Sayidathahaseen/CCC_NGP_ODC/NGP_ODC_Main/PDLC/Prodigy HW files/MPC5534/REV 2/BoM/READ ME.txt

1. SCH will not have NO LOAD list.
2. Do not generate BoM from SCH. They may not be matching
