Sayidathahaseen/CCC_NGP_ODC/NGP_ODC_Main/PDLC/Prodigy HW files/MPC5534/REV 2/Gerber/READ ME.txt

The Gerber File names are wrong. "Rev1" is used for Rev2 file names
