Sayidathahaseen/CCC_NGP_ODC/NGP_ODC_Main/PDLC/Mechanical/NGP_CCC Final files on dt-lohiths/Solidworks _Final files/Back Plane Assy/CORRECTION/Body correction.odp

Existing body part

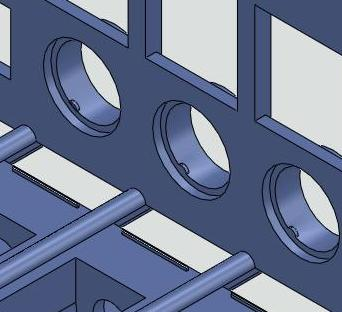
[picture p1: figure]

Correction to be done on body part

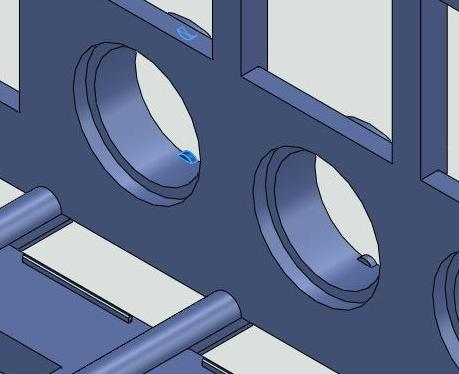
[picture p2: figure]

Correction of projection

on body (to be done in rubber mould)

Position of the projection should be vertical & in the rear side as shown in the picture above

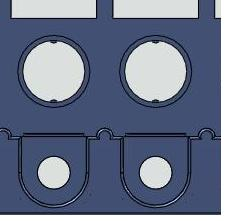
[picture p3: figure]

Existing position of

projection on body

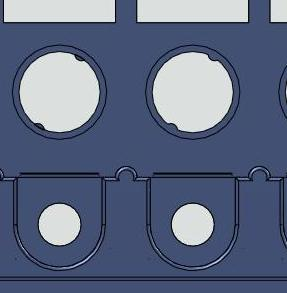
[picture p4: figure]
