Sayidathahaseen/CCC_NGP_ODC/NGP_ODC_Main/PDLC/Mechanical/NGP_CCC Final files on dt-lohiths/id/NGP concepts06Jun11.pdf

# CONCEPT FOR NEW GENERATION PLATFROM ( NGP )

# concepts submitted by

# ISol

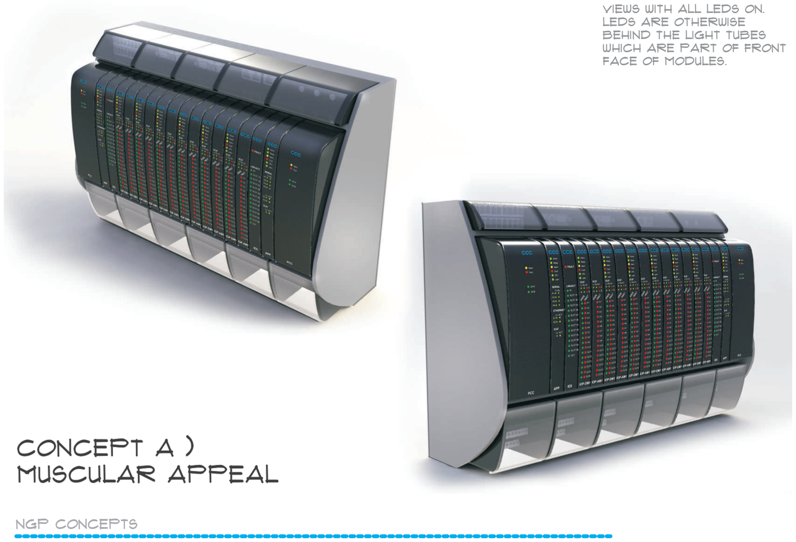
[picture p5: page 2]

# CONCEPT A ) Muscular Appeal

### NGP Concepts

views with all LEDs on.
LEDS are otherwise
behind the light tubes
which are part of front
face of modules.

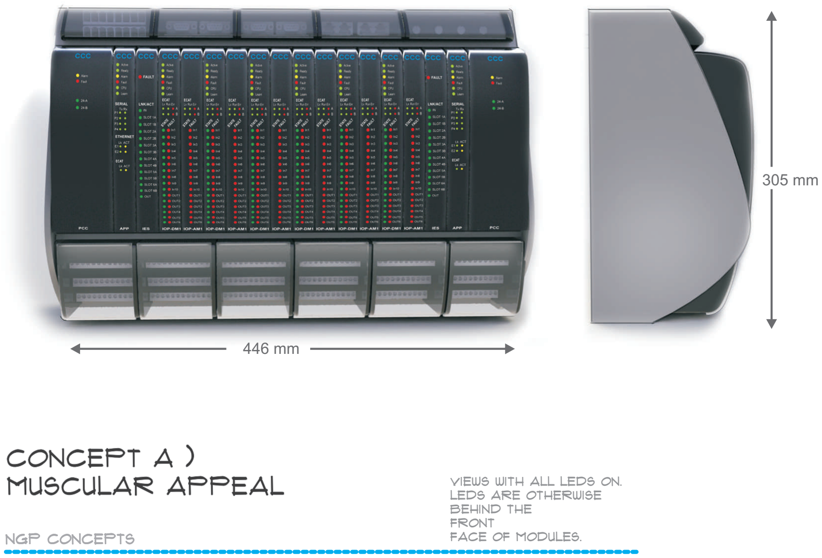
[picture p6: page 3]

# CONCEPT A ) Muscular Appeal

views with all LEDs on.
LEDS are otherwise
behind the
front
face of modules.

446 mm

305 mm

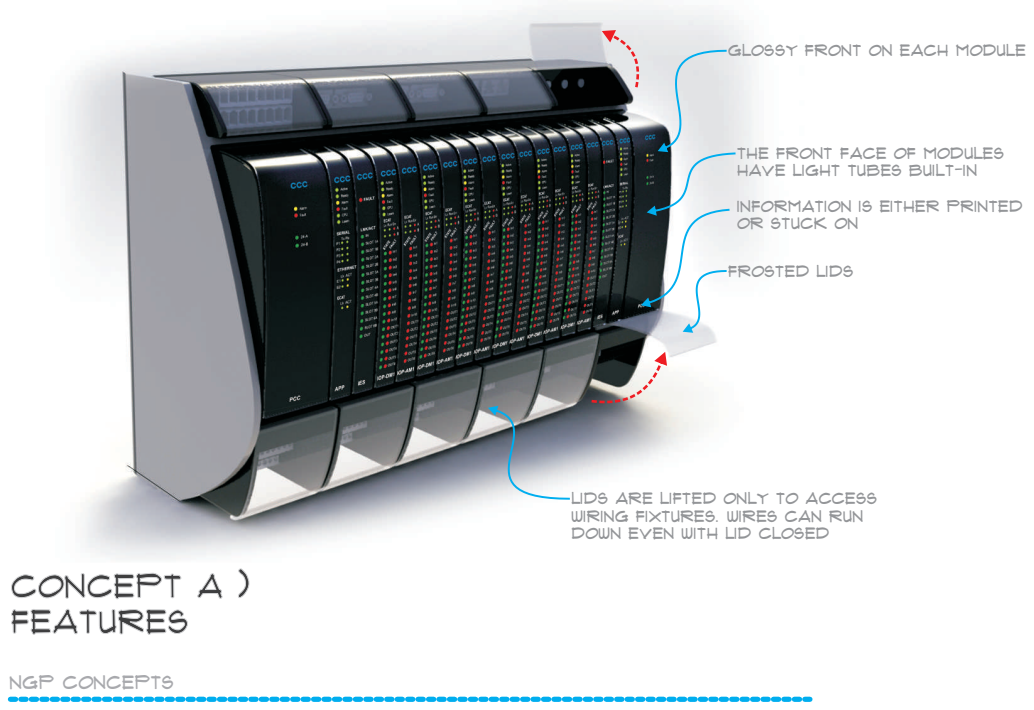
[picture p7: page 4]
CONCEPT A ) features; frosted lids

glossy front on each module

the front face of modules
have light tubes built-in

Information is either printed
or stuck on

lids are lifted only to access
wiring fixtures. wires can run
down even with lid closed

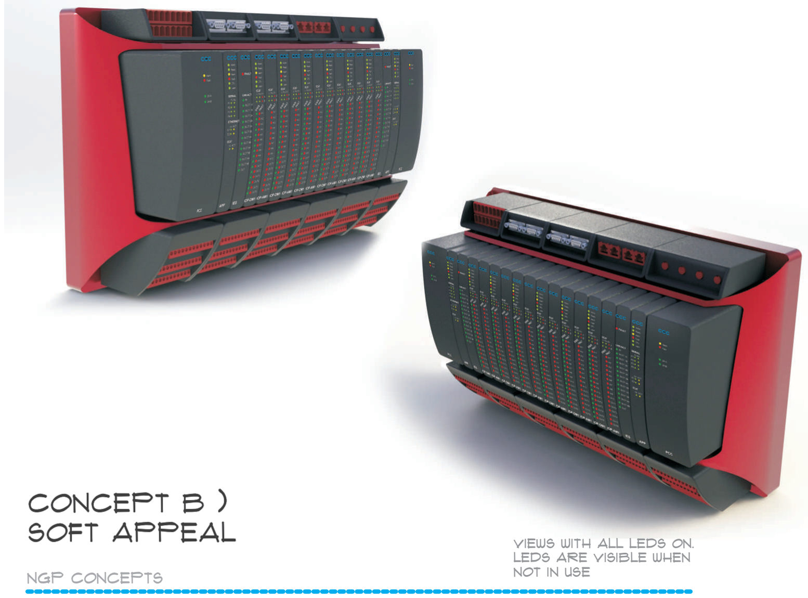
[picture p8: page 5]

views with all LEDs on.
LEDS are visible when
not in use

# CONCEPT b )

# Soft appeal

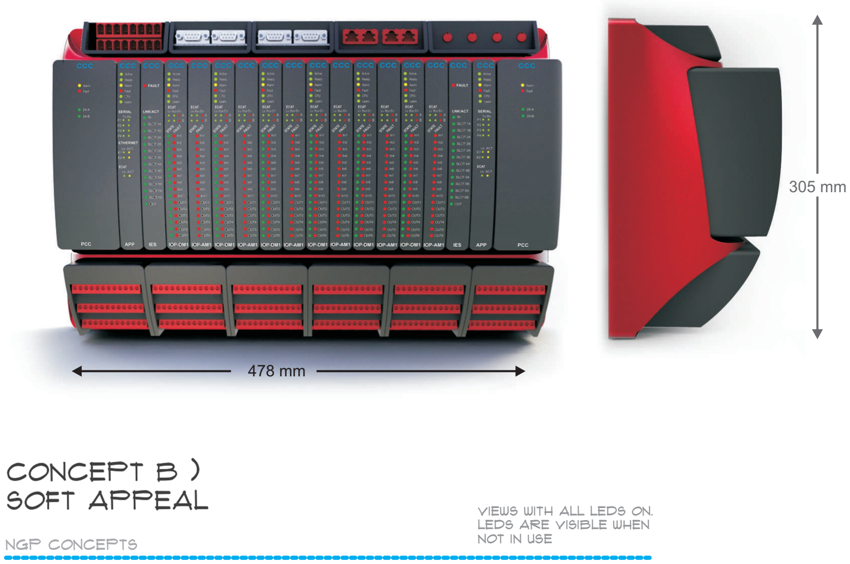
[picture p9: page 6]

# CONCEPT b )

Soft appeal | views with all LEDs on.
| LEDS are visible when not in use

478 mm

305 mm

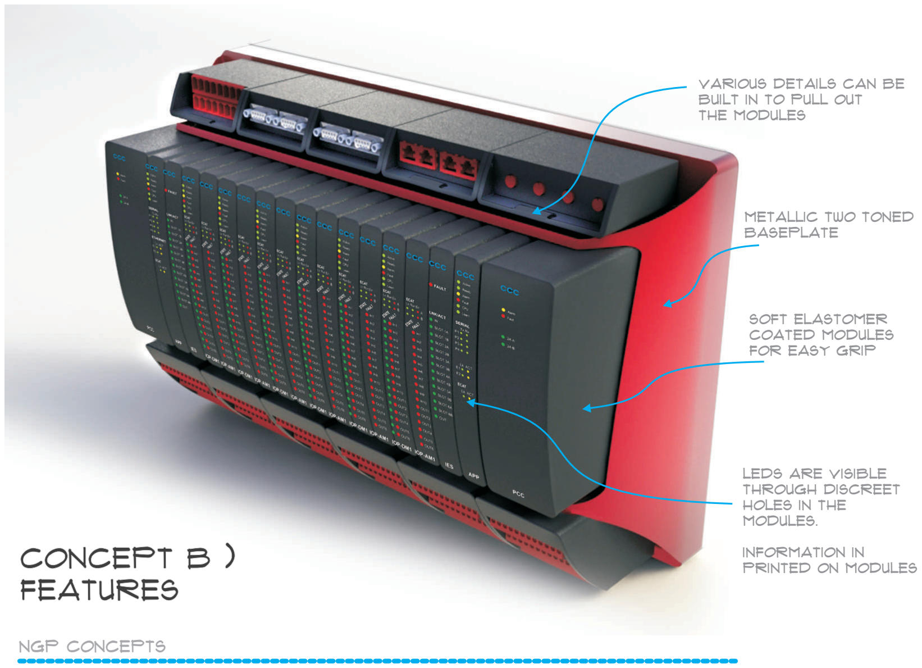
[picture p10: page 7]

# CONCEPT b )

# features

various details can be
built in to pull out
the modules

Metallic two toned
baseplate

soft elastomer
coated modules
for easy grip

leds are visible
through discreet
holes in the
modules.

information in
printed on modules

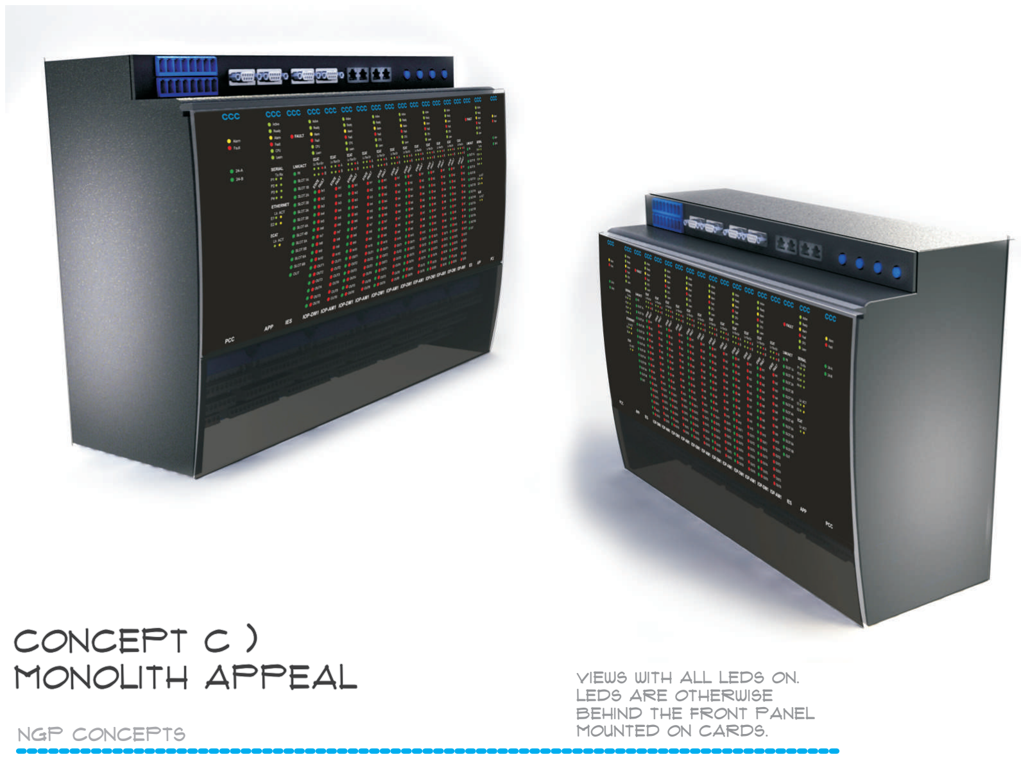
[picture p11: page 8]

# CONCEPT c )

# monolith appeal

views with all LEDs on.
LEDS are otherwise
behind the front panel
mounted on cards.

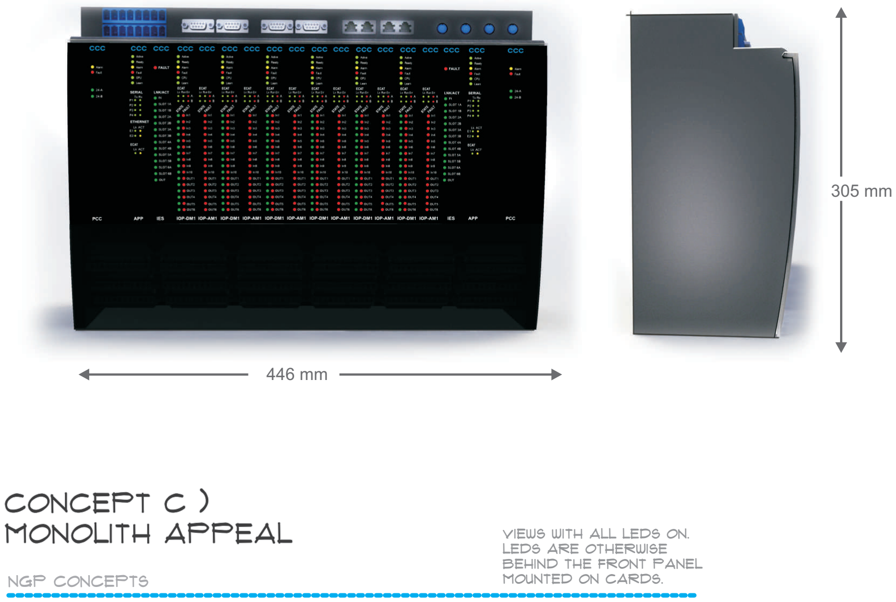
[picture p12: page 9]

views with all LEDs on.
LEDS are otherwise
behind the front panel
mounted on cards.

# CONCEPT c )

# monolith appeal

446 mm

305 mm

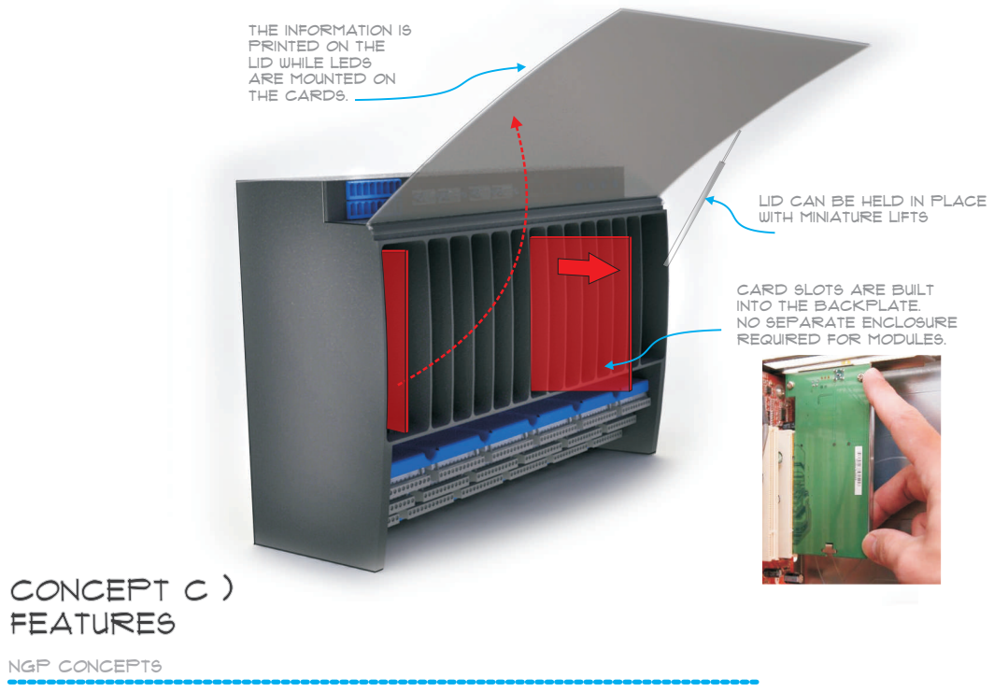
[picture p13: page 10]
CONCEPT c ) features

the information is
printed on the
lid while leds
are mounted on
the cards.

lid can be held in place
with miniature lifts

card slots are built
into the backplate.
no separate enclosure
required for modules.

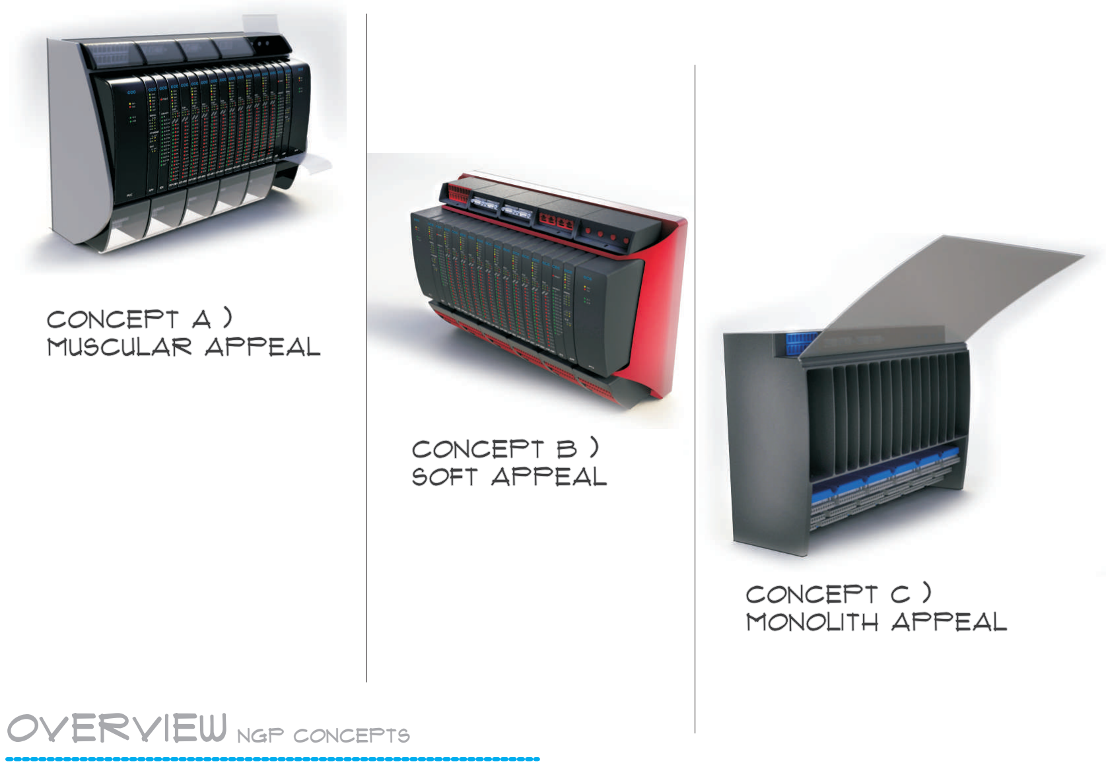
[picture p14: page 11]

# overview

## CONCEPT A ) Muscular Appeal

## CONCEPT b )

## Soft appeal

## CONCEPT c )

## monolith appeal
