Sayidathahaseen/CCC_NGP_ODC/NGP_ODC_Main/PDLC/VanGuard/Client Docs/Vanguard/Analog Input/Specification_Vanguard AI Cond Module.pdf

/
t

General Description

The CM series modules are compact modular isolated signal conditioners The modules are designed for applications in the process control industry All modules are single channel input devices The module is

## packaged in a compact 2 1 x 1 7x 0 6 54 mm x 42 mm x 14 mm durable plastic case

The module has precision voltage clamps to bound the output voltage from 0 7 to 5 7 VDC All input

## pins are fully protected against 120 Vrms fault voltages

The module is mix and match and hot swappable with other modules so it can be inserted or removed from any socket in the same FTA 43 without disturbing system power

Isolated 2/4 Wire Transmitter Interface Module CM 1 335

The CM 1 335 input module accepts a 4 20mA process current input provides a standard 1 5 VDC output signal This module features an isolated loop power supply for driving the current transmitter The module can also be used as a current to voltage converter by supplying a 4 20 mA signal into pin 1 and returning on pin O The module has a nominal 3dB bandwidth of 100 Hz and has downscale open loop input detection within 5 ms

The current input is applied into pin 1 the loop supply is available on pin 2 and the input common is

## brought out to pin O

The loop supply is nominally 24V with Vs 24 V 1I00p 12 mA The loop supply will vary with loop current and Vs the approximate output impedance of the loop supply is 250 Ohms The loop supply

## pin 2 is protected against a short to pin 0 or to pin 1

# Er ² WR

XMTR
IIN

IIN

4 WR
XMTR
X Com

4 Vou
0 7 TO 5 7V

2 POLE
FILTER
AMP/CLAMP

5

## tOOM EtN

ISOLATEO INPUT SECTION | ISOLAliON
BARRIER

OUTPUT SECTION

CM 1 335

Types Analog Devices AD18093 Dataforth SCM7B35 1256

1

## Preliminary draft of new analog conditioning modules 3/18/99

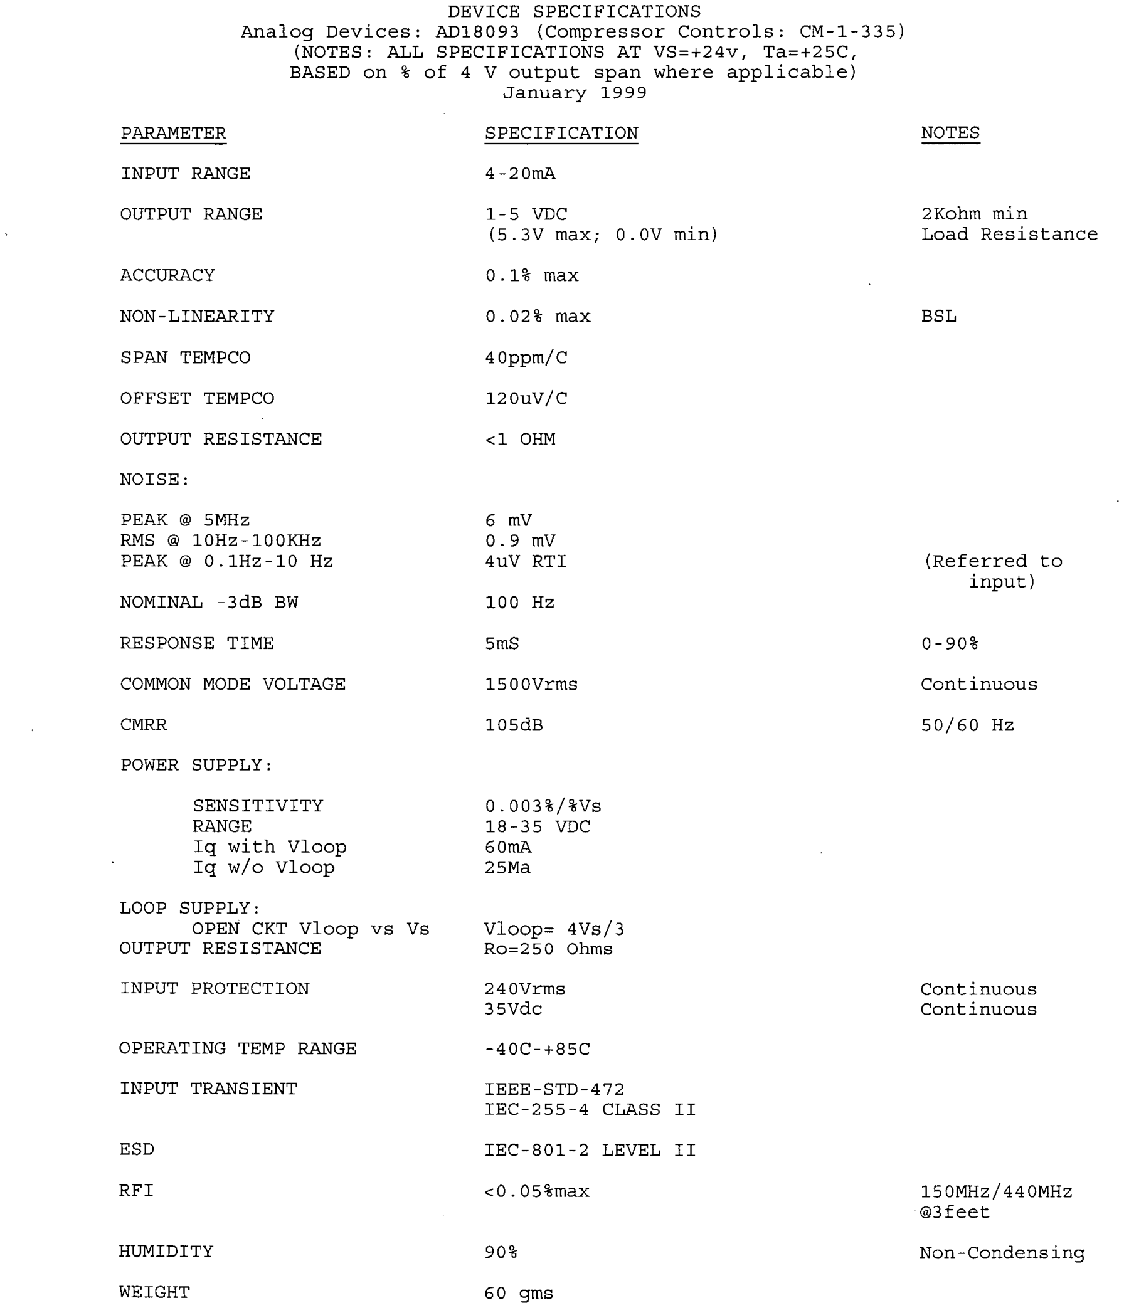
[picture p30: page 2]

DEVICE SPECIFICATIONS
Analog Devices | AD1S093 | Compressor Controls | CM 1 335
NOTES | ALL SPECIFICATIONS AT VS | 24v | Ta | 25C
BASED on | of 4 V output span where applicable
January 1999

PARAMETER

INPUT RANGE

OUTPUT RANGE

ACCURACY

NON LINEARITY

SPAN TEMPCO

OFFSET TEMPCO

OUTPUT RESISTANCE

NOISE

PEAK @ 5MHz
RMS @ 10Hz 100KHz
PEAK @ 0 lHz | 10 Hz
NOMINAL | 3dB BW

RESPONSE TIME

COMMON MODE VOLTAGE

CMRR

POWER SUPPLY

SENSITIVITY
RANGE
Iq with Vloop
Iq w/o Vloop

LOOP SUPPLY
OPEN CKT Vloop vs Vs
OUTPUT RESISTANCE

INPUT PROTECTION

OPERATING TEMP RANGE

INPUT TRANSIENT

ESD

RFI

HUMIDITY

WEIGHT

SPECIFICATION

4 20mA

1 5 VDC
5 3V maxi | O OV min
0 1 | max
0 02 | max

## 40ppm/C

120uV/C

1 OHM

6 mV
0 9 mV
4uV RTI

100 Hz

5mS

1500Vrms

105dB

0 003 /
Vs
lS 35 VDC
60mA
25Ma

Vloop 4Vs/3
Ro 250 Ohms

240Vrms
35Vdc

40C S5C

IEEE STD 472
IEC 255 4 CLASS II

IEC SOl 2 LEVEL II

0 05 max

90

60 gms

NOTES

2Kohm min
Load Resistance

BSL

Referred to
input

0 90

Continuous

50/60 Hz

Continuous
Continuous

150MHz/440MHz
@3feet

Non Condensing
