Sayidathahaseen/CCC_NGP_ODC/NGP_ODC_Main/PDLC/VanGuard/Block Diagram_Prodigy APP.pdf

# BLOCK DIAGRAM

# PRODIGY APP

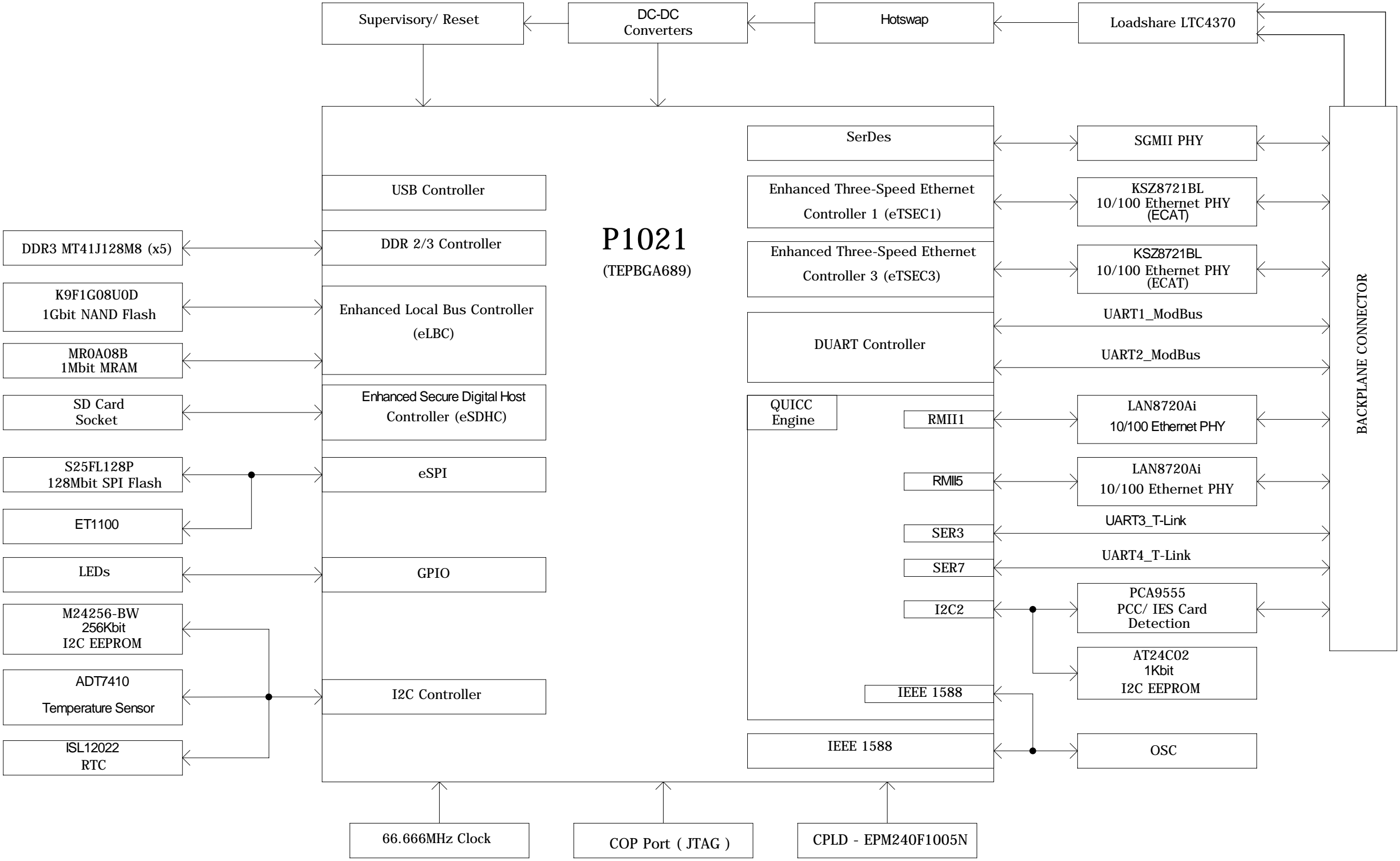
[picture p31: figure]
UART2_ModBus; UART1_ModBus; QUICC; SerDes; SGMII PHY; Hotswap; (ECAT); 10/100 Ethernet PHY; KSZ8721BL; Controller 3 (eTSEC3); Enhanced Three-Speed Ethernet; Controller 1 (eTSEC1); UART4_T-Link; UART3_T-Link; I2C EEPROM; 1Kbit; Detection; PCC/ IES Card; PCA9555; LAN8720Ai; OSC; IEEE 1588; SER7; SER3; RMII5; RMII1; DUART Controller; DDR 2/3 Controller; Engine; 66.666MHz Clock; RTC; ISL12022; Temperature Sensor; ADT7410; LEDs; GPIO; Supervisory/ Reset; Converters; 256Kbit; 128Mbit SPI Flash; Socket; SD Card; 1Mbit MRAM; 1Gbit NAND Flash; eSPI; Controller (eSDHC); Enhanced Secure Digital Host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
