Sayidathahaseen/CCC_NGP_ODC/NGP_ODC_Main/PDLC/VanGuard/Block Diagram_VanGuard MPU_11Dec15.pdf

# VANGUARD MPU

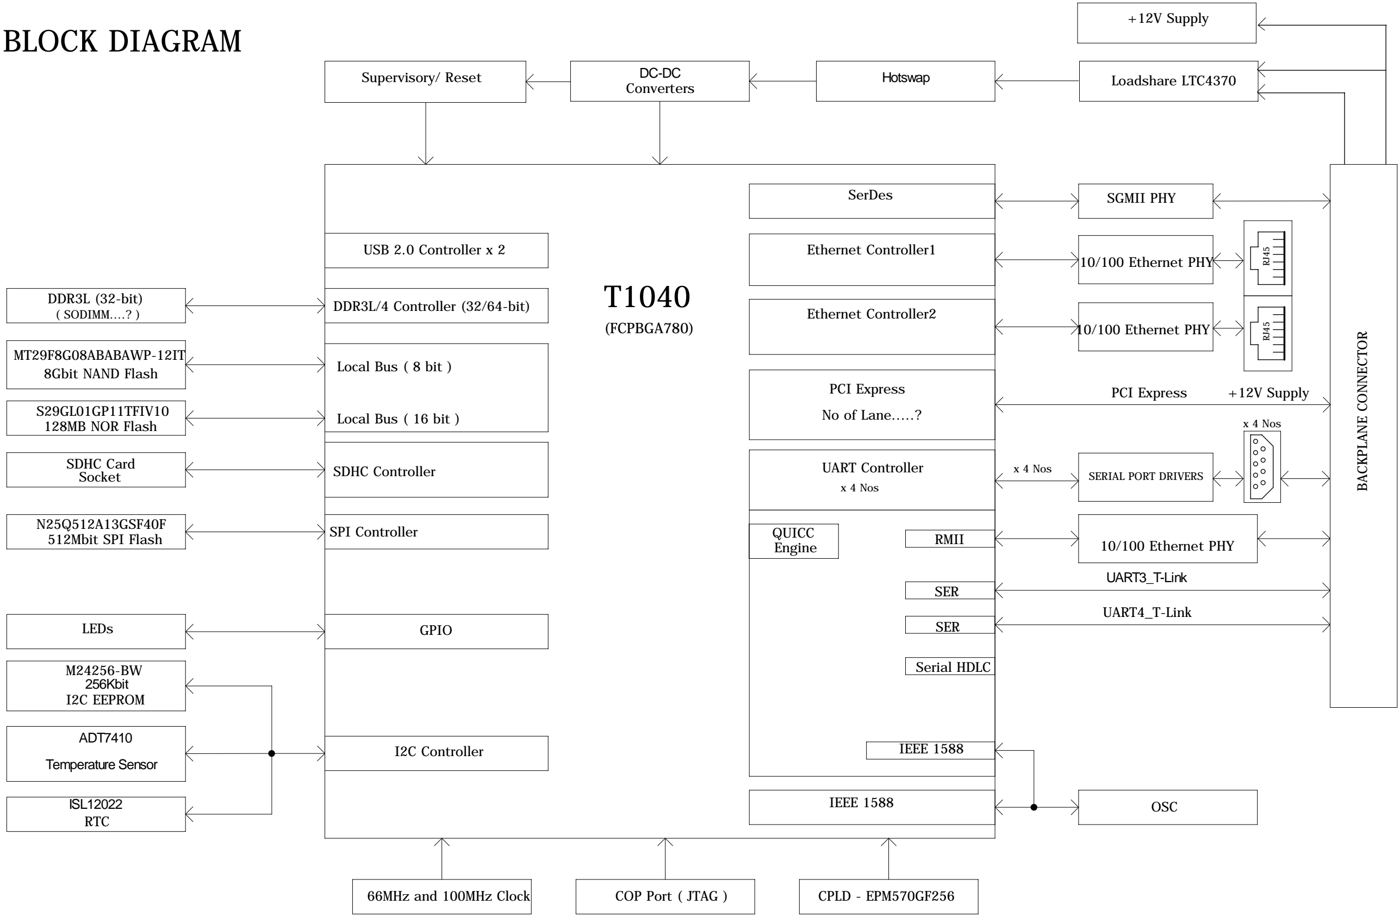
[picture p32: figure]
QUICC; SerDes; SGMII PHY; Hotswap; 10/100 Ethernet PHY; UART4_T-Link; UART3_T-Link; OSC; IEEE 1588; Engine; RTC; ISL12022; Temperature Sensor; ADT7410; LEDs; GPIO; Supervisory/ Reset; Converters; I2C EEPROM; 256Kbit; Socket; I2C Controller; BLOCK DIAGRAM; BACKPLANE CONNECTOR; DDR3L (32-bit); Loadshare LTC4370; (FCPBGA780); DDR3L/4 Controller (32/64-bit); USB 2.0 Controller x 2; ( SODIMM....? ); Local Bus ( 8 bit ); MT29F8G08ABABAWP-12IT; 8Gbit NAND Flash; Local Bus ( 16 bit ) S29GL01GP11TFIV10 128MB NOR Flash; SDHC Controller SDHC Card; SPI Controller N25Q512A13GSF40F 512Mbit SPI Flash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
