Sayidathahaseen/CCC_NGP_ODC/NGP_ODC_Main/PDLC/VanGuard/Study_Prodigy MPU.pdf

## VANGAURD MPU (New) / Prodigy MPU

## Mindteck Understanding

Design new MPU board for VanGuard Series 5
Based on freescale QorIQ T Series processor supporting * QUICCEngine for Serial HDLC
* Trace for debugging
* IEEE 1588
* PCIe (External Bridge to convert parallel ) Form factor : 6U cPCI similar to XCalibur 1002 SBC
Backward compatibility with TMPU-1002 transition Card Design Reuse components from Prodigy APP

## VANGAURD MPU

XCalibur X1002
(Existing)
/ New design with
freescale
QorIQ Processor

+

TMPU_1002
Breakout
backward compatible

Ethernet
Port 1

Ethernet Port 2

Ethernet
Port 3

100MB Ethernet
ports for
communication
with Train tools
workstations

RS485
Port 1

RS485
Port 2

RS485
Port 3

RS485
Port 4

Isolated RS485
serial ports for
communication
with Modbus
masters or other
Controllers

Form factor :
6U Compact PCI

J5

J5

J3 J3 J3

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
BACKPLANE CONNECTIONS

GND

RS232

Unused

J1, J2 – Compact PCI

J3, J5 – Ethernet, I/O

## Prodigy APP

## (Existing)

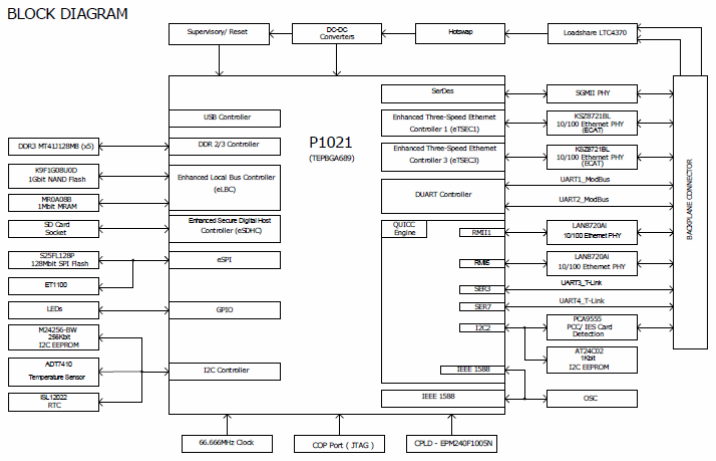
[picture p33: figure]

## VanGuard MPU / Prodigy MPU

## (New)

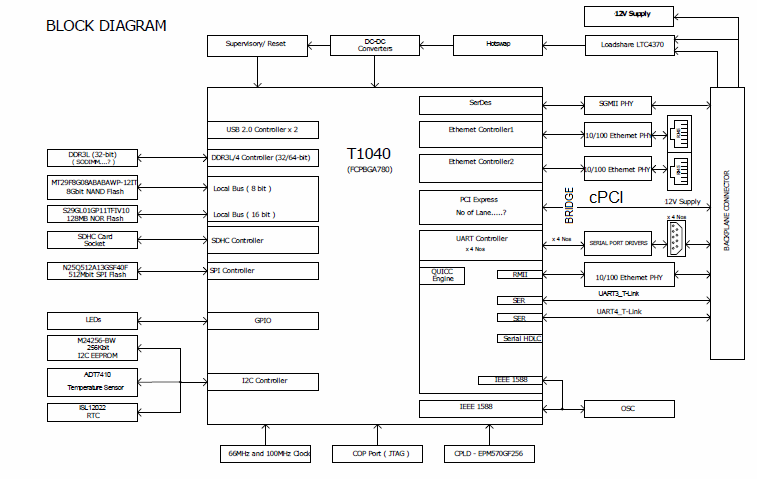
[picture p34: figure]
