Sayidathahaseen/CCC_NGP_ODC/NGP_ODC_Main/PDLC/design/Thermal_Analysis/IES/IES-VIA_REPORT.txt

Name          Type                           Start  End   Net                            Drill                         X                             Y                             Plated  TestPoint Thermal Glued  
Via4532       BGA                            1      6     EBUS[4]-TX+                    10                            3955.00                       210.00                        True    No        False   False   
Via3748       BGA                            1      6     EBUS[4]-TX-                    10                            3955.00                       244.00                        True    No        False   False   
Via4156       BGA                            1      6     P_MODE[0]_1                    10                            1000.00                       590.00                        True    No        False   False   
Via4154       BGA                            1      6     TRANS-MODE-ENA_1               10                            1197.49                       532.48                        True    No        False   False   
Via4051       BGA                            1      6     $$$20327                       10                            1120.00                       695.00                        True    No        False   False   
Via4049       BGA                            1      6     $$$20624                       10                            1085.00                       670.00                        True    No        False   False   
Via4047       BGA                            1      6     $$$20018                       10                            1150.00                       695.00                        True    No        False   False   
Via3830       BGA                            1      6     +2V5_CORE_1                    10                            1190.00                       585.00                        True    No        True    False   
Via3237       POWERVIA                       1      6     GND                            24                            1055.00                       585.00                        True    No        True    False   
Via3108       NORMAL                         1      6     GND                            12                            860.00                        590.00                        True    No        True    False   
Via2991       POWERVIA                       1      6     GND                            24                            1062.49                       477.48                        True    No        True    False   
Via2874       POWERVIA                       1      6     +3V3                           24                            950.00                        580.00                        True    No        True    False   
Via2820       NORMAL                         1      6     +3V3                           12                            1110.00                       585.00                        True    No        True    False   
Via4059       BGA                            1      6     $$$23494                       10                            1297.49                       692.48                        True    No        False   False   
Via4044       BGA                            1      6     $$$19836                       10                            1427.49                       665.98                        True    No        False   False   
Via4042       BGA                            1      6     $$$19835                       10                            1385.00                       695.00                        True    No        False   False   
Via4040       BGA                            1      6     $$$19834                       10                            1355.00                       695.00                        True    No        False   False   
Via4036       BGA                            1      6     $$$19979                       10                            1309.00                       608.00                        True    No        False   False   
Via4034       BGA                            1      6     $$$19934                       10                            1230.00                       585.00                        True    No        False   False   
Via4008       BGA                            1      6     C25_SHI[1]_1                   10                            1437.49                       554.88                        True    No        False   False   
Via4006       BGA                            1      6     C25_SHI[0]_1                   10                            1222.49                       554.88                        True    No        False   False   
Via4004       BGA                            1      6     C25_ENA_1                      10                            1555.09                       662.48                        True    No        False   False   
Via3912       BGA                            1      6     $$$19592                       10                            1320.00                       670.00                        True    No        False   False   
Via3831       BGA                            1      6     +2V5_CORE_1                    10                            1520.49                       684.48                        True    No        True    False   
Via3234       POWERVIA                       1      6     GND                            24                            1471.49                       687.48                        True    No        True    False   
Via3033       POWERVIA                       1      6     GND                            24                            1292.49                       407.48                        True    No        True    False   
Via3032       POWERVIA                       1      6     GND                            24                            1382.49                       407.48                        True    No        True    False   
Via3164       POWERVIA                       1      6     GND                            24                            1629.89                       667.48                        True    No        True    False   
Via2850       POWERVIA                       1      6     +3V3                           24                            2399.49                       580.48                        True    No        True    False   
Via2760       POWERVIA                       1      6     +3V3                           24                            2309.49                       580.48                        True    No        True    False   
Via3944       BGA                            1      6     RX_D(0)[2]                     10                            2814.33                       564.48                        True    No        False   False   
Via3941       BGA                            1      6     RX_D(0)[1]                     10                            2783.49                       554.32                        True    No        False   False   
Via3937       BGA                            1      6     RX_D(0)[0]                     10                            2753.00                       592.00                        True    No        False   False   
Via3926       BGA                            1      6     TX_D(0)[0]/C25_ENA             10                            2777.49                       512.88                        True    No        False   False   
Via3924       BGA                            1      6     TRANS-MODE-ENA                 10                            2544.49                       592.88                        True    No        False   False   
Via3881       BGA                            1      6     CLK_MODE[0]                    10                            2698.49                       551.48                        True    No        False   False   
Via3877       BGA                            1      6     CLK_MODE[1]                    10                            2640.49                       522.48                        True    No        False   False   
Via2988       POWERVIA                       1      6     GND                            24                            2524.49                       518.08                        True    No        True    False   
Via2986       POWERVIA                       1      6     GND                            24                            2774.49                       438.08                        True    No        True    False   
Via2862       POWERVIA                       1      6     +3V3                           24                            2464.89                       695.48                        True    No        True    False   
Via3948       BGA                            1      6     RX_D(0)[3]                     10                            2845.49                       560.48                        True    No        False   False   
Via3933       BGA                            1      6     TX_D(0)[3]/C25_SHI[1]          10                            2984.49                       512.88                        True    No        False   False   
Via3919       BGA                            1      6     CRS0                           10                            3006.49                       558.32                        True    No        False   False   
Via3917       BGA                            1      6     COL0                           10                            3017.49                       590.48                        True    No        False   False   
Via3888       BGA                            1      6     RX_ERR[0]                      10                            2860.00                       597.00                        True    No        False   False   
Via3885       BGA                            1      6     RX_DV[0]                       10                            2904.00                       569.00                        True    No        False   False   
Via3840       BGA                            1      6     +2V5_CORE                      10                            3019.49                       690.48                        True    No        True    False   
Via3094       POWERVIA                       1      6     GND                            24                            3183.49                       693.48                        True    No        True    False   
Via2985       POWERVIA                       1      6     GND                            24                            3004.49                       438.08                        True    No        True    False   
Via3907       BGA                            1      6     PHY0_2V5A                      10                            3914.49                       656.48                        True    No        False   False   
Via3794       BGA                            1      6     EBUS[6]-TX+                    10                            3885.00                       355.00                        True    No        False   False   
Via3720       BGA                            1      6     EBUS[6]-TX-                    10                            3885.00                       387.00                        True    No        False   False   
Via3788       BGA1                           1      6     EBUS[7]-TX-                    10                            4049.00                       542.00                        True    No        False   False   
Via3718       BGA1                           1      6     EBUS[7]-TX+                    10                            4049.00                       569.00                        True    No        False   False   
Via3801       BGA                            1      6     EBUS[4]-RX+                    10                            4717.00                       635.00                        True    No        False   False   
Via3750       BGA                            1      6     EBUS[4]-RX-                    10                            4716.00                       602.00                        True    No        False   False   
Via3792       BGA                            1      6     EBUS[6]-RX-                    10                            4886.00                       651.00                        True    No        False   False   
Via3790       BGA                            1      6     EBUS[6]-RX+                    10                            4885.00                       686.00                        True    No        False   False   
Via4566       BGA1                           1      6     $$$27031                       10                            525.00                        1085.00                       True    No        False   False   
Via4164       BGA                            1      6     CTRL_STATUS_MOVE_1             10                            712.49                        1072.48                       True    No        False   False   
Via4161       BGA                            1      6     P_CONF[1]_1                    10                            667.49                        892.48                        True    No        False   False   
Via4159       BGA                            1      6     CLK_MODE[1]_1                  10                            802.00                        1061.00                       True    No        False   False   
Via3897       BGA                            1      6     RUN/EEPROM_SIZE                10                            632.49                        1086.48                       True    No        False   False   
Via3069       BGA_18D8P                      1      6     GND                            8                             570.00                        800.00                        True    No        True    False   
Via2990       BGA_18D8P                      1      6     GND                            8                             655.00                        710.00                        True    No        True    False   
Via2799       BGA_18D8P                      1      6     +3V3                           8                             487.00                        987.00                        True    No        True    False   
Via2762       BGA                            1      6     +3V3                           10                            725.09                        788.48                        True    No        True    False   
Via4533       BGA_18D8P                      1      6     EBUS[4]-TX+                    8                             1062.00                       927.00                        True    No        False   False   
Via4163       BGA_18D8P                      1      6     P_CONF[1]_1                    8                             998.51                        958.30                        True    No        False   False   
Via4160       BGA_18D8P                      1      6     CLK_MODE[1]_1                  8                             1030.01                       989.80                        True    No        False   False   
Via4158       BGA_18D8P                      1      6     P_MODE[1]_1                    8                             998.51                        926.80                        True    No        False   False   
Via4157       BGA_18D8P                      1      6     P_MODE[0]_1                    8                             1030.01                       958.30                        True    No        False   False   
Via4155       BGA_18D8P                      1      6     TRANS-MODE-ENA_1               8                             1061.51                       958.30                        True    No        False   False   
Via4052       BGA_18D8P                      1      6     $$$20327                       8                             1061.51                       989.80                        True    No        False   False   
Via4050       BGA_18D8P                      1      6     $$$20624                       8                             1157.00                       927.00                        True    No        False   False   
Via4048       BGA_18D8P                      1      6     $$$20018                       8                             1124.00                       956.00                        True    No        False   False   
Via4039       BGA_18D8P                      1      6     $$$19992                       8                             1093.00                       958.30                        True    No        False   False   
Via4038       BGA                            1      6     $$$19992                       10                            1180.00                       700.00                        True    No        False   False   
Via4037       BGA_18D8P                      1      6     $$$19979                       8                             1093.00                       989.80                        True    No        False   False   
Via4035       BGA_18D8P                      1      6     $$$19934                       8                             1155.99                       958.30                        True    No        False   False   
Via3833       BGA_18D8P                      1      6     +2V5_CORE_1                    8                             1155.99                       989.80                        True    No        True    False   
Via3827       BGA_18D8P                      1      6     +2V5_CORE_1                    8                             1159.49                       888.48                        True    No        True    False   
Via3802       BGA_18D8P                      1      6     EBUS[4]-RX+                    8                             1125.00                       925.00                        True    No        False   False   
Via3778       BGA_18D8P                      1      6     EBUS[5]-RX-                    8                             998.51                        1052.79                       True    No        False   False   
Via3775       BGA_18D8P                      1      6     EBUS[5]-RX+                    8                             998.51                        1021.29                       True    No        False   False   
Via3751       BGA_18D8P                      1      6     EBUS[4]-RX-                    8                             1094.00                       927.00                        True    No        False   False   
Via3749       BGA_18D8P                      1      6     EBUS[4]-TX-                    8                             1030.00                       926.00                        True    No        False   False   
Via3385       BGA_18D8P                      1      6     GND                            8                             998.51                        1084.28                       True    No        True    False   
Via3384       BGA_18D8P                      1      6     GND                            8                             1030.01                       1084.28                       True    No        True    False   
Via3383       BGA_18D8P                      1      6     GND                            8                             1061.51                       1084.28                       True    No        True    False   
Via3382       BGA_18D8P                      1      6     GND                            8                             1093.00                       1084.28                       True    No        True    False   
Via3380       BGA_18D8P                      1      6     GND                            8                             1030.01                       1052.79                       True    No        True    False   
Via3379       BGA_18D8P                      1      6     GND                            8                             1061.51                       1052.79                       True    No        True    False   
Via3378       BGA_18D8P                      1      6     GND                            8                             1093.00                       1052.79                       True    No        True    False   
Via3376       BGA_18D8P                      1      6     GND                            8                             1030.01                       1021.29                       True    No        True    False   
Via3375       BGA_18D8P                      1      6     GND                            8                             1093.00                       1021.29                       True    No        True    False   
Via3374       BGA_18D8P                      1      6     GND                            8                             1124.50                       1021.29                       True    No        True    False   
Via3373       BGA_18D8P                      1      6     GND                            8                             1155.99                       1021.29                       True    No        True    False   
Via3369       BGA_18D8P                      1      6     GND                            8                             998.51                        989.80                        True    No        True    False   
Via3235       BGA1                           1      6     GND                            10                            972.00                        837.00                        True    No        True    False   
Via3230       POWERVIA                       1      6     GND                            24                            892.49                        905.71                        True    No        True    False   
Via3227       POWERVIA                       1      6     GND                            24                            895.00                        1065.00                       True    No        True    False   
Via3107       NORMAL                         1      6     GND                            12                            860.00                        775.00                        True    No        True    False   
Via3105       NORMAL                         1      6     GND                            12                            820.00                        720.00                        True    No        True    False   
Via2921       BGA_18D8P                      1      6     +3V3                           8                             1061.49                       1021.28                       True    No        True    False   
Via2919       BGA_18D8P                      1      6     +3V3                           8                             1124.49                       989.79                        True    No        True    False   
Via2869       POWERVIA                       1      6     +3V3                           24                            897.49                        979.58                        True    No        True    False   
Via2822       NORMAL                         1      6     +3V3                           12                            1130.00                       825.00                        True    No        True    False   
Via2821       NORMAL                         1      6     +3V3                           12                            920.00                        845.00                        True    No        True    False   
Via2817       NORMAL                         1      6     +3V3                           12                            910.00                        760.00                        True    No        True    False   
Via4569       BGA_18D8P                      1      6     $$$6439                        8                             1375.00                       1085.00                       True    No        False   False   
Via4463       BGA_18D8P                      1      6     EEPROM_CLK_1                   8                             1344.97                       1084.28                       True    No        False   False   
Via4177       BGA_18D8P                      1      6     RUN/EEPROM_SIZE_1              8                             1344.97                       1052.79                       True    No        False   False   
Via4175       MICROVIA                       1      6     RUN/EEPROM_SIZE_1              12                            1500.00                       950.00                        True    No        False   False   
Via4153       BGA_18D8P                      1      6     P_CONF[0]_1                    8                             1376.47                       1021.29                       True    No        False   False   
Via4151       BGA                            1      6     P_CONF[0]_1                    10                            1505.00                       985.00                        True    No        False   False   
Via4060       BGA_18D8P                      1      6     $$$23494                       8                             1285.00                       958.00                        True    No        False   False   
Via4058       BGA_18D8P                      1      6     $$$23475                       8                             1376.47                       958.30                        True    No        False   False   
Via4057       BGA                            1      6     $$$23475                       10                            1260.00                       715.00                        True    No        False   False   
Via4046       BGA_18D8P                      1      6     $$$19836                       8                             1313.47                       989.80                        True    No        False   False   
Via4045       BGA_18D8P                      1      6     $$$19836                       8                             1407.49                       982.48                        True    No        False   False   
Via4043       BGA_18D8P                      1      6     $$$19835                       8                             1313.47                       958.30                        True    No        False   False   
Via4041       BGA_18D8P                      1      6     $$$19834                       8                             1344.97                       958.30                        True    No        False   False   
Via4033       BGA_18D8P                      1      6     CLK_MODE[0]_1                  8                             1344.97                       1021.29                       True    No        False   False   
Via4032       BGA                            1      6     CLK_MODE[0]_1                  10                            1503.49                       795.48                        True    No        False   False   
Via4009       BGA_18D8P                      1      6     C25_SHI[1]_1                   8                             1222.00                       923.00                        True    No        False   False   
Via4007       BGA_18D8P                      1      6     C25_SHI[0]_1                   8                             1218.99                       958.30                        True    No        False   False   
Via4005       BGA_18D8P                      1      6     C25_ENA_1                      8                             1250.48                       958.30                        True    No        False   False   
Via3913       BGA_18D8P                      1      6     $$$19592                       8                             1313.47                       926.80                        True    No        False   False   
Via3875       BGA_18D8P                      1      6     EBUS[2]-TX+                    8                             1376.47                       926.80                        True    No        False   False   
Via3872       BGA_18D8P                      1      6     EBUS[2]-TX-                    8                             1344.97                       926.80                        True    No        False   False   
Via3869       BGA_18D8P                      1      6     EBUS[2]-RX+                    8                             1281.98                       926.80                        True    No        False   False   
Via3834       BGA_18D8P                      1      6     +2V5_CORE_1                    8                             1313.47                       1084.28                       True    No        True    False   
Via3832       BGA_18D8P                      1      6     +2V5_CORE_1                    8                             1218.99                       989.80                        True    No        True    False   
Via3825       BGA_18D8P                      1      6     +2V5_CORE_1                    8                             1381.49                       1052.48                       True    No        True    False   
Via3717       BGA_18D8P                      1      6     EBUS[2]-RX-                    8                             1250.48                       926.80                        True    No        False   False   
Via3381       BGA_18D8P                      1      6     GND                            8                             1281.98                       1084.28                       True    No        True    False   
Via3377       BGA_18D8P                      1      6     GND                            8                             1313.47                       1052.79                       True    No        True    False   
Via3372       BGA_18D8P                      1      6     GND                            8                             1218.99                       1021.29                       True    No        True    False   
Via3371       BGA_18D8P                      1      6     GND                            8                             1250.48                       1021.29                       True    No        True    False   
Via3370       BGA_18D8P                      1      6     GND                            8                             1281.98                       1021.29                       True    No        True    False   
Via3368       BGA_18D8P                      1      6     GND                            8                             1281.98                       989.80                        True    No        True    False   
Via3228       NORMAL                         1      6     GND                            12                            1502.49                       846.48                        True    No        True    False   
Via2922       BGA_18D8P                      1      6     +3V3                           8                             1283.29                       1051.48                       True    No        True    False   
Via2920       BGA_18D8P                      1      6     +3V3                           8                             1313.29                       1021.48                       True    No        True    False   
Via2918       BGA_18D8P                      1      6     +3V3                           8                             1251.00                       989.00                        True    No        True    False   
Via2871       NORMAL                         1      6     +3V3                           12                            1501.49                       908.48                        True    No        True    False   
Via4568       BGA1                           1      6     $$$6439                        10                            1855.00                       1075.00                       True    No        False   False   
Via4152       BGA                            1      6     P_CONF[0]_1                    10                            1682.49                       1022.45                       True    No        False   False   
Via3867       BGA1                           1      6     EBUS[2]-RX+                    10                            1893.00                       979.00                        True    No        False   False   
Via3715       BGA1                           1      6     EBUS[2]-RX-                    10                            1893.00                       952.00                        True    No        False   False   
Via3159       BGA1                           1      6     GND                            10                            1669.00                       1050.00                       True    No        True    False   
Via3073       POWERVIA                       1      6     GND                            24                            1812.49                       787.48                        True    No        True    False   
Via2995       BGA1                           1      6     GND                            10                            1638.00                       1094.00                       True    No        True    False   
Via2989       POWERVIA                       1      6     GND                            24                            1722.49                       787.48                        True    No        True    False   
Via3920       BGA                            1      6     P_MODE[0]                      10                            2235.49                       726.48                        True    No        False   False   
Via3162       POWERVIA                       1      6     GND                            24                            2240.49                       832.48                        True    No        True    False   
Via3088       POWERVIA                       1      6     GND                            24                            2129.49                       1071.48                       True    No        True    False   
Via2987       POWERVIA                       1      6     GND                            24                            2249.49                       1030.48                       True    No        True    False   
Via4454       BGA_18D8P                      1      6     EBUS[1]-TX+                    8                             2603.51                       931.50                        True    No        False   False   
Via3935       BGA_18D8P                      1      6     TX_D(0)[3]/C25_SHI[1]          8                             2760.99                       931.50                        True    No        False   False   
Via3932       BGA_18D8P                      1      6     TX_D(0)[2]/C25_SHI[0]          8                             2760.99                       963.00                        True    No        False   False   
Via3930       BGA_18D8P                      1      6     TX_D(0)[1]                     8                             2792.00                       931.00                        True    No        False   False   
Via3928       BGA_18D8P                      1      6     TX_D(0)[0]/C25_ENA             8                             2792.48                       963.00                        True    No        False   False   
Via3925       BGA_18D8P                      1      6     TRANS-MODE-ENA                 8                             2603.51                       963.00                        True    No        False   False   
Via3923       BGA_18D8P                      1      6     P_MODE[1]                      8                             2540.51                       931.50                        True    No        False   False   
Via3922       BGA                            1      6     P_MODE[1]                      10                            2425.49                       728.88                        True    No        False   False   
Via3921       BGA_18D8P                      1      6     P_MODE[0]                      8                             2572.01                       963.00                        True    No        False   False   
Via3878       BGA_18D8P                      1      6     CLK_MODE[1]                    8                             2572.01                       994.50                        True    No        False   False   
Via3868       BGA_18D8P                      1      6     EBUS[2]-RX+                    8                             2540.51                       1025.99                       True    No        False   False   
Via3861       BGA                            1      6     P_CONF[2]                      10                            2448.49                       1062.48                       True    No        False   False   
Via3842       BGA_18D8P                      1      6     +2V5_CORE                      8                             2697.99                       994.50                        True    No        True    False   
Via3841       BGA_18D8P                      1      6     +2V5_CORE                      8                             2760.99                       994.50                        True    No        True    False   
Via3838       BGA                            1      6     +2V5_CORE                      10                            2731.07                       905.35                        True    No        True    False   
Via3771       BGA_18D8P                      1      6     EBUS[1]-TX-                    8                             2571.00                       933.00                        True    No        False   False   
Via3716       BGA_18D8P                      1      6     EBUS[2]-RX-                    8                             2540.51                       1057.49                       True    No        False   False   
Via3696       BGA_18D8P                      1      6     EBUS[1]-RX+                    8                             2666.00                       932.00                        True    No        False   False   
Via3695       BGA_18D8P                      1      6     EBUS[1]-RX-                    8                             2636.58                       933.08                        True    No        False   False   
Via3293       BGA_18D8P                      1      6     GND                            8                             2540.51                       1088.98                       True    No        True    False   
Via3292       BGA_18D8P                      1      6     GND                            8                             2572.01                       1088.98                       True    No        True    False   
Via3291       BGA_18D8P                      1      6     GND                            8                             2603.51                       1088.98                       True    No        True    False   
Via3290       BGA_18D8P                      1      6     GND                            8                             2635.00                       1088.98                       True    No        True    False   
Via3288       BGA_18D8P                      1      6     GND                            8                             2572.01                       1057.49                       True    No        True    False   
Via3287       BGA_18D8P                      1      6     GND                            8                             2603.51                       1057.49                       True    No        True    False   
Via3286       BGA_18D8P                      1      6     GND                            8                             2635.00                       1057.49                       True    No        True    False   
Via3284       BGA_18D8P                      1      6     GND                            8                             2572.01                       1025.99                       True    No        True    False   
Via3283       BGA_18D8P                      1      6     GND                            8                             2635.00                       1025.99                       True    No        True    False   
Via3282       BGA_18D8P                      1      6     GND                            8                             2666.50                       1025.99                       True    No        True    False   
Via3281       BGA_18D8P                      1      6     GND                            8                             2697.99                       1025.99                       True    No        True    False   
Via3280       BGA_18D8P                      1      6     GND                            8                             2760.99                       1025.99                       True    No        True    False   
Via3279       BGA_18D8P                      1      6     GND                            8                             2792.48                       1025.99                       True    No        True    False   
Via3277       BGA_18D8P                      1      6     GND                            8                             2540.51                       994.50                        True    No        True    False   
Via3276       BGA_18D8P                      1      6     GND                            8                             2603.51                       994.50                        True    No        True    False   
Via3275       BGA_18D8P                      1      6     GND                            8                             2635.00                       994.50                        True    No        True    False   
Via3273       BGA_18D8P                      1      6     GND                            8                             2635.00                       963.00                        True    No        True    False   
Via3272       BGA_18D8P                      1      6     GND                            8                             2666.50                       963.00                        True    No        True    False   
Via3271       BGA_18D8P                      1      6     GND                            8                             2697.99                       963.00                        True    No        True    False   
Via3270       BGA_18D8P                      1      6     GND                            8                             2697.99                       931.50                        True    No        True    False   
Via2899       BGA_18D8P                      1      6     +3V3                           8                             2603.51                       1025.99                       True    No        True    False   
Via2897       BGA_18D8P                      1      6     +3V3                           8                             2666.50                       994.50                        True    No        True    False   
Via2896       BGA_18D8P                      1      6     +3V3                           8                             2792.48                       994.50                        True    No        True    False   
Via2803       BGA                            1      6     +3V3                           10                            2503.49                       987.48                        True    No        True    False   
Via2756       BGA                            1      6     +3V3                           10                            2506.49                       1085.48                       True    No        True    False   
Via4460       BGA_18D8P                      1      6     EEPROM1_CLK                    8                             2886.97                       1088.98                       True    No        False   False   
Via3949       BGA_18D8P                      1      6     RX_D(0)[3]                     8                             2920.00                       961.00                        True    No        False   False   
Via3945       BGA_18D8P                      1      6     RX_D(0)[2]                     8                             2886.00                       962.00                        True    No        False   False   
Via3942       BGA_18D8P                      1      6     RX_D(0)[1]                     8                             2918.47                       931.50                        True    No        False   False   
Via3938       BGA_18D8P                      1      6     RX_D(0)[0]                     8                             2855.47                       994.50                        True    No        False   False   
Via3915       BGA_18D8P                      1      6     #RESET1                        8                             2918.47                       1057.49                       True    No        False   False   
Via3901       BGA_18D8P                      1      6     MI_DATA                        8                             2918.47                       991.99                        True    No        False   False   
Via3900       BGA                            1      6     MI_DATA                        10                            3211.38                       735.05                        True    No        False   False   
Via3898       BGA_18D8P                      1      6     RUN/EEPROM_SIZE                8                             2886.97                       1057.49                       True    No        False   False   
Via3896       BGA                            1      6     RUN/EEPROM_SIZE                10                            3063.49                       1017.48                       True    No        False   False   
Via3895       BGA_18D8P                      1      6     TX_ENA[0]                      8                             2823.98                       931.50                        True    No        False   False   
Via3893       BGA_18D8P                      1      6     LINK_MII[0]                    8                             2823.98                       963.00                        True    No        False   False   
Via3891       BGA_18D8P                      1      6     RX_CLK[0]                      8                             2855.47                       963.00                        True    No        False   False   
Via3889       BGA_18D8P                      1      6     RX_ERR[0]                      8                             2855.47                       931.50                        True    No        False   False   
Via3886       BGA_18D8P                      1      6     RX_DV[0]                       8                             2886.97                       931.50                        True    No        False   False   
Via3882       BGA_18D8P                      1      6     CLK_MODE[0]                    8                             2886.97                       1025.99                       True    No        False   False   
Via3880       BGA_18D8P                      1      6     LINKACT[0]/P_CONF[0]           8                             2918.47                       1025.99                       True    No        False   False   
Via3860       BGA_18D8P                      1      6     MI_CLK/LINKPOL                 8                             2886.97                       991.99                        True    No        False   False   
Via3858       BGA_18D8P                      1      6     OSC_IN                         8                             2918.47                       1088.98                       True    No        False   False   
Via3843       BGA_18D8P                      1      6     +2V5_CORE                      8                             2855.47                       1088.98                       True    No        True    False   
Via3289       BGA_18D8P                      1      6     GND                            8                             2823.98                       1088.98                       True    No        True    False   
Via3285       BGA_18D8P                      1      6     GND                            8                             2855.47                       1057.49                       True    No        True    False   
Via3278       BGA_18D8P                      1      6     GND                            8                             2823.98                       1025.99                       True    No        True    False   
Via3274       BGA_18D8P                      1      6     GND                            8                             2823.98                       994.50                        True    No        True    False   
Via3213       POWERVIA                       1      6     GND                            24                            2895.49                       714.48                        True    No        True    False   
Via3096       POWERVIA                       1      6     GND                            24                            3179.49                       780.48                        True    No        True    False   
Via2900       BGA_18D8P                      1      6     +3V3                           8                             2823.98                       1057.49                       True    No        True    False   
Via2898       BGA_18D8P                      1      6     +3V3                           8                             2855.47                       1025.99                       True    No        True    False   
Via2806       POWERVIA                       1      6     +3V3                           24                            3009.49                       780.48                        True    No        True    False   
Via2804       POWERVIA                       1      6     +3V3                           24                            3009.49                       871.78                        True    No        True    False   
Via2800       BGA                            1      6     +3V3                           10                            3202.49                       1021.48                       True    No        True    False   
Via3947       BGA                            1      6     RX_D(0)[3]                     10                            3512.49                       905.48                        True    No        False   False   
Via3883       BGA                            1      6     RX_DV[0]                       10                            3400.03                       1002.76                       True    No        False   False   
Via3879       BGA                            1      6     LINKACT[0]/P_CONF[0]           10                            3337.49                       1018.48                       True    No        False   False   
Via3216       POWERVIA                       1      6     GND                            24                            3280.49                       810.48                        True    No        True    False   
Via3143       POWERVIA                       1      6     GND                            24                            3459.49                       950.48                        True    No        True    False   
Via3142       POWERVIA                       1      6     GND                            24                            3461.49                       1052.48                       True    No        True    False   
Via2860       POWERVIA                       1      6     +3V3                           24                            3239.49                       780.48                        True    No        True    False   
Via2761       POWERVIA                       1      6     +3V3                           24                            3354.49                       943.08                        True    No        True    False   
Via3946       BGA                            1      6     RX_D(0)[3]                     10                            3810.59                       940.48                        True    No        False   False   
Via3943       BGA                            1      6     RX_D(0)[2]                     10                            3830.28                       1049.48                       True    No        False   False   
Via3940       BGA                            1      6     RX_D(0)[1]                     10                            3849.96                       939.48                        True    No        False   False   
Via3939       BGA                            1      6     RX_D(0)[1]                     10                            3641.49                       961.95                        True    No        False   False   
Via3936       BGA                            1      6     RX_D(0)[0]                     10                            3869.65                       1048.48                       True    No        False   False   
Via3914       BGA                            1      6     #RESET1                        10                            3647.00                       1047.00                       True    No        False   False   
Via3899       BGA                            1      6     MI_DATA                        10                            3771.22                       1046.48                       True    No        False   False   
Via3890       BGA                            1      6     RX_CLK[0]                      10                            3948.39                       1053.48                       True    No        False   False   
Via3887       BGA                            1      6     RX_ERR[0]                      10                            3968.07                       1076.48                       True    No        False   False   
Via3884       BGA                            1      6     RX_DV[0]                       10                            3928.70                       936.48                        True    No        False   False   
Via3865       BGA                            1      6     CLK25OUT1                      10                            3652.00                       1095.00                       True    No        False   False   
Via3859       BGA                            1      6     MI_CLK/LINKPOL                 10                            3794.00                       1069.00                       True    No        False   False   
Via3065       POWERVIA                       1      6     GND                            24                            3659.49                       840.48                        True    No        True    False   
Via2974       POWERVIA                       1      6     GND                            24                            3987.76                       920.48                        True    No        True    False   
Via2973       POWERVIA                       1      6     GND                            24                            3909.49                       1065.48                       True    No        True    False   
Via2849       POWERVIA                       1      6     +3V3                           24                            3889.33                       915.48                        True    No        True    False   
Via3140       POWERVIA                       1      6     GND                            24                            4225.00                       900.00                        True    No        True    False   
Via3138       POWERVIA                       1      6     GND                            24                            4029.49                       840.48                        True    No        True    False   
Via2984       POWERVIA                       1      6     GND                            24                            4195.00                       1015.00                       True    No        True    False   
Via2983       POWERVIA                       1      6     GND                            24                            4190.00                       745.00                        True    No        True    False   
Via4453       BGA                            1      6     EBUS[1]-TX+                    10                            4552.00                       736.00                        True    No        False   False   
Via3770       BGA                            1      6     EBUS[1]-TX-                    10                            4518.00                       737.00                        True    No        False   False   
Via3990       BGA                            1      6     EBUS[7]-RX+                    10                            4824.00                       745.00                        True    No        False   False   
Via3988       BGA                            1      6     EBUS[7]-RX-                    10                            4824.00                       714.00                        True    No        False   False   
Via4537       BGA1                           1      6     $$$27611                       10                            490.00                        1260.00                       True    No        False   False   
Via4168       NORMAL                         1      6     P_CONF[2]_1                    12                            745.00                        1175.00                       True    No        False   False   
Via3207       POWERVIA                       1      6     GND                            24                            710.00                        1420.00                       True    No        True    False   
Via3068       POWERVIA                       1      6     GND                            24                            622.49                        1407.48                       True    No        True    False   
Via4580       BGA_18D8P                      1      6     $$$7012                        8                             1030.00                       1180.00                       True    No        False   False   
Via4174       BGA_18D8P                      1      6     ERR[3]_1                       8                             1030.01                       1273.26                       True    No        False   False   
Via4172       BGA_18D8P                      1      6     P_CONF[3]_1                    8                             1031.49                       1241.48                       True    No        False   False   
Via4170       BGA                            1      6     P_CONF[3]_1                    10                            1061.00                       1489.00                       True    No        False   False   
Via4169       BGA_18D8P                      1      6     P_CONF[2]_1                    8                             1061.51                       1178.77                       True    No        False   False   
Via4167       BGA_18D8P                      1      6     PHYAD_OFF_1                    8                             1061.51                       1241.76                       True    No        False   False   
Via4165       BGA_18D8P                      1      6     CTRL_STATUS_MOVE_1             8                             1030.01                       1147.28                       True    No        False   False   
Via3951       BGA_18D8P                      1      6     $$$21607                       8                             1093.00                       1241.76                       True    No        False   False   
Via3835       BGA_18D8P                      1      6     +2V5_CORE_1                    8                             1155.99                       1241.76                       True    No        True    False   
Via3828       BGA_18D8P                      1      6     +2V5_CORE_1                    8                             1189.49                       1321.48                       True    No        True    False   
Via3826       BGA_18D8P                      1      6     +2V5_CORE_1                    8                             1213.49                       1106.48                       True    No        True    False   
Via3811       BGA_18D8P                      1      6     EBUS[5]-TX-                    8                             998.51                        1178.77                       True    No        False   False   
Via3808       BGA_18D8P                      1      6     EBUS[5]-TX+                    8                             998.51                        1147.28                       True    No        False   False   
Via3795       BGA_18D8P                      1      6     EBUS[6]-TX+                    8                             1029.00                       1305.00                       True    No        False   False   
Via3793       BGA_18D8P                      1      6     EBUS[6]-RX-                    8                             998.00                        1305.00                       True    No        False   False   
Via3791       BGA_18D8P                      1      6     EBUS[6]-RX+                    8                             997.14                        1273.70                       True    No        False   False   
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
Via2924       BGA_18D8P                      1      6     +3V3                           8                             1061.49                       1147.29                       True    No        True    False   
Via2872       POWERVIA                       1      6     +3V3                           24                            900.00                        1240.00                       True    No        True    False   
Via2823       BGA                            1      6     +3V3                           10                            976.49                        1419.78                       True    No        True    False   
Via2819       BGA1                           1      6     +3V3                           10                            905.00                        1165.00                       True    No        True    False   
Via2818       BGA1                           1      6     +3V3                           10                            880.00                        1185.00                       True    No        True    False   
Via4490       BGA_18D8P                      1      6     $$$21606                       8                             1376.47                       1178.77                       True    No        False   False   
Via4489       BGA_18D8P                      1      6     $$$21605                       8                             1344.97                       1178.77                       True    No        False   False   
Via4462       BGA_18D8P                      1      6     EEPROM_CLK_1                   8                             1415.00                       1135.00                       True    No        False   False   
Via4176       BGA_18D8P                      1      6     RUN/EEPROM_SIZE_1              8                             1350.45                       1343.00                       True    No        False   False   
Via3836       BGA_18D8P                      1      6     +2V5_CORE_1                    8                             1218.99                       1241.76                       True    No        True    False   
Via3829       BGA                            1      6     +2V5_CORE_1                    10                            1251.49                       1407.48                       True    No        True    False   
Via3421       BGA_18D8P                      1      6     GND                            8                             1218.99                       1304.76                       True    No        True    False   
Via3420       BGA_18D8P                      1      6     GND                            8                             1250.48                       1304.76                       True    No        True    False   
Via3419       BGA_18D8P                      1      6     GND                            8                             1281.98                       1304.76                       True    No        True    False   
Via3418       BGA_18D8P                      1      6     GND                            8                             1313.47                       1304.76                       True    No        True    False   
Via3417       BGA_18D8P                      1      6     GND                            8                             1344.97                       1304.76                       True    No        True    False   
Via3416       BGA_18D8P                      1      6     GND                            8                             1376.47                       1304.76                       True    No        True    False   
Via3411       BGA_18D8P                      1      6     GND                            8                             1218.99                       1273.26                       True    No        True    False   
Via3410       BGA_18D8P                      1      6     GND                            8                             1250.48                       1273.26                       True    No        True    False   
Via3409       BGA_18D8P                      1      6     GND                            8                             1281.98                       1273.26                       True    No        True    False   
Via3408       BGA_18D8P                      1      6     GND                            8                             1313.47                       1273.26                       True    No        True    False   
Via3407       BGA_18D8P                      1      6     GND                            8                             1344.97                       1273.26                       True    No        True    False   
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
Via2870       POWERVIA                       1      6     +3V3                           24                            1471.49                       1277.48                       True    No        True    False   
Via3873       BGA                            1      6     EBUS[2]-TX+                    10                            1937.00                       1274.00                       True    No        False   False   
Via3870       BGA                            1      6     EBUS[2]-TX-                    10                            1902.00                       1274.00                       True    No        False   False   
Via3258       POWERVIA                       1      6     GND                            24                            1782.49                       1367.48                       True    No        True    False   
Via3170       POWERVIA                       1      6     GND                            24                            1652.49                       1347.48                       True    No        True    False   
Via3158       POWERVIA                       1      6     GND                            24                            1830.00                       1125.00                       True    No        True    False   
Via2891       POWERVIA                       1      6     +3V3                           24                            1717.49                       1312.48                       True    No        True    False   
Via2844       BGA                            1      6     +3V3                           10                            1835.49                       1236.48                       True    No        True    False   
Via4578       BGA1                           1      6     $$$6964                        10                            2265.00                       1280.00                       True    No        False   False   
Via3212       POWERVIA                       1      6     GND                            24                            2309.00                       1244.00                       True    No        True    False   
Via3211       POWERVIA                       1      6     GND                            24                            2314.49                       1375.48                       True    No        True    False   
Via3078       BGA1                           1      6     GND                            10                            2180.00                       1415.00                       True    No        True    False   
Via2858       POWERVIA                       1      6     +3V3                           24                            2299.49                       1314.48                       True    No        True    False   
Via2807       POWERVIA                       1      6     +3V3                           24                            2344.49                       1430.48                       True    No        True    False   
Via4579       BGA_18D8P                      1      6     $$$6964                        8                             2573.00                       1182.00                       True    No        False   False   
Via4560       BGA_18D8P                      1      6     FAULT                          8                             2762.49                       1276.46                       True    No        False   False   
Via4527       BGA                            1      6     IO7                            10                            2721.00                       1394.00                       True    No        False   False   
Via4438       BGA_18D8P                      1      6     EBUS[3]-TX-                    8                             2603.51                       1309.46                       True    No        False   False   
Via3905       BGA_18D8P                      1      6     ERR[3]                         8                             2572.01                       1277.96                       True    No        False   False   
Via3903       BGA_18D8P                      1      6     P_CONF[3]                      8                             2572.01                       1246.46                       True    No        False   False   
Via3874       BGA_18D8P                      1      6     EBUS[2]-TX+                    8                             2540.51                       1151.98                       True    No        False   False   
Via3871       BGA_18D8P                      1      6     EBUS[2]-TX-                    8                             2540.51                       1183.47                       True    No        False   False   
Via3866       BGA_18D8P                      1      6     CLK25OUT1                      8                             2572.01                       1151.98                       True    No        False   False   
Via3864       BGA_18D8P                      1      6     PHYAD_OFF                      8                             2603.51                       1246.46                       True    No        False   False   
Via3862       BGA_18D8P                      1      6     P_CONF[2]                      8                             2603.51                       1183.47                       True    No        False   False   
Via3847       BGA_18D8P                      1      6     $$$21835                       8                             2635.00                       1246.46                       True    No        False   False   
Via3845       BGA_18D8P                      1      6     +2V5_CORE                      8                             2697.99                       1246.46                       True    No        True    False   
Via3844       BGA_18D8P                      1      6     +2V5_CORE                      8                             2760.99                       1246.46                       True    No        True    False   
Via3839       BGA                            1      6     +2V5_CORE                      10                            2675.95                       1373.13                       True    No        True    False   
Via3762       BGA_18D8P                      1      6     EBUS[3]-RX+                    8                             2539.00                       1279.00                       True    No        False   False   
Via3759       BGA_18D8P                      1      6     EBUS[3]-RX-                    8                             2542.00                       1310.00                       True    No        False   False   
Via3698       BGA_18D8P                      1      6     EBUS[3]-TX+                    8                             2572.01                       1309.46                       True    No        False   False   
Via3310       BGA_18D8P                      1      6     GND                            8                             2634.98                       1309.48                       True    No        True    False   
Via3309       BGA_18D8P                      1      6     GND                            8                             2665.00                       1310.00                       True    No        True    False   
Via3308       BGA_18D8P                      1      6     GND                            8                             2698.97                       1308.48                       True    No        True    False   
Via3307       BGA_18D8P                      1      6     GND                            8                             2603.51                       1277.96                       True    No        True    False   
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
Via4528       BGA_18D8P                      1      6     IO7                            8                             2887.36                       1278.35                       True    No        False   False   
Via4525       BGA_18D8P                      1      6     IO6                            8                             2918.86                       1309.85                       True    No        False   False   
Via4523       BGA_18D8P                      1      6     IO5                            8                             2854.00                       1247.00                       True    No        False   False   
Via4520       BGA_18D8P                      1      6     IO4                            8                             2918.86                       1278.35                       True    No        False   False   
Via4518       BGA_18D8P                      1      6     IO3                            8                             2887.36                       1246.86                       True    No        False   False   
Via4515       BGA_18D8P                      1      6     IO2                            8                             2918.86                       1246.86                       True    No        False   False   
Via4513       BGA_18D8P                      1      6     IO1                            8                             2886.49                       1214.48                       True    No        False   False   
Via4506       BGA_18D8P                      1      6     SLOT_ID                        8                             2885.99                       1308.48                       True    No        False   False   
Via4504       BGA_18D8P                      1      6     IO0                            8                             2918.00                       1215.00                       True    No        False   False   
Via4502       BGA_18D8P                      1      6     CHASISID3                      8                             2819.64                       1312.61                       True    No        False   False   
Via4499       BGA_18D8P                      1      6     CHASISID4                      8                             2823.49                       1277.48                       True    No        False   False   
Via4483       BGA_18D8P                      1      6     $$$28231                       8                             2918.47                       1183.47                       True    No        False   False   
Via4481       BGA_18D8P                      1      6     $$$28230                       8                             2886.97                       1183.47                       True    No        False   False   
Via4461       BGA_18D8P                      1      6     EEPROM1_DATA                   8                             2886.97                       1151.98                       True    No        False   False   
Via4459       BGA_18D8P                      1      6     EEPROM1_CLK                    8                             2984.33                       1110.48                       True    No        False   False   
Via3837       BGA                            1      6     +2V5_CORE                      10                            3112.95                       1290.95                       True    No        True    False   
Via3688       BGA_18D8P                      1      6     SPARE                          8                             2853.99                       1276.48                       True    No        False   False   
Via3680       BGA_18D8P                      1      6     CHASISID2                      8                             2822.99                       1245.48                       True    No        False   False   
Via3678       BGA                            1      6     CHASISID2                      10                            3183.82                       1494.89                       True    No        False   False   
Via3294       BGA_18D8P                      1      6     GND                            8                             2823.98                       1151.98                       True    No        True    False   
Via3269       BGA                            1      6     GND                            10                            3026.49                       1123.48                       True    No        True    False   
Via3267       BGA                            1      6     GND                            10                            3108.49                       1493.48                       True    No        True    False   
Via2904       BGA_18D8P                      1      6     +3V3                           8                             2854.69                       1182.91                       True    No        True    False   
Via2903       BGA_18D8P                      1      6     +3V3                           8                             2823.98                       1183.47                       True    No        True    False   
Via2901       BGA_18D8P                      1      6     +3V3                           8                             2855.47                       1151.98                       True    No        True    False   
Via2861       POWERVIA                       1      6     +3V3                           24                            3019.12                       1479.11                       True    No        True    False   
Via2859       POWERVIA                       1      6     +3V3                           24                            2934.49                       1380.48                       True    No        True    False   
Via3687       BGA                            1      6     SPARE                          10                            3412.17                       1313.79                       True    No        False   False   
Via3679       BGA                            1      6     CHASISID2                      10                            3290.12                       1211.43                       True    No        False   False   
Via3268       POWERVIA                       1      6     GND                            24                            3257.49                       1134.32                       True    No        True    False   
Via3261       POWERVIA                       1      6     GND                            24                            3469.49                       1342.88                       True    No        True    False   
Via3260       BGA                            1      6     GND                            10                            3568.00                       1444.00                       True    No        True    False   
Via3257       POWERVIA                       1      6     GND                            24                            3339.49                       1330.48                       True    No        True    False   
Via3141       POWERVIA                       1      6     GND                            24                            3439.73                       1238.98                       True    No        True    False   
Via2982       POWERVIA                       1      6     GND                            24                            3439.49                       1140.48                       True    No        True    False   
Via2857       POWERVIA                       1      6     +3V3                           24                            3339.49                       1145.48                       True    No        True    False   
Via2855       BGA                            1      6     +3V3                           10                            3316.00                       1467.00                       True    No        True    False   
Via2847       POWERVIA                       1      6     +3V3                           24                            3254.33                       1270.48                       True    No        True    False   
Via2787       BGA                            1      6     +3V3                           10                            3456.49                       1452.48                       True    No        True    False   
Via4565       BGA1                           1      6     $$$11761                       10                            3650.00                       1350.00                       True    No        False   False   
Via4492       BGA                            1      6     $$$6128                        10                            3637.49                       1211.48                       True    No        False   False   
Via4491       BGA                            1      6     $$$6119                        10                            3658.00                       1190.00                       True    No        False   False   
Via3934       BGA                            1      6     TX_D(0)[3]/C25_SHI[1]          10                            3996.49                       1190.01                       True    No        False   False   
Via3931       BGA                            1      6     TX_D(0)[2]/C25_SHI[0]          10                            3960.49                       1170.48                       True    No        False   False   
Via3929       BGA                            1      6     TX_D(0)[1]                     10                            3997.49                       1150.64                       True    No        False   False   
Via3909       BGA                            1      6     PHY0_2V5A                      10                            3636.49                       1247.48                       True    No        False   False   
Via3906       BGA                            1      6     PHY0_2V5A                      10                            3869.49                       1272.48                       True    No        False   False   
Via3894       BGA                            1      6     TX_ENA[0]                      10                            3994.49                       1111.27                       True    No        False   False   
Via3892       BGA                            1      6     LINK_MII[0]                    10                            3935.55                       1252.19                       True    No        False   False   
Via3074       BGA1                           1      6     GND                            10                            3830.00                       1241.00                       True    No        True    False   
Via2980       POWERVIA                       1      6     GND                            24                            3638.49                       1131.48                       True    No        True    False   
Via2979       POWERVIA                       1      6     GND                            24                            3793.00                       1149.00                       True    No        True    False   
Via2978       BGA1                           1      6     GND                            10                            3769.00                       1230.00                       True    No        True    False   
Via2977       POWERVIA                       1      6     GND                            24                            3771.22                       1400.48                       True    No        True    False   
Via2976       BGA1                           1      6     GND                            10                            3792.00                       1268.00                       True    No        True    False   
Via2975       POWERVIA                       1      6     GND                            24                            3979.00                       1249.00                       True    No        True    False   
Via4441       BGA                            1      6     EBUS[9]-TX-                    10                            4278.00                       1479.00                       True    No        False   False   
Via4437       BGA                            1      6     EBUS[3]-TX-                    10                            4087.00                       1343.00                       True    No        False   False   
Via3927       BGA                            1      6     TX_D(0)[0]/C25_ENA             10                            4092.49                       1131.95                       True    No        False   False   
Via3918       BGA                            1      6     CRS0                           10                            4114.49                       1229.38                       True    No        False   False   
Via3916       BGA                            1      6     COL0                           10                            4098.49                       1209.69                       True    No        False   False   
Via3761       BGA                            1      6     EBUS[3]-RX+                    10                            4191.00                       1437.00                       True    No        False   False   
Via3760       BGA                            1      6     EBUS[3]-RX-                    10                            4192.00                       1468.00                       True    No        False   False   
Via3697       BGA                            1      6     EBUS[3]-TX+                    10                            4108.00                       1361.00                       True    No        False   False   
Via3139       POWERVIA                       1      6     GND                            24                            4240.00                       1405.00                       True    No        True    False   
Via2981       POWERVIA                       1      6     GND                            24                            4310.00                       1270.00                       True    No        True    False   
Via2840       POWERVIA                       1      6     +3V3                           24                            4145.00                       1395.00                       True    No        True    False   
Via2758       BGA1                           1      6     +3V3                           10                            4102.00                       1291.00                       True    No        True    False   
Via2757       BGA1                           1      6     +3V3                           10                            4045.00                       1307.00                       True    No        True    False   
Via4544       BGA1                           1      6     $$$27628                       10                            575.00                        1820.00                       True    No        False   False   
Via4542       BGA1                           1      6     $$$27625                       10                            585.00                        1645.00                       True    No        False   False   
Via4539       BGA1                           1      6     $$$27622                       10                            520.00                        1510.00                       True    No        False   False   
Via4415       BGA                            1      6     C25_SHI[0]_2                   10                            1192.49                       1824.88                       True    No        False   False   
Via4188       BGA                            1      6     P_MODE[1]_2                    10                            1030.00                       1800.00                       True    No        False   False   
Via4173       BGA                            1      6     ERR[3]_1                       10                            1185.00                       1505.00                       True    No        False   False   
Via4075       BGA                            1      6     $$$23925                       10                            1110.00                       1840.00                       True    No        False   False   
Via4073       BGA                            1      6     $$$23924                       10                            1140.00                       1870.00                       True    No        False   False   
Via4071       BGA                            1      6     $$$23923                       10                            1075.00                       1860.00                       True    No        False   False   
Via4065       BGA                            1      6     $$$23920                       10                            1190.00                       1860.00                       True    No        False   False   
Via3202       POWERVIA                       1      6     GND                            24                            912.49                        1654.88                       True    No        True    False   
Via3165       POWERVIA                       1      6     GND                            24                            992.49                        1867.48                       True    No        True    False   
Via3106       POWERVIA                       1      6     GND                            24                            822.49                        1517.48                       True    No        True    False   
Via2873       BGA                            1      6     +3V3                           10                            906.49                        1572.48                       True    No        True    False   
Via2763       BGA                            1      6     +3V3                           10                            1149.89                       1798.48                       True    No        True    False   
Via4488       BGA                            1      6     $$$21605                       10                            1457.62                       1610.84                       True    No        False   False   
Via4178       BGA                            1      6     C25_SHI[1]_2                   10                            1387.49                       1824.88                       True    No        False   False   
Via4166       BGA                            1      6     PHYAD_OFF_1                    10                            1240.00                       1530.00                       True    No        False   False   
Via4067       BGA                            1      6     $$$23921                       10                            1240.00                       1870.00                       True    No        False   False   
Via4061       BGA                            1      6     $$$23918                       10                            1315.00                       1875.00                       True    No        False   False   
Via4055       BGA                            1      6     $$$23917                       10                            1377.49                       1872.48                       True    No        False   False   
Via3950       BGA                            1      6     $$$21607                       10                            1335.00                       1520.00                       True    No        False   False   
Via3809       BGA                            1      6     EBUS[5]-TX-                    10                            1565.00                       1765.00                       True    No        False   False   
Via3806       BGA                            1      6     EBUS[5]-TX+                    10                            1600.00                       1765.00                       True    No        False   False   
Via3780       BGA                            1      6     EBUS[5]-RX-                    10                            1515.00                       1835.00                       True    No        False   False   
Via3776       BGA                            1      6     EBUS[5]-RX+                    10                            1480.00                       1835.00                       True    No        False   False   
Via3196       POWERVIA                       1      6     GND                            24                            1406.08                       1742.75                       True    No        True    False   
Via3061       POWERVIA                       1      6     GND                            24                            1395.00                       1655.00                       True    No        True    False   
Via2972       NORMAL                         1      6     GND                            12                            1550.00                       1515.00                       True    No        True    False   
Via2805       POWERVIA                       1      6     +3V3                           24                            2344.49                       1525.48                       True    No        True    False   
Via4498       BGA                            1      6     CHASISID4                      10                            2774.37                       1538.20                       True    No        False   False   
Via4296       BGA                            1      6     TRANS-MODE-ENA_5               10                            2590.49                       1881.48                       True    No        False   False   
Via4280       BGA                            1      6     CLK_MODE[1]_5                  10                            2710.00                       1780.00                       True    No        False   False   
Via4128       BGA                            1      6     $$$12370                       10                            2650.00                       1880.00                       True    No        False   False   
Via4124       BGA                            1      6     $$$12368                       10                            2619.65                       1895.48                       True    No        False   False   
Via4118       BGA                            1      6     $$$12365                       10                            2770.00                       1895.00                       True    No        False   False   
Via3904       BGA                            1      6     ERR[3]                         10                            2658.80                       1540.48                       True    No        False   False   
Via3902       BGA                            1      6     P_CONF[3]                      10                            2493.49                       1654.48                       True    No        False   False   
Via3863       BGA                            1      6     PHYAD_OFF                      10                            2739.49                       1534.48                       True    No        False   False   
Via3846       BGA                            1      6     $$$21835                       10                            2801.93                       1538.20                       True    No        False   False   
Via3214       BGA                            1      6     GND                            10                            2538.49                       1502.48                       True    No        True    False   
Via3181       POWERVIA                       1      6     GND                            24                            2785.00                       1775.00                       True    No        True    False   
Via3031       NORMAL                         1      6     GND                            12                            2725.00                       1895.00                       True    No        True    False   
Via2786       BGA                            1      6     +3V3                           10                            2603.49                       1533.48                       True    No        True    False   
Via4529       BGA                            1      6     CHASISID1                      10                            3164.14                       1778.35                       True    No        False   False   
Via4521       BGA                            1      6     IO5                            10                            2884.00                       1675.00                       True    No        False   False   
Via4516       BGA                            1      6     IO3                            10                            3101.00                       1792.00                       True    No        False   False   
Via4505       BGA                            1      6     SLOT_ID                        10                            3193.80                       1786.23                       True    No        False   False   
Via4500       BGA                            1      6     CHASISID3                      10                            2880.49                       1536.48                       True    No        False   False   
Via4482       BGA                            1      6     $$$28231                       10                            3147.49                       1505.48                       True    No        False   False   
Via4480       BGA                            1      6     $$$28230                       10                            3032.49                       1516.48                       True    No        False   False   
Via4407       BGA                            1      6     C25_ENA_5                      10                            3024.00                       1859.00                       True    No        False   False   
Via3686       BGA                            1      6     SPARE                          10                            3188.00                       1675.00                       True    No        False   False   
Via3193       BGA                            1      6     GND                            10                            3039.09                       1802.48                       True    No        True    False   
Via5323       NORMAL                         1      6     GND                            12                            3580.00                       1800.00                       True    No        True    False   
Via5283       NORMAL                         1      6     GND                            12                            3580.00                       1750.00                       True    No        True    False   
Via4526       BGA                            1      6     IO7                            10                            3524.44                       1690.71                       True    No        False   False   
Via4524       BGA                            1      6     IO6                            10                            3433.85                       1769.20                       True    No        False   False   
Via4522       BGA                            1      6     IO5                            10                            3463.35                       1791.15                       True    No        False   False   
Via4519       BGA                            1      6     IO4                            10                            3523.98                       1853.16                       True    No        False   False   
Via2892       BGA                            1      6     +3V3                           10                            3596.22                       1635.48                       True    No        True    False   
Via2856       BGA                            1      6     +3V3                           10                            3393.00                       1635.00                       True    No        True    False   
Via5302       NORMAL                         1      6     GND                            12                            3635.00                       1800.00                       True    No        True    False   
Via5299       NORMAL                         1      6     GND                            12                            3635.00                       1750.00                       True    No        True    False   
Via4511       BGA                            1      6     APP_SDA                        10                            3708.49                       1611.48                       True    No        False   False   
Via4508       BGA                            1      6     APP_SCL                        10                            3621.81                       1624.48                       True    No        False   False   
Via4495       BGA                            1      6     A1                             10                            3763.00                       1859.00                       True    No        False   False   
Via4494       BGA                            1      6     A0                             10                            3766.50                       1746.86                       True    No        False   False   
Via3206       BGA                            1      6     GND                            10                            3959.41                       1746.86                       True    No        True    False   
Via2784       BGA                            1      6     +3V3                           10                            3957.00                       1859.00                       True    No        True    False   
Via2759       BGA                            1      6     +3V3                           10                            3889.49                       1639.48                       True    No        True    False   
Via4510       BGA                            1      6     APP_SDA                        10                            4215.49                       1734.48                       True    No        False   False   
Via4439       BGA                            1      6     EBUS[9]-TX+                    10                            4277.00                       1508.00                       True    No        False   False   
Via4423       BGA                            1      6     EBUS[12]-TX+                   10                            4282.00                       1851.00                       True    No        False   False   
Via4002       BGA1                           1      6     EBUS[9]-RX+                    10                            4227.00                       1551.00                       True    No        False   False   
Via4000       BGA1                           1      6     EBUS[9]-RX-                    10                            4227.00                       1524.00                       True    No        False   False   
Via3911       BGA                            1      6     PHY0_2V5A                      10                            4020.00                       1518.00                       True    No        False   False   
Via3786       BGA                            1      6     EBUS[12]-TX-                   10                            4281.00                       1822.00                       True    No        False   False   
Via3163       POWERVIA                       1      6     GND                            24                            4068.83                       1667.30                       True    No        True    False   
Via4102       BGA                            1      6     EBUS[12]-RX-                   10                            4745.00                       1868.00                       True    No        False   False   
Via4445       BGA                            1      6     EBUS[10]-TX-                   10                            4920.00                       1574.00                       True    No        False   False   
Via4421       BGA                            1      6     EBUS[10]-TX+                   10                            4921.00                       1603.00                       True    No        False   False   
Via4550       BGA1                           1      6     $$$27639                       10                            515.00                        2280.00                       True    No        False   False   
Via4548       BGA1                           1      6     $$$27636                       10                            520.00                        2090.00                       True    No        False   False   
Via4546       BGA1                           1      6     $$$27631                       10                            595.00                        1955.00                       True    No        False   False   
Via4190       BGA                            1      6     P_CONF[1]_2                    10                            632.49                        2170.48                       True    No        False   False   
Via4184       BGA                            1      6     TRANS-MODE-ENA_2               10                            767.49                        2267.48                       True    No        False   False   
Via3752       BGA                            1      6     CLK_MODE[1]_2                  10                            725.00                        2265.00                       True    No        False   False   
Via2996       POWERVIA                       1      6     GND                            24                            630.00                        1975.00                       True    No        True    False   
Via2764       BGA                            1      6     +3V3                           10                            735.09                        1969.48                       True    No        True    False   
Via4193       BGA_18D8P                      1      6     P_CONF[1]_2                    8                             997.00                        2230.00                       True    No        False   False   
Via4189       BGA_18D8P                      1      6     P_MODE[1]_2                    8                             998.51                        2198.50                       True    No        False   False   
Via4187       BGA_18D8P                      1      6     P_MODE[0]_2                    8                             1030.01                       2230.00                       True    No        False   False   
Via4186       BGA                            1      6     P_MODE[0]_2                    10                            865.00                        2050.00                       True    No        False   False   
Via4185       BGA_18D8P                      1      6     TRANS-MODE-ENA_2               8                             1061.51                       2230.00                       True    No        False   False   
Via4134       BGA                            1      6     C25_ENA_2                      10                            935.17                        2014.88                       True    No        False   False   
Via4077       BGA                            1      6     $$$23960                       10                            1160.00                       1965.00                       True    No        False   False   
Via4076       BGA_18D8P                      1      6     $$$23925                       8                             1155.99                       2198.50                       True    No        False   False   
Via4074       BGA_18D8P                      1      6     $$$23924                       8                             1061.51                       2261.50                       True    No        False   False   
Via4072       BGA_18D8P                      1      6     $$$23923                       8                             1124.50                       2230.00                       True    No        False   False   
Via4070       BGA_18D8P                      1      6     $$$23922                       8                             1093.00                       2230.00                       True    No        False   False   
Via4069       BGA                            1      6     $$$23922                       10                            1045.00                       1920.00                       True    No        False   False   
Via4068       BGA_18D8P                      1      6     $$$23921                       8                             1093.00                       2261.50                       True    No        False   False   
Via4066       BGA_18D8P                      1      6     $$$23920                       8                             1155.99                       2230.00                       True    No        False   False   
Via3991       BGA_18D8P                      1      6     EBUS[7]-RX+                    8                             1124.50                       2198.50                       True    No        False   False   
Via3989       BGA_18D8P                      1      6     EBUS[7]-RX-                    8                             1093.00                       2198.50                       True    No        False   False   
Via3789       BGA_18D8P                      1      6     EBUS[7]-TX-                    8                             1030.01                       2198.50                       True    No        False   False   
Via3753       BGA_18D8P                      1      6     CLK_MODE[1]_2                  8                             1030.01                       2261.50                       True    No        False   False   
Via3745       BGA_18D8P                      1      6     +2V5_CORE_2                    8                             1155.99                       2261.50                       True    No        True    False   
Via3719       BGA_18D8P                      1      6     EBUS[7]-TX+                    8                             1061.51                       2198.50                       True    No        False   False   
Via3669       BGA_18D8P                      1      6     EBUS[8]-RX+                    8                             998.51                        2292.99                       True    No        False   False   
Via3319       BGA_18D8P                      1      6     GND                            8                             1030.01                       2292.99                       True    No        True    False   
Via3318       BGA_18D8P                      1      6     GND                            8                             1093.00                       2292.99                       True    No        True    False   
Via3317       BGA_18D8P                      1      6     GND                            8                             1124.50                       2292.99                       True    No        True    False   
Via3316       BGA_18D8P                      1      6     GND                            8                             1156.00                       2293.00                       True    No        True    False   
Via3312       BGA_18D8P                      1      6     GND                            8                             998.51                        2261.50                       True    No        True    False   
Via3244       POWERVIA                       1      6     GND                            24                            831.49                        1947.48                       True    No        True    False   
Via3243       POWERVIA                       1      6     GND                            24                            890.00                        2165.00                       True    No        True    False   
Via2910       BGA_18D8P                      1      6     +3V3                           8                             1062.00                       2294.00                       True    No        True    False   
Via2908       BGA_18D8P                      1      6     +3V3                           8                             1124.49                       2261.48                       True    No        True    False   
Via2876       BGA                            1      6     +3V3                           10                            1091.49                       2097.48                       True    No        True    False   
Via2829       BGA                            1      6     +3V3                           10                            893.49                        1948.48                       True    No        True    False   
Via2828       POWERVIA                       1      6     +3V3                           24                            892.49                        2282.48                       True    No        True    False   
Via4416       BGA_18D8P                      1      6     C25_SHI[0]_2                   8                             1218.99                       2228.79                       True    No        False   False   
Via4221       BGA                            1      6     RUN/EEPROM_SIZE_2              10                            1592.49                       2007.48                       True    No        False   False   
Via4183       BGA_18D8P                      1      6     P_CONF[0]_2                    8                             1376.47                       2292.99                       True    No        False   False   
Via4181       BGA_18D8P                      1      6     CLK_MODE[0]_2                  8                             1344.97                       2292.99                       True    No        False   False   
Via4180       BGA                            1      6     CLK_MODE[0]_2                  10                            1505.00                       2200.00                       True    No        False   False   
Via4179       BGA_18D8P                      1      6     C25_SHI[1]_2                   8                             1218.99                       2198.50                       True    No        False   False   
Via4135       BGA_18D8P                      1      6     C25_ENA_2                      8                             1250.48                       2230.00                       True    No        False   False   
Via4080       BGA_18D8P                      1      6     $$$23961                       8                             1281.98                       2230.00                       True    No        False   False   
Via4079       BGA1                           1      6     $$$23961                       10                            1245.00                       1975.00                       True    No        False   False   
Via4078       BGA_18D8P                      1      6     $$$23960                       8                             1376.47                       2230.00                       True    No        False   False   
Via4064       BGA_18D8P                      1      6     $$$23919                       8                             1313.47                       2261.50                       True    No        False   False   
Via4063       BGA1                           1      6     $$$23919                       10                            1270.00                       1925.00                       True    No        False   False   
Via4062       BGA_18D8P                      1      6     $$$23918                       8                             1313.47                       2230.00                       True    No        False   False   
Via4056       BGA_18D8P                      1      6     $$$23917                       8                             1344.97                       2230.00                       True    No        False   False   
Via4054       BGA_18D8P                      1      6     $$$23916                       8                             1313.47                       2198.50                       True    No        False   False   
Via4053       BGA                            1      6     $$$23916                       10                            1385.00                       1905.00                       True    No        False   False   
Via3810       BGA_18D8P                      1      6     EBUS[5]-TX-                    8                             1344.97                       2198.50                       True    No        False   False   
Via3807       BGA_18D8P                      1      6     EBUS[5]-TX+                    8                             1376.47                       2198.50                       True    No        False   False   
Via3779       BGA_18D8P                      1      6     EBUS[5]-RX-                    8                             1250.00                       2199.00                       True    No        False   False   
Via3777       BGA_18D8P                      1      6     EBUS[5]-RX+                    8                             1281.98                       2198.50                       True    No        False   False   
Via3744       BGA_18D8P                      1      6     +2V5_CORE_2                    8                             1218.99                       2262.79                       True    No        True    False   
Via3741       BGA                            1      6     +2V5_CORE_2                    10                            1239.49                       2145.48                       True    No        True    False   
Via3315       BGA_18D8P                      1      6     GND                            8                             1219.00                       2293.00                       True    No        True    False   
Via3314       BGA_18D8P                      1      6     GND                            8                             1250.48                       2292.99                       True    No        True    False   
Via3313       BGA_18D8P                      1      6     GND                            8                             1281.98                       2292.99                       True    No        True    False   
Via3311       BGA_18D8P                      1      6     GND                            8                             1281.98                       2261.50                       True    No        True    False   
Via3242       BGA                            1      6     GND                            10                            1595.00                       2125.00                       True    No        True    False   
Via3166       POWERVIA                       1      6     GND                            24                            1400.00                       1950.00                       True    No        True    False   
Via3113       BGA                            1      6     GND                            10                            1530.00                       2005.00                       True    No        True    False   
Via3110       BGA                            1      6     GND                            10                            1590.00                       2230.00                       True    No        True    False   
Via2909       BGA_18D8P                      1      6     +3V3                           8                             1312.49                       2293.98                       True    No        True    False   
Via2907       BGA_18D8P                      1      6     +3V3                           8                             1249.49                       2262.49                       True    No        True    False   
Via2875       BGA                            1      6     +3V3                           10                            1480.00                       2285.00                       True    No        True    False   
Via2825       NORMAL                         1      6     +3V3                           12                            1435.00                       2180.00                       True    No        True    False   
Via4182       BGA                            1      6     P_CONF[0]_2                    10                            1677.49                       2287.48                       True    No        False   False   
Via3171       POWERVIA                       1      6     GND                            24                            1703.49                       2047.48                       True    No        True    False   
Via3075       POWERVIA                       1      6     GND                            24                            1812.49                       2047.48                       True    No        True    False   
Via3070       BGA                            1      6     GND                            10                            1931.49                       1965.48                       True    No        True    False   
Via3220       POWERVIA                       1      6     GND                            24                            2289.49                       1980.48                       True    No        True    False   
Via2863       POWERVIA                       1      6     +3V3                           24                            2364.49                       1985.48                       True    No        True    False   
Via4450       BGA_18D8P                      1      6     EBUS[16]-TX+                   8                             2603.51                       2231.50                       True    No        False   False   
Via4432       BGA_18D8P                      1      6     EBUS[16]-TX-                   8                             2572.01                       2231.50                       True    No        False   False   
Via4408       BGA_18D8P                      1      6     C25_ENA_5                      8                             2792.48                       2263.00                       True    No        False   False   
Via4315       BGA_18D8P                      1      6     C25_SHI[1]_5                   8                             2760.99                       2231.50                       True    No        False   False   
Via4313       BGA_18D8P                      1      6     C25_SHI[0]_5                   8                             2760.99                       2263.00                       True    No        False   False   
Via4308       BGA1                           1      6     $$$12405                       10                            2689.00                       1954.00                       True    No        False   False   
Via4297       BGA_18D8P                      1      6     TRANS-MODE-ENA_5               8                             2603.51                       2263.00                       True    No        False   False   
Via4285       BGA_18D8P                      1      6     P_CONF[1]_5                    8                             2538.99                       2261.48                       True    No        False   False   
Via4283       BGA_18D8P                      1      6     CLK_MODE[1]_5                  8                             2572.01                       2294.50                       True    No        False   False   
Via4282       BGA_18D8P                      1      6     CLK_MODE[1]_5                  8                             2504.49                       2276.98                       True    No        False   False   
Via4281       BGA_18D8P                      1      6     CLK_MODE[1]_5                  8                             2504.49                       2195.48                       True    No        False   False   
Via4279       BGA_18D8P                      1      6     P_MODE[1]_5                    8                             2540.51                       2231.50                       True    No        False   False   
Via4150       BGA_18D8P                      1      6     P_MODE[0]_5                    8                             2572.01                       2263.00                       True    No        False   False   
Via4149       BGA                            1      6     P_MODE[0]_5                    10                            2471.00                       2231.00                       True    No        False   False   
Via4129       BGA_18D8P                      1      6     $$$12370                       8                             2697.99                       2231.50                       True    No        False   False   
Via4127       BGA_18D8P                      1      6     $$$12369                       8                             2603.51                       2294.50                       True    No        False   False   
Via4126       BGA                            1      6     $$$12369                       10                            2679.49                       1931.58                       True    No        False   False   
Via4125       BGA_18D8P                      1      6     $$$12368                       8                             2666.50                       2263.00                       True    No        False   False   
Via4123       BGA_18D8P                      1      6     $$$12367                       8                             2635.00                       2263.00                       True    No        False   False   
Via4122       BGA                            1      6     $$$12367                       10                            2579.49                       1931.58                       True    No        False   False   
Via4121       BGA_18D8P                      1      6     $$$12366                       8                             2635.00                       2294.50                       True    No        False   False   
Via4120       BGA                            1      6     $$$12366                       10                            2789.49                       1931.58                       True    No        False   False   
Via4119       BGA_18D8P                      1      6     $$$12365                       8                             2697.99                       2263.00                       True    No        False   False   
Via3854       BGA_18D8P                      1      6     +2V5_CORE_5                    8                             2697.99                       2294.50                       True    No        True    False   
Via3853       BGA_18D8P                      1      6     +2V5_CORE_5                    8                             2760.99                       2294.50                       True    No        True    False   
Via3851       BGA                            1      6     +2V5_CORE_5                    10                            2547.49                       2144.48                       True    No        True    False   
Via3816       BGA_18D8P                      1      6     EBUS[16]-RX-                   8                             2635.00                       2231.50                       True    No        False   False   
Via3814       BGA_18D8P                      1      6     EBUS[14]-RX-                   8                             2792.48                       2231.50                       True    No        False   False   
Via3714       BGA_18D8P                      1      6     EBUS[16]-RX+                   8                             2666.00                       2228.00                       True    No        False   False   
Via3607       BGA_18D8P                      1      6     GND                            8                             2540.51                       2294.50                       True    No        True    False   
Via3219       POWERVIA                       1      6     GND                            24                            2428.49                       1970.48                       True    No        True    False   
Via2961       BGA_18D8P                      1      6     +3V3                           8                             2667.49                       2295.49                       True    No        True    False   
Via2960       BGA_18D8P                      1      6     +3V3                           8                             2790.49                       2296.49                       True    No        True    False   
Via2810       BGA                            1      6     +3V3                           10                            2490.00                       1965.00                       True    No        True    False   
Via4563       BGA1                           1      6     CLK_MODE[0]_5                  10                            3112.00                       2016.00                       True    No        False   False   
Via4314       BGA                            1      6     C25_SHI[1]_5                   10                            2820.00                       1908.00                       True    No        False   False   
Via4312       BGA                            1      6     C25_SHI[0]_5                   10                            2854.49                       1905.48                       True    No        False   False   
Via4311       BGA_18D8P                      1      6     $$$12406                       8                             2823.98                       2263.00                       True    No        False   False   
Via4310       BGA                            1      6     $$$12406                       10                            2895.49                       1992.48                       True    No        False   False   
Via4309       BGA_18D8P                      1      6     $$$12405                       8                             2918.47                       2263.00                       True    No        False   False   
Via4117       BGA_18D8P                      1      6     $$$12364                       8                             2855.47                       2294.50                       True    No        False   False   
Via4116       BGA                            1      6     $$$12364                       10                            3009.49                       1970.48                       True    No        False   False   
Via4115       BGA_18D8P                      1      6     $$$12363                       8                             2855.47                       2263.00                       True    No        False   False   
Via4114       BGA                            1      6     $$$12363                       10                            2977.49                       1993.48                       True    No        False   False   
Via4113       BGA_18D8P                      1      6     $$$12362                       8                             2886.97                       2263.00                       True    No        False   False   
Via4112       BGA                            1      6     $$$12362                       10                            2949.65                       1993.48                       True    No        False   False   
Via4013       BGA_18D8P                      1      6     $$$12361                       8                             2855.47                       2231.50                       True    No        False   False   
Via4012       BGA                            1      6     $$$12361                       10                            2909.49                       1968.98                       True    No        False   False   
Via3822       BGA_18D8P                      1      6     EBUS[14]-TX-                   8                             2886.97                       2231.50                       True    No        False   False   
Via3819       BGA_18D8P                      1      6     EBUS[14]-TX+                   8                             2918.47                       2231.50                       True    No        False   False   
Via3805       BGA_18D8P                      1      6     EBUS[14]-RX+                   8                             2823.98                       2231.50                       True    No        False   False   
Via3711       BGA                            1      6     RUN/EEPROM_SIZE_5              10                            3143.98                       2210.48                       True    No        False   False   
Via3606       BGA_18D8P                      1      6     GND                            8                             2823.98                       2294.50                       True    No        True    False   
Via3266       BGA                            1      6     GND                            10                            3212.00                       2206.00                       True    No        True    False   
Via3265       BGA1                           1      6     GND                            10                            3187.00                       2015.00                       True    No        True    False   
Via2808       BGA_18D8P                      1      6     +3V3                           8                             2972.49                       2240.48                       True    No        True    False   
Via4530       BGA                            1      6     CHASISID1                      10                            3321.62                       1904.34                       True    No        False   False   
Via4517       BGA                            1      6     IO3                            10                            3570.63                       1935.83                       True    No        False   False   
Via4514       BGA                            1      6     IO2                            10                            3596.22                       1927.96                       True    No        False   False   
Via4497       BGA                            1      6     CHASISID4                      10                            3364.00                       1909.00                       True    No        False   False   
Via3910       BGA_18D8P                      1      6     PHY0_2V5A                      8                             3602.13                       2151.00                       True    No        False   False   
Via3264       BGA1                           1      6     GND                            10                            3279.00                       2021.00                       True    No        True    False   
Via3155       BGA1                           1      6     GND                            10                            3229.00                       2273.00                       True    No        True    False   
Via3128       BGA1                           1      6     GND                            10                            3425.00                       1915.00                       True    No        True    False   
Via3087       BGA                            1      6     GND                            10                            3272.00                       1986.00                       True    No        True    False   
Via2888       BGA                            1      6     +3V3                           10                            3547.49                       1988.48                       True    No        True    False   
Via4512       BGA                            1      6     IO1                            10                            3664.14                       1925.01                       True    No        False   False   
Via4503       BGA                            1      6     IO0                            10                            3675.49                       1946.69                       True    No        False   False   
Via4496       BGA                            1      6     A2                             10                            3762.56                       1959.46                       True    No        False   False   
Via4493       BGA                            1      6     $$$6128                        10                            3650.00                       2152.00                       True    No        False   False   
Via3199       BGA                            1      6     GND                            10                            3623.00                       1921.00                       True    No        True    False   
Via3077       BGA                            1      6     GND                            10                            3979.00                       1960.00                       True    No        True    False   
Via2785       BGA                            1      6     +3V3                           10                            3955.49                       1915.48                       True    No        True    False   
Via4106       BGA                            1      6     EBUS[13]-RX+                   10                            4332.00                       2051.00                       True    No        False   False   
Via3908       BGA_18D8P                      1      6     PHY0_2V5A                      8                             4070.49                       2099.45                       True    No        False   False   
Via3763       BGA                            1      6     EBUS[13]-RX-                   10                            4332.00                       2020.00                       True    No        False   False   
Via3052       BGA1                           1      6     GND                            10                            4065.00                       2210.00                       True    No        True    False   
Via3049       BGA1                           1      6     GND                            10                            4155.00                       2210.00                       True    No        True    False   
Via2782       BGA1                           1      6     +3V3                           10                            4245.00                       2210.00                       True    No        True    False   
Via4451       BGA                            1      6     EBUS[18]-TX+                   10                            4483.00                       2185.00                       True    No        False   False   
Via4447       BGA                            1      6     EBUS[15]-TX-                   10                            4770.00                       2247.00                       True    No        False   False   
Via4433       BGA                            1      6     EBUS[18]-TX-                   10                            4483.00                       2216.00                       True    No        False   False   
Via4429       BGA                            1      6     EBUS[15]-TX+                   10                            4770.00                       2277.00                       True    No        False   False   
Via4110       BGA                            1      6     EBUS[15]-RX+                   10                            4570.00                       1947.00                       True    No        False   False   
Via4108       BGA                            1      6     EBUS[15]-RX-                   10                            4570.00                       1911.00                       True    No        False   False   
Via4104       BGA                            1      6     EBUS[12]-RX+                   10                            4744.00                       1900.00                       True    No        False   False   
Via3815       BGA                            1      6     EBUS[16]-RX-                   10                            4630.00                       2188.00                       True    No        False   False   
Via3713       BGA                            1      6     EBUS[16]-RX+                   10                            4631.00                       2155.00                       True    No        False   False   
Via4449       BGA                            1      6     EBUS[16]-TX+                   10                            4842.00                       2105.00                       True    No        False   False   
Via4431       BGA                            1      6     EBUS[16]-TX-                   10                            4842.00                       2135.00                       True    No        False   False   
Via4427       BGA                            1      6     EBUS[13]-TX-                   10                            4896.00                       1967.00                       True    No        False   False   
Via4425       BGA                            1      6     EBUS[13]-TX+                   10                            4896.00                       2003.00                       True    No        False   False   
Via4567       BGA1                           1      6     $$$27031                       10                            485.00                        2695.00                       True    No        False   False   
Via4554       BGA                            1      6     $$$27655                       10                            442.00                        2613.00                       True    No        False   False   
Via4552       BGA1                           1      6     $$$27642                       10                            455.00                        2465.00                       True    No        False   False   
Via4204       BGA                            1      6     P_CONF[3]_2                    10                            760.00                        2502.00                       True    No        False   False   
Via4194       BGA                            1      6     CTRL_STATUS_MOVE_2             10                            545.00                        2405.00                       True    No        False   False   
Via4191       BGA_18D8P                      1      6     P_CONF[1]_2                    8                             782.00                        2678.00                       True    No        False   False   
Via3238       BGA1                           1      6     GND                            10                            797.00                        2426.00                       True    No        True    False   
Via3079       BGA1                           1      6     GND                            10                            630.00                        2605.00                       True    No        True    False   
Via2997       BGA                            1      6     GND                            10                            710.00                        2610.00                       True    No        True    False   
Via2827       POWERVIA                       1      6     +3V3                           24                            752.49                        2307.48                       True    No        True    True    
Via2766       BGA                            1      6     +3V3                           10                            547.49                        2617.48                       True    No        True    False   
Via4582       BGA_18D8P                      1      6     $$$7051                        8                             1030.00                       2450.00                       True    No        False   False   
Via4442       BGA_18D8P                      1      6     EBUS[9]-TX-                    8                             1061.51                       2576.46                       True    No        False   False   
Via4440       BGA_18D8P                      1      6     EBUS[9]-TX+                    8                             1030.01                       2576.46                       True    No        False   False   
Via4206       BGA_18D8P                      1      6     P_CONF[3]_2                    8                             1030.01                       2513.46                       True    No        False   False   
Via4199       BGA_18D8P                      1      6     P_CONF[2]_2                    8                             1061.51                       2450.47                       True    No        False   False   
Via4197       BGA_18D8P                      1      6     PHYAD_OFF_2                    8                             1061.51                       2513.46                       True    No        False   False   
Via4195       BGA_18D8P                      1      6     CTRL_STATUS_MOVE_2             8                             1030.01                       2418.98                       True    No        False   False   
Via4137       BGA_18D8P                      1      6     ERR[3]_2                       8                             1030.01                       2544.96                       True    No        False   False   
Via4003       BGA_18D8P                      1      6     EBUS[9]-RX+                    8                             998.51                        2544.96                       True    No        False   False   
Via4001       BGA_18D8P                      1      6     EBUS[9]-RX-                    8                             998.51                        2576.46                       True    No        False   False   
Via3963       BGA_18D8P                      1      6     $$$23915                       8                             1093.00                       2513.46                       True    No        False   False   
Via3800       BGA_18D8P                      1      6     EBUS[8]-TX+                    8                             998.51                        2418.98                       True    No        False   False   
Via3783       BGA_18D8P                      1      6     EBUS[8]-TX-                    8                             998.51                        2450.47                       True    No        False   False   
Via3746       BGA_18D8P                      1      6     +2V5_CORE_2                    8                             1155.99                       2513.46                       True    No        True    False   
Via3743       BGA_18D8P                      1      6     +2V5_CORE_2                    8                             1149.49                       2375.48                       True    No        True    False   
Via3742       BGA_18D8P                      1      6     +2V5_CORE_2                    8                             1169.49                       2626.98                       True    No        True    False   
Via3672       BGA_18D8P                      1      6     EBUS[8]-RX-                    8                             998.51                        2324.49                       True    No        False   False   
Via3367       BGA_18D8P                      1      6     GND                            8                             1093.00                       2576.46                       True    No        True    False   
Via3366       BGA_18D8P                      1      6     GND                            8                             1124.50                       2576.46                       True    No        True    False   
Via3365       BGA_18D8P                      1      6     GND                            8                             1155.99                       2576.46                       True    No        True    False   
Via3358       BGA_18D8P                      1      6     GND                            8                             1061.51                       2544.96                       True    No        True    False   
Via3357       BGA_18D8P                      1      6     GND                            8                             1093.00                       2544.96                       True    No        True    False   
Via3356       BGA_18D8P                      1      6     GND                            8                             1124.50                       2544.96                       True    No        True    False   
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
Via2913       BGA_18D8P                      1      6     +3V3                           8                             1061.49                       2418.99                       True    No        True    False   
Via2877       POWERVIA                       1      6     +3V3                           24                            887.49                        2437.48                       True    No        True    False   
Via4571       BGA_18D8P                      1      6     $$$6487                        8                             1375.00                       2325.00                       True    No        False   False   
Via4471       BGA_18D8P                      1      6     $$$23914                       8                             1376.47                       2450.47                       True    No        False   False   
Via4469       BGA_18D8P                      1      6     $$$23913                       8                             1344.97                       2450.47                       True    No        False   False   
Via4223       BGA_18D8P                      1      6     EEPROM_DATA_2                  8                             1344.97                       2418.98                       True    No        False   False   
Via4222       BGA_18D8P                      1      6     RUN/EEPROM_SIZE_2              8                             1344.97                       2324.49                       True    No        False   False   
Via4203       BGA_18D8P                      1      6     OSC_OUT_2                      8                             1376.47                       2418.98                       True    No        False   False   
Via4201       BGA_18D8P                      1      6     OSC_IN_2                       8                             1376.47                       2355.98                       True    No        False   False   
Via4200       BGA                            1      6     OSC_IN_2                       10                            1540.00                       2325.00                       True    No        False   False   
Via4139       BGA_18D8P                      1      6     EEPROM_CLK_2                   8                             1344.97                       2355.98                       True    No        False   False   
Via4138       BGA_18D8P                      1      6     EEPROM_CLK_2                   8                             1422.49                       2382.48                       True    No        False   False   
Via3747       BGA_18D8P                      1      6     +2V5_CORE_2                    8                             1218.99                       2513.46                       True    No        True    False   
Via3740       BGA_18D8P                      1      6     +2V5_CORE_2                    8                             1408.49                       2326.48                       True    No        True    False   
Via3739       BGA_18D8P                      1      6     +2V5_CORE_2                    8                             1313.47                       2355.98                       True    No        True    False   
Via3364       BGA_18D8P                      1      6     GND                            8                             1218.99                       2576.46                       True    No        True    False   
Via3363       BGA_18D8P                      1      6     GND                            8                             1250.48                       2576.46                       True    No        True    False   
Via3362       BGA_18D8P                      1      6     GND                            8                             1281.98                       2576.46                       True    No        True    False   
Via3361       BGA_18D8P                      1      6     GND                            8                             1313.47                       2576.46                       True    No        True    False   
Via3360       BGA_18D8P                      1      6     GND                            8                             1344.97                       2576.46                       True    No        True    False   
Via3359       BGA_18D8P                      1      6     GND                            8                             1376.47                       2576.46                       True    No        True    False   
Via3354       BGA_18D8P                      1      6     GND                            8                             1218.99                       2544.96                       True    No        True    False   
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
Via2993       NORMAL                         1      6     GND                            12                            1600.00                       2640.00                       True    No        True    False   
Via2915       BGA_18D8P                      1      6     +3V3                           8                             1313.99                       2482.48                       True    No        True    False   
Via2914       BGA_18D8P                      1      6     +3V3                           8                             1282.49                       2450.98                       True    No        True    False   
Via2912       BGA_18D8P                      1      6     +3V3                           8                             1313.98                       2419.48                       True    No        True    False   
Via2911       BGA_18D8P                      1      6     +3V3                           8                             1282.49                       2323.98                       True    No        True    False   
Via2878       POWERVIA                       1      6     +3V3                           24                            1492.49                       2575.48                       True    No        True    False   
Via4570       BGA1                           1      6     $$$6487                        10                            1810.00                       2330.00                       True    No        False   False   
Via4202       BGA                            1      6     OSC_OUT_2                      10                            1650.00                       2395.00                       True    No        False   False   
Via3169       POWERVIA                       1      6     GND                            24                            1647.33                       2557.48                       True    No        True    False   
Via3168       NORMAL                         1      6     GND                            12                            1700.00                       2635.00                       True    No        True    False   
Via3160       NORMAL                         1      6     GND                            12                            1840.00                       2390.00                       True    No        True    False   
Via3148       POWERVIA                       1      6     GND                            24                            1782.49                       2597.48                       True    No        True    False   
Via2845       POWERVIA                       1      6     +3V3                           24                            1832.49                       2486.48                       True    No        True    False   
Via2826       BGA1                           1      6     +3V3                           10                            1655.00                       2335.00                       True    No        True    False   
Via2790       BGA1                           1      6     +3V3                           10                            1815.00                       2430.00                       True    No        True    False   
Via4319       BGA                            1      6     P_CONF[2]_5                    10                            2286.41                       2580.39                       True    No        False   False   
Via3203       POWERVIA                       1      6     GND                            24                            2139.49                       2333.08                       True    No        True    False   
Via4588       BGA_18D8P                      1      6     $$$7121                        8                             2575.00                       2480.00                       True    No        False   False   
Via4587       BGA1                           1      6     $$$7121                        10                            2455.00                       2685.00                       True    No        False   False   
Via4452       BGA_18D8P                      1      6     EBUS[18]-TX+                   8                             2572.00                       2610.00                       True    No        False   False   
Via4434       BGA_18D8P                      1      6     EBUS[18]-TX-                   8                             2603.51                       2609.46                       True    No        False   False   
Via4320       BGA_18D8P                      1      6     P_CONF[2]_5                    8                             2603.51                       2483.47                       True    No        False   False   
Via4318       BGA_18D8P                      1      6     CTRL_STATUS_MOVE_5             8                             2572.01                       2451.98                       True    No        False   False   
Via4295       BGA_18D8P                      1      6     ERR[3]_5                       8                             2572.01                       2577.96                       True    No        False   False   
Via4287       BGA_18D8P                      1      6     PHYAD_OFF_5                    8                             2603.51                       2546.46                       True    No        False   False   
Via4133       BGA_18D8P                      1      6     P_CONF[3]_5                    8                             2574.49                       2543.98                       True    No        False   False   
Via4021       BGA_18D8P                      1      6     EBUS[17]-RX+                   8                             2540.51                       2325.99                       True    No        False   False   
Via4018       BGA_18D8P                      1      6     EBUS[17]-RX-                   8                             2540.51                       2357.49                       True    No        False   False   
Via4015       BGA_18D8P                      1      6     EBUS[17]-TX+                   8                             2540.51                       2451.98                       True    No        False   False   
Via4011       BGA_18D8P                      1      6     $$$12360                       8                             2635.00                       2546.46                       True    No        False   False   
Via3857       BGA_18D8P                      1      6     +2V5_CORE_5                    8                             2697.99                       2546.46                       True    No        True    False   
Via3856       BGA_18D8P                      1      6     +2V5_CORE_5                    8                             2760.99                       2546.46                       True    No        True    False   
Via3850       BGA                            1      6     +2V5_CORE_5                    10                            2675.49                       2683.48                       True    No        True    False   
Via3849       BGA_18D8P                      1      6     +2V5_CORE_5                    8                             2715.00                       2426.00                       True    No        True    False   
Via3812       BGA_18D8P                      1      6     EBUS[18]-RX-                   8                             2539.00                       2609.00                       True    No        False   False   
Via3803       BGA_18D8P                      1      6     EBUS[18]-RX+                   8                             2540.51                       2577.96                       True    No        False   False   
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
Via3610       BGA_18D8P                      1      6     GND                            8                             2760.99                       2325.99                       True    No        True    False   
Via3609       BGA_18D8P                      1      6     GND                            8                             2792.48                       2325.99                       True    No        True    False   
Via2970       BGA_18D8P                      1      6     +3V3                           8                             2668.49                       2544.47                       True    No        True    False   
Via2969       BGA_18D8P                      1      6     +3V3                           8                             2604.00                       2516.00                       True    No        True    False   
Via2966       BGA_18D8P                      1      6     +3V3                           8                             2605.49                       2449.99                       True    No        True    False   
Via2963       BGA_18D8P                      1      6     +3V3                           8                             2603.49                       2325.98                       True    No        True    False   
Via2864       POWERVIA                       1      6     +3V3                           24                            2479.49                       2461.86                       True    No        True    False   
Via2854       BGA_18D8P                      1      6     +3V3                           8                             2702.00                       2404.00                       True    No        True    False   
Via2853       POWERVIA                       1      6     +3V3                           24                            2474.49                       2301.48                       True    No        True    False   
Via2811       BGA                            1      6     +3V3                           10                            2470.49                       2559.48                       True    No        True    False   
Via4577       BGA_18D8P                      1      6     $$$6526                        8                             2915.00                       2360.00                       True    No        False   False   
Via4564       BGA_18D8P                      1      6     CLK_MODE[0]_5                  8                             2885.00                       2330.00                       True    No        False   False   
Via4467       BGA_18D8P                      1      6     $$$12359                       8                             2918.47                       2483.47                       True    No        False   False   
Via4465       BGA_18D8P                      1      6     $$$12358                       8                             2886.97                       2483.47                       True    No        False   False   
Via4317       BGA_18D8P                      1      6     P_CONF[0]_5                    8                             2918.47                       2325.99                       True    No        False   False   
Via4306       BGA_18D8P                      1      6     EEPROM_CLK_5                   8                             2886.97                       2388.98                       True    No        False   False   
Via4305       BGA_18D8P                      1      6     EEPROM_CLK_5                   8                             2974.33                       2405.48                       True    No        False   False   
Via4304       BGA_18D8P                      1      6     EEPROM_DATA_5                  8                             2886.97                       2451.98                       True    No        False   False   
Via4293       BGA_18D8P                      1      6     OSC_OUT_5                      8                             2918.47                       2451.98                       True    No        False   False   
Via4291       BGA_18D8P                      1      6     OSC_IN_5                       8                             2918.47                       2388.98                       True    No        False   False   
Via4290       BGA                            1      6     OSC_IN_5                       10                            3054.49                       2345.48                       True    No        False   False   
Via3855       BGA_18D8P                      1      6     +2V5_CORE_5                    8                             2855.47                       2388.98                       True    No        True    False   
Via3848       BGA_18D8P                      1      6     +2V5_CORE_5                    8                             2982.49                       2467.48                       True    No        True    False   
Via3712       BGA_18D8P                      1      6     RUN/EEPROM_SIZE_5              8                             2886.97                       2357.49                       True    No        False   False   
Via3657       BGA_18D8P                      1      6     GND                            8                             2823.98                       2609.46                       True    No        True    False   
Via3656       BGA_18D8P                      1      6     GND                            8                             2855.47                       2609.46                       True    No        True    False   
Via3655       BGA_18D8P                      1      6     GND                            8                             2886.97                       2609.46                       True    No        True    False   
Via3654       BGA_18D8P                      1      6     GND                            8                             2918.47                       2609.46                       True    No        True    False   
Via3647       BGA_18D8P                      1      6     GND                            8                             2823.98                       2577.96                       True    No        True    False   
Via3646       BGA_18D8P                      1      6     GND                            8                             2855.47                       2577.96                       True    No        True    False   
Via3645       BGA_18D8P                      1      6     GND                            8                             2886.97                       2577.96                       True    No        True    False   
Via3644       BGA_18D8P                      1      6     GND                            8                             2918.47                       2577.96                       True    No        True    False   
Via3641       BGA_18D8P                      1      6     GND                            8                             2823.98                       2546.46                       True    No        True    False   
Via3640       BGA_18D8P                      1      6     GND                            8                             2855.47                       2546.46                       True    No        True    False   
Via3639       BGA_18D8P                      1      6     GND                            8                             2886.97                       2546.46                       True    No        True    False   
Via3638       BGA_18D8P                      1      6     GND                            8                             2918.47                       2546.46                       True    No        True    False   
Via3630       BGA_18D8P                      1      6     GND                            8                             2823.98                       2514.97                       True    No        True    False   
Via3629       BGA_18D8P                      1      6     GND                            8                             2886.97                       2514.97                       True    No        True    False   
Via3628       BGA_18D8P                      1      6     GND                            8                             2918.47                       2514.97                       True    No        True    False   
Via3626       BGA_18D8P                      1      6     GND                            8                             2855.47                       2483.47                       True    No        True    False   
Via3624       BGA_18D8P                      1      6     GND                            8                             2823.98                       2451.98                       True    No        True    False   
Via3619       BGA_18D8P                      1      6     GND                            8                             2823.98                       2388.98                       True    No        True    False   
Via3615       BGA_18D8P                      1      6     GND                            8                             2855.47                       2357.49                       True    No        True    False   
Via3608       BGA_18D8P                      1      6     GND                            8                             2823.98                       2325.99                       True    No        True    False   
Via3182       NORMAL                         1      6     GND                            12                            3009.49                       2389.48                       True    No        True    False   
Via3008       BGA                            1      6     GND                            10                            3203.00                       2304.00                       True    No        True    False   
Via2968       BGA_18D8P                      1      6     +3V3                           8                             2856.00                       2515.00                       True    No        True    False   
Via2967       BGA_18D8P                      1      6     +3V3                           8                             2824.49                       2483.98                       True    No        True    False   
Via2965       BGA_18D8P                      1      6     +3V3                           8                             2855.49                       2451.99                       True    No        True    False   
Via2964       BGA_18D8P                      1      6     +3V3                           8                             2824.49                       2356.98                       True    No        True    False   
Via2962       BGA_18D8P                      1      6     +3V3                           8                             2856.00                       2326.00                       True    No        True    False   
Via2793       BGA                            1      6     +3V3                           10                            3210.49                       2575.48                       True    No        True    False   
Via2778       BGA_18D8P                      1      6     +3V3                           8                             2986.49                       2557.48                       True    No        True    False   
Via4576       BGA1                           1      6     $$$6526                        10                            3370.00                       2395.00                       True    No        False   False   
Via4411       BGA                            1      6     ET1100(1)_TX+                  10                            3552.13                       2647.48                       True    No        False   False   
Via4316       BGA                            1      6     P_CONF[0]_5                    10                            3270.00                       2303.00                       True    No        False   False   
Via4292       BGA                            1      6     OSC_OUT_5                      10                            3224.49                       2400.48                       True    No        False   False   
Via3263       POWERVIA                       1      6     GND                            24                            3349.49                       2350.48                       True    No        True    False   
Via3146       POWERVIA                       1      6     GND                            24                            3339.49                       2590.48                       True    No        True    False   
Via2842       BGA                            1      6     +3V3                           10                            3339.49                       2418.48                       True    No        True    False   
Via2776       BGA                            1      6     +3V3                           10                            3283.49                       2454.18                       True    No        True    False   
Via4413       BGA                            1      6     ET1100(1)_TX-                  10                            3652.13                       2645.48                       True    No        False   False   
Via3683       NORMAL                         1      6     ET1100(1)_RX+                  12                            3800.00                       2655.00                       True    No        False   False   
Via3681       NORMAL                         1      6     ET1100(1)_RX-                  12                            3905.00                       2655.00                       True    No        False   False   
Via4509       BGA                            1      6     APP_SDA                        10                            4363.00                       2508.00                       True    No        False   False   
Via4501       BGA                            1      6     CHASISID3                      10                            4403.00                       2548.00                       True    No        False   False   
Via4458       BGA                            1      6     RJ45_TX-                       10                            4115.00                       2690.00                       True    No        False   False   
Via4457       BGA                            1      6     RJ45_TX+                       10                            4175.00                       2690.00                       True    No        False   False   
Via4456       BGA                            1      6     RJ45_RX-                       10                            4155.00                       2470.00                       True    No        False   False   
Via3691       BGA                            1      6     APP_RX-                        10                            4175.00                       2445.00                       True    No        False   False   
Via3690       BGA                            1      6     APP_RX+                        10                            4115.00                       2445.00                       True    No        False   False   
Via3689       BGA                            1      6     APP_TX+                        10                            4205.00                       2620.00                       True    No        False   False   
Via3685       BGA                            1      6     RJ45_RX+                       10                            4085.00                       2470.00                       True    No        False   False   
Via3684       BGA                            1      6     ET1100(1)_RX+                  10                            4065.00                       2380.00                       True    No        False   False   
Via3682       BGA                            1      6     ET1100(1)_RX-                  10                            4155.00                       2380.00                       True    No        False   False   
Via3677       BGA                            1      6     ECAT_MASTER                    10                            4245.00                       2385.00                       True    No        False   False   
Via3676       BGA                            1      6     APP_TX-                        10                            4135.00                       2655.00                       True    No        False   False   
Via3666       BGA                            1      6     GND                            10                            4162.00                       2548.00                       True    No        True    False   
Via3665       BGA                            1      6     GND                            10                            4130.00                       2580.00                       True    No        True    False   
Via3664       BGA                            1      6     GND                            10                            4221.00                       2494.00                       True    No        True    False   
Via3663       BGA                            1      6     GND                            10                            4047.00                       2574.00                       True    No        True    False   
Via2971       BGA                            1      6     +3V3                           10                            4255.00                       2555.00                       True    No        True    False   
Via8012       NORMAL                         1      6     +3V3                           12                            400.00                        2845.00                       True    No        True    False   
Via4555       BGA                            1      6     $$$27679                       10                            395.00                        2880.00                       True    No        False   False   
Via3036       BGA                            1      6     GND                            10                            400.00                        2805.00                       True    No        True    False   
Via4543       BGA                            1      6     $$$27628                       10                            400.00                        3060.00                       True    No        False   False   
Via3038       BGA                            1      6     GND                            10                            405.00                        3020.00                       True    No        True    False   
Via5888       NORMAL                         1      6     P_CONF[3]_4                    12                            685.00                        3095.00                       True    No        False   False   
Via5691       NORMAL                         1      6     P_CONF[1]_3                    12                            660.00                        3045.00                       True    No        False   False   
Via8025       BGA                            1      6     P_CONF[3]_3                    10                            660.00                        3005.00                       True    No        False   False   
Via5859       BGA                            1      6     P_CONF[3]_2                    10                            675.00                        2975.00                       True    No        False   False   
Via5173       BGA                            1      6     P_CONF[3]_1                    10                            690.00                        2830.00                       True    No        False   False   
Via3035       BGA                            1      6     GND                            10                            510.00                        2735.00                       True    No        True    False   
Via4557       BGA                            1      6     $$$27682                       10                            510.00                        2845.00                       True    No        False   False   
Via3037       BGA                            1      6     GND                            10                            510.00                        2905.00                       True    No        True    False   
Via4553       BGA                            1      6     $$$27655                       10                            510.00                        2940.00                       True    No        False   False   
Via4549       BGA                            1      6     $$$27639                       10                            510.00                        2985.00                       True    No        False   False   
Via4547       BGA                            1      6     $$$27636                       10                            530.00                        3015.00                       True    No        False   False   
Via4551       BGA                            1      6     $$$27642                       10                            540.00                        2960.00                       True    No        False   False   
Via4545       BGA                            1      6     $$$27631                       10                            610.00                        3040.00                       True    No        False   False   
Via4581       BGA1                           1      6     $$$7051                        10                            800.00                        2710.00                       True    No        False   False   
Via4559       BGA                            1      6     $$$27704                       10                            520.00                        2810.00                       True    No        False   False   
Via4536       BGA                            1      6     $$$26954                       10                            509.00                        2767.00                       True    No        False   False   
Via4162       BGA                            1      6     P_CONF[1]_1                    10                            660.00                        2940.00                       True    No        False   False   
Via3150       NORMAL                         1      6     GND                            12                            580.00                        2807.00                       True    No        True    False   
Via3043       BGA                            1      6     GND                            10                            695.00                        2910.00                       True    No        True    False   
Via3042       BGA                            1      6     GND                            10                            690.00                        3020.00                       True    No        True    False   
Via2895       BGA                            1      6     +3V3                           10                            530.00                        3075.00                       True    No        True    False   
Via2894       BGA                            1      6     +3V3                           10                            810.00                        3065.00                       True    No        True    False   
Via2893       BGA                            1      6     +3V3                           10                            805.00                        2875.00                       True    No        True    False   
Via2846       BGA                            1      6     +3V3                           10                            540.49                        2870.48                       True    No        True    False   
Via5174       BGA_18D8P                      1      6     P_CONF[1]_2                    8                             895.00                        2980.00                       True    No        False   False   
Via4207       BGA                            1      6     C25_SHI[1]_3                   10                            1035.00                       3065.00                       True    No        False   False   
Via4198       BGA                            1      6     P_CONF[2]_2                    10                            982.49                        2712.48                       True    No        False   False   
Via4136       BGA                            1      6     ERR[3]_2                       10                            1172.49                       2827.48                       True    No        False   False   
Via3246       POWERVIA                       1      6     GND                            24                            1112.49                       2777.48                       True    No        True    False   
Via3241       POWERVIA                       1      6     GND                            24                            885.49                        2830.48                       True    No        True    False   
Via3240       POWERVIA                       1      6     GND                            24                            822.49                        2777.48                       True    No        True    False   
Via3204       POWERVIA                       1      6     GND                            24                            973.49                        3077.48                       True    No        True    False   
Via3152       BGA                            1      6     GND                            10                            870.00                        2955.00                       True    No        True    False   
Via3151       BGA                            1      6     GND                            10                            880.00                        3075.00                       True    No        True    False   
Via2824       BGA                            1      6     +3V3                           10                            935.49                        2821.48                       True    No        True    False   
Via4470       BGA                            1      6     $$$23914                       10                            1562.49                       2832.48                       True    No        False   False   
Via4468       BGA                            1      6     $$$23913                       10                            1415.18                       2844.79                       True    No        False   False   
Via4196       BGA                            1      6     PHYAD_OFF_2                    10                            1262.49                       2827.48                       True    No        False   False   
Via3962       BGA                            1      6     $$$23915                       10                            1352.49                       2827.48                       True    No        False   False   
Via3798       BGA                            1      6     EBUS[8]-TX+                    10                            1592.84                       3072.91                       True    No        False   False   
Via3781       BGA                            1      6     EBUS[8]-TX-                    10                            1566.78                       3072.91                       True    No        False   False   
Via3674       BGA                            1      6     EBUS[8]-RX-                    10                            1485.00                       3076.00                       True    No        False   False   
Via3172       POWERVIA                       1      6     GND                            24                            1412.06                       3063.94                       True    No        True    False   
Via3167       NORMAL                         1      6     GND                            12                            1585.00                       2760.00                       True    No        True    False   
Via3114       POWERVIA                       1      6     GND                            24                            1283.49                       2767.48                       True    No        True    False   
Via3112       NORMAL                         1      6     GND                            12                            1490.00                       2795.00                       True    No        True    False   
Via3111       NORMAL                         1      6     GND                            12                            1575.00                       2800.00                       True    No        True    False   
Via3060       POWERVIA                       1      6     GND                            24                            1412.49                       2951.48                       True    No        True    False   
Via2879       POWERVIA                       1      6     +3V3                           24                            1492.49                       2735.18                       True    No        True    False   
Via4284       BGA                            1      6     P_CONF[1]_5                    10                            1859.00                       3042.00                       True    No        False   False   
Via4132       BGA                            1      6     P_CONF[3]_5                    10                            1924.00                       3031.00                       True    No        False   False   
Via3876       BGA                            1      6     LINKACT[1]/P_CONF[1]           10                            1900.49                       2946.48                       True    No        False   False   
Via2992       NORMAL                         1      6     GND                            12                            1650.00                       2755.00                       True    No        True    False   
Via4363       BGA                            1      6     LINKACT[0]/P_CONF[0]_6         10                            2284.00                       3043.00                       True    No        False   False   
Via4131       BGA                            1      6     P_CONF[3]_5                    10                            2117.00                       3008.00                       True    No        False   False   
Via3082       BGA1                           1      6     GND                            10                            2295.00                       2745.00                       True    No        True    False   
Via2812       BGA                            1      6     +3V3                           10                            2361.49                       2830.48                       True    No        True    False   
Via4294       BGA                            1      6     ERR[3]_5                       10                            2625.00                       2865.00                       True    No        False   False   
Via4286       BGA                            1      6     PHYAD_OFF_5                    10                            2714.49                       2853.08                       True    No        False   False   
Via4130       BGA                            1      6     P_CONF[3]_5                    10                            2534.49                       2853.48                       True    No        False   False   
Via4014       BGA                            1      6     EBUS[17]-TX+                   10                            2515.00                       3020.00                       True    No        False   False   
Via3852       BGA                            1      6     +2V5_CORE_5                    10                            2748.49                       2701.48                       True    No        True    False   
Via3772       BGA                            1      6     EBUS[17]-TX-                   10                            2550.00                       3025.00                       True    No        False   False   
Via3030       BGA                            1      6     GND                            10                            2725.00                       3030.00                       True    No        True    False   
Via3026       BGA                            1      6     GND                            10                            2580.00                       3080.00                       True    No        True    False   
Via4466       BGA                            1      6     $$$12359                       10                            3088.49                       2780.48                       True    No        False   False   
Via4464       BGA                            1      6     $$$12358                       10                            2965.49                       2749.48                       True    No        False   False   
Via4010       BGA                            1      6     $$$12360                       10                            2849.02                       2810.48                       True    No        False   False   
Via3218       POWERVIA                       1      6     GND                            24                            3057.49                       2910.48                       True    No        True    False   
Via3217       POWERVIA                       1      6     GND                            24                            3113.00                       2742.00                       True    No        True    False   
Via3201       POWERVIA                       1      6     GND                            24                            2909.49                       2930.48                       True    No        True    False   
Via3190       POWERVIA                       1      6     GND                            24                            2900.00                       3085.00                       True    No        True    False   
Via3097       POWERVIA                       1      6     GND                            24                            2969.49                       2910.48                       True    No        True    False   
Via2809       BGA                            1      6     +3V3                           10                            2921.49                       2789.48                       True    No        True    False   
Via4342       BGA                            1      6     RX_CLK[2]_6                    10                            3370.00                       3065.00                       True    No        False   False   
Via5920       BGA_18D8P                      1      6     GND                            8                             3795.00                       2710.00                       True    No        True    False   
Via4414       BGA                            1      6     ET1100(1)_TX-                  10                            4000.00                       2725.00                       True    No        False   False   
Via3766       BGA                            1      6     PHY1_2V5A_6                    10                            3929.49                       2924.48                       True    No        False   False   
Via3131       POWERVIA                       1      6     GND                            24                            4009.49                       3090.48                       True    No        True    False   
Via3066       POWERVIA                       1      6     GND                            24                            3649.49                       3090.48                       True    No        True    False   
Via3051       BGA                            1      6     GND                            10                            3945.00                       2850.00                       True    No        True    False   
Via4534       BGA                            1      6     APPDETECT2                     10                            4150.00                       2905.00                       True    No        False   False   
Via4507       BGA                            1      6     APP_SCL                        10                            4410.00                       2765.00                       True    No        False   False   
Via4412       BGA                            1      6     ET1100(1)_TX+                  10                            4090.00                       2725.00                       True    No        False   False   
Via3675       NORMAL                         1      6     $$$30374                       12                            4260.00                       2700.00                       True    No        False   False   
Via3189       POWERVIA                       1      6     GND                            24                            4279.49                       3080.48                       True    No        True    False   
Via3050       BGA_18D8P                      1      6     GND                            8                             4090.00                       2908.00                       True    No        True    False   
Via2801       BGA                            1      6     +3V3                           10                            4155.00                       2845.00                       True    No        True    False   
Via2783       POWERVIA                       1      6     +3V3                           24                            4266.00                       2969.00                       True    No        True    False   
Via4538       BGA                            1      6     $$$27611                       10                            395.00                        3160.00                       True    No        False   False   
Via4556       BGA1                           1      6     $$$27682                       10                            370.00                        3235.00                       True    No        False   False   
Via3956       NORMAL                         1      6     GND                            12                            805.00                        3200.00                       True    No        True    False   
Via3039       BGA                            1      6     GND                            10                            515.00                        3160.00                       True    No        True    False   
Via4540       BGA                            1      6     $$$27622                       10                            525.00                        3125.00                       True    No        False   False   
Via4541       BGA                            1      6     $$$27625                       10                            510.00                        3100.00                       True    No        False   False   
Via4535       BGA1                           1      6     $$$26954                       10                            430.00                        3415.00                       True    No        False   False   
Via4265       BGA                            1      6     P_CONF[1]_4                    10                            810.49                        3128.48                       True    No        False   False   
Via4215       BGA                            1      6     P_MODE[0]_3                    10                            765.00                        3360.00                       True    No        False   False   
Via3262       BGA                            1      6     GND                            10                            640.00                        3130.00                       True    No        True    False   
Via3121       POWERVIA                       1      6     GND                            24                            811.49                        3297.48                       True    No        True    False   
Via3040       BGA                            1      6     GND                            10                            518.49                        3198.24                       True    No        True    False   
Via3000       POWERVIA                       1      6     GND                            24                            632.49                        3357.48                       True    No        True    False   
Via2768       BGA                            1      6     +3V3                           10                            725.09                        3370.48                       True    No        True    False   
Via4405       BGA                            1      6     P_MODE[1]_3                    10                            1002.49                       3392.48                       True    No        False   False   
Via4241       BGA                            1      6     +2V5_CORE_3                    10                            1033.49                       3405.48                       True    No        True    False   
Via4208       BGA_18D8P                      1      6     C25_SHI[1]_3                   8                             1210.00                       3490.00                       True    No        False   False   
Via4083       BGA                            1      6     $$$23974                       10                            1130.00                       3160.00                       True    No        False   False   
Via4081       BGA                            1      6     $$$23973                       10                            1135.00                       3120.00                       True    No        False   False   
Via3980       BGA                            1      6     $$$23972                       10                            1100.00                       3145.00                       True    No        False   False   
Via3978       BGA                            1      6     $$$23971                       10                            1065.00                       3200.00                       True    No        False   False   
Via3976       BGA                            1      6     $$$23970                       10                            1180.00                       3260.00                       True    No        False   False   
Via3974       BGA                            1      6     $$$23969                       10                            1210.00                       3270.00                       True    No        False   False   
Via3737       BGA                            1      6     $$$24010                       10                            1185.00                       3160.00                       True    No        False   False   
Via3187       NORMAL                         1      6     GND                            12                            1065.00                       3265.00                       True    No        True    False   
Via3186       BGA                            1      6     GND                            10                            1180.00                       3215.00                       True    No        True    False   
Via3116       POWERVIA                       1      6     GND                            24                            942.49                        3278.48                       True    No        True    False   
Via2831       BGA                            1      6     +3V3                           10                            913.49                        3445.48                       True    No        True    False   
Via2767       BGA                            1      6     +3V3                           10                            947.49                        3230.08                       True    No        True    False   
Via4409       BGA                            1      6     RUN/EEPROM_SIZE_3              10                            1485.00                       3385.00                       True    No        False   False   
Via4209       BGA                            1      6     CLK_MODE[0]_3                  10                            1552.49                       3262.48                       True    No        False   False   
Via4085       BGA                            1      6     $$$24009                       10                            1262.02                       3172.48                       True    No        False   False   
Via3972       BGA                            1      6     $$$23968                       10                            1290.00                       3200.00                       True    No        False   False   
Via3970       BGA                            1      6     $$$23967                       10                            1322.49                       3167.48                       True    No        False   False   
Via3823       BGA                            1      6     C25_ENA_3                      10                            1407.49                       3122.48                       True    No        False   False   
Via3799       BGA_18D8P                      1      6     EBUS[8]-TX+                    8                             1360.00                       3480.00                       True    No        False   False   
Via3782       BGA_18D8P                      1      6     EBUS[8]-TX-                    8                             1328.50                       3480.00                       True    No        False   False   
Via3735       BGA                            1      6     C25_SHI[0]_3                   10                            1217.49                       3127.48                       True    No        False   False   
Via3734       BGA_18D8P                      1      6     $$$23965                       8                             1295.00                       3470.00                       True    No        False   False   
Via3733       BGA                            1      6     $$$23965                       10                            1355.00                       3270.00                       True    No        False   False   
Via3731       BGA                            1      6     $$$23966                       10                            1352.49                       3167.48                       True    No        False   False   
Via3671       BGA                            1      6     EBUS[8]-RX+                    10                            1485.00                       3107.00                       True    No        False   False   
Via3249       POWERVIA                       1      6     GND                            24                            1503.49                       3157.48                       True    No        True    False   
Via3185       BGA                            1      6     GND                            10                            1320.00                       3270.00                       True    No        True    False   
Via2830       BGA                            1      6     +3V3                           10                            1441.49                       3205.48                       True    No        True    False   
Via4211       BGA                            1      6     P_CONF[0]_3                    10                            1730.00                       3455.00                       True    No        False   False   
Via3820       BGA                            1      6     EBUS[14]-TX-                   10                            1900.00                       3485.00                       True    No        False   False   
Via3817       BGA                            1      6     EBUS[14]-TX+                   10                            1935.00                       3485.00                       True    No        False   False   
Via3205       POWERVIA                       1      6     GND                            24                            1822.49                       3237.48                       True    No        True    False   
Via3120       NORMAL                         1      6     GND                            12                            1685.00                       3445.00                       True    No        True    False   
Via2999       POWERVIA                       1      6     GND                            24                            1726.49                       3237.48                       True    No        True    False   
Via4372       BGA                            1      6     CLK_MODE[1]_6                  10                            2339.49                       3475.48                       True    No        False   False   
Via3197       POWERVIA                       1      6     GND                            24                            2282.09                       3450.48                       True    No        True    False   
Via2814       BGA                            1      6     +3V3                           10                            2350.49                       3340.48                       True    No        True    False   
Via2781       BGA1                           1      6     +3V3                           10                            2180.00                       3395.00                       True    No        True    False   
Via4371       BGA_18D8P                      1      6     P_MODE[1]_6                    8                             2540.51                       3496.50                       True    No        False   False   
Via4370       BGA                            1      6     P_MODE[1]_6                    10                            2580.00                       3155.00                       True    No        False   False   
Via4366       BGA                            1      6     TRANS-MODE-ENA_6               10                            2690.00                       3210.00                       True    No        False   False   
Via4334       BGA                            1      6     RX_ERR[2]_6                    10                            2775.00                       3265.00                       True    No        False   False   
Via4332       BGA                            1      6     TX_D(2)[2]/C25_SHI[0]_6        10                            2785.00                       3155.00                       True    No        False   False   
Via4330       BGA_18D8P                      1      6     TX_D(2)[3]/C25_SHI[1]_6        8                             2758.09                       3493.61                       True    No        False   False   
Via4328       BGA_18D8P                      1      6     TX_D(2)[1]_6                   8                             2792.48                       3496.50                       True    No        False   False   
Via4327       BGA                            1      6     TX_D(2)[1]_6                   10                            2785.00                       3190.00                       True    No        False   False   
Via4322       BGA                            1      6     TX_ENA[2]_6                    10                            2785.00                       3225.00                       True    No        False   False   
Via4022       BGA_18D8P                      1      6     EBUS[17]-RX+                   8                             2603.51                       3496.50                       True    No        False   False   
Via4020       BGA                            1      6     EBUS[17]-RX+                   10                            2540.00                       3115.00                       True    No        False   False   
Via4019       BGA_18D8P                      1      6     EBUS[17]-RX-                   8                             2572.01                       3496.50                       True    No        False   False   
Via4017       BGA                            1      6     EBUS[17]-RX-                   10                            2500.00                       3115.00                       True    No        False   False   
Via4016       BGA_18D8P                      1      6     EBUS[17]-TX+                   8                             2666.50                       3496.50                       True    No        False   False   
Via3774       BGA_18D8P                      1      6     EBUS[17]-TX-                   8                             2635.00                       3496.50                       True    No        False   False   
Via3702       BGA_18D8P                      1      6     +2V5_CORE_6                    8                             2749.49                       3461.48                       True    No        True    False   
Via3425       BGA_18D8P                      1      6     GND                            8                             2697.99                       3496.50                       True    No        True    False   
Via3225       POWERVIA                       1      6     GND                            24                            2509.49                       3430.48                       True    No        True    False   
Via2815       BGA                            1      6     +3V3                           10                            2605.00                       3235.00                       True    No        True    False   
Via4417       BGA                            1      6     CLK_MODE[0]_6                  10                            3057.84                       3404.34                       True    No        False   False   
Via4388       BGA                            1      6     MI_DATA_6                      10                            3018.47                       3483.08                       True    No        False   False   
Via4386       BGA                            1      6     MI_DATA_6                      10                            3111.49                       3111.48                       True    No        False   False   
Via4356       BGA                            1      6     RX_D(2)[3]_6                   10                            2886.49                       3298.98                       True    No        False   False   
Via4352       BGA                            1      6     RX_D(2)[2]_6                   10                            2935.00                       3370.00                       True    No        False   False   
Via4351       BGA_18D8P                      1      6     RX_D(2)[1]_6                   8                             2918.00                       3496.00                       True    No        False   False   
Via4350       BGA                            1      6     RX_D(2)[1]_6                   10                            2955.00                       3226.00                       True    No        False   False   
Via4347       BGA                            1      6     RX_D(2)[1]_6                   10                            2950.00                       3335.00                       True    No        False   False   
Via4345       BGA                            1      6     RX_D(2)[0]_6                   10                            3113.00                       3236.00                       True    No        False   False   
Via4340       BGA_18D8P                      1      6     RX_DV[2]_6                     8                             2886.00                       3495.00                       True    No        False   False   
Via4337       BGA                            1      6     RX_DV[2]_6                     10                            2819.65                       3234.48                       True    No        False   False   
Via4336       BGA_18D8P                      1      6     RX_ERR[2]_6                    8                             2855.47                       3496.50                       True    No        False   False   
Via4323       BGA_18D8P                      1      6     TX_ENA[2]_6                    8                             2823.98                       3496.50                       True    No        False   False   
Via4303       BGA                            1      6     PHY0_AD0_6                     10                            2985.00                       3325.00                       True    No        False   False   
Via4301       BGA                            1      6     CRS2_6                         10                            2850.00                       3215.00                       True    No        False   False   
Via4299       BGA                            1      6     COL2_6                         10                            2875.00                       3230.00                       True    No        False   False   
Via3704       BGA                            1      6     +2V5_CORE_6                    10                            2910.49                       3411.48                       True    No        True    False   
Via3701       BGA                            1      6     +2V5_CORE_6                    10                            2988.49                       3208.48                       True    No        True    False   
Via3102       POWERVIA                       1      6     GND                            24                            3041.00                       3190.00                       True    No        True    False   
Via2868       POWERVIA                       1      6     +3V3                           24                            3186.89                       3120.48                       True    No        True    False   
Via2848       BGA_18D8P                      1      6     +3V3                           8                             3001.00                       3297.00                       True    No        True    False   
Via4383       BGA                            1      6     MI_CLK/LINKPOL_6               10                            3321.62                       3306.72                       True    No        False   False   
Via4377       BGA                            1      6     CLK25OUT1_6                    10                            3416.49                       3299.48                       True    No        False   False   
Via4357       BGA                            1      6     RX_D(2)[3]_6                   10                            3361.49                       3175.48                       True    No        False   False   
Via4353       BGA                            1      6     RX_D(2)[2]_6                   10                            3393.49                       3217.48                       True    No        False   False   
Via4349       BGA                            1      6     RX_D(2)[1]_6                   10                            3367.49                       3198.95                       True    No        False   False   
Via4338       BGA                            1      6     RX_DV[2]_6                     10                            3364.49                       3099.48                       True    No        False   False   
Via3768       BGA                            1      6     PHY1_2V5A_6                    10                            3570.49                       3431.48                       True    No        False   False   
Via3198       BGA                            1      6     GND                            10                            3232.00                       3489.00                       True    No        True    False   
Via3192       BGA                            1      6     GND                            10                            3229.00                       3370.00                       True    No        True    False   
Via3191       POWERVIA                       1      6     GND                            24                            3279.49                       3280.48                       True    No        True    False   
Via3136       POWERVIA                       1      6     GND                            24                            3449.49                       3140.48                       True    No        True    False   
Via3135       POWERVIA                       1      6     GND                            24                            3459.49                       3470.48                       True    No        True    False   
Via3071       POWERVIA                       1      6     GND                            24                            3369.49                       3309.48                       True    No        True    False   
Via3021       POWERVIA                       1      6     GND                            24                            3439.49                       3360.48                       True    No        True    False   
Via4394       BGA                            1      6     #RESET_6                       10                            3654.49                       3293.71                       True    No        False   False   
Via4387       BGA                            1      6     MI_DATA_6                      10                            3739.49                       3236.63                       True    No        False   False   
Via4384       BGA                            1      6     MI_CLK/LINKPOL_6               10                            3790.91                       3290.48                       True    No        False   False   
Via4376       BGA                            1      6     CLK25OUT1_6                    10                            3764.49                       3333.08                       True    No        False   False   
Via4358       BGA                            1      6     RX_D(2)[3]_6                   10                            3810.59                       3175.48                       True    No        False   False   
Via4354       BGA                            1      6     RX_D(2)[2]_6                   10                            3830.28                       3285.48                       True    No        False   False   
Via4348       BGA                            1      6     RX_D(2)[1]_6                   10                            3849.96                       3170.48                       True    No        False   False   
Via4344       BGA                            1      6     RX_D(2)[0]_6                   10                            3869.65                       3290.48                       True    No        False   False   
Via4341       BGA                            1      6     RX_CLK[2]_6                    10                            3948.39                       3175.48                       True    No        False   False   
Via4339       BGA                            1      6     RX_DV[2]_6                     10                            3928.49                       3150.48                       True    No        False   False   
Via4335       BGA                            1      6     RX_ERR[2]_6                    10                            3965.00                       3295.00                       True    No        False   False   
Via4331       BGA                            1      6     TX_D(2)[2]/C25_SHI[0]_6        10                            3984.00                       3432.00                       True    No        False   False   
Via4326       BGA                            1      6     TX_D(2)[1]_6                   10                            3984.49                       3392.14                       True    No        False   False   
Via4324       BGA                            1      6     TX_D(2)[0]/C25_ENA_6           10                            3941.49                       3373.48                       True    No        False   False   
Via4321       BGA                            1      6     TX_ENA[2]_6                    10                            3984.49                       3352.77                       True    No        False   False   
Via4300       BGA                            1      6     CRS2_6                         10                            3943.00                       3424.00                       True    No        False   False   
Via3769       BGA                            1      6     PHY1_2V5A_6                    10                            3657.49                       3490.56                       True    No        False   False   
Via3758       BGA                            1      6     PHY1_TX-                       10                            3870.00                       3455.00                       True    No        False   False   
Via3756       BGA                            1      6     PHY1_TX+                       10                            3870.00                       3425.00                       True    No        False   False   
Via3017       POWERVIA                       1      6     GND                            24                            3643.00                       3373.00                       True    No        True    False   
Via3016       POWERVIA                       1      6     GND                            24                            3779.49                       3392.14                       True    No        True    False   
Via3015       BGA1                           1      6     GND                            10                            3775.00                       3471.00                       True    No        True    False   
Via3011       POWERVIA                       1      6     GND                            24                            3987.76                       3170.48                       True    No        True    False   
Via3010       POWERVIA                       1      6     GND                            24                            3905.00                       3309.00                       True    No        True    False   
Via2852       POWERVIA                       1      6     +3V3                           24                            3889.33                       3160.48                       True    No        True    False   
Via4329       BGA                            1      6     TX_D(2)[3]/C25_SHI[1]_6        10                            4137.00                       3387.00                       True    No        False   False   
Via4307       BGA                            1      6     PHY1_2V5_6                     10                            4347.49                       3237.48                       True    No        False   False   
Via4298       BGA                            1      6     COL2_6                         10                            4134.00                       3427.00                       True    No        False   False   
Via3133       POWERVIA                       1      6     GND                            24                            4139.49                       3180.48                       True    No        True    False   
Via3028       POWERVIA                       1      6     GND                            24                            4329.49                       3335.48                       True    No        True    False   
Via3027       POWERVIA                       1      6     GND                            24                            4329.49                       3430.48                       True    No        True    False   
Via3757       BGA1                           1      6     PHY1_TX-                       10                            4454.00                       3384.00                       True    No        False   False   
Via3755       BGA1                           1      6     PHY1_TX+                       10                            4427.00                       3384.00                       True    No        False   False   
Via4583       BGA1                           1      6     $$$7076                        10                            640.00                        3770.00                       True    No        False   False   
Via4224       BGA                            1      6     CTRL_STATUS_MOVE_3             10                            657.49                        3701.46                       True    No        False   False   
Via4213       BGA                            1      6     TRANS-MODE-ENA_3               10                            762.49                        3567.48                       True    No        False   False   
Via3667       BGA                            1      6     P_CONF[2]_3                    10                            722.49                        3794.49                       True    No        False   False   
Via3080       BGA1                           1      6     GND                            10                            530.00                        3625.00                       True    No        True    False   
Via2998       POWERVIA                       1      6     GND                            24                            635.49                        3566.48                       True    No        True    False   
Via2788       BGA1                           1      6     +3V3                           10                            505.00                        3515.00                       True    No        True    False   
Via2773       BGA                            1      6     +3V3                           10                            647.49                        3664.48                       True    No        True    False   
Via4584       BGA_18D8P                      1      6     $$$7076                        8                             1030.00                       3750.00                       True    No        False   False   
Via4446       BGA_18D8P                      1      6     EBUS[10]-TX-                   8                             1030.01                       3498.50                       True    No        False   False   
Via4424       BGA_18D8P                      1      6     EBUS[12]-TX+                   8                             1030.01                       3876.46                       True    No        False   False   
Via4422       BGA_18D8P                      1      6     EBUS[10]-TX+                   8                             1061.51                       3498.50                       True    No        False   False   
Via4406       BGA_18D8P                      1      6     P_MODE[1]_3                    8                             1002.49                       3498.50                       True    No        False   False   
Via4247       BGA_18D8P                      1      6     +2V5_CORE_3                    8                             1155.99                       3813.46                       True    No        True    False   
Via4244       BGA_18D8P                      1      6     +2V5_CORE_3                    8                             1155.99                       3561.50                       True    No        True    False   
Via4237       BGA_18D8P                      1      6     +2V5_CORE_3                    8                             1191.49                       3893.48                       True    No        True    False   
Via4236       BGA_18D8P                      1      6     ERR[3]_3                       8                             1030.01                       3844.96                       True    No        False   False   
Via4234       BGA_18D8P                      1      6     P_CONF[3]_3                    8                             1030.49                       3812.98                       True    No        False   False   
Via4227       BGA_18D8P                      1      6     PHYAD_OFF_3                    8                             1061.51                       3813.46                       True    No        False   False   
Via4225       BGA_18D8P                      1      6     CTRL_STATUS_MOVE_3             8                             1030.01                       3718.98                       True    No        False   False   
Via4220       BGA_18D8P                      1      6     P_CONF[1]_3                    8                             999.99                        3531.48                       True    No        False   False   
Via4218       BGA_18D8P                      1      6     CLK_MODE[1]_3                  8                             1030.01                       3561.50                       True    No        False   False   
Via4216       BGA_18D8P                      1      6     P_MODE[0]_3                    8                             1030.01                       3530.00                       True    No        False   False   
Via4214       BGA_18D8P                      1      6     TRANS-MODE-ENA_3               8                             1061.51                       3530.00                       True    No        False   False   
Via4105       BGA_18D8P                      1      6     EBUS[12]-RX+                   8                             998.51                        3844.96                       True    No        False   False   
Via4103       BGA_18D8P                      1      6     EBUS[12]-RX-                   8                             998.51                        3876.46                       True    No        False   False   
Via4100       BGA_18D8P                      1      6     EBUS[11]-RX+                   8                             998.51                        3592.99                       True    No        False   False   
Via4098       BGA_18D8P                      1      6     EBUS[11]-TX-                   8                             998.51                        3750.47                       True    No        False   False   
Via4095       BGA_18D8P                      1      6     EBUS[11]-TX+                   8                             998.51                        3718.98                       True    No        False   False   
Via4092       BGA_18D8P                      1      6     EBUS[10]-RX+                   8                             1124.50                       3498.50                       True    No        False   False   
Via4091       BGA_18D8P                      1      6     EBUS[10]-RX-                   8                             1093.00                       3498.50                       True    No        False   False   
Via4084       BGA_18D8P                      1      6     $$$23974                       8                             1155.99                       3498.50                       True    No        False   False   
Via4082       BGA_18D8P                      1      6     $$$23973                       8                             1061.51                       3561.50                       True    No        False   False   
Via3981       BGA_18D8P                      1      6     $$$23972                       8                             1124.50                       3530.00                       True    No        False   False   
Via3979       BGA_18D8P                      1      6     $$$23971                       8                             1093.00                       3530.00                       True    No        False   False   
Via3977       BGA_18D8P                      1      6     $$$23970                       8                             1093.00                       3561.50                       True    No        False   False   
Via3975       BGA_18D8P                      1      6     $$$23969                       8                             1155.99                       3530.00                       True    No        False   False   
Via3965       BGA_18D8P                      1      6     $$$23964                       8                             1093.00                       3813.46                       True    No        False   False   
Via3787       BGA_18D8P                      1      6     EBUS[12]-TX-                   8                             1061.51                       3876.46                       True    No        False   False   
Via3729       BGA_18D8P                      1      6     EBUS[11]-RX-                   8                             998.51                        3624.49                       True    No        False   False   
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
Via2882       POWERVIA                       1      6     +3V3                           24                            877.49                        3757.48                       True    No        True    False   
Via2771       BGA_18D8P                      1      6     +3V3                           8                             1124.49                       3813.48                       True    No        True    False   
Via2770       BGA_18D8P                      1      6     +3V3                           8                             1061.49                       3781.98                       True    No        True    False   
Via2769       BGA_18D8P                      1      6     +3V3                           8                             960.00                        3580.00                       True    No        True    False   
Via4573       BGA_18D8P                      1      6     $$$6504                        8                             1375.00                       3625.00                       True    No        False   False   
Via4475       BGA_18D8P                      1      6     $$$23963                       8                             1376.47                       3750.47                       True    No        False   False   
Via4473       BGA_18D8P                      1      6     $$$23962                       8                             1344.97                       3750.47                       True    No        False   False   
Via4410       BGA_18D8P                      1      6     RUN/EEPROM_SIZE_3              8                             1344.97                       3624.49                       True    No        False   False   
Via4404       BGA_18D8P                      1      6     EEPROM_DATA_3                  8                             1344.97                       3718.98                       True    No        False   False   
Via4403       BGA_18D8P                      1      6     EEPROM_CLK_3                   8                             1344.97                       3655.98                       True    No        False   False   
Via4402       BGA_18D8P                      1      6     EEPROM_CLK_3                   8                             1437.49                       3687.48                       True    No        False   False   
Via4246       BGA_18D8P                      1      6     +2V5_CORE_3                    8                             1218.99                       3813.46                       True    No        True    False   
Via4245       BGA_18D8P                      1      6     +2V5_CORE_3                    8                             1313.47                       3655.98                       True    No        True    False   
Via4243       BGA_18D8P                      1      6     +2V5_CORE_3                    8                             1218.99                       3562.35                       True    No        True    False   
Via4242       BGA_18D8P                      1      6     +2V5_CORE_3                    8                             1223.49                       3682.48                       True    No        True    False   
Via4240       BGA_18D8P                      1      6     +2V5_CORE_3                    8                             1405.00                       3635.00                       True    No        True    False   
Via4231       BGA_18D8P                      1      6     OSC_OUT_3                      8                             1376.47                       3718.98                       True    No        False   False   
Via4229       BGA_18D8P                      1      6     OSC_IN_3                       8                             1376.47                       3655.98                       True    No        False   False   
Via4228       BGA                            1      6     OSC_IN_3                       10                            1495.00                       3600.00                       True    No        False   False   
Via4212       BGA_18D8P                      1      6     P_CONF[0]_3                    8                             1376.47                       3592.99                       True    No        False   False   
Via4210       BGA_18D8P                      1      6     CLK_MODE[0]_3                  8                             1344.97                       3592.99                       True    No        False   False   
Via4086       BGA_18D8P                      1      6     $$$24009                       8                             1376.47                       3530.00                       True    No        False   False   
Via3973       BGA_18D8P                      1      6     $$$23968                       8                             1313.47                       3561.50                       True    No        False   False   
Via3971       BGA_18D8P                      1      6     $$$23967                       8                             1313.47                       3530.00                       True    No        False   False   
Via3824       BGA_18D8P                      1      6     C25_ENA_3                      8                             1249.00                       3530.00                       True    No        False   False   
Via3738       BGA_18D8P                      1      6     $$$24010                       8                             1281.98                       3530.00                       True    No        False   False   
Via3736       BGA_18D8P                      1      6     C25_SHI[0]_3                   8                             1219.00                       3530.00                       True    No        False   False   
Via3732       BGA_18D8P                      1      6     $$$23966                       8                             1344.97                       3530.00                       True    No        False   False   
Via3673       BGA_18D8P                      1      6     EBUS[8]-RX-                    8                             1251.50                       3499.00                       True    No        False   False   
Via3670       BGA_18D8P                      1      6     EBUS[8]-RX+                    8                             1283.00                       3499.00                       True    No        False   False   
Via3545       BGA_18D8P                      1      6     GND                            8                             1218.99                       3876.46                       True    No        True    False   
Via3544       BGA_18D8P                      1      6     GND                            8                             1250.48                       3876.46                       True    No        True    False   
Via3543       BGA_18D8P                      1      6     GND                            8                             1281.98                       3876.46                       True    No        True    False   
Via3542       BGA_18D8P                      1      6     GND                            8                             1313.47                       3876.46                       True    No        True    False   
Via3541       BGA_18D8P                      1      6     GND                            8                             1344.97                       3876.46                       True    No        True    False   
Via3540       BGA_18D8P                      1      6     GND                            8                             1376.47                       3876.46                       True    No        True    False   
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
Via3496       BGA_18D8P                      1      6     GND                            8                             1218.99                       3592.99                       True    No        True    False   
Via3495       BGA_18D8P                      1      6     GND                            8                             1250.48                       3592.99                       True    No        True    False   
Via3494       BGA_18D8P                      1      6     GND                            8                             1281.98                       3592.99                       True    No        True    False   
Via3492       BGA_18D8P                      1      6     GND                            8                             1281.98                       3561.50                       True    No        True    False   
Via3259       NORMAL                         1      6     GND                            12                            1482.49                       3646.48                       True    No        True    False   
Via3248       POWERVIA                       1      6     GND                            24                            1482.49                       3881.28                       True    No        True    False   
Via2948       BGA_18D8P                      1      6     +3V3                           8                             1312.49                       3781.48                       True    No        True    False   
Via2947       BGA_18D8P                      1      6     +3V3                           8                             1283.49                       3751.98                       True    No        True    False   
Via2945       BGA_18D8P                      1      6     +3V3                           8                             1312.49                       3718.48                       True    No        True    False   
Via2944       BGA_18D8P                      1      6     +3V3                           8                             1283.49                       3622.98                       True    No        True    False   
Via2942       BGA_18D8P                      1      6     +3V3                           8                             1314.00                       3593.00                       True    No        True    False   
Via2940       BGA_18D8P                      1      6     +3V3                           8                             1250.00                       3561.00                       True    No        True    False   
Via2884       POWERVIA                       1      6     +3V3                           24                            1477.49                       3497.48                       True    No        True    False   
Via2880       POWERVIA                       1      6     +3V3                           24                            1482.49                       3819.28                       True    No        True    False   
Via4572       BGA1                           1      6     $$$6504                        10                            1870.00                       3585.00                       True    No        False   False   
Via4230       BGA                            1      6     OSC_OUT_3                      10                            1673.99                       3667.48                       True    No        False   False   
Via3251       NORMAL                         1      6     GND                            12                            1675.00                       3535.00                       True    No        True    False   
Via3200       BGA1                           1      6     GND                            10                            1705.00                       3660.00                       True    No        True    False   
Via3153       POWERVIA                       1      6     GND                            24                            1812.49                       3617.48                       True    No        True    False   
Via3144       POWERVIA                       1      6     GND                            24                            1782.49                       3827.48                       True    No        True    False   
Via2841       BGA                            1      6     +3V3                           10                            1782.49                       3671.48                       True    No        True    False   
Via2772       BGA                            1      6     +3V3                           10                            1677.49                       3820.08                       True    No        True    False   
Via4589       BGA1                           1      6     $$$7139                        10                            2260.00                       3690.00                       True    No        False   False   
Via4374       BGA1                           1      6     P_CONF[1]_6                    10                            2180.00                       3565.00                       True    No        False   False   
Via4368       BGA                            1      6     P_MODE[0]_6                    10                            2309.49                       3595.48                       True    No        False   False   
Via3224       POWERVIA                       1      6     GND                            24                            2193.49                       3833.48                       True    No        True    False   
Via3098       POWERVIA                       1      6     GND                            24                            2294.49                       3649.68                       True    No        True    False   
Via3083       BGA1                           1      6     GND                            10                            2190.00                       3605.00                       True    No        True    False   
Via2865       BGA                            1      6     +3V3                           10                            2287.49                       3718.88                       True    No        True    False   
Via4590       BGA_18D8P                      1      6     $$$7139                        8                             2575.00                       3745.00                       True    No        False   False   
Via4436       BGA_18D8P                      1      6     EBUS[19]-TX-                   8                             2540.51                       3748.47                       True    No        False   False   
Via4420       BGA_18D8P                      1      6     EBUS[19]-TX+                   8                             2540.51                       3716.98                       True    No        False   False   
Via4382       BGA_18D8P                      1      6     LINKACT[2]/P_CONF[2]_6         8                             2605.50                       3746.48                       True    No        False   False   
Via4380       BGA_18D8P                      1      6     PHYAD_OFF_6                    8                             2603.51                       3811.46                       True    No        False   False   
Via4378       BGA_18D8P                      1      6     CLK25OUT1_6                    8                             2572.01                       3716.98                       True    No        False   False   
Via4375       BGA_18D8P                      1      6     P_CONF[1]_6                    8                             2540.51                       3528.00                       True    No        False   False   
Via4373       BGA_18D8P                      1      6     CLK_MODE[1]_6                  8                             2572.01                       3559.50                       True    No        False   False   
Via4369       BGA_18D8P                      1      6     P_MODE[0]_6                    8                             2572.01                       3528.00                       True    No        False   False   
Via4367       BGA_18D8P                      1      6     TRANS-MODE-ENA_6               8                             2603.51                       3528.00                       True    No        False   False   
Via4333       BGA_18D8P                      1      6     TX_D(2)[2]/C25_SHI[0]_6        8                             2760.99                       3526.72                       True    No        False   False   
Via4325       BGA_18D8P                      1      6     TX_D(2)[0]/C25_ENA_6           8                             2792.48                       3526.39                       True    No        False   False   
Via4289       BGA_18D8P                      1      6     ERR[3]_6                       8                             2572.01                       3842.96                       True    No        False   False   
Via4024       BGA_18D8P                      1      6     $$$12260                       8                             2635.00                       3811.46                       True    No        False   False   
Via3959       BGA_18D8P                      1      6     P_CONF[3]_6                    8                             2573.49                       3809.98                       True    No        False   False   
Via3785       BGA_18D8P                      1      6     EBUS[19]-RX-                   8                             2542.00                       3624.00                       True    No        False   False   
Via3784       BGA_18D8P                      1      6     EBUS[19]-RX+                   8                             2540.51                       3590.99                       True    No        False   False   
Via3710       BGA_18D8P                      1      6     +2V5_CORE_6                    8                             2697.99                       3811.46                       True    No        True    False   
Via3709       BGA_18D8P                      1      6     +2V5_CORE_6                    8                             2760.99                       3811.46                       True    No        True    False   
Via3707       BGA_18D8P                      1      6     +2V5_CORE_6                    8                             2697.99                       3559.50                       True    No        True    False   
Via3706       BGA_18D8P                      1      6     +2V5_CORE_6                    8                             2762.00                       3560.00                       True    No        True    False   
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
Via2935       BGA_18D8P                      1      6     +3V3                           8                             2605.00                       3715.48                       True    No        True    False   
Via2932       BGA_18D8P                      1      6     +3V3                           8                             2604.49                       3592.48                       True    No        True    False   
Via2930       BGA_18D8P                      1      6     +3V3                           8                             2666.49                       3559.49                       True    No        True    False   
Via2929       BGA_18D8P                      1      6     +3V3                           8                             2792.49                       3559.49                       True    No        True    False   
Via2867       POWERVIA                       1      6     +3V3                           24                            2428.00                       3589.00                       True    No        True    False   
Via2866       POWERVIA                       1      6     +3V3                           24                            2424.49                       3745.48                       True    No        True    False   
Via2851       BGA_18D8P                      1      6     +3V3                           8                             2500.49                       3839.48                       True    No        True    False   
Via5091       BGA                            1      6     +3V3                           10                            3000.00                       3780.00                       True    No        True    False   
Via4592       BGA_18D8P                      1      6     RUN/EEPROM_SIZE_6              8                             2886.00                       3624.00                       True    No        False   False   
Via4591       BGA1                           1      6     RUN/EEPROM_SIZE_6              10                            3092.00                       3512.00                       True    No        False   False   
Via4487       BGA_18D8P                      1      6     $$$28258                       8                             2918.47                       3748.47                       True    No        False   False   
Via4485       BGA_18D8P                      1      6     $$$28255                       8                             2886.97                       3748.47                       True    No        False   False   
Via4418       BGA_18D8P                      1      6     CLK_MODE[0]_6                  8                             2886.97                       3590.99                       True    No        False   False   
Via4399       BGA_18D8P                      1      6     EEPROM_CLK_6                   8                             2886.97                       3653.98                       True    No        False   False   
Via4398       BGA_18D8P                      1      6     EEPROM_CLK_6                   8                             2962.00                       3668.00                       True    No        False   False   
Via4397       BGA_18D8P                      1      6     EEPROM_DATA_6                  8                             2886.97                       3716.98                       True    No        False   False   
Via4396       BGA_18D8P                      1      6     #RESET_6                       8                             2918.47                       3622.49                       True    No        False   False   
Via4393       BGA_18D8P                      1      6     OSC_OUT_6                      8                             2918.47                       3716.98                       True    No        False   False   
Via4391       BGA_18D8P                      1      6     OSC_IN_6                       8                             2918.47                       3653.98                       True    No        False   False   
Via4390       BGA                            1      6     OSC_IN_6                       10                            3112.09                       3600.48                       True    No        False   False   
Via4389       BGA_18D8P                      1      6     MI_DATA_6                      8                             2918.47                       3559.50                       True    No        False   False   
Via4385       BGA_18D8P                      1      6     MI_CLK/LINKPOL_6               8                             2886.97                       3559.50                       True    No        False   False   
Via4365       BGA_18D8P                      1      6     LINKACT[0]/P_CONF[0]_6         8                             2918.47                       3590.99                       True    No        False   False   
Via4361       BGA_18D8P                      1      6     LINK_MII[2]_6                  8                             2823.98                       3526.26                       True    No        False   False   
Via4359       BGA_18D8P                      1      6     RX_D(2)[3]_6                   8                             2918.47                       3528.00                       True    No        False   False   
Via4355       BGA_18D8P                      1      6     RX_D(2)[2]_6                   8                             2886.97                       3528.00                       True    No        False   False   
Via4346       BGA_18D8P                      1      6     RX_D(2)[0]_6                   8                             2857.21                       3559.50                       True    No        False   False   
Via4343       BGA_18D8P                      1      6     RX_CLK[2]_6                    8                             2855.47                       3528.00                       True    No        False   False   
Via3708       BGA_18D8P                      1      6     +2V5_CORE_6                    8                             2855.47                       3653.98                       True    No        True    False   
Via3699       BGA                            1      6     +2V5_CORE_6                    10                            3049.49                       3787.48                       True    No        True    False   
Via3483       BGA_18D8P                      1      6     GND                            8                             2823.98                       3874.46                       True    No        True    False   
Via3482       BGA_18D8P                      1      6     GND                            8                             2855.47                       3874.46                       True    No        True    False   
Via3481       BGA_18D8P                      1      6     GND                            8                             2886.97                       3874.46                       True    No        True    False   
Via3480       BGA_18D8P                      1      6     GND                            8                             2918.47                       3874.46                       True    No        True    False   
Via3472       BGA_18D8P                      1      6     GND                            8                             2823.98                       3842.96                       True    No        True    False   
Via3471       BGA_18D8P                      1      6     GND                            8                             2855.47                       3842.96                       True    No        True    False   
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
Via2936       BGA_18D8P                      1      6     +3V3                           8                             2823.49                       3747.98                       True    No        True    False   
Via2934       BGA_18D8P                      1      6     +3V3                           8                             2854.49                       3715.99                       True    No        True    False   
Via2933       BGA_18D8P                      1      6     +3V3                           8                             2823.49                       3622.98                       True    No        True    False   
Via2931       BGA_18D8P                      1      6     +3V3                           8                             2852.00                       3593.00                       True    No        True    False   
Via2792       BGA                            1      6     +3V3                           10                            3210.49                       3895.48                       True    No        True    False   
Via2765       BGA                            1      6     +3V3                           10                            2988.49                       3604.48                       True    No        True    False   
Via4392       BGA                            1      6     OSC_OUT_6                      10                            3230.99                       3695.48                       True    No        False   False   
Via4364       BGA                            1      6     LINKACT[0]/P_CONF[0]_6         10                            3255.00                       3540.00                       True    No        False   False   
Via3767       BGA                            1      6     PHY1_2V5A_6                    10                            3570.49                       3637.48                       True    No        False   False   
Via3156       POWERVIA                       1      6     GND                            24                            3369.49                       3650.48                       True    No        True    False   
Via3147       POWERVIA                       1      6     GND                            24                            3339.49                       3870.48                       True    No        True    False   
Via3134       POWERVIA                       1      6     GND                            24                            3459.49                       3570.48                       True    No        True    False   
Via3099       BGA                            1      6     GND                            10                            3228.00                       3575.00                       True    No        True    False   
Via3024       POWERVIA                       1      6     GND                            24                            3224.49                       3825.48                       True    No        True    False   
Via2843       POWERVIA                       1      6     +3V3                           24                            3394.49                       3749.48                       True    No        True    False   
Via4395       BGA                            1      6     #RESET_6                       10                            3720.49                       3561.48                       True    No        False   False   
Via4360       BGA                            1      6     LINK_MII[2]_6                  10                            3968.07                       3625.48                       True    No        False   False   
Via4302       BGA                            1      6     PHY0_AD0_6                     10                            3987.76                       3510.48                       True    No        False   False   
Via3765       BGA                            1      6     PHY1_2V5A_6                    10                            3822.49                       3729.48                       True    No        False   False   
Via3137       POWERVIA                       1      6     GND                            24                            3859.49                       3866.44                       True    No        True    False   
Via3084       BGA1                           1      6     GND                            10                            3705.00                       3850.00                       True    No        True    False   
Via3014       BGA1                           1      6     GND                            10                            3771.00                       3514.00                       True    No        True    False   
Via3013       NORMAL                         1      6     GND                            12                            3780.00                       3630.00                       True    No        True    False   
Via2780       POWERVIA                       1      6     +3V3                           24                            3949.49                       3871.48                       True    No        True    False   
Via4435       BGA                            1      6     EBUS[19]-TX-                   10                            4375.00                       3615.00                       True    No        False   False   
Via4419       BGA                            1      6     EBUS[19]-TX+                   10                            4410.00                       3615.00                       True    No        False   False   
Via3132       POWERVIA                       1      6     GND                            24                            4257.49                       3700.48                       True    No        True    False   
Via3020       POWERVIA                       1      6     GND                            24                            4329.49                       3540.48                       True    No        True    False   
Via3012       POWERVIA                       1      6     GND                            24                            4113.00                       3513.00                       True    No        True    False   
Via2839       POWERVIA                       1      6     +3V3                           24                            4139.49                       3638.48                       True    No        True    False   
Via2779       POWERVIA                       1      6     +3V3                           24                            4112.00                       3565.00                       True    No        True    False   
Via2777       POWERVIA                       1      6     +3V3                           24                            4044.84                       3545.48                       True    No        True    False   
Via4239       BGA_18D8P                      1      6     +2V5_CORE_3                    8                             1143.49                       3901.48                       True    No        True    False   
Via4238       BGA                            1      6     +2V5_CORE_3                    10                            1191.49                       4077.48                       True    No        True    False   
Via4235       BGA                            1      6     ERR[3]_3                       10                            1162.49                       4092.48                       True    No        False   False   
Via4233       BGA                            1      6     P_CONF[3]_3                    10                            981.49                        4098.48                       True    No        False   False   
Via4217       BGA                            1      6     CLK_MODE[1]_3                  10                            847.49                        3967.48                       True    No        False   False   
Via3250       POWERVIA                       1      6     GND                            24                            851.49                        4157.48                       True    No        True    False   
Via2832       BGA                            1      6     +3V3                           10                            960.49                        4007.48                       True    No        True    False   
Via4474       BGA                            1      6     $$$23963                       10                            1605.00                       4025.00                       True    No        False   False   
Via4472       BGA                            1      6     $$$23962                       10                            1482.49                       4142.48                       True    No        False   False   
Via4226       BGA                            1      6     PHYAD_OFF_3                    10                            1252.49                       4097.48                       True    No        False   False   
Via3964       BGA                            1      6     $$$23964                       10                            1342.49                       4092.48                       True    No        False   False   
Via3247       POWERVIA                       1      6     GND                            24                            1302.49                       4037.48                       True    No        True    False   
Via3119       POWERVIA                       1      6     GND                            24                            1529.09                       4097.48                       True    No        True    False   
Via3117       POWERVIA                       1      6     GND                            24                            1439.09                       4097.48                       True    No        True    False   
Via3063       POWERVIA                       1      6     GND                            24                            1412.49                       4214.88                       True    No        True    False   
Via2881       POWERVIA                       1      6     +3V3                           24                            1487.49                       3979.28                       True    No        True    False   
Via4362       BGA                            1      6     LINKACT[0]/P_CONF[0]_6         10                            1873.00                       4294.00                       True    No        False   False   
Via4381       BGA                            1      6     LINKACT[2]/P_CONF[2]_6         10                            2222.49                       3907.88                       True    No        False   False   
Via3223       POWERVIA                       1      6     GND                            24                            2330.49                       3960.48                       True    No        True    False   
Via2890       BGA                            1      6     +3V3                           10                            2348.49                       4090.48                       True    No        True    False   
Via4379       BGA                            1      6     PHYAD_OFF_6                    10                            2779.49                       4135.48                       True    No        False   False   
Via4288       BGA                            1      6     ERR[3]_6                       10                            2689.49                       4135.48                       True    No        False   False   
Via3958       BGA                            1      6     P_CONF[3]_6                    10                            2500.49                       4139.98                       True    No        False   False   
Via3703       BGA                            1      6     +2V5_CORE_6                    10                            2728.49                       3957.48                       True    No        True    False   
Via3700       BGA                            1      6     +2V5_CORE_6                    10                            2684.49                       3942.58                       True    No        True    False   
Via3226       POWERVIA                       1      6     GND                            24                            2573.59                       3960.48                       True    No        True    False   
Via3103       POWERVIA                       1      6     GND                            24                            2790.49                       3950.48                       True    No        True    False   
Via3100       POWERVIA                       1      6     GND                            24                            2439.49                       4160.48                       True    No        True    False   
Via4484       BGA                            1      6     $$$28255                       10                            3164.49                       4080.48                       True    No        False   False   
Via4023       BGA                            1      6     $$$12260                       10                            2869.49                       4130.48                       True    No        False   False   
Via3104       POWERVIA                       1      6     GND                            24                            2974.59                       4220.48                       True    No        True    False   
Via3101       POWERVIA                       1      6     GND                            24                            3069.49                       4220.48                       True    No        True    False   
Via2816       POWERVIA                       1      6     +3V3                           24                            2918.49                       4095.78                       True    No        True    False   
Via2813       POWERVIA                       1      6     +3V3                           24                            2919.49                       4000.48                       True    No        True    False   
Via4486       BGA                            1      6     $$$28258                       10                            3298.00                       4076.00                       True    No        False   False   
Via3058       POWERVIA                       1      6     GND                            24                            3383.49                       4023.48                       True    No        True    False   
Via3048       POWERVIA                       1      6     GND                            24                            3595.89                       4033.48                       True    No        True    False   
Via3093       BGA                            1      6     GND                            10                            3855.00                       4073.00                       True    No        True    False   
Via3057       BGA                            1      6     GND                            10                            3849.00                       3968.00                       True    No        True    False   
Via3754       BGA_18D8P                      1      6     $$$32081                       8                             4290.00                       4260.00                       True    No        False   False   
Via3056       POWERVIA                       1      6     GND                            24                            4027.49                       4073.48                       True    No        True    False   
Via2798       POWERVIA                       1      6     +3V3                           24                            4310.00                       4110.00                       True    No        False   False   
Via2797       POWERVIA                       1      6     +3V3                           24                            4319.00                       4032.00                       True    No        True    False   
Via2796       POWERVIA                       1      6     +3V3                           24                            4284.00                       3966.00                       True    No        True    False   
Via2795       POWERVIA                       1      6     +3V3                           24                            4215.00                       4040.00                       True    No        True    False   
Via2794       POWERVIA                       1      6     +3V3                           24                            4170.00                       3967.00                       True    No        True    False   
Via4558       BGA                            1      6     $$$27704                       10                            372.00                        4487.00                       True    No        False   False   
Via4264       BGA                            1      6     P_CONF[1]_4                    10                            766.49                        4450.08                       True    No        False   False   
Via4248       BGA                            1      6     C25_SHI[0]_4                   10                            782.49                        4627.48                       True    No        False   False   
Via3254       POWERVIA                       1      6     GND                            24                            778.03                        4504.58                       True    No        True    False   
Via3179       POWERVIA                       1      6     GND                            24                            715.09                        4597.48                       True    No        True    False   
Via4258       BGA                            1      6     P_MODE[0]_4                    10                            1002.00                       4641.00                       True    No        False   False   
Via4256       BGA                            1      6     TRANS-MODE-ENA_4               10                            1037.49                       4317.48                       True    No        False   False   
Via4250       BGA                            1      6     C25_SHI[1]_4                   10                            1201.00                       4399.00                       True    No        False   False   
Via4141       BGA                            1      6     +2V5_CORE_4                    10                            1093.00                       4688.00                       True    No        True    False   
Via4099       BGA                            1      6     EBUS[11]-RX+                   10                            848.49                        4400.57                       True    No        False   False   
Via3998       BGA                            1      6     $$$24023                       10                            1130.00                       4419.00                       True    No        False   False   
Via3996       BGA                            1      6     $$$24022                       10                            1167.00                       4481.00                       True    No        False   False   
Via3994       BGA                            1      6     $$$24021                       10                            1100.00                       4437.00                       True    No        False   False   
Via3992       BGA                            1      6     $$$24020                       10                            1067.00                       4438.00                       True    No        False   False   
Via3728       BGA                            1      6     EBUS[11]-RX-                   10                            848.49                        4374.39                       True    No        False   False   
Via3724       BGA                            1      6     $$$24018                       10                            1212.00                       4543.00                       True    No        False   False   
Via3722       BGA                            1      6     $$$24019                       10                            1175.00                       4540.00                       True    No        False   False   
Via3195       POWERVIA                       1      6     GND                            24                            1156.00                       4374.00                       True    No        True    False   
Via3127       POWERVIA                       1      6     GND                            24                            942.49                        4538.48                       True    No        True    False   
Via3019       NORMAL                         1      6     GND                            12                            1060.00                       4540.00                       True    No        True    False   
Via2887       BGA                            1      6     +3V3                           10                            922.49                        4597.48                       True    No        True    False   
Via2774       BGA                            1      6     +3V3                           10                            1002.49                       4426.48                       True    No        True    False   
Via4252       BGA                            1      6     CLK_MODE[0]_4                  10                            1510.00                       4605.00                       True    No        False   False   
Via4096       BGA                            1      6     EBUS[11]-TX-                   10                            1511.67                       4317.01                       True    No        False   False   
Via4093       BGA                            1      6     EBUS[11]-TX+                   10                            1541.00                       4317.00                       True    No        False   False   
Via4089       BGA                            1      6     $$$24059                       10                            1232.33                       4452.48                       True    No        False   False   
Via4087       BGA                            1      6     $$$24058                       10                            1273.00                       4445.00                       True    No        False   False   
Via3986       BGA                            1      6     $$$24017                       10                            1282.49                       4477.48                       True    No        False   False   
Via3984       BGA                            1      6     $$$24016                       10                            1317.00                       4445.00                       True    No        False   False   
Via3982       BGA                            1      6     $$$24015                       10                            1347.00                       4453.00                       True    No        False   False   
Via3968       BGA                            1      6     $$$24014                       10                            1382.49                       4478.98                       True    No        False   False   
Via3726       BGA                            1      6     C25_ENA_4                      10                            1297.49                       4377.48                       True    No        False   False   
Via3194       POWERVIA                       1      6     GND                            24                            1402.49                       4320.08                       True    No        True    False   
Via3188       NORMAL                         1      6     GND                            12                            1290.00                       4545.00                       True    No        True    False   
Via3125       POWERVIA                       1      6     GND                            24                            1483.49                       4397.48                       True    No        True    False   
Via3018       NORMAL                         1      6     GND                            12                            1390.00                       4515.00                       True    No        True    False   
Via2837       BGA                            1      6     +3V3                           10                            1421.49                       4391.48                       True    No        True    False   
Via2835       BGA                            1      6     +3V3                           10                            1242.49                       4668.48                       True    No        True    False   
Via2834       BGA                            1      6     +3V3                           10                            1581.49                       4565.48                       True    No        True    False   
Via3173       POWERVIA                       1      6     GND                            24                            1629.89                       4557.48                       True    No        True    False   
Via3076       POWERVIA                       1      6     GND                            24                            1812.49                       4557.48                       True    No        True    False   
Via3072       POWERVIA                       1      6     GND                            24                            1779.49                       4386.08                       True    No        True    False   
Via3006       POWERVIA                       1      6     GND                            24                            1722.49                       4557.48                       True    No        True    False   
Via3029       POWERVIA                       1      6     GND                            24                            2499.49                       4340.48                       True    No        True    False   
Via3023       POWERVIA                       1      6     GND                            24                            2689.49                       4340.48                       True    No        True    False   
Via3022       POWERVIA                       1      6     GND                            24                            2779.49                       4340.48                       True    No        True    False   
Via3694       POWERVIA                       1      6     +6.5V                          24                            3035.00                       4465.00                       True    No        True    False   
Via3062       POWERVIA                       1      6     GND                            24                            2869.49                       4340.48                       True    No        True    False   
Via3208       POWERVIA                       1      6     GND                            24                            3549.97                       4693.48                       True    No        True    False   
Via3044       POWERVIA                       1      6     GND                            24                            3430.00                       4660.00                       True    No        True    False   
Via3009       BGA                            1      6     GND                            10                            3720.49                       4334.18                       True    No        True    False   
Via3089       POWERVIA                       1      6     GND                            24                            4385.00                       4520.00                       True    No        True    False   
Via3055       POWERVIA                       1      6     GND                            24                            4357.49                       4655.68                       True    No        True    False   
Via3090       POWERVIA                       1      6     GND                            24                            4480.00                       4430.00                       True    No        True    False   
Via4585       BGA1                           1      6     $$$7100                        10                            615.00                        4980.00                       True    No        False   False   
Via4267       BGA                            1      6     CTRL_STATUS_MOVE_4             10                            707.49                        4912.48                       True    No        False   False   
Via3002       POWERVIA                       1      6     GND                            24                            735.00                        5025.00                       True    No        True    False   
Via2886       BGA                            1      6     +3V3                           10                            750.49                        4737.48                       True    No        True    False   
Via4586       BGA_18D8P                      1      6     $$$7100                        8                             1030.00                       5015.00                       True    No        False   False   
Via4428       BGA_18D8P                      1      6     EBUS[13]-TX-                   8                             1030.01                       4763.50                       True    No        False   False   
Via4426       BGA_18D8P                      1      6     EBUS[13]-TX+                   8                             1061.51                       4763.50                       True    No        False   False   
Via4272       BGA_18D8P                      1      6     P_CONF[2]_4                    8                             1061.51                       5015.47                       True    No        False   False   
Via4270       BGA_18D8P                      1      6     PHYAD_OFF_4                    8                             1061.51                       5078.46                       True    No        False   False   
Via4268       BGA_18D8P                      1      6     CTRL_STATUS_MOVE_4             8                             1030.01                       4983.98                       True    No        False   False   
Via4266       BGA_18D8P                      1      6     P_CONF[1]_4                    8                             998.51                        4795.00                       True    No        False   False   
Via4263       BGA_18D8P                      1      6     CLK_MODE[1]_4                  8                             1030.01                       4826.50                       True    No        False   False   
Via4262       BGA                            1      6     CLK_MODE[1]_4                  10                            842.49                        4967.48                       True    No        False   False   
Via4261       BGA_18D8P                      1      6     P_MODE[1]_4                    8                             998.51                        4763.50                       True    No        False   False   
Via4260       BGA                            1      6     P_MODE[1]_4                    10                            842.49                        4872.48                       True    No        False   False   
Via4259       BGA_18D8P                      1      6     P_MODE[0]_4                    8                             1030.01                       4795.00                       True    No        False   False   
Via4257       BGA_18D8P                      1      6     TRANS-MODE-ENA_4               8                             1061.51                       4795.00                       True    No        False   False   
Via4148       BGA_18D8P                      1      6     +2V5_CORE_4                    8                             1155.99                       5078.46                       True    No        True    False   
Via4145       BGA_18D8P                      1      6     +2V5_CORE_4                    8                             1155.99                       4826.50                       True    No        True    False   
Via4107       BGA_18D8P                      1      6     EBUS[13]-RX+                   8                             1124.50                       4763.50                       True    No        False   False   
Via3999       BGA_18D8P                      1      6     $$$24023                       8                             1155.99                       4763.50                       True    No        False   False   
Via3997       BGA_18D8P                      1      6     $$$24022                       8                             1061.51                       4826.50                       True    No        False   False   
Via3995       BGA_18D8P                      1      6     $$$24021                       8                             1124.50                       4795.00                       True    No        False   False   
Via3993       BGA_18D8P                      1      6     $$$24020                       8                             1093.00                       4795.00                       True    No        False   False   
Via3967       BGA_18D8P                      1      6     $$$24013                       8                             1093.00                       5078.46                       True    No        False   False   
Via3957       BGA_18D8P                      1      6     P_CONF[3]_4                    8                             1029.49                       5078.98                       True    No        False   False   
Via3821       BGA_18D8P                      1      6     EBUS[14]-TX-                   8                             998.51                        5015.47                       True    No        False   False   
Via3818       BGA_18D8P                      1      6     EBUS[14]-TX+                   8                             998.51                        4983.98                       True    No        False   False   
Via3813       BGA_18D8P                      1      6     EBUS[14]-RX-                   8                             998.51                        4889.49                       True    No        False   False   
Via3804       BGA_18D8P                      1      6     EBUS[14]-RX+                   8                             996.00                        4859.00                       True    No        False   False   
Via3764       BGA_18D8P                      1      6     EBUS[13]-RX-                   8                             1093.00                       4763.50                       True    No        False   False   
Via3725       BGA_18D8P                      1      6     $$$24018                       8                             1155.99                       4795.00                       True    No        False   False   
Via3723       BGA_18D8P                      1      6     $$$24019                       8                             1093.00                       4826.50                       True    No        False   False   
Via3586       BGA_18D8P                      1      6     GND                            8                             998.51                        5078.46                       True    No        True    False   
Via3580       BGA_18D8P                      1      6     GND                            8                             998.51                        5046.97                       True    No        True    False   
Via3579       BGA_18D8P                      1      6     GND                            8                             1030.01                       5046.97                       True    No        True    False   
Via3578       BGA_18D8P                      1      6     GND                            8                             1093.00                       5046.97                       True    No        True    False   
Via3577       BGA_18D8P                      1      6     GND                            8                             1124.50                       5046.97                       True    No        True    False   
Via3576       BGA_18D8P                      1      6     GND                            8                             1155.99                       5046.97                       True    No        True    False   
Via3570       BGA_18D8P                      1      6     GND                            8                             1093.00                       5015.47                       True    No        True    False   
Via3568       BGA_18D8P                      1      6     GND                            8                             1093.00                       4983.98                       True    No        True    False   
Via3566       BGA_18D8P                      1      6     GND                            8                             998.51                        4920.98                       True    No        True    False   
Via3565       BGA_18D8P                      1      6     GND                            8                             1030.01                       4920.98                       True    No        True    False   
Via3564       BGA_18D8P                      1      6     GND                            8                             1061.51                       4920.98                       True    No        True    False   
Via3563       BGA_18D8P                      1      6     GND                            8                             1093.00                       4920.98                       True    No        True    False   
Via3561       BGA_18D8P                      1      6     GND                            8                             1030.01                       4889.49                       True    No        True    False   
Via3560       BGA_18D8P                      1      6     GND                            8                             1061.51                       4889.49                       True    No        True    False   
Via3559       BGA_18D8P                      1      6     GND                            8                             1093.00                       4889.49                       True    No        True    False   
Via3557       BGA_18D8P                      1      6     GND                            8                             1030.01                       4857.99                       True    No        True    False   
Via3556       BGA_18D8P                      1      6     GND                            8                             1093.00                       4857.99                       True    No        True    False   
Via3555       BGA_18D8P                      1      6     GND                            8                             1124.50                       4857.99                       True    No        True    False   
Via3554       BGA_18D8P                      1      6     GND                            8                             1155.99                       4857.99                       True    No        True    False   
Via3550       BGA_18D8P                      1      6     GND                            8                             998.51                        4826.50                       True    No        True    False   
Via3253       POWERVIA                       1      6     GND                            24                            932.49                        4842.28                       True    No        True    False   
Via3123       POWERVIA                       1      6     GND                            24                            927.80                        4935.28                       True    No        True    False   
Via2959       BGA_18D8P                      1      6     +3V3                           8                             1125.49                       5077.47                       True    No        True    False   
Via2958       BGA_18D8P                      1      6     +3V3                           8                             1061.49                       5046.48                       True    No        True    False   
Via2955       BGA_18D8P                      1      6     +3V3                           8                             1061.49                       4983.99                       True    No        True    False   
Via2952       BGA_18D8P                      1      6     +3V3                           8                             1061.00                       4857.00                       True    No        True    False   
Via2950       BGA_18D8P                      1      6     +3V3                           8                             1124.00                       4826.00                       True    No        True    False   
Via2833       BGA                            1      6     +3V3                           10                            929.49                        5090.28                       True    No        True    False   
Via4575       BGA1                           1      6     $$$6515                        10                            1440.00                       4895.00                       True    No        False   False   
Via4479       BGA_18D8P                      1      6     $$$24012                       8                             1376.47                       5015.47                       True    No        False   False   
Via4477       BGA_18D8P                      1      6     $$$24011                       8                             1345.00                       5017.00                       True    No        False   False   
Via4278       BGA_18D8P                      1      6     RUN/EEPROM_SIZE_4              8                             1344.97                       4889.49                       True    No        False   False   
Via4277       BGA                            1      6     RUN/EEPROM_SIZE_4              10                            1506.00                       4844.00                       True    No        False   False   
Via4276       BGA_18D8P                      1      6     OSC_OUT_4                      8                             1380.00                       4981.00                       True    No        False   False   
Via4274       BGA_18D8P                      1      6     OSC_IN_4                       8                             1376.47                       4920.98                       True    No        False   False   
Via4273       BGA                            1      6     OSC_IN_4                       10                            1557.00                       4864.00                       True    No        False   False   
Via4255       BGA_18D8P                      1      6     P_CONF[0]_4                    8                             1376.47                       4857.99                       True    No        False   False   
Via4253       BGA_18D8P                      1      6     CLK_MODE[0]_4                  8                             1344.97                       4857.99                       True    No        False   False   
Via4251       BGA_18D8P                      1      6     C25_SHI[1]_4                   8                             1218.99                       4763.50                       True    No        False   False   
Via4249       BGA_18D8P                      1      6     C25_SHI[0]_4                   8                             1218.99                       4795.00                       True    No        False   False   
Via4147       BGA_18D8P                      1      6     +2V5_CORE_4                    8                             1218.99                       5078.46                       True    No        True    False   
Via4146       BGA_18D8P                      1      6     +2V5_CORE_4                    8                             1313.47                       4920.98                       True    No        True    False   
Via4144       BGA_18D8P                      1      6     +2V5_CORE_4                    8                             1218.99                       4826.50                       True    No        True    False   
Via4142       BGA                            1      6     +2V5_CORE_4                    10                            1472.49                       5037.48                       True    No        True    False   
Via4101       BGA_18D8P                      1      6     EBUS[11]-RX+                   8                             1281.98                       4763.50                       True    No        False   False   
Via4097       BGA_18D8P                      1      6     EBUS[11]-TX-                   8                             1344.97                       4763.50                       True    No        False   False   
Via4094       BGA_18D8P                      1      6     EBUS[11]-TX+                   8                             1376.47                       4763.50                       True    No        False   False   
Via4090       BGA_18D8P                      1      6     $$$24059                       8                             1281.98                       4795.00                       True    No        False   False   
Via4088       BGA_18D8P                      1      6     $$$24058                       8                             1376.47                       4795.00                       True    No        False   False   
Via3987       BGA_18D8P                      1      6     $$$24017                       8                             1313.47                       4826.50                       True    No        False   False   
Via3985       BGA_18D8P                      1      6     $$$24016                       8                             1313.47                       4795.00                       True    No        False   False   
Via3983       BGA_18D8P                      1      6     $$$24015                       8                             1344.97                       4795.00                       True    No        False   False   
Via3969       BGA_18D8P                      1      6     $$$24014                       8                             1313.47                       4763.50                       True    No        False   False   
Via3954       BGA_18D8P                      1      6     EEPROM_DATA_4                  8                             1345.00                       4981.00                       True    No        False   False   
Via3953       BGA_18D8P                      1      6     EEPROM_CLK_4                   8                             1344.97                       4920.98                       True    No        False   False   
Via3952       BGA_18D8P                      1      6     EEPROM_CLK_4                   8                             1422.00                       4945.00                       True    No        False   False   
Via3730       BGA_18D8P                      1      6     EBUS[11]-RX-                   8                             1250.48                       4763.50                       True    No        False   False   
Via3727       BGA_18D8P                      1      6     C25_ENA_4                      8                             1250.48                       4795.00                       True    No        False   False   
Via3585       BGA_18D8P                      1      6     GND                            8                             1250.48                       5078.46                       True    No        True    False   
Via3584       BGA_18D8P                      1      6     GND                            8                             1281.98                       5078.46                       True    No        True    False   
Via3583       BGA_18D8P                      1      6     GND                            8                             1313.47                       5078.46                       True    No        True    False   
Via3582       BGA_18D8P                      1      6     GND                            8                             1344.97                       5078.46                       True    No        True    False   
Via3581       BGA_18D8P                      1      6     GND                            8                             1376.47                       5078.46                       True    No        True    False   
Via3575       BGA_18D8P                      1      6     GND                            8                             1218.99                       5046.97                       True    No        True    False   
Via3574       BGA_18D8P                      1      6     GND                            8                             1250.48                       5046.97                       True    No        True    False   
Via3573       BGA_18D8P                      1      6     GND                            8                             1281.98                       5046.97                       True    No        True    False   
Via3572       BGA_18D8P                      1      6     GND                            8                             1344.97                       5046.97                       True    No        True    False   
Via3571       BGA_18D8P                      1      6     GND                            8                             1376.47                       5046.97                       True    No        True    False   
Via3569       BGA_18D8P                      1      6     GND                            8                             1313.47                       5015.47                       True    No        True    False   
Via3567       BGA_18D8P                      1      6     GND                            8                             1281.98                       4983.98                       True    No        True    False   
Via3562       BGA_18D8P                      1      6     GND                            8                             1281.98                       4920.98                       True    No        True    False   
Via3558       BGA_18D8P                      1      6     GND                            8                             1313.47                       4889.49                       True    No        True    False   
Via3553       BGA_18D8P                      1      6     GND                            8                             1218.99                       4857.99                       True    No        True    False   
Via3552       BGA_18D8P                      1      6     GND                            8                             1250.48                       4857.99                       True    No        True    False   
Via3551       BGA_18D8P                      1      6     GND                            8                             1281.98                       4857.99                       True    No        True    False   
Via3549       BGA_18D8P                      1      6     GND                            8                             1281.98                       4826.50                       True    No        True    False   
Via3178       NORMAL                         1      6     GND                            12                            1472.49                       4877.48                       True    No        True    False   
Via3124       POWERVIA                       1      6     GND                            24                            1470.00                       4780.00                       True    No        True    False   
Via2957       BGA_18D8P                      1      6     +3V3                           8                             1313.49                       5046.98                       True    No        True    False   
Via2956       BGA_18D8P                      1      6     +3V3                           8                             1281.49                       5014.98                       True    No        True    False   
Via2954       BGA_18D8P                      1      6     +3V3                           8                             1314.00                       4984.00                       True    No        True    False   
Via2953       BGA_18D8P                      1      6     +3V3                           8                             1282.49                       4889.48                       True    No        True    False   
Via2951       BGA_18D8P                      1      6     +3V3                           8                             1313.49                       4857.98                       True    No        True    False   
Via2949       BGA_18D8P                      1      6     +3V3                           8                             1250.49                       4826.49                       True    No        True    False   
Via4574       BGA1                           1      6     $$$6515                        10                            1840.00                       4875.00                       True    No        False   False   
Via4275       MICROVIA                       1      6     OSC_OUT_4                      12                            1667.49                       4968.98                       True    No        False   False   
Via4254       MICROVIA                       1      6     P_CONF[0]_4                    12                            1702.00                       4872.00                       True    No        False   False   
Via3154       POWERVIA                       1      6     GND                            24                            1792.49                       4917.48                       True    No        True    False   
Via3004       POWERVIA                       1      6     GND                            24                            1647.33                       5087.48                       True    No        True    False   
Via2889       BGA                            1      6     +3V3                           10                            1827.49                       5016.48                       True    No        True    False   
Via2775       BGA                            1      6     +3V3                           10                            1732.49                       5021.18                       True    No        True    False   
Via3054       NORMAL                         1      6     GND                            12                            2735.00                       4985.00                       True    No        True    False   
Via4026       BGA1                           1      6     +6.5V_A                        10                            3032.00                       5044.00                       True    No        True    False   
Via3210       POWERVIA                       1      6     GND                            24                            3570.00                       4850.00                       True    No        True    True    
Via3045       POWERVIA                       1      6     GND                            24                            3480.00                       4815.00                       True    No        True    False   
Via4029       BGA1                           1      6     +6.5V_B                        10                            3770.00                       4920.00                       True    No        True    False   
Via3092       POWERVIA                       1      6     GND                            24                            3845.00                       4745.00                       True    No        True    False   
Via3091       POWERVIA                       1      6     GND                            24                            3930.00                       4835.00                       True    No        True    False   
Via3149       BGA1                           1      6     GND                            10                            4330.00                       4770.00                       True    No        True    False   
Via3085       BGA1                           1      6     GND                            10                            235.00                        5195.00                       True    No        True    False   
Via3067       BGA1                           1      6     GND                            10                            160.00                        5140.00                       True    No        True    False   
Via4271       BGA                            1      6     P_CONF[2]_4                    10                            717.49                        5142.48                       True    No        False   False   
Via3180       POWERVIA                       1      6     GND                            24                            812.49                        5391.48                       True    No        True    False   
Via3086       BGA1                           1      6     GND                            10                            500.00                        5195.00                       True    No        True    False   
Via3081       BGA1                           1      6     GND                            10                            670.00                        5105.00                       True    No        True    False   
Via4448       BGA_18D8P                      1      6     EBUS[15]-TX-                   8                             1061.51                       5141.46                       True    No        False   False   
Via4430       BGA_18D8P                      1      6     EBUS[15]-TX+                   8                             1030.01                       5141.46                       True    No        False   False   
Via4143       BGA                            1      6     +2V5_CORE_4                    10                            1172.39                       5309.13                       True    No        True    False   
Via4140       BGA_18D8P                      1      6     +2V5_CORE_4                    8                             1130.99                       5187.48                       True    No        True    False   
Via4111       BGA_18D8P                      1      6     EBUS[15]-RX+                   8                             998.00                        5110.00                       True    No        False   False   
Via4109       BGA_18D8P                      1      6     EBUS[15]-RX-                   8                             998.51                        5141.46                       True    No        False   False   
Via3961       BGA_18D8P                      1      6     ERR[3]_4                       8                             1030.01                       5109.96                       True    No        False   False   
Via3960       BGA                            1      6     ERR[3]_4                       10                            1182.49                       5392.48                       True    No        False   False   
Via3955       BGA                            1      6     P_CONF[3]_4                    10                            1014.99                       5438.48                       True    No        False   False   
Via3605       BGA_18D8P                      1      6     GND                            8                             1093.00                       5141.46                       True    No        True    False   
Via3604       BGA_18D8P                      1      6     GND                            8                             1124.50                       5141.46                       True    No        True    False   
Via3603       BGA_18D8P                      1      6     GND                            8                             1155.99                       5141.46                       True    No        True    False   
Via3596       BGA_18D8P                      1      6     GND                            8                             1061.51                       5109.96                       True    No        True    False   
Via3595       BGA_18D8P                      1      6     GND                            8                             1093.00                       5109.96                       True    No        True    False   
Via3594       BGA_18D8P                      1      6     GND                            8                             1124.50                       5109.96                       True    No        True    False   
Via3593       BGA_18D8P                      1      6     GND                            8                             1155.99                       5109.96                       True    No        True    False   
Via3256       POWERVIA                       1      6     GND                            24                            962.49                        5273.68                       True    No        True    False   
Via3252       POWERVIA                       1      6     GND                            24                            932.49                        5152.28                       True    No        True    False   
Via2838       BGA                            1      6     +3V3                           10                            928.49                        5338.68                       True    No        True    False   
Via4478       BGA                            1      6     $$$24012                       10                            1602.49                       5342.48                       True    No        False   False   
Via4476       MICROVIA                       1      6     $$$24011                       12                            1509.00                       5319.00                       True    No        False   False   
Via4269       BGA                            1      6     PHYAD_OFF_4                    10                            1282.49                       5377.48                       True    No        False   False   
Via3966       BGA                            1      6     $$$24013                       10                            1342.49                       5392.48                       True    No        False   False   
Via3602       BGA_18D8P                      1      6     GND                            8                             1218.99                       5141.46                       True    No        True    False   
Via3601       BGA_18D8P                      1      6     GND                            8                             1250.48                       5141.46                       True    No        True    False   
Via3600       BGA_18D8P                      1      6     GND                            8                             1281.98                       5141.46                       True    No        True    False   
Via3599       BGA_18D8P                      1      6     GND                            8                             1313.47                       5141.46                       True    No        True    False   
Via3598       BGA_18D8P                      1      6     GND                            8                             1344.97                       5141.46                       True    No        True    False   
Via3597       BGA_18D8P                      1      6     GND                            8                             1376.47                       5141.46                       True    No        True    False   
Via3592       BGA_18D8P                      1      6     GND                            8                             1218.99                       5109.96                       True    No        True    False   
Via3591       BGA_18D8P                      1      6     GND                            8                             1250.48                       5109.96                       True    No        True    False   
Via3590       BGA_18D8P                      1      6     GND                            8                             1281.98                       5109.96                       True    No        True    False   
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
Via5490       NORMAL                         1      6     GND                            12                            3015.00                       5350.00                       True    No        True    False   
Via5315       NORMAL                         1      6     GND                            12                            3015.00                       5300.00                       True    No        True    False   
Via5303       NORMAL                         1      6     GND                            12                            3015.00                       5250.00                       True    No        True    False
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
