Sayidathahaseen/CCC_NGP_ODC/NGP_ODC_Main/PDLC/design/Schematics/MPC5534_daughter_card/Rev3.0/UpdateFromLibrary_Logic_report.txt

1    | *PADS Logic 9.4* UPDATE FROM LIBRARY REPORT
2    | 15:45:35 07/26/12 CCCNGP_MPC5534_BOARD_REV3.0.sch
3    | C:\PADS Projects\UpdateFromLibrary_Logic_report.txt
4    | 
5    | 	*********************************************************************************
6    | 	****    For information on how to read this report, click the Help button    ****
7    | 	****    in the Update from Library dialog box.                               ****
8    | 	*********************************************************************************
9    | 
10   | 
11   | ==========================================================================================
12   | REPORT OPTIONS
13   | ==========================================================================================
14   | 
15   | This report was run with the following options:
16   |   Generate comparison report
17   |   Include items with identical time stamp
18   |   Summary and Details
19   |   Hide identical results
20   |   Part types and attributes
21   |   CAE Decals
22   |   Pin Decals:
23   |      PIN    
24   |      PINB    
25   |      PCLK    
26   |      PCLKB    
27   |      PINIEB    
28   |      PINORB    
29   |      PINSHORT    
30   |      PINVRTS    
31   |      PIN150    
32   |      PIN150_INV    
33   |      PIN50    
34   |      PIN_CLOCK_30    
35   |   Off-Page symbols
36   |   Ground symbols
37   |   Power symbols
38   | 
39   | ==========================================================================================
40   | REPORT SUMMARY
41   | ==========================================================================================
42   | 
43   |  Compare status:
44   |    Compared -       855
45   |     Differences -   11
46   |     Warnings -      13
47   |    Errors -         0
48   |    Skipped -        0
49   | 
50   |  Update status:
51   |    Updated -        0
52   |     Warnings -      0
53   |    Failed -         0
54   |    Skipped -        0
55   | 
56   | -------------------
57   | Compared Part Types
58   | -------------------
59   | 
60   |                                              Design                                                                 Update
61   |    Part Type                                 Timestamp                  Content               Found in Library      Status      See Line
62   |    ----------------------------------------  -------------------------  --------------------  --------------------  ----------  ----------
63   |    CAP-15PF-50V-0603-0.5%-C0603C150D5GACTU   Same as library            Compared items match  CAP                    -          1342
64   |    RES-100E-R0603-RC0603FR-07100RL           Same as library            Compared items match  RES                    -          1347
65   |    FBD-0805-BLM21PG331SN1D                   Same as library            Compared items match  FERRITE_BEADS          -          1352
66   |    CAP-0.1UF-50V-0603-10%-06035C104KAT2A     Same as library            Compared items match  CAP                    -          1357
67   |    RES-4.7K-R0603-RC0603FR-074K7L            Same as library            Different             RES                    -          1362
68   |    RES-0E-R0603-RC0603JR-070RL               Same as library            Different             RES                    -          1387
69   |    XTAL-2-SMD-ABM7-8.000MHZ-D2Y-T            Same as library            Compared items match  clock                  -          1403
70   |    IC-MCU-208MAPBGA-MPC5534MVZ80             Same as library            Different             IC                     -          1408
71   |    RES-10K-R0603-RC0603FR-0710KL             Same as library            Compared items match  RES                    -          1423
72   |    RES-10M-R0805-RK73B2ATTD106J              Same as library            Different             RES                    -          1428
73   |    RES-33E-R1506-YC248-JR-0733RL             Same as library            Compared items match  RES                    -          1438
74   |    OSC-4-SMD-ASDMB-8.000MHZ-LY-T             Same as library            Compared items match  clock                  -          1443
75   |    MEC-TPD-#                                 Same as library            Compared items match  MISC                   -          1448
76   |    CAP-0.01UF-10V-0306-10%-0306ZC103KAT2A    Same as library            Compared items match  Temporary              -          1453
77   |    CAP-10UF-25V-0805-10%-GRM21BR61E106KA73L  Same as library            Compared items match  CAP                    -          1458
78   |    CAP-10UF-16V-1206-10%-TAJA106K016RNJ      Same as library            Compared items match  CAP                    -          1463
79   |    RES-0E-R1210-CRCW12100000Z0EA             Same as library            Different             RES                    -          1468
80   |    RES-1.21E-R2512-SR733ATTE1R21F            Same as library            Compared items match  RES                    -          1478
81   |    IND-IMC1210ER100K                         Same as library            Compared items match  INDUCTORS              -          1483
82   |    TRN-SOT-223-BCP68T1G                      Same as library            Compared items match  fets                   -          1488
83   |    CAP-1UF-50V-0603-10%-UMK107BJ105KA-T      Same as library            Compared items match  CAP                    -          1493
84   |    MEC-MH-#                                  Same as library            Compared items match  MISC                   -          1498
85   |    MEC-FD-#                                  Same as library            Compared items match  MISC                   -          1503
86   |    CAP-1UF-50V-0805-10%-C0805C103K5RACTU     Same as library            Compared items match  CAP                    -          1508
87   |    CAP-2200PF-50V-0603-10%-GRM188R61H222KA#  Same as library            Compared items match  CAP                    -          1513
88   |    CAP-39PF-50V-0402-5%-04025A390JAT2A       Same as library            Compared items match  CAP                    -          1518
89   |    CAP-0.01UF-16V-0402-10%-0402YC103KAT2A    Same as library            Compared items match  CAP                    -          1523
90   |    CAP-22UF-25V-2312-10%-TPSC226K025R0275    Same as library            Compared items match  CAP                    -          1528
91   |    RES-47K-R0603-RC0603FR-0747KL             Same as library            Compared items match  RES                    -          1533
92   |    RES-18K-R0603-RC0603FR-0718KL             Same as library            Compared items match  RES                    -          1538
93   |    RES-430E-R0603-RC0603FR-07430RL           Same as library            Compared items match  RES                    -          1543
94   |    IND-IHLP2525CZER100M01                    Same as library            Compared items match  INDUCTORS              -          1548
95   |    IND-IHLP3232DZER220M11                    Same as library            Compared items match  INDUCTORS              -          1553
96   |    IND-IHLP2020BZER3R3M01                    Same as library            Compared items match  INDUCTORS              -          1558
97   |    TRN-DPAK-NJD2873T4G                       Same as library            Compared items match  fets                   -          1563
98   |    DIO-DO-214AB-SS36-E3/57T                  Same as library            Compared items match  diodes                 -          1568
99   |    DIO-SMB-SMBJ40A                           Same as library            Compared items match  diodes                 -          1573
100  |    IC-REGULATOR-32-SOIC-MCZ33730EKR2         Same as library            Compared items match  IC                     -          1578
101  |    RES-24K-R0603-RC0603FR-0724KL             Same as library            Compared items match  RES                    -          1583
102  |    CAP-100UF-20V-2917-10%-TPSE107K020R0150   Same as library            Compared items match  CAP                    -          1588
103  |    CON-TH_RA-2X5-68021-210HLF                Same as library            Compared items match  CONNECTORS             -          1593
104  |    IC-TRNSCVR-20-TSSOP-SN74LVTH245APWR       Same as library            Compared items match  IC                     -          1598
105  |    IC-CPLD-44-TQFP-EPM3064ATI44-10N          Same as library            Compared items match  IC                     -          1603
106  |    IC-ORGATE-SOT-553-SN74LVC1G32DRLR         Same as library            Compared items match  IC                     -          1608
107  |    IC-INVERTER-SOT-553-SN74AHC1G04DRLR       Same as library            Compared items match  IC                     -          1613
108  |    IC-ANDGATE-SC-70-6-SN74LVC1G11DCKR        Same as library            Compared items match  IC                     -          1618
109  |    IC-BUFFER-SOT-553-SN74LVC1G125DRLR        Same as library            Compared items match  IC                     -          1623
110  |    IC-ANDGATE-SOT-553-SN74LVC1G08DRLR        Same as library            Compared items match  IC                     -          1628
111  |    RES-120E-R0603-RC0603FR-07120RL           Same as library            Compared items match  RES                    -          1633
112  |    CON-TH_RA-2X7-68021-214HLF                Same as library            Compared items match  CONNECTORS             -          1638
113  |    RES-1K-R0603-RC0603FR-071KL               Same as library            Compared items match  RES                    -          1643
114  |    IC-EEPROM-8TSSOP-CAT25160YI-G             Same as library            Compared items match  IC                     -          1648
115  |    IC-RS422/485-TRNSCVR-8-SOIC-ADM3490ARZ    Same as library            Compared items match  IC                     -          1653
116  |    IC-SENSOR-8-SOIC-TMP36FSZ                 Same as library            Compared items match  IC                     -          1658
117  |    CON-TH_RA-1X6-640453-6                    Same as library            Compared items match  CONNECTORS             -          1663
118  |    IC-FLASH-BGA-48-S29AL008J70BFI02          Same as library            Different             IC                     -          1668
119  |    IC-RAM-48LFBGA-CY7C1051DV33-10BAXI        Same as library            Different             IC                     -          1679
120  |    IC-RAM-48FBGA-MR4A16BCMA35                Same as library            Different             IC                     -          1690
121  |    CAP-12PF-50V-0603-5%-06035A120JAT2A       Same as library            Compared items match  CAP                    -          1701
122  |    RES-4.7K-R0402-ERJ-2RKF4701X              Same as library            Compared items match  RES                    -          1706
123  |    RES-11K-R0603-RC0603FR-0711KL             Same as library            Compared items match  RES                    -          1711
124  |    IC-EEPROM-8-SOIC-24LC16B-I/SN             Same as library            Compared items match  IC                     -          1716
125  |    IC-ETHERCATCNTRLR-BGA128-ET1100           Same as library            Different             IC                     -          1721
126  |    XTAL-4-SMD-ABM11-25.000MHZ-B7G-T          Same as library            Compared items match  clock                  -          1744
127  |    CAP-0.1UF-10V-0402-10%-0402ZD104KAT2A     Same as library            Compared items match  CAP                    -          1749
128  |    CAP-220PF-10V-01005-10%-C0402X5R1A221K    Same as library            Compared items match  CAP                    -          1754
129  |    CAP-6800PF-50V-0603-5%-C0603C682J5GACTU   Same as library            Compared items match  CAP                    -          1759
130  |    CAP-47PF-50V-0603-5%-06035A470JAT2A       Same as library            Compared items match  CAP                    -          1764
131  |    CAP-1000PF-50V-0603-5%-C0603C102J5GACTU   Same as library            Compared items match  CAP                    -          1769
132  |    CAP-47UF-10V-1411-20%-T520B476M010ATE035  Same as library            Compared items match  CAP                    -          1774
133  |    RES-10.2K-R0805-RC0805FR-0710K2L          Same as library            Compared items match  RES                    -          1779
134  |    RES-3.24K-R0805-RC0805FR-073K24L          Same as library            Compared items match  RES                    -          1784
135  |    RES-29.4K-R0805-RC0805FR-0729K4L          Same as library            Compared items match  RES                    -          1789
136  |    RES-332K-R0805-RC0805FR-07332KL           Same as library            Compared items match  RES                    -          1794
137  |    RES-100K-R0805-RC0805FR-07100KL           Same as library            Compared items match  RES                    -          1799
138  |    DIO-DO-214AC-B240A-13-F                   Same as library            Compared items match  diodes                 -          1804
139  |    IC-TIMER-10MSOP-LTC2918IMS-B1#PBF         Same as library            Compared items match  IC                     -          1809
140  |    IC-OPAMP-8-MSOP-AD822ARMZ-REEL            Same as library            Compared items match  IC                     -          1814
141  |    IC-DCCONV-8-SOIC-TPS54231DR               Same as library            Compared items match  IC                     -          1819
142  |    RES-300E-R0603-RC0603FR-07300RL           Same as library            Compared items match  RES                    -          1824
143  |    IC-BUFFER-14TSSOP-74LV125PW               Same as library            Compared items match  IC                     -          1829
144  |    CON-SMT-2X40-QSE-040-01-L-D-A             Same as library            Different             CONNECTORS             -          1834
145  |    IC-BUFFER-SOT-553-SN74LVC1G07DRLR         Same as library            Compared items match  IC                     -          1849
146  |    CON-SMT-2X19-5767054-1                    Same as library            Different             CONNECTORS             -          1854
147  | 
148  | ------------------
149  | Compared CAE Decal
150  | ------------------
151  | 
152  | Sheet No:3
153  | Sheet Name:SHEET3-MPC5534
154  | 
155  |                            Design                                                                 Update
156  |    CAE Decal               Timestamp                  Content               Found in Library      Status      See Line
157  |    ----------------------  -------------------------  --------------------  --------------------  ----------  ----------
158  |    PIN                     Same as library            Compared items match  common                 -          1878
159  |    PINB                    Same as library            Compared items match  common                 -          1883
160  |    PCLK                    Same as library            Compared items match  common                 -          1888
161  |    PCLKB                   Same as library            Compared items match  common                 -          1893
162  |    PINIEB                  Same as library            Compared items match  common                 -          1898
163  |    PINORB                  Same as library            Compared items match  common                 -          1903
164  |    PINSHORT                Same as library            Compared items match  common                 -          1908
165  |    PINVRTS                 Same as library            Compared items match  common                 -          1913
166  |    PIN150                  Same as library            Compared items match  common                 -          1918
167  |    PIN150_INV              Same as library            Compared items match  common                 -          1923
168  |    PIN50                   Same as library            Compared items match  common                 -          1928
169  |    REFIN                   Same as library            Compared items match  common                 -          1933
170  |    REFOUT                  Same as library            Compared items match  common                 -          1938
171  |    GND                     Same as library            Compared items match  common                 -          1943
172  |    AGND                    Same as library            Compared items match  common                 -          1948
173  |    CHGND                   Same as library            Compared items match  common                 -          1953
174  |    +5V                     Same as library            Compared items match  Temp_Decal             -          1958
175  |    Y                       Same as library            Compared items match  Temp_Decal             -          1963
176  |    +12V                    Same as library            Compared items match  Temp_Decal             -          1968
177  |    -5V                     Same as library            Compared items match  Temp_Decal             -          1973
178  |    -12V                    Same as library            Compared items match  Temp_Decal             -          1978
179  |    +5VA                    Same as library            Compared items match  Temp_Decal             -          1983
180  |    NPCAP-V                 Same as library            Compared items match  CAP                    -          1988
181  |    NPCAP-H                 Same as library            Compared items match  CAP                    -          1993
182  |    RES-H                   Same as library            Compared items match  RES                    -          1998
183  |    RES-V                   Same as library            Compared items match  RES                    -          2003
184  |    FB-H                    Same as library            Compared items match  FERRITE_BEADS          -          2008
185  |    FB-V                    Same as library            Compared items match  FERRITE_BEADS          -          2013
186  |    XTAL_2SMD_H             Same as library            Compared items match  clock                  -          2018
187  |    XTAL_2SMD_V             Same as library            Compared items match  clock                  -          2023
188  |    IC_MPC5534MVZ80A        Same as library            Compared items match  IC                     -          2028
189  |    IC_MPC5534MVZ80B        Same as library            Compared items match  IC                     -          2033
190  |    OSC_ASDM                Same as library            Compared items match  clock                  -          2038
191  |    REFBIDIR/ALT            Same as library            Compared items match  common                 -          2043
192  |    REFBIDIR                Same as library            Compared items match  common                 -          2048
193  |    REFOUT\ALT              Same as library            Compared items match  common                 -          2053
194  |    REFIN\ALT               Same as library            Compared items match  common                 -          2058
195  |    TEST_PAD                Same as library            Compared items match  MISC                   -          2063
196  |    NPCAP-ALT-V             Same as library            Compared items match  CAP                    -          2068
197  |    NPCAP-ALT-H             Same as library            Compared items match  CAP                    -          2073
198  |    RES-ALT-H               Same as library            Compared items match  RES                    -          2078
199  |    RES-ALT-V               Same as library            Compared items match  RES                    -          2083
200  |    FB-ALT-H                Same as library            Compared items match  FERRITE_BEADS          -          2088
201  |    FB-ALT-V                Same as library            Compared items match  FERRITE_BEADS          -          2093
202  | 
203  | Sheet No:5
204  | Sheet Name:SHEET5-MPC5534_POWER
205  | 
206  |                            Design                                                                 Update
207  |    CAE Decal               Timestamp                  Content               Found in Library      Status      See Line
208  |    ----------------------  -------------------------  --------------------  --------------------  ----------  ----------
209  |    PIN                     Same as library            Compared items match  common                 -          2102
210  |    PINB                    Same as library            Compared items match  common                 -          2107
211  |    PCLK                    Same as library            Compared items match  common                 -          2112
212  |    PCLKB                   Same as library            Compared items match  common                 -          2117
213  |    PINIEB                  Same as library            Compared items match  common                 -          2122
214  |    PINORB                  Same as library            Compared items match  common                 -          2127
215  |    PINSHORT                Same as library            Compared items match  common                 -          2132
216  |    PINVRTS                 Same as library            Compared items match  common                 -          2137
217  |    PIN150                  Same as library            Compared items match  common                 -          2142
218  |    PIN50                   Same as library            Compared items match  common                 -          2147
219  |    GND                     Same as library            Compared items match  common                 -          2152
220  |    AGND                    Same as library            Compared items match  common                 -          2157
221  |    CHGND                   Same as library            Compared items match  common                 -          2162
222  |    +5V                     Same as library            Compared items match  Temp_Decal             -          2167
223  |    Y                       Same as library            Compared items match  Temp_Decal             -          2172
224  |    +12V                    Same as library            Compared items match  Temp_Decal             -          2177
225  |    -5V                     Same as library            Compared items match  Temp_Decal             -          2182
226  |    -12V                    Same as library            Compared items match  Temp_Decal             -          2187
227  |    +5VA                    Same as library            Compared items match  Temp_Decal             -          2192
228  |    REFIN                   Same as library            Compared items match  common                 -          2197
229  |    REFOUT                  Same as library            Compared items match  common                 -          2202
230  |    NPCAP-V                 Same as library            Compared items match  CAP                    -          2207
231  |    NPCAP-H                 Same as library            Compared items match  CAP                    -          2212
232  |    PCAP-V                  Same as library            Compared items match  CAP                    -          2217
233  |    PCAP-H                  Same as library            Compared items match  CAP                    -          2222
234  |    RES-H                   Same as library            Compared items match  RES                    -          2227
235  |    RES-V                   Same as library            Compared items match  RES                    -          2232
236  |    IND-H                   Same as library            Compared items match  INDUCTORS              -          2237
237  |    IND-V                   Same as library            Compared items match  INDUCTORS              -          2242
238  |    TRN_BCP68T1G            Same as library            Compared items match  fets                   -          2247
239  |    IC_MPC5534MVZ80A        Same as library            Compared items match  IC                     -          2252
240  |    IC_MPC5534MVZ80B        Same as library            Compared items match  IC                     -          2257
241  |    FB-H                    Same as library            Compared items match  FERRITE_BEADS          -          2262
242  |    FB-V                    Same as library            Compared items match  FERRITE_BEADS          -          2267
243  |    MH                      Same as library            Compared items match  MISC                   -          2272
244  |    FD                      Same as library            Compared items match  MISC                   -          2277
245  |    REFBIDIR/ALT            Same as library            Compared items match  common                 -          2282
246  |    REFBIDIR                Same as library            Compared items match  common                 -          2287
247  |    REFOUT\ALT              Same as library            Compared items match  common                 -          2292
248  |    REFIN\ALT               Same as library            Compared items match  common                 -          2297
249  |    TEST_PAD                Same as library            Compared items match  MISC                   -          2302
250  |    FB-ALT-H                Same as library            Compared items match  FERRITE_BEADS          -          2307
251  |    FB-ALT-V                Same as library            Compared items match  FERRITE_BEADS          -          2312
252  |    NPCAP-ALT-V             Same as library            Compared items match  CAP                    -          2317
253  |    NPCAP-ALT-H             Same as library            Compared items match  CAP                    -          2322
254  |    PCAP-ALT-V              Same as library            Compared items match  CAP                    -          2327
255  |    PCAP-ALT-H              Same as library            Compared items match  CAP                    -          2332
256  |    RES-ALT-H               Same as library            Compared items match  RES                    -          2337
257  |    RES-ALT-V               Same as library            Compared items match  RES                    -          2342
258  |    IND-ALT-H               Same as library            Compared items match  INDUCTORS              -          2347
259  |    IND-ALT-V               Same as library            Compared items match  INDUCTORS              -          2352
260  | 
261  | Sheet No:6
262  | Sheet Name:SHEET6-MC33730
263  | 
264  |                            Design                                                                 Update
265  |    CAE Decal               Timestamp                  Content               Found in Library      Status      See Line
266  |    ----------------------  -------------------------  --------------------  --------------------  ----------  ----------
267  |    PIN                     Same as library            Compared items match  common                 -          2361
268  |    PINB                    Same as library            Compared items match  common                 -          2366
269  |    PCLK                    Same as library            Compared items match  common                 -          2371
270  |    PCLKB                   Same as library            Compared items match  common                 -          2376
271  |    PINIEB                  Same as library            Compared items match  common                 -          2381
272  |    PINORB                  Same as library            Compared items match  common                 -          2386
273  |    PINSHORT                Same as library            Compared items match  common                 -          2391
274  |    PINVRTS                 Same as library            Compared items match  common                 -          2396
275  |    PIN150                  Same as library            Compared items match  common                 -          2401
276  |    PIN150_INV              Same as library            Compared items match  common                 -          2406
277  |    PIN50                   Same as library            Compared items match  common                 -          2411
278  |    REFIN                   Same as library            Compared items match  common                 -          2416
279  |    REFOUT                  Same as library            Compared items match  common                 -          2421
280  |    GND                     Same as library            Compared items match  common                 -          2426
281  |    AGND                    Same as library            Compared items match  common                 -          2431
282  |    CHGND                   Same as library            Compared items match  common                 -          2436
283  |    +5V                     Same as library            Compared items match  Temp_Decal             -          2441
284  |    Y                       Same as library            Compared items match  Temp_Decal             -          2446
285  |    +12V                    Same as library            Compared items match  Temp_Decal             -          2451
286  |    -5V                     Same as library            Compared items match  Temp_Decal             -          2456
287  |    -12V                    Same as library            Compared items match  Temp_Decal             -          2461
288  |    +5VA                    Same as library            Compared items match  Temp_Decal             -          2466
289  |    NPCAP-V                 Same as library            Compared items match  CAP                    -          2471
290  |    NPCAP-H                 Same as library            Compared items match  CAP                    -          2476
291  |    PCAP-V                  Same as library            Compared items match  CAP                    -          2481
292  |    PCAP-H                  Same as library            Compared items match  CAP                    -          2486
293  |    RES-H                   Same as library            Compared items match  RES                    -          2491
294  |    RES-V                   Same as library            Compared items match  RES                    -          2496
295  |    IND-H                   Same as library            Compared items match  INDUCTORS              -          2501
296  |    IND-V                   Same as library            Compared items match  INDUCTORS              -          2506
297  |    TRAN_FET1               Same as library            Compared items match  fets                   -          2511
298  |    DIODE_SCTKY_H           Same as library            Compared items match  diodes                 -          2516
299  |    DIODE_SCTKY_V           Same as library            Compared items match  diodes                 -          2521
300  |    DIODE_ZEN_H             Same as library            Compared items match  diodes                 -          2526
301  |    DIODE_ZEN_V             Same as library            Compared items match  diodes                 -          2531
302  |    FB-H                    Same as library            Compared items match  FERRITE_BEADS          -          2536
303  |    FB-V                    Same as library            Compared items match  FERRITE_BEADS          -          2541
304  |    IC_MCZ33730EKR2         Same as library            Compared items match  IC                     -          2546
305  |    REFBIDIR/ALT            Same as library            Compared items match  common                 -          2551
306  |    REFBIDIR                Same as library            Compared items match  common                 -          2556
307  |    REFOUT\ALT              Same as library            Compared items match  common                 -          2561
308  |    REFIN\ALT               Same as library            Compared items match  common                 -          2566
309  |    TEST_PAD                Same as library            Compared items match  MISC                   -          2571
310  |    FB-ALT-H                Same as library            Compared items match  FERRITE_BEADS          -          2576
311  |    FB-ALT-V                Same as library            Compared items match  FERRITE_BEADS          -          2581
312  |    NPCAP-ALT-V             Same as library            Compared items match  CAP                    -          2586
313  |    NPCAP-ALT-H             Same as library            Compared items match  CAP                    -          2591
314  |    RES-ALT-H               Same as library            Compared items match  RES                    -          2596
315  |    RES-ALT-V               Same as library            Compared items match  RES                    -          2601
316  |    PCAP-ALT-V              Same as library            Compared items match  CAP                    -          2606
317  |    PCAP-ALT-H              Same as library            Compared items match  CAP                    -          2611
318  |    IND-ALT-H               Same as library            Compared items match  INDUCTORS              -          2616
319  |    IND-ALT-V               Same as library            Compared items match  INDUCTORS              -          2621
320  |    DIODE_SCTKY_ALT_H       Same as library            Compared items match  diodes                 -          2626
321  |    DIODE_SCTKY_ALT_V       Same as library            Compared items match  diodes                 -          2631
322  |    DIODE_ZEN_ALT_H         Same as library            Compared items match  diodes                 -          2636
323  |    DIODE_ZEN_ALT_V         Same as library            Compared items match  diodes                 -          2641
324  | 
325  | Sheet No:8
326  | Sheet Name:SHEET8-CPLD,EBI_BUFFERS
327  | 
328  |                            Design                                                                 Update
329  |    CAE Decal               Timestamp                  Content               Found in Library      Status      See Line
330  |    ----------------------  -------------------------  --------------------  --------------------  ----------  ----------
331  |    PIN                     Same as library            Compared items match  common                 -          2650
332  |    PINB                    Same as library            Compared items match  common                 -          2655
333  |    PCLK                    Same as library            Compared items match  common                 -          2660
334  |    PCLKB                   Same as library            Compared items match  common                 -          2665
335  |    PINIEB                  Same as library            Compared items match  common                 -          2670
336  |    PINORB                  Same as library            Compared items match  common                 -          2675
337  |    PINSHORT                Same as library            Compared items match  common                 -          2680
338  |    PINVRTS                 Same as library            Compared items match  common                 -          2685
339  |    PIN150                  Same as library            Compared items match  common                 -          2690
340  |    PIN50                   Same as library            Compared items match  common                 -          2695
341  |    +5V                     Same as library            Compared items match  Temp_Decal             -          2700
342  |    Y                       Same as library            Compared items match  Temp_Decal             -          2705
343  |    +12V                    Same as library            Compared items match  Temp_Decal             -          2710
344  |    -5V                     Same as library            Compared items match  Temp_Decal             -          2715
345  |    -12V                    Same as library            Compared items match  Temp_Decal             -          2720
346  |    +5VA                    Same as library            Compared items match  Temp_Decal             -          2725
347  |    GND                     Same as library            Compared items match  common                 -          2730
348  |    AGND                    Same as library            Compared items match  common                 -          2735
349  |    CHGND                   Same as library            Compared items match  common                 -          2740
350  |    REFIN                   Same as library            Compared items match  common                 -          2745
351  |    REFOUT                  Same as library            Compared items match  common                 -          2750
352  |    PCAP-V                  Same as library            Compared items match  CAP                    -          2755
353  |    PCAP-H                  Same as library            Compared items match  CAP                    -          2760
354  |    CON_68021-210HLF        Same as library            Compared items match  CONNECTORS             -          2765
355  |    NPCAP-V                 Same as library            Compared items match  CAP                    -          2770
356  |    NPCAP-H                 Same as library            Compared items match  CAP                    -          2775
357  |    RES-H                   Same as library            Compared items match  RES                    -          2780
358  |    RES-V                   Same as library            Compared items match  RES                    -          2785
359  |    IC_SN74LVTH245APWR      Same as library            Compared items match  IC                     -          2790
360  |    IC_EPM3064ATI44-10N     Same as library            Compared items match  IC                     -          2795
361  |    IC_SN74LVC1G32DRLR      Same as library            Compared items match  IC                     -          2800
362  |    IC_SN74AHC1G04DRLR      Same as library            Compared items match  IC                     -          2805
363  |    IC_SN74LVC1G11DCKR      Same as library            Compared items match  IC                     -          2810
364  |    IC_SN74LVC1G125DRLR     Same as library            Compared items match  IC                     -          2815
365  |    IC_SN74LVC1G08DRLR      Same as library            Compared items match  IC                     -          2820
366  |    REFBIDIR/ALT            Same as library            Compared items match  common                 -          2825
367  |    REFBIDIR                Same as library            Compared items match  common                 -          2830
368  |    REFOUT\ALT              Same as library            Compared items match  common                 -          2835
369  |    REFIN\ALT               Same as library            Compared items match  common                 -          2840
370  |    NPCAP-ALT-V             Same as library            Compared items match  CAP                    -          2845
371  |    NPCAP-ALT-H             Same as library            Compared items match  CAP                    -          2850
372  |    RES-ALT-H               Same as library            Compared items match  RES                    -          2855
373  |    RES-ALT-V               Same as library            Compared items match  RES                    -          2860
374  |    PCAP-ALT-V              Same as library            Compared items match  CAP                    -          2865
375  |    PCAP-ALT-H              Same as library            Compared items match  CAP                    -          2870
376  | 
377  | Sheet No:9
378  | Sheet Name:SHEET9-JTAG,RS485,TEMP_SENSOR,
379  | 
380  |                            Design                                                                 Update
381  |    CAE Decal               Timestamp                  Content               Found in Library      Status      See Line
382  |    ----------------------  -------------------------  --------------------  --------------------  ----------  ----------
383  |    PIN                     Same as library            Compared items match  common                 -          2879
384  |    PINB                    Same as library            Compared items match  common                 -          2884
385  |    PCLK                    Same as library            Compared items match  common                 -          2889
386  |    PCLKB                   Same as library            Compared items match  common                 -          2894
387  |    PINIEB                  Same as library            Compared items match  common                 -          2899
388  |    PINORB                  Same as library            Compared items match  common                 -          2904
389  |    PINSHORT                Same as library            Compared items match  common                 -          2909
390  |    PINVRTS                 Same as library            Compared items match  common                 -          2914
391  |    PIN150                  Same as library            Compared items match  common                 -          2919
392  |    PIN50                   Same as library            Compared items match  common                 -          2924
393  |    REFIN                   Same as library            Compared items match  common                 -          2929
394  |    REFOUT                  Same as library            Compared items match  common                 -          2934
395  |    GND                     Same as library            Compared items match  common                 -          2939
396  |    AGND                    Same as library            Compared items match  common                 -          2944
397  |    CHGND                   Same as library            Compared items match  common                 -          2949
398  |    +5V                     Same as library            Compared items match  Temp_Decal             -          2954
399  |    Y                       Same as library            Compared items match  Temp_Decal             -          2959
400  |    +12V                    Same as library            Compared items match  Temp_Decal             -          2964
401  |    -5V                     Same as library            Compared items match  Temp_Decal             -          2969
402  |    -12V                    Same as library            Compared items match  Temp_Decal             -          2974
403  |    +5VA                    Same as library            Compared items match  Temp_Decal             -          2979
404  |    PCAP-V                  Same as library            Compared items match  CAP                    -          2984
405  |    PCAP-H                  Same as library            Compared items match  CAP                    -          2989
406  |    RES-H                   Same as library            Compared items match  RES                    -          2994
407  |    RES-V                   Same as library            Compared items match  RES                    -          2999
408  |    CON_68021-214HLF        Same as library            Compared items match  CONNECTORS             -          3004
409  |    NPCAP-V                 Same as library            Compared items match  CAP                    -          3009
410  |    NPCAP-H                 Same as library            Compared items match  CAP                    -          3014
411  |    IC_CAT25160YI-G         Same as library            Compared items match  IC                     -          3019
412  |    IC_ADM3490ARZ           Same as library            Compared items match  IC                     -          3024
413  |    IC_TMP36FSZ             Same as library            Compared items match  IC                     -          3029
414  |    CON_640453-6            Same as library            Compared items match  CONNECTORS             -          3034
415  |    REFBIDIR/ALT            Same as library            Compared items match  common                 -          3039
416  |    REFBIDIR                Same as library            Compared items match  common                 -          3044
417  |    REFOUT\ALT              Same as library            Compared items match  common                 -          3049
418  |    REFIN\ALT               Same as library            Compared items match  common                 -          3054
419  |    TEST_PAD                Same as library            Compared items match  MISC                   -          3059
420  |    NPCAP-ALT-V             Same as library            Compared items match  CAP                    -          3064
421  |    NPCAP-ALT-H             Same as library            Compared items match  CAP                    -          3069
422  |    RES-ALT-H               Same as library            Compared items match  RES                    -          3074
423  |    RES-ALT-V               Same as library            Compared items match  RES                    -          3079
424  |    PCAP-ALT-V              Same as library            Compared items match  CAP                    -          3084
425  |    PCAP-ALT-H              Same as library            Compared items match  CAP                    -          3089
426  | 
427  | Sheet No:7
428  | Sheet Name:SHEET7-NOR_FLASH,SRAM,MRAM
429  | 
430  |                            Design                                                                 Update
431  |    CAE Decal               Timestamp                  Content               Found in Library      Status      See Line
432  |    ----------------------  -------------------------  --------------------  --------------------  ----------  ----------
433  |    PIN                     Same as library            Compared items match  common                 -          3098
434  |    PINB                    Same as library            Compared items match  common                 -          3103
435  |    PCLK                    Same as library            Compared items match  common                 -          3108
436  |    PCLKB                   Same as library            Compared items match  common                 -          3113
437  |    PINIEB                  Same as library            Compared items match  common                 -          3118
438  |    PINORB                  Same as library            Compared items match  common                 -          3123
439  |    PINSHORT                Same as library            Compared items match  common                 -          3128
440  |    PINVRTS                 Same as library            Compared items match  common                 -          3133
441  |    PIN150                  Same as library            Compared items match  common                 -          3138
442  |    GND                     Same as library            Compared items match  common                 -          3143
443  |    AGND                    Same as library            Compared items match  common                 -          3148
444  |    CHGND                   Same as library            Compared items match  common                 -          3153
445  |    +5V                     Same as library            Compared items match  Temp_Decal             -          3158
446  |    Y                       Same as library            Compared items match  Temp_Decal             -          3163
447  |    +12V                    Same as library            Compared items match  Temp_Decal             -          3168
448  |    -5V                     Same as library            Compared items match  Temp_Decal             -          3173
449  |    -12V                    Same as library            Compared items match  Temp_Decal             -          3178
450  |    +5VA                    Same as library            Compared items match  Temp_Decal             -          3183
451  |    REFIN                   Same as library            Compared items match  common                 -          3188
452  |    REFOUT                  Same as library            Compared items match  common                 -          3193
453  |    PCAP-V                  Same as library            Compared items match  CAP                    -          3198
454  |    PCAP-H                  Same as library            Compared items match  CAP                    -          3203
455  |    IC_S29AL008J70BFI02     Same as library            Compared items match  IC                     -          3208
456  |    NPCAP-V                 Same as library            Compared items match  CAP                    -          3213
457  |    NPCAP-H                 Same as library            Compared items match  CAP                    -          3218
458  |    IC_CY7C1051DV33-10BAXI  Same as library            Compared items match  IC                     -          3223
459  |    IC_MR4A16BCMA35         Same as library            Compared items match  IC                     -          3228
460  |    REFBIDIR/ALT            Same as library            Compared items match  common                 -          3233
461  |    REFBIDIR                Same as library            Compared items match  common                 -          3238
462  |    REFOUT\ALT              Same as library            Compared items match  common                 -          3243
463  |    REFIN\ALT               Same as library            Compared items match  common                 -          3248
464  |    PCAP-ALT-V              Same as library            Compared items match  CAP                    -          3253
465  |    PCAP-ALT-H              Same as library            Compared items match  CAP                    -          3258
466  |    NPCAP-ALT-V             Same as library            Compared items match  CAP                    -          3263
467  |    NPCAP-ALT-H             Same as library            Compared items match  CAP                    -          3268
468  | 
469  | Sheet No:10
470  | Sheet Name:SHEET10-ESC-1
471  | 
472  |                            Design                                                                 Update
473  |    CAE Decal               Timestamp                  Content               Found in Library      Status      See Line
474  |    ----------------------  -------------------------  --------------------  --------------------  ----------  ----------
475  |    PIN                     Same as library            Compared items match  common                 -          3277
476  |    PINB                    Same as library            Compared items match  common                 -          3282
477  |    PCLK                    Same as library            Compared items match  common                 -          3287
478  |    PCLKB                   Same as library            Compared items match  common                 -          3292
479  |    PINIEB                  Same as library            Compared items match  common                 -          3297
480  |    PINORB                  Same as library            Compared items match  common                 -          3302
481  |    PINSHORT                Same as library            Compared items match  common                 -          3307
482  |    PINVRTS                 Same as library            Compared items match  common                 -          3312
483  |    PIN150                  Same as library            Compared items match  common                 -          3317
484  |    PIN_CLOCK_30            Same as library            Compared items match  common                 -          3322
485  |    PIN150_INV              Same as library            Compared items match  common                 -          3327
486  |    PIN50                   Same as library            Compared items match  common                 -          3332
487  |    REFIN                   Same as library            Compared items match  common                 -          3337
488  |    REFOUT                  Same as library            Compared items match  common                 -          3342
489  |    GND                     Same as library            Compared items match  common                 -          3347
490  |    AGND                    Same as library            Compared items match  common                 -          3352
491  |    CHGND                   Same as library            Compared items match  common                 -          3357
492  |    +5V                     Same as library            Compared items match  Temp_Decal             -          3362
493  |    Y                       Same as library            Compared items match  Temp_Decal             -          3367
494  |    +12V                    Same as library            Compared items match  Temp_Decal             -          3372
495  |    -5V                     Same as library            Compared items match  Temp_Decal             -          3377
496  |    -12V                    Same as library            Compared items match  Temp_Decal             -          3382
497  |    +5VA                    Same as library            Compared items match  Temp_Decal             -          3387
498  |    NPCAP-V                 Same as library            Compared items match  CAP                    -          3392
499  |    NPCAP-H                 Same as library            Compared items match  CAP                    -          3397
500  |    RES-H                   Same as library            Compared items match  RES                    -          3402
501  |    RES-V                   Same as library            Compared items match  RES                    -          3407
502  |    IC_24LC16B-I/SN         Same as library            Compared items match  IC                     -          3412
503  |    IC_ET1100A              Same as library            Compared items match  IC                     -          3417
504  |    IC_ET1100B              Same as library            Compared items match  IC                     -          3422
505  |    REFBIDIR/ALT            Same as library            Compared items match  common                 -          3427
506  |    REFBIDIR                Same as library            Compared items match  common                 -          3432
507  |    REFOUT\ALT              Same as library            Compared items match  common                 -          3437
508  |    REFIN\ALT               Same as library            Compared items match  common                 -          3442
509  |    XTAL-25MHZ-ABM8G        Same as library            Compared items match  clock                  -          3447
510  |    TEST_PAD                Same as library            Compared items match  MISC                   -          3452
511  |    RES-ALT-H               Same as library            Compared items match  RES                    -          3457
512  |    RES-ALT-V               Same as library            Compared items match  RES                    -          3462
513  |    NPCAP-ALT-V             Same as library            Compared items match  CAP                    -          3467
514  |    NPCAP-ALT-H             Same as library            Compared items match  CAP                    -          3472
515  | 
516  | Sheet No:11
517  | Sheet Name:SHEET11-ESC-2
518  | 
519  |                            Design                                                                 Update
520  |    CAE Decal               Timestamp                  Content               Found in Library      Status      See Line
521  |    ----------------------  -------------------------  --------------------  --------------------  ----------  ----------
522  |    PIN                     Same as library            Compared items match  common                 -          3481
523  |    PINB                    Same as library            Compared items match  common                 -          3486
524  |    PCLK                    Same as library            Compared items match  common                 -          3491
525  |    PCLKB                   Same as library            Compared items match  common                 -          3496
526  |    PINIEB                  Same as library            Compared items match  common                 -          3501
527  |    PINORB                  Same as library            Compared items match  common                 -          3506
528  |    PINSHORT                Same as library            Compared items match  common                 -          3511
529  |    PINVRTS                 Same as library            Compared items match  common                 -          3516
530  |    PIN150                  Same as library            Compared items match  common                 -          3521
531  |    PIN_CLOCK_30            Same as library            Compared items match  common                 -          3526
532  |    PIN150_INV              Same as library            Compared items match  common                 -          3531
533  |    PIN50                   Same as library            Compared items match  common                 -          3536
534  |    REFIN                   Same as library            Compared items match  common                 -          3541
535  |    REFOUT                  Same as library            Compared items match  common                 -          3546
536  |    GND                     Same as library            Compared items match  common                 -          3551
537  |    AGND                    Same as library            Compared items match  common                 -          3556
538  |    CHGND                   Same as library            Compared items match  common                 -          3561
539  |    +5V                     Same as library            Compared items match  Temp_Decal             -          3566
540  |    Y                       Same as library            Compared items match  Temp_Decal             -          3571
541  |    +12V                    Same as library            Compared items match  Temp_Decal             -          3576
542  |    -5V                     Same as library            Compared items match  Temp_Decal             -          3581
543  |    -12V                    Same as library            Compared items match  Temp_Decal             -          3586
544  |    +5VA                    Same as library            Compared items match  Temp_Decal             -          3591
545  |    RES-H                   Same as library            Compared items match  RES                    -          3596
546  |    RES-V                   Same as library            Compared items match  RES                    -          3601
547  |    NPCAP-V                 Same as library            Compared items match  CAP                    -          3606
548  |    NPCAP-H                 Same as library            Compared items match  CAP                    -          3611
549  |    IC_24LC16B-I/SN         Same as library            Compared items match  IC                     -          3616
550  |    IC_ET1100A              Same as library            Compared items match  IC                     -          3621
551  |    IC_ET1100B              Same as library            Compared items match  IC                     -          3626
552  |    REFBIDIR/ALT            Same as library            Compared items match  common                 -          3631
553  |    REFBIDIR                Same as library            Compared items match  common                 -          3636
554  |    REFOUT\ALT              Same as library            Compared items match  common                 -          3641
555  |    REFIN\ALT               Same as library            Compared items match  common                 -          3646
556  |    XTAL-25MHZ-ABM8G        Same as library            Compared items match  clock                  -          3651
557  |    TEST_PAD                Same as library            Compared items match  MISC                   -          3656
558  |    RES-ALT-H               Same as library            Compared items match  RES                    -          3661
559  |    RES-ALT-V               Same as library            Compared items match  RES                    -          3666
560  |    NPCAP-ALT-V             Same as library            Compared items match  CAP                    -          3671
561  |    NPCAP-ALT-H             Same as library            Compared items match  CAP                    -          3676
562  | 
563  | Sheet No:12
564  | Sheet Name:SHEET12-ESC_POWER
565  | 
566  |                            Design                                                                 Update
567  |    CAE Decal               Timestamp                  Content               Found in Library      Status      See Line
568  |    ----------------------  -------------------------  --------------------  --------------------  ----------  ----------
569  |    PIN                     Same as library            Compared items match  common                 -          3685
570  |    PINB                    Same as library            Compared items match  common                 -          3690
571  |    PCLK                    Same as library            Compared items match  common                 -          3695
572  |    PCLKB                   Same as library            Compared items match  common                 -          3700
573  |    PINIEB                  Same as library            Compared items match  common                 -          3705
574  |    PINORB                  Same as library            Compared items match  common                 -          3710
575  |    PINSHORT                Same as library            Compared items match  common                 -          3715
576  |    PINVRTS                 Same as library            Compared items match  common                 -          3720
577  |    PIN_CLOCK_30            Same as library            Compared items match  common                 -          3725
578  |    PIN150                  Same as library            Compared items match  common                 -          3730
579  |    PIN150_INV              Same as library            Compared items match  common                 -          3735
580  |    REFIN                   Same as library            Compared items match  common                 -          3740
581  |    REFOUT                  Same as library            Compared items match  common                 -          3745
582  |    GND                     Same as library            Compared items match  common                 -          3750
583  |    AGND                    Same as library            Compared items match  common                 -          3755
584  |    CHGND                   Same as library            Compared items match  common                 -          3760
585  |    +5V                     Same as library            Compared items match  Temp_Decal             -          3765
586  |    Y                       Same as library            Compared items match  Temp_Decal             -          3770
587  |    +12V                    Same as library            Compared items match  Temp_Decal             -          3775
588  |    -5V                     Same as library            Compared items match  Temp_Decal             -          3780
589  |    -12V                    Same as library            Compared items match  Temp_Decal             -          3785
590  |    +5VA                    Same as library            Compared items match  Temp_Decal             -          3790
591  |    NPCAP-V                 Same as library            Compared items match  CAP                    -          3795
592  |    NPCAP-H                 Same as library            Compared items match  CAP                    -          3800
593  |    IC_ET1100A              Same as library            Compared items match  IC                     -          3805
594  |    IC_ET1100B              Same as library            Compared items match  IC                     -          3810
595  |    REFBIDIR/ALT            Same as library            Compared items match  common                 -          3815
596  |    REFBIDIR                Same as library            Compared items match  common                 -          3820
597  |    REFOUT\ALT              Same as library            Compared items match  common                 -          3825
598  |    REFIN\ALT               Same as library            Compared items match  common                 -          3830
599  |    NPCAP-ALT-V             Same as library            Compared items match  CAP                    -          3835
600  |    NPCAP-ALT-H             Same as library            Compared items match  CAP                    -          3840
601  | 
602  | Sheet No:13
603  | Sheet Name:SHEET13-RESET,POWER
604  | 
605  |                            Design                                                                 Update
606  |    CAE Decal               Timestamp                  Content               Found in Library      Status      See Line
607  |    ----------------------  -------------------------  --------------------  --------------------  ----------  ----------
608  |    PIN                     Same as library            Compared items match  common                 -          3849
609  |    PINB                    Same as library            Compared items match  common                 -          3854
610  |    PCLK                    Same as library            Compared items match  common                 -          3859
611  |    PCLKB                   Same as library            Compared items match  common                 -          3864
612  |    PINIEB                  Same as library            Compared items match  common                 -          3869
613  |    PINORB                  Same as library            Compared items match  common                 -          3874
614  |    PINSHORT                Same as library            Compared items match  common                 -          3879
615  |    PINVRTS                 Same as library            Compared items match  common                 -          3884
616  |    PIN_CLOCK_30            Same as library            Compared items match  common                 -          3889
617  |    PIN150                  Same as library            Compared items match  common                 -          3894
618  |    PIN50                   Same as library            Compared items match  common                 -          3899
619  |    REFIN                   Same as library            Compared items match  common                 -          3904
620  |    REFOUT                  Same as library            Compared items match  common                 -          3909
621  |    GND                     Same as library            Compared items match  common                 -          3914
622  |    AGND                    Same as library            Compared items match  common                 -          3919
623  |    CHGND                   Same as library            Compared items match  common                 -          3924
624  |    +5V                     Same as library            Compared items match  Temp_Decal             -          3929
625  |    Y                       Same as library            Compared items match  Temp_Decal             -          3934
626  |    +12V                    Same as library            Compared items match  Temp_Decal             -          3939
627  |    -5V                     Same as library            Compared items match  Temp_Decal             -          3944
628  |    -12V                    Same as library            Compared items match  Temp_Decal             -          3949
629  |    +5VA                    Same as library            Compared items match  Temp_Decal             -          3954
630  |    NPCAP-V                 Same as library            Compared items match  CAP                    -          3959
631  |    NPCAP-H                 Same as library            Compared items match  CAP                    -          3964
632  |    PCAP-V                  Same as library            Compared items match  CAP                    -          3969
633  |    PCAP-H                  Same as library            Compared items match  CAP                    -          3974
634  |    RES-H                   Same as library            Compared items match  RES                    -          3979
635  |    RES-V                   Same as library            Compared items match  RES                    -          3984
636  |    IND-H                   Same as library            Compared items match  INDUCTORS              -          3989
637  |    IND-V                   Same as library            Compared items match  INDUCTORS              -          3994
638  |    DIODE_SCTKY_H           Same as library            Compared items match  diodes                 -          3999
639  |    DIODE_SCTKY_V           Same as library            Compared items match  diodes                 -          4004
640  |    IC_LTC2918              Same as library            Compared items match  IC                     -          4009
641  |    IC_AD822ARMZ-A1         Same as library            Compared items match  IC                     -          4014
642  |    IC_AD822ARMZ-A2         Same as library            Compared items match  IC                     -          4019
643  |    IC_AD822ARMZ-B1         Same as library            Compared items match  IC                     -          4024
644  |    IC_AD822ARMZ-B2         Same as library            Compared items match  IC                     -          4029
645  |    IC_AD822ARMZ-C          Same as library            Compared items match  IC                     -          4034
646  |    IC_TPS54231DR           Same as library            Compared items match  IC                     -          4039
647  |    REFBIDIR/ALT            Same as library            Compared items match  common                 -          4044
648  |    REFBIDIR                Same as library            Compared items match  common                 -          4049
649  |    REFOUT\ALT              Same as library            Compared items match  common                 -          4054
650  |    REFIN\ALT               Same as library            Compared items match  common                 -          4059
651  |    TEST_PAD                Same as library            Compared items match  MISC                   -          4064
652  |    NPCAP-ALT-V             Same as library            Compared items match  CAP                    -          4069
653  |    NPCAP-ALT-H             Same as library            Compared items match  CAP                    -          4074
654  |    RES-ALT-H               Same as library            Compared items match  RES                    -          4079
655  |    RES-ALT-V               Same as library            Compared items match  RES                    -          4084
656  |    IND-ALT-H               Same as library            Compared items match  INDUCTORS              -          4089
657  |    IND-ALT-V               Same as library            Compared items match  INDUCTORS              -          4094
658  |    PCAP-ALT-V              Same as library            Compared items match  CAP                    -          4099
659  |    PCAP-ALT-H              Same as library            Compared items match  CAP                    -          4104
660  |    DIODE_SCTKY_ALT_H       Same as library            Compared items match  diodes                 -          4109
661  |    DIODE_SCTKY_ALT_V       Same as library            Compared items match  diodes                 -          4114
662  | 
663  | Sheet No:4
664  | Sheet Name:SHEET4-MPC-CONFIGURATIONS
665  | 
666  |                            Design                                                                 Update
667  |    CAE Decal               Timestamp                  Content               Found in Library      Status      See Line
668  |    ----------------------  -------------------------  --------------------  --------------------  ----------  ----------
669  |    PIN                     Same as library            Compared items match  common                 -          4123
670  |    PINB                    Same as library            Compared items match  common                 -          4128
671  |    PCLK                    Same as library            Compared items match  common                 -          4133
672  |    PCLKB                   Same as library            Compared items match  common                 -          4138
673  |    PINIEB                  Same as library            Compared items match  common                 -          4143
674  |    PINORB                  Same as library            Compared items match  common                 -          4148
675  |    PINSHORT                Same as library            Compared items match  common                 -          4153
676  |    PINVRTS                 Same as library            Compared items match  common                 -          4158
677  |    PIN_CLOCK_30            Same as library            Compared items match  common                 -          4163
678  |    PIN150                  Same as library            Compared items match  common                 -          4168
679  |    PIN150_INV              Same as library            Compared items match  common                 -          4173
680  |    REFIN                   Same as library            Compared items match  common                 -          4178
681  |    REFOUT                  Same as library            Compared items match  common                 -          4183
682  |    GND                     Same as library            Compared items match  common                 -          4188
683  |    AGND                    Same as library            Compared items match  common                 -          4193
684  |    CHGND                   Same as library            Compared items match  common                 -          4198
685  |    +5V                     Same as library            Compared items match  Temp_Decal             -          4203
686  |    Y                       Same as library            Compared items match  Temp_Decal             -          4208
687  |    +12V                    Same as library            Compared items match  Temp_Decal             -          4213
688  |    -5V                     Same as library            Compared items match  Temp_Decal             -          4218
689  |    -12V                    Same as library            Compared items match  Temp_Decal             -          4223
690  |    +5VA                    Same as library            Compared items match  Temp_Decal             -          4228
691  |    RES-H                   Same as library            Compared items match  RES                    -          4233
692  |    RES-V                   Same as library            Compared items match  RES                    -          4238
693  |    IC_74LV125A             Same as library            Compared items match  IC                     -          4243
694  |    IC_74LV125B             Same as library            Compared items match  IC                     -          4248
695  |    IC_74LV125C             Same as library            Compared items match  IC                     -          4253
696  |    IC_74LV125D             Same as library            Compared items match  IC                     -          4258
697  |    REFBIDIR/ALT            Same as library            Compared items match  common                 -          4263
698  |    REFBIDIR                Same as library            Compared items match  common                 -          4268
699  |    REFOUT\ALT              Same as library            Compared items match  common                 -          4273
700  |    REFIN\ALT               Same as library            Compared items match  common                 -          4278
701  |    RES-ALT-H               Same as library            Compared items match  RES                    -          4283
702  |    RES-ALT-V               Same as library            Compared items match  RES                    -          4288
703  | 
704  | Sheet No:1
705  | Sheet Name:SHEET1-TITLE
706  | 
707  |                            Design                                                                 Update
708  |    CAE Decal               Timestamp                  Content               Found in Library      Status      See Line
709  |    ----------------------  -------------------------  --------------------  --------------------  ----------  ----------
710  |    PIN                     Same as library            Compared items match  common                 -          4297
711  |    PINB                    Same as library            Compared items match  common                 -          4302
712  |    PCLK                    Same as library            Compared items match  common                 -          4307
713  |    PCLKB                   Same as library            Compared items match  common                 -          4312
714  |    PINIEB                  Same as library            Compared items match  common                 -          4317
715  |    PINORB                  Same as library            Compared items match  common                 -          4322
716  |    PINSHORT                Same as library            Compared items match  common                 -          4327
717  |    PINVRTS                 Same as library            Compared items match  common                 -          4332
718  |    PIN_CLOCK_30            Same as library            Compared items match  common                 -          4337
719  |    REFIN                   Same as library            Compared items match  common                 -          4342
720  |    REFOUT                  Same as library            Compared items match  common                 -          4347
721  |    REFIN\ALT               Same as library            Compared items match  common                 -          4352
722  |    REFOUT\ALT              Same as library            Compared items match  common                 -          4357
723  |    REFBIDIR                Same as library            Compared items match  common                 -          4362
724  |    REFBIDIR/ALT            Same as library            Compared items match  common                 -          4367
725  |    GND                     Same as library            Compared items match  common                 -          4372
726  |    AGND                    Same as library            Compared items match  common                 -          4377
727  |    CHGND                   Same as library            Compared items match  common                 -          4382
728  |    +5V                     Same as library            Compared items match  Temp_Decal             -          4387
729  |    Y                       Same as library            Compared items match  Temp_Decal             -          4392
730  |    +12V                    Same as library            Compared items match  Temp_Decal             -          4397
731  |    -5V                     Same as library            Compared items match  Temp_Decal             -          4402
732  |    -12V                    Same as library            Compared items match  Temp_Decal             -          4407
733  |    +5VA                    Same as library            Compared items match  Temp_Decal             -          4412
734  | 
735  | Sheet No:14
736  | Sheet Name:SHEET14-CONNECTOR
737  | 
738  |                            Design                                                                 Update
739  |    CAE Decal               Timestamp                  Content               Found in Library      Status      See Line
740  |    ----------------------  -------------------------  --------------------  --------------------  ----------  ----------
741  |    PIN                     Same as library            Compared items match  common                 -          4421
742  |    PINB                    Same as library            Compared items match  common                 -          4426
743  |    PCLK                    Same as library            Compared items match  common                 -          4431
744  |    PCLKB                   Same as library            Compared items match  common                 -          4436
745  |    PINIEB                  Same as library            Compared items match  common                 -          4441
746  |    PINORB                  Same as library            Compared items match  common                 -          4446
747  |    PINSHORT                Same as library            Compared items match  common                 -          4451
748  |    PINVRTS                 Same as library            Compared items match  common                 -          4456
749  |    PIN_CLOCK_30            Same as library            Compared items match  common                 -          4461
750  |    PIN150                  Same as library            Compared items match  common                 -          4466
751  |    PIN50                   Same as library            Compared items match  common                 -          4471
752  |    REFIN                   Same as library            Compared items match  common                 -          4476
753  |    REFOUT                  Same as library            Compared items match  common                 -          4481
754  |    REFIN\ALT               Same as library            Compared items match  common                 -          4486
755  |    REFOUT\ALT              Same as library            Compared items match  common                 -          4491
756  |    REFBIDIR                Same as library            Compared items match  common                 -          4496
757  |    REFBIDIR/ALT            Same as library            Compared items match  common                 -          4501
758  |    GND                     Same as library            Compared items match  common                 -          4506
759  |    AGND                    Same as library            Compared items match  common                 -          4511
760  |    CHGND                   Same as library            Compared items match  common                 -          4516
761  |    +5V                     Same as library            Compared items match  Temp_Decal             -          4521
762  |    Y                       Same as library            Compared items match  Temp_Decal             -          4526
763  |    +12V                    Same as library            Compared items match  Temp_Decal             -          4531
764  |    -5V                     Same as library            Compared items match  Temp_Decal             -          4536
765  |    -12V                    Same as library            Compared items match  Temp_Decal             -          4541
766  |    +5VA                    Same as library            Compared items match  Temp_Decal             -          4546
767  |    CON-QSE-040-01-L-D-A    Same as library            Compared items match  CONNECTORS             -          4551
768  |    NPCAP-V                 Same as library            Compared items match  CAP                    -          4556
769  |    NPCAP-H                 Same as library            Compared items match  CAP                    -          4561
770  |    RES-H                   Same as library            Compared items match  RES                    -          4566
771  |    RES-V                   Same as library            Compared items match  RES                    -          4571
772  |    IC_SN74LVC1G07DRLR      Same as library            Compared items match  IC                     -          4576
773  |    CON_5767054-1           Same as library            Compared items match  CONNECTORS             -          4581
774  |    TEST_PAD                Same as library            Compared items match  MISC                   -          4586
775  |    NPCAP-ALT-V             Same as library            Compared items match  CAP                    -          4591
776  |    NPCAP-ALT-H             Same as library            Compared items match  CAP                    -          4596
777  |    RES-ALT-H               Same as library            Compared items match  RES                    -          4601
778  |    RES-ALT-V               Same as library            Compared items match  RES                    -          4606
779  | 
780  | Sheet No:2
781  | Sheet Name:SHEET2-BLOCK-DIAGRAM
782  | 
783  |                            Design                                                                 Update
784  |    CAE Decal               Timestamp                  Content               Found in Library      Status      See Line
785  |    ----------------------  -------------------------  --------------------  --------------------  ----------  ----------
786  |    PIN                     Same as library            Compared items match  common                 -          4615
787  |    PINB                    Same as library            Compared items match  common                 -          4620
788  |    PCLK                    Same as library            Compared items match  common                 -          4625
789  |    PCLKB                   Same as library            Compared items match  common                 -          4630
790  |    PINIEB                  Same as library            Compared items match  common                 -          4635
791  |    PINORB                  Same as library            Compared items match  common                 -          4640
792  |    PINSHORT                Same as library            Compared items match  common                 -          4645
793  |    PINVRTS                 Same as library            Compared items match  common                 -          4650
794  |    PIN_CLOCK_30            Same as library            Compared items match  common                 -          4655
795  |    REFIN                   Same as library            Compared items match  common                 -          4660
796  |    REFOUT                  Same as library            Compared items match  common                 -          4665
797  |    REFIN\ALT               Same as library            Compared items match  common                 -          4670
798  |    REFOUT\ALT              Same as library            Compared items match  common                 -          4675
799  |    REFBIDIR                Same as library            Compared items match  common                 -          4680
800  |    REFBIDIR/ALT            Same as library            Compared items match  common                 -          4685
801  |    GND                     Same as library            Compared items match  common                 -          4690
802  |    AGND                    Same as library            Compared items match  common                 -          4695
803  |    CHGND                   Same as library            Compared items match  common                 -          4700
804  |    +5V                     Same as library            Compared items match  Temp_Decal             -          4705
805  |    Y                       Same as library            Compared items match  Temp_Decal             -          4710
806  |    +12V                    Same as library            Compared items match  Temp_Decal             -          4715
807  |    -5V                     Same as library            Compared items match  Temp_Decal             -          4720
808  |    -12V                    Same as library            Compared items match  Temp_Decal             -          4725
809  |    +5VA                    Same as library            Compared items match  Temp_Decal             -          4730
810  | 
811  | ------------------
812  | Compared $OSR_SYMS
813  | ------------------
814  | 
815  | $OSR_SYMS Package is Same as library
816  | 
817  | Sheet No:3
818  | Sheet Name:SHEET3-MPC5534
819  | 
820  |                                Design                                           Update
821  |    Symbol                      Timestamp                  Content               Status      See Line
822  |    --------------------------  -------------------------  --------------------  ----------  ----------
823  |    REFIN:Source                Same as library            Compared items match   -          4747
824  |    REFOUT:Load                 Same as library            Compared items match   -          4750
825  |    REFBIDIR/ALT:Bidirectional  Same as library            Compared items match   -          4753
826  |    REFBIDIR:Bidirectional      Same as library            Compared items match   -          4756
827  |    REFOUT\ALT:Load             Same as library            Compared items match   -          4759
828  |    REFIN\ALT:Source            Same as library            Compared items match   -          4762
829  | 
830  | Sheet No:5
831  | Sheet Name:SHEET5-MPC5534_POWER
832  | 
833  |                                Design                                           Update
834  |    Symbol                      Timestamp                  Content               Status      See Line
835  |    --------------------------  -------------------------  --------------------  ----------  ----------
836  |    REFIN:Source                Same as library            Compared items match   -          4771
837  |    REFOUT:Load                 Same as library            Compared items match   -          4774
838  |    REFBIDIR/ALT:Bidirectional  Same as library            Compared items match   -          4777
839  |    REFBIDIR:Bidirectional      Same as library            Compared items match   -          4780
840  |    REFOUT\ALT:Load             Same as library            Compared items match   -          4783
841  |    REFIN\ALT:Source            Same as library            Compared items match   -          4786
842  | 
843  | Sheet No:6
844  | Sheet Name:SHEET6-MC33730
845  | 
846  |                                Design                                           Update
847  |    Symbol                      Timestamp                  Content               Status      See Line
848  |    --------------------------  -------------------------  --------------------  ----------  ----------
849  |    REFIN:Source                Same as library            Compared items match   -          4795
850  |    REFOUT:Load                 Same as library            Compared items match   -          4798
851  |    REFBIDIR/ALT:Bidirectional  Same as library            Compared items match   -          4801
852  |    REFBIDIR:Bidirectional      Same as library            Compared items match   -          4804
853  |    REFOUT\ALT:Load             Same as library            Compared items match   -          4807
854  |    REFIN\ALT:Source            Same as library            Compared items match   -          4810
855  | 
856  | Sheet No:8
857  | Sheet Name:SHEET8-CPLD,EBI_BUFFERS
858  | 
859  |                                Design                                           Update
860  |    Symbol                      Timestamp                  Content               Status      See Line
861  |    --------------------------  -------------------------  --------------------  ----------  ----------
862  |    REFIN:Source                Same as library            Compared items match   -          4819
863  |    REFOUT:Load                 Same as library            Compared items match   -          4822
864  |    REFBIDIR/ALT:Bidirectional  Same as library            Compared items match   -          4825
865  |    REFBIDIR:Bidirectional      Same as library            Compared items match   -          4828
866  |    REFOUT\ALT:Load             Same as library            Compared items match   -          4831
867  |    REFIN\ALT:Source            Same as library            Compared items match   -          4834
868  | 
869  | Sheet No:9
870  | Sheet Name:SHEET9-JTAG,RS485,TEMP_SENSOR,
871  | 
872  |                                Design                                           Update
873  |    Symbol                      Timestamp                  Content               Status      See Line
874  |    --------------------------  -------------------------  --------------------  ----------  ----------
875  |    REFIN:Source                Same as library            Compared items match   -          4843
876  |    REFOUT:Load                 Same as library            Compared items match   -          4846
877  |    REFBIDIR/ALT:Bidirectional  Same as library            Compared items match   -          4849
878  |    REFBIDIR:Bidirectional      Same as library            Compared items match   -          4852
879  |    REFOUT\ALT:Load             Same as library            Compared items match   -          4855
880  |    REFIN\ALT:Source            Same as library            Compared items match   -          4858
881  | 
882  | Sheet No:7
883  | Sheet Name:SHEET7-NOR_FLASH,SRAM,MRAM
884  | 
885  |                                Design                                           Update
886  |    Symbol                      Timestamp                  Content               Status      See Line
887  |    --------------------------  -------------------------  --------------------  ----------  ----------
888  |    REFIN:Source                Same as library            Compared items match   -          4867
889  |    REFOUT:Load                 Same as library            Compared items match   -          4870
890  |    REFBIDIR/ALT:Bidirectional  Same as library            Compared items match   -          4873
891  |    REFBIDIR:Bidirectional      Same as library            Compared items match   -          4876
892  |    REFOUT\ALT:Load             Same as library            Compared items match   -          4879
893  |    REFIN\ALT:Source            Same as library            Compared items match   -          4882
894  | 
895  | Sheet No:10
896  | Sheet Name:SHEET10-ESC-1
897  | 
898  |                                Design                                           Update
899  |    Symbol                      Timestamp                  Content               Status      See Line
900  |    --------------------------  -------------------------  --------------------  ----------  ----------
901  |    REFIN:Source                Same as library            Compared items match   -          4891
902  |    REFOUT:Load                 Same as library            Compared items match   -          4894
903  |    REFBIDIR/ALT:Bidirectional  Same as library            Compared items match   -          4897
904  |    REFBIDIR:Bidirectional      Same as library            Compared items match   -          4900
905  |    REFOUT\ALT:Load             Same as library            Compared items match   -          4903
906  |    REFIN\ALT:Source            Same as library            Compared items match   -          4906
907  | 
908  | Sheet No:11
909  | Sheet Name:SHEET11-ESC-2
910  | 
911  |                                Design                                           Update
912  |    Symbol                      Timestamp                  Content               Status      See Line
913  |    --------------------------  -------------------------  --------------------  ----------  ----------
914  |    REFIN:Source                Same as library            Compared items match   -          4915
915  |    REFOUT:Load                 Same as library            Compared items match   -          4918
916  |    REFBIDIR/ALT:Bidirectional  Same as library            Compared items match   -          4921
917  |    REFBIDIR:Bidirectional      Same as library            Compared items match   -          4924
918  |    REFOUT\ALT:Load             Same as library            Compared items match   -          4927
919  |    REFIN\ALT:Source            Same as library            Compared items match   -          4930
920  | 
921  | Sheet No:12
922  | Sheet Name:SHEET12-ESC_POWER
923  | 
924  |                                Design                                           Update
925  |    Symbol                      Timestamp                  Content               Status      See Line
926  |    --------------------------  -------------------------  --------------------  ----------  ----------
927  |    REFIN:Source                Same as library            Compared items match   -          4939
928  |    REFOUT:Load                 Same as library            Compared items match   -          4942
929  |    REFBIDIR/ALT:Bidirectional  Same as library            Compared items match   -          4945
930  |    REFBIDIR:Bidirectional      Same as library            Compared items match   -          4948
931  |    REFOUT\ALT:Load             Same as library            Compared items match   -          4951
932  |    REFIN\ALT:Source            Same as library            Compared items match   -          4954
933  | 
934  | Sheet No:13
935  | Sheet Name:SHEET13-RESET,POWER
936  | 
937  |                                Design                                           Update
938  |    Symbol                      Timestamp                  Content               Status      See Line
939  |    --------------------------  -------------------------  --------------------  ----------  ----------
940  |    REFIN:Source                Same as library            Compared items match   -          4963
941  |    REFOUT:Load                 Same as library            Compared items match   -          4966
942  |    REFBIDIR/ALT:Bidirectional  Same as library            Compared items match   -          4969
943  |    REFBIDIR:Bidirectional      Same as library            Compared items match   -          4972
944  |    REFOUT\ALT:Load             Same as library            Compared items match   -          4975
945  |    REFIN\ALT:Source            Same as library            Compared items match   -          4978
946  | 
947  | Sheet No:4
948  | Sheet Name:SHEET4-MPC-CONFIGURATIONS
949  | 
950  |                                Design                                           Update
951  |    Symbol                      Timestamp                  Content               Status      See Line
952  |    --------------------------  -------------------------  --------------------  ----------  ----------
953  |    REFIN:Source                Same as library            Compared items match   -          4987
954  |    REFOUT:Load                 Same as library            Compared items match   -          4990
955  |    REFBIDIR/ALT:Bidirectional  Same as library            Compared items match   -          4993
956  |    REFBIDIR:Bidirectional      Same as library            Compared items match   -          4996
957  |    REFOUT\ALT:Load             Same as library            Compared items match   -          4999
958  |    REFIN\ALT:Source            Same as library            Compared items match   -          5002
959  | 
960  | Sheet No:1
961  | Sheet Name:SHEET1-TITLE
962  | 
963  |                                Design                                           Update
964  |    Symbol                      Timestamp                  Content               Status      See Line
965  |    --------------------------  -------------------------  --------------------  ----------  ----------
966  |    REFIN:Source                Same as library            Compared items match   -          5011
967  |    REFOUT:Load                 Same as library            Compared items match   -          5014
968  |    REFBIDIR/ALT:Bidirectional  Same as library            Compared items match   -          5017
969  |    REFBIDIR:Bidirectional      Same as library            Compared items match   -          5020
970  |    REFOUT\ALT:Load             Same as library            Compared items match   -          5023
971  |    REFIN\ALT:Source            Same as library            Compared items match   -          5026
972  | 
973  | Sheet No:14
974  | Sheet Name:SHEET14-CONNECTOR
975  | 
976  |                                Design                                           Update
977  |    Symbol                      Timestamp                  Content               Status      See Line
978  |    --------------------------  -------------------------  --------------------  ----------  ----------
979  |    REFIN:Source                Same as library            Compared items match   -          5035
980  |    REFOUT:Load                 Same as library            Compared items match   -          5038
981  |    REFBIDIR/ALT:Bidirectional  Same as library            Compared items match   -          5041
982  |    REFBIDIR:Bidirectional      Same as library            Compared items match   -          5044
983  |    REFOUT\ALT:Load             Same as library            Compared items match   -          5047
984  |    REFIN\ALT:Source            Same as library            Compared items match   -          5050
985  | 
986  | Sheet No:2
987  | Sheet Name:SHEET2-BLOCK-DIAGRAM
988  | 
989  |                                Design                                           Update
990  |    Symbol                      Timestamp                  Content               Status      See Line
991  |    --------------------------  -------------------------  --------------------  ----------  ----------
992  |    REFIN:Source                Same as library            Compared items match   -          5059
993  |    REFOUT:Load                 Same as library            Compared items match   -          5062
994  |    REFBIDIR/ALT:Bidirectional  Same as library            Compared items match   -          5065
995  |    REFBIDIR:Bidirectional      Same as library            Compared items match   -          5068
996  |    REFOUT\ALT:Load             Same as library            Compared items match   -          5071
997  |    REFIN\ALT:Source            Same as library            Compared items match   -          5074
998  | 
999  | ------------------
1000 | Compared $GND_SYMS
1001 | ------------------
1002 | 
1003 | $GND_SYMS Package is Same as library
1004 | 
1005 | Sheet No:3
1006 | Sheet Name:SHEET3-MPC5534
1007 | 
1008 |                                Design                                           Update
1009 |    Symbol                      Timestamp                  Content               Status      See Line
1010 |    --------------------------  -------------------------  --------------------  ----------  ----------
1011 |    GND:GND                     Same as library            Compared items match   -          5089
1012 |    AGND:AGND                   Same as library            Compared items match   -          5092
1013 |    CHGND:CHGND                 Same as library            Compared items match   -          5095
1014 | 
1015 | Sheet No:5
1016 | Sheet Name:SHEET5-MPC5534_POWER
1017 | 
1018 |                                Design                                           Update
1019 |    Symbol                      Timestamp                  Content               Status      See Line
1020 |    --------------------------  -------------------------  --------------------  ----------  ----------
1021 |    GND:GND                     Same as library            Compared items match   -          5104
1022 |    AGND:AGND                   Same as library            Compared items match   -          5107
1023 |    CHGND:CHGND                 Same as library            Compared items match   -          5110
1024 | 
1025 | Sheet No:6
1026 | Sheet Name:SHEET6-MC33730
1027 | 
1028 |                                Design                                           Update
1029 |    Symbol                      Timestamp                  Content               Status      See Line
1030 |    --------------------------  -------------------------  --------------------  ----------  ----------
1031 |    GND:GND                     Same as library            Compared items match   -          5119
1032 |    AGND:AGND                   Same as library            Compared items match   -          5122
1033 |    CHGND:CHGND                 Same as library            Compared items match   -          5125
1034 | 
1035 | Sheet No:8
1036 | Sheet Name:SHEET8-CPLD,EBI_BUFFERS
1037 | 
1038 |                                Design                                           Update
1039 |    Symbol                      Timestamp                  Content               Status      See Line
1040 |    --------------------------  -------------------------  --------------------  ----------  ----------
1041 |    GND:GND                     Same as library            Compared items match   -          5134
1042 |    AGND:AGND                   Same as library            Compared items match   -          5137
1043 |    CHGND:CHGND                 Same as library            Compared items match   -          5140
1044 | 
1045 | Sheet No:9
1046 | Sheet Name:SHEET9-JTAG,RS485,TEMP_SENSOR,
1047 | 
1048 |                                Design                                           Update
1049 |    Symbol                      Timestamp                  Content               Status      See Line
1050 |    --------------------------  -------------------------  --------------------  ----------  ----------
1051 |    GND:GND                     Same as library            Compared items match   -          5149
1052 |    AGND:AGND                   Same as library            Compared items match   -          5152
1053 |    CHGND:CHGND                 Same as library            Compared items match   -          5155
1054 | 
1055 | Sheet No:7
1056 | Sheet Name:SHEET7-NOR_FLASH,SRAM,MRAM
1057 | 
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
1120 |    --------------------------  -------------------------  --------------------  ----------  ----------
1121 |    GND:GND                     Same as library            Compared items match   -          5254
1122 |    AGND:AGND                   Same as library            Compared items match   -          5257
1123 |    CHGND:CHGND                 Same as library            Compared items match   -          5260
1124 | 
1125 | Sheet No:14
1126 | Sheet Name:SHEET14-CONNECTOR
1127 | 
1128 |                                Design                                           Update
1129 |    Symbol                      Timestamp                  Content               Status      See Line
1130 |    --------------------------  -------------------------  --------------------  ----------  ----------
1131 |    GND:GND                     Same as library            Compared items match   -          5269
1132 |    AGND:AGND                   Same as library            Compared items match   -          5272
1133 |    CHGND:CHGND                 Same as library            Compared items match   -          5275
1134 | 
1135 | Sheet No:2
1136 | Sheet Name:SHEET2-BLOCK-DIAGRAM
1137 | 
1138 |                                Design                                           Update
1139 |    Symbol                      Timestamp                  Content               Status      See Line
1140 |    --------------------------  -------------------------  --------------------  ----------  ----------
1141 |    GND:GND                     Same as library            Compared items match   -          5284
1142 |    AGND:AGND                   Same as library            Compared items match   -          5287
1143 |    CHGND:CHGND                 Same as library            Compared items match   -          5290
1144 | 
1145 | ------------------
1146 | Compared $PWR_SYMS
1147 | ------------------
1148 | 
1149 | $PWR_SYMS Package is Same as library
1150 | 
1151 | Sheet No:3
1152 | Sheet Name:SHEET3-MPC5534
1153 | 
1154 |                                Design                                           Update
1155 |    Symbol                      Timestamp                  Content               Status      See Line
1156 |    --------------------------  -------------------------  --------------------  ----------  ----------
1157 |    +5V:+5V                     Same as library            Compared items match   -          5305
1158 |    Y:+5V                       Same as library            Compared items match   -          5308
1159 |    +12V:+12V                   Same as library            Compared items match   -          5311
1160 |    -5V:-5V                     Same as library            Compared items match   -          5314
1161 |    -12V:-12V                   Same as library            Compared items match   -          5317
1162 |    +5VA:+5VA                   Same as library            Compared items match   -          5320
1163 | 
1164 | Sheet No:5
1165 | Sheet Name:SHEET5-MPC5534_POWER
1166 | 
1167 |                                Design                                           Update
1168 |    Symbol                      Timestamp                  Content               Status      See Line
1169 |    --------------------------  -------------------------  --------------------  ----------  ----------
1170 |    +5V:+5V                     Same as library            Compared items match   -          5329
1171 |    Y:+5V                       Same as library            Compared items match   -          5332
1172 |    +12V:+12V                   Same as library            Compared items match   -          5335
1173 |    -5V:-5V                     Same as library            Compared items match   -          5338
1174 |    -12V:-12V                   Same as library            Compared items match   -          5341
1175 |    +5VA:+5VA                   Same as library            Compared items match   -          5344
1176 | 
1177 | Sheet No:6
1178 | Sheet Name:SHEET6-MC33730
1179 | 
1180 |                                Design                                           Update
1181 |    Symbol                      Timestamp                  Content               Status      See Line
1182 |    --------------------------  -------------------------  --------------------  ----------  ----------
1183 |    +5V:+5V                     Same as library            Compared items match   -          5353
1184 |    Y:+5V                       Same as library            Compared items match   -          5356
1185 |    +12V:+12V                   Same as library            Compared items match   -          5359
1186 |    -5V:-5V                     Same as library            Compared items match   -          5362
1187 |    -12V:-12V                   Same as library            Compared items match   -          5365
1188 |    +5VA:+5VA                   Same as library            Compared items match   -          5368
1189 | 
1190 | Sheet No:8
1191 | Sheet Name:SHEET8-CPLD,EBI_BUFFERS
1192 | 
1193 |                                Design                                           Update
1194 |    Symbol                      Timestamp                  Content               Status      See Line
1195 |    --------------------------  -------------------------  --------------------  ----------  ----------
1196 |    +5V:+5V                     Same as library            Compared items match   -          5377
1197 |    Y:+5V                       Same as library            Compared items match   -          5380
1198 |    +12V:+12V                   Same as library            Compared items match   -          5383
1199 |    -5V:-5V                     Same as library            Compared items match   -          5386
1200 |    -12V:-12V                   Same as library            Compared items match   -          5389
1201 |    +5VA:+5VA                   Same as library            Compared items match   -          5392
1202 | 
1203 | Sheet No:9
1204 | Sheet Name:SHEET9-JTAG,RS485,TEMP_SENSOR,
1205 | 
1206 |                                Design                                           Update
1207 |    Symbol                      Timestamp                  Content               Status      See Line
1208 |    --------------------------  -------------------------  --------------------  ----------  ----------
1209 |    +5V:+5V                     Same as library            Compared items match   -          5401
1210 |    Y:+5V                       Same as library            Compared items match   -          5404
1211 |    +12V:+12V                   Same as library            Compared items match   -          5407
1212 |    -5V:-5V                     Same as library            Compared items match   -          5410
1213 |    -12V:-12V                   Same as library            Compared items match   -          5413
1214 |    +5VA:+5VA                   Same as library            Compared items match   -          5416
1215 | 
1216 | Sheet No:7
1217 | Sheet Name:SHEET7-NOR_FLASH,SRAM,MRAM
1218 | 
1219 |                                Design                                           Update
1220 |    Symbol                      Timestamp                  Content               Status      See Line
1221 |    --------------------------  -------------------------  --------------------  ----------  ----------
1222 |    +5V:+5V                     Same as library            Compared items match   -          5425
1223 |    Y:+5V                       Same as library            Compared items match   -          5428
1224 |    +12V:+12V                   Same as library            Compared items match   -          5431
1225 |    -5V:-5V                     Same as library            Compared items match   -          5434
1226 |    -12V:-12V                   Same as library            Compared items match   -          5437
1227 |    +5VA:+5VA                   Same as library            Compared items match   -          5440
1228 | 
1229 | Sheet No:10
1230 | Sheet Name:SHEET10-ESC-1
1231 | 
1232 |                                Design                                           Update
1233 |    Symbol                      Timestamp                  Content               Status      See Line
1234 |    --------------------------  -------------------------  --------------------  ----------  ----------
1235 |    +5V:+5V                     Same as library            Compared items match   -          5449
1236 |    Y:+5V                       Same as library            Compared items match   -          5452
1237 |    +12V:+12V                   Same as library            Compared items match   -          5455
1238 |    -5V:-5V                     Same as library            Compared items match   -          5458
1239 |    -12V:-12V                   Same as library            Compared items match   -          5461
1240 |    +5VA:+5VA                   Same as library            Compared items match   -          5464
1241 | 
1242 | Sheet No:11
1243 | Sheet Name:SHEET11-ESC-2
1244 | 
1245 |                                Design                                           Update
1246 |    Symbol                      Timestamp                  Content               Status      See Line
1247 |    --------------------------  -------------------------  --------------------  ----------  ----------
1248 |    +5V:+5V                     Same as library            Compared items match   -          5473
1249 |    Y:+5V                       Same as library            Compared items match   -          5476
1250 |    +12V:+12V                   Same as library            Compared items match   -          5479
1251 |    -5V:-5V                     Same as library            Compared items match   -          5482
1252 |    -12V:-12V                   Same as library            Compared items match   -          5485
1253 |    +5VA:+5VA                   Same as library            Compared items match   -          5488
1254 | 
1255 | Sheet No:12
1256 | Sheet Name:SHEET12-ESC_POWER
1257 | 
1258 |                                Design                                           Update
1259 |    Symbol                      Timestamp                  Content               Status      See Line
1260 |    --------------------------  -------------------------  --------------------  ----------  ----------
1261 |    +5V:+5V                     Same as library            Compared items match   -          5497
1262 |    Y:+5V                       Same as library            Compared items match   -          5500
1263 |    +12V:+12V                   Same as library            Compared items match   -          5503
1264 |    -5V:-5V                     Same as library            Compared items match   -          5506
1265 |    -12V:-12V                   Same as library            Compared items match   -          5509
1266 |    +5VA:+5VA                   Same as library            Compared items match   -          5512
1267 | 
1268 | Sheet No:13
1269 | Sheet Name:SHEET13-RESET,POWER
1270 | 
1271 |                                Design                                           Update
1272 |    Symbol                      Timestamp                  Content               Status      See Line
1273 |    --------------------------  -------------------------  --------------------  ----------  ----------
1274 |    +5V:+5V                     Same as library            Compared items match   -          5521
1275 |    Y:+5V                       Same as library            Compared items match   -          5524
1276 |    +12V:+12V                   Same as library            Compared items match   -          5527
1277 |    -5V:-5V                     Same as library            Compared items match   -          5530
1278 |    -12V:-12V                   Same as library            Compared items match   -          5533
1279 |    +5VA:+5VA                   Same as library            Compared items match   -          5536
1280 | 
1281 | Sheet No:4
1282 | Sheet Name:SHEET4-MPC-CONFIGURATIONS
1283 | 
1284 |                                Design                                           Update
1285 |    Symbol                      Timestamp                  Content               Status      See Line
1286 |    --------------------------  -------------------------  --------------------  ----------  ----------
1287 |    +5V:+5V                     Same as library            Compared items match   -          5545
1288 |    Y:+5V                       Same as library            Compared items match   -          5548
1289 |    +12V:+12V                   Same as library            Compared items match   -          5551
1290 |    -5V:-5V                     Same as library            Compared items match   -          5554
1291 |    -12V:-12V                   Same as library            Compared items match   -          5557
1292 |    +5VA:+5VA                   Same as library            Compared items match   -          5560
1293 | 
1294 | Sheet No:1
1295 | Sheet Name:SHEET1-TITLE
1296 | 
1297 |                                Design                                           Update
1298 |    Symbol                      Timestamp                  Content               Status      See Line
1299 |    --------------------------  -------------------------  --------------------  ----------  ----------
1300 |    +5V:+5V                     Same as library            Compared items match   -          5569
1301 |    Y:+5V                       Same as library            Compared items match   -          5572
1302 |    +12V:+12V                   Same as library            Compared items match   -          5575
1303 |    -5V:-5V                     Same as library            Compared items match   -          5578
1304 |    -12V:-12V                   Same as library            Compared items match   -          5581
1305 |    +5VA:+5VA                   Same as library            Compared items match   -          5584
1306 | 
1307 | Sheet No:14
1308 | Sheet Name:SHEET14-CONNECTOR
1309 | 
1310 |                                Design                                           Update
1311 |    Symbol                      Timestamp                  Content               Status      See Line
1312 |    --------------------------  -------------------------  --------------------  ----------  ----------
1313 |    +5V:+5V                     Same as library            Compared items match   -          5593
1314 |    Y:+5V                       Same as library            Compared items match   -          5596
1315 |    +12V:+12V                   Same as library            Compared items match   -          5599
1316 |    -5V:-5V                     Same as library            Compared items match   -          5602
1317 |    -12V:-12V                   Same as library            Compared items match   -          5605
1318 |    +5VA:+5VA                   Same as library            Compared items match   -          5608
1319 | 
1320 | Sheet No:2
1321 | Sheet Name:SHEET2-BLOCK-DIAGRAM
1322 | 
1323 |                                Design                                           Update
1324 |    Symbol                      Timestamp                  Content               Status      See Line
1325 |    --------------------------  -------------------------  --------------------  ----------  ----------
1326 |    +5V:+5V                     Same as library            Compared items match   -          5617
1327 |    Y:+5V                       Same as library            Compared items match   -          5620
1328 |    +12V:+12V                   Same as library            Compared items match   -          5623
1329 |    -5V:-5V                     Same as library            Compared items match   -          5626
1330 |    -12V:-12V                   Same as library            Compared items match   -          5629
1331 |    +5VA:+5VA                   Same as library            Compared items match   -          5632
1332 | 
1333 | 
1334 | ==========================================================================================
1335 | REPORT DETAILS
1336 | ==========================================================================================
1337 | 
1338 | ----------------
1339 | -= Part Types =-
1340 | ----------------
1341 | 
1342 | CAP-15PF-50V-0603-0.5%-C0603C150D5GACTU
1343 | ----------------------------------------
1344 |  Part Type Timestamp:                             Same as library
1345 |  Library:                                         CAP
1346 | 
1347 | RES-100E-R0603-RC0603FR-07100RL
1348 | --------------------------------
1349 |  Part Type Timestamp:                             Same as library
1350 |  Library:                                         RES
1351 | 
1352 | FBD-0805-BLM21PG331SN1D
1353 | ------------------------
1354 |  Part Type Timestamp:                             Same as library
1355 |  Library:                                         FERRITE_BEADS
1356 | 
1357 | CAP-0.1UF-50V-0603-10%-06035C104KAT2A
1358 | --------------------------------------
1359 |  Part Type Timestamp:                             Same as library
1360 |  Library:                                         CAP
1361 | 
1362 | RES-4.7K-R0603-RC0603FR-074K7L
1363 | -------------------------------
1364 |  Part Type Timestamp:                             Same as library
1365 |  Library:                                         RES
1366 |  Details:
1367 |   Attributes Details:
1368 |     R17 Design Attribute                          Not in library
1369 |       Name:  Loading
1370 |       Value: DNI
1371 |     R18 Design Attribute                          Not in library
1372 |       Name:  Loading
1373 |       Value: DNI
1374 |     R21 Design Attribute                          Not in library
1375 |       Name:  Loading
1376 |       Value: DNI
1377 |     R22 Design Attribute                          Not in library
1378 |       Name:  Loading
1379 |       Value: DNI
1380 |     R24 Design Attribute                          Not in library
1381 |       Name:  Loading
1382 |       Value: DNI
1383 |     R27 Design Attribute                          Not in library
1384 |       Name:  Loading
1385 |       Value: DNI
1386 | 
1387 | RES-0E-R0603-RC0603JR-070RL
1388 | ----------------------------
1389 |  Part Type Timestamp:                             Same as library
1390 |  Library:                                         RES
1391 |  Details:
1392 |   Attributes Details:
1393 |     R100 Design Attribute                         Not in library
1394 |       Name:  Loading
1395 |       Value: DNI
1396 |     R121 Design Attribute                         Not in library
1397 |       Name:  Loading
1398 |       Value: DNI
1399 |     R122 Design Attribute                         Not in library
1400 |       Name:  Loading
1401 |       Value: DNI
1402 | 
1403 | XTAL-2-SMD-ABM7-8.000MHZ-D2Y-T
1404 | -------------------------------
1405 |  Part Type Timestamp:                             Same as library
1406 |  Library:                                         clock
1407 | 
1408 | IC-MCU-208MAPBGA-MPC5534MVZ80
1409 | ------------------------------
1410 |  Part Type Timestamp:                             Same as library
1411 |  Library:                                         IC
1412 |  Details:
1413 |   PCB Decal Details:
1414 |     U1-A Name: PBGA_324P_1MM                      Same as library
1415 |       Pin Count: 324                              WARNING
1416 |         Design:  324
1417 |         Library: 326
1418 |     U1-B Name: PBGA_324P_1MM                      Same as library
1419 |       Pin Count: 324                              WARNING
1420 |         Design:  324
1421 |         Library: 326
1422 | 
1423 | RES-10K-R0603-RC0603FR-0710KL
1424 | ------------------------------
1425 |  Part Type Timestamp:                             Same as library
1426 |  Library:                                         RES
1427 | 
1428 | RES-10M-R0805-RK73B2ATTD106J
1429 | -----------------------------
1430 |  Part Type Timestamp:                             Same as library
1431 |  Library:                                         RES
1432 |  Details:
1433 |   Attributes Details:
1434 |     R94 Design Attribute                          Not in library
1435 |       Name:  Loading
1436 |       Value: DNI
1437 | 
1438 | RES-33E-R1506-YC248-JR-0733RL
1439 | ------------------------------
1440 |  Part Type Timestamp:                             Same as library
1441 |  Library:                                         RES
1442 | 
1443 | OSC-4-SMD-ASDMB-8.000MHZ-LY-T
1444 | ------------------------------
1445 |  Part Type Timestamp:                             Same as library
1446 |  Library:                                         clock
1447 | 
1448 | MEC-TPD-#
1449 | ----------
1450 |  Part Type Timestamp:                             Same as library
1451 |  Library:                                         MISC
1452 | 
1453 | CAP-0.01UF-10V-0306-10%-0306ZC103KAT2A
1454 | ---------------------------------------
1455 |  Part Type Timestamp:                             Same as library
1456 |  Library:                                         Temporary
1457 | 
1458 | CAP-10UF-25V-0805-10%-GRM21BR61E106KA73L
1459 | -----------------------------------------
1460 |  Part Type Timestamp:                             Same as library
1461 |  Library:                                         CAP
1462 | 
1463 | CAP-10UF-16V-1206-10%-TAJA106K016RNJ
1464 | -------------------------------------
1465 |  Part Type Timestamp:                             Same as library
1466 |  Library:                                         CAP
1467 | 
1468 | RES-0E-R1210-CRCW12100000Z0EA
1469 | ------------------------------
1470 |  Part Type Timestamp:                             Same as library
1471 |  Library:                                         RES
1472 |  Details:
1473 |   Attributes Details:
1474 |     R88 Design Attribute                          Not in library
1475 |       Name:  Loading
1476 |       Value: DNI
1477 | 
1478 | RES-1.21E-R2512-SR733ATTE1R21F
1479 | -------------------------------
1480 |  Part Type Timestamp:                             Same as library
1481 |  Library:                                         RES
1482 | 
1483 | IND-IMC1210ER100K
1484 | ------------------
1485 |  Part Type Timestamp:                             Same as library
1486 |  Library:                                         INDUCTORS
1487 | 
1488 | TRN-SOT-223-BCP68T1G
1489 | ---------------------
1490 |  Part Type Timestamp:                             Same as library
1491 |  Library:                                         fets
1492 | 
1493 | CAP-1UF-50V-0603-10%-UMK107BJ105KA-T
1494 | -------------------------------------
1495 |  Part Type Timestamp:                             Same as library
1496 |  Library:                                         CAP
1497 | 
1498 | MEC-MH-#
1499 | ---------
1500 |  Part Type Timestamp:                             Same as library
1501 |  Library:                                         MISC
1502 | 
1503 | MEC-FD-#
1504 | ---------
1505 |  Part Type Timestamp:                             Same as library
1506 |  Library:                                         MISC
1507 | 
1508 | CAP-1UF-50V-0805-10%-C0805C103K5RACTU
1509 | --------------------------------------
1510 |  Part Type Timestamp:                             Same as library
1511 |  Library:                                         CAP
1512 | 
1513 | CAP-2200PF-50V-0603-10%-GRM188R61H222KA#
1514 | -----------------------------------------
1515 |  Part Type Timestamp:                             Same as library
1516 |  Library:                                         CAP
1517 | 
1518 | CAP-39PF-50V-0402-5%-04025A390JAT2A
1519 | ------------------------------------
1520 |  Part Type Timestamp:                             Same as library
1521 |  Library:                                         CAP
1522 | 
1523 | CAP-0.01UF-16V-0402-10%-0402YC103KAT2A
1524 | ---------------------------------------
1525 |  Part Type Timestamp:                             Same as library
1526 |  Library:                                         CAP
1527 | 
1528 | CAP-22UF-25V-2312-10%-TPSC226K025R0275
1529 | ---------------------------------------
1530 |  Part Type Timestamp:                             Same as library
1531 |  Library:                                         CAP
1532 | 
1533 | RES-47K-R0603-RC0603FR-0747KL
1534 | ------------------------------
1535 |  Part Type Timestamp:                             Same as library
1536 |  Library:                                         RES
1537 | 
1538 | RES-18K-R0603-RC0603FR-0718KL
1539 | ------------------------------
1540 |  Part Type Timestamp:                             Same as library
1541 |  Library:                                         RES
1542 | 
1543 | RES-430E-R0603-RC0603FR-07430RL
1544 | --------------------------------
1545 |  Part Type Timestamp:                             Same as library
1546 |  Library:                                         RES
1547 | 
1548 | IND-IHLP2525CZER100M01
1549 | -----------------------
1550 |  Part Type Timestamp:                             Same as library
1551 |  Library:                                         INDUCTORS
1552 | 
1553 | IND-IHLP3232DZER220M11
1554 | -----------------------
1555 |  Part Type Timestamp:                             Same as library
1556 |  Library:                                         INDUCTORS
1557 | 
1558 | IND-IHLP2020BZER3R3M01
1559 | -----------------------
1560 |  Part Type Timestamp:                             Same as library
1561 |  Library:                                         INDUCTORS
1562 | 
1563 | TRN-DPAK-NJD2873T4G
1564 | --------------------
1565 |  Part Type Timestamp:                             Same as library
1566 |  Library:                                         fets
1567 | 
1568 | DIO-DO-214AB-SS36-E3/57T
1569 | -------------------------
1570 |  Part Type Timestamp:                             Same as library
1571 |  Library:                                         diodes
1572 | 
1573 | DIO-SMB-SMBJ40A
1574 | ----------------
1575 |  Part Type Timestamp:                             Same as library
1576 |  Library:                                         diodes
1577 | 
1578 | IC-REGULATOR-32-SOIC-MCZ33730EKR2
1579 | ----------------------------------
1580 |  Part Type Timestamp:                             Same as library
1581 |  Library:                                         IC
1582 | 
1583 | RES-24K-R0603-RC0603FR-0724KL
1584 | ------------------------------
1585 |  Part Type Timestamp:                             Same as library
1586 |  Library:                                         RES
1587 | 
1588 | CAP-100UF-20V-2917-10%-TPSE107K020R0150
1589 | ----------------------------------------
1590 |  Part Type Timestamp:                             Same as library
1591 |  Library:                                         CAP
1592 | 
1593 | CON-TH_RA-2X5-68021-210HLF
1594 | ---------------------------
1595 |  Part Type Timestamp:                             Same as library
1596 |  Library:                                         CONNECTORS
1597 | 
1598 | IC-TRNSCVR-20-TSSOP-SN74LVTH245APWR
1599 | ------------------------------------
1600 |  Part Type Timestamp:                             Same as library
1601 |  Library:                                         IC
1602 | 
1603 | IC-CPLD-44-TQFP-EPM3064ATI44-10N
1604 | ---------------------------------
1605 |  Part Type Timestamp:                             Same as library
1606 |  Library:                                         IC
1607 | 
1608 | IC-ORGATE-SOT-553-SN74LVC1G32DRLR
1609 | ----------------------------------
1610 |  Part Type Timestamp:                             Same as library
1611 |  Library:                                         IC
1612 | 
1613 | IC-INVERTER-SOT-553-SN74AHC1G04DRLR
1614 | ------------------------------------
1615 |  Part Type Timestamp:                             Same as library
1616 |  Library:                                         IC
1617 | 
1618 | IC-ANDGATE-SC-70-6-SN74LVC1G11DCKR
1619 | -----------------------------------
1620 |  Part Type Timestamp:                             Same as library
1621 |  Library:                                         IC
1622 | 
1623 | IC-BUFFER-SOT-553-SN74LVC1G125DRLR
1624 | -----------------------------------
1625 |  Part Type Timestamp:                             Same as library
1626 |  Library:                                         IC
1627 | 
1628 | IC-ANDGATE-SOT-553-SN74LVC1G08DRLR
1629 | -----------------------------------
1630 |  Part Type Timestamp:                             Same as library
1631 |  Library:                                         IC
1632 | 
1633 | RES-120E-R0603-RC0603FR-07120RL
1634 | --------------------------------
1635 |  Part Type Timestamp:                             Same as library
1636 |  Library:                                         RES
1637 | 
1638 | CON-TH_RA-2X7-68021-214HLF
1639 | ---------------------------
1640 |  Part Type Timestamp:                             Same as library
1641 |  Library:                                         CONNECTORS
1642 | 
1643 | RES-1K-R0603-RC0603FR-071KL
1644 | ----------------------------
1645 |  Part Type Timestamp:                             Same as library
1646 |  Library:                                         RES
1647 | 
1648 | IC-EEPROM-8TSSOP-CAT25160YI-G
1649 | ------------------------------
1650 |  Part Type Timestamp:                             Same as library
1651 |  Library:                                         IC
1652 | 
1653 | IC-RS422/485-TRNSCVR-8-SOIC-ADM3490ARZ
1654 | ---------------------------------------
1655 |  Part Type Timestamp:                             Same as library
1656 |  Library:                                         IC
1657 | 
1658 | IC-SENSOR-8-SOIC-TMP36FSZ
1659 | --------------------------
1660 |  Part Type Timestamp:                             Same as library
1661 |  Library:                                         IC
1662 | 
1663 | CON-TH_RA-1X6-640453-6
1664 | -----------------------
1665 |  Part Type Timestamp:                             Same as library
1666 |  Library:                                         CONNECTORS
1667 | 
1668 | IC-FLASH-BGA-48-S29AL008J70BFI02
1669 | ---------------------------------
1670 |  Part Type Timestamp:                             Same as library
1671 |  Library:                                         IC
1672 |  Details:
1673 |   PCB Decal Details:
1674 |     U10 Name: BGA_48P_0.8                         Same as library
1675 |       Pin Count: 48                               WARNING
1676 |         Design:  48
1677 |         Library: 50
1678 | 
1679 | IC-RAM-48LFBGA-CY7C1051DV33-10BAXI
1680 | -----------------------------------
1681 |  Part Type Timestamp:                             Same as library
1682 |  Library:                                         IC
1683 |  Details:
1684 |   PCB Decal Details:
1685 |     U11 Name: FBGA_48P_0.75_S                     Same as library
1686 |       Pin Count: 48                               WARNING
1687 |         Design:  48
1688 |         Library: 50
1689 | 
1690 | IC-RAM-48FBGA-MR4A16BCMA35
1691 | ---------------------------
1692 |  Part Type Timestamp:                             Same as library
1693 |  Library:                                         IC
1694 |  Details:
1695 |   PCB Decal Details:
1696 |     U14 Name: FBGA_48P_0.75                       Same as library
1697 |       Pin Count: 48                               WARNING
1698 |         Design:  48
1699 |         Library: 50
1700 | 
1701 | CAP-12PF-50V-0603-5%-06035A120JAT2A
1702 | ------------------------------------
1703 |  Part Type Timestamp:                             Same as library
1704 |  Library:                                         CAP
1705 | 
1706 | RES-4.7K-R0402-ERJ-2RKF4701X
1707 | -----------------------------
1708 |  Part Type Timestamp:                             Same as library
1709 |  Library:                                         RES
1710 | 
1711 | RES-11K-R0603-RC0603FR-0711KL
1712 | ------------------------------
1713 |  Part Type Timestamp:                             Same as library
1714 |  Library:                                         RES
1715 | 
1716 | IC-EEPROM-8-SOIC-24LC16B-I/SN
1717 | ------------------------------
1718 |  Part Type Timestamp:                             Same as library
1719 |  Library:                                         IC
1720 | 
1721 | IC-ETHERCATCNTRLR-BGA128-ET1100
1722 | --------------------------------
1723 |  Part Type Timestamp:                             Same as library
1724 |  Library:                                         IC
1725 |  Details:
1726 |   PCB Decal Details:
1727 |     U15-A Name: BGA128C80P12X12_1100X1100X130     Same as library
1728 |       Pin Count: 128                              WARNING
1729 |         Design:  128
1730 |         Library: 130
1731 |     U19-A Name: BGA128C80P12X12_1100X1100X130     Same as library
1732 |       Pin Count: 128                              WARNING
1733 |         Design:  128
1734 |         Library: 130
1735 |     U19-B Name: BGA128C80P12X12_1100X1100X130     Same as library
1736 |       Pin Count: 128                              WARNING
1737 |         Design:  128
1738 |         Library: 130
1739 |     U15-B Name: BGA128C80P12X12_1100X1100X130     Same as library
1740 |       Pin Count: 128                              WARNING
1741 |         Design:  128
1742 |         Library: 130
1743 | 
1744 | XTAL-4-SMD-ABM11-25.000MHZ-B7G-T
1745 | ---------------------------------
1746 |  Part Type Timestamp:                             Same as library
1747 |  Library:                                         clock
1748 | 
1749 | CAP-0.1UF-10V-0402-10%-0402ZD104KAT2A
1750 | --------------------------------------
1751 |  Part Type Timestamp:                             Same as library
1752 |  Library:                                         CAP
1753 | 
1754 | CAP-220PF-10V-01005-10%-C0402X5R1A221K
1755 | ---------------------------------------
1756 |  Part Type Timestamp:                             Same as library
1757 |  Library:                                         CAP
1758 | 
1759 | CAP-6800PF-50V-0603-5%-C0603C682J5GACTU
1760 | ----------------------------------------
1761 |  Part Type Timestamp:                             Same as library
1762 |  Library:                                         CAP
1763 | 
1764 | CAP-47PF-50V-0603-5%-06035A470JAT2A
1765 | ------------------------------------
1766 |  Part Type Timestamp:                             Same as library
1767 |  Library:                                         CAP
1768 | 
1769 | CAP-1000PF-50V-0603-5%-C0603C102J5GACTU
1770 | ----------------------------------------
1771 |  Part Type Timestamp:                             Same as library
1772 |  Library:                                         CAP
1773 | 
1774 | CAP-47UF-10V-1411-20%-T520B476M010ATE035
1775 | -----------------------------------------
1776 |  Part Type Timestamp:                             Same as library
1777 |  Library:                                         CAP
1778 | 
1779 | RES-10.2K-R0805-RC0805FR-0710K2L
1780 | ---------------------------------
1781 |  Part Type Timestamp:                             Same as library
1782 |  Library:                                         RES
1783 | 
1784 | RES-3.24K-R0805-RC0805FR-073K24L
1785 | ---------------------------------
1786 |  Part Type Timestamp:                             Same as library
1787 |  Library:                                         RES
1788 | 
1789 | RES-29.4K-R0805-RC0805FR-0729K4L
1790 | ---------------------------------
1791 |  Part Type Timestamp:                             Same as library
1792 |  Library:                                         RES
1793 | 
1794 | RES-332K-R0805-RC0805FR-07332KL
1795 | --------------------------------
1796 |  Part Type Timestamp:                             Same as library
1797 |  Library:                                         RES
1798 | 
1799 | RES-100K-R0805-RC0805FR-07100KL
1800 | --------------------------------
1801 |  Part Type Timestamp:                             Same as library
1802 |  Library:                                         RES
1803 | 
1804 | DIO-DO-214AC-B240A-13-F
1805 | ------------------------
1806 |  Part Type Timestamp:                             Same as library
1807 |  Library:                                         diodes
1808 | 
1809 | IC-TIMER-10MSOP-LTC2918IMS-B1#PBF
1810 | ----------------------------------
1811 |  Part Type Timestamp:                             Same as library
1812 |  Library:                                         IC
1813 | 
1814 | IC-OPAMP-8-MSOP-AD822ARMZ-REEL
1815 | -------------------------------
1816 |  Part Type Timestamp:                             Same as library
1817 |  Library:                                         IC
1818 | 
1819 | IC-DCCONV-8-SOIC-TPS54231DR
1820 | ----------------------------
1821 |  Part Type Timestamp:                             Same as library
1822 |  Library:                                         IC
1823 | 
1824 | RES-300E-R0603-RC0603FR-07300RL
1825 | --------------------------------
1826 |  Part Type Timestamp:                             Same as library
1827 |  Library:                                         RES
1828 | 
1829 | IC-BUFFER-14TSSOP-74LV125PW
1830 | ----------------------------
1831 |  Part Type Timestamp:                             Same as library
1832 |  Library:                                         IC
1833 | 
1834 | CON-SMT-2X40-QSE-040-01-L-D-A
1835 | ------------------------------
1836 |  Part Type Timestamp:                             Same as library
1837 |  Library:                                         CONNECTORS
1838 |  Details:
1839 |   PCB Decal Details:
1840 |     J6 Name: QTE-040-02-X-D-A                     Same as library
1841 |       Pin Count: 88                               WARNING
1842 |         Design:  88
1843 |         Library: 90
1844 |     J5 Name: QTE-040-02-X-D-A                     Same as library
1845 |       Pin Count: 88                               WARNING
1846 |         Design:  88
1847 |         Library: 90
1848 | 
1849 | IC-BUFFER-SOT-553-SN74LVC1G07DRLR
1850 | ----------------------------------
1851 |  Part Type Timestamp:                             Same as library
1852 |  Library:                                         IC
1853 | 
1854 | CON-SMT-2X19-5767054-1
1855 | -----------------------
1856 |  Part Type Timestamp:                             Same as library
1857 |  Library:                                         CONNECTORS
1858 |  Details:
1859 |   PCB Decal Details:
1860 |     J1 Name: CON_38P_25_TE                        Same as library
1861 |       Pin Count: 43                               WARNING
1862 |         Design:  43
1863 |         Library: 44
1864 |     J2 Name: CON_38P_25_TE                        Same as library
1865 |       Pin Count: 43                               WARNING
1866 |         Design:  43
1867 |         Library: 44
1868 | 
1869 | 
1870 | ----------------
1871 | -= CAE Decals =-
1872 | ----------------
1873 | 
1874 | 
1875 | Sheet No:    3
1876 | Sheet Name:  SHEET3-MPC5534
1877 | 
1878 | PIN
1879 | ----
1880 |  CAE Decal Timestamp:                   Same as library
1881 |  Library:                               common
1882 | 
1883 | PINB
1884 | -----
1885 |  CAE Decal Timestamp:                   Same as library
1886 |  Library:                               common
1887 | 
1888 | PCLK
1889 | -----
1890 |  CAE Decal Timestamp:                   Same as library
1891 |  Library:                               common
1892 | 
1893 | PCLKB
1894 | ------
1895 |  CAE Decal Timestamp:                   Same as library
1896 |  Library:                               common
1897 | 
1898 | PINIEB
1899 | -------
1900 |  CAE Decal Timestamp:                   Same as library
1901 |  Library:                               common
1902 | 
1903 | PINORB
1904 | -------
1905 |  CAE Decal Timestamp:                   Same as library
1906 |  Library:                               common
1907 | 
1908 | PINSHORT
1909 | ---------
1910 |  CAE Decal Timestamp:                   Same as library
1911 |  Library:                               common
1912 | 
1913 | PINVRTS
1914 | --------
1915 |  CAE Decal Timestamp:                   Same as library
1916 |  Library:                               common
1917 | 
1918 | PIN150
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
