Sayidathahaseen/CCC_NGP_ODC/NGP_ODC_Main/PDLC/Mechanical/NGP_CCC Final files on dt-lohiths/Solidworks _Final files/Back Plane Assy/CORRECTION/Body-1.JPG

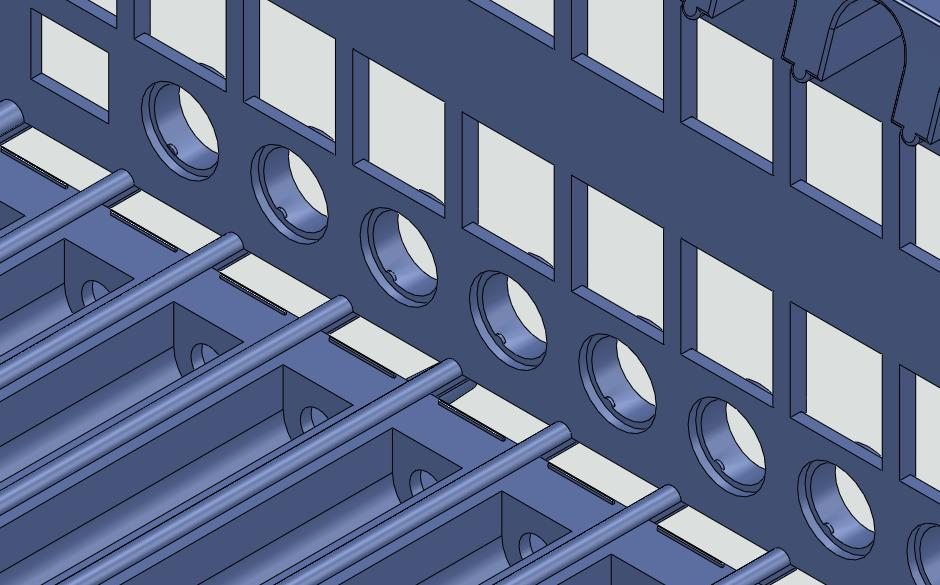
NGP_ODC_Main/PDLC/Mechanical/NGP_CCC Final files on dt-lohiths/Solidworks _Final files/Back Plane Assy/CORRECTION/Body-1.JPG
