Sayidathahaseen/CCC_NGP_ODC/NGP_ODC_Main/PDLC/Prodigy HW files/MTBF/REV_B/WITH FUSE HOLDERS/GRAPHS/MTBF_TEMPERATURE.bmp

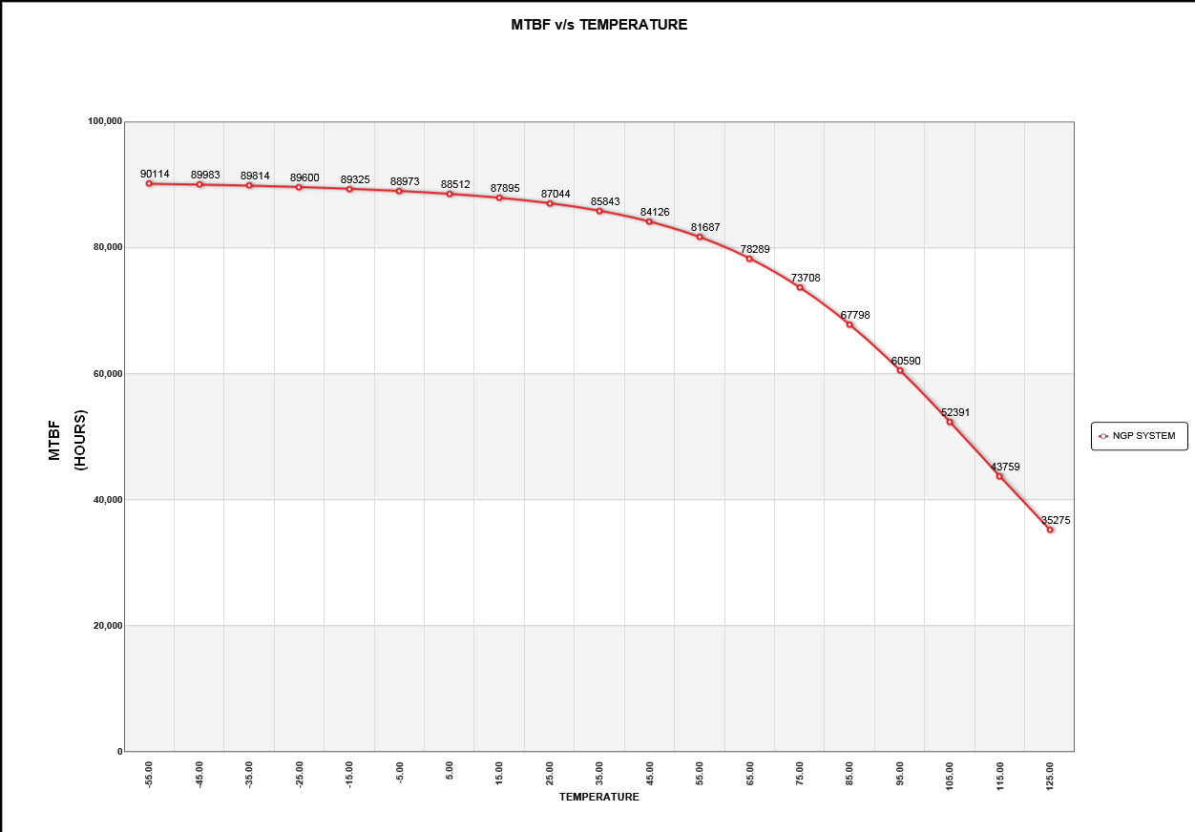
NGP_ODC_Main/PDLC/Prodigy HW files/MTBF/REV_B/WITH FUSE HOLDERS/GRAPHS/MTBF_TEMPERATURE.bmp
