Sayidathahaseen/CCC_NGP_ODC/NGP_ODC_Main/PDLC/S5M-IES/2nd 20 Sets Order/Gerber/IESrC/README.TXT

COMPRESSOR CONTROLS CORPORATION
DES MOINES, IOWA
2/14/2013

LUKE BROWN
PH:   (515) 251-2707
FAX:  (515) 334-2500
Home PH: 515-789-4528
CELL  (515) 326-5289

BOARD NAME:    S5M IES Rev. B
BOARD NUMBER:  17-425400-001 Rev B 
FILE DESCRIPTIONS:  (??=PHYSICAL LAYER, **=DOCUMENTATION LAYER)
    XX.PHO    COPPER LAYER XX
    SMT??**.PHO    SOLDER MASK TOP
    SMB??**.PHO    SOLDER MASK BOTTOM
    SST.XXX   SILK SCREEN BOTTOM
    SSB.XXX   SILK SCREEN TOP 
    NCDRILL.*       DRILL INFORMATION
    drilldrawing.*    DRILL DRAWING
    *.REP         INDIVIDUAL APERTURE REPORT FILES
    IESrc.REP    COMBINED APERTURE LIST
    PMB.*	  PASTE mASK BOTTOM
    PMT.*	  PASTE mASK TOP
    README.TXT    THIS FILE

LIST OF FILES SUPPLIED
=============================================================================
02/13/2013  03:35 PM           722,434 art01.pho
02/13/2013  03:35 PM             2,044 art01.rep
02/13/2013  03:36 PM           429,761 art02.pho
02/13/2013  03:36 PM               586 art02.rep
02/13/2013  03:36 PM           458,691 art03.pho
02/13/2013  03:36 PM               469 art03.rep
02/13/2013  03:36 PM           828,604 art04.pho
02/13/2013  03:35 PM             1,465 art04.rep
02/13/2013  03:36 PM           517,603 drilldrawing.pho
02/13/2013  03:36 PM               392 drilldrawing.rep
02/13/2013  03:39 PM             4,184 IESrC.rep
02/13/2013  03:36 PM            19,540 ncdrill.drl
02/13/2013  03:36 PM            30,903 ncdrill.lst
02/13/2013  03:36 PM               587 ncdrill.rep
02/13/2013  03:36 PM            43,219 pmb.pho
02/13/2013  03:36 PM               795 pmb.rep
02/13/2013  03:36 PM            43,637 pmt.pho
02/13/2013  03:36 PM             1,252 pmt.rep
01/05/2012  05:17 PM             2,168 README.TXT
02/13/2013  03:36 PM            50,366 smb.pho
02/13/2013  03:36 PM             1,271 smb.rep
02/13/2013  03:36 PM            52,058 smt.pho
02/13/2013  03:36 PM             1,809 smt.rep
02/13/2013  03:36 PM           430,370 ssb.pho
02/13/2013  03:36 PM               472 ssb.rep
02/13/2013  03:39 PM           457,340 sst.pho
02/13/2013  03:39 PM               591 sst.rep
