Sayidathahaseen/CCC_NGP_ODC/NGP_ODC_Main/PDLC/S5M-IES/2nd 20 Sets Order/BOM-S5M IES Rev C2.xls

Sheet: BOM
Item | Part Description | Quantity | Note | Manufacturer | Manufacturer part no. | Quantity issued
1
2 | CONNECTOR,100 PIN,4X25,RT,FEM.,PCB | 1 | J1 | TE Connectivity | 532903-2 | 22
3 | GUIDE POST,FEM.,STATIC DISCHARGE | 2 | G1-2 | TE Connectivity | 532924-4 | 50
4 | CONNECTOR,RJ-45,8 POS,FEM,PCB,SM,LED | 2 | J6-7 | Molex | 480749001 | 45
5 | FUSE,0.5A,125V,VERY FAST,SM NANO | 2 | F1-2 | Littlefuse | 0451.500MRL | 50
6 | RESISTOR SMR,3.92K,1/8W,1%,1206R | 2 | R14-15 | Vishay Dale | CRCW12063K92FKEA | 50
7 | RESISTOR SMR,10,1/10W,1%,0805R | 2 | R5;R19 | Vishay Dale | CRCW080510R0FKEA | 50
8 | RESISTOR SMR,1K,1/10W,1%,0805R | 51 | R21;R43-46;R67;R74-77;R88-103;R107;R129-130;R137-148;R152;R267-270;R280;R289-292 | Vishay Dale | CRCW08051K00FKEA | 1400
9 | RESISTOR SMR,10K,1/10W,1%,0805R | 27 | R8;R20;R24;R42;R49;R52;R56-57;R59;R64;R68;R122-124;R162-164;R212-213;R216-217;R273;R277;R281;R283;R299;R303 | Vishay Dale | CRCW080510K0FKEA | 700
10 | RESISTOR SMR,100K,1/10W,1%,0805R | 1 | R12 | Vishay Dale | CRCW0805100KFKEA | 30
11 | RESISTOR SMR,1M,1/10W,1%,0805R | 2 | R78;R293 | Vishay Dale | CRCW08051M00FKEA | 50
12 | RESISTOR SMR,200,1/10W,1%,0805R | 24 | R1-4;R16-18;R25-41 | Vishay Dale | CRCW0805200RFKEA | 500
13 | RESISTOR SMR,22.1K,1/10W,1%,0805R | 1 | R10 | Vishay Dale | CRCW080522K1FKEA | 30
14 | RESISTOR SMR,3.01K,1/10W,1%,0805R | 2 | R6;R266 | Vishay Dale | CRCW08053K01FKEA | 50
15 | RESISTOR SMR,3.09K,1/10W,1%,0805R | 1 | R9 | Vishay Dale | CRCW08053K09FKEA | 30
16 | RESISTOR SMR,390K,1/10W,1%,0805R | 1 | R13 | Vishay Dale | CRCW0805390KFKEA | 30
17 | RESISTOR SMR,4.75K,1/10W,1%,0805R | 4 | R214-215;R218-219 | Vishay Dale | CRCW08054K70FKEA | 100
18 | RESISTOR SMR,49.9,1/8W,1%,0805R | 62 | R188-211;R220-227;R236-265 | Vishay Dale | CRCW080549R9FKEA | 1300
19 | RESISTOR SMR,475,1/10W,1%,0805R | 2 | R121,161 | Stackpole electronics | RNCS0805BKE475R | 50
20 | RESISTOR SMR,75,1/10W,1%,0805R | 20 | R167-171;R173-187 | Vishay Dale | CRCW080575R0FKEA | 450
21 | RESISTOR SMR,0,1210R | 1 | R7 | Vishay Dale | CRCW12100000Z0EA | 30
22 | CAP,CER SMC,22UF,6.3V,1206C,10%,X7R | 7 | C5-7;C27;C30;C129;C132 | AVX | 12066C226KAT2A | 160
23 | CAP,CER SMC,10UF,16V,1206C,10%,X7R | 15 | C3;C28;C31;C54;C58;C63;C70;C77;C130;C133;C138;C142;C147;C154;C161 | AVX | 1206YC106KAT2A | 330
24 | CAP,CER SMC,1UF,50V,10%,1206, X7R | 1 | C21 | AVX | 12065C105KAT2A | 30
25 | CAP,CER SMC,1NF,2000V,1206C,10%,X7R | 10 | C33;C36;C39;C42;C45;C48;C81;C84;C87;C90 | AVX | 1206GC102KAT1A | 250
26 | CAP,CER SMC,10UF,50V,2220C,20%,X7R | 2 | C9;C13 | AVX | 22205C106K4Z2A | 50
27 | CAP,CER SMC,1UF,25V,10%,0805,X7R | 1 | C17,C113 | AVX | 08053C105KAT2A | 50
28 | CAP,CER SMC,.01UF,50V,5%,0805 | 23 | C8;C11;C15;C34-35;C37-38;C40-41;C43-44;C46-47;C49-50;C82-83;C85-86;C88-89;C91-92 | AVX | 08055C103JAT2A | 500
29 | CAP,CER SMC,18PF,50V,5%,0805,NPO | 4 | C23-24;C125-126 | Johanson Dielectrics Inc | 500R15N180JV4T | 100
30 | CAP,CER SMC,47nF,0805 | 2 | C105,106 | KEMET | C0805C100J5GACTU | 50
31 | CAP,CER SMC,22PF,50V,5%,0805,NPO | 1 | C14 | KEMET | C0805C220J5GACTU | 25
32 | CAP,CER SMC,.022UF,50V,10%,0805,X7R | 2 | C1-2 | KEMET | C0805C223K5RACTU | 50
33 | CAP,CER SMC,0.1UF,100V,10%,0805,X7R | 2 | C112 | KEMET | C0805C104K1RACTU | 25
34 | CAP,CER SMC,0.1UF,50V,10%,0805,X7R | 86 | C4;C10;C12;C16;C22;C26;C29;C32;C51-53;C55-57;C59-62;C64-69;C71-76;C78-80;C93-104;C107-111;C117-124;C128;C131;C134-137;C139-141;C143-146;C148-153;C155-160;C162-164 | KEMET | C0805C104K5RACTU | 1800
35 | CAP,CER SMC,0.001uF,1kV,1206,X7R | 1 | C165 | Yageo | CC1206KRX7R9BB102 | 25
36 | CAP,TAN,SMC,100UF,20V,LOW ESR,DCASE | 5 | C18-20;C25;C127 | Vishay Sprague | TR3D107K020C0080 | 120
37 | DIODE SMD,1N4004,SMD LL-41,RECT. | 2 | D1-2 | Vishay Semiconductor | SS16-E3/5AT | 50
38 | DIODE SMD,1N4148,75V,FAST,SOT23-3 | 2 | D14-15 | Diodes Inc | MMBD4148-7-F | 50
39 | DIODE,SCHOTTKY,30V,0.2A,SM,DUAL | 2 | D17-18 | ON Semiconductor | BAT54CLT1G | 50
40 | LED,3MM,DUAL,GREEN,RT ANG,TH | 12 | D3-13;D23 | Kingbright | WP934MD/2GD | 260
41 | XFORMER,ENET,10/100,1:1 1:1,16SOIC | 10 | T3-12 | Pulse | HX1188NLT | 210
42 | FERRITE BEAD,0805,120 OHM,2.5A | 10 | FB3-12 | Taiyo Yuden | FBMH2012HM121-T | 250
43 | FERRITE BEAD,0805,33 OHM,4A | 4 | FB1-2;FB13-14 | Taiyo Yuden | FBMJ2125HM330-T | 100
44 | XTAL,25 MHZ,18PF,SM | 2 | Y1-2 | XTC | 9C-25.000MAAJ-T | 50
45 | TVS,ESD,DUAL,SOT143B | 6 | D16;D19-22;D24 | NXP | PRTR5V0U2X,215 | 140
46 | TVS,DIODE,BI-DIRECT,400V,400W,SMA | 3 | D37-39 | Littlefuse | SMAJ400CA | 75
47 | ETHERNET,SWITCH,10/100,9 PORT,208PQFP | 2 | U1-2 | Micrel | KSZ8999I | 45
48 | LOAD SW,1.5A,0.2V,SSOT-6 | 1 | U7 | FAIRCHILD | FDC6325L | 25
49 | DC/DC CNVTR,POL,5-36IN/3-15OUT,5A,LOEMI,LGA | 1 | U3 | Linear Technology | LTM4604AEV#PBF | 25
50 | DC/DC CNVTR,POL,2.3-5.5IN/1-5OUT,4A,LGA | 1 | U4 | Linear Technology | LTM4612IV#PBF | 25
51 | TVS,DIODE,BI-DIRECT,36V,400W,SMA | 2 | D35,36 | Littlefuse | SMAJ36CA | 50
52 | TVS,DIODE ARRAY,LOW CAP,SOT23-6 | 10 | D25-34 | Littlefuse | SRV05-4HTG | 220

Sheet: DNI
Item | REF-DES | QTY | PART NAME | MFG #1 | MFG P/N | VALUE | PACKAGE | LOADING
1 | J3-4 | 2 | CONN-4X1-T/H | MOLEX | 22-10-2041 |  | Through Hole | DNI
2 | U5-6 | 2 | IC-24AA08-I/SN | MICROCHIP | 24AA08-I/SN |  | SO8 | DNI
3 | R272 R61 R274 R279 R55 R66 R53 R287 R58 R72 R79 R50 R70 R285 R301 | 15 | RES-10K-0805-1%-0.125W | VISHAY | CRCW080510K0FKEA | 10K_1% | R0805 | DNI
4 | R120 R125-126 R86-87 R63 R65 R48 R69 R134 R71 R73 R51 R54 R60 R62 R80-82 R85 R104-105 R149-151 R153 R155-160 R106 R108 R275-276 R110 R282 R284 R286 R288 R115-116 R118-119 R300 R302 R304 R133 | 49 | RES-1K-0805-1%-0.125W | VISHAY | CRCW08051K00FKEA | 1K_1% | R0805 | DNI
5 | R11 | 1 | RES-1M-0805-1%-0.125W | VISHAY | CRCW08051M00FKEA | 1M_1% | R0805 | DNI
6 | R111-114 R117 R165-166 R172 | 8 | RES-4.7K-0805-1%-0.125W | VISHAY | CRCW08054K70FKEA | 4.7K_1% | R0805 | DNI
7 | R228 | 1 | RESISTOR,0E,0.25,5%,R1206 | YAGEO | RC1206JR-07100RL | 0E, 1/4W | R1206 | DNI
8 | FB16 | 1 | FERRITE BEAD 120 OHM 0805 32mOHM 2.5A | TAIYO YUDEN | FBMH2012HM121-T | 120E@100MHz | FB0805 | DNI
