Sayidathahaseen/CCC_NGP_ODC/NGP_ODC_Main/PDLC/S5M-IES/BOM/iesrC_bom.xls

 |  |  |  |  |  |  |  |  |  | Parts List
 |  |  |  |  |  |  |  |  |  |  |  |  |  |  |  |  | 2012-12-07 | 0.5833333333
 | Part Number: |  |  |  | 18-425400-001
 | Revision: |  |  |  | C
 | Description |  |  |  | S5M IES, INTEGRATED ETHERNET SWITCH
 |  | Part Number |  |  |  |  | Description |  |  |  |  | Qty | UM | Rev | Reference Designators
 |  | 17-425400-001B |  |  |  | PCB,S5M,IES,10B/2F ETHERNET SWITCH |  |  |  |  | 1.00 |  | EA | B
 |  |  | DDI/ Multicircuits/ SAE
 |  | 20-001350-100 |  |  |  | CONNECTOR,100 PIN,4X25,RT,FEM.,PCB |  |  |  |  | 1.00 |  | EA | * | J1
 |  |  | AMP,INC. |  |  |  |  |  | 534008-1
 |  |  | FCI |  |  |  |  |  | 50015-1100JLF
 |  | 20-001350-FGP |  |  |  | GUIDE POST,FEM.,STATIC DISCHARGE |  |  |  |  | 2.00 |  | EA | * | G1-2
 |  |  | AMP,INC. |  |  |  |  |  | 532924-4
 |  | 20-001950-010 |  |  |  | CONNECTOR,RJ-45,8 POS,FEM,PCB,SM,LED |  |  |  |  | 2.00 |  | EA | A | J6-7
 |  |  | MOLEX |  |  |  |  |  | 48074-9001
 |  | 20-401941-501 |  |  |  | FUSE,0.5A,125V,VERY FAST,SM NANO |  |  |  |  | 2.00 |  | EA | A | F1-2
 |  |  | LITTLEFUSE |  |  |  |  |  | 0451.500MRL
 |  | 30-010210-392 |  |  |  | RESISTOR SMR,3.92K,1/8W,1%,1206R |  |  |  |  | 2.00 |  | EA | F | R14-15
 |  |  | KOA |  |  |  |  |  | RK73H2BT**3921F
 |  |  | NIC COMPONENTS |  |  |  |  |  | NRC12F3921****F
 |  |  | SEI |  |  |  |  |  | RMCF 1/8 3.92K 1% *
 |  |  | VISHAY-DALE |  |  |  |  |  | CRCW12063K92FKE*
 |  | 30-011210-100 |  |  |  | RESISTOR SMR,10,1/10W,1%,0805R |  |  |  |  | 2.00 |  | EA | H | R5;R19
 |  |  | KOA |  |  |  |  |  | RK73H2AT**10R0F
 |  |  | VISHAY-DALE |  |  |  |  |  | CRCW080510R0FKE*
 |  |  | SEI |  |  |  |  |  | RMCF 1/10 10 1% *
 |  |  | NIC COMPONENTS |  |  |  |  |  | NRC10F10R0****F
 |  | 30-011210-102 |  |  |  | RESISTOR SMR,1K,1/10W,1%,0805R |  |  |  |  | 62.00 |  | EA | H | R21;R43-46;R67;R74-77;R80-103;R125-126;R129-132;134;137-148;R267-270;R280;R289-292
 |  |  | KOA |  |  |  |  |  | RK73H2AT**1001F
 |  |  | NIC COMPONENTS |  |  |  |  |  | NRC10F1001****F
 |  |  | SEI |  |  |  |  |  | RMCF 1/10 1K 1% *
 |  |  | VISHAY-DALE |  |  |  |  |  | CRCW08051K00FKE*
 |  | 30-011210-103 |  |  |  | RESISTOR SMR,10K,1/10W,1%,0805R |  |  |  |  | 36.00 |  | EA | H | R8;R20;R22-24;R42;R49-50;R52;R56-57;R59;R64;R68;R70;R121-124;R133;R161-164;R212-213;R216-217;R273;R277;R281;R283;R285;R299;R301;R303
 |  |  | SEI |  |  |  |  |  | RMCF 1/10 10K 1% *
 |  |  | NIC COMPONENTS |  |  |  |  |  | NRC10F1002****F
 |  |  | KOA |  |  |  |  |  | RK73H2AT**1002F
 |  |  | VISHAY-DALE |  |  |  |  |  | CRCW080510K0FKE*
 |  | 30-011210-104 |  |  |  | RESISTOR SMR,100K,1/10W,1%,0805R |  |  |  |  | 1.00 |  | EA | H | R12
 |  |  | NIC COMPONENTS |  |  |  |  |  | NRC10F1003****F
 |  |  | KOA |  |  |  |  |  | RK73H2AT**1003F
 |  |  | SEI |  |  |  |  |  | RMCF 1/10 100K 1% *
 |  |  | VISHAY-DALE |  |  |  |  |  | CRCW0805100KFKE*
 |  | 30-011210-105 |  |  |  | RESISTOR SMR,1M,1/10W,1%,0805R |  |  |  |  | 2.00 |  | EA | H | R78;R293
 |  |  | SEI |  |  |  |  |  | RMCF 1/10 1M 1% *
 |  |  | NIC COMPONENTS |  |  |  |  |  | NRC10F1004****F
 |  |  | KOA |  |  |  |  |  | RK73H2AT**1004F
 |  |  | VISHAY-DALE |  |  |  |  |  | CRCW08051M00FKE*
 |  | 30-011210-201 |  |  |  | RESISTOR SMR,200,1/10W,1%,0805R |  |  |  |  | 24.00 |  | EA | H | R1-4;R16-18;R25-41
 |  |  | KOA |  |  |  |  |  | RK73H2AT**2000F
 |  |  | NIC COMPONENTS |  |  |  |  |  | NRC10F2000****F
 |  |  | SEI |  |  |  |  |  | RMCF 1/10 200 1% *
 |  |  | VISHAY-DALE |  |  |  |  |  | CRCW0805200FKE*
 |  | 30-011210-223 |  |  |  | RESISTOR SMR,22.1K,1/10W,1%,0805R |  |  |  |  | 1.00 |  | EA | H | R10
 |  |  | SEI |  |  |  |  |  | RMCF 1/10 22.1K 1% *
 |  |  | NIC COMPONENTS |  |  |  |  |  | NRC10F2212****F
 |  |  | KOA |  |  |  |  |  | RK73H2AT**2212F
 |  |  | VISHAY-DALE |  |  |  |  |  | CRCW080522K1FKE*
 |  | 30-011210-302 |  |  |  | RESISTOR SMR,3.01K,1/10W,1%,0805R |  |  |  |  | 2.00 |  | EA | H | R6;R266
 |  |  | KOA |  |  |  |  |  | RK73H2AT**3011F
 |  |  | NIC COMPONENTS |  |  |  |  |  | NRC10F3011****F
 |  |  | SEI |  |  |  |  |  | RMCF 1/10 3K01 1% *
 |  |  | VISHAY-DALE |  |  |  |  |  | CRCW08053K01RFKE*
 |  | 30-011210-3091 |  |  |  | RESISTOR SMR,3.09K,1/10W,1%,0805R |  |  |  |  | 1.00 |  | EA | H | R9
 |  |  | KOA |  |  |  |  |  | RK73H2AT**3091F
 |  |  | NIC COMPONENTS |  |  |  |  |  | NRC10F3091****F
 |  |  | VISHAY-DALE |  |  |  |  |  | CRCW08053K09RFKE*
 |  |  | SEI |  |  |  |  |  | RMCF 1/10 3K09 1% *
 |  | 30-011210-394 |  |  |  | RESISTOR SMR,390K,1/10W,1%,0805R |  |  |  |  | 1.00 |  | EA | H | R13
 |  |  | KOA |  |  |  |  |  | RK73H2AT**3903F
 |  |  | SEI |  |  |  |  |  | RMCF 1/10 390K 1% *
 |  |  | NIC COMPONENTS |  |  |  |  |  | NRC10F3903****F
 |  |  | VISHAY-DALE |  |  |  |  |  | CRCW0805390KFKE*
 |  | 30-011210-472 |  |  |  | RESISTOR SMR,4.75K,1/10W,1%,0805R |  |  |  |  | 4.00 |  | EA | H | R214-215;R218-219
 |  |  | KOA |  |  |  |  |  | RK73H2AT**4751F
 |  |  | NIC COMPONENTS |  |  |  |  |  | NRC10F4751****F
 |  |  | SEI |  |  |  |  |  | RMCF 1/10 4.75K 1% *
 |  |  | VISHAY-DALE |  |  |  |  |  | CRCW08054K75FKE*
 |  | 30-011210-500 |  |  |  | RESISTOR SMR,49.9,1/8W,1%,0805R |  |  |  |  | 62.00 |  | EA | H | R188-211;R220-227;R236-265
 |  |  | KOA |  |  |  |  |  | RK73H2AT**49R9F
 |  |  | NIC COMPONENTS |  |  |  |  |  | NRC10F49R9****F
 |  |  | SEI |  |  |  |  |  | RMCF 1/10 49.9 1% *
 |  |  | VISHAY-DALE |  |  |  |  |  | CRCW080549R9FKE*
 |  | 30-011210-750 |  |  |  | RESISTOR SMR,75,1/10W,1%,0805R |  |  |  |  | 20.00 |  | EA | H | R167-171;R173-187
 |  |  | KOA |  |  |  |  |  | RK73H2AT**75R0F
 |  |  | VISHAY-DALE |  |  |  |  |  | CRCW080575R0FKE*
 |  |  | NIC COMPONENTS |  |  |  |  |  | NRC10F75R0****F
 |  |  | SEI |  |  |  |  |  | RMCF 1/10 75 1% *
 |  | 30-012210-000 |  |  |  | RESISTOR SMR,0,1210R |  |  |  |  | 1.00 |  | EA | B | R7
 |  |  | DALE |  |  |  |  |  | CRCW1210
 |  |  | KOA |  |  |  |  |  | RM73Z2E
 |  | 31-006006-226 |  |  |  | CAP,CER SMC,22UF,6.3V,1206C,10%,X7R |  |  |  |  | 7.00 |  | EA | A | C5-7;C27;C30;C129;C132
 |  |  | AVX |  |  |  |  |  | 12066C226KAT2?
 |  | 31-006016-106 |  |  |  | CAP,CER SMC,10UF,16V,1206C,10%,X7R |  |  |  |  | 15.00 |  | EA | A | C3;C28;C31;C54;C58;C63;C70;C77;C130;C133;C138;C142;C147;C154;C161
 |  |  | AVX |  |  |  |  |  | 1206YC106KAT2?
 |  | 31-006051-105 |  |  |  | CAP,CER SMC,1UF,50V,10%,1206, X7R |  |  |  |  | 1.00 |  | EA | A | C21
 |  |  | AVX |  |  |  |  |  | 12065C105KAT?A
 |  |  | KEMET |  |  |  |  |  | C1206C105K5RAC
 |  | 31-006201-102 |  |  |  | CAP,CER SMC,1NF,2000V,1206C,10%,X7R |  |  |  |  | 10.00 |  | EA | A | C33;C36;C39;C42;C45;C48;C81;C84;C87;C90
 |  |  | AVX |  |  |  |  |  | 1206GC102KAT?
 |  | 31-006250-106 |  |  |  | CAP,CER SMC,10UF,50V,2220C,20%,X7R |  |  |  |  | 2.00 |  | EA | A | C9;C13
 |  |  | AVX |  |  |  |  |  | 22205C106K4Z2A
 |  |  | TDK |  |  |  |  |  | C5750X7R1H106M
 |  | 31-006525-105 |  |  |  | CAP,CER SMC,1UF,25V,10%,0805,X7R |  |  |  |  | 1.00 |  | EA | A | C17
 |  |  | AVX |  |  |  |  |  | 08053C105KAT?A
 |  |  | KEMET |  |  |  |  |  | C0805C105K3RAC
 |  | 31-006550-103 |  |  |  | CAP,CER SMC,.01UF,50V,5%,0805 |  |  |  |  | 23.00 |  | EA | * | C8;C11;C15;C34-35;C37-38;C40-41;C43-44;C46-47;C49-50;C82-83;C85-86;C88-89;C91-92
 |  |  | AVX |  |  |  |  |  | 08055C103JAT?A
 |  | 31-006550-180 |  |  |  | CAP,CER SMC,18PF,50V,5%,0805,NPO |  |  |  |  | 4.00 |  | EA | A | C23-24;C125-126
 |  |  | JOHANSON DIELECTRICS |  |  |  |  |  | 500R15N180JV4T
 |  | 31-006550-220 |  |  |  | CAP,CER SMC,22PF,50V,5%,0805,NPO |  |  |  |  | 1.00 |  | EA | A | C14
 |  |  | AVX |  |  |  |  |  | 08055A220JAT?A
 |  |  | KEMET |  |  |  |  |  | C0805C220J5GAC
 |  | 31-006550-223 |  |  |  | CAP,CER SMC,.022UF,50V,10%,0805,X7R |  |  |  |  | 2.00 |  | EA | A | C1-2
 |  |  | AVX |  |  |  |  |  | 08055C223KAT?A
 |  |  | KEMET |  |  |  |  |  | C0805C223K5RAC
 |  | 31-006553-104 |  |  |  | CAP,CER SMC,0.1UF,50V,10%,0805,X7R |  |  |  |  | 86.00 |  | EA | A | C4;C10;C12;C16;C22;C26;C29;C32;C51-53;C55-57;C59-62;C64-69;C71-76;C78-80;C93-104;C107-111;C117-124;C128;C131;C134-137;C139-141;C143-146;C148-153;C155-160;C162-164
 |  |  | AVX |  |  |  |  |  | 08055C104KAT?A
 |  |  | KEMET |  |  |  |  |  | C0805C104K5RAC
 |  | 31-007020-107 |  |  |  | CAP,TAN,SMC,100UF,20V,LOW ESR,DCASE |  |  |  |  | 5.00 |  | EA | A | C18-20;C25;C127
 |  |  | AVX |  |  |  |  |  | TPSD107K020?0085
 |  |  | AVX |  |  |  |  |  | TPSD107K020?0100
 |  | 32-000040-04S |  |  |  | DIODE SMD,1N4004,SMD LL-41,RECT. |  |  |  |  | 2.00 |  | EA | B | D1-2
 |  |  | ROHM |  |  |  |  |  | RLR4004
 |  |  | ROHM |  |  |  |  |  | RLR4004 TE-23
 |  |  | ROHM |  |  |  |  |  | RLR4004 TR-21
 |  | 32-000041-50S |  |  |  | DIODE SMD,1N4148,75V,FAST,SOT23-3 |  |  |  |  | 2.00 |  | EA | * | D14-15
 |  |  | DIODES INC. |  |  |  |  |  | MMBD4148-7-F
 |  | 32-000130-003 |  |  |  | DIODE,SCHOTTKY,30V,0.2A,SM,DUAL |  |  |  |  | 2.00 |  | EA | A | D17-18
 |  |  | DIODES INC. |  |  |  |  |  | BAT54S-7-F
 |  | 32-300352-004 |  |  |  | LED,3MM,DUAL,GREEN,RT ANG,TH |  |  |  |  | 12.00 |  | EA | A | D3-13;D23
 |  |  | KINGBRIGHT |  |  |  |  |  | WP934MD/2GD
 |  | 33-000292-121 |  |  |  | FERRITE BEAD,0805,120 OHM,2.5A |  |  |  |  | 11.00 |  | EA | A | FB3-12;FB16
 |  |  | TAIYO YUDEN |  |  |  |  |  | FBMH2012HM121-T
 |  | 33-000292-330 |  |  |  | FERRITE BEAD,0805,33 OHM,4A |  |  |  |  | 4.00 |  | EA | A | FB1-2;FB13-14
 |  |  | TAIYO YUDEN |  |  |  |  |  | FBMJ2125HM330-T
 |  | 33-000361-001 |  |  |  | XFORMER,ENET,10/100,1:1 1:1,16SOIC |  |  |  |  | 10.00 |  | EA | A | T3-12
 |  |  | PULSE |  |  |  |  |  | HX1188NL?
 |  | 33-000601-256 |  |  |  | XTAL,25 MHZ,18PF,SM |  |  |  |  | 2.00 |  | EA | A | Y1-2
 |  |  | XTC |  |  |  |  |  | 9C-25.000MAAJ-T
 |  | 33-000850-005 |  |  |  | TVS,ESD,DUAL,SOT143B |  |  |  |  | 6.00 |  | EA | A | D16;D19-22;D24
 |  |  | NXP |  |  |  |  |  | PRTR5V0U2X,215
 |  | 40-010007-009 |  |  |  | ETHERNET,SWITCH,10/100,9 PORT,208PQFP |  |  |  |  | 2.00 |  | EA | A | U1-2
 |  |  | MICREL |  |  |  |  |  | KSZ8999I
 |  | 40-201320-004 |  |  |  | LOAD SW,1.5A,0.2V,SSOT-6 |  |  |  |  | 1.00 |  | EA | A | U7
 |  |  | FAIRCHILD |  |  |  |  |  | FDC6325L
 |  | 50-200002-011 |  |  |  | DC/DC CNVTR,POL,5-36IN/3-15OUT,5A,LOEMI,LGA |  |  |  |  | 1.00 |  | EA | A | U4
 |  |  | LINEAR TECHNOLOGY |  |  |  |  |  | LTM4612EV#PBF
 |  |  | LINEAR TECHNOLOGY |  |  |  |  |  | LTM4612IV#PBF
 |  | 50-200002-012 |  |  |  | DC/DC CNVTR,POL,2.3-5.5IN/1-5OUT,4A,LGA |  |  |  |  | 1.00 |  | EA | A | U3
 |  |  | LINEAR TECHNOLOGY |  |  |  |  |  | LTM4604AEV#PBF
 |  |  | LINEAR TECHNOLOGY |  |  |  |  |  | LTM4604AIV#PBF
 |  |  |  |  |  | CAP,CER SMC, 10pF,50V,10%,0805,X7R |  |  |  |  | 2.00 |  | EA | A | C105-C106
 |  |  | Yageo |  |  |  |  |  | CC0805JRNPO9BN100
 |  |  | Kemet |  |  |  |  |  | C0805C100J5GACTU
 |  |  |  |  |  | TVS,DIODE,BI-DIRECT,400V,400W,SMA |  |  |  |  | 3.00 |  | EA | A | D37-39
 |  |  | Littlefuse |  |  |  |  |  | SMAJ400CA
 |  |  | Comchip Technology |  |  |  |  |  | TV04A401JB-G
 |  |  |  |  |  | CAP CER 1000PF 2000V X7R 1206 |  |  |  |  | 1.00 |  | EA | A | C165
 |  |  | Johanson Dielectrics Inc |  |  |  |  |  | 202R18W102KV4E
 |  |  | Yageo |  |  |  |  |  | CC1206KKX7RDBB102
 |  |  |  |  |  | RES 0.0 OHM 1/4W 1206 SMD |  |  |  |  | 1.00 |  | EA | A | R228
 |  |  | Yageo |  |  |  |  |  | RC1206JR-070RL
 |  |  | Vishay Dale |  |  |  |  |  | CRCW12060000Z0EA
 |  |  |  |  |  | TVS,DIODE,BI-DIRECT,36V,400W,SMA |  |  |  |  | 2.00 |  | EA | A | D35, D36
 |  |  | Littelfuse Inc |  |  |  |  |  | SMAJ36CA
 |  |  | Bourns Inc. |  |  |  |  |  | SMAJ36CA
 |  |  |  |  |  | TVS DIODE ARRAY 4CH 5V SOT23-6 |  |  |  |  | 10.00 |  | EA | A | D25-D34
 |  |  | Littelfuse Inc |  |  |  |  |  | SRV05-4HTG
Part Number: |  |  |  | 18-425400-001 |  |  |  | S5M IES, INTEGRATED ETHERNET SWITCH
 |  |  |  |  |  |  |  |  |  |  |  |  |  |  |  | CCC_Structure_Parts_Manufacturers.rpt Last adjusted 11/7/2008
Revision: |  |  |  | C
