Sayidathahaseen/CCC_NGP_ODC/NGP_ODC_Main/PDLC/Prodigy HW files/Backplane/BoM ordering/CCCNGP_Backplane_BoM.xls

Sl.No. | Reference | Description | Manufacturer | Manufacturer P/No. | Qty
1 | J9-10,J14-17,J20-21 J23-24 J26-27 J29-30 J32-33 J35-36 J38-39 J41-42 J44-45 J47-48 J50-51 J53-54 | 3-Pair, 72 -position, 2 mm pitch, 8 column, Vertical Receptacle | FCI | 10045271-101LF | 30
2 | J8,J11, J4-J7 | 3-Pair, 54 -position, 2 mm pitch, 6 column, Vertical Receptacle | FCI | 10043546-101LF | 6
3 | J56-67 | 4-Pair, 96 -position, 2 mm pitch, 8 column, Vertical Receptacle | FCI | 10052842-101LF | 12
4 | J12-13 J18-19 J22 J25 J28 J31 J34 J37 J40 J43 J46 J49 J52 J55 | Power Receptacle 2x2 | FCI | 10028916-4554P00LF | 16
5 | J1 | Pluggable socket, straight, 7.62 mm pitch, 14 position | FCI | 20020620-M141A01LF | 1
6 | J2-3 | 4P 8S 4P PF Vertical Receptacle | FCI | 51740-10400804CALF | 2
7 | G1-34 | 10.8 mm Guide Pin - External Thread | FCI | 10037910-101LF | 34
8 | C3 C23 C25 C27 C29 C31 C33 C35 C37 C39 C41 C43 C45 C47 C49 C51 C53 C55 C57 C59 C61 C63 C65 C67 C69 C71 C73 C75 C77 C79 C81 C83 C85 C87 C89 C91 C93 C95 | CAP TANTALUM 10UF 16V 10% SMD | Murata Electronics North America | TAJC106K016RNJ | 38
9 | C1 C5 C7 C9 C11 C13 C15 C17 C19 C21 C97 C99 C101 C103 C105 C107 C109 C111 C113 C115 C117 C119 C121 C123 C125 C127 C129 C131 C133 C135 C137 C139 C141 C143 C145 C147 C149 C151 C153 C155 C157 C159 C161 C163 C165 C167 C169 C171 C173 C175 C177 C179 C181 C183 C185 C187 C189 C191 C193 C195 C197 C199 C201 C203 C205 C207 C209 C211 C213 C215 C217 C219 C221 C223 C225 C227 C229 C231 C233 C235 C237 C239 C241 C243 C245 C247 C249 C251 C253 C255 | CAP TANTALUM 10UF 50V 10% SMD | Murata Electronics North America | TAJD106K050RNJ | 90
10 | C4 C24 C26 C28 C30 C32 C34 C36 C38 C40 C42 C44 C46 C48 C50 C52 C54 C56 C58 C60 C62 C64 C66 C68 C70 C72 C74 C76 C78 C80 C82 C84 C86 C88 C90 C92 C94 C96 | CAP CER .1UF 16V 10% X7R 0805 | Murata Electronics North America | GRM219R71C104KA01D | 38
11 | C2 C6 C8 C10 C12 C14 C16 C18 C20 C22 C98 C100 C102 C104 C106 C108 C110 C112 C114 C116 C118 C120 C122 C124 C126 C128 C130 C132 C134 C136 C138 C140 C142 C144 C146 C148 C150 C152 C154 C156 C158 C160 C162 C164 C166 C168 C170 C172 C174 C176 C178 C180 C182 C184 C186 C188 C190 C192 C194 C196 C198 C200 C202 C204 C206 C208 C210 C212 C214 C216 C218 C220 C222 C224 C226 C228 C230 C232 C234 C236 C238 C240 C242 C244 C246 C248 C250 C252 C254 C256 | CAP CER .1UF 50V 10% X7R 0805 | Murata Electronics North America | GRM21BR71H104KA01L | 90
12 | U1 | Coded Rotary Switches HEX KNOB | C&K Components | CD16RK1CBR | 1
