Sayidathahaseen/CCC_NGP_ODC/NGP_ODC_Main/PDLC/Prodigy HW files/IOP_DI/lead_components/lead_componenets.xls

Quantity 1 | Manufacturer | Manufacturer Part Number | Customer Reference | Mfg Std Lead Time | Description
2 | SAMTEC INC | QTE-040-02-L-D-A | J3-4 | 2 Weeks | CONN HEADER HI-SPEED DUAL 80POS
1 | 3M | 951102-7622-AR | J56 | 8 Weeks | CONN HEADER 2POS 2MM R/A T/H
1 | FCI | 10061289-001LF | J8 | 6 Weeks | PWR 2X3 HDR
1 | ALTERA | EPM2210F256I5N | U17 | 5 Weeks | IC CPLD 1700MC 7NS 256FBGA
1 | LINEAR TECHNOLOGY | LT4256-3IGN#PBF | U77 | 4 Weeks | IC CTLR HOTSWP HV DETECT 16SSOP
1 | SULLINS CONNECTOR SOLUTIONS | ECC05DJBN | J7 | 2-4 Weeks | CONN EDGECARD 10POS .100X.200
1 | CEL CALIFORNIA EASTERN LABS | PS2701-1-L-A | U78 | 13 Weeks | OPTOCOUPLER TRANS 3.75KVRMS 4SMD
1 | MICROCHIP TECHNOLOGY | MCP23S17-E/SS | U16 | 11 Weeks | IC I/O EXPANDER SPI 16B 28SSOP
1 | LINEAR TECHNOLOGY | LTC4370IMS#PBF | U57 | 4 Weeks | IC OR CTRLR LOAD SHARE 16MSOP
1 | TEXAS INSTRUMENTS (VA) | TPS62132RGTT | U41 | 7 Weeks | IC REG BUCK SYNC 3.3V 3A 16QFN
1 | ON SEMICONDUCTOR (VA) | NUD3160LT1G | U23 |  | IC INDCT LOAD DRVR INDUST SOT23
1 | ON SEMICONDUCTOR | MC78M05ABDTG | U60 | 6 Weeks | IC REG LDO 5V 0.5A DPAK
1 | DIODES INCORPORATED (VA) | AZ23C11-7-F | D56 | 7 Weeks | DIODE ZENER DUAL 11V SOT23-3
2 | TEXAS INSTRUMENTS (VA) | LM2903MX/NOPB | U81 U92 | 7 Weeks | IC COMPARATOR DUAL VOLT 8-SOIC
18 | AVAGO TECHNOLOGIES US INC | ACPL-M50L-000E | U1-7 U10-15 U18 U20-21 U83 U93 | 12 Weeks | OPTOCOUPLER DGTL 1MBD LP SO5
4 | TEXAS INSTRUMENTS (VA) | SN74LVC540ADBR | U24 U31 U51 U59 |  | IC INVERTER 8-INPUT 20SSOP
1 | LINEAR TECHNOLOGY (VA) | LTC4210-1IS6#TRMPBF | U122 | 4 Weeks | IC CONTROLLER HOT SWAP TSOT23-6
1 | DIALIGHT | 551-2509F | D26 | 11 Weeks | LED 3MM RTANG HI EFF ORANGE PCMT
3 | DIALIGHT | 551-0209F | D25 D28-29 | 10 Weeks | LED 3MM RT ANG HI EFF GRN PC MNT
2 | KINGBRIGHT COMPANY LLC | WP4060VH/2GD | D8 D37 | 6 Weeks | LED IND 1.8MM RA 565NM GRN DIFF
1 | DIALIGHT | 551-0309F | D30 | 11 Weeks | LED 3MM RT ANG HI EFF YEL PC MNT
1 | FCI | 10045597-105LF | GS1 | 7 Weeks | 10.8MM R/A GUIDE SOCKET
1 | DIALIGHT | 551-0409F | D41 | 10 Weeks | LED 3MM RT ANG HI EFF RED PC MNT
3 | VISHAY SILICONIX (VA) | SIR462DP-T1-GE3 | Q4-5 Q30 |  | MOSFET N-CH 30V 30A PPAK 8SOIC
1 |  | EF2-5NU | K7
