Sayidathahaseen/CCC_NGP_ODC/NGP_ODC_Main/PDLC/design/BOM/APP/CCCNGP_APP_BoM_0.1.xls

 |  |  | APP Bill of Material Rev-1.1 (Assembly)
 |  |  | 2011-07-26
Item | Qty | Reference | VALUE | MFG #1 P/N | MFG #1 | Description | Package | Required QTY@10 Boards | Issued QTY@10 Boards | Shortage QTY
1 | 1 | U30 | 24LC16B | 24LC16B-I/SN | Microchip Technology | IC EEPROM 16KBIT 400KHZ 8SOIC | SOIC-8 | 10 | 10 | 0
2 | 1 | U23 | ADT7410TRZ | ADT7410TRZ | Analog Devices | Temperature Sensor ±0.5°C 16-biti I2C | SOIC-16 | 10 | 10 | 0
3 | 1 | U21 | AR8031 | AR8031 | Atheros | 10/100/1000 Gigabit Ethernet Transceiver | QFN48 | 10 | 10 | 0
4 | 1 | U26 | AT24C01BN-SH-B | AT24C01BN-SH-B | Atmel | IC EEPROM 1KBIT 1MHZ 8SOIC | SOIC-8 | 10 | 10 | 0
5 | 1 | BT1 | CR2430 BAT HOLDER | SMTU2430-LF.TR | Renata | Battery Holders CR2430 Snaps & Contacts | BATTERY_HOLDER_SMTU2430 | 10 | 10 | 0
6 | 4 | U2 U10-11 U17 | ICS553 | ICS553MILF | ICS | IC CLK BUFFER 1:4 LO SKEW 8-SOIC | SOIC-8 | 40 | 40 | 0
7 | 66 | C177-190 C209-226 C231-233 C236 C241-243 C249-255 C259-268 C357-365 C373 | 0.01uF | GRM155R71H103KA88D | Murata | CAP CER 10000PF 50V X7R 0402 | 402 | 660 | 700 | -40
8 | 18 | C2 C4 C7 C10 C15 C24-25 C32 C34 C47 C50 C52 C58 C67 C295-296 C329 C331 | 0.01uF | GRM188R71H103KA01D | Murata | CAP CER 10000PF 50V 10% X7R 0603 | 603 | 180 | 180 | 0
9 | 120 | C20 C42-46 C49 C53-57 C60 C68-74 C76 C83 C92-95 C103-118 C163-176 C191-208 C227-230 C234-235 C237-240 C244-248 C256-258 C271 C279-282 C284 C333-340 C342-346 C348-356 | 0.1uF | C1005X7R1H104M | TDK Corporation | CAP CER .10UF 50V X7R 20% 0402 | 402 | 1200 | 1250 | -50
10 | 63 | C1 C3 C5-6 C9 C14 C16-19 C23 C26-29 C33 C35-37 C51 C66 C80 C84-91 C96-101 C120 C139-142 C146 C148 C283 C286-289 C291-294 C299 C303 C309 C321 C326-328 C330 C332 C369 C371 | 0.1uF | GRM188R71H104KA93D | Murata | CAP CER .1UF 50V 10% X7R 0603 | 603 | 630 | 650 | -20
11 | 1 | C300 | 1000pF | GRM188R71H102KA01D | Murata | CAP CER 1000PF 50V 10% X7R 0603 | 603 | 10 | 10 | 0
12 | 1 | C341 | 1000pF | 1206GC102KAT1A | AVX Corporation | CAP CERM 1000PF 2000V X7R 1206 | 1206 | 10 | 10 | 0
13 | 2 | C285 C314 | 100pF | C1608X7R1H101K | TDK Corporation | CAP CER 100PF 50V X7R 10% 0603 | 603 | 20 | 20 | 0
14 | 2 | C322-323 | 100uF | C3216X5R0J107M | TDK Corporation | CAP CER 100UF | 1206 | 20 | 20 | 0
15 | 6 | C152-155 C304 C307 | 10uF | C1608X5R1A106M | TDK Corporation | CAP CER 10UF 10V X5R 20% 0603 | 603 | 60 | 60 | 0
16 | 14 | C8 C11 C21-22 C48 C59 C62-63 C102 C119 C347 C366-368 | 10uF | GRM21BR71A106KE51L | Murata | CAP CER 10UF 10V X7R 0805 | 805 | 140 | 140 | 0
17 | 1 | C290 | 10uF | C1206C106K4RACTU | Kemet | CAP CER 10UF 16V X7R 1206 | 1206 | 10 | 10 | 0
18 | 1 | C320 | 10uF | C2012X5R1E106K | TDK Corporation | CAP CER 10UF 25V X5R 10% 0805 | 805 | 10 | 10 | 0
19 | 3 | C149 C318-319 | 10uF | TMK316B7106KL-TD | Taiyo Yuden | CAP CER 10UF 25V X7R 10% 1206 | 1206 | 30 | 30 | 0
20 | 1 | C298 | 0.015uF | C1608X7R1H153K | TDK Corp | CAP CER 15000PF 50V X7R 0603 | 603 | 10 | 10 | 0
21 | 7 | C75 C269-270 C272-275 | 1uF | C1005X5R1C105K | TDK Corporation | CAP CER 1.0UF 16V X5R 0402 | 402 | 70 | 70 | 0
22 | 5 | C40-41 C61 C370 C372 | 1uF | C1608X7R1C105K | TDK Corporation | CAP CER 1.0UF 16V X7R 10% 0603 | 603 | 50 | 50 | 0
23 | 1 | C313 | 1uF | C1608X7R1E105K | TDK Corporation | CAP CER 1.0UF 25V X7R 10% 0603 | 603 | 10 | 10 | 0
24 | 2 | C276-277 | 2.2uF | C1005X5R0J225M | TDK Corporation | CAP CER 2.2UF 6.3V X5R 0402 | 402 | 20 | 20 | 0
25 | 1 | C310 | 2.2uF | GRM188R61C225KE15D | Murata | CAP CER 2.2UF 16V X5R 0603 | 603 | 10 | 10 | 0
26 | 8 | C64-65 C81-82 C137-138 C150-151 | 20pF | GRM1885C1H200JA01D | Murata | CAP CER 20PF 50V 5% C0G 0603 | 603 | 80 | 90 | -10
27 | 16 | C121-136 | 220pF | GRM155R71H221KA01D | Murata | CAP CER 220PF 50V 10% X7R 0402 | 402 | 160 | 160 | 0
28 | 2 | C302 C317 | 22uF | GRM31CR71A226KE15L | Murata | CAP CER 22UF 10V X7R 10% 1206 | 1206 | 20 | 20 | 0
29 | 1 | C278 | 3300pF | GRM155R71H332KA01D | Murata | CAP CER 3300PF 50V X7R 0402 | 402 | 10 | 10 | 0
30 | 2 | C12-13 | 4.7pF | 06035A4R7CAT2A | AVX | CAP CER 4.7PF 50V NPO 0603 +/-0.25PF | 603 | 20 | 20 | 0
31 | 4 | C144-145 C147 C325 | 4.7uF | C2012X7R1C475K | TDK Corporation | CAP CER 4.7UF 16V X7R 10% 0805 | 805 | 40 | 40 | 0
32 | 2 | C30 C38 | 4.7uF | C1608X5R1A475K | TDK Corporation | CAP CER 4.7UF 10V X5R 0603 | 603 | 20 | 20 | 0
33 | 5 | C31 C39 C77-79 | 470pF | C1608X7R1H471K | TDK Corporation | CAP CER 470PF 50V X7R 10% 0603 | 603 | 50 | 50 | 0
34 | 1 | C301 | 47pF | C0603C470J5GACTU | Kemet | CAP CERAMIC 47PF 50V NP0 0603 | 603 | 10 | 10 | 0
35 | 2 | C311-312 | 22uF | C3225X7R1C226M | TDK Corporation | CAP CER 22UF 16V X7R 1210 | 1210 | 20 | 20 | 0
36 | 1 | C308 | 0.033uF | 06035C333JAT2A | AVX Corporation | CAP CERM 33000PF 5% 50V X7R 0603 | 603 | 10 | 10 | 0
37 | 3 | C297 C305-306 | 100uF | TH3E107K016C0600 | Vishay | CAP TANT 100UF 16V 10% SMD | 7343 | 30 | 30 | 0
38 | 1 | C315 | 10uF | TPSB106M016R0800 | AVX Corporation | CAP TANT LOESR 10UF 16V 20% SMD | 1210 | 10 | 10 | 0
39 | 2 | C316 C324 | 150uF | T520D157M006ATE015 | Kemet | CAPACITOR TANT 150UF 6.3V 20%SMD | 7343 | 20 | 20 | 0
40 | 1 | C143 | 22uF | TAJB226K020RNJ | AVX Corporation | CAP TANTALUM 22UF 20V 10% SMD | 1210 | 10 | 10 | 0
41 | 6 | C157-162 | 47uF | TPSB476K010R0250 | AVX Corporation | CAP TANT LOWESR 47UF 10V 10% SMD | 1210 | 60 | 60 | 0
42 | 1 | U9 | OSC-66.666MHz | ECS-3963-666-BN-TR | ECS Inc | OSC 66.666 MHZ 3.0V SMD | OSCSC250P320X500X160-4N | 10 | 10 | 0
43 | 1 | J2 | 5103309-3 | 5103309-3 | TE Connectivity | CONN HEADER LOPRO STR 16POS GOLD | HEADER_8PX2R_100_SHROUDED | 10 | 10 | 0
44 | 1 | J6 | High speed diff connector | FCI | 10045267-111LF | Conn 3-Pair 72-P 2-mm 8-Column 4-Walls, RA | CONN_FCI_72_TH | 10 |  | 10
45 | 1 | J8 | 22-28-5033 | 22-28-5033 | Molex | Headers & Wire Housings 2.54MM HDR VT 3P | BERG3P_2P54 | 10 | 10 | 0
46 | 1 | J5 | Header - 10P | 15916102 | Molex | HEADER SMT BKWY GOLD 10CKT | BERG5PX2R_254 | 10 | 10 | 0
47 | 1 | J3 | MICRO SD CONN | ST1W008S4AR1500 |  | Micro SD Socket Hinge Type | CONN-MICRO-SD-8PIN | 10 | 10 | 0
48 | 1 | J9 | CONN - 54P | 10039851-111LF | FCI | 52P 2 mm 8 column 4 Walls RA Header | CONN_FCI_54_TH | 10 |  | 10
49 | 1 | J4 | USB - OTG Mini-B | 5000750517 | Molex | USB OTG Mini-B Receptacle, Vertical, TH | CONN_MOLEX_MUSB_B_5P | 10 | 10 | 0
50 | 1 | J7 | PWR Connector | 10028917-001LF | FCI | Power Header 2x2 | CONN_10028917-001LF | 10 |  | 10
51 | 1 | U42 | EPM3064 | EPM3064ATI44-10N | Altera | IC MAX 3000A CPLD 64 44-TQFP | TQFP -44 | 10 | 10 | 0
52 | 1 | Y3 | 32.768KHZ | ABS07-32.768KHZ-T | Abracon Corporation | Crystals 32.768 KHz 12.5pF | XTAL320X150X100N | 10 | 10 | 0
53 | 1 | D10 | B340A | B340A-13-F | Diodes Inc | DIODE SCHOTTKY 3A 40V SMA | SMA | 10 | 10 | 0
54 | 1 | D9 | RB080L | RB080L-30TE25 | Rohm Semiconductor | DIODE SCHOTTKY 30V 5A PMDS | DO-214AC, SMA | 10 | 10 | 0
55 | 1 | D5 | TVS DIODE | RCLAMP0504S.TCT | Semtech | IC TVS ARRAY LOW CAP SOT23-6 | SOT23-6 | 10 | 10 | 0
56 | 1 | D8 | MBR0530 | MBR0530 | Fairchild SemI | DIODE SCHOTTKY 30V 0.5A SOD-123 | SOD123 | 10 | 10 | 0
57 | 1 | U48 | DS1834A | DS1834AS+ | Maxim-IC | IC ECONORST DUAL LO OPN-DR 8SOIC | SOIC-8 | 10 | 10 | 0
58 | 1 | U29 | ET1100,BGA128 | ET1100 | BECKHOFF | EtherCAT Slave Controller | BGA128 | 10 |  | 10
59 | 11 | FB1-2 FB4-5 FB7-13 | 600E@100MHz | BLM18HG601SN1D | Murata | FERRITE CHIP 600 OHM 200MA 0603 | 603 | 110 | 110 | 0
60 | 2 | FB18 FB21 | 120E_2.5A | FBMH2012HM121-T | Taiyo Yuden | FERRITE BEAD 120 OHM 0805 | 805 | 20 | 10 | 10
61 | 2 | FB19-20 | 120E | BLM18PG121SH1D | Murata | EMI/RFI Suppressors & Ferrites 0603 120ohms | 603 | 20 | 20 | 0
62 | 6 | FB3 FB6 FB14-17 | 120E@100MHz | BLM18PG121SN1D | Murata | FERRITE CHIP 120 OHM 2000MA 0603 | 603 | 60 | 60 | 0
63 | 4 | Q1 Q9-11 | 2N7002PW | 2N7002PW,115 | NXP Semiconductors | MOSFET N-CH SGL 60V SOT-323 | SOT-323 | 40 | 40 | 0
64 | 2 | Q5 Q7 | IRF7821 | IRF7821TRPBF | International Rectifier | MOSFET N-CH 30V 13.6A 8-SOIC | SOIC-8 | 20 | 20 | 0
65 | 2 | Q6 Q8 | IRF7832 | IRF7832TRPBF | International Rectifier | MOSFET N-CH 30V 20A 8-SOIC | SOIC-8 | 20 | 20 | 0
66 | 3 | Q2-4 | SIR462DP | SIR462DP-T1-GE3 | Vishay | MOSFET N-CH 30V 30A PPAK 8SOIC | SO8_PP | 30 | 30 | 0
67 | 1 | U22 | ICS557 | ICS557MI-01LF | IDT | IC CLK SOURCE PCI-EXPRESS 8-SOIC | SOIC-8 | 10 | 10 | 0
68 | 1 | L5 | 4.7uH | MLP2520S4R7S | TDK Corporation | INDUCTOR MULTILAYER 4.7UH 1008 | INDC2520X120N | 10 | 10 | 0
69 | 2 | L9-10 | 2.2uH | SLF10165T-2R2N6R33PF | TDK Corporation | INDUCTOR SHIELD PWR 2.2UH 6.3A SMD | INDC101101X700N | 20 | 20 | 0
70 | 1 | L8 | 6.8uH | SRP7030-6R8FM | Bourns Inc | IND Power 6.8UH 4.5A 20% SMD | 7.60mm x 6.50mm x 3.00mm | 10 | 10 | 0
71 | 1 | U25 | ISL12022IBZ | ISL12022IBZ | Intersil | RTC with On Chip ±5ppm Temp Compensation | SOIC-8 | 10 | 10 | 0
72 | 1 | U7 | 980020-48-P1-K | 980020-48-P1-K | Meritec | TSOP48 IC SOCKET | TSOP48_SOCKET | 10 |  | 10
73 | 2 | U13-14 | LAN8720Ai | LAN8720Ai | SMSC | ETHERNET 10/100 PHY RMII 24QFN | QFN24 | 20 | 20 | 0
74 | 1 | D25 | LED-B | 597-3601-207F | Dialight | LED BLUE 428NM CLEAR PLCC SMD | LED_2.4MM_SMD | 10 | 10 | 0
75 | 2 | D23-24 | LED-B | LB Y87S-L1M2-35-Z | Osram | LED MICRO SIDELED BLUE 470NM SMD | LED_B_HB_RA_SMD | 20 | 20 | 0
76 | 7 | D1-2 D11-14 D21 | GRN_DUAL | SSF-LXH512SUGD | LUMEX | LED GRN DUAL 1.8 RA T/H | LED_1P8MM_D | 70 |  | 70
77 | 6 | D3-4 D22 D26-28 | LED-G | LTST-C170KGKT | Lite-On Inc | LED GREEN CLEAR 0805 SMD | 805 | 60 | 60 | 0
78 | 4 | D15-16 D19-20 | LED-G | 551-0209F | Dialight | LED 3MM RT ANG HI EFF GRN PC MNT | LED_3MM_RA | 40 | 40 | 0
79 | 1 | D17 | LED-R | 551-0409F | Dialight | LED 3MM RT ANG HI EFF RED PC MNT | LED_3MM_RA | 10 | 10 | 0
80 | 1 | D18 | LED-Y | 551-0309F | Dialight | LED 3MM RT ANG HI EFF YEL PC MNT | LED_3MM_RA | 10 | 10 | 0
81 | 1 | U47 | LM3495 | LM3495MTC/NOPB |  | IC PWM BUCK REG LOW-OUT 16-TSSOP | TSSOP-16 | 10 | 10 | 0
82 | 1 | U43 | LTC4227 | LTC4227IUFD-1#PBF | Linear Technology | IC CONTROLLER HOT SWAP 20-QFN | WFQFN-20 | 10 | 10 | 0
83 | 1 | U24 | M24256-BWMN6TP | M24256-BWMN6TP | STMicroelectronics | IC EEPROM 256KBIT 400KHZ 8SOIC | SOIC-8 | 10 | 10 | 0
84 | 1 | U40 | MAX16053 | MAX16053AUT+T | Maxim-IC | IC PWR MONITOR/SEQUENCER SOT23-6 | SOT23-6 | 10 | 10 | 0
85 | 1 | U28 | MAX3227E | MAX3227ECUE+ | Maxim-IC | IC TXRX RS232 1MBPS SD 16TSSOP | TSSOP-16 | 10 | 10 | 0
86 | 1 | U20 | MC74LCX125 | MC74LCX125DTR2G | ON Semiconductor | IC BUFF TRI-ST QD CMOS 14TSSOP | TSSOP-14 | 10 | 10 | 0
87 | 2 | U4-5 | MC74LCX373 | MC74LCX373DTG | ON Semiconductor | IC LATCH TRANSP OCT LV 20-TSSOP | TSSOP20 | 20 | 20 | 0
88 | 1 | U33 | MIC2505 | MIC2505-1YM | Micrel | IC SW HIGH SIDE SGL 2A 8SOIC | SOIC-8 | 10 | 10 | 0
89 | 1 | J1 |  | 2013310-1 | TE Connectivity / AMP | CONN DDR3 SDRAM SODIMM 204P,9.2mm | CONN-DDR3-SDRAM-SODIMM | 10 | 10 | 0
90 | 1 | U3 | MR0A08B | MR0A08BCYS35 | EverSpin Technologies | IC MRAM 1MBIT 35NS 44TSOP | TSOP44 | 10 | 10 | 0
91 | 1 | U53 | OSC-25MHz | FXO-HC536R-25 | Fox Electronics | OSC 25.000 MHZ 3.3V SMD | SMD6 | 10 | 10 | 0
92 | 3 | U8 U12 U18 | OSC-50MHz | ASFLMB-50.000MHZ-LY-T | ABRACON | OSC MEMS 50.000 MHZ SMD | QFN4 | 30 | 30 | 0
93 | 1 | U1 | P1021 | P1021NXN2HFB | Freescale |  | BGA-689 | 10 | 10 | 0
94 | 1 | U6 | PCA9515 | PCA9515D,112 | NXP Semiconductors | IC I2C BUS REPEATER 8-SOIC | SOIC-8 | 10 | 10 | 0
95 | 1 | U16 | PCA9555BS | PCA9555BS,118 | NXP | I/O Expander I2C-bus 16bit with interrupt | QFN-24 | 10 | 10 | 0
96 | 2 | U15 U19 | PHY1_KSZ8721BLI | KSZ8721BLI | Micrel Inc | IC TXRX PHY 10/100 3.3V 48LQFP | 48LQFP | 20 | 20 | 0
97 | 1 | R326 | 0.009E | PMR100HZPFU9L00 | Rohm Semiconductor |  | 2512 | 10 | 10 | 0
98 | 1 | R343 | 1.5K | ERJ-3EKF1501V | Panasonic - ECG | RES 1.50K OHM 1/10W 1% 0603 SMD | 603 | 10 | 10 | 0
99 | 1 | R333 | 10.2K | ERJ-3EKF1022V | Panasonic - ECG | RES 10.2K OHM 1/10W 1% 0603 SMD | 603 | 10 | 10 | 0
100 | 1 | R6 | 100E | ERJ-2GEJ101X | Panasonic - ECG | RES 100 OHM 1/10W 5% 0402 SMD | C0402 | 10 |  | 10
101 | 11 | R7 R58-61 R79-82 R140 R398 | 100E | ERJ-3EKF1000V | Panasonic - ECG | RES 100 OHM 1/10W 1% 0603 SMD | 603 | 110 | 120 | -10
102 | 1 | R22 | 100E | ERJ-3GEYJ101V | Panasonic - ECG | RES 100 OHM 1/10W 5% 0603 SMD | 603 | 10 | 10 | 0
103 | 4 | R9 R152 R338 R342 | 100K | ERJ-3GEYJ104V | Panasonic - ECG | RES 100K OHM 1/10W 5% 0603 SMD | 603 | 40 | 40 | 0
104 | 2 | R24 R327 | 10E | ERJ-3GEYJ100V | Panasonic - ECG | RES 10 OHM 1/10W 5% 0603 SMD | 603 | 20 | 20 | 0
105 | 1 | R339 | 10K | ERJ-3EKF1002V | Panasonic - ECG | RES 10.0K OHM 1/10W 1% 0603 SMD | 603 | 10 | 10 | 0
106 | 1 | R334 | 118K | ERJ-3EKF1183V | Panasonic - ECG | RES 118K OHM 1/10W 1% 0603 SMD | 603 | 10 | 10 | 0
107 | 1 | R185 | 11K | ERJ-3EKF1102V | Panasonic - ECG | RES 11.0K OHM 1/10W 1% 0603 SMD | 603 | 10 | 10 | 0
108 | 2 | R57 R78 | 12.1K | ERJ-3EKF1212V | Panasonic - ECG | RES 12.1K OHM 1/10W 1% 0603 SMD | 603 | 20 | 20 | 0
109 | 16 | R363-376 R381-382 | 120E | ERJ-3GEYJ121V | Panasonic - ECG | RES 120 OHM 1/10W 5% 0603 SMD | 603 | 160 | 180 | -20
110 | 1 | R203 | 12K | ERJ-3EKF1202V | Panasonic - ECG | RES 12.0K OHM 1/10W 1% 0603 SMD | 603 | 10 | 10 | 0
111 | 1 | R331 | 15K | ERJ-3EKF1502V | Panasonic - ECG | RES 15.0K OHM 1/10W 1% 0603 SMD | 603 | 10 | 10 | 0
112 | 1 | R380 | 160E | ERJ-3GEYJ161V | Panasonic - ECG | RES 160 OHM 1/10W 5% 0603 SMD | 603 | 10 | 10 | 0
113 | 1 | R213 | 180K | ERJ-3EKF1803V | Panasonic - ECG | RES 180K OHM 1/10W 1% 0603 SMD | 603 | 10 | 10 | 0
114 | 1 | R218 | 1E | ERJ-3RQF1R0V | Panasonic - ECG | RESISTOR 1.0 OHM 1/10W 1% 0603 | 603 | 10 | 10 | 0
115 | 1 | R33 | 1K | ERJ-3GEYJ102V | Panasonic - ECG | RES 1.0K OHM 1/10W 5% 0603 SMD | 603 | 10 | 10 | 0
116 | 1 | R202 | 1M | ERJ-3GEYJ105V | Panasonic - ECG | RES 1.0M OHM 1/10W 5% 0603 SMD | 603 | 10 | 10 | 0
117 | 1 | R332 | 2.2K | ERJ-3EKF2201V | Panasonic - ECG | RES 2.20K OHM 1/10W 1% 0603 SMD | 603 | 10 | 10 | 0
118 | 1 | R141 | 2.37K | ERJ-3EKF2371V | Panasonic - ECG | RES 2.37K OHM 1/10W 1% 0603 SMD | 603 | 10 | 10 | 0
119 | 1 | R139 | 200E | ERJ-3EKF2000V | Panasonic - ECG | RES 200 OHM 1/10W 1% 0603 SMD | 603 | 10 | 10 | 0
120 | 1 | R212 | 200K | ERJ-3EKF2003V | Panasonic - ECG | RES 200K OHM 1/10W 1% 0603 SMD | 603 | 10 | 10 | 0
121 | 1 | R323 | 20K | ERJ-3EKF2002V | Panasonic - ECG | RES 20.0K OHM 1/10W 1% 0603 SMD | 603 | 10 | 10 | 0
122 | 1 | R336 | 29.4K | ERJ-3EKF2942V | Panasonic - ECG | RES 29.4K OHM 1/10W 1% 0603 SMD | 603 | 10 | 10 | 0
123 | 1 | R337 | 3.24K | ERJ-3EKF3241V | Panasonic - ECG | RES 3.24K OHM 1/10W 1% 0603 SMD | 603 | 10 | 10 | 0
124 | 7 | R142-143 R217 R383-384 R392 R399 | 330E | ERJ-3GEYJ331V | Panasonic - ECG | RES 330 OHM 1/10W 5% 0603 SMD | 603 | 70 | 50 | 20
125 | 23 | R28-31 R43-44 R63-65 R83-86 R90 R114-117 R147 R149 R346-348 | 33E | ERJ-3EKF33R0V | Panasonic - ECG | RES 33.0 OHM 1/10W 1% 0603 SMD | 603 | 230 | 230 | 0
126 | 9 | R91-94 R98-101 R198 | 33E | ERJ-3GEYJ330V | Panasonic - ECG | RES 33 OHM 1/10W 5% 0603 SMD | 603 | 90 | 90 | 0
127 | 121 | R8 R21 R34 R46-47 R49 R51 R62 R66 R68 R70 R72 R87 R89 R97 R103 R107 R111 R113 R118-122 R128 R132-136 R163 R174-175 R183-184 R186-191 R220-223 R225-226 R228-230 R232 R235-236 R238-240 R242 R244 R247-249 R252 R254-256 R258 R260-262 R265 R267 R271 R273-274 R276-277 R279-280 R283 R286-290 R292-293 R296 R299 R302-304 R311-322 R349-350 R355-356 R362 R378 R385-391 R396-397 R402 R405-406 | 4.7K | ERJ-3GEYJ472V | Panasonic - ECG | RES 4.7K OHM 1/10W 5% 0603 SMD | 603 | 1210 | 1720 | -510
128 | 4 | R206-209 | 4.99 | CRCW06034R99FKEA | Vishay/Dale | RES 4.99 OHM 1/10W 1% 0603 SMD | 603 | 40 | 40 | 0
129 | 2 | R2-3 | 40.2E | ERJ-3EKF40R2V | Panasonic - ECG | RES 40.2 OHM 1/10W 1% 0603 SMD | 603 | 20 | 20 | 0
130 | 1 | R151 | 475E | ERJ-3EKF4750V | Panasonic - ECG | RES 475 OHM 1/10W 1% 0603 SMD | 603 | 10 | 10 | 0
131 | 1 | R325 | 47E | ERJ-3GEYJ470V | Panasonic - ECG | RES 47 OHM 1/10W 5% 0603 SMD | 603 | 10 | 10 | 0
132 | 18 | R53-56 R74-77 R148 R150 R259 R263-264 R266 R282 R306-308 | 49.9E | ERJ-3EKF49R9V | Panasonic - ECG | RES 49.9 OHM 1/10W 1% 0603 SMD | 603 | 180 | 180 | 0
133 | 1 | R329 | 5.1K | ERJ-3GEYJ512V | Panasonic - ECG | RES 5.1K OHM 1/10W 5% 0603 SMD | 603 | 10 | 10 | 0
134 | 1 | R330 | 54.9K | ERJ-3EKF5492V | Panasonic - ECG | RES 54.9K OHM 1/10W 1% 0603 SMD | 603 | 10 | 10 | 0
135 | 2 | R95 R102 | 6.49K | ERJ-3EKF6491V | Panasonic - ECG | RES 6.49K OHM 1/10W 1% 0603 SMD | 603 | 20 | 20 | 0
136 | 1 | R324 | 68K | ERJ-3EKF6802V | Panasonic - ECG | RES 68.0K OHM 1/10W 1% 0603 SMD | 603 | 10 | 10 | 0
137 | 2 | R309-310 | 75E | ERJ-3GEYJ750V | Panasonic - ECG | RES 75 OHM 1/10W 5% 0603 SMD | 603 | 20 | 20 | 0
138 | 2 | R340-341 | 75K | ERJ-3EKF7502V | Panasonic - ECG | RES 75.0K OHM 1/10W 1% 0603 SMD | 603 | 20 | 20 | 0
139 | 1 | R199 | 820E | ERJ-3GEYJ821V | Panasonic - ECG | RES 820 OHM 1/10W 5% 0603 SMD | 603 | 10 | 10 | 0
140 | 39 | R5 R10-15 R27 R104 R106 R112 R166 R176 R178 R192-197 R200-201 R210-211 R257 R270 R272 R275 R298 R344 R351-352 R357-360 R377 R379 R400 | 0E | ERJ-3GEY0R00V | Panasonic - ECG | RES 0.0 OHM 1/10W 0603 SMD | 603 | 390 | 450 | -60
141 | 53 | R1 R4 R17-20 R23 R25 R35-42 R88 R96 R144 R146 R153-162 R164-165 R167 R169-173 R177 R179-182 R204-205 R214-216 R345 R361 R393-395 | 10K | ERJ-3GEYJ103V | Panasonic - ECG | RES 10K OHM 1/10W 5% 0603 SMD | 603 | 530 | 550 | -20
142 | 1 | U27 | S25FL128P0XNFI001 | S25FL128P0XNFI001 | Spansion | 128Mbit 3V SPI Flash Memory | WSON8 | 10 | 10 | 0
143 | 1 | U39 | SN74CB3Q3245 | SN74CB3Q3245RGYR | Texas Instruments | IC SWITCH BUS 8BIT FET 20-VQFN | VQFN-20 | 10 |  | 10
144 | 1 | U54 | SN74LVC1G04DBVR | TI | SN74LVC1G04DBVR | IC SINGLE INVERTER-GATE SOT-23-5 | SOT-23-5 | 10 | 10 | 0
145 | 2 | U41 U52 | SN74LVC541A | SN74LVC541ARGYR | Texas Instruments | IC BUFF/DVR TRI-ST 8BIT 20QFN | QFN-20 | 20 | 20 | 0
146 | 1 | SW1 | Reset Switch | TL1105XF100Q | E-Switch | SWITCH TACT 6MM RA 5.85MM 100GF | Switch_RA | 10 | 10 | 0
147 | 1 | U46 | TPS51116 | TPS51116PWPR | Texas Instruments | IC DDR SYNC BUC CTRL REF20HTSSOP | HTSSOP20 | 10 | 10 | 0
148 | 1 | U44 | TPS54332 | TPS54332DDA | Texas Instruments | 3.5A Buck DC-DC Convertor | SO8_PPAD | 10 | 10 | 0
149 | 1 | U45 | TPS76850 | TPS76850QPWP | Texas Instruments | IC, LDO VOLT REG, 5V, 1A, 20-HTSSOP | HTSSOP20 | 10 | 10 | 0
150 | 11 | TP16-26 | TP_TH | 5014 | Keystone Electronics | TEST POINT PC MULTI PURPOSE YEL | KEYSTONE_501X | 110 | 110 | 0
151 | 9 | U32 U34-38 U49-51 | TS3L110 | TS3L110RGYR | Texas Instruments | IC ETHERNET SWITCH QUAD 16VQFN | VQFN-16 | 90 | 90 | 0
152 | 1 | U31 | USB3300 | USB3300-EZK | SMSC | IC USB HOST/OTG PHY ULPI 32-QFN | 32-VFQFN Exposed Pad | 10 | 10 | 0
153 | 1 | T1 | HX1188 | HX1188NL | PULSE | MODULE XFRMR SGL ETHR LAN 16SOIC | SOIC-16 | 10 | 10 | 0
154 | 1 | Y5 | 24MHz | ABM8G-24.000MHZ-18-D2Y-T | Abracon Corporation | CRYSTAL 24.000 MHZ 18 PF SMD | OSCCC250X320X110-4N | 10 | 10 | 0
155 | 3 | Y1-2 Y4 | 25MHz | ABM8G-25.000MHZ-18-D2Y-T | Abracon Corporation | CRYSTAL 25.000 MHZ 18 PF SMD | OSCCC250X320X110-4N | 30 | 30 | 0
156 | 2 | D6-7 | SMAJ6.5A | SMAJ7.5A | Bourns Inc | DIODE TVS 6.5V 400W UNI 5% SMD | SMA | 20 | 20 | 0
