Sayidathahaseen/CCC_NGP_ODC/NGP_ODC_Main/PDLC/design/BOM/IOP-DM1/BOM_IOP_DIGITAL_REV1.xls

Item | Qty | Reference | Part Name | Description | MFG #1 | MFG #1 P/N | Value | Package | Tolerance | Voltage Rating | Height | Cost@25 | Total Cost per board | ASSEMBLY
1 | 3 | F2-4 | 0157005.DR,0157005.DR | FUSE 5A Fast Acting | Littelfuse Inc | 0157005.DR | 0157005.DR | Holder/Surface Mount |  |  | 4.03 | 2.481 | 7.443
2 | 1 | C65 | 1206_0.68UF,0.68uF | CAP CER .68UF 50V X7R 10% 1206 | TDK | C3216X7R1H684K | 0.68uF | C1206 |  | 50V |  | 0.33 | 0.33
3 | 1 | Y1 | 40MHZ,40 MHz | OSC CLOCK 40.000 MHZ SMD | CTS | 632L3I040M00000 | 40 MHz | 4-SMD |  |  | 1.2 | 3.93 | 3.93
4 | 2 | U13-14 | ADUM1400,ADuM1400 | IC DGITAL ISOLATOR 4CH 16-SOIC | Analog Devices | ADUM1400CRWZ-RL | ADuM1400 | 16-SOIC |  |  |  | 5.3164 | 10.6328
5 | 2 | U82 U97 | AND_2,SN74LVC1G08DRLR | IC SNGL 2IN POS-AND GATE SOT-553 | TI | SN74LVC1G08DRLR | SN74LVC1G08DRLR | SOT-553 |  |  |  | 0.332 | 0.664
6 | 7 | U2-3 U5 U7 U19 U21 U29 | BSP75N,BSP75N | Power Switch ICs - Power Distribution Self-Protect 60V Sw | Diode Zetex | BSP75NTA | BSP75N | SOT223-4 |  |  | 1.8 | 1.17 | 8.19
7 | 3 | C73 C77-78 | CAP-50V-0.01UF-603,0.01uF | CAP CER 10000PF 50V X5R 0603 | murata | GRM188R61H103KA01D | 0.01uF | 603 |  | 50V |  | 0.11 | 0.33
8 | 5 | C10-11 C14-15 C69 | CAP-TANLE-16V-10UF_3528,10uF | CAP TANT LOESR 10UF 16V 10% SMD | AVX | TPSB106K016R0800 | 10uF | C3528_T |  | 16V TAN | 2.1 | 0.796 | 3.98
9 | 1 | C70 | CAP-TANLE-35V-4P7UF,4.7uF | CAP TANT 4.7UF 35V 10% 1210 | AVX | TPSB475K035R0700 | 4.7uF | C3528_T |  | 35V | 2.1 | 0.979 | 0.979
10 | 1 | C1 | CAP-TPS-10V-100UF-3528,100uF,20% | CAP TANT 100UF 10V 20% 1210 | AVX | TPSB107M010R0400 | 100uF | C3528_T | 20.00% | 10V TAN | 2.1 | 1.3 | 1.3
11 | 2 | C305-306 | CAP-TPS-16V-100UF-2312,100uF,10% | CAP TANT LOESR 100UF 16V 10% SMD | AVX | TPSC107K016R0200 | 100uF | C6032_T | 10.00% | 16V TAN | 2.8 | 3.136 | 6.272
12 | 1 | C54 | CAPC-1UF-1206-10%-50V-X7R,1uf | CAP CER 1.0UF 50V X7R 10% 1206 | AVX | 12065C105KAT2A | 1uf | 1206 |  | 50V | 1.78 | 1.65 | 1.65
13 | 77 | C2-9 C12-13 C16-22 C24-41 C43 C45 C47-48 C51-53 C55-60 C62-64 C66-67 C71-72 C74-76 C79-97 | CAP_100NF_50V_0603,100nF,10% | CAP CER .1UF 50V 10% X7R 0603 | Murata | GRM188R71H104KA93D | 100nF | 603 | 10.00% | 50V |  | 0.055 | 4.235
14 | 1 | C68 | CAP_1UF_25V_0603,1uF,10% | CAP CER 1UF 25V X7R 10% 0603 | Murata | GRM188R71E105KA12D | 1uF | 603 | 10.00% | 25V |  | 0.292 | 0.292
15 | 2 | C49-50 | CAP_1UF_50V_0805,1uF,10% | CAP CER 1UF 50V X7R 0805 | Murata | GRM21BR71H105KA12L | 1uF | 805 | 10.00% | 50V |  | 0.434 | 0.868
16 | 3 | C42 C44 C46 | CAP_4.7NF_50V_0603,4.7nF | CAP CER 4700PF 50V 10% X7R 0603 | Murata | GRM188R71H472KA01D | 4.7nF | 603 |  | 50V |  | 0.035 | 0.105
17 | 9 | U4 U6 U8 U12 U15 U20 U22 U38-39 | COMP\LM2901,LM2901 | IC COMPARATOR QUAD VOLT 14-SOIC | National Semiconductor | LM2901MX/NOPB | LM2901 | 14-SOICN |  |  | 1.75 | 0.87 | 7.83
18 | 1 | U27 | COMP\LM2903MX,LM2903 | IC COMPARATOR DUAL VOLT 8-SOIC | National Semiconductors | LM2903MX/NOPB | LM2903 | 8-SOIC |  |  |  | 0.8296 | 0.8296
19 | 2 | J3-4 | CON-80-SAMTEC-QSE,QTE-040-02-L-D-A | CONN HEADER HI-SPEED DUAL 80POS | Samtec | QTE-040-02-L-D-A | QTE-040-02-L-D-A | 80 pins |  |  |  | 7.333 | 14.666
20 | 1 | J56 | CON2_BERG,22-28-4020 | CONN HEADER 2POS .100 VERT TIN | Molex | 22-28-4020 | 22-28-4020 | Throgh Hole |  |  |  | 0.27 | 0.27
21 | 1 | J1 | CONN_TRBLK_2X2,10073379-001LF | Power Header 2x2 | FCI | 10073379-001LF | 10073379-001LF | Throgh Hole |  |  |  | 7.94 | 7.94
22 | 1 | R14 | CRCW08056422DT,64k2,0.5% | Thick Film Resistors - SMD 1/8watt 64.2Kohms 0.5% | Vishay | CRCW08056422DT | 64k2 | R0805 | 0.50% |  |  | 0.09 | 0.09
23 | 4 | R170 R207 R211 R292 | CRCW12100000Z0EA,0R,Jumper | RES 0.0 OHM 1/2W 1210 SMD | Vishay | CRCW12100000Z0EA | 0R | R1210 | Jumper |  |  | 0.261 | 1.044 | DNI
24 | 12 | D1-6 D31-36 | DIODE-BAS19,BAS19 | DIODE SWITCH 200MA 120V SOT23 | On semiconductor | BAS19LT1G | BAS19 | SOT-23-3 |  |  | 1.11 | 0.258 | 3.096
25 | 1 | K7 | EC2-24NJ,EC2-24NJ | Low Signal Relays - PCB 24VDC 2 Form C (DPDT) | NEC | EC2-24NJ | EC2-24NJ | Throgh Hole |  |  |  | 2.85 | 2.85
26 | 1 | U62 | EEPROM_SPI,CAT25160 | IC EEPROM 16KBIT 10MHZ 8TSSOP | ON semiconductor | CAT25160YI-G | CAT25160 | TSSOP-8 |  |  |  | 0.7008 | 0.7008
27 | 1 | U17 | EPM2210F256,EPM2210F256I5N | IC MAX II CPLD 2210 LE 256-FBGA | Altera | EPM2210F256I5N | EPM2210F256I5N | 256-FBGA |  |  |  | 44.4 | 44.4
28 | 1 | R237 | ESR10EZPJ101,100E,±5% | RES 100 OHM 1/4W 5% 0805 SMD | Rohm Semiconductor | ESR10EZPJ101 | 100E | R0805 | ±5% |  |  | 0.083 | 0.083
29 | 16 | R78 R109 R111 R117 R119-122 R169 R171-177 | ESR10EZPJ131,130E,±5% | RES 130 OHM 1/4W 5% 0805 SMD | Rohm Semiconductor | ESR10EZPJ131 | 130E | R0805 | ±5% |  |  | 0.083 | 1.328
30 | 12 | R232-233 R250-253 R255 R257 R259 R261 R263 R265 | ESR10EZPJ471,470E,±5% | RES 470 OHM 1/4W 5% 0805 SMD | Rohm Semiconductor | ESR10EZPJ471 | 470E | R0805 | ±5% |  |  | 0.083 | 0.996
31 | 1 | FB1 | FERRITE_BEAD,120 Ohm @ 100MHz | FERRITE BEAD 120 OHM 0805 | Taiyo Yuden | FBMH2012HM121-T | 120 Ohm @ 100MHz | 805 |  |  |  | 0.275 | 0.275
32 | 1 | Q26 | FET-N-SO8-SI7336ADP,SI7336ADP | MOSFET N-CH 30V 30A PPAK 8SOIC | Vishay | SI7336ADP-T1-E3 | SI7336ADP | SOIC-8 |  |  |  | 2.5724 | 2.5724
33 | 2 | Q4-5 | FET-N-SO8-SIR462DP,SIR462DP | MOSFET N-CH 30V 30A PPAK 8SOIC | Vishay | SIR462DP-T1-GE3 | SIR462DP | SOIC-8 |  |  |  | 1.054 | 2.108
34 | 3 | FID1-3 | FID\DIAMOND,5015 | C TEST POINT MINIATURE SMT | KEYSTONE | 5015 | 5015 | Surface Mount |  |  | 1.5 | 1.02 | 3.06
35 | 1 | G1 | GUIDE-BACKPLANE,10045597-107LF | 10.8MM R/A GUIDE SOCKET | FCI | 10045597-107LF | 10045597-107LF | Throgh Hole |  |  |  |  | 0
36 | 1 | U49 | IC\DAC\DAC088S085\TSSOP16,DAC088S085 | IC DAC 8BIT OCTAL R-R 16-TSSOP | National Semiconductor | DAC088S085CIMT/NOPB | DAC088S085 | 16-TSSOP |  |  |  | 4.05 | 4.05
37 | 2 | U55-56 | IC\MM74HC595,MM74HC595 | IC SHIFT REGISTER 8-BIT 16-SOIC | Fairchild Semiconductor | MM74HC595MX | MM74HC595 | 16-SOIC |  |  |  | 0.352 | 0.704
38 | 4 | U34-37 | IC\SW\4SPDT\ADG5434,ADG5434 | Quad SPDT Switch | Analog Devices | ADG5434BRUZ | ADG5434 | 20-TSSOP |  |  |  | 6.6216 | 26.4864
39 | 1 | IOP_1_CON1 | IOP_1_CON,High Speed Signal Connector | 3-Pair, 72 -position, 2 mm pitch, 8 column, 4 Walls, Right Angle Header | FCI | 10045267-101LF | High Speed Signal Connector | 72 Pin Through Hole |  |  |  | 10.24 | 10.24
40 | 1 | J2 | IOP_1_CON_BACK,High Speed Signal Connector | 3-Pair, 72 -position, 2 mm pitch, 8 column, 4 Walls, Right Angle Header | FCI | 10045267-101LF | High Speed Signal Connector | 72 Pin Through Hole |  |  |  | 10.24 | 10.24
41 | 1 | J7 | JTAG_CPLD,N2510-6002-RB | CONN HEADER 10 POS STRGHT GOLD | 3M | N2510-6002-RB | N2510-6002-RB | Throgh Hole |  |  |  | 1.65 | 1.65
42 | 11 | TP1-9 TP12-13 | KEYSTONE,5015 | C TEST POINT MINIATURE SMT | KEYSTONE | 5015 | 5015 | Surface Mount |  |  | 1.5 | 1.02 | 11.22
43 | 1 | D38 | LED_0805_BLUE,LB Y87S-M1N2-35-Z | LED BLUE 470NM CLEAR RA SMD | OSRAM Opto Semiconductors Inc | LB Y87S-M1N2-35-Z | LB Y87S-M1N2-35-Z | SMD |  |  |  | 0.788 | 0.788
44 | 16 | D9-24 | LED_3MM_BI,551-3508F | LED FLAT 3MM RED/GRN BICLR 3LEAD | dialight | 551-3508F | 551-3508F | Through Hole, Right Angle |  |  |  | 1.54 | 24.64
45 | 2 | D27 D37 | LED_3MM_BLUE,597-3601-207F | LED BLUE 428NM CLEAR PLCC SMD | dialight | 597-3601-207F | 597-3601-207F | SMD |  |  |  | 1.9516 | 3.9032
46 | 4 | D25 D28-30 | LED_3MM_GREEN,551-0209F | LED 3MM RT ANG HI EFF GRN PC MNT | dialight | 551-0209F | 551-0209F | Through Hole, Right Angle |  |  |  | 0.69 | 2.76
47 | 1 | D41 | LED_3MM_RED,551-0409F | LED 3MM RT ANG HI EFF RED PC MNT | dialight | 551-0409F | 551-0409F | Through Hole, Right Angle |  |  |  | 0.698 | 0.698
48 | 1 | D26 | LED_3MM_YEL,551-0309F | LED 3MM RT ANG HI EFF YEL PC MNT | dialight | 551-0309F | 551-0309F | Through Hole, Right Angle |  |  |  | 0.698 | 0.698
49 | 2 | D8 D39 | LED_BI-COLOUR_0,570-0100-221F | LED 3HI 2MM RED/YEL/GRN | dialight | 570-0100-221F | 570-0100-221F | Through Hole, Right Angle |  |  |  |  | 0
50 | 1 | U16 | LT1963,LT1963AES8 | IC LDO REG LOW NOISE 1.5A 8-SOIC | Linear Technology | LT1963AES8#PBF | LT1963AES8 | SOIC8 |  |  |  | 2.988 | 2.988
51 | 1 | U88 | LT4227,LT4227 | IC CONTROLLER HOT SWAP 20-QFN | Linear Technology | LTC4227IUFD-1#PBF | LT4227 | 20-WFQFN Exposed Pad |  |  |  | 5.36 | 5.36
52 | 1 | U31 | LT1641-1,LT1641-1 | IC CONTRLR HOTSWAP POSVOLT 8SOIC | Linear Technology | LT1641-1IS8#PBF | LT1641-1 | 8-SOIC |  |  |  | 3.652 | 3.652
53 | 1 | U57 | LT1963AES8-3.3,LT1963AES8-3.3 | IC LDO REG 1.5A 3.3V 8-SOIC | Linear Technology | LT1963AES8-3.3#PBF | LT1963AES8-3.3 | SOIC-8 |  |  |  | 2.988 | 2.988
54 | 1 | U10 | MC78M05ABDTG,MC78M05ABDTG | IC REG POS 500MA 5V DPAK | ON Semiconductor | MC78M05ABDTG | MC78M05ABDTG | TO-252-3 |  |  | 2.4 | 0.5968 | 0.5968
55 | 1 | U18 | MC78M15CDTRKG,MC78M15BDTG | IC REG LDO 400MA 5.0V DPAK | ON Semiconductor | MC78M15BDTG | MC78M15BDTG | TO-252-3 |  |  | 2.4 | 0.48 | 0.48
56 | 1 | LA1 | MICTOR_TEK\VT,MICTOR - VT | CONN RCPT 38POS VERT .64MM | TE Connectivity | 5767054-1 | MICTOR - VT |  |  |  |  | 14.76 | 14.76 | DNI
57 | 1 | L1 | MLZ2012N100L_IND,10uH | INDUCTOR MULTILAYER 10UH 0805 | TDK Corporation | MLZ2012N100L | 10uH | 805 |  |  |  | 0.1 | 0.1
58 | 20 | Q1-3 Q7-21 Q23-24 | MMBT2222,MMBT2222 | TRANSISTOR SWITCHING NPN SOT-23 | Infineon Technologies | MMBT2222ALT1 | MMBT2222 | SOT-23-3 |  |  |  | 0.311 | 6.22
59 | 1 | D63 | MMSZ5248BT1G,MMSZ5248BT1G | DIODE ZENER 18V 500MW SOD-123 | ON Semiconductor | MMSZ5248BT1G | MMSZ5248BT1G | SOD-123 |  |  |  | 0.35 | 0.35
60 | 4 | MH1-4 | MOUNTING_HOLE_3P6 |  |  |  |  |  |  |  |  |  | 0
61 | 1 | D7 | MSS1P6,MSS1P6 | DIODE SCHOTTKY 1A 60V MICROSMP | Vishay/Semiconductors | MSS1P6 | MSS1P6 | smd |  |  |  | 0.356 | 0.356
62 | 2 | U30 U66 | NOR2_0,74LCX02 | IC GATE NOR QUAD 2INP LV 14TSSOP | Fairchild Semiconductor | 74LCX02MTCX | 74LCX02 | 14-TSSOP |  |  |  | 0.59 | 1.18
63 | 1 | Q22 | NTD6414ANT4G,NTD6414ANT4G | MOSFET N-CH 100V 32A DPAK | ON Semiconductor | NTD6414ANT4G | NTD6414ANT4G | DPAK |  |  | 2.38 | 1.47 | 1.47
64 | 3 | U23 U32-33 | NUD3160,NUD3160 | IC INDCT LOAD DRVR INDUST SC74-6 | On Semiconductor | NUD3160DMT1G | NUD3160 | SC-74 |  |  |  | 0.5392 | 1.6176
65 | 4 | U50 U52-54 | OPAMP\OPA209,OPA2209 | IC OPAMP GP R-R 18MHZ 8SOIC | Texas Instruments | OPA2209AIDR | OPA2209 | 8-SOIC |  |  |  | 4.0424 | 16.1696
66 | 14 | U1 U11 U26 U28 U40-48 U58 | OPTO\SM\PS2701_1,PS2701 | OPTOISOLATOR 1CH TRANS OUT 4-SOP | CEL | PS2701-1-P-A | PS2701 | 4-SM |  |  | 2.3 | 0.662 | 9.268
67 | 3 | U61 U63-64 | OR2_0,SN74LVC1G08DCKR | SINGLE POSITIVE AND GATE SC-70 | Texas Instruments | SN74LVC1G08DCKR | SN74LVC1G08DCKR | SC-70-5 |  |  |  | 0.2388 | 0.7164
68 | 1 | U98 | OR_2,SN74LVC1G32DRLR | IC SNGL 2IN POS-OR GATE SOT-553 | TI | SN74LVC1G32DRLR | SN74LVC1G32DRLR | SOT-553 |  |  |  | 0.38 | 0.38
69 | 1 | R112 | PMR100HZPFU10L0,0.01E,1% | RES 0.01 OHM 2W 1% 2512 SMD | ROHM | PMR100HZPFU10L0 | 0.01E | R2512 | 1.00% |  |  | 0.742 | 0.742
70 | 1 | R133 | PMR100HZPFU9L00,0.0090E,1% | RES .009 OHM 2W 1% 2512 SMD | Rohm Semiconductor | PMR100HZPFU9L00 | 0.0090E | R2512 | 1.00% |  |  | 0.543 | 0.543
71 | 1 | R291 | RC0805JR-0710RL,10E,±5% | RES 10 OHM 1/8W 5% 0805 SM | Yageo | RC0805JR-0710RL | 10E | R0805 | ±5% |  |  | 0.017 | 0.017
72 | 1 | R290 | RC0805JR-0747RL,47E,±5% | RES 47 OHM 1/8W 5% 0805 SMD | Yageo | RC0805JR-0747RL | 47E | R0805 | ±5% |  |  | 0.017 | 0.017
73 | 6 | R18 R27 R39 R81 R94 R103 | RES-0603-51,51,1% | RES 51.0 OHM 1/10W 1% 0603 SMD | yageo | RC0603FR-0751RL | 51 | 603 | 1.00% |  |  | 0.014 | 0.084
74 | 6 | R21 R33 R84 R88 R97 R106 | RES-0603-499,499,1% | RES 499 OHM 1/10W 1% 0603 SMD | yageo | RC0603FR-07499RL | 499 | 603 | 1.00% |  |  | 0.014 | 0.084
75 | 8 | R213 R231 R309-314 | RES-0603-0OHM,0,Jumper | RES 0.0 OHM 1/10W 0603 SMD | yageo | RC0603JR-070RL | 0 | 603 | Jumper |  |  | 0.01 | 0.08
76 | 32 | R19-20 R28 R31-32 R42-46 R49-56 R65-67 R74 R77 R82-83 R87 R95-96 R104-105 R167 R206 | RES-0603-100K,100K,1% | RES 100K OHM 1/10W 1% 0603 SMD | yageo | RC0603FR-07100KL | 100K | 603 | 1.00% |  |  | 0.014 | 0.448
77 | 8 | R182 R186 R190 R194 R198 R202 R168 R316 | RES-0603-100K,100K,1% | RES 100K OHM 1/10W 1% 0603 SMD | yageo | RC0603FR-07100KL | 100K | 603 | 1.00% |  |  | 0.014 | 0.112 | DNI
78 | 41 | R22-23 R34-35 R47 R57-64 R68-69 R75-76 R85-86 R89-90 R98-99 R107-108 R123-128 R212 R215 R230 R254 R256 R258 R260 R272 R317 R346 | RES-0603-10K,10K,1% | RES 10.0K OHM 1/10W 1% 0603 SMD | yageo | RC0603FR-0710KL | 10K | 603 | 1.00% |  |  | 0.014 | 0.574
79 | 6 | R17 R26 R38 R80 R93 R102 | RES-0603-13K,13k,1% | RES 13.0K OHM 1/10W 1% 0603 SMD | yageo | RC0603FR-0713KL | 13k | 603 | 1.00% |  |  | 0.014 | 0.084
80 | 1 | R348 | RES-0603-16K,16K,1% | RES 16.0K OHM 1/10W 1% 0603 SMD | yageo | RC0603FR-0716KL | 16K | 603 | 1.00% |  |  | 0.014 | 0.014
81 | 8 | R236 R262 R264 R266-270 | RES-0603-22K,22K,1% | RES 22.0K OHM 1/10W 1% 0603 SMD | yageo | RC0603FR-0722KL | 22K | 603 | 1.00% |  |  | 0.014 | 0.112
82 | 24 | R321-344 | RES-100M-1-0805,100M,5% | RES 100M OHM 1/8W 5% 0805 TF | Stackpole Electronics Inc | HMC0805JT100M | 100M | 805 | 5.00% |  |  | 0.42 | 10.08 | DNI
83 | 2 | R351-352 | RES-10M-1-0603,10M,1% | RES 10.00M OHM 1/10W 1% 0603 SMD | Yageo | RC0603FR-0710ML | 10M | 603 | 1.00% |  |  | 0.014 | 0.028 | DNI
84 | 9 | R48 R166 R180 R184 R188 R192 R196 R200 R204 | RES-15K-1-0603,15K,1% | RES 15.0K OHM 1/10W 1% 0603 SMD | Yageo | RC0603FR-0715KL | 15K | 603 | 1.00% |  |  | 0.014 | 0.126
85 | 19 | R15 R24 R36 R41 R72 R91 R100 R110 R279-282 R285-289 R319-320 | RES-1K-1-0603,1k,1% | RES 1.00K OHM 1/10W 1% 0603 SMD | Yageo | RC0603FR-071KL | 1k | 603 | 1.00% |  |  | 0.014 | 0.266
86 | 3 | R7 R11 R271 | RES-1M-1-0603,1M,1% | RES 1.00M OHM 1/10W 1% 0603 SMD | Yageo | RC0603FR-071ML | 1M | 603 | 1.00% |  |  | 0.014 | 0.042
87 | 20 | R16 R25 R37 R79 R92 R101 R178 R238-249 R347 | RES-2.2K-1-0603,2.2k,1% | RES 2.20K OHM 1/10W 1% 0603 SMD | Yageo | RC0603FR-072K2L | 2.2k | 603 | 1.00% |  |  | 0.014 | 0.28
88 | 3 | R5 R9 R29 | RES-2.7K-1-0805,2.7k,5% | RES 2.7K OHM 1/4W 5% 0805 SMD | Rohm Semiconductor | ESR10EZPJ272 | 2.7k | 805 | 5.00% |  |  | 0.083 | 0.249
89 | 8 | R293-300 | RES-200K-1-0603,200K,1% | RES 200.0K OHM 1/10W 1% 0603 SMD | Yageo | RC0603FR-07200KL | 200K | 603 | 1.00% |  |  | 0.014 | 0.112
90 | 11 | R8 R13 R129 R132 R134 R136 R138 R140 R142 R144 R148 | RES-20K-1-0603,20K,1% | RES 20.0K OHM 1/10W 1% 0603 SMD | Yageo | RC0603FR-0720KL | 20K | 603 | 1.00% |  |  | 0.014 | 0.154
91 | 8 | R301-308 | RES-2M-1-0603,2M,1% | RES 2.00M OHM 1/10W 1% 0603 SMD | Yageo | RC0603FR-072ML | 2M | 603 | 1.00% |  |  | 0.014 | 0.112
92 | 1 | R40 | RES-3.16K-1-0603,3.16K,1% | RES 3.16K OHM 1/10W 1% 0603 SMD | Yageo | RC0603FR-073K16L | 3.16K | 603 | 1.00% |  |  | 0.014 | 0.014
93 | 11 | R1 R3 R147 R150-156 R349 | RES-4.3K-1-0805,4.3k,5% | RES 4.3K OHM 1/4W 5% 0805 SMD | Rohm Semiconductor | ESR10EZPJ432 | 4.3k | 805 | 5.00% |  |  | 0.083 | 0.913
94 | 24 | R130 R135 R137 R139 R141 R143 R145-146 R164-165 R179 R181 R183 R185 R187 R189 R191 R193 R195 R197 R199 R201 R203 R205 | RES-4.99K-1-0603,4.99K,1% | RES 4.99K OHM 1/10W 1% 0603 SMD | Yageo | RC0603FR-074K99L | 4.99K | 603 | 1.00% |  |  | 0.014 | 0.336
95 | 1 | R315 | RES-51OHM-1-0805,51E,5% | RES 51 OHM 1/4W 5% 0805 SMD | Yageo | ESR10EZPJ510 | 51E | 805 | 5.00% |  |  | 0.083 | 0.083
96 | 29 | R2 R4 R6 R10 R12 R30 R70-71 R73 R149 R157-163 R208-210 R273-278 R283-284 R350 | RES4K7-1-0603,4k7,1% | RES 4.70K OHM 1/10W 1% 0603 SMD | Yageo | RC0603FR-074K7L | 4k7 | 603 | 1.00% |  |  | 0.014 | 0.406
97 | 1 | R113 | RES_0805_10E,10E,±1% | ES 10.0 OHM 1/8W 1% 0805 SMD | Yageo | RC0805FR-0710RL | 10E | R0805 | ±1% |  |  | 0.021 | 0.021
98 | 1 | R114 | RES_0805_1K,1K,±1% | RES 1.00K OHM 1/8W 1% 0805 SMD | Yageo | RC0805FR-071KL | 1K | R0805 | ±1% |  |  | 0.021 | 0.021
99 | 2 | R131 R235 | RES_0805_20K,20K,±1% | RES 20.0K OHM 1/8W 1% 0805 SMD | Yageo | RC0805FR-0720KL | 20K | R0805 | ±1% |  |  | 0.021 | 0.042
100 | 1 | R118 | RES_0805_24K,24K,±1% | RES 24.0K OHM 1/8W 1% 0805 SMD | Yageo | RC0805FR-0724KL | 24K | R0805 | ±1% |  |  | 0.021 | 0.021
101 | 1 | R116 | RES_0805_3.57K,3.57K,±1% | RES 3.57K OHM 1/8W 1% 0805 SMD | Yageo | RC0805FR-073K57L | 3.57K | R0805 | ±1% |  |  | 0.021 | 0.021
102 | 1 | R234 | RES_0805_49.9K,49.9K,±1% | RES 49.9K OHM 1/8W 1% 0805 SMD | Yageo | RC0805FR-0749K9L | 49.9K | R0805 | ±1% |  |  | 0.021 | 0.021
103 | 1 | R115 | RES_0805_59K,59K,±1% | RES 59.0K OHM 1/8W 1% 0805 SMD | Yageo | RC0805FR-0759KL | 59K | R0805 | ±1% |  |  | 0.021 | 0.021
104 | 6 | K1-6 | RLY\TN2E-24V,TSC-124L3H,000 | Low Signal Relays - PCB LOW SIGNAL RELAY | TE Connectivity | TSC-124L3H,000 | TSC-124L3H,000 | PCB through-hole |  |  | 10.2 | 1.7432 | 10.4592
105 | 2 | D77-78 | SMAJ6.5ABCT-ND,SMAJ7.5A | DIODE TVS 7.5V 400W UNI 5% SMD | Bourns Inc | SMAJ7.5A | SMAJ7.5A | DO-214AC, SMA |  |  | 2.29 | 0.212 | 0.424
106 | 1 | D62 | SMBJ36A,SMBJ36A | DIODE SCHOTTKY 1A 60V MICROSMP | Diodes Inc | SMBJ36A-13-F | SMBJ36A | smd |  |  | 2.62 | 0.396 | 0.396
107 | 2 | U9 U25 | SN74ABT540DBR,SN74ABT540 | IC INVERTER 8-INPUT 20SSOP | TI | SN74ABT540DBR | SN74ABT540 | SSOP-20 |  |  | 2 | 0.7592 | 1.5184
108 | 4 | U24 U51 U59 U65 | SN74LVTH541DBR,SN74LVTH541 | IC BUFF/DVR TRI-ST 8BIT 20SSOP | TI | SN74LVTH541DBR | SN74LVTH541 | SSOP-20 |  |  | 2 | 1.62 | 6.48
109 | 1 | SW1 | SW_PB_SPST_1,TL1105XF250Q | SWITCH TACT 6MM RA 5.85MM 250GF | E-Switch | TL1105XF250Q | TL1105XF250Q | Through Hole |  |  |  | 0.526 | 0.526
110 | 4 | C23 C225-227 | TAJD106K050RNJ,10uF | CAP TANTALUM 10UF 50V 10% SMD | AVX | TAJD106K050RNJ | 10uF | CASE-D |  | 50V | 3.1 | 4.568 | 18.272
111 | 1 | C61 | TAJD107K020RNJ,100uF/20V | CAP TANTALUM 100UF 20V 10% SMD | AVX | TAJD107K020RNJ | 100uF/20V | CASE-D |  | 20V | 3.1 | 2.828 | 2.828
 |  |  |  |  |  |  |  |  |  |  |  | Total Cost | 369.2532
