Sayidathahaseen/CCC_NGP_ODC/NGP_ODC_Main/PDLC/design/Datasheets/Backplane/BOM_FCI_Connectors.xls

BoM- FCI Connectors
Sl. No. | Manufacturer Part Number | Description | Mounted on | Qty per Set | Qty for 10 Sets
1 | 10043546-101LF | 3-Pair, 54 -position, 2 mm pitch, 6 column, Vertical Receptacle | Backplane | 6 | 60
2 | 10039851-111LF | 3-Pair, 54 -position, 2 mm pitch, 6 column, 4 Walls, Right Angle Header | Daughter card | 6 | 60
3 | 10045271-101LF | 3-Pair, 72 -position, 2 mm pitch, 8 column, Vertical Receptacle | Backplane | 30 | 300
4 | 10045267-111LF | 3-Pair, 72 -position, 2 mm pitch, 8 column, 4 Walls, Right Angle Header | Daughter card | 30 | 300
5 | 10052842-101LF | 4-Pair, 96 -position, 2 mm pitch, 8 column, Vertical Receptacle | Backplane | 12 | 120
6 | 10052838-101LF | 4-Pair, 96 -position, 2 mm pitch, 8 column, 4 Walls, Right Angle Header | Daughter card | 12 | 120
7 | 10028916-4554P00LF | Power Receptacle 2x2 | Backplane | 16 | 160
8 | 10073379-001LF | Power Header (2x2) | Daughter card | 16 | 160
9 | 51740-10400804CALF | V/T REC POWERBLADE | Backplane | 2 | 20
10 | 51720-10400804AALF | R/A HDR PWRBLADE | Daughter card | 2 | 20
11 | 10037910-102LF | 10.8 mm Guide Pin with External thread | Backplane | 34 | 340
12 | 10045597-101LF | 10.8 mm Guide Module Assembly ( 0 deg) | Daughter card | 12 | 120
13 | 10045597-103LF | 10.8 mm Guide Module Assembly ( 90 deg) | Daughter card | 5 | 50
14 | 10045597-105LF | 10.8 mm Guide Module Assembly ( 180 deg) | Daughter card | 5 | 50
15 | 10045597-107LF | 10.8 mm Guide Module Assembly ( 270 deg) | Daughter card | 12 | 120
16 | 20020620-M141A01LF | Terminal Blocks : Pluggable socket, straight, 7.62 mm pitch, 14 position | Backplane | 1 | 10
17 | 20020516-M141B01LF | Terminal Blocks : Pluggable plug, contact down side, 7.62 mm pitch, 14 position | Connect to Cable | 1 | 10
