Sayidathahaseen/CCC_NGP_ODC/NGP_ODC_Main/PDLC/design/Thermal_Analysis/APP/APP_Thermal_Components.xls

Item | Qty | Reference | MFG #1 P/N | MFG #1 | Description | Package | Power (W)
1 | 1 | U21 | AR8031 | Atheros | Integrated 10/100/1000 Gigabit Ethernet Transceiver | QFN48 | 0.5
2 | 1 | U29 | ET1100 | BECKHOFF | EtherCAT Slave Controller | BGA128 | 0.5
3 | 2 | U13-14 | LAN8720Ai | SMSC | ETHERNET 10/100 PHY RMII 24QFN | QFN24 | 0.15
4 | 1 | U47 | LM3495MTC/NOPB | National Semiconductor | IC PWM BUCK REG LOW-OUT 16-TSSOP | TSSOP-16 | 0.55
5 | 1 | U43 | LTC4227IUFD-1#PBF | Linear Technology | IC CONTROLLER HOT SWAP 20-QFN | WFQFN-20 | 0.25
6 | 1 | J1 | MT8JSF25664HZ-1G1D1 | Micron | DRAM Module DDR3 SDRAM 2GByte 204SODIMM |  | 2.5
7 | 1 | U3 | MR0A08BYS35 | EverSpin Technologies | IC MRAM 1MBIT 35NS 44TSOP | TSOP44 | 0.6
8 | 1 | U1 | P1021EC | Freescale |  | BGA-689 | 3.6
9 | 2 | U15 U19 | KSZ8721BLI | Micrel Inc | IC TXRX PHY 10/100 3.3V 48LQFP | 48LQFP | 0.5
10 | 1 | U46 | TPS51116PWPR | Texas Instruments | IC DDR SYNC BUC CTRL REF20HTSSOP | HTSSOP20 | 0.5
11 | 1 | U44 | TPS54332DDA | Texas Instruments | 3.5A Buck DC-DC Convertor | SO8_PPAD | 0.15
12 | 1 | U45 | TPS76850QPWP | Texas Instruments | IC, LDO VOLT REG, 5V, 1A, 20-HTSSOP | HTSSOP20 | 0.75
