Sayidathahaseen/CCC_NGP_ODC/NGP_ODC_Main/PDLC/design/Thermal_Analysis/IES/IES_Thermal_Components.xls

Item | Qty | Reference | MFG #1 P/N | MFG #1 | Description | Package | Power (W) | Comments
1 | 7 | U4,U7,U9,U11,U13,U15,U17 | ET1100 | BECKHOFF | EtherCAT Slave Controller | BGA128 | 0.5 | Power dissipation for each IC
2 | 2 | U15 U19 | KSZ8721BLI | Micrel Inc | IC TXRX PHY 10/100 3.3V 48LQFP | 48LQFP | 0.5 | Power dissipation for each IC
3 | 1 | U2 | TPS54331 | Texas Instruments | 3A Buck DC-DC Converter | 8-SOIC | 0.15 | Power dissipation for each IC
4 | 1 | U43 | LTC4227IUFD-1#PBF | Linear Technology | IC CONTROLLER HOT SWAP 20-QFN | 20-QFN | 0.25 | Power dissipation for each IC
