Sayidathahaseen/CCC_NGP_ODC/NGP_ODC_Main/PDLC/design/Thermal_Analysis/PCC/PCC_Thermal_Components.xls

Item | Qty | Reference | MFG #1 P/N | MFG #1 | Description | Package | Power (W) | Comments
1 | 1 | HS2(Q1,Q3,Q4) | - | - | - | - | 10 | Power Dissipation on Heatsink2
2 | 1 | T1 | - | - | - | - | 8 | Transformer Power Dissipation
3 | 1 | L1 |  |  |  |  | 3 | Inductor Power Dissipation
4 | 1 | L2 |  |  |  |  | 3 | Inductor Power Dissipation
 | 1 | L3 |  |  |  |  | 8 | Inductor Power Dissipation
 | 2 | HS1(D1,D2,Q6) |  |  |  |  | 15 | Power Dissipation on Heatsink2
 |  |  |  |  |  |  | 47 | Total Power Dissipation
 |  | Q1 | IPP072N10N3 G | Infineon | N Ch Mosfet, 100 V, 7.2 mohm | TO-220
 |  | Q3,Q4 | IPP023N04N G | Infineon | N Ch Mosfet, 40 V, 2.3 mohm | TO-220
 |  | T1 | PA1005.100NL | Pulse Engineering | XFMR CURR SENSE 2.0MH, 20 A SMD | SMD
 |  | L1,L2 | IHLP6767GZER3R3M01 | Vishay/Dale | Input choke, 3.88 mohm, SMD | 17.5 x 17.5 x 7; L x W x H
 |  | L3 | Core-K3515E060,Bobbin PCB3515M1 | Kool-Mu | Output choke
 |  | Q6 | IPP024N06N3 G | Infineon | N Ch Mosfet, 60 V, 2.4 mohm | TO-220
 |  | D1,D2 | MBR60L45WTG | ON Semi | Schottky Diode, 45 V, 60 A | TO-247
