Sayidathahaseen/CCC_NGP_ODC/NGP_ODC_Main/PDLC/Prodigy HW files/IBS/BoM ordering/BoM_IES_NGP.xls

Item | QTY | Reference | Value | Part Name | Package | Description | Distributor | Distributor P/N | MFG#1 | MFG#1_P/N | Price for Qty-1 | Per board cost @Qty1 | Unit Price for 1000 Qty | Per board cost @Qty1000
1 | 2 | J1 J4 | PWR Connector | 10028917-001LF,PWR Connector |  | Power Header 2x2 | FCI | 10028917-001LF | FCI | 10028917-001LF | $7.8300 | $15.6600 | $4.3230 | $8.6460
2 | 7 | U5 U8 U10 U12 U14 U16 U18 | 24LC16B | 24LC01B,24LC16B | 8-SOIC | IC EEPROM 16KBIT 400KHZ 8SOIC | Digikey | 24LC16B-I/SN-ND | Microchip Technology | 24LC16B-I/SN | $0.4000 | $2.8000 | $0.2600 | $1.8200
4 | 3 | C302-303, C254 | 100uF | CAP-AE4,100uF | 2917 | CAP TANT LOESR 100UF 10V 10% SMD | DIGIKEY | 478-1777-1-ND | AVX | TPSD107K010R0100 | $1.1300 | $3.3900 | $0.3980 | $1.1940
5 | 1 | C245 | 0.015uF | CAP-CC05,0.015uF,+/-10% | 402 | CAP CERM 15000PF 16V X7R 0402 | Digikey | 399-4878-1-ND | Kemet | C0402C153K4RACTU | $0.4290 | $0.4290 | $0.1014 | $0.1014
7 | 5 | C45-46 C300-301, C247 | 1nF | CAP-CC05,1nF,10% | C0805 | CAP CERM 1000PF 10% 50V X7R 0805 | Digikey | 478-1371-1-ND | AVX | 08055C102KAT2A | $0.0500 | $0.2500 | $0.0117 | $0.0585
8 | 2 | C243 C248 | 4.7uF | CAP-CC05,4.7uF,+/-10% | 1206 | CAP 4.7UF 16V CERAMIC X5R 1206 | Digikey | 399-1265-1-ND | Kemet | C1206C475K4PACTU | $0.3720 | $0.7440 | $0.0682 | $0.1364
9 | 1 | C249 | 47pF | CAP-CC05,47pF,±5% | 603 | CAP CERAMIC 47PF 50V NP0 0603 | Digikey | 399-1056-1-ND | Kemet | C0603C470J5GACTU | $0.0700 | $0.0700 | $0.0091 | $0.0091
10 | 2 | C250-251 | 47uF | CAP-CC05,47uF,±20% | 1311 | CAP TANT 47UF 10V 20% SMD | Digikey | 399-4981-1-ND | Kemet | T520B476M010ATE035 | $1.5000 | $3.0000 | $0.6300 | $1.2600
11 | 1 | C341 | 1000pF | CAPC-1000PF-2KV-1206-X7R,1000pF,±10% | 1206 | CAP CERM 1000PF 2000V X7R 1206 | Digikey | 478-2956-1-ND | AVX Corporation | 1206GC102KAT1A | $0.6600 | $0.6600 | $0.1560 | $0.1560
12 | 147 | C1 C4-7 C12-22 C36-42 C47 C50-51 C55 C57-60 C65-75 C89 C91-94 C99-109 C122 C126 C128-131 C136-146 C159 C163 C165-168 C173-183 C196 C200 C202-205 C210-220 C234 C236-239 C246 C252-253 C255 C257 C260-266 C271 C273-283 C296-297 C299 C304-305 C308 C244 C258-259 | 100nF | CAP_100NF_50V_0603,100nF,10% | C0603 | CAP CER .1UF 50V 10% X7R 0603 | Digikey | 490-1519-1-ND | Murata | GRM188R71H104KA93D | $0.1400 | $20.5800 | $0.0111 | $1.6244
14 | 21 | C3 C35 C43-44 C86 C88 C157 C256 C267-268 C33 C162 C194 C199 C231 C233 C54 C120 C125 C294 C298 | 10uF | CAP_10UF_6.3V_0805,10uF,20% | 805 | CAP CER 10UF 6.3V 20% X5R 0805 | Digikey | 490-1718-1-ND | Murata | GRM21BR60J106ME19L | $0.4200 | $8.8200 | $0.0420 | $0.8820
16 | 12 | C48-49 C52-53 C123-124 C160-161 C197-198 C269-270 | 12pF | CAP_12PF_50V_0603,12pF,5% | C0805 | CAP CER 12PF 5% 50V NP0 0805 | Digikey | 478-1305-1-ND | AVX | 08055A120JAT2A | $0.1100 | $1.3200 | $0.0260 | $0.3120
17 | 112 | C2 C8-11 C23-32 C34 C56 C61-64 C76-85 C87 C90 C95-98 C110-119 C121 C127 C132-135 C147-156 C158 C164 C169-172 C184-193 C195 C201 C206-209 C221-230 C232 C235 C240-242 C272 C284-293 C295 | 220pF | CAP_220PF_50V_0603,220pF,20% | C0603 | CAP CER 220PF 50V 20% X7R 0603 | Digikey | 490-1484-1-ND | Murata | GRM188R71H221MA01D | $0.1900 | $21.2800 | $0.0156 | $1.7472
18 | 2 | J2-3 | High speed diff. connector | CON3_0,High speed diff. connector |  | 3-Pair, 72 -position, 2 mm pitch, 8 column, 4 Walls, Right Angle Header | FCI | 10045267-101LF | 10045267-101LF | FCI |  | $0.0000 | $0.0000 | $0.0000
19 | 7 | U4 U7 U9 U11 U13 U15 U17 | ET1100,BGA128 | ET1100,ET1100,BGA128 | BGA128 | EtherCAT Slave Controller | BECKHOFF | ET1100 | BECKHOFF | ET1100 |  | $0.0000 | $0.0000 | $0.0000
21 | 1 | L5 | 10uH | IND-MOLDED,10uH | 0.409" L x 0.409" W x 0.189" H | INDUCTOR POWER 10UH 3.4A SMD | Digikey | 495-1796-1-ND | EPCOS Inc | B82464G4103M | $1.8200 | $1.8200 | $1.4013 | $1.4013
22 | 4 | L1-2 L6-7 | 120R | IND-MOLDED,120R,dsf | 805 | FERRITE CHIP 120 OHM 800MA 0805 | Digikey | 445-2190-1-ND | TDK corporation | MMZ2012R121A | $0.3600 | $1.4400 | $0.0490 | $0.1958
23 | 28 | D1 D4 D6 D8 D10 D12 D14-31 D33-36 | LED Green | LED,LED Green | 805 | LED GREEN CLEAR 0805 SMD | Digikey | 160-1414-1-ND | Lite-On-Inc | LTST-C170KGKT | $0.5200 | $14.5600 | $0.0783 | $2.1924
24 | 1 | D39 | LED RED | LED,LED RED | 805 | LED SUPER RED CLEAR 0805 SMD | Digikey | 160-1415-1-ND | Lite-On-Inc | LTST-C170KRKT | $0.4400 | $0.4400 | $0.0875 | $0.0875
25 | 1 | U1 | LT4227 | LT4227,LT4227 | 20-WFQFN Exposed Pad | IC CONTROLLER HOT SWAP 20-QFN | Digikey | LTC4227IUFD-1#PBF-ND | Linear Technology | LTC4227IUFD-1#PBF | $7.9800 | $7.9800 | $4.5500 | $4.5500
26 | 1 | Q3 | Si7336ADP | MOSFET_N_SGD,Si7336ADP | PowerPAKSO-8 | MOSFET N-CH 30V 30A PPAK 8SOIC | Digikey | SI7336ADP-T1-E3CT-ND | Vishay | SI7336ADP-T1-E3 | $3.1500 | $3.1500 | $1.5750 | $1.5750
27 | 2 | Q1-2 | SiR462DP | MOSFET_N_SGD,SiR462DP | PowerPAKSO-8 | MOSFET N-CH 30V 30A PPAK 8SOIC | Digikey | SIR462DP-T1-GE3CT-ND | Vishay | SIR462DP-T1-GE3 | $1.4600 | $2.9200 | $0.6460 | $1.2920
29 | 1 | U3 | ADG774A | MUX08_1,ADG774A | 16-VFQFN, CSP Exposed Pad | IC MUX QUAD 2X1 16LFCSP | Digikey | ADG774ABCPZ-R2CT-ND | Analog Devices | ADG774ABCPZ-R2 | $5.4600 | $5.4600 | $2.5480 | $2.5480
30 | 1 | U20 | PCA9557 | MUX08_3,PCA9557 | 16-HVQFN | IC I/O EXPANDER I2C 8B 16HVQFN | Digikey | 568-3398-1-ND | NXP semiconductors | PCA9557BS,118 | $1.7200 | $1.7200 | $0.7840 | $0.7840
31 | 2 | U6 U19 | PHY1_KSZ8721BLI | PHY,PHY1_KSZ8721BLI | 48LQFP | IC TXRX PHY 10/100 3.3V 48LQFP | Digikey | 576-1029-ND | Micrel Inc | KSZ8721BLI | $5.3200 | $10.6400 | $3.3782 | $6.7564
32 | 1 | R133 | 0.0095E | RES-1/8W,0.0095E,1% | R2512 | RES .009 OHM 2W 1% 2512 SMD | Digikey | RHM.009AUCT-ND | RoHm | PMR100HZPFU9L00 | $0.7800 | $0.7800 | $0.1691 | $0.1691
33 | 2 | R124 R130 | 0R | RES-1/8W,0R,±5% | R1210 | RES 0.0 OHM 1/2W 1210 SMD | Digikey | 541-0.0VCT-ND | Vishay | CRCW12100000Z0EA | $0.2610 | $0.5220 | $0.0551 | $0.1102
34 | 25 | R134-136 R141 R143 R145 R147-150 R152-158 R160-161 R167-171 R256 | 100E | RES-1/8W,100E,±5% | R0805 | RES 100 OHM 1/8W 5% 0805 SM | Digikey | 311-100ARCT-ND | Yageo | RC0805JR-07100RL | $0.0170 | $0.4250 | $0.0035 | $0.0880
35 | 1 | R129 | 100K | RES-1/8W,100K,±1% | R0805 | RES 100K OHM 1/8W 1% 0805 SMD | Digikey | 311-100KCRCT-ND | Yageo | RC0805FR-07100KL | $0.2100 | $0.2100 | $0.0045 | $0.0045
36 | 1 | R206 | 10E | RES-1/8W,10E,±5% | R0805 | RES 10 OHM 1/8W 5% 0805 SM | Digikey | 311-10ARCT-ND | Yageo | RC0805JR-0710RL | $0.0170 | $0.0170 | $0.0035 | $0.0035
37 | 1 | R125 | 10k2 | RES-1/8W,10k2,1% | R0805 | RES 10.2K OHM 1/8W 1% 0805 SMD | Digikey | 311-10.2KCRCT-ND | Yageo | RC0805FR-0710K2L | $0.0210 | $0.0210 | $0.0045 | $0.0045
38 | 1 | R132 | 20k | RES-1/8W,20k,±5% | R0805 | RES 20K OHM 1/8W 5% 0805 SMD | Digikey | 311-20ARCT-ND | Yageo | RC0805JR-0720KL | $0.0170 | $0.0170 | $0.0035 | $0.0035
39 | 1 | R127 | 29k4 | RES-1/8W,29k4,±1% | R0805 | RES 29.4K OHM 1/8W 1% 0805 SMD | Digikey | 311-29.4KCRCT-ND | Yageo | RC0805FR-0729K4L | $0.0210 | $0.0210 | $0.0045 | $0.0045
40 | 1 | R128 | 332K | RES-1/8W,332K,±1% | R0805 | RES 332K OHM 1/8W 1% 0805 SMD | Digikey | 311-332KCRCT-ND | Yageo | RC0805FR-07332KL | $0.0210 | $0.0210 | $0.0045 | $0.0045
41 | 1 | R126 | 3k24 | RES-1/8W,3k24,±1% | R0805 | RES 3.24K OHM 1/8W 1% 0805 SMD | Digikey | 311-3.24KCRCT-ND | Yageo | RC0805FR-073K24L | $0.0210 | $0.0210 | $0.0045 | $0.0045
42 | 1 | R209 | 47E | RES-1/8W,47E,±5% | R0805 | RES 47 OHM 1/8W 5% 0805 SMD | Digikey | 311-47ARCT-ND | Yageo | RC0805JR-0747RL | $0.0170 | $0.0170 | $0.0035 | $0.0035
43 | 1 | R131 | 64k2 | RES-1/8W,64k2,0.5% | R0805 | Thick Film Resistors - SMD 1/8watt 64.2Kohms 0.5% | Mouser | 71-CRCW08056422DT | Vishay | CRCW08056422DT | $0.0900 | $0.0900 | $2e-05 | $2e-05
44 | 1 | R9 | 11k | RES-12K-5-0603,11k,1% | R0805 | RES 11.0K OHM 1/8W 1% 0805 SMD | Digikey | 311-11.0KCRCT-ND | yageo | RC0805FR-0711KL | $0.0210 | $0.0210 | $0.0045 | $0.0045
45 | 6 | R1 R16 R74 R93 R115 R224 | 11k | RES-12K-5-0603,11k,5% | R0805 | ass | Digikey | 311-11KGRCT-ND | yageo | RC0603JR-0711KL | $0.0100 | $0.0600 | $0.0022 | $0.0133
46 | 2 | R14 R213 | 1k | RES-1K-5-0603,1k,1% | R0805 | RES 1.00K OHM 1/8W 1% 0805 SMD | Digikey | 311-1.00KCRCT-ND | Yageo | RC0805FR-071KL | $0.0210 | $0.0420 | $0.0045 | $0.0090
47 | 29 | R3 R36 R45 R57 R76 R95 R109 R159 R162-163 R174-175 R186-187 R194-198 R200-205 R233 R243-245 | 470R | RES-470R-5-0603,470R,5% | R0805 | RES 470 OHM 1/8W 5% 0805 SMD | Digikey | 311-470ARCT-ND | Yageo | RC0805JR-07470RL | $0.0170 | $0.4930 | $0.0035 | $0.1021
48 | 4 | R88 R103 R122-123 | 49R9 | RES-470R-5-0603,49R9,0.5% | R0805 |  | Digikey | 311-49.9BCT-ND | Yageo | RT0805DRE0749R9L | $0.1170 | $0.4680 | $0.0250 | $0.0998
49 | 2 | R309-310 | 75E | RES-75E-5%-0603-0.1W,75E,5% | 603 | RES 75 OHM 1/10W 5% 0603 SMD | Digikey | P75GCT-ND | Panasonic - ECG | ERJ-3GEYJ750V | $0.0200 | $0.0400 | $0.0026 | $0.0051
50 | 21 | R6 R25-26 R116 R142 R144 R146 R151 R164-166 R176-178 R188-191 R193 R211-212 | 4.7K | RES-SIP8P4R,4.7K,5% | 2012 | RES ARRAY 4.7K OHM 8TRM 4RES SMD | Digikey | CRA12E84.7KCT-ND | Vishay/Dale | CRA12E0834K70JTR | $0.2300 | $4.8300 | $0.1000 | $2.1000
52 | 129 | R2 R4-5 R7-8 R10-13 R17-24 R27 R29-35 R37-44 R46-49 R51-56 R58-68 R70-73 R75 R77-87 R89-92 R94 R96-102 R104-108 R110-114 R117-121 R137-140 R172-173 R179-184 R207 R210 R214-215 R225-226 R228-232 R234-238 R240 R185 R192 R199 | 4k7 | RES4K7-1-0603,4k7,1% | R0805 | RES 4.70K OHM 1/8W 1% 0805 SMD | Digikey | 311-4.70KCRCT-ND | Yageo | RC0805FR-074K7L | $0.0210 | $2.7090 | $0.0045 | $0.5779
53 | 3 | TP_+3V3 TP_+6V5 TP_GND | LABEL | TESTPOINT-LOOP-SM,LABEL | SMT | C TEST POINT MINIATURE SMT | DIGIKEY | 5015KCT-ND | KEYSTONE | 5015 | $1.0200 | $3.0600 | $0.2554 | $0.7663
55 | 1 | U2 | TPS54331 | TPS54231,TPS54331 | 8-SOIC | IC DC/DC CONV STEP-DWN 8-SOIC | Digikey | 296-23626-5-ND | Texas Instruments | TPS54331D | $4.6200 | $4.6200 | $2.3100 | $2.3100
56 | 1 | T1 | HX1188 | XFMR-HX1188NL,HX1188 | SOIC-16 | MODULE XFRMR SGL ETHR LAN 16SOIC | Digikey | 553-1340-ND | PULSE | HX1188NL | $3.9500 | $3.9500 | $2.0540 | $2.0540
57 | 6 | Y2-7 | 25MHz | XTAL-24MHZ,25MHz | 4-SMD, No Lead (DFN, LCC) | CRYSTAL 25.000 MHZ 10 PF SMD | Digikey | 535-10251-1-ND | Abracon Carporation | ABM11-25.000MHZ-B7G-T | $2.5500 | $15.3000 | $1.2920 | $7.7520
58 | 1 | Y1 | TCXO,25MHz | XTAL-24MHZ,TCXO,25MHz | 4-SMD, No Lead (DFN, LCC) | OSCILLATOR TCXO 25.0MHZ 3.3V SMD | Digikey | 631-1074-1-ND | Fox Electronics | FOX924B-25.000 | $4.7600 | $4.7600 | $2.4130 | $2.4130
59 | 1 | D13 | B340A | ZENER-DIODE,B340A | DO-214AC, SMA | DIODE SCHOTTKY 40V 2A SMA | Digikey | B240A-FDICT-ND | Diodes Inc | B240A-13-F | $0.5800 | $0.5800 | $0.1237 | $0.1237
60 | 2 | D37-38 | SMAJ6.5A | ZENER-DIODE,SMAJ6.5A | DO-214AC, SMA | DIODE TVS 6.5V 400W UNI 5% SMD | Digikey | SMAJ6.5ABCT-ND | Bourns Inc | SMAJ6.5A | $0.2500 | $0.5000 | $0.1378 | $0.2756
 |  |  |  |  |  |  |  |  |  |  | $61.2110 | $172.7280 | $30.1426 | $58.3359
