Sayidathahaseen/CCC_NGP_ODC/NGP_ODC_Main/PDLC/Prodigy HW files/APP/BoM ordering/REV2/APP-rev2-oeder-bom-avnet.xls

# | ITEM | DESCRIPTION | MFR #1 PART NUM | MFR #1 | Order Qty | Ordered | Avnet P/N
1 | 152 | IC SWITCH BUS 8BIT FET 20-VQFN | SN74CB3Q3245RGYR | Texas Instruments | 19 | 19 | SN74CB3Q3245RGYR/BKN
2 | 151 | 128Mbit 3V SPI Flash Memory | S25FL128P0XNFI001 | Spansion | 3
3 | 91 | Conn DIMM Socket SKT 204 POS | 2013310-1 | TE Connectivity / AMP | 19
4 |  | DRAM Module DDR3 SDRAM | MT4JSF12864HZ-1G1D1 | Micron | 2
