Sayidathahaseen/CCC_NGP_ODC/NGP_ODC_Main/PDLC/Prodigy HW files/APP/BoM ordering/REV2/APP-rev2-order-bom-mouser.xls

Sl. No: | ITEM | PART TYPE | VALUE | DESCRIPTION | MFR #1 PART NUM | MFR #1 | REFERENCE DES | QTY | Distributor | Order Qty | Ordered
1 | 47 | CONN-MICRO-SD | MICRO SD CONN | Micro SD Socket Hinge Type | ST1W008S4AR1500 | JAE Electronics | J3 | 1 | Mouser | 19 | 20 | APP_ST1W008S4AR1500
2 | 159 | TPS76850 | TPS76850 | IC, LDO VOLT REG, 5V, 1A, 20-HTSSOP | TPS76850QPWP | Texas Instruments | U45 | 1 | Mouser | 19 | 20 | APP_TPS76850QPWP
3 | 61 | FB-120OHM-0603 | 120E | EMI/RFI Suppressors & Ferrites 0603 120ohms | BLM18PG121SH1D | Murata | FB19-20 | 2 | Mouser | 38 | 40 | APP_BLM18PG121SH1D
4 | 45 | CONN-HD-3P | 22-28-5033 | Headers & Wire Housings 2.54MM HDR VT 3P | 22-28-5033 | Molex | J8 | 1 | Mouser | 19 | 20 | APP_22-28-5033
5
6 | 75 | LAN8720AI-QFN24 | LAN8720Ai | ETHERNET 10/100 PHY RMII 24QFN | LAN8720Ai | SMSC | U13-14 | 2 | Mouser | 38 | 40 | APP_LAN8720Ai
7 | 49 | CONN_SOCKET_5 | USB - OTG Mini-B | USB OTG Mini-B Receptacle, Vertical, TH | 5000750517 | Molex | J4 | 1 | Mouser | 19 | 20 | APP_5000750517
8 | 89 | MC74LCX373 | MC74LCX373 | IC LATCH TRANSP OCT LV 20-TSSOP | MC74LCX373DTG | ON Semiconductor | U4-5 | 2 | Mouser | 38 | 40 | APP_MC74LCX373DTG
9 | 94 | OSC/50MHZ | OSC-50MHz | OSC MEMS 50.000 MHZ SMD | ASFLMB-50.000MHZ-LY-T | ABRACON | U8 U12 U18 | 3 | Mouser | 57 | 60 | APP_ASFLMB-50.000MHZ-LY-T
10 | 157 | TPS51116 | TPS51116 | IC DDR SYNC BUC CTRL REF20HTSSOP | TPS51116PWPR | Texas Instruments | U46 | 1 | Mouser | 19 | 20 | APP_TPS51116PWPR
11 | 158 | TPS54231 | TPS54332 | 3.5A Buck DC-DC Convertor | TPS54332DDA | Texas Instruments | U44 | 1 | Mouser | 19 | 20 | APP_TPS54332DDA
12 | 92 | MR0A08B | MR0A08B | IC MRAM 1MBIT 35NS 44TSOP | MR0A08BCYS35 | EverSpin Technologies | U3 | 1 | TSOP80P1176X120-44N | 10.44 |  | Digikey | 19
