Sayidathahaseen/CCC_NGP_ODC/NGP_ODC_Main/PDLC/Prodigy HW files/APP/BoM ordering/REV2/APP-rev2-orderbom-arrow.xls

ITEM | PART TYPE | VALUE | DESCRIPTION | MFR #1 PART NUM | MFR #1 | REFERENCE DES | QTY | Distributor | Order Qty | Ordered
83 | LM3495 | LM3495 | IC PWM BUCK REG LOW-OUT 16-TSSOP | LM3495MTC/NOPB | National Semiconductor | U47 | 1 | Arrow | 19
