Sayidathahaseen/CCC_NGP_ODC/NGP_ODC_Main/PDLC/Prodigy HW files/APP/REV 2/Library Update/BOM COMPARISON REPORT.xls

Sheet: UPDATED_BOM.xls
Refdes | Quantity | Manufacturer | Manufacturer PN | Footprint | Value | Description
BT1 | 1 | RENATA | SMTU2430-LF.TR |  | Battery Holders | BATTERY HOLDER,CR2430
C1,C3,C5,C6,C9,C14,C16,C17,C18,C19,C23,C26,C27,C28,C29,C33,C35,C36,C37,C51,C66,C80,C84,C85,C86,C87,C88,C89,C90,C91,C96,C97,C98,C99,C100,C101,C120,C139,C140,C141,C142,C146,C148,C156,C283,C286,C287,C288,C289,C291,C292,C293,C294,C299,C303,C309,C321,C326,C327,C328,C330,C332,C369,C371,C374 | 65 | AVX | 06035C104KAT2A |  | 0.1UF | CAP,CER,0.1UF,50V,10%,X7R,0603
C2,C4,C7,C10,C15,C24,C25,C32,C34,C47,C50,C52,C58,C67,C295,C296,C329,C331 | 18 | AVX | 06035C103KAT2A |  | 0.01UF | CAP,CER,10000PF,50V,10%,X7R,0603
C8,C11,C21,C22,C48,C59,C62,C63,C102,C119,C320,C347,C366,C367,C368 | 15 | MURATA | GRM21BR61E106KA73L |  | 10UF | CAP,CER,10UF,25V,10%,X5R,0805
C20,C42,C43,C44,C45,C46,C49,C53,C54,C55,C56,C57,C60,C68,C69,C70,C71,C72,C73,C74,C76,C83,C92,C93,C94,C95,C103,C104,C105,C106,C107,C108,C109,C110,C111,C112,C113,C114,C115,C116,C117,C118,C163,C164,C165,C166,C167,C168,C169,C170,C171,C172,C173,C174,C175,C176,C191,C192,C193,C194,C195,C196,C197,C198,C199,C200,C201,C202,C203,C204,C205,C206,C207,C208,C227,C228,C229,C230,C234,C235,C237,C238,C239,C240,C244,C245,C246,C247,C248,C256,C257,C258,C271,C279,C280,C281,C282,C284,C333,C334,C335,C336,C337,C338,C339,C340,C342,C343,C344,C345,C346,C348,C349,C350,C351,C352,C353,C354,C355,C356 | 120 | TDK | C1005X7R1H104M |  | 0.1UF | CAP,CER,0.1UF,50V,20%,X7R,0402
C30,C38 | 2 | TDK | C1608X5R1A475K |  | 4.7UF | CAP,CER,4.7UF,10V,10%,X5R,0603
C31,C39,C77,C78,C79 | 5 | AVX | 06035C471KAT2A |  | 470PF | CAP,CER,470PF,50V,10%,X7R,0603
C40,C41,C61,C313,C370,C372 | 6 | TAIYO YUDEN | UMK107BJ105KA-T |  | 1UF | CAP,CER,1UF,50V,10%,X5R,0603
C64,C65,C81,C82,C137,C138,C150,C151 | 8 | AVX | 06035A200JAT4A |  | 20PF | CAP,CER,20PF,50V,5%,NP0,0603
C75,C269,C270,C272,C273,C274,C275 | 7 | AVX | 0402YD105KAT2A |  | 1UF | CAP,CER,1UF,16V,10%,X5R,0402
C121,C122,C123,C124,C125,C126,C127,C128,C129,C130,C131,C132,C133,C134,C135,C136 | 16 | AVX | 04025C221KAT2A |  | 220PF | CAP,CER,220PF,50V,10%,X7R,0402
C143 | 1 | AVX | TPSB226K020R0400 |  | 22UF | CAP,TANT,22UF,20V,10%,1210
C144,C145,C147,C325 | 4 | AVX | 08053D475KAT2A |  | 4.7UF | CAP,CER,4.7UF,25V,10%,X5R,0805
C149,C290,C318,C319 | 4 | TAIYO YUDEN | TMK316B7106KL-TD |  | 10UF | CAP,CER,10UF,25V,10%,X7R,1206
C152,C153,C154,C155,C304,C307 | 6 | TDK | C1608X5R1A106M |  | 10UF | CAP,CER,10UF,10V,20%,X5R,0603
C157,C158,C159,C160,C161,C162 | 6 | AVX | TPSB476K010R0250 |  | 47UF | CAP,TANT,LOWESR,47UF,10V,10%,1210
C177,C178,C179,C180,C181,C182,C183,C184,C185,C186,C187,C188,C189,C190,C209,C210,C211,C212,C213,C214,C215,C216,C217,C218,C219,C220,C221,C222,C223,C224,C225,C226,C231,C232,C233,C236,C241,C242,C243,C249,C250,C251,C252,C253,C254,C255,C259,C260,C261,C262,C263,C264,C265,C266,C267,C268,C357,C358,C359,C360,C361,C362,C363,C364,C365,C373 | 66 | AVX | 04025C103KAT2A |  | 0.01UF | CAP,CER,10000PF,50V,10%,X7R,0402
C276,C277 | 2 | TDK | C1005X5R0J225M |  | 2.2UF | CAP,CER,2.2UF,6.3V,20%,X5R,0402
C278 | 1 | AVX | 04025C332KAT2A |  | 3300PF | CAP,CER,3300PF,50V,10%,X7R,0402
C285,C314 | 2 | TDK | C1608X7R1H101K |  | 100PF | CAP,CER,100PF,50V,10%,X7R,0603
C297,C305,C306 | 3 | AVX | TPSE107K020R0150 |  | 100UF | CAP,TANT,100UF,20V,10%,2917
C298 | 1 | AVX | 06035C153KAT2A |  | 0.015UF | CAP,CER,15000PF,50V,10%,X7R,0603
C300 | 1 | AVX | 06035C102KAT2A |  | 1000PF | CAP,CER,1000PF,50V,10%,X7R,0603
C301 | 1 | AVX | 06035A470JAT2A |  | 47PF | CAP,CER,47PF,50V,5%,NP0,0603
C302,C317 | 2 | MURATA | GRM31CR71A226KE15L |  | 22UF | CAP,CER,22UF,10V,10%,X7R,1206
C308 | 1 | AVX | 06035C333JAT2A |  | 0.033UF | CAP,CER,33000PF,50V,5%,X7R,0603
C310 | 1 | AVX | 0603YD225KAT2A |  | 2.2UF | CAP,CER,2.2UF,16V,10%,X5R,0603
C311,C312 | 2 | AVX | 1210YC226KAT2A |  | 22UF | CAP,CER,22UF,16V,10%,X7R,1210
C315 | 1 | AVX | TPSB106M016R0800 |  | 10UF | CAP,TANT,LOESR,10UF,16V,20%,1210
C316,C324 | 2 | KEMET | T520D157M006ATE015 |  | 150UF | CAP,TANT,150UF,6.3V,20%,2917
C322,C323 | 2 | KEMET | C1206C107M9PACTU |  | 100UF | CAP,CER,100UF,6.3V,20%,X5R,1206
C341 | 1 | AVX | 1206GC102KAT1A |  | 0.001UF | CAP,CER,1000PF,2000V,10%,X7R,1206
D1,D2,D11,D12,D13,D14,D21 | 7 | LUMEX | SSF-LXH512SUGD |  | DUAL GREEN | LED,DUAL GREEN,T- 2MM,100MCD@20MA
D3,D4,D22,D26,D28 | 5 | LITE-ON INC | LTST-C170KGKT |  | GREEN | LED,GREEN,FLAT TOP, 1.4MM X 1.25MM ,35MCD @20MA
D5 | 1 | SEMTECH | RCLAMP0504S.TCT |  | RCLAMP0504S.TCT | TVS,ARRAY,IC,LOWCAP,SOT23-6
D6,D7 | 2 | BOURNS INC | SMAJ7.5A |  | SMAJ7.5A | DIODE,TVS,7.5V,400W,UNI,5%,SMA
D8 | 1 | FAIRCHILD SEMICONDUCTOR | MBR0530 |  | MBR0530 | DIODE,SCHOTTKY,30V,0.5A,SOD-123
D9 | 1 | ROHM SEMICONDUCTOR | RB080L-30TE25 |  | RB080L-30TE25 | DIODE,SCHOTTKY,30V,5A,PMDS
D10 | 1 | DIODE/ ZETEX | B340A-13-F |  | B340A-13-F | DIODE,SCHOTTKY,40V,3A,DO-214AC
D15,D16,D19,D20 | 4 | DIALIGHT | 551-0209F |  | GREEN | LED,GREEN,DOMED TOP, 3MM ,16MCD @10MA
D17 | 1 | DIALIGHT | 551-0409F |  | RED | LED,RED,DOMED TOP, 3MM ,10MCD@10MA
D18 | 1 | DIALIGHT | 551-0309F |  | YELLOW | LED,YELLOW,DOMED TOP, 3MM ,6.3MCD@10MA
D23,D24 | 2 | OSRAM | LB Y87S-M1N2-35-Z |  | BLUE | LED,BLUE,FLAT TOP, 1.7MM X 0.7MM ,31.5MCD @10MA
D25 | 1 | DIALIGHT | 597-3601-207F |  | BLUE | LED,BLUE,FLAT TOP, 2.4MM ,11.15MCD @10MA
FB1,FB2,FB4,FB5,FB7,FB8,FB9,FB10,FB11,FB12,FB13 | 11 | MURATA | BLM18HG601SN1D |  | 600E | FERRITE BEAD,0603,Z=600E
FB3,FB6,FB14,FB15,FB16,FB17 | 6 | MURATA | BLM18PG121SN1D |  | 120E | FERRITE BEAD,0603,Z=120E
FB18,FB21 | 2 | TAIYO YUDEN | FBMH2012HM121-T |  | 120E | FERRITE BEAD,0805,Z=120E
FB19,FB20 | 2 | MURATA | BLM18PG121SH1D |  | 120E | FERRITE BEAD,0603,Z=120E
G1,G2 | 2 | FCI | 10045597-107LF |  | Guide Socket | GUIDE SOCKET,10.8MM,RA
J1 | 1 | TE CONNECTIVITY | 2013310-1 |  | DDR3 SDRAM | CONNECTOR,DDR3 SDRAM,204,SMT
J2 | 1 | TE CONNECTIVITY | 5103309-3 |  | HEADER | HEADER,2 x 8,2.54mm,TH,GOLD
J3 | 1 | JAE ELECTRONICS | ST1W008S4AR1500 |  | MICRO SD | CONNECTOR,MICRO SD,8,SMT,RA
J4 | 1 | MOLEX | 5000750517 |  | USB - OTG Mini-B | CONNECTOR,USB MINI-B,TH,VERTICAL
J5 | 1 | MOLEX | 15916102 |  | HEADER | HEADER,2 x 5,2.54mm,SM,GOLD
J6 | 1 | FCI | 10045267-111LF |  | HEADER | HEADER,9 x 8,2mm,TH,RA
J7 | 1 | FCI | 10028917-001LF |  | HEADER | HEADER,2 x 2,2mm,TH,RA
J8 | 1 | MOLEX | 22-28-5033 |  | HEADER | HEADER,1 x 3,2.54mm,TH,VERTICAL
J9 | 1 | FCI | 10039851-111LF |  | HEADER | HEADER,9 x 6,2mm,TH,RA
L5 | 1 | TDK CORPORATION | MLP2520S4R7S |  | 4.7uH | INDUCTOR,MULTILAYER,4.7UH,1A,1008
L8 | 1 | BOURNS INC | SRP7030-6R8FM |  | 6.8uH | INDUCTOR,POWER,6.8UH,4.5A,SMD
L9,L10 | 2 | TDK CORPORATION | SLF10165T-2R2N6R33PF |  | 2.2uH | INDUCTOR,POWER,2.2UH,6.3A, SMD
Q1,Q9,Q10,Q11 | 4 | NXPSEMICONDUCTORS | 2N7002PW,115 |  | 2N7002PW,115 | MOSFET,N-CH,SGL,60V,31A,SOT-323
Q2,Q3,Q4 | 3 | VISHAY | SIR462DP-T1-GE3 |  | SIR462DP-T1-GE3 | MOSFET,N-CH,30V,30A,PPAK,8SOIC
Q5,Q7 | 2 | INTERNATIONAL RECTIFIER | IRF7821TRPBF |  | IRF7821TRPBF | MOSFET,N-CH,30V,13.6A,8-SOIC
Q6,Q8 | 2 | INTERNATIONAL RECTIFIER | IRF7832TRPBF |  | IRF7832TRPBF | MOSFET,N-CH,30V,20A,8-SOIC
R1,R4,R17,R18,R19,R20,R23,R25,R35,R36,R37,R38,R39,R40,R41,R42,R88,R96,R144,R146,R153,R154,R155,R156,R157,R158,R159,R160,R161,R162,R164,R165,R167,R169,R170,R171,R172,R173,R177,R179,R180,R181,R182,R204,R205,R214,R215,R216,R339,R345,R361,R392,R393,R394,R395,R414 | 56 | YAGEO | RC0603FR-0710KL |  | 10K | RESISTOR,10K,0.1,1%,R0603
R2,R3 | 2 | YAGEO | RC0603FR-0740R2L |  | 40.2E | RESISTOR,40.2E,0.1,1%,R0603
R5,R10,R11,R12,R13,R14,R15,R27,R104,R106,R112,R166,R176,R178,R192,R193,R194,R195,R196,R197,R200,R201,R210,R211,R257,R270,R272,R275,R298,R351,R352,R357,R358,R359,R360,R377,R379,R400 | 38 | YAGEO | RC0603JR-070RL |  | 0E | RESISTOR,0E,0.1,-,R0603
R6 | 1 | PANASONIC - ECG | ERJ-2GEJ101X |  | 100E | RESISTOR,100E,0.1,5%,R0402
R7,R22,R58,R59,R60,R61,R79,R80,R81,R82,R140,R398 | 12 | YAGEO | RC0603FR-07100RL |  | 100E | RESISTOR,100E,0.1,1%,R0603
R8,R21,R34,R46,R47,R49,R51,R62,R66,R68,R70,R72,R87,R89,R97,R103,R107,R111,R113,R118,R119,R120,R121,R122,R128,R132,R133,R134,R135,R136,R163,R174,R175,R183,R184,R186,R187,R188,R189,R190,R191,R220,R221,R222,R223,R225,R226,R228,R229,R230,R232,R235,R236,R238,R239,R240,R242,R244,R247,R248,R249,R252,R254,R255,R256,R258,R260,R261,R262,R265,R267,R271,R273,R274,R276,R277,R279,R280,R283,R286,R287,R288,R289,R290,R292,R293,R296,R299,R302,R303,R304,R311,R312,R313,R314,R315,R316,R317,R318,R319,R320,R321,R322,R349,R350,R355,R356,R362,R378,R385,R386,R387,R388,R389,R390,R391,R396,R397,R402,R405,R406,R408,R409,R410,R411,R412,R413 | 127 | YAGEO | RC0603FR-074K7L |  | 4.7K | RESISTOR,4.7K,0.1,1%,R0603
R9,R152,R338,R342 | 4 | YAGEO | RC0603FR-07100KL |  | 100K | RESISTOR,100K,0.1,1%,R0603
R24,R327 | 2 | YAGEO | RC0603JR-0710RL |  | 10E | RESISTOR,10E,0.1,5%,R0603
R28,R29,R30,R31,R43,R44,R63,R64,R65,R83,R84,R85,R86,R90,R91,R92,R93,R94,R98,R99,R100,R101,R114,R115,R116,R117,R198,R346,R347,R348 | 30 | YAGEO | RC0603FR-0733RL |  | 33E | RESISTOR,33E,0.1,1%,R0603
R33 | 1 | YAGEO | RC0603FR-071KL |  | 1K | RESISTOR,1K,0.1,1%,R0603
R53,R54,R55,R56,R74,R75,R76,R77,R259,R263,R264,R266,R282,R306,R307,R308 | 16 | YAGEO | RC0603FR-0749R9L |  | 49.9E | RESISTOR,49.9E,0.1,1%,R0603
R57,R78 | 2 | YAGEO | RC0603FR-0712K1L |  | 12.1K | RESISTOR,12.1K,0.1,1%,R0603
R95,R102 | 2 | PANASONIC - ECG | ERJ-3EKF6491V |  | 6.49K | RESISTOR,6.49K,0.1,1%,R0603
R139 | 1 | YAGEO | RC0603FR-07200RL |  | 200E | RESISTOR,200E,0.1,1%,R0603
R141 | 1 | YAGEO | RC0603FR-072K37L |  | 2.37K | RESISTOR,2.37K,0.1,1%,R0603
R142,R143,R217,R383,R384,R399 | 6 | YAGEO | RC0603JR-07330RL |  | 330E | RESISTOR,330E,0.1,5%,R0603
R147,R149 | 2 | PANASONIC - ECG | ERJ-2RKF33R0X |  | 33E | RESISTOR,33E,0.1,1%,R0402
R148,R150 | 2 | PANASONIC - ECG | ERJ-2RKF49R9X |  | 49.9E | RESISTOR,49.9E,0.1,1%,R0402
R151 | 1 | YAGEO | RC0603FR-07475RL |  | 475E | RESISTOR,475E,0.1,1%,R0603
R185 | 1 | YAGEO | RC0603FR-0711KL |  | 11K | RESISTOR,11K,0.1,1%,R0603
R199 | 1 | YAGEO | RC0603JR-07820RL |  | 820E | RESISTOR,820E,0.1,5%,R0603
R202 | 1 | YAGEO | RC0603FR-071ML |  | 1M | RESISTOR,1M,0.1,1%,R0603
R203 | 1 | YAGEO | RC0603FR-0712KL |  | 12K | RESISTOR,12K,0.1,1%,R0603
R206,R207,R208,R209 | 4 | VISHAY | CRCW06034R99FKEA |  | 4.99E | RESISTOR,4.99E,0.1,1%,R0603
R212 | 1 | YAGEO | RC0603FR-07200KL |  | 200K | RESISTOR,200K,0.1,1%,R0603
R213 | 1 | YAGEO | RC0603FR-07180KL |  | 180K | RESISTOR,180K,0.1,1%,R0603
R218 | 1 | PANASONIC - ECG | ERJ-3RQF1R0V |  | 1E | RESISTOR,1E,0.1,1%,R0603
R309,R310 | 2 | YAGEO | RC0603JR-0775RL |  | 75E | RESISTOR,75E,0.1,5%,R0603
R323 | 1 | YAGEO | RC0603FR-0720KL |  | 20K | RESISTOR,20K,0.1,1%,R0603
R324 | 1 | PANASONIC - ECG | ERJ-3EKF6802V |  | 68K | RESISTOR,68K,0.1,1%,R0603
R325 | 1 | YAGEO | RC0603JR-0747RL |  | 47E | RESISTOR,47E,0.1,5%,R0603
R326 | 1 | ROHM SEMICONDUCTOR | PMR100HZPFU9L00 |  | 0.009E | RESISTOR,0.009E,2,1%,R2512
R329 | 1 | YAGEO | RC0603JR-075K1L |  | 5.1K | RESISTOR,5.1K,0.1,5%,R0603
R330 | 1 | YAGEO | RC0603FR-0754K9L |  | 54.9K | RESISTOR,54.9K,0.1,1%,R0603
R331 | 1 | YAGEO | RC0603FR-0715KL |  | 15K | RESISTOR,15K,0.1,1%,R0603
R332 | 1 | YAGEO | RC0603FR-072K2L |  | 2.2K | RESISTOR,2.2K,0.1,1%,R0603
R333 | 1 | YAGEO | RC0603FR-0710K2L |  | 10.2K | RESISTOR,10.2K,0.1,1%,R0603
R334 | 1 | YAGEO | RC0603FR-07118KL |  | 118K | RESISTOR,118K,0.1,1%,R0603
R336 | 1 | YAGEO | RC0603FR-0729K4L |  | 29.4K | RESISTOR,29.4K,0.1,1%,R0603
R337 | 1 | PANASONIC - ECG | ERJ-3EKF3241V |  | 3.24K | RESISTOR,3.24K,0.1,1%,R0603
R340,R341 | 2 | YAGEO | RC0603FR-0775KL |  | 75K | RESISTOR,75K,0.1,1%,R0603
R343 | 1 | YAGEO | RC0603FR-071K5L |  | 1.5K | RESISTOR,1.5K,0.1,1%,R0603
R363,R364,R365,R366,R367,R368,R369,R370,R371,R372,R373,R374,R375,R376,R381,R382 | 16 | YAGEO | RC0603FR-07120RL |  | 120E | RESISTOR,120E,0.1,1%,R0603
R380 | 1 | YAGEO | RC0603JR-07160RL |  | 160E | RESISTOR,160E,0.1,5%,R0603
SW1 | 1 | E-SWITCH | TL1105XF100Q |  | SPST | SWITCH,TACT,SPST-NO,0.05A,12V
T1 | 1 | PULSE | HX1188NL |  | HX1188NL | XFORMER,SGL,ETHR LAN,16-SOIC
TP1,TP2,TP3,TP4,TP5,TP6,TP7,TP8,TP9,TP10,TP11,TP12,TP13,TP14,TP15,TP27,TP28,TP29,TP30,TP31,TP32,TP33,TP34 | 23 | NA | NA |  | TEST-PAD | TEST PAD
TP16,TP17,TP18,TP19,TP20,TP21,TP22,TP23,TP24,TP25,TP26 | 11 | KEYSTONE ELECTRONICS | 5014 |  | Test Point | TEST POINT, PC MULTI PURPOSE YEL
U1 | 1 | FREESCALE | P1021NXN2HFB |  | MPU | MPU 800MHZ 689-TEPBGA2
U2,U10,U11,U17 | 4 | ICS | ICS553MILF |  | BUFFER | CLK BUFFER 1:4 LO SKEW 8-SOIC
U3 | 1 | EVERSPIN | MR0A08BCYS35 |  | RAM | MRAM 1MBIT 35NS 44TSOP
U4,U5 | 2 | ON SEMICONDUCTOR | MC74LCX373DTG |  | LATCH TRANSP | LATCH TRANSP OCT LV 20-TSSOP
U6 | 1 | NXP SEMICONDUCTORS | PCA9515D,112 |  | REPEATER | I2C BUS REPEATER 8-SOIC
U7 | 1 | SAMSUNG | K9F1G08U0D-SIB0 |  | NAND FLASH | 1GB NAND FLASH
U8,U12,U18 | 3 | ABRACON COPERATION | ASFLMB-50.000MHZ-LY-T |  | 50MHZ | OSC,MEMS,50.000MHZ,SMD
U9 | 1 | ABRACON COPERATION | ECS-3963-666-BN-TR |  | 66.66MHZ | OSC,66.666MHZ,3.0V,SMD
U13,U14 | 2 | SMSC | LAN8720Ai |  | ETHERNET | ETHERNET 10/100 PHY RMII 24QFN
U15,U19 | 2 | MICREL INC | KSZ8721BLI |  | DRIVER | DRIVER,TRANSCEIVER,PHY 10/100, 3.3V,48LQFP
U16 | 1 | NXP SEMICONDUCTORS | PCA9555BS,118 |  | I/O EXPANDER | I/O EXPANDER I2C-BUS 16BIT WITH INTERRUPT
U20 | 1 | ON SEMICONDUCTOR | MC74LCX125DTR2G |  | BUFFER | BUFF TRI-ST QD CMOS 14TSSOP
U21 | 1 | ATHEROS | AR8031 |  | TRNSCVR | 10/100/1000 GIGABIT ETHERNET TRANSCEIVER
U22 | 1 | IDT | ICS557MI-01LF |  | CLOCK SOURCE | CLK SOURCE PCI-EXPRESS 8-SOIC
U23 | 1 | ANALOG DEVICES | ADT7410TRZ |  | TEMP SENS | TEMPERATURE SENSOR ±0.5°C 16-BITI I2C
U24 | 1 | STMICROELECTRONICS | M24256-BWMN6TP |  | EEPROM | EEPROM 256KBIT 400KHZ 8SOIC
U25 | 1 | INTERSIL | ISL12022IBZ |  | RTC | RTC WITH ON CHIP ±5PPM TEMP COMPENSATION
U26 | 1 | ATMEL | AT24C01BN-SH-B |  | EEPROM | EEPROM 1KBIT 1MHZ 8SOIC
U27 | 1 | SPANSION | S25FL128P0XNFI001 |  | FLASH | 128MBIT 3V SPI FLASH MEMORY
U28 | 1 | MAXIM INTEGRATED PRODUCTS | MAX3227ECUE+ |  | TRNSCVR | TXRX RS232 1MBPS SD 16TSSOP
U29 | 1 | BECKHOFF | ET1100 |  | ETHERCATCNTRLR | ETHERCAT SLAVE CONTROLLER
U30 | 1 | MICROCHIP TECHNOLOGY | 24LC16B-I/SN |  | EEPROM | EEPROM,16KBIT,400KHZ,8SOIC
U31 | 1 | SMSC | USB3300-EZK |  | CONTROLLER | USB HOST/OTG PHY ULPI 32-QFN
U32,U34,U35,U36,U37,U38,U49,U50,U51 | 9 | TEXAS INSTRUMENTS | TS3L110RGYR |  | ETHRNET SWITCH | ETHERNET SWITCH QUAD 16VQFN
U33 | 1 | MICREL INC | MIC2505-1YM |  | SW HIGH SIDE | SW HIGH SIDE SGL 2A 8SOIC
U39 | 1 | TEXAS INSTRUMENTS | SN74CB3Q3245RGYR |  | SWITCH BUS | SWITCH BUS 8BIT FET 20-VQFN
U40 | 1 | MAXIM INTEGRATED PRODUCTS | MAX16052AUT+T |  | PWR MONITOR | PWR MONITOR/SEQUENCER SOT23-6
U41,U52 | 2 | TEXAS INSTRUMENTS | SN74LVC541ARGYR |  | BUFFER | BUFF/DVR TRI-ST 8BIT 20-VQFN
U42 | 1 | ALTERA | EPM3064ATI44-10N |  | CPLD | CPLD,MAX,3000A,64,44-TQFP
U43 | 1 | LINEAR TECHNOLOGY | LTC4227IUFD-1#PBF |  | HOTSWAP | HOT SWAP CONTROLLER,20-QFN
U44 | 1 | TEXAS INSTRUMENTS | TPS54332DDA |  | DCCONV | 3.5A,BUCK,DC-DC,CONVERTOR
U45 | 1 | TEXAS INSTRUMENTS | TPS76850QPWP |  | REGULATOR | LDO VOLT REG, 5V, 1A, 20-HTSSOP
U46 | 1 | TEXAS INSTRUMENTS | TPS51116PWPR |  | DDR SYNC | DDR SYNC BUC CTRL REF20HTSSOP
U47 | 1 | NATIONAL SEMICONDUCTOR | LM3495MTC/NOPB |  | REGULATOR | PWM BUCK REG LOW-OUT 16-TSSOP
U48 | 1 | MAXIM INTEGRATED PRODUCTS | DS1834AS+ |  | ECONORST | ECONORST DUAL LO OPN-DR 8SOIC
U53 | 1 | FOX ELECTRONICS | FXO-HC536R-25 |  | 25MHZ | OSC 25.000 MHZ 3.3V SMD
U54 | 1 | TEXAS INSTRUMENTS | SN74LVC1G04DBVR |  | INVERTER | SINGLE INVERTER-GATE SOT-23-5
U55,U56 | 2 | FAIRCHILD SEMICONDUCTOR | NC7WZ240K8X |  | INVERTER | INVERTER DUAL 4-INPUT
Y1,Y2,Y4 | 3 | ABRACON CORPORATION | ABM8G-25.000MHZ-18-D2Y-T |  | 25MHz | XYSTAL,25MHZ,18PF,LOAD
Y3 | 1 | ABRACON CORPORATION | ABS07-32.768KHZ-T |  | 32.768KHZ | XYSTAL,32.768KHZ,12.5PF,LOAD
Y5 | 1 | ABRACON CORPORATION | ABM8G-24.000MHZ-18-D2Y-T |  | 24MHz | XYSTAL,24MHZ,18PF,LOAD
C12,C13 | 2 | AVX | 06035A4R7CAT2A |  | 4.7PF | CAP,CER,4.7PF,50V,5%,NP0,0603
R16,R168 | 2 | YAGEO | RC0603FR-0710KL |  | 10K | RESISTOR,10K,0.1,1%,R0603
R26,R32,R145,R344,R353,R403,R407 | 7 | YAGEO | RC0603JR-070RL |  | 0E | RESISTOR,0E,0.1,-,R0603
R45,R48,R50,R52,R67,R69,R71,R73,R105,R108,R109,R110,R123,R124,R125,R126,R127,R129,R130,R131,R137,R138,R219,R224,R227,R231,R233,R234,R237,R241,R243,R245,R246,R250,R251,R253,R268,R269,R278,R281,R284,R285,R291,R294,R295,R297,R300,R301,R305,R328,R354,R401 | 52 | YAGEO | RC0603FR-074K7L |  | 4.7K | RESISTOR,4.7K,0.1,1%,R0603
R335 | 1 | PANASONIC - ECG | ERJ-3EKF3483V |  | 348K | RESISTOR,348K,0.1,1%,R0603
R404 | 1 | YAGEO | RC0603FR-0733RL |  | 33E | RESISTOR,33E,0.1,1%,R0603

Sheet: APP-Rev2.xls
Refdes | Quantity | Manufacturer | Manufacturer PN | Footprint | Value | Description
BT1 | 1 | Renata | SMTU2430-LF.TR |  | CR2430 BAT HOLDER | Battery Holders CR2430 Snaps & Contacts
C1 C3 C5 C6 C9 C14 C16 C17 C18 C19 C23 C26 C27 C28 C29 C33 C35 C36 C37 C51 C66 C80 C84 C85 C86 C87 C88 C89 C90 C91 C96 C97 C98 C99 C100 C101 C120 C139 C140 C141 C142 C146 C148 C156 C283 C286 C287 C288 C289 C291 C292 C293 C294 C299 C303 C309 C321 C326 C327 C328 C330 C332 C369 C371 C374 | 65 | Murata | GRM188R71H104KA93D |  | 0.1uF | CAP CER .1UF 50V 10% X7R 0603
C121 C122 C123 C124 C125 C126 C127 C128 C129 C130 C131 C132 C133 C134 C135 C136 | 16 | Murata | GRM155R71H221KA01D |  | 220pF | CAP CER 220PF 50V 10% X7R 0402
C143 | 1 | AVX Corporation | TAJB226K020RNJ |  | 22uF | CAP TANTALUM 22UF 20V 10% SMD
C144 C145 C147 C325 | 4 | TDK Corporation | C2012X7R1C475K |  | 4.7uF | CAP CER 4.7UF 16V X7R 10% 0805
C149 C318 C319 | 3 | Taiyo Yuden | TMK316B7106KL-TD |  | 10uF | CAP CER 10UF 25V X7R 10% 1206
C152 C153 C154 C155 C304 C307 | 6 | TDK Corporation | C1608X5R1A106M |  | 10uF | CAP CER 10UF 10V X5R 20% 0603
C157 C158 C159 C160 C161 C162 | 6 | AVX Corporation | TPSB476K010R0250 |  | 47uF | CAP TANT LOWESR 47UF 10V 10% SMD
C177 C178 C179 C180 C181 C182 C183 C184 C185 C186 C187 C188 C189 C190 C209 C210 C211 C212 C213 C214 C215 C216 C217 C218 C219 C220 C221 C222 C223 C224 C225 C226 C231 C232 C233 C236 C241 C242 C243 C249 C250 C251 C252 C253 C254 C255 C259 C260 C261 C262 C263 C264 C265 C266 C267 C268 C357 C358 C359 C360 C361 C362 C363 C364 C365 C373 | 66 | Murata | GRM155R71H103KA88D |  | 0.01uF | CAP CER 10000PF 50V X7R 0402
C2 C4 C7 C10 C15 C24 C25 C32 C34 C47 C50 C52 C58 C67 C295 C296 C329 C331 | 18 | Murata | GRM188R71H103KA01D |  | 0.01uF | CAP CER 10000PF 50V 10% X7R 0603
C20 C42 C43 C44 C45 C46 C49 C53 C54 C55 C56 C57 C60 C68 C69 C70 C71 C72 C73 C74 C76 C83 C92 C93 C94 C95 C103 C104 C105 C106 C107 C108 C109 C110 C111 C112 C113 C114 C115 C116 C117 C118 C163 C164 C165 C166 C167 C168 C169 C170 C171 C172 C173 C174 C175 C176 C191 C192 C193 C194 C195 C196 C197 C198 C199 C200 C201 C202 C203 C204 C205 C206 C207 C208 C227 C228 C229 C230 C234 C235 C237 C238 C239 C240 C244 C245 C246 C247 C248 C256 C257 C258 C271 C279 C280 C281 C282 C284 C333 C334 C335 C336 C337 C338 C339 C340 C342 C343 C344 C345 C346 C348 C349 C350 C351 C352 C353 C354 C355 C356 | 120 | TDK Corporation | C1005X7R1H104M |  | 0.1uF | CAP CER .10UF 50V X7R 20% 0402
C276 C277 | 2 | TDK Corporation | C1005X5R0J225M |  | 2.2uF | CAP CER 2.2UF 6.3V X5R 0402
C278 | 1 | Murata | GRM155R71H332KA01D |  | 3300pF | CAP CER 3300PF 50V X7R 0402
C285 C314 | 2 | TDK Corporation | C1608X7R1H101K |  | 100pF | CAP CER 100PF 50V X7R 10% 0603
C290 | 1 | Kemet | C1206C106K4RACTU |  | 10uF | CAP CER 10UF 16V X7R 1206
C297 C305 C306 | 3 | Vishay | TH3E107K016C0600 |  | 100uF | CAP TANT 100UF 16V 10% SMD
C298 | 1 | TDK Corp | C1608X7R1H153K |  | 0.015uF | CAP CER 15000PF 50V X7R 0603
C30 C38 | 2 | TDK Corporation | C1608X5R1A475K |  | 4.7uF | CAP CER 4.7UF 10V X5R 0603
C300 | 1 | Murata | GRM188R71H102KA01D |  | 1000pF | CAP CER 1000PF 50V 10% X7R 0603
C301 | 1 | Kemet | C0603C470J5GACTU |  | 47pF | CAP CERAMIC 47PF 50V NP0 0603
C302 C317 | 2 | Murata | GRM31CR71A226KE15L |  | 22uF | CAP CER 22UF 10V X7R 10% 1206
C308 | 1 | AVX Corporation | 06035C333JAT2A |  | 0.033uF | CAP CERM 33000PF 5% 50V X7R 0603
C31 C39 C77 C78 C79 | 5 | TDK Corporation | C1608X7R1H471K |  | 470pF | CAP CER 470PF 50V X7R 10% 0603
C310 | 1 | Murata | GRM188R61C225KE15D |  | 2.2uF | CAP CER 2.2UF 16V X5R 0603
C311 C312 | 2 | TDK Corporation | C3225X7R1C226M |  | 22uF | CAP CER 22UF 16V X7R 1210
C313 | 1 | TDK Corporation | C1608X7R1E105K |  | 1uF | CAP CER 1.0UF 25V X7R 10% 0603
C315 | 1 | AVX Corporation | TPSB106M016R0800 |  | 10uF | CAP TANT LOESR 10UF 16V 20% SMD
C316 C324 | 2 | Kemet | T520D157M006ATE015 |  | 150uF | CAPACITOR TANT 150UF 6.3V 20%SMD
C320 | 1 | TDK Corporation | C2012X5R1E106K |  | 10uF | CAP CER 10UF 25V X5R 10% 0805
C322 C323 | 2 | TDK Corporation | C3216X5R0J107M |  | 100uF | CAP CER 100UF 6.3V X5R 20% 1206
C341 | 1 | AVX Corporation | 1206GC102KAT1A |  | 1000pF | CAP CERM 1000PF 2000V X7R 1206
C40 C41 C61 C370 C372 | 5 | TDK Corporation | C1608X7R1C105K |  | 1uF | CAP CER 1.0UF 16V X7R 10% 0603
C64 C65 C81 C82 C137 C138 C150 C151 | 8 | Murata | GRM1885C1H200JA01D |  | 20pF | CAP CER 20PF 50V 5% C0G 0603
C75 C269 C270 C272 C273 C274 C275 | 7 | TDK Corporation | C1005X5R1C105K |  | 1uF | CAP CER 1.0UF 16V X5R 0402
C8 C11 C21 C22 C48 C59 C62 C63 C102 C119 C347 C366 C367 C368 | 14 | Murata | GRM21BR71A106KE51L |  | 10uF | CAP CER 10UF 10V X7R 0805
D1 D2 D11 D12 D13 D14 D21 | 7 | LUMEX | SSF-LXH512SUGD |  | GRN_DUAL | LED GRN DUAL 1.8 RA T/H
D10 | 1 | Diodes Inc | B340A-13-F |  | B340A | DIODE SCHOTTKY 3A 40V SMA
D15 D16 D19 D20 | 4 | Dialight | 551-0209F |  | LED-G | LED 3MM RT ANG HI EFF GRN PC MNT
D17 | 1 | Dialight | 551-0409F |  | LED-R | LED 3MM RT ANG HI EFF RED PC MNT
D18 | 1 | Dialight | 551-0309F |  | LED-Y | LED 3MM RT ANG HI EFF YEL PC MNT
D23 D24 | 2 | Osram | LB Y87S-L1M2-35-Z |  | LED-B | LED MICRO SIDELED BLUE 470NM SMD
D25 | 1 | Dialight | 597-3601-207F |  | LED-B | LED BLUE 428NM CLEAR PLCC SMD
D3 D4 D22 D26 D28 | 5 | Lite-On Inc | LTST-C170KGKT |  | LED-G | LED GREEN CLEAR 0805 SMD
D5 | 1 | Semtech | RCLAMP0504S.TCT |  | TVS DIODE | IC TVS ARRAY LOW CAP SOT23-6
D6 D7 | 2 | Bourns Inc | SMAJ7.5A |  | SMAJ7.5A | DIODE TVS 7.5V 400W UNI 5% SMD
D8 | 1 | Fairchild SemI | MBR0530 |  | MBR0530 | DIODE SCHOTTKY 30V 0.5A SOD-123
D9 | 1 | Rohm Semiconductor | RB080L-30TE25 |  | RB080L | DIODE SCHOTTKY 30V 5A PMDS
FB1 FB2 FB4 FB5 FB7 FB8 FB9 FB10 FB11 FB12 FB13 | 11 | Murata | BLM18HG601SN1D |  | 600E@100MHz | FERRITE CHIP 600 OHM 200MA 0603
FB18 FB21 | 2 | Taiyo Yuden | FBMH2012HM121-T |  | 120E_2.5A | FERRITE BEAD 120 OHM 0805
FB19 FB20 | 2 | Murata | BLM18PG121SH1D |  | 120E | EMI/RFI Suppressors & Ferrites 0603 120ohms
FB3 FB6 FB14 FB15 FB16 FB17 | 6 | Murata | BLM18PG121SN1D |  | 120E@100MHz | FERRITE CHIP 120 OHM 2000MA 0603
G1 G2 | 2
J1 | 1 | TE Connectivity / AMP | 2013310-1 |  | 2013310-1 | Conn DIMM Socket SKT 204 POS
J2 | 1 | TE Connectivity | 5103309-3 |  | 5103309-3 | CONN HEADER LOPRO STR 16POS GOLD
J3 | 1 | JAE Electronics | ST1W008S4AR1500 |  | MICRO SD CONN | Micro SD Socket Hinge Type
J4 | 1 | Molex | 5000750517 |  | USB - OTG Mini-B | USB OTG Mini-B Receptacle, Vertical, TH
J5 | 1 | Molex | 15916102 |  | Header - 10P | HEADER SMT BKWY GOLD 10CKT
J6 | 1 | FCI | 10045267-111LF |  | High speed diff connector | Conn 3-Pair 72-P 2-mm 8-Column 4-Walls, RA
J7 | 1 | FCI | 10028917-001LF |  | PWR Connector | Power Header 2x2
J8 | 1 | Molex | 22-28-5033 |  | 22-28-5033 | Headers & Wire Housings 2.54MM HDR VT 3P
J9 | 1 | FCI | 10039851-111LF |  | CONN - 54P | 52P 2 mm 8 column 4 Walls RA Header
L5 | 1 | TDK Corporation | MLP2520S4R7S |  | 4.7uH | INDUCTOR MULTILAYER 4.7UH 1008
L8 | 1 | Bourns Inc | SRP7030-6R8FM |  | 6.8uH | IND Power 6.8UH 4.5A 20% SMD
L9 L10 | 2 | TDK Corporation | SLF10165T-2R2N6R33PF |  | 2.2uH | INDUCTOR SHIELD PWR 2.2UH 6.3A SMD
Q1 Q9 Q10 Q11 | 4 | NXP Semiconductors | 2N7002PW,115 |  | 2N7002PW | MOSFET N-CH SGL 60V SOT-323
Q2 Q3 Q4 | 3 | Vishay | SIR462DP-T1-GE3 |  | SIR462DP | MOSFET N-CH 30V 30A PPAK 8SOIC
Q5 Q7 | 2 | International Rectifier | IRF7821TRPBF |  | IRF7821 | MOSFET N-CH 30V 13.6A 8-SOIC
Q6 Q8 | 2 | International Rectifier | IRF7832TRPBF |  | IRF7832 | MOSFET N-CH 30V 20A 8-SOIC
R1 R4 R17 R18 R19 R20 R23 R25 R35 R36 R37 R38 R39 R40 R41 R42 R88 R96 R144 R146 R153 R154 R155 R156 R157 R158 R159 R160 R161 R162 R164 R165 R167 R169 R170 R171 R172 R173 R177 R179 R180 R181 R182 R204 R205 R214 R215 R216 R345 R361 R392 R393 R394 R395 R414 | 55 | Panasonic - ECG | ERJ-3GEYJ103V |  | 10K | RES 10K OHM 1/10W 5% 0603 SMD
R139 | 1 | Panasonic - ECG | ERJ-3EKF2000V |  | 200E | RES 200 OHM 1/10W 1% 0603 SMD
R141 | 1 | Panasonic - ECG | ERJ-3EKF2371V |  | 2.37K | RES 2.37K OHM 1/10W 1% 0603 SMD
R142 R143 R217 R383 R384 R399 | 6 | Panasonic - ECG | ERJ-3GEYJ331V |  | 330E | RES 330 OHM 1/10W 5% 0603 SMD
R147 R149 | 2 | Panasonic - ECG | ERJ-2RKF33R0X |  | 33E | RES 33.0 OHM 1/10W 1% 0402 SMD
R148 R150 | 2 | Panasonic - ECG | ERJ-2RKF49R9X |  | 49.9E | RES 49.9 OHM 1/10W 1% 0402 SMD
R151 | 1 | Panasonic - ECG | ERJ-3EKF4750V |  | 475E | RES 475 OHM 1/10W 1% 0603 SMD
R185 | 1 | Panasonic - ECG | ERJ-3EKF1102V |  | 11K | RES 11.0K OHM 1/10W 1% 0603 SMD
R199 | 1 | Panasonic - ECG | ERJ-3GEYJ821V |  | 820E | RES 820 OHM 1/10W 5% 0603 SMD
R2 R3 | 2 | Panasonic - ECG | ERJ-3EKF40R2V |  | 40.2E | RES 40.2 OHM 1/10W 1% 0603 SMD
R202 | 1 | Panasonic - ECG | ERJ-3GEYJ105V |  | 1M | RES 1.0M OHM 1/10W 5% 0603 SMD
R203 | 1 | Panasonic - ECG | ERJ-3EKF1202V |  | 12K | RES 12.0K OHM 1/10W 1% 0603 SMD
R206 R207 R208 R209 | 4 | Vishay/Dale | CRCW06034R99FKEA |  | 4.99 | RES 4.99 OHM 1/10W 1% 0603 SMD
R212 | 1 | Panasonic - ECG | ERJ-3EKF2003V |  | 200K | RES 200K OHM 1/10W 1% 0603 SMD
R213 | 1 | Panasonic - ECG | ERJ-3EKF1803V |  | 180K | RES 180K OHM 1/10W 1% 0603 SMD
R218 | 1 | Panasonic - ECG | ERJ-3RQF1R0V |  | 1E | RESISTOR 1.0 OHM 1/10W 1% 0603
R22 | 1 | Panasonic - ECG | ERJ-3GEYJ101V |  | 100E | RES 100 OHM 1/10W 5% 0603 SMD
R24 R327 | 2 | Panasonic - ECG | ERJ-3GEYJ100V |  | 10E | RES 10 OHM 1/10W 5% 0603 SMD
R28 R29 R30 R31 R43 R44 R63 R64 R65 R83 R84 R85 R86 R90 R114 R115 R116 R117 R346 R347 R348 | 21 | Panasonic - ECG | ERJ-3EKF33R0V |  | 33E | RES 33.0 OHM 1/10W 1% 0603 SMD
R309 R310 | 2 | Panasonic - ECG | ERJ-3GEYJ750V |  | 75E | RES 75 OHM 1/10W 5% 0603 SMD
R323 | 1 | Panasonic - ECG | ERJ-3EKF2002V |  | 20K | RES 20.0K OHM 1/10W 1% 0603 SMD
R324 | 1 | Panasonic - ECG | ERJ-3EKF6802V |  | 68K | RES 68.0K OHM 1/10W 1% 0603 SMD
R325 | 1 | Panasonic - ECG | ERJ-3GEYJ470V |  | 47E | RES 47 OHM 1/10W 5% 0603 SMD
R326 | 1 | Rohm Semiconductor | PMR100HZPFU9L00 |  | 0.009E | RES .009 OHM 2W 1% 2512 SMD
R329 | 1 | Panasonic - ECG | ERJ-3GEYJ512V |  | 5.1K | RES 5.1K OHM 1/10W 5% 0603 SMD
R33 | 1 | Panasonic - ECG | ERJ-3GEYJ102V |  | 1K | RES 1.0K OHM 1/10W 5% 0603 SMD
R330 | 1 | Panasonic - ECG | ERJ-3EKF5492V |  | 54.9K | RES 54.9K OHM 1/10W 1% 0603 SMD
R331 | 1 | Panasonic - ECG | ERJ-3EKF1502V |  | 15K | RES 15.0K OHM 1/10W 1% 0603 SMD
R332 | 1 | Panasonic - ECG | ERJ-3EKF2201V |  | 2.2K | RES 2.20K OHM 1/10W 1% 0603 SMD
R333 | 1 | Panasonic - ECG | ERJ-3EKF1022V |  | 10.2K | RES 10.2K OHM 1/10W 1% 0603 SMD
R334 | 1 | Panasonic - ECG | ERJ-3EKF1183V |  | 118K | RES 118K OHM 1/10W 1% 0603 SMD
R336 | 1 | Panasonic - ECG | ERJ-3EKF2942V |  | 29.4K | RES 29.4K OHM 1/10W 1% 0603 SMD
R337 | 1 | Panasonic - ECG | ERJ-3EKF3241V |  | 3.24K | RES 3.24K OHM 1/10W 1% 0603 SMD
R339 | 1 | Panasonic - ECG | ERJ-3EKF1002V |  | 10K | RES 10.0K OHM 1/10W 1% 0603 SMD
R340 R341 | 2 | Panasonic - ECG | ERJ-3EKF7502V |  | 75K | RES 75.0K OHM 1/10W 1% 0603 SMD
R343 | 1 | Panasonic - ECG | ERJ-3EKF1501V |  | 1.5K | RES 1.50K OHM 1/10W 1% 0603 SMD
R363 R364 R365 R366 R367 R368 R369 R370 R371 R372 R373 R374 R375 R376 R381 R382 | 16 | Panasonic - ECG | ERJ-3GEYJ121V |  | 120E | RES 120 OHM 1/10W 5% 0603 SMD
R380 | 1 | Panasonic - ECG | ERJ-3GEYJ161V |  | 160E | RES 160 OHM 1/10W 5% 0603 SMD
R5 R10 R11 R12 R13 R14 R15 R27 R104 R106 R112 R166 R176 R178 R192 R193 R194 R195 R196 R197 R200 R201 R210 R211 R257 R270 R272 R275 R298 R351 R352 R357 R358 R359 R360 R377 R379 R400 | 38 | Panasonic - ECG | ERJ-3GEY0R00V |  | 0E | RES 0.0 OHM 1/10W 0603 SMD
R53 R54 R55 R56 R74 R75 R76 R77 R259 R263 R264 R266 R282 R306 R307 R308 | 16 | Panasonic - ECG | ERJ-3EKF49R9V |  | 49.9E | RES 49.9 OHM 1/10W 1% 0603 SMD
R57 R78 | 2 | Panasonic - ECG | ERJ-3EKF1212V |  | 12.1K | RES 12.1K OHM 1/10W 1% 0603 SMD
R6 | 1 | Panasonic - ECG | ERJ-2GEJ101X |  | 100E | RES 100 OHM 1/10W 5% 0402 SMD
R7 R58 R59 R60 R61 R79 R80 R81 R82 R140 R398 | 11 | Panasonic - ECG | ERJ-3EKF1000V |  | 100E | RES 100 OHM 1/10W 1% 0603 SMD
R8 R21 R34 R46 R47 R49 R51 R62 R66 R68 R70 R72 R87 R89 R97 R103 R107 R111 R113 R118 R119 R120 R121 R122 R128 R132 R133 R134 R135 R136 R163 R174 R175 R183 R184 R186 R187 R188 R189 R190 R191 R220 R221 R222 R223 R225 R226 R228 R229 R230 R232 R235 R236 R238 R239 R240 R242 R244 R247 R248 R249 R252 R254 R255 R256 R258 R260 R261 R262 R265 R267 R271 R273 R274 R276 R277 R279 R280 R283 R286 R287 R288 R289 R290 R292 R293 R296 R299 R302 R303 R304 R311 R312 R313 R314 R315 R316 R317 R318 R319 R320 R321 R322 R349 R350 R355 R356 R362 R378 R385 R386 R387 R388 R389 R390 R391 R396 R397 R402 R405 R406 R408 R409 R410 R411 R412 R413 | 127 | Panasonic - ECG | ERJ-3GEYJ472V |  | 4.7K | RES 4.7K OHM 1/10W 5% 0603 SMD
R9 R152 R338 R342 | 4 | Panasonic - ECG | ERJ-3GEYJ104V |  | 100K | RES 100K OHM 1/10W 5% 0603 SMD
R91 R92 R93 R94 R98 R99 R100 R101 R198 | 9 | Panasonic - ECG | ERJ-3GEYJ330V |  | 33E | RES 33 OHM 1/10W 5% 0603 SMD
R95 R102 | 2 | Panasonic - ECG | ERJ-3EKF6491V |  | 6.49K | RES 6.49K OHM 1/10W 1% 0603 SMD
SW1 | 1 | E-Switch | TL1105XF100Q |  | Reset Switch | SWITCH TACT 6MM RA 5.85MM 100GF
T1 | 1 | PULSE | HX1188NL |  | HX1188 | MODULE XFRMR SGL ETHR LAN 16SOIC
TP16 TP17 TP18 TP19 TP20 TP21 TP22 TP23 TP24 TP25 TP26 | 11 | Keystone Electronics | 5014 |  | TP_TH | TEST POINT PC MULTI PURPOSE YEL
U1 | 1 | Freescale | P1021NXN2HFB |  | P1021
U13 U14 | 2 | SMSC | LAN8720Ai |  | LAN8720Ai | ETHERNET 10/100 PHY RMII 24QFN
U15 U19 | 2 | Micrel Inc | KSZ8721BLI |  | PHY1_KSZ8721BLI | IC TXRX PHY 10/100 3.3V 48LQFP
U16 | 1 | NXP | PCA9555BS,118 |  | PCA9555BS | I/O Expander I2C-bus 16bit with interrupt
U2 U10 U11 U17 | 4 | ICS | ICS553MILF |  | ICS553 | IC CLK BUFFER 1:4 LO SKEW 8-SOIC
U20 | 1 | ON Semiconductor | MC74LCX125DTR2G |  | MC74LCX125 | IC BUFF TRI-ST QD CMOS 14TSSOP
U21 | 1 | Atheros | AR8031 |  | AR8031 | 10/100/1000 Gigabit Ethernet Transceiver
U22 | 1 | IDT | ICS557MI-01LF |  | ICS557 | IC CLK SOURCE PCI-EXPRESS 8-SOIC
U23 | 1 | Analog Devices | ADT7410TRZ |  | ADT7410TRZ | Temperature Sensor ±0.5°C 16-biti I2C
U24 | 1 | STMicroelectronics | M24256-BWMN6TP |  | M24256-BWMN6TP | IC EEPROM 256KBIT 400KHZ 8SOIC
U25 | 1 | Intersil | ISL12022IBZ |  | ISL12022IBZ | RTC with On Chip ±5ppm Temp Compensation
U26 | 1 | Atmel | AT24C01BN-SH-B |  | AT24C01BN-SH-B | IC EEPROM 1KBIT 1MHZ 8SOIC
U27 | 1 | Spansion | S25FL128P0XNFI001 |  | S25FL128P0XNFI001 | 128Mbit 3V SPI Flash Memory
U28 | 1 | Maxim-IC | MAX3227ECUE+ |  | MAX3227E | IC TXRX RS232 1MBPS SD 16TSSOP
U29 | 1 | BECKHOFF | ET1100 |  | ET1100,BGA128 | EtherCAT Slave Controller
U3 | 1 | EverSpin Technologies | MR0A08BCYS35 |  | MR0A08B | IC MRAM 1MBIT 35NS 44TSOP
U30 | 1 | Microchip Technology | 24LC16B-I/SN |  | 24LC16B | IC EEPROM 16KBIT 400KHZ 8SOIC
U31 | 1 | SMSC | USB3300-EZK |  | USB3300 | IC USB HOST/OTG PHY ULPI 32-QFN
U32 U34 U35 U36 U37 U38 U49 U50 U51 | 9 | Texas Instruments | TS3L110RGYR |  | TS3L110 | IC ETHERNET SWITCH QUAD 16VQFN
U33 | 1 | Micrel | MIC2505-1YM |  | MIC2505 | IC SW HIGH SIDE SGL 2A 8SOIC
U39 | 1 | Texas Instruments | SN74CB3Q3245RGYR |  | SN74CB3Q3245 | IC SWITCH BUS 8BIT FET 20-VQFN
U4 U5 | 2 | ON Semiconductor | MC74LCX373DTG |  | MC74LCX373 | IC LATCH TRANSP OCT LV 20-TSSOP
U40 | 1 | Maxim-IC | MAX16052AUT+T |  | MAX16052 | IC PWR MONITOR/SEQUENCER SOT23-6
U41 U52 | 2 | Texas Instruments | SN74LVC541ARGYR |  | SN74LVC541A | IC BUFF/DVR TRI-ST 8BIT 20QFN
U42 | 1 | Altera | EPM3064ATI44-10N |  | EPM3064 | IC MAX 3000A CPLD 64 44-TQFP
U43 | 1 | Linear Technology | LTC4227IUFD-1#PBF |  | LTC4227 | IC CONTROLLER HOT SWAP 20-QFN
U44 | 1 | Texas Instruments | TPS54332DDA |  | TPS54332 | 3.5A Buck DC-DC Convertor
U45 | 1 | Texas Instruments | TPS76850QPWP |  | TPS76850 | IC, LDO VOLT REG, 5V, 1A, 20-HTSSOP
U46 | 1 | Texas Instruments | TPS51116PWPR |  | TPS51116 | IC DDR SYNC BUC CTRL REF20HTSSOP
U47 | 1 | National Semiconductor | LM3495MTC/NOPB |  | LM3495 | IC PWM BUCK REG LOW-OUT 16-TSSOP
U48 | 1 | Maxim-IC | DS1834AS+ |  | DS1834A | IC ECONORST DUAL LO OPN-DR 8SOIC
U53 | 1 | Fox Electronics | FXO-HC536R-25 |  | OSC-25MHz | OSC 25.000 MHZ 3.3V SMD
U54 | 1 | Texas Instruments | SN74LVC1G04DBVR |  | SN74LVC1G04DBVR | IC SINGLE INVERTER-GATE SOT-23-5
U55 U56 | 2 | Fairchild | NC7WZ240K8X |  | IC-NC7WZ240 | INVERTER DUAL 4-INPUT
U6 | 1 | NXP Semiconductors | PCA9515D,112 |  | PCA9515 | IC I2C BUS REPEATER 8-SOIC
U7 | 1 | Samsung | K9F1G08U0D-SIB0 |  | K9F1G08U0D | IC 1Gb NAND Flash
U8 U12 U18 | 3 | ABRACON | ASFLMB-50.000MHZ-LY-T |  | OSC-50MHz | OSC MEMS 50.000 MHZ SMD
U9 | 1 | ECS Inc | ECS-3963-666-BN-TR |  | OSC-66.666MHz | OSC 66.666 MHZ 3.0V SMD
Y1 Y2 Y4 | 3 | Abracon Corporation | ABM8G-25.000MHZ-18-D2Y-T |  | 25MHz | CRYSTAL 25.000 MHZ 18 PF SMD
Y3 | 1 | Abracon Corporation | ABS07-32.768KHZ-T |  | 32.768KHZ | Crystals 32.768 KHz 12.5pF
Y5 | 1 | Abracon Corporation | ABM8G-24.000MHZ-18-D2Y-T |  | 24MHz | CRYSTAL 24.000 MHZ 18 PF SMD
R335 | 1 | Panasonic - ECG | ERJ-3EKF3483V |  | 348K | RES 348K OHM 1/10W 1% 0603 SMD
C12 C13 | 2 | AVX | 06035A4R7CAT2A |  | 4.7pF | CAP CER 4.7PF 50V NPO 0603 +/-0.25PF
R67 R241 R294 R295 R48 R297 R243 R300 R301 R69 R245 R246 R305 R123 R124 R125 R250 R251 R126 R253 R127 R219 R105 R129 R130 R328 R131 R224 R354 R52 R108 R268 R269 R227 R109 R110 R71 R231 R278 R137 R233 R281 R401 R234 R284 R285 R138 R45 R237 R73 R50 R291 | 52 | Panasonic - ECG | ERJ-3GEYJ472V |  | 4.7K | RES 4.7K OHM 1/10W 5% 0603 SMD
R404 | 1 | Panasonic - ECG | ERJ-3EKF33R0V |  | 33E | RES 33.0 OHM 1/10W 1% 0603 SMD
R32 R26 R353 R145 R344 R403 R407 | 7 | Panasonic - ECG | ERJ-3GEY0R00V |  | 0E | RES 0.0 OHM 1/10W 0603 SMD
TP1 TP2 TP3 TP4 TP5 TP6 TP7 TP8 TP9 TP10 TP11 TP12 TP13 TP14 TP15 TP27 TP28 TP29 TP30 TP31 TP32 TP33 TP34 | 23
R16 R168 | 2 | Panasonic - ECG | ERJ-3GEYJ103V |  | 10K | RES 10K OHM 1/10W 5% 0603 SMD

Sheet: expanded UPDATED_BOM.xls
Refdes | Quantity | Manufacturer | Manufacturer PN | Footprint | Value | Description
BT1 | 1 | RENATA | SMTU2430-LF.TR |  | Battery Holders | BATTERY HOLDER,CR2430
C1 | 1 | AVX | 06035C104KAT2A |  | 0.1UF | CAP,CER,0.1UF,50V,10%,X7R,0603
C10 | 1 | AVX | 06035C103KAT2A |  | 0.01UF | CAP,CER,10000PF,50V,10%,X7R,0603
C100 | 1 | AVX | 06035C104KAT2A |  | 0.1UF | CAP,CER,0.1UF,50V,10%,X7R,0603
C101 | 1 | AVX | 06035C104KAT2A |  | 0.1UF | CAP,CER,0.1UF,50V,10%,X7R,0603
C102 | 1 | MURATA | GRM21BR61E106KA73L |  | 10UF | CAP,CER,10UF,25V,10%,X5R,0805
C103 | 1 | TDK | C1005X7R1H104M |  | 0.1UF | CAP,CER,0.1UF,50V,20%,X7R,0402
C104 | 1 | TDK | C1005X7R1H104M |  | 0.1UF | CAP,CER,0.1UF,50V,20%,X7R,0402
C105 | 1 | TDK | C1005X7R1H104M |  | 0.1UF | CAP,CER,0.1UF,50V,20%,X7R,0402
C106 | 1 | TDK | C1005X7R1H104M |  | 0.1UF | CAP,CER,0.1UF,50V,20%,X7R,0402
C107 | 1 | TDK | C1005X7R1H104M |  | 0.1UF | CAP,CER,0.1UF,50V,20%,X7R,0402
C108 | 1 | TDK | C1005X7R1H104M |  | 0.1UF | CAP,CER,0.1UF,50V,20%,X7R,0402
C109 | 1 | TDK | C1005X7R1H104M |  | 0.1UF | CAP,CER,0.1UF,50V,20%,X7R,0402
C11 | 1 | MURATA | GRM21BR61E106KA73L |  | 10UF | CAP,CER,10UF,25V,10%,X5R,0805
C110 | 1 | TDK | C1005X7R1H104M |  | 0.1UF | CAP,CER,0.1UF,50V,20%,X7R,0402
C111 | 1 | TDK | C1005X7R1H104M |  | 0.1UF | CAP,CER,0.1UF,50V,20%,X7R,0402
C112 | 1 | TDK | C1005X7R1H104M |  | 0.1UF | CAP,CER,0.1UF,50V,20%,X7R,0402
C113 | 1 | TDK | C1005X7R1H104M |  | 0.1UF | CAP,CER,0.1UF,50V,20%,X7R,0402
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
C267 | 1 | AVX | 04025C103KAT2A |  | 0.01UF | CAP,CER,10000PF,50V,10%,X7R,0402
C268 | 1 | AVX | 04025C103KAT2A |  | 0.01UF | CAP,CER,10000PF,50V,10%,X7R,0402
C269 | 1 | AVX | 0402YD105KAT2A |  | 1UF | CAP,CER,1UF,16V,10%,X5R,0402
C27 | 1 | AVX | 06035C104KAT2A |  | 0.1UF | CAP,CER,0.1UF,50V,10%,X7R,0603
C270 | 1 | AVX | 0402YD105KAT2A |  | 1UF | CAP,CER,1UF,16V,10%,X5R,0402
C271 | 1 | TDK | C1005X7R1H104M |  | 0.1UF | CAP,CER,0.1UF,50V,20%,X7R,0402
C272 | 1 | AVX | 0402YD105KAT2A |  | 1UF | CAP,CER,1UF,16V,10%,X5R,0402
C273 | 1 | AVX | 0402YD105KAT2A |  | 1UF | CAP,CER,1UF,16V,10%,X5R,0402
C274 | 1 | AVX | 0402YD105KAT2A |  | 1UF | CAP,CER,1UF,16V,10%,X5R,0402
C275 | 1 | AVX | 0402YD105KAT2A |  | 1UF | CAP,CER,1UF,16V,10%,X5R,0402
C276 | 1 | TDK | C1005X5R0J225M |  | 2.2UF | CAP,CER,2.2UF,6.3V,20%,X5R,0402
C277 | 1 | TDK | C1005X5R0J225M |  | 2.2UF | CAP,CER,2.2UF,6.3V,20%,X5R,0402
C278 | 1 | AVX | 04025C332KAT2A |  | 3300PF | CAP,CER,3300PF,50V,10%,X7R,0402
C279 | 1 | TDK | C1005X7R1H104M |  | 0.1UF | CAP,CER,0.1UF,50V,20%,X7R,0402
C28 | 1 | AVX | 06035C104KAT2A |  | 0.1UF | CAP,CER,0.1UF,50V,10%,X7R,0603
C280 | 1 | TDK | C1005X7R1H104M |  | 0.1UF | CAP,CER,0.1UF,50V,20%,X7R,0402
C281 | 1 | TDK | C1005X7R1H104M |  | 0.1UF | CAP,CER,0.1UF,50V,20%,X7R,0402
C282 | 1 | TDK | C1005X7R1H104M |  | 0.1UF | CAP,CER,0.1UF,50V,20%,X7R,0402
C283 | 1 | AVX | 06035C104KAT2A |  | 0.1UF | CAP,CER,0.1UF,50V,10%,X7R,0603
C284 | 1 | TDK | C1005X7R1H104M |  | 0.1UF | CAP,CER,0.1UF,50V,20%,X7R,0402
C285 | 1 | TDK | C1608X7R1H101K |  | 100PF | CAP,CER,100PF,50V,10%,X7R,0603
C286 | 1 | AVX | 06035C104KAT2A |  | 0.1UF | CAP,CER,0.1UF,50V,10%,X7R,0603
C287 | 1 | AVX | 06035C104KAT2A |  | 0.1UF | CAP,CER,0.1UF,50V,10%,X7R,0603
C288 | 1 | AVX | 06035C104KAT2A |  | 0.1UF | CAP,CER,0.1UF,50V,10%,X7R,0603
C289 | 1 | AVX | 06035C104KAT2A |  | 0.1UF | CAP,CER,0.1UF,50V,10%,X7R,0603
C29 | 1 | AVX | 06035C104KAT2A |  | 0.1UF | CAP,CER,0.1UF,50V,10%,X7R,0603
C290 | 1 | TAIYO YUDEN | TMK316B7106KL-TD |  | 10UF | CAP,CER,10UF,25V,10%,X7R,1206
C291 | 1 | AVX | 06035C104KAT2A |  | 0.1UF | CAP,CER,0.1UF,50V,10%,X7R,0603
C292 | 1 | AVX | 06035C104KAT2A |  | 0.1UF | CAP,CER,0.1UF,50V,10%,X7R,0603
C293 | 1 | AVX | 06035C104KAT2A |  | 0.1UF | CAP,CER,0.1UF,50V,10%,X7R,0603
C294 | 1 | AVX | 06035C104KAT2A |  | 0.1UF | CAP,CER,0.1UF,50V,10%,X7R,0603
C295 | 1 | AVX | 06035C103KAT2A |  | 0.01UF | CAP,CER,10000PF,50V,10%,X7R,0603
C296 | 1 | AVX | 06035C103KAT2A |  | 0.01UF | CAP,CER,10000PF,50V,10%,X7R,0603
C297 | 1 | AVX | TPSE107K020R0150 |  | 100UF | CAP,TANT,100UF,20V,10%,2917
C298 | 1 | AVX | 06035C153KAT2A |  | 0.015UF | CAP,CER,15000PF,50V,10%,X7R,0603
C299 | 1 | AVX | 06035C104KAT2A |  | 0.1UF | CAP,CER,0.1UF,50V,10%,X7R,0603
C3 | 1 | AVX | 06035C104KAT2A |  | 0.1UF | CAP,CER,0.1UF,50V,10%,X7R,0603
C30 | 1 | TDK | C1608X5R1A475K |  | 4.7UF | CAP,CER,4.7UF,10V,10%,X5R,0603
C300 | 1 | AVX | 06035C102KAT2A |  | 1000PF | CAP,CER,1000PF,50V,10%,X7R,0603
C301 | 1 | AVX | 06035A470JAT2A |  | 47PF | CAP,CER,47PF,50V,5%,NP0,0603
C302 | 1 | MURATA | GRM31CR71A226KE15L |  | 22UF | CAP,CER,22UF,10V,10%,X7R,1206
C303 | 1 | AVX | 06035C104KAT2A |  | 0.1UF | CAP,CER,0.1UF,50V,10%,X7R,0603
C304 | 1 | TDK | C1608X5R1A106M |  | 10UF | CAP,CER,10UF,10V,20%,X5R,0603
C305 | 1 | AVX | TPSE107K020R0150 |  | 100UF | CAP,TANT,100UF,20V,10%,2917
C306 | 1 | AVX | TPSE107K020R0150 |  | 100UF | CAP,TANT,100UF,20V,10%,2917
C307 | 1 | TDK | C1608X5R1A106M |  | 10UF | CAP,CER,10UF,10V,20%,X5R,0603
C308 | 1 | AVX | 06035C333JAT2A |  | 0.033UF | CAP,CER,33000PF,50V,5%,X7R,0603
C309 | 1 | AVX | 06035C104KAT2A |  | 0.1UF | CAP,CER,0.1UF,50V,10%,X7R,0603
C31 | 1 | AVX | 06035C471KAT2A |  | 470PF | CAP,CER,470PF,50V,10%,X7R,0603
C310 | 1 | AVX | 0603YD225KAT2A |  | 2.2UF | CAP,CER,2.2UF,16V,10%,X5R,0603
C311 | 1 | AVX | 1210YC226KAT2A |  | 22UF | CAP,CER,22UF,16V,10%,X7R,1210
C312 | 1 | AVX | 1210YC226KAT2A |  | 22UF | CAP,CER,22UF,16V,10%,X7R,1210
C313 | 1 | TAIYO YUDEN | UMK107BJ105KA-T |  | 1UF | CAP,CER,1UF,50V,10%,X5R,0603
C314 | 1 | TDK | C1608X7R1H101K |  | 100PF | CAP,CER,100PF,50V,10%,X7R,0603
C315 | 1 | AVX | TPSB106M016R0800 |  | 10UF | CAP,TANT,LOESR,10UF,16V,20%,1210
C316 | 1 | KEMET | T520D157M006ATE015 |  | 150UF | CAP,TANT,150UF,6.3V,20%,2917
C317 | 1 | MURATA | GRM31CR71A226KE15L |  | 22UF | CAP,CER,22UF,10V,10%,X7R,1206
C318 | 1 | TAIYO YUDEN | TMK316B7106KL-TD |  | 10UF | CAP,CER,10UF,25V,10%,X7R,1206
C319 | 1 | TAIYO YUDEN | TMK316B7106KL-TD |  | 10UF | CAP,CER,10UF,25V,10%,X7R,1206
C32 | 1 | AVX | 06035C103KAT2A |  | 0.01UF | CAP,CER,10000PF,50V,10%,X7R,0603
C320 | 1 | MURATA | GRM21BR61E106KA73L |  | 10UF | CAP,CER,10UF,25V,10%,X5R,0805
C321 | 1 | AVX | 06035C104KAT2A |  | 0.1UF | CAP,CER,0.1UF,50V,10%,X7R,0603
C322 | 1 | KEMET | C1206C107M9PACTU |  | 100UF | CAP,CER,100UF,6.3V,20%,X5R,1206
C323 | 1 | KEMET | C1206C107M9PACTU |  | 100UF | CAP,CER,100UF,6.3V,20%,X5R,1206
C324 | 1 | KEMET | T520D157M006ATE015 |  | 150UF | CAP,TANT,150UF,6.3V,20%,2917
C325 | 1 | AVX | 08053D475KAT2A |  | 4.7UF | CAP,CER,4.7UF,25V,10%,X5R,0805
C326 | 1 | AVX | 06035C104KAT2A |  | 0.1UF | CAP,CER,0.1UF,50V,10%,X7R,0603
C327 | 1 | AVX | 06035C104KAT2A |  | 0.1UF | CAP,CER,0.1UF,50V,10%,X7R,0603
C328 | 1 | AVX | 06035C104KAT2A |  | 0.1UF | CAP,CER,0.1UF,50V,10%,X7R,0603
C329 | 1 | AVX | 06035C103KAT2A |  | 0.01UF | CAP,CER,10000PF,50V,10%,X7R,0603
C33 | 1 | AVX | 06035C104KAT2A |  | 0.1UF | CAP,CER,0.1UF,50V,10%,X7R,0603
C330 | 1 | AVX | 06035C104KAT2A |  | 0.1UF | CAP,CER,0.1UF,50V,10%,X7R,0603
C331 | 1 | AVX | 06035C103KAT2A |  | 0.01UF | CAP,CER,10000PF,50V,10%,X7R,0603
C332 | 1 | AVX | 06035C104KAT2A |  | 0.1UF | CAP,CER,0.1UF,50V,10%,X7R,0603
C333 | 1 | TDK | C1005X7R1H104M |  | 0.1UF | CAP,CER,0.1UF,50V,20%,X7R,0402
C334 | 1 | TDK | C1005X7R1H104M |  | 0.1UF | CAP,CER,0.1UF,50V,20%,X7R,0402
C335 | 1 | TDK | C1005X7R1H104M |  | 0.1UF | CAP,CER,0.1UF,50V,20%,X7R,0402
C336 | 1 | TDK | C1005X7R1H104M |  | 0.1UF | CAP,CER,0.1UF,50V,20%,X7R,0402
C337 | 1 | TDK | C1005X7R1H104M |  | 0.1UF | CAP,CER,0.1UF,50V,20%,X7R,0402
C338 | 1 | TDK | C1005X7R1H104M |  | 0.1UF | CAP,CER,0.1UF,50V,20%,X7R,0402
C339 | 1 | TDK | C1005X7R1H104M |  | 0.1UF | CAP,CER,0.1UF,50V,20%,X7R,0402
C34 | 1 | AVX | 06035C103KAT2A |  | 0.01UF | CAP,CER,10000PF,50V,10%,X7R,0603
C340 | 1 | TDK | C1005X7R1H104M |  | 0.1UF | CAP,CER,0.1UF,50V,20%,X7R,0402
C341 | 1 | AVX | 1206GC102KAT1A |  | 0.001UF | CAP,CER,1000PF,2000V,10%,X7R,1206
C342 | 1 | TDK | C1005X7R1H104M |  | 0.1UF | CAP,CER,0.1UF,50V,20%,X7R,0402
C343 | 1 | TDK | C1005X7R1H104M |  | 0.1UF | CAP,CER,0.1UF,50V,20%,X7R,0402
C344 | 1 | TDK | C1005X7R1H104M |  | 0.1UF | CAP,CER,0.1UF,50V,20%,X7R,0402
C345 | 1 | TDK | C1005X7R1H104M |  | 0.1UF | CAP,CER,0.1UF,50V,20%,X7R,0402
C346 | 1 | TDK | C1005X7R1H104M |  | 0.1UF | CAP,CER,0.1UF,50V,20%,X7R,0402
C347 | 1 | MURATA | GRM21BR61E106KA73L |  | 10UF | CAP,CER,10UF,25V,10%,X5R,0805
C348 | 1 | TDK | C1005X7R1H104M |  | 0.1UF | CAP,CER,0.1UF,50V,20%,X7R,0402
C349 | 1 | TDK | C1005X7R1H104M |  | 0.1UF | CAP,CER,0.1UF,50V,20%,X7R,0402
C35 | 1 | AVX | 06035C104KAT2A |  | 0.1UF | CAP,CER,0.1UF,50V,10%,X7R,0603
C350 | 1 | TDK | C1005X7R1H104M |  | 0.1UF | CAP,CER,0.1UF,50V,20%,X7R,0402
C351 | 1 | TDK | C1005X7R1H104M |  | 0.1UF | CAP,CER,0.1UF,50V,20%,X7R,0402
C352 | 1 | TDK | C1005X7R1H104M |  | 0.1UF | CAP,CER,0.1UF,50V,20%,X7R,0402
C353 | 1 | TDK | C1005X7R1H104M |  | 0.1UF | CAP,CER,0.1UF,50V,20%,X7R,0402
C354 | 1 | TDK | C1005X7R1H104M |  | 0.1UF | CAP,CER,0.1UF,50V,20%,X7R,0402
C355 | 1 | TDK | C1005X7R1H104M |  | 0.1UF | CAP,CER,0.1UF,50V,20%,X7R,0402
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
D14 | 1 | LUMEX | SSF-LXH512SUGD |  | DUAL GREEN | LED,DUAL GREEN,T- 2MM,100MCD@20MA
D15 | 1 | DIALIGHT | 551-0209F |  | GREEN | LED,GREEN,DOMED TOP, 3MM ,16MCD @10MA
D16 | 1 | DIALIGHT | 551-0209F |  | GREEN | LED,GREEN,DOMED TOP, 3MM ,16MCD @10MA
D17 | 1 | DIALIGHT | 551-0409F |  | RED | LED,RED,DOMED TOP, 3MM ,10MCD@10MA
D18 | 1 | DIALIGHT | 551-0309F |  | YELLOW | LED,YELLOW,DOMED TOP, 3MM ,6.3MCD@10MA
D19 | 1 | DIALIGHT | 551-0209F |  | GREEN | LED,GREEN,DOMED TOP, 3MM ,16MCD @10MA
D2 | 1 | LUMEX | SSF-LXH512SUGD |  | DUAL GREEN | LED,DUAL GREEN,T- 2MM,100MCD@20MA
D20 | 1 | DIALIGHT | 551-0209F |  | GREEN | LED,GREEN,DOMED TOP, 3MM ,16MCD @10MA
D21 | 1 | LUMEX | SSF-LXH512SUGD |  | DUAL GREEN | LED,DUAL GREEN,T- 2MM,100MCD@20MA
D22 | 1 | LITE-ON INC | LTST-C170KGKT |  | GREEN | LED,GREEN,FLAT TOP, 1.4MM X 1.25MM ,35MCD @20MA
D23 | 1 | OSRAM | LB Y87S-M1N2-35-Z |  | BLUE | LED,BLUE,FLAT TOP, 1.7MM X 0.7MM ,31.5MCD @10MA
D24 | 1 | OSRAM | LB Y87S-M1N2-35-Z |  | BLUE | LED,BLUE,FLAT TOP, 1.7MM X 0.7MM ,31.5MCD @10MA
D25 | 1 | DIALIGHT | 597-3601-207F |  | BLUE | LED,BLUE,FLAT TOP, 2.4MM ,11.15MCD @10MA
D26 | 1 | LITE-ON INC | LTST-C170KGKT |  | GREEN | LED,GREEN,FLAT TOP, 1.4MM X 1.25MM ,35MCD @20MA
D28 | 1 | LITE-ON INC | LTST-C170KGKT |  | GREEN | LED,GREEN,FLAT TOP, 1.4MM X 1.25MM ,35MCD @20MA
D3 | 1 | LITE-ON INC | LTST-C170KGKT |  | GREEN | LED,GREEN,FLAT TOP, 1.4MM X 1.25MM ,35MCD @20MA
D4 | 1 | LITE-ON INC | LTST-C170KGKT |  | GREEN | LED,GREEN,FLAT TOP, 1.4MM X 1.25MM ,35MCD @20MA
D5 | 1 | SEMTECH | RCLAMP0504S.TCT |  | RCLAMP0504S.TCT | TVS,ARRAY,IC,LOWCAP,SOT23-6
D6 | 1 | BOURNS INC | SMAJ7.5A |  | SMAJ7.5A | DIODE,TVS,7.5V,400W,UNI,5%,SMA
D7 | 1 | BOURNS INC | SMAJ7.5A |  | SMAJ7.5A | DIODE,TVS,7.5V,400W,UNI,5%,SMA
D8 | 1 | FAIRCHILD SEMICONDUCTOR | MBR0530 |  | MBR0530 | DIODE,SCHOTTKY,30V,0.5A,SOD-123
D9 | 1 | ROHM SEMICONDUCTOR | RB080L-30TE25 |  | RB080L-30TE25 | DIODE,SCHOTTKY,30V,5A,PMDS
FB1 | 1 | MURATA | BLM18HG601SN1D |  | 600E | FERRITE BEAD,0603,Z=600E
FB10 | 1 | MURATA | BLM18HG601SN1D |  | 600E | FERRITE BEAD,0603,Z=600E
FB11 | 1 | MURATA | BLM18HG601SN1D |  | 600E | FERRITE BEAD,0603,Z=600E
FB12 | 1 | MURATA | BLM18HG601SN1D |  | 600E | FERRITE BEAD,0603,Z=600E
FB13 | 1 | MURATA | BLM18HG601SN1D |  | 600E | FERRITE BEAD,0603,Z=600E
FB14 | 1 | MURATA | BLM18PG121SN1D |  | 120E | FERRITE BEAD,0603,Z=120E
FB15 | 1 | MURATA | BLM18PG121SN1D |  | 120E | FERRITE BEAD,0603,Z=120E
FB16 | 1 | MURATA | BLM18PG121SN1D |  | 120E | FERRITE BEAD,0603,Z=120E
FB17 | 1 | MURATA | BLM18PG121SN1D |  | 120E | FERRITE BEAD,0603,Z=120E
FB18 | 1 | TAIYO YUDEN | FBMH2012HM121-T |  | 120E | FERRITE BEAD,0805,Z=120E
FB19 | 1 | MURATA | BLM18PG121SH1D |  | 120E | FERRITE BEAD,0603,Z=120E
FB2 | 1 | MURATA | BLM18HG601SN1D |  | 600E | FERRITE BEAD,0603,Z=600E
FB20 | 1 | MURATA | BLM18PG121SH1D |  | 120E | FERRITE BEAD,0603,Z=120E
FB21 | 1 | TAIYO YUDEN | FBMH2012HM121-T |  | 120E | FERRITE BEAD,0805,Z=120E
FB3 | 1 | MURATA | BLM18PG121SN1D |  | 120E | FERRITE BEAD,0603,Z=120E
FB4 | 1 | MURATA | BLM18HG601SN1D |  | 600E | FERRITE BEAD,0603,Z=600E
FB5 | 1 | MURATA | BLM18HG601SN1D |  | 600E | FERRITE BEAD,0603,Z=600E
FB6 | 1 | MURATA | BLM18PG121SN1D |  | 120E | FERRITE BEAD,0603,Z=120E
FB7 | 1 | MURATA | BLM18HG601SN1D |  | 600E | FERRITE BEAD,0603,Z=600E
FB8 | 1 | MURATA | BLM18HG601SN1D |  | 600E | FERRITE BEAD,0603,Z=600E
FB9 | 1 | MURATA | BLM18HG601SN1D |  | 600E | FERRITE BEAD,0603,Z=600E
G1 | 1 | FCI | 10045597-107LF |  | Guide Socket | GUIDE SOCKET,10.8MM,RA
G2 | 1 | FCI | 10045597-107LF |  | Guide Socket | GUIDE SOCKET,10.8MM,RA
J1 | 1 | TE CONNECTIVITY | 2013310-1 |  | DDR3 SDRAM | CONNECTOR,DDR3 SDRAM,204,SMT
J2 | 1 | TE CONNECTIVITY | 5103309-3 |  | HEADER | HEADER,2 x 8,2.54mm,TH,GOLD
J3 | 1 | JAE ELECTRONICS | ST1W008S4AR1500 |  | MICRO SD | CONNECTOR,MICRO SD,8,SMT,RA
J4 | 1 | MOLEX | 5000750517 |  | USB - OTG Mini-B | CONNECTOR,USB MINI-B,TH,VERTICAL
J5 | 1 | MOLEX | 15916102 |  | HEADER | HEADER,2 x 5,2.54mm,SM,GOLD
J6 | 1 | FCI | 10045267-111LF |  | HEADER | HEADER,9 x 8,2mm,TH,RA
J7 | 1 | FCI | 10028917-001LF |  | HEADER | HEADER,2 x 2,2mm,TH,RA
J8 | 1 | MOLEX | 22-28-5033 |  | HEADER | HEADER,1 x 3,2.54mm,TH,VERTICAL
J9 | 1 | FCI | 10039851-111LF |  | HEADER | HEADER,9 x 6,2mm,TH,RA
L10 | 1 | TDK CORPORATION | SLF10165T-2R2N6R33PF |  | 2.2uH | INDUCTOR,POWER,2.2UH,6.3A, SMD
L5 | 1 | TDK CORPORATION | MLP2520S4R7S |  | 4.7uH | INDUCTOR,MULTILAYER,4.7UH,1A,1008
L8 | 1 | BOURNS INC | SRP7030-6R8FM |  | 6.8uH | INDUCTOR,POWER,6.8UH,4.5A,SMD
L9 | 1 | TDK CORPORATION | SLF10165T-2R2N6R33PF |  | 2.2uH | INDUCTOR,POWER,2.2UH,6.3A, SMD
Q1 | 1 | NXPSEMICONDUCTORS | 2N7002PW,115 |  | 2N7002PW,115 | MOSFET,N-CH,SGL,60V,31A,SOT-323
Q10 | 1 | NXPSEMICONDUCTORS | 2N7002PW,115 |  | 2N7002PW,115 | MOSFET,N-CH,SGL,60V,31A,SOT-323
Q11 | 1 | NXPSEMICONDUCTORS | 2N7002PW,115 |  | 2N7002PW,115 | MOSFET,N-CH,SGL,60V,31A,SOT-323
Q2 | 1 | VISHAY | SIR462DP-T1-GE3 |  | SIR462DP-T1-GE3 | MOSFET,N-CH,30V,30A,PPAK,8SOIC
Q3 | 1 | VISHAY | SIR462DP-T1-GE3 |  | SIR462DP-T1-GE3 | MOSFET,N-CH,30V,30A,PPAK,8SOIC
Q4 | 1 | VISHAY | SIR462DP-T1-GE3 |  | SIR462DP-T1-GE3 | MOSFET,N-CH,30V,30A,PPAK,8SOIC
Q5 | 1 | INTERNATIONAL RECTIFIER | IRF7821TRPBF |  | IRF7821TRPBF | MOSFET,N-CH,30V,13.6A,8-SOIC
Q6 | 1 | INTERNATIONAL RECTIFIER | IRF7832TRPBF |  | IRF7832TRPBF | MOSFET,N-CH,30V,20A,8-SOIC
Q7 | 1 | INTERNATIONAL RECTIFIER | IRF7821TRPBF |  | IRF7821TRPBF | MOSFET,N-CH,30V,13.6A,8-SOIC
Q8 | 1 | INTERNATIONAL RECTIFIER | IRF7832TRPBF |  | IRF7832TRPBF | MOSFET,N-CH,30V,20A,8-SOIC
Q9 | 1 | NXPSEMICONDUCTORS | 2N7002PW,115 |  | 2N7002PW,115 | MOSFET,N-CH,SGL,60V,31A,SOT-323
R1 | 1 | YAGEO | RC0603FR-0710KL |  | 10K | RESISTOR,10K,0.1,1%,R0603
R10 | 1 | YAGEO | RC0603JR-070RL |  | 0E | RESISTOR,0E,0.1,-,R0603
R100 | 1 | YAGEO | RC0603FR-0733RL |  | 33E | RESISTOR,33E,0.1,1%,R0603
R101 | 1 | YAGEO | RC0603FR-0733RL |  | 33E | RESISTOR,33E,0.1,1%,R0603
R102 | 1 | PANASONIC - ECG | ERJ-3EKF6491V |  | 6.49K | RESISTOR,6.49K,0.1,1%,R0603
R103 | 1 | YAGEO | RC0603FR-074K7L |  | 4.7K | RESISTOR,4.7K,0.1,1%,R0603
R104 | 1 | YAGEO | RC0603JR-070RL |  | 0E | RESISTOR,0E,0.1,-,R0603
R105 | 1 | YAGEO | RC0603FR-074K7L |  | 4.7K | RESISTOR,4.7K,0.1,1%,R0603
R106 | 1 | YAGEO | RC0603JR-070RL |  | 0E | RESISTOR,0E,0.1,-,R0603
R107 | 1 | YAGEO | RC0603FR-074K7L |  | 4.7K | RESISTOR,4.7K,0.1,1%,R0603
R108 | 1 | YAGEO | RC0603FR-074K7L |  | 4.7K | RESISTOR,4.7K,0.1,1%,R0603
R109 | 1 | YAGEO | RC0603FR-074K7L |  | 4.7K | RESISTOR,4.7K,0.1,1%,R0603
R11 | 1 | YAGEO | RC0603JR-070RL |  | 0E | RESISTOR,0E,0.1,-,R0603
R110 | 1 | YAGEO | RC0603FR-074K7L |  | 4.7K | RESISTOR,4.7K,0.1,1%,R0603
R111 | 1 | YAGEO | RC0603FR-074K7L |  | 4.7K | RESISTOR,4.7K,0.1,1%,R0603
R112 | 1 | YAGEO | RC0603JR-070RL |  | 0E | RESISTOR,0E,0.1,-,R0603
R113 | 1 | YAGEO | RC0603FR-074K7L |  | 4.7K | RESISTOR,4.7K,0.1,1%,R0603
R114 | 1 | YAGEO | RC0603FR-0733RL |  | 33E | RESISTOR,33E,0.1,1%,R0603
R115 | 1 | YAGEO | RC0603FR-0733RL |  | 33E | RESISTOR,33E,0.1,1%,R0603
R116 | 1 | YAGEO | RC0603FR-0733RL |  | 33E | RESISTOR,33E,0.1,1%,R0603
R117 | 1 | YAGEO | RC0603FR-0733RL |  | 33E | RESISTOR,33E,0.1,1%,R0603
R118 | 1 | YAGEO | RC0603FR-074K7L |  | 4.7K | RESISTOR,4.7K,0.1,1%,R0603
R119 | 1 | YAGEO | RC0603FR-074K7L |  | 4.7K | RESISTOR,4.7K,0.1,1%,R0603
R12 | 1 | YAGEO | RC0603JR-070RL |  | 0E | RESISTOR,0E,0.1,-,R0603
R120 | 1 | YAGEO | RC0603FR-074K7L |  | 4.7K | RESISTOR,4.7K,0.1,1%,R0603
R121 | 1 | YAGEO | RC0603FR-074K7L |  | 4.7K | RESISTOR,4.7K,0.1,1%,R0603
R122 | 1 | YAGEO | RC0603FR-074K7L |  | 4.7K | RESISTOR,4.7K,0.1,1%,R0603
R123 | 1 | YAGEO | RC0603FR-074K7L |  | 4.7K | RESISTOR,4.7K,0.1,1%,R0603
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
R96 | 1 | YAGEO | RC0603FR-0710KL |  | 10K | RESISTOR,10K,0.1,1%,R0603
R97 | 1 | YAGEO | RC0603FR-074K7L |  | 4.7K | RESISTOR,4.7K,0.1,1%,R0603
R98 | 1 | YAGEO | RC0603FR-0733RL |  | 33E | RESISTOR,33E,0.1,1%,R0603
R99 | 1 | YAGEO | RC0603FR-0733RL |  | 33E | RESISTOR,33E,0.1,1%,R0603
SW1 | 1 | E-SWITCH | TL1105XF100Q |  | SPST | SWITCH,TACT,SPST-NO,0.05A,12V
T1 | 1 | PULSE | HX1188NL |  | HX1188NL | XFORMER,SGL,ETHR LAN,16-SOIC
TP1 | 1 | NA | NA |  | TEST-PAD | TEST PAD
TP10 | 1 | NA | NA |  | TEST-PAD | TEST PAD
TP11 | 1 | NA | NA |  | TEST-PAD | TEST PAD
TP12 | 1 | NA | NA |  | TEST-PAD | TEST PAD
TP13 | 1 | NA | NA |  | TEST-PAD | TEST PAD
TP14 | 1 | NA | NA |  | TEST-PAD | TEST PAD
TP15 | 1 | NA | NA |  | TEST-PAD | TEST PAD
TP16 | 1 | KEYSTONE ELECTRONICS | 5014 |  | Test Point | TEST POINT, PC MULTI PURPOSE YEL
TP17 | 1 | KEYSTONE ELECTRONICS | 5014 |  | Test Point | TEST POINT, PC MULTI PURPOSE YEL
TP18 | 1 | KEYSTONE ELECTRONICS | 5014 |  | Test Point | TEST POINT, PC MULTI PURPOSE YEL
TP19 | 1 | KEYSTONE ELECTRONICS | 5014 |  | Test Point | TEST POINT, PC MULTI PURPOSE YEL
TP2 | 1 | NA | NA |  | TEST-PAD | TEST PAD
TP20 | 1 | KEYSTONE ELECTRONICS | 5014 |  | Test Point | TEST POINT, PC MULTI PURPOSE YEL
TP21 | 1 | KEYSTONE ELECTRONICS | 5014 |  | Test Point | TEST POINT, PC MULTI PURPOSE YEL
TP22 | 1 | KEYSTONE ELECTRONICS | 5014 |  | Test Point | TEST POINT, PC MULTI PURPOSE YEL
TP23 | 1 | KEYSTONE ELECTRONICS | 5014 |  | Test Point | TEST POINT, PC MULTI PURPOSE YEL
TP24 | 1 | KEYSTONE ELECTRONICS | 5014 |  | Test Point | TEST POINT, PC MULTI PURPOSE YEL
TP25 | 1 | KEYSTONE ELECTRONICS | 5014 |  | Test Point | TEST POINT, PC MULTI PURPOSE YEL
TP26 | 1 | KEYSTONE ELECTRONICS | 5014 |  | Test Point | TEST POINT, PC MULTI PURPOSE YEL
TP27 | 1 | NA | NA |  | TEST-PAD | TEST PAD
TP28 | 1 | NA | NA |  | TEST-PAD | TEST PAD
TP29 | 1 | NA | NA |  | TEST-PAD | TEST PAD
TP3 | 1 | NA | NA |  | TEST-PAD | TEST PAD
TP30 | 1 | NA | NA |  | TEST-PAD | TEST PAD
TP31 | 1 | NA | NA |  | TEST-PAD | TEST PAD
TP32 | 1 | NA | NA |  | TEST-PAD | TEST PAD
TP33 | 1 | NA | NA |  | TEST-PAD | TEST PAD
TP34 | 1 | NA | NA |  | TEST-PAD | TEST PAD
TP4 | 1 | NA | NA |  | TEST-PAD | TEST PAD
TP5 | 1 | NA | NA |  | TEST-PAD | TEST PAD
TP6 | 1 | NA | NA |  | TEST-PAD | TEST PAD
TP7 | 1 | NA | NA |  | TEST-PAD | TEST PAD
TP8 | 1 | NA | NA |  | TEST-PAD | TEST PAD
TP9 | 1 | NA | NA |  | TEST-PAD | TEST PAD
U1 | 1 | FREESCALE | P1021NXN2HFB |  | MPU | MPU 800MHZ 689-TEPBGA2
U10 | 1 | ICS | ICS553MILF |  | BUFFER | CLK BUFFER 1:4 LO SKEW 8-SOIC
U11 | 1 | ICS | ICS553MILF |  | BUFFER | CLK BUFFER 1:4 LO SKEW 8-SOIC
U12 | 1 | ABRACON COPERATION | ASFLMB-50.000MHZ-LY-T |  | 50MHZ | OSC,MEMS,50.000MHZ,SMD
U13 | 1 | SMSC | LAN8720Ai |  | ETHERNET | ETHERNET 10/100 PHY RMII 24QFN
U14 | 1 | SMSC | LAN8720Ai |  | ETHERNET | ETHERNET 10/100 PHY RMII 24QFN
U15 | 1 | MICREL INC | KSZ8721BLI |  | DRIVER | DRIVER,TRANSCEIVER,PHY 10/100, 3.3V,48LQFP
U16 | 1 | NXP SEMICONDUCTORS | PCA9555BS,118 |  | I/O EXPANDER | I/O EXPANDER I2C-BUS 16BIT WITH INTERRUPT
U17 | 1 | ICS | ICS553MILF |  | BUFFER | CLK BUFFER 1:4 LO SKEW 8-SOIC
U18 | 1 | ABRACON COPERATION | ASFLMB-50.000MHZ-LY-T |  | 50MHZ | OSC,MEMS,50.000MHZ,SMD
U19 | 1 | MICREL INC | KSZ8721BLI |  | DRIVER | DRIVER,TRANSCEIVER,PHY 10/100, 3.3V,48LQFP
U2 | 1 | ICS | ICS553MILF |  | BUFFER | CLK BUFFER 1:4 LO SKEW 8-SOIC
U20 | 1 | ON SEMICONDUCTOR | MC74LCX125DTR2G |  | BUFFER | BUFF TRI-ST QD CMOS 14TSSOP
U21 | 1 | ATHEROS | AR8031 |  | TRNSCVR | 10/100/1000 GIGABIT ETHERNET TRANSCEIVER
U22 | 1 | IDT | ICS557MI-01LF |  | CLOCK SOURCE | CLK SOURCE PCI-EXPRESS 8-SOIC
U23 | 1 | ANALOG DEVICES | ADT7410TRZ |  | TEMP SENS | TEMPERATURE SENSOR ±0.5°C 16-BITI I2C
U24 | 1 | STMICROELECTRONICS | M24256-BWMN6TP |  | EEPROM | EEPROM 256KBIT 400KHZ 8SOIC
U25 | 1 | INTERSIL | ISL12022IBZ |  | RTC | RTC WITH ON CHIP ±5PPM TEMP COMPENSATION
U26 | 1 | ATMEL | AT24C01BN-SH-B |  | EEPROM | EEPROM 1KBIT 1MHZ 8SOIC
U27 | 1 | SPANSION | S25FL128P0XNFI001 |  | FLASH | 128MBIT 3V SPI FLASH MEMORY
U28 | 1 | MAXIM INTEGRATED PRODUCTS | MAX3227ECUE+ |  | TRNSCVR | TXRX RS232 1MBPS SD 16TSSOP
U29 | 1 | BECKHOFF | ET1100 |  | ETHERCATCNTRLR | ETHERCAT SLAVE CONTROLLER
U3 | 1 | EVERSPIN | MR0A08BCYS35 |  | RAM | MRAM 1MBIT 35NS 44TSOP
U30 | 1 | MICROCHIP TECHNOLOGY | 24LC16B-I/SN |  | EEPROM | EEPROM,16KBIT,400KHZ,8SOIC
U31 | 1 | SMSC | USB3300-EZK |  | CONTROLLER | USB HOST/OTG PHY ULPI 32-QFN
U32 | 1 | TEXAS INSTRUMENTS | TS3L110RGYR |  | ETHRNET SWITCH | ETHERNET SWITCH QUAD 16VQFN
U33 | 1 | MICREL INC | MIC2505-1YM |  | SW HIGH SIDE | SW HIGH SIDE SGL 2A 8SOIC
U34 | 1 | TEXAS INSTRUMENTS | TS3L110RGYR |  | ETHRNET SWITCH | ETHERNET SWITCH QUAD 16VQFN
U35 | 1 | TEXAS INSTRUMENTS | TS3L110RGYR |  | ETHRNET SWITCH | ETHERNET SWITCH QUAD 16VQFN
U36 | 1 | TEXAS INSTRUMENTS | TS3L110RGYR |  | ETHRNET SWITCH | ETHERNET SWITCH QUAD 16VQFN
U37 | 1 | TEXAS INSTRUMENTS | TS3L110RGYR |  | ETHRNET SWITCH | ETHERNET SWITCH QUAD 16VQFN
U38 | 1 | TEXAS INSTRUMENTS | TS3L110RGYR |  | ETHRNET SWITCH | ETHERNET SWITCH QUAD 16VQFN
U39 | 1 | TEXAS INSTRUMENTS | SN74CB3Q3245RGYR |  | SWITCH BUS | SWITCH BUS 8BIT FET 20-VQFN
U4 | 1 | ON SEMICONDUCTOR | MC74LCX373DTG |  | LATCH TRANSP | LATCH TRANSP OCT LV 20-TSSOP
U40 | 1 | MAXIM INTEGRATED PRODUCTS | MAX16052AUT+T |  | PWR MONITOR | PWR MONITOR/SEQUENCER SOT23-6
U41 | 1 | TEXAS INSTRUMENTS | SN74LVC541ARGYR |  | BUFFER | BUFF/DVR TRI-ST 8BIT 20-VQFN
U42 | 1 | ALTERA | EPM3064ATI44-10N |  | CPLD | CPLD,MAX,3000A,64,44-TQFP
U43 | 1 | LINEAR TECHNOLOGY | LTC4227IUFD-1#PBF |  | HOTSWAP | HOT SWAP CONTROLLER,20-QFN
U44 | 1 | TEXAS INSTRUMENTS | TPS54332DDA |  | DCCONV | 3.5A,BUCK,DC-DC,CONVERTOR
U45 | 1 | TEXAS INSTRUMENTS | TPS76850QPWP |  | REGULATOR | LDO VOLT REG, 5V, 1A, 20-HTSSOP
U46 | 1 | TEXAS INSTRUMENTS | TPS51116PWPR |  | DDR SYNC | DDR SYNC BUC CTRL REF20HTSSOP
U47 | 1 | NATIONAL SEMICONDUCTOR | LM3495MTC/NOPB |  | REGULATOR | PWM BUCK REG LOW-OUT 16-TSSOP
U48 | 1 | MAXIM INTEGRATED PRODUCTS | DS1834AS+ |  | ECONORST | ECONORST DUAL LO OPN-DR 8SOIC
U49 | 1 | TEXAS INSTRUMENTS | TS3L110RGYR |  | ETHRNET SWITCH | ETHERNET SWITCH QUAD 16VQFN
U5 | 1 | ON SEMICONDUCTOR | MC74LCX373DTG |  | LATCH TRANSP | LATCH TRANSP OCT LV 20-TSSOP
U50 | 1 | TEXAS INSTRUMENTS | TS3L110RGYR |  | ETHRNET SWITCH | ETHERNET SWITCH QUAD 16VQFN
U51 | 1 | TEXAS INSTRUMENTS | TS3L110RGYR |  | ETHRNET SWITCH | ETHERNET SWITCH QUAD 16VQFN
U52 | 1 | TEXAS INSTRUMENTS | SN74LVC541ARGYR |  | BUFFER | BUFF/DVR TRI-ST 8BIT 20-VQFN
U53 | 1 | FOX ELECTRONICS | FXO-HC536R-25 |  | 25MHZ | OSC 25.000 MHZ 3.3V SMD
U54 | 1 | TEXAS INSTRUMENTS | SN74LVC1G04DBVR |  | INVERTER | SINGLE INVERTER-GATE SOT-23-5
U55 | 1 | FAIRCHILD SEMICONDUCTOR | NC7WZ240K8X |  | INVERTER | INVERTER DUAL 4-INPUT
U56 | 1 | FAIRCHILD SEMICONDUCTOR | NC7WZ240K8X |  | INVERTER | INVERTER DUAL 4-INPUT
U6 | 1 | NXP SEMICONDUCTORS | PCA9515D,112 |  | REPEATER | I2C BUS REPEATER 8-SOIC
U7 | 1 | SAMSUNG | K9F1G08U0D-SIB0 |  | NAND FLASH | 1GB NAND FLASH
U8 | 1 | ABRACON COPERATION | ASFLMB-50.000MHZ-LY-T |  | 50MHZ | OSC,MEMS,50.000MHZ,SMD
U9 | 1 | ABRACON COPERATION | ECS-3963-666-BN-TR |  | 66.66MHZ | OSC,66.666MHZ,3.0V,SMD
Y1 | 1 | ABRACON CORPORATION | ABM8G-25.000MHZ-18-D2Y-T |  | 25MHz | XYSTAL,25MHZ,18PF,LOAD
Y2 | 1 | ABRACON CORPORATION | ABM8G-25.000MHZ-18-D2Y-T |  | 25MHz | XYSTAL,25MHZ,18PF,LOAD
Y3 | 1 | ABRACON CORPORATION | ABS07-32.768KHZ-T |  | 32.768KHZ | XYSTAL,32.768KHZ,12.5PF,LOAD
Y4 | 1 | ABRACON CORPORATION | ABM8G-25.000MHZ-18-D2Y-T |  | 25MHz | XYSTAL,25MHZ,18PF,LOAD
Y5 | 1 | ABRACON CORPORATION | ABM8G-24.000MHZ-18-D2Y-T |  | 24MHz | XYSTAL,24MHZ,18PF,LOAD

Sheet: expanded APP-Rev2.xls
Refdes | Quantity | Manufacturer | Manufacturer PN | Footprint | Value | Description
BT1 | 1 | Renata | SMTU2430-LF.TR |  | CR2430 BAT HOLDER | Battery Holders CR2430 Snaps & Contacts
C1 | 1 | Murata | GRM188R71H104KA93D |  | 0.1uF | CAP CER .1UF 50V 10% X7R 0603
C10 | 1 | Murata | GRM188R71H103KA01D |  | 0.01uF | CAP CER 10000PF 50V 10% X7R 0603
C100 | 1 | Murata | GRM188R71H104KA93D |  | 0.1uF | CAP CER .1UF 50V 10% X7R 0603
C101 | 1 | Murata | GRM188R71H104KA93D |  | 0.1uF | CAP CER .1UF 50V 10% X7R 0603
C102 | 1 | Murata | GRM21BR71A106KE51L |  | 10uF | CAP CER 10UF 10V X7R 0805
C103 | 1 | TDK Corporation | C1005X7R1H104M |  | 0.1uF | CAP CER .10UF 50V X7R 20% 0402
C104 | 1 | TDK Corporation | C1005X7R1H104M |  | 0.1uF | CAP CER .10UF 50V X7R 20% 0402
C105 | 1 | TDK Corporation | C1005X7R1H104M |  | 0.1uF | CAP CER .10UF 50V X7R 20% 0402
C106 | 1 | TDK Corporation | C1005X7R1H104M |  | 0.1uF | CAP CER .10UF 50V X7R 20% 0402
C107 | 1 | TDK Corporation | C1005X7R1H104M |  | 0.1uF | CAP CER .10UF 50V X7R 20% 0402
C108 | 1 | TDK Corporation | C1005X7R1H104M |  | 0.1uF | CAP CER .10UF 50V X7R 20% 0402
C109 | 1 | TDK Corporation | C1005X7R1H104M |  | 0.1uF | CAP CER .10UF 50V X7R 20% 0402
C11 | 1 | Murata | GRM21BR71A106KE51L |  | 10uF | CAP CER 10UF 10V X7R 0805
C110 | 1 | TDK Corporation | C1005X7R1H104M |  | 0.1uF | CAP CER .10UF 50V X7R 20% 0402
C111 | 1 | TDK Corporation | C1005X7R1H104M |  | 0.1uF | CAP CER .10UF 50V X7R 20% 0402
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
C22 | 1 | Murata | GRM21BR71A106KE51L |  | 10uF | CAP CER 10UF 10V X7R 0805
C220 | 1 | Murata | GRM155R71H103KA88D |  | 0.01uF | CAP CER 10000PF 50V X7R 0402
C221 | 1 | Murata | GRM155R71H103KA88D |  | 0.01uF | CAP CER 10000PF 50V X7R 0402
C222 | 1 | Murata | GRM155R71H103KA88D |  | 0.01uF | CAP CER 10000PF 50V X7R 0402
C223 | 1 | Murata | GRM155R71H103KA88D |  | 0.01uF | CAP CER 10000PF 50V X7R 0402
C224 | 1 | Murata | GRM155R71H103KA88D |  | 0.01uF | CAP CER 10000PF 50V X7R 0402
C225 | 1 | Murata | GRM155R71H103KA88D |  | 0.01uF | CAP CER 10000PF 50V X7R 0402
C226 | 1 | Murata | GRM155R71H103KA88D |  | 0.01uF | CAP CER 10000PF 50V X7R 0402
C227 | 1 | TDK Corporation | C1005X7R1H104M |  | 0.1uF | CAP CER .10UF 50V X7R 20% 0402
C228 | 1 | TDK Corporation | C1005X7R1H104M |  | 0.1uF | CAP CER .10UF 50V X7R 20% 0402
C229 | 1 | TDK Corporation | C1005X7R1H104M |  | 0.1uF | CAP CER .10UF 50V X7R 20% 0402
C23 | 1 | Murata | GRM188R71H104KA93D |  | 0.1uF | CAP CER .1UF 50V 10% X7R 0603
C230 | 1 | TDK Corporation | C1005X7R1H104M |  | 0.1uF | CAP CER .10UF 50V X7R 20% 0402
C231 | 1 | Murata | GRM155R71H103KA88D |  | 0.01uF | CAP CER 10000PF 50V X7R 0402
C232 | 1 | Murata | GRM155R71H103KA88D |  | 0.01uF | CAP CER 10000PF 50V X7R 0402
C233 | 1 | Murata | GRM155R71H103KA88D |  | 0.01uF | CAP CER 10000PF 50V X7R 0402
C234 | 1 | TDK Corporation | C1005X7R1H104M |  | 0.1uF | CAP CER .10UF 50V X7R 20% 0402
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
