Sayidathahaseen/CCC_NGP_ODC/NGP_ODC_Main/PDLC/Prodigy HW files/Backplane/Rev C/BOM/18-600100-001_revC.xls

Sheet: REV C BOM
Item | Qty | Reference | Manufacturer | Manufacturer Part Number | Description | CCC P/N
1 | 2 | C417 C419 | AVX | 06033C104KAT2A | CAP CER 0.1UF 25V 10% X7R 0603
2 | 2 | C413-414 | AVX | 06035C104KAT?A | CAP,CER SMC,0.1UF,50V,10%,0603,X7R | 31-006650-104
3 | 206 | C2 C4 C6 C8 C10 C12 C14 C16 C18 C20 C22 C24 C26 C28 C30 C32 C34 C36 C38 C40 C42 C44 C46 C48 C50 C52 C54 C56 C58 C60 C62 C64 C66 C68 C70 C72 C74 C76 C78 C80 C82 C84 C86 C88 C90 C92 C94 C96 C98 C100 C102 C104 C106 C108 C110 C112 C114 C116 C118 C120 C122 C124 C126 C128 C130 C132 C134 C136 C138 C140 C142 C144 C146 C148 C150 C152 C154 C156 C158 C160 C162 C164 C166 C168 C170 C172 C174 C176 C178 C180 C182 C184 C186 C188 C190 C192 C194 C196 C198 C200 C202 C204 C206 C208 C210 C212 C214 C216 C218 C220 C222 C224 C226 C228 C230 C232 C234 C236 C238 C240 C242 C244 C246 C248 C250 C252 C254 C256 C258 C260 C262 C264 C266 C268 C270 C272 C274 C276 C278 C280 C282 C284 C286 C288 C290 C292 C294 C296 C298 C300 C302 C304 C306 C308 C310 C312 C314 C316 C318 C320 C322 C324 C326 C328 C330 C332 C334 C336 C338 C340 C342 C344 C346 C348 C350 C352 C354 C356 C358 C360 C362 C364 C366 C368 C370 C372 C374 C376 C378 C380 C382 C384 C386 C388 C390 C392 C394 C396 C398 C400 C402 C404 C406 C408 C410 C412 | KEMET | C0805X104K5RACTU | CAP,CER SMC,0.1UF,50V,0805,10%,X7R | 31-006554-104
4 | 38 | C3 C23 C25 C27 C29 C31 C33 C35 C37 C39 C41 C43 C45 C47 C49 C51 C53 C55 C57 C59 C61 C63 C65 C67 C69 C71 C73 C75 C77 C79 C81 C83 C85 C87 C89 C91 C93 C95 | AVX | TPSC106K016R0500 | CAP,TAN SMC,10UF,16V,C CASE,10% | 31-007316-106
5 | 84 | C169 C171 C173 C175 C177 C179 C181 C183 C185 C187 C189 C191 C193 C195 C197 C199 C201 C203 C209 C211 C213 C215 C217 C219 C221 C223 C225 C227 C229 C231 C233 C235 C237 C239 C241 C243 C245 C247 C249 C251 C253 C255 C281 C283 C285 C287 C289 C291 C293 C295 C297 C299 C301 C303 C353 C355 C357 C359 C361 C363 C365 C367 C369 C371 C373 C375 C377 C379 C381 C383 C385 C387 C389 C391 C393 C395 C397 C399 C401 C403 C405 C407 C409 C411 | VISHAY | TR3D106K050C0450 | CAP,TAN SMC,10UF,50V,D CASE,10%,LO PRO | 31-007250-106
6 | 36 | C1 C5 C7 C9 C11 C13 C15 C17 C19 C21 C101 C107 C113 C119 C125 C131 C137 C143 C149 C155 C161 C167 C205 C207 C257 C259 C261 C263 C265 C267 C269 C271 C273 C275 C277 C279 | KEMET | T495X106K050ATE300 | CAP,TAN SMC,10UF,50V,X CASE,10% | 31-007050-106
7 | 2 | C415-416 | AVX | 12065C105KAT?A | CAP,CER SMC,1UF,50V,10%,1206, X7R | 31-006051-105
8 | 2 | C418 C420 | Kemet | C1210X226K8RACTU | CAP CER 22UF 10V 10% X7R 1210
9 | 48 | C97 C99 C103 C105 C109 C111 C115 C117 C121 C123 C127 C129 C133 C135 C139 C141 C145 C147 C151 C153 C157 C159 C163 C165 C305 C307 C309 C311 C313 C315 C317 C319 C321 C323 C325 C327 C329 C331 C333 C335 C337 C339 C341 C343 C345 C347 C349 C351 | KEMET | C1812X475K5RACTU | CAP,CER SMC,4.7UF,50V,1812,10%,X7R | 31-006102-475
10 | 1 | J1 | FCI | 20020620-M141A01LF | TERM BLOCK,PLUG,14 POS,7.62MM | 20-002585-F14
11 | 12 | J18-19 J22 J25 J28 J31 J34 J37 J40 J43 J46 J49 | FCI | 10061290-554555PLF | RECEPTACLE,TH,6POS,PRESS,AIRMAX | 20-000628-006
12 | 6 | J4-7 J11-LT J8-RT | FCI | 10043546-101LF | RECEPTACLE,TH,9X6,PRESS,AIRMAX | 20-000628-096
13 | 30 | J10-RB J14-LT J15-LB J16-RT J17-RB J20-T J21-B J23-T J24-B J26-T J27-B J29-T J30-B J32-T J33-B J35-T J36-B J38-T J39-B J41-T J42-B J44-T J45-B J47-T J48-B J50-T J51-B J53-T J54-B J9-LB | FCI | 10045271-101LF | RECEPTACLE,9 x 8,1.40mm,TH | 20-000628-098
14 | 12 | J56-L J57-R J58-L J59-R J60-L J61-R J62-L J63-R J64-L J65-R J66-L J67-R | FCI | 10016537-101LF | RECEPTACLE,15 x 10,2mm,TH,VERTICAL | 20-000628-150
15 | 4 | J12-13 J52 J55 | FCI | 10028916-4554P00LF | RECEPTACLE,TH,2X2,PRESS,AIRMAX | 20-000628-022
16 | 2 | J2-L J3-R | FCI | 51740-10401204AA | CONN,12 SIG,8 POWER,REC,PWRBLADE | 20-001339-002
17 | 4 | D1-4 | DIODES INC. | DFLS160-7 | DIODE,SCHOTTKY,60V,1A,2-SMD | 32-000180-060
18 | 28 | G1-28 | FCI | 10037910-101LF | GUIDE PIN,TH,AIRMAX | 20-001337-G02
19 | 2 | U1-2 | ST MICROELECTRONICS | M24M02-DRMN6?P | IC EEPROM 2MBIT 1MHZ 8SO
20 | 2 | U3-4 | TEXAS INSTRUMENTS | LM2936DTX-3.3/NOPB | REGULATOR,LDO,3.3V,0.05A,PFM PACK
21 | 3 | FD1-3 |  |  | FIDUCIAL
22 | 25 | MH1-6 MH27-30 MH32 MH34-39 MH41 MH43-48 MH65 | NA | NA | Mounting Hole | 59-999NON-POP
23 | 12 | MH49-60 | PENN ENGINEERING & MFG. | KF2-632-ET | STANDOFF,6-32 THRD,0.065H,SS PEM | 00-021300-028
24 | 2 | TP_3V3_A TP_3V3_B | NA | NA | TEST PAD | TBD
25 | 4 | F1-4 | LITTLEFUSE | 2016L050MR | PTC,RESET FUSE,550MA,60V,2016 | 33-000900-050
26 | 4 | R2-3 R6-7 | KOA | RK73H1JT**1002F | RESISTOR SMR,10K,1/10W,1%,0603 | 30-016210-103
27 | 1 | SW1 | Copal Electronics Inc | SH-7070TB | SWITCH ROTARY HEX COMP 16POS 5V

Sheet: REV B BOM
Item | Qty | Reference | Manufacturer | Manufacturer Part Number | Description | CCC P/N
1 | 206 | C2 C4 C6 C8 C10 C12 C14 C16 C18 C20 C22 C24 C26 C28 C30 C32 C34 C36 C38 C40 C42 C44 C46 C48 C50 C52 C54 C56 C58 C60 C62 C64 C66 C68 C70 C72 C74 C76 C78 C80 C82 C84 C86 C88 C90 C92 C94 C96 C98 C100 C102 C104 C106 C108 C110 C112 C114 C116 C118 C120 C122 C124 C126 C128 C130 C132 C134 C136 C138 C140 C142 C144 C146 C148 C150 C152 C154 C156 C158 C160 C162 C164 C166 C168 C170 C172 C174 C176 C178 C180 C182 C184 C186 C188 C190 C192 C194 C196 C198 C200 C202 C204 C206 C208 C210 C212 C214 C216 C218 C220 C222 C224 C226 C228 C230 C232 C234 C236 C238 C240 C242 C244 C246 C248 C250 C252 C254 C256 C258 C260 C262 C264 C266 C268 C270 C272 C274 C276 C278 C280 C282 C284 C286 C288 C290 C292 C294 C296 C298 C300 C302 C304 C306 C308 C310 C312 C314 C316 C318 C320 C322 C324 C326 C328 C330 C332 C334 C336 C338 C340 C342 C344 C346 C348 C350 C352 C354 C356 C358 C360 C362 C364 C366 C368 C370 C372 C374 C376 C378 C380 C382 C384 C386 C388 C390 C392 C394 C396 C398 C400 C402 C404 C406 C408 C410 C412 | KEMET | C0805X104K5RACTU | CAP,CER SMC,0.1UF,50V,0805,10%,X7R | 31-006554-104
2 | 38 | C3 C23 C25 C27 C29 C31 C33 C35 C37 C39 C41 C43 C45 C47 C49 C51 C53 C55 C57 C59 C61 C63 C65 C67 C69 C71 C73 C75 C77 C79 C81 C83 C85 C87 C89 C91 C93 C95 | AVX | TPSC106K016R0500 | CAP,TAN SMC,10UF,16V,C CASE,10% | 31-007316-106
3 | 84 | C169 C171 C173 C175 C177 C179 C181 C183 C185 C187 C189 C191 C193 C195 C197 C199 C201 C203 C209 C211 C213 C215 C217 C219 C221 C223 C225 C227 C229 C231 C233 C235 C237 C239 C241 C243 C245 C247 C249 C251 C253 C255 C281 C283 C285 C287 C289 C291 C293 C295 C297 C299 C301 C303 C353 C355 C357 C359 C361 C363 C365 C367 C369 C371 C373 C375 C377 C379 C381 C383 C385 C387 C389 C391 C393 C395 C397 C399 C401 C403 C405 C407 C409 C411 | VISHAY | TR3D106K050C0450 | CAP,TAN SMC,10UF,50V,D CASE,10%,LO PRO | 31-007250-106
4 | 36 | C1 C5 C7 C9 C11 C13 C15 C17 C19 C21 C101 C107 C113 C119 C125 C131 C137 C143 C149 C155 C161 C167 C205 C207 C257 C259 C261 C263 C265 C267 C269 C271 C273 C275 C277 C279 | KEMET | T495X106K050ATE300 | CAP,TAN SMC,10UF,50V,X CASE,10% | 31-007050-106
5 | 48 | C97 C99 C103 C105 C109 C111 C115 C117 C121 C123 C127 C129 C133 C135 C139 C141 C145 C147 C151 C153 C157 C159 C163 C165 C305 C307 C309 C311 C313 C315 C317 C319 C321 C323 C325 C327 C329 C331 C333 C335 C337 C339 C341 C343 C345 C347 C349 C351 | KEMET | C1812X475K5RACTU | CAP,CER SMC,4.7UF,50V,1812,10%,X7R | 31-006102-475
6 | 1 | J1 | FCI | 20020620-M141A01LF | TERM BLOCK,PLUG,14 POS,7.62MM | 20-002585-F14
7 | 12 | J18-19 J22 J25 J28 J31 J34 J37 J40 J43 J46 J49 | FCI | 10061290-554555PLF | RECEPTACLE,TH,6POS,PRESS,AIRMAX | 20-000628-006
8 | 6 | J4-7 J11-LT J8-RT | FCI | 10043546-101LF | RECEPTACLE,TH,9X6,PRESS,AIRMAX | 20-000628-096
9 | 30 | J10-RB J14-LT J15-LB J16-RT J17-RB J20-T J21-B J23-T J24-B J26-T J27-B J29-T J30-B J32-T J33-B J35-T J36-B J38-T J39-B J41-T J42-B J44-T J45-B J47-T J48-B J50-T J51-B J53-T J54-B J9-LB | FCI | 10045271-101LF | RECEPTACLE,TH,9X8,PRESS,AIRMAX | 20-000628-098
10 | 12 | J56-L J57-R J58-L J59-R J60-L J61-R J62-L J63-R J64-L J65-R J66-L J67-R | FCI | 10016537-101LF | RECEPTACLE,TH,15X10,PRESS,AIRMAX | 20-000628-150
11 | 4 | J12-13 J52 J55 | FCI | 10028916-4554P00LF | RECEPTACLE,TH,2X2,PRESS,AIRMAX | 20-000628-022
12 | 2 | J2-L J3-R | FCI | 51740-10401204AA | CONN,12 SIG,8 POWER,REC,PWRBLADE | 20-001339-002
13 | 28 | G1-28 | FCI | 10037910-101LF | GUIDE PIN,TH,AIRMAX | 20-001337-G02
14 | 3 | FD1-3 |  |  | FIDUCIAL
15 | 25 | MH1-6 MH27-30 MH32 MH34-39 MH41 MH43-48 MH65 | NA | NA | Mounting Hole | 59-999NON-POP
16 | 12 | MH49-60 | PENN ENGINEERING & MFG. | KF2-632-ET | STANDOFF,6-32 THRD,0.065H,SS PEM | 00-021300-028
17 | 1 | SW1 | C&K COMPONENTS, INC. | CRD16RM0CB | SWITCH,ROTARY,HEX,DIP | 20-200931-016
