Sayidathahaseen/CCC_NGP_ODC/NGP_ODC_Main/PDLC/Prodigy HW files/FTC-AM1/REV2/BOM/FTC-AM1_REV2-BOM.xls

 |  | FTC-AM1_REV2 | 2012-03-08
 |  | BOARD1
Item | Qty | Reference | Value | PCB DECAL | MFG #1 | MFG #1 P/N | Distributor | Distributor P/N | Unit Cost($) | Total Cost($)
1 | 1 | J1 | CON12 | 20020107-H121A01LF | FCI | 20020107-H121A01LF | Digikey | 609-3905-ND | 1.72 | 1.72
2 | 1 | D64 | 597-3601-207F | LEDC3627X190L | dialight | 597-3601-207F | Digikey | 350-1588-6-ND | 2.56 | 2.56
3 | 7 | C1-4 C7-9 | 10uF/50V | CASE-D | Vishay | TR3D106K050C0550 | Digikey | 718-1335-1-ND | 3.47 | 24.29
4 | 9 | D1-9 | SMAJ400CA | SMA | Littelfuse | SMAJ400CA | Digikey | SMAJ400CALFCT-ND | 0.79 | 7.11
5 | 4 | R13-16 | 250E | RS02B250R0BS70 | Vishay | RS02B250R0BS70 | Mouser | 71-RS2B-B250 | 4.80 | 19.20
6 | 1 | R80 | 2.7K | R2512 | Vishay | CRCW25122K70JNEG | Digikey | 541-2.7KXCT-ND | 0.40 | 0.40
7 | 6 | S1-6 | 09.10290.01 | SLIDE_SWITCH | EAO | 09.10290.01 | newark | 52F519 | 2.50 | 15.00
8 | 1 | J4 | CON_20X2 | TSW-120-07-T-D | Samtec | TSW-120-07-L-D-001 | Samtec | TSW-120-07-L-D-001 | 0.90 | 0.90
9 | 1 | J1-Mating | 20020007H-SERIES | not applicable | FCI | 20020007H-SERIES | FCI | 20020007H-SERIES | 5.00 | 5.00
 |  |  |  |  |  |  |  |  | Total($) | 76.18
 |  | BOARD2
1 | 1 | F1 | 0157005.DR | FUSE_0157005_DR | Littelfuse | 0157005.DR | Digikey | F2969CT-ND | 2.70 | 2.70
2 | 2 | D2-3 | B2100-13-F | B2100-FDITR-ND | Diodes | B2100-13-F | Digikey | B2100-FDITR-ND | 0.58 | 1.16
3 | 6 | C1-2 C7-8 C11-12 | 10uF/50V | CASE-D | Vishay | TR3D106K050C0550 | Digikey | 718-1335-1-ND | 3.47 | 20.82
4 | 1 | J53 | CON12 | 20020107-H121A01LF | FCI | 20020107-H121A01LF | Digikey | 609-3905-ND | 1.72 | 1.72
5 | 8 | D1 D5-11 | SMAJ400CA | SMA | Littelfuse | SMAJ400CA | Digikey | SMAJ400CALFCT-ND | 0.79 | 6.32
6 | 1 | J1 | CON_20X2 | ESQ-120-23-G-D | Samtec | ESQ-120-23-L-D-001 | Samtec | ESQ-120-23-L-D-001 | 2.80 | 2.80
7 | 1 | FB1 | 120E@100MHz | INDC2114X105N | TAIYO YUDEN | FBMH2012HM121-T | Digikey | 587-1747-1-ND | 0.35 | 0.35
8 | 2 | J4 J56 | High Speed Signal Connector | FCI_CON_DC_96 | FCI | 10052838-101LF | FCI | 10052838-101LF | 7.00 | 14.00
9 | 1 | G29 | Guide Pin | GUIDE | FCI | 223986-1 | FCI | 223986-1 | 1.70 | 1.70
10 | 6 | R17-22 | 250E | RS02B250R0BS70 | Vishay | RS02B250R0BS70 | Mouser | 71-RS2B-B250 | 4.80 | 28.80
11 | 9 | R5-13 | 0E | R0603 | Yageo | RC0603JR-070RL | Digikey | 311-0.0GRCT-ND | 0.01 | 0.09
12 | 1 | D4 | SMBJ36A | DIOM5436X265N_SMB | Vishay/Semiconductors | MSS1P6 | Digikey | SMBJ36A-E3/52GICT-ND | 0.50 | 0.50
13 | 1 | J55 | CON_20X2 | TSW-120-07-T-D | Samtec | TSW-120-07-L-D-001 | Samtec | TSW-120-07-L-D-001 | 0.90 | 0.90
14 | 1 | J53-Mating | 20020007H-SERIES | not applicable | FCI | 20020007H-SERIES | FCI | 20020007H-SERIES | 5.00 | 5.00
 |  |  |  |  |  |  |  |  | Total($) | 86.86
 |  | BOARD3
1 | 2 | C3-4 | 10uF/50V | CASED | Vishay | TR3D106K050C0550 | Digikey | 718-1335-1-ND | 3.47 | 6.94
2 | 1 | J54 | CON12 | 20020107-H121A01LF | FCI | 20020107-H121A01LF | Digikey | 609-3905-ND | 1.72 | 1.72
3 | 12 | D1-12 | SMAJ400CA | SMA | Littelfuse | SMAJ400CA | Digikey | SMAJ400CALFCT-ND | 0.63 | 7.55
4 | 1 | J3 | CON_20X2 | ESQ-120-23-G-D | Samtec | ESQ-120-23-L-D-001 | Samtec | ESQ-120-23-L-D-001 | 2.80 | 2.80
5 | 2 | R23-24 | 250E | RS02B250R0BS70 | Vishay | RS02B250R0BS70 | Mouser | 71-RS2B-B250 | 4.80 | 9.60
6 | 1 | J54-Mating | 20020007H-SERIES | not applicable | FCI | 20020007H-SERIES | FCI | 20020007H-SERIES | 5.00 | 5.00
 |  |  |  |  |  |  |  |  | Total($) | 33.61
 |  |  |  |  |  |  |  | All three boards
 |  |  |  |  |  |  |  | Total($) | 196.65
