Sayidathahaseen/CCC_NGP_ODC/NGP_ODC_Main/PDLC/Prodigy HW files/FTC-DM-1/REVD/docs/BOM.xls

Sheet: NEW BOM
Item | Qty | REF-DES | PART -TYPE | MFG #1 P/N | MFG #1 | DESCRIPTION
1 | 8 | C16-23 | CAP-0.01UF-50V-0805-5%-08055C103JAT2A,0.01UF,5% | 08055C103JAT?A | AVX | CAP,CER SMC,0.01UF,50V,5%,0805
2 | 2 | C30-31 | CAP-10UF-100V-2220-20%-C5750X7S2A106M,10UF,20% | C5750X7S2A106M | TDK | CAP,CER SMC,10UF,100V,2220,20%,X7S
3 | 6 | C24-29 | CAP-1UF-100V-1210-10%-CGA6M2X7R2A105K,1UF,10% | CGA6M2X7R2A105K | TDK | CAP,CER SMC,1UF,100V,1210C,10%,X7R
4 | 12 | C4-15 | CAP-3.3UF-250V-2220-20%-CKG57NX7T2E335M,3.3UF,20% | CKG57NX7T2E335M | TDK | CAP,CER SMC,3.3UF,250V,2220,20%,X7T
5 | 2 | T1-2 | CON-TH-1X18-MSTBV_2_5-18/GF-5_08#,Header, Male Pins, Shrouded (2 Side) | 1777235 | PHOENIX | TERM BLOCK HEADER,1 x 18,5.08MM
6 | 1 | H1 | CON-TH-2X15-BCS-115-L-D-TE,Receptacle | BCS-115-L-D-TE | SAMTEC | SOCKET,2X15,0.100",TH,GOLD
7 | 1 | H2 | CON-TH-2X15-DW-15-08-T-D-210,HEADER | DW-15-08-T-D-210 | SAMTEC | HEADER,2X15,0.100",TH
8 | 4 | H3-6 | CON-TH_VR-2X2-BCS-102-L-S-TE,FEMALE | BCS-102-L-S-TE | SAMTEC | CONN,4POS,RCPT,0.100",TH,GOLD
9 | 18 | D25-28 D30 D33-36 D38 D41-42 D44-45 D47 D49 D51 D53 | DIO-DO-214AC-SMAJ36CA,SMAJ36CA | SMAJ36CA | LITTLEFUSE | TVS,DIODE,BI-DIRECT,36V,400W,SMA
10 | 4 | D29 D31 D37 D39 | DIO-DO-214AC-SMAJ400CA,SMAJ400CA | SMAJ400CA | LITTELFUSE | TVS,DIODE,BI-DIRECT,400V,400W,SMA
11 | 9 | D10-12 D40 D43 D46 D48 D50 D52 | DIO-SOD-323-BAV20WS-TP,BAV20WS-TP | BAV20WS-7-F | DIODES INC. | DIODE,SWITCH,1.25V@200MA,SOD-323
12 | 12 | D13-24 | DIO-SOD-323-DDZ4V3BSF-7,DDZ4V3BSF-7 | DDZ4V3BSF-7 | DIODES INC. | DIODE,ZENER,4.3V,500MW,SOD-323
13 | 6 | U1-6 | IC-OPTOISOLATOR-4-SMD-PS2706-1-A,OPTOISOLATOR | PS2706-1-A | CEL | OPTO-ISOLATOR,SINGLE,PS2706-1
14 | 1 | D32 | LED-GREEN-0603-LG_L29K-G2J1-24-Z,GREEN | LG L29K-G2J1-24-Z | OSRAM | LED,GRN,SM,5.6 MCD@20mA,0603
15 | 5 | FD1-3 FD5-6 | MEC-FD-#,FIDUCIAL | NA | NA | FIDUCIAL
16 | 4 | MH1-4 | MEC-MH-#,Mounting Hole | PFK-M3-40 | PENN ENGINEERING & MFG. | STANDOFF W/SCREW,M3X0.5,PEM
17 | 1 | F1 | POLYFUS-1.2A-60V-MF-SMDF050-2,0.55A | 2016L050MR | LITTLEFUSE | PTC,RESET FUSE,550MA,60V,2016
18 | 9 | K1-9 | REL-SMD-IM17GR,IM17GR | IM17GR | TYCO | RELAY,DPDT,24V,2A,HERM SEAL,SM
19 | 21 | R1-12 R14 R16 R18 R20 R22-23 R25 R27 R29 | RES-10K-R1210-ERJ-14NF1002U,10K,1% | RK73H2ET**1002F | KOA | RESISTOR SMR,10K,1/4W,1%,1210R
20 | 8 | R13 R15 R17 R19 R21 R24 R26 R28 | RES-200E-R0603-RC0603FR-07200RL,200E,1% | RK73H1JT**2000F | KOA | RESISTOR SMR,200,1/10W,1%,0603
21 | 6 | R30-35 | RES-47K-R2512-CRCW251247K0JNEGHP,47K,5% | RK73H3AT??4702F | KOA | RESISTOR SMR,47K,1W,1%,2512

Sheet: NEWLY ADDED PARTS
Item | Qty | REF-DES | PART -TYPE | MFG #1 P/N | MFG #1 | DESCRIPTION
1 | 6 | C10-15 | CAP-3.3UF-250V-2220-20%-CKG57NX7T2E335M,3.3UF,20% | CKG57NX7T2E335M | TDK | CAP,CER SMC,3.3UF,250V,2220,20%,X7T
2 | 4 | R7 R8 R11 R12 | RES-10K-R1210-ERJ-14NF1002U,10K,1% | RK73H2ET**1002F | KOA | RESISTOR SMR,10K,1/4W,1%,1210R
3 | 4 | D15 D16 D21 D22 D23 D24 | DIO-SOD-323-DDZ4V3BSF-7,DDZ4V3BSF-7 | DDZ4V3BSF-7 | DIODES INC. | DIODE,ZENER,4.3V,500MW,SOD-323
4 | 8 | D41 D42 D44 D45 D47 D49 D51 D53 | DIO-DO-214AC-SMAJ36CA,SMAJ36CA | SMAJ36CA | LITTLEFUSE | TVS,DIODE,BI-DIRECT,36V,400W,SMA

Sheet: DELETED PARTS FROM OLD BOM
Item | Qty | REF-DES | PART -TYPE | MFG #1 P/N | MFG #1 | DESCRIPTION
1 | 3 | C13 C15-16 | CAP-1UF-100V-1210-10%-CGA6M2X7R2A105K,1UF,10% | CGA6M2X7R2A105K | TDK | CAP,CER SMC,1UF,100V,1210C,10%,X7R
