Sayidathahaseen/CCC_NGP_ODC/NGP_ODC_Main/PDLC/Prodigy HW files/IBS/Rev-C/BOM/IBS_REV_C_Bom.xls

 | Bill of materials
 | IBS_REVC
 | 2013-12-18
Item | Qty | Reference | Description | MFG #1 | MFG #1 P/N | PCB DECAL
1 | 1 | C341 | CAP,CER SMC,1NF,2000V,1206C,10%,X7R | AVX | 1206GC102KAT? | C1206
2 | 26 | C246 C257 C321-322 C327 C330 C333 C339-340 C342-349 C360 C385-392 | CAP,CER SMC,0.01UF,50V,0402,10%,X7R | AVX | 04025C103KAT2A | C0402
3 | 6 | C258 C381 C383 C395 C398 C400 | CAP,CER SMC,0.01UF,100V,0603,5%,X7R | AVX | 06031C103JAT2A | C0603
4 | 58 | C35-42 C47 C50-51 C122 C159 C196 C243-244 C249 C254-255 C259-266 C271 C296-297 C303-313 C316 C320 C323 C331 C337-338 C358-359 C361 C369-370 C373 C378-379 C384 C394 C396 | CAP,CER SMC,0.1UF,100V,0603,10%,X7R | TDK | C1608X7S2A104K | C0603
5 | 112 | C1 C4-7 C12-22 C55 C57-60 C65-75 C89 C91-94 C99-109 C126 C128-131 C136-146 C163 C165-168 C173-183 C200 C202-205 C210-220 C234 C236-239 C273-283 | CAP,CER SMC,0.1UF,50V,0402,10%,X7R | TDK | C1005X7R1H104K050BB | C0402
6 | 1 | C319 | CAP,CER SMC,68nF,50V,0805,10%,X7R | KEMET | C0805C683K5RACTU | C0805
7 | 5 | C45-46 C300-301 C371 | CAP,CER SMC,1000PF,50V,5%,0603,NPO | KOA | NPO0603HT??102J | C0603
8 | 1 | C248 | CAP,TAN SMC,100UF,20V,E CASE,10% | AVX | TPSE107K020R0150 | CASE_E-7343-43
9 | 4 | C350 C354-356 | CAP,CER SMC,10PF,50V,0603,5%,NPO | AVX | 06035A100JAT2A | C0603
10 | 3 | C302 C336 C393 | CAP,TAN SMC,10UF,16V,A CASE,10% | AVX | TAJA106K016RNJ | CASE_A-3216-18
11 | 20 | C3 C33 C43-44 C54 C86 C88 C120 C125 C157 C162 C194 C199 C231 C233 C256 C267-268 C294 C376 | CAP,CER SMC,10UF,10V,0805,10%,X7R | TDK | C2012X7R1A106K125AC | C0805
12 | 4 | C335 C351-353 | CAP,CER SMC,10UF,25V,1206C,10%,X7R | TDK | C3216X7R1E106K160AB | C1206
13 | 2 | C317-318 | CAP,CER SMC,12NF,50V,0805,10%,X7R | AVX | 08055C123KAT2A | C0805
14 | 2 | C374-375 | CAP,CER SMC,15PF,50V,0603,5%,NPO | KEMET | C0603C150J5GACTU | C0603
15 | 8 | C298 C324 C326 C328-329 C332 C377 C399 | CAP,CER SMC,1UF,35V,0603,10%,X7R | TDK | C1608X7R1V105K080AC | C0603
16 | 12 | C48-49 C52-53 C123-124 C160-161 C197-198 C269-270 | CAP,CER SMC,20PF,50V,0603,5%,NPO | KEMET | C0603C200J5GACTU | C0603
17 | 112 | C2 C8-11 C23-32 C34 C56 C61-64 C76-85 C87 C90 C95-98 C110-119 C121 C127 C132-135 C147-156 C158 C164 C169-172 C184-193 C195 C201 C206-209 C221-230 C232 C235 C240-242 C272 C284-293 C295 | CAP,CER SMC,220PF,50V,0402,10%,X7R | AVX | 04025C221KAT2A | C0402
18 | 2 | C250-251 | CAP,CER SMC,220PF,50V,0603,20%,X7R | KEMET | C0603C221M5RACTU | C0603
19 | 6 | C245 C253 C314-315 C334 C357 | CAP,TAN SMC,22UF,20V,B CASE,10% | AVX | TPSB226K020R0400 | CASE_B-3528-21
20 | 1 | C252 | CAP,CER SMC,33NF,50V,0603,5%,X7R | AVX | 06035C333JAT2A | C0603
21 | 2 | C299 C325 | CAP,CER SMC,4700PF,100V,0603,10%,X7R | AVX | 06031C472JAT2A | C0603
22 | 1 | C372 | CAP,CER,6800PF,50V,5%,C0G,0603 |  |  | C0603
23 | 1 | C247 | CAP,CER SMC,68NF,50V,0603,10%,X7R | KEMET | C0603C683K5RACTU | C0603
24 | 1 | J1 | HEADER,RA,TH,2 x 2,PRESS,AIRMAX | FCI | 10073379-001LF | CONN_10073379-001LF
25 | 1 | J4 | EDGE CONNECTOR | EDGE CONNECTOR | EDGE CONNECTOR | CONN\EDGE\100\2X7
26 | 2 | J2-3 | HEADER,RA,TH,9 x 8,PRESS,AIRMAX | FCI | 10045267-111LF | CONN_FCI_72_TH
27 | 2 | D19 D40 | DIODE,TVS,7.5V,400W,UNI,5%,SMA | BOURNS | SMAJ7.5A | SMB
28 | 5 | FB2-6 | FERRITE BEAD,0805,Z=330E | MURATA | BLM21PG331SN1D | L0805
29 | 4 | L1-2 L6-7 | FERRITE BEAD,0805,Z=120E,0.8A | TDK | MMZ2012R121A | IND-0805
30 | 1 | FB1 | RESISTOR SMR,10M,1/8 W,1%,1206R | KOA | RK73H2BT**1005F | IND_1206
31 | 2 | F3-4 | FUSE,3A,125V,SLOW,6.5X2.69MM,2-SMD | LITTLEFUSE | 0157003.DR | FUSM6427X370N
32 | 1 | U21 | BUFF/DVR,TRI-ST,16BIT,48TSSOP | TEXAS INSTRUMENTS | SN74LVC16244ADGGR | SOP50P810X120-48N
33 | 1 | U26 | BUFFER,NON-INV,OPEN DRAIN,SOT23-5 | TEXAS INSTRUMENTS | SN74LVC1G07DBVR | SOT_23-5P
34 | 2 | U6 U19 | TRANSCEIVER,ENET,PHY,48-LQFP | MICREL | KSZ8721BLI | QFP50P900X900X160-48N
35 | 7 | U5 U8 U10 U12 U14 U16 U18 | EEPROM,16KBIT,I2C,400KHZ,8-SOIC | MICROCHIP TECHNOLOGY | 24LC16B-I/SN | SOIC127P600X175-8N
36 | 1 | U20 | EEPROM,16KBIT,SPI,20MHZ,8-TSSOP | ON SEMICONDUCTOR | CAT25160YI-G | SOP65P640X120-8N
37 | 7 | U4 U7 U9 U11 U13 U15 U17 | ETHERCAT SLAVE CONTROLLER,ET-1100,BGA-128 | BECKHOFF | ET1100 | BGA128C80P12X12_1100X1100X130
38 | 1 | U23 | HOT SWAP PWR CNTRL,TSOT23-6 | LINEAR TECHNOLOGY | LTC4210-1IS6#TRMPBF | SOT95P280X100-6N
39 | 1 | U76 | I/O EXPANDER,16BIT,SPI,28-SSOP | MICROCHIP TECHNOLOGY | MCP23S17-E/SS | SSOP28
40 | 1 | U24 | MCU,FREESCALE MPC-5534,80MHZ,208-BGA | FREESCALE SEMICONDUCTOR | MPC5534MVM80 | BGA208C100P16X16_1700X1700X200
41 | 1 | U33 | ANALOG SWITCH,2XSPDT,10-MSOP | TEXAS INSTRUMENTS | TS5A23157DGSR | SOP50P490X110-10N
42 | 1 | U3 | MUX/DEMUX,QUAD,2X1,16SOIC | ANALOG DEVICES | ADG774BRZ | SOIC127P600X175-16N
43 | 3 | U29-30 U32 | OP AMP,GP,2,RAIL/RAIL,8-MSOP | ANALOG DEVICES | ADA4096-2ARMZ | SOP65P490X110-8N
44 | 1 | U22 | PWR CTRLR,IDEAL DIODE OR,LOAD SHARE,16-MSOP | LINEAR TECHNOLOGY | LTC4370IMS#PBF | SOP50P490X110-16N
45 | 1 | U31 | REFERENCE,5V,0.05%,TSOT-23-6 | LINEAR TECHNOLOGY | LT6654AHS6-5#TRMPBF | SOT95P280X100-6N
46 | 1 | U2 | REGULATOR,BUCK,ADJ,3A,28-QFN | LINEAR TECHNOLOGY | LTC3633EUFD#PBF | LT_UFD28_4X5
47 | 1 | U27 | REGULATOR,LDO,5V,400MA,TO-252-3 | TEXAS INSTRUMENTS | TL720M05QKVURQ1 | TO228P991X238-3_4N
48 | 1 | U1 | TEMP SENSOR,TMP36,LOW VOLTAGE | ANALOG DEVICES | TMP36FSZ | SOIC127P600X175-8N
49 | 1 | U28 | PWR SUPERVISOR,WATCHDOG,10-MSOP | LINEAR TECHNOLOGY | LTC2918IMS-B1#PBF | SOP50P490X110-10N
50 | 2 | U25 U48 | BUS BUFFER,HOTSWAP,2WIRE,8MSOP | LINEAR TECHNOLOGY | LTC4301IMS8#PBF | SOP65P490X110-8N
51 | 1 | L3 | INDUCTOR,1.2UH,4.4A,SMD | COIL CRAFT | DO1813H-122ML | INDM8961X508N
52 | 1 | L4 | INDUCTOR,2.2UH,3.1A,SMD | COIL CRAFT | DO1813H-222ML | INDM8961X508N
53 | 1 | S1 | SWITCH,MOM,NO,0.05A@32VDC | C&K COMPONENTS, INC. | KMR231G ULC LFS | SW_KMR
54 | 21 | D2 D4 D6-12 D14-18 D21 D24 D28 D31-32 D34 D41 | LED,GRN,SM,5.6 MCD@20mA,0603 | OSRAM | LG L29K-G2J1-24-Z | LEDC1308X65N
55 | 2 | D5 D37 | LED,GRN,RT TH,16 MCD@10mA | DIALIGHT | 551-0209F | LED_3MM_SINGLE
56 | 1 | D13 | LED,GRN,RT TH,16 MCD@10mA | DIALIGHT | 551-0209F | LED_3MM_TH
57 | 14 | D20 D22-23 D25-27 D29-30 D33 D35-36 D39 D50-51 | LED,RED/GRN,SM,3X2.8 MM | KINGBRIGHT | APBDA3020SURKCGKC-GX | LED_APBDA3020SURKCGKC_GX
58 | 1 | D57 | LED,ORANGE,RT TH,7 MCD@10mA | DIALIGHT | 551-2509F | LED_3MM_TH
59 | 1 | D52 | LED,RED,RT TH,10 MCD@10mA | DIALIGHT | 551-0409F | LED_3MM_TH
60 | 2 | D3 D44 | LED,WHITE,RT TH,500 MCD@20mA | LUMEX | SSF-LXH103UWW | LED_SSF-LXH103UWW
61 | 1 | D42 | LED,YEL,RT TH,6.3 MCD@10mA | DIALIGHT | 551-0309F | LED_3MM_SINGLE
62 | 2 | GP1-2 | GUIDE SOCKET,RA,TH,AIRMAX,90 DEG | FCI | 10045597-103LF | CONN_10045597
63 | 36 | AN0-2 AN36-37 ENGCLK GND GPIO192-193 MDO0 MPC_RDY MPC_RESET_O RXDA TP1-21 TXDA VDD1P5 | TEST PAD |  |  | TP_40_SM
64 | 3 | TP_ACTLED2 GPIO2 GPIO1 | TEST PAD | NA | NA | TP_40_SM
65 | 2 | M1-2 |  |  |  | MH350D300P
66 | 3 | Q1 Q4-5 | MOSFET,N-CH,30V,30A,PPAK,8-SOIC | VISHAY | SIR462DP-T1-GE3 | SOIC127P602X112-8N_POWERPAD
67 | 12 | Q3 Q6-12 Q14-16 Q21 | MOSFET,N-CH,30V,5A,SOT23 | INT'L RECTIFIER | IRLML6344TRPBF | SOT95P237X112-3N
68 | 6 | FD1-6 |  |  |  | FIDUCIAL
69 | 1 | Y1 | OSC,25MHZ,15PF,5X2.6 MM | FOX ELECTRONICS | FOX924B-25.000 | OSCCC320X500X150-4N
70 | 2 | R257 R265 | RESISTOR SMR,0.015,1W,1%,2010 | VISHAY | WSL2010R0150F??18 | RESC5025X70N
71 | 1 | R130 | RESISTOR SMR,0.015,2W,1%,2512 | VISHAY | WSL2512R0150F??18 | R2512
72 | 21 | R15 R182 R217-218 R255 R262 R268-269 R273-274 R277-278 R334 R336-337 R346-347 R375 R379 R382 R404 | RESISTOR SMR,0,1/10W,1%,0603 | KOA | RK73Z1JT?? | R0603
73 | 2 | R393 R395 | RESISTOR,0E,0.1,-,R0603 | YAGEO | RC0603JR-070RL | R0603
74 | 3 | R290-291 R331 | RESISTOR SMR,0.0,1/4W,1%,1206R | KOA | RK73Z2BT?? | R1210
75 | 1 | R330 | RESISTOR SMR,1.21E,1W 1%,2512 | KOA | SR733ATTE1R21F | R2512
76 | 25 | R134-136 R141 R143 R145 R147-150 R152-158 R160-161 R167-171 R256 | RESISTOR SMR,100,1/16W,1%,0402 | KOA | RK73H1ET??1000F | R0402
77 | 3 | R131-132 R345 | RESISTOR SMR,100,1/10W,1%,0603 | KOA | RK73H1JT**1000F | R0603
78 | 4 | R287 R378 R402 R415 | RESISTOR SMR,100K,1/10W,1%,0603 | KOA | RK73H1JTTD1003F | R0603
79 | 4 | R286 R397 R401 R414 | RESISTOR,100K,0.125,1%,R0805 | YAGEO | RC0805FR-07100KL | R0805
80 | 1 | R206 | RESISTOR SMR,10,1/10W,1%,0603 | KOA | RK73H1JT**10R0F | R0603
81 | 19 | R133 R138-140 R172-173 R179-181 R207 R248 R325-327 R329 R332-333 R335 R338 | RESISTOR SMR,10K,1/10W,1%,0603 | KOA | RK73H1JT**1002F | R0603
82 | 1 | R348 | RESISTOR,10M,0.125,5%,R0805 |  |  | R0805
83 | 7 | R1 R9 R16 R74 R93 R115 R224 | RESISTOR SMR,11K,1/10W,1%,0603 | KOA | RK73H1JT??1102F | R0603
84 | 2 | R266 R282 | RESISTOR SMR,13K,1/10W,1%,0603 | KOA | RK73H1JT??1302F | R0603
85 | 2 | R387 R412 | RESISTOR SMR,16K,1/10W,1%,0603 | KOA | RK73H1JT??1602F | R0603
86 | 1 | R263 | RESISTOR SMR,18.7K,1/10W,1%,0805R | KOA | RK73H2AT??1872F | R0805
87 | 14 | R137 R270-272 R351-354 R357-361 R373 | RESISTOR SMR,1.0K,1/10W,1%,0603 | KOA | RK73H1JT**1001F | R0603
88 | 2 | R14 R213 | RESISTOR SMR,1K,1/10W,1%,0805R | KOA | RK73H2AT**1001F | R0805
89 | 3 | R250 R260 R284 | RESISTOR SMR,1M,1/10W,1%,0805R | KOA | RK73H2AT**1004F | R0805
90 | 1 | R261 | RESISTOR SMR,200,1/10W,1%,0805R | KOA | RK73H2AT**2000F | R0805
91 | 1 | R258 | RESISTOR SMR,26.7K,1/10W,1%,0805R | KOA | RK73H2AT??2672F | R0805
92 | 14 | R3 R45 R163 R174 R186-187 R194-195 R198 R200 R202-204 R208 | RESISTOR SMR,2.0K,1/10W,1%,0805R | KOA | RK73H2AT**2001F | R0805
93 | 3 | R185 R192 R199 | RESISTOR SMR,3.32K,1/10W,1%,0603 | KOA | RK73H1JT??3321F | R0603
94 | 1 | R264 | RESISTOR SMR,30.1K,1/10W,1%,0805R | KOA | RK73H2AT**3012F | R0805
95 | 2 | R389-390 | RESISTOR SMR,330,1/10W,1%,0603 | KOA | RK73H1JT??3300F | R0603
96 | 7 | R159 R216 R374 R376-377 R380 R410 | RESISTOR SMR,332,1/10W,1%,0805R | KOA | RK73H2AT**3320F | R0805
97 | 3 | R253-254 R305 | RESISTOR SMR,33,1/10W,1%,0603 | KOA | RK73H1JT**33R0F | R0603
98 | 1 | R209 | RESISTOR SMR,33K,1/10W,1%,0603 | KOA | RK73H1JT??3302F | R0603
99 | 2 | R388 R413 | RESISTOR SMR,4.75K,1/10W,1%,0603 | KOA | RK73H1JT**4751F | R0603
100 | 124 | R2 R4-5 R7-8 R10-12 R17-18 R20-24 R29-30 R32-35 R37-44 R46-49 R51-56 R58-68 R70-73 R75 R77-87 R89-92 R94 R96-102 R104-108 R110-114 R117-121 R214 R225-226 R228-232 R234-238 R240 R275 R298 R307 R312 R315 R318 R321 R324 R328 R362-367 R369-370 | RESISTOR SMR,4.7K,1/16W,1%,0402 | KOA | RK73H1ET??4701F | R0402
101 | 35 | R13 R19 R27 R31 R183-184 R210 R215 R247 R280 R304 R339-344 R349-350 R355-356 R371-372 R381 R383-386 R391 R396 R398 R403 R405 R409 R416 | RESISTOR SMR,4.75K,1/10W,1%,0603 | KOA | RK73H1JT**4751F | R0603
102 | 4 | R408 R285 R411 R400 | RESISTOR,4.7K,0.1,1%,R0603 | YAGEO | RC0603FR-074K7L | R0603
103 | 32 | R6 R25-26 R116 R142 R144 R146 R151 R164-166 R176-178 R188-191 R211-212 R221-223 R233 R244-245 R288-289 R292-295 | RESISTOR,ARRAY,4.7K,5%,4 RES,0804 | KOA | CN1E4KT??472J | RESC_CRA12E847KCTND
104 | 22 | R193 R246 R283 R296-297 R299-303 R306 R308 R311 R313-314 R316-317 R319-320 R322-323 R368 | RESISTOR,ARRAY,4.7K,5%,8 RES,1506 | KOA | CN1F8KT??472J | RESCAX50P160X400X55-16N
105 | 1 | R259 | RESISTOR SMR,432K,1/10W,1%,0805R | KOA | RK73H2AT??4323F | R0805
106 | 17 | R36 R50 R57 R69 R76 R109 R162 R175 R196-197 R201 R227 R239 R241-243 R249 | RESISTOR SMR,475,1/10W,1%,0603 | KOA | RK73H1JT**4750F | R0603
107 | 3 | R28 R95 R205 | RESISTOR SMR,475,1/10W,1%,0603 | KOA | RK73H1JT**4750F | R0603
108 | 12 | R88 R103 R122-129 R251-252 | RESISTOR SMR,49.9,1/10W,1%,0603 | KOA | RK73H1JT??49R9F | R0603
109 | 2 | R219-220 | RESISTOR SMR,6.49K,1/10W,1%,0805R | KOA | RK73H2AT??6491F | R0805
110 | 2 | R309-310 | RESISTOR SMR,75,1/10W,1%,0603 | KOA | RK73H1JT??75R0F | R0603
111 | 1 | R267 | RESISTOR SMR,820,1/10W,1%,0603 | KOA | RK73H1JT??8200F | R0603
112 | 2 | R276 R279 | RESISTOR SMR,84.5K,1/10W,1%,0805R | KOA | RK73H2AT??8452F | R0805
113 | 1 | D1 | LED,BLUE,RT TH,100 MCD@20mA,3 POS | LUMEX | SSF-LXH513USBD | LED_SSF-LXH513USBD
114 | 1 | T1 | XFORMER,ENET,10/100,1:1 1:1,16SOIC | PULSE | HX1188NL? | SOIC127P950X597-16N
115 | 1 | Q2 | TRANSISTOR,NPN,20V,1A,SOT-223 | ON SEMICONDUCTOR | BCP68T1G | SOT230P700X175-4N
116 | 1 | X1 | XTAL,8MHZ,18PF,6X3.3 MM | ABRACON | ABM7-8.000MHZ-D2Y-T | XTAL600X350X140N
117 | 6 | Y2-7 | XTAL,25MHZ,18PF,3.2X2.5 MM | ABRACON | ABM8G-25.000MHZ-18-D2Y-T | OSCCC250X320X100-4N
