Sayidathahaseen/CCC_NGP_ODC/NGP_ODC_Main/PDLC/Prodigy HW files/IOP-AM1/REV3/BOM/IOP-AM1-R3P0-28Feb12.xls

Sheet: Sheet1
 |  | IOP-AM1-R3P0-BOM
 |  | Date-28 Feb 2012
Item | Qty | Reference | Value | FootPrint | MFG #1 | MFG #1 P/N | Distributor | Distributor P/N | Unit Cost ($) | Total ($) | Remark
1 | 24 | C104-105 C194-195 C198-203 C206-211 C214-221 | 4.7uF | CC1210 | TDK | C3225X7S2A475MT | Mouser | 810-C3225X7S2A475M | 0.965 | 23.16
2 | 28 | C4 C264-290 | 0.1uF | CC0402 | TDK | C1005X5R1H104K | Digikey | 445-5942-1-ND | 0.05176 | 1.44928
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
