Sayidathahaseen/CCC_NGP_ODC/NGP_ODC_Main/PDLC/Mechanical/CCC_MECHANICAL_REV2/Cam lever Assy_2.SLDASM

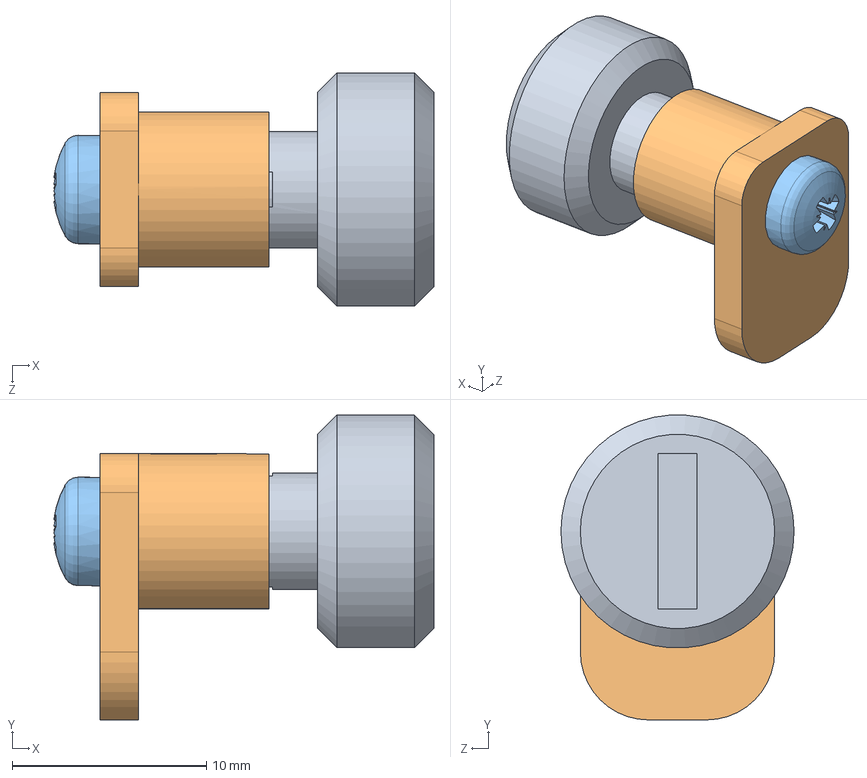
[picture p43: CAD file, 2022-06-23]
NGP_ODC_Main/PDLC/Mechanical/CCC_MECHANICAL_REV2/Cam lever Assy_2.SLDASM
19.6 x 15.7 x 12.0 mm
Camhead_2
Camlever_2
screw_iso_7049-st_2_9x9_5-f-z
