Sayidathahaseen/CCC_NGP_ODC/NGP_ODC_Main/PDLC/Mechanical/NGP_CCC Final files on dt-lohiths/thermal/ECAT/ecat assy.SLDASM

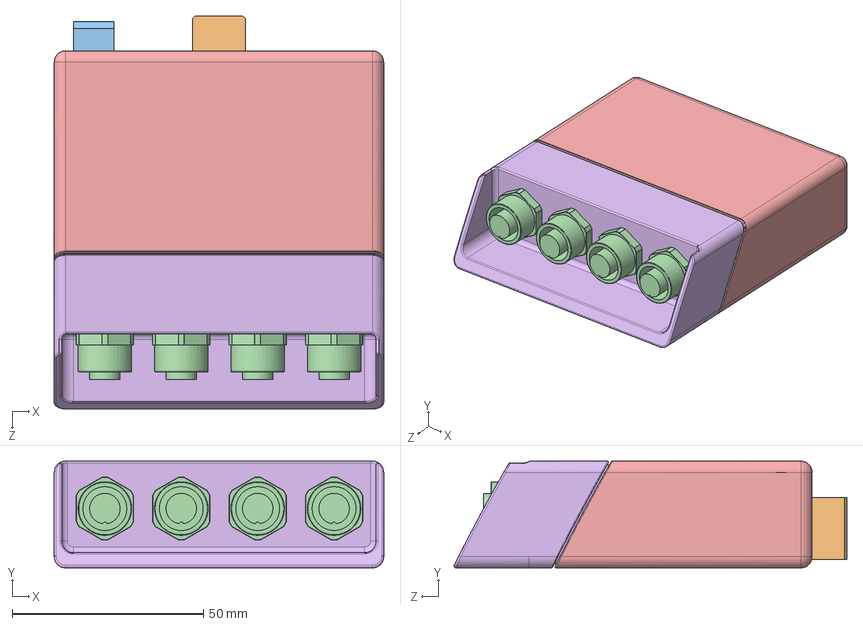
[picture p44: CAD file, 2022-06-23]
NGP_ODC_Main/PDLC/Mechanical/NGP_CCC Final files on dt-lohiths/thermal/ECAT/ecat assy.SLDASM
86.3 x 28.0 x 102.9 mm
ecatpcb
10039851_S
43K1A542 x 4
Ecat cover
Ecat cover-front
