Sayidathahaseen/CCC_NGP_ODC/NGP_ODC_Main/PDLC/Mechanical/NGP_CCC Final files on dt-lohiths/thermal/FTC MOD/FTC MOD ASSY.SLDASM

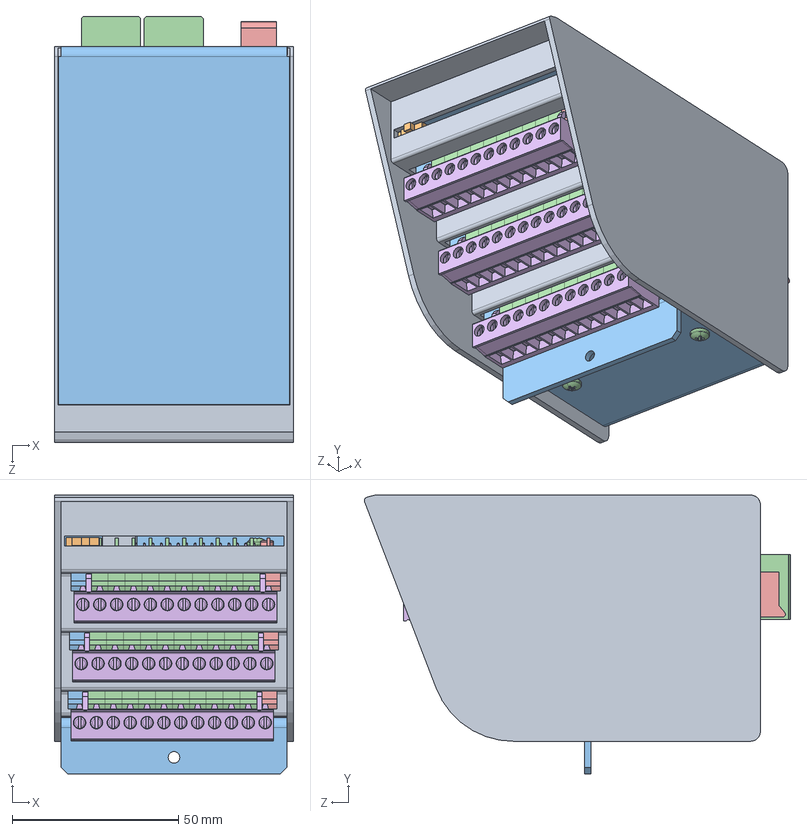
[picture p45: CAD file, 2022-06-23]
NGP_ODC_Main/PDLC/Mechanical/NGP_CCC Final files on dt-lohiths/thermal/FTC MOD/FTC MOD ASSY.SLDASM
72.0 x 84.0 x 128.4 mm
FTC bottom cover
FTC PCB-3
20020107-H-LEM_1 x 3
20020107-H-CM_1 x 30
20020107-H-REM_1 x 3
20020007-PLUG x 3
C-15-X_-03 x 80
DSB-36_Formula x 2
ssw-xx-x_-D Formula x 2
TSW-_Formula x 2
FTC PCB-2
10052838C x 2
C3D-T-1S6_-07 Straight x 80
C3D-TSW-XX-D_Formula x 2
FTC PCB-1
DS2Y-S-DC24V Relay x 2
EAO-1K2 switch
FTC top cover
M3x8- x 4
M2x5screw x 6
Standoff 16lg x 4
