Sayidathahaseen/CCC_NGP_ODC/NGP_ODC_Main/PDLC/Mechanical/NGP_CCC Final files on dt-lohiths/Solidworks _Final files/APP MOD/APP MOD ASSY.SLDASM

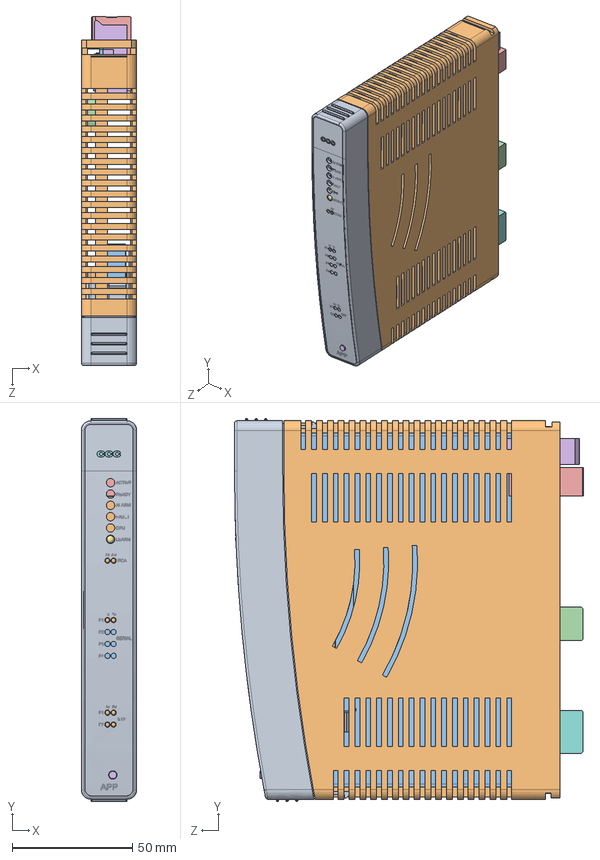
[picture p46: CAD file, 2022-06-23]
NGP_ODC_Main/PDLC/Mechanical/NGP_CCC Final files on dt-lohiths/Solidworks _Final files/APP MOD/APP MOD ASSY.SLDASM
23.0 x 159.1 x 144.8 mm
APP mod face plate-rev1
APP mod body
PCB-app
10039851_S
C17873A 3mm led
10045267_S
C16643 (smd logo)
SSF-LXH512SUGD x 4
SODIMM_MM80-204B1-E1
SMTU2430-LF
LB_LT_Y87S_Pb x 2
TL1105
SODIMM pcb
CCC LOGO-APP
Label-APP
