Sayidathahaseen/CCC_NGP_ODC/NGP_ODC_Main/PDLC/Mechanical/NGP_CCC Final files on dt-lohiths/Solidworks _Final files/IES MOD 4-7-2011/ies pcb assy.SLDASM

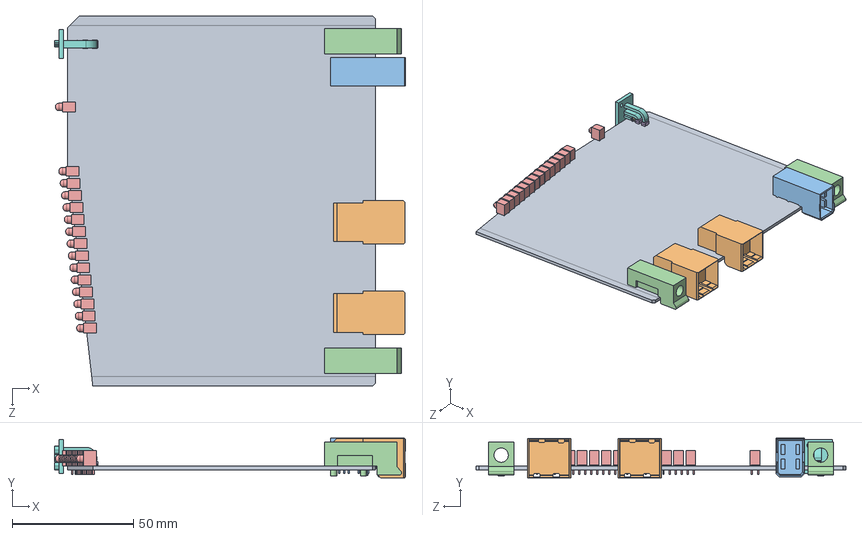
[picture p48: CAD file, 2022-06-23]
NGP_ODC_Main/PDLC/Mechanical/NGP_CCC Final files on dt-lohiths/Solidworks _Final files/IES MOD 4-7-2011/ies pcb assy.SLDASM
144.6 x 16.4 x 152.4 mm
PCB-ies
10045267_S x 2
C17873A 3mm led x 15
C16643 (smd logo) x 2
LB_LT_Y87S_Pb
CCC LOGO_ies-ne_18-07
