Sayidathahaseen/CCC_NGP_ODC/NGP_ODC_Main/PDLC/Mechanical/NGP_CCC Final files on dt-lohiths/Solidworks _Final files/IOP Module/QTE-040-02-X-D-A.sldasm

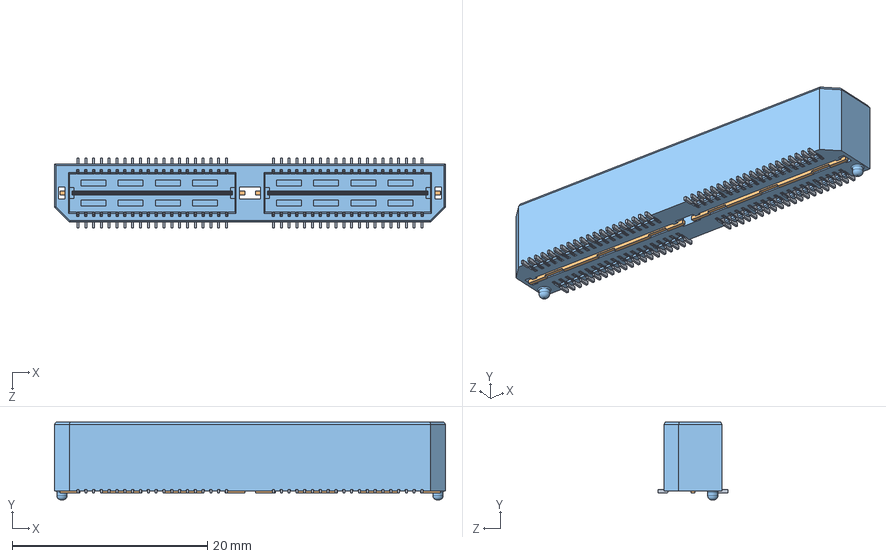
[picture p49: CAD file, 2022-06-23]
NGP_ODC_Main/PDLC/Mechanical/NGP_CCC Final files on dt-lohiths/Solidworks _Final files/IOP Module/QTE-040-02-X-D-A.sldasm
40.0 x 7.98 x 7.11 mm
T-1S39_-02 x 80
T-1G1-X_-02 x 2
Qte-xx-d_Formula -02
