Sayidathahaseen/CCC_NGP_ODC/NGP_ODC_Main/PDLC/Mechanical/NGP_CCC Final files on dt-lohiths/Solidworks _Final files/SAC-03-8-2011/SAC MOD ASSY-1.SLDASM

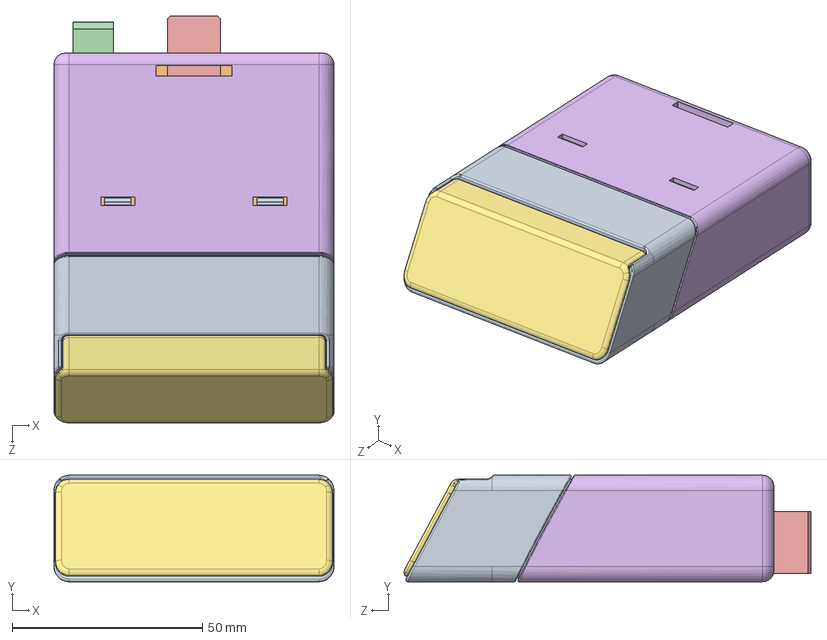
[picture p50: CAD file, 2022-06-23]
NGP_ODC_Main/PDLC/Mechanical/NGP_CCC Final files on dt-lohiths/Solidworks _Final files/SAC-03-8-2011/SAC MOD ASSY-1.SLDASM
73.6 x 28.0 x 106.9 mm
Sac cover-front-1
sacpcb1
C-1734354-2 x 2
10039851_S
Sac cover-1
Front cover_SAC
