Sayidathahaseen/CCC_NGP_ODC/NGP_ODC_Main/PDLC/Mechanical/NGP_CCC Final files on dt-lohiths/thermal/FTC MOD/FTC pcb-3 assy.SLDASM

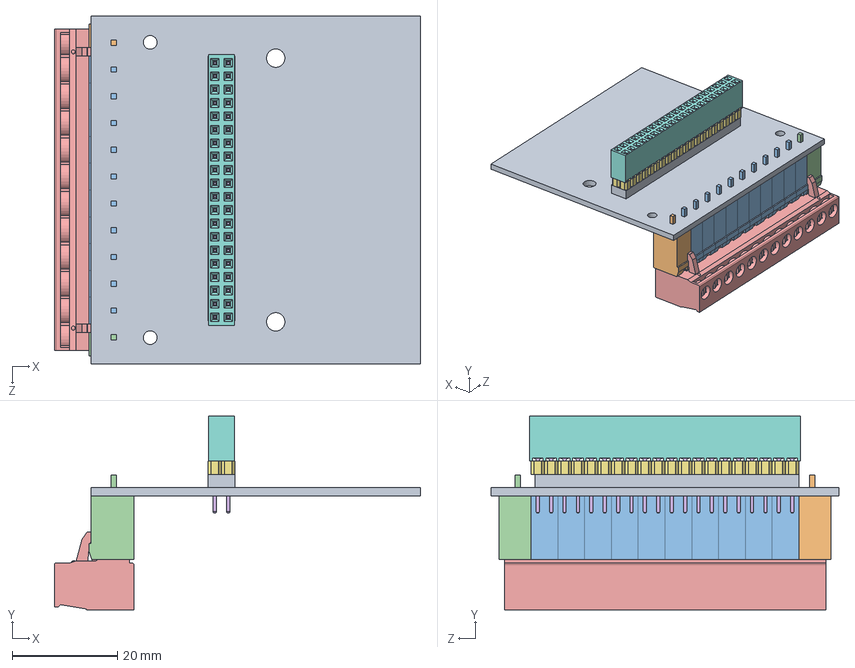
[picture p52: CAD file, 2022-06-23]
NGP_ODC_Main/PDLC/Mechanical/NGP_CCC Final files on dt-lohiths/thermal/FTC MOD/FTC pcb-3 assy.SLDASM
69.5 x 36.8 x 66.0 mm
FTC PCB-3
20020107-H-LEM_1
20020107-H-CM_1 x 10
20020107-H-REM_1
20020007-PLUG
C-15-X_-03 x 40
DSB-36_Formula
ssw-xx-x_-D Formula
TSW-_Formula
