Sayidathahaseen/CCC_NGP_ODC/NGP_ODC_Main/PDLC/Mechanical/NGP_CCC Final files on dt-lohiths/Solidworks _Final files/Back Plane Assy/Cam lever Assy_ECAT/Cam lever Assy_ECAT.SLDASM

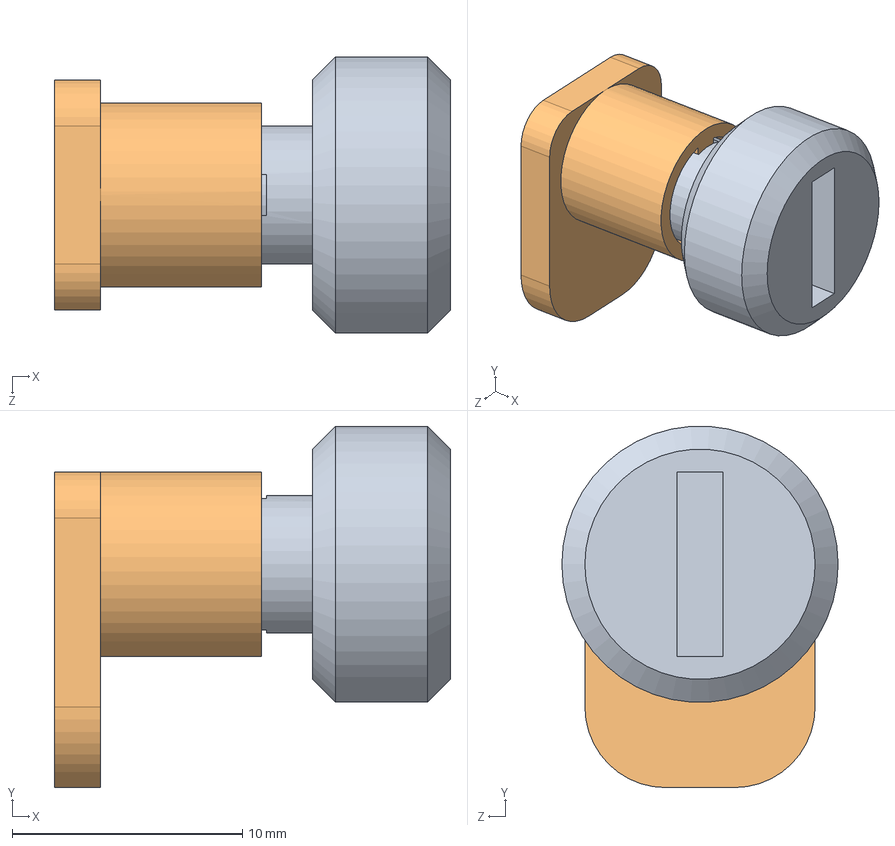
[picture p53: CAD file, 2022-06-23]
NGP_ODC_Main/PDLC/Mechanical/NGP_CCC Final files on dt-lohiths/Solidworks _Final files/Back Plane Assy/Cam lever Assy_ECAT/Cam lever Assy_ECAT.SLDASM
17.2 x 15.7 x 12.0 mm
Camhead_ECAT
Camlever_ECAT
