Sayidathahaseen/CCC_NGP_ODC/NGP_ODC_Main/PDLC/Mechanical/NGP_CCC Final files on dt-lohiths/Solidworks _Final files/SAC/SAC Assy.SLDASM

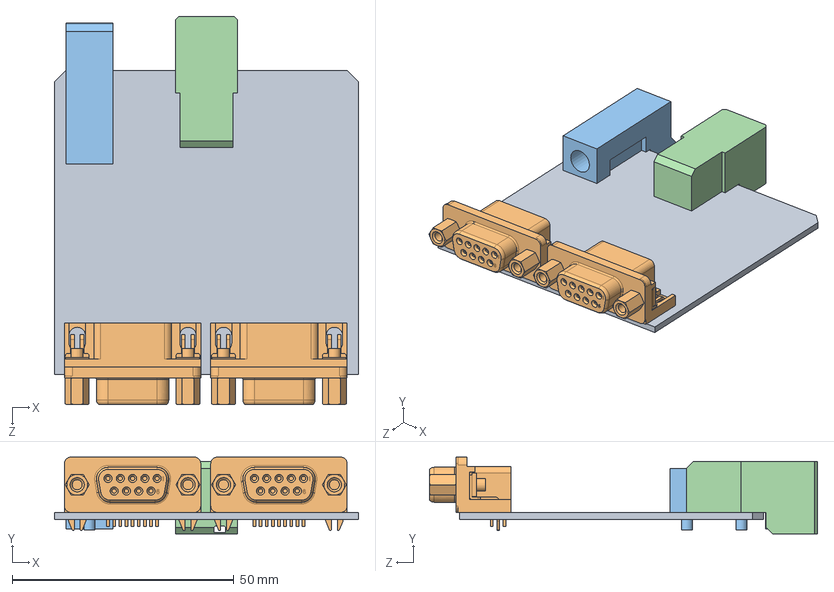
[picture p54: CAD file, 2022-06-23]
NGP_ODC_Main/PDLC/Mechanical/NGP_CCC Final files on dt-lohiths/Solidworks _Final files/SAC/SAC Assy.SLDASM
68.6 x 17.4 x 87.6 mm
sacpcb1
C-1734354-2 x 2
10039851_S
