Sayidathahaseen/CCC_NGP_ODC/NGP_ODC_Main/PDLC/Mechanical/NGP_CCC Final files on dt-lohiths/thermal/EEC/eecpcb assy.SLDASM

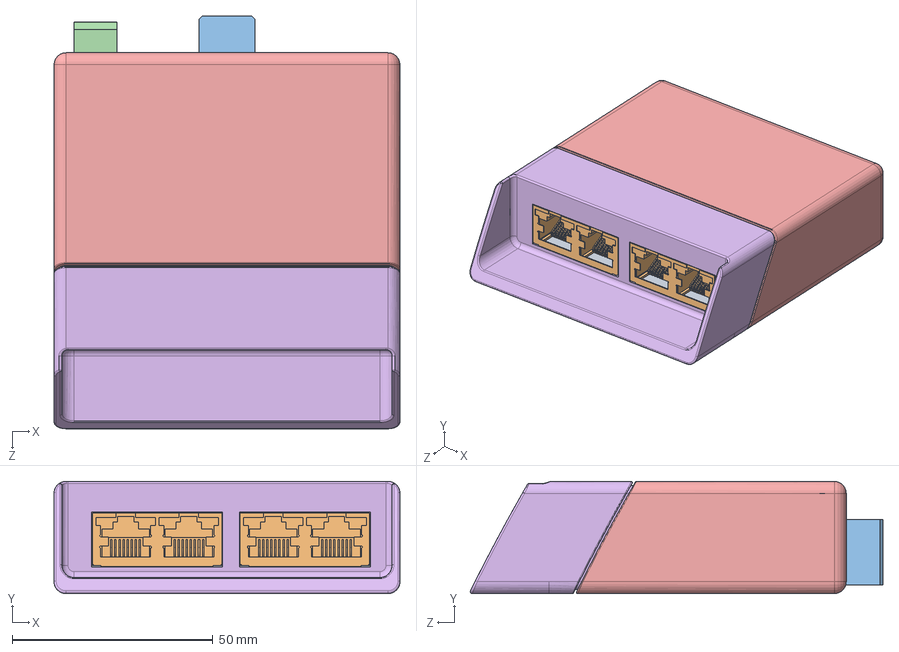
[picture p55: CAD file, 2022-06-23]
NGP_ODC_Main/PDLC/Mechanical/NGP_CCC Final files on dt-lohiths/thermal/EEC/eecpcb assy.SLDASM
86.3 x 28.0 x 102.9 mm
PCB eec
C-6116522-01-3 x 2
10039851_S
Eec cover
Eec cover-front
