Sayidathahaseen/CCC_NGP_ODC/NGP_ODC_Main/PDLC/Mechanical/NGP_CCC Final files on dt-lohiths/thermal/SAC/SAC Assy.SLDASM

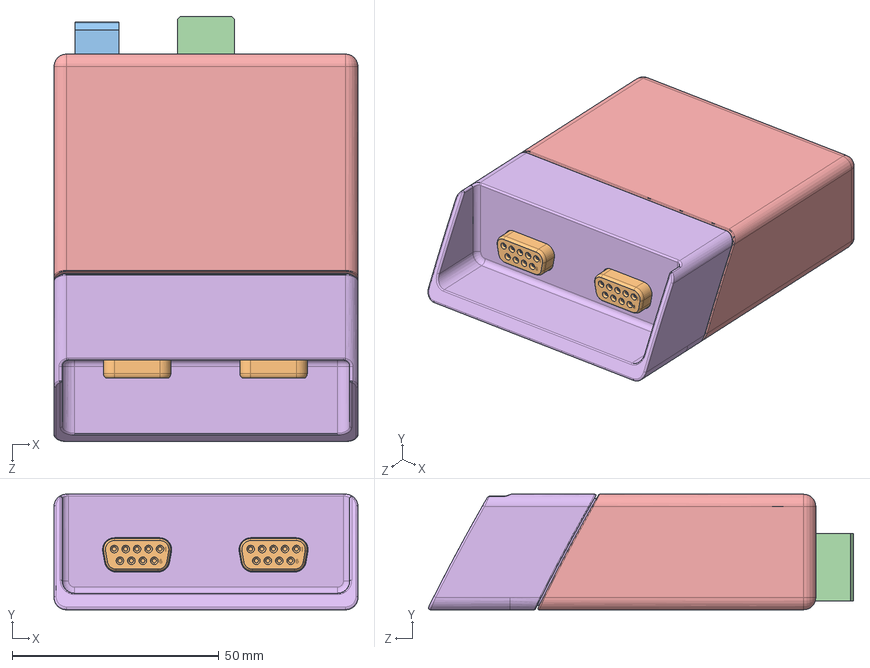
[picture p57: CAD file, 2022-06-23]
NGP_ODC_Main/PDLC/Mechanical/NGP_CCC Final files on dt-lohiths/thermal/SAC/SAC Assy.SLDASM
73.6 x 28.0 x 102.9 mm
sacpcb1
C-1734348-1-B-3D x 2
10039851_S
Sac cover
Sac cover-front
