Sayidathahaseen/CCC_NGP_ODC/NGP_ODC_Main/PDLC/Mechanical/CCC_MECHANICAL_REV2/IES MOD ASSY.SLDASM

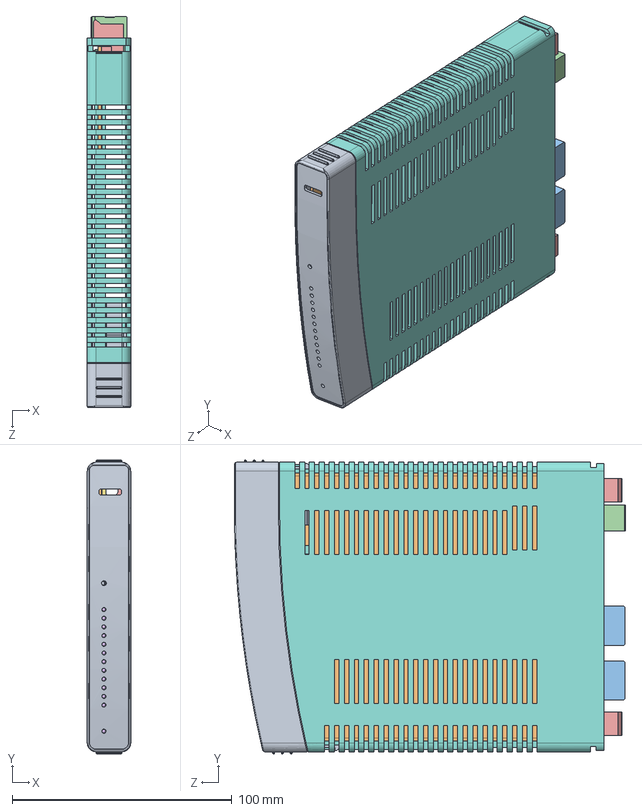
[picture p58: CAD file, 2022-06-23]
NGP_ODC_Main/PDLC/Mechanical/CCC_MECHANICAL_REV2/IES MOD ASSY.SLDASM
19.8 x 133.7 x 177.9 mm
PCB-ies
10045267_S x 2
APBDA3020SURKCGKC-GX (LED) x 14
C16643 (smd logo)
IES mod body
