Sayidathahaseen/CCC_NGP_ODC/NGP_ODC_Main/PDLC/Mechanical/NGP_CCC Final files on dt-lohiths/Solidworks _Final files/EEC/EEC MOD ASSY.SLDASM

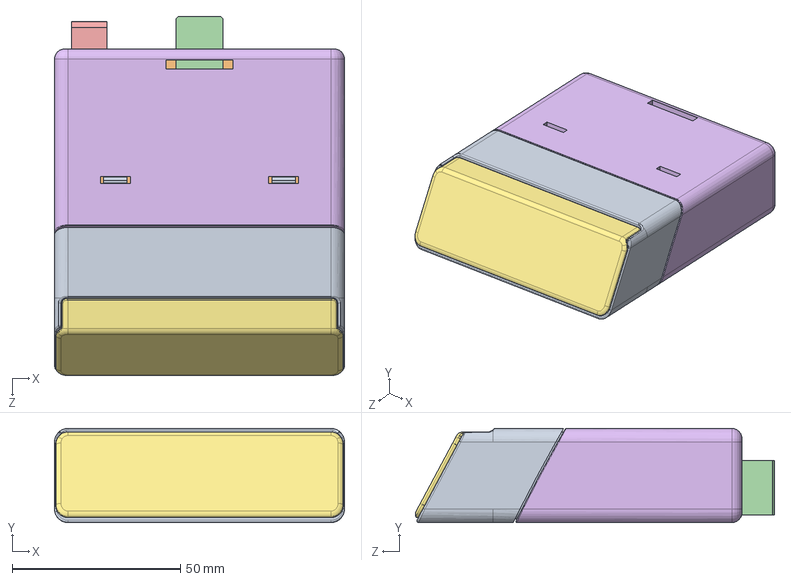
[picture p59: CAD file, 2022-06-23]
NGP_ODC_Main/PDLC/Mechanical/NGP_CCC Final files on dt-lohiths/Solidworks _Final files/EEC/EEC MOD ASSY.SLDASM
86.3 x 28.0 x 106.9 mm
Eec cover-front
PCB eec
C-6116522-01-3 x 2
10039851_S
Eec cover
Front cover_EEC
