Sayidathahaseen/CCC_NGP_ODC/NGP_ODC_Main/PDLC/Mechanical/NGP_CCC Final files on dt-lohiths/thermal/FTC MOD/FTC pcb-2 assy.SLDASM

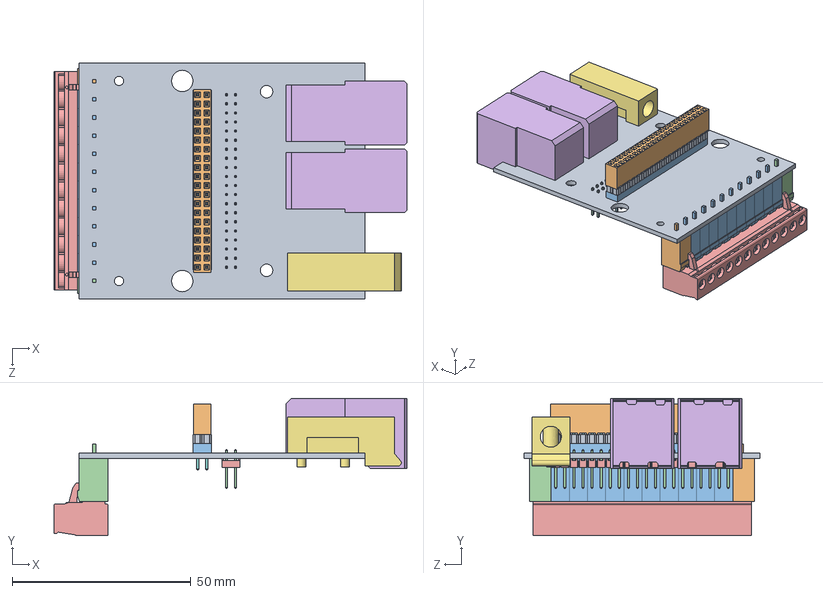
[picture p60: CAD file, 2022-06-23]
NGP_ODC_Main/PDLC/Mechanical/NGP_CCC Final files on dt-lohiths/thermal/FTC MOD/FTC pcb-2 assy.SLDASM
98.8 x 38.5 x 66.0 mm
FTC PCB-2
20020107-H-LEM_1
20020107-H-CM_1 x 10
20020107-H-REM_1
20020007-PLUG
10052838C x 2
C-15-X_-03 x 40
DSB-36_Formula
ssw-xx-x_-D Formula
TSW-_Formula
C3D-T-1S6_-07 Straight x 40
C3D-TSW-XX-D_Formula
