Sayidathahaseen/CCC_NGP_ODC/NGP_ODC_Main/PDLC/Mechanical/NGP_CCC Final files on dt-lohiths/thermal/PCC MOD/pccpcb assy.SLDASM

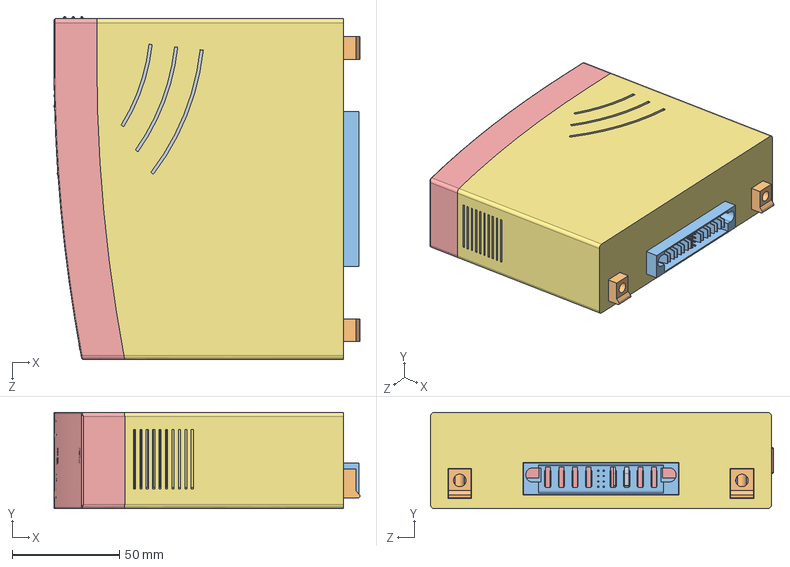
[picture p63: CAD file, 2022-06-23]
NGP_ODC_Main/PDLC/Mechanical/NGP_CCC Final files on dt-lohiths/thermal/PCC MOD/pccpcb assy.SLDASM
142.7 x 45.0 x 160.1 mm
PCB-pcc
51720-10400804AAC
C16643 (smd logo) x 7
PCC mod face plate
P-CCC LOGO
PCC mod body
LED light pipe
LED light pipe-2
