Sayidathahaseen/CCC_NGP_ODC/NGP_ODC_Main/PDLC/Mechanical/NGP_CCC Final files on dt-lohiths/Solidworks _Final files/IOP Module/QSE_040_01_ASM.sldasm

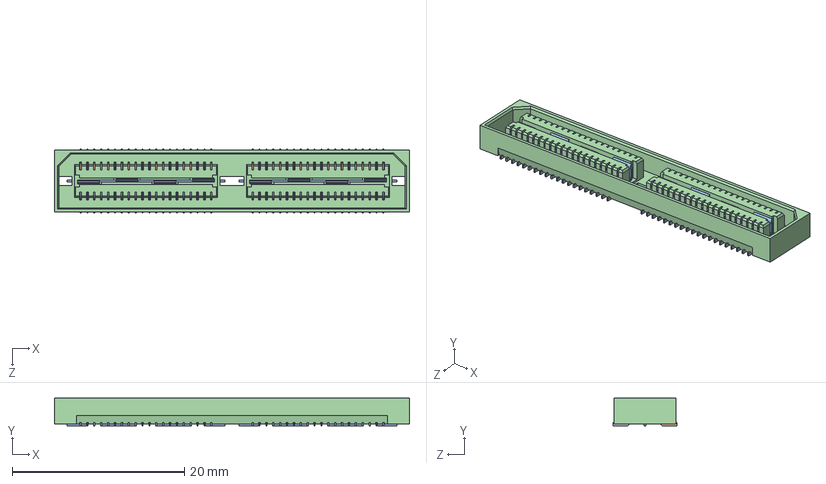
[picture p64: CAD file, 2022-06-23]
NGP_ODC_Main/PDLC/Mechanical/NGP_CCC Final files on dt-lohiths/Solidworks _Final files/IOP Module/QSE_040_01_ASM.sldasm
41.3 x 3.25 x 7.49 mm
