Sayidathahaseen/CCC_NGP_ODC/NGP_ODC_Main/PDLC/Mechanical/NGP_CCC Final files on dt-lohiths/thermal/IES MOD 4-7-2011/IES MOD ASSY.SLDASM

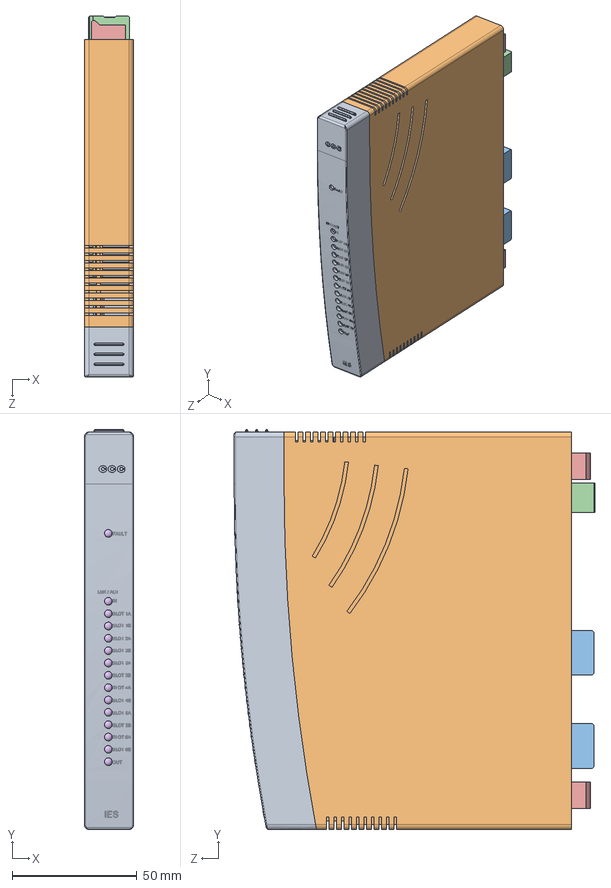
[picture p65: CAD file, 2022-06-23]
NGP_ODC_Main/PDLC/Mechanical/NGP_CCC Final files on dt-lohiths/thermal/IES MOD 4-7-2011/IES MOD ASSY.SLDASM
19.8 x 160.1 x 144.4 mm
IES mod face plate
PCB-ies
10045267_S x 2
C17873A 3mm led x 15
C16643 (smd logo) x 2
SMLXR851USBC-TR
CCC LOGO_ies
IES mod body
