Sayidathahaseen/CCC_NGP_ODC/NGP_ODC_Main/PDLC/Mechanical/CCC_MECHANICAL_REV2/FTC pcb-1 assy.SLDASM

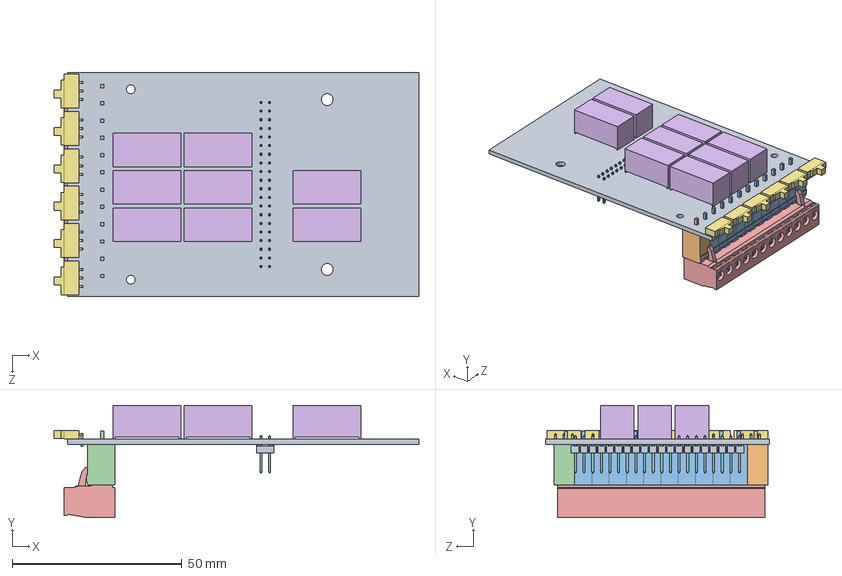
[picture p66: CAD file, 2022-06-23]
NGP_ODC_Main/PDLC/Mechanical/CCC_MECHANICAL_REV2/FTC pcb-1 assy.SLDASM
107.4 x 33.1 x 66.0 mm
FTC PCB-1
20020107-H-LEM_1
20020107-H-CM_1 x 10
20020107-H-REM_1
20020007-PLUG
DS2Y-S-DC24V Relay x 8
EAO-1K2 switch x 6
C3D-T-1S6_-07 Straight x 40
C3D-TSW-XX-D_Formula
