Sayidathahaseen/CCC_NGP_ODC/NGP_ODC_Main/PDLC/Mechanical/NGP_CCC Final files on dt-lohiths/Solidworks _Final files/APP MOD/apppcb assy.SLDASM

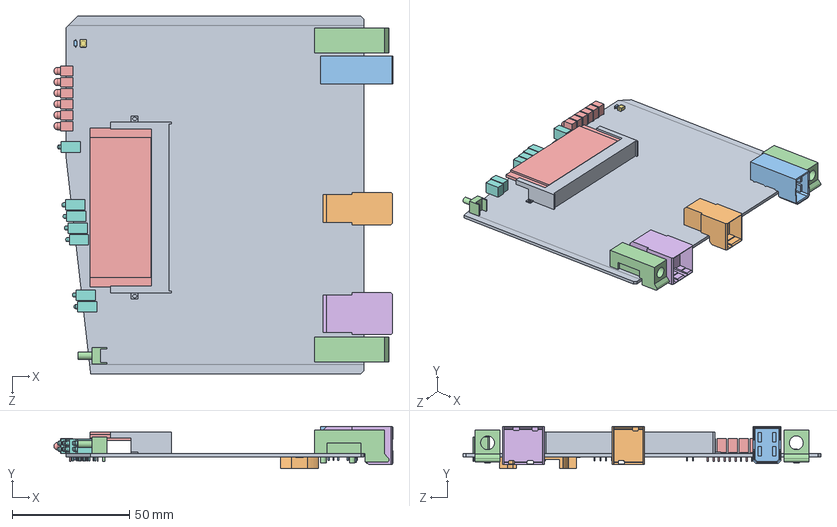
[picture p67: CAD file, 2022-06-23]
NGP_ODC_Main/PDLC/Mechanical/NGP_CCC Final files on dt-lohiths/Solidworks _Final files/APP MOD/apppcb assy.SLDASM
144.5 x 18.0 x 152.4 mm
PCB-app
10039851_S
C17873A 3mm led x 6
10045267_S
C16643 (smd logo)
SSF-LXH512SUGD x 7
SODIMM_MM80-204B1-E1
SMTU2430-LF
LB_LT_Y87S_Pb x 2
TL1105
SODIMM pcb
