Sayidathahaseen/CCC_NGP_ODC/NGP_ODC_Main/PDLC/Mechanical/NGP_CCC Final files on dt-lohiths/Solidworks _Final files/Back Plane Assy/Back Plane Assy.SLDASM

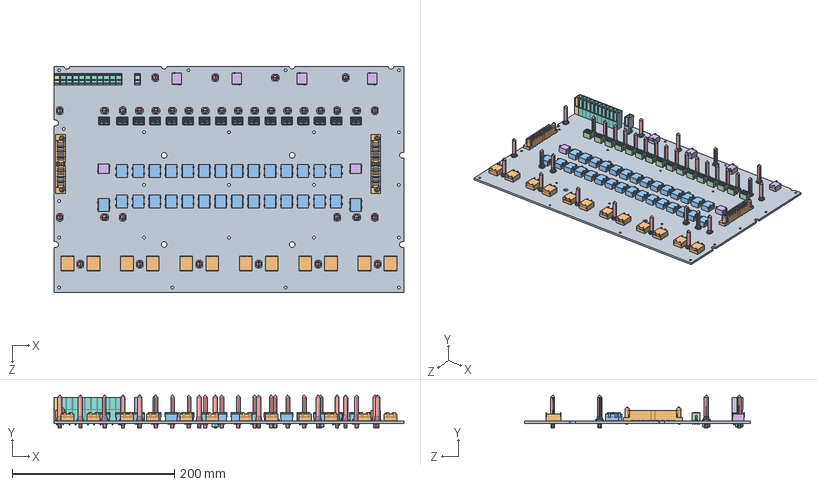
[picture p68: CAD file, 2022-06-23]
NGP_ODC_Main/PDLC/Mechanical/NGP_CCC Final files on dt-lohiths/Solidworks _Final files/Back Plane Assy/Back Plane Assy.SLDASM
431.8 x 40.7 x 279.4 mm
Back plane pcb
51740-10400804AALFC x 2
10045271_S x 30
P10028916XXXXPXX x 16
GUIDEPIN_BP x 34
10043546_S x 6
20020620-M-LEM
20020620-M-CM x 10
20020620-M-REM
10052842C x 12
M5-nut x 2
