Sayidathahaseen/CCC_NGP_ODC/NGP_ODC_Main/PDLC/Mechanical/NGP_CCC Final files on dt-lohiths/Solidworks _Final files/IES MOD 4-7-2011/IES MOD ASSY.SLDASM

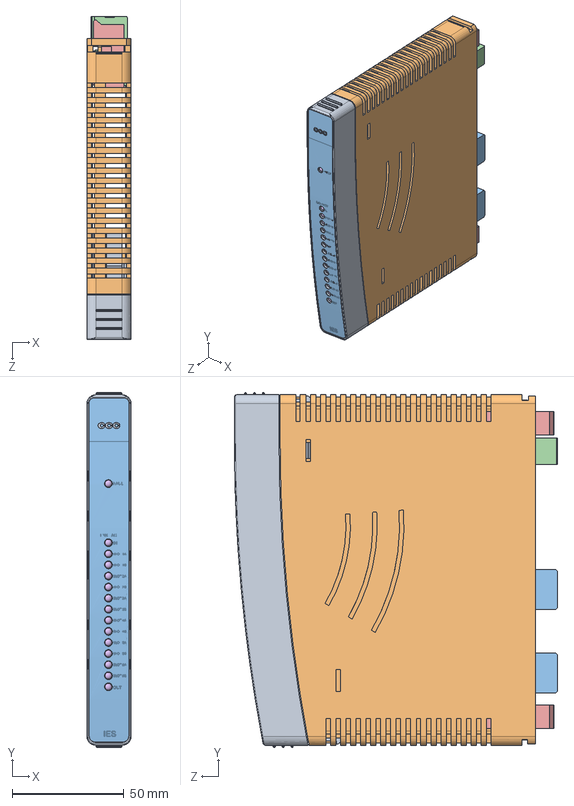
[picture p69: CAD file, 2022-06-23]
NGP_ODC_Main/PDLC/Mechanical/NGP_CCC Final files on dt-lohiths/Solidworks _Final files/IES MOD 4-7-2011/IES MOD ASSY.SLDASM
19.8 x 159.1 x 144.8 mm
IES mod face plate
PCB-ies
10045267_S x 2
C17873A 3mm led x 15
C16643 (smd logo) x 2
LB_LT_Y87S_Pb
CCC LOGO_ies-ne_18-07
IES mod body
Label-IES
