Sayidathahaseen/CCC_NGP_ODC/NGP_ODC_Main/PDLC/Mechanical/NGP_CCC Final files on dt-lohiths/Solidworks _Final files/EEC/eecpcb assy.SLDASM

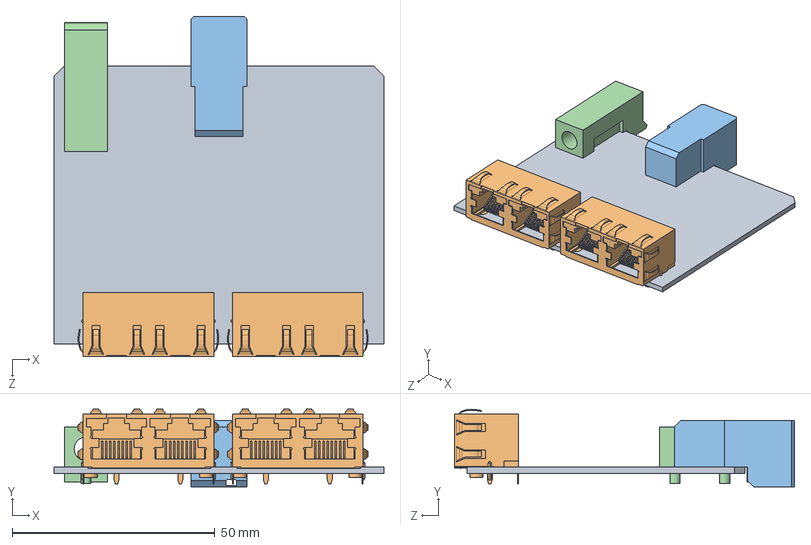
[picture p70: CAD file, 2022-06-23]
NGP_ODC_Main/PDLC/Mechanical/NGP_CCC Final files on dt-lohiths/Solidworks _Final files/EEC/eecpcb assy.SLDASM
81.3 x 19.1 x 83.8 mm
PCB eec
C-6116522-01-3 x 2
10039851_S
