Sayidathahaseen/CCC_NGP_ODC/NGP_ODC_Main/PDLC/Mechanical/NGP_CCC Final files on dt-lohiths/thermal/APP MOD/APP MOD ASSY.SLDASM

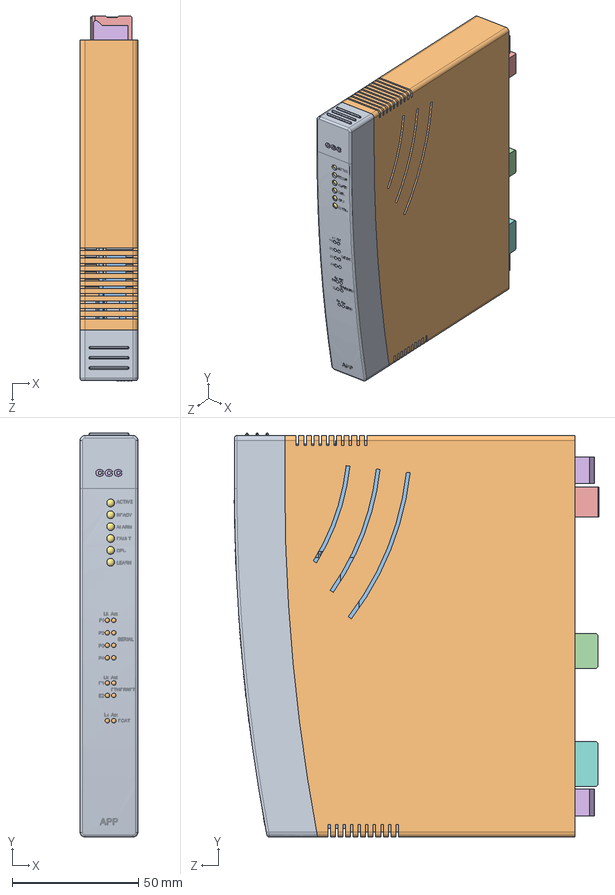
[picture p71: CAD file, 2022-06-23]
NGP_ODC_Main/PDLC/Mechanical/NGP_CCC Final files on dt-lohiths/thermal/APP MOD/APP MOD ASSY.SLDASM
23.0 x 160.1 x 144.5 mm
APP mod face plate
APP mod body
PCB-app
10039851_S
C17873A 3mm led x 6
10045267_S
C16643 (smd logo)
SSF-LXH512SUGD x 7
SODIMM_MM80-204B1-E1
SMTU2430-LF
SMLXR851USBC-TR x 2
CCC LOGO-APP
