Sayidathahaseen/CCC_NGP_ODC/NGP_ODC_Main/PDLC/Mechanical/NGP_CCC Final files on dt-lohiths/Solidworks _Final files/PCC MOD/PCC MOD ASSY.SLDASM

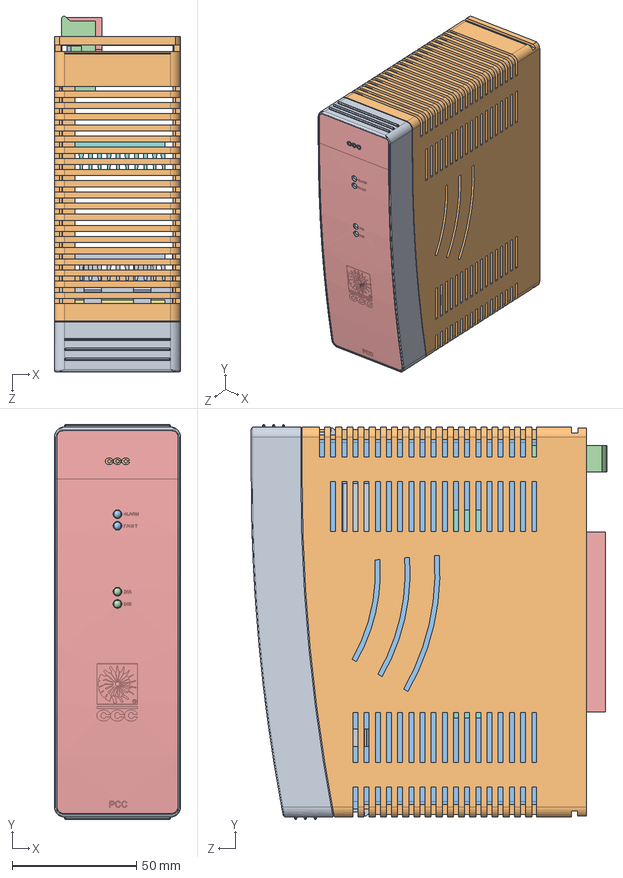
[picture p72: CAD file, 2022-06-23]
NGP_ODC_Main/PDLC/Mechanical/NGP_CCC Final files on dt-lohiths/Solidworks _Final files/PCC MOD/PCC MOD ASSY.SLDASM
50.8 x 159.1 x 143.2 mm
PCC mod face plate rev1
PCC mod body
PCB-pcc
51720-10400804AAC
C16643 (smd logo) x 4
Heat sink-1 (PCC)
Heat sink-2 (PCC)
Heat sink-3 (PCC)
P-CCC LOGO
LED light pipe
LED light pipe-2
Label-PCC
