Sayidathahaseen/CCC_NGP_ODC/NGP_ODC_Main/PDLC/Mechanical/NGP_CCC Final files on dt-lohiths/Solidworks _Final files/ECAT/ECAT MOD ASSY.SLDASM

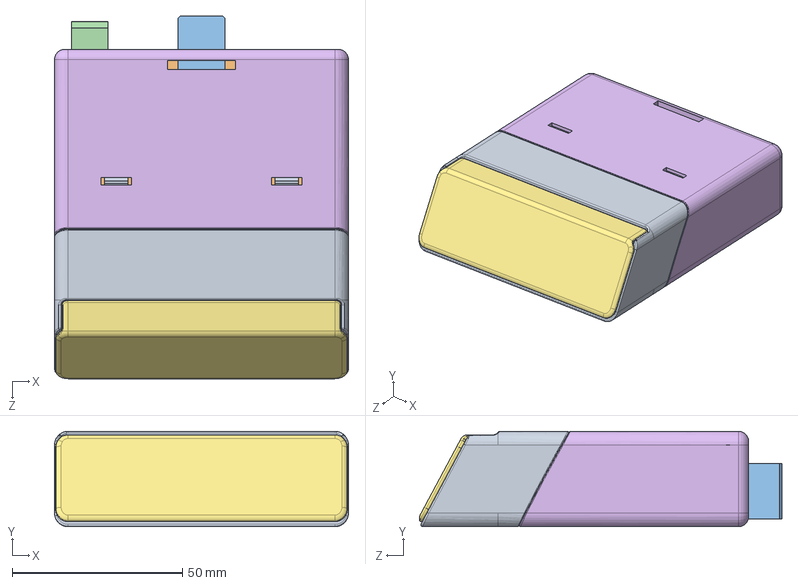
[picture p73: CAD file, 2022-06-23]
NGP_ODC_Main/PDLC/Mechanical/NGP_CCC Final files on dt-lohiths/Solidworks _Final files/ECAT/ECAT MOD ASSY.SLDASM
86.3 x 28.0 x 106.4 mm
ECAT mod face plate
ecatpcb
10039851_S
43K1A542----- x 4
ECAT mod body
ECAT Front cover
sp nut x 4
