Sayidathahaseen/CCC_NGP_ODC/NGP_ODC_Main/PDLC/Mechanical/NGP_CCC Final files on dt-lohiths/Solidworks _Final files/ECAT/ecat assy.SLDASM

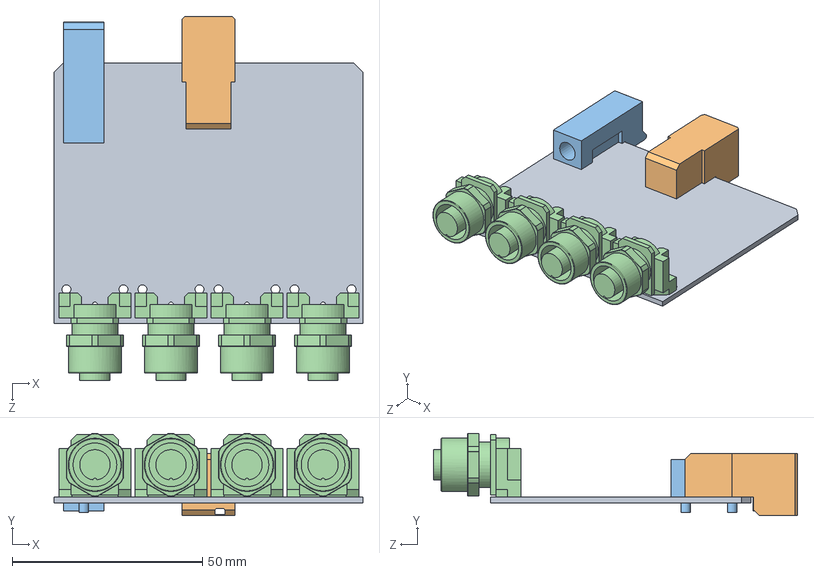
[picture p75: CAD file, 2022-06-23]
NGP_ODC_Main/PDLC/Mechanical/NGP_CCC Final files on dt-lohiths/Solidworks _Final files/ECAT/ecat assy.SLDASM
81.3 x 21.6 x 95.8 mm
ecatpcb
10039851_S
43K1A542----- x 4
