Sayidathahaseen/CCC_NGP_ODC/NGP_ODC_Main/PDLC/Mechanical/NGP_CCC Final files on dt-lohiths/Solidworks _Final files/PCC MOD/pccpcb assy.SLDASM

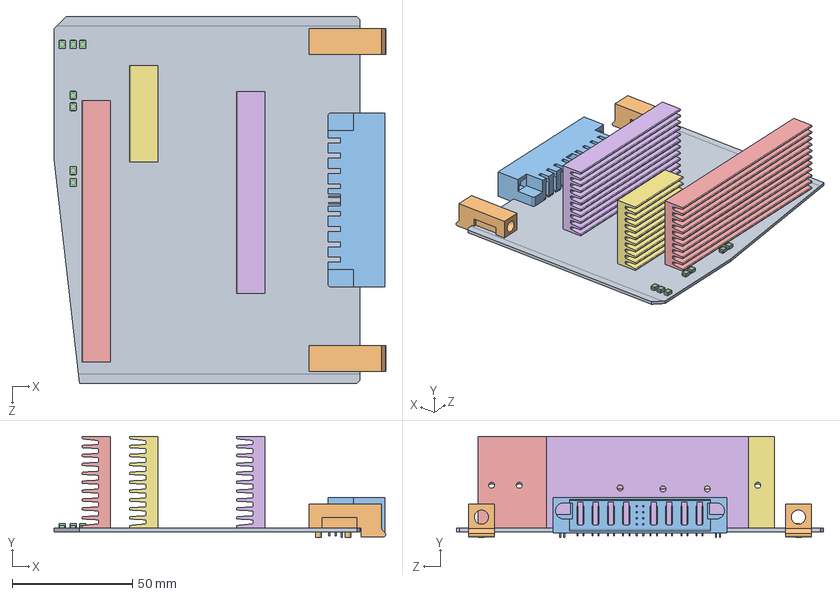
[picture p76: CAD file, 2022-06-23]
NGP_ODC_Main/PDLC/Mechanical/NGP_CCC Final files on dt-lohiths/Solidworks _Final files/PCC MOD/pccpcb assy.SLDASM
137.7 x 42.0 x 152.4 mm
PCB-pcc
51720-10400804AAC
C16643 (smd logo) x 7
Heat sink-1 (PCC)
Heat sink-2 (PCC)
Heat sink-3 (PCC)
