Sayidathahaseen/CCC_NGP_ODC/NGP_ODC_Main/PDLC/Mechanical/NGP_CCC Final files on dt-lohiths/Solidworks _Final files/FTC 21-07-2011/ESQ-120-23-X-D.sldasm

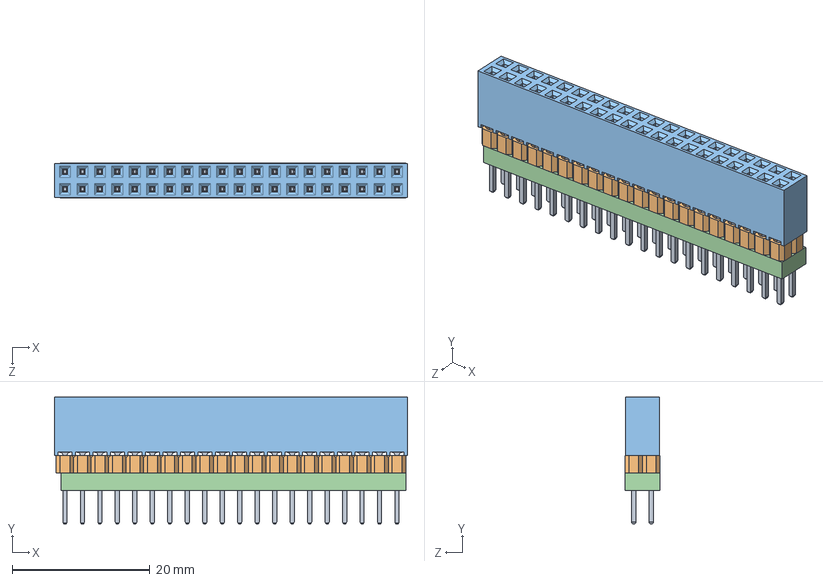
[picture p77: CAD file, 2022-06-23]
NGP_ODC_Main/PDLC/Mechanical/NGP_CCC Final files on dt-lohiths/Solidworks _Final files/FTC 21-07-2011/ESQ-120-23-X-D.sldasm
51.3 x 18.4 x 5.08 mm
C-15-X_-03 x 40
DSB-36_Formula
ssw-xx-x_-D Formula
TSW-_Formula
