Sayidathahaseen/CCC_NGP_ODC/NGP_ODC_Main/PDLC/Mechanical/NGP_CCC Final files on dt-lohiths/Solidworks _Final files/IOP Module/IOP MOD ASSY.SLDASM

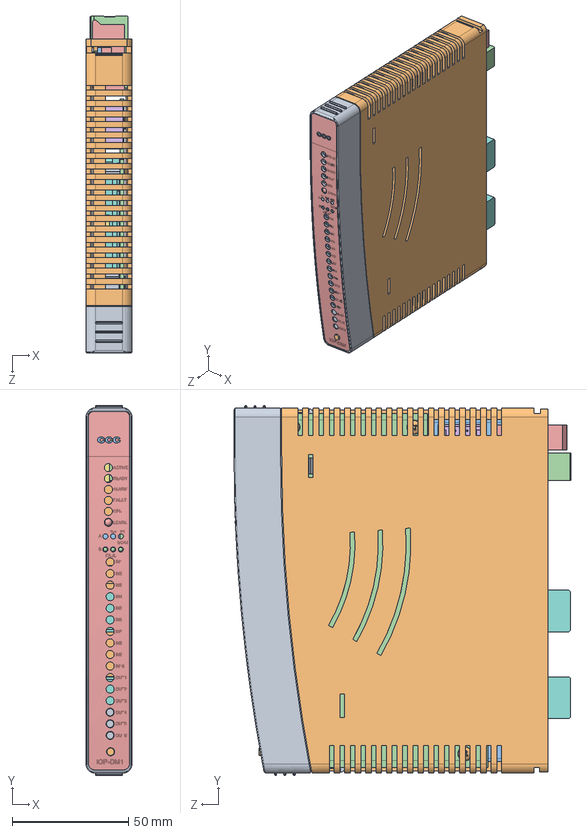
[picture p78: CAD file, 2022-06-23]
NGP_ODC_Main/PDLC/Mechanical/NGP_CCC Final files on dt-lohiths/Solidworks _Final files/IOP Module/IOP MOD ASSY.SLDASM
19.8 x 159.1 x 144.8 mm
IOP mod face plate
IOP mod body
PCB-iop
T-1S39_-02 x 160
T-1G1-X_-02 x 4
Qte-xx-d_Formula -02 x 2
5513508F_SW0001 x 3
EC2-5NJ RELAY
EC2-24NJ RELAY
TRI-LED
C17873A 3mm led
2510-6002UB
PVT412PBF
10045267_S x 2
C16643 (smd logo)
TL1105
LB_LT_Y87S_Pb
iopdgr-pcb
Standoff x 4
M3x5 x 8
CCC LOGO_iop-19-07
Keying soket
Label-IOP-DM1
