Sayidathahaseen/CCC_NGP_ODC/NGP_ODC_Main/PDLC/Mechanical/NGP_CCC Final files on dt-lohiths/Solidworks _Final files/IOP Module/iopdrg- assy.SLDASM

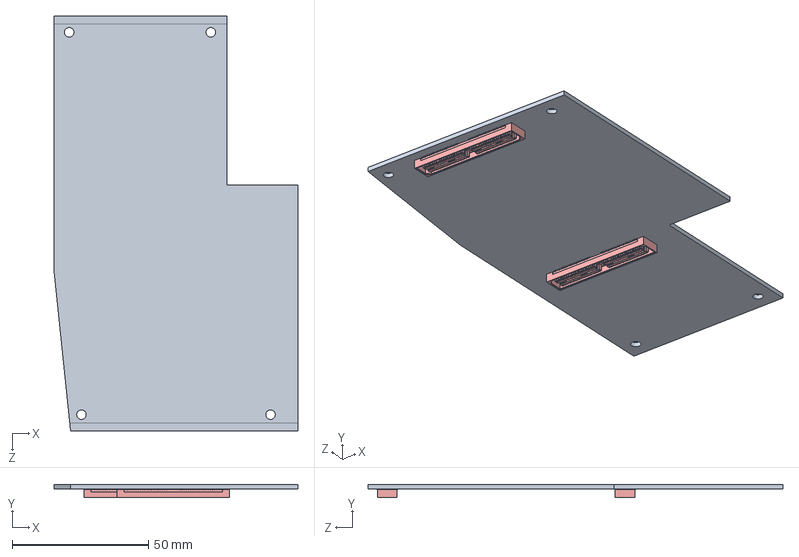
[picture p81: CAD file, 2022-06-23]
NGP_ODC_Main/PDLC/Mechanical/NGP_CCC Final files on dt-lohiths/Solidworks _Final files/IOP Module/iopdrg- assy.SLDASM
89.4 x 4.85 x 152.4 mm
iopdgr-pcb
