Sayidathahaseen/CCC_NGP_ODC/NGP_ODC_Main/PDLC/Mechanical/NGP_CCC Final files on dt-lohiths/Solidworks _Final files/FTC 21-07-2011/TSW-120-07-X-D.sldasm

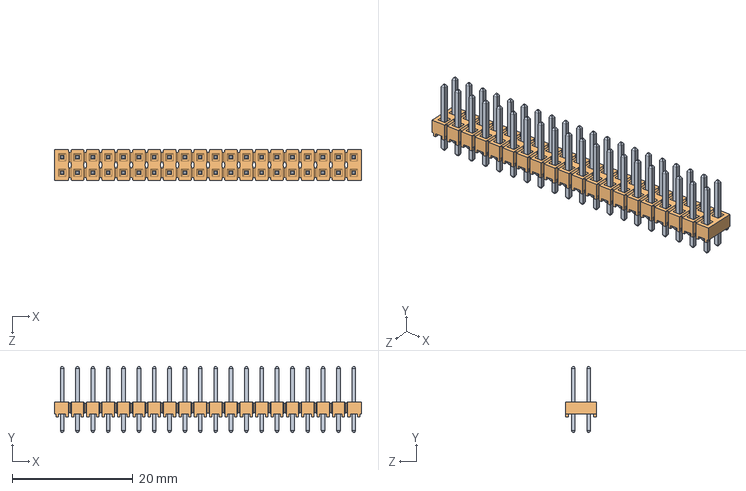
[picture p82: CAD file, 2022-06-23]
NGP_ODC_Main/PDLC/Mechanical/NGP_CCC Final files on dt-lohiths/Solidworks _Final files/FTC 21-07-2011/TSW-120-07-X-D.sldasm
50.8 x 10.9 x 5.08 mm
C3D-T-1S6_-07 Straight x 40
C3D-TSW-XX-D_Formula
