Sayidathahaseen/CCC_NGP_ODC/NGP_ODC_Main/PDLC/Mechanical/CCC_MECHANICAL_REV2/ecat assy.SLDASM

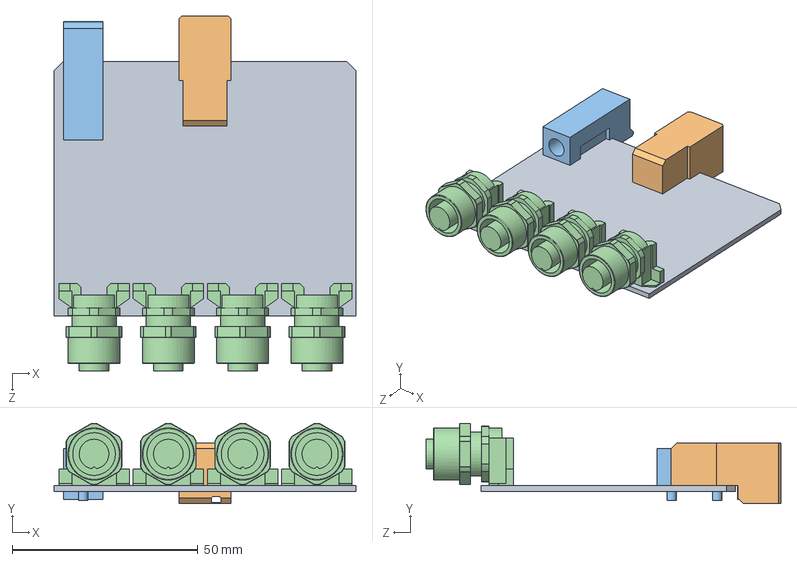
[picture p83: CAD file, 2022-06-23]
NGP_ODC_Main/PDLC/Mechanical/CCC_MECHANICAL_REV2/ecat assy.SLDASM
81.3 x 21.6 x 95.6 mm
ecatpcb
10039851_S
43K1A542 x 4
