Sayidathahaseen/CCC_NGP_ODC/NGP_ODC_Main/PDLC/Mechanical/CCC_MECHANICAL_REV2/EEC MOD ASSY.SLDASM

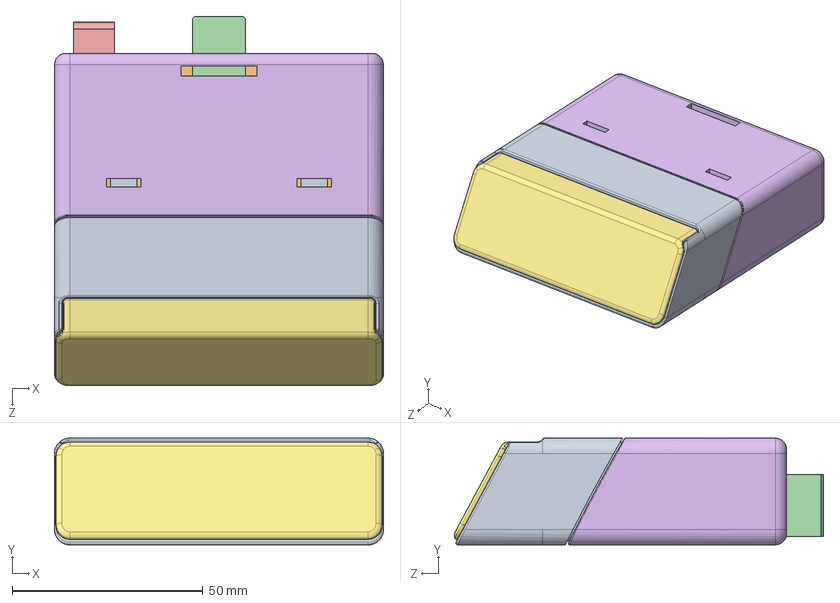
[picture p84: CAD file, 2022-06-23]
NGP_ODC_Main/PDLC/Mechanical/CCC_MECHANICAL_REV2/EEC MOD ASSY.SLDASM
86.3 x 28.0 x 96.9 mm
Eec cover-front
PCB eec
C-6116522-01-3 x 2
10039851_S
Eec cover
Front cover_EEC
