Sayidathahaseen/CCC_NGP_ODC/NGP_ODC_Main/PDLC/Mechanical/CCC_MECHANICAL_REV2/eecpcb assy.SLDASM

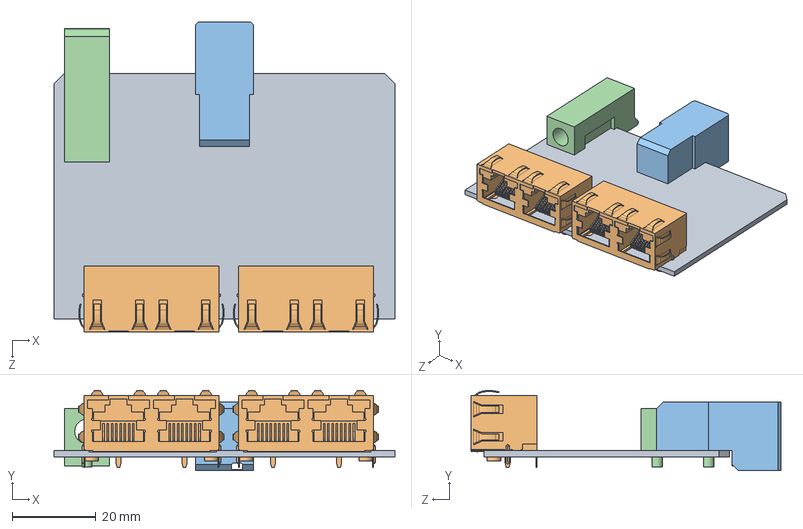
[picture p85: CAD file, 2022-06-23]
NGP_ODC_Main/PDLC/Mechanical/CCC_MECHANICAL_REV2/eecpcb assy.SLDASM
81.3 x 19.1 x 73.8 mm
PCB eec
C-6116522-01-3 x 2
10039851_S
