Sayidathahaseen/CCC_NGP_ODC/NGP_ODC_Main/PDLC/Mechanical/NGP_CCC Final files on dt-lohiths/thermal/IOP Module/IOP MOD ASSY.SLDASM

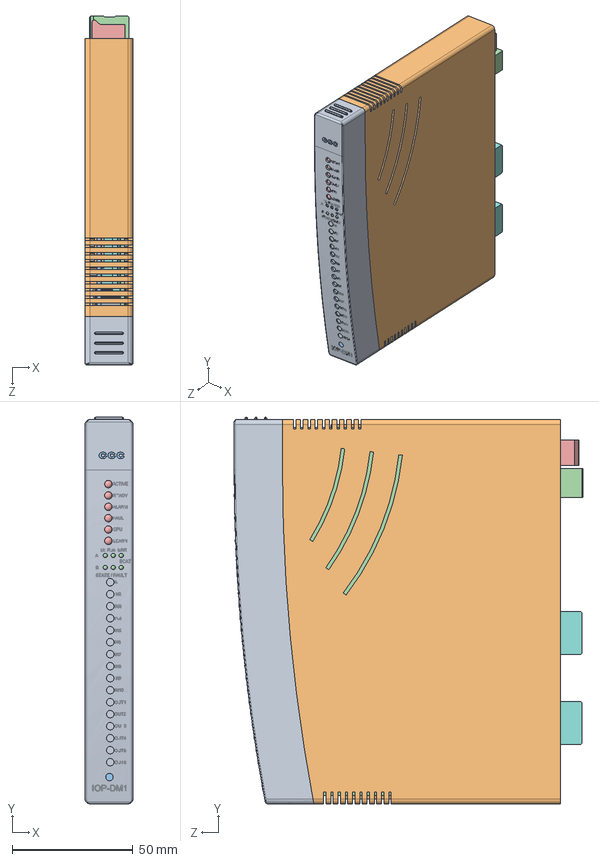
[picture p87: CAD file, 2022-06-23]
NGP_ODC_Main/PDLC/Mechanical/NGP_CCC Final files on dt-lohiths/thermal/IOP Module/IOP MOD ASSY.SLDASM
19.8 x 160.1 x 144.5 mm
IOP mod body
PCB-iop
T-1S39_-02 x 160
T-1G1-X_-02 x 4
Qte-xx-d_Formula -02 x 2
5513508F_SW0001 x 16
EC2-5NJ RELAY x 2
EC2-24NJ RELAY x 3
TRI-LED x 2
C17873A 3mm led x 6
2510-6002UB
PVT412PBF
10045267_S x 2
C16643 (smd logo) x 3
TL1105
iopdgr-pcb
Standoff x 4
M3x5 x 8
CCC LOGO
