Sayidathahaseen/CCC_NGP_ODC/NGP_ODC_Main/PDLC/Mechanical/NGP_CCC Final files on dt-lohiths/Solidworks _Final files/IOP Module/ioppcb_Analog assy-1.SLDASM

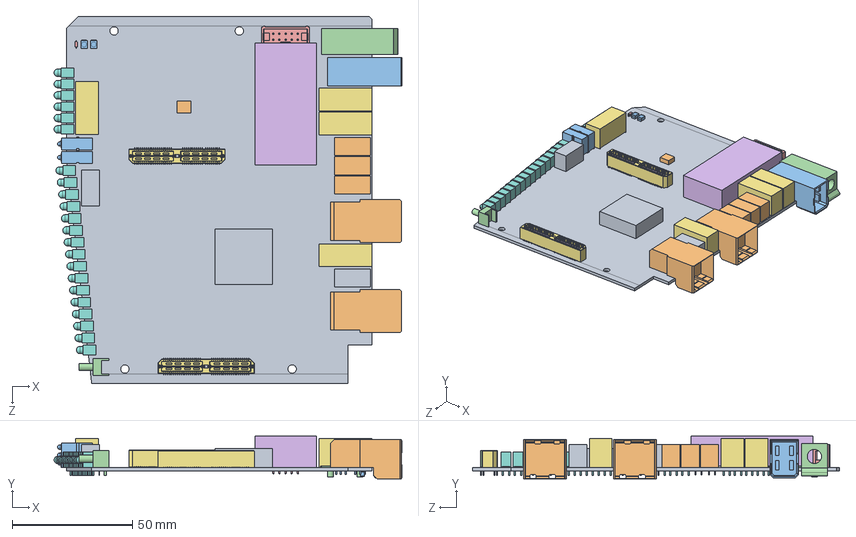
[picture p92: CAD file, 2022-06-23]
NGP_ODC_Main/PDLC/Mechanical/NGP_CCC Final files on dt-lohiths/Solidworks _Final files/IOP Module/ioppcb_Analog assy-1.SLDASM
144.5 x 17.9 x 152.4 mm
PCB-iop
10045267_S x 2
T-1S39_-02 x 160
T-1G1-X_-02 x 4
Qte-xx-d_Formula -02 x 2
C17873A 3mm led x 22
EC2-5NJ RELAY x 2
EC2-24NJ RELAY x 3
5700100221F (Tri level) x 2
TAJD106K050RNJ
2510-6002UB
TWR-53-15250-D24-C
VWRBS2-D5-S24-SIP x 4
PVT412PBF
PT78ST165H
Capacitor C5750X7R2A475K
C16643 (smd logo) x 2
TL1105
LB_LT_Y87S_Pb
