Sayidathahaseen/CCC_NGP_ODC/NGP_ODC_Main/PDLC/Mechanical/CCC_MECHANICAL_REV2/FTC total body.SLDASM

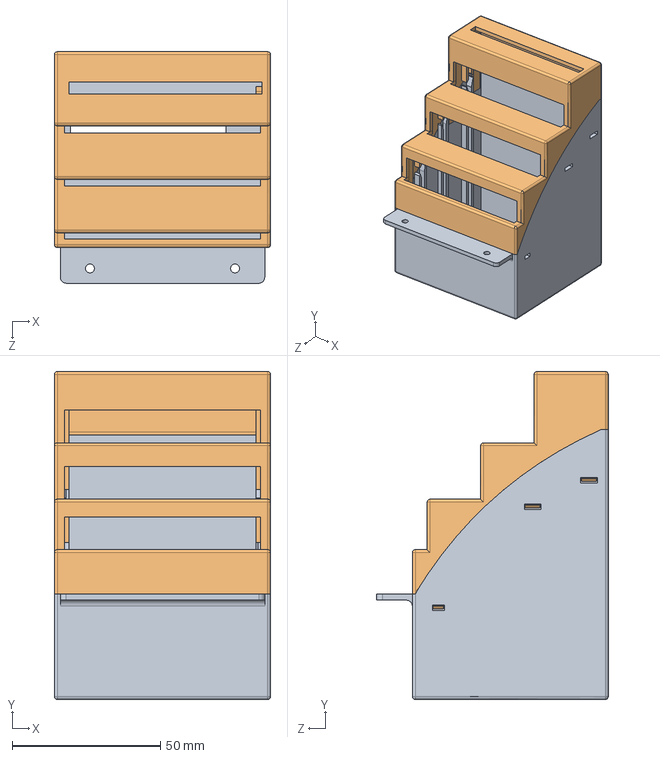
[picture p93: CAD file, 2022-06-23]
NGP_ODC_Main/PDLC/Mechanical/CCC_MECHANICAL_REV2/FTC total body.SLDASM
72.8 x 110.5 x 78.0 mm
Bottom Body
Top cover
