Sayidathahaseen/CCC_NGP_ODC/NGP_ODC_Main/PDLC/Mechanical/CCC_MECHANICAL_REV2/ESQ-110-34-X-D.sldasm

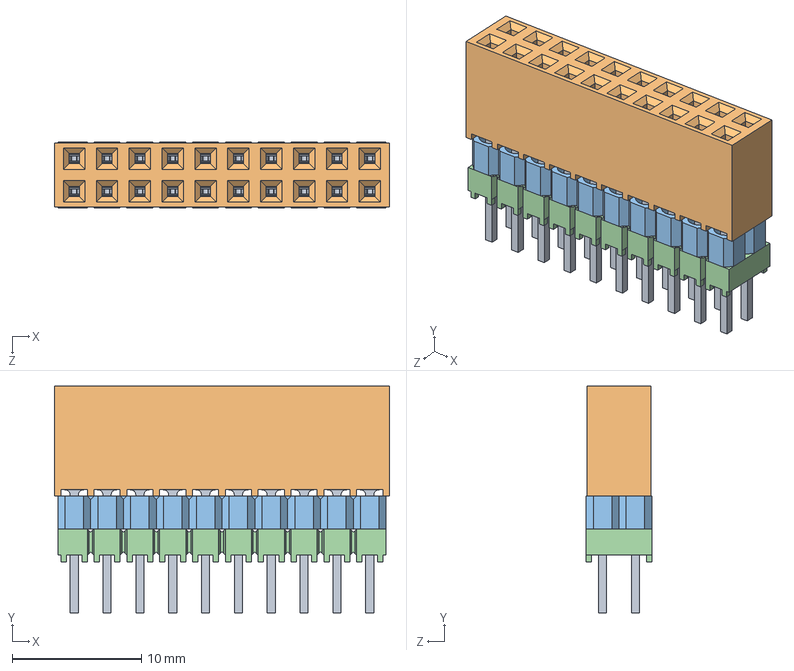
[picture p95: CAD file, 2022-06-23]
NGP_ODC_Main/PDLC/Mechanical/CCC_MECHANICAL_REV2/ESQ-110-34-X-D.sldasm
25.9 x 17.5 x 5.08 mm
C-15-X_-04 x 20
ssw-xx-x_-D Formula_1
DSB-36_Formula_1
TSW-XX-D_Formula
