Sayidathahaseen/CCC_NGP_ODC/NGP_ODC_Main/PDLC/Mechanical/CCC_MECHANICAL_REV2/FTC assy_option2.SLDASM

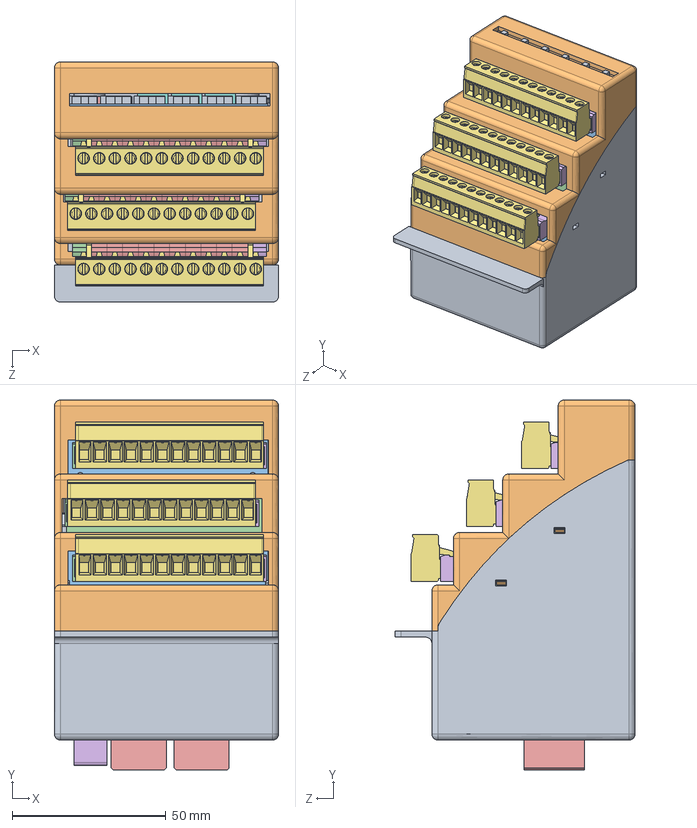
[picture p96: CAD file, 2022-06-23]
NGP_ODC_Main/PDLC/Mechanical/CCC_MECHANICAL_REV2/FTC assy_option2.SLDASM
72.8 x 120.1 x 78.0 mm
Bottom Body
Top cover
FTC PCB-1
20020107-H-LEM_1 x 3
20020107-H-CM_1 x 30
20020107-H-REM_1 x 3
20020007-PLUG x 3
DS2Y-S-DC24V Relay x 16
EAO-1K2 switch x 6
T-1S6 x 164
TSW-XX-D x 12
FTC PCB-2
10052838C x 2
C-15-X_-04 x 80
ssw-xx-x_-D Formula_1 x 4
DSB-36_Formula_1 x 4
TSW-XX-D_Formula x 4
FTC PCB-3
