Sayidathahaseen/CCC_NGP_ODC/NGP_ODC_Main/PDLC/Mechanical/CCC_MECHANICAL_REV2/ECAT MOD ASSY.SLDASM

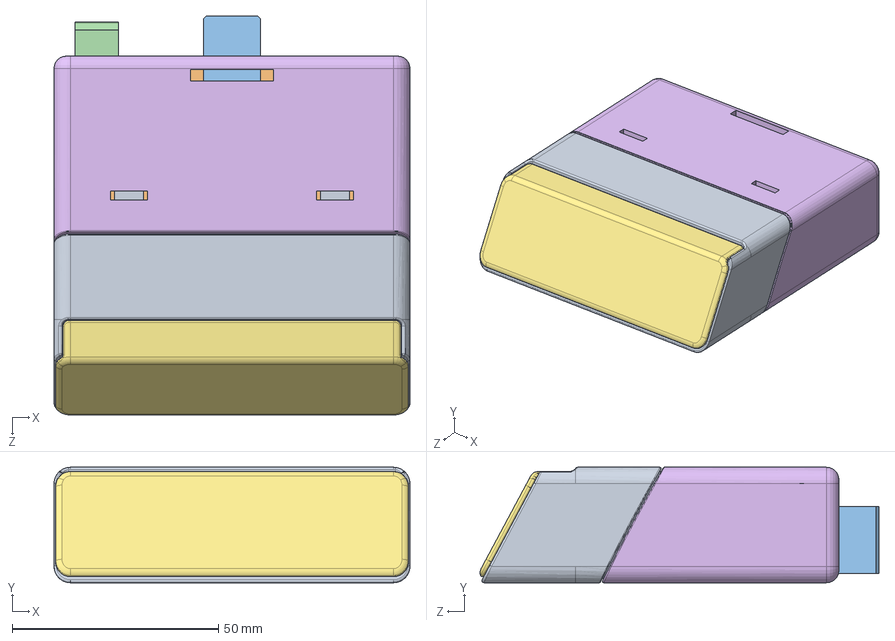
[picture p97: CAD file, 2022-06-23]
NGP_ODC_Main/PDLC/Mechanical/CCC_MECHANICAL_REV2/ECAT MOD ASSY.SLDASM
86.3 x 28.0 x 96.7 mm
Ecat cover-front
ecatpcb
10039851_S
43K1A542 x 4
Ecat cover
Front cover_ECAT
