Sayidathahaseen/CCC_NGP_ODC/NGP_ODC_Main/PDLC/Mechanical/CCC_MECHANICAL_REV2/APP MOD ASSY.SLDASM

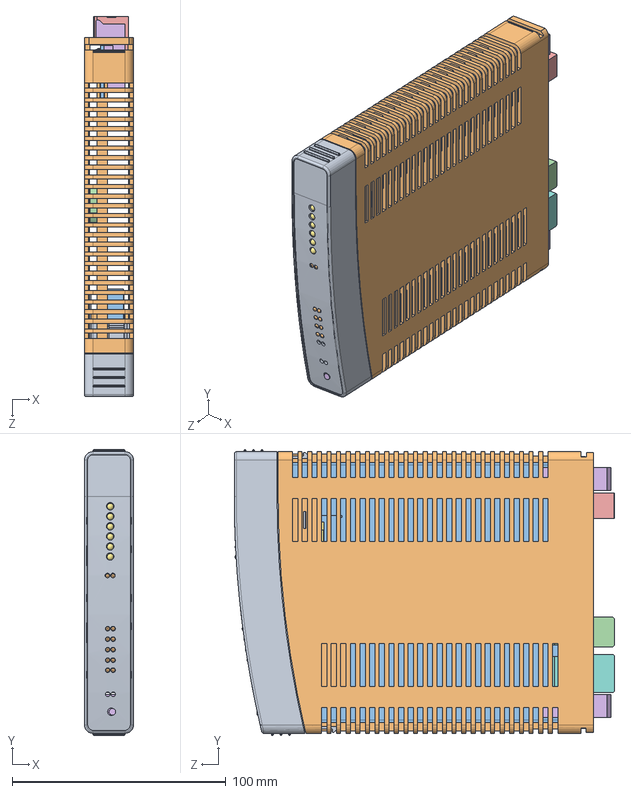
[picture p98: CAD file, 2022-06-23]
NGP_ODC_Main/PDLC/Mechanical/CCC_MECHANICAL_REV2/APP MOD ASSY.SLDASM
23.0 x 133.7 x 177.9 mm
APP mod face plate
APP mod body
PCB-app
10039851_S
C17873A 3mm led x 6
10045267_S
C16643 (smd logo)
SSF-LXH512SUGD x 7
SODIMM_MM80-204B1-E1
SMTU2430-LF
LB_LT_Y87S_Pb x 2
TL1105
SODIMM pcb
CCC LOGO-APP
