Sayidathahaseen/CCC_NGP_ODC/NGP_ODC_Main/PDLC/Mechanical/CCC_MECHANICAL_REV2/ioppcb-drgpcb_Digital assy-1.SLDASM

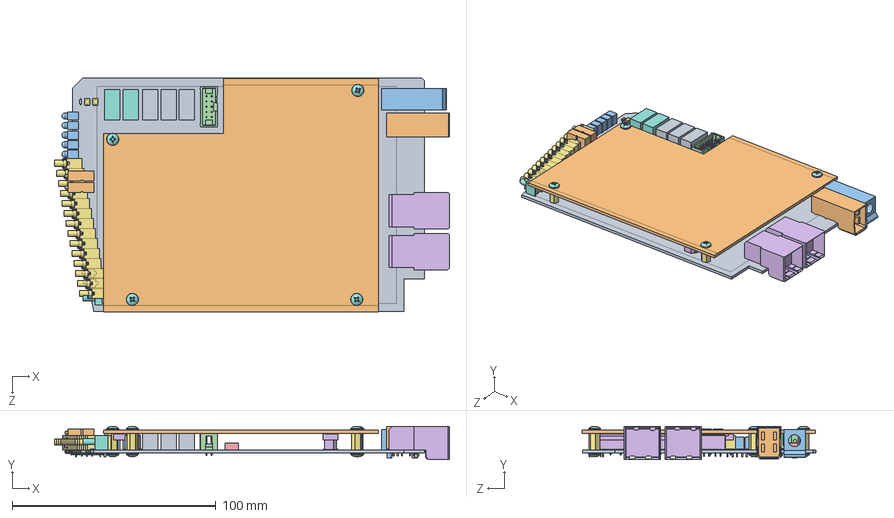
[picture p99: CAD file, 2022-06-23]
NGP_ODC_Main/PDLC/Mechanical/CCC_MECHANICAL_REV2/ioppcb-drgpcb_Digital assy-1.SLDASM
193.7 x 16.4 x 114.6 mm
PCB-iop
T-1S39_-02 x 160
T-1G1-X_-02 x 4
Qte-xx-d_Formula -02 x 2
5513508F_SW0001 x 16
EC2-5NJ RELAY x 2
EC2-24NJ RELAY x 3
TRI-LED x 2
C17873A 3mm led x 6
2510-6002UB
PVT412PBF
10045267_S x 2
C16643 (smd logo) x 2
TL1105
LB_LT_Y87S_Pb
iopdgr-pcb
Standoff x 4
M3x5 x 8
