Sayidathahaseen/CCC_NGP_ODC/NGP_ODC_Main/PDLC/Mechanical/CCC_MECHANICAL_REV2/SAC MOD ASSY.SLDASM

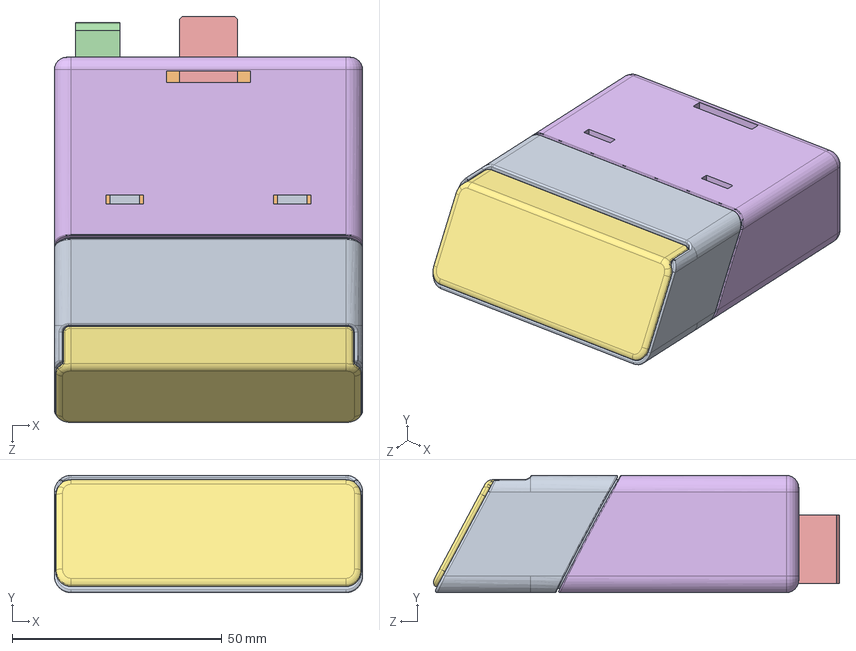
[picture p100: CAD file, 2022-06-23]
NGP_ODC_Main/PDLC/Mechanical/CCC_MECHANICAL_REV2/SAC MOD ASSY.SLDASM
73.6 x 28.0 x 96.9 mm
Sac cover-front
sacpcb1
C-1734354-2 x 2
10039851_S
Sac cover
Front cover_SAC
