Sayidathahaseen/CCC_NGP_ODC/NGP_ODC_Main/PDLC/Mechanical/CCC_MECHANICAL_REV2/ies pcb assy.SLDASM

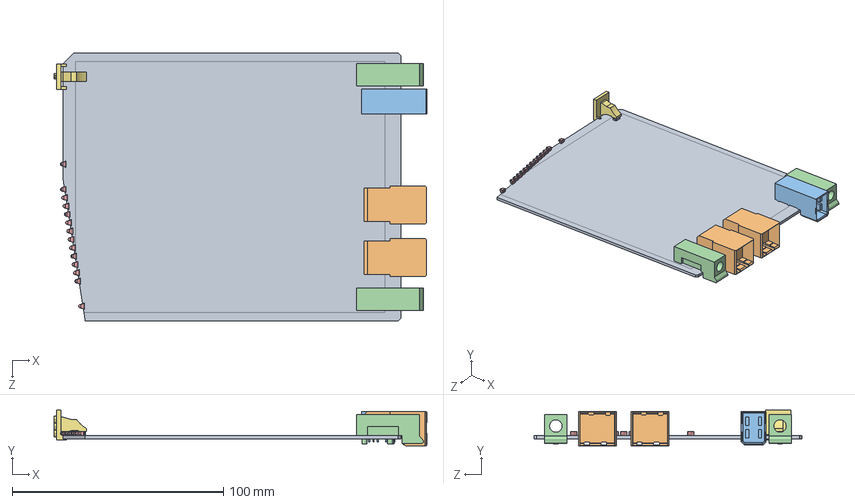
[picture p101: CAD file, 2022-06-23]
NGP_ODC_Main/PDLC/Mechanical/CCC_MECHANICAL_REV2/ies pcb assy.SLDASM
176.7 x 16.8 x 127.0 mm
PCB-ies
10045267_S x 2
APBDA3020SURKCGKC-GX (LED) x 14
C16643 (smd logo)
CCC LOGO_light pipe design
