Sayidathahaseen/CCC_NGP_ODC/NGP_ODC_Main/PDLC/Mechanical/CCC_MECHANICAL_REV2/FTC MOD ASSY.SLDASM

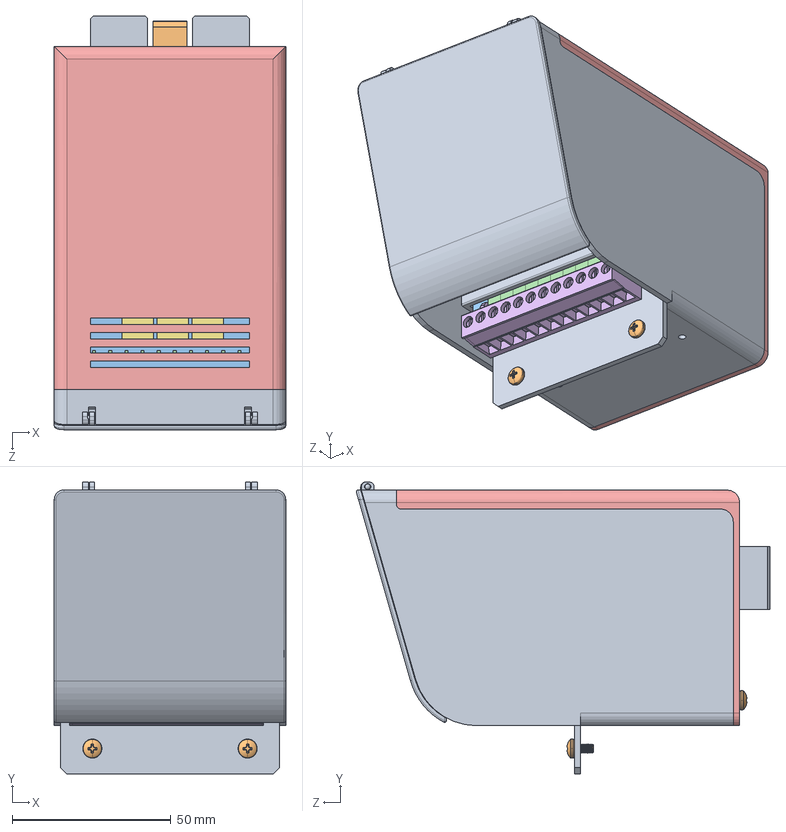
[picture p102: CAD file, 2022-06-23]
NGP_ODC_Main/PDLC/Mechanical/CCC_MECHANICAL_REV2/FTC MOD ASSY.SLDASM
72.8 x 91.9 x 130.1 mm
FTC bottom cover
FTC PCB-3
20020107-H-LEM_1 x 3
20020107-H-CM_1 x 30
20020107-H-REM_1 x 3
20020007-PLUG x 3
DS2Y-S-DC24V Relay x 16
FTC PCB-2
10052838C x 2
FTC PCB-1
EAO-1K2 switch x 6
FTC top cover
M2x5screw x 6
Standoff 16lg x 4
M3x8- x 2
Front cover
M3x5- x 4
