Sayidathahaseen/CCC_NGP_ODC/NGP_ODC_Main/PDLC/Mechanical/CCC_MECHANICAL_REV2/iopdrg- assy.SLDASM

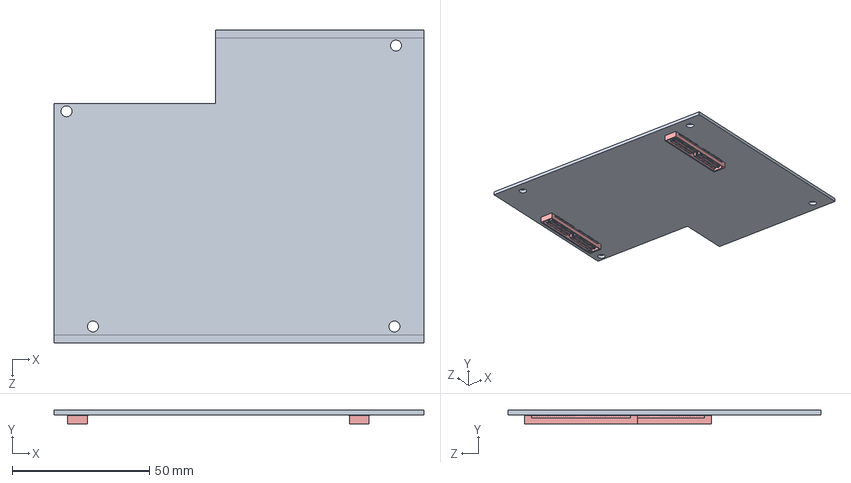
[picture p103: CAD file, 2022-06-23]
NGP_ODC_Main/PDLC/Mechanical/CCC_MECHANICAL_REV2/iopdrg- assy.SLDASM
135.0 x 4.98 x 114.3 mm
iopdgr-pcb
