Sayidathahaseen/CCC_NGP_ODC/NGP_ODC_Main/PDLC/Mechanical/CCC_MECHANICAL_REV2/SAC Assy.SLDASM

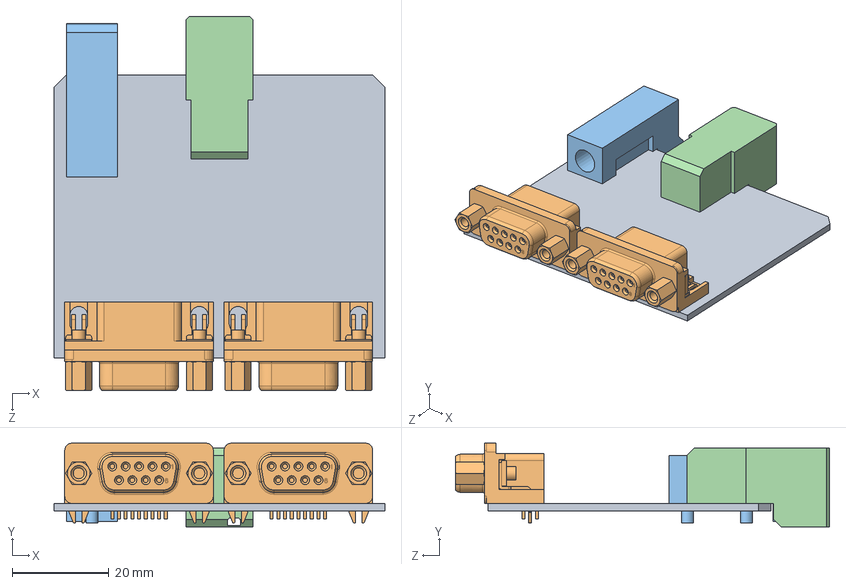
[picture p104: CAD file, 2022-06-23]
NGP_ODC_Main/PDLC/Mechanical/CCC_MECHANICAL_REV2/SAC Assy.SLDASM
68.6 x 17.4 x 77.6 mm
sacpcb1
C-1734354-2 x 2
10039851_S
