Sayidathahaseen/CCC_NGP_ODC/NGP_ODC_Main/PDLC/Mechanical/CCC_MECHANICAL_REV2/Cam lever Assy.SLDASM

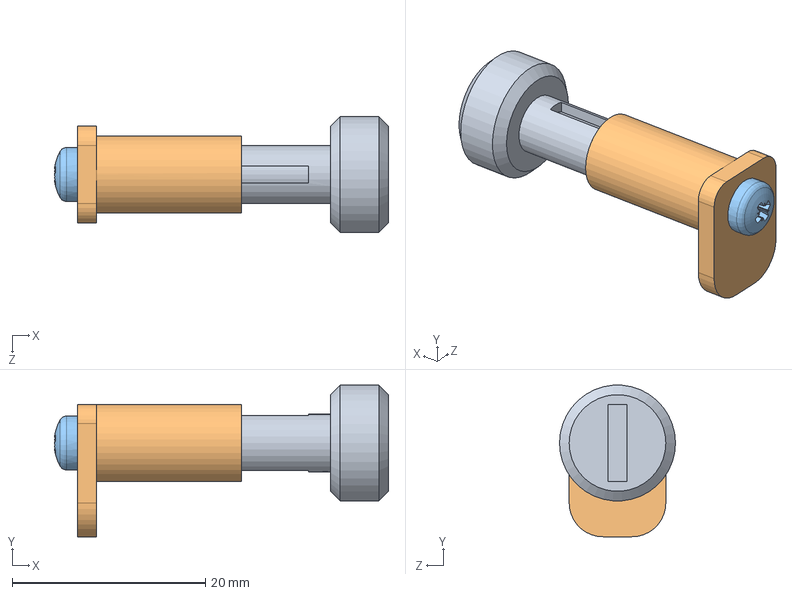
[picture p105: CAD file, 2022-06-23]
NGP_ODC_Main/PDLC/Mechanical/CCC_MECHANICAL_REV2/Cam lever Assy.SLDASM
34.6 x 15.7 x 12.0 mm
Camhead
Camlever
screw_iso_7049-st_2_9x9_5-f-z
