Sayidathahaseen/CCC_NGP_ODC/NGP_ODC_Main/PDLC/Mechanical/CCC_MECHANICAL_REV2/APP MOD ASSY_rev 2.SLDASM

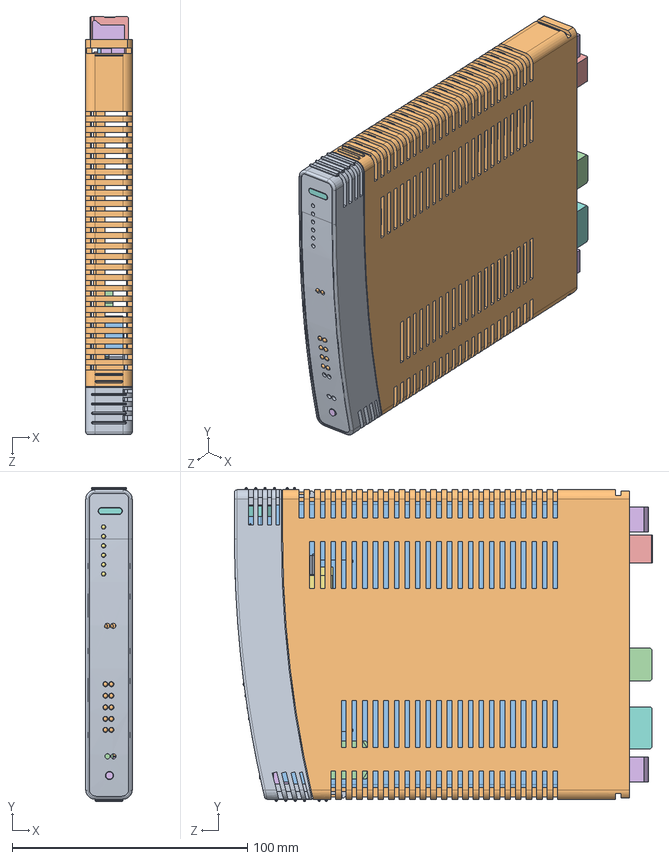
[picture p106: CAD file, 2022-06-23]
NGP_ODC_Main/PDLC/Mechanical/CCC_MECHANICAL_REV2/APP MOD ASSY_rev 2.SLDASM
19.8 x 133.7 x 177.9 mm
APP mod face plate
APP mod body
PCB-app
10039851_S
APBDA3020SURKCGKC-GX (LED) x 6
10045267_S
C16643 (smd logo)
SSF-LXH512SUGD x 7
SODIMM_MM80-204B1-E1
SMTU2430-LF
LB_LT_Y87S_Pb
TL1105
SODIMM pcb
CCC LOGO_light pipe design_2
