Sayidathahaseen/CCC_NGP_ODC/NGP_ODC_Main/PDLC/Mechanical/CCC_MECHANICAL_REV2/IOP MOD ASSY_rev2.SLDASM

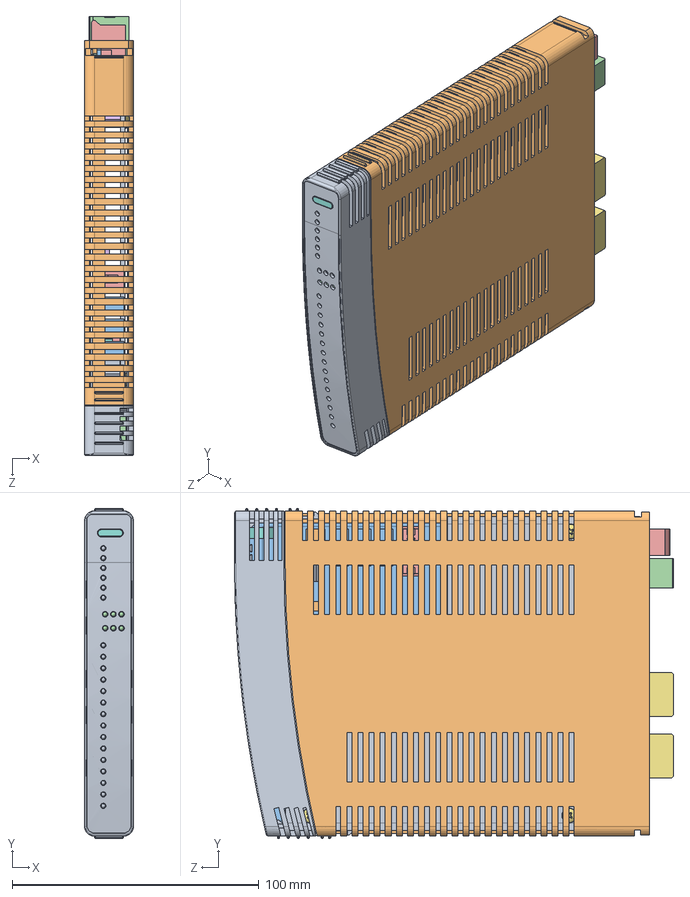
[picture p107: CAD file, 2022-06-23]
NGP_ODC_Main/PDLC/Mechanical/CCC_MECHANICAL_REV2/IOP MOD ASSY_rev2.SLDASM
19.8 x 133.7 x 177.8 mm
IOP mod face plate
IOP mod body
PCB-iop
T-1S39_-02 x 160
T-1G1-X_-02 x 4
Qte-xx-d_Formula -02 x 2
APBDA3020SURKCGKC-GX (LED) x 22
EC2-5NJ RELAY x 2
EC2-24NJ RELAY x 3
TRI-LED x 2
2510-6002UB
PVT412PBF
10045267_S x 2
C16643 (smd logo)
iopdgr-pcb
Standoff x 4
M3x5 x 8
CCC LOGO_light pipe design_2
Keying soket
