Sayidathahaseen/CCC_NGP_ODC/NGP_ODC_Main/PDLC/Mechanical/CCC_MECHANICAL_REV2/pccpcb assy.SLDASM

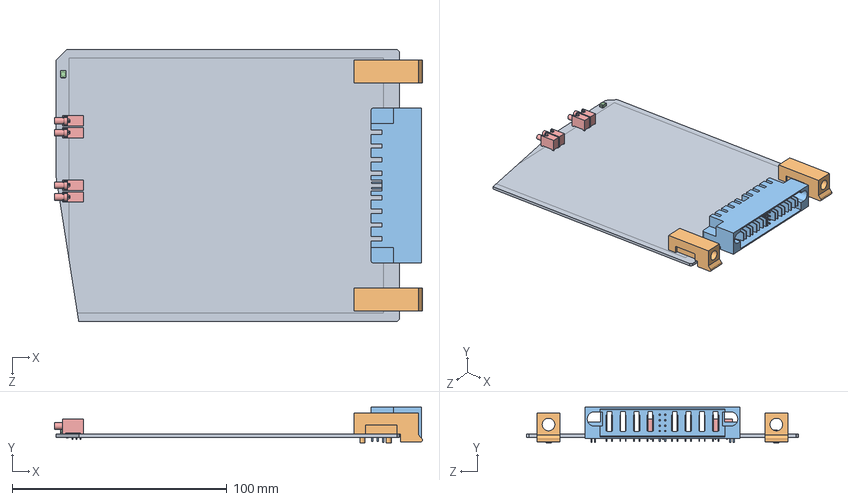
[picture p108: CAD file, 2022-06-23]
NGP_ODC_Main/PDLC/Mechanical/CCC_MECHANICAL_REV2/pccpcb assy.SLDASM
171.5 x 16.6 x 127.0 mm
PCB-pcc
51720-10400804AAC
5513508F_SW0001 x 4
