Sayidathahaseen/CCC_NGP_ODC/NGP_ODC_Main/PDLC/Mechanical/CCC_MECHANICAL_REV2/TSW-110-07-X-D.sldasm

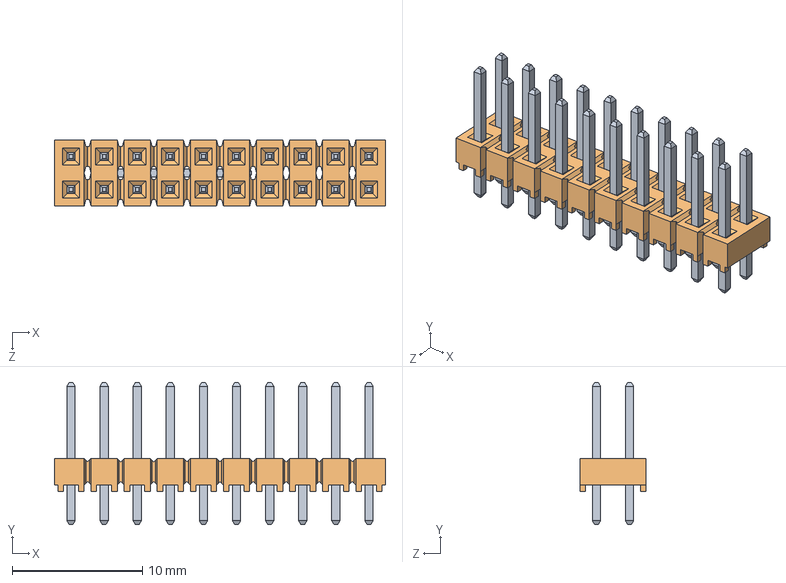
[picture p109: CAD file, 2022-06-23]
NGP_ODC_Main/PDLC/Mechanical/CCC_MECHANICAL_REV2/TSW-110-07-X-D.sldasm
25.4 x 10.9 x 5.08 mm
T-1S6 x 41
TSW-XX-D x 3
