Sayidathahaseen/CCC_NGP_ODC/NGP_ODC_Main/PDLC/Mechanical/CCC_MECHANICAL_REV2/PCC MOD ASSY.SLDASM

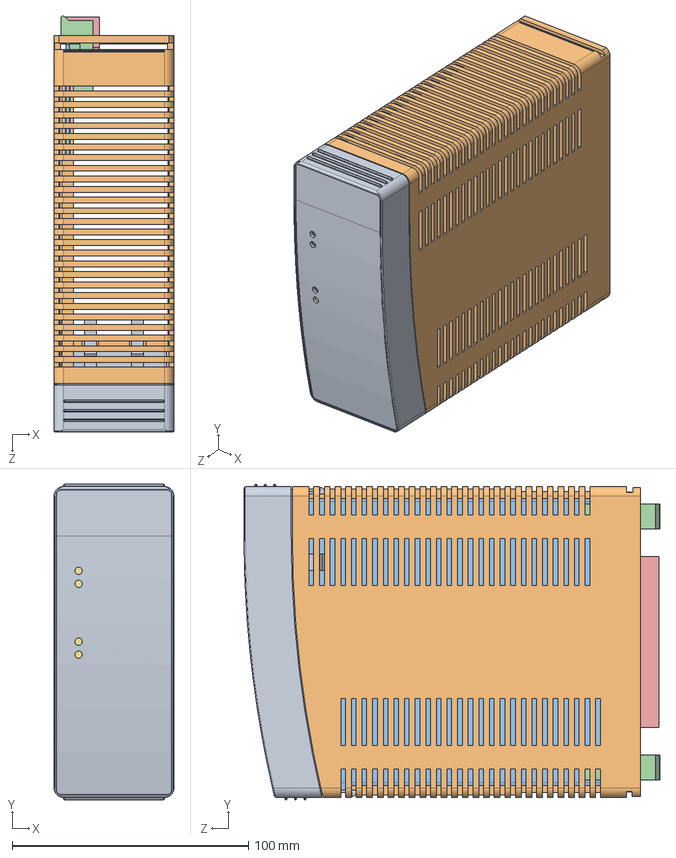
[picture p110: CAD file, 2022-06-23]
NGP_ODC_Main/PDLC/Mechanical/CCC_MECHANICAL_REV2/PCC MOD ASSY.SLDASM
50.8 x 133.7 x 176.2 mm
PCC mod face plate
PCC mod body
PCB-pcc
51720-10400804AAC
5513508F_SW0001 x 4
