Sayidathahaseen/CCC_NGP_ODC/NGP_ODC_Main/PDLC/Mechanical/CCC_MECHANICAL_REV2/IOP MOD ASSY.SLDASM

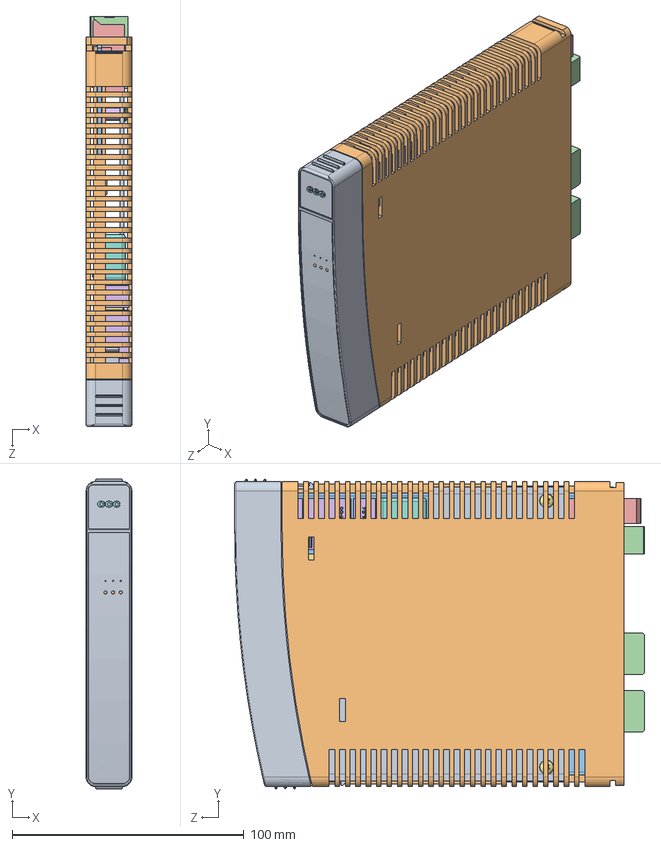
[picture p111: CAD file, 2022-06-23]
NGP_ODC_Main/PDLC/Mechanical/CCC_MECHANICAL_REV2/IOP MOD ASSY.SLDASM
19.8 x 133.7 x 177.1 mm
IOP mod face plate
IOP mod body
PCB-iop
T-1S39_-02 x 160
T-1G1-X_-02 x 4
Qte-xx-d_Formula -02 x 2
APBDA3020SURKCGKC-GX (LED) x 22
TRI-LED x 2
2510-6002UB
10045267_S x 2
C16643 (smd logo)
VWRBS2-D5-S24-SIP x 4
EC2-24NJ RELAY x 5
REC7.5-2415DRW H2 A M
processor
TLC59025IDBQR (U102)
MC78L05ABDG (U11 U53 U63 U73 U83) x 5
ADP3335ARMZ-3.3-RL
MJD31CG (Q14) x 4
ZXMN6A11GTA (Q10)
NUD3160LT1G (Q9)
SIR462DP-T1-GE3 (Q22,23,24) x 4
iopdgr-pcb
Standoff x 4
M3x5 x 8
CCC LOGO_iop-19-07
Keying soket
