Sayidathahaseen/CCC_NGP_ODC/NGP_ODC_Main/PDLC/Mechanical/NGP_CCC Final files on dt-lohiths/3D-logo/CCC_LOGO_FABDRAWING.dxf

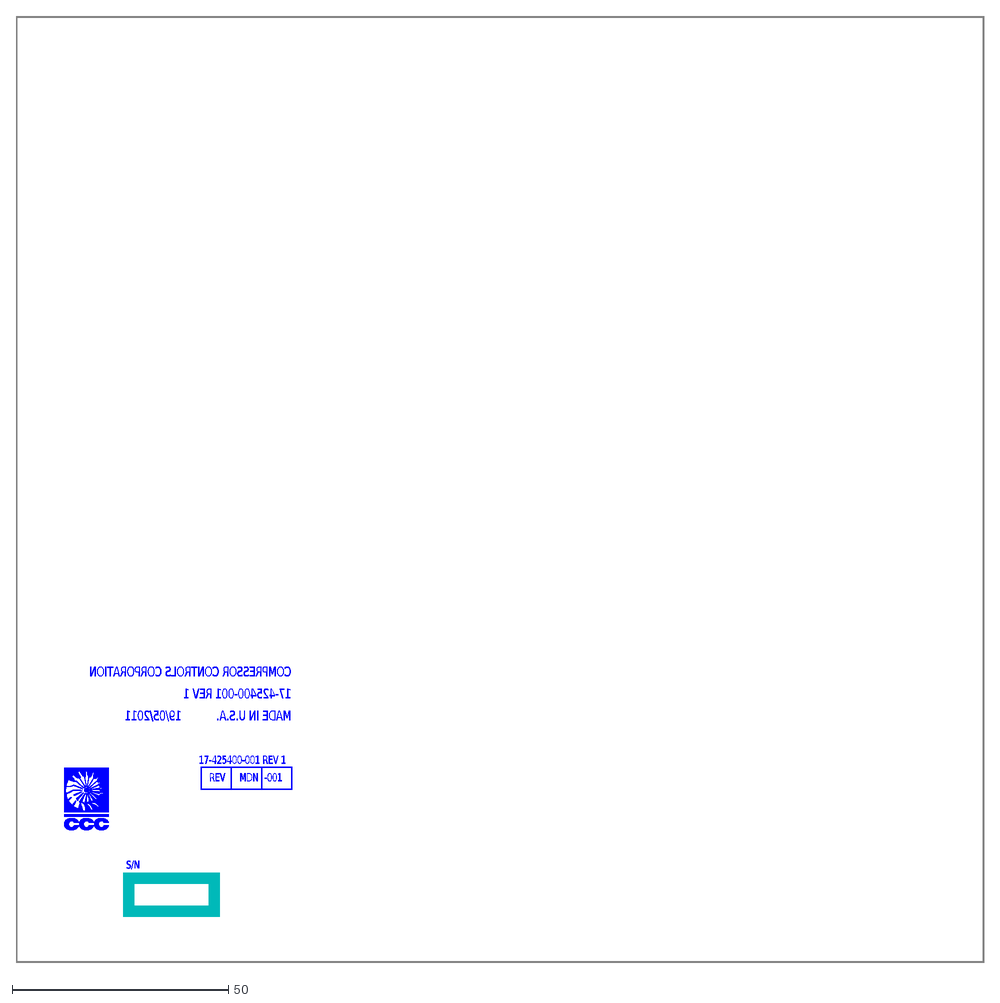
[picture p112: CAD file, 2022-06-23]
NGP_ODC_Main/PDLC/Mechanical/NGP_CCC Final files on dt-lohiths/3D-logo/CCC_LOGO_FABDRAWING.dxf
PWB FABRICATION SPECIFICATIONS
FULL BODY GOLD
180 deg Tg
THROUGH HOLES. NO EXPOSED COPPER OR TRACES AFTER MASKING.
BACK BY MORE THAN 0.005 in. NO SOLDER MASK ALLOWED ON PADS OR PLATED
THE CONDUCTIVE LAND PATTERN SHALL NOT BE MISREGISTERED FROM FRONT TO
NO
YES
BOARDS TO BE INDIVIDUALLY WRAPPED
UL
94V-2
94V-0
RUN CODE
PLACE ON BOTTOM SIDE
MANUFACTURERS LOGO
CCC SUPPLIED ASCII FILE (PADS FORMAT)
CAD/GERBER NET
GERBER NET
COMPARISON
CLAM SHELL
TEST TYPE:
SOLDER SIDE
TEST STAMP ON
100% ELECTRICALLY TESTED:
SURFACE MOUNT COMPONENTS BOTH SIDES:
OTHER
RED
YELLOW
WHITE
SILKSCREEN COLOR:
NONE
BOTH SIDES
COMPONENT SIDE
EPOXY BASED INK ONLY
SILKSCREENING:
BLACK
BLUE
GREEN
CLEAR
COLOR:
GLOSS
SEMI-GLOSS
MATT
IPC-SM-840B
IPC-SM-840A
MUST PASS
BOTH SIDES MASK
FINISH:
SMOBC-WITH PHOTO IMAGABLE ONLY
PHOTO IMAGABLE (LPI): LEA RONAL, TAIYO, CIBA, GEIGY, EPIC
WET FILM: PC401, PC501, SR1010
SOLDER MASK:
IPC A-600
0.007 PER INCH
0.005 PER INCH
BOW AND TWIST:
TOL: 0.002
0.007
0.025
0.012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
