Sayidathahaseen/CCC_NGP_ODC/NGP_ODC_Main/PDLC/Mechanical/NGP_CCC Final files on dt-lohiths/logo/logo-SW.SLDPRT

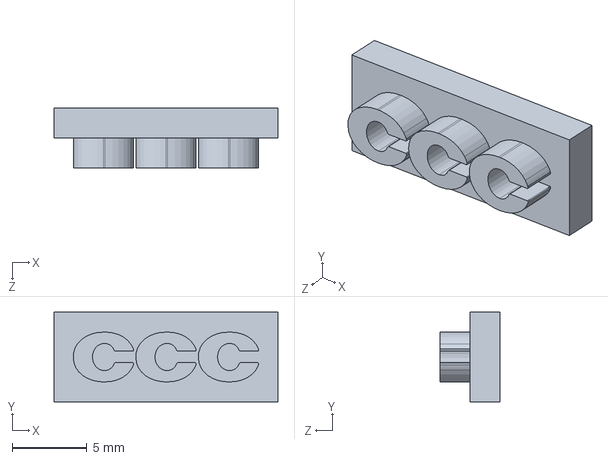
[picture p113: CAD file, 2022-06-23]
NGP_ODC_Main/PDLC/Mechanical/NGP_CCC Final files on dt-lohiths/logo/logo-SW.SLDPRT
15.0 x 6.00 x 4.00 mm
