Sayidathahaseen/CCC_NGP_ODC/NGP_ODC_Main/PDLC/Mechanical/NGP_CCC Final files on dt-lohiths/Solidworks _Final files/APP MOD/LB_LT_Y87S_Pb.SLDPRT

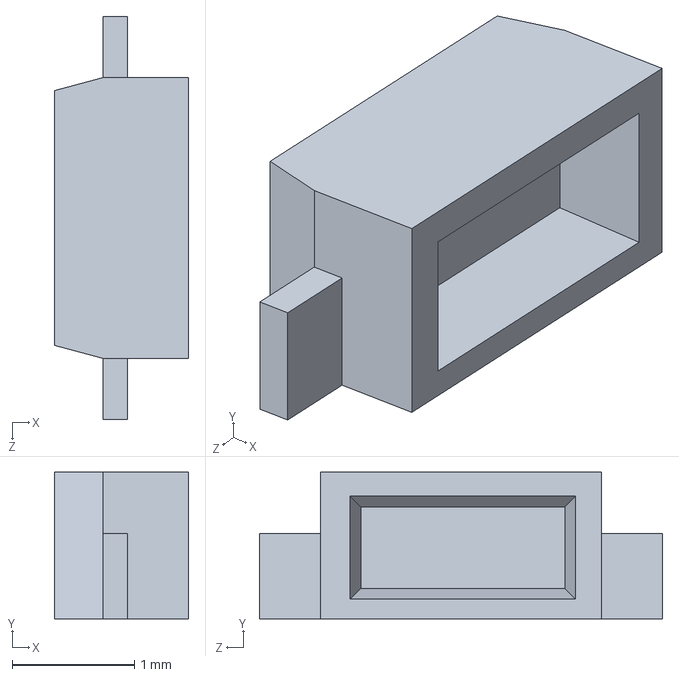
[picture p114: CAD file, 2022-06-23]
NGP_ODC_Main/PDLC/Mechanical/NGP_CCC Final files on dt-lohiths/Solidworks _Final files/APP MOD/LB_LT_Y87S_Pb.SLDPRT
1.10 x 1.20 x 3.30 mm
