Sayidathahaseen/CCC_NGP_ODC/NGP_ODC_Main/PDLC/Mechanical/NGP_CCC Final files on dt-lohiths/Solidworks _Final files/Back Plane Assy/Cam lever Assy_ECAT/Camhead_ECAT.SLDPRT

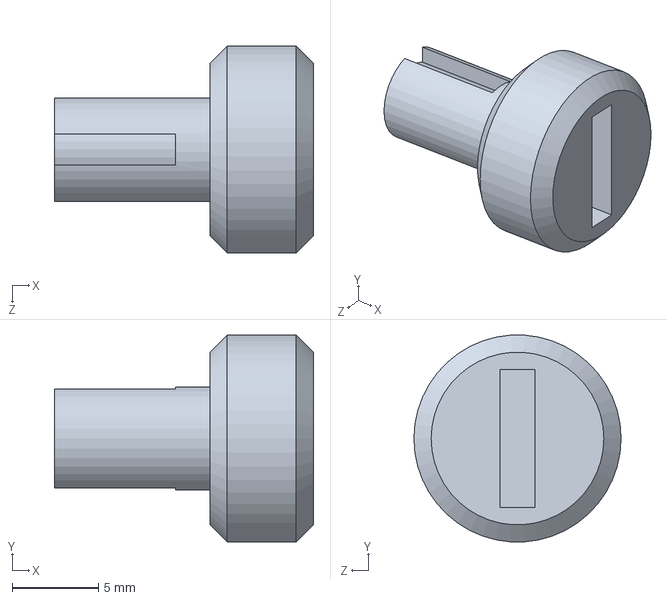
[picture p115: CAD file, 2022-06-23]
NGP_ODC_Main/PDLC/Mechanical/NGP_CCC Final files on dt-lohiths/Solidworks _Final files/Back Plane Assy/Cam lever Assy_ECAT/Camhead_ECAT.SLDPRT
15.0 x 12.0 x 12.0 mm
