Sayidathahaseen/CCC_NGP_ODC/NGP_ODC_Main/PDLC/Mechanical/NGP_CCC Final files on dt-lohiths/Solidworks _Final files/IES MOD 4-7-2011/PCB-ies.SLDPRT

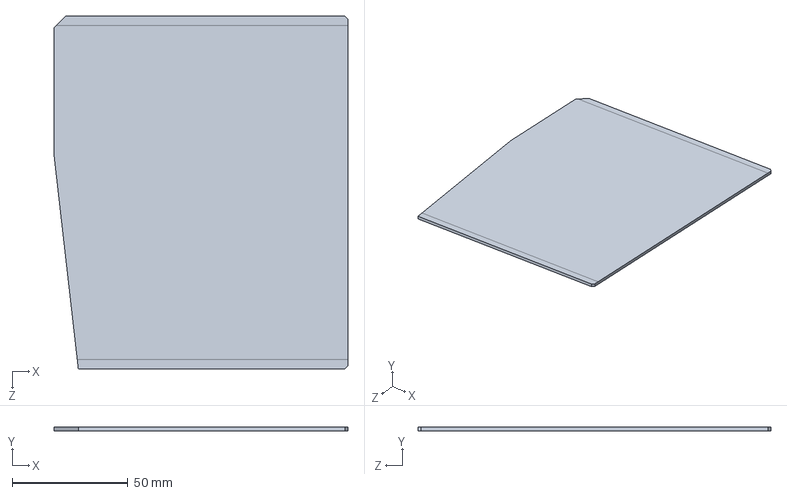
[picture p117: CAD file, 2022-06-23]
NGP_ODC_Main/PDLC/Mechanical/NGP_CCC Final files on dt-lohiths/Solidworks _Final files/IES MOD 4-7-2011/PCB-ies.SLDPRT
127.0 x 1.60 x 152.4 mm
