Sayidathahaseen/CCC_NGP_ODC/NGP_ODC_Main/PDLC/Mechanical/NGP_CCC Final files on dt-lohiths/Solidworks _Final files/Labels 21-07-2011/All labels 17-08-2011/Draw1.DXF

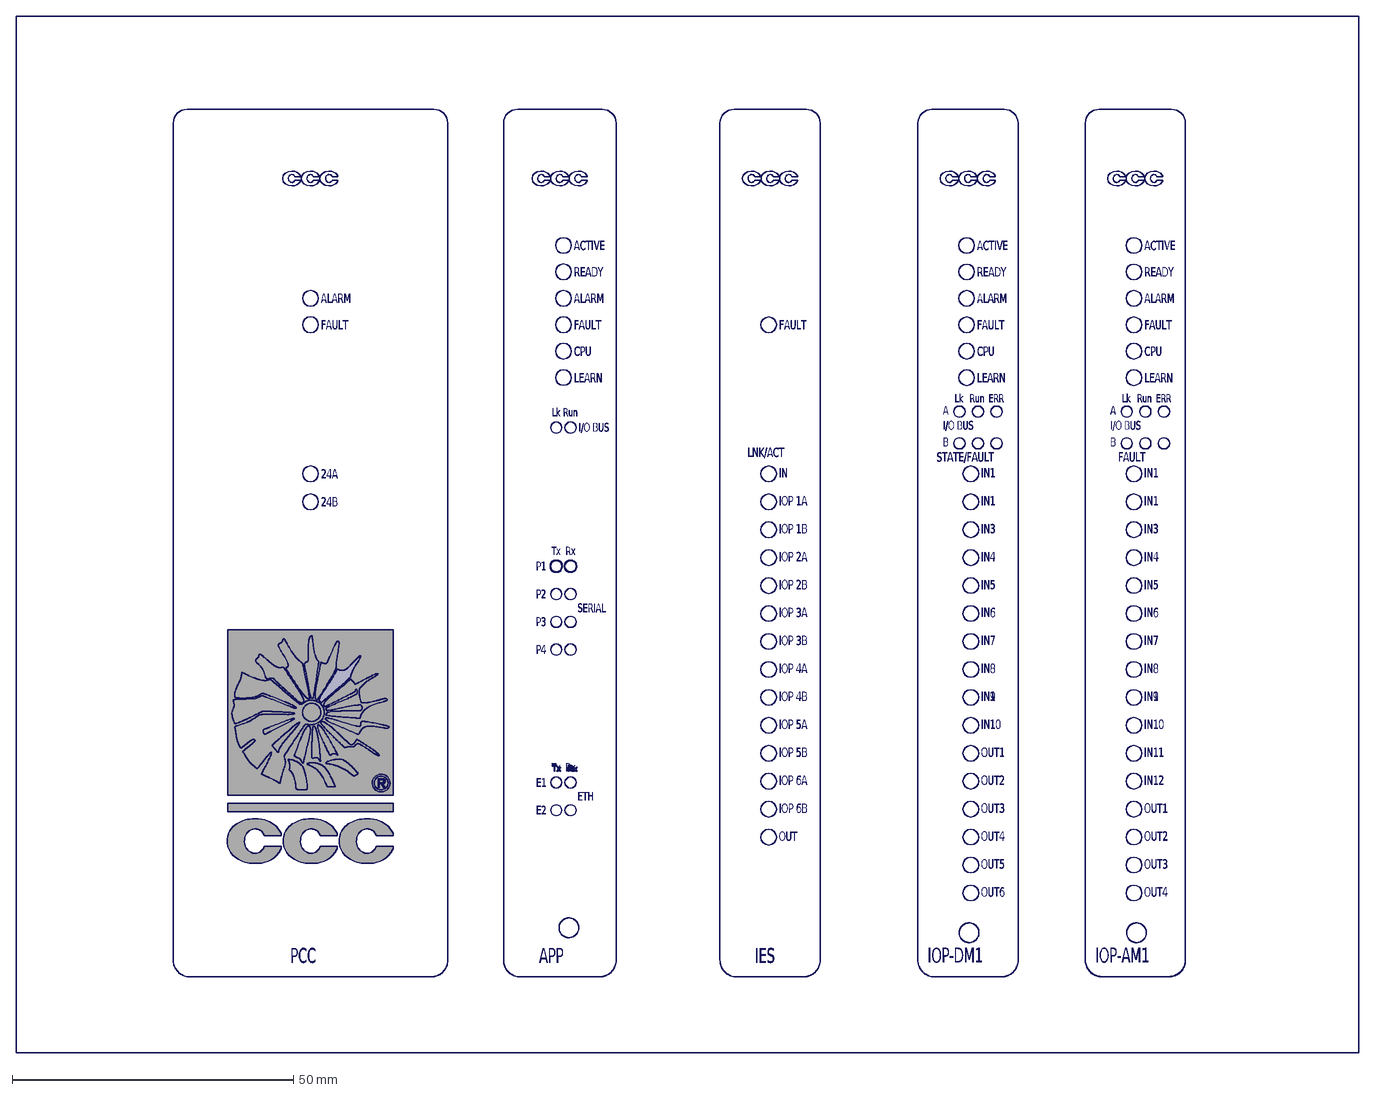
[picture p120: CAD file, 2022-06-23]
NGP_ODC_Main/PDLC/Mechanical/NGP_CCC Final files on dt-lohiths/Solidworks _Final files/Labels 21-07-2011/All labels 17-08-2011/Draw1.DXF
IOP 1A
LNK/ACT
IN
IOP 1B
IOP 2A
IOP 2B
IOP 3A
IOP 3B
IOP 4A
IOP 4B
IOP 5A
IOP 5B
IOP 6A
IOP 6B
OUT
IES
FAULT
ALARM
READY
ACTIVE
CPU
LEARN
24A
24B
IN1
IN3
IN4
IN5
IN6
IN7
IN8
IN9
IN10
OUT1
OUT2
OUT3
OUT4
OUT5
OUT6
IN11
IN12
STATE/FAULT
B
A
I/O BUS
Lk
Run
ERR
P1
Rx
Tx
P3
P2
P4
SERIAL
E2
E1
ETH
APP
PCC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
