Sayidathahaseen/CCC_NGP_ODC/NGP_ODC_Main/PDLC/Mechanical/NGP_CCC Final files on dt-lohiths/Solidworks _Final files/Labels 21-07-2011/Label-APP.SLDPRT

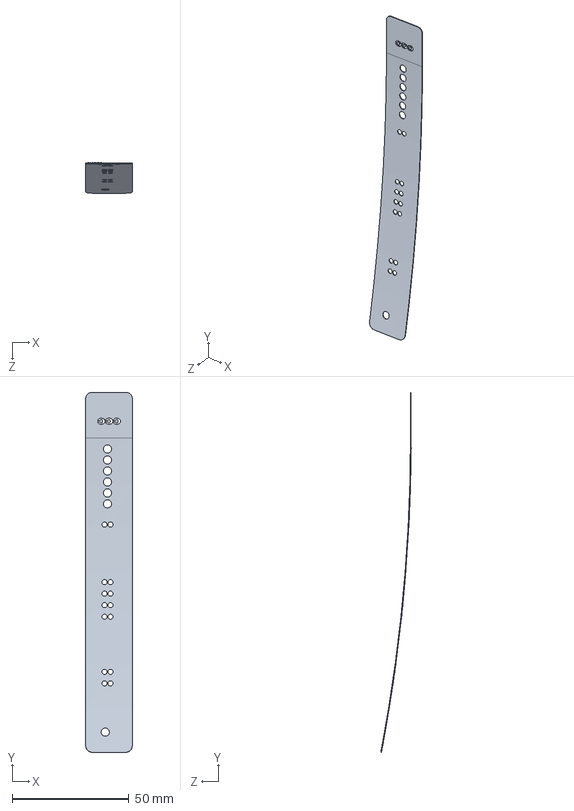
[picture p121: CAD file, 2022-06-23]
NGP_ODC_Main/PDLC/Mechanical/NGP_CCC Final files on dt-lohiths/Solidworks _Final files/Labels 21-07-2011/Label-APP.SLDPRT
20.0 x 154.2 x 13.1 mm
