Sayidathahaseen/CCC_NGP_ODC/NGP_ODC_Main/PDLC/Mechanical/NGP_CCC Final files on dt-lohiths/Solidworks _Final files/PCC MOD/Pavan/17-PCC-NGP_rev2_bottom.dxf

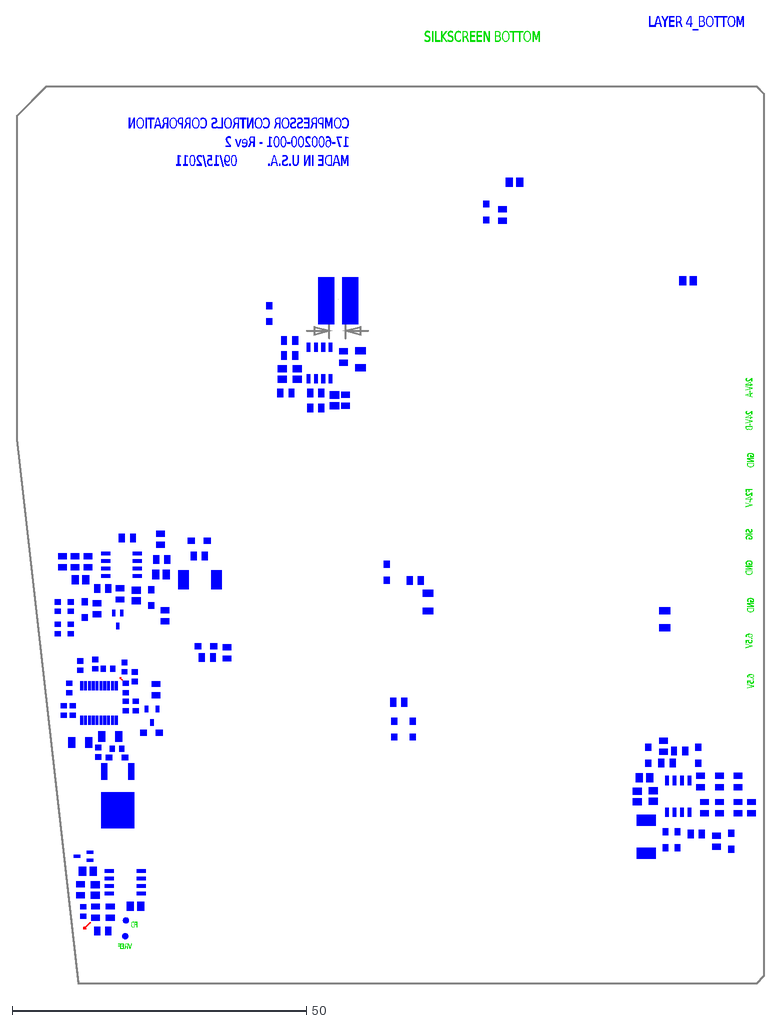
[picture p122: CAD file, 2022-06-23]
NGP_ODC_Main/PDLC/Mechanical/NGP_CCC Final files on dt-lohiths/Solidworks _Final files/PCC MOD/Pavan/17-PCC-NGP_rev2_bottom.dxf
LAYER 4_BOTTOM
COMPRESSOR CONTROLS CORPORATION
17-600200-001 - Rev 2
MADE IN U.S.A.
09/15/2011
SILKSCREEN BOTTOM
FB
VREF
F24-V
SIG
GND
6.5V
24V-B
24V-A
