Sayidathahaseen/CCC_NGP_ODC/NGP_ODC_Main/PDLC/Mechanical/NGP_CCC Final files on dt-lohiths/Solidworks _Final files/PCC MOD/PCC mod body.SLDPRT

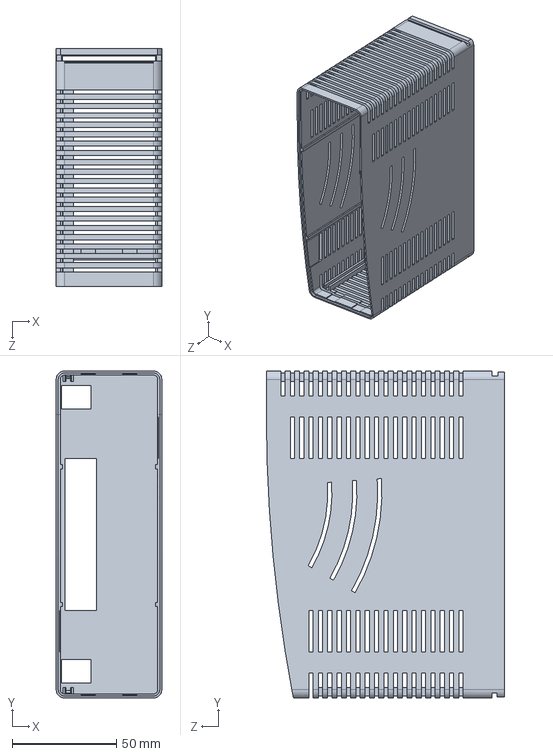
[picture p123: CAD file, 2022-06-23]
NGP_ODC_Main/PDLC/Mechanical/NGP_CCC Final files on dt-lohiths/Solidworks _Final files/PCC MOD/PCC mod body.SLDPRT
50.8 x 157.1 x 114.5 mm
