Sayidathahaseen/CCC_NGP_ODC/NGP_ODC_Main/PDLC/Mechanical/NGP_CCC Final files on dt-lohiths/Solidworks _Final files/PCC MOD/Vijay -Heat sink/Heatsink_INSULATORS_DWG.dxf

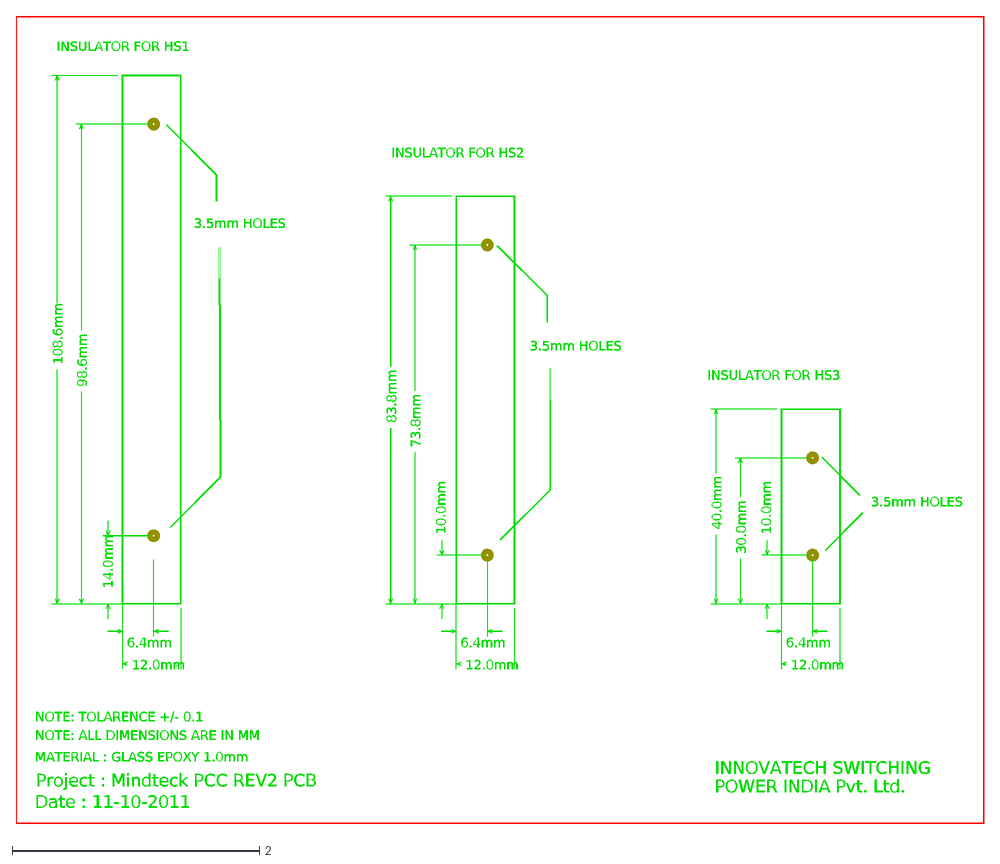
[picture p124: CAD file, 2022-06-23]
NGP_ODC_Main/PDLC/Mechanical/NGP_CCC Final files on dt-lohiths/Solidworks _Final files/PCC MOD/Vijay -Heat sink/Heatsink_INSULATORS_DWG.dxf
INSULATOR FOR HS1
INNOVATECH SWITCHING
POWER INDIA Pvt. Ltd.
MATERIAL : GLASS EPOXY 1.0mm
NOTE: TOLARENCE +/- 0.1
3.5mm HOLES
NOTE: ALL DIMENSIONS ARE IN MM
Project : Mindteck PCC REV2 PCB
INSULATOR FOR HS2
INSULATOR FOR HS3
Date : 11-10-2011
98.6mm
108.6mm
12.0mm
14.0mm
6.4mm
73.8mm
83.8mm
10.0mm
30.0mm
40.0mm
