Sayidathahaseen/CCC_NGP_ODC/NGP_ODC_Main/PDLC/Mechanical/NGP_CCC Final files on dt-lohiths/Solidworks _Final files/SAC-03-8-2011/Front cover_SAC.SLDPRT

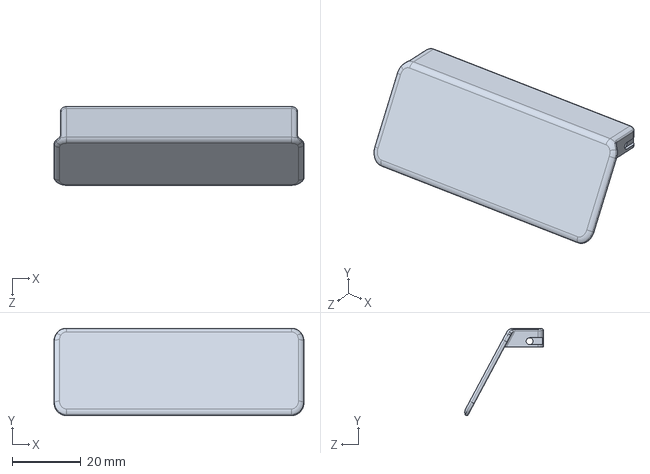
[picture p125: CAD file, 2022-06-23]
NGP_ODC_Main/PDLC/Mechanical/NGP_CCC Final files on dt-lohiths/Solidworks _Final files/SAC-03-8-2011/Front cover_SAC.SLDPRT
72.9 x 25.5 x 22.9 mm
