Sayidathahaseen/CCC_NGP_ODC/NGP_ODC_Main/PDLC/Mechanical/NGP_CCC Final files on dt-lohiths/Solidworks _Final files/SAC/Pavan 03-08-2011/ecat_emn&dxf/CCCNGP_ECAT_REV1.0_bottom.dxf

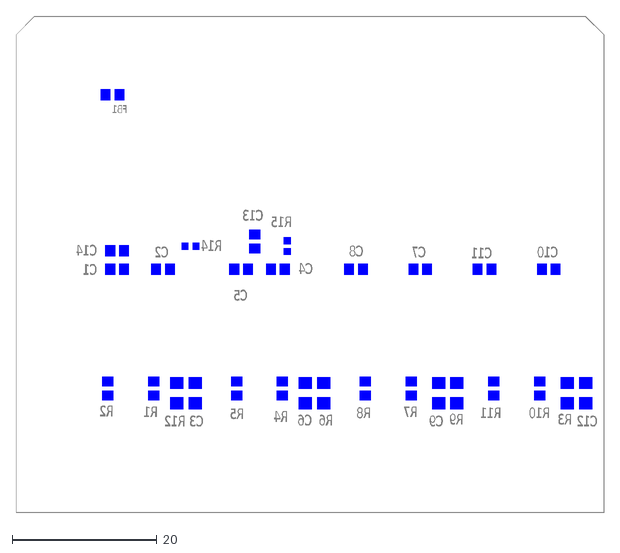
[picture p126: CAD file, 2022-06-23]
NGP_ODC_Main/PDLC/Mechanical/NGP_CCC Final files on dt-lohiths/Solidworks _Final files/SAC/Pavan 03-08-2011/ecat_emn&dxf/CCCNGP_ECAT_REV1.0_bottom.dxf
R1
R2
C3
R12
R4
R5
C6
R6
R7
R8
C9
R9
R10
R11
C12
R3
R14
R15
C13
C14
FB1
C1
C10
C11
C2
C4
C5
C7
C8
