Sayidathahaseen/CCC_NGP_ODC/NGP_ODC_Main/PDLC/Mechanical/NGP_CCC Final files on dt-lohiths/Solidworks _Final files/SAC/Pavan 03-08-2011/eec_emn&dxf/CCCNGP_EEC_REV1 0_top.dxf

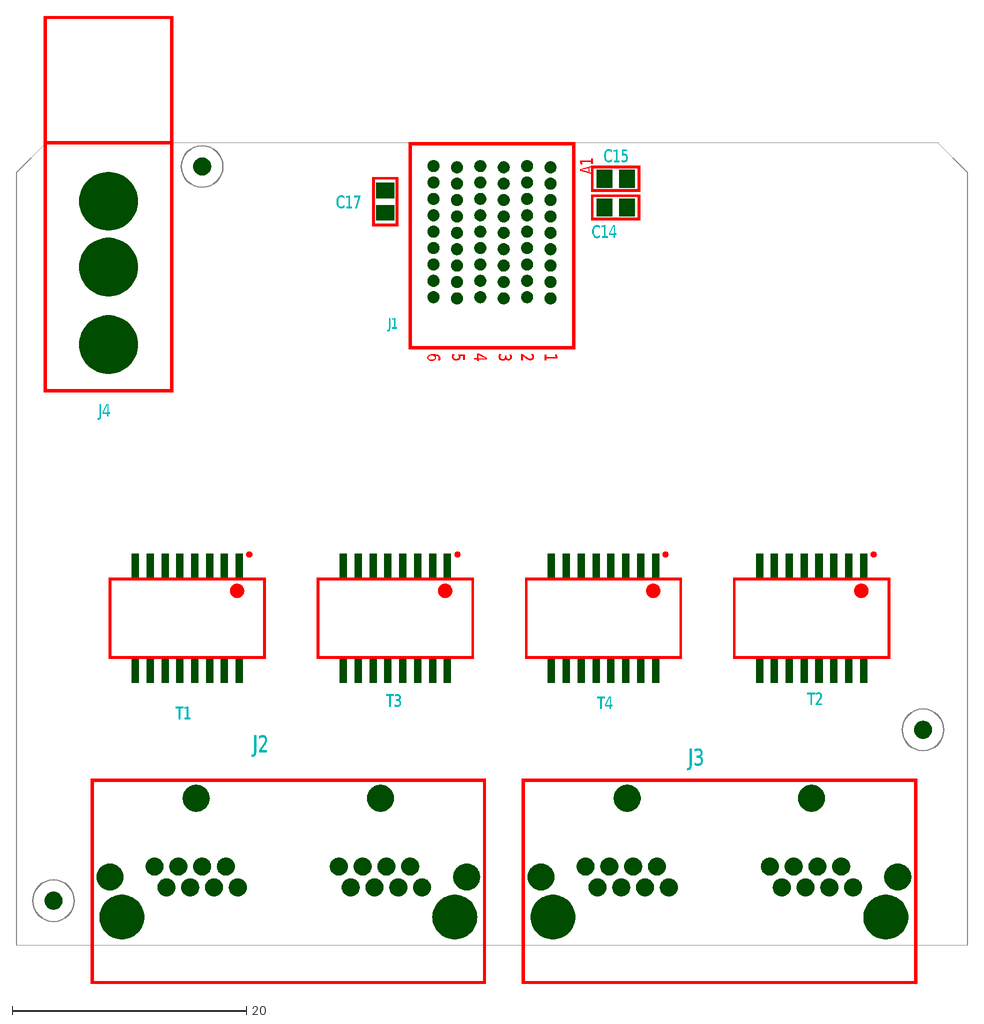
[picture p127: CAD file, 2022-06-23]
NGP_ODC_Main/PDLC/Mechanical/NGP_CCC Final files on dt-lohiths/Solidworks _Final files/SAC/Pavan 03-08-2011/eec_emn&dxf/CCCNGP_EEC_REV1 0_top.dxf
T1
T2
T3
T4
J3
J2
J4
1
A1
6
5
4
3
2
J1
C14
C15
C17
