Sayidathahaseen/CCC_NGP_ODC/NGP_ODC_Main/PDLC/Mechanical/NGP_CCC Final files on dt-lohiths/Solidworks _Final files/SAC/Pavan 03-08-2011/modbus_emn&dxf/CCCNGP_MODBUS_REV1.0_bottom.dxf

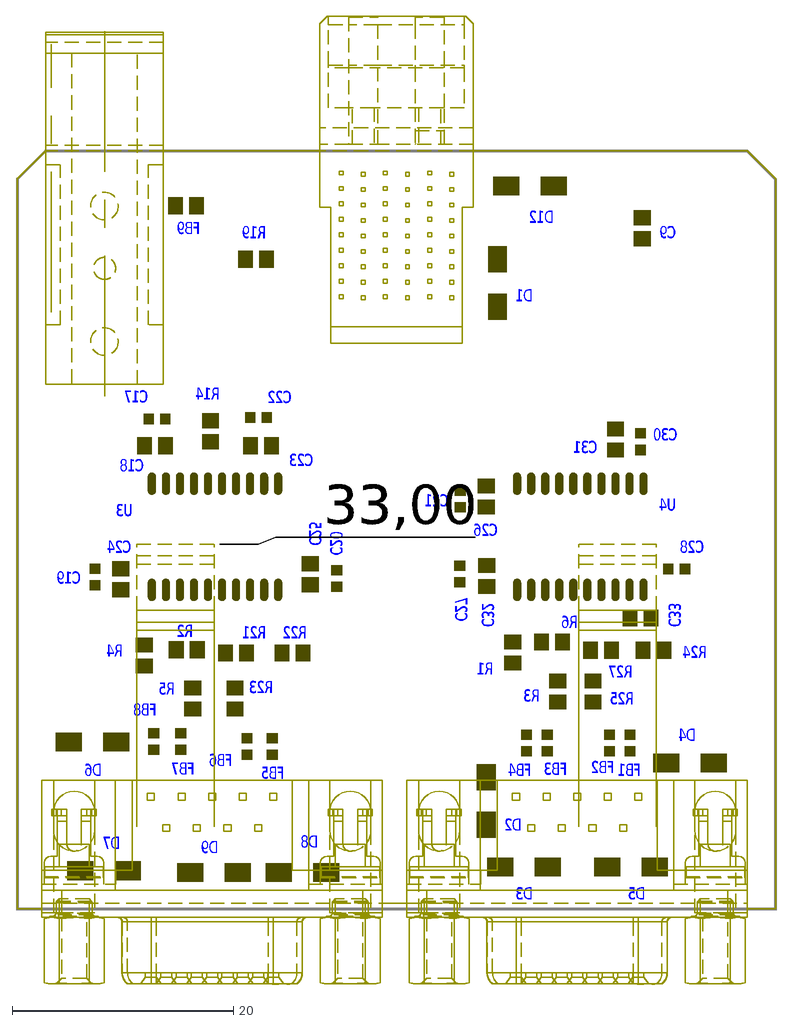
[picture p128: CAD file, 2022-06-23]
NGP_ODC_Main/PDLC/Mechanical/NGP_CCC Final files on dt-lohiths/Solidworks _Final files/SAC/Pavan 03-08-2011/modbus_emn&dxf/CCCNGP_MODBUS_REV1.0_bottom.dxf
U4
U3
C21
C30
C27
C28
C17
C22
C19
C20
C18
C23
C24
C25
C26
C31
C32
C33
FB1
FB2
FB3
FB4
FB5
FB6
FB7
FB8
R14
R19
R2
R21
R27
R6
C9
R1
R4
R23
R22
R25
R3
R24
R5
FB9
D1
D12
D2
D3
D5
D4
D8
D9
D7
D6
33,00
