Sayidathahaseen/CCC_NGP_ODC/NGP_ODC_Main/PDLC/Mechanical/NGP_CCC Final files on dt-lohiths/thermal/APP MOD/SMLXR851USBC-TR.SLDPRT

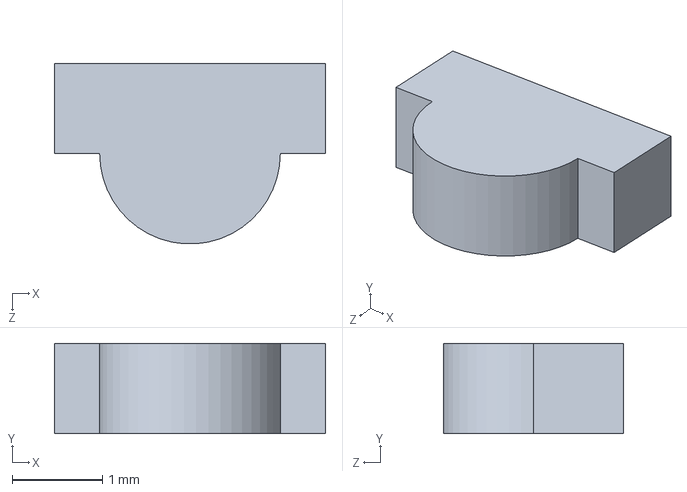
[picture p130: CAD file, 2022-06-23]
NGP_ODC_Main/PDLC/Mechanical/NGP_CCC Final files on dt-lohiths/thermal/APP MOD/SMLXR851USBC-TR.SLDPRT
3.00 x 1.00 x 2.00 mm
