Sayidathahaseen/CCC_NGP_ODC/NGP_ODC_Main/PDLC/Mechanical/NGP_CCC Final files on dt-lohiths/thermal/IES MOD 4-7-2011/CCC LOGO_ies.SLDPRT

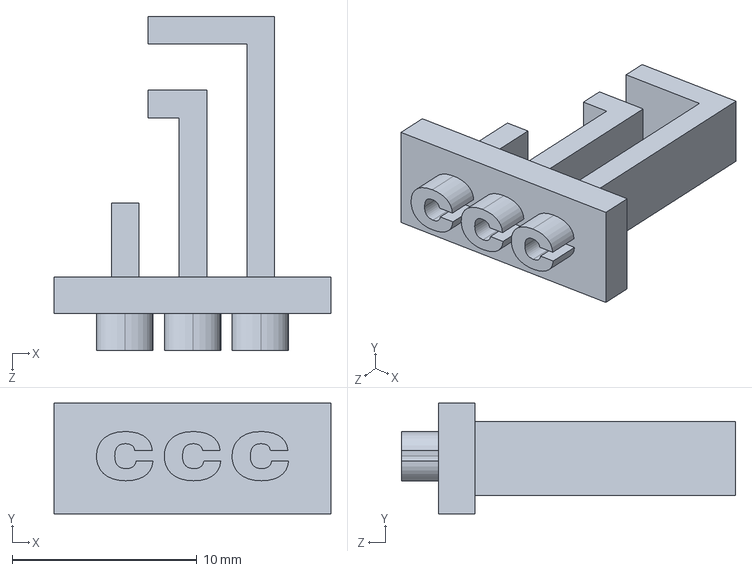
[picture p131: CAD file, 2022-06-23]
NGP_ODC_Main/PDLC/Mechanical/NGP_CCC Final files on dt-lohiths/thermal/IES MOD 4-7-2011/CCC LOGO_ies.SLDPRT
15.0 x 6.00 x 18.1 mm
