Sayidathahaseen/CCC_NGP_ODC/NGP_ODC_Main/PDLC/Mechanical/NGP_CCC Final files on dt-lohiths/thermal/IOP Module/iopdgr-pcb.SLDPRT

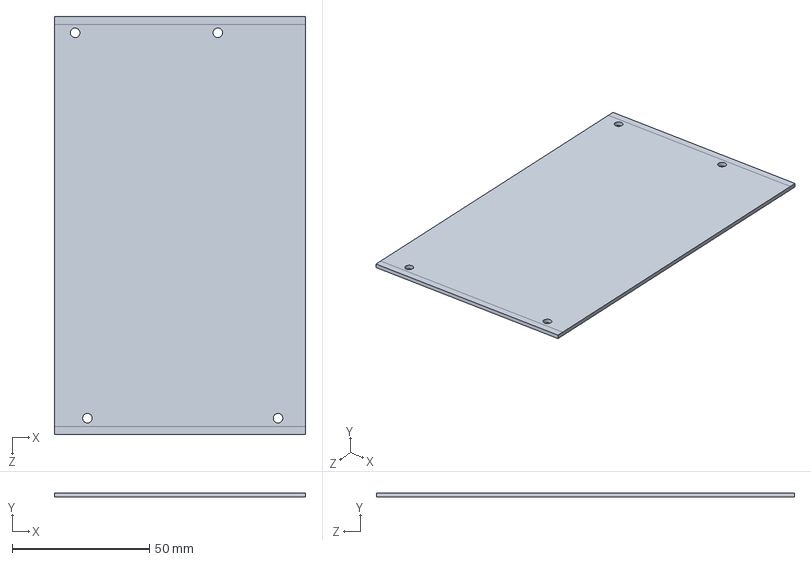
[picture p132: CAD file, 2022-06-23]
NGP_ODC_Main/PDLC/Mechanical/NGP_CCC Final files on dt-lohiths/thermal/IOP Module/iopdgr-pcb.SLDPRT
91.4 x 1.60 x 152.4 mm
