Sayidathahaseen/CCC_NGP_ODC/NGP_ODC_Main/PDLC/Mechanical/NGP_CCC Final files on dt-lohiths/thermal/PCC MOD/PCC mod body.SLDPRT

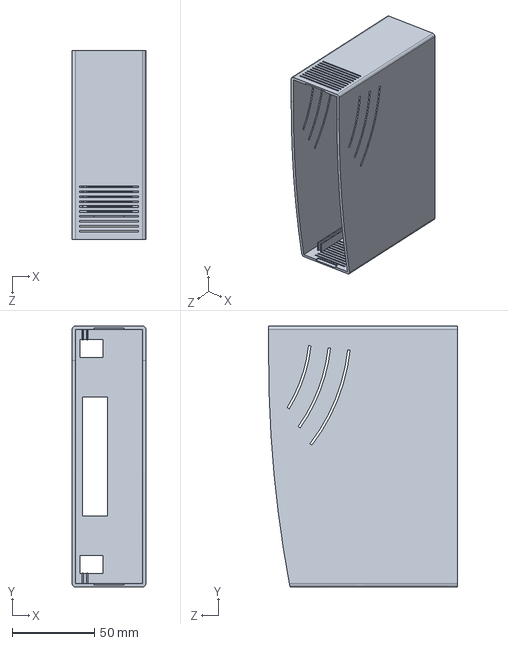
[picture p133: CAD file, 2022-06-23]
NGP_ODC_Main/PDLC/Mechanical/NGP_CCC Final files on dt-lohiths/thermal/PCC MOD/PCC mod body.SLDPRT
45.0 x 159.1 x 115.0 mm
