Sayidathahaseen/CCC_NGP_ODC/NGP_ODC_Main/PDLC/Mechanical/NGP_CCC Final files on dt-lohiths/thermal/SAC/Sac cover-front.SLDPRT

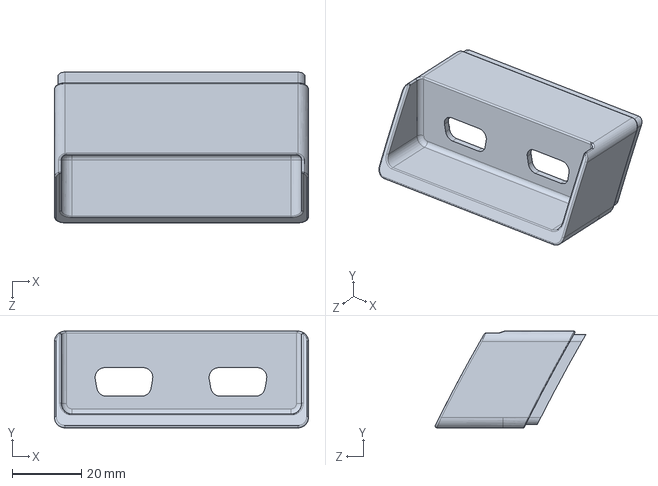
[picture p134: CAD file, 2022-06-23]
NGP_ODC_Main/PDLC/Mechanical/NGP_CCC Final files on dt-lohiths/thermal/SAC/Sac cover-front.SLDPRT
73.6 x 28.0 x 43.7 mm
