Sayidathahaseen/CCC_NGP_ODC/NGP_ODC_Main/PDLC/Mechanical/CCC_MECHANICAL_REV2/2510-6002UB .SLDPRT

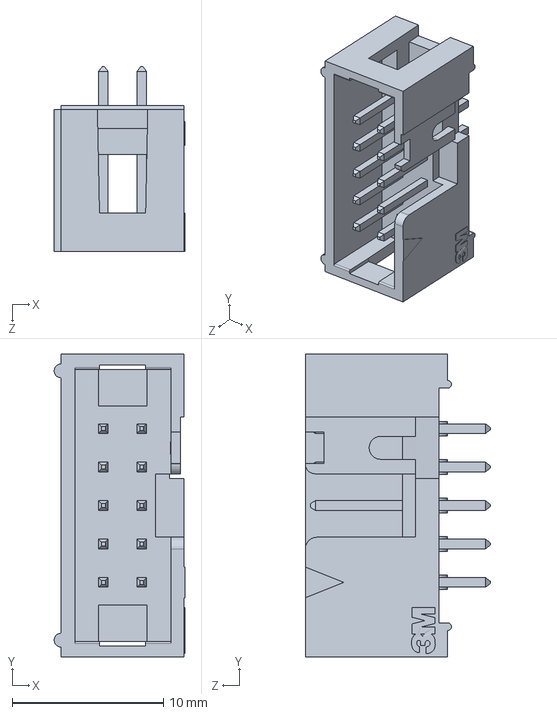
[picture p135: CAD file, 2022-06-23]
NGP_ODC_Main/PDLC/Mechanical/CCC_MECHANICAL_REV2/2510-6002UB .SLDPRT
8.64 x 20.0 x 12.2 mm
