Sayidathahaseen/CCC_NGP_ODC/NGP_ODC_Main/PDLC/Mechanical/NGP_CCC Final files on dt-lohiths/Solidworks _Final files/Back Plane Assy/Cam lever Assy_ECAT/Camlever_ECAT.SLDPRT

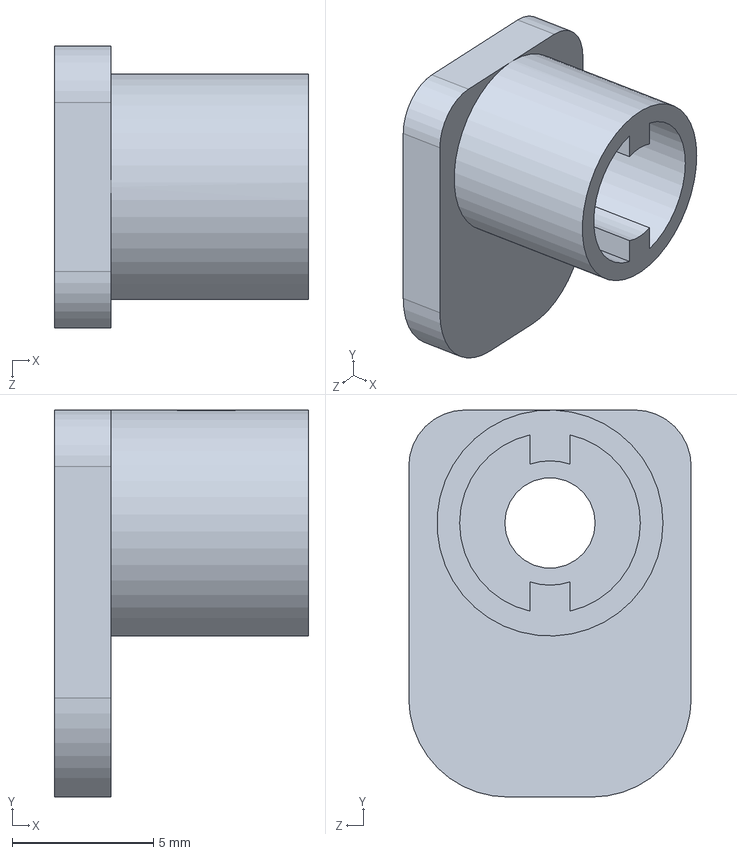
[picture p136: CAD file, 2022-06-23]
NGP_ODC_Main/PDLC/Mechanical/NGP_CCC Final files on dt-lohiths/Solidworks _Final files/Back Plane Assy/Cam lever Assy_ECAT/Camlever_ECAT.SLDPRT
9.00 x 13.7 x 10.0 mm
