Sayidathahaseen/CCC_NGP_ODC/NGP_ODC_Main/PDLC/Mechanical/NGP_CCC Final files on dt-lohiths/Solidworks _Final files/PCC MOD/Pavan/17-PCC-NGP_rev2_top.dxf

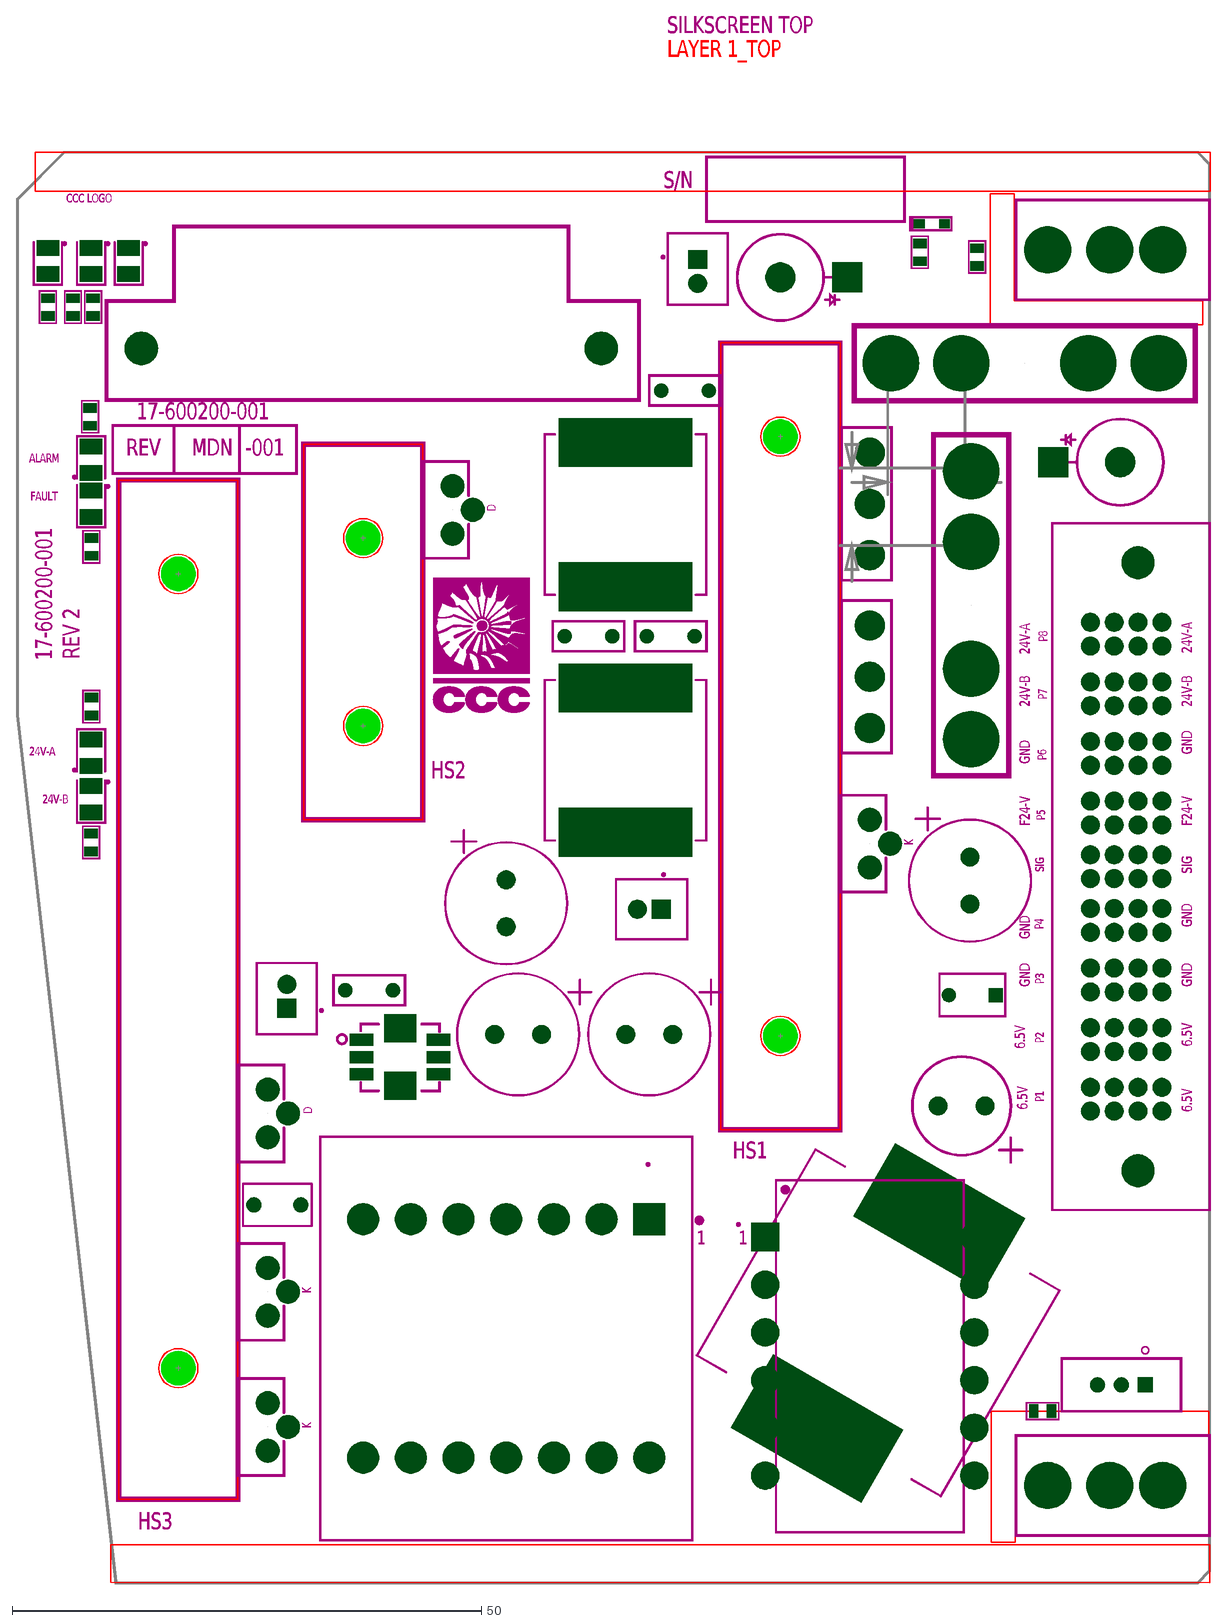
[picture p138: CAD file, 2022-06-23]
NGP_ODC_Main/PDLC/Mechanical/NGP_CCC Final files on dt-lohiths/Solidworks _Final files/PCC MOD/Pavan/17-PCC-NGP_rev2_top.dxf
24V-A
GND
F24-V
SIG
6.5V
24V-B
LAYER 1_TOP
S/N
REV
MDN
-001
17-600200-001
REV 2
SILKSCREEN TOP
HS1
HS2
HS3
ALARM
FAULT
CCC LOGO
1
D
K
P1
P2
P3
P4
P5
P6
P7
P8
