Sayidathahaseen/CCC_NGP_ODC/NGP_ODC_Main/PDLC/Mechanical/NGP_CCC Final files on dt-lohiths/Solidworks _Final files/PCC MOD/Vijay -Heat sink/Heatsink_HS1.dxf

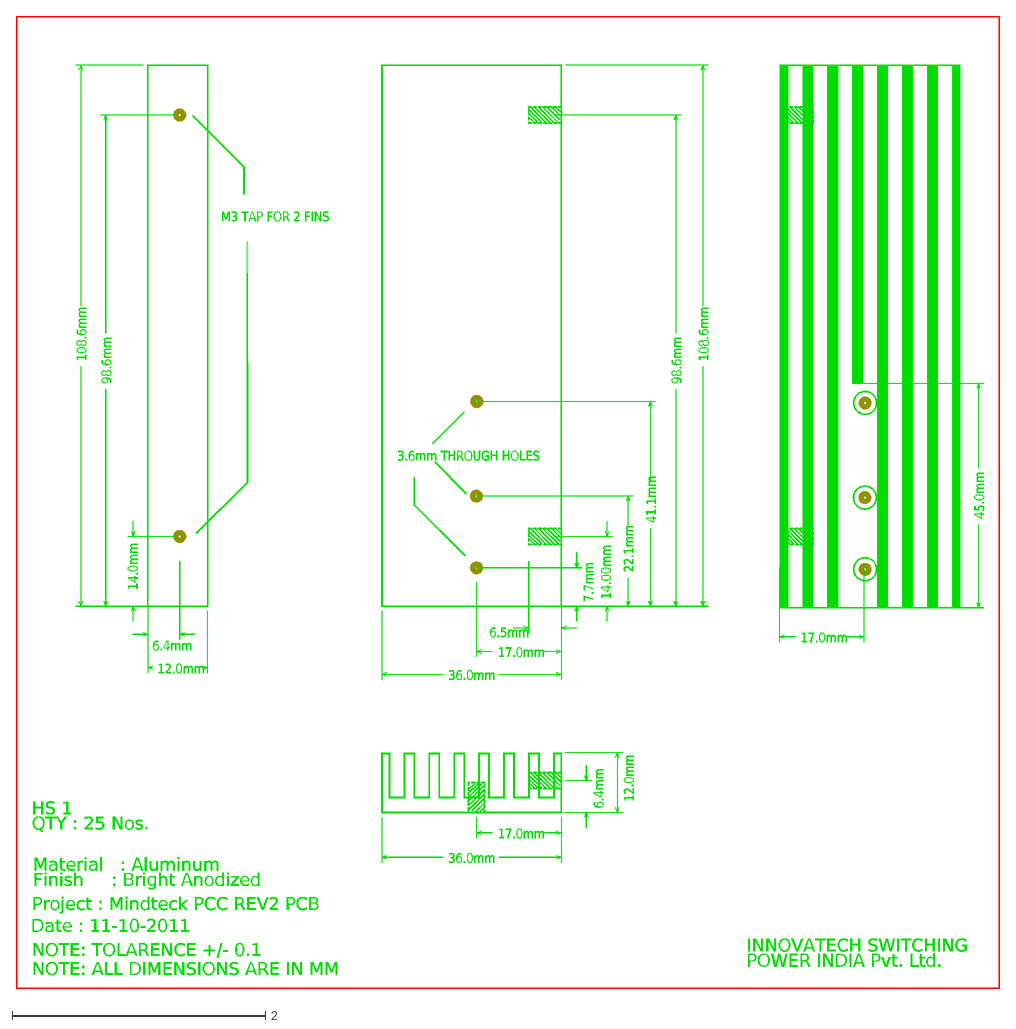
[picture p139: CAD file, 2022-06-23]
NGP_ODC_Main/PDLC/Mechanical/NGP_CCC Final files on dt-lohiths/Solidworks _Final files/PCC MOD/Vijay -Heat sink/Heatsink_HS1.dxf
Date : 11-10-2011
Project : Mindteck PCC REV2 PCB
HS 1
QTY : 25 Nos.
Material : Aluminum
Finish : Bright Anodized
INNOVATECH SWITCHING
POWER INDIA Pvt. Ltd.
M3 TAP FOR 2 FINS
NOTE: TOLARENCE +/- 0.1
NOTE: ALL DIMENSIONS ARE IN MM
3.6mm THROUGH HOLES
17.0mm
12.0mm
41.1mm
14.00mm
36.0mm
98.6mm
108.6mm
6.4mm
14.0mm
7.7mm
45.0mm
6.5mm
22.1mm
