Sayidathahaseen/CCC_NGP_ODC/NGP_ODC_Main/PDLC/Mechanical/NGP_CCC Final files on dt-lohiths/Solidworks _Final files/SAC/Pavan 03-08-2011/ecat_emn&dxf/CCCNGP_ECAT_REV1.0.dxf

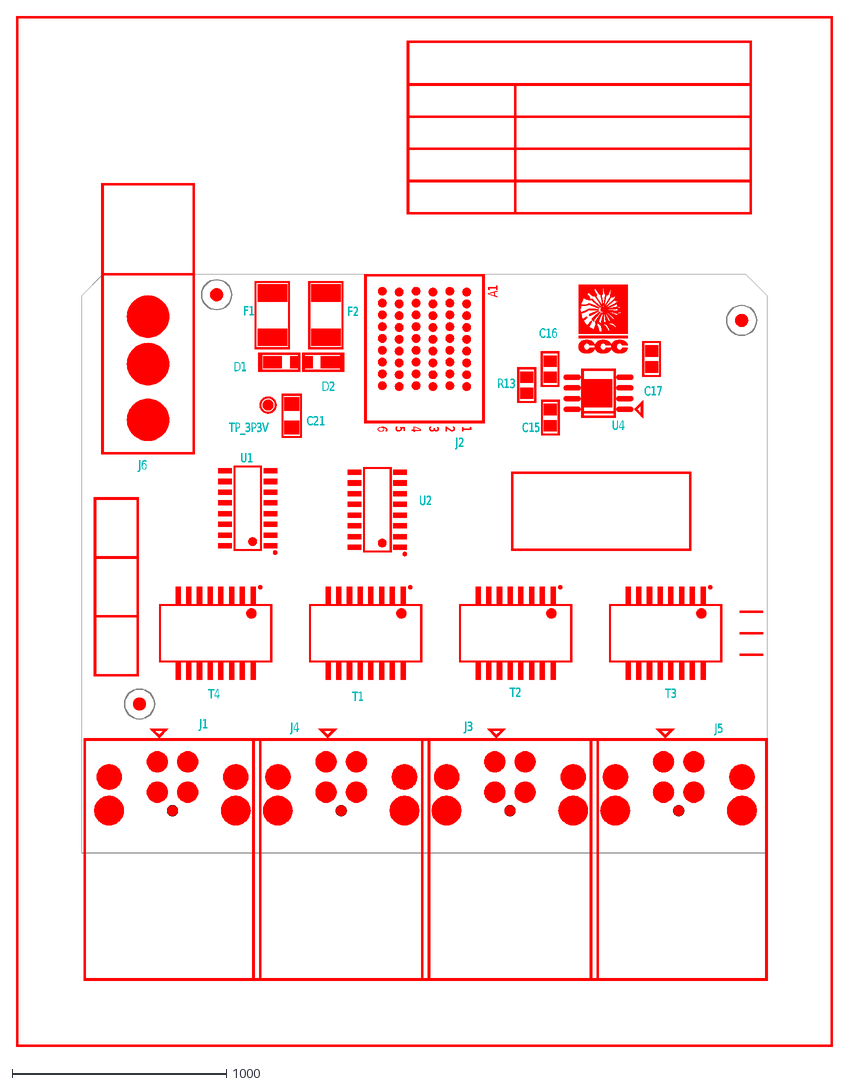
[picture p140: CAD file, 2022-06-23]
NGP_ODC_Main/PDLC/Mechanical/NGP_CCC Final files on dt-lohiths/Solidworks _Final files/SAC/Pavan 03-08-2011/ecat_emn&dxf/CCCNGP_ECAT_REV1.0.dxf
T4
T1
T2
T3
J4
J1
J3
C21
J5
F1
F2
TP_3P3V
R13
D1
D2
U1
U2
U4
C15
J6
1
2
3
4
5
6
A1
J2
C16
C17
