Sayidathahaseen/CCC_NGP_ODC/NGP_ODC_Main/PDLC/Mechanical/NGP_CCC Final files on dt-lohiths/Solidworks _Final files/SAC/Pavan 03-08-2011/modbus_emn&dxf/CCCNGP_MODBUS_REV1.0_top.dxf

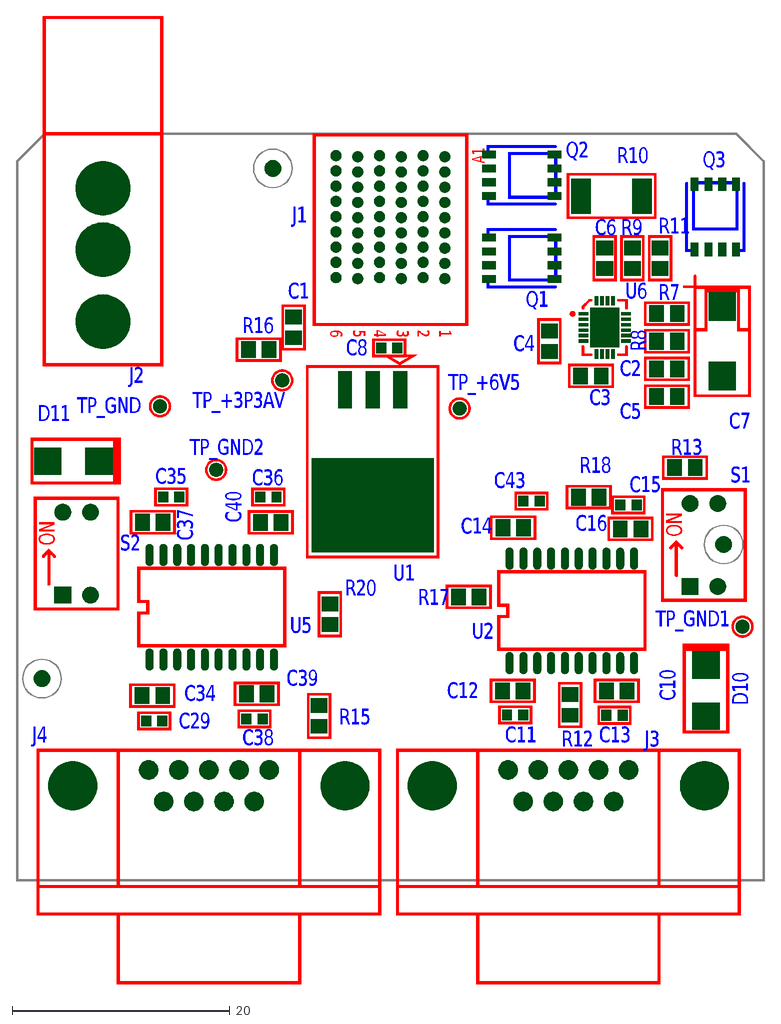
[picture p142: CAD file, 2022-06-23]
NGP_ODC_Main/PDLC/Mechanical/NGP_CCC Final files on dt-lohiths/Solidworks _Final files/SAC/Pavan 03-08-2011/modbus_emn&dxf/CCCNGP_MODBUS_REV1.0_top.dxf
U1
U2
TP_+3P3AV
TP_+6V5
J3
R7
C11
U5
C13
C43
C15
C29
C38
C35
C36
R8
R9
R10
R11
J4
TP_GND
TP_GND1
TP_GND2
ON
S1
S2
C7
C1
C10
C12
C14
C16
C34
C37
C39
C40
R12
R13
R15
R16
R17
R18
R20
C8
C2
J2
C3
C4
C5
C6
1
A1
6
5
4
3
2
J1
Q1
Q2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
