Sayidathahaseen/CCC_NGP_ODC/NGP_ODC_Main/PDLC/Mechanical/NGP_CCC Final files on dt-lohiths/thermal/ECAT/43K1A542.SLDPRT

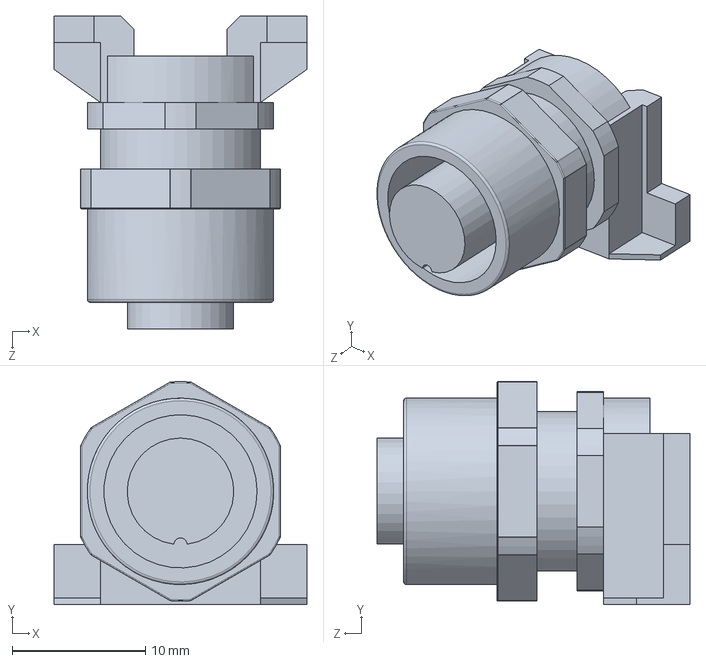
[picture p144: CAD file, 2022-06-23]
NGP_ODC_Main/PDLC/Mechanical/NGP_CCC Final files on dt-lohiths/thermal/ECAT/43K1A542.SLDPRT
19.0 x 16.8 x 23.5 mm
