Sayidathahaseen/CCC_NGP_ODC/NGP_ODC_Main/PDLC/Mechanical/NGP_CCC Final files on dt-lohiths/thermal/EEC/Eec cover.SLDPRT

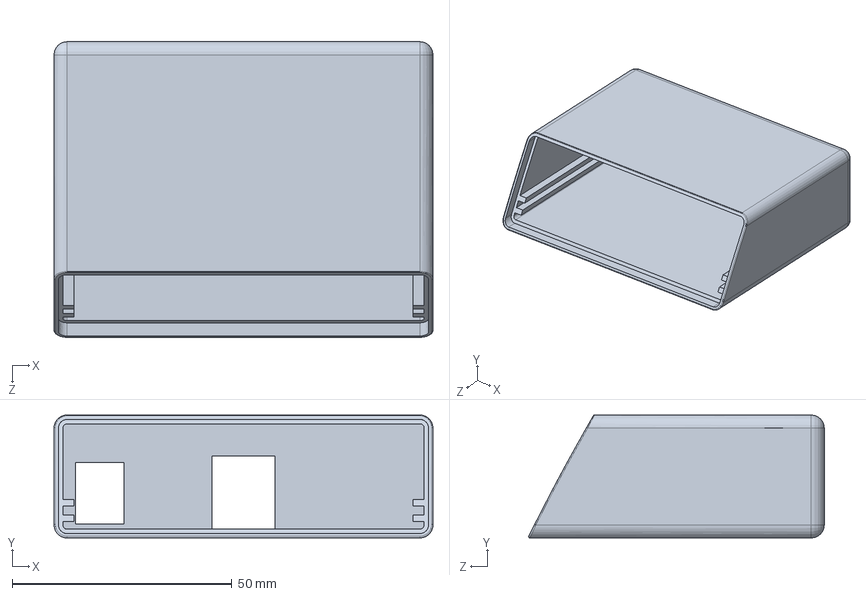
[picture p145: CAD file, 2022-06-23]
NGP_ODC_Main/PDLC/Mechanical/NGP_CCC Final files on dt-lohiths/thermal/EEC/Eec cover.SLDPRT
86.3 x 28.0 x 67.3 mm
