Sayidathahaseen/CCC_NGP_ODC/NGP_ODC_Main/PDLC/Mechanical/NGP_CCC Final files on dt-lohiths/thermal/PCC MOD/WP934CB 2.9mm led .SLDPRT

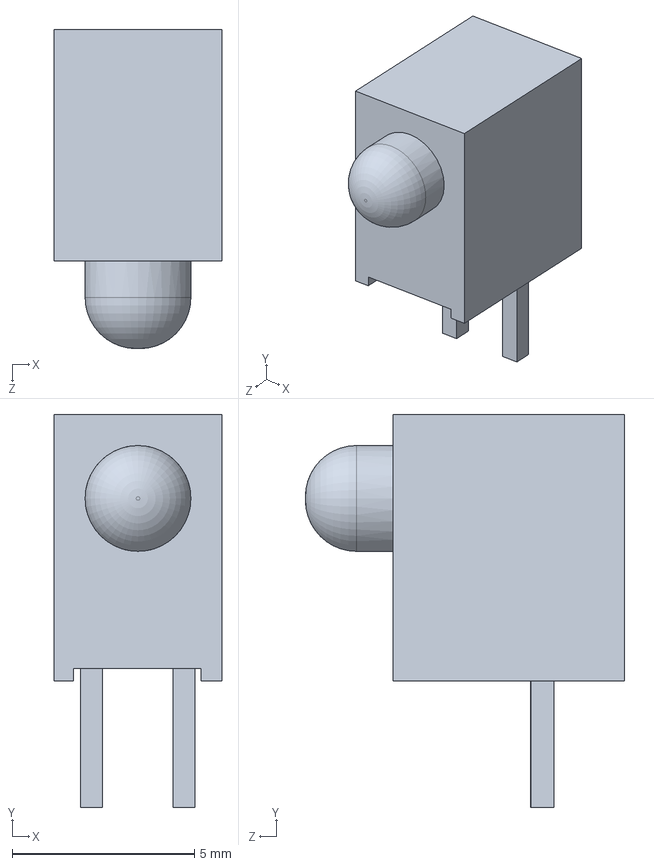
[picture p146: CAD file, 2022-06-23]
NGP_ODC_Main/PDLC/Mechanical/NGP_CCC Final files on dt-lohiths/thermal/PCC MOD/WP934CB 2.9mm led .SLDPRT
4.60 x 10.8 x 8.75 mm
