Sayidathahaseen/CCC_NGP_ODC/NGP_ODC_Main/PDLC/Mechanical/NGP_CCC Final files on dt-lohiths/ngp_Final profiles_14Jun11.dxf

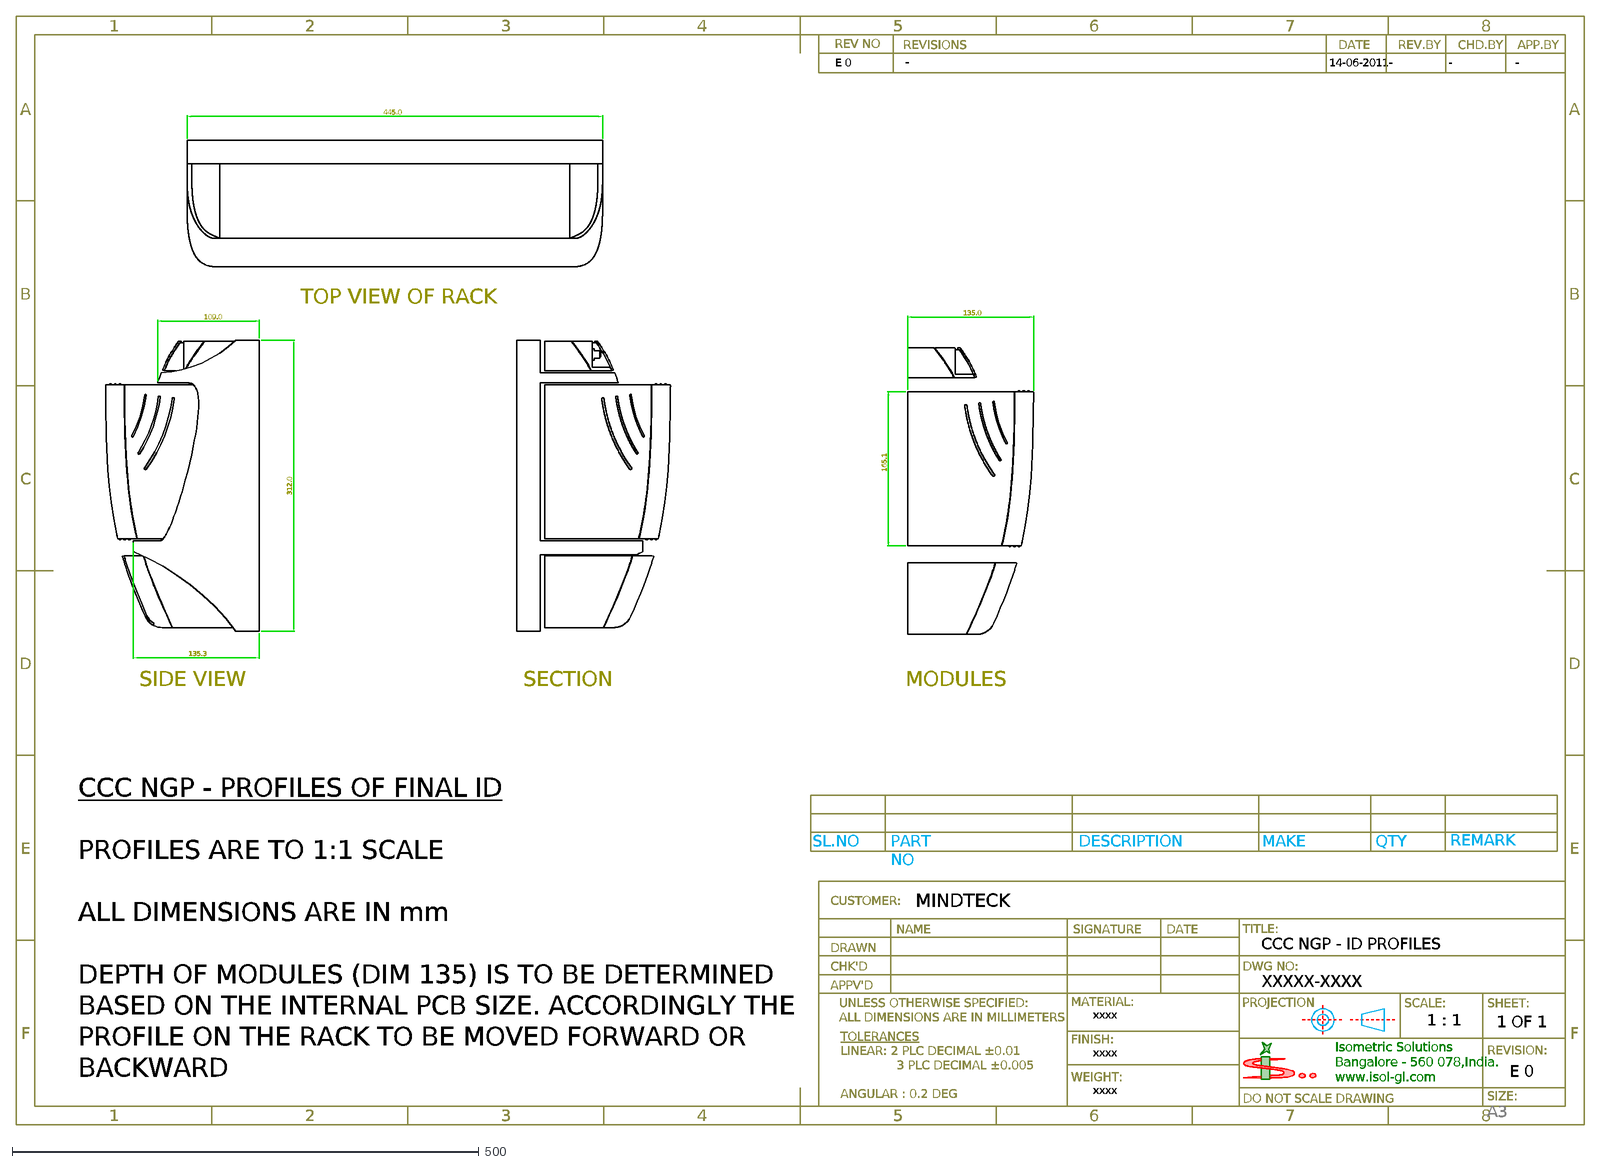
[picture p147: CAD file, 2022-06-23]
NGP_ODC_Main/PDLC/Mechanical/NGP_CCC Final files on dt-lohiths/ngp_Final profiles_14Jun11.dxf
312.0
SECTION
SIDE VIEW
TOP VIEW OF RACK
MODULES
135.0
165.1
CCC NGP - PROFILES OF FINAL ID PROFILES ARE TO 1:1 SCALE ALL DIMENSIONS ARE IN mm DEPTH OF MODULES (DIM 135) IS TO BE DETERMINED BASED ON THE INTERNAL PCB SIZE.
445.0
109.0
135.3
XXXXX-XXXX
CCC NGP - ID PROFILES
xxxx
1 : 1
1 OF 1
MINDTECK
E 0
14-06-2011
-
A
B
C
D
E
F
1
2
3
4
5
6
7
8
TITLE:
DWG NO:
Isometric Solutions Bangalore - 560 078,India. www.isol-gl.com
PROJECTION
UNLESS OTHERWISE SPECIFIED: ALL DIMENSIONS ARE IN MILLIMETERS
SCALE:
SHEET:
FINISH:
MATERIAL:
WEIGHT:
TOLERANCES LINEAR: 2 PLC DECIMAL ±0.01 3 PLC DECIMAL ±0.005 ANGULAR : 0.2 DEG
NAME
SIGNATURE
DATE
DRAWN
CHK'D
APPV'D
CUSTOMER:
DO NOT SCALE DRAWING
SIZE: A3
REVISION:
REV NO
APP.BY
CHD.BY
REV.BY
REVISIONS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
