Sayidathahaseen/CCC_NGP_ODC/NGP_ODC_Main/PDLC/Mechanical/NGP_CCC Final files on dt-lohiths/Solidworks _Final files/EEC/Eec cover-front.SLDPRT

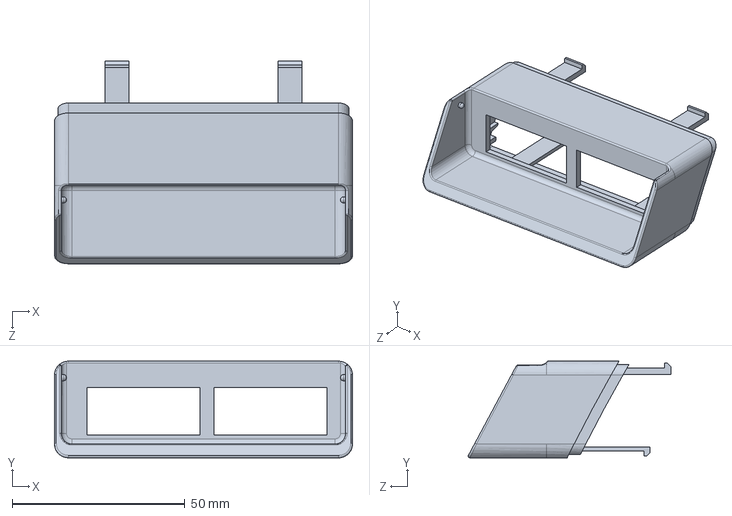
[picture p149: CAD file, 2022-06-23]
NGP_ODC_Main/PDLC/Mechanical/NGP_CCC Final files on dt-lohiths/Solidworks _Final files/EEC/Eec cover-front.SLDPRT
86.3 x 28.0 x 58.7 mm
