Sayidathahaseen/CCC_NGP_ODC/NGP_ODC_Main/PDLC/Mechanical/NGP_CCC Final files on dt-lohiths/Solidworks _Final files/IES MOD 4-7-2011/IES mod body.SLDPRT

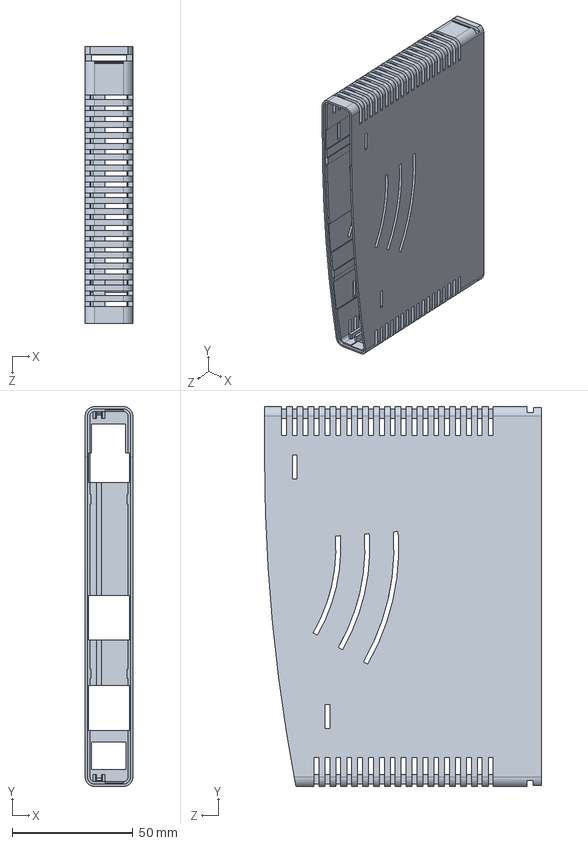
[picture p150: CAD file, 2022-06-23]
NGP_ODC_Main/PDLC/Mechanical/NGP_CCC Final files on dt-lohiths/Solidworks _Final files/IES MOD 4-7-2011/IES mod body.SLDPRT
19.8 x 157.1 x 114.5 mm
