Sayidathahaseen/CCC_NGP_ODC/(list of files, cad)

Other CAD files:
NGP_ODC_Main/PDLC/Mechanical/NGP_CCC Final files on dt-lohiths/thermal/Back Plane Assy/Back Plane Assy_29-06-11.50AM.dwg
NGP_ODC_Main/PDLC/Mechanical/NGP_CCC Final files on dt-lohiths/thermal/Back Plane Assy/Back Plane Assy_29-06-11AM.dwg
NGP_ODC_Main/PDLC/Mechanical/NGP_CCC Final files on dt-lohiths/Solidworks _Final files/Back Plane Assy/Rear Panel assy.dxf
NGP_ODC_Main/PDLC/Mechanical/NGP_CCC Final files on dt-lohiths/Solidworks _Final files/SAC-03-8-2011/SAC Assy 03-8-2011.SLDASM
NGP_ODC_Main/PDLC/Mechanical/NGP_CCC Final files on dt-lohiths/Solidworks _Final files/SAC/SAC MOD ASSY.SLDASM
NGP_ODC_Main/PDLC/Mechanical/NGP_CCC Final files on dt-lohiths/Solidworks _Final files/Back Plane Assy/Backplane Assy 2-08-2011.dwg
NGP_ODC_Main/PDLC/Mechanical/NGP_CCC Final files on dt-lohiths/Solidworks _Final files/SAC/SAC MOD ASSY-1.DXF
NGP_ODC_Main/PDLC/Mechanical/NGP_CCC Final files on dt-lohiths/thermal/IOP Module/QSE_040_01_ASM.sldasm
NGP_ODC_Main/PDLC/Mechanical/NGP_CCC Final files on dt-lohiths/thermal/IOP Module/QTE-040-02-X-D-A.sldasm
NGP_ODC_Main/PDLC/Mechanical/NGP_CCC Final files on dt-lohiths/Solidworks _Final files/Back Plane Assy/Cam lever Assy.SLDASM
NGP_ODC_Main/PDLC/Mechanical/NGP_CCC Final files on dt-lohiths/thermal/Back Plane Assy/Back Plane Assy_29-06-11_latest.dwg
NGP_ODC_Main/PDLC/Mechanical/NGP_CCC Final files on dt-lohiths/thermal/Back Plane Assy/Back Plane Assy_28-06_latest.dxf
NGP_ODC_Main/PDLC/Mechanical/NGP_CCC Final files on dt-lohiths/thermal/Back Plane Assy/Back Plane Assy_28-06.dxf
NGP_ODC_Main/PDLC/Mechanical/NGP_CCC Final files on dt-lohiths/Solidworks _Final files/FTC 21-07-2011/FTC pcb-1 assy.SLDASM
NGP_ODC_Main/PDLC/Mechanical/NGP_CCC Final files on dt-lohiths/thermal/IOP Module/10_ASM.sldasm
NGP_ODC_Main/PDLC/Mechanical/NGP_CCC Final files on dt-lohiths/thermal/Back Plane Assy/Back Plane Assy.SLDASM
NGP_ODC_Main/PDLC/Mechanical/CCC_MECHANICAL_REV2/TSW-110-07-X-D_1.sldasm
NGP_ODC_Main/PDLC/Mechanical/NGP_CCC Final files on dt-lohiths/thermal/FTC MOD/ESQ-120-23-X-D.sldasm
NGP_ODC_Main/PDLC/Mechanical/NGP_CCC Final files on dt-lohiths/thermal/IOP Module/iopdrg- assy.SLDASM
NGP_ODC_Main/PDLC/Mechanical/NGP_CCC Final files on dt-lohiths/Solidworks _Final files/Back Plane Assy/Back Plane Assy july22.DWG
NGP_ODC_Main/PDLC/Mechanical/NGP_CCC Final files on dt-lohiths/thermal/FTC MOD/TSW-120-07-X-D.sldasm
NGP_ODC_Main/PDLC/Mechanical/CCC_MECHANICAL_REV2/Back Plane Assy.SLDASM
NGP_ODC_Main/PDLC/Mechanical/NGP_CCC Final files on dt-lohiths/Solidworks _Final files/IOP Module/10_ASM.sldasm
NGP_ODC_Main/PDLC/Mechanical/CCC_MECHANICAL_REV2/QTE-040-02-X-D-A.sldasm
NGP_ODC_Main/PDLC/Mechanical/CCC_MECHANICAL_REV2/IES MOD ASSY_rev2.SLDASM
NGP_ODC_Main/PDLC/Mechanical/CCC_MECHANICAL_REV2/TSW-120-07-X-D.sldasm
NGP_ODC_Main/PDLC/Mechanical/CCC_MECHANICAL_REV2/FTC pcb-2 assy.SLDASM
NGP_ODC_Main/PDLC/Mechanical/CCC_MECHANICAL_REV2/FTC assy.SLDASM
NGP_ODC_Main/PDLC/Mechanical/CCC_MECHANICAL_REV2/ESQ-120-23-X-D.sldasm
NGP_ODC_Main/PDLC/Mechanical/CCC_MECHANICAL_REV2/FTC pcb-3 assy.SLDASM
NGP_ODC_Main/PDLC/Mechanical/CCC_MECHANICAL_REV2/QSE_040_01_ASM.sldasm
NGP_ODC_Main/PDLC/Mechanical/CCC_MECHANICAL_REV2/10_ASM.sldasm
NGP_ODC_Main/PDLC/Mechanical/NGP_CCC Final files on dt-lohiths/Solidworks _Final files/Back Plane Assy/Pavan/Backplane_05Aug2011.dxf
NGP_ODC_Main/PDLC/Mechanical/NGP_CCC Final files on dt-lohiths/Solidworks _Final files/Back Plane Assy/Pavan/CCCNGP_Backplane_Layout_rev2.dxf
NGP_ODC_Main/PDLC/Mechanical/NGP_CCC Final files on dt-lohiths/Solidworks _Final files/Labels 21-07-2011/All labels.dwg
NGP_ODC_Main/PDLC/Mechanical/NGP_CCC Final files on dt-lohiths/thermal/IOP Module/EC2-24NJ RELAY.sldprt
NGP_ODC_Main/PDLC/Mechanical/NGP_CCC Final files on dt-lohiths/thermal/SAC/sacpcb1.SLDPRT
NGP_ODC_Main/PDLC/Mechanical/NGP_CCC Final files on dt-lohiths/Solidworks _Final files/APP MOD/PCB-app.SLDPRT
NGP_ODC_Main/PDLC/Mechanical/NGP_CCC Final files on dt-lohiths/Solidworks _Final files/Back Plane Assy/Pavan/Back plane pcb.DXF
NGP_ODC_Main/PDLC/Mechanical/NGP_CCC Final files on dt-lohiths/Solidworks _Final files/FTC 21-07-2011/C3D-T-1S6_-07 Straight.sldprt
NGP_ODC_Main/PDLC/Mechanical/NGP_CCC Final files on dt-lohiths/Solidworks _Final files/IOP Module/EC2-5NJ RELAY.sldprt
NGP_ODC_Main/PDLC/Mechanical/CCC_MECHANICAL_REV2/10039851_S.SLDPRT
NGP_ODC_Main/PDLC/Mechanical/CCC_MECHANICAL_REV2/10043546_S.sldprt
NGP_ODC_Main/PDLC/Mechanical/CCC_MECHANICAL_REV2/10045267_S.sldprt
NGP_ODC_Main/PDLC/Mechanical/CCC_MECHANICAL_REV2/10045271_S.sldprt
NGP_ODC_Main/PDLC/Mechanical/CCC_MECHANICAL_REV2/10045597.SLDPRT
NGP_ODC_Main/PDLC/Mechanical/CCC_MECHANICAL_REV2/10052838C.SLDPRT
NGP_ODC_Main/PDLC/Mechanical/CCC_MECHANICAL_REV2/10052842C.SLDPRT
NGP_ODC_Main/PDLC/Mechanical/CCC_MECHANICAL_REV2/10073383.SLDPRT
NGP_ODC_Main/PDLC/Mechanical/CCC_MECHANICAL_REV2/20020007-PLUG.sldprt
NGP_ODC_Main/PDLC/Mechanical/CCC_MECHANICAL_REV2/20020107-H-CM_1.sldprt
NGP_ODC_Main/PDLC/Mechanical/CCC_MECHANICAL_REV2/20020107-H-LEM_1.sldprt
NGP_ODC_Main/PDLC/Mechanical/CCC_MECHANICAL_REV2/20020107-H-REM_1.sldprt
NGP_ODC_Main/PDLC/Mechanical/CCC_MECHANICAL_REV2/20020107-H12_ASM_1_ASM.sldasm
NGP_ODC_Main/PDLC/Mechanical/CCC_MECHANICAL_REV2/20020107-VER_ASM.sldasm
NGP_ODC_Main/PDLC/Mechanical/CCC_MECHANICAL_REV2/20020516-M-CM.sldprt
NGP_ODC_Main/PDLC/Mechanical/CCC_MECHANICAL_REV2/20020516-M-LEM.sldprt
NGP_ODC_Main/PDLC/Mechanical/CCC_MECHANICAL_REV2/20020516-M-REM.sldprt
NGP_ODC_Main/PDLC/Mechanical/CCC_MECHANICAL_REV2/20020516-M14_ASM.sldasm
NGP_ODC_Main/PDLC/Mechanical/CCC_MECHANICAL_REV2/20020620-M-CM.sldprt
NGP_ODC_Main/PDLC/Mechanical/CCC_MECHANICAL_REV2/20020620-M-LEM.sldprt
NGP_ODC_Main/PDLC/Mechanical/CCC_MECHANICAL_REV2/20020620-M-REM.sldprt
NGP_ODC_Main/PDLC/Mechanical/CCC_MECHANICAL_REV2/20020620-M12_ASM.sldasm
NGP_ODC_Main/PDLC/Mechanical/CCC_MECHANICAL_REV2/51720-10400804AAC.SLDPRT
NGP_ODC_Main/PDLC/Mechanical/CCC_MECHANICAL_REV2/51740-10400804AALFC.sldprt
NGP_ODC_Main/PDLC/Mechanical/CCC_MECHANICAL_REV2/5513508F_SW0001.SLDPRT
NGP_ODC_Main/PDLC/Mechanical/CCC_MECHANICAL_REV2/6.sldprt
NGP_ODC_Main/PDLC/Mechanical/CCC_MECHANICAL_REV2/7.sldprt
NGP_ODC_Main/PDLC/Mechanical/CCC_MECHANICAL_REV2/8.sldprt
NGP_ODC_Main/PDLC/Mechanical/CCC_MECHANICAL_REV2/9.sldprt
NGP_ODC_Main/PDLC/Mechanical/CCC_MECHANICAL_REV2/93655A354(M3 Stand-off 16mm).SLDPRT
NGP_ODC_Main/PDLC/Mechanical/CCC_MECHANICAL_REV2/94868A172(m3 stand-off 16mm female).SLDPRT
NGP_ODC_Main/PDLC/Mechanical/CCC_MECHANICAL_REV2/APBDA3020SURKCGKC-GX (LED).sldprt
NGP_ODC_Main/PDLC/Mechanical/CCC_MECHANICAL_REV2/APP mod body.SLDPRT
NGP_ODC_Main/PDLC/Mechanical/CCC_MECHANICAL_REV2/APP mod face plate.SLDPRT
NGP_ODC_Main/PDLC/Mechanical/CCC_MECHANICAL_REV2/Back plane pcb.SLDPRT
NGP_ODC_Main/PDLC/Mechanical/CCC_MECHANICAL_REV2/Bottom Body.SLDPRT
NGP_ODC_Main/PDLC/Mechanical/CCC_MECHANICAL_REV2/C-15-X_-03.sldprt
NGP_ODC_Main/PDLC/Mechanical/CCC_MECHANICAL_REV2/C-15-X_-04.sldprt
NGP_ODC_Main/PDLC/Mechanical/CCC_MECHANICAL_REV2/C-1734354-2.SLDPRT
NGP_ODC_Main/PDLC/Mechanical/CCC_MECHANICAL_REV2/C-6116522-01-3.SLDPRT
NGP_ODC_Main/PDLC/Mechanical/CCC_MECHANICAL_REV2/C16643 (smd logo).SLDPRT
NGP_ODC_Main/PDLC/Mechanical/CCC_MECHANICAL_REV2/C17873A 3mm led .SLDPRT
NGP_ODC_Main/PDLC/Mechanical/CCC_MECHANICAL_REV2/C3D-T-1S6_-07 Straight.sldprt
NGP_ODC_Main/PDLC/Mechanical/CCC_MECHANICAL_REV2/C3D-TSW-XX-D_Formula.sldprt
NGP_ODC_Main/PDLC/Mechanical/CCC_MECHANICAL_REV2/CCC LOGO-APP.SLDPRT
NGP_ODC_Main/PDLC/Mechanical/CCC_MECHANICAL_REV2/CCC LOGO_ies-ne_18-07.SLDPRT
NGP_ODC_Main/PDLC/Mechanical/CCC_MECHANICAL_REV2/CCC LOGO_iop-19-07.SLDPRT
NGP_ODC_Main/PDLC/Mechanical/CCC_MECHANICAL_REV2/CCC LOGO_light pipe design.SLDPRT
NGP_ODC_Main/PDLC/Mechanical/CCC_MECHANICAL_REV2/CCC LOGO_light pipe design_2.SLDPRT
NGP_ODC_Main/PDLC/Mechanical/CCC_MECHANICAL_REV2/Camhead.SLDPRT
NGP_ODC_Main/PDLC/Mechanical/CCC_MECHANICAL_REV2/Camhead_2.SLDPRT
NGP_ODC_Main/PDLC/Mechanical/CCC_MECHANICAL_REV2/Camlever.SLDPRT
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
