Sayidathahaseen/CCC_NGP_ODC/NGP_ODC_Main/PDLC/Prodigy HW files/IOP-AM1/REV_A/SCHEMATIC/MPC5534_Proto_AMRev3_R0/MPC5534_Proto_Rev3/sopc_builder_log.txt

Info: Saving your IP search path in U:\.altera.quartus\ip\11.0sp1\ip_search_path\user_components.ipx
Info: Using factories: CuspFactory, ImportFactory, DSPBuilderFactory, JarFactory, QvarFactory, TclModuleFactory, MegaVariationFactory, BeanElementFactory, LegacyFactory, DDRLegacyFactory, PresetFactory, EmbeddedSwTclDriverFactory, QsysFactory
Progress: (0) searching U:/Projects/Altera/MPC5534/MPC5534_Proto/11.0sp1 (command line switch)
Info: U:/Projects/Altera/MPC5534/MPC5534_Proto/11.0sp1 matched 1 files in 0.00 seconds
Info: Found 0 components
