Sayidathahaseen/CCC_NGP_ODC/NGP_ODC_Main/PDLC/Prodigy HW files/IOP-AM1/REV1/CPLD code/IOP_ANALOG/IOP_TEST LED_restored/ADC_waveforms.html

## Sample behavioral waveforms for design file "ADC.vhd"

The following waveforms show the behavior of dcfifo megafunction for the chosen set of parameters in design "ADC.vhd". The design "ADC.vhd" has a depth of 16 words of 16 bits each. The fifo is in legacy synchronous mode. The data becomes available after 'rdreq' is asserted; 'rdreq' acts as a read request.

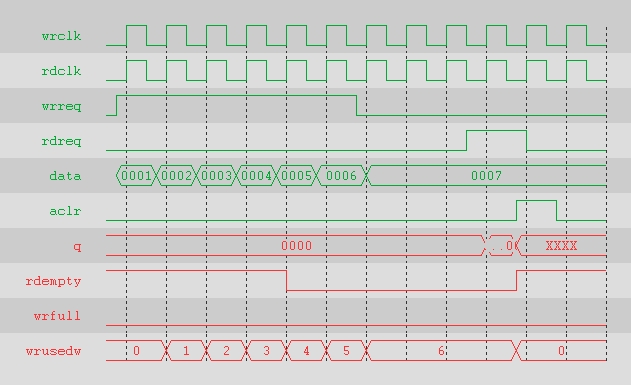
[picture p153: NGP_ODC_Main/PDLC/Prodigy HW files/IOP-AM1/REV1/CPLD code/IOP_ANALOG/IOP_TEST LED_restored/ADC_wave0.jpg]


Fig. 1 : Wave showing read and write operation.

The above waveform shows the behavior of the design under normal read and write conditions with aclr .

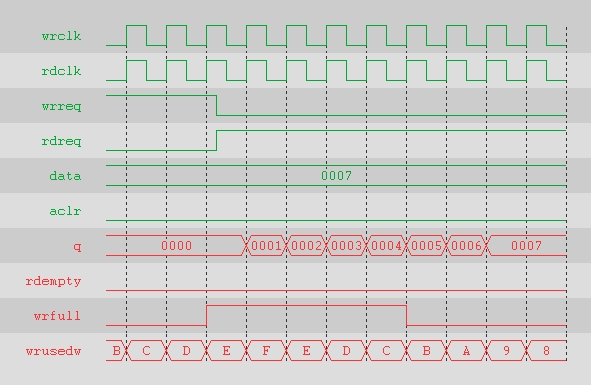
[picture p154: NGP_ODC_Main/PDLC/Prodigy HW files/IOP-AM1/REV1/CPLD code/IOP_ANALOG/IOP_TEST LED_restored/ADC_wave1.jpg]


Fig. 2 : Wave showing FIFO full operation.

The above waveform shows the behavior of the FIFO under wrfull condition. In the example above, data is written into the FIFO till it is full, then data is read back.
