Sayidathahaseen/CCC_NGP_ODC/NGP_ODC_Main/PDLC/Prodigy HW files/Backplane/Docs/rework/Rev2-3/changes.txt

FTC-ID not connected to both IOP  A&B
PCC  ????
