Sayidathahaseen/CCC_NGP_ODC/NGP_ODC_Main/PDLC/Prodigy HW files/MTBF/REV_B/WITH FUSE HOLDERS/GRAPHS/FAILURE RATE_TEMPERATURE.BMP

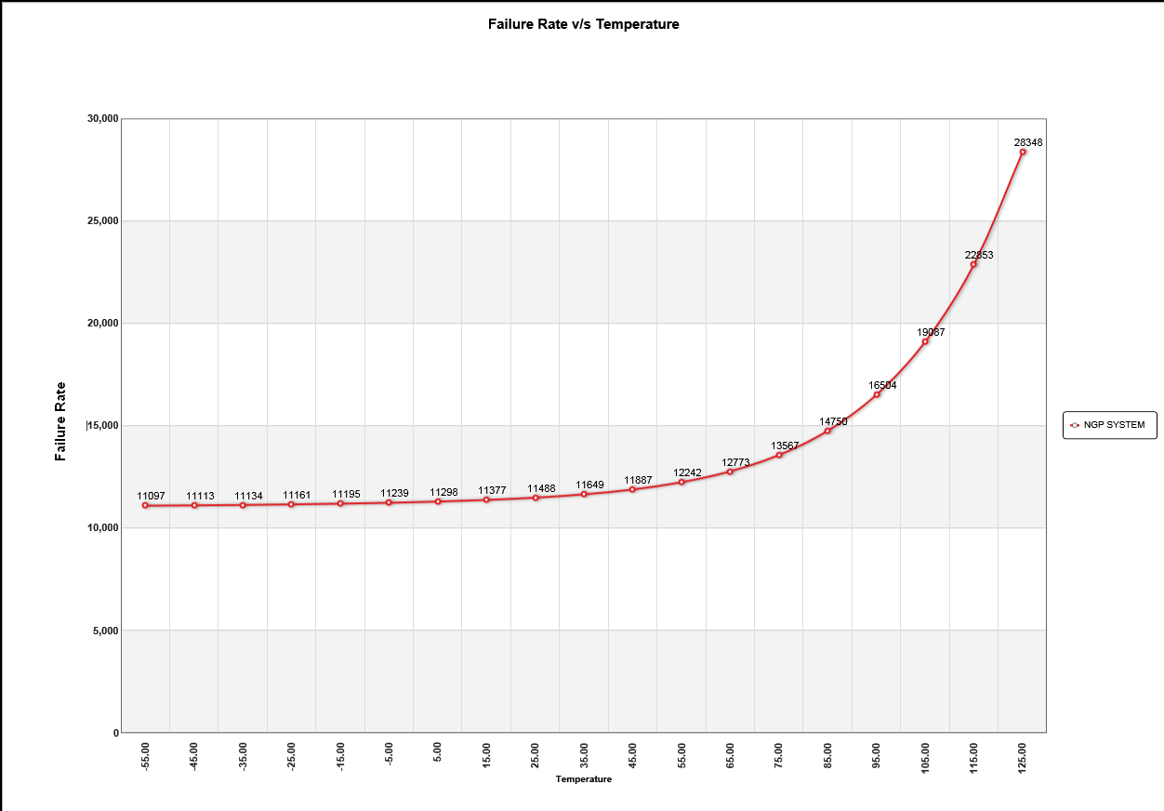
NGP_ODC_Main/PDLC/Prodigy HW files/MTBF/REV_B/WITH FUSE HOLDERS/GRAPHS/FAILURE RATE_TEMPERATURE.BMP
