Sayidathahaseen/CCC_NGP_ODC/NGP_ODC_Main/PDLC/VanGuard/Client Docs/Vanguard/Schematic_Vanguard Analog FTA_Duplex.pdf

D

1 | 2 | 3 | 4 | 5 | 6

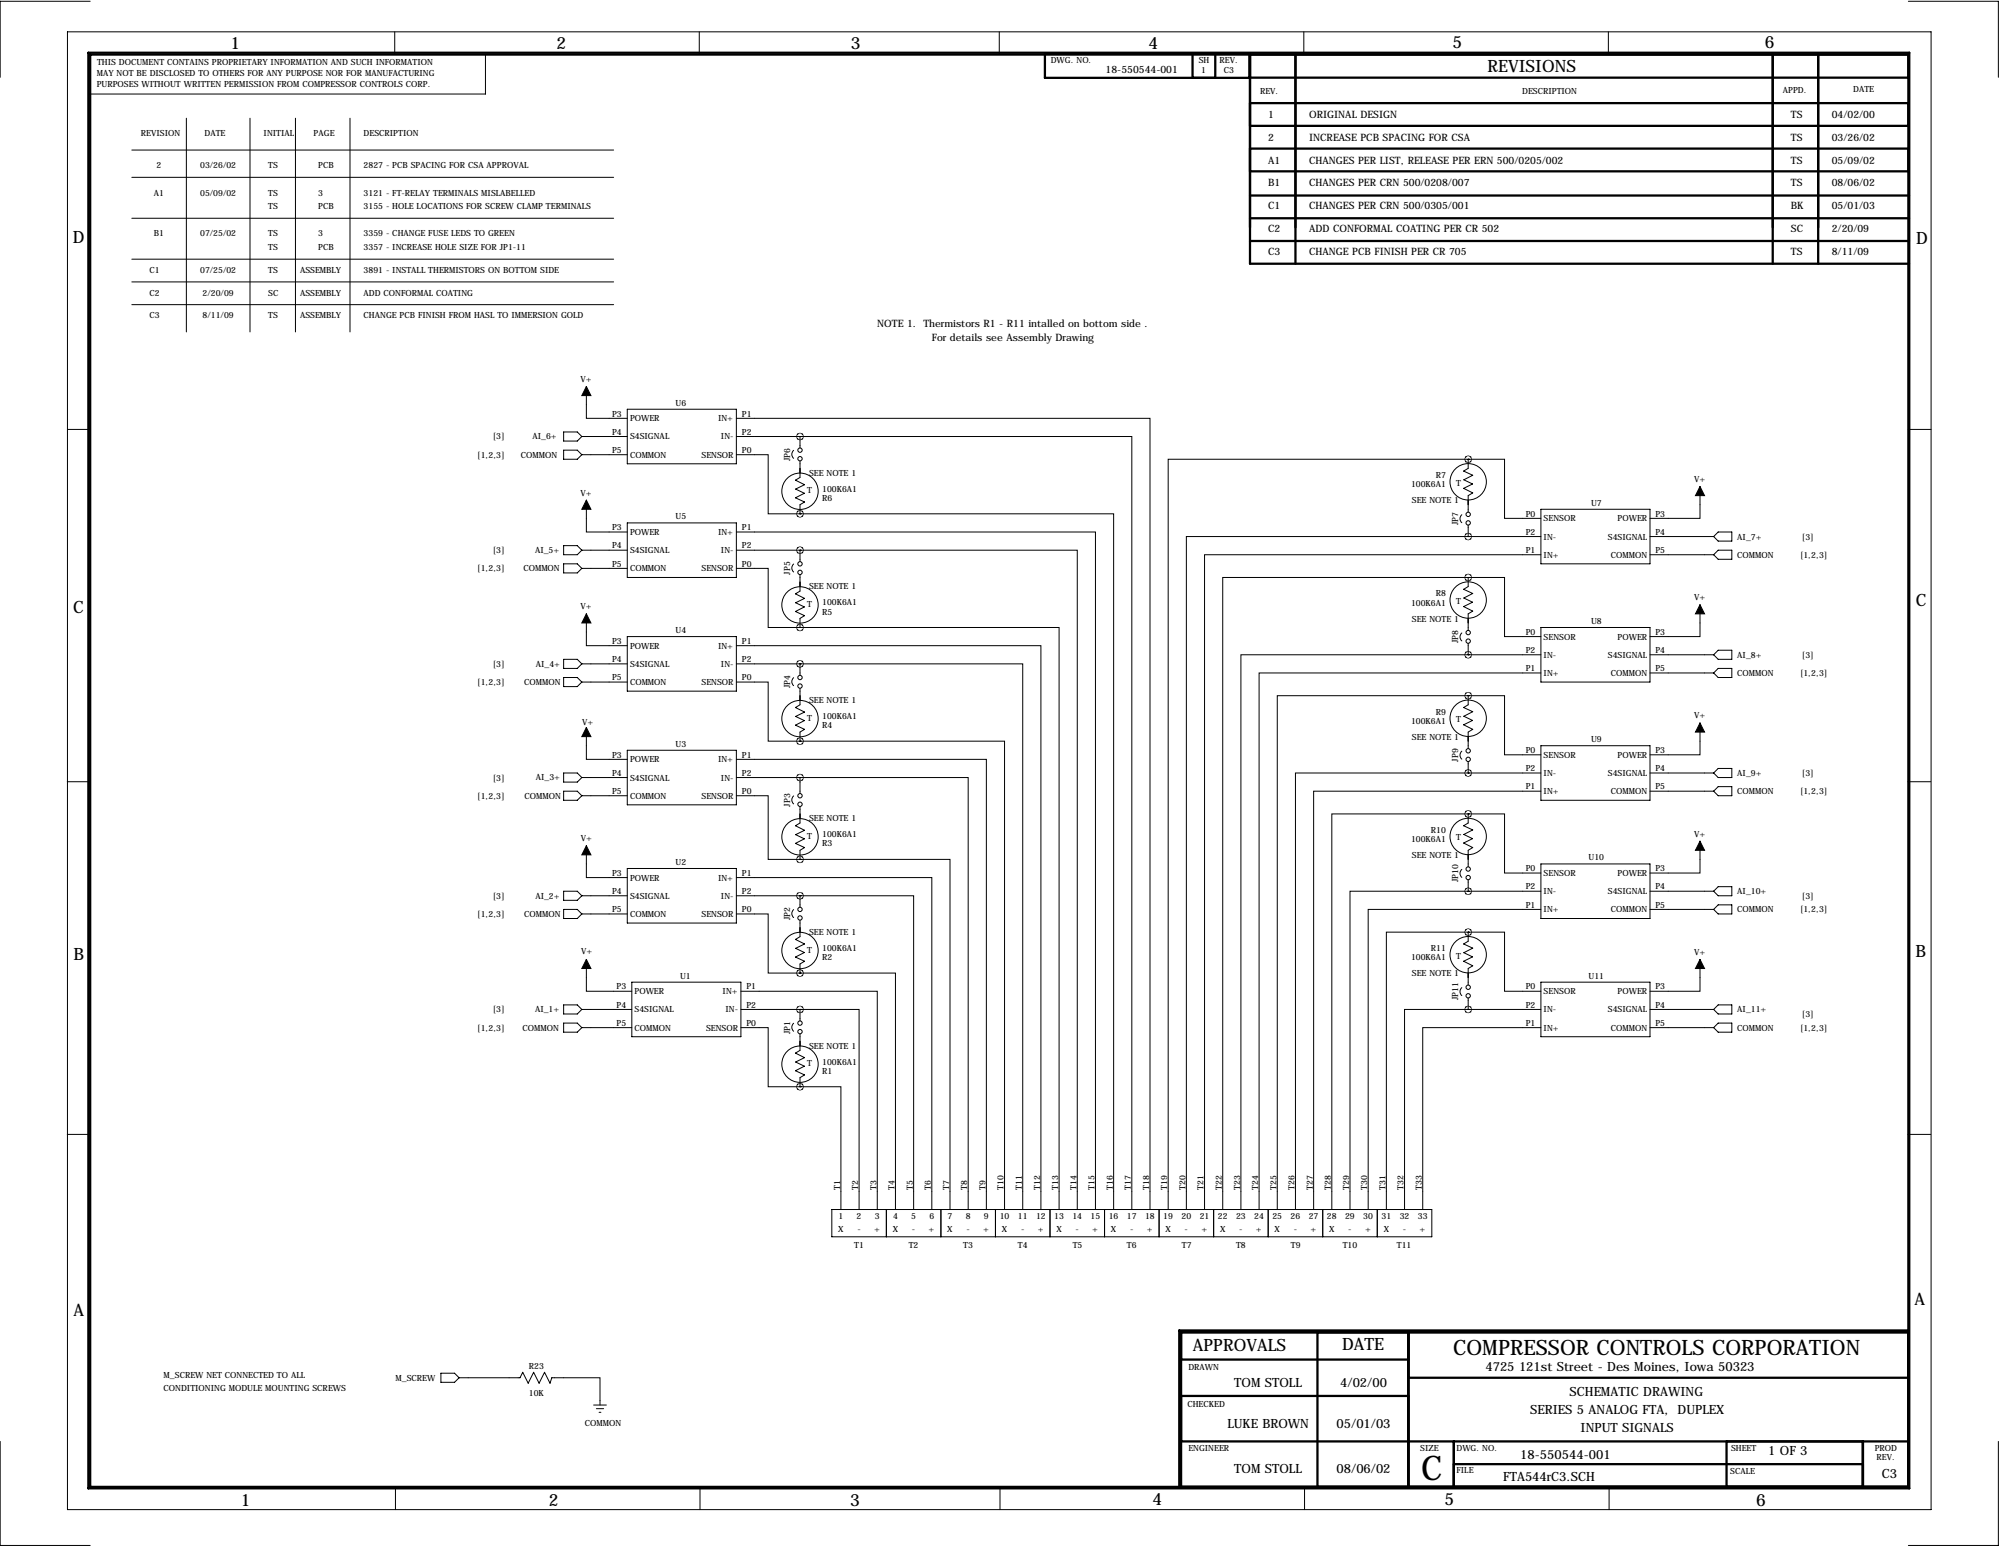
[picture p156: page 1]

THIS DOCUMENT CONTAINS PROPRIETARY INFORMATION AND SUCH INFORMATION MAY NOT BE DISCLOSED TO OTHERS FOR ANY PURPOSE NOR FOR MANUFACTURING PURPOSES WITHOUT WRITTEN PERMISSION FROM COMPRESSOR CONTROLS CORP. | For details see Assembly Drawing V+ | DWG. NO. 18-550544-001 | SH 1 | REV. C3 | | REVISIONS

REV. | DESCRIPTION | APPD. | DATE

1 | ORIGINAL DESIGN | TS | 04/02/00

2 | INCREASE PCB SPACING FOR CSA | TS | 03/26/02

A1 | CHANGES PER LIST, RELEASE PER ERN 500/0205/002 | TS | 05/09/02

B1 | CHANGES PER CRN 500/0208/007 | TS | 08/06/02

3121 - FT-RELAY TERMINALS MISLABELLED

C1 | CHANGES PER CRN 500/0305/001 | BK | 05/01/03

C2 | ADD CONFORMAL COATING PER CR 502 | SC | 2/20/09

3359 - CHANGE FUSE LEDS TO GREEN

3357 - INCREASE HOLE SIZE FOR JP1-11

C3 | CHANGE PCB FINISH PER CR 705 | TS | 8/11/09

NOTE 1. Thermistors R1 - R11 intalled on bottom side .

APPROVALS | DATE | COMPRESSOR CONTROLS CORPORATION 4725 121st Street - Des Moines, Iowa 50323

DRAWN TOM STOLL | 4/02/00

M_SCREW NET CONNECTED TO ALL

CONDITIONING MODULE MOUNTING SCREWS

CHECKED LUKE BROWN | 05/01/03

SERIES 5 ANALOG FTA, DUPLEX

ENGINEER TOM STOLL | 08/06/02 | SIZE C | DWG. NO. 18-550544-001 | SHEET | PROD C3

FILE FTA544rC3.SCH | SCALE

D

D

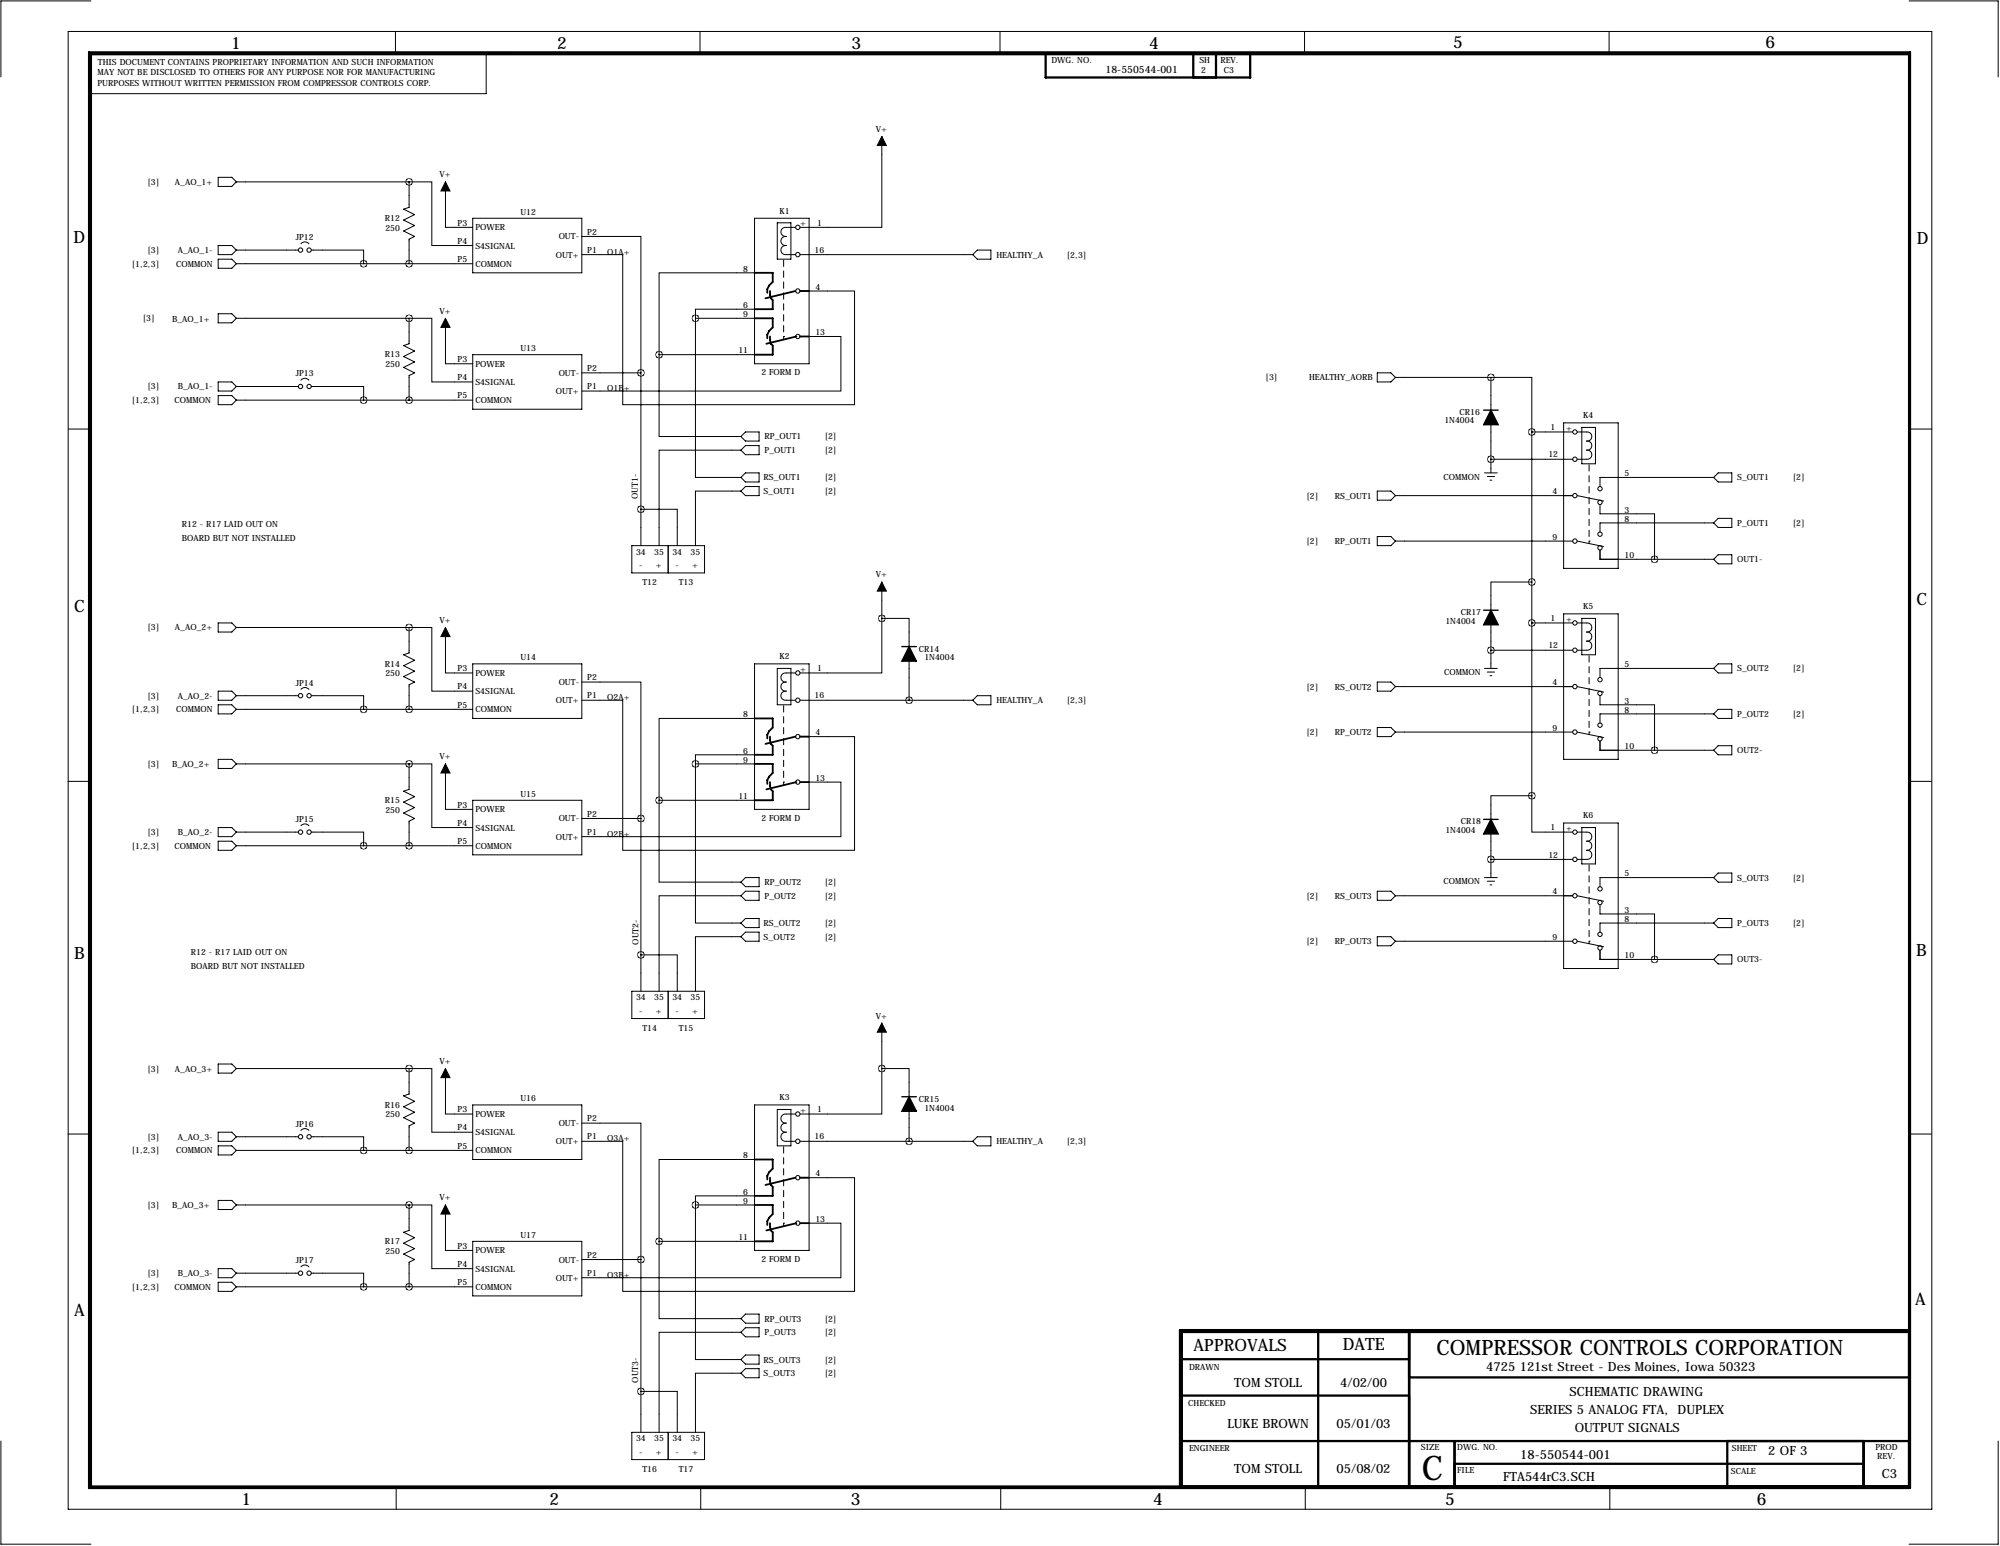
[picture p157: page 2]

BOARD BUT NOT INSTALLED

APPROVALS | DATE | COMPRESSOR CONTROLS CORPORATION 4725 121st Street - Des Moines, Iowa 50323

DRAWN TOM STOLL | 4/02/00

CHECKED

SERIES 5 ANALOG FTA, DUPLEX

D
D

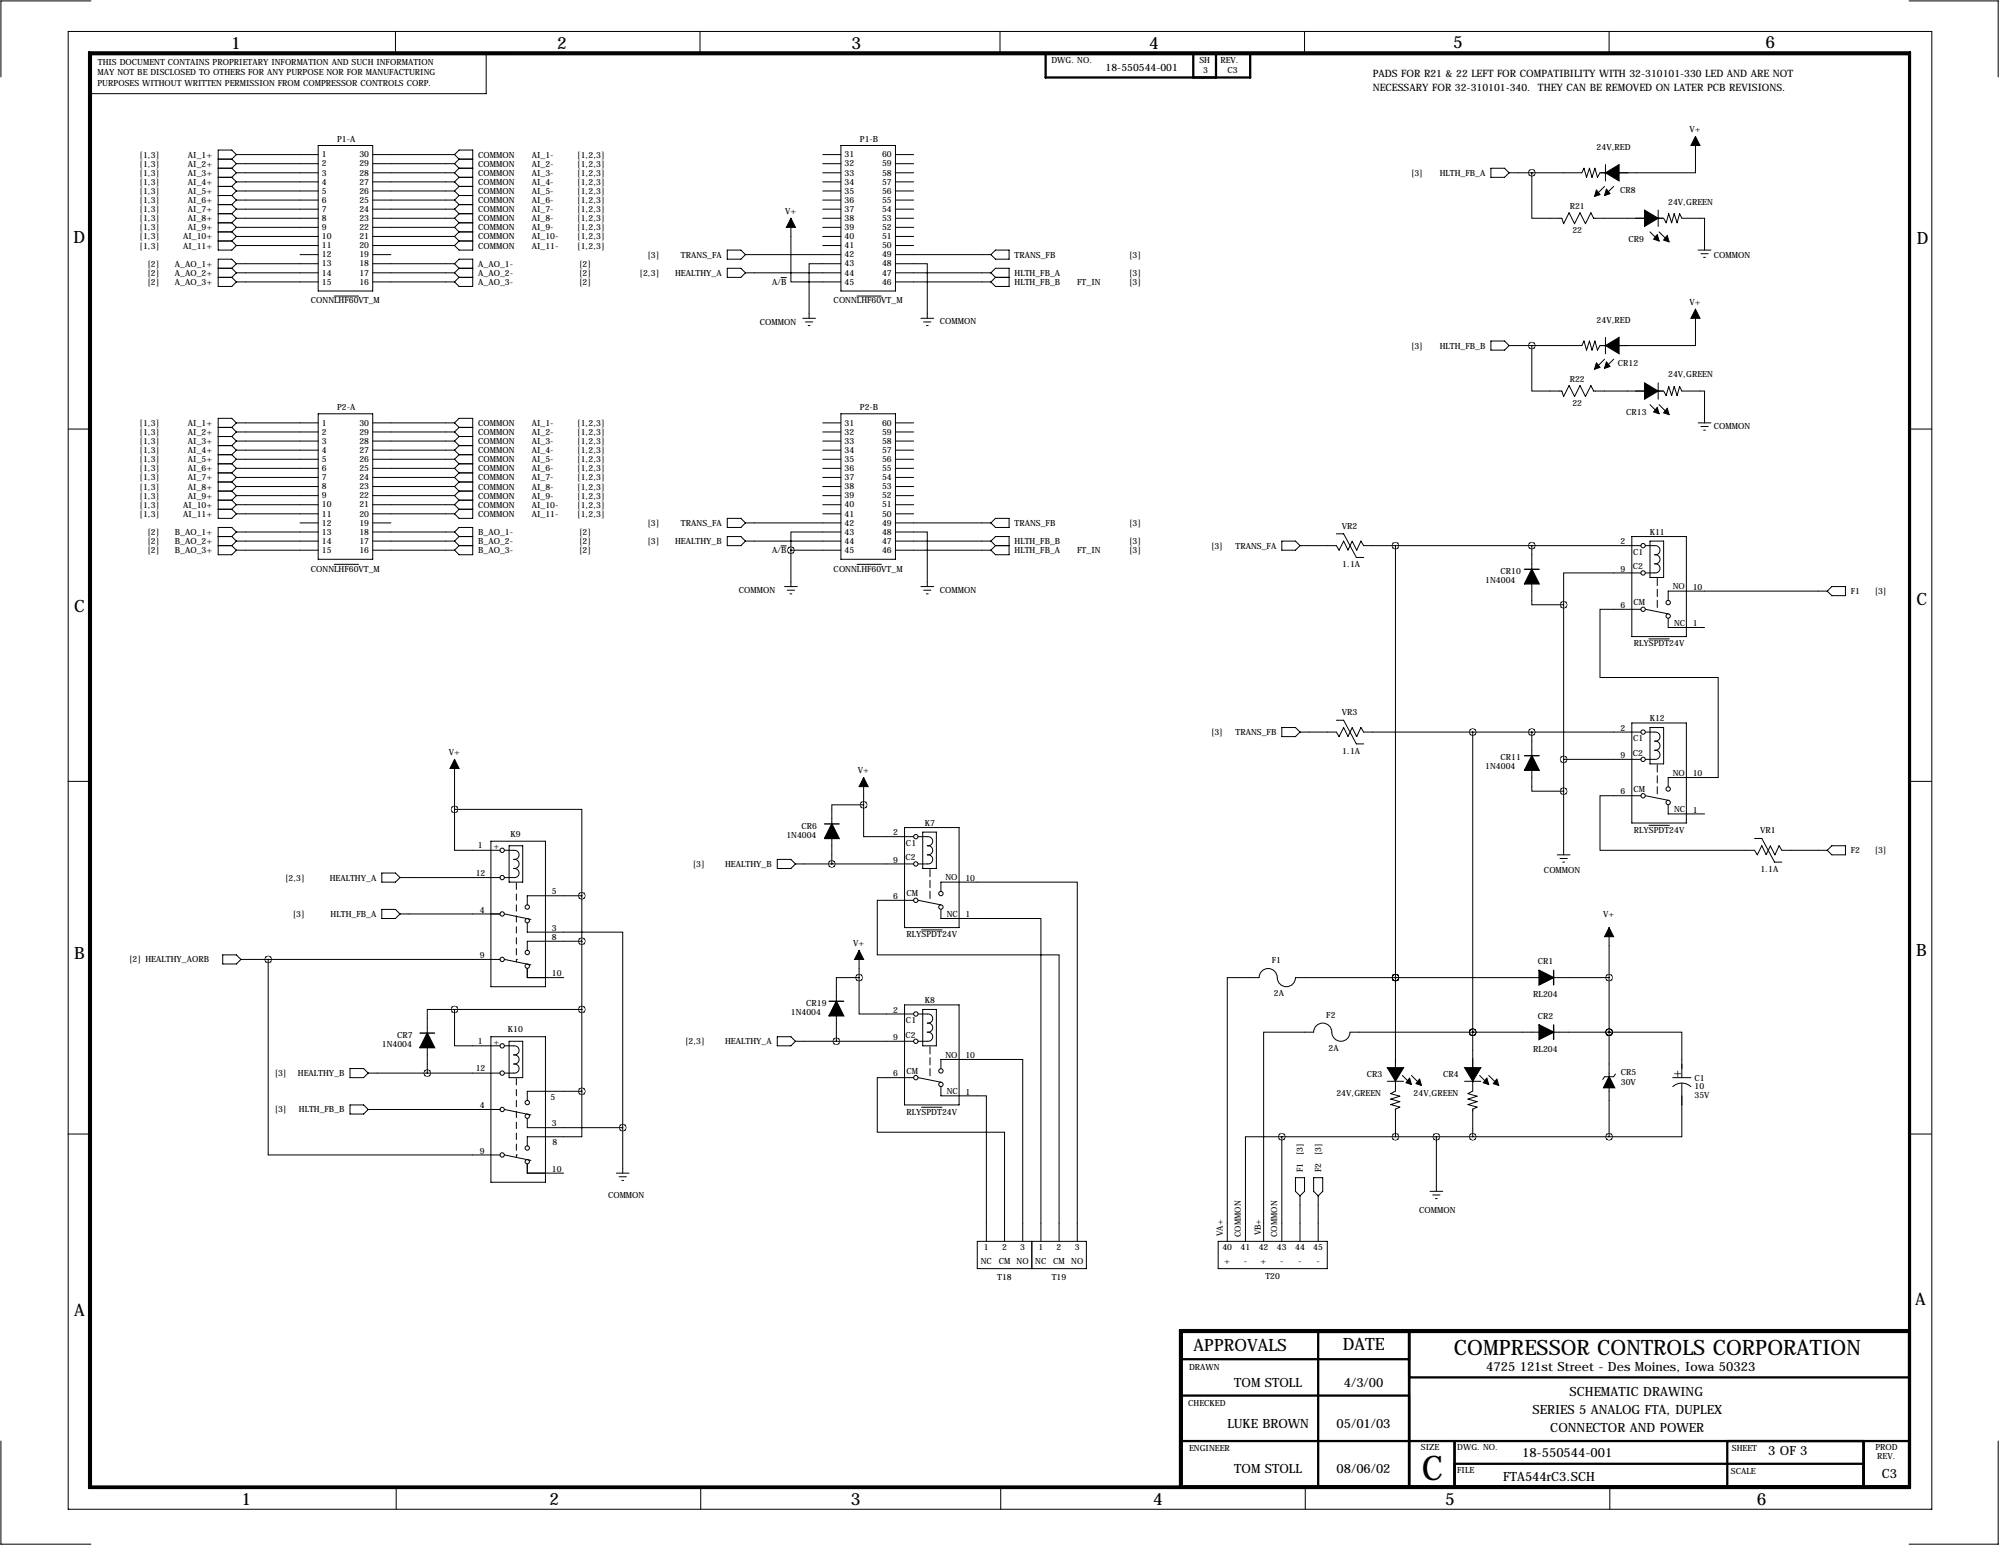
[picture p158: page 3]
COMMON; SCHEMATIC DRAWING; RLYSPDT24V; 24V,GREEN; CONNLHF60VT_M; 24V,RED; [3] TRANS_FA; TRANS_FB VA+; HEALTHY_A; HLTH_FB_A; [3] HLTH_FB_A; TRANS_FA; TRANS_FB; HEALTHY_B; HLTH_FB_B; [3] HLTH_FB_B; [3] HEALTHY_B; [2] HEALTHY_AORB

PADS FOR R21 & 22 LEFT FOR COMPATIBILITY WITH 32-310101-330 LED AND ARE NOT
NECESSARY FOR 32-310101-340. THEY CAN BE REMOVED ON LATER PCB REVISIONS.

APPROVALS | DATE | COMPRESSOR CONTROLS CORPORATION 4725 121st Street - Des Moines, Iowa 50323

DRAWN TOM STOLL | 4/3/00

CHECKED

SERIES 5 ANALOG FTA, DUPLEX

CONNECTOR AND POWER
