Sayidathahaseen/CCC_NGP_ODC/NGP_ODC_Main/PDLC/VanGuard/Client Docs/Vanguard/Schematic_Vanguard Digital FTA_Simplex.pdf

D

1 | 2 | 3 | 4 | 5 | 6

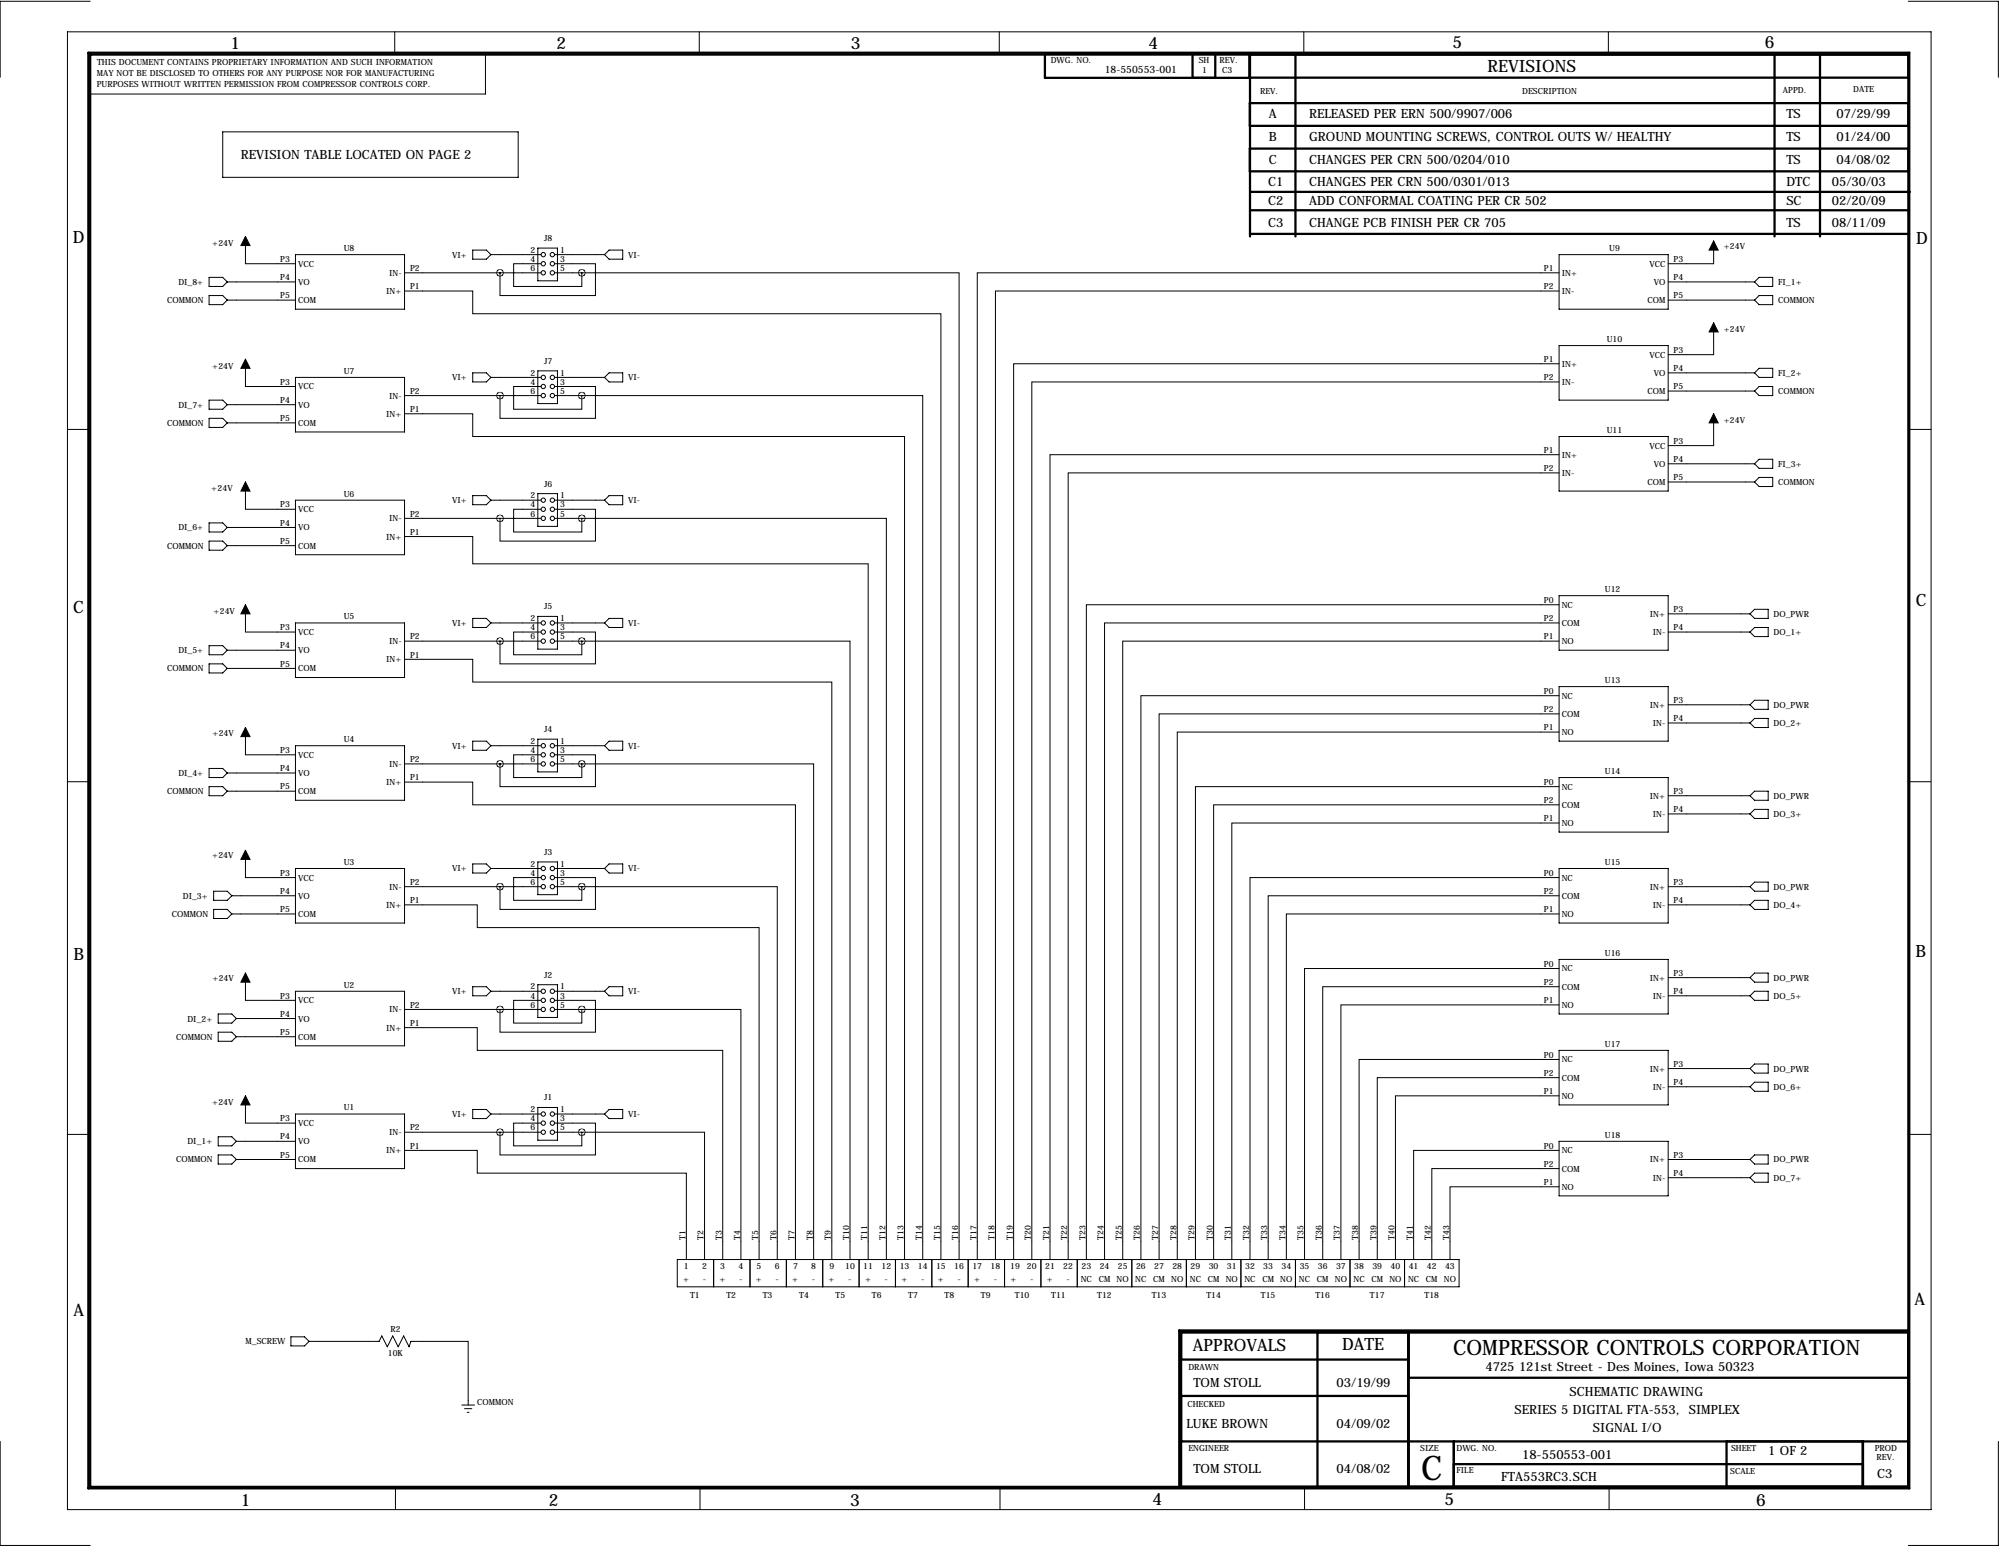
[picture p159: page 1]

THIS DOCUMENT CONTAINS PROPRIETARY INFORMATION AND SUCH INFORMATION MAY NOT BE DISCLOSED TO OTHERS FOR ANY PURPOSE NOR FOR MANUFACTURING PURPOSES WITHOUT WRITTEN PERMISSION FROM COMPRESSOR CONTROLS CORP. | | DWG. NO. 18-550553-001 | SH 1 | REV. C3 | | REVISIONS

REV. | DESCRIPTION | APPD. | DATE

A | RELEASED PER ERN 500/9907/006 | TS | 07/29/99

B | GROUND MOUNTING SCREWS, CONTROL OUTS W/ HEALTHY | TS | 01/24/00

C1 | CHANGES PER CRN 500/0301/013 | DTC | 05/30/03

C2 | ADD CONFORMAL COATING PER CR 502 | SC | 02/20/09

C3 | CHANGE PCB FINISH PER CR 705 | TS | 08/11/09

APPROVALS | DATE | COMPRESSOR CONTROLS CORPORATION 4725 121st Street - Des Moines, Iowa 50323

DRAWN TOM STOLL | 03/19/99

CHECKED LUKE BROWN | 04/09/02

SERIES 5 DIGITAL FTA-553, SIMPLEX

ENGINEER TOM STOLL | 04/08/02 | SIZE C | DWG. NO. 18-550553-001 | SHEET | PROD REV. C3

FILE FTA553RC3.SCH | SCALE

D

1 | 2 | 3 | 4 | 5 | 6

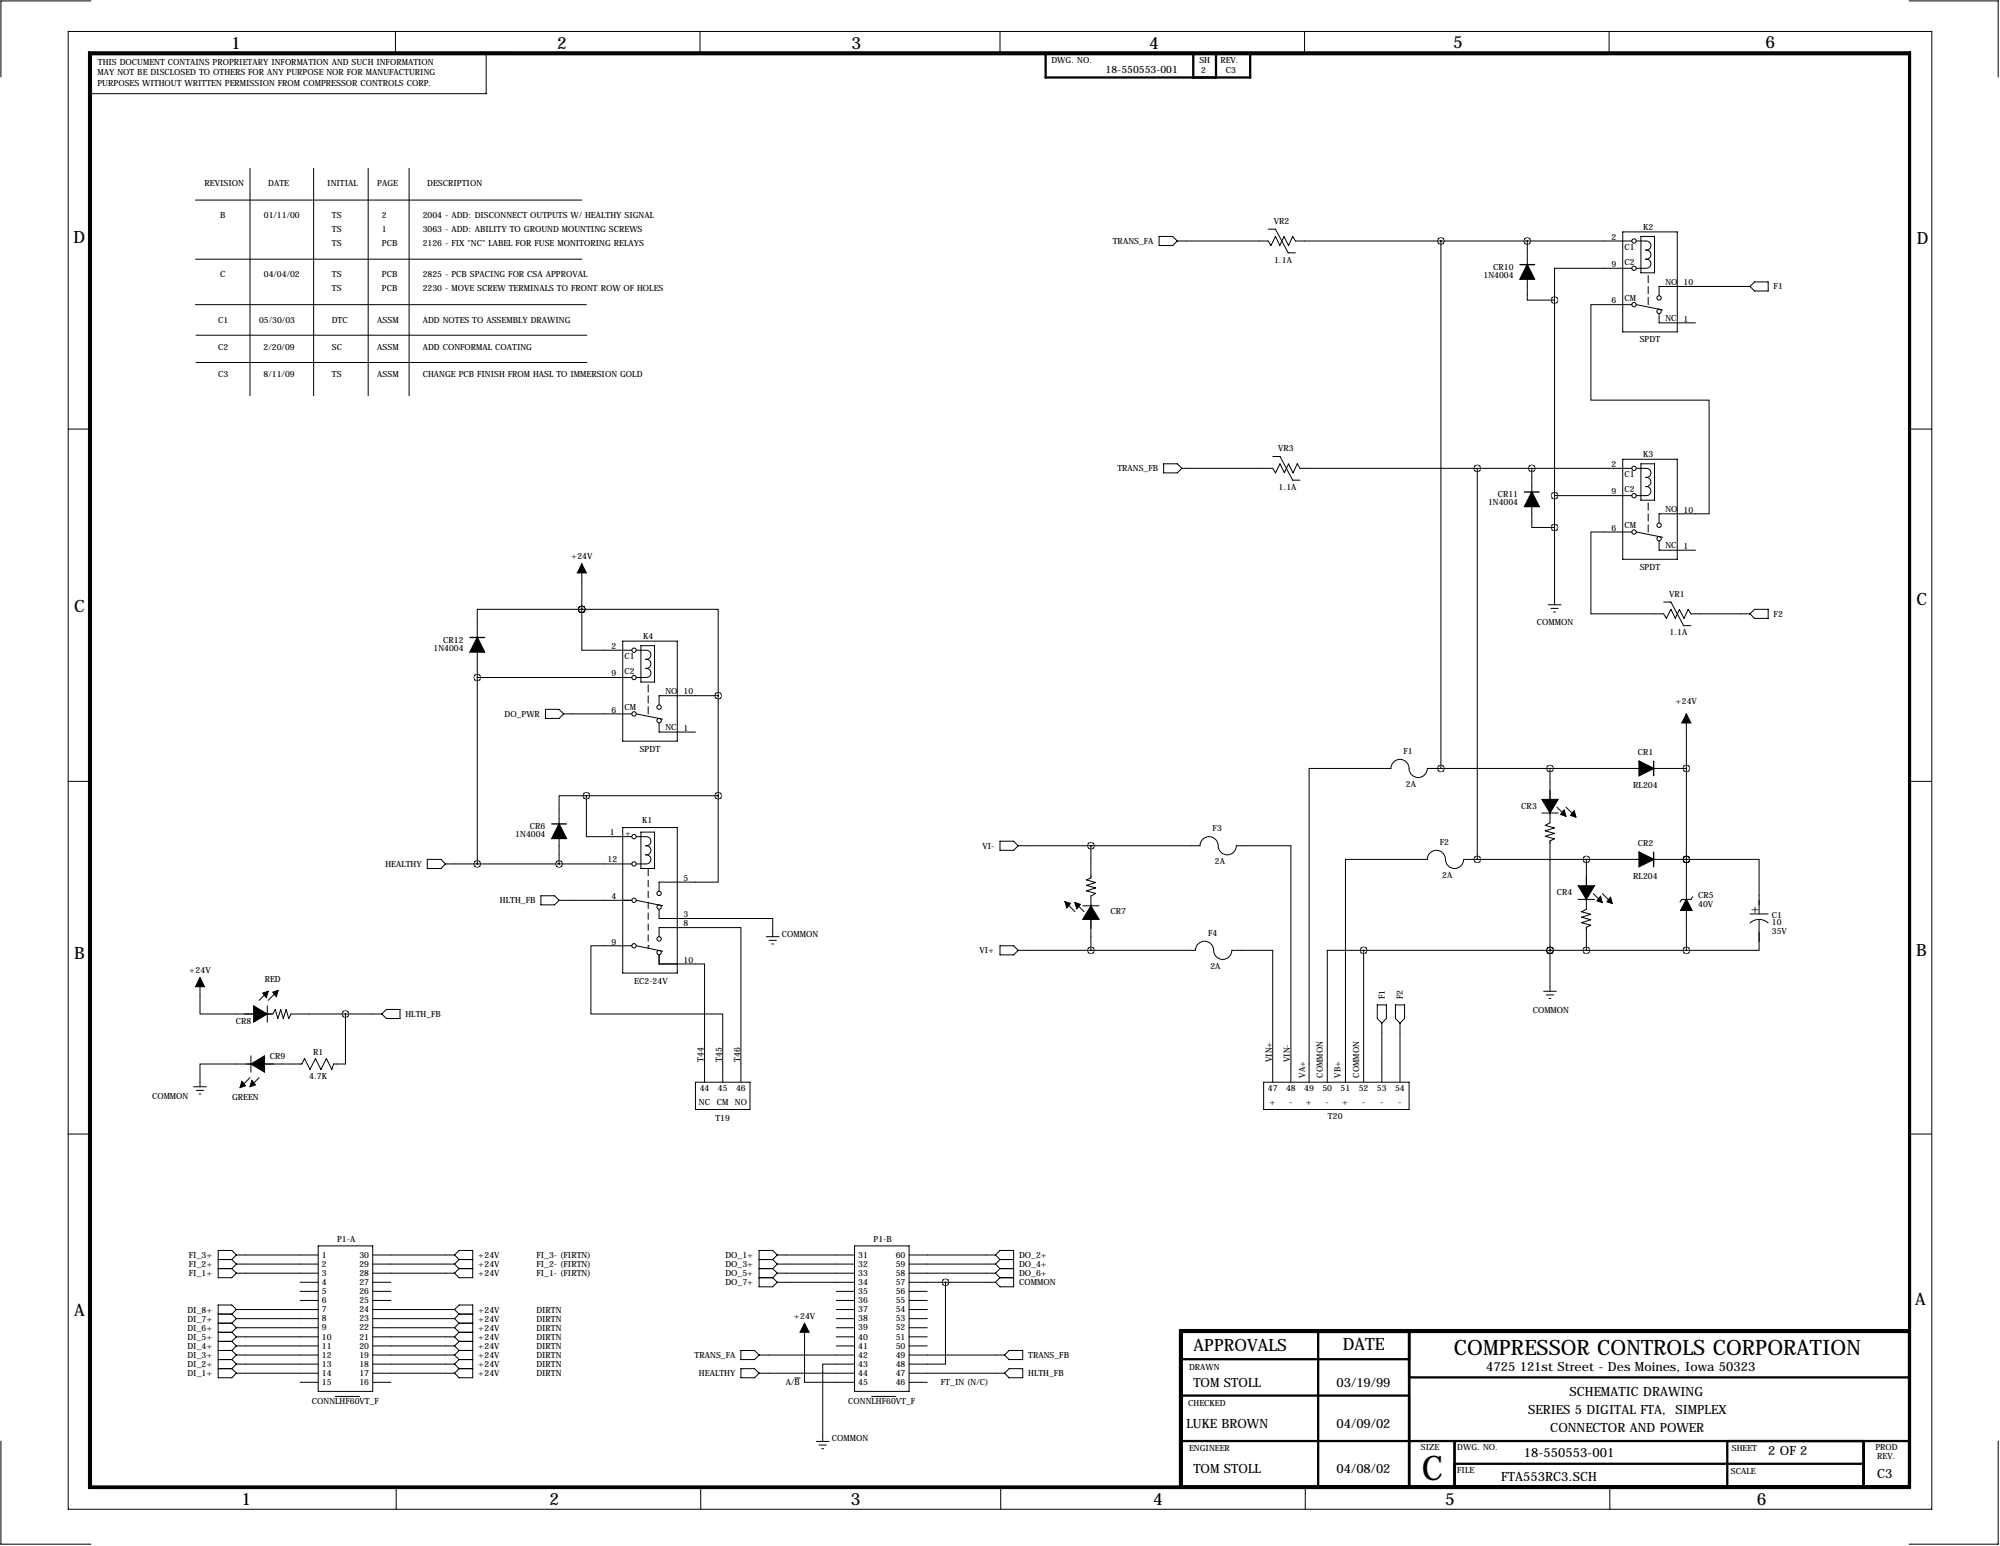
[picture p160: page 2]
DIRTN DIRTN DIRTN DIRTN DIRTN DIRTN DIRTN; COMMON; GREEN; RED; FI_3- (FIRTN) FI_2- (FIRTN) FI_1- (FIRTN); SCHEMATIC DRAWING; DIRTN; REVISION; DATE; INITIAL; DESCRIPTION; PAGE; PCB; 2126 - FIX "NC" LABEL FOR FUSE MONITORING RELAYS; DTC; ASSM; ADD NOTES TO ASSEMBLY DRAWING; ADD CONFORMAL COATING; CHANGE PCB FINISH FROM HASL TO IMMERSION GOLD; CONNLHF60VT_F; SPDT; HEALTHY; HLTH_FB; DO_2+ DO_4+ DO_6+ COMMON; TRANS_FA; TRANS_FB; DO_PWR; VIN+; VIN-

THIS DOCUMENT CONTAINS PROPRIETARY INFORMATION AND SUCH INFORMATION MAY NOT BE DISCLOSED TO OTHERS FOR ANY PURPOSE NOR FOR MANUFACTURING PURPOSES WITHOUT WRITTEN PERMISSION FROM COMPRESSOR CONTROLS CORP. | | DWG. NO. 18-550553-001 | SH 2 | REV. C3

2004 - ADD: DISCONNECT OUTPUTS W/ HEALTHY SIGNAL

3063 - ADD: ABILITY TO GROUND MOUNTING SCREWS

2825 - PCB SPACING FOR CSA APPROVAL

2230 - MOVE SCREW TERMINALS TO FRONT ROW OF HOLES

APPROVALS | DATE | COMPRESSOR CONTROLS CORPORATION 4725 121st Street - Des Moines, Iowa 50323

DRAWN TOM STOLL | 03/19/99

CHECKED LUKE BROWN | 04/09/02

SERIES 5 DIGITAL FTA, SIMPLEX

CONNECTOR AND POWER

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

FILE FTA553RC3.SCH | SCALE
