Sayidathahaseen/CCC_NGP_ODC/NGP_ODC_Development/PDLC/Design/APP-MPU/Block_Diagram/APU_Pro.pdf

## BLOCK DIAGRAM

## 800 MHz to 1400 MHz

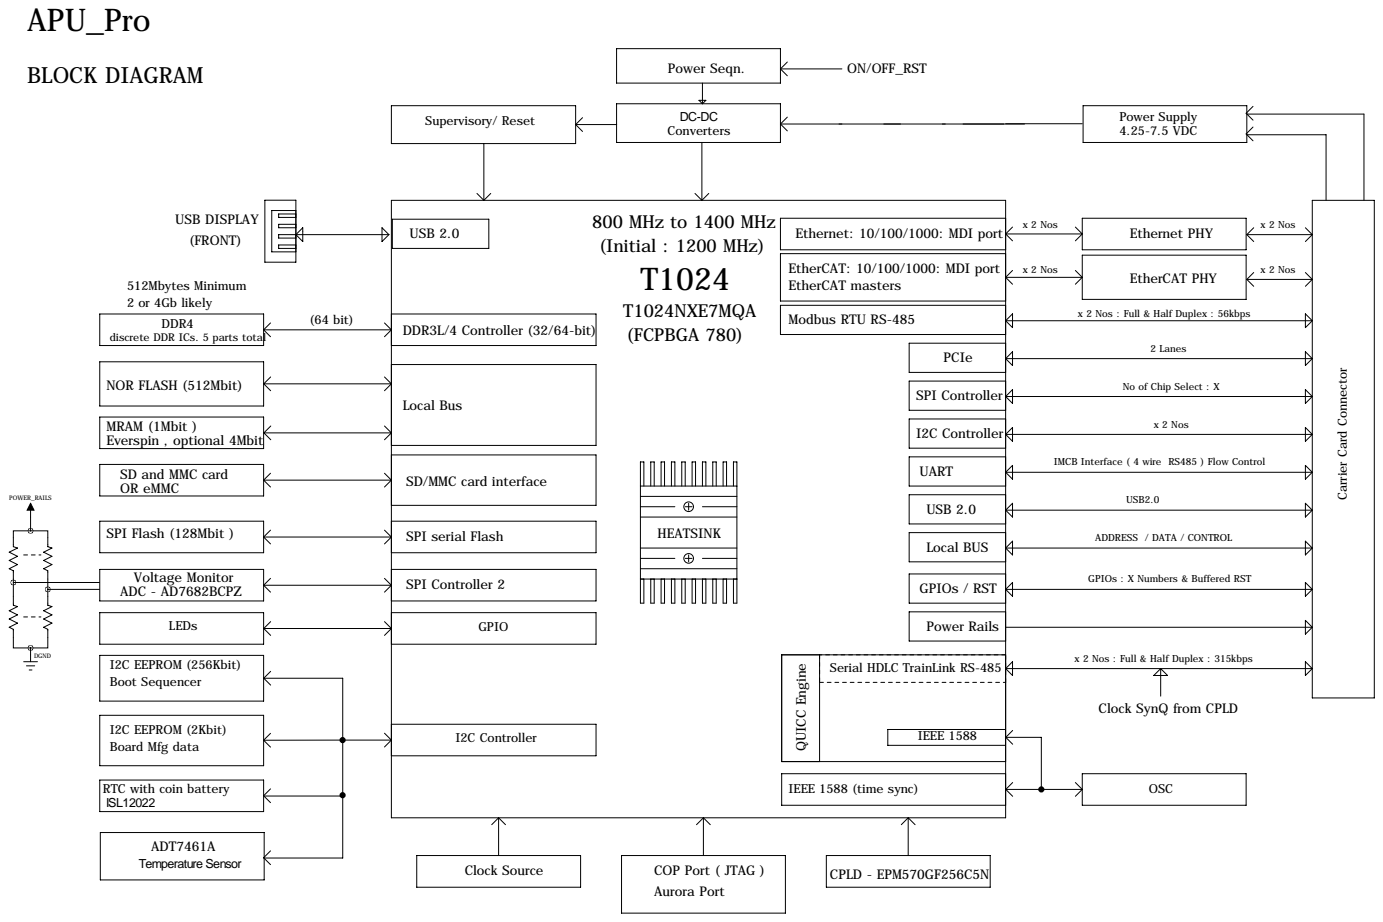
[picture p161: page 1]
OSC; IEEE 1588; ISL12022; Temperature Sensor; LEDs; GPIO; Supervisory/ Reset; Converters; I2C Controller; DDR4; Power Supply; DDR3L/4 Controller (32/64-bit); Local Bus; Everspin , optional 4Mbit; NOR FLASH (512Mbit); SD and MMC card; SD/MMC card interface; SPI Flash (128Mbit ); SPI serial Flash; Clock Source; COP Port ( JTAG ); CPLD - EPM570GF256C5N; (FCPBGA 780); T1024NXE7MQA; MRAM (1Mbit ); (64 bit); 2 or 4Gb likely; 4.25-7.5 VDC; (Initial : 1200 MHz); HEATSINK; 512Mbytes Minimum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

Ethernet: 10/100/1000: MDI port

EtherCAT: 10/100/1000: MDI port
EtherCAT masters

x 2 Nos : Full & Half Duplex : 56kbps

Modbus RTU RS-485

discrete DDR ICs. 5 parts total

Carrier Card Connector

No of Chip Select : X

IMCB Interface ( 4 wire RS485 ) Flow Control

ADDRESS / DATA / CONTROL

Voltage Monitor
SPI Controller 2 ADC - AD7682BCPZ

GPIOs : X Numbers & Buffered RST

x 2 Nos : Full & Half Duplex : 315kbps

Serial HDLC TrainLink RS-485

Clock SynQ from CPLD

I2C EEPROM (2Kbit)
Board Mfg data
