Sayidathahaseen/CCC_NGP_ODC/NGP_ODC_Main/PDLC/VanGuard/Client Docs/Vanguard/Analog Output/Schematic_S3++ AO.pdf

D

1 | 2 | 3 | 4 | 5 | 6

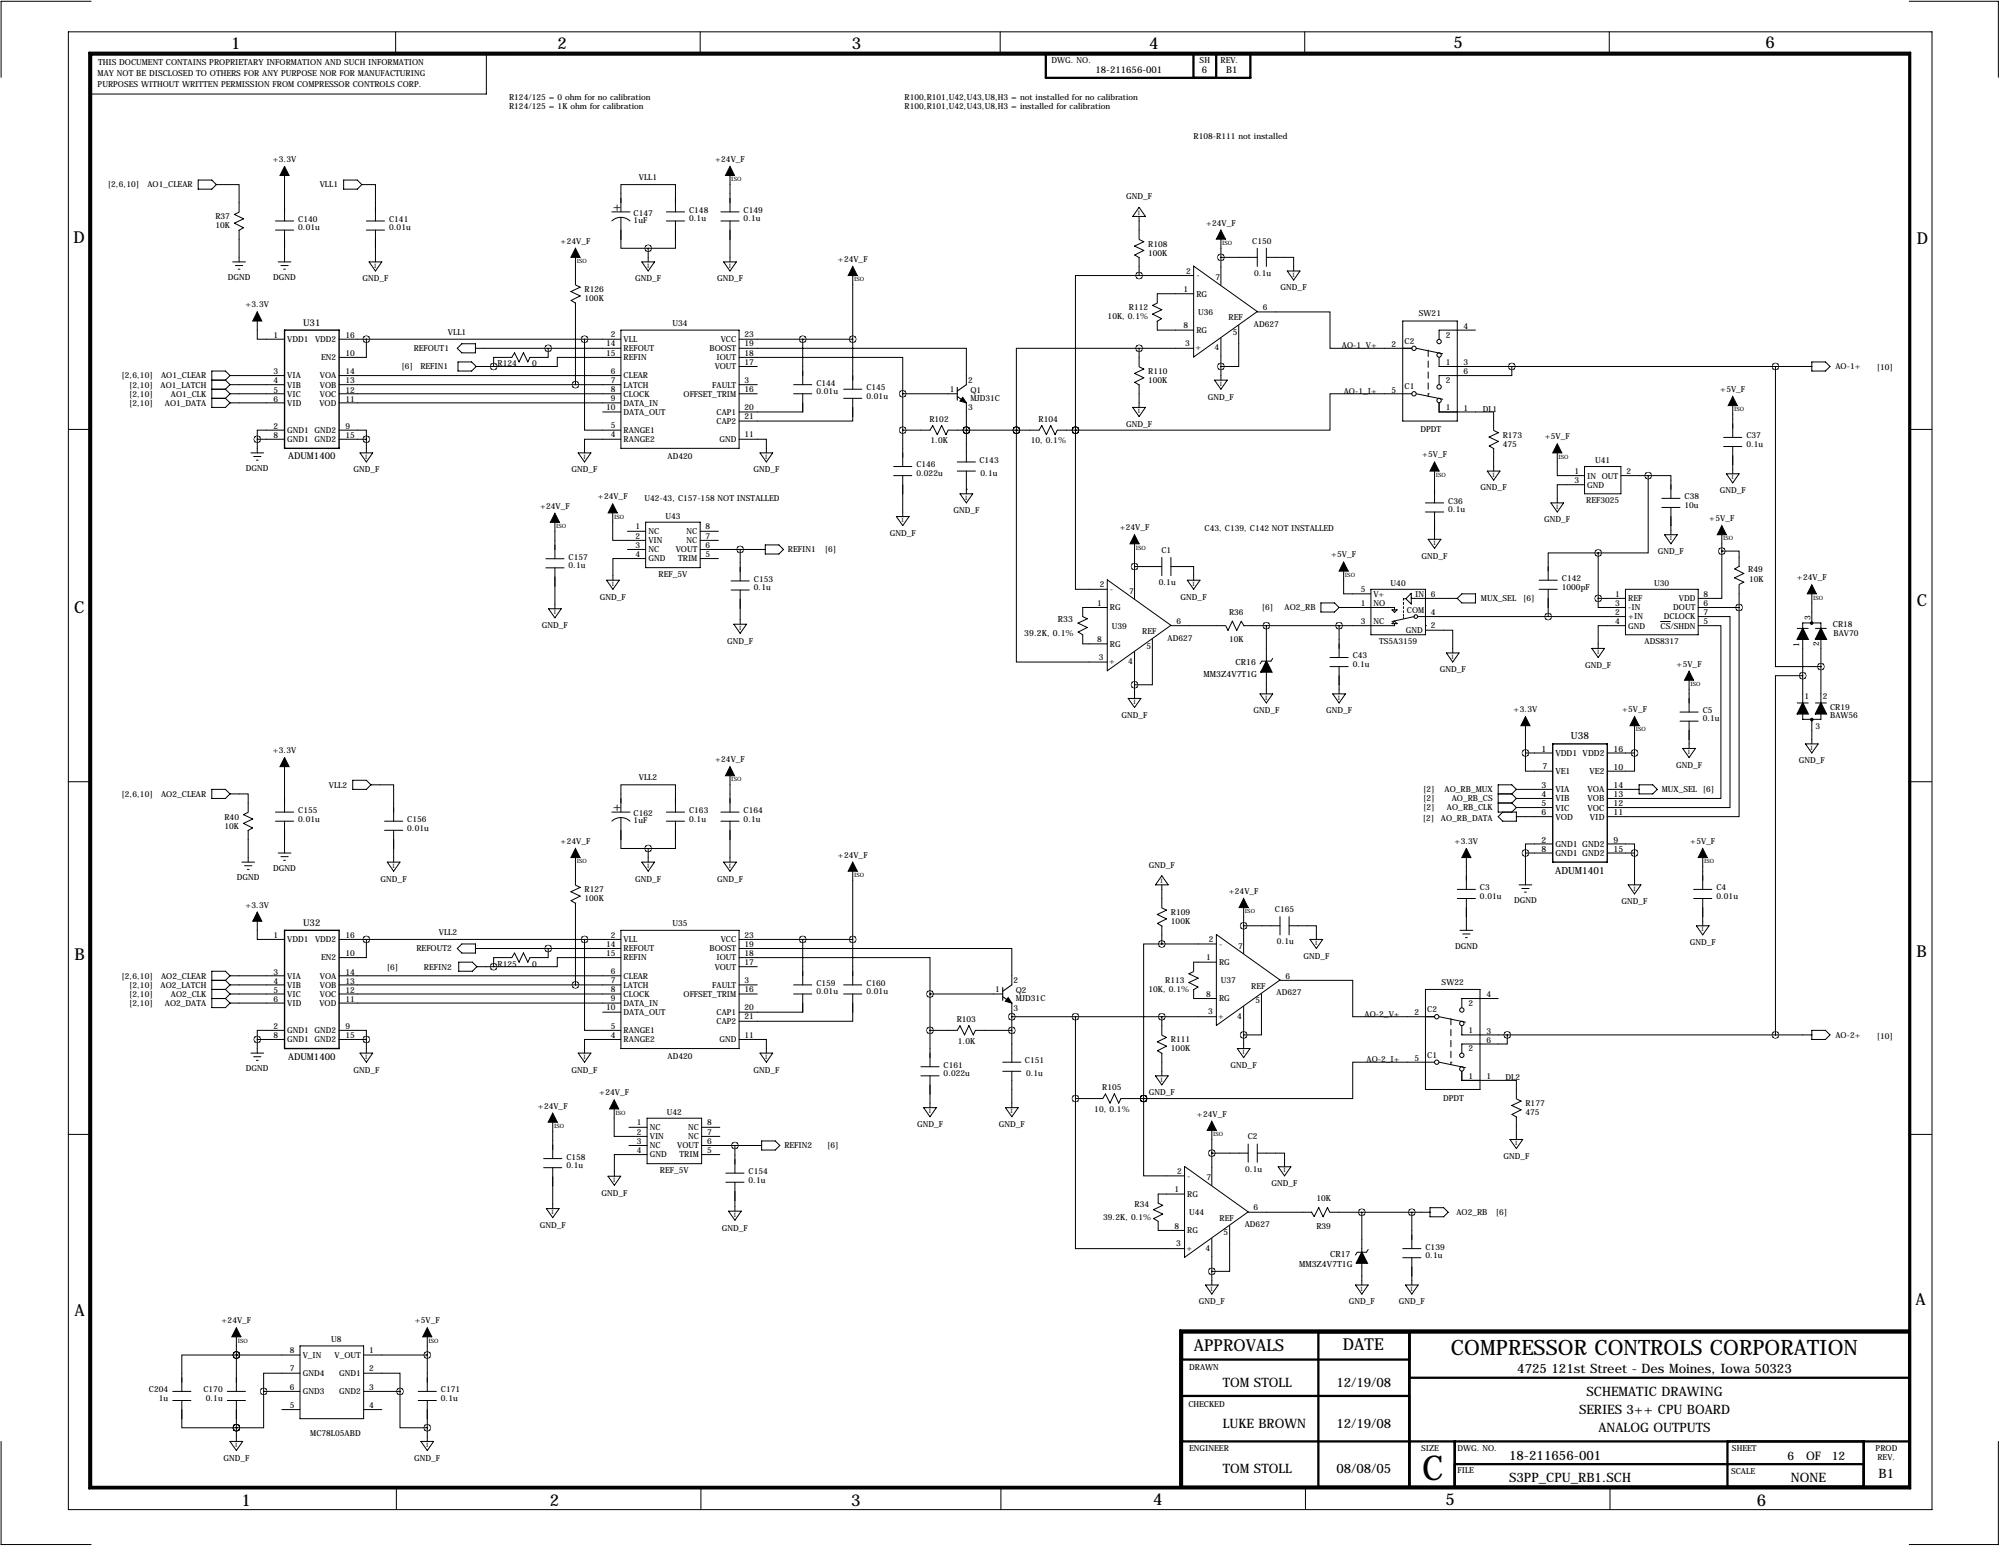
[picture p162: page 1]

THIS DOCUMENT CONTAINS PROPRIETARY INFORMATION AND SUCH INFORMATION MAY NOT BE DISCLOSED TO OTHERS FOR ANY PURPOSE NOR FOR MANUFACTURING PURPOSES WITHOUT WRITTEN PERMISSION FROM COMPRESSOR CONTROLS CORP. | +24V_F | DWG. NO. 18-211656-001 | SH 6 | REV. B1

R124/125 = 0 ohm for no calibration
R124/125 = 1K ohm for calibration

R100,R101,U42,U43,U8,H3 = not installed for no calibration
R100,R101,U42,U43,U8,H3 = installed for calibration

APPROVALS | DATE | COMPRESSOR CONTROLS CORPORATION 4725 121st Street - Des Moines, Iowa 50323

DRAWN TOM STOLL | 12/19/08

CHECKED LUKE BROWN | 12/19/08

ENGINEER TOM STOLL | 08/08/05 | SIZE C | DWG. NO. 18-211656-001 | SHEET | PROD REV.

FILE | SCALE NONE | B1 S3PP_CPU_RB1.SCH
