Sayidathahaseen/CCC_NGP_ODC/NGP_ODC_Main/PDLC/Prodigy HW files/APP Extender Board/Schematics/Rev1/CCC_NGP_APP_Extender_Board_REV1.pdf

THIS DOCUMENT CONTAINS PROPRIETARY INFORMATION AND SUCH INFORMATION MAY NOT BE DISCLOSED TO OTHERS FOR ANY PURPOSE NOR FOR MANUFACTURING

PURPOSES WITHOUT WRITTEN PERMISSION FROM COMPRESSOR CONTROLS CORP.

APPROVALS | DATE | COMPRESSOR CONTROLS CORPORATION 4725 121st Street - Des Moines, Iowa 50323
DRAWN | 08 June 2012

CHECKED

ENGINEER | | SIZE C | DWG. NO. | SHEET | PROD REV.
| | | FILE 18-xxxxxx-rev-1.0 | SCALE
1 | 2 | 3 | 4 | 5 | 6

A

B

C

D

DWG. NO. | SH | REV.

D

C

B

A

REV | AUTHOR | CHANGES
0.0 | Preliminary Schematics

# REVISION HISTORY

# DATE

# 28 MAY 2012

0.2 | 29 MAY 2012 | Schematics for review

# REVISION HISTORY

# Vijay

# Vijay

0.2 | 08 JUNE 2012 | Vijay | Added ESD diodes
1.0 | 26 JUNE 2012 | Vijay | Release version

D

D

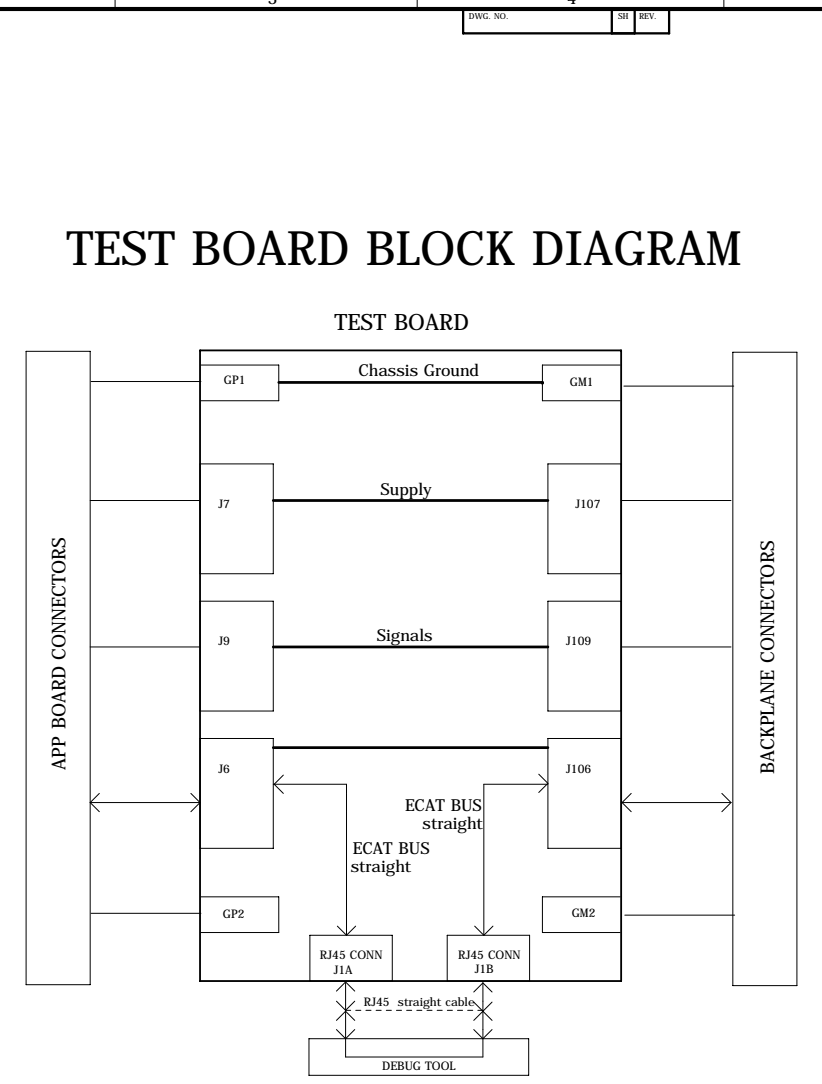
[picture p163: page 2]

TEST BOARD BLOCK DIAGRAM

APPROVALS | DATE | COMPRESSOR CONTROLS CORPORATION 4725 121st Street - Des Moines, Iowa 50323

DRAWN | 31 MAY 2012

CHECKED

D

D

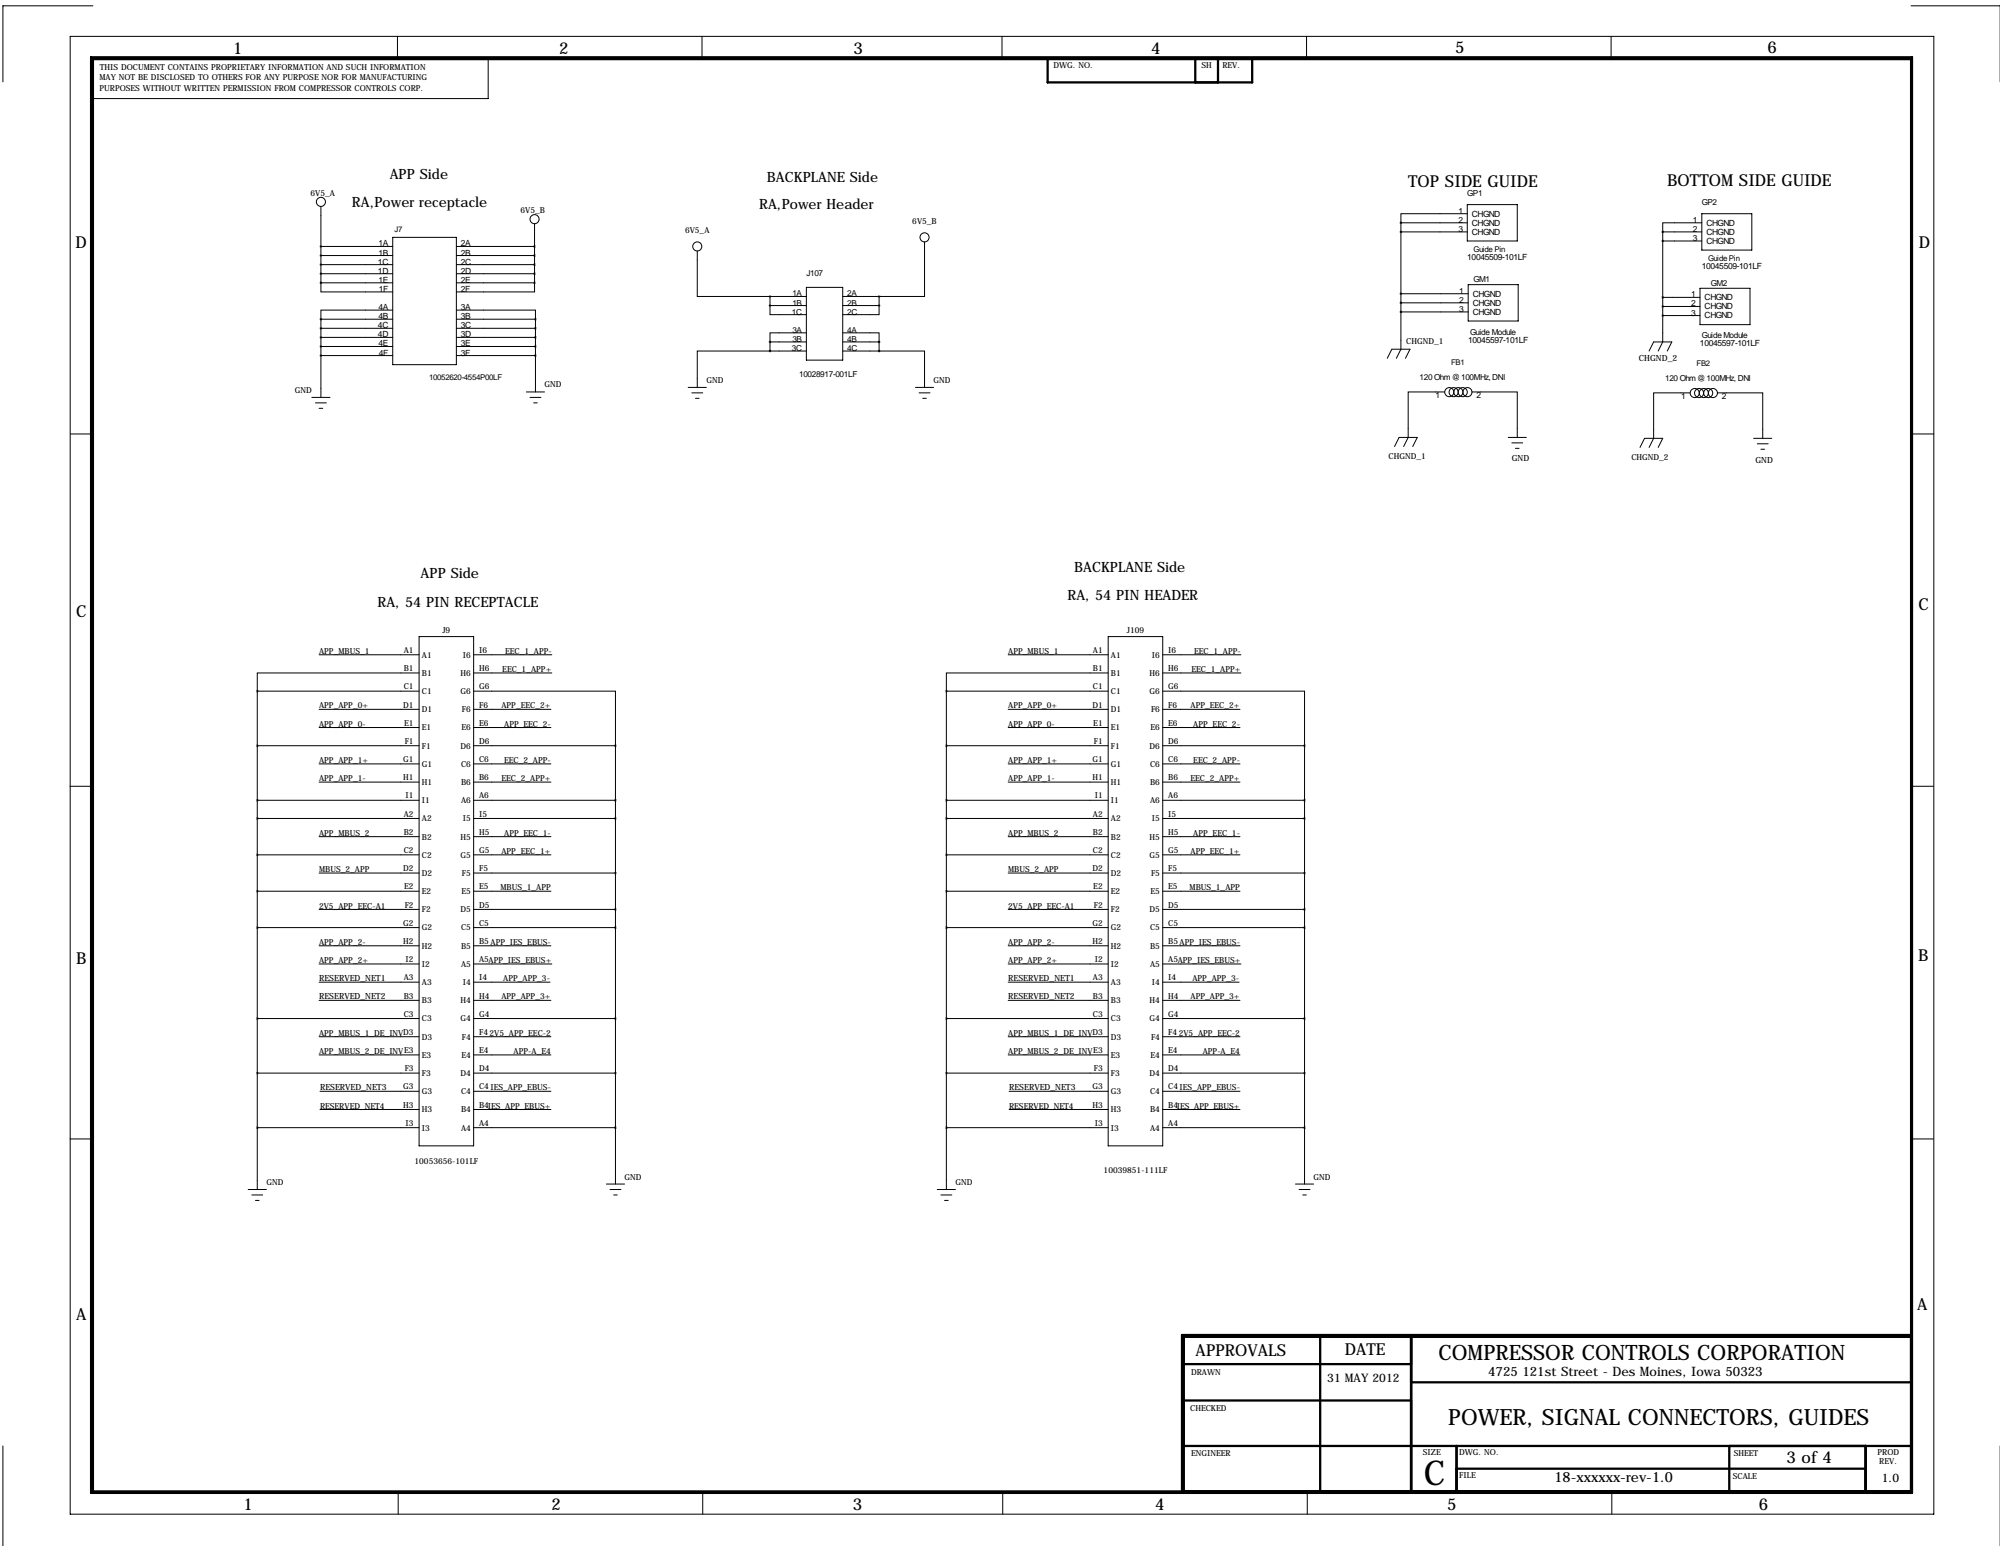
[picture p164: page 3]

1B | 2B
1C | 2C
1D | 2D
1E | 2E

4B | 3B
4C | 3C
4D | 3D
4E | 3E
4F | 3F

3B | 4B
3C | 4C

APPROVALS | DATE | COMPRESSOR CONTROLS CORPORATION 4725 121st Street - Des Moines, Iowa 50323

DRAWN | 31 MAY 2012

CHECKED

POWER, SIGNAL CONNECTORS, GUIDES

18-xxxxxx-rev-1.0

D

D

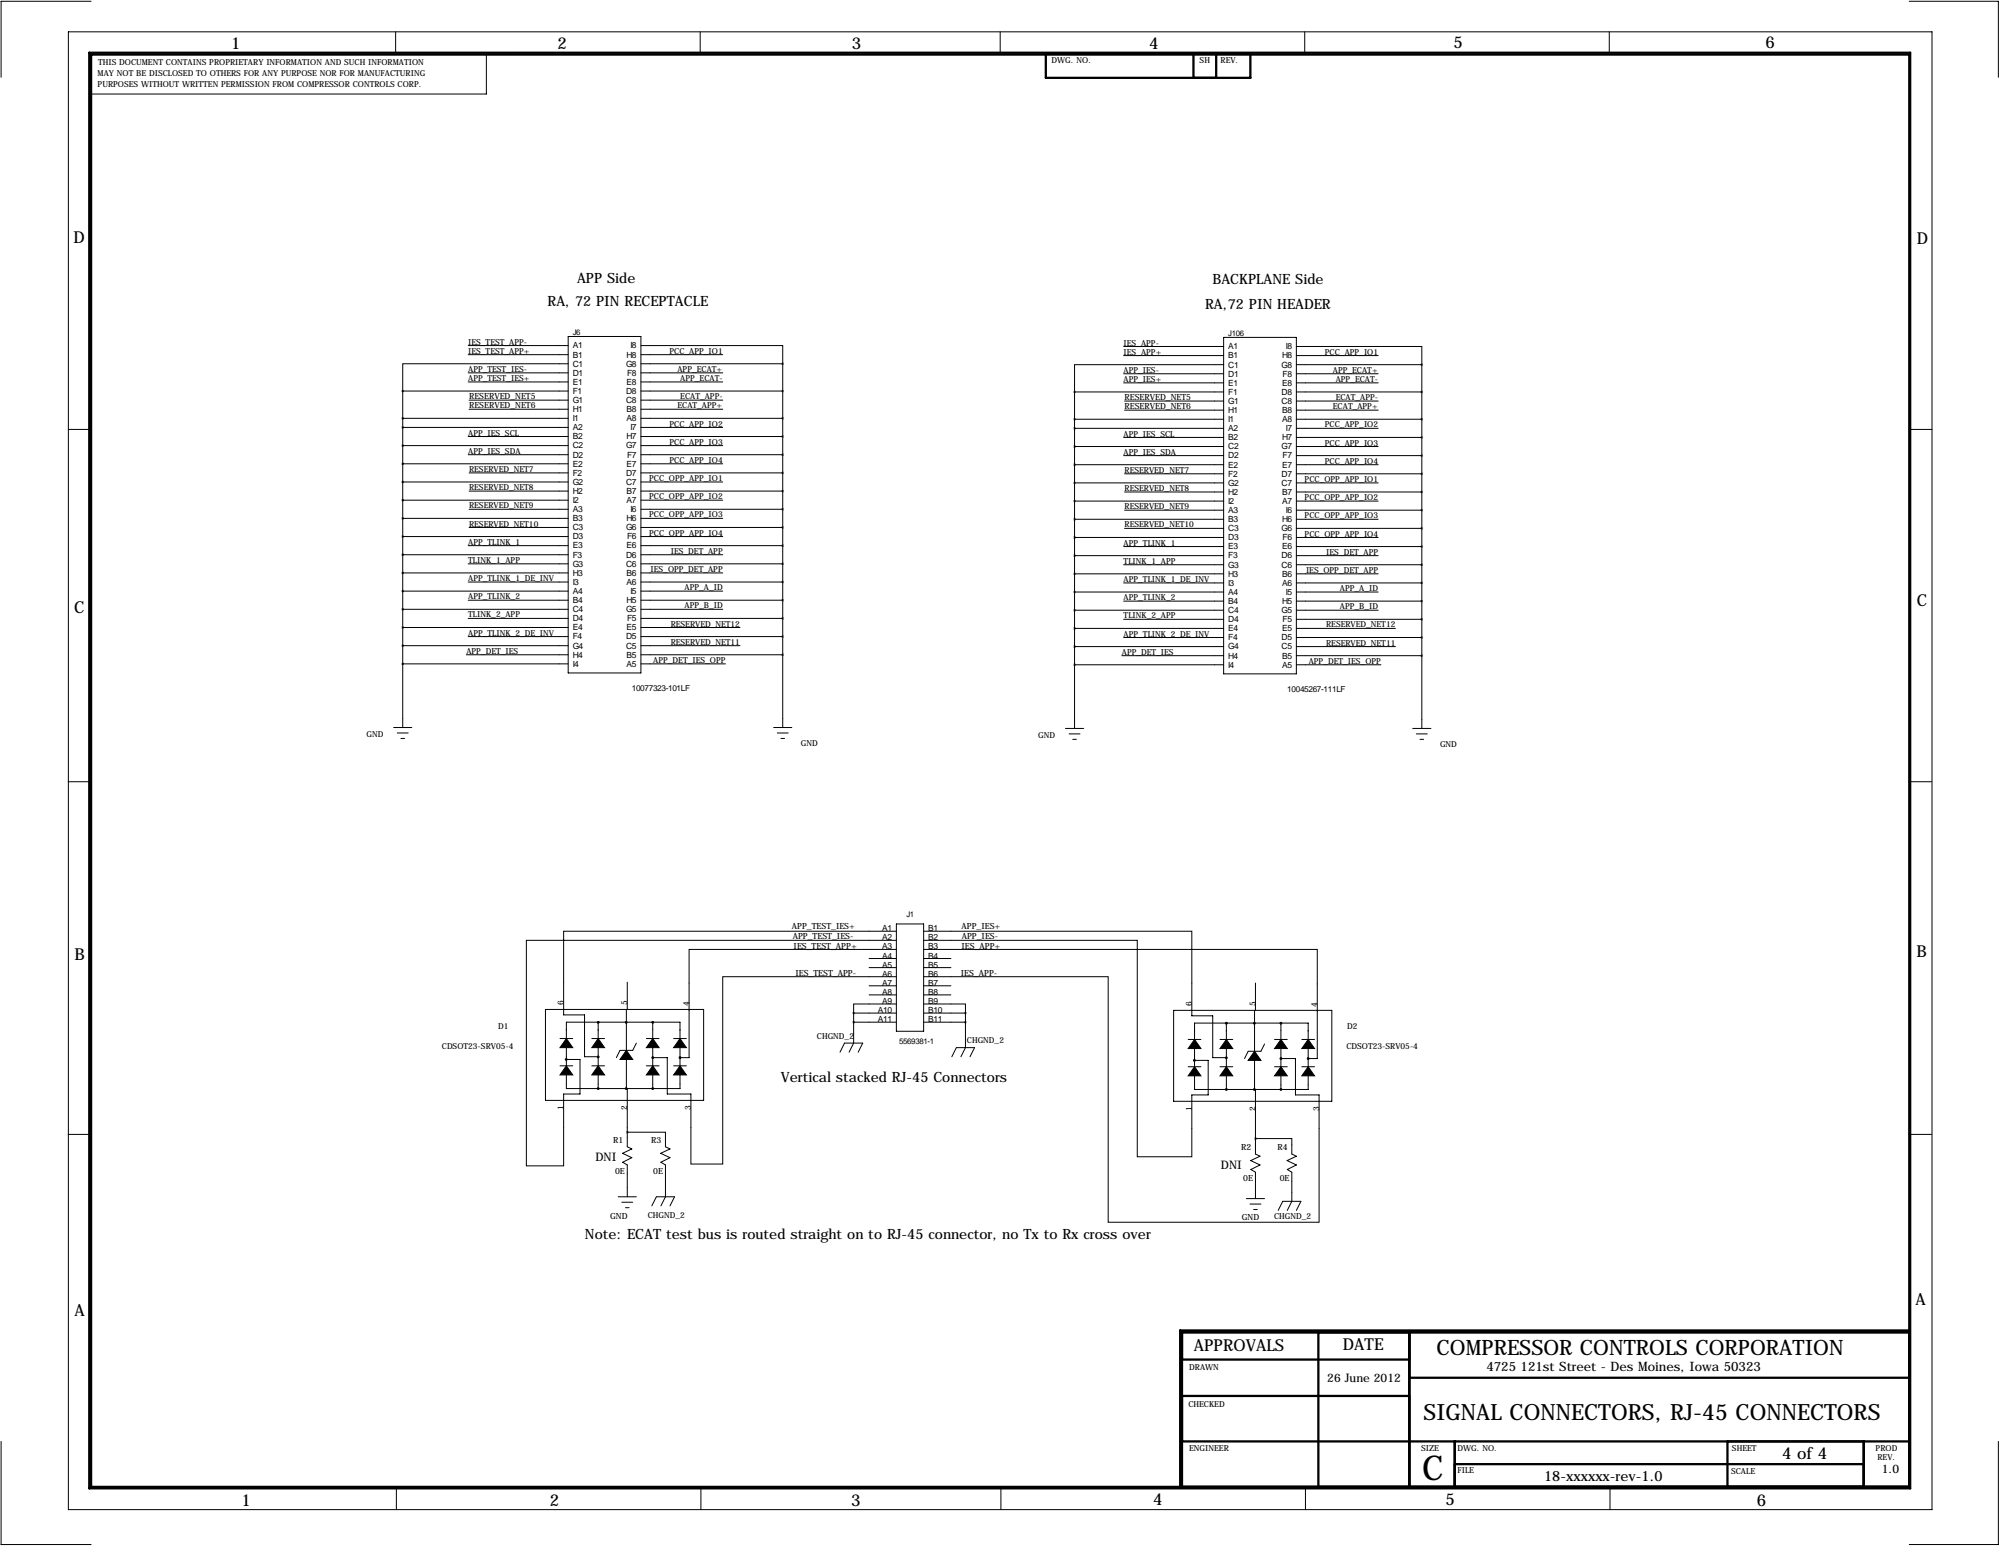
[picture p165: page 4]

APP_TEST_IES-A2 | | APP_IES-B2
IES_TEST_APP+ A3 | | B3 IES_APP+
A4 A5 IES_TEST_APP-A6 | | B4 B5 B6 IES_APP-

A10 | | B10
A11 | | B11

Vertical stacked RJ-45 Connectors

Note: ECAT test bus is routed straight on to RJ-45 connector, no Tx to Rx cross over

APPROVALS | DATE | COMPRESSOR CONTROLS CORPORATION 4725 121st Street - Des Moines, Iowa 50323

DRAWN | 26 June 2012

CHECKED

SIGNAL CONNECTORS, RJ-45 CONNECTORS
