Sayidathahaseen/CCC_NGP_ODC/NGP_ODC_Main/PDLC/Prodigy HW files/IBS/Rev3/Schematics/18-IES-NGP_rev3.pdf

THIS DOCUMENT CONTAINS PROPRIETARY INFORMATION AND SUCH INFORMATION MAY NOT BE DISCLOSED TO OTHERS FOR ANY PURPOSE NOR FOR MANUFACTURING

PURPOSES WITHOUT WRITTEN PERMISSION FROM COMPRESSOR CONTROLS CORP.

APPROVALS | DATE | COMPRESSOR CONTROLS CORPORATION 4725 121st Street - Des Moines, Iowa 50323
DRAWN Vijay | 19 Sep 2011

CHECKED

ENGINEER Vijay | | SIZE C | DWG. NO. | SHEET | PROD REV.
| | | FILE 18-xxxxxx-rev-2.0 | SCALE
1 | 2 | 3 | 4 | 5 | 6

A

B

C

D

DWG. NO. | SH | REV.

D

C

B

A

REV | AUTHOR | CHANGES

# REVISION HISTORY

# DATE

1.0 | 12 JULY 2011 | Vijay | TEST PADS ADDED
1.0 | 13 JULY 2011 | Vijay | Comments implemented & Chasis GND added
2.0 | 19 Sep 2011 | Vijay | Out LED connection is changed, footprint errors corrected EBUS termination resistor placement is optimised
3.0 | 15 Feb 2012 | Vijay | reduced Hot swap current limit from 5A to 3A moved net LINK_MII[0] from U6.26 to U6.27 moved net LINK_MII[2]_6 from U19.26 to U19.27 flipped magnetics(T1) connections replaced mux IC U3(ADG774A,VFQFN) with ADG774BRZ,SOIC-16 package changed crystals to industrial temperature grade ones input supply lines are fused

D

D

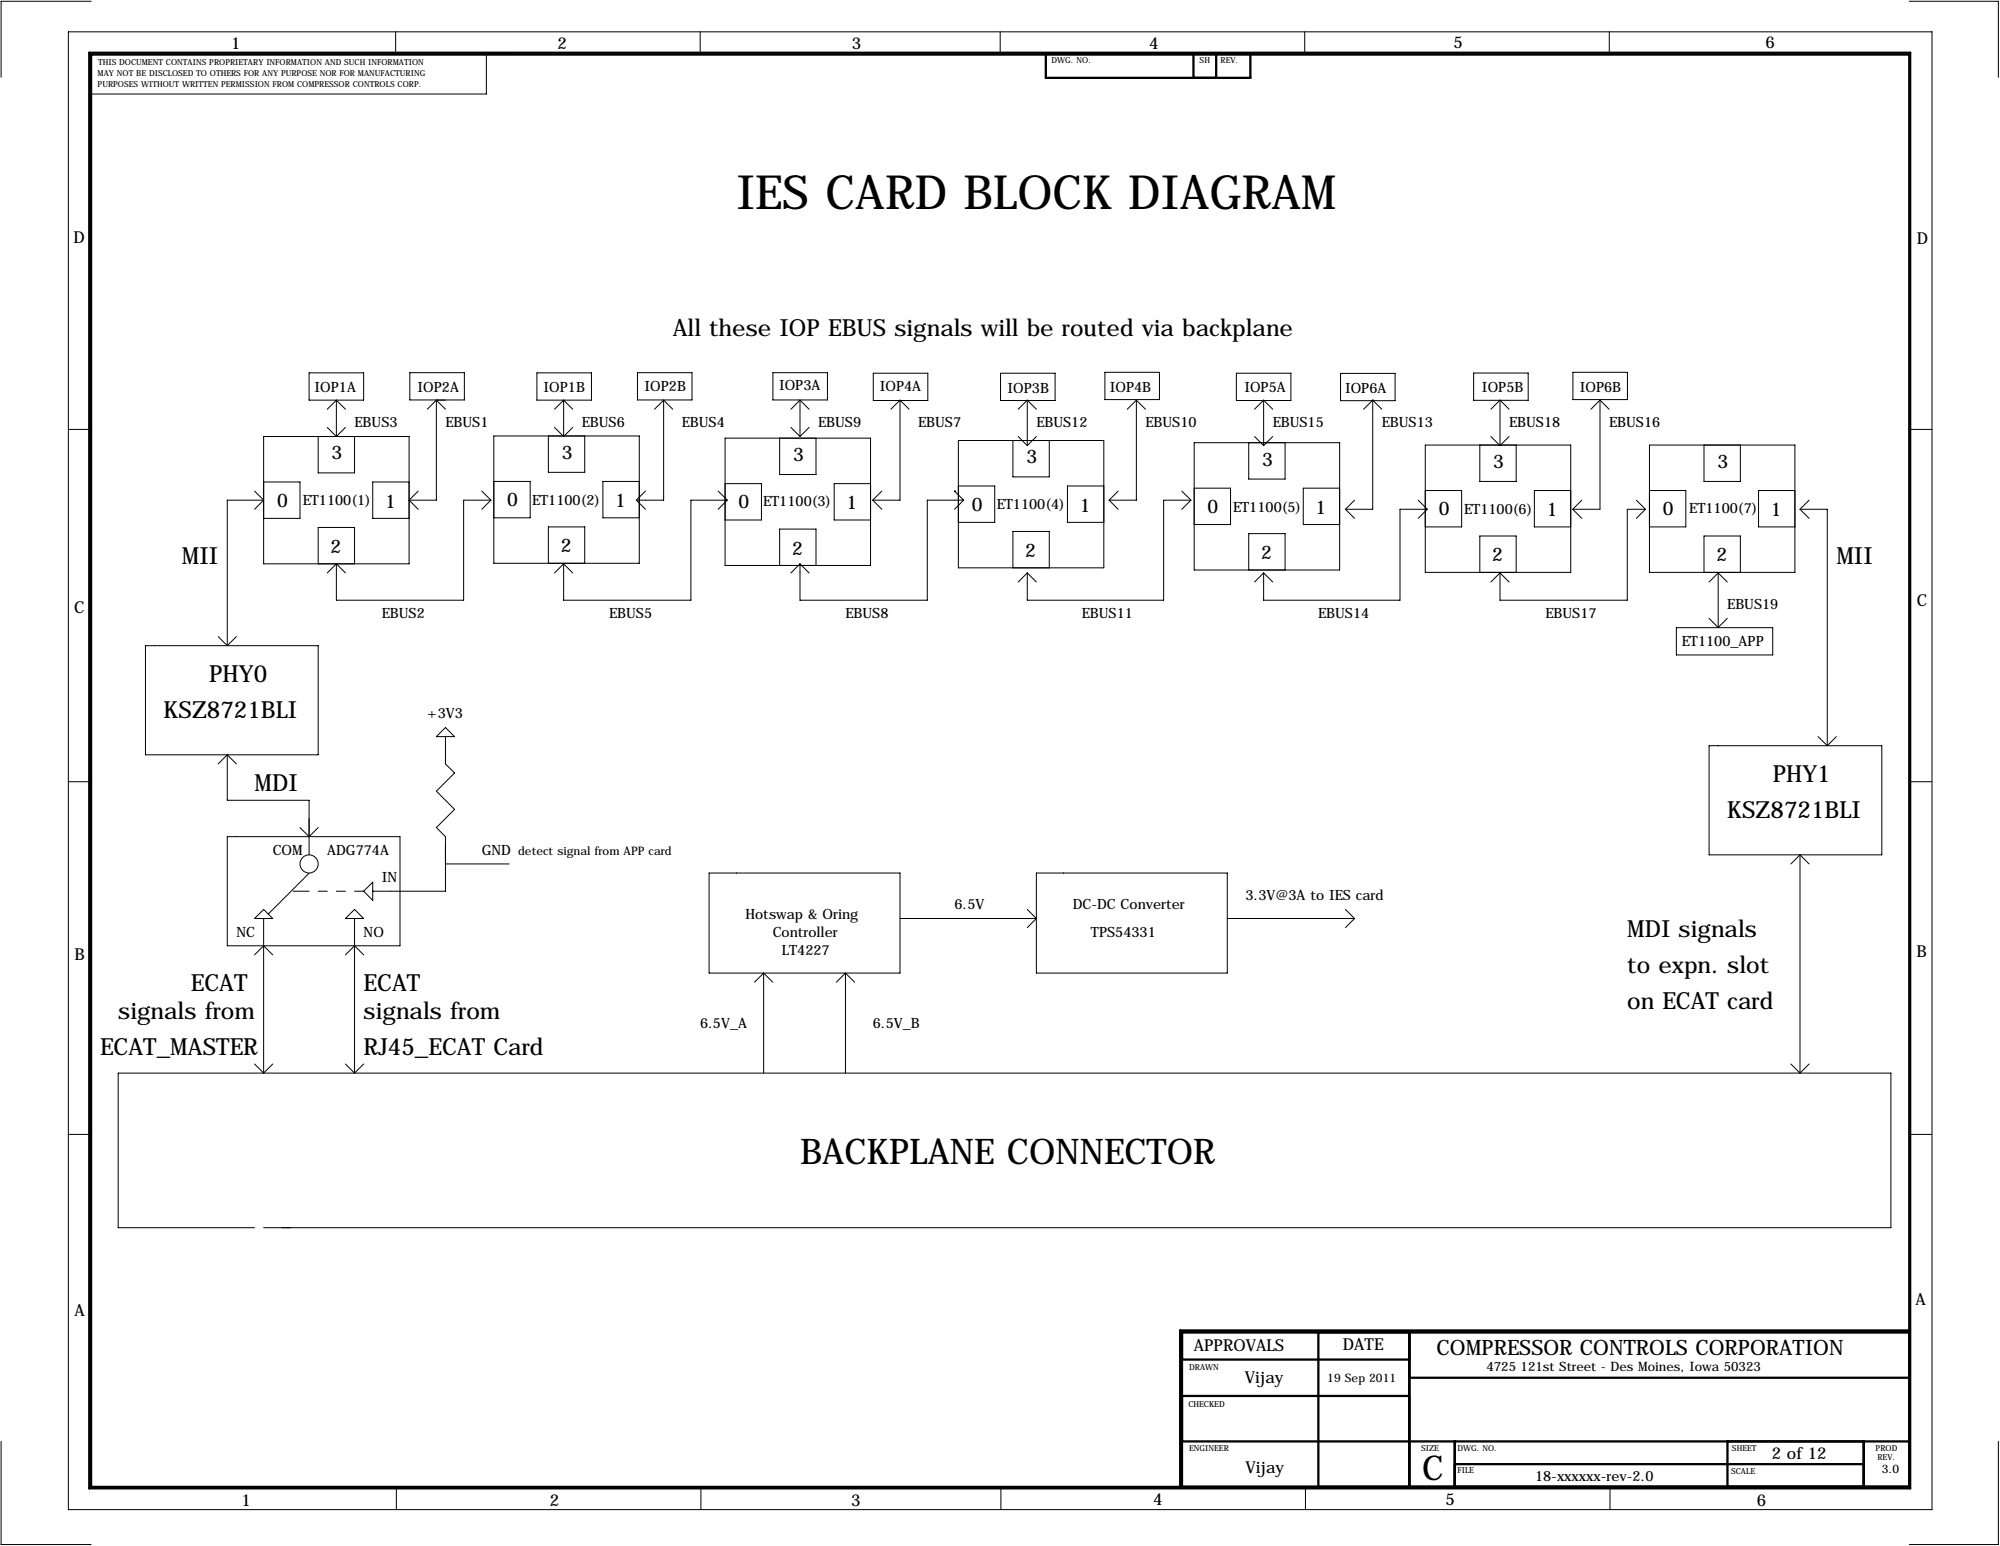
[picture p166: page 2]
IOP1A; IOP2A; IOP1B; IOP2B; IOP3A; IOP4A; IOP3B; IOP4B; IOP5A; IOP6A; IOP5B; IOP6B; ET1100_APP; PHY0; KSZ8721BLI; MII; PHY1; MDI signals; BACKPLANE CONNECTOR; Hotswap & Oring; Controller; TPS54331; 3.3V@3A to IES card; EBUS3; EBUS1; EBUS2; EBUS6; EBUS4; EBUS5; EBUS9; EBUS7; EBUS8; EBUS12; EBUS10; EBUS11; EBUS15; EBUS13; EBUS14; EBUS17; EBUS18; EBUS16; ECAT_MASTER; EBUS19; RJ45_ECAT Card; COM; ADG774A; GND; signals from; ECAT; MDI

IES CARD BLOCK DIAGRAM

All these IOP EBUS signals will be routed via backplane

detect signal from APP card

DC-DC Converter

to expn. slot

on ECAT card

APPROVALS | DATE | COMPRESSOR CONTROLS CORPORATION 4725 121st Street - Des Moines, Iowa 50323

DRAWN Vijay | 19 Sep 2011

CHECKED

D

D

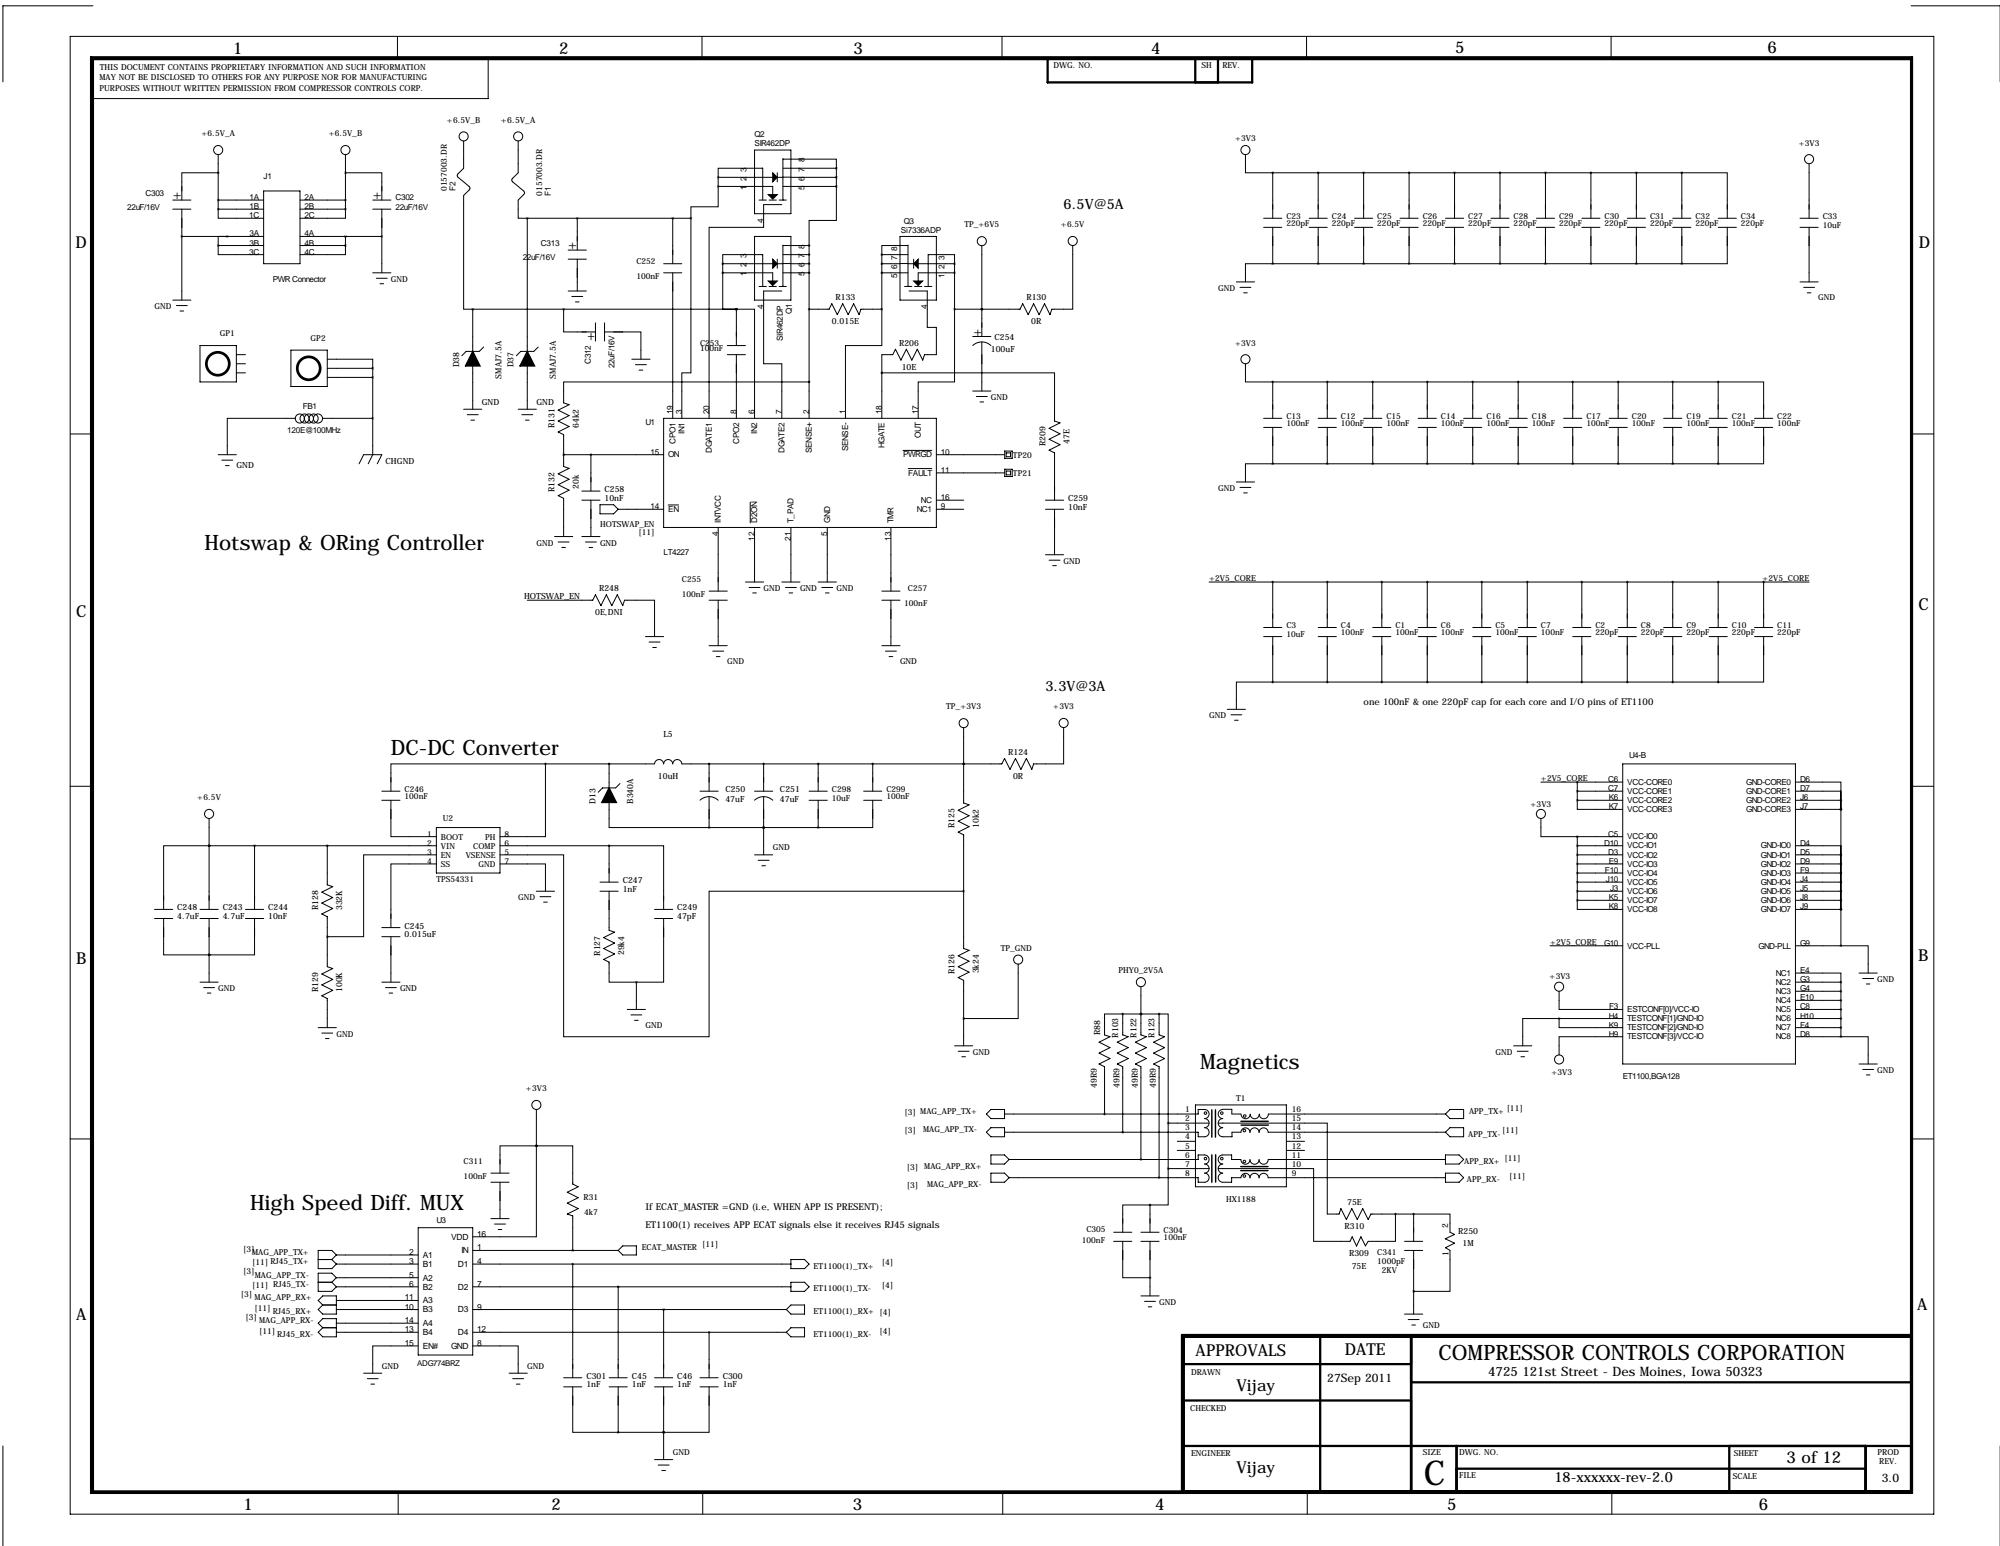
[picture p167: page 3]

one 100nF & one 220pF cap for each core and I/O pins of ET1100

High Speed Diff. MUX

If ECAT_MASTER =GND (i.e, WHEN APP IS PRESENT);

ET1100(1) receives APP ECAT signals else it receives RJ45 signals

APPROVALS | DATE | COMPRESSOR CONTROLS CORPORATION 4725 121st Street - Des Moines, Iowa 50323

DRAWN Vijay | 27Sep 2011

CHECKED

18-xxxxxx-rev-2.0

D

D

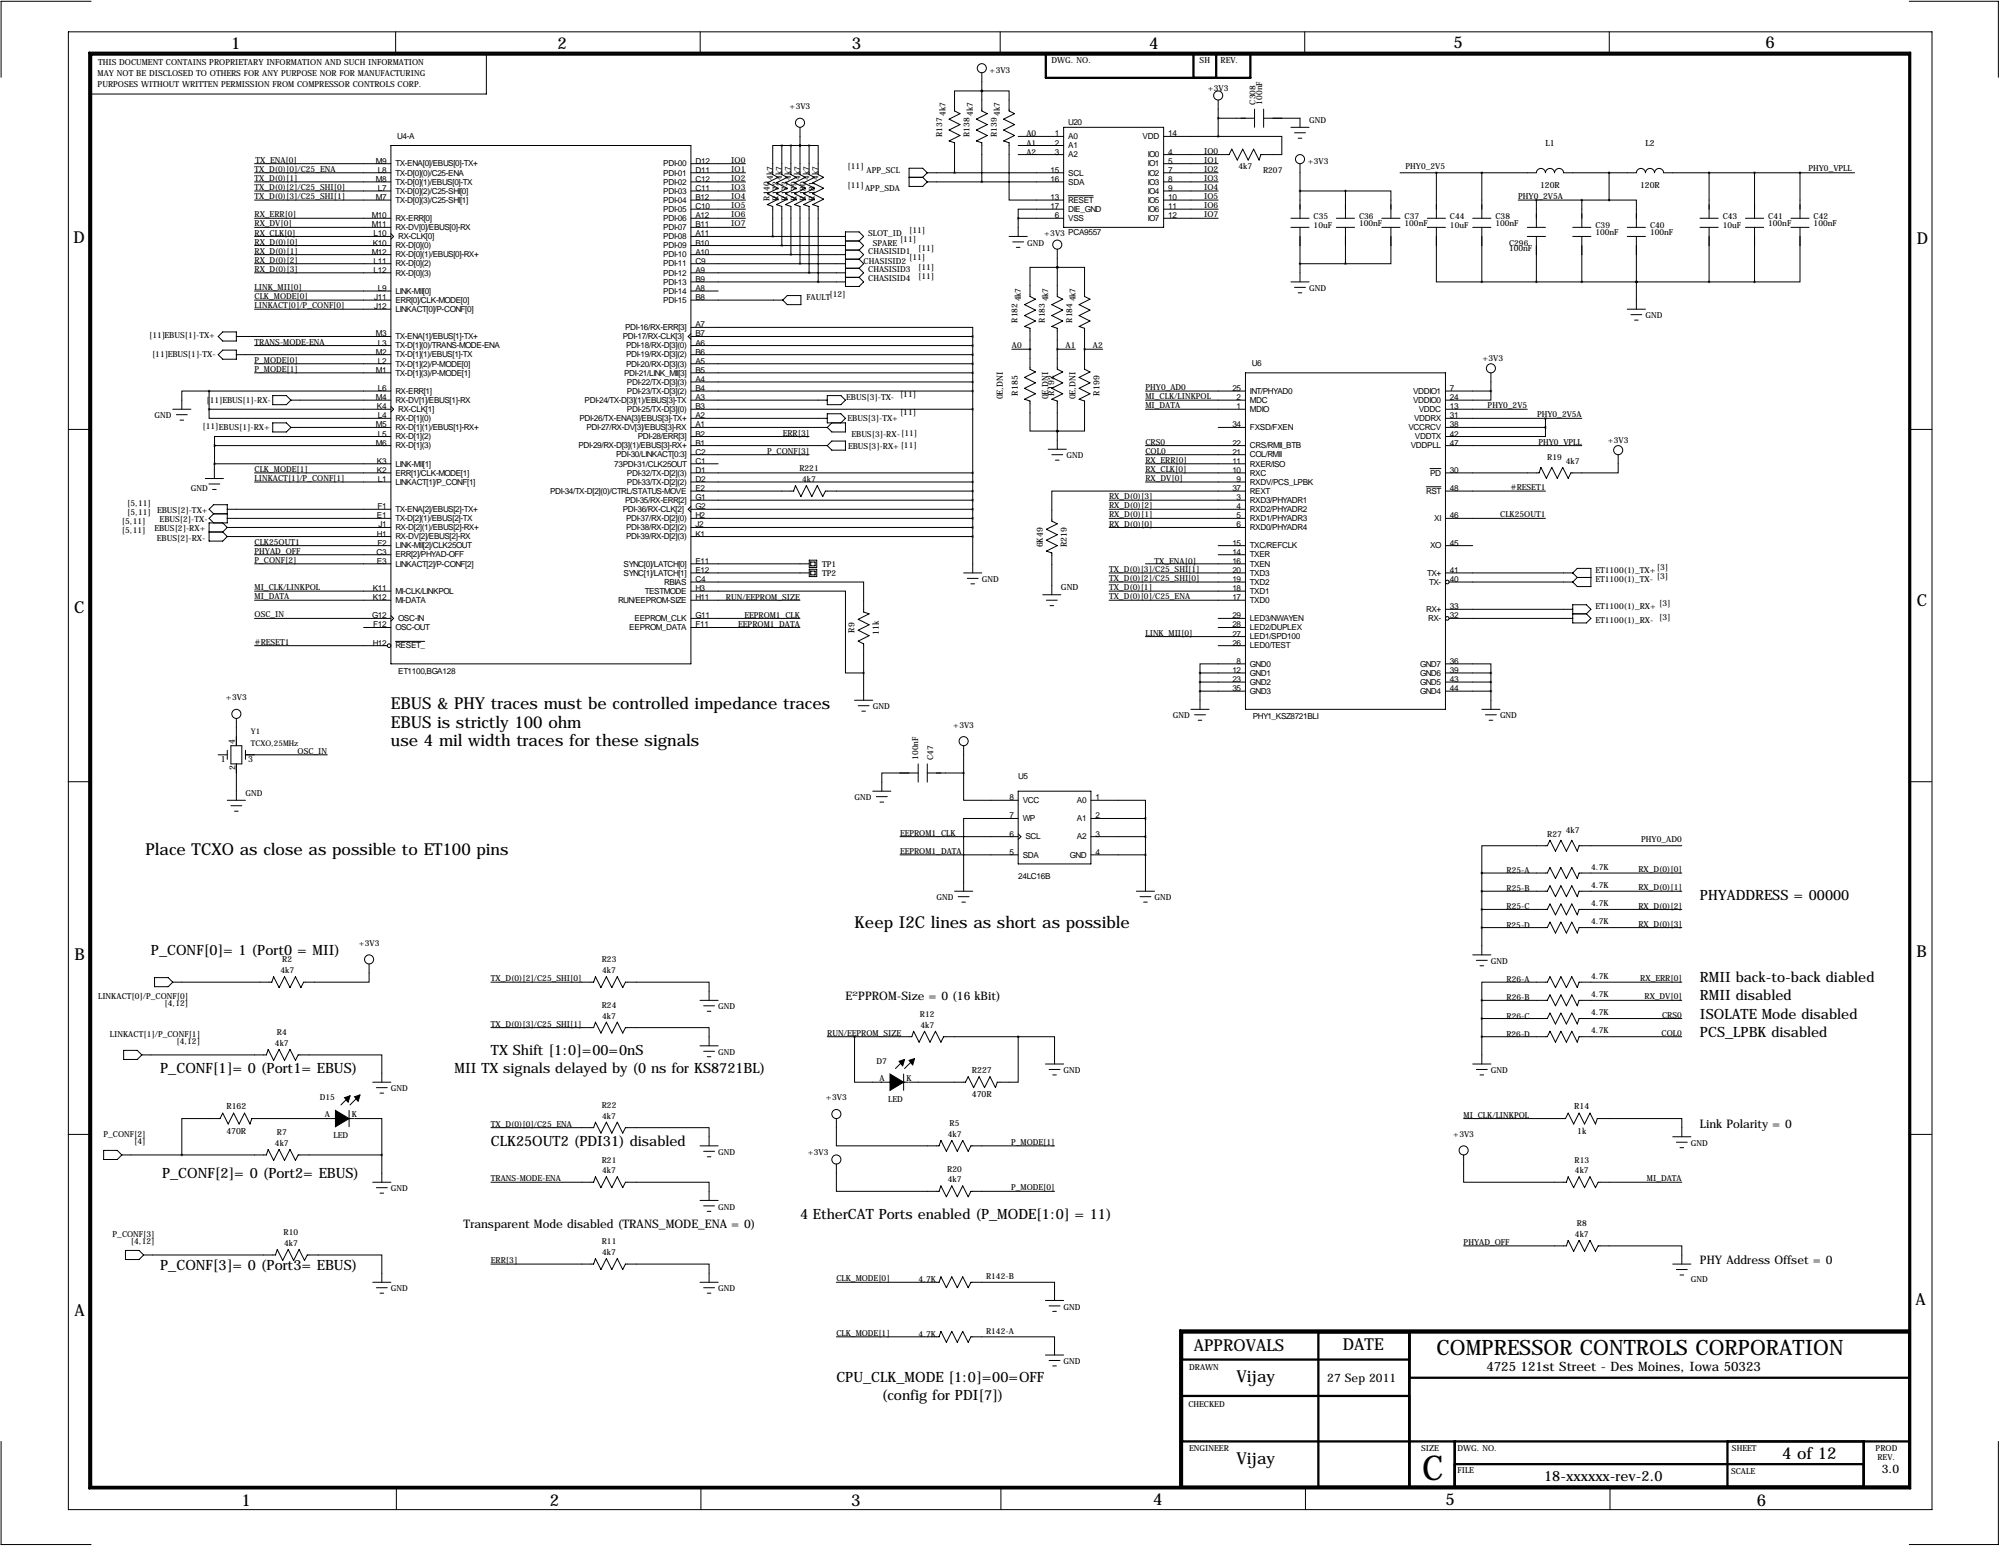
[picture p168: page 4]

A3 PDI-24/TX-D[3](1)/EBUS[3]-TX

A2 PDI-26/TX-ENA[3]/EBUS[3]-TX+
A1 PDI-27/RX-DV[3]/EBUS[3]-RX

B1 PDI-29/RX-D[3](1)/EBUS[3]-RX+

E2 PDI-34/TX-D[2](0)/CTRL/STATUS-MOVE

EBUS & PHY traces must be controlled impedance traces
EBUS is strictly 100 ohm
use 4 mil width traces for these signals

Place TCXO as close as possible to ET100 pins

Keep I2C lines as short as possible

RMII back-to-back diabled
RMII disabled
ISOLATE Mode disabled
PCS_LPBK disabled

MII TX signals delayed by (0 ns for KS8721BL)

APPROVALS | DATE | COMPRESSOR CONTROLS CORPORATION 4725 121st Street - Des Moines, Iowa 50323

DRAWN Vijay | 27 Sep 2011

CHECKED

D

D

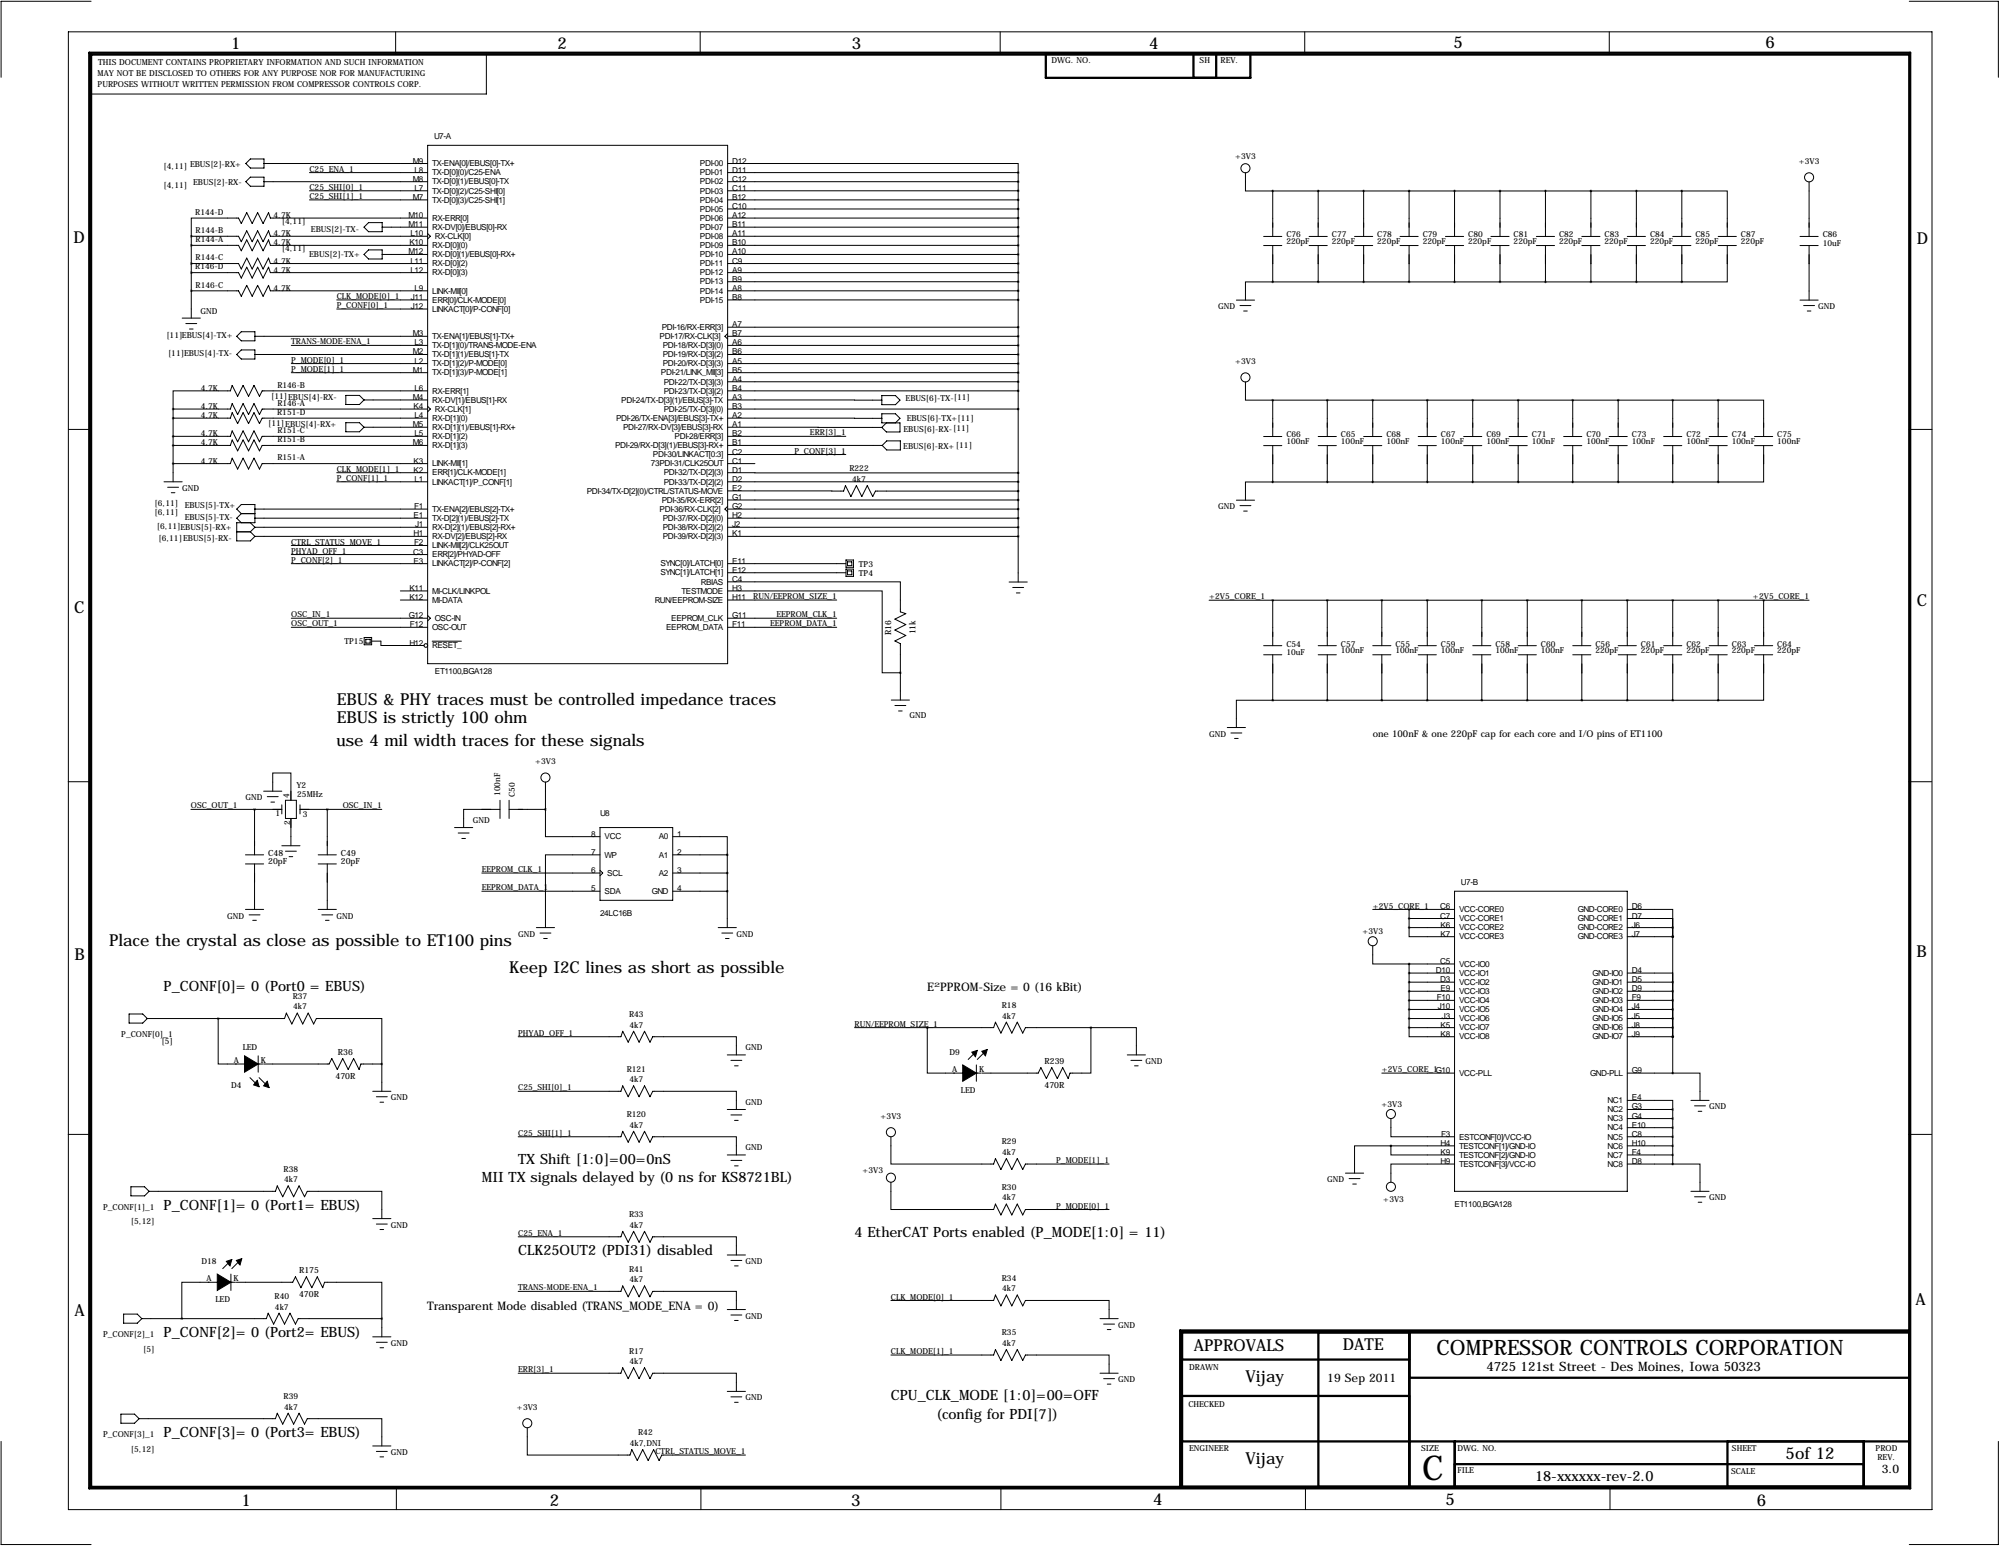
[picture p169: page 5]

A3 PDI-24/TX-D[3](1)/EBUS[3]-TX

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

B1 PDI-29/RX-D[3](1)/EBUS[3]-RX+

E2 PDI-34/TX-D[2](0)/CTRL/STATUS-MOVE

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

one 100nF & one 220pF cap for each core and I/O pins of ET1100

Place the crystal as close as possible to ET100 pins

Keep I2C lines as short as possible

MII TX signals delayed by (0 ns for KS8721BL)

APPROVALS | DATE | COMPRESSOR CONTROLS CORPORATION 4725 121st Street - Des Moines, Iowa 50323

DRAWN Vijay | 19 Sep 2011

CHECKED

D

D

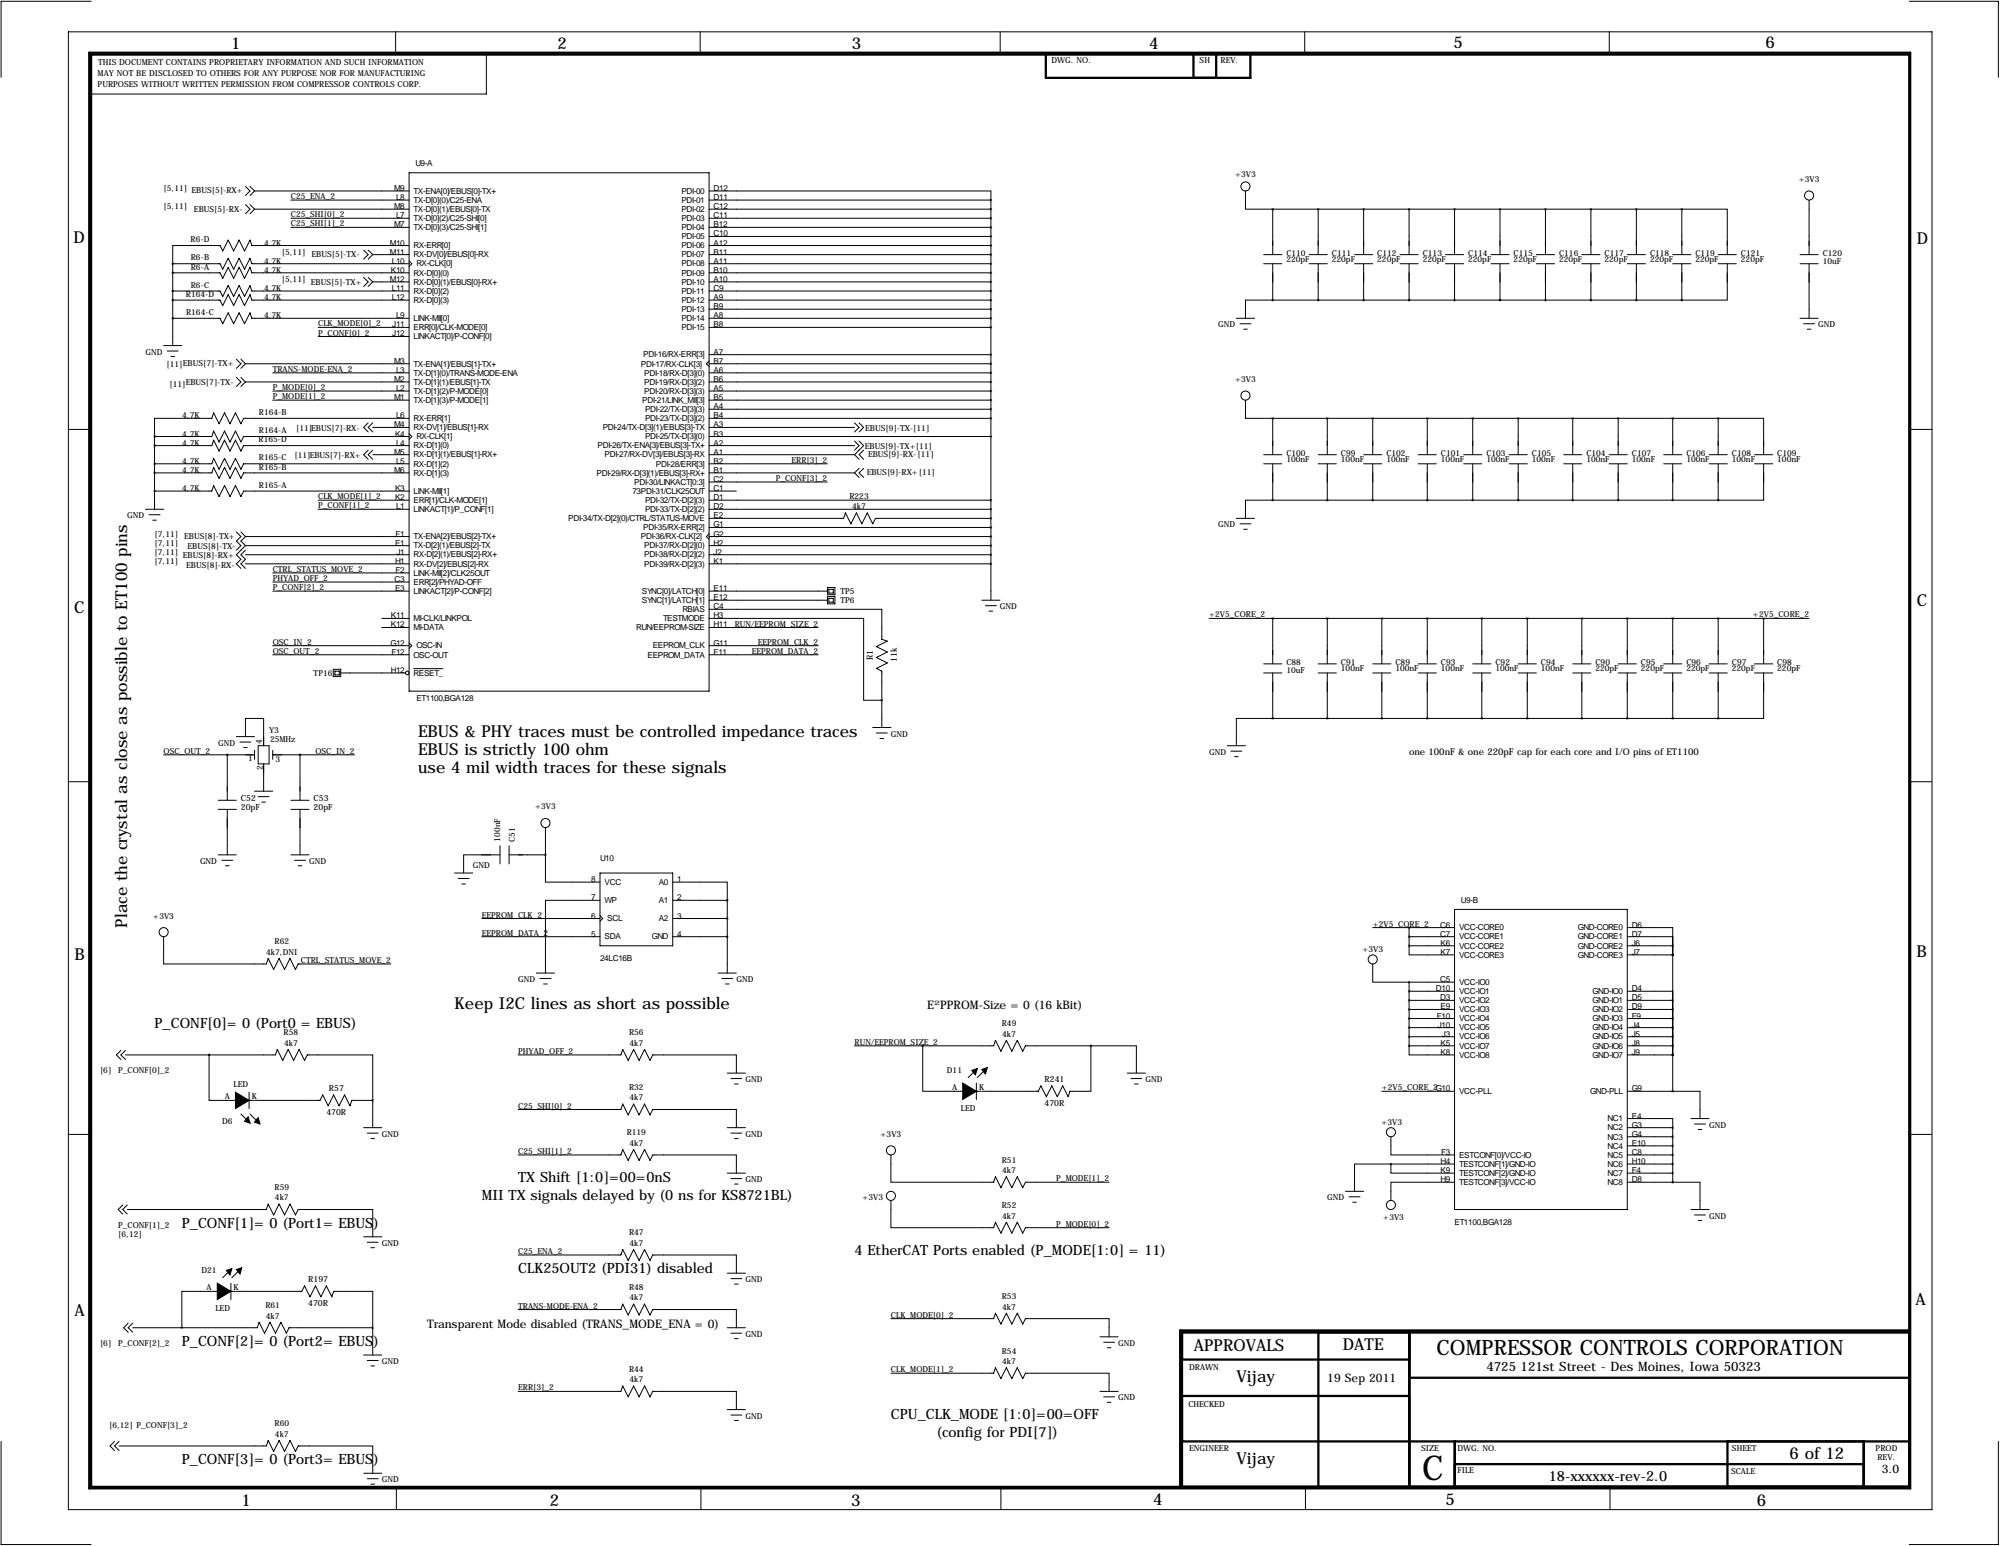
[picture p170: page 6]

A3 PDI-24/TX-D[3](1)/EBUS[3]-TX

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

B1 PDI-29/RX-D[3](1)/EBUS[3]-RX+

E2 PDI-34/TX-D[2](0)/CTRL/STATUS-MOVE

Place the crystal as close as possible to ET100 pins

EBUS & PHY traces must be controlled impedance traces

use 4 mil width traces for these signals

Keep I2C lines as short as possible

MII TX signals delayed by (0 ns for KS8721BL)

APPROVALS | DATE | COMPRESSOR CONTROLS CORPORATION 4725 121st Street - Des Moines, Iowa 50323

DRAWN Vijay | 19 Sep 2011

CHECKED

D

D

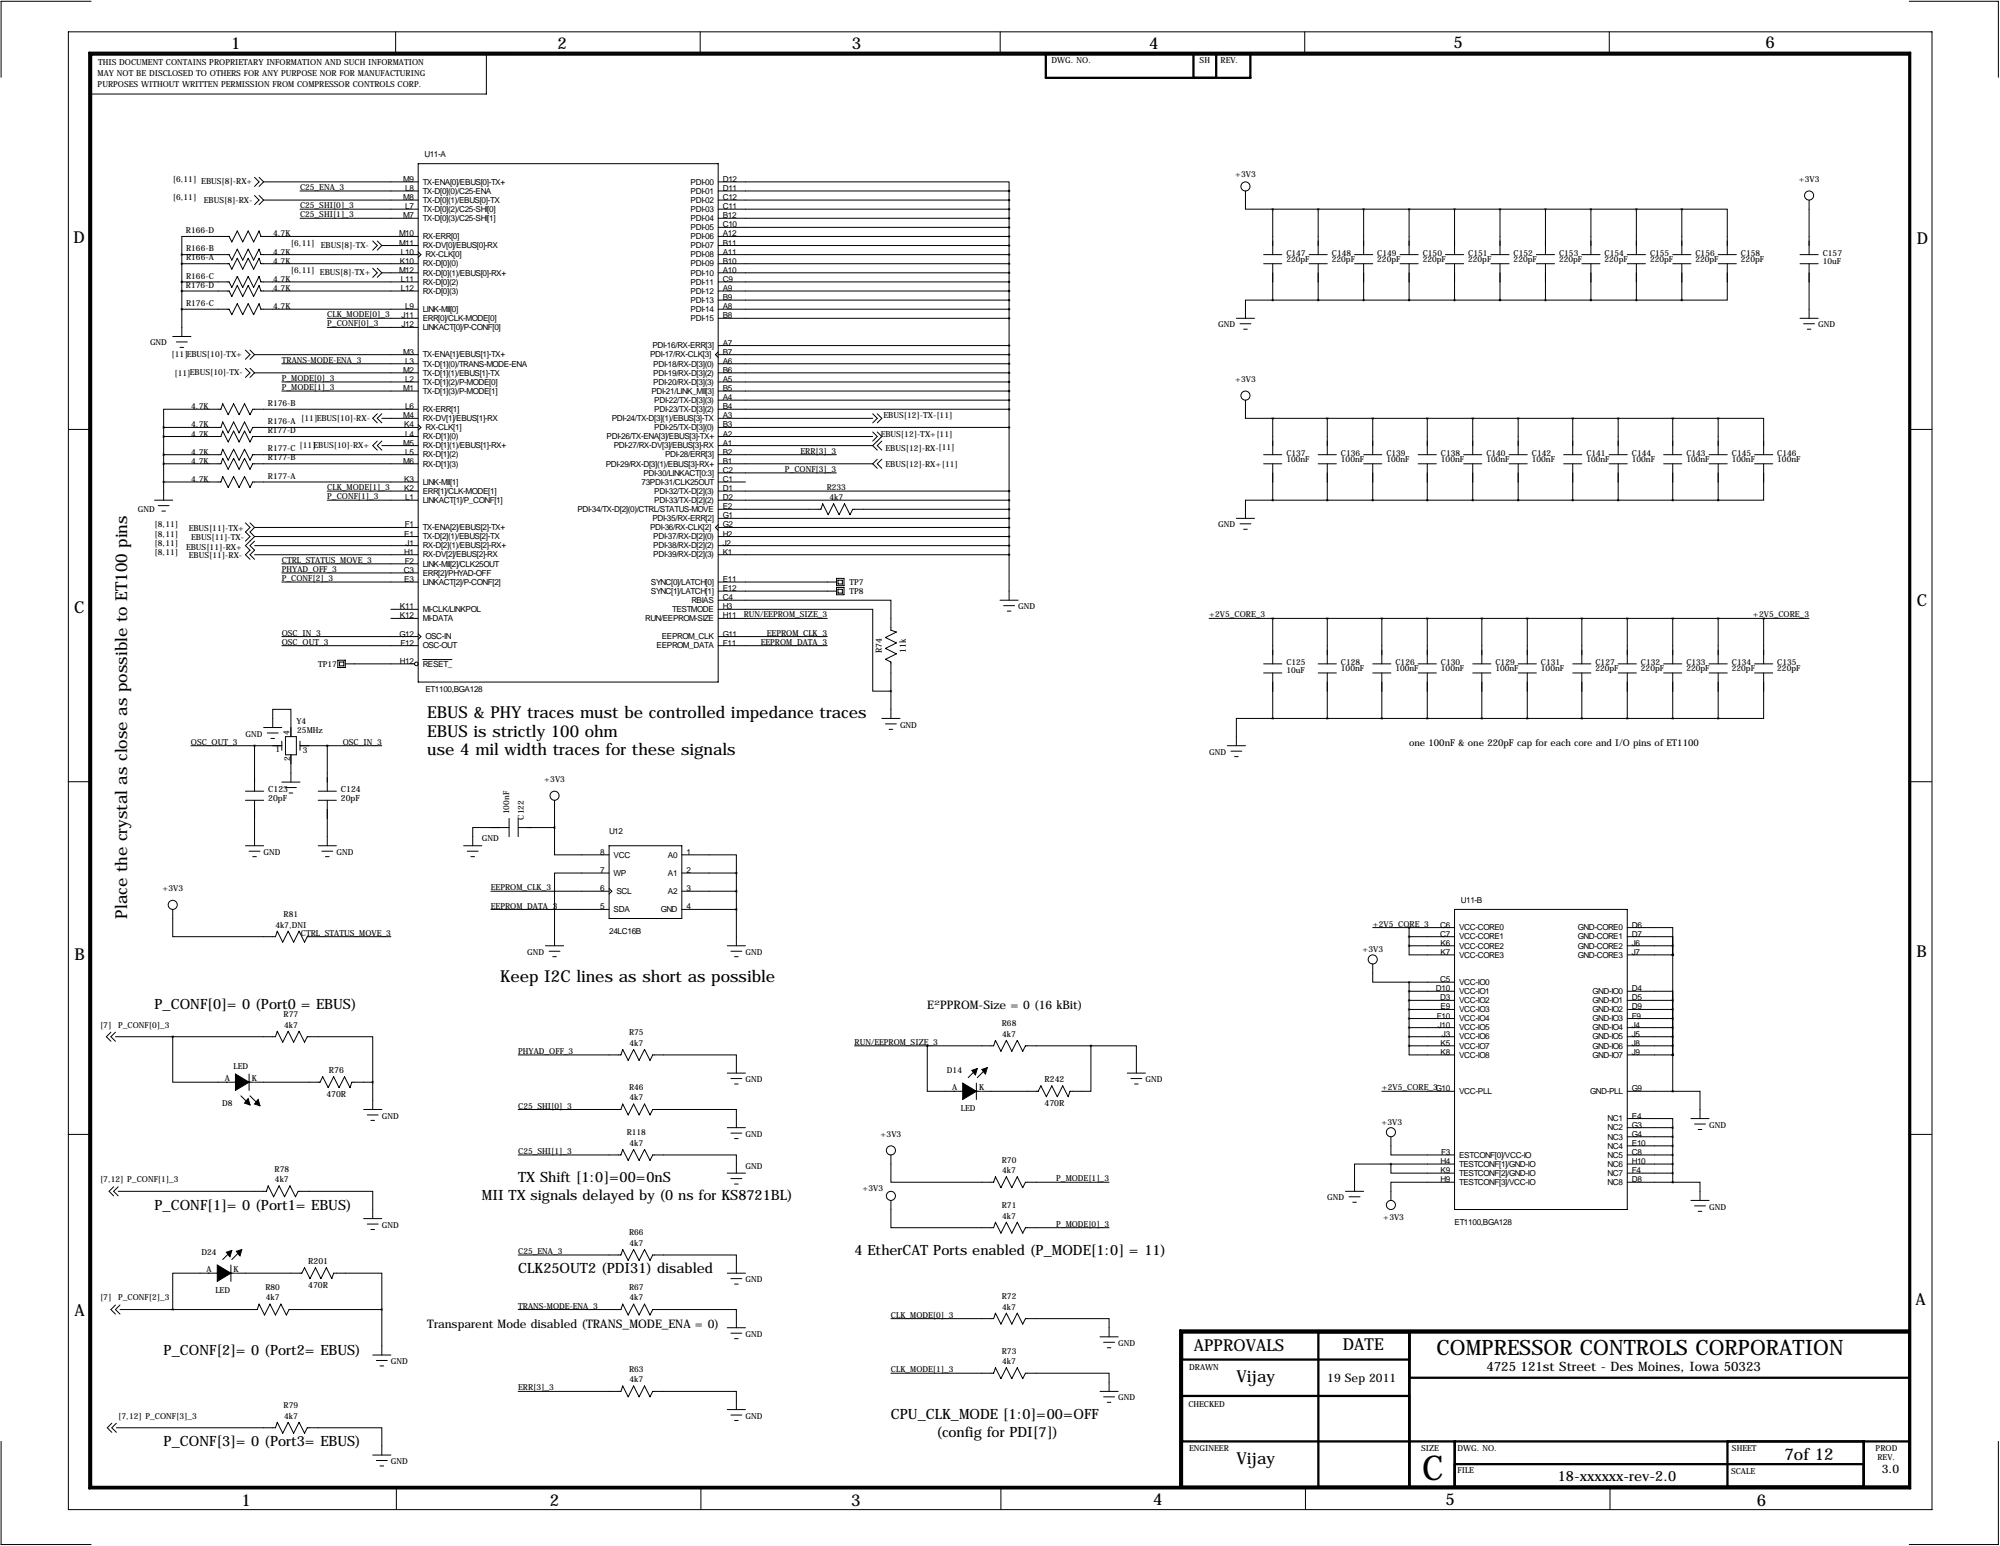
[picture p171: page 7]

A3 PDI-24/TX-D[3](1)/EBUS[3]-TX

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

B1 PDI-29/RX-D[3](1)/EBUS[3]-RX+

E2 PDI-34/TX-D[2](0)/CTRL/STATUS-MOVE

Place the crystal as close as possible to ET100 pins

ET1100,BGA128
EBUS & PHY traces must be controlled impedance traces

use 4 mil width traces for these signals

Keep I2C lines as short as possible

MII TX signals delayed by (0 ns for KS8721BL)

APPROVALS | DATE | COMPRESSOR CONTROLS CORPORATION 4725 121st Street - Des Moines, Iowa 50323

DRAWN Vijay | 19 Sep 2011

CHECKED

Vijay | | | 7of 12

D

D

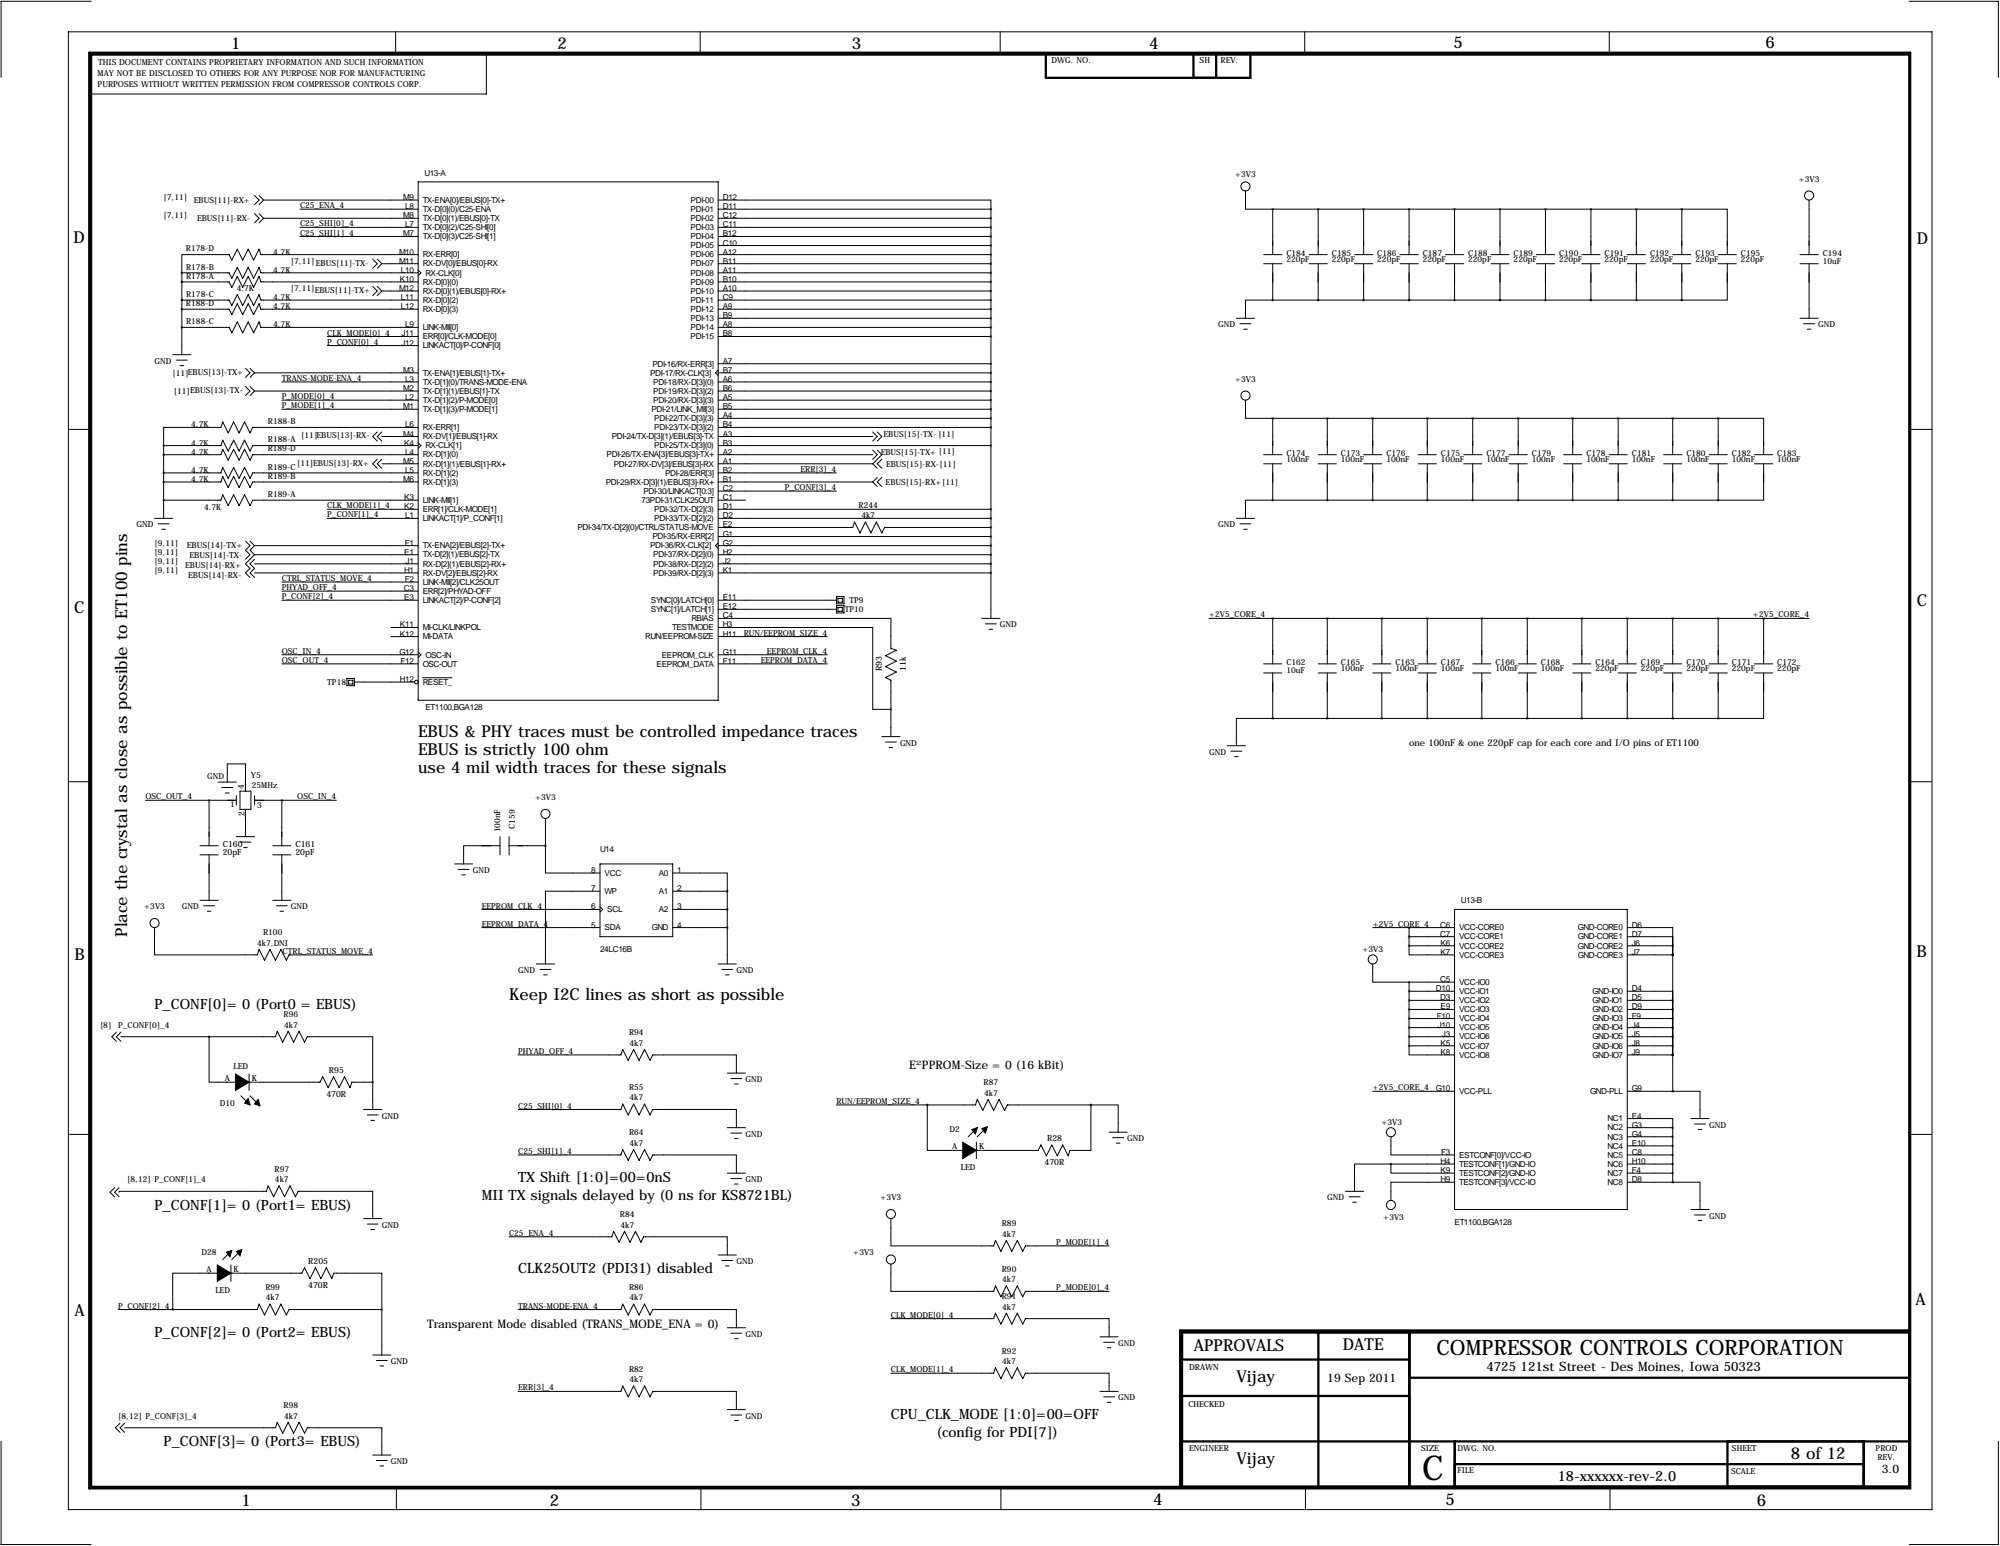
[picture p172: page 8]

A3 PDI-24/TX-D[3](1)/EBUS[3]-TX

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

B1 PDI-29/RX-D[3](1)/EBUS[3]-RX+

E2 PDI-34/TX-D[2](0)/CTRL/STATUS-MOVE

Place the crystal as close as possible to ET100 pins

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

one 100nF & one 220pF cap for each core and I/O pins of ET1100

Keep I2C lines as short as possible

MII TX signals delayed by (0 ns for KS8721BL)

APPROVALS | DATE | COMPRESSOR CONTROLS CORPORATION 4725 121st Street - Des Moines, Iowa 50323

DRAWN Vijay | 19 Sep 2011

CHECKED

D

D

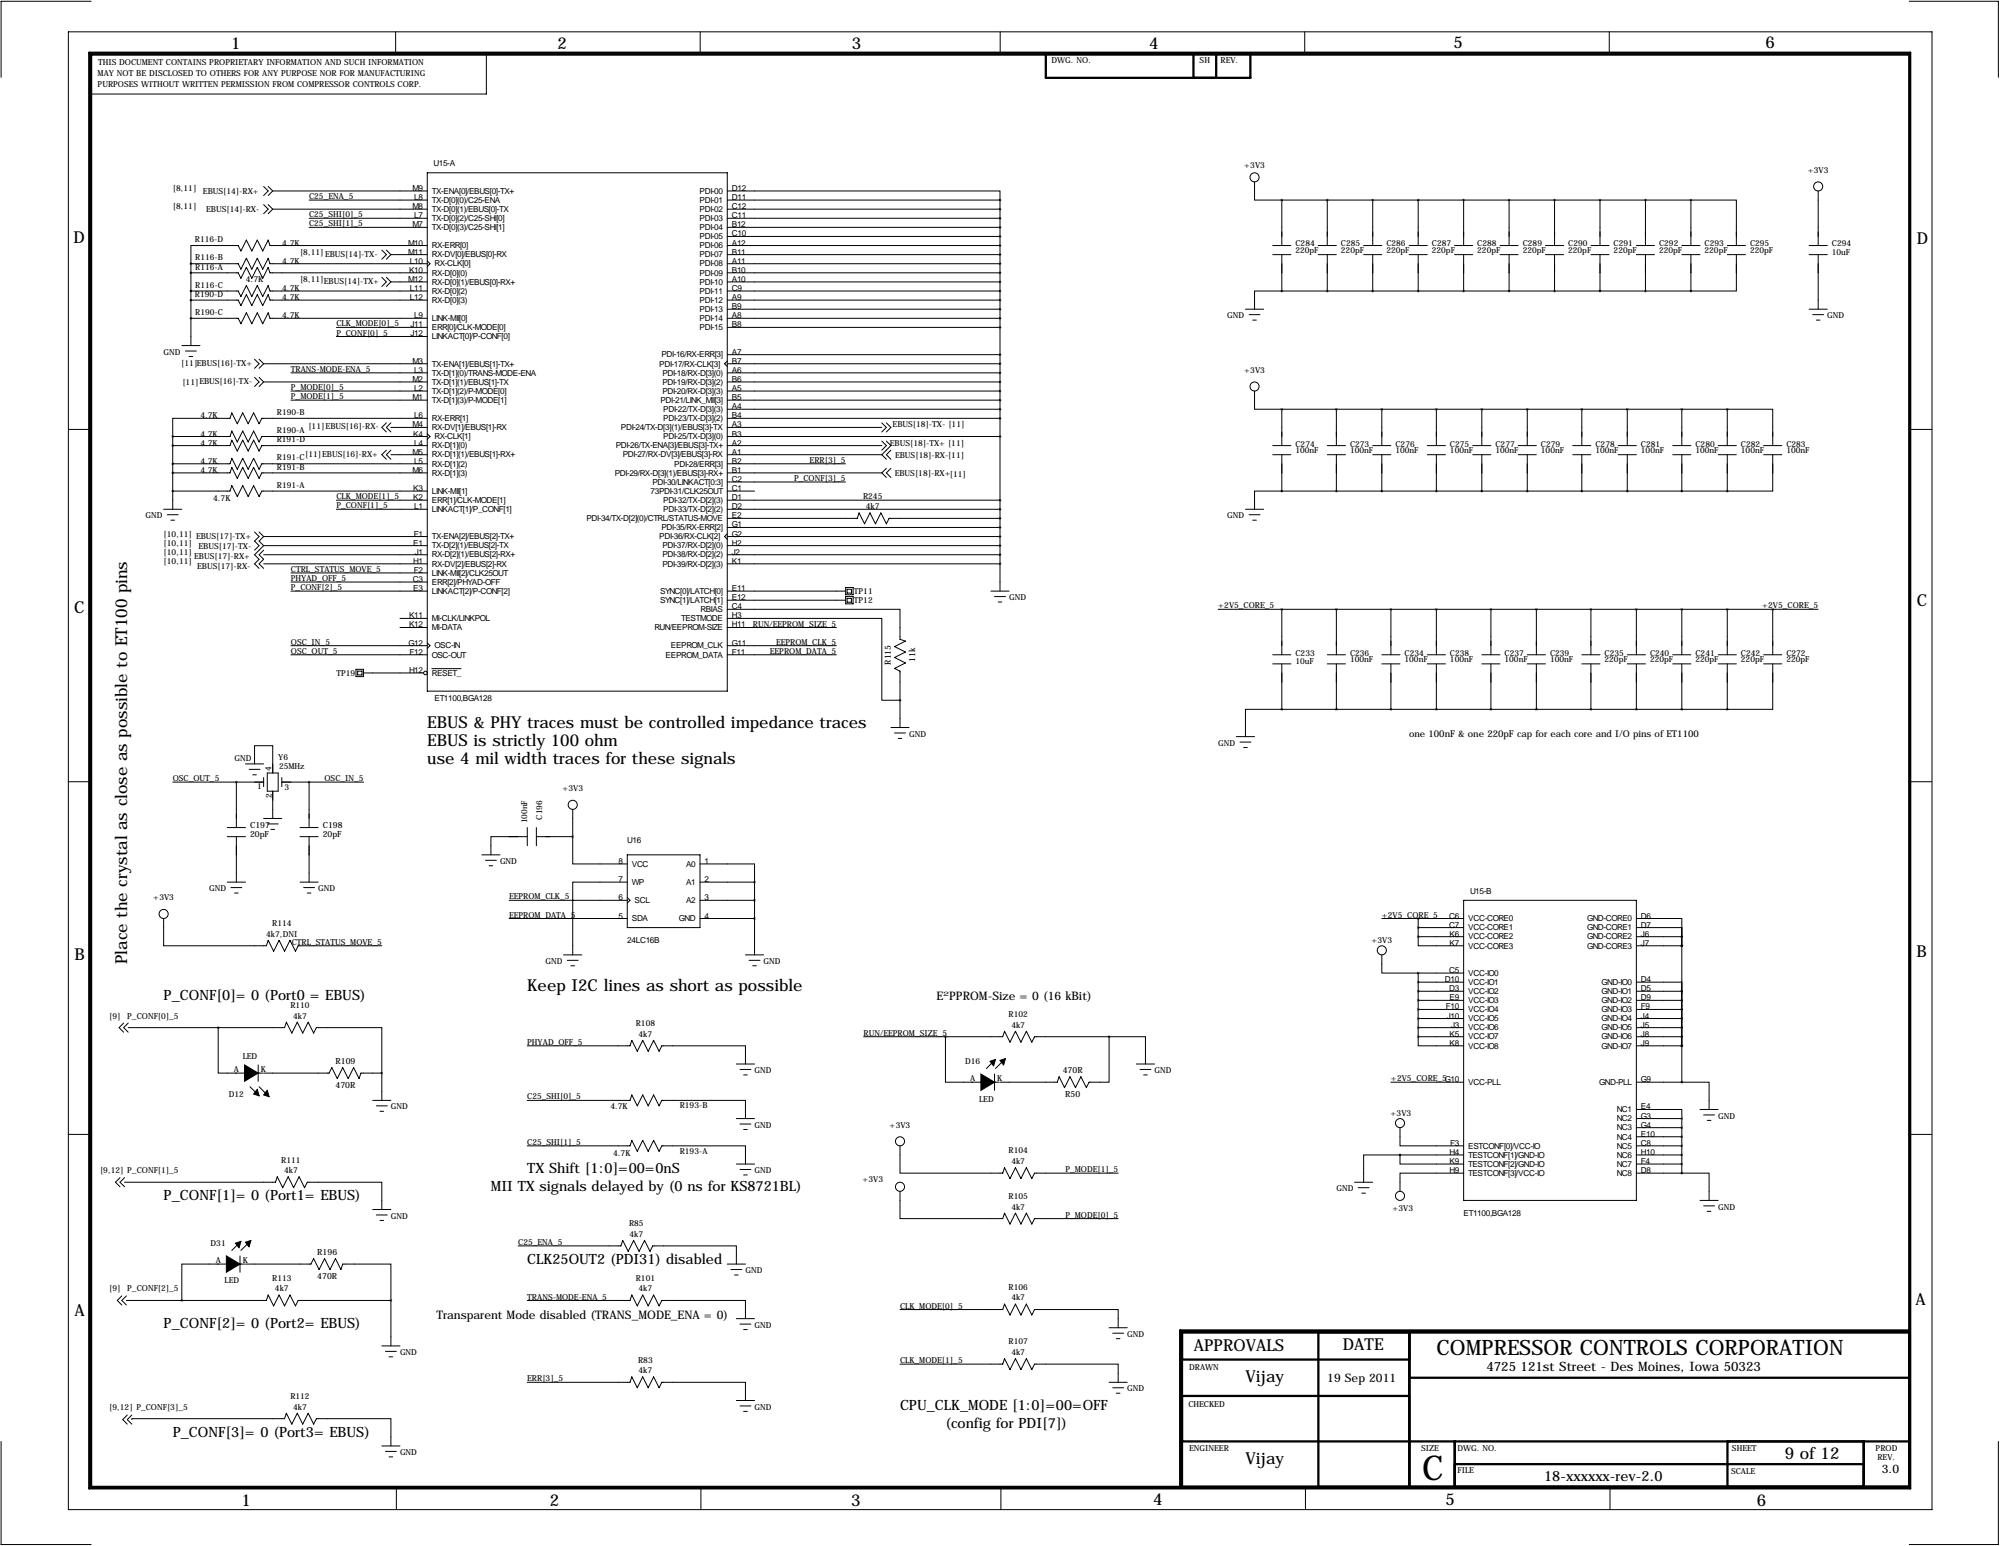
[picture p173: page 9]

A3 PDI-24/TX-D[3](1)/EBUS[3]-TX

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

B1 PDI-29/RX-D[3](1)/EBUS[3]-RX+

E2 PDI-34/TX-D[2](0)/CTRL/STATUS-MOVE

Place the crystal as close as possible to ET100 pins

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

one 100nF & one 220pF cap for each core and I/O pins of ET1100

Keep I2C lines as short as possible

MII TX signals delayed by (0 ns for KS8721BL)

APPROVALS | DATE | COMPRESSOR CONTROLS CORPORATION 4725 121st Street - Des Moines, Iowa 50323

DRAWN Vijay | 19 Sep 2011

CHECKED

D

D

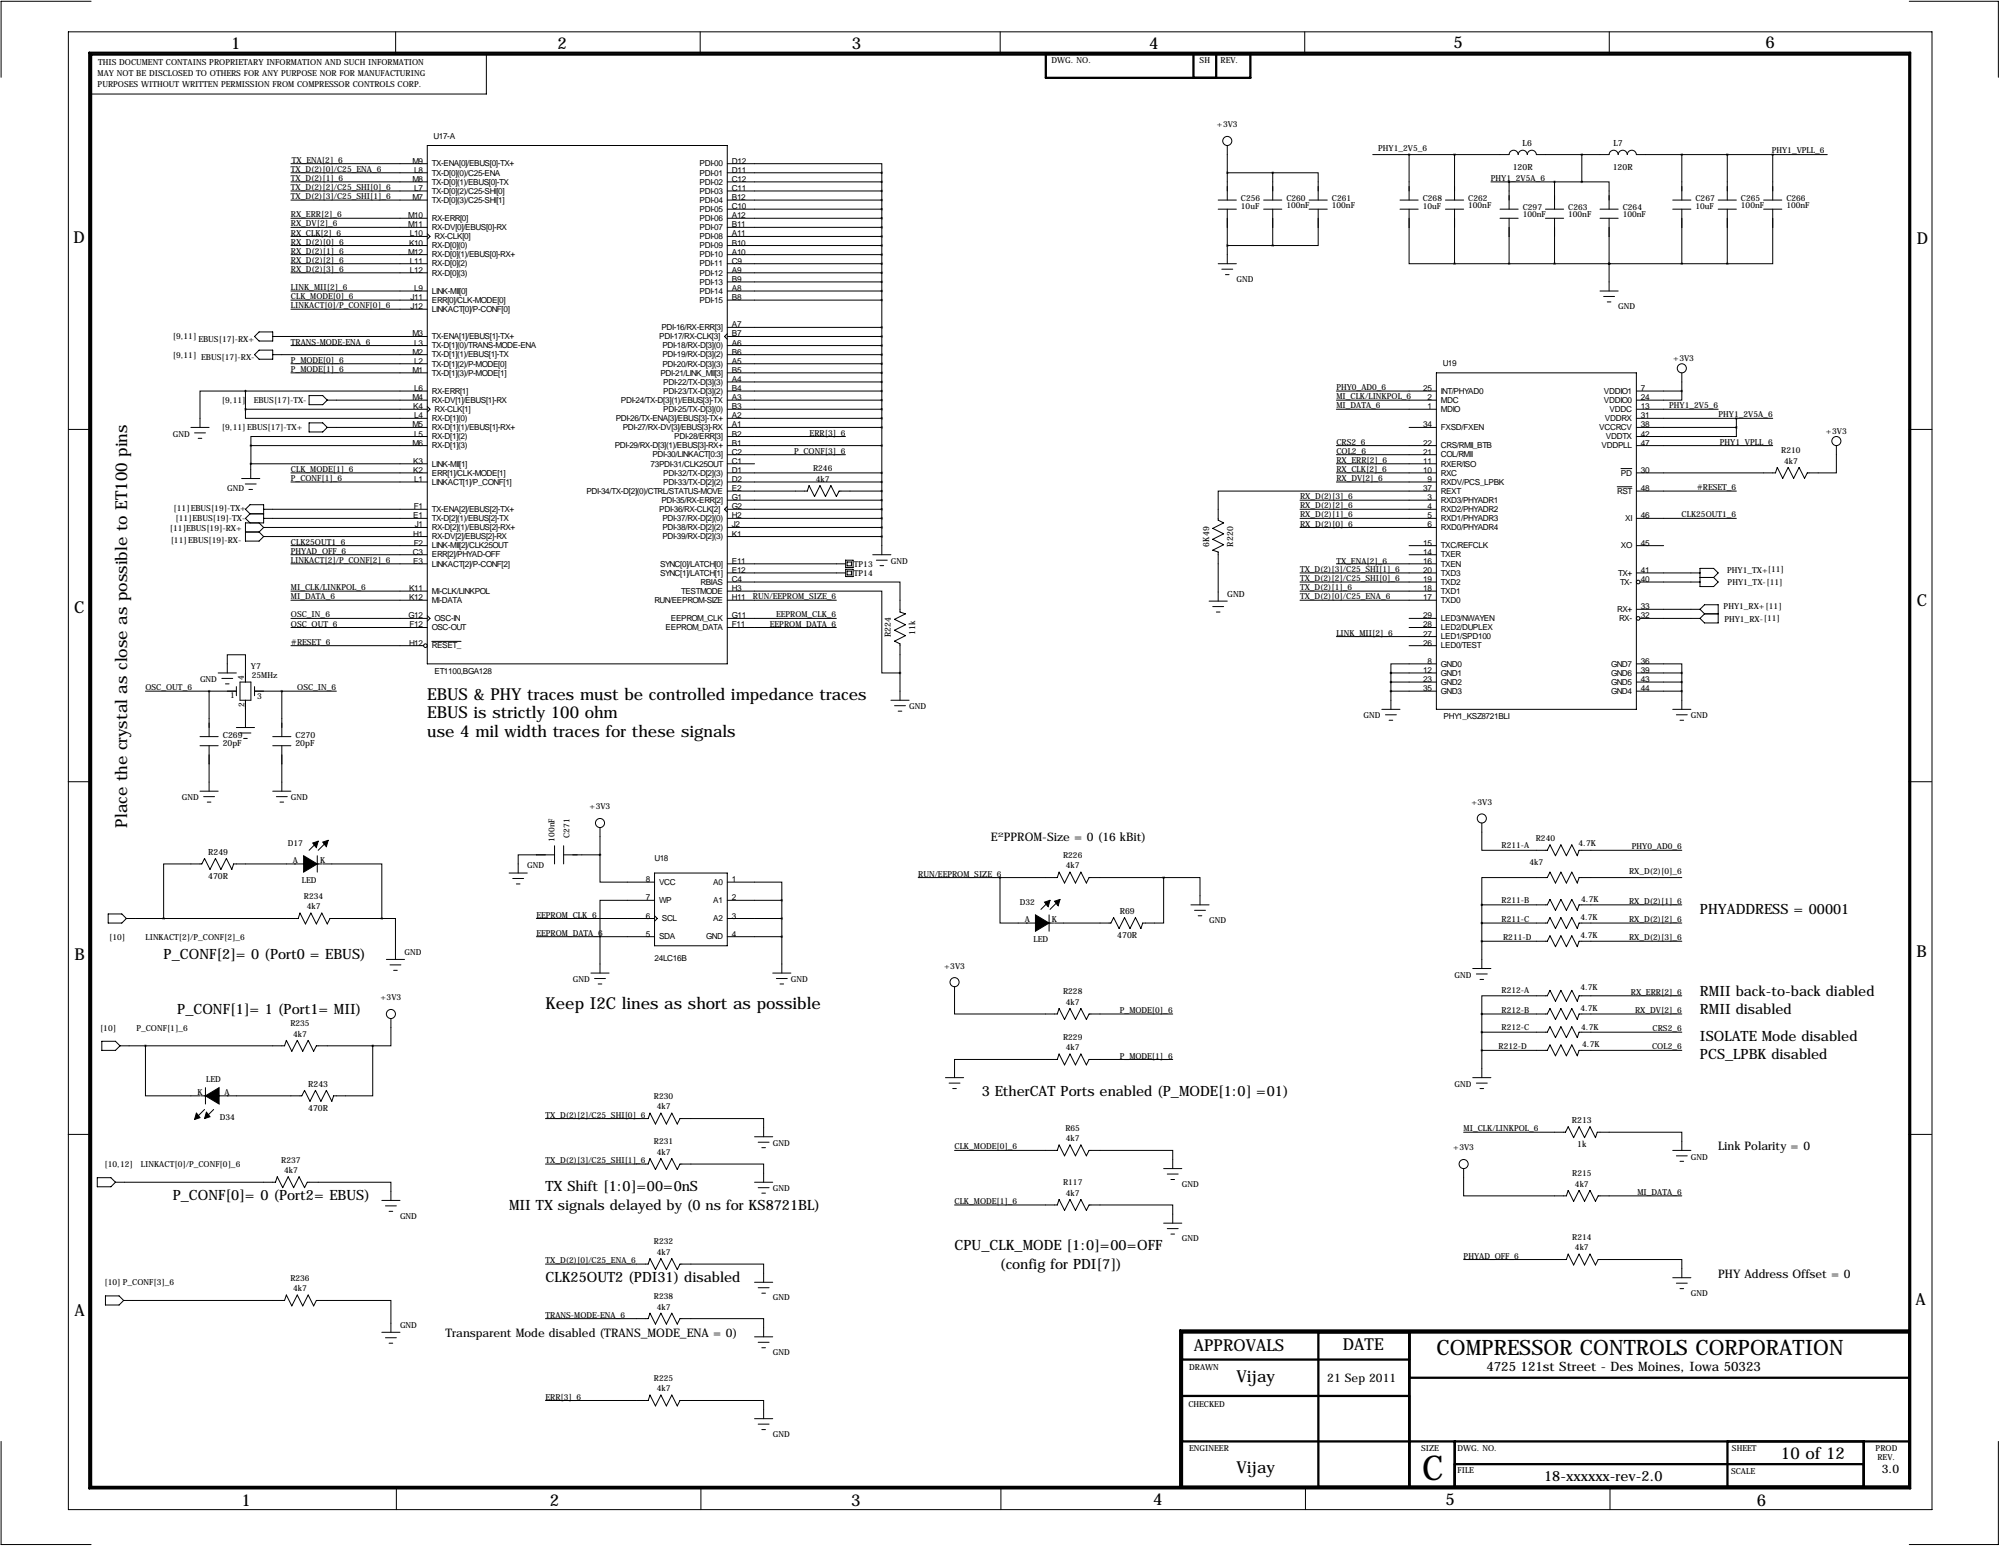
[picture p174: page 10]

A3 PDI-24/TX-D[3](1)/EBUS[3]-TX

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

Place the crystal as close as possible to ET100 pins

B1 PDI-29/RX-D[3](1)/EBUS[3]-RX+

E2 PDI-34/TX-D[2](0)/CTRL/STATUS-MOVE

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

Keep I2C lines as short as possible

RMII back-to-back diabled
RMII disabled

MII TX signals delayed by (0 ns for KS8721BL)

APPROVALS | DATE | COMPRESSOR CONTROLS CORPORATION 4725 121st Street - Des Moines, Iowa 50323

DRAWN Vijay | 21 Sep 2011

CHECKED

D

D

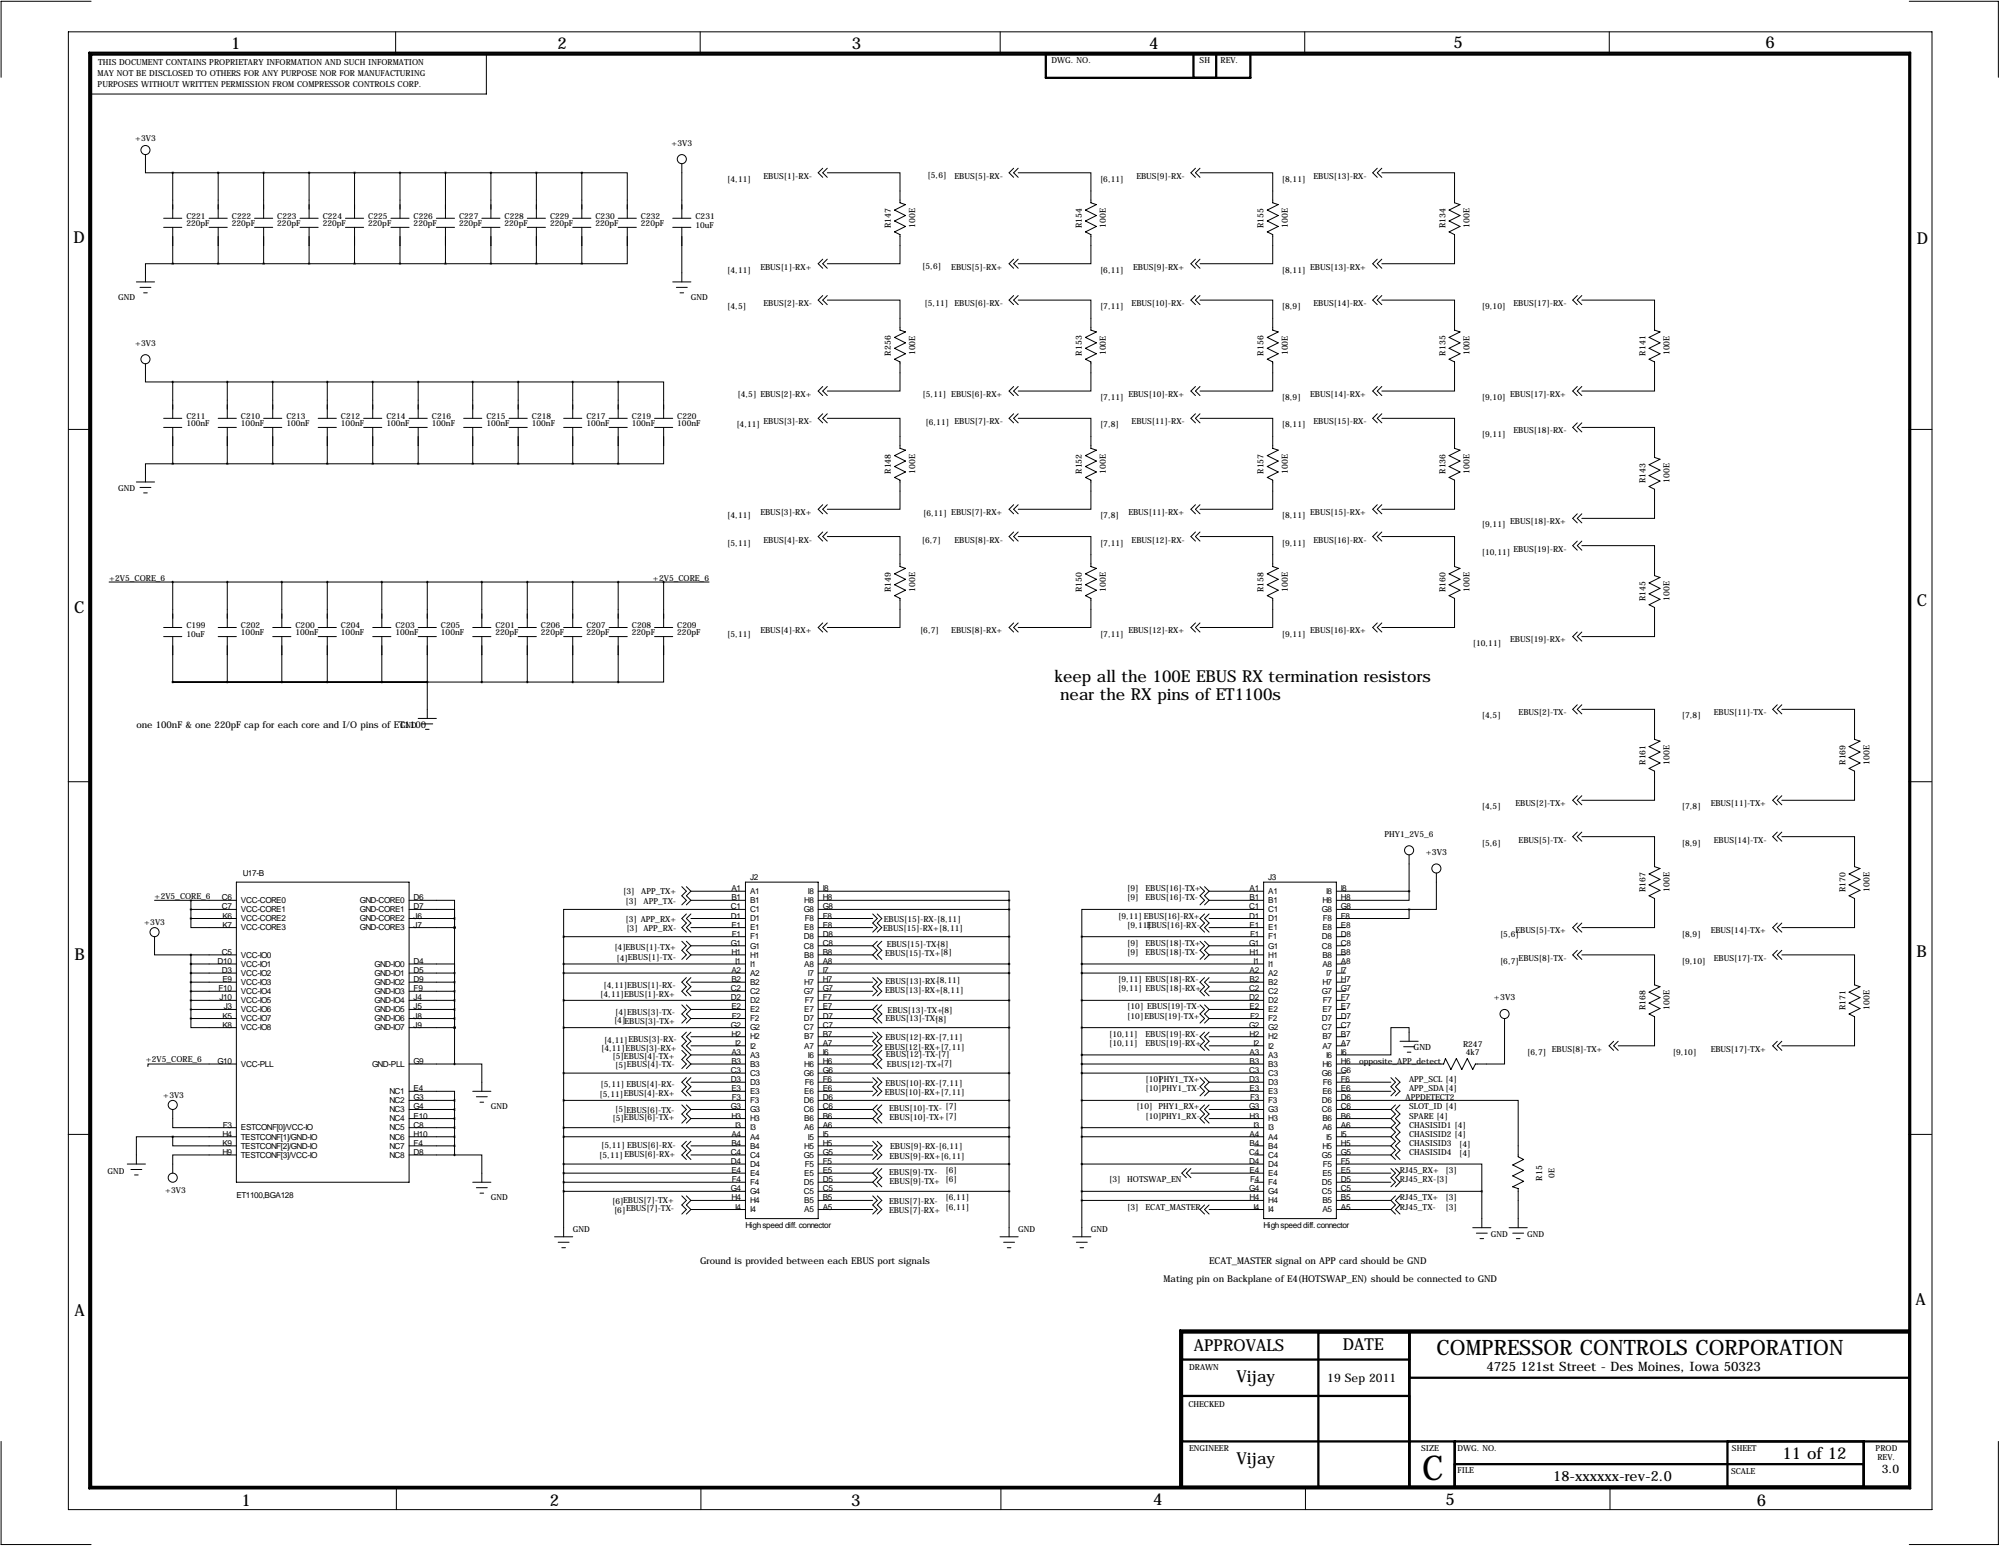
[picture p175: page 11]

keep all the 100E EBUS RX termination resistors
near the RX pins of ET1100s

one 100nF & one 220pF cap for each core and I/O pins of ET1100

[9,11]EBUS[16]-RX- EBUS[15]-RX-[8,11]
EBUS[15]-RX+[8,11]

EBUS[7]-RX+ [6,11] [6]EBUS[7]-TX+
[6]EBUS[7]-TX-

High speed diff. connector

Mating pin on Backplane of E4(HOTSWAP_EN) should be connected to GND

APPROVALS | DATE | COMPRESSOR CONTROLS CORPORATION 4725 121st Street - Des Moines, Iowa 50323

DRAWN Vijay | 19 Sep 2011

CHECKED

D

D

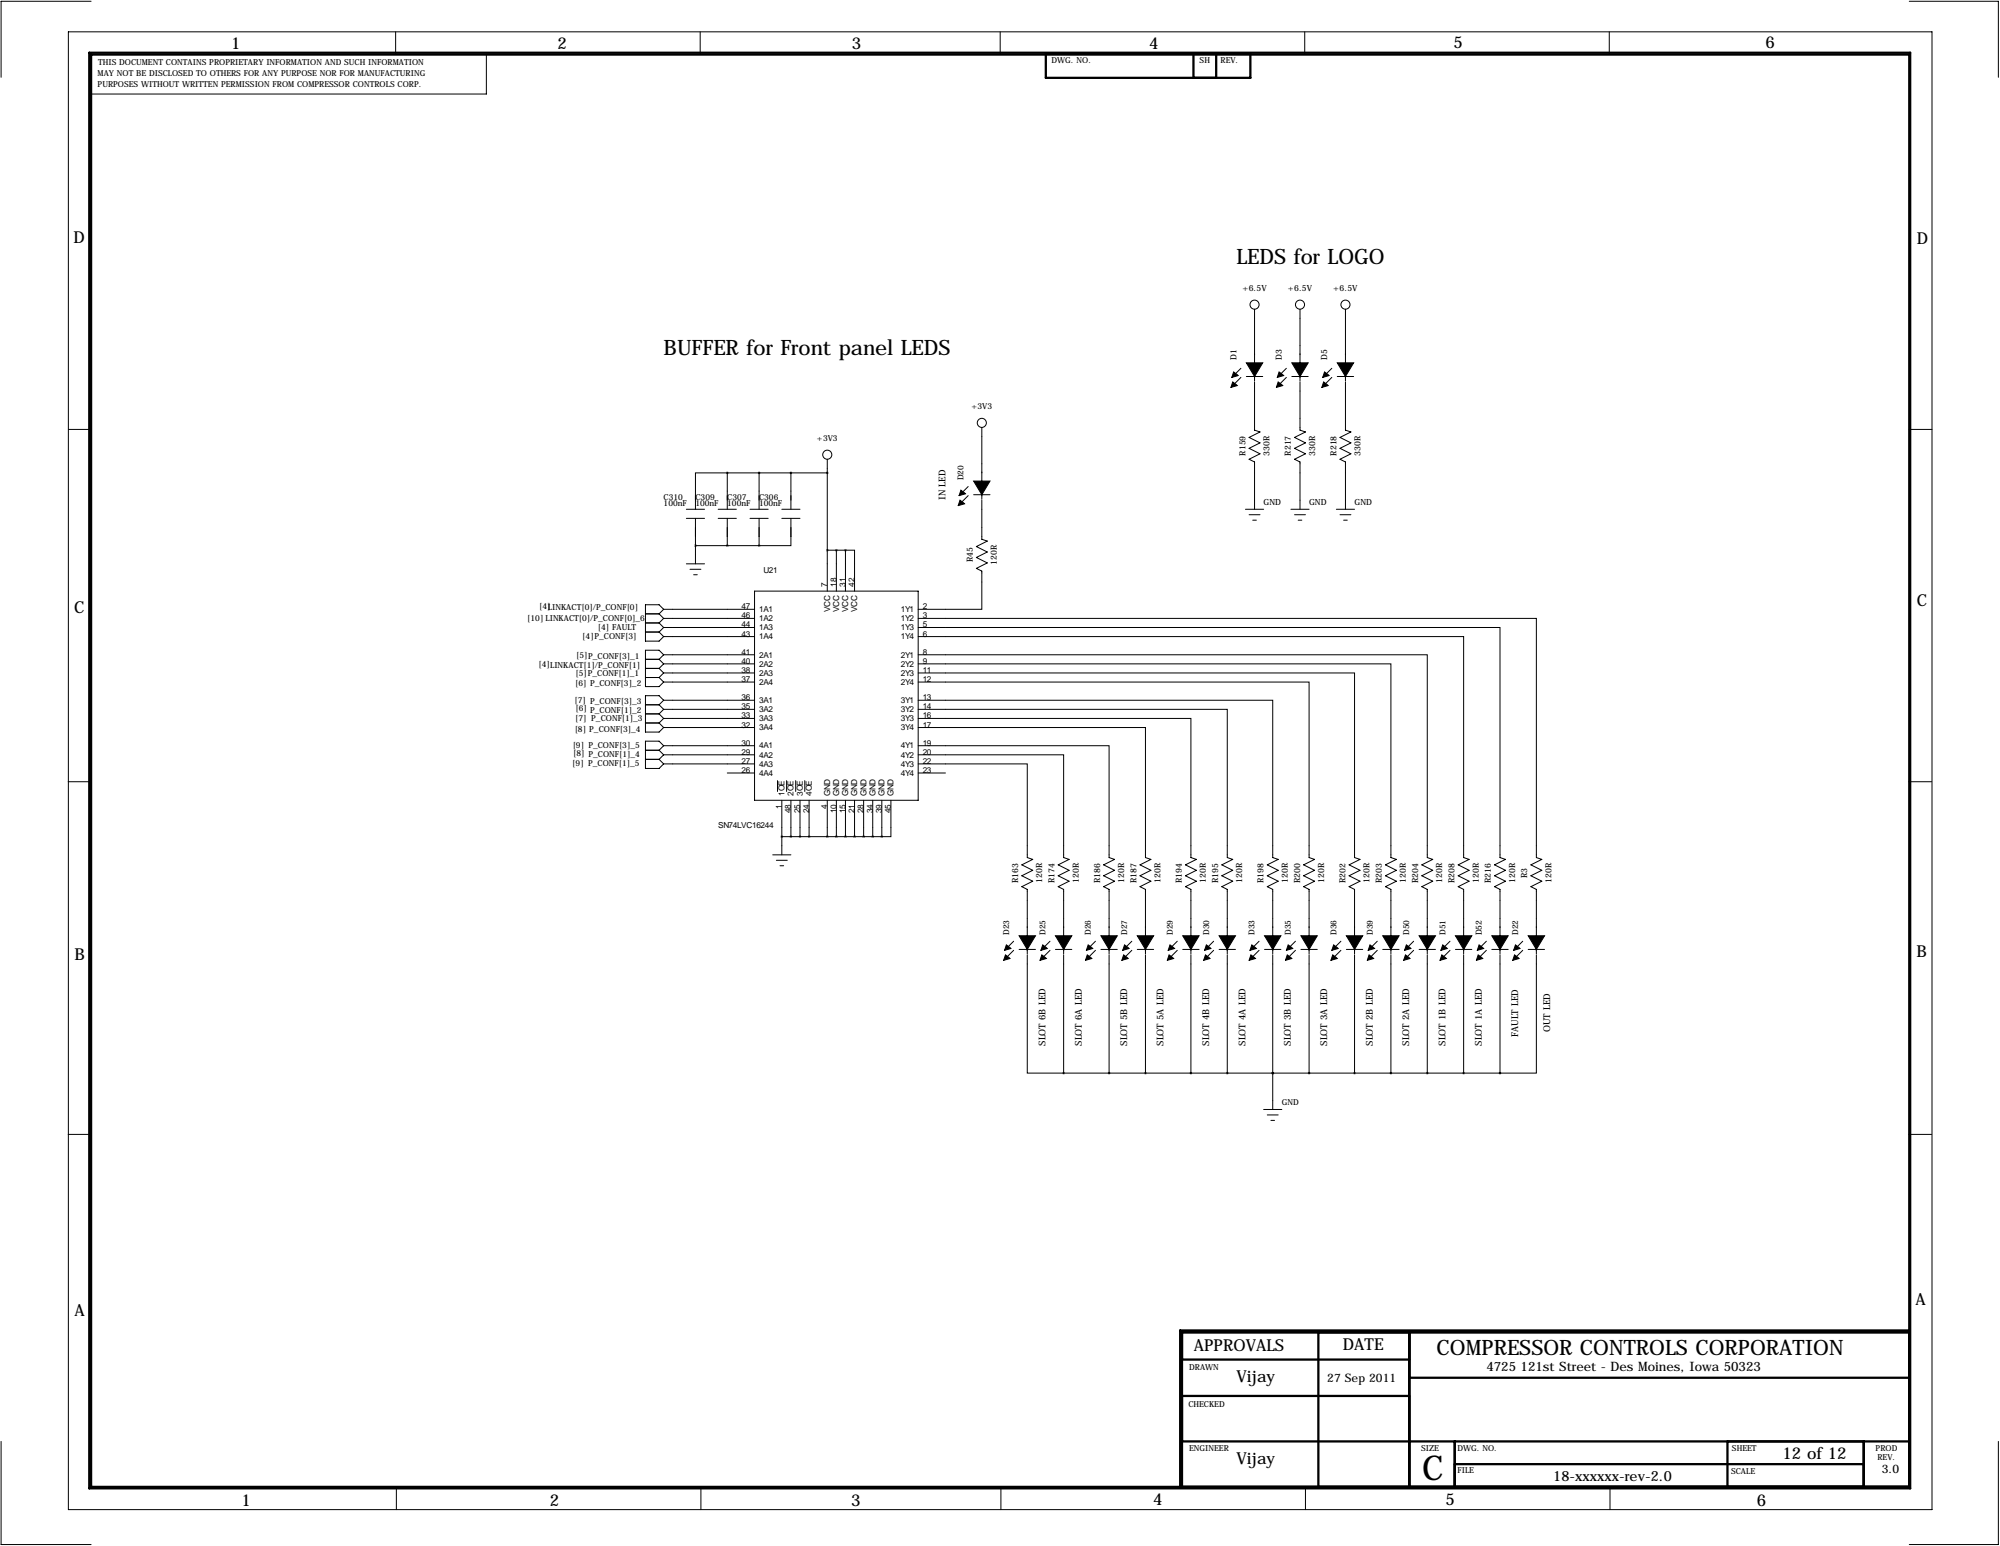
[picture p176: page 12]

BUFFER for Front panel LEDS

APPROVALS | DATE | COMPRESSOR CONTROLS CORPORATION 4725 121st Street - Des Moines, Iowa 50323

DRAWN Vijay | 27 Sep 2011

CHECKED
