Sayidathahaseen/CCC_NGP_ODC/NGP_ODC_Main/PDLC/Mechanical/NGP_CCC Final files on dt-lohiths/Solidworks _Final files/PCC MOD/Heat sink-1 (PCC).PDF

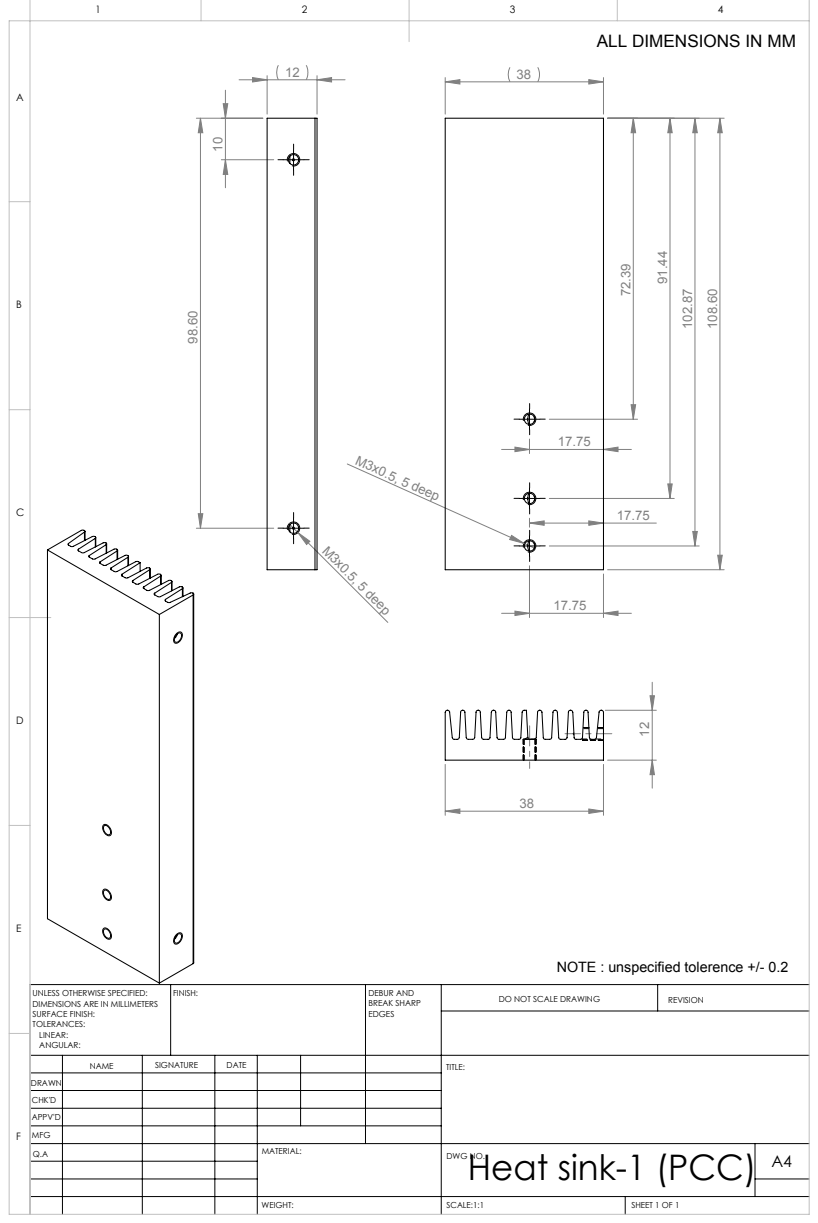
[picture p178: page 1]
M3x0.5, 5 deep; SCALE:1:1; SHEET 1 OF 1; DO NOT SCALE DRAWING; REVISION; DEBUR AND BREAK SHARP; UNLESS OTHERWISE SPECIFIED:; FINISH:

ALL DIMENSIONS IN MM

NOTE : unspecified tolerence +/- 0.2

DIMENSIONS ARE IN MILLIMETERS
SURFACE FINISH:
TOLERANCES:
LINEAR:
ANGULAR:

NAME | SIGNATURE | DATE | | | | TITLE:
Q.A | | | | MATERIAL: | Heat sink-1 (PCC) WEIGHT: DWG NO. | A4

DRAWN
CHK'D
APPV'D
MFG
