Sayidathahaseen/CCC_NGP_ODC/NGP_ODC_Main/PDLC/Mechanical/NGP_CCC Final files on dt-lohiths/Solidworks _Final files/PCC MOD/LSI 051 heat sink.pdf

# H S EATSINK

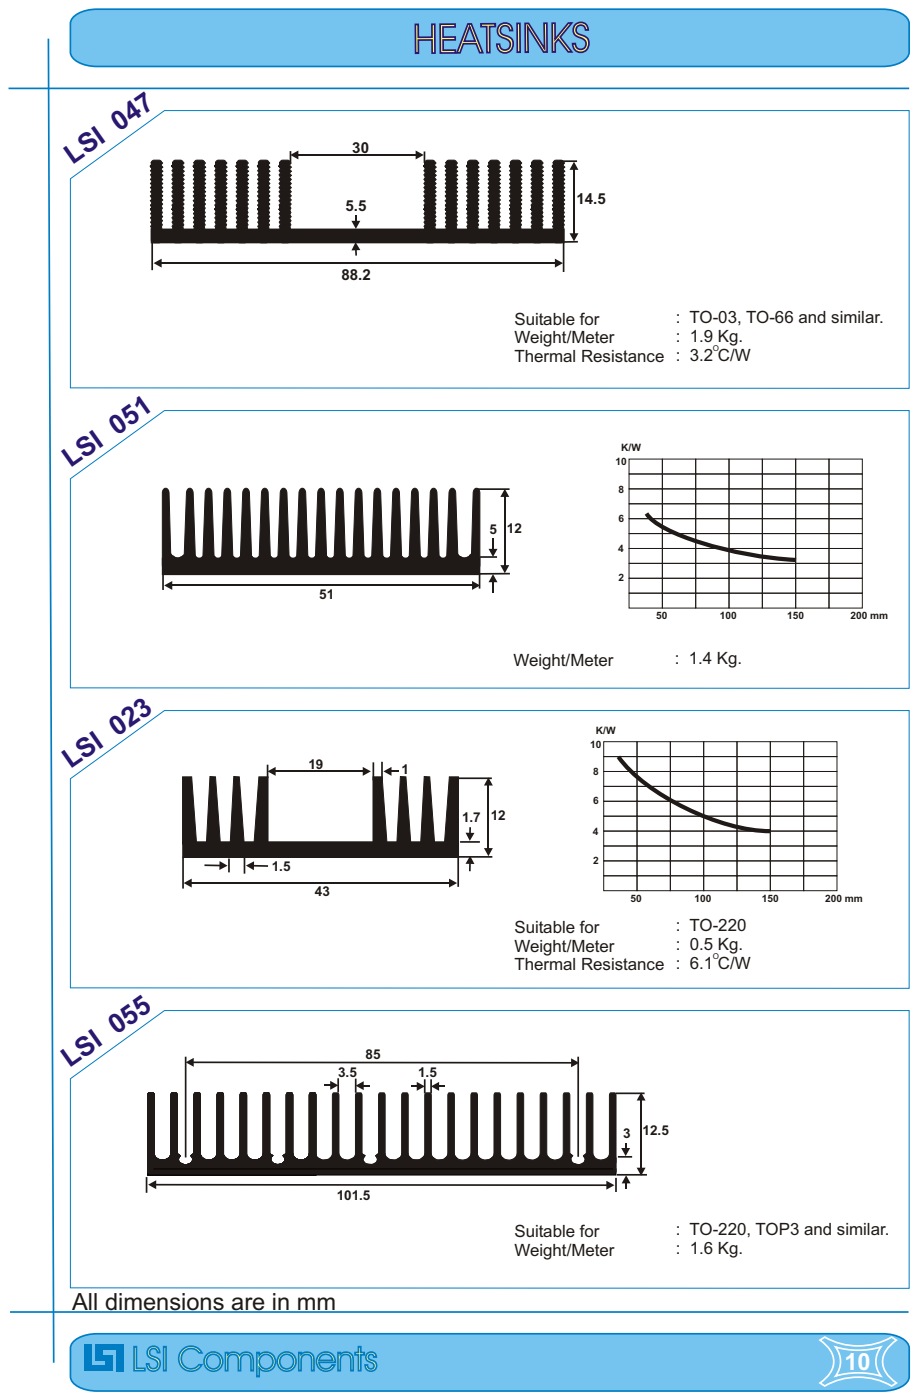
[picture p179: page 1]
LSI 51 0; LSI 055; Suitable for Weight/Meter Thermal Resistance; Weight/Meter; Suitable for Weight/Meter

: TO-03, TO-66 and similar.

: TO-220, TOP3 and similar.

All dimensions are in mm
LSI Components
