Sayidathahaseen/CCC_NGP_ODC/NGP_ODC_Main/PDLC/design/Schematics/MPC5534_daughter_card/Rev3.0/CCCNGP_MPC5534_BOARD_REV3.0.pdf

# SHEET1-TITLE

THIS DOCUMENT CONTAINS PROPRIETARY INFORMATION AND SUCH INFORMATION MAY NOT BE DISCLOSED TO OTHERS FOR ANY PURPOSE NOR FOR MANUFACTURING PURPOSES WITHOUT WRITTEN PERMISSION FROM COMPRESSOR CONTROLS CORP.

1 | 2 | 3 | 4 | 5 | 6

A

B

C

D

DWG. NO. | SH

D

C

B

A

APPROVALS | DATE | COMPRESSOR CONTROLS CORPORATION 4725 121st Street - Des Moines, Iowa 50323
DRAWN VAIBHAV DOSHI | 11-07-2012
CHECKED <Checked By> | <Checked Date>
ENGINEER VAIBHAV DOSHI | | SIZE C | DWG. NO. <Drawing Number> | SHEET 1 of 14 | PROD REV. 3.0
| | | FILE CCCNGP_MPC5534_BOARD_REV3.0.sch | <Scale> SCALE
<Drawing Number> | 1 | 3.0
REV | DATE | AUTHOR | DESCRIPTION/MODIFICATIONS
1.0 | 29.04.11 | R. Vasavi | Preliminary release
1.1 1.2 | 06.06.11 30.06.11 | R. Vasavi R. Vasavi | Added IOP board connectors Changed the JTAG/Nexus, CPLD & RS232 to right angled type Changed the RS232 debug console to RS485 Moved the second SPI EEPOM to IOP board eTPU & eMIOS interfaces support for 16 DI & 16 DO Addition of mictor connectors
2.0 | 3.10.2011 | AJM | Added Termination on ECAT RX Lines Changed value of C218-C220
3.0 | | VAIBHAV DOSHI | Updated parts with the standard 11.07.12 Prodigy_Parts_Library Power supply for 1.5V,3.3V,5V changed MPC_CLK signal added Voltage monitoring Op-Amp replaced

# REVISION HISTORY

# PRODIGY

# MPC5534 MICROCONTROLLER BOARD

D

D

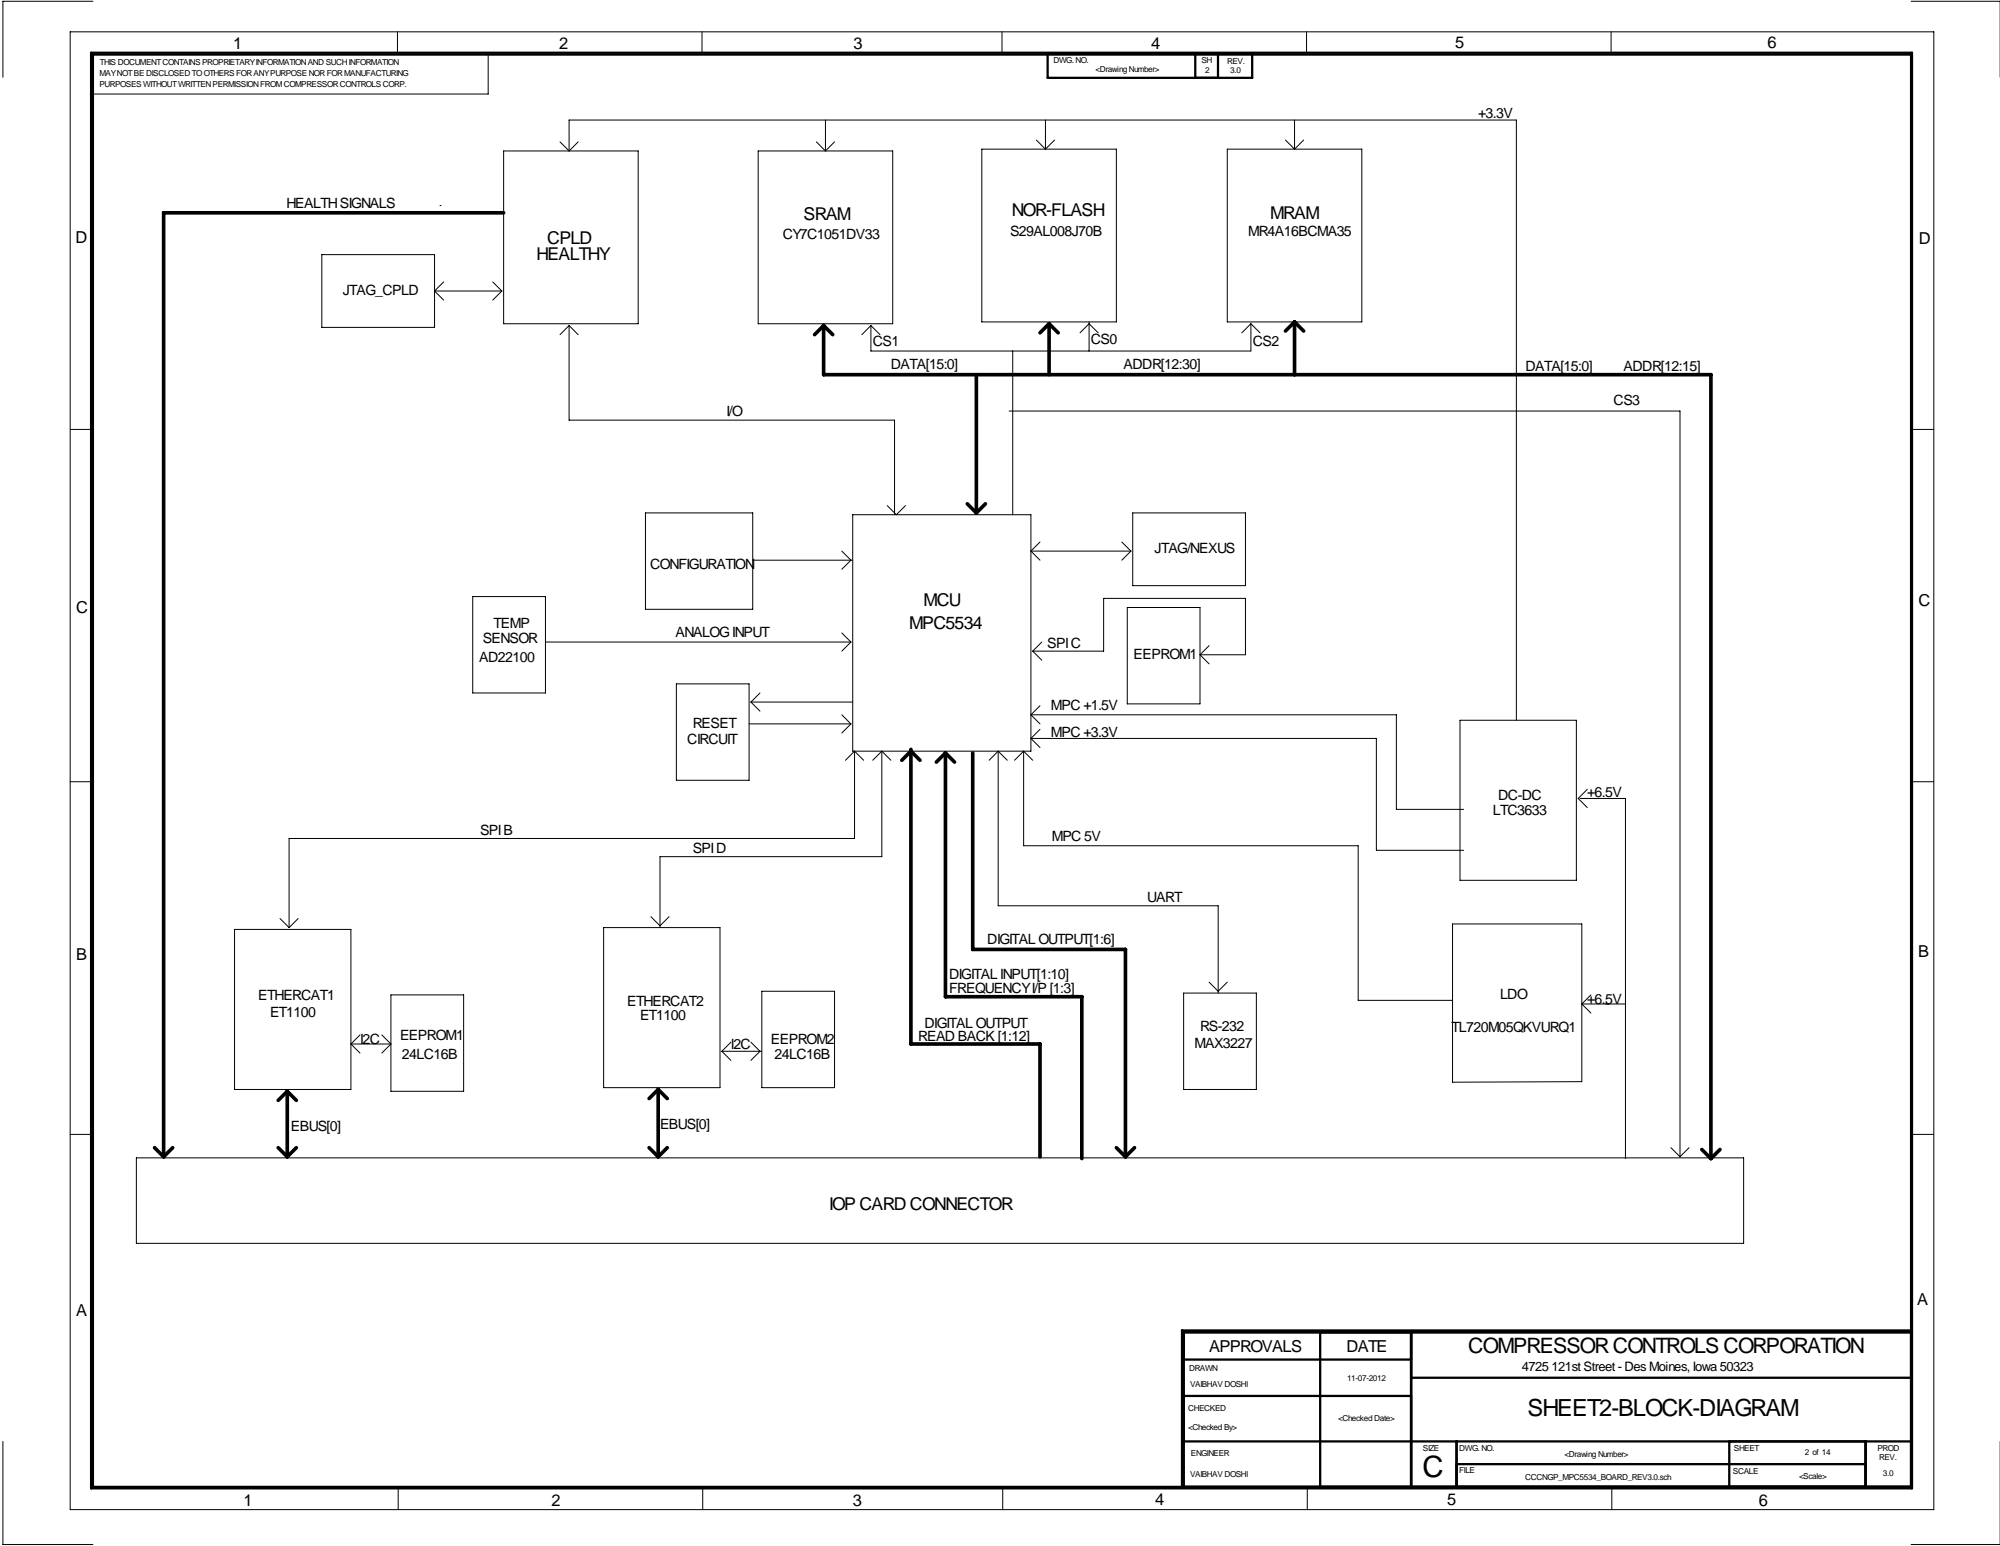
[picture p180: page 2]
SHEET2-BLOCK-DIAGRAM; <Drawing Number>; MCU MPC5534; CPLD; JTAG_CPLD; SRAM; NOR-FLASH; MRAM MR4A16BCMA35; DATA[15:0]; ADDR[12:30]; TEMP SENSOR; EEPROM1; SPI C; CONFIGURATION; RESET CIRCUIT; TL720M05QKVURQ1; LDO; MPC +1.5V; MPC +3.3V; MPC 5V; JTAG/NEXUS; RS-232 MAX3227; ETHERCAT1; ETHERCAT2; EEPROM2; EBUS[0]; SPI B; SPI D; ANALOG INPUT; UART; DIGITAL INPUT[1:10]; DIGITAL OUTPUT[1:6]; DIGITAL OUTPUT READ BACK [1:12]; LTC3633; FREQUENCY I/P [1:3]; HEALTHY; HEALTH SIGNALS; ADDR[12:15]

IOP CARD CONNECTOR

APPROVALS | DATE | COMPRESSOR CONTROLS CORPORATION 4725 121st Street - Des Moines, Iowa 50323

DRAWN VAIBHAV DOSHI | 11-07-2012

CHECKED

VAIBHAV DOSHI | | | 3.0

<Scale> C

D

D

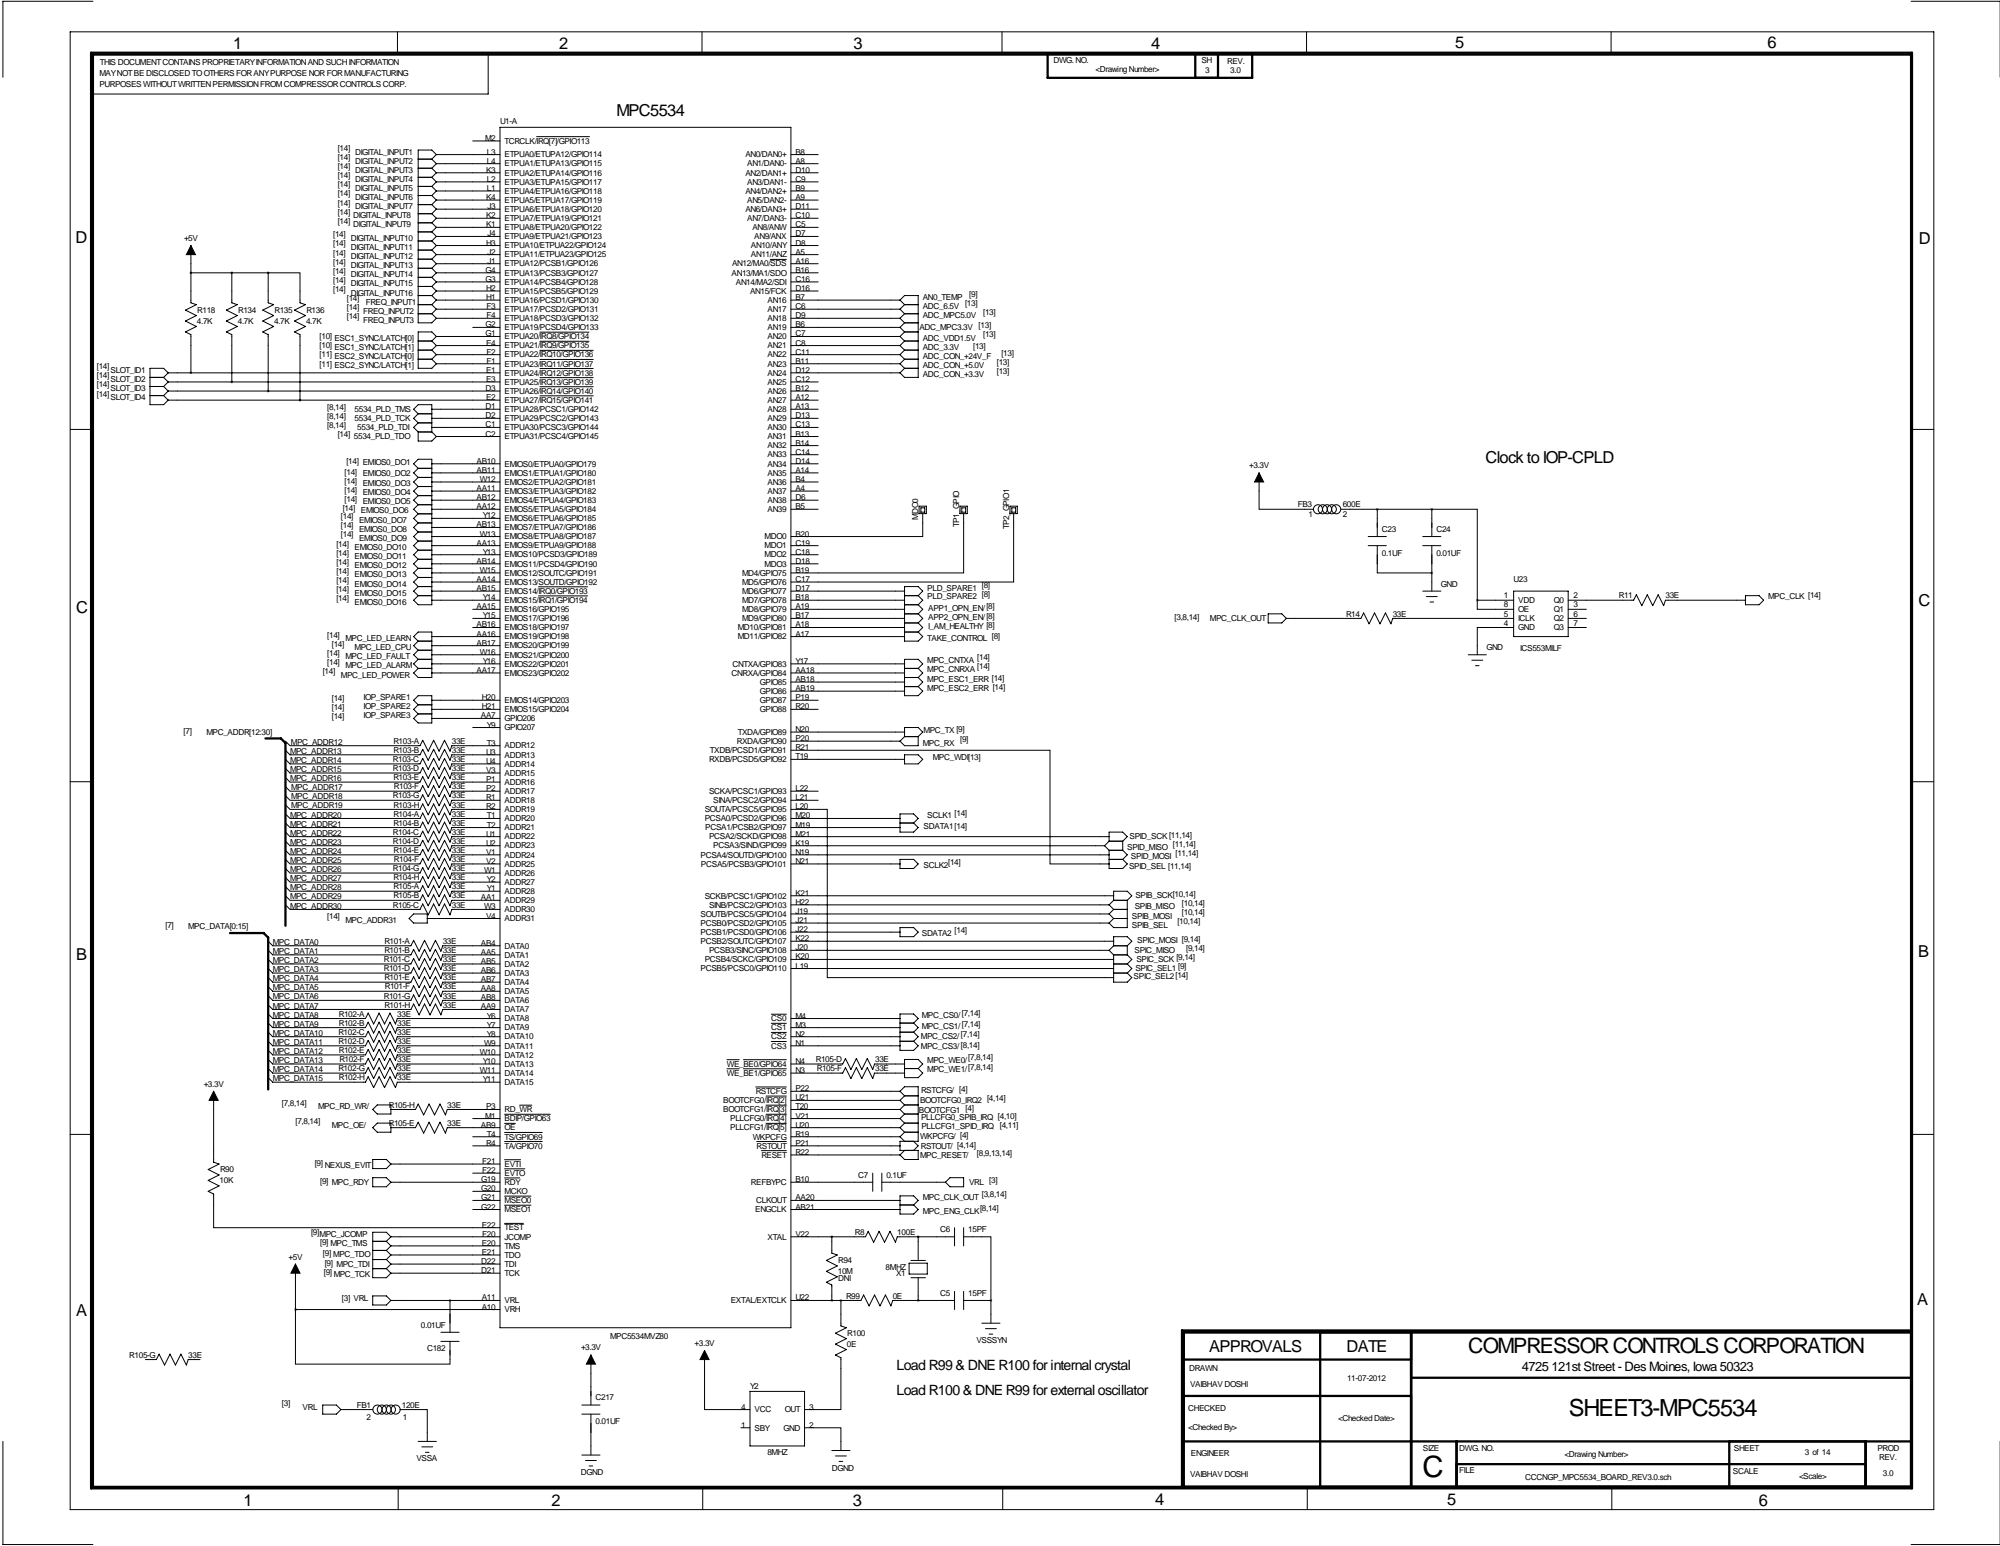
[picture p181: page 3]

Clock to IOP-CPLD

APPROVALS | DATE | COMPRESSOR CONTROLS CORPORATION 4725 121st Street - Des Moines, Iowa 50323

Load R99 & DNE R100 for internal crystal

DRAWN VAIBHAV DOSHI | 11-07-2012

Load R100 & DNE R99 for external oscillator

CHECKED

D

D

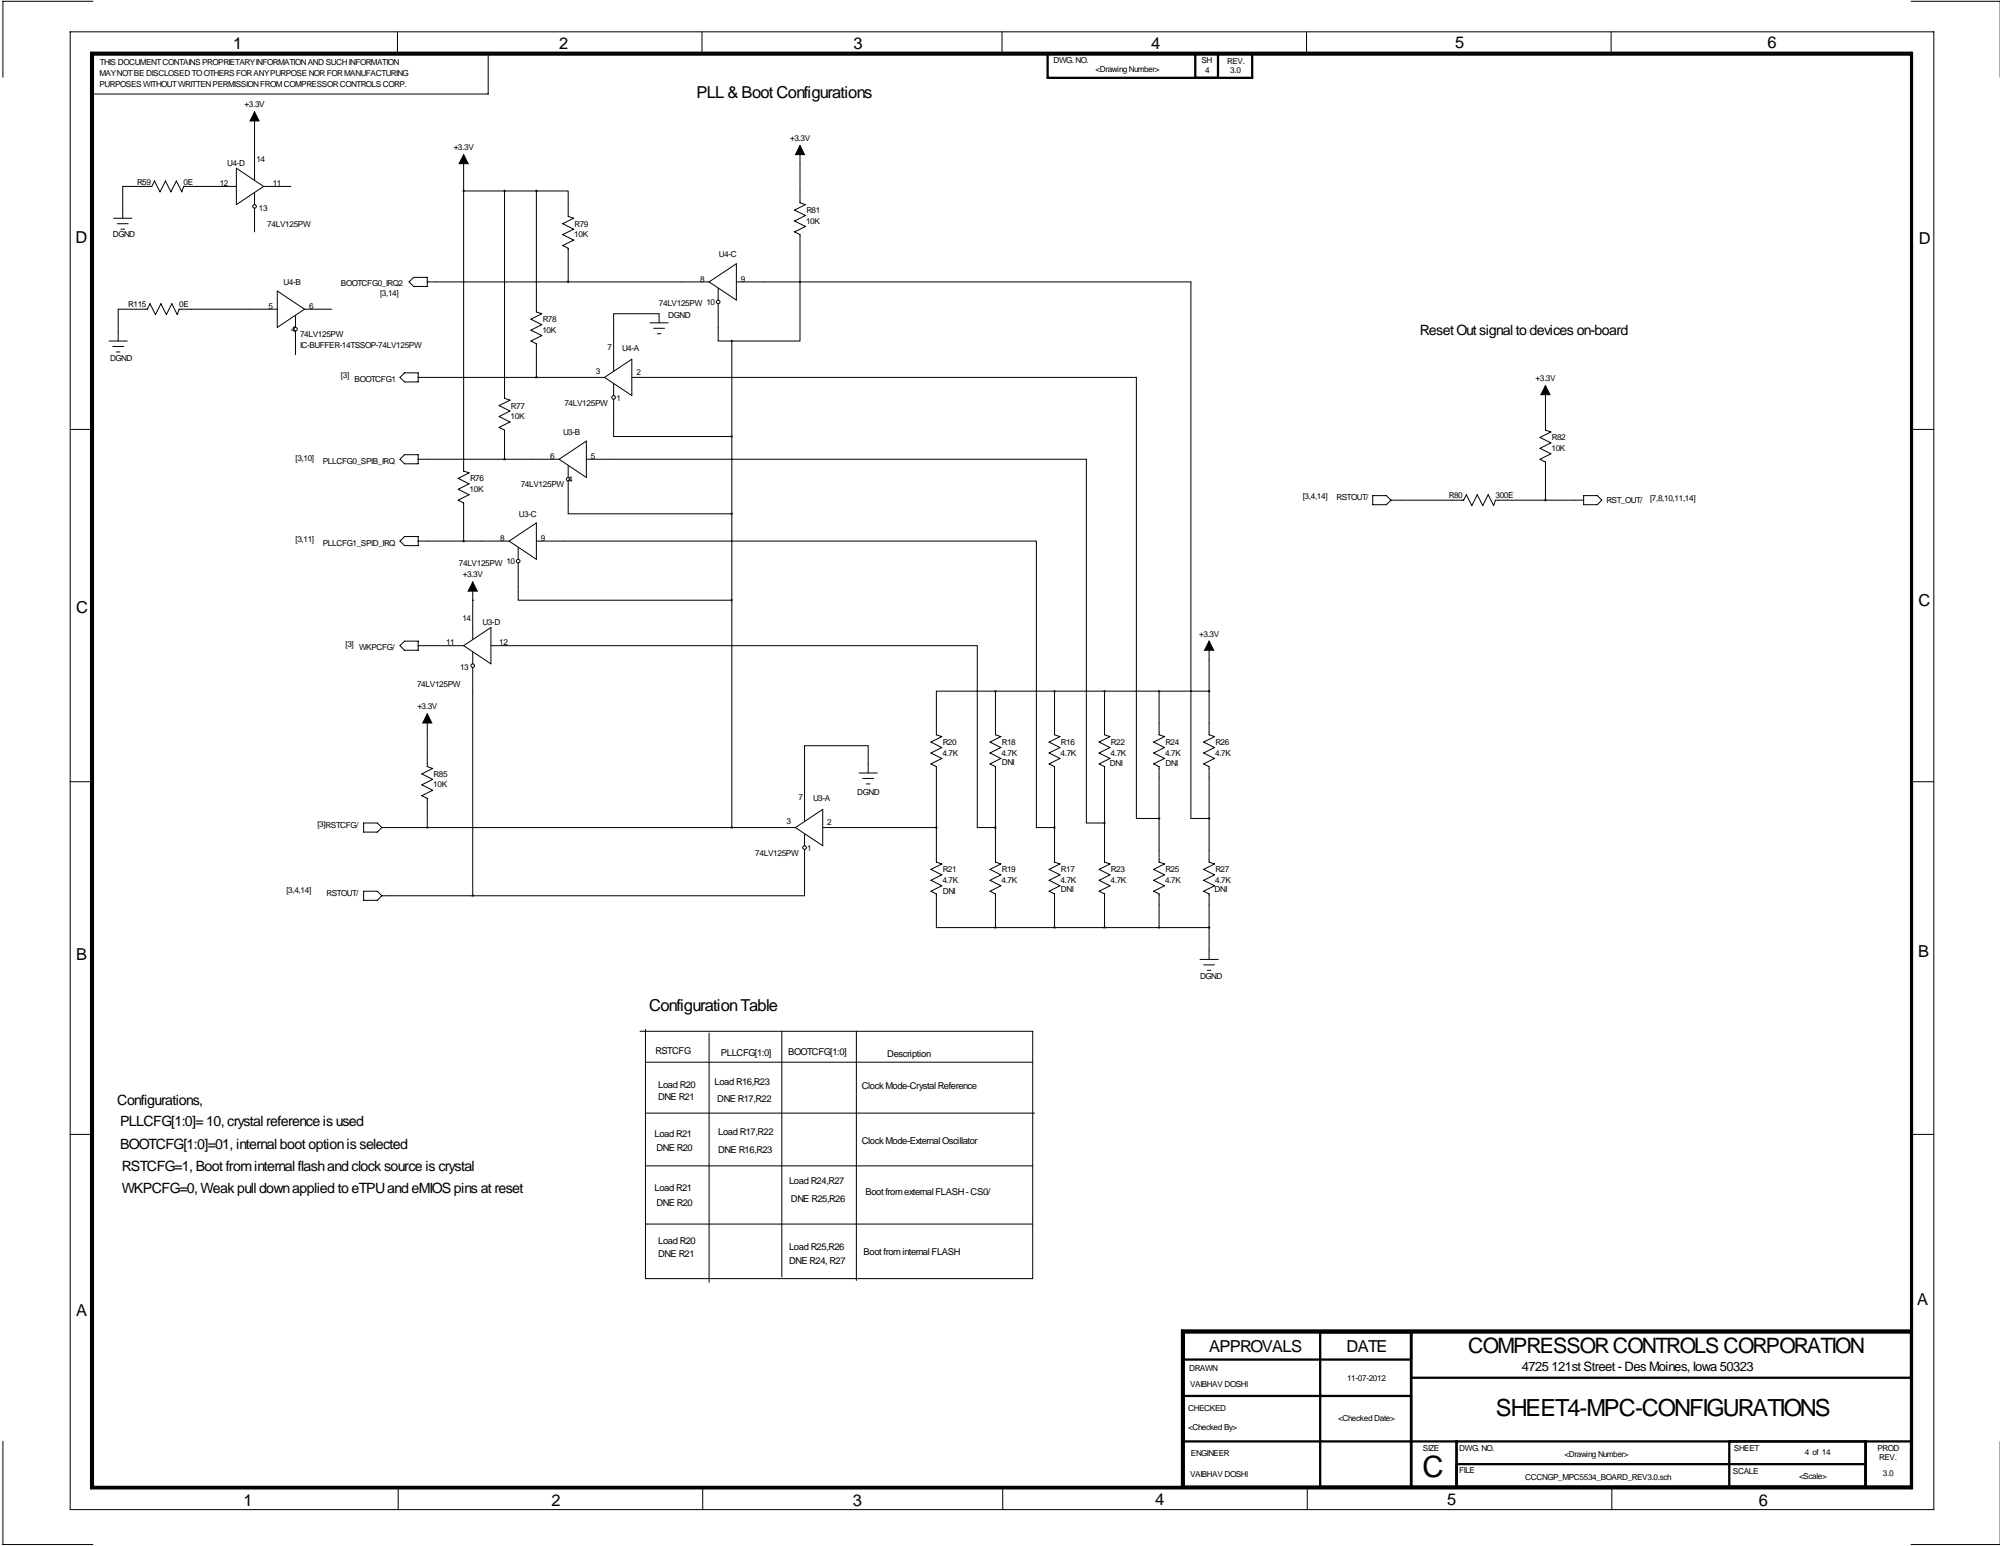
[picture p182: page 4]

Reset Out signal to devices on-board

Load R20 DNE R21 | Load R16,R23 DNE R17,R22 | | Clock Mode-Crystal Reference

Configurations,
PLLCFG[1:0]= 10, crystal reference is used

Load R21 DNE R20 | Load R17,R22 DNE R16,R23 | | Clock Mode-External Oscillator

BOOTCFG[1:0]=01, internal boot option is selected
RSTCFG=1, Boot from internal flash and clock source is crystal
WKPCFG=0, Weak pull down applied to eTPU and eMIOS pins at reset

Load R21 DNE R20 | | Load R24,R27 DNE R25,R26 | Boot from external FLASH - CS0/

Load R20 DNE R21 | | Load R25,R26 DNE R24, R27 | Boot from internal FLASH

APPROVALS | DATE | COMPRESSOR CONTROLS CORPORATION 4725 121st Street - Des Moines, Iowa 50323

DRAWN VAIBHAV DOSHI | 11-07-2012

CHECKED

D

D

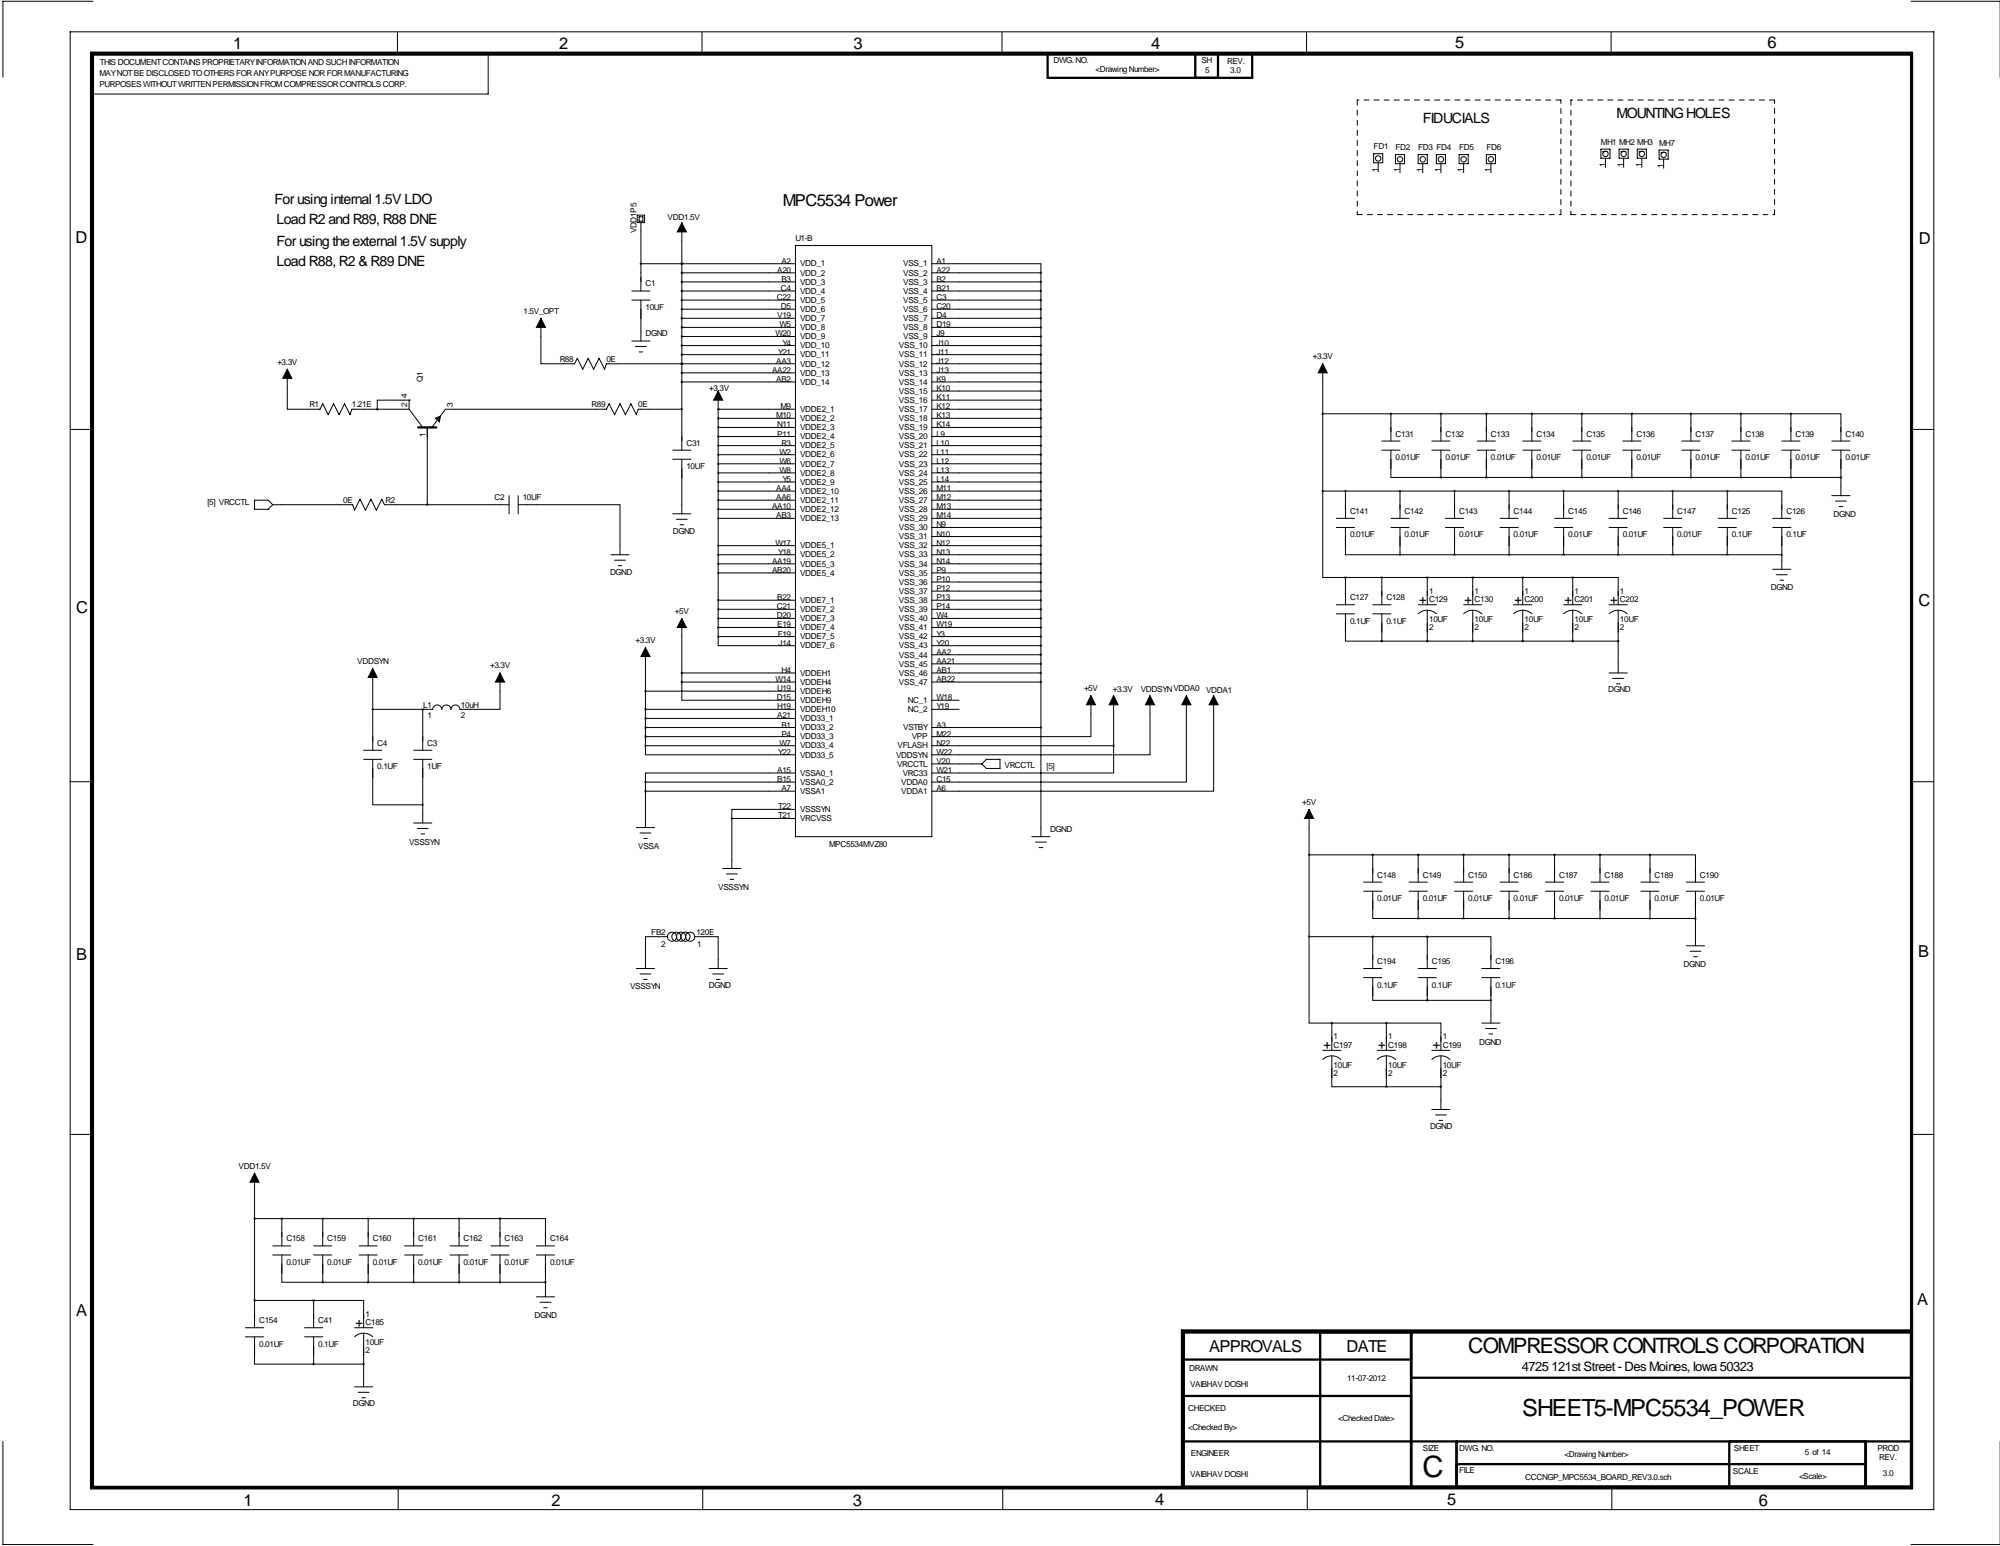
[picture p183: page 5]

For using internal 1.5V LDO
Load R2 and R89, R88 DNE
For using the external 1.5V supply
Load R88, R2 & R89 DNE

APPROVALS | DATE | COMPRESSOR CONTROLS CORPORATION 4725 121st Street - Des Moines, Iowa 50323

DRAWN VAIBHAV DOSHI | 11-07-2012

CHECKED

D

D

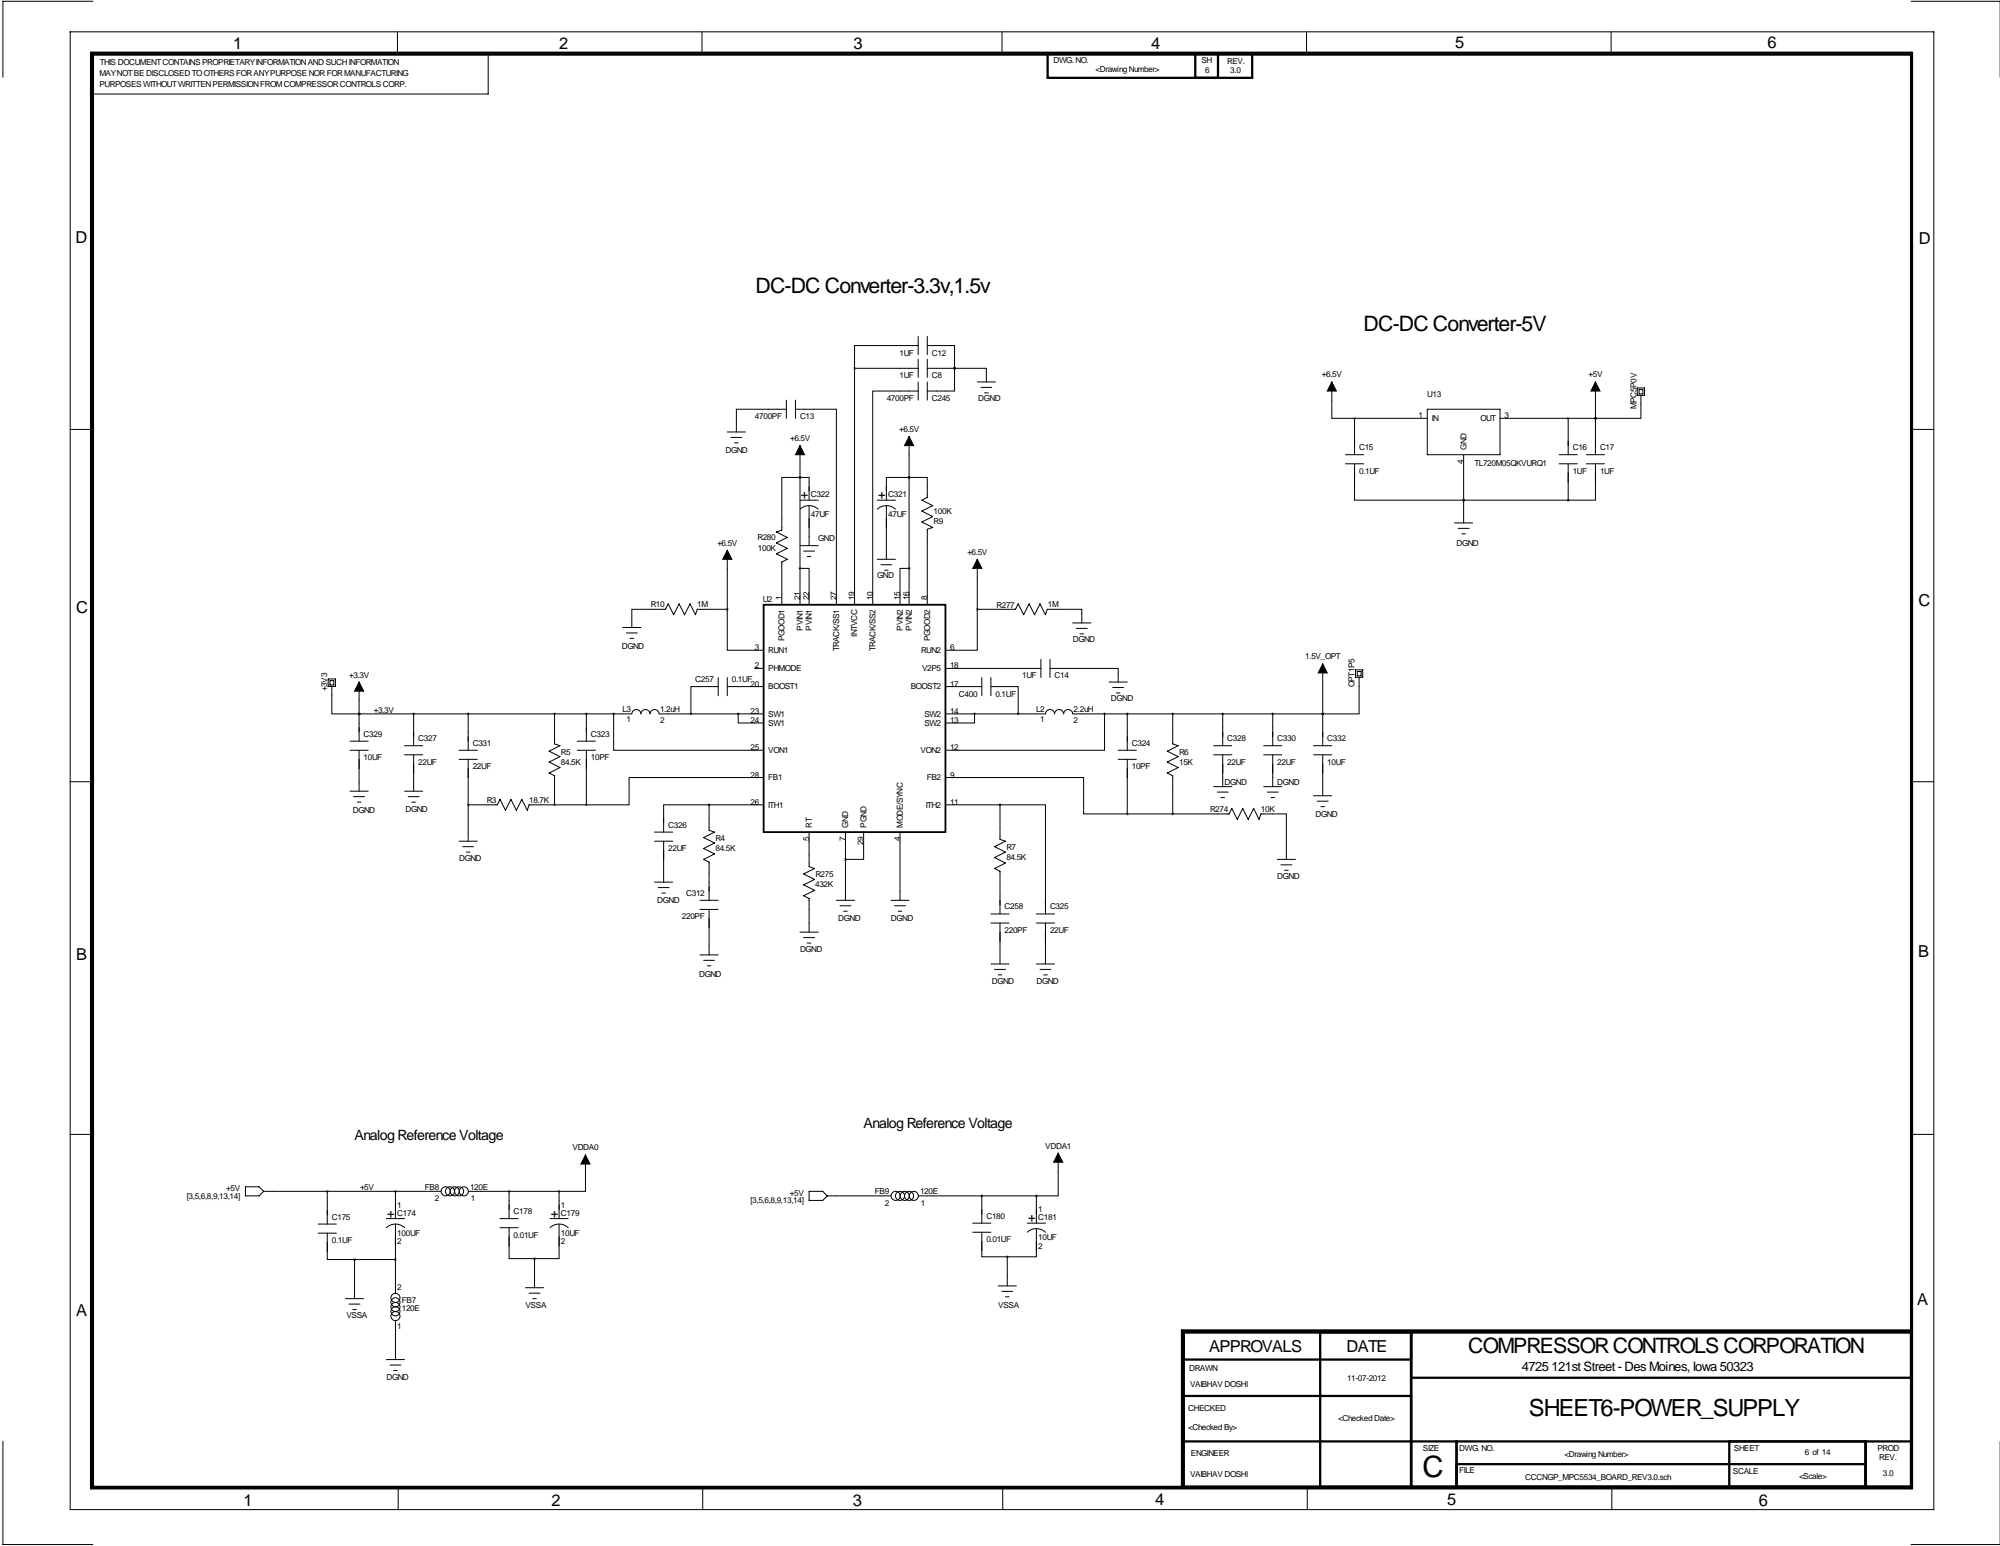
[picture p184: page 6]

APPROVALS | DATE | COMPRESSOR CONTROLS CORPORATION 4725 121st Street - Des Moines, Iowa 50323

DRAWN VAIBHAV DOSHI | 11-07-2012

CHECKED

D

D

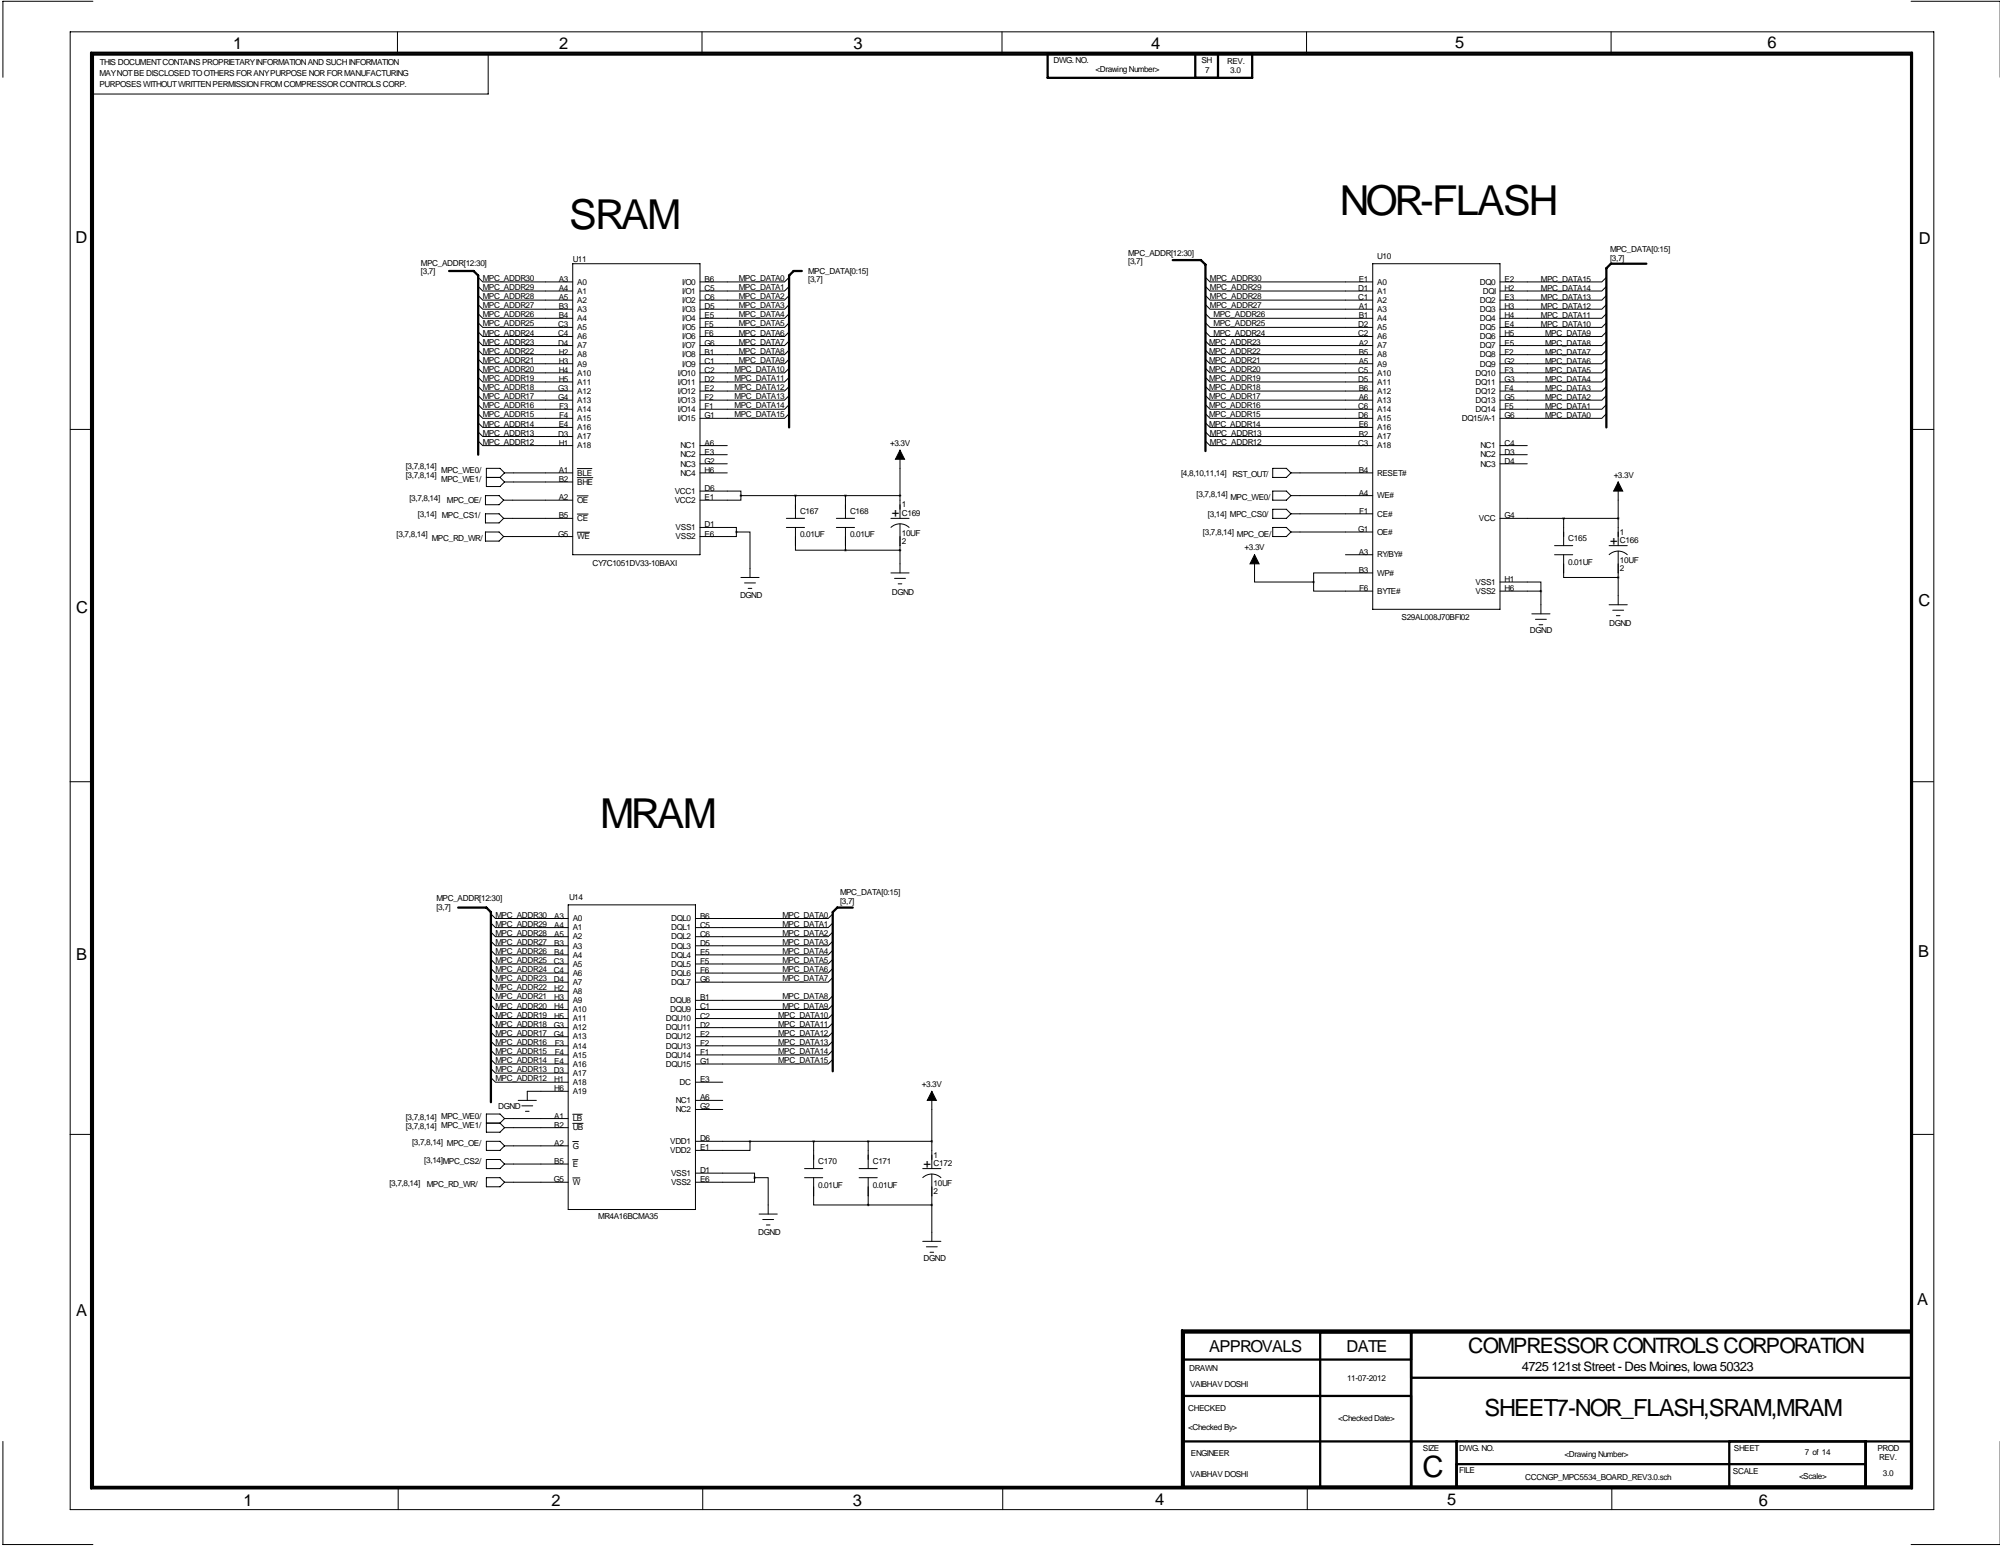
[picture p185: page 7]

APPROVALS | DATE | COMPRESSOR CONTROLS CORPORATION 4725 121st Street - Des Moines, Iowa 50323

DRAWN VAIBHAV DOSHI | 11-07-2012

CHECKED

D

D

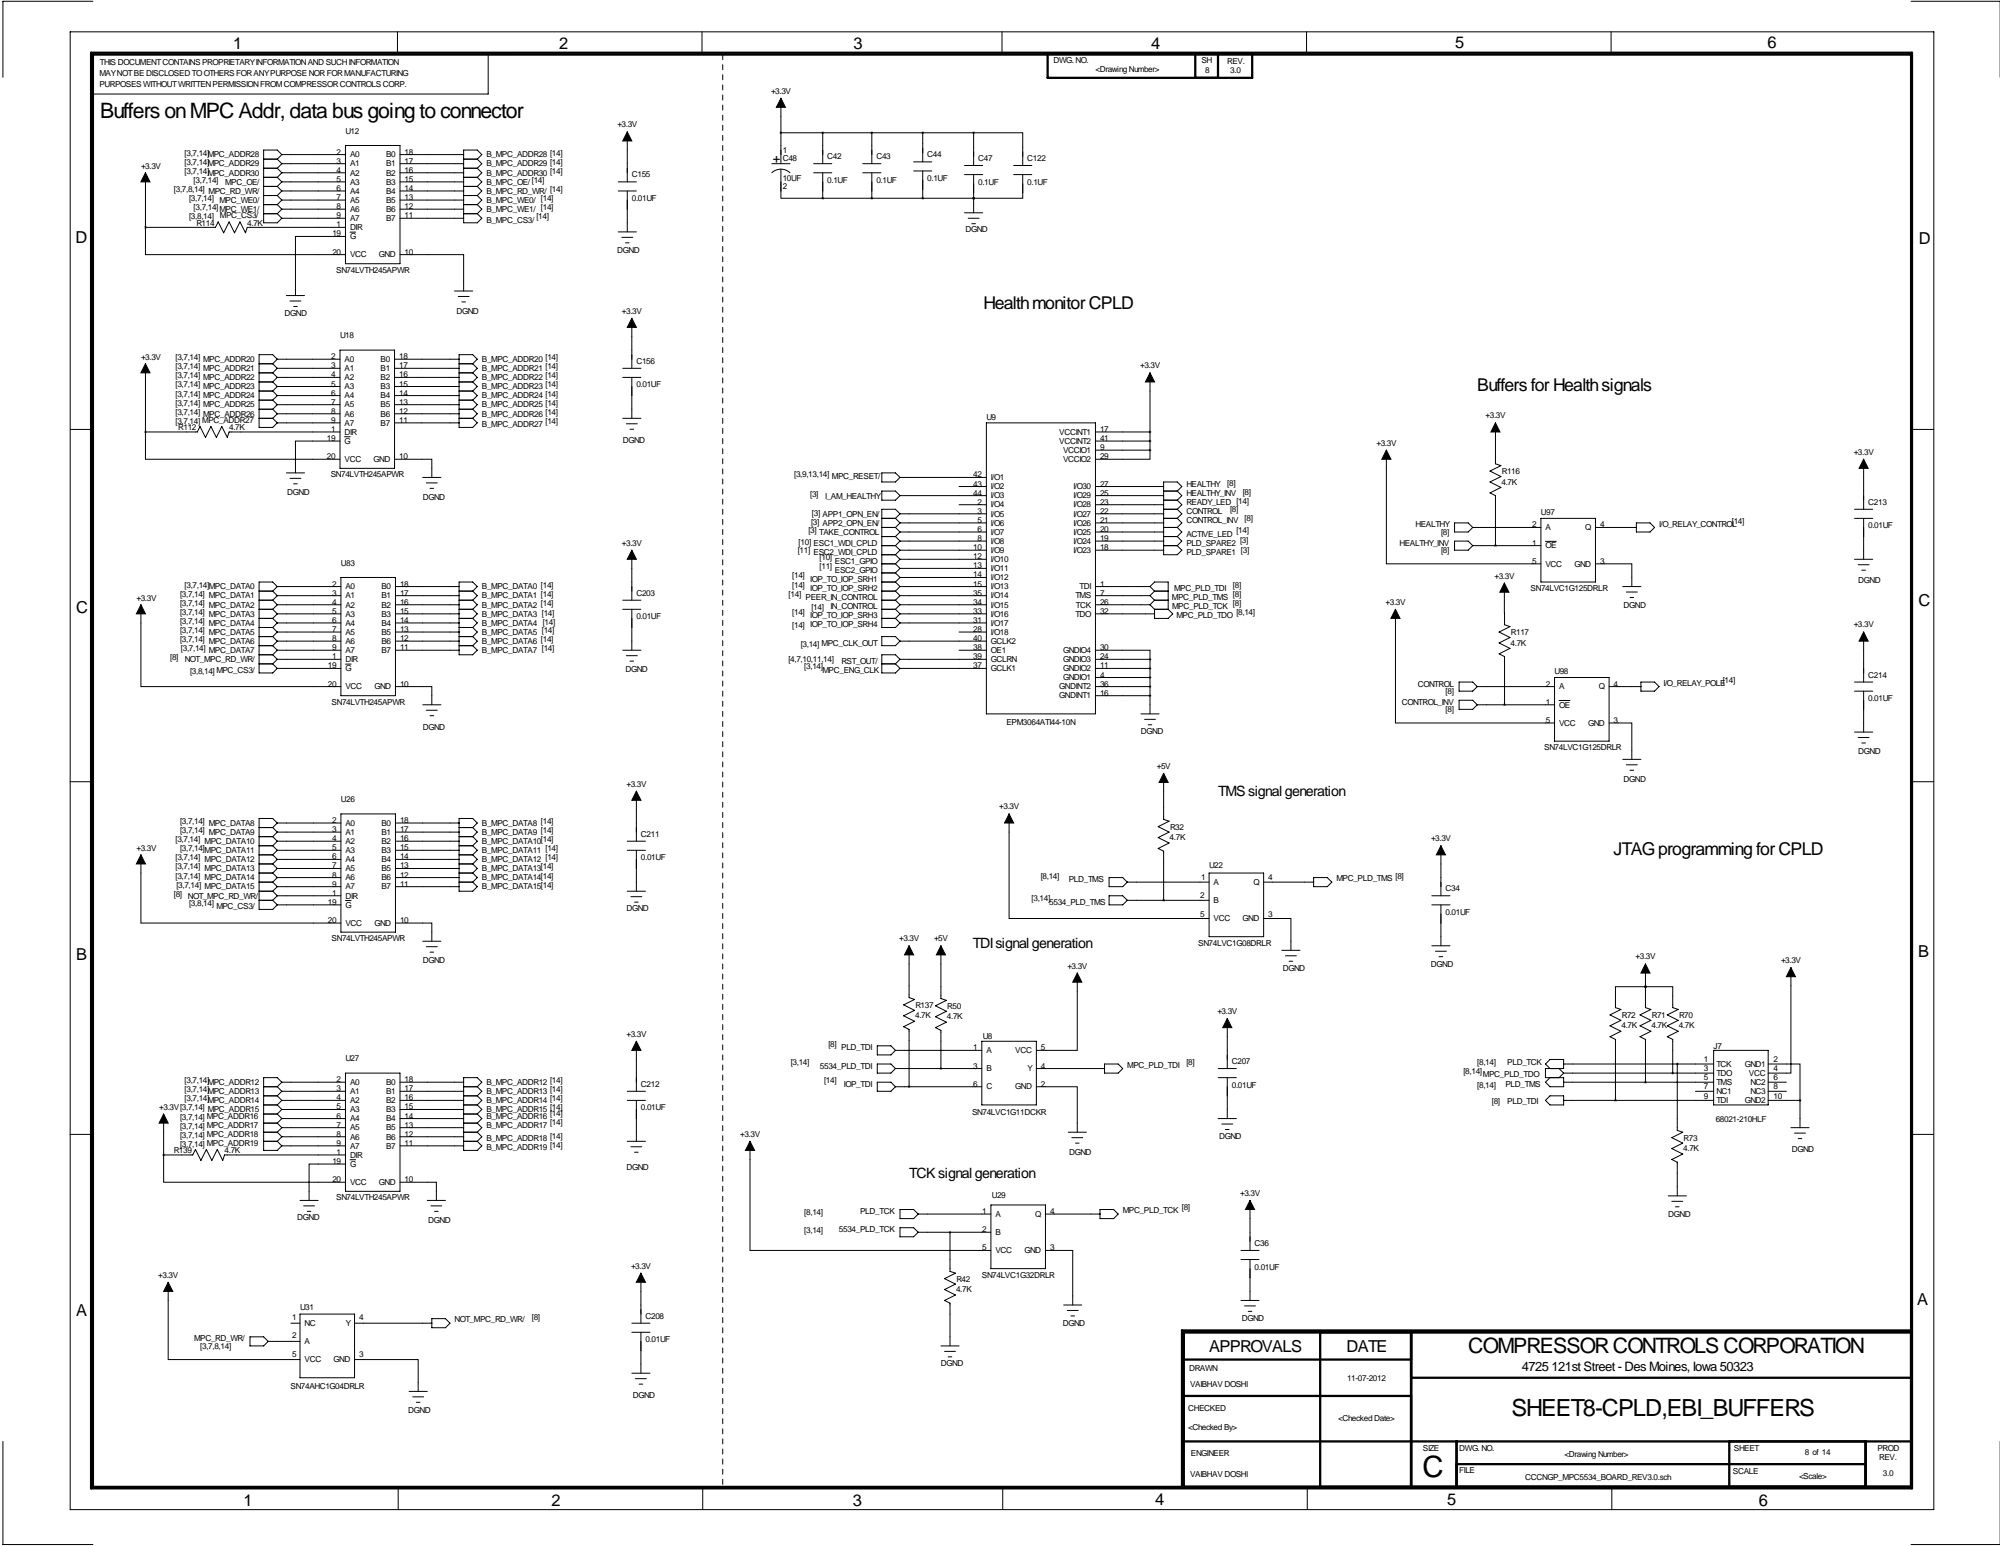
[picture p186: page 8]

Buffers on MPC Addr, data bus going to connector

Buffers for Health signals

JTAG programming for CPLD

4725 121st Street - Des Moines, Iowa 50323
SHEET8-CPLD,EBI_BUFFERS

D

D

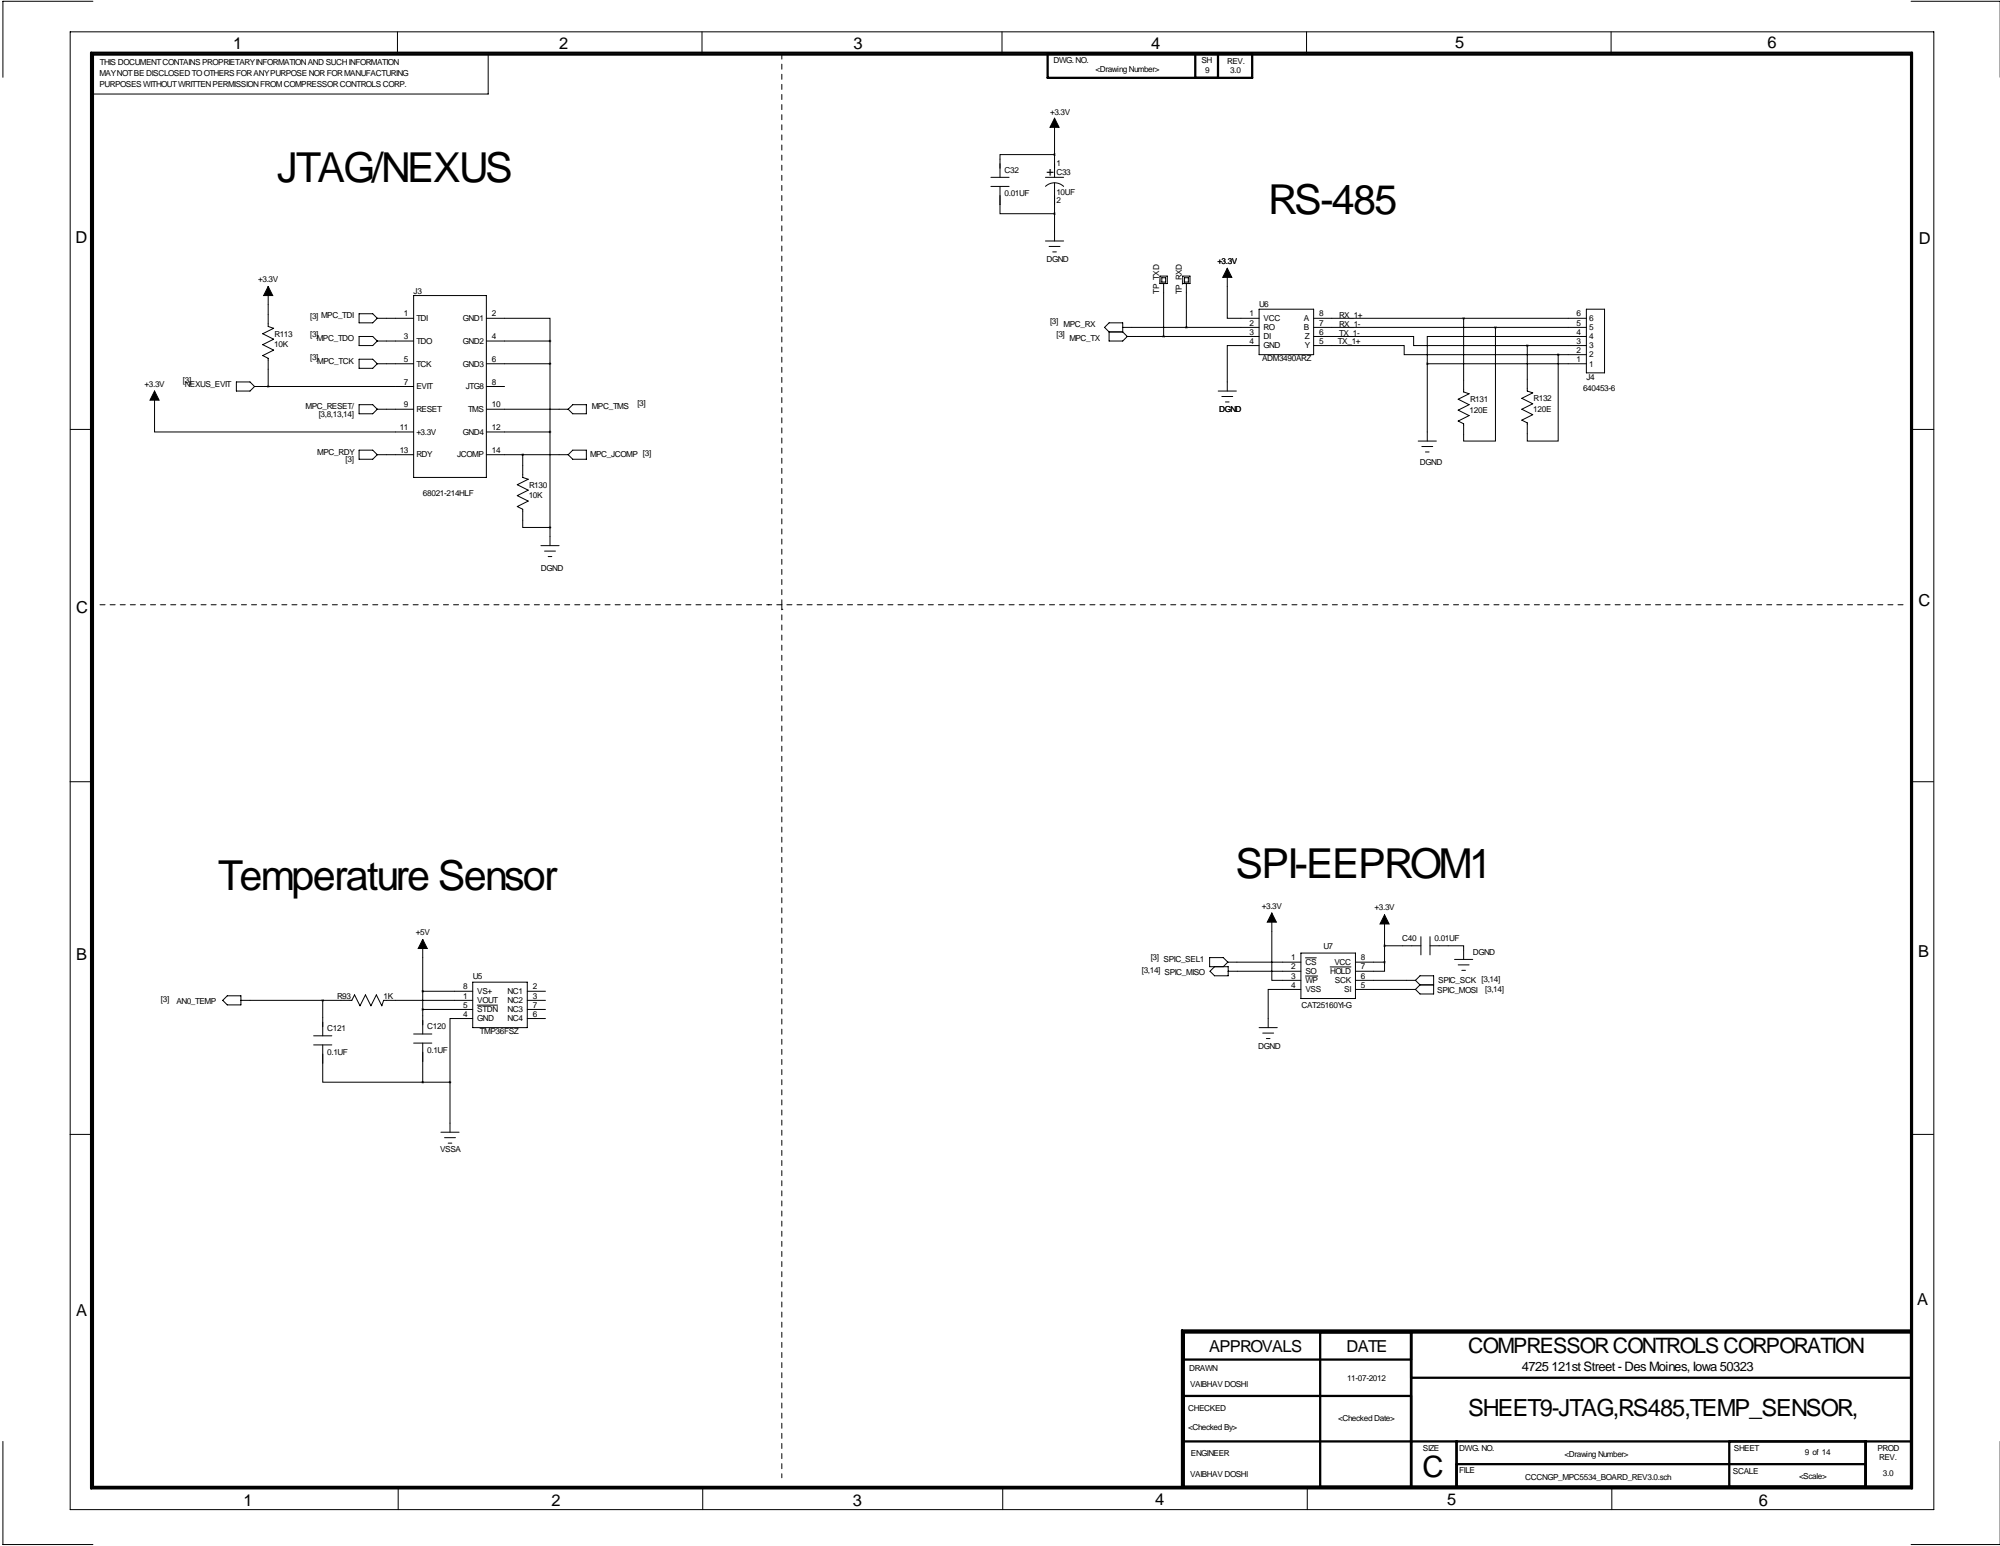
[picture p187: page 9]

APPROVALS | DATE | COMPRESSOR CONTROLS CORPORATION 4725 121st Street - Des Moines, Iowa 50323

DRAWN VAIBHAV DOSHI | 11-07-2012

CHECKED

D

D

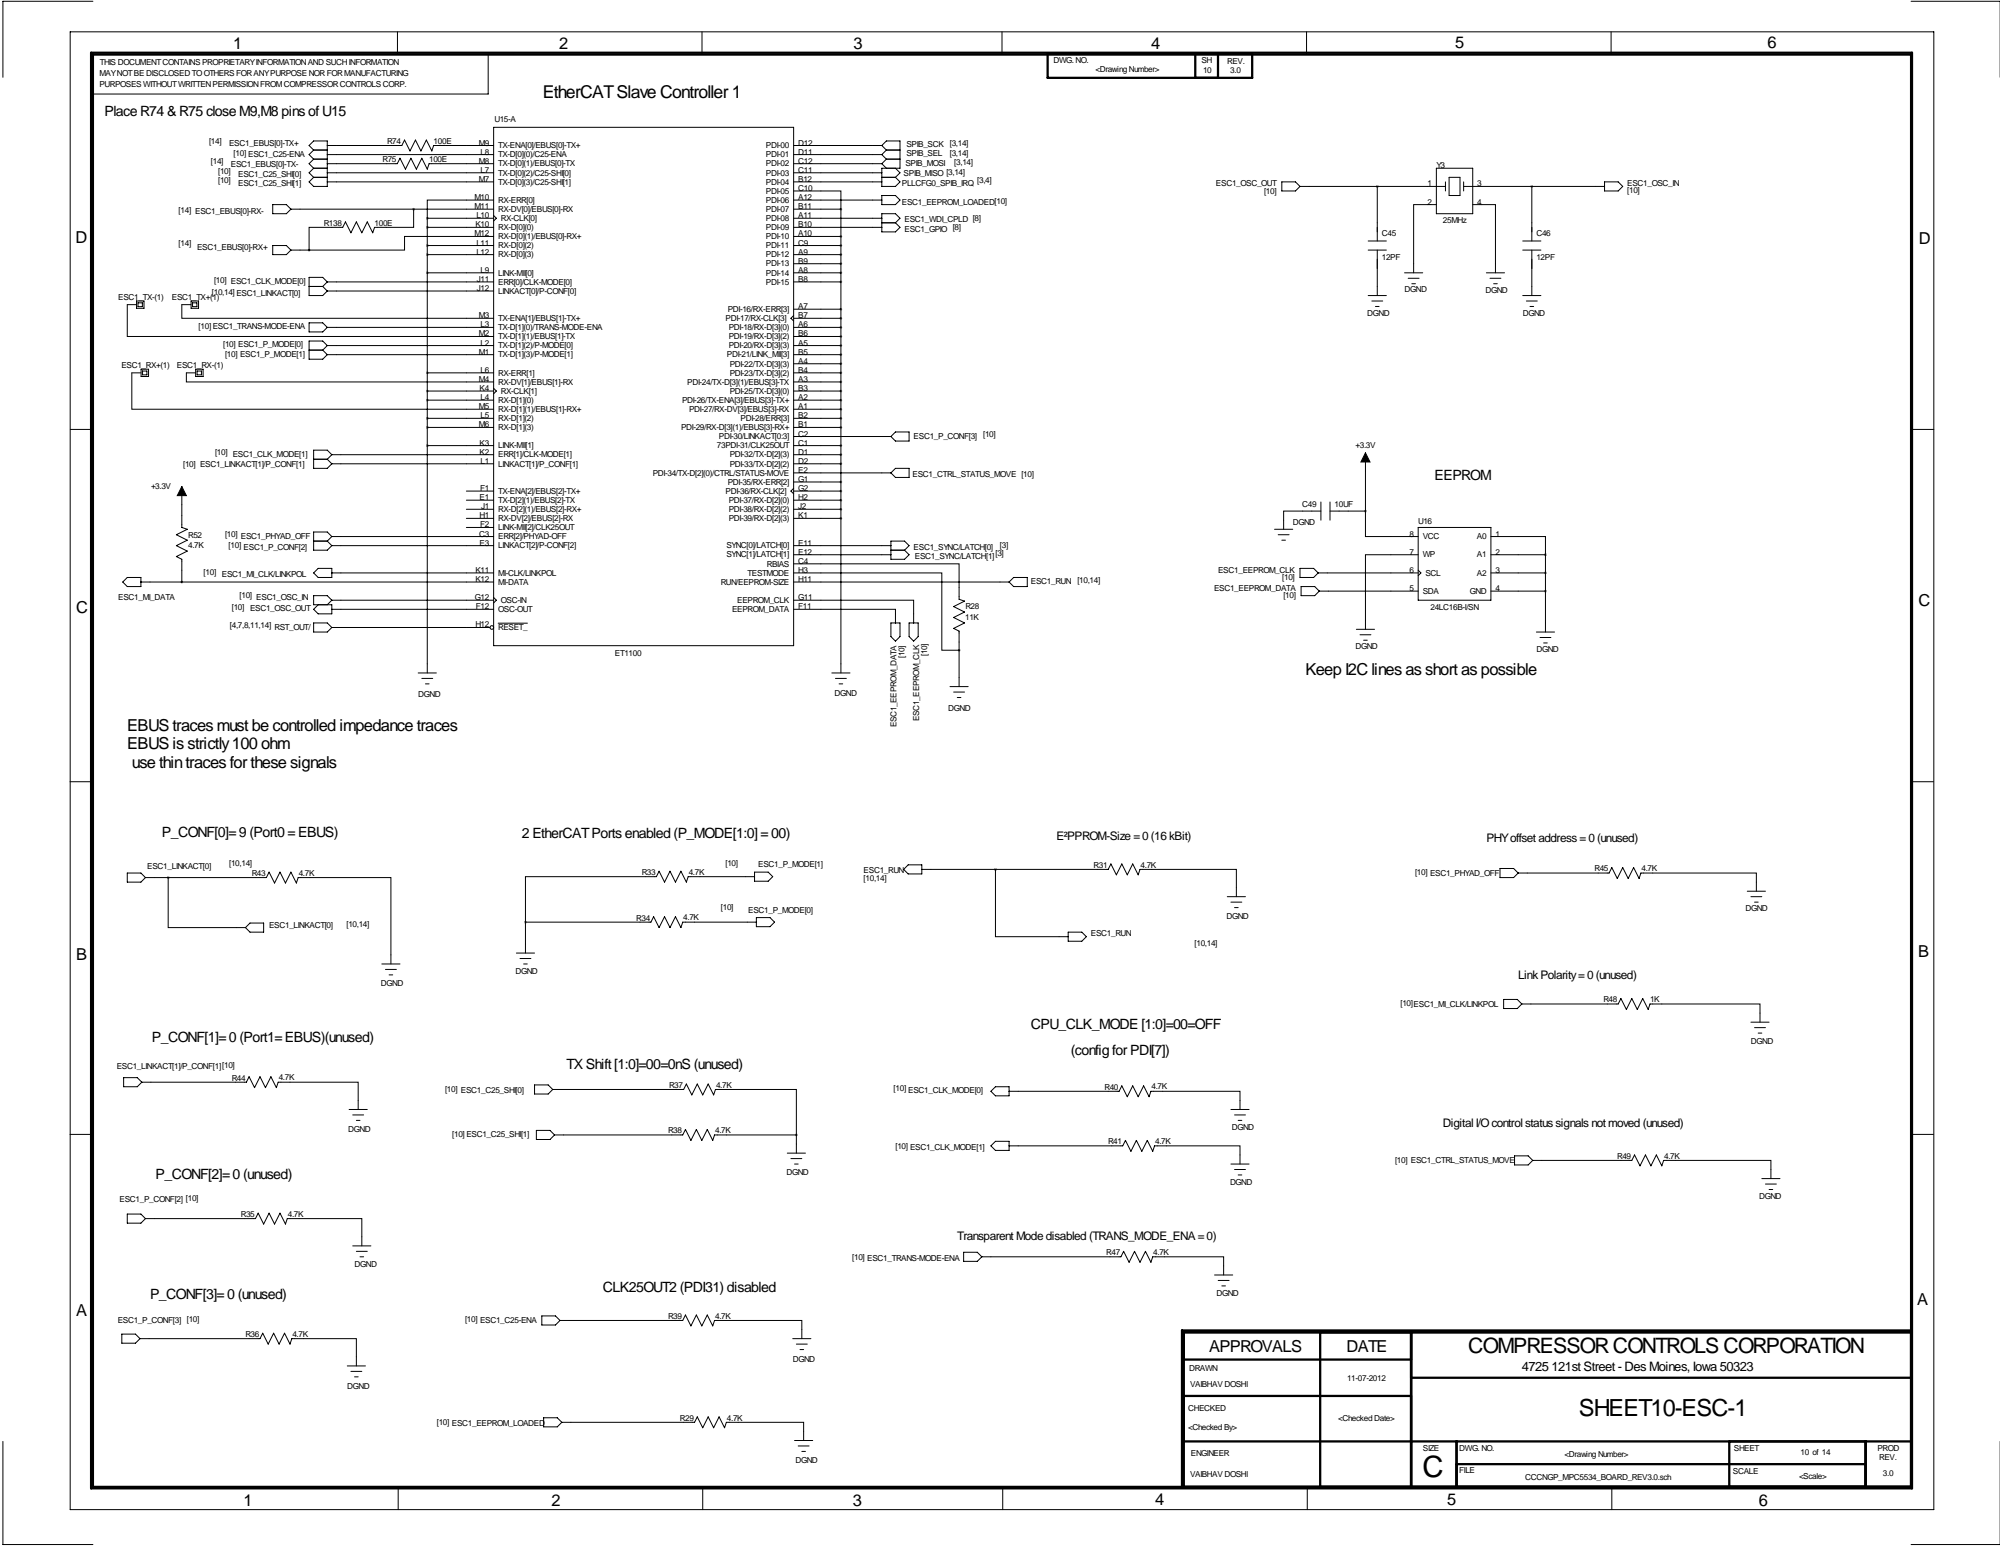
[picture p188: page 10]

Place R74 & R75 close M9,M8 pins of U15

A3 PDI-24/TX-D[3](1)/EBUS[3]-TX

A2 PDI-26/TX-ENA[3]/EBUS[3]-TX+
A1 PDI-27/RX-DV[3]/EBUS[3]-RX

B1 PDI-29/RX-D[3](1)/EBUS[3]-RX+

E2 PDI-34/TX-D[2](0)/CTRL/STATUS-MOVE

H3 TESTMODE

G11 EEPROM_CLK

Keep I2C lines as short as possible

EBUS traces must be controlled impedance traces
EBUS is strictly 100 ohm
use thin traces for these signals

PHY offset address = 0 (unused)

Digital I/O control status signals not moved (unused)

APPROVALS | DATE | COMPRESSOR CONTROLS CORPORATION 4725 121st Street - Des Moines, Iowa 50323

DRAWN VAIBHAV DOSHI | 11-07-2012

CHECKED

D

D

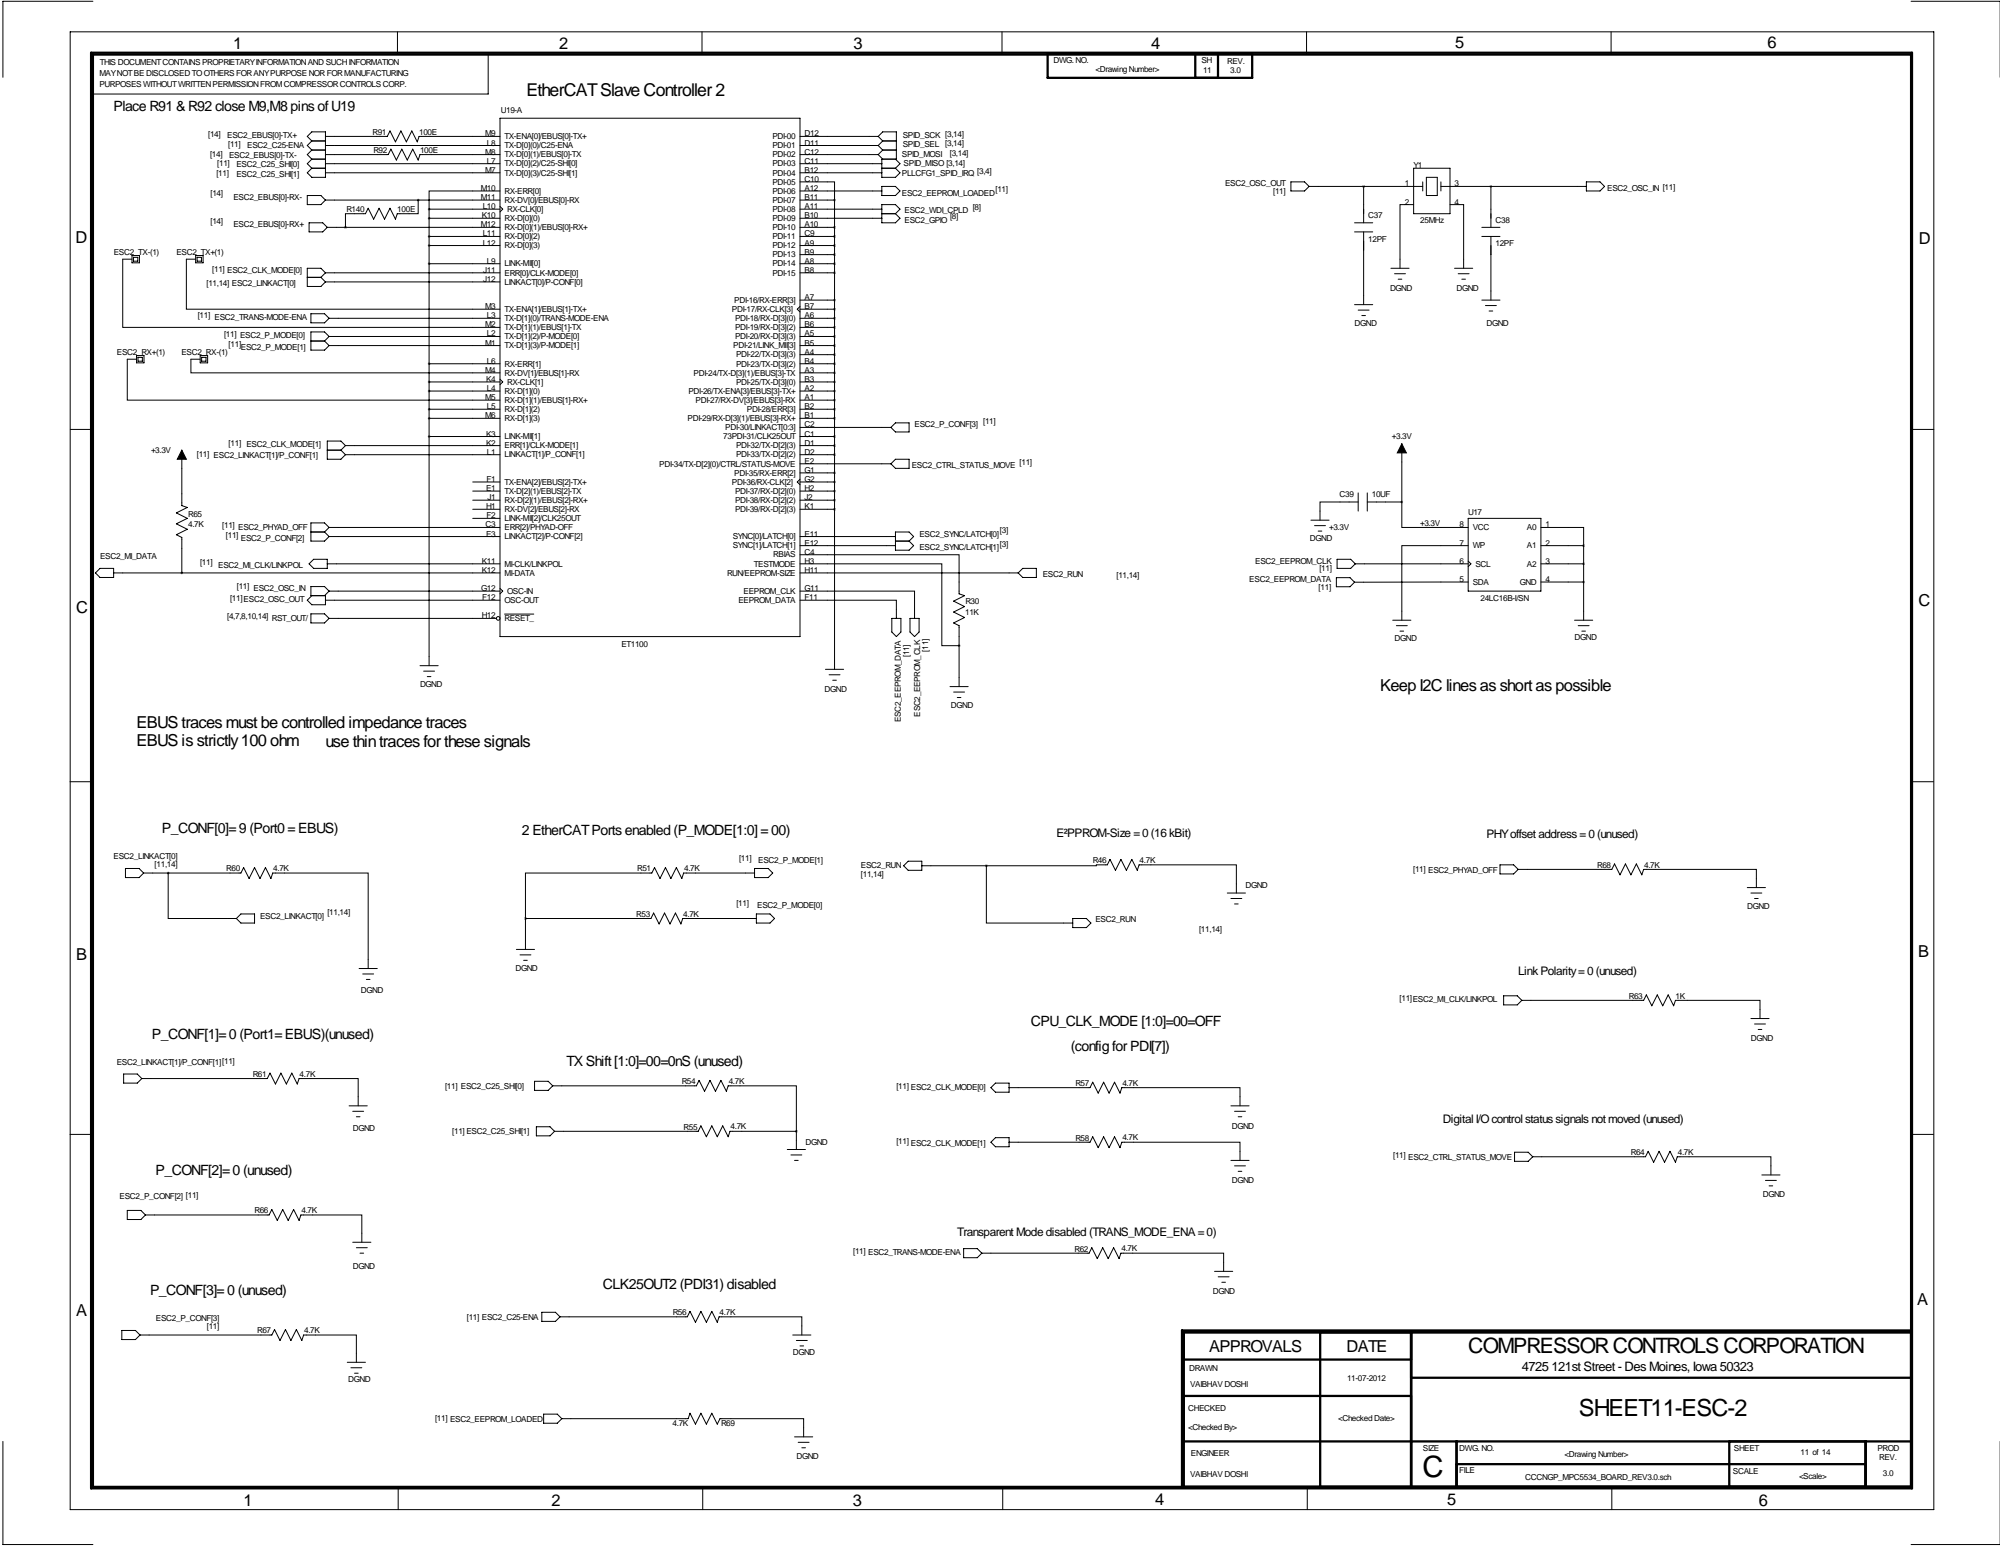
[picture p189: page 11]

Place R91 & R92 close M9,M8 pins of U19

A3 PDI-24/TX-D[3](1)/EBUS[3]-TX

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

B1 PDI-29/RX-D[3](1)/EBUS[3]-RX+

E2 PDI-34/TX-D[2](0)/CTRL/STATUS-MOVE

H3 TESTMODE

H11 RUN/EEPROM-SIZE G11 EEPROM_CLK

Keep I2C lines as short as possible

EBUS traces must be controlled impedance traces

PHY offset address = 0 (unused)

Digital I/O control status signals not moved (unused)

APPROVALS | DATE | COMPRESSOR CONTROLS CORPORATION 4725 121st Street - Des Moines, Iowa 50323

DRAWN VAIBHAV DOSHI | 11-07-2012

CHECKED

D

D

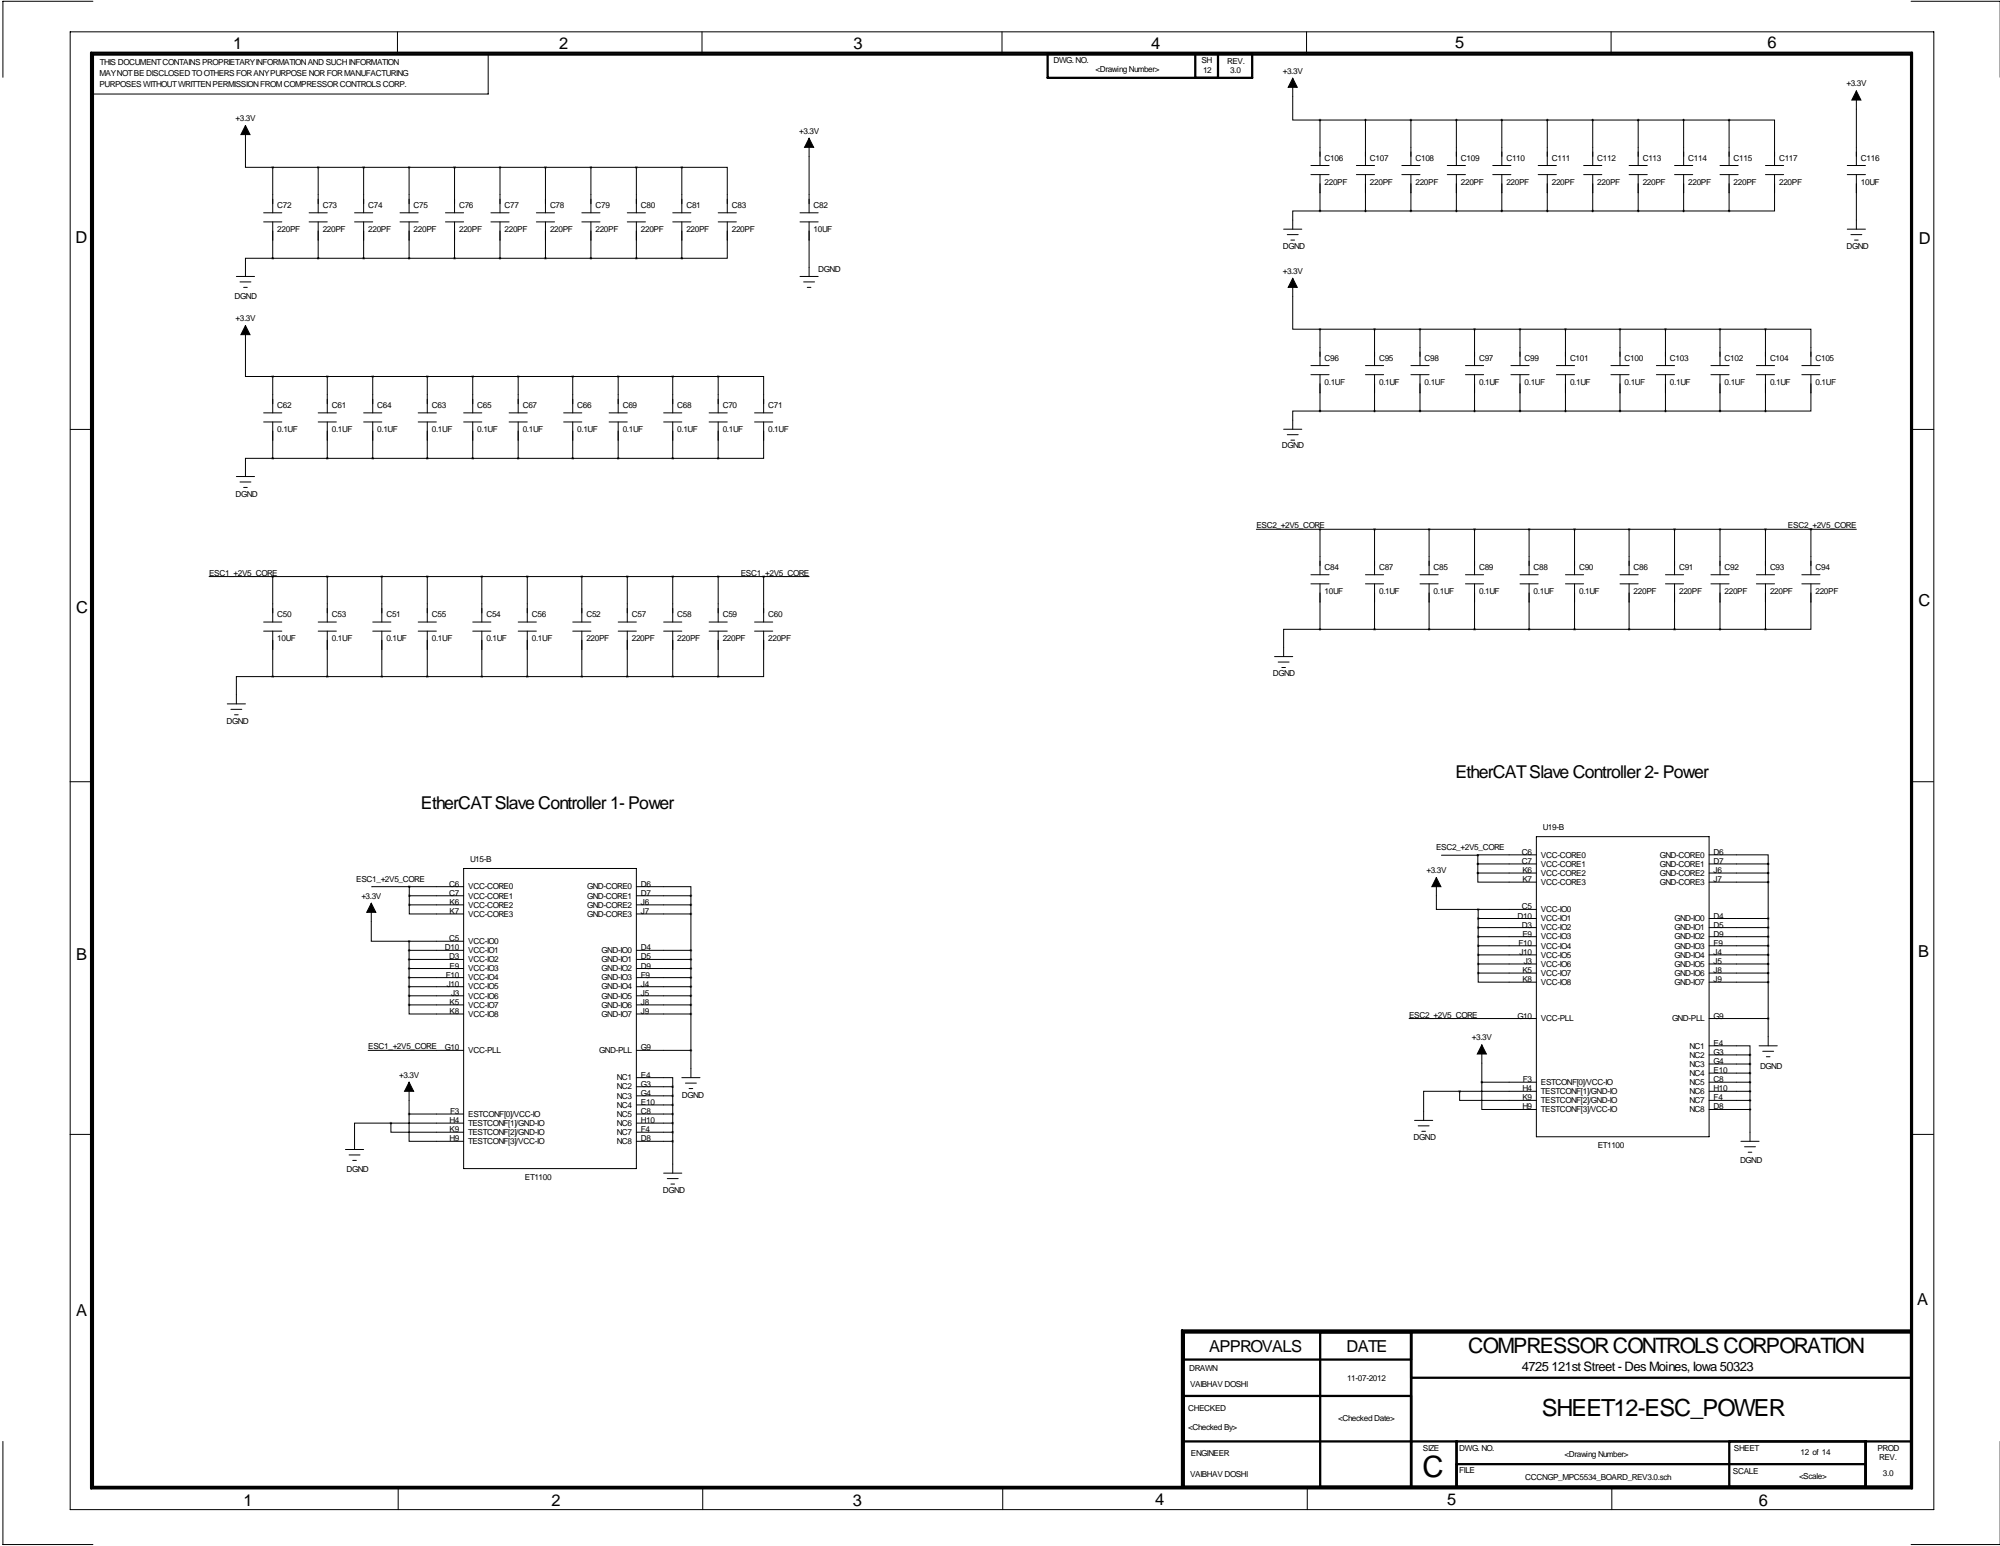
[picture p190: page 12]

EtherCAT Slave Controller 2- Power

EtherCAT Slave Controller 1- Power

APPROVALS | DATE | COMPRESSOR CONTROLS CORPORATION 4725 121st Street - Des Moines, Iowa 50323

DRAWN VAIBHAV DOSHI | 11-07-2012

CHECKED

D

D

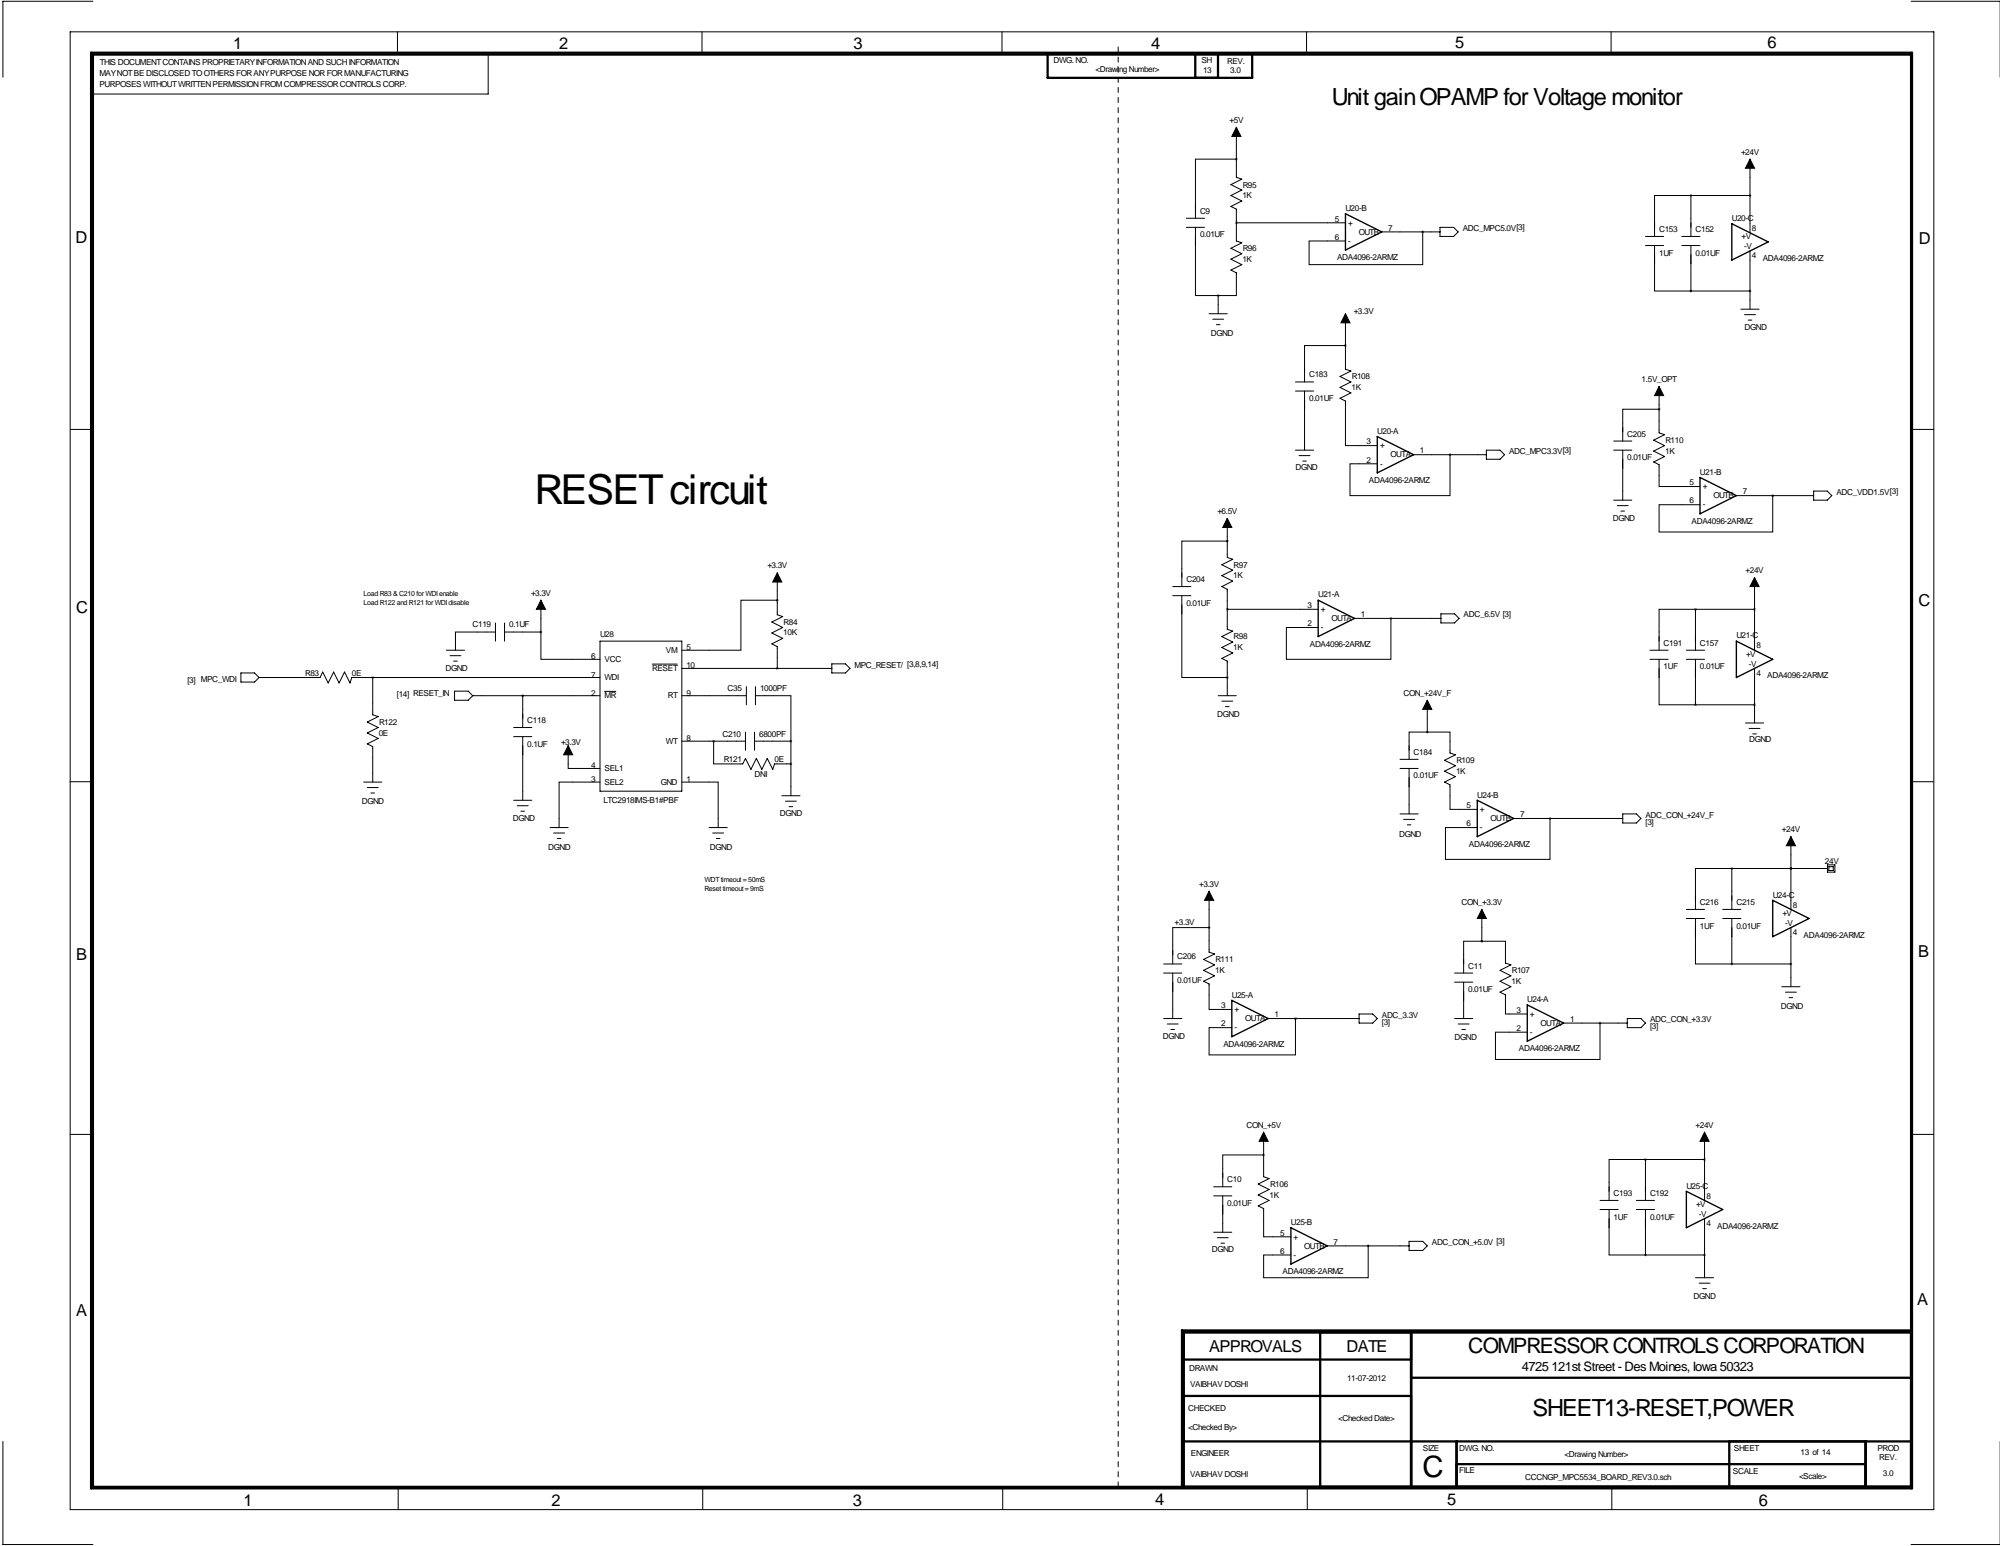
[picture p191: page 13]

Unit gain OPAMP for Voltage monitor

Load R83 & C210 for WDI enable
Load R122 and R121 for WDI disable

APPROVALS | DATE | COMPRESSOR CONTROLS CORPORATION 4725 121st Street - Des Moines, Iowa 50323

DRAWN VAIBHAV DOSHI | 11-07-2012

CHECKED

D

D

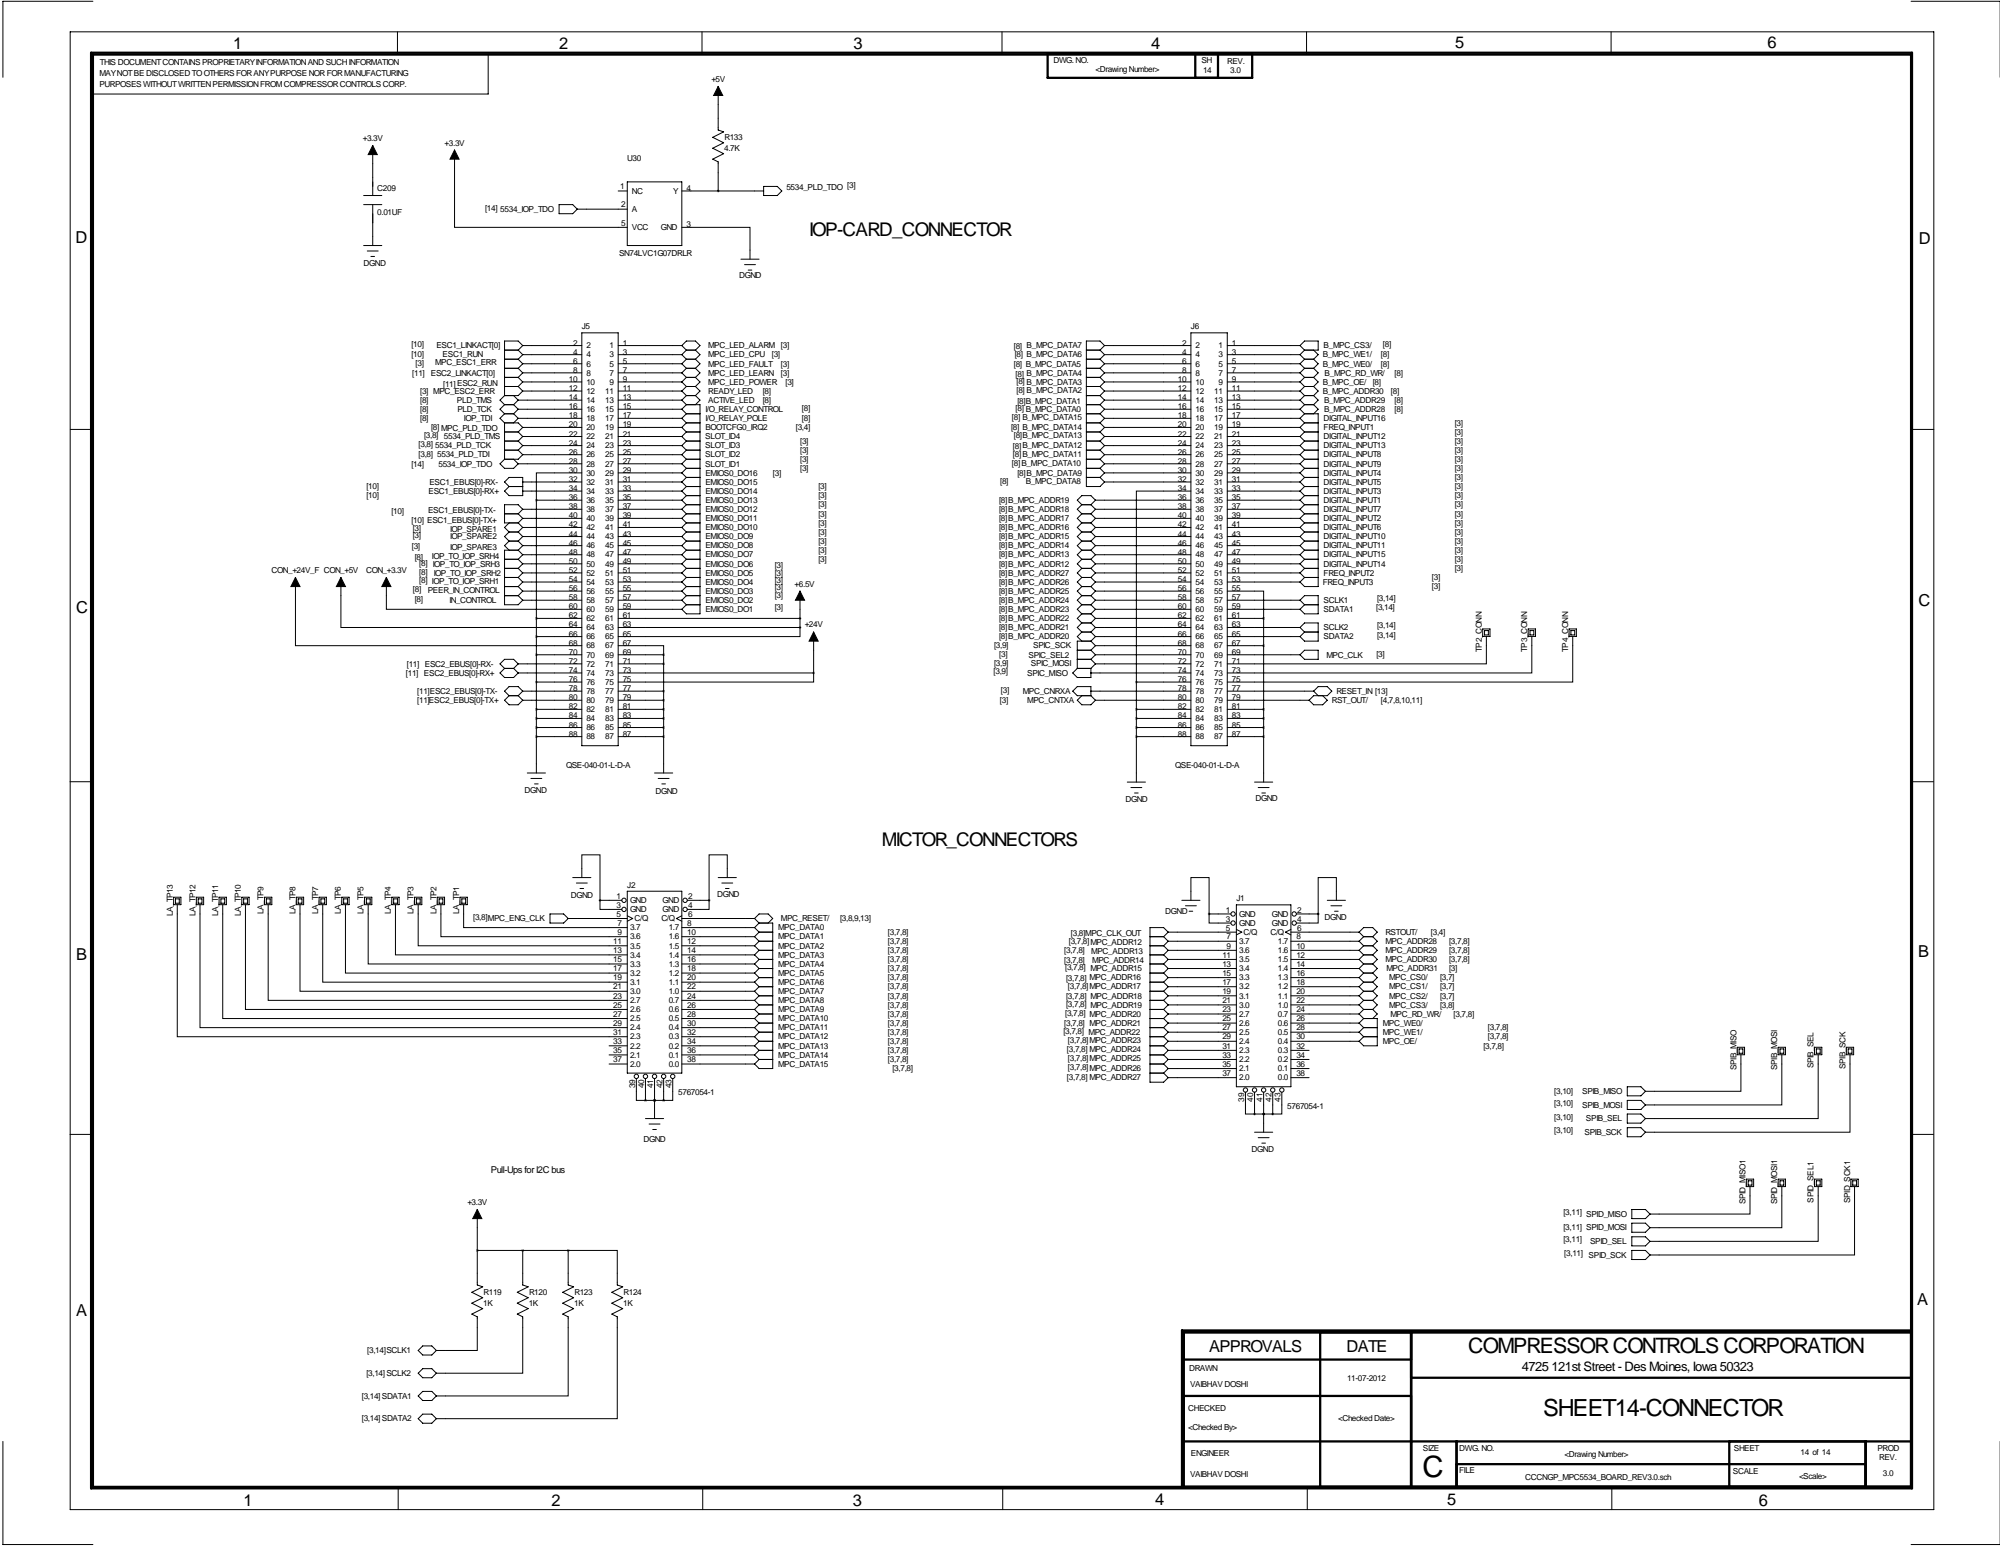
[picture p192: page 14]

Pull-Ups for I2C bus

APPROVALS | DATE | COMPRESSOR CONTROLS CORPORATION 4725 121st Street - Des Moines, Iowa 50323

DRAWN VAIBHAV DOSHI | 11-07-2012

CHECKED
