Sayidathahaseen/CCC_NGP_ODC/NGP_ODC_Main/PDLC/design/Schematics/PCC/rev1/PCC_NGF_19JULY11.pdf

+6.5V

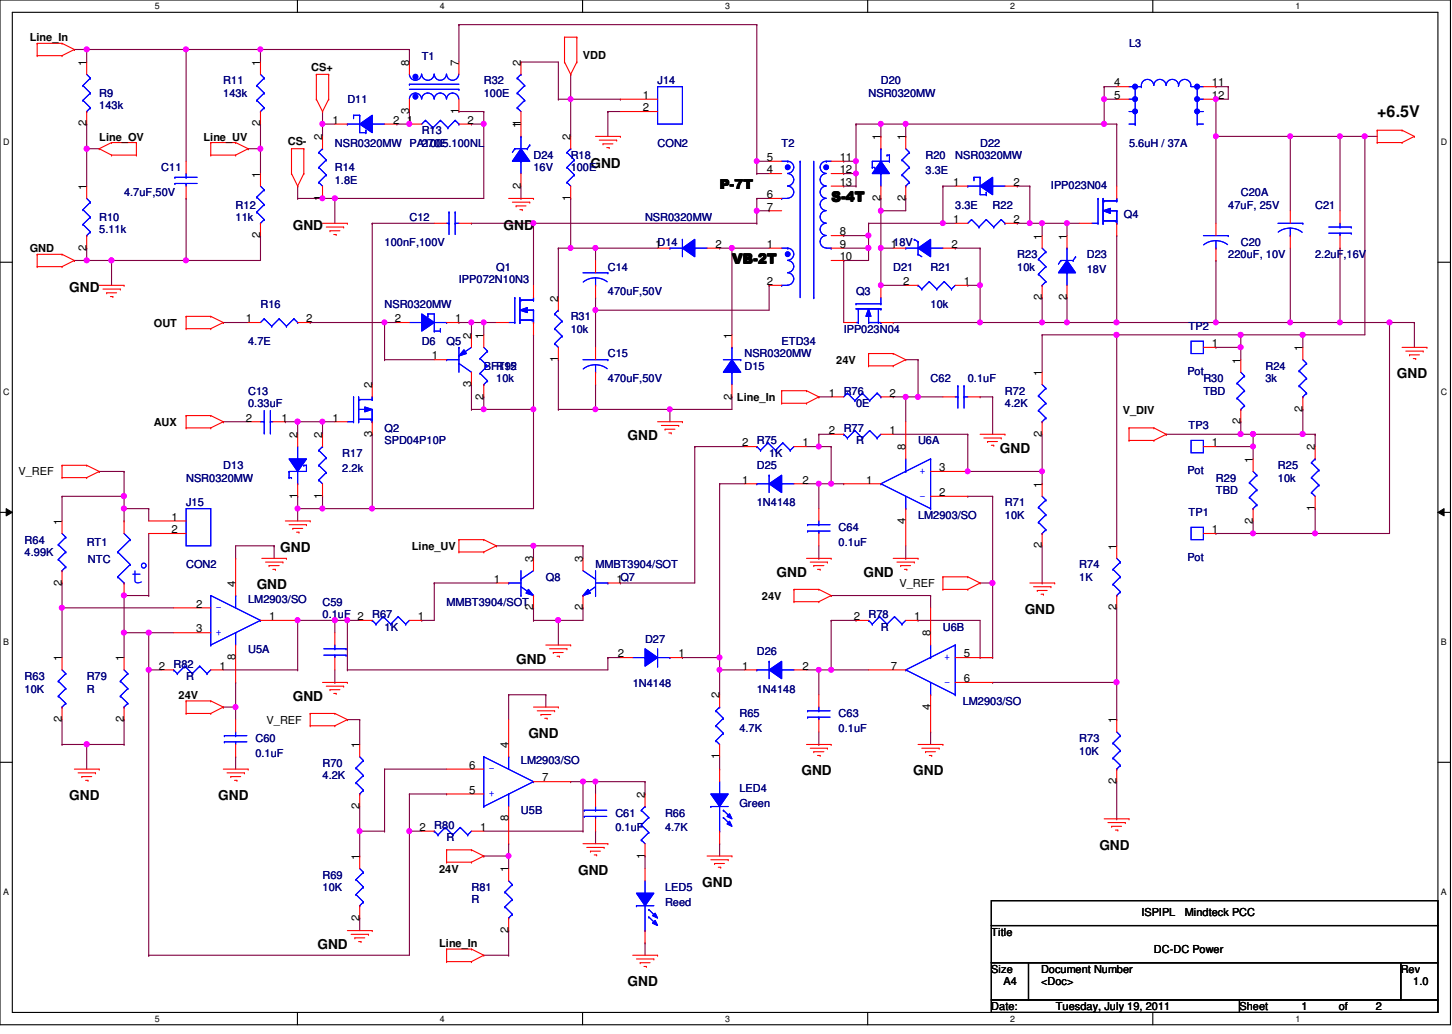
[picture p193: page 1]

24V-A | 24V-A

51720-10400804AA

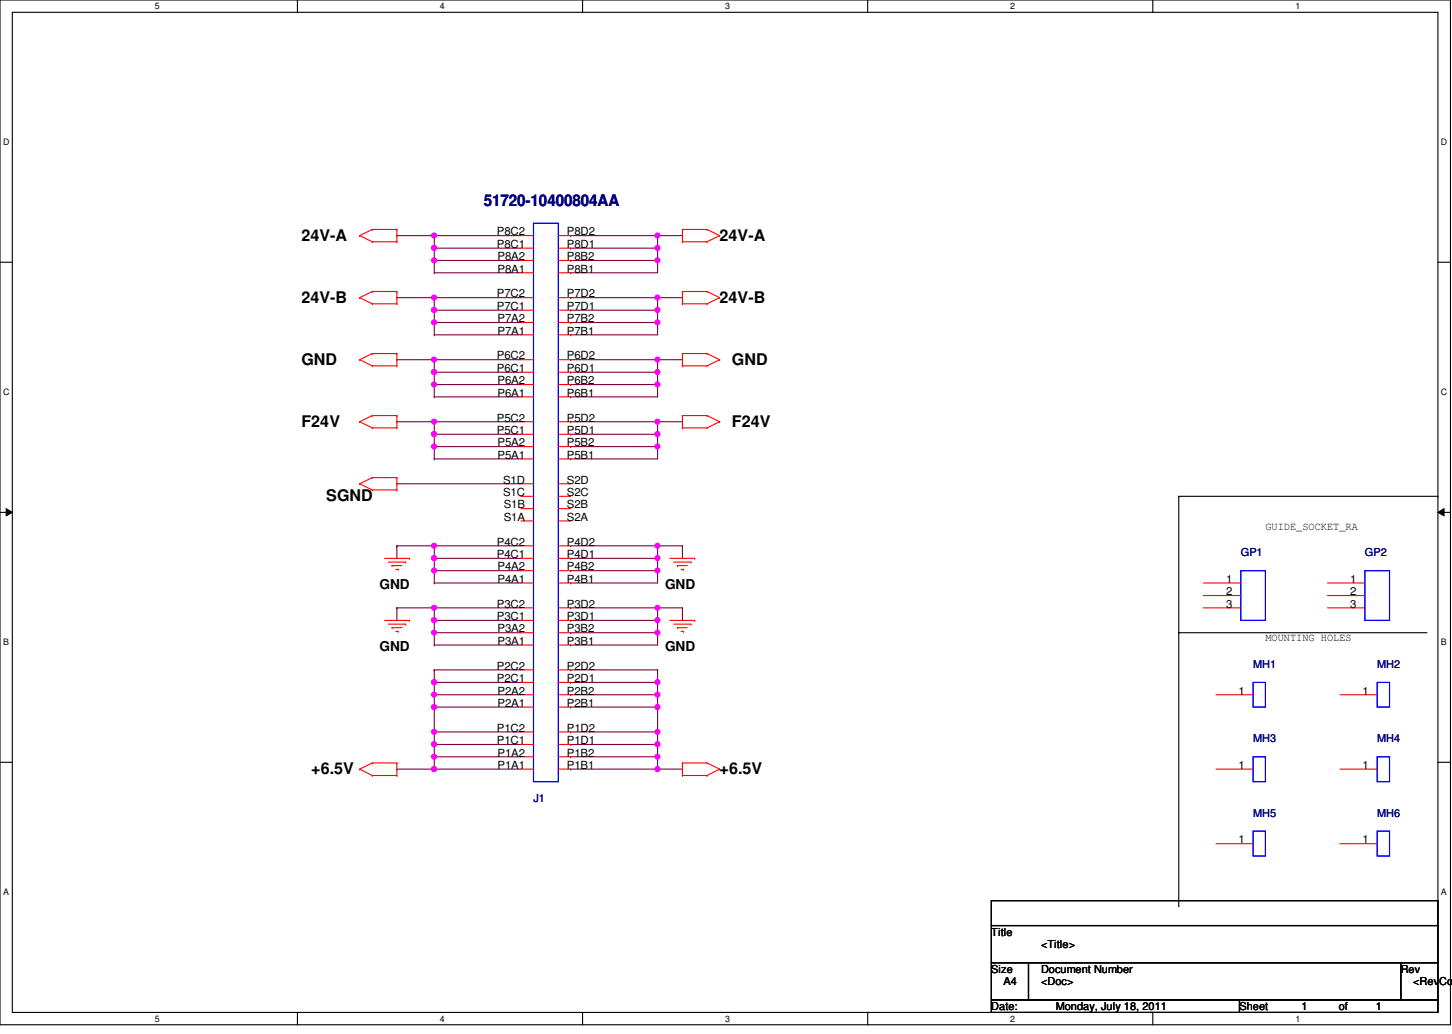
[picture p194: page 2]
GND; SGND; Title; Size; Document Number; Rev; Date:; Sheet; <Doc>; <RevCod; <Title>; Monday, July 18, 2011; GUIDE_SOCKET_RA; MOUNTING HOLES

## LINE_OV

## LINE_IN

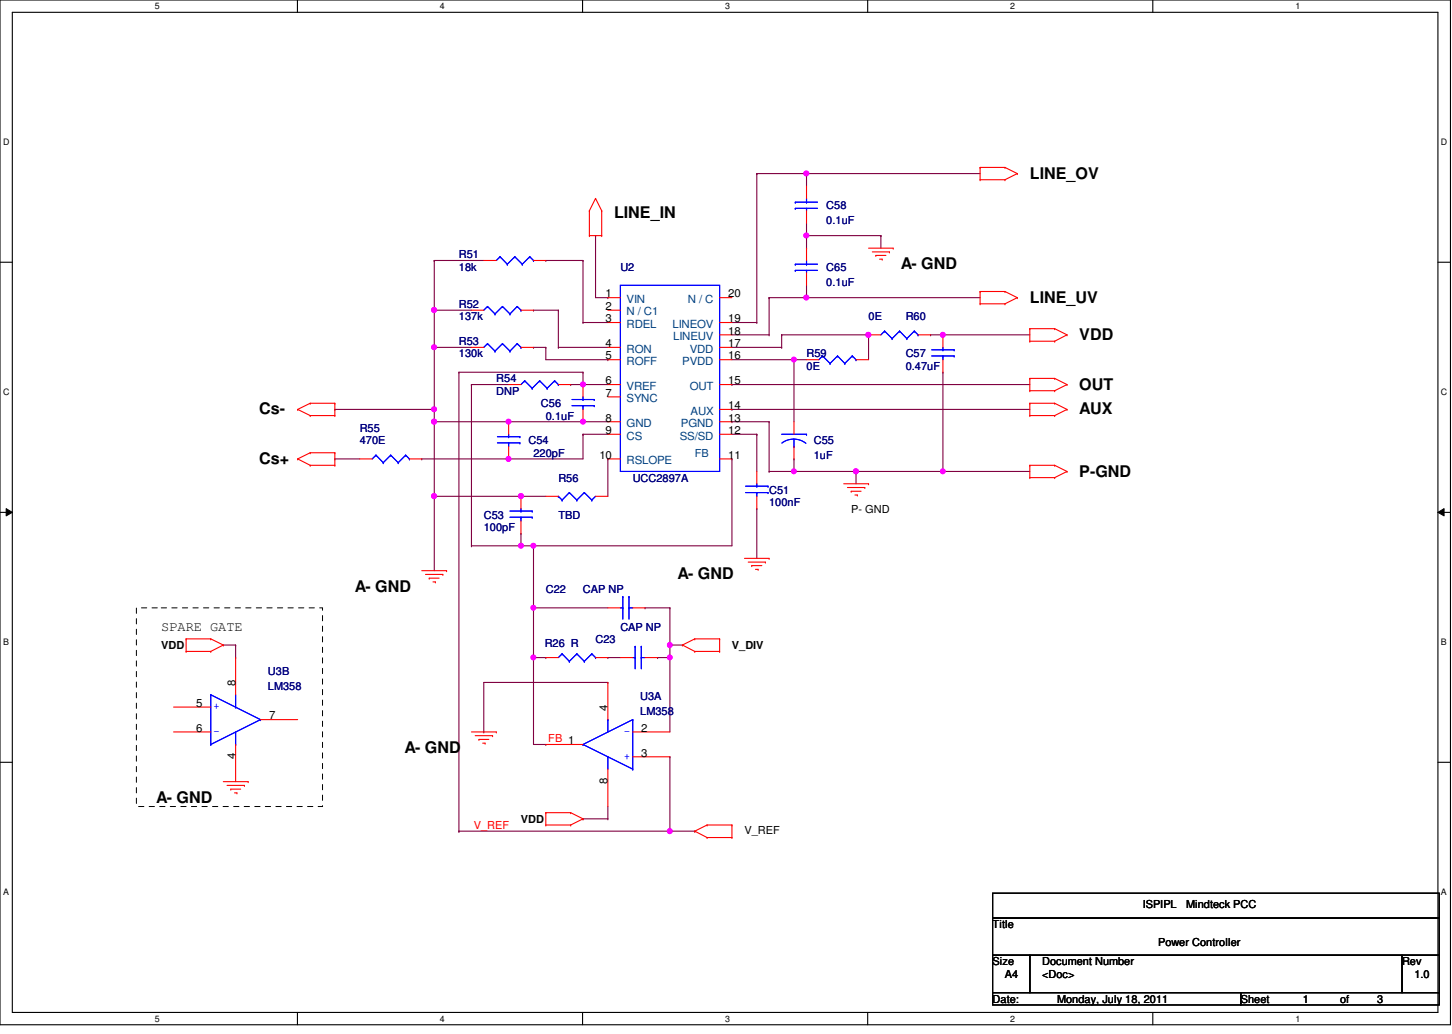
[picture p195: page 3]

## Line_In

24V-A

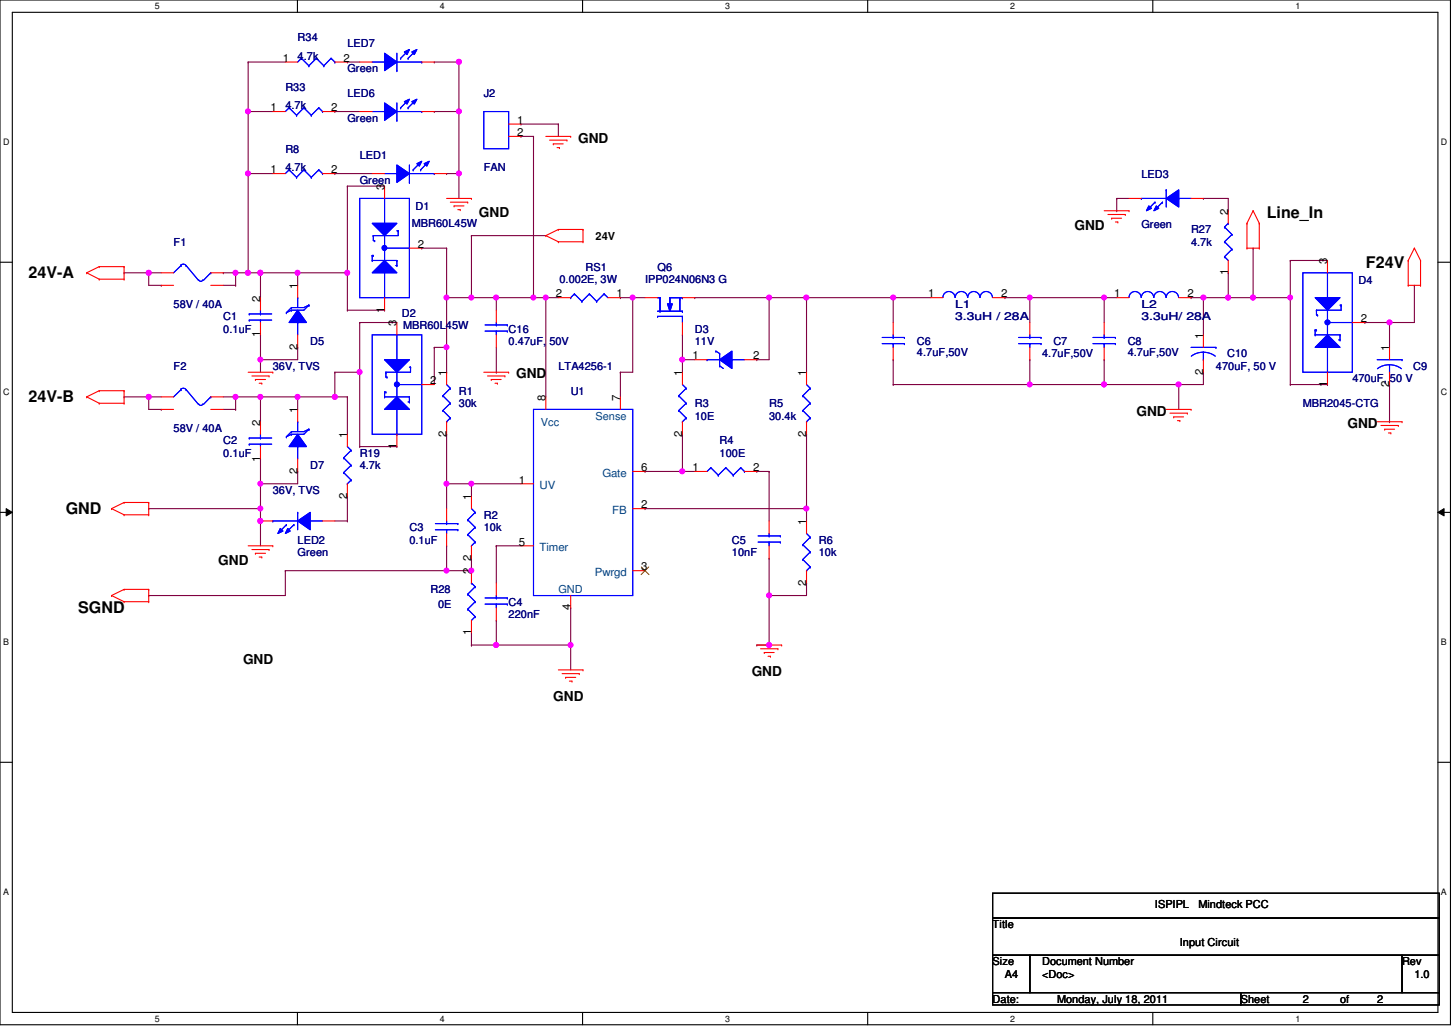
[picture p196: page 4]
