Sayidathahaseen/CCC_NGP_ODC/NGP_ODC_Main/PDLC/IES-S4M/Client Input/24V5Vsch.pdf

D

1 | 2 | 3 | 4 | 5 | 6

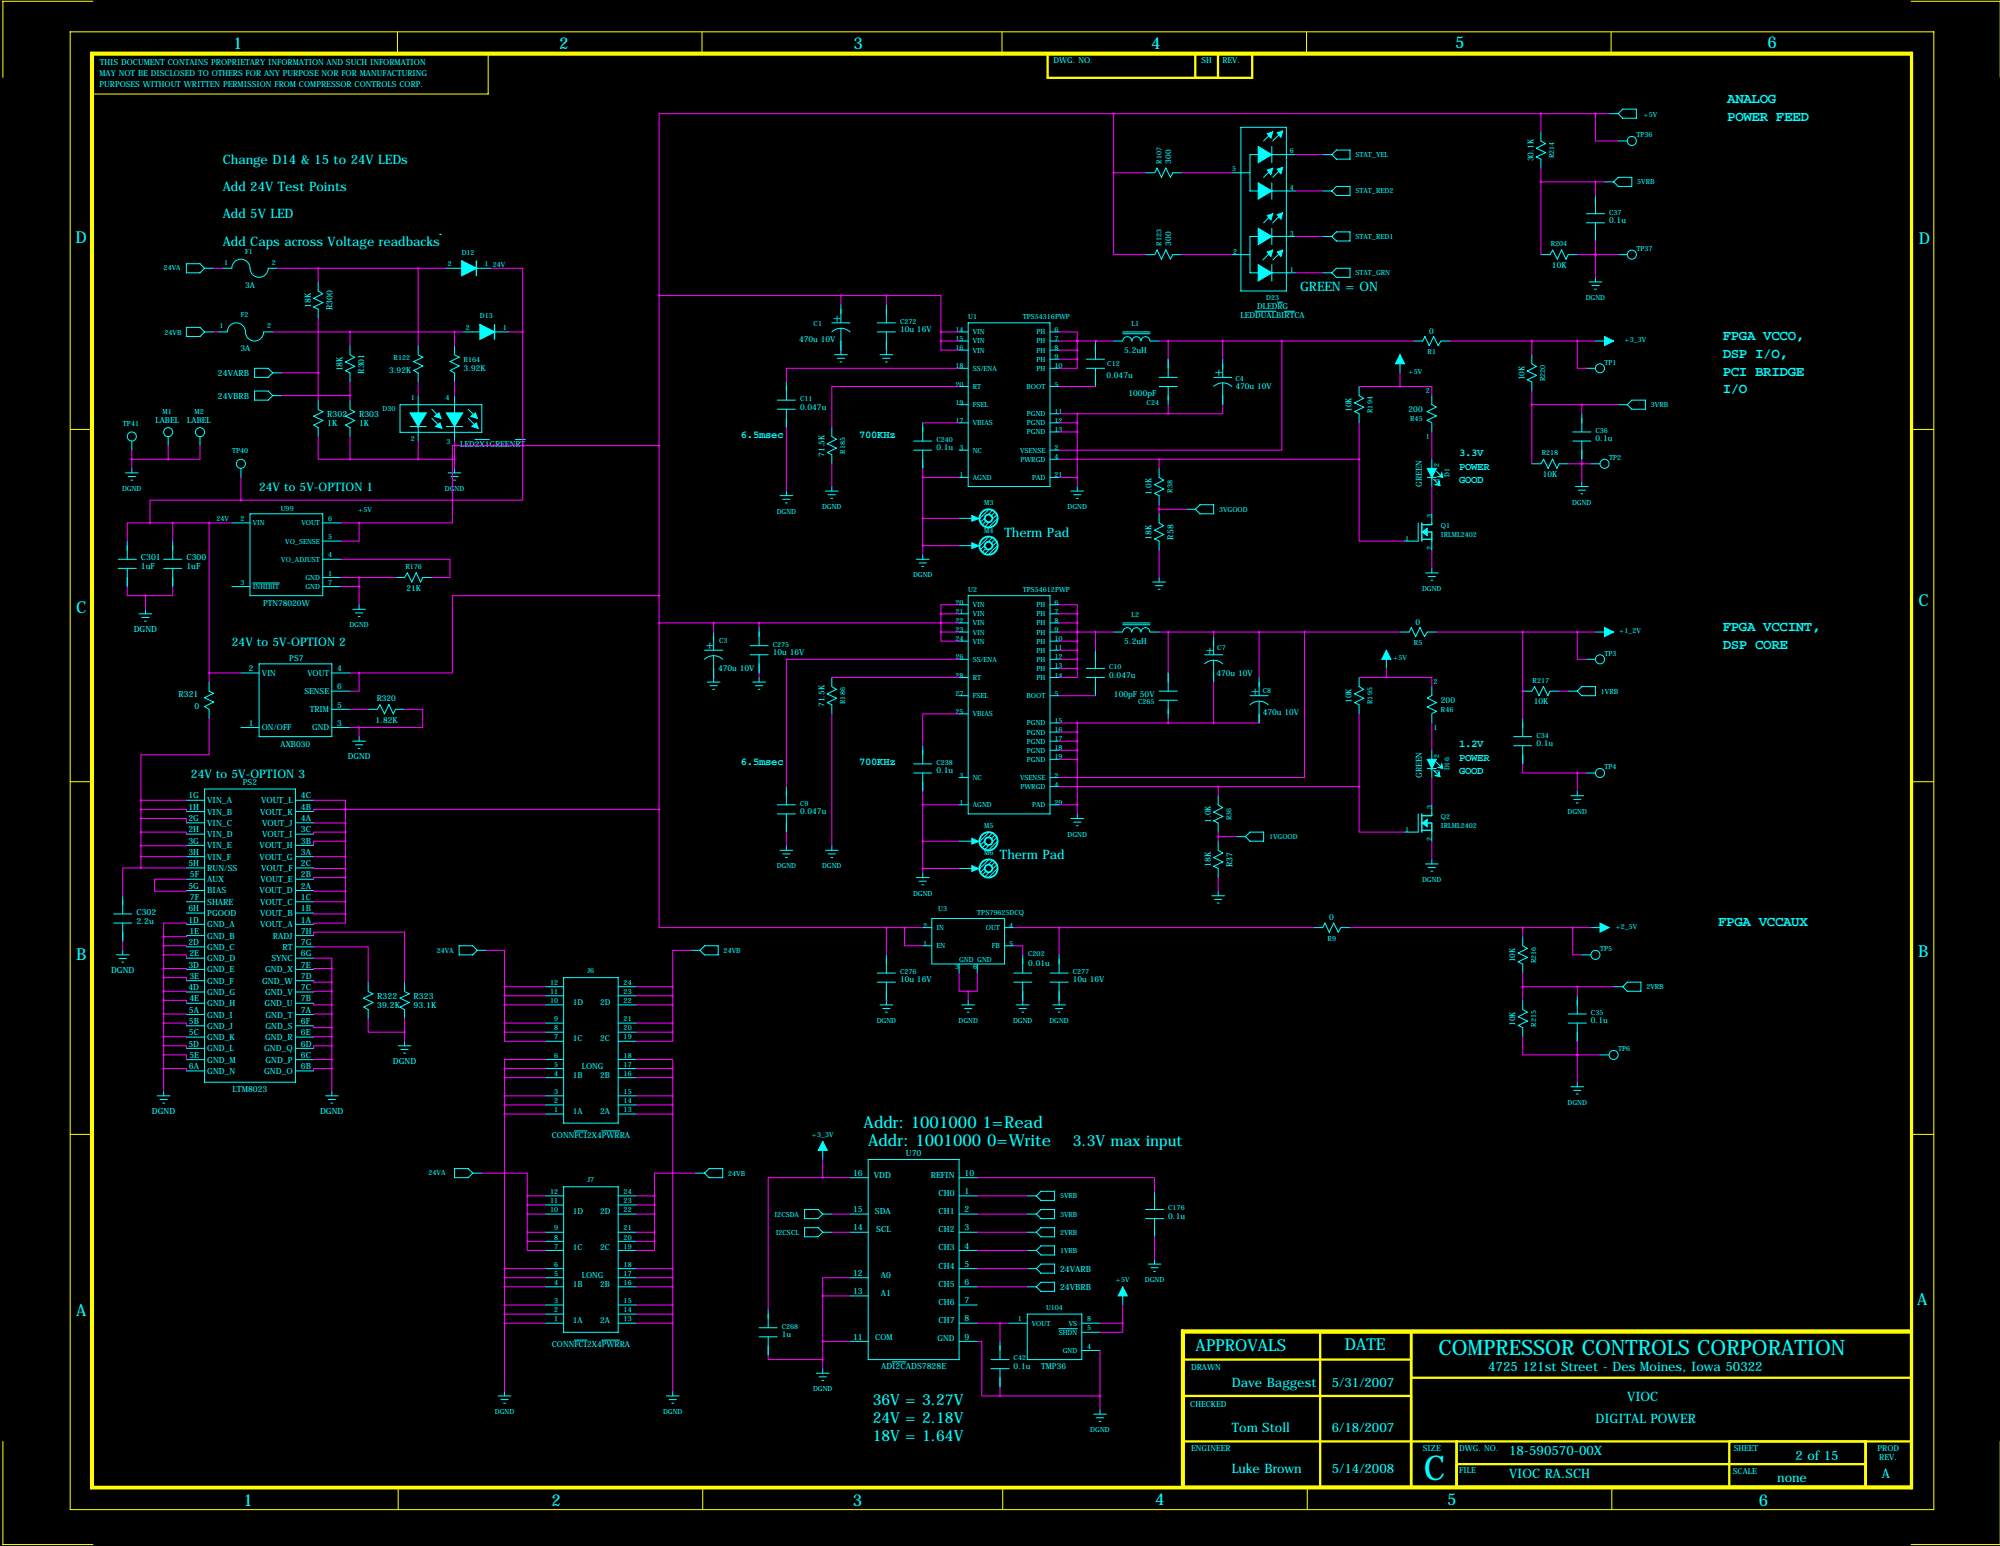
[picture p197: page 1]

THIS DOCUMENT CONTAINS PROPRIETARY INFORMATION AND SUCH INFORMATION MAY NOT BE DISCLOSED TO OTHERS FOR ANY PURPOSE NOR FOR MANUFACTURING PURPOSES WITHOUT WRITTEN PERMISSION FROM COMPRESSOR CONTROLS CORP. | | DWG. NO. | SH | REV. | DGND

Add Caps across Voltage readbacks

4725 121st Street - Des Moines, Iowa 50322

CHECKED Tom Stoll | 6/18/2007

ENGINEER | 5/14/2008 | SIZE C | DWG. NO. 18-590570-00X VIOC RA.SCH Luke Brown | SHEET | PROD REV. A

FILE | SCALE none

D

1 | 2 | 3 | 4 | 5 | 6

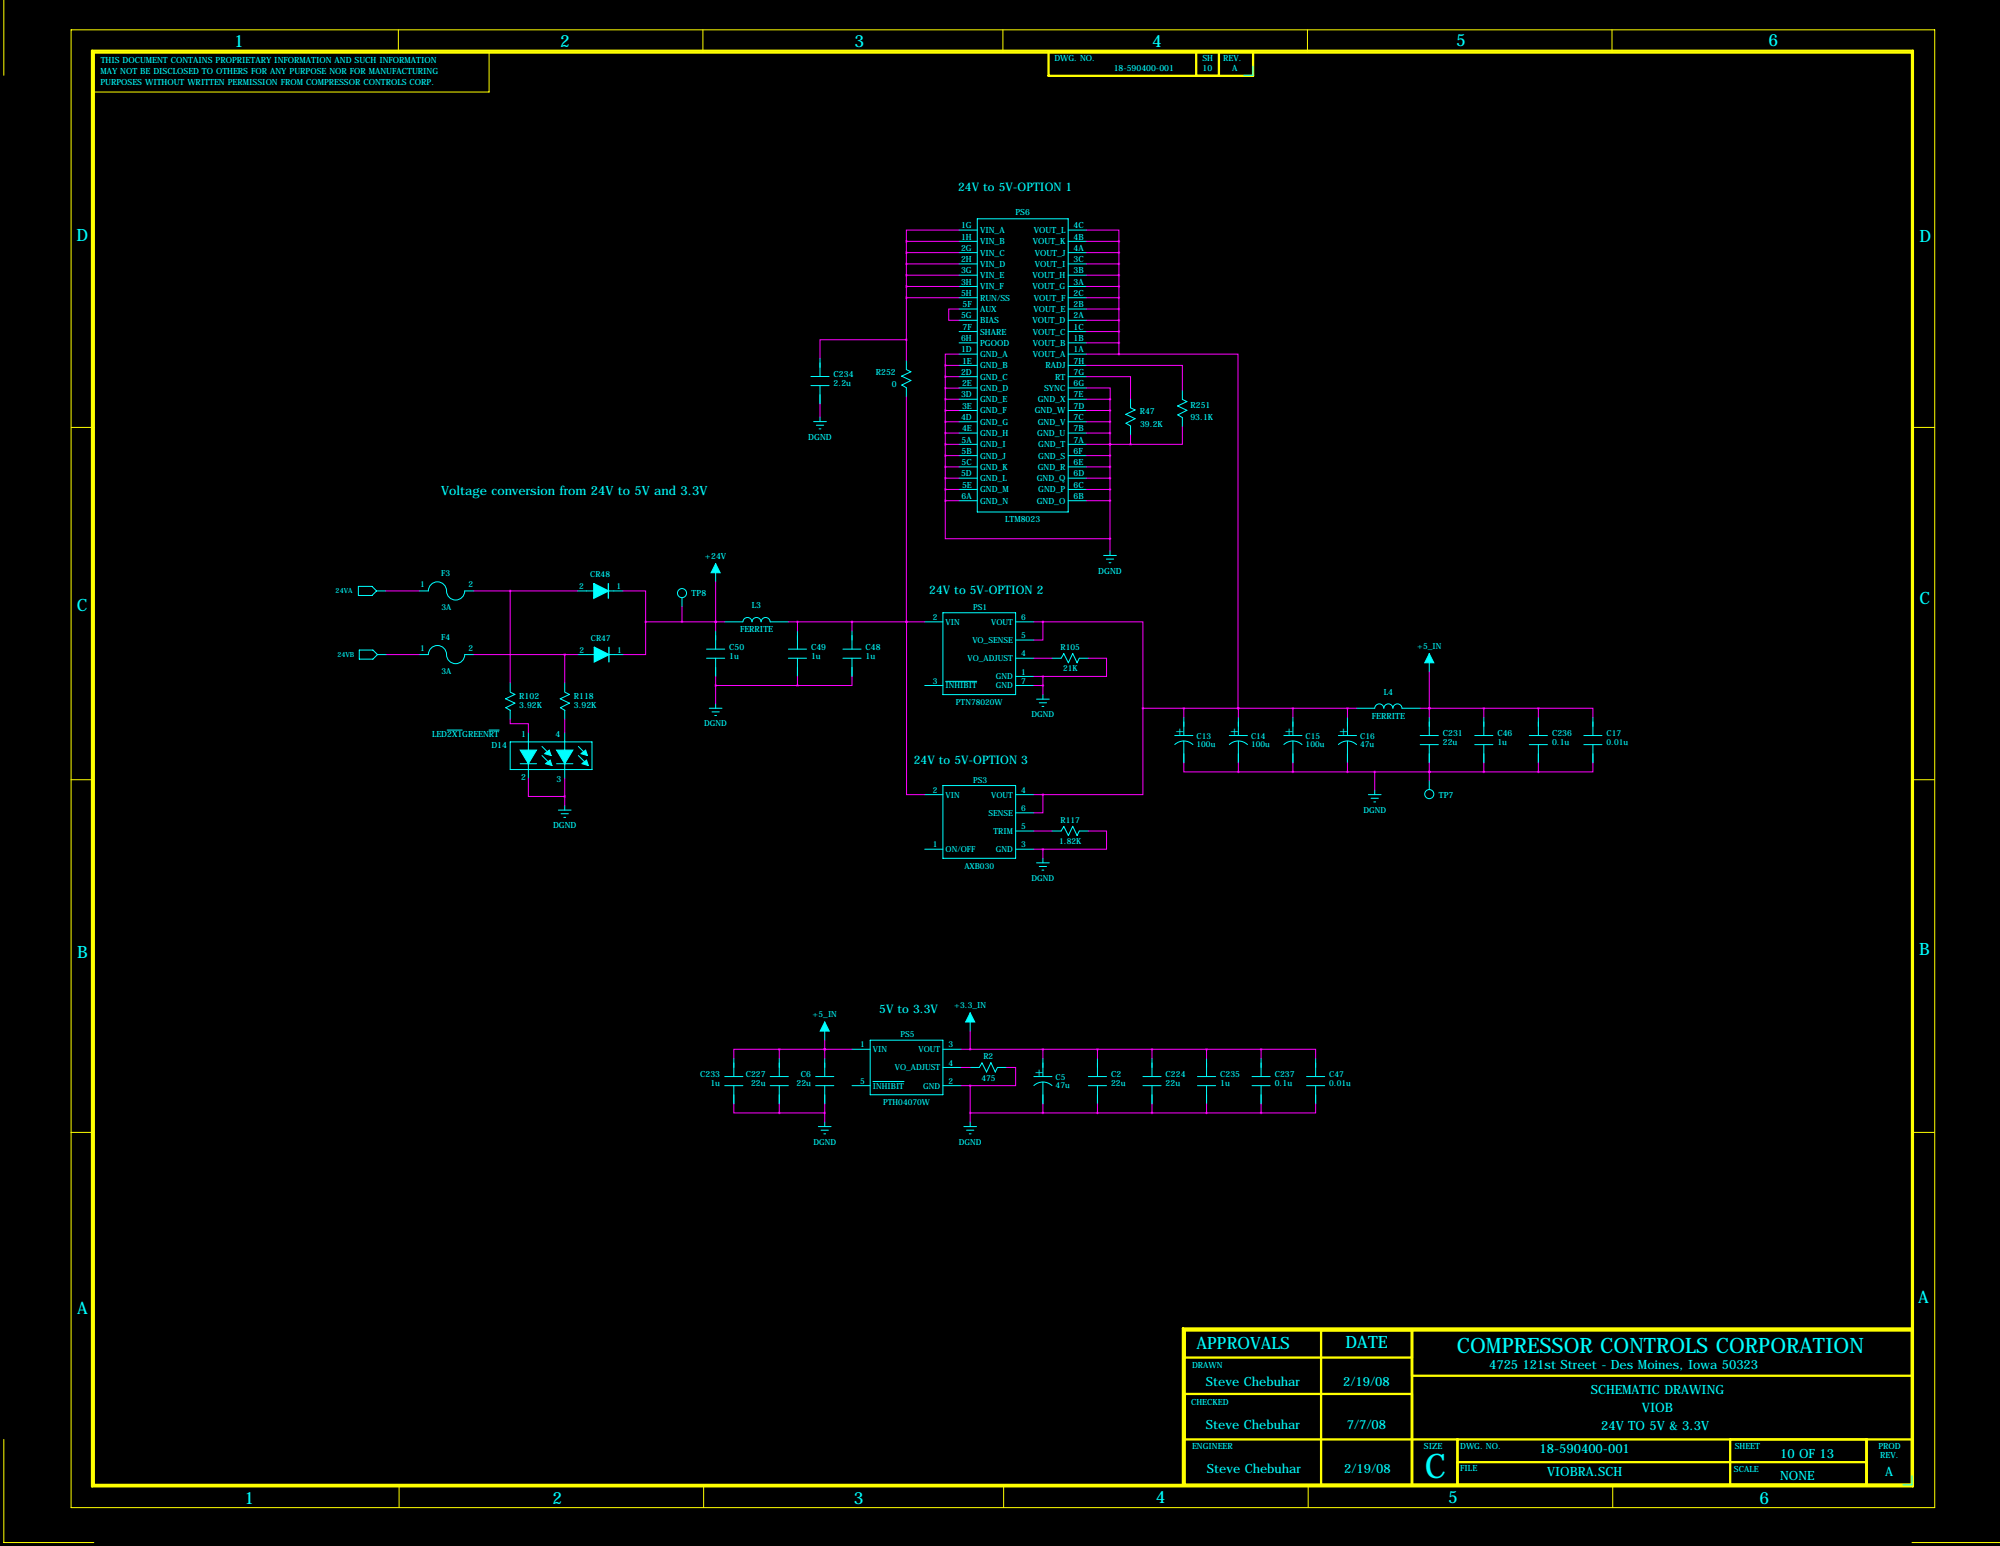
[picture p198: page 2]

THIS DOCUMENT CONTAINS PROPRIETARY INFORMATION AND SUCH INFORMATION MAY NOT BE DISCLOSED TO OTHERS FOR ANY PURPOSE NOR FOR MANUFACTURING PURPOSES WITHOUT WRITTEN PERMISSION FROM COMPRESSOR CONTROLS CORP. | 24V to 5V-OPTION 1 PS6 | DWG. NO. 18-590400-001 | SH 10 | REV. A

Voltage conversion from 24V to 5V and 3.3V

APPROVALS | DATE | COMPRESSOR CONTROLS CORPORATION 4725 121st Street - Des Moines, Iowa 50323

DRAWN Steve Chebuhar | 2/19/08

CHECKED Steve Chebuhar | 7/7/08

ENGINEER Steve Chebuhar | 2/19/08 | SIZE C | DWG. NO. 18-590400-001 | SHEET | PROD REV. A

FILE VIOBRA.SCH | SCALE NONE
