Sayidathahaseen/CCC_NGP_ODC/NGP_ODC_Main/PDLC/Mechanical/NGP_CCC Final files on dt-lohiths/ngp_Final profiles_14Jun11.pdf

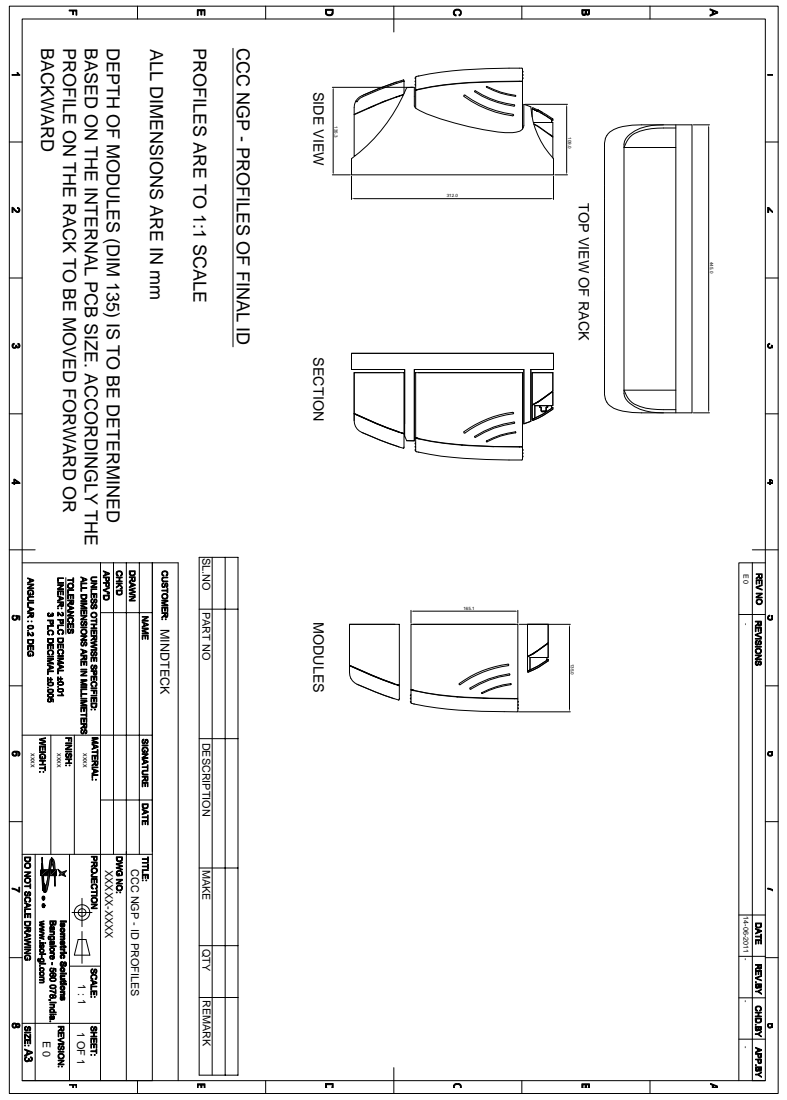
[picture p200: page 1]
MODULES; BACKWARD; XXXXX-XXXX; xxxx 1 : 1 1 OF 1; xxxx; MINDTECK

PROFILE ON THE RACK TO BE MOVED FORWARD OR

BASED ON THE INTERNAL PCB SIZE. ACCORDINGLY THE

DEPTH OF MODULES (DIM 135) IS TO BE DETERMINED

ALL DIMENSIONS ARE IN mm

PROFILES ARE TO 1:1 SCALE

CCC NGP - PROFILES OF FINAL ID

SECTION SIDE VIEW

TOP VIEW OF RACK

QTY REMARK MAKE DESCRIPTION SL.NO PART NO

CCC NGP - ID PROFILES
