Sayidathahaseen/CCC_NGP_ODC/NGP_ODC_Main/PDLC/IES-S4M/Client Input/MPM rev h schematic.pdf

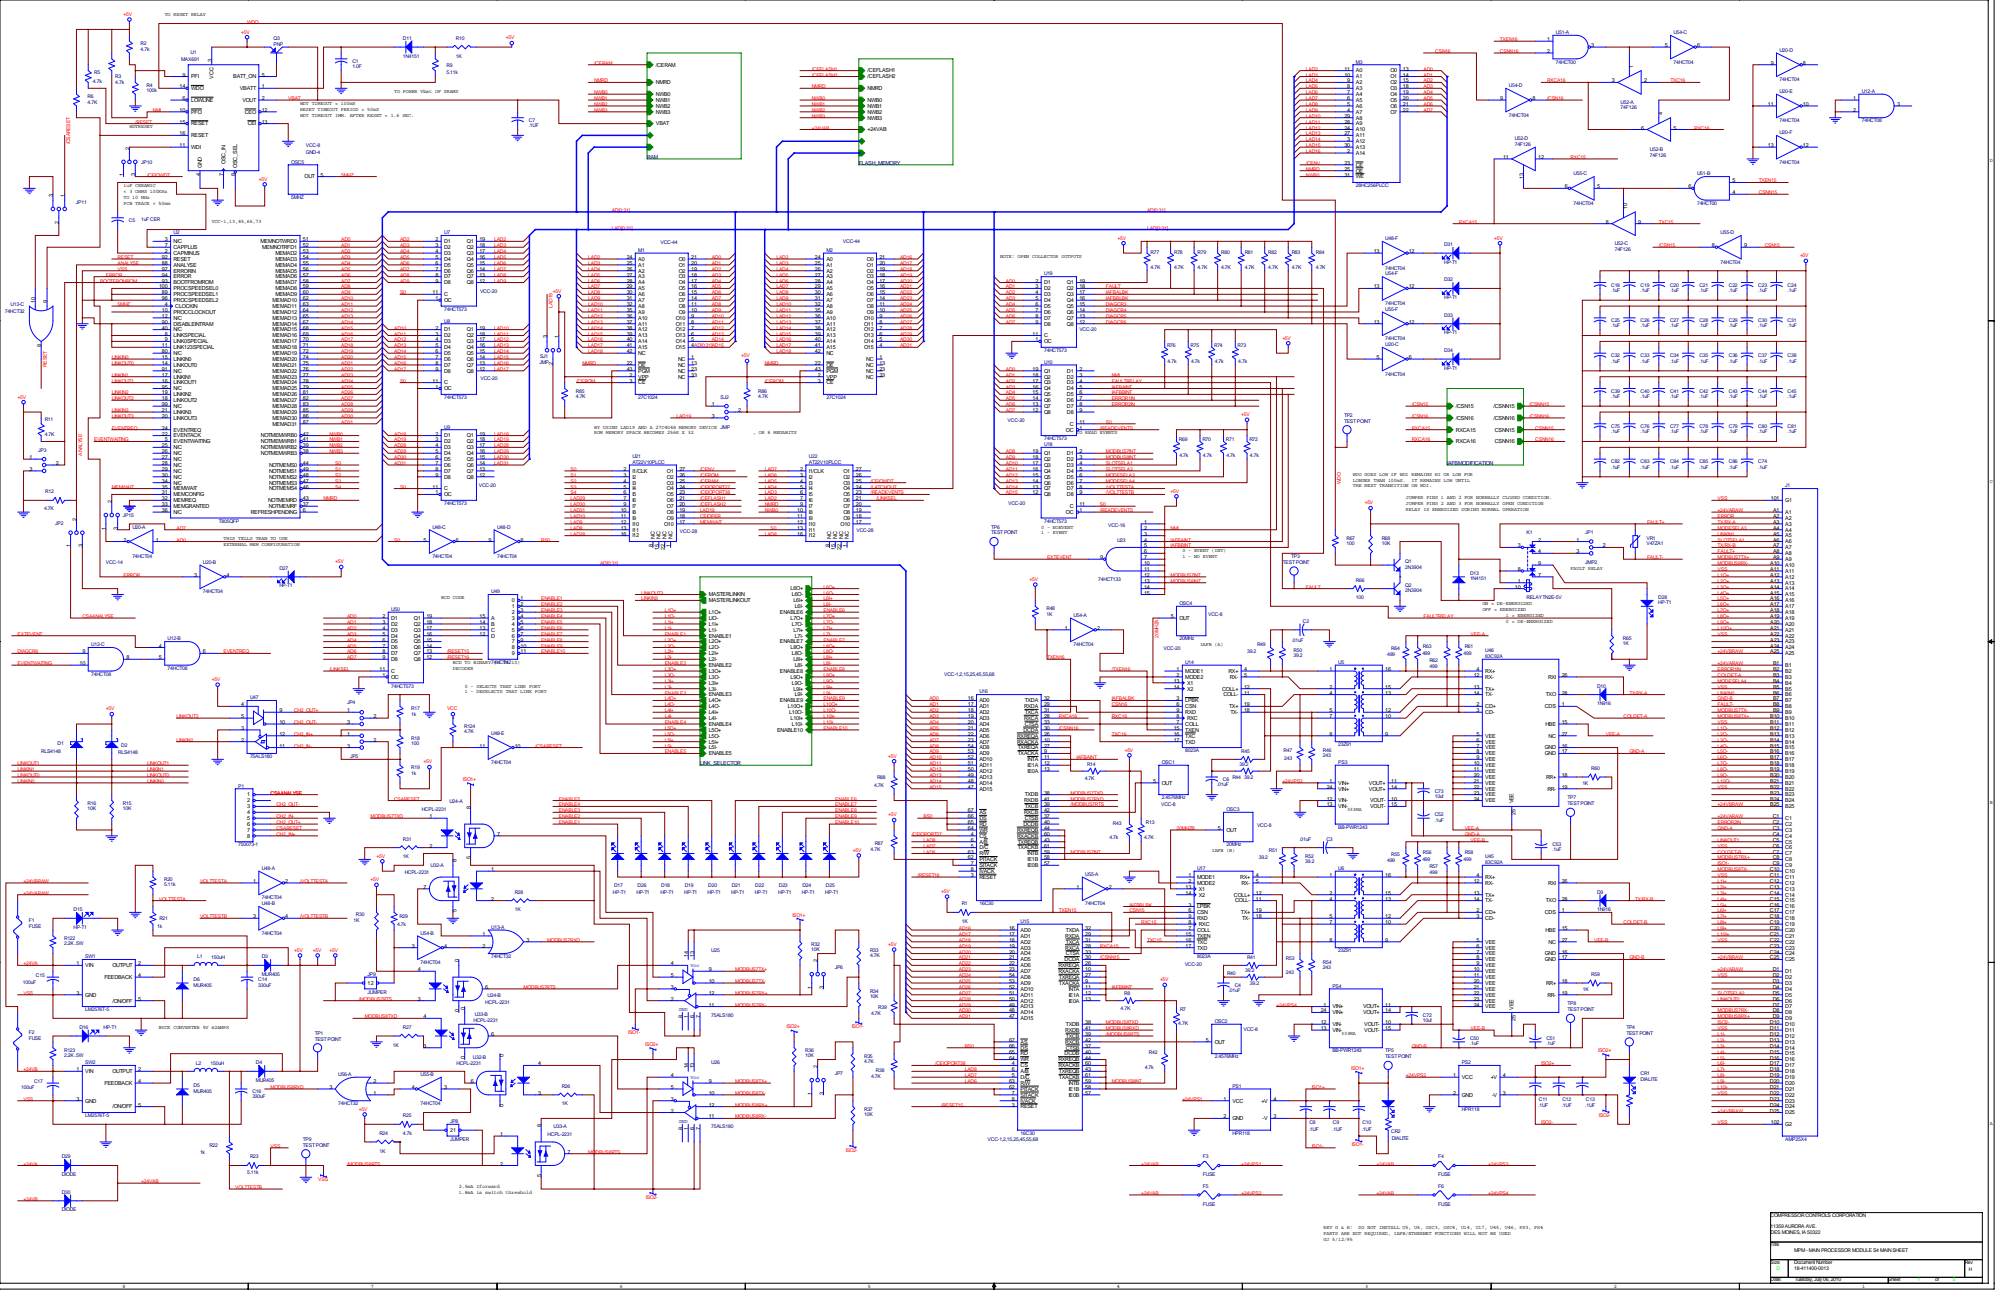
[picture p201: page 1]

TO POWER Vbat OF SRAMS

WDT TIMEOUT IMM. AFTER RESET = 1.6 SEC.

NOTE: OPEN COLLECTOR OUTPUTS

BY USING LAD19 AND A 27C4048 MEMORY DEVICE

WDO GOES LOW IF WDI REMAINS HI OR LOW FOR

THE NEXT TRANSITION ON WDI.

JUMPER PINS 1 AND 2 FOR NORMALLY CLOSED CONDITION.

JUMPER PINS 2 AND 3 FOR NORMALLY OPEN CONDITION

RELAY IS ENERGIZED DURING NORMAL OPERATION

THIS TELLS TRAN TO USE

0 - SELECTS THAT LINK PORT

1 - DESELECTS THAT LINK PORT

PARTS ARE NOT REQUIRED, IAFB/ETHERNET FUNCTIONS WILL NOT BE USED

MPM - MAIN PROCESSOR MODULE S4 MAIN SHEET

Size D | Document Number 18-411400-0013 | Rev H

Date: Tuesday, July 06, 2010 | Sheet 1 of 5

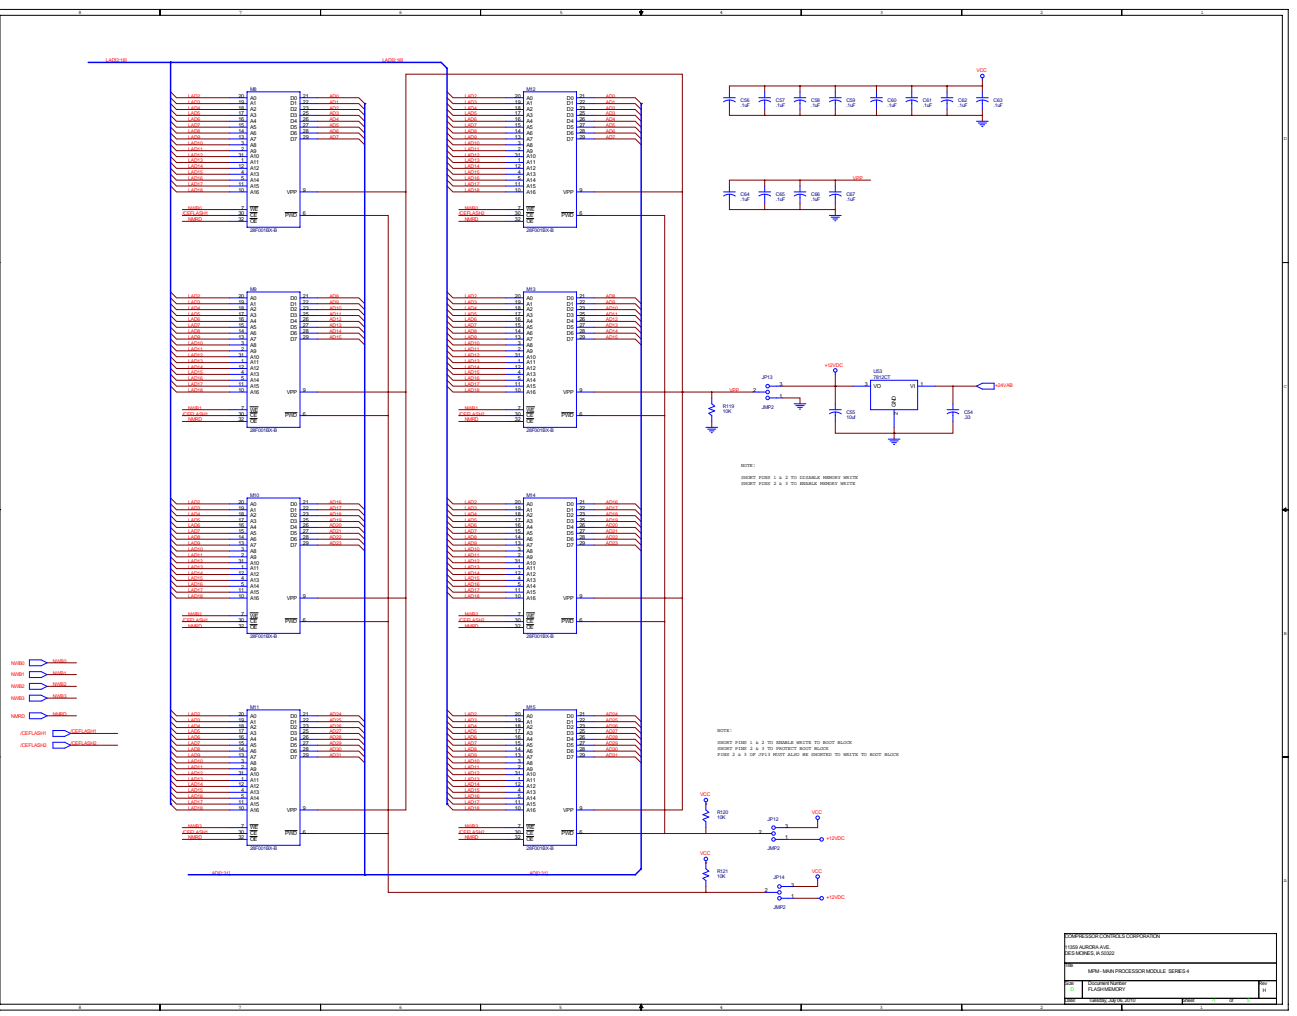
[picture p202: page 2]

SHORT PINS 1 & 2 TO DISABLE MEMORY WRITE

SHORT PINS 2 & 3 TO ENABLE MEMORY WRITE

SHORT PINS 1 & 2 TO ENABLE WRITE TO BOOT BLOCK

SHORT PINS 2 & 3 TO PROTECT BOOT BLOCK

PINS 2 & 3 OF JP13 MUST ALSO BE SHORTED TO WRITE TO BOOT BLOCK

MPM - MAIN PROCESSOR MODULE SERIES 4

FLASH MEMORY | H

Date: Tuesday, July 06, 2010 | Sheet -1 of

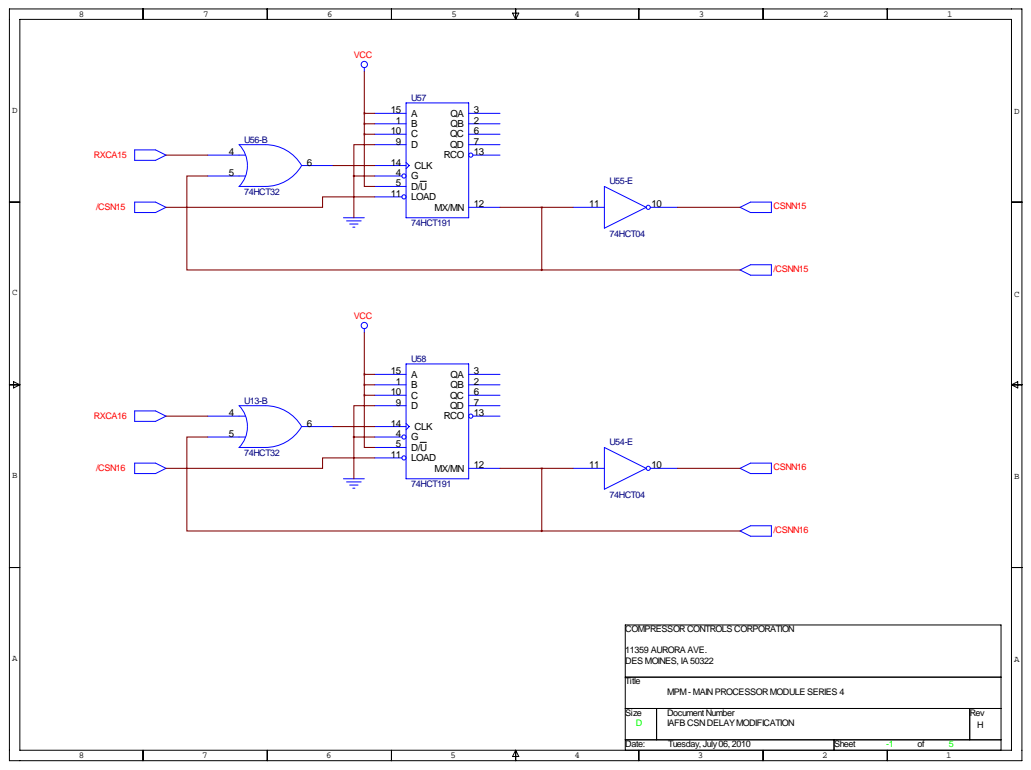
[picture p203: page 3]
ABCD; DCBA; CLK 4; LOAD; 7 13 RCO; 74HCT191; 74HCT32; 74HCT04; /CSN15; RXCA15; /CSN16; RXCA16; /CSNN15; CSNN15; /CSNN16; CSNN16; VCC

COMPRESSOR CONTROLS CORPORATION

IAFB CSN DELAY MODIFICATION

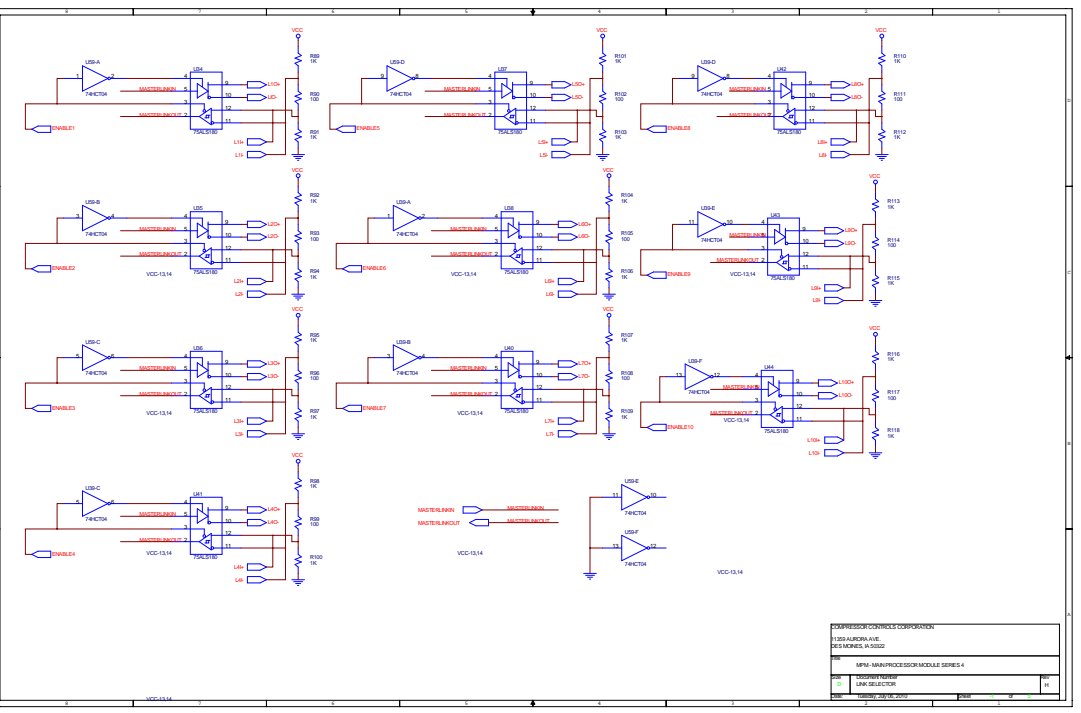
[picture p204: page 4]

LINK SELECTOR | H

Date: | Sheet -1 of 5

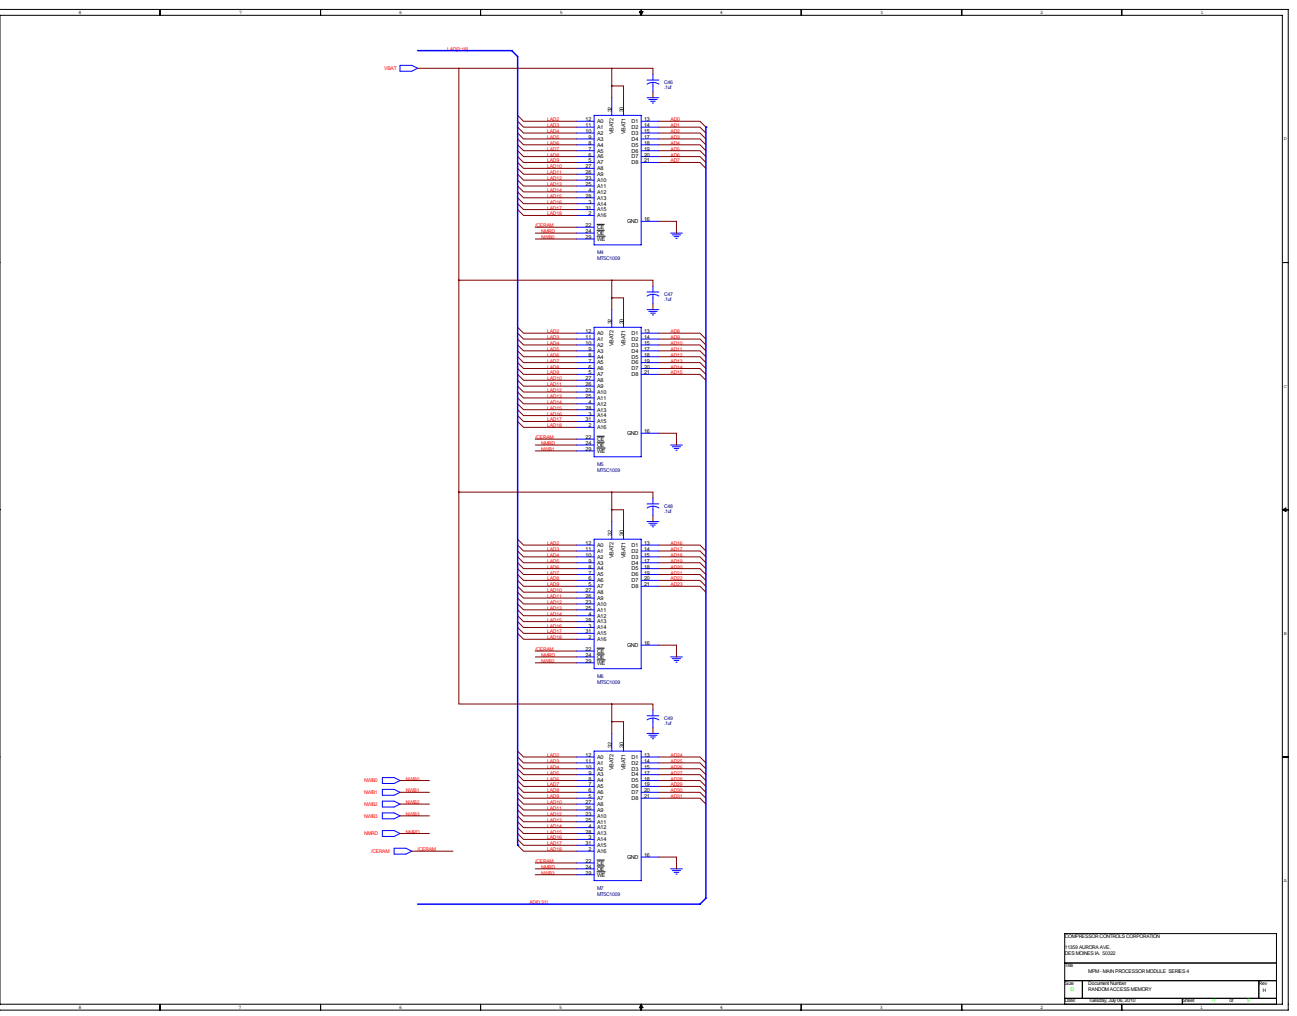
[picture p205: page 5]
