Sayidathahaseen/CCC_NGP_ODC/NGP_ODC_Main/PDLC/IES-S4M/Client Input/S4_simplex_chassis.pdf

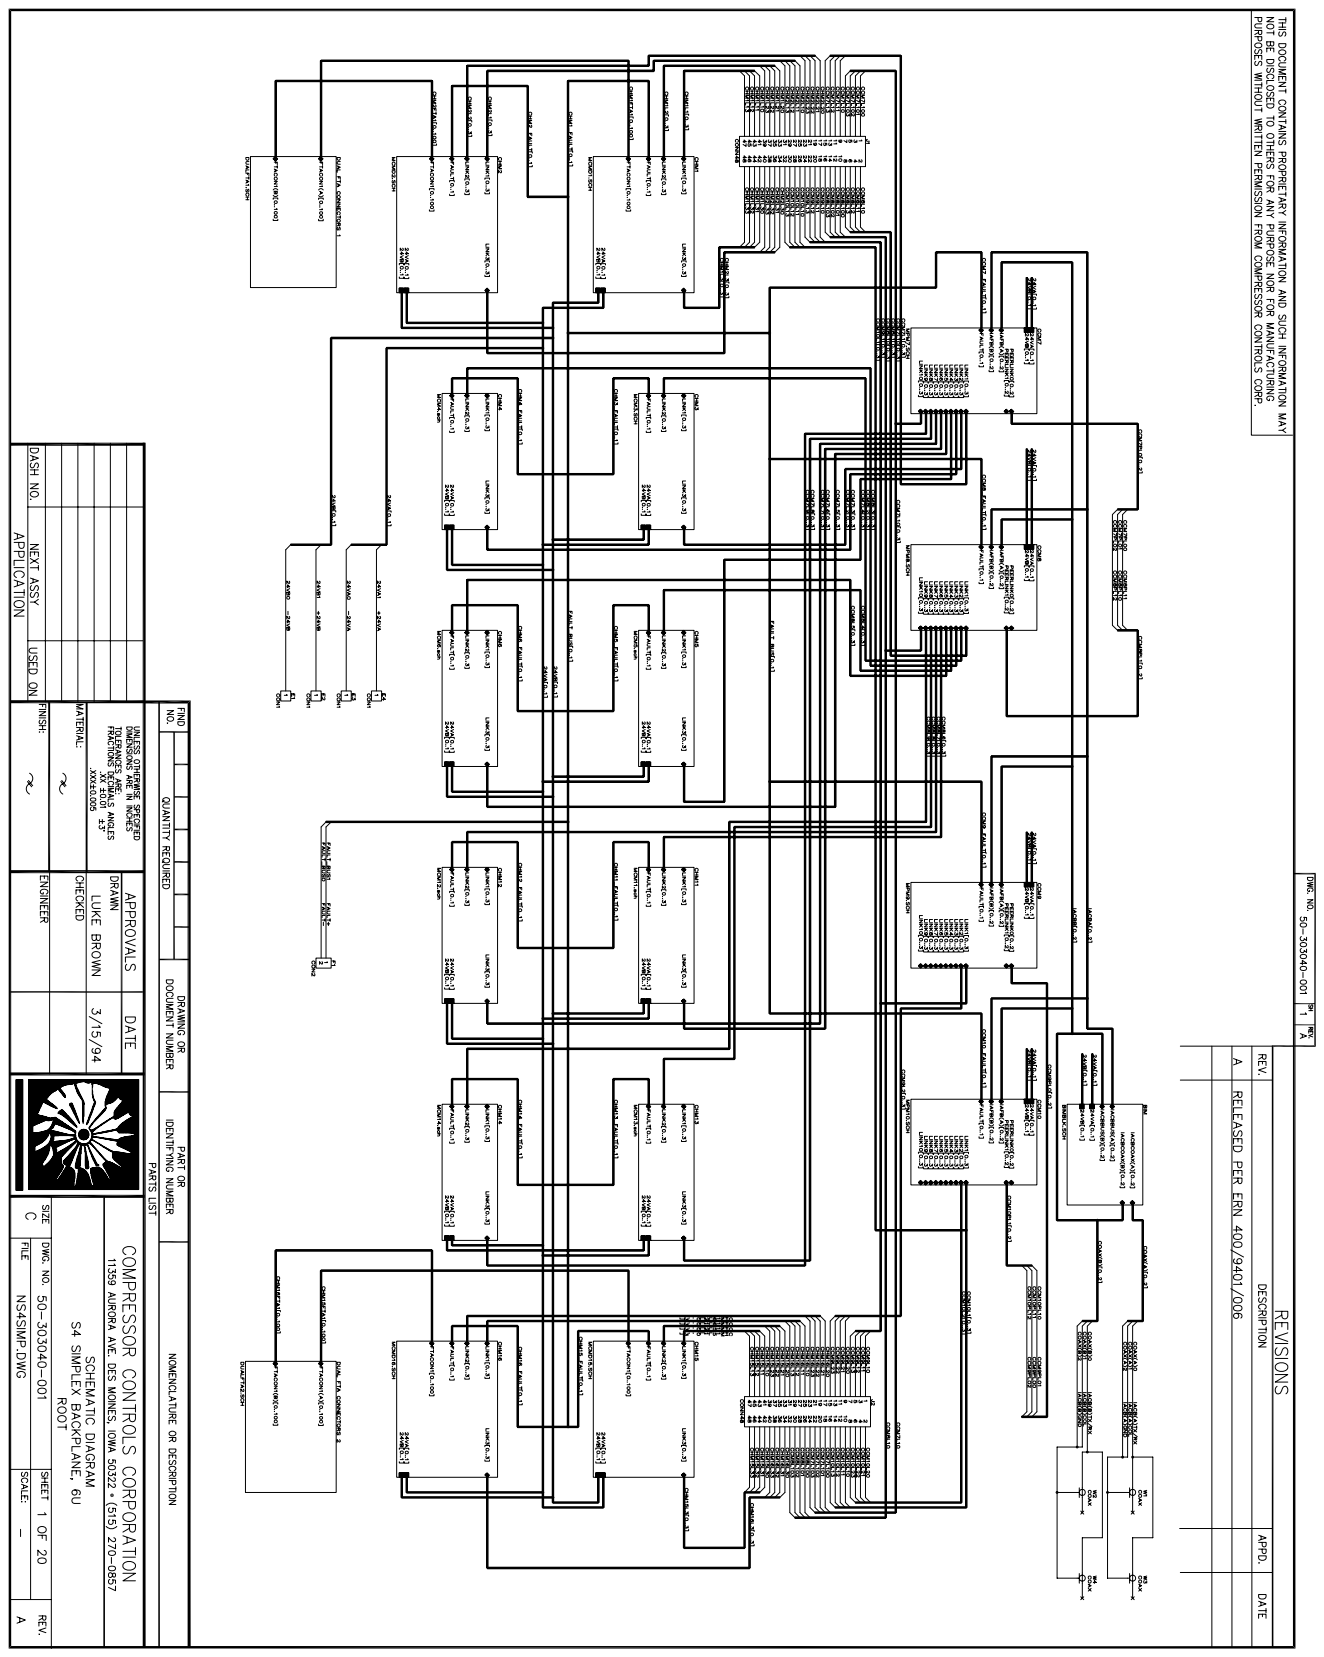
[picture p206: page 1]

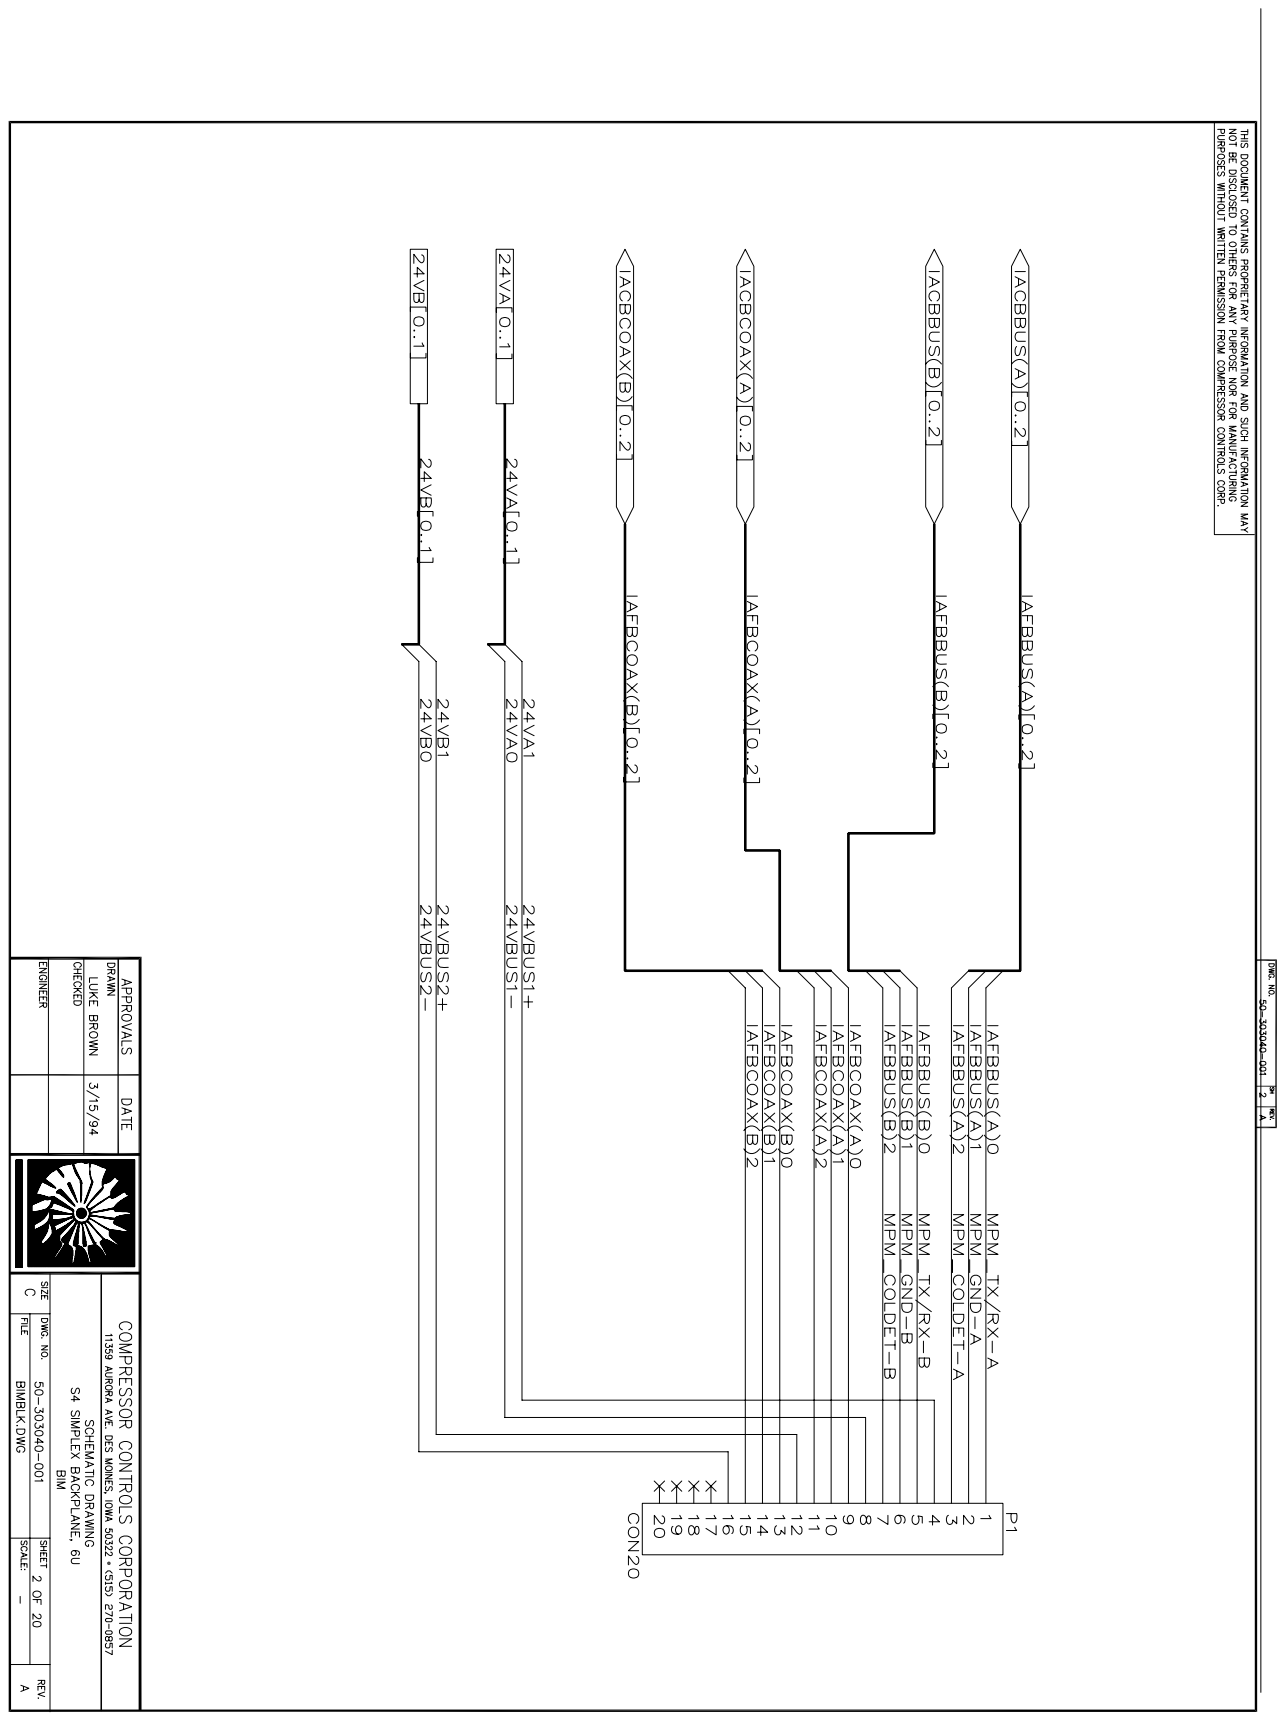
[picture p207: page 2]

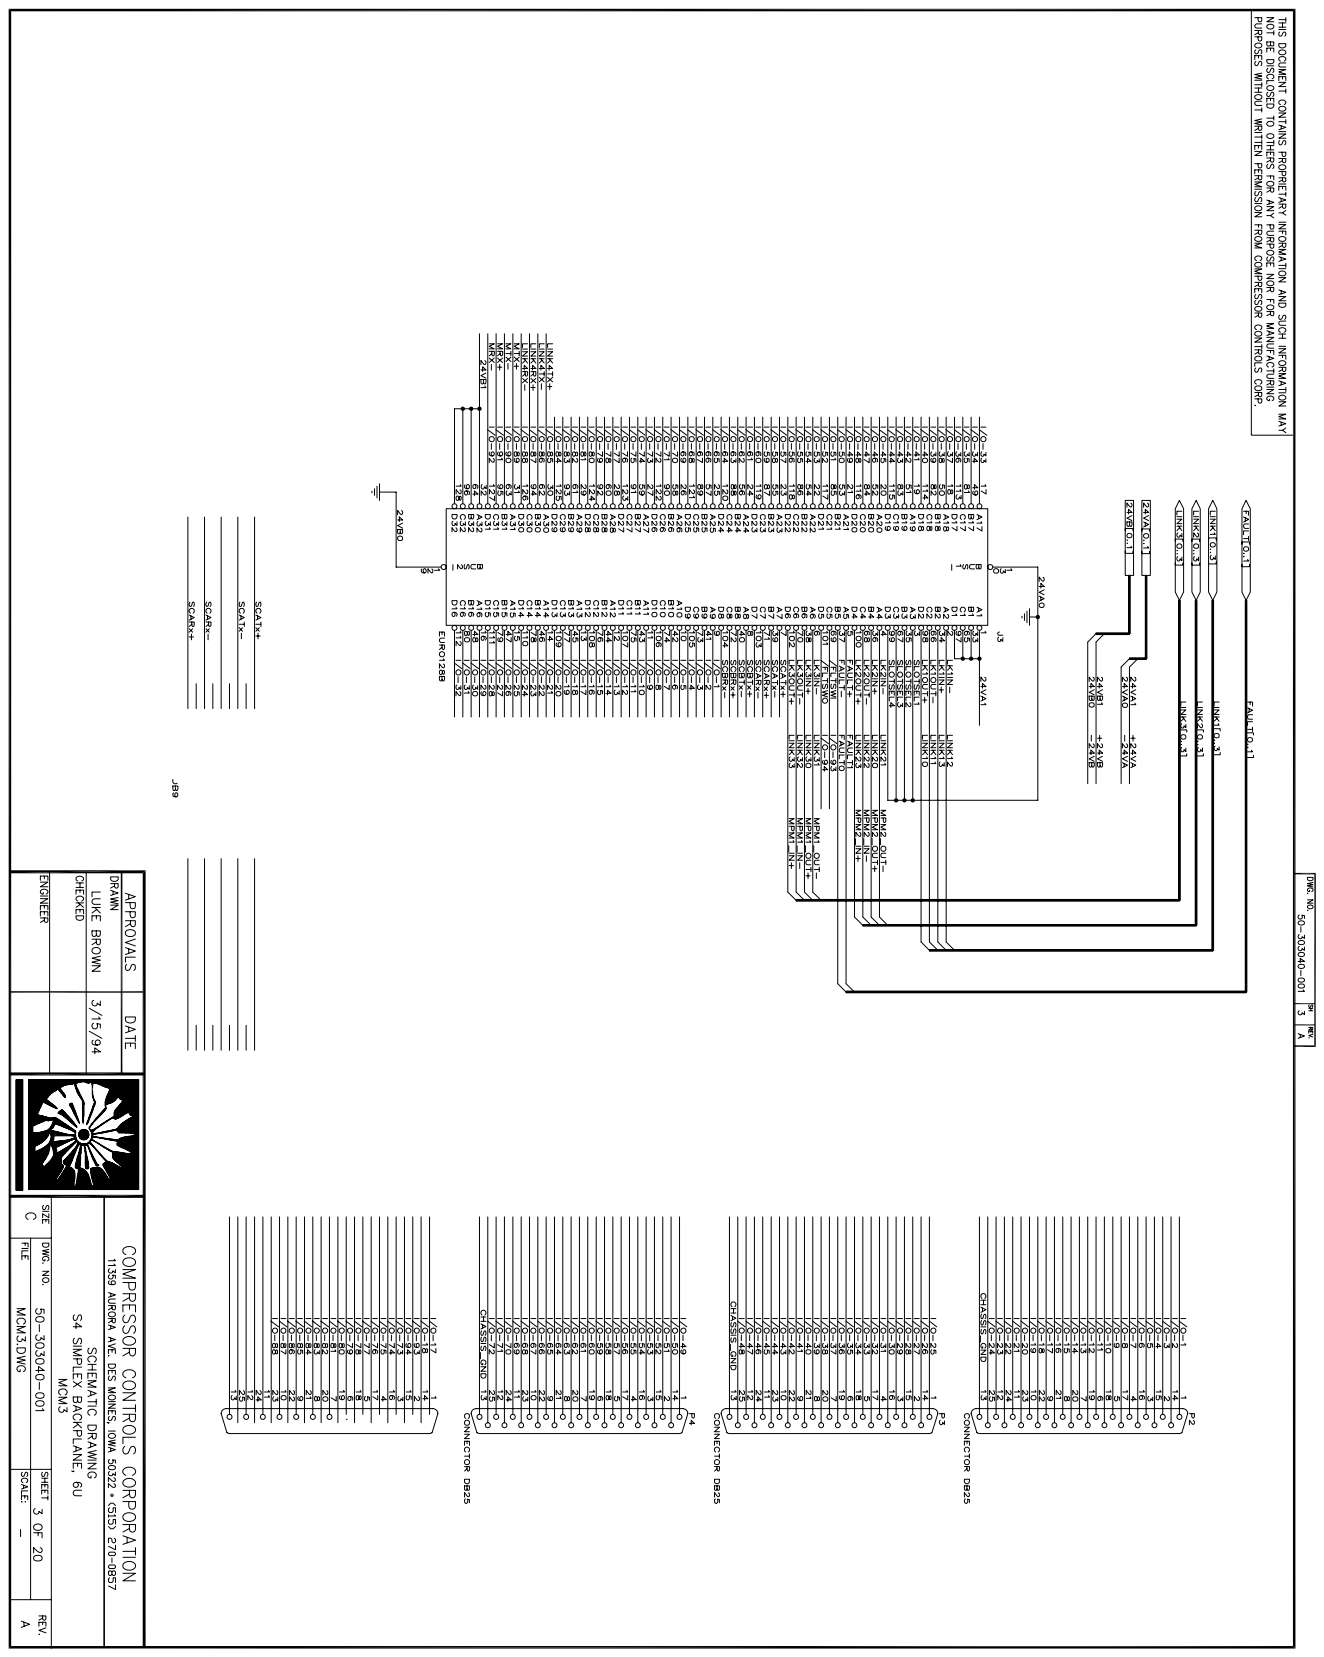
[picture p208: page 3]

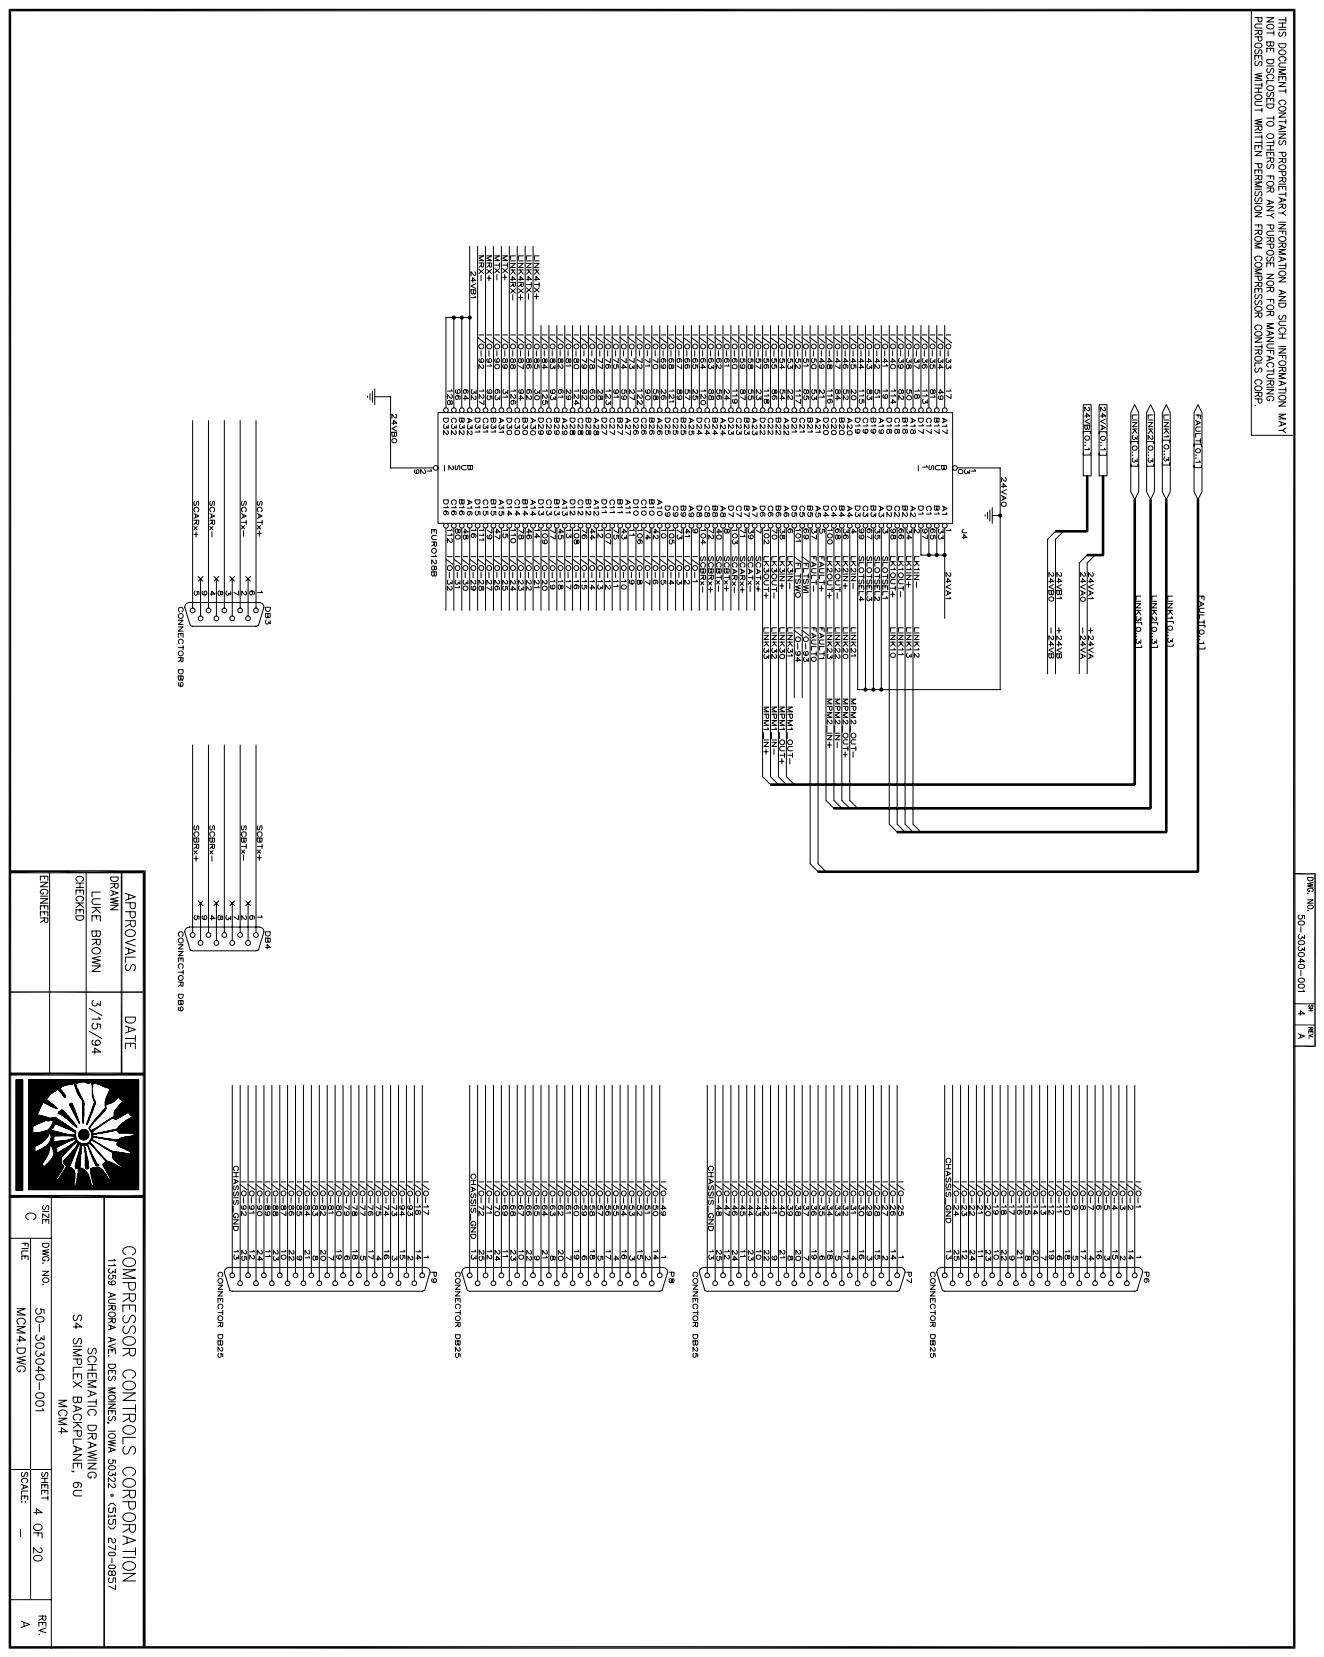
[picture p209: page 4]

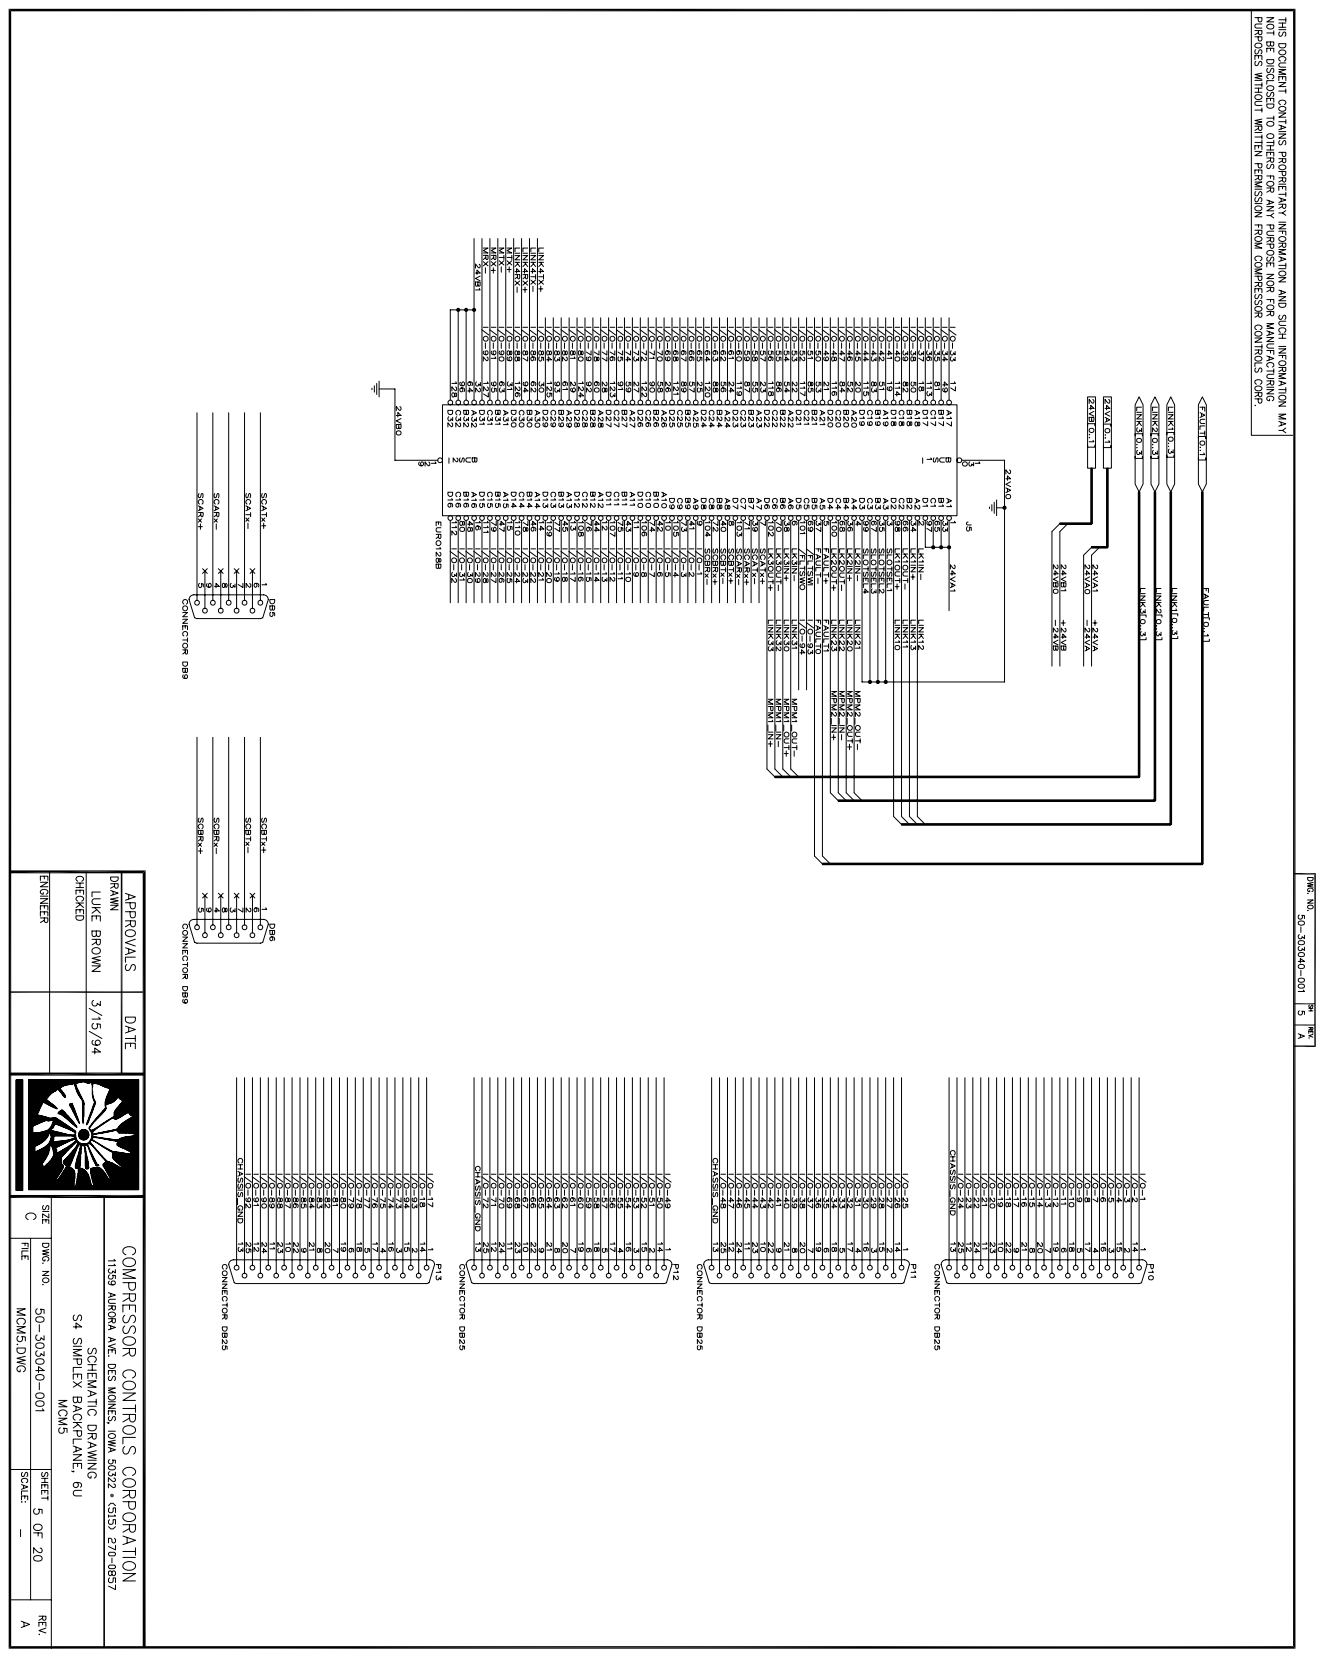
[picture p210: page 5]

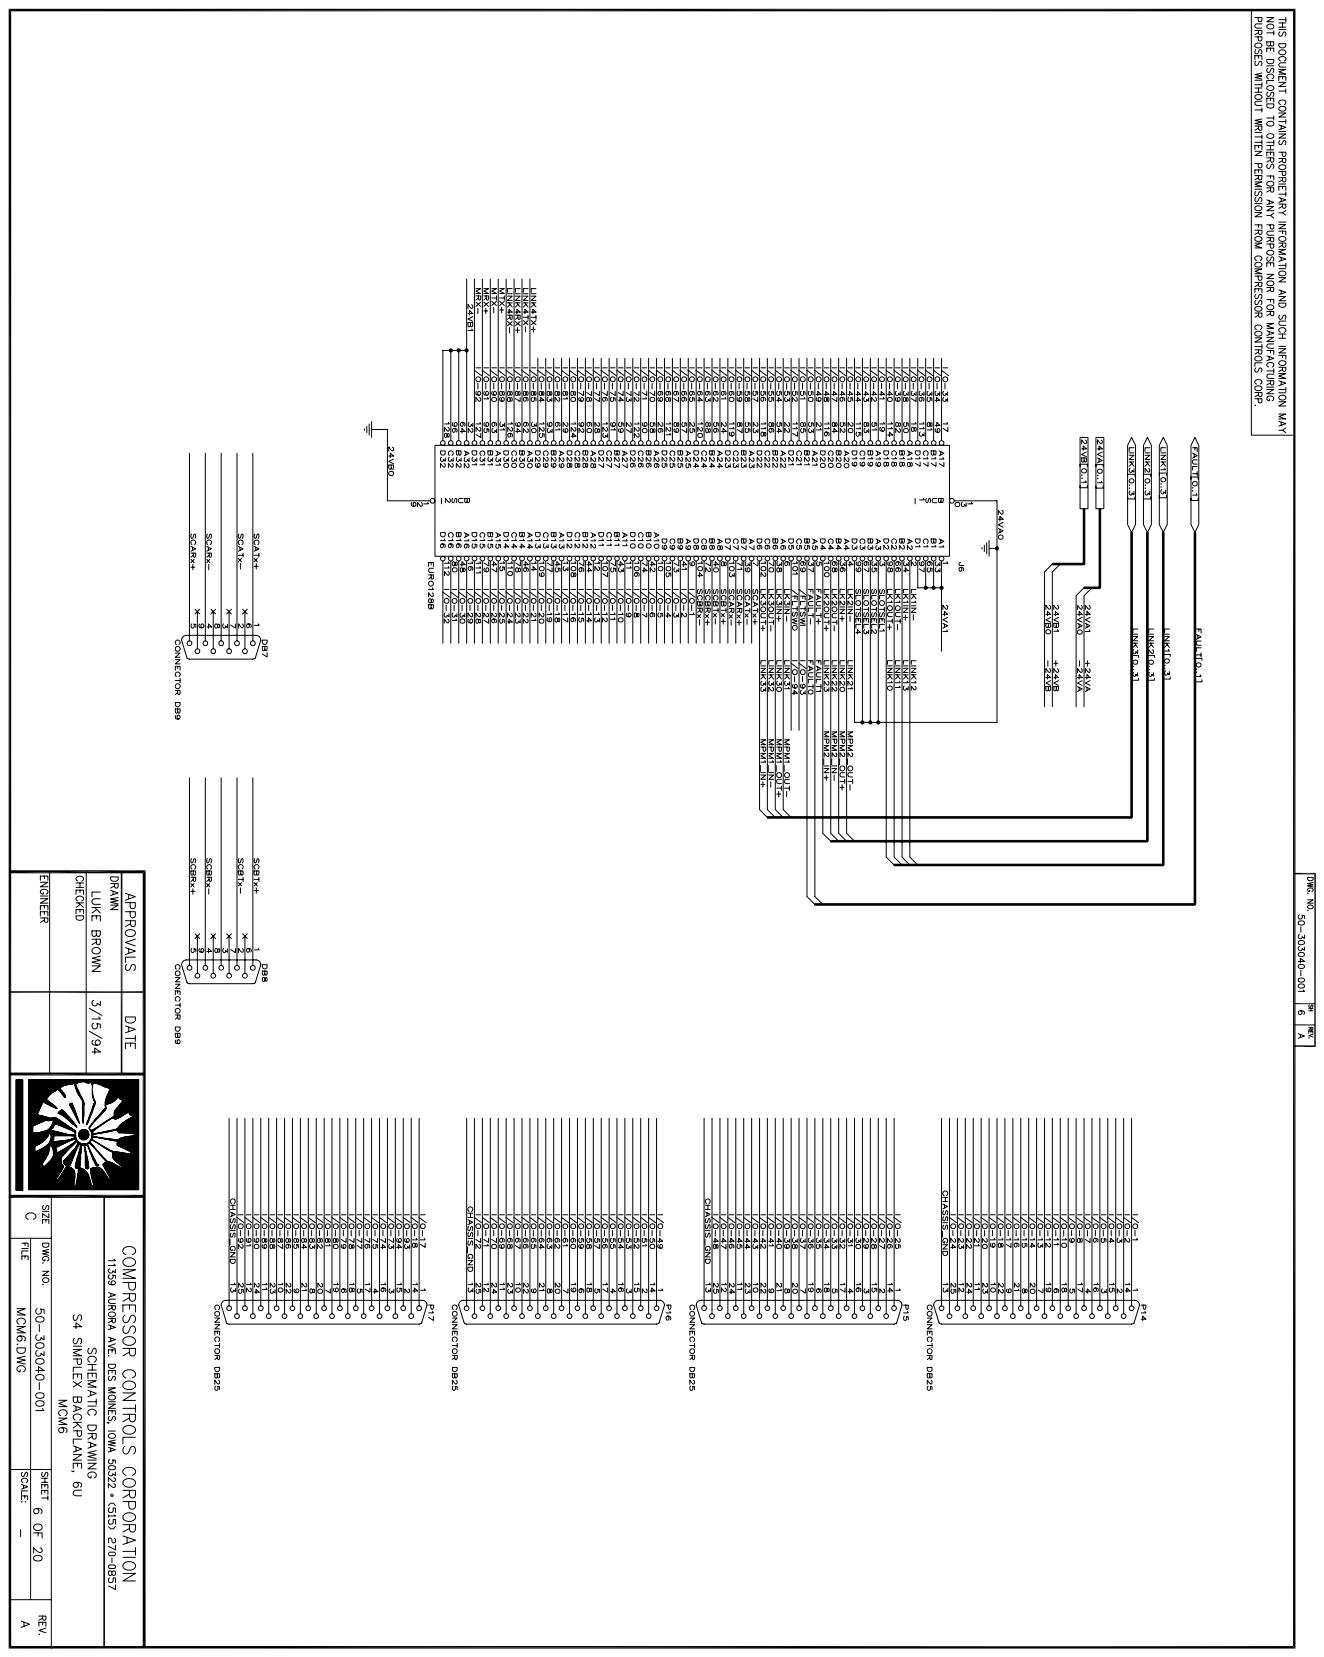
[picture p211: page 6]

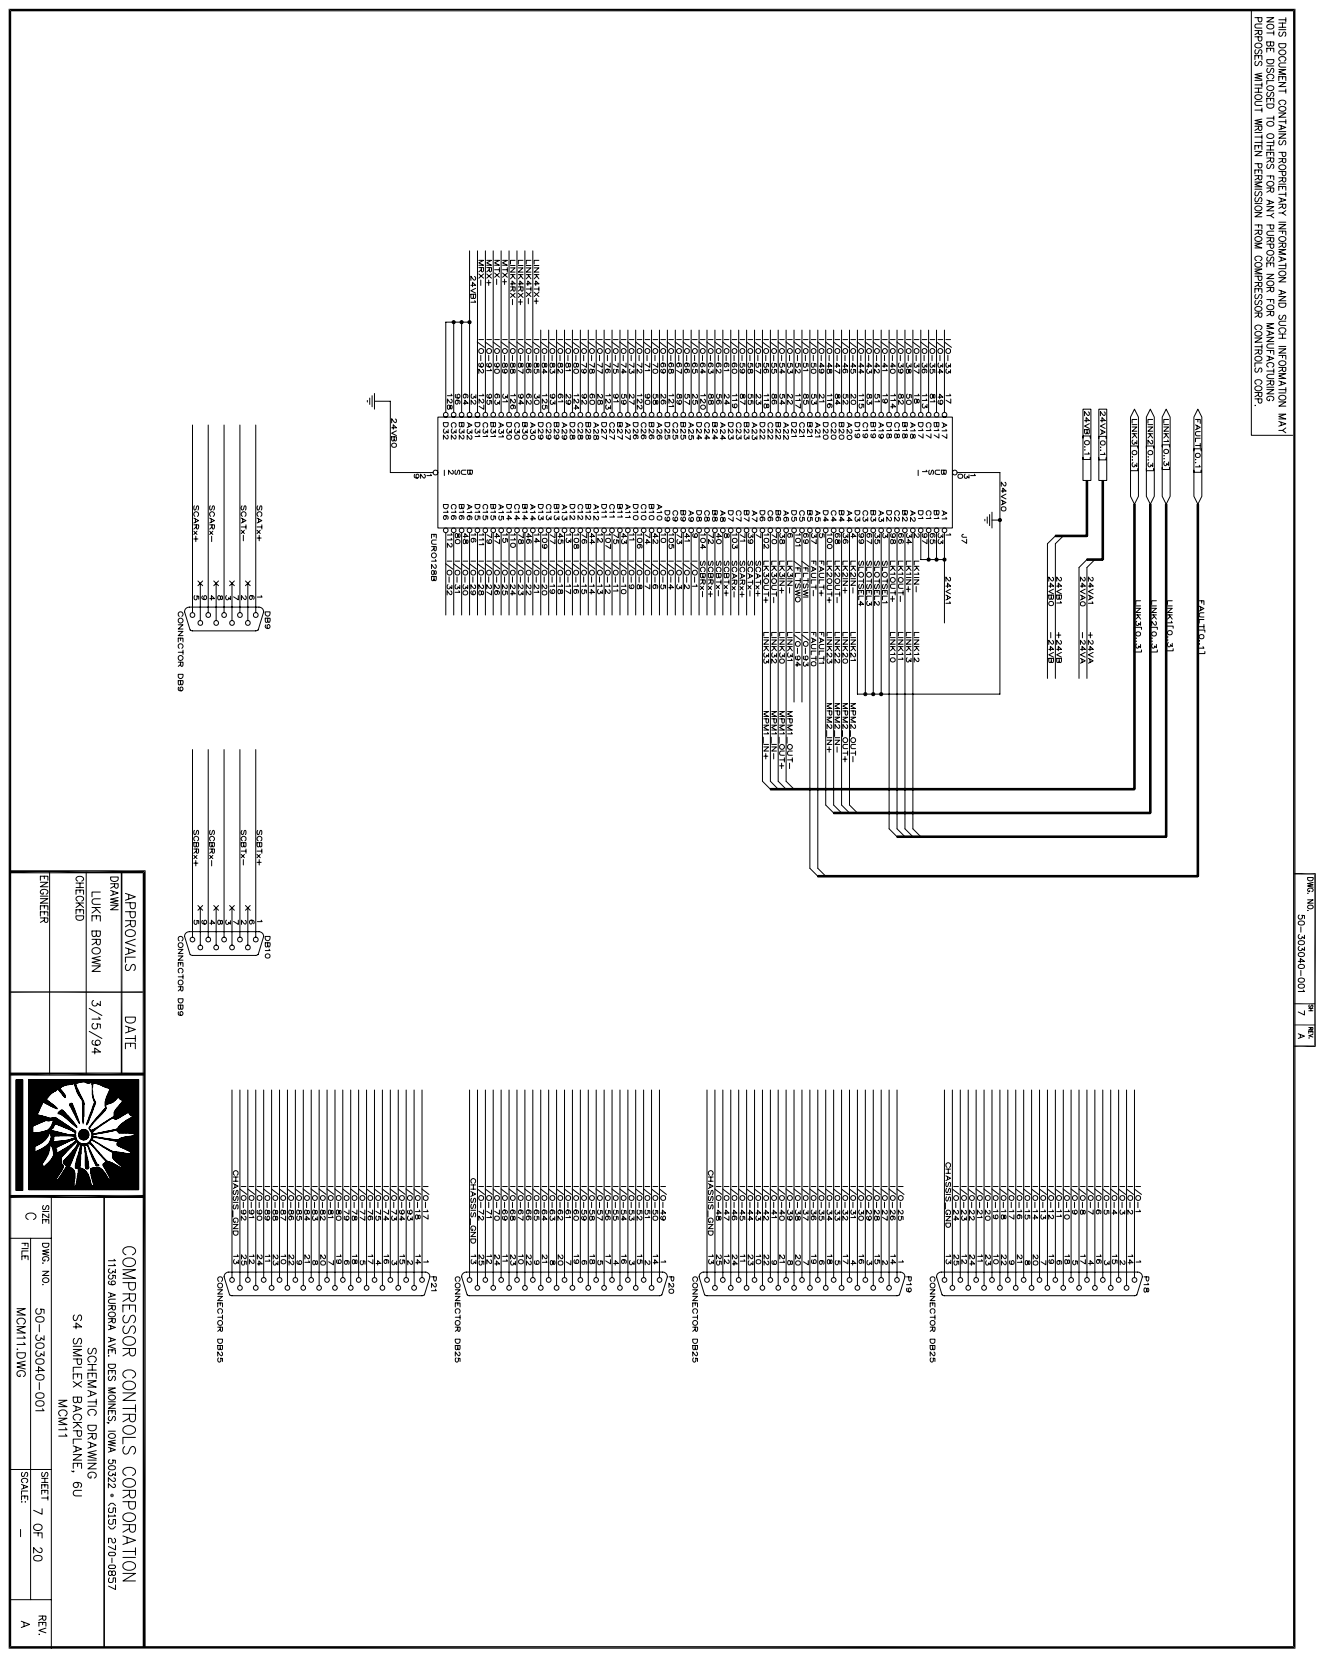
[picture p212: page 7]

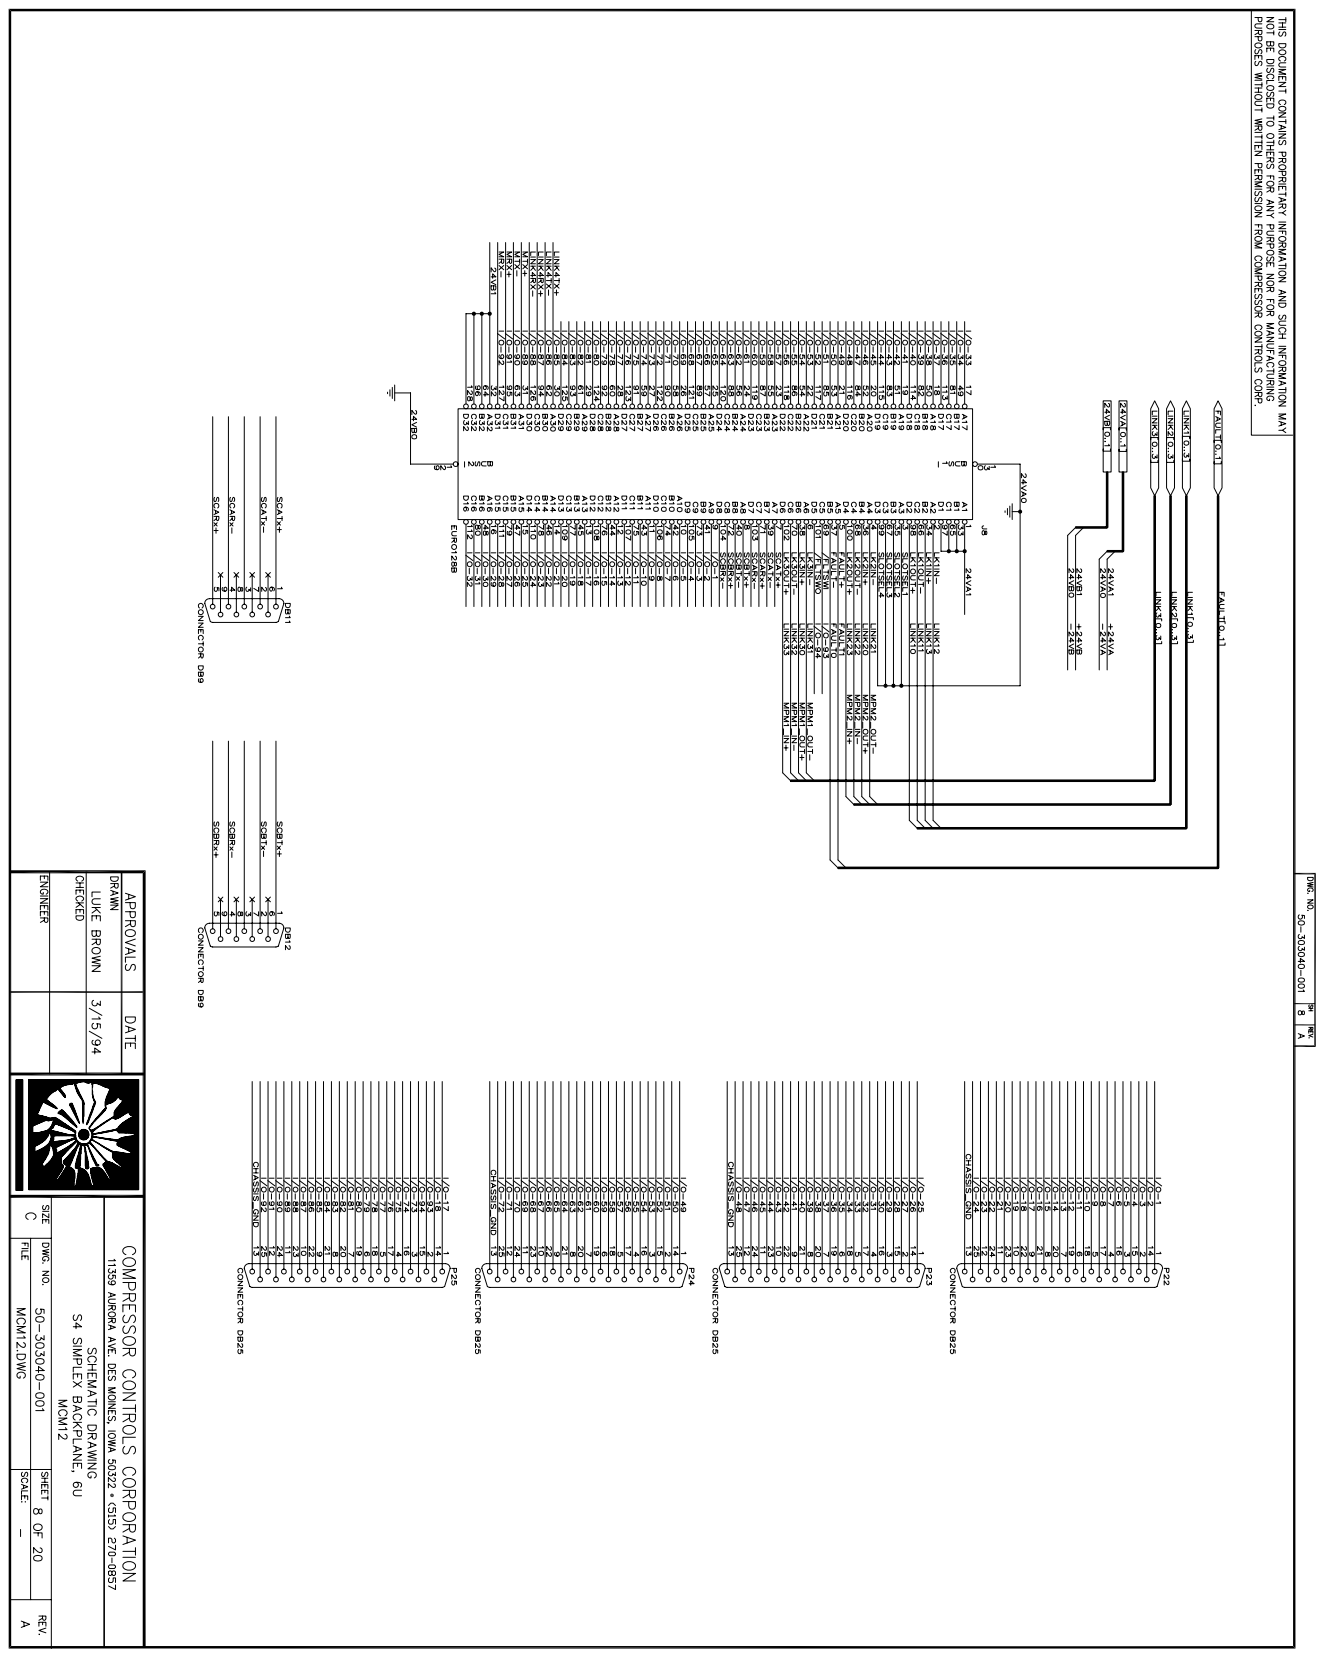
[picture p213: page 8]

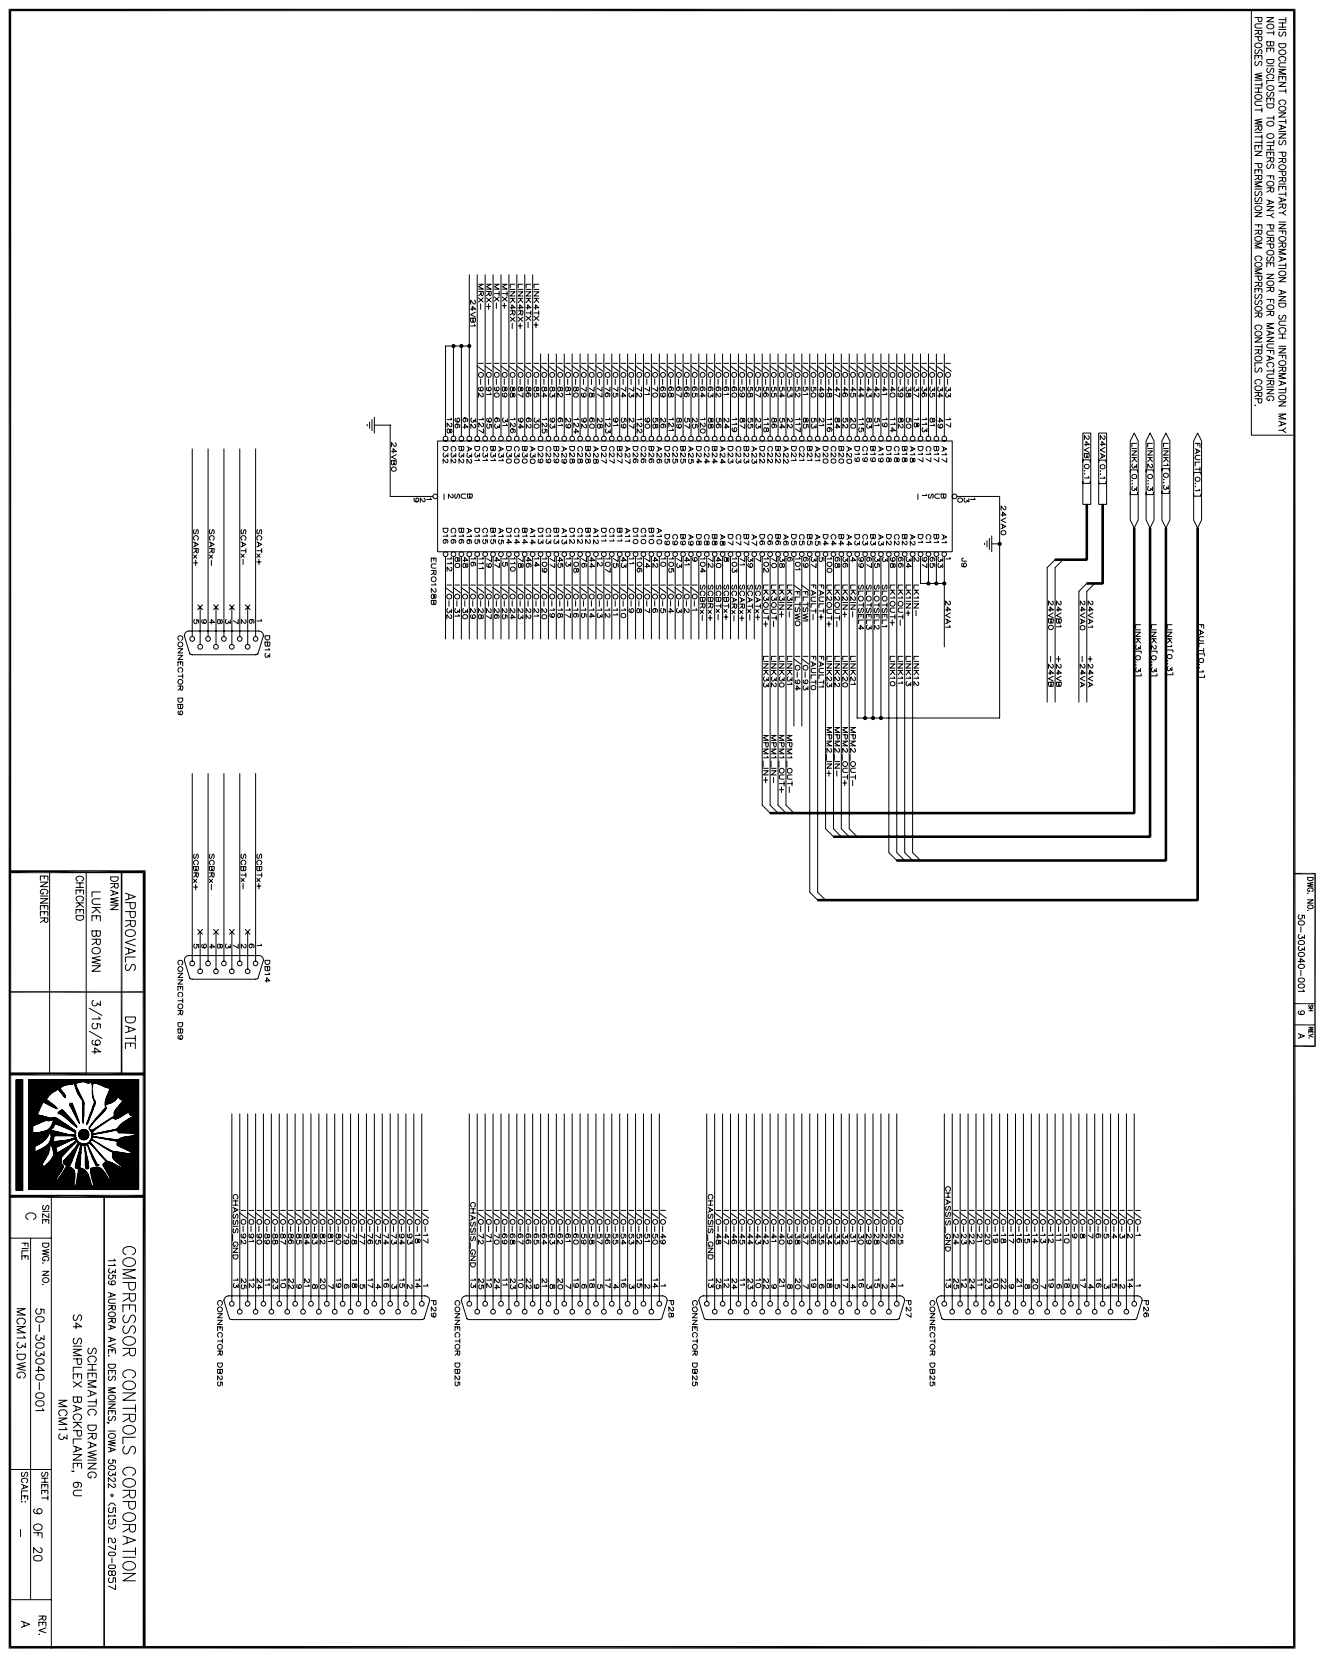
[picture p214: page 9]

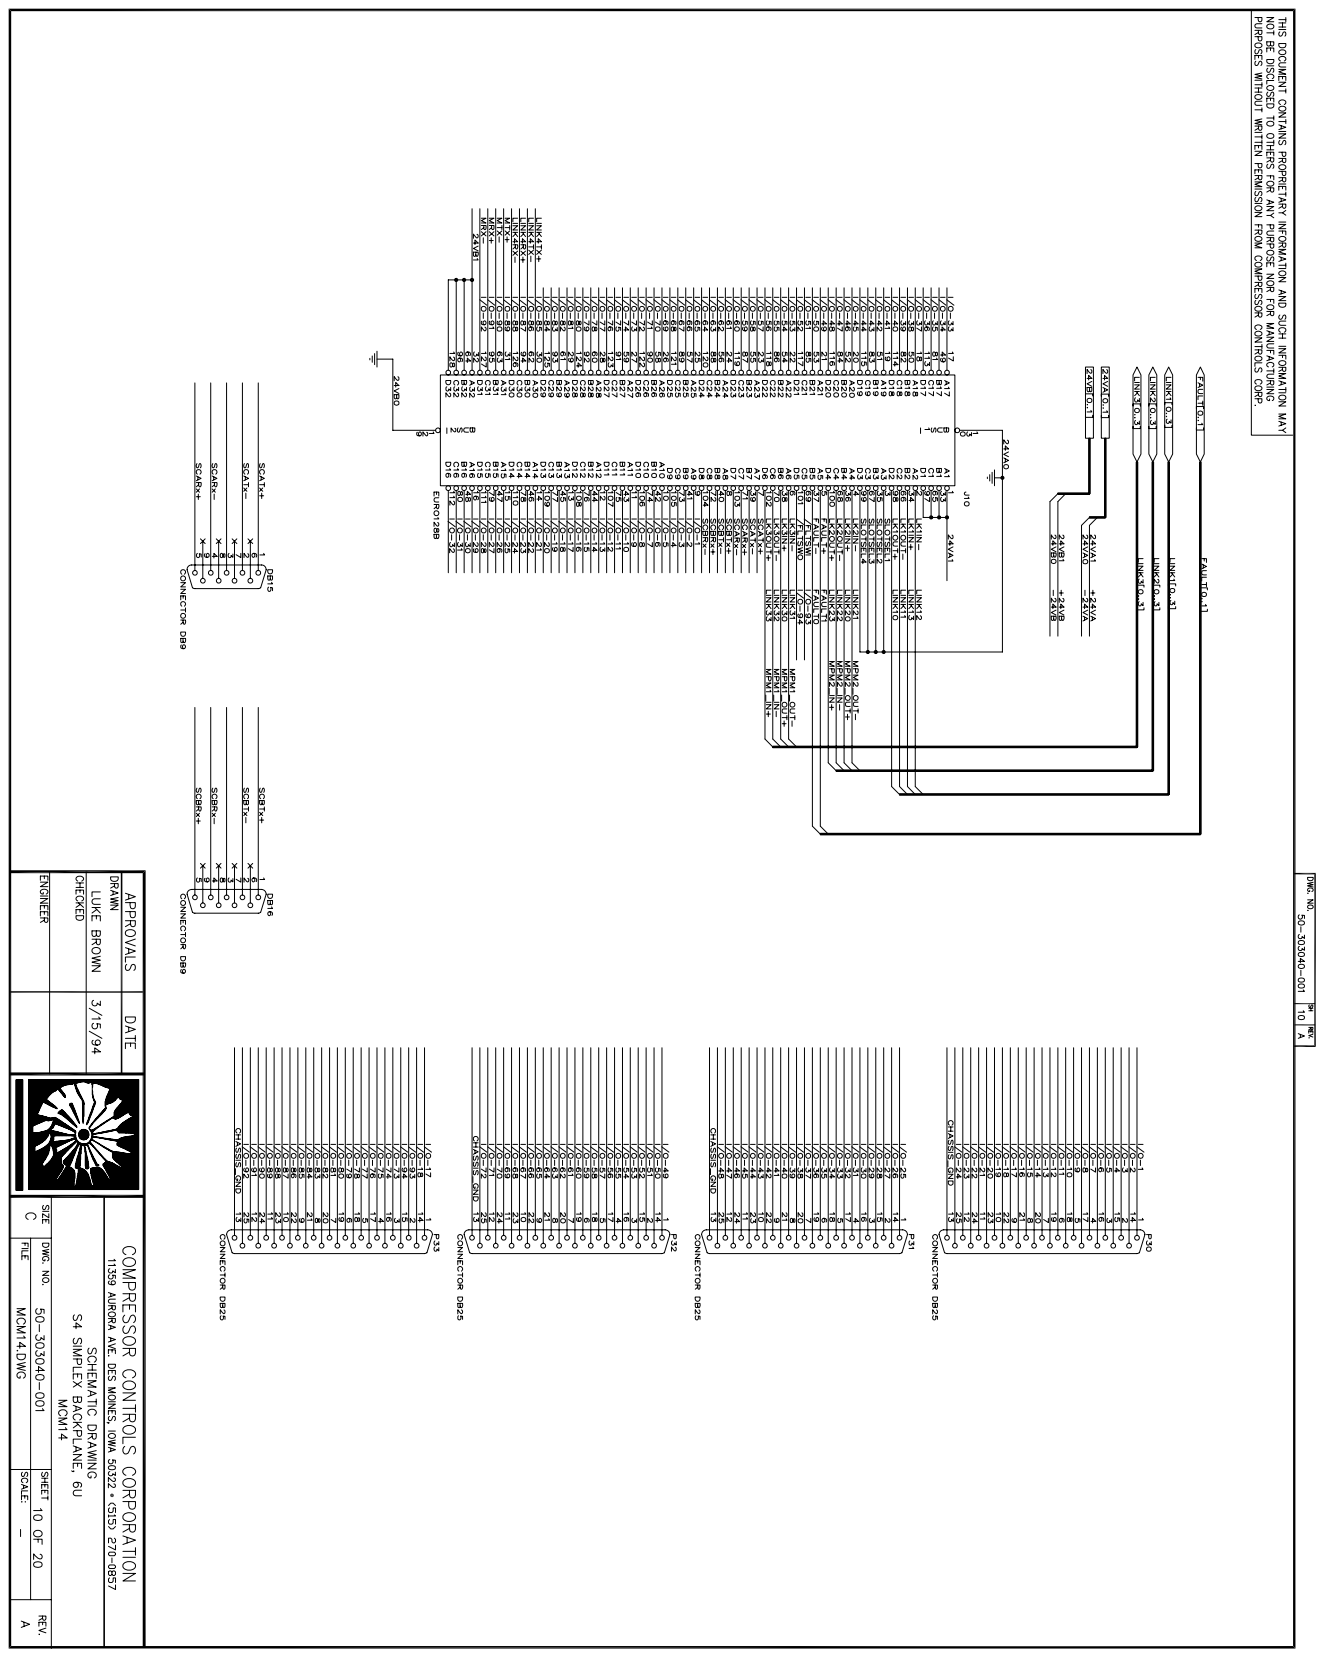
[picture p215: page 10]

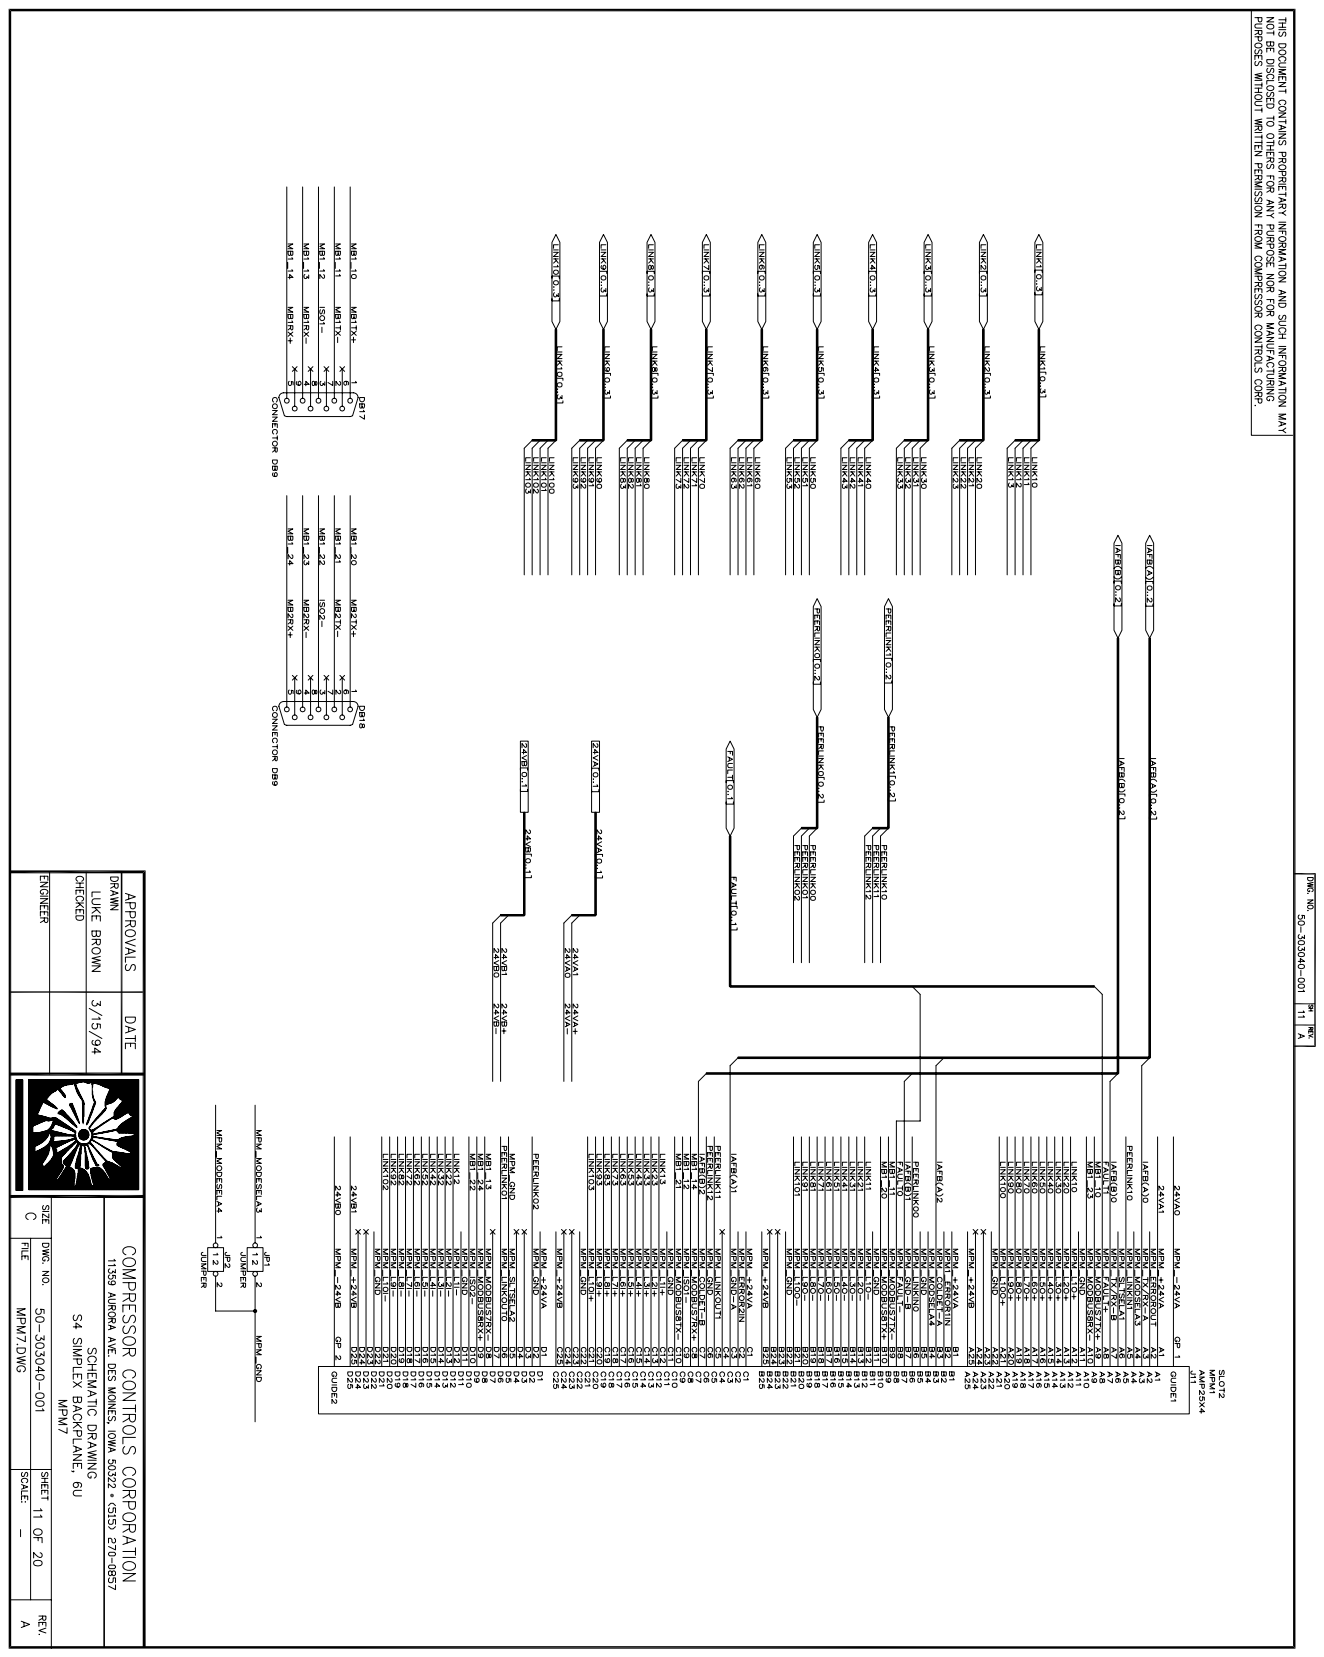
[picture p216: page 11]

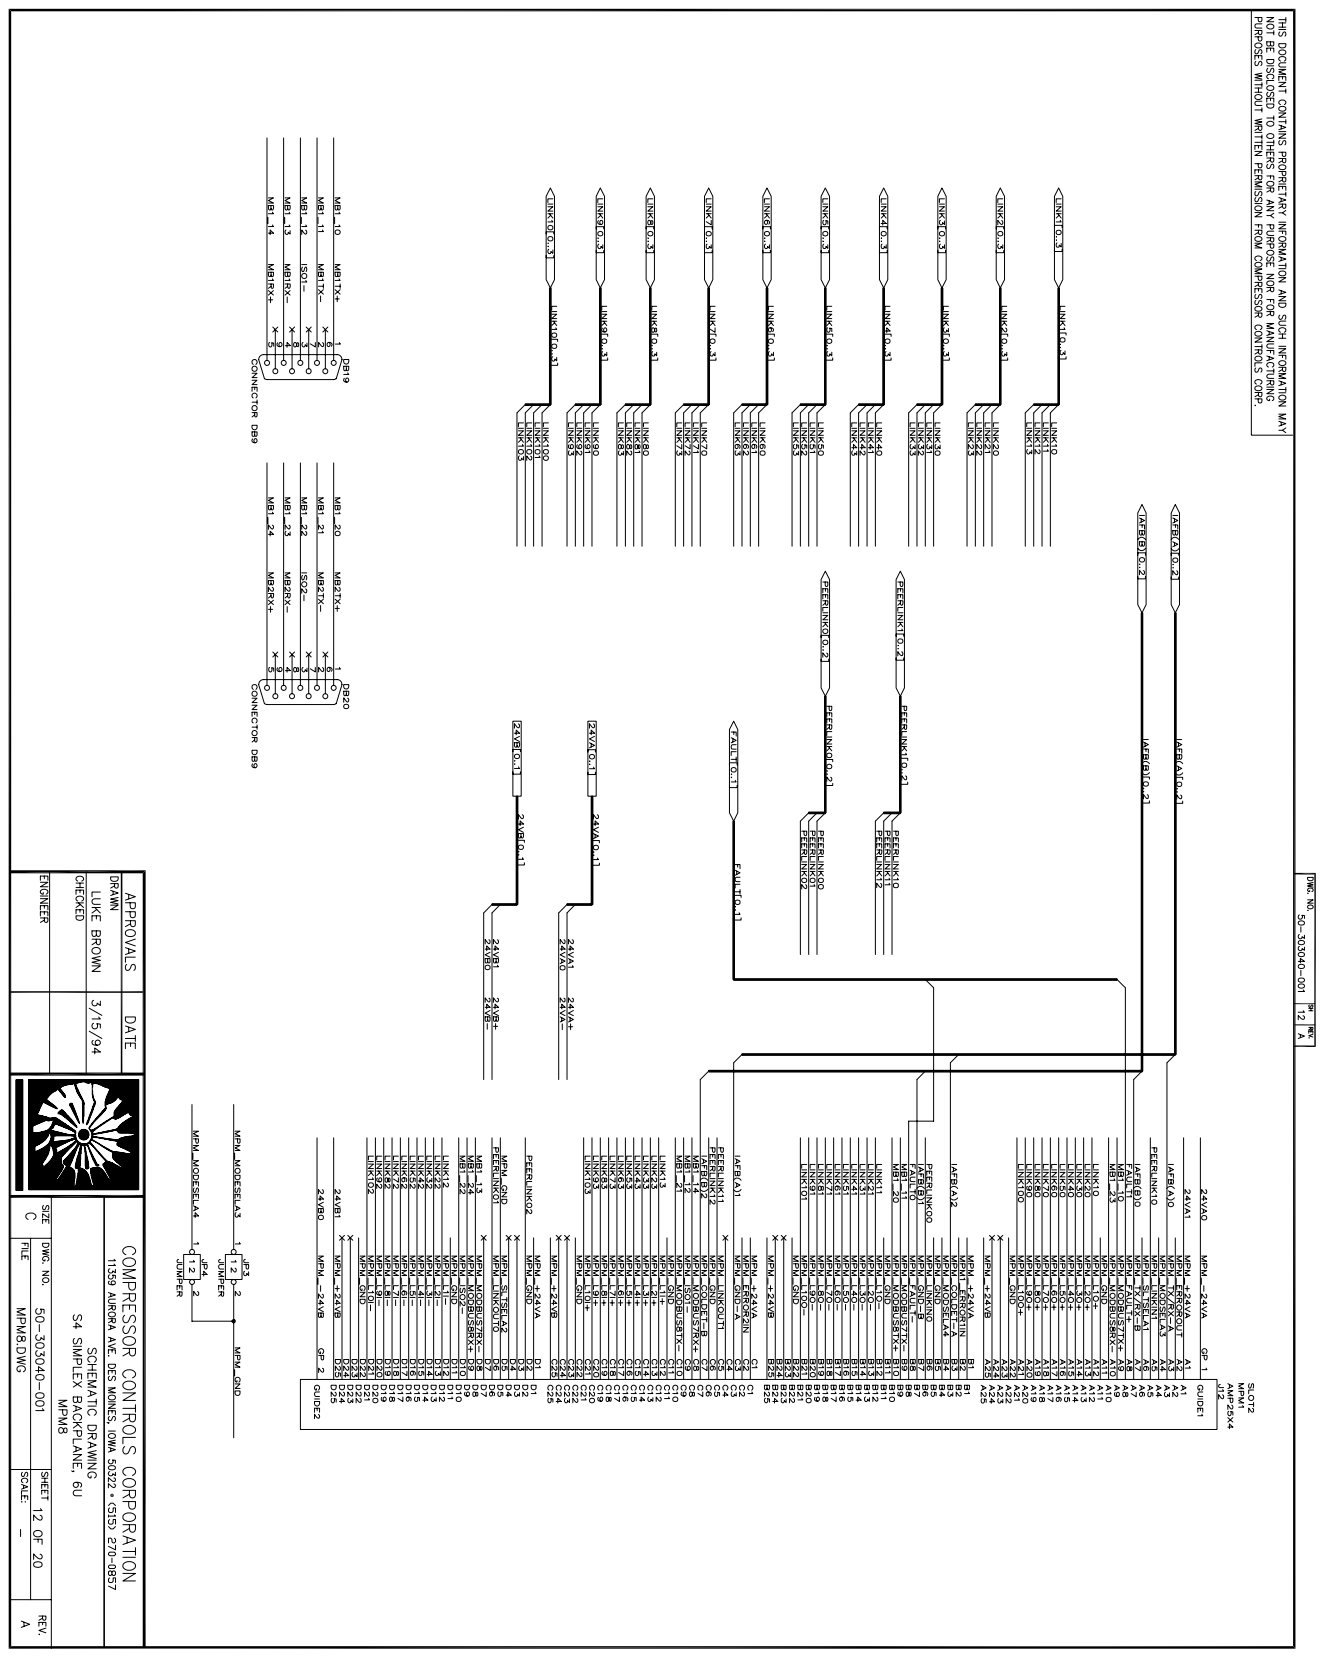
[picture p217: page 12]

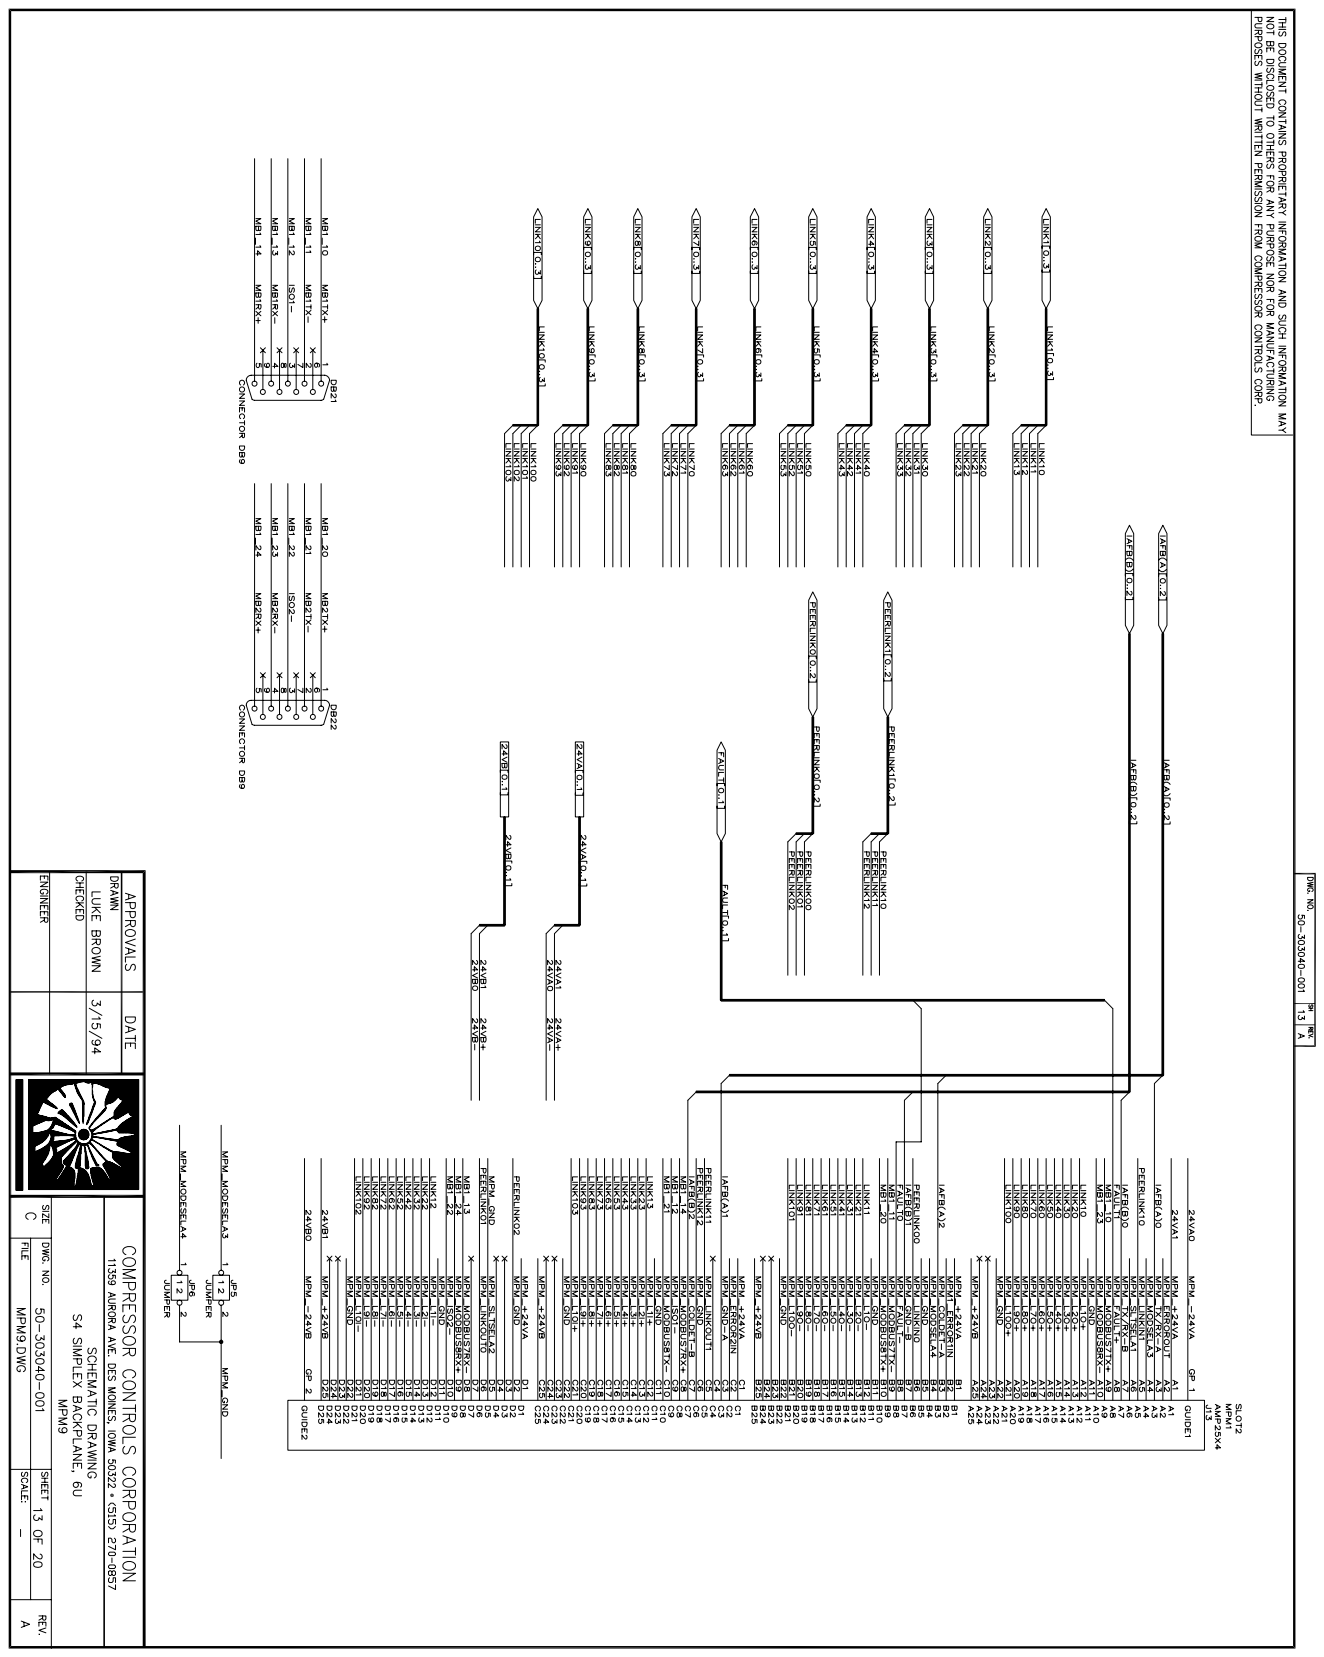
[picture p218: page 13]

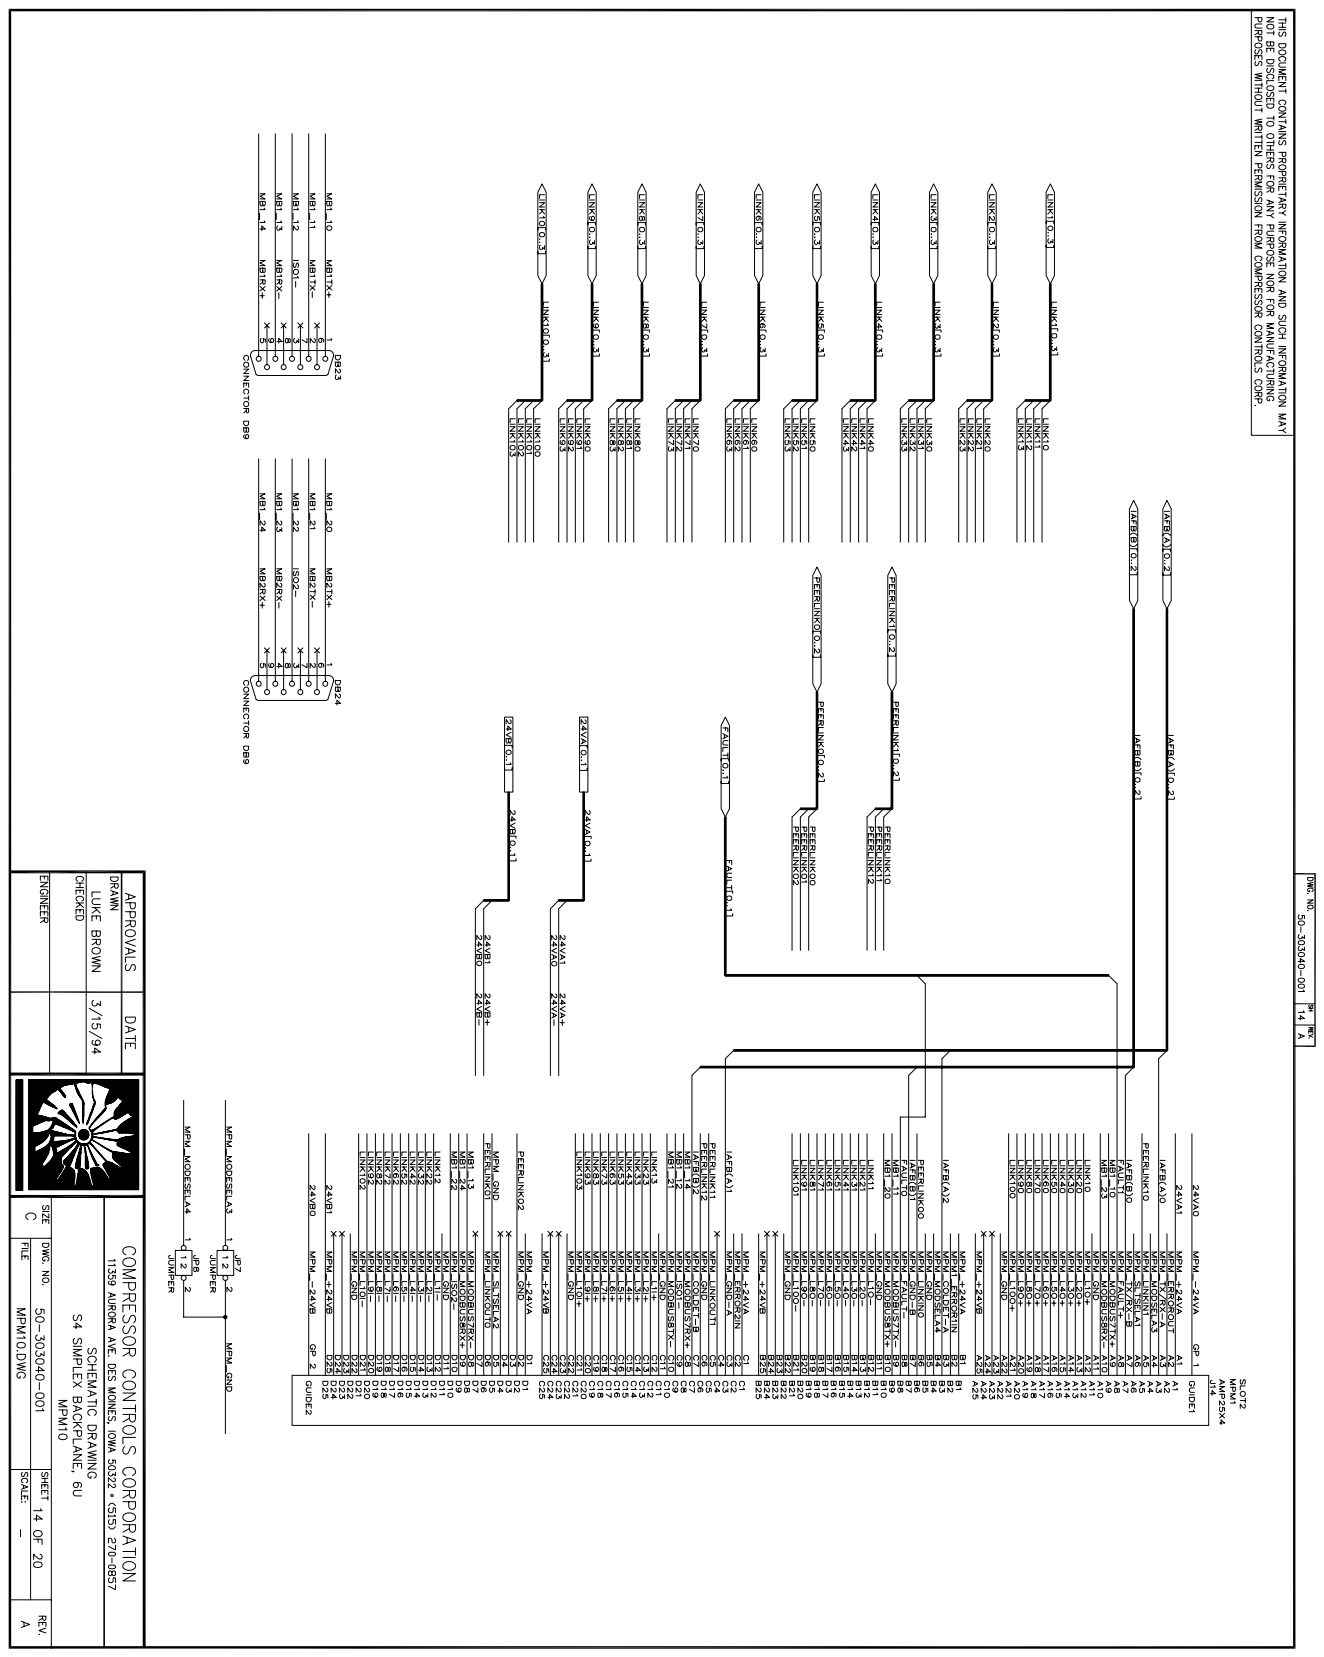
[picture p219: page 14]

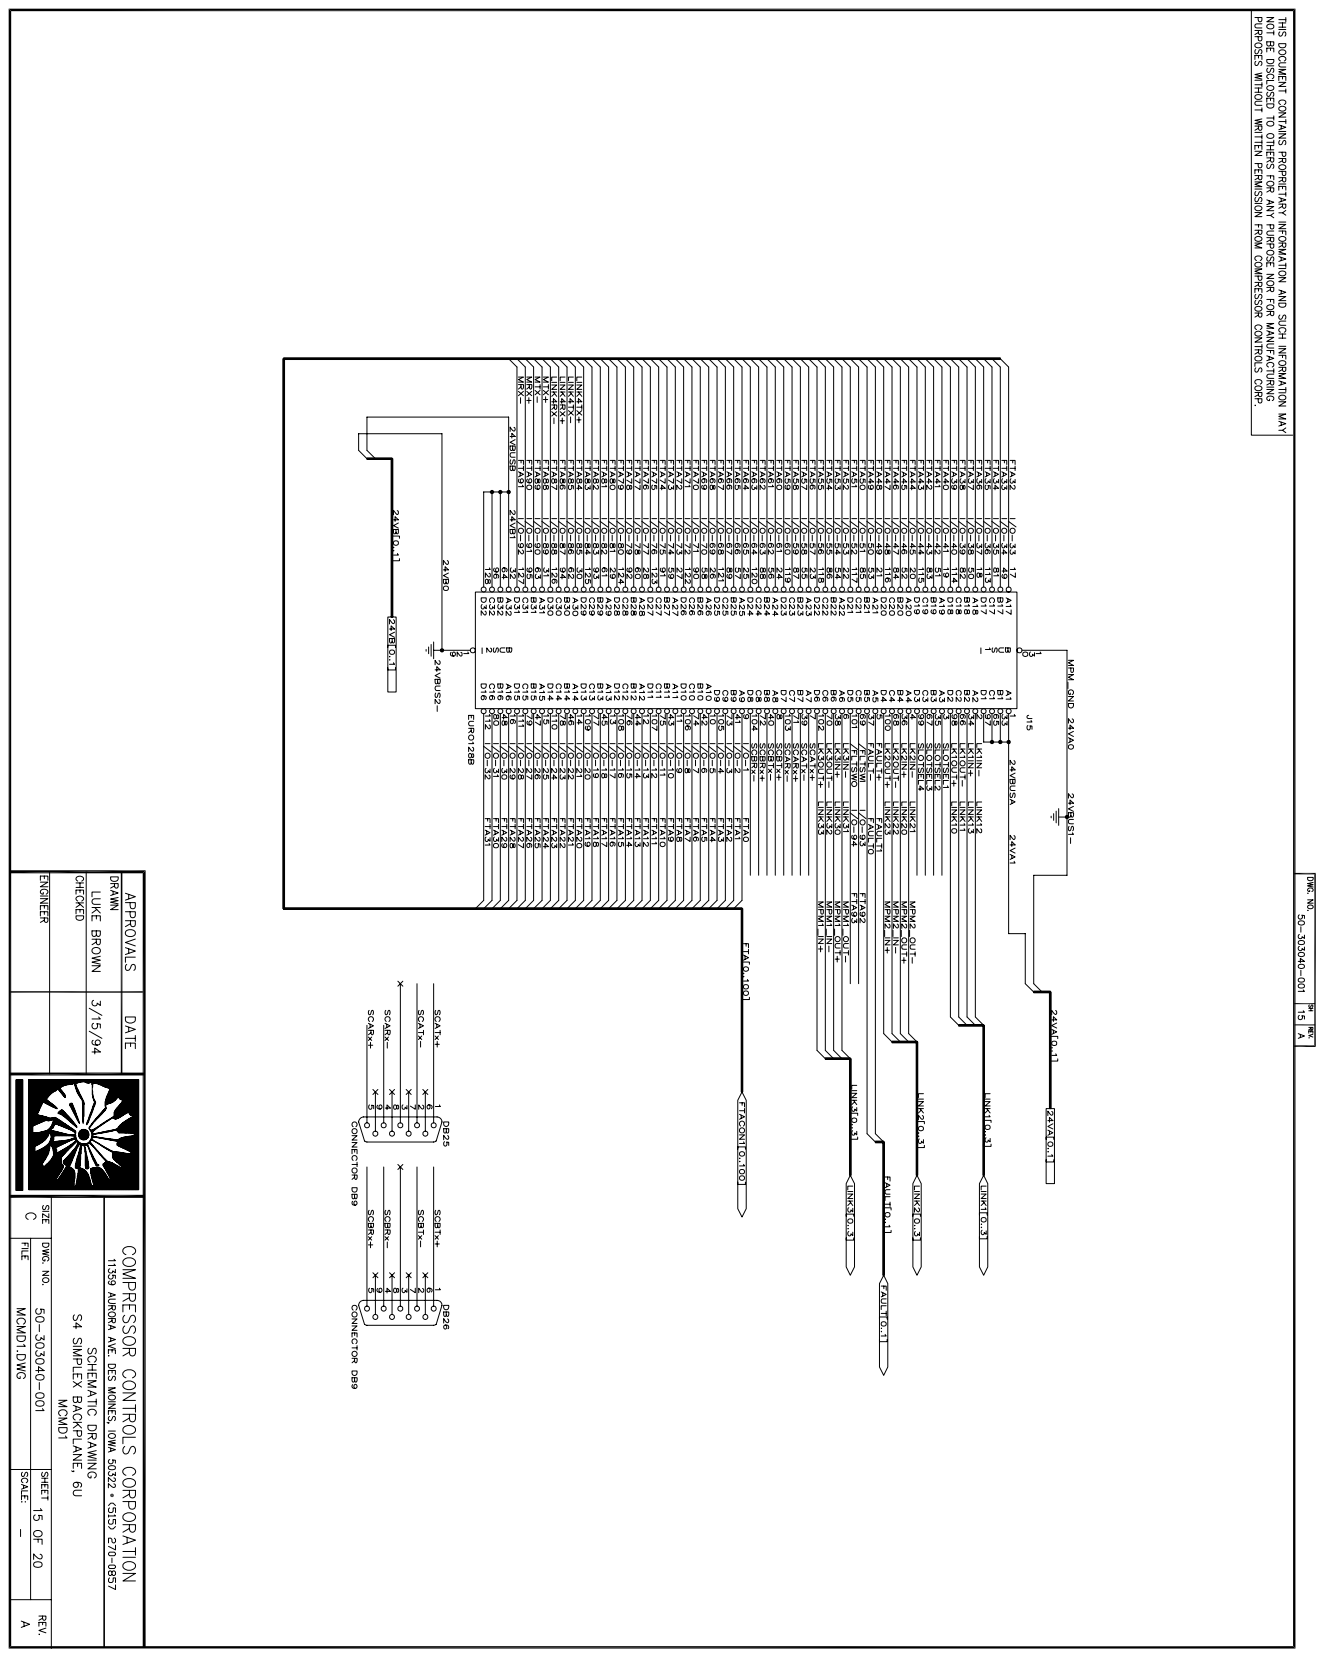
[picture p220: page 15]

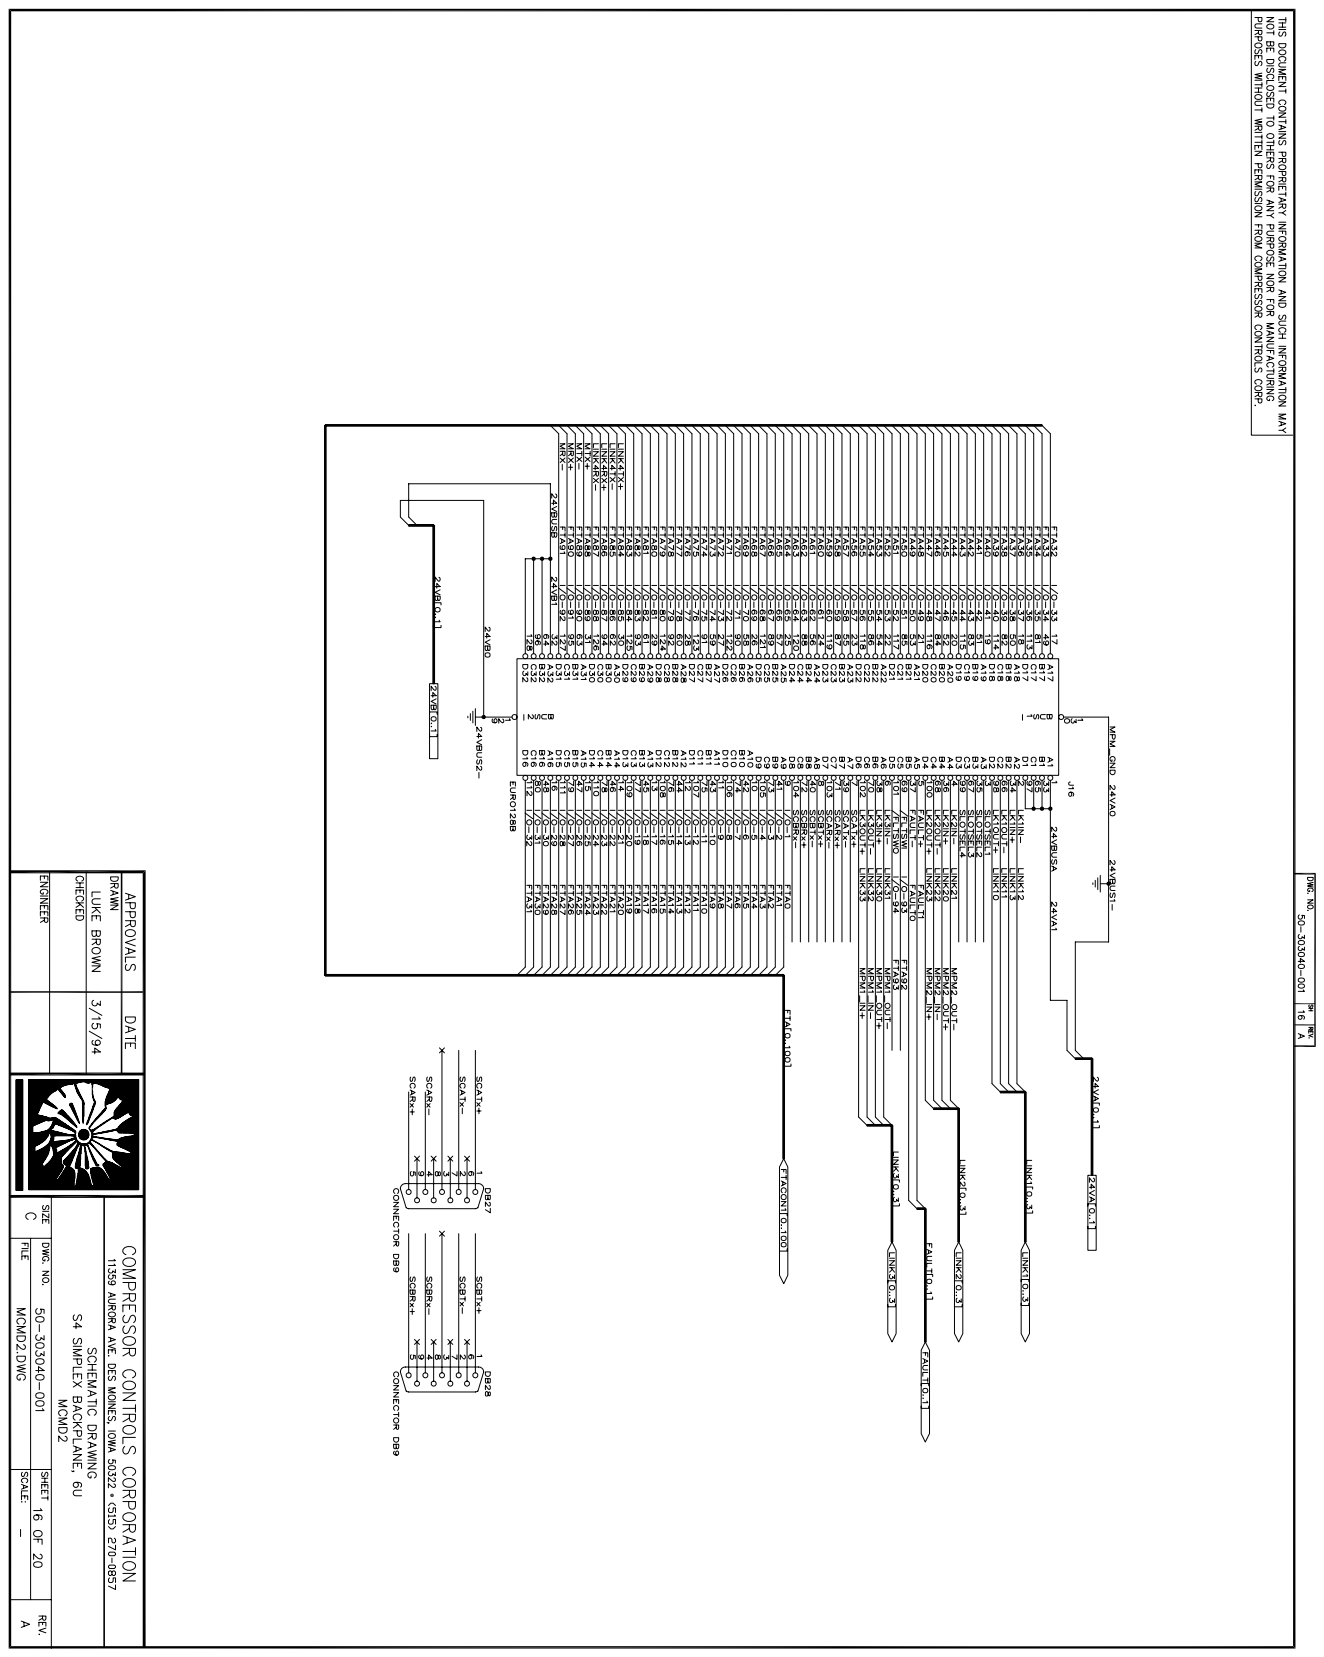
[picture p221: page 16]

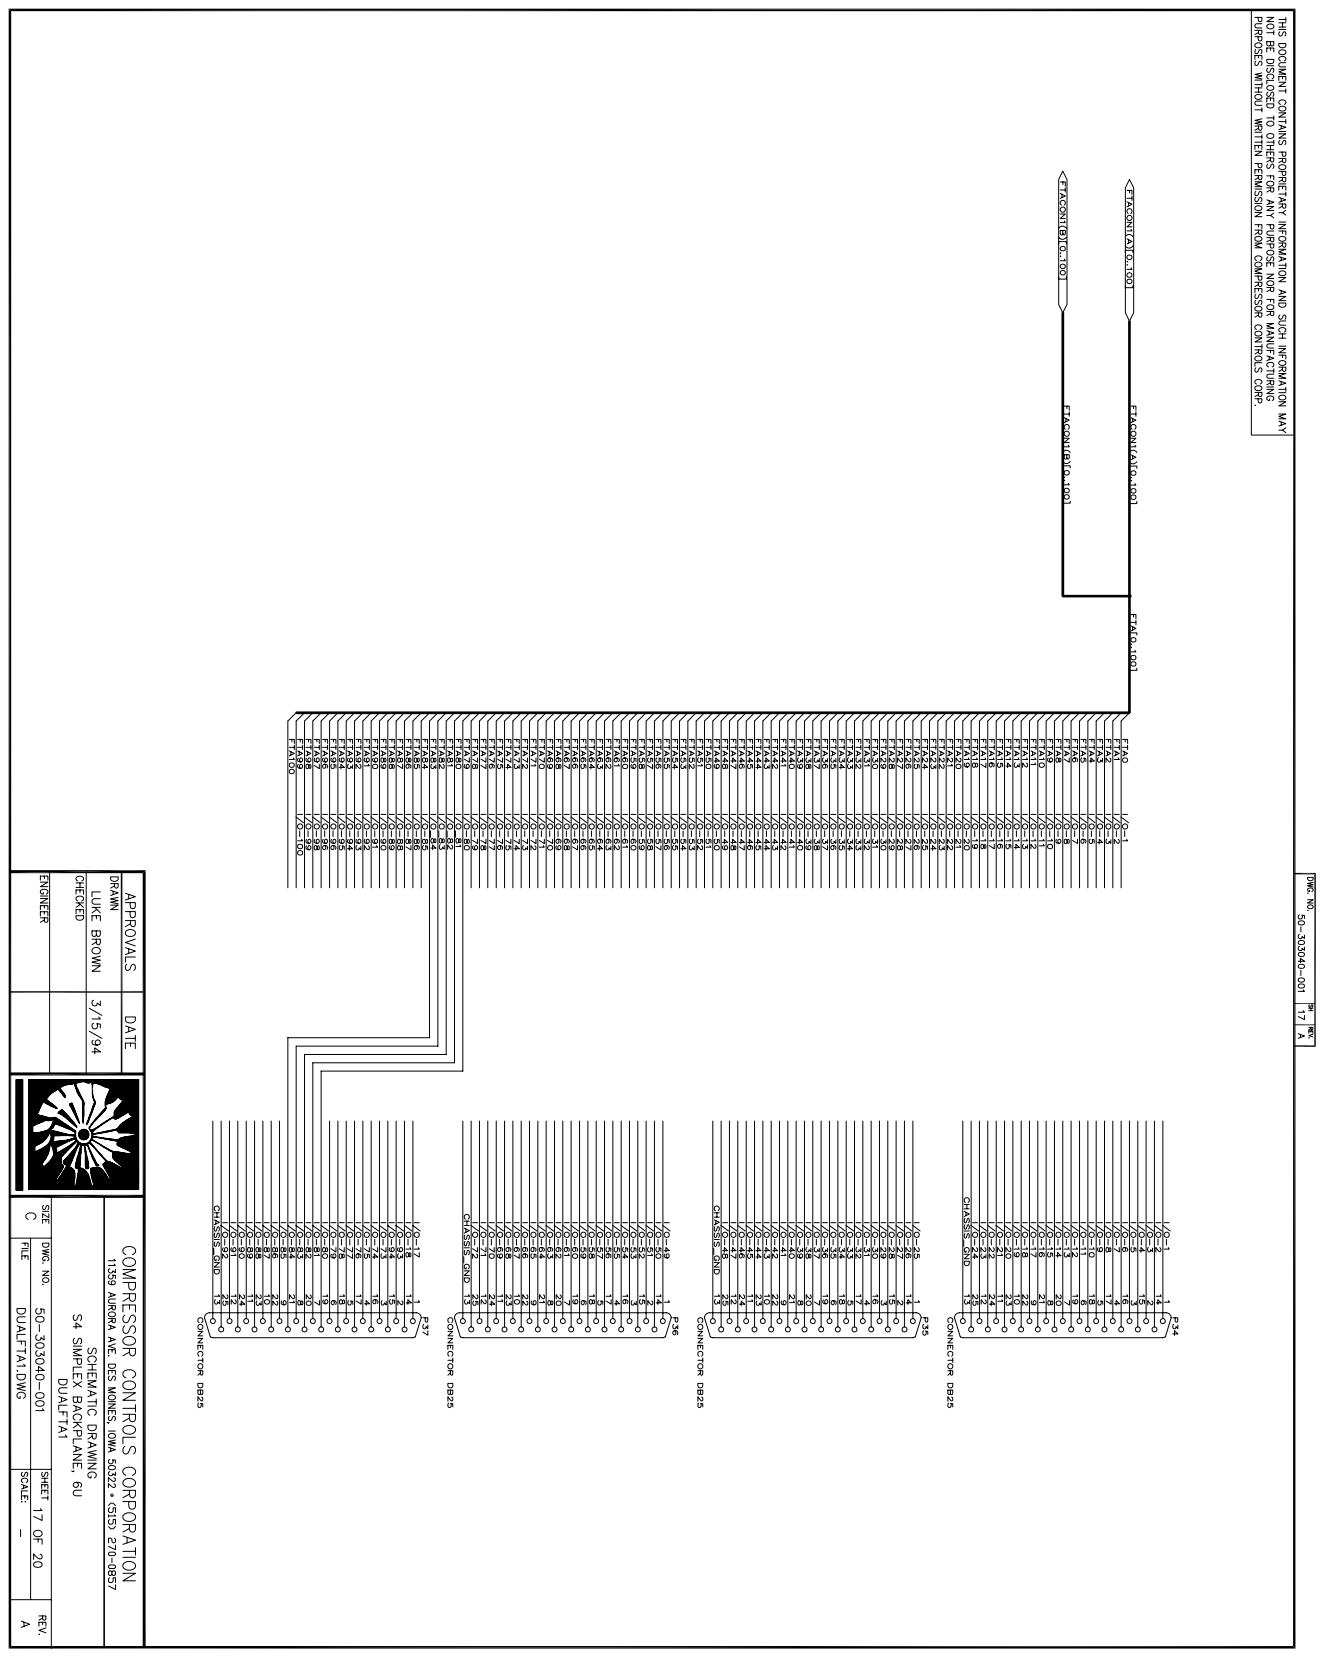
[picture p222: page 17]

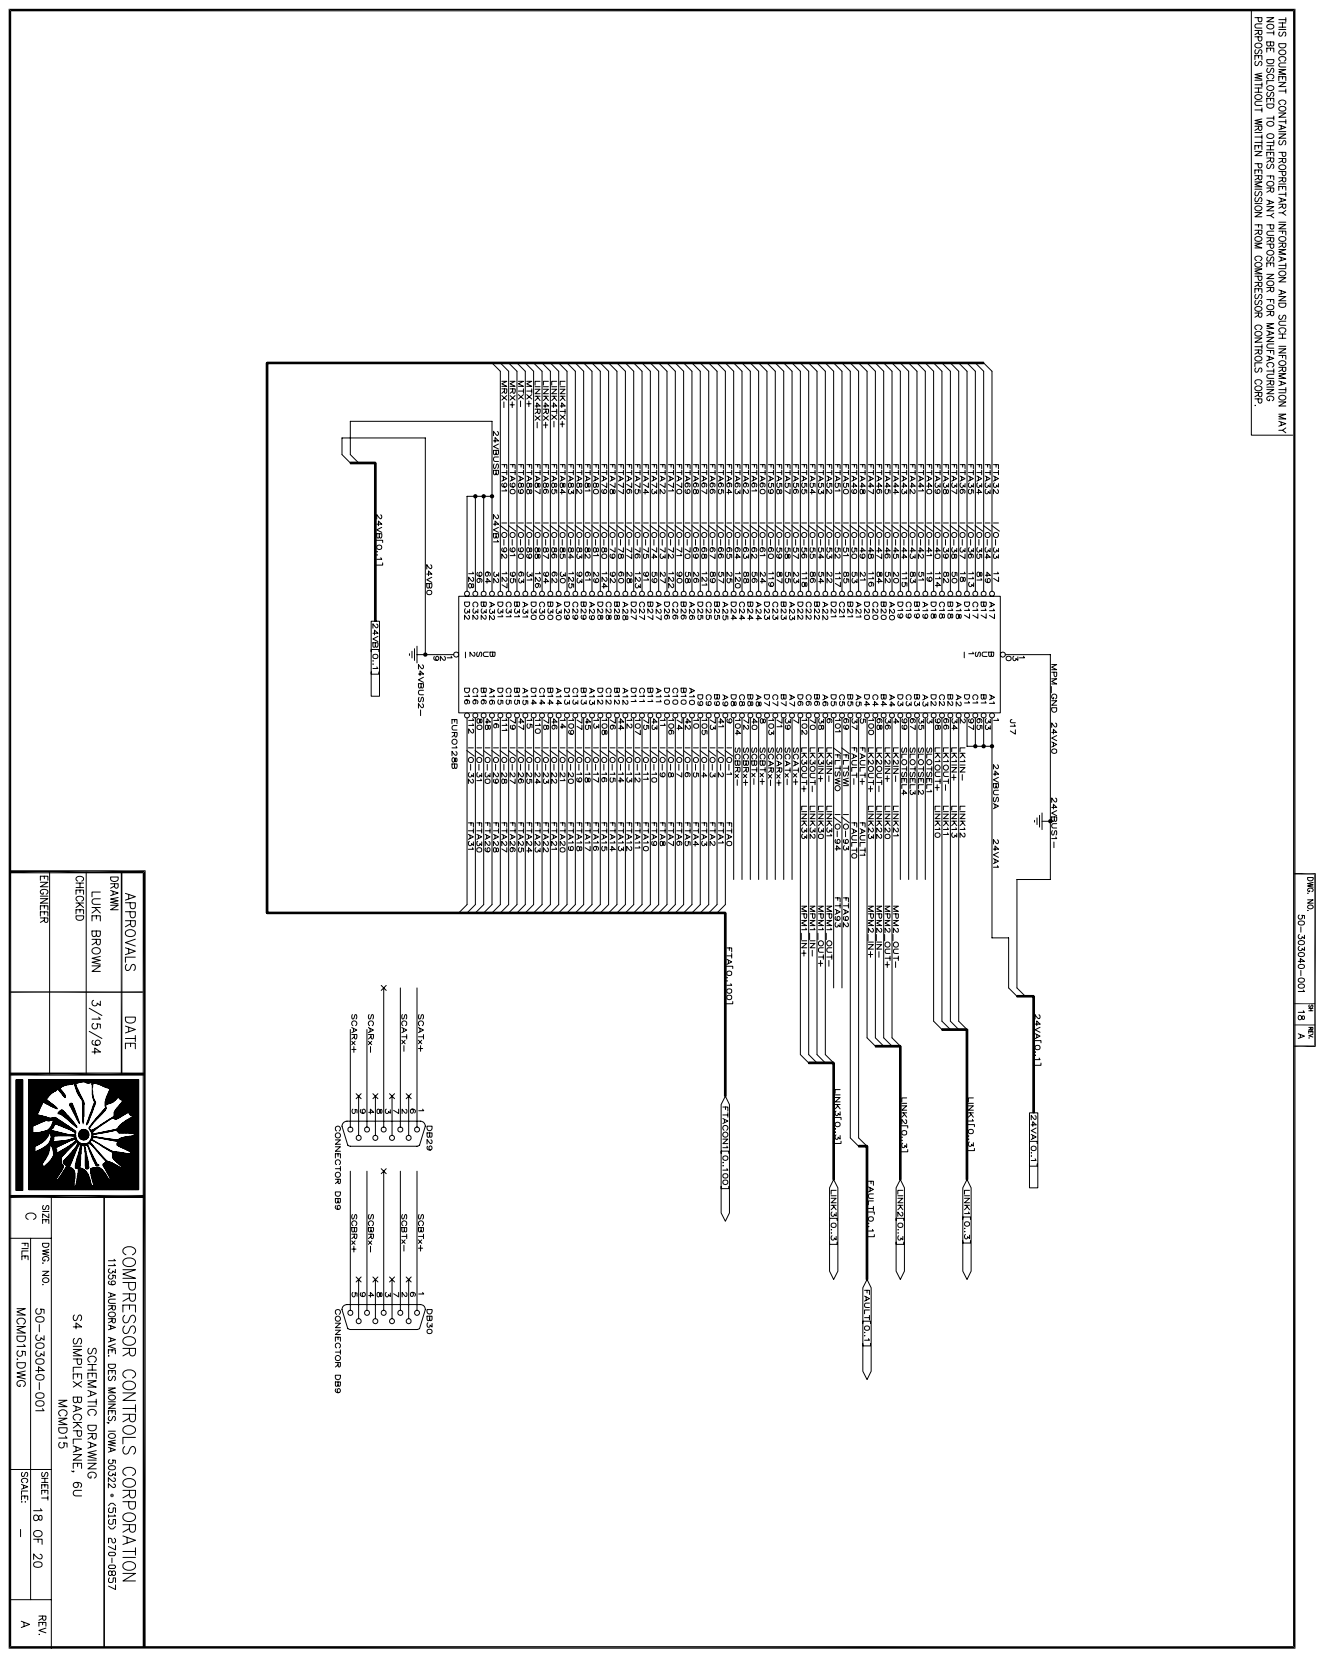
[picture p223: page 18]

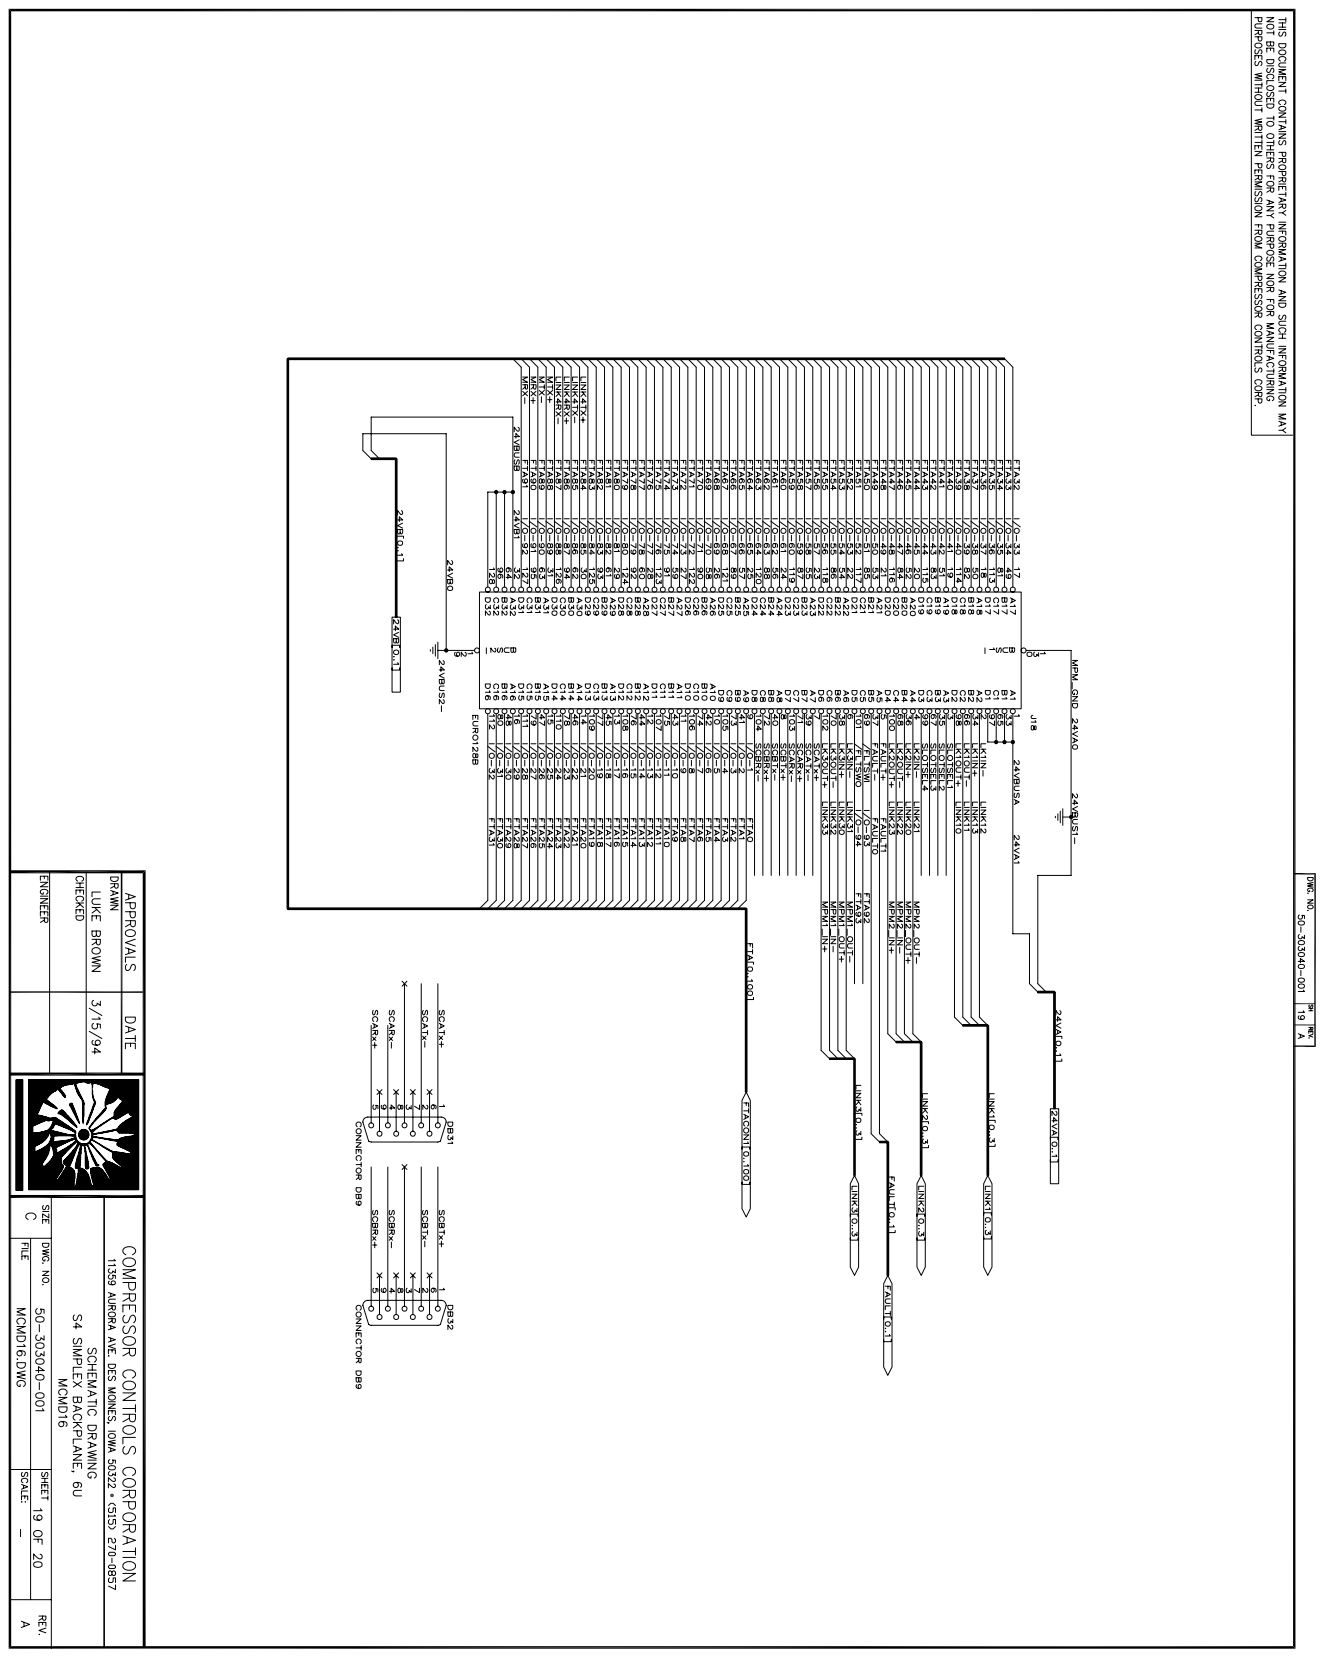
[picture p224: page 19]

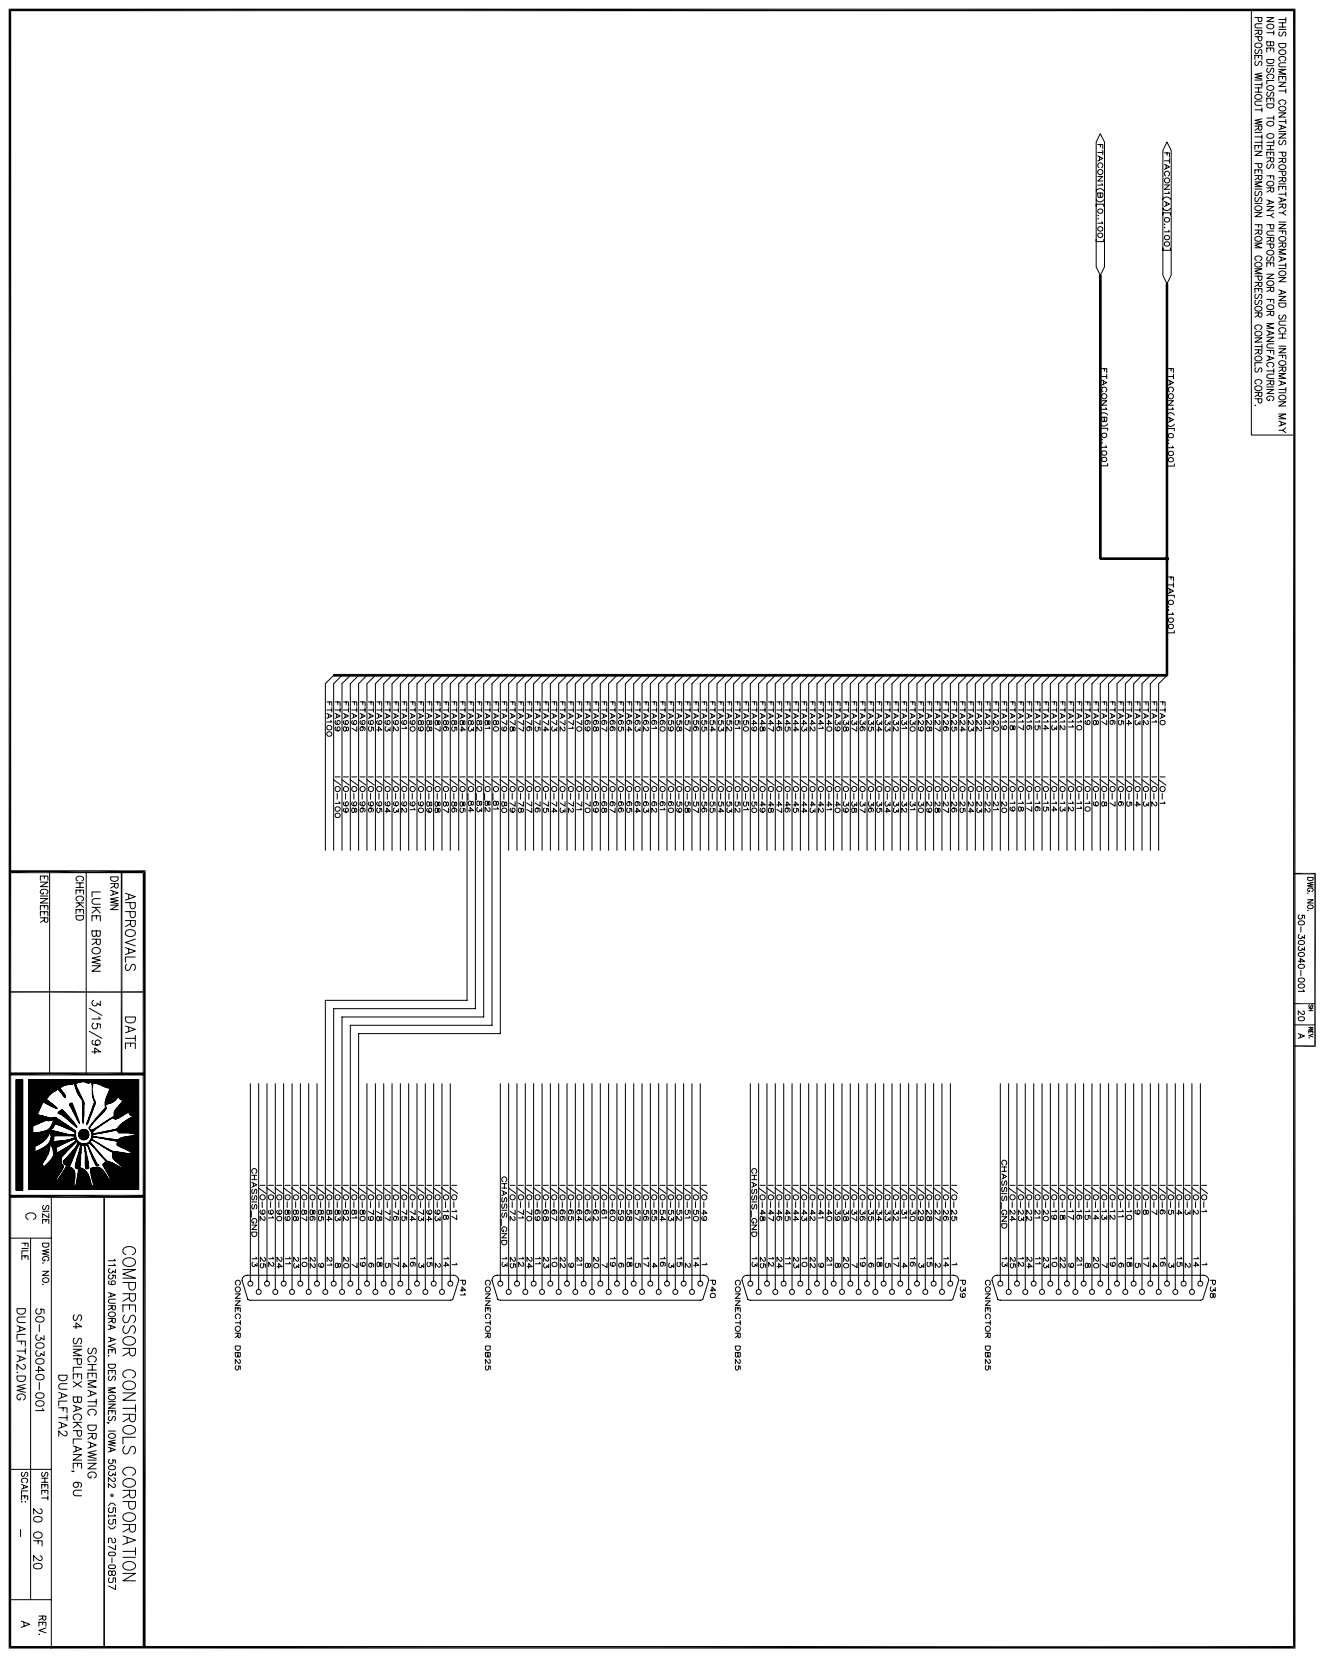
[picture p225: page 20]

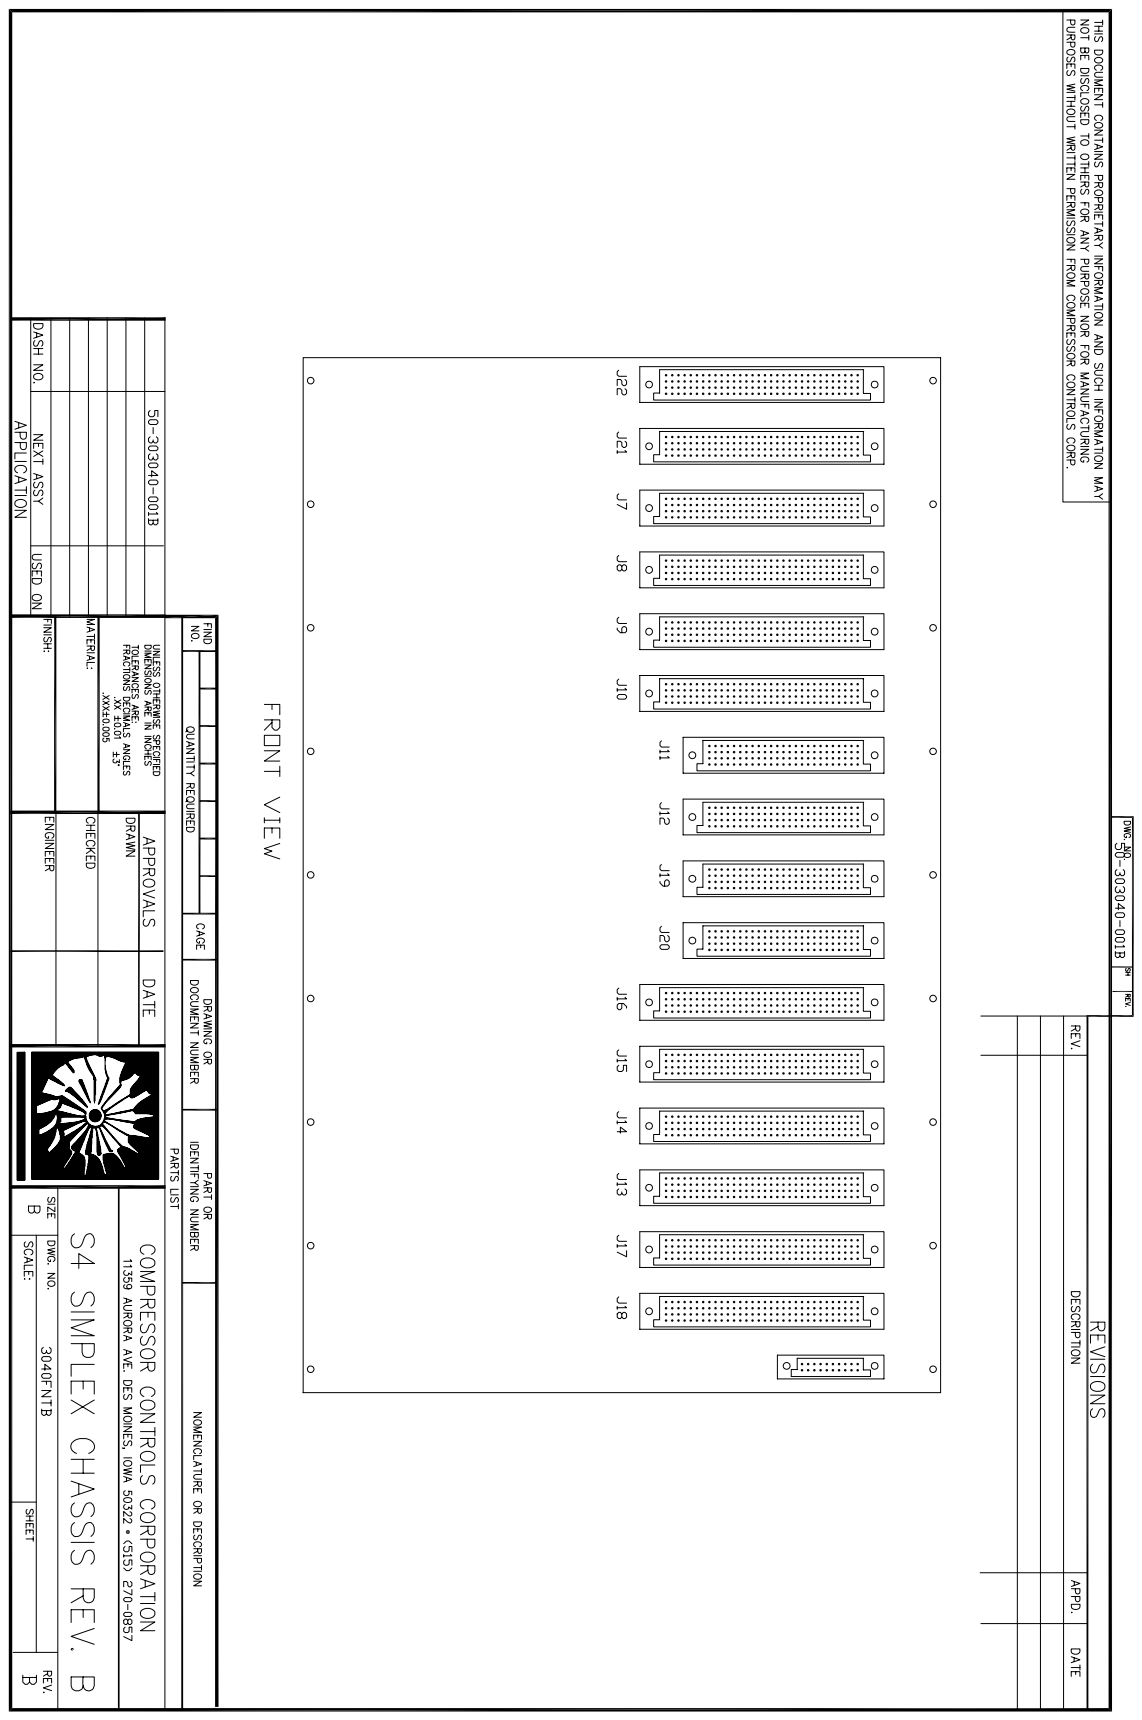
[picture p226: page 21]

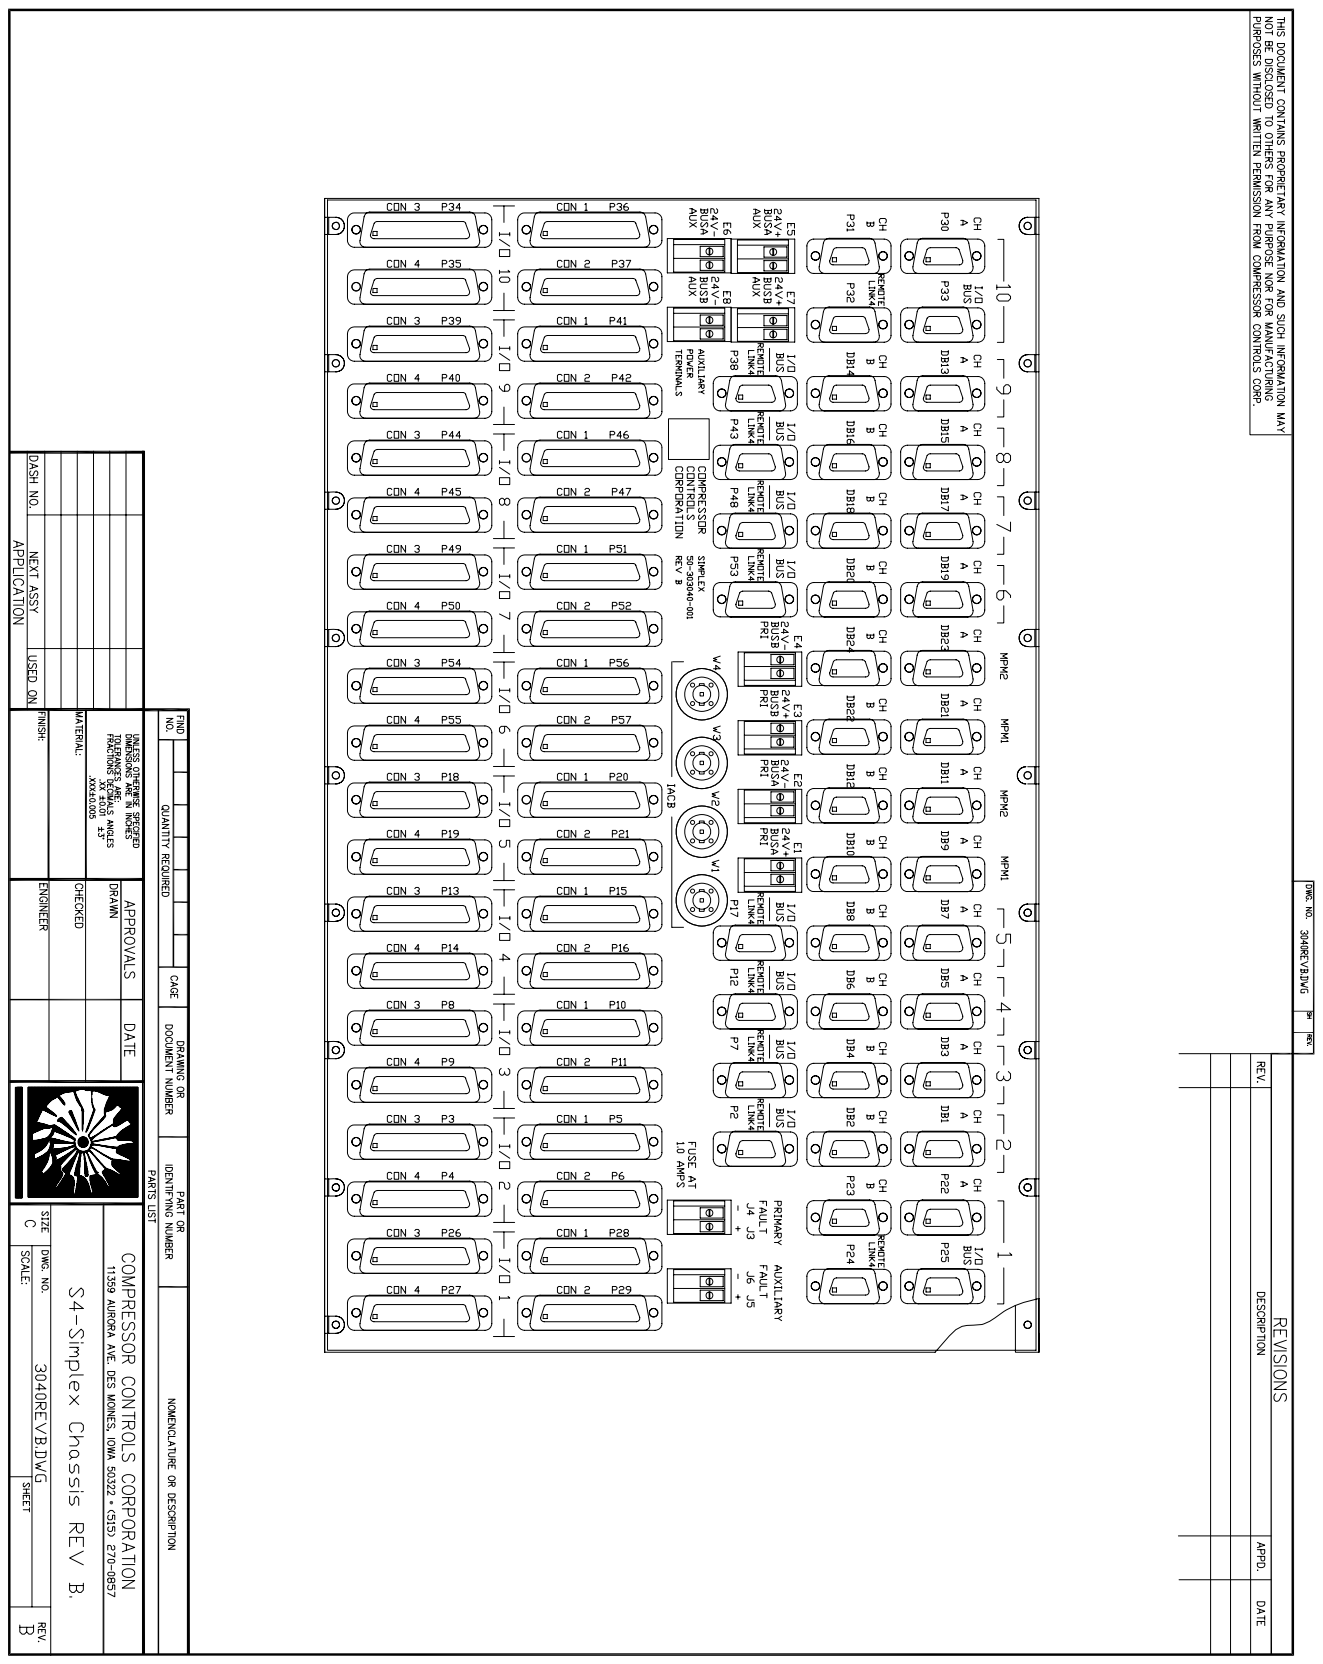
[picture p227: page 22]
