Sayidathahaseen/CCC_NGP_ODC/NGP_ODC_Main/PDLC/VanGuard/Client Docs/Vanguard/Schematic_Freq Cond Module.pdf

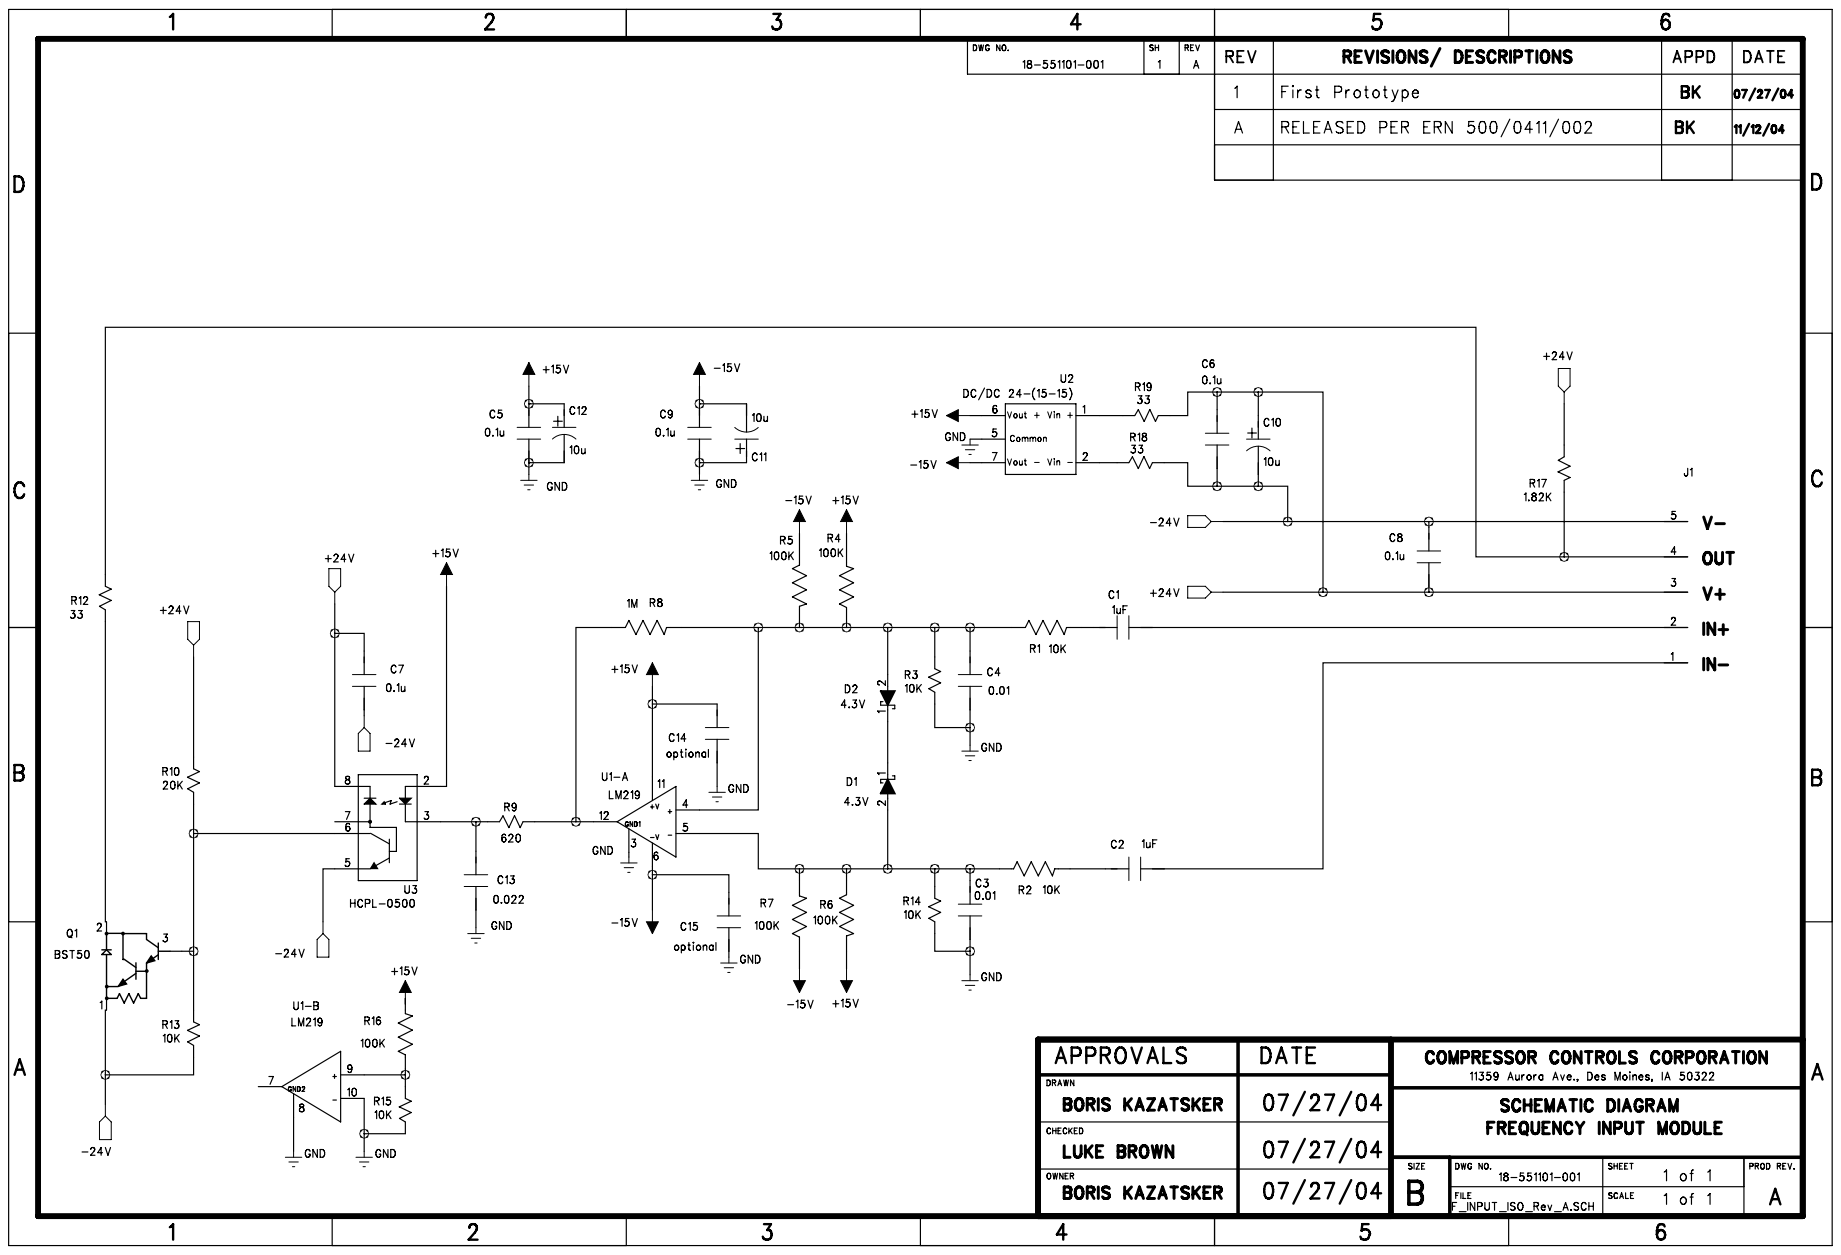
[picture p228: page 1]
