Sayidathahaseen/CCC_NGP_ODC/NGP_ODC_Main/PDLC/VanGuard/Client Docs/Vanguard/Schematic_Vanguard Duplex Backplane.pdf

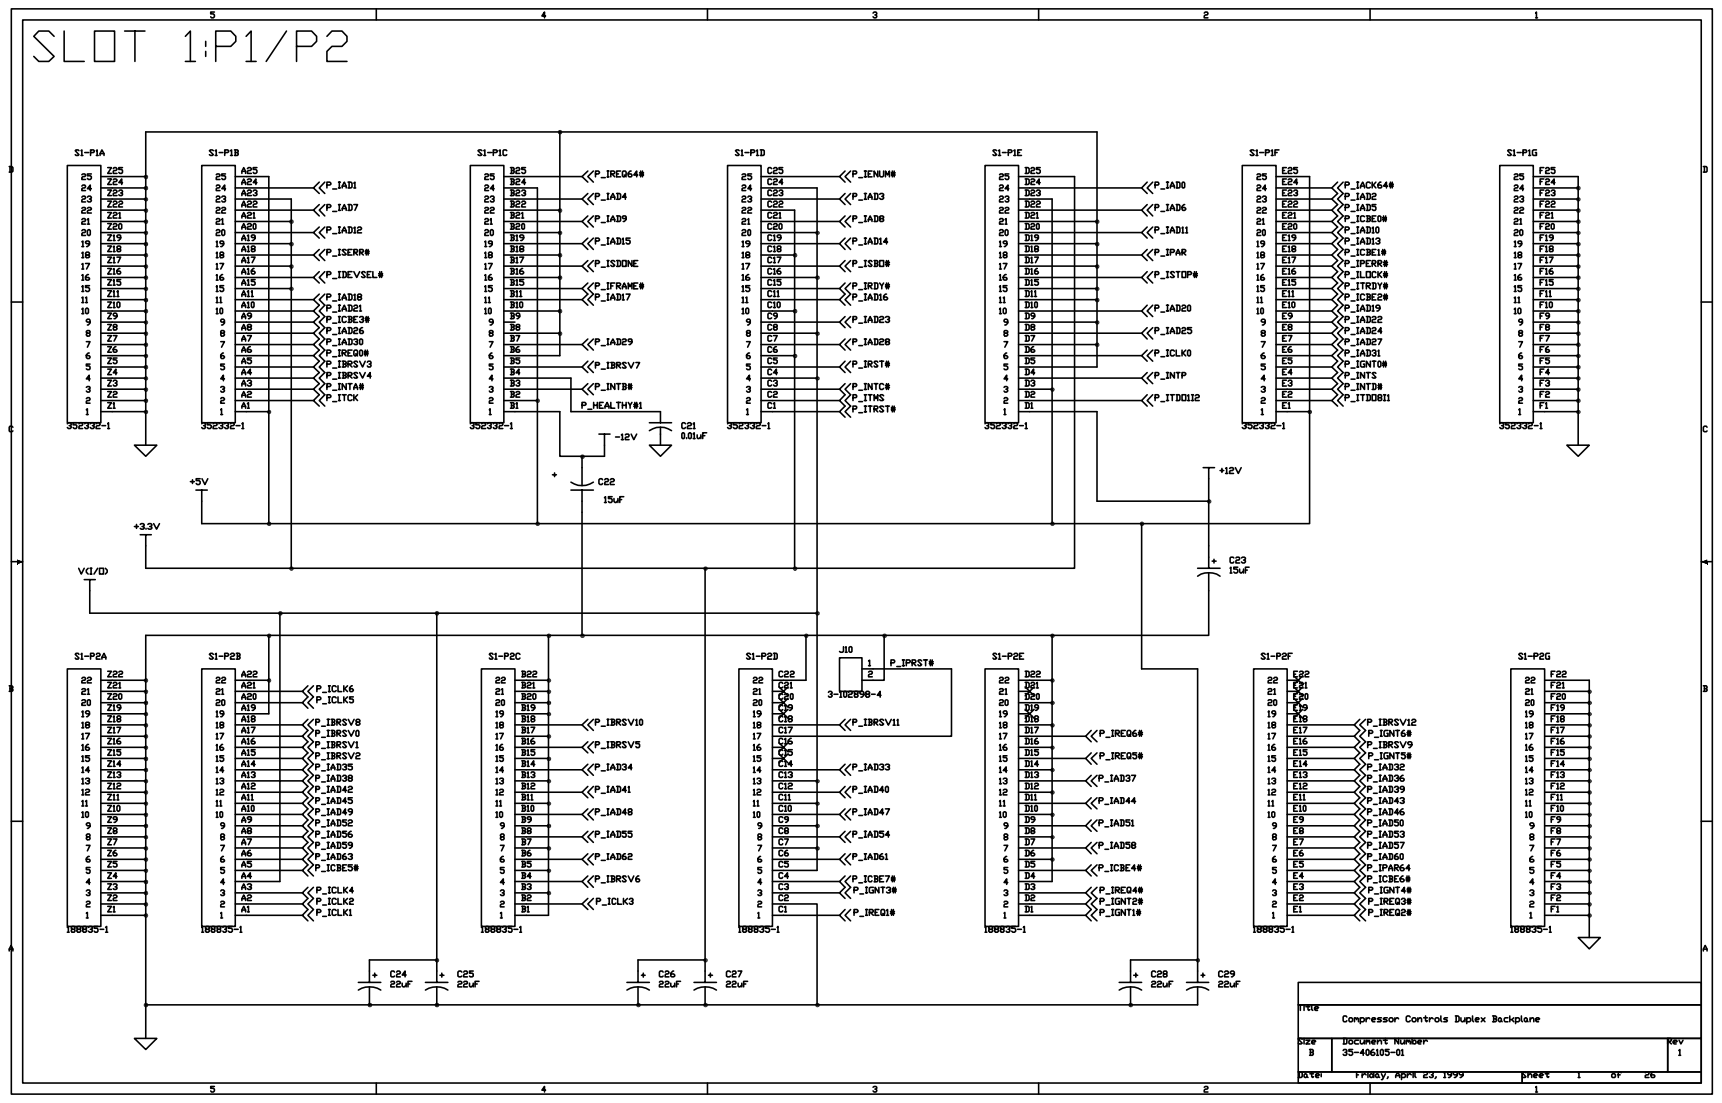
[picture p229: page 1]

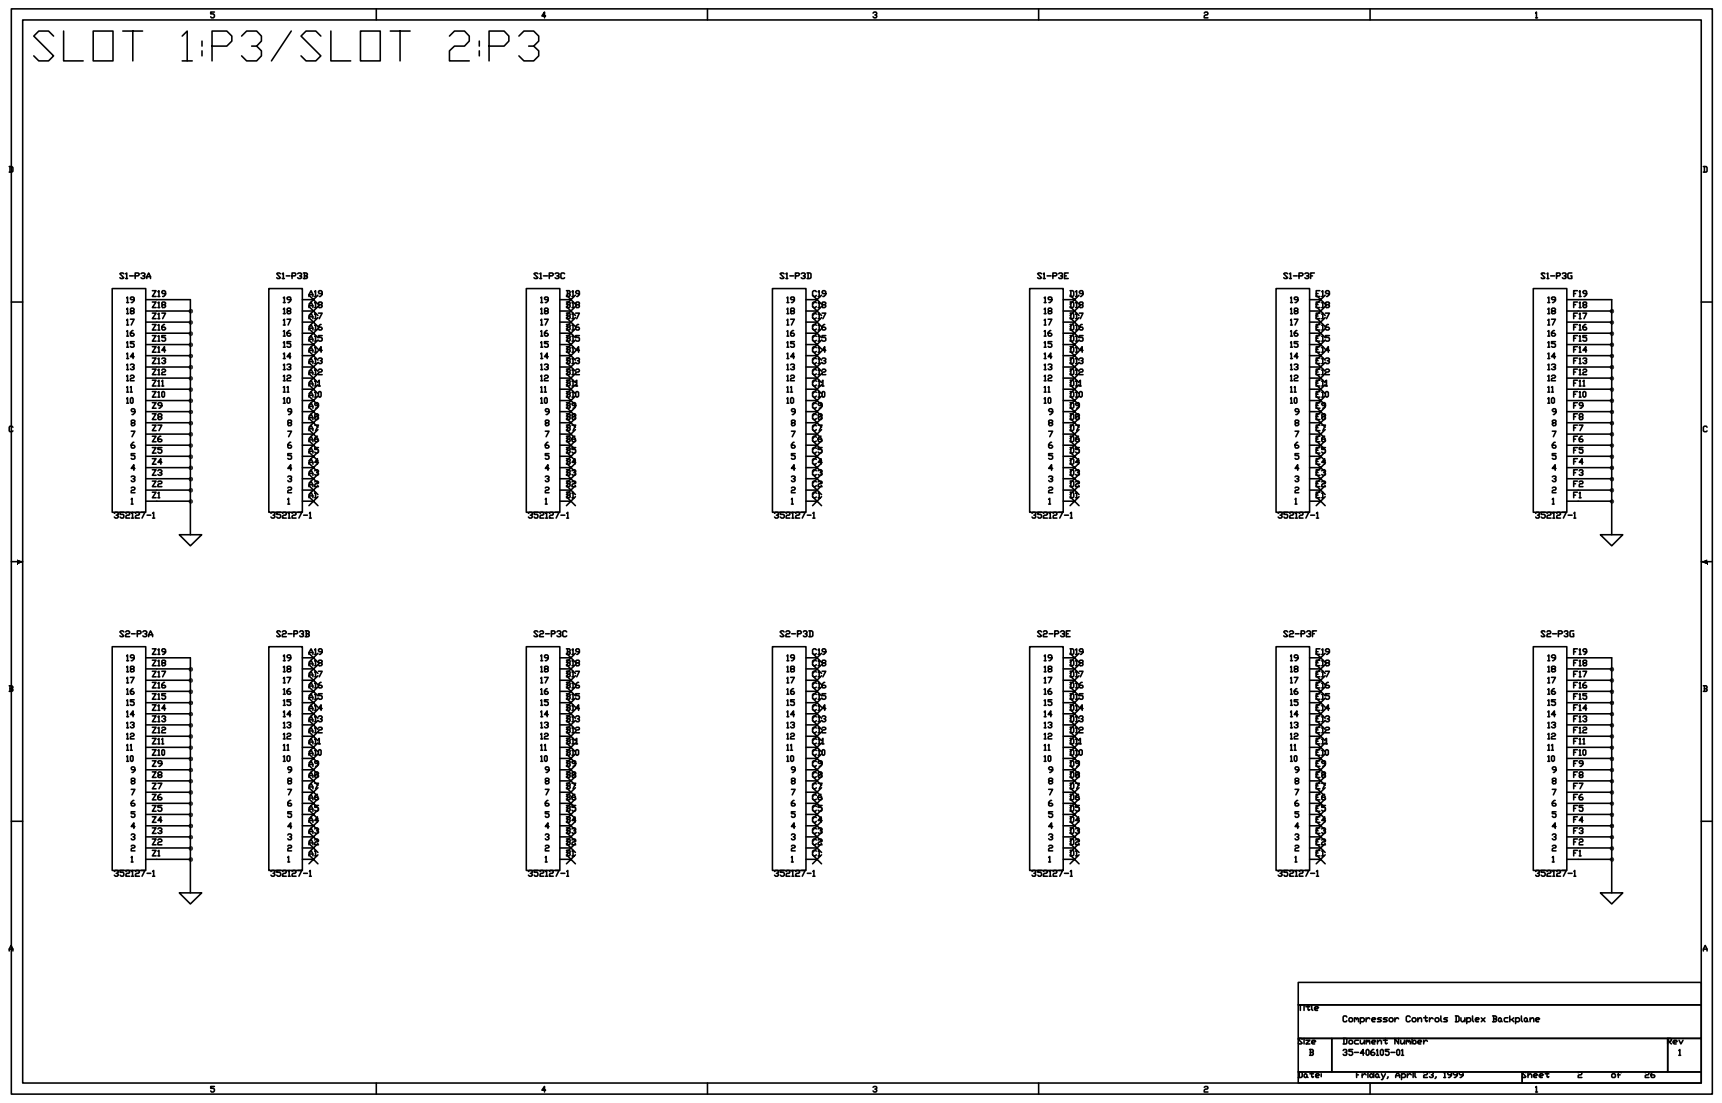
[picture p230: page 2]

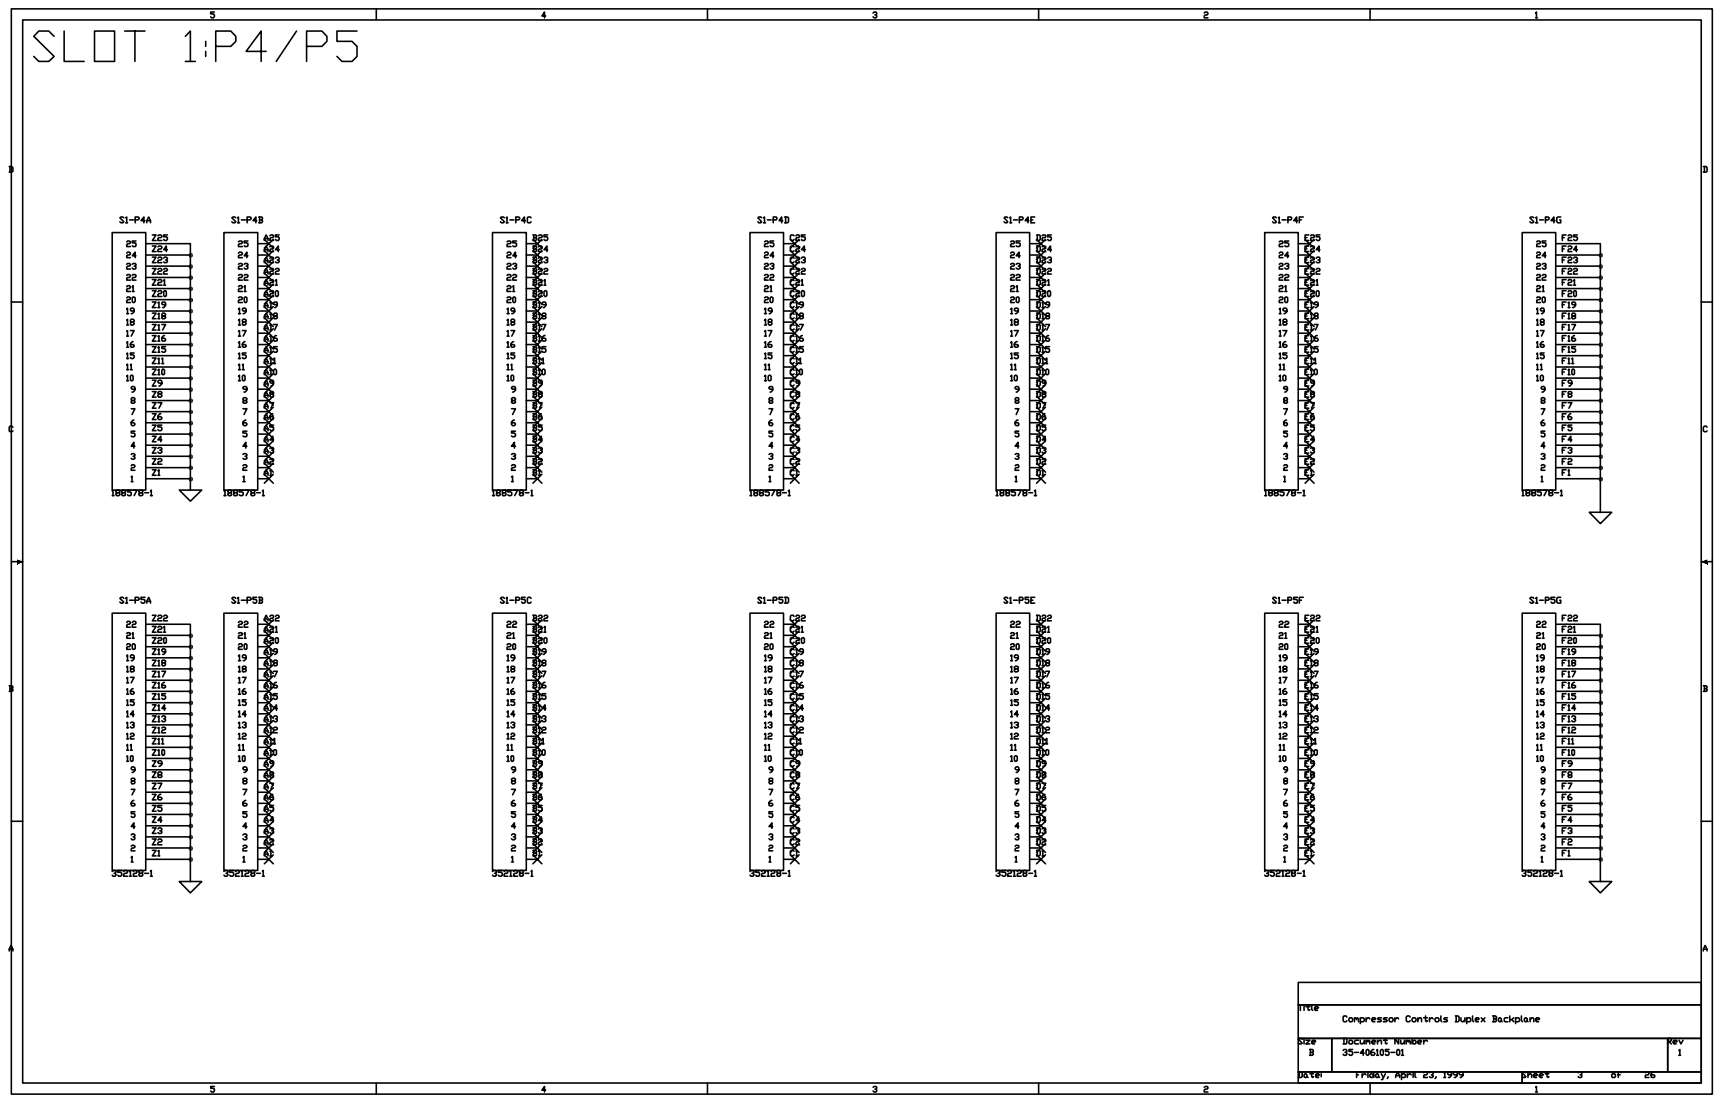
[picture p231: page 3]

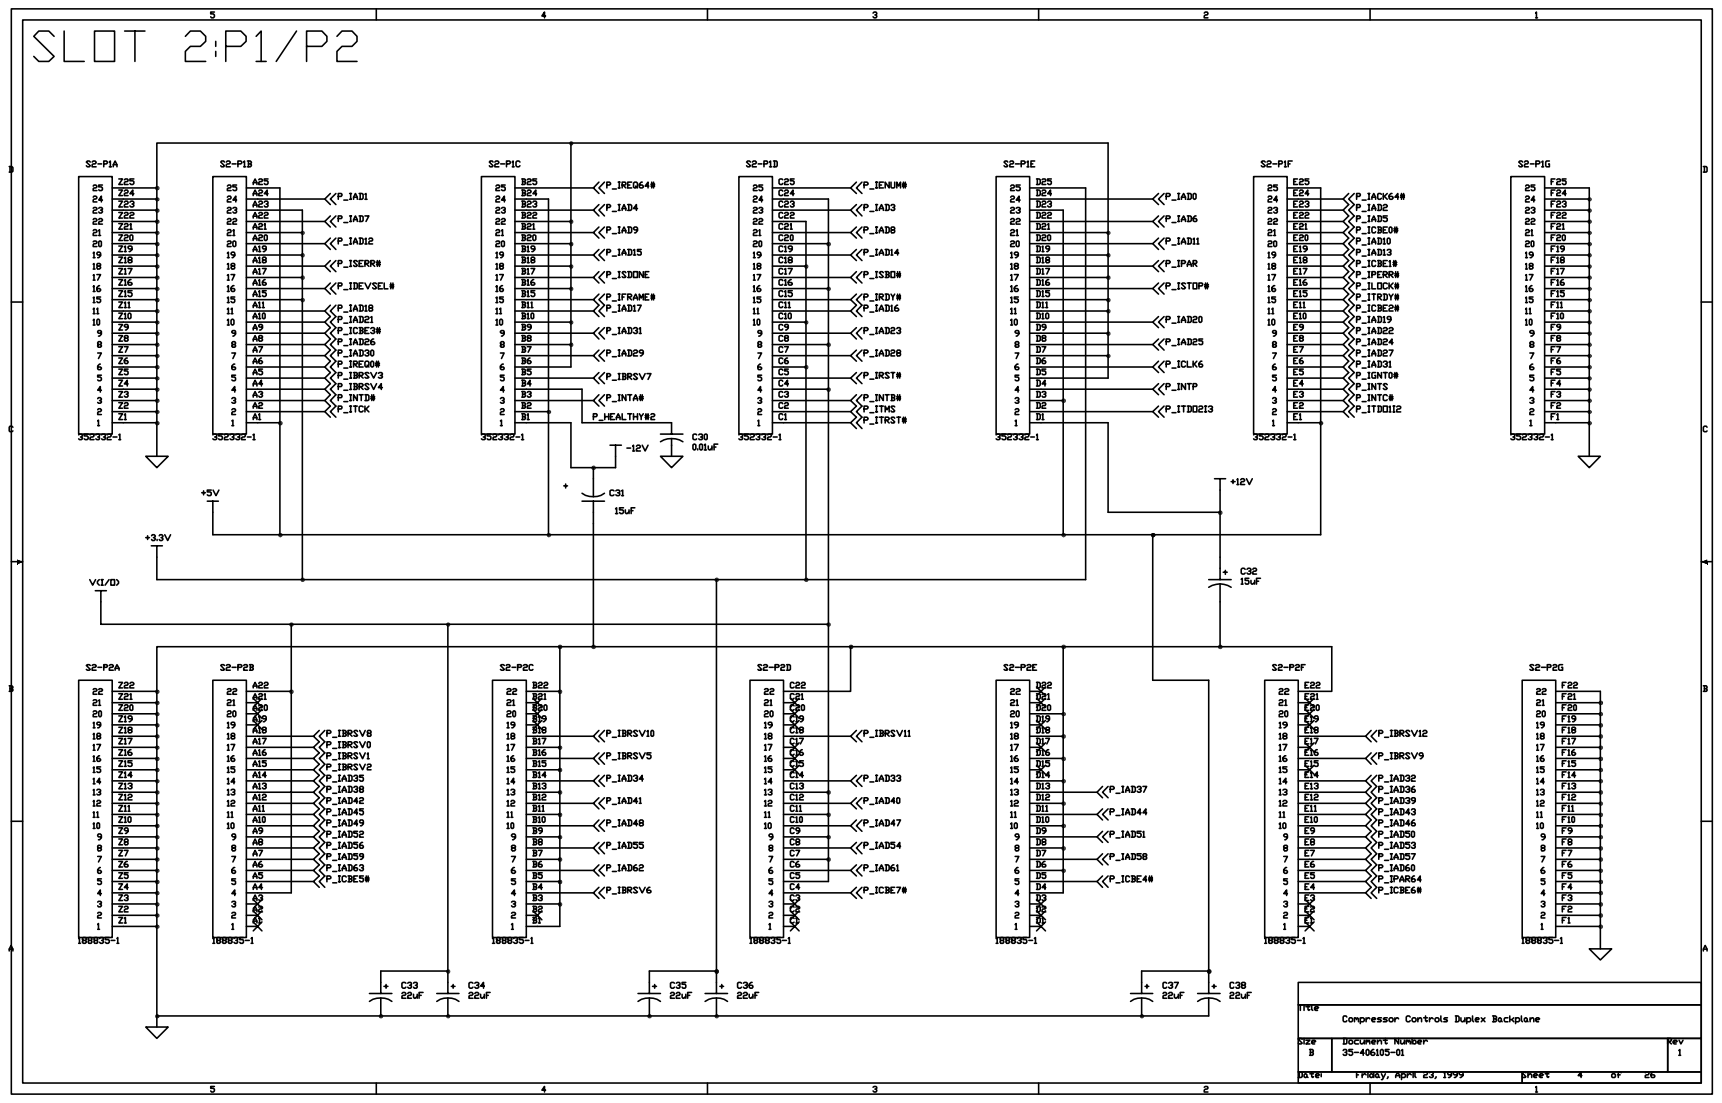
[picture p232: page 4]

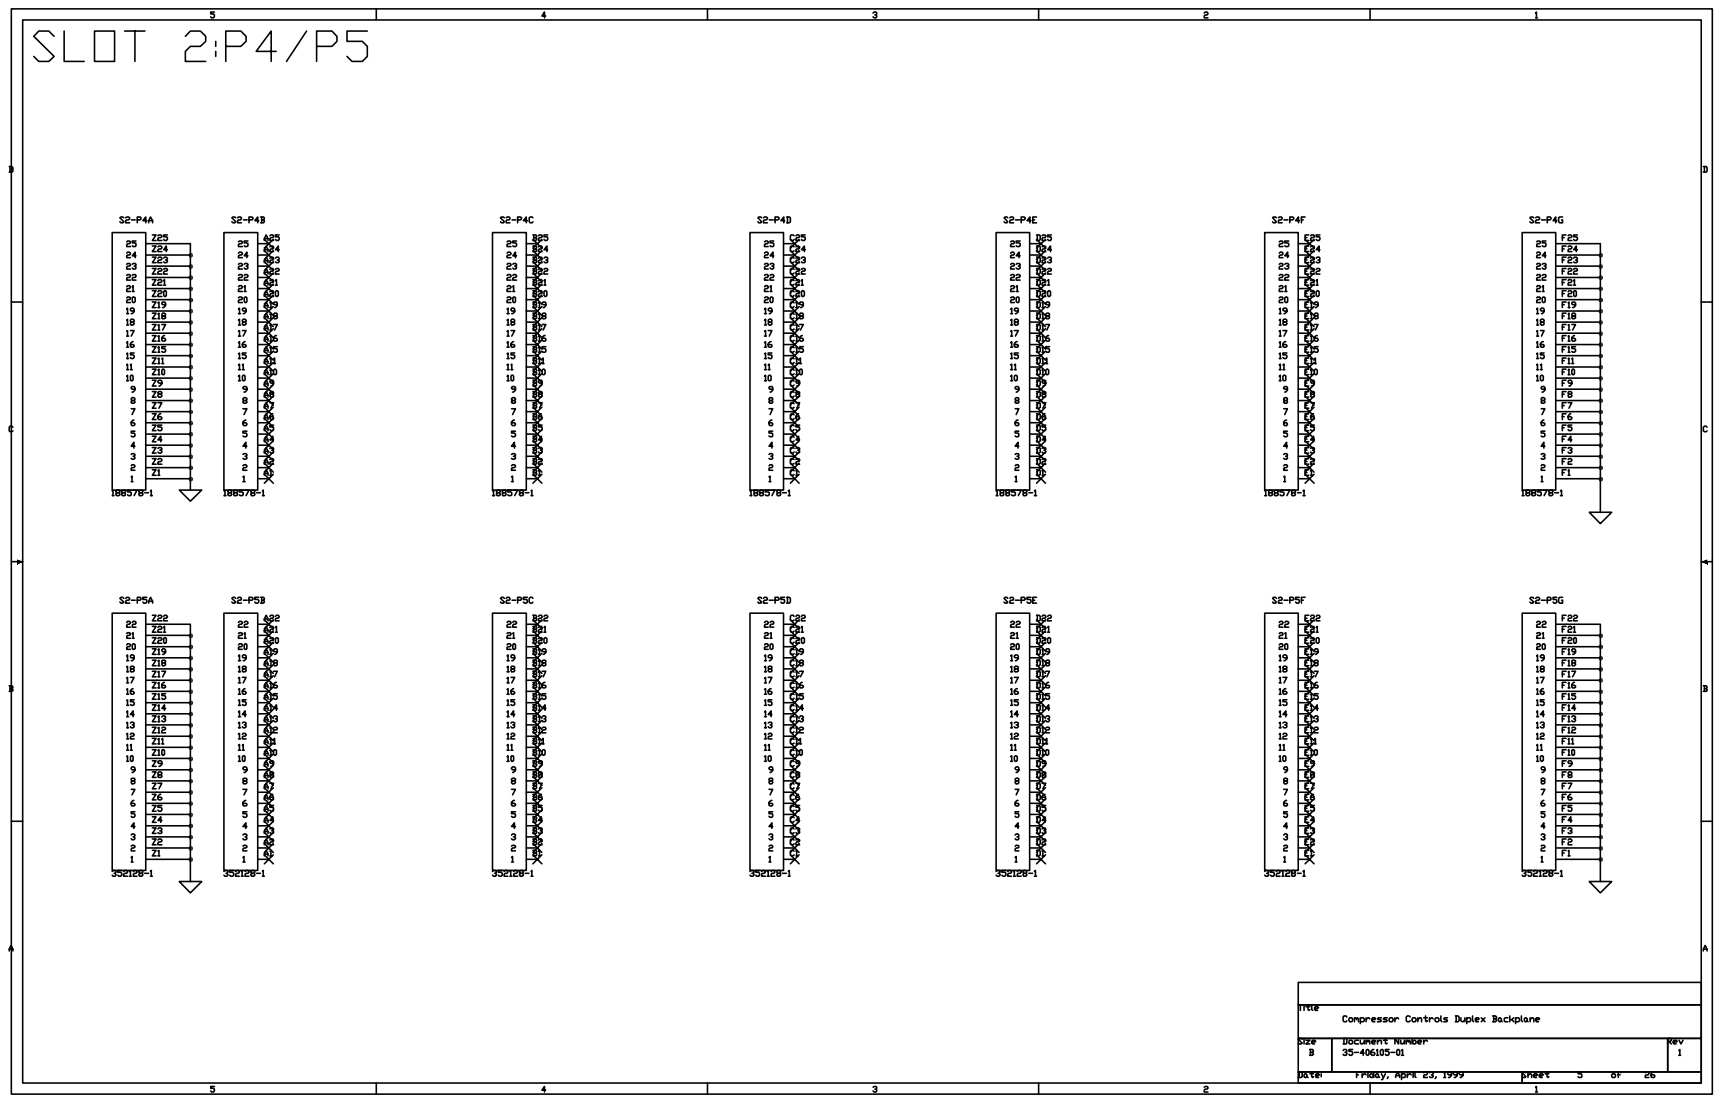
[picture p233: page 5]

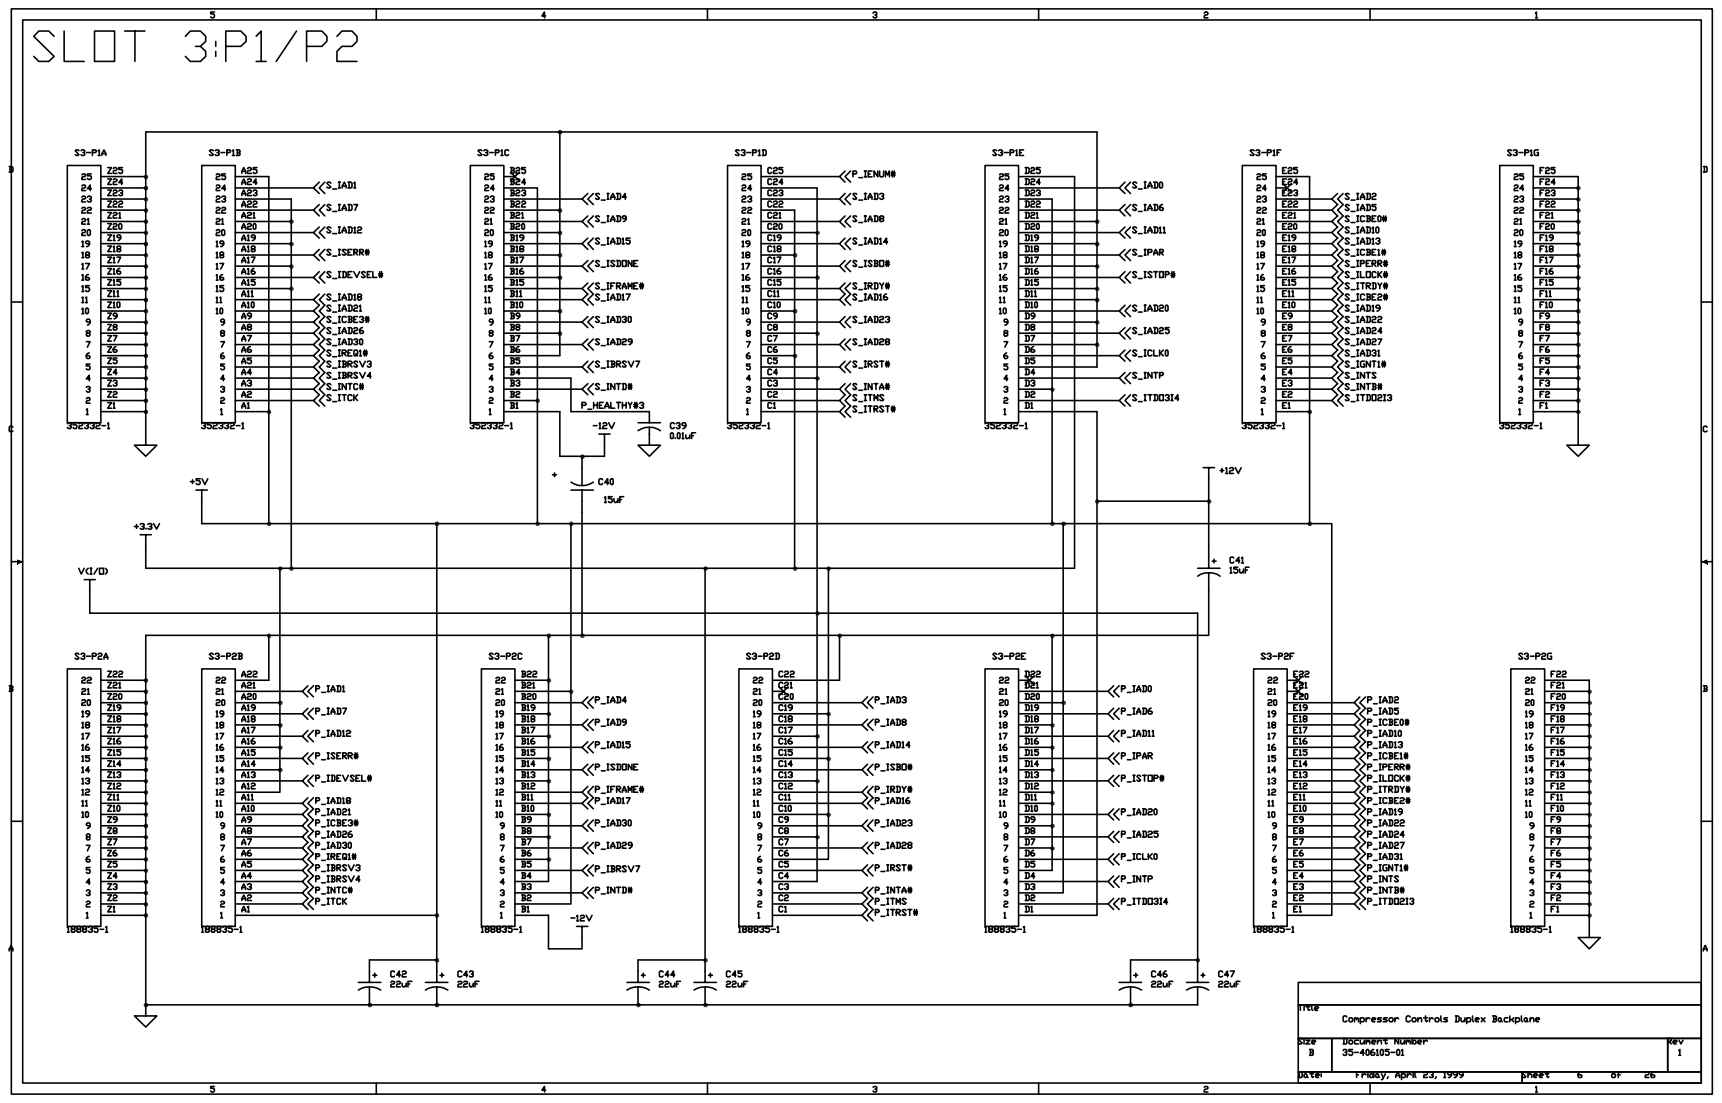
[picture p234: page 6]

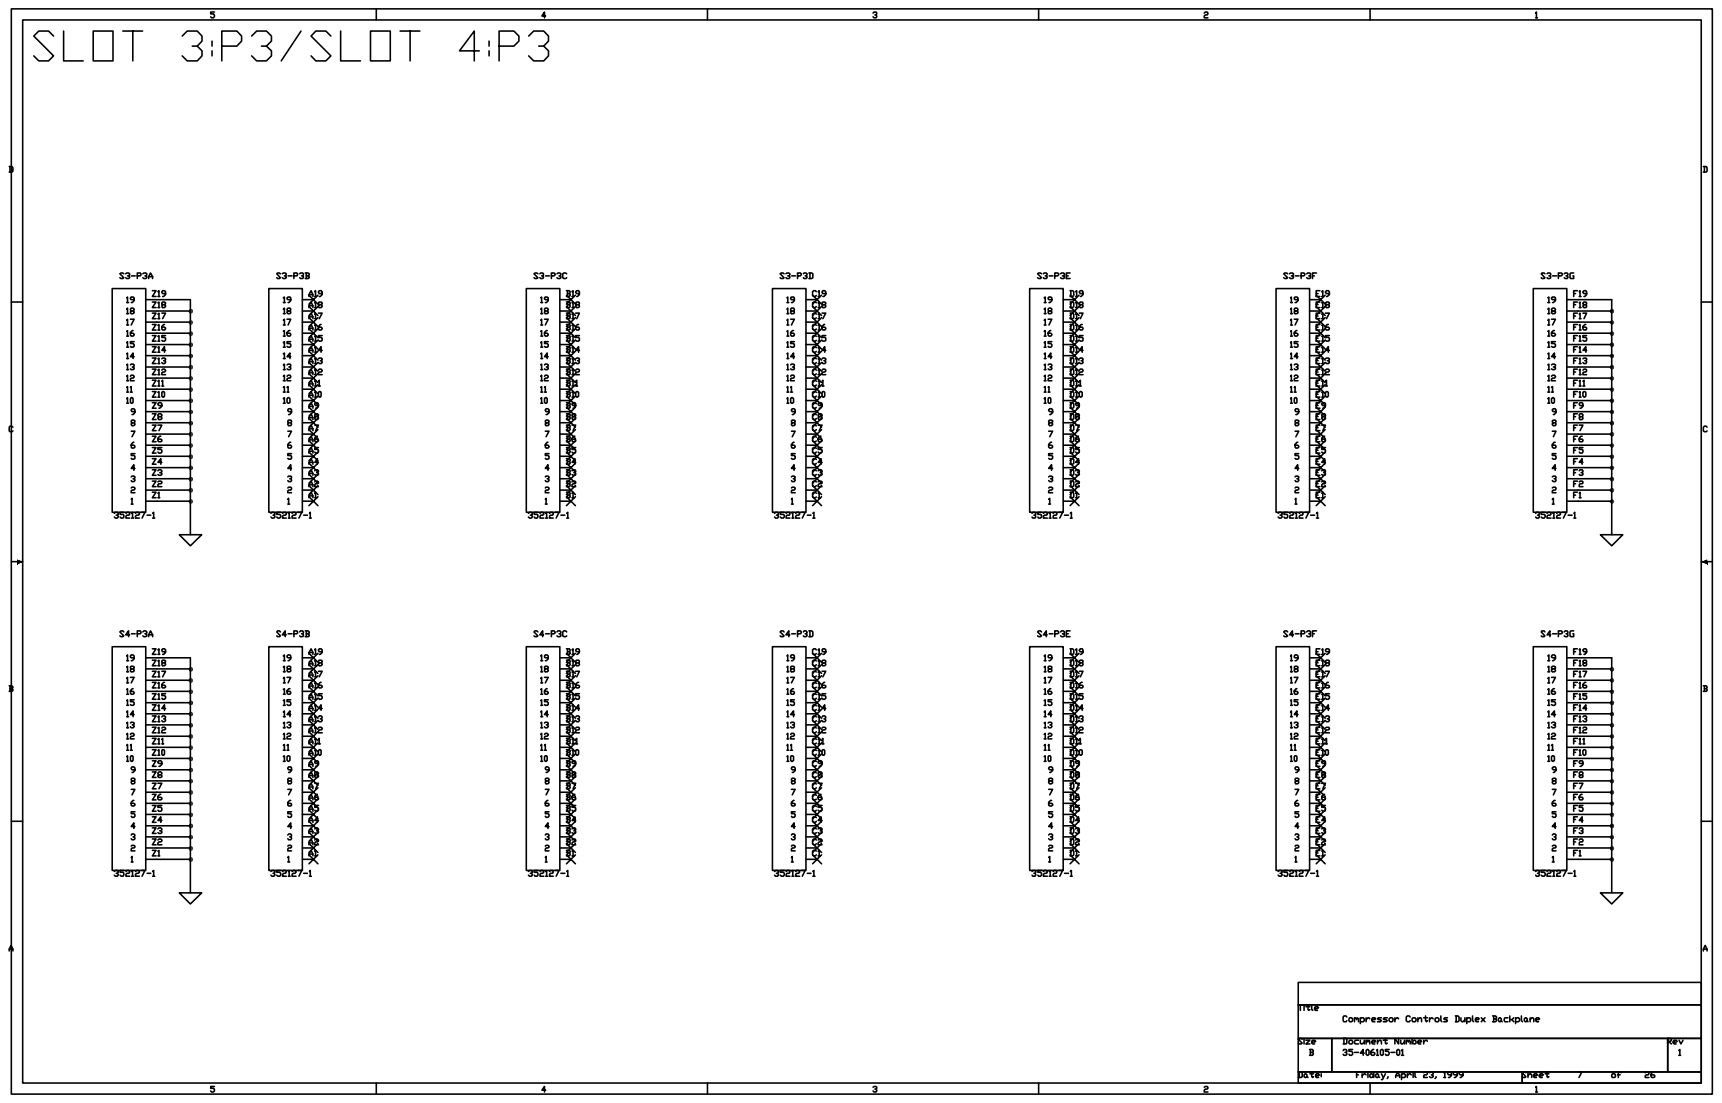
[picture p235: page 7]

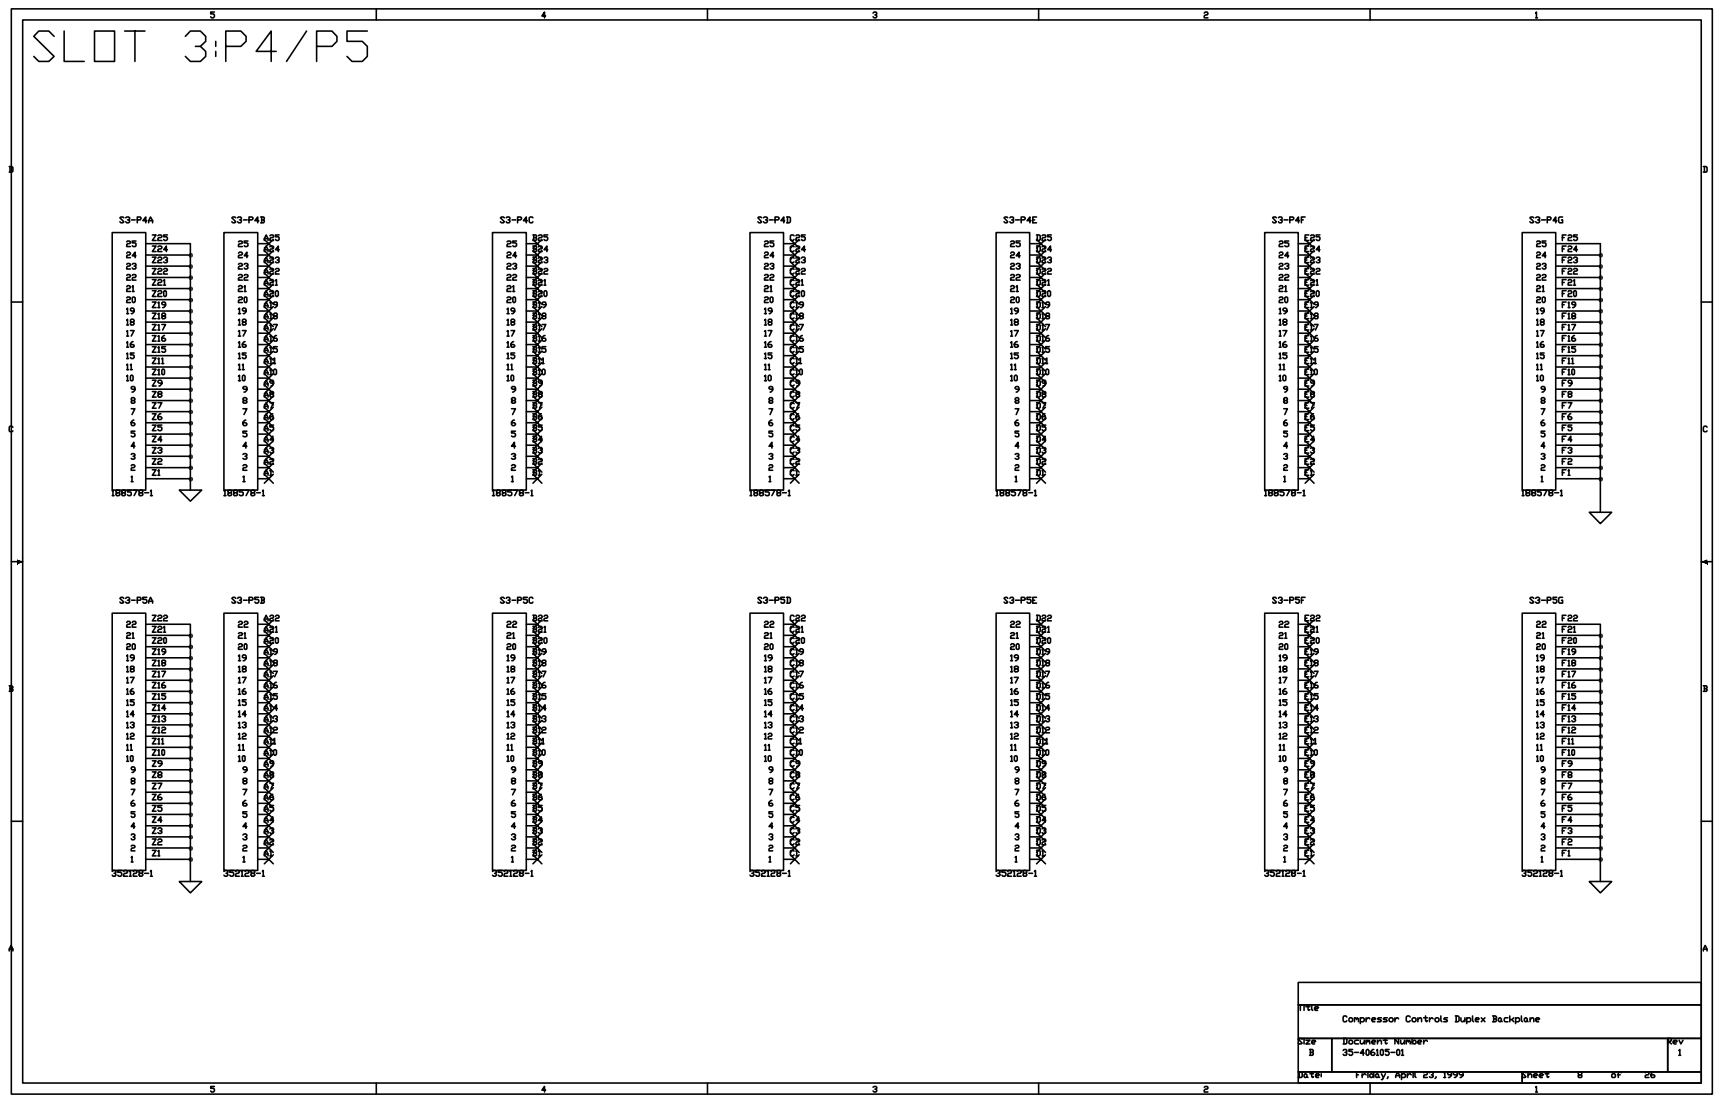
[picture p236: page 8]

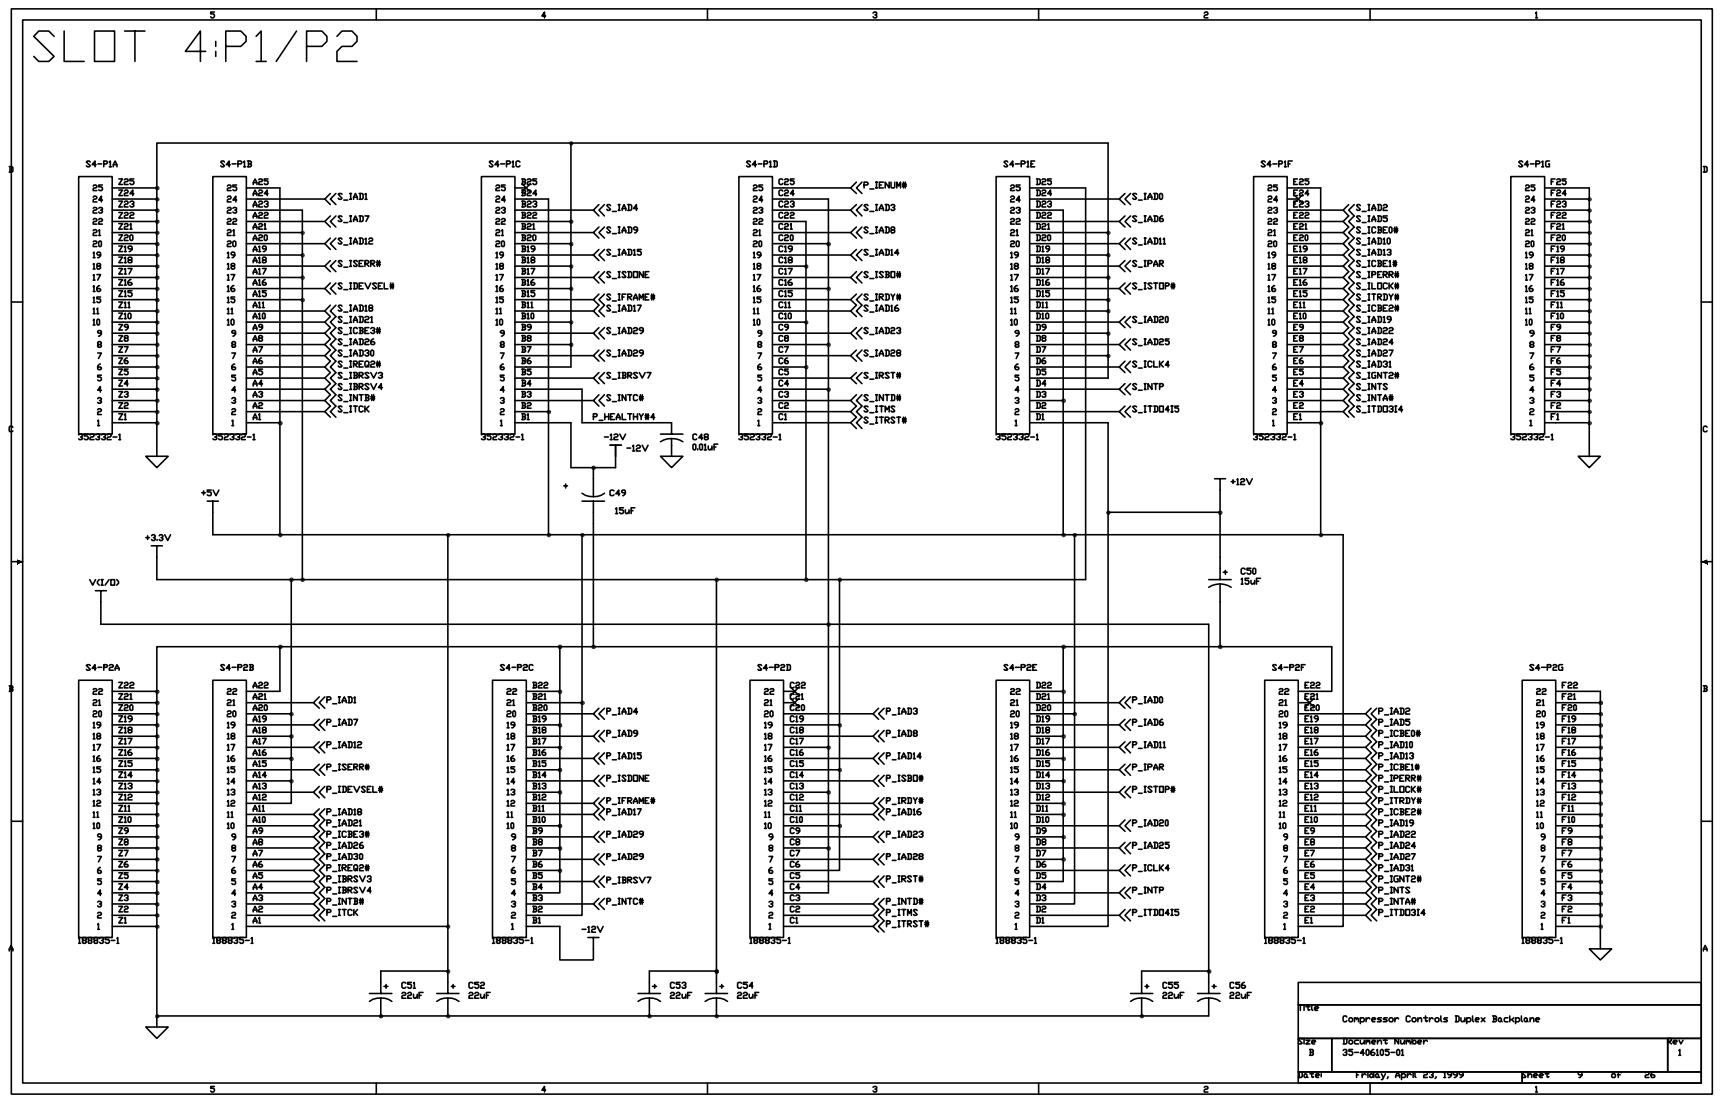
[picture p237: page 9]

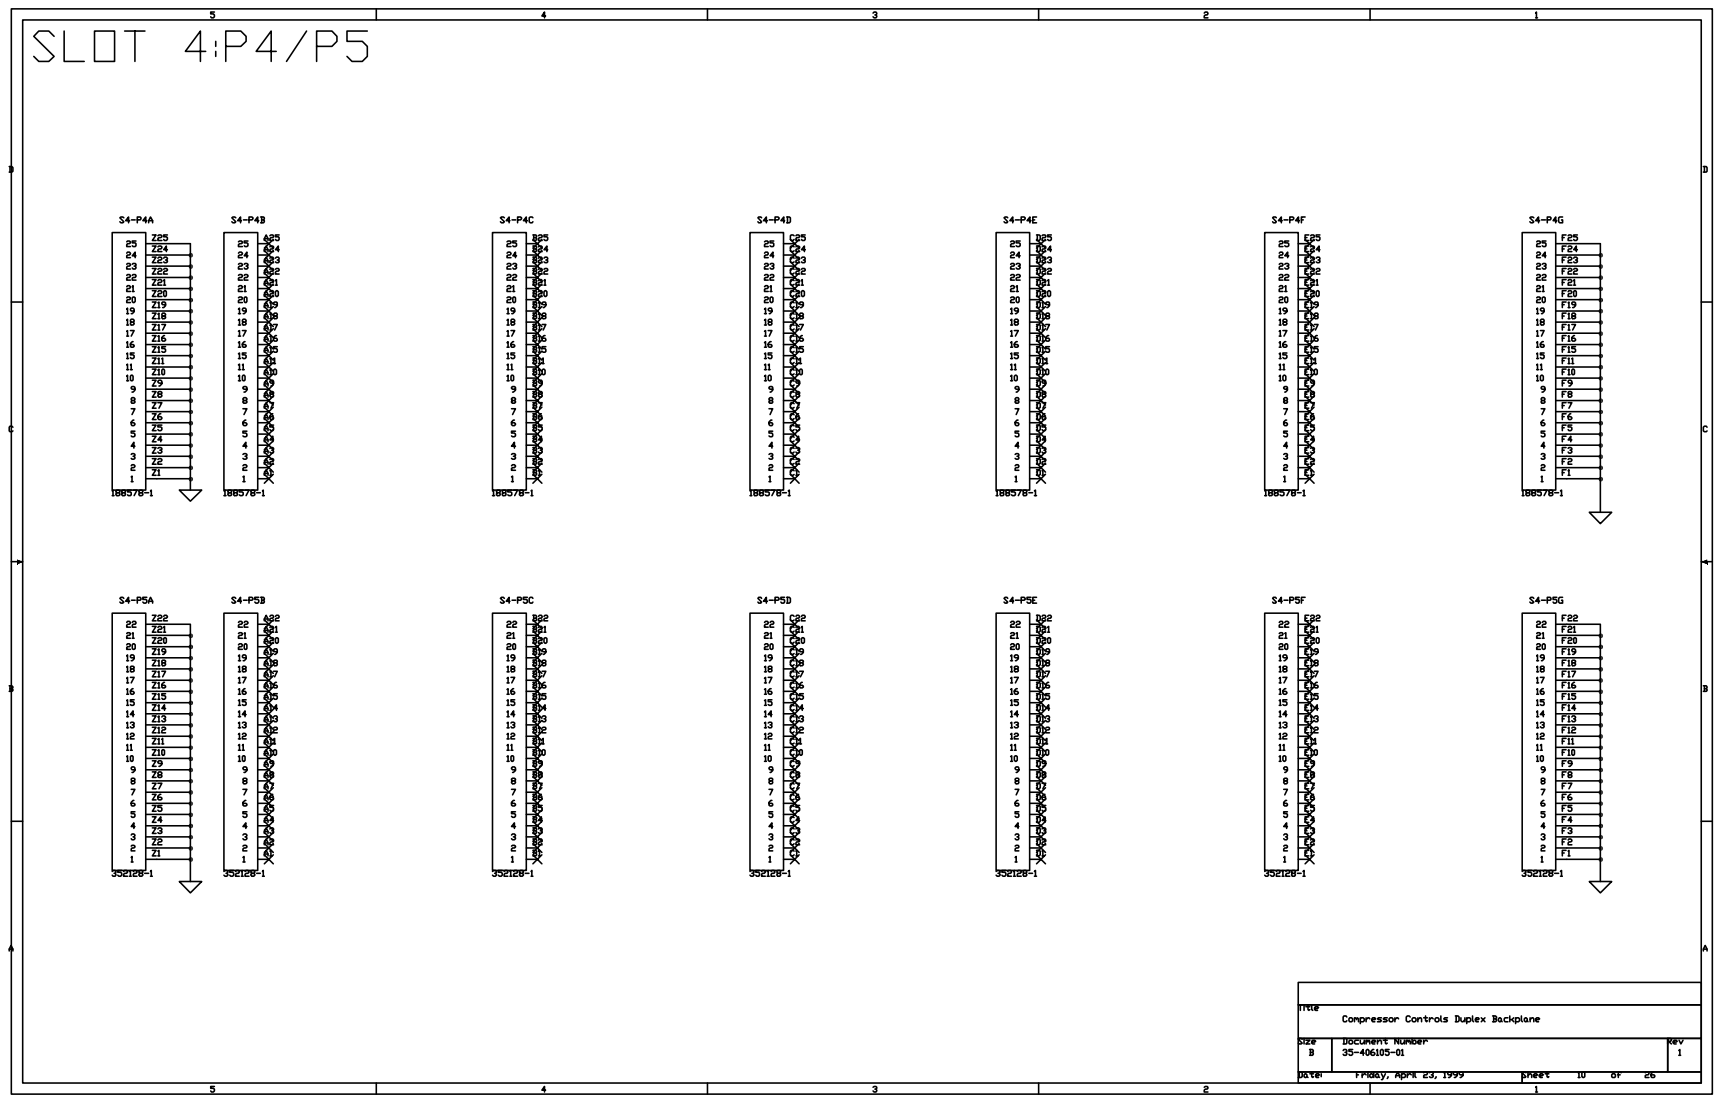
[picture p238: page 10]

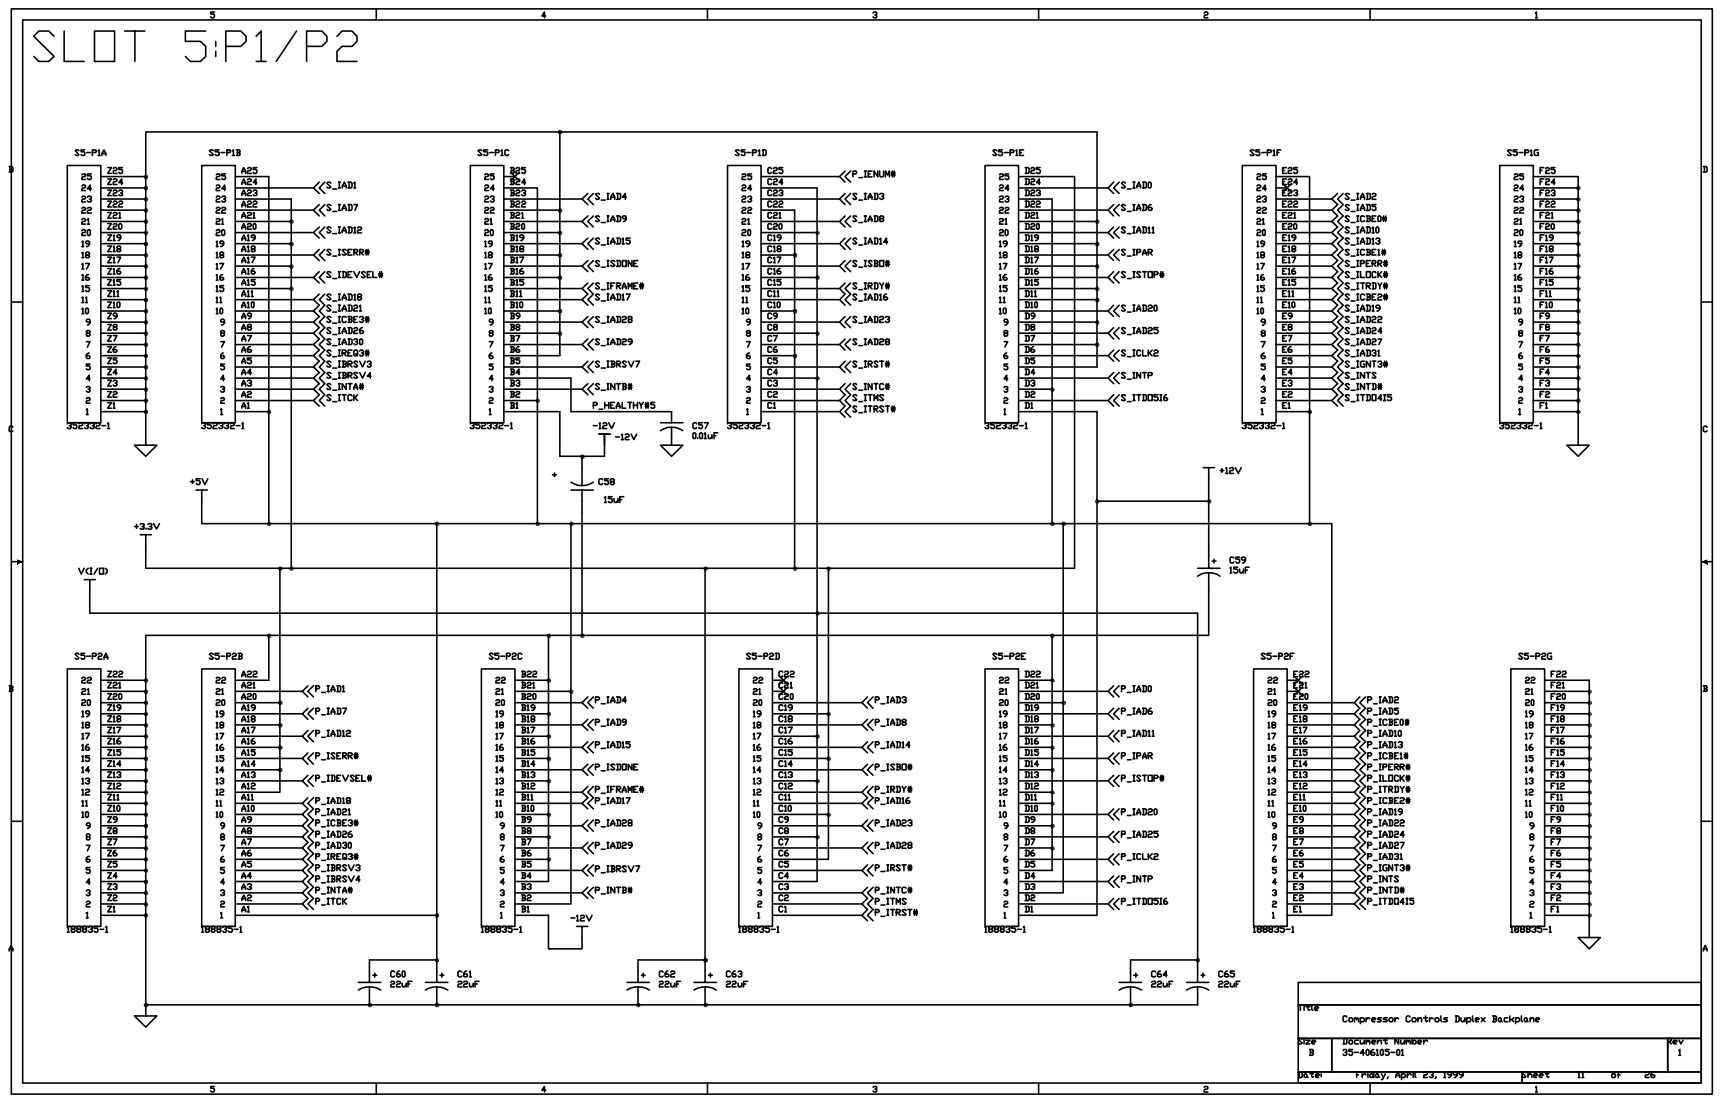
[picture p239: page 11]

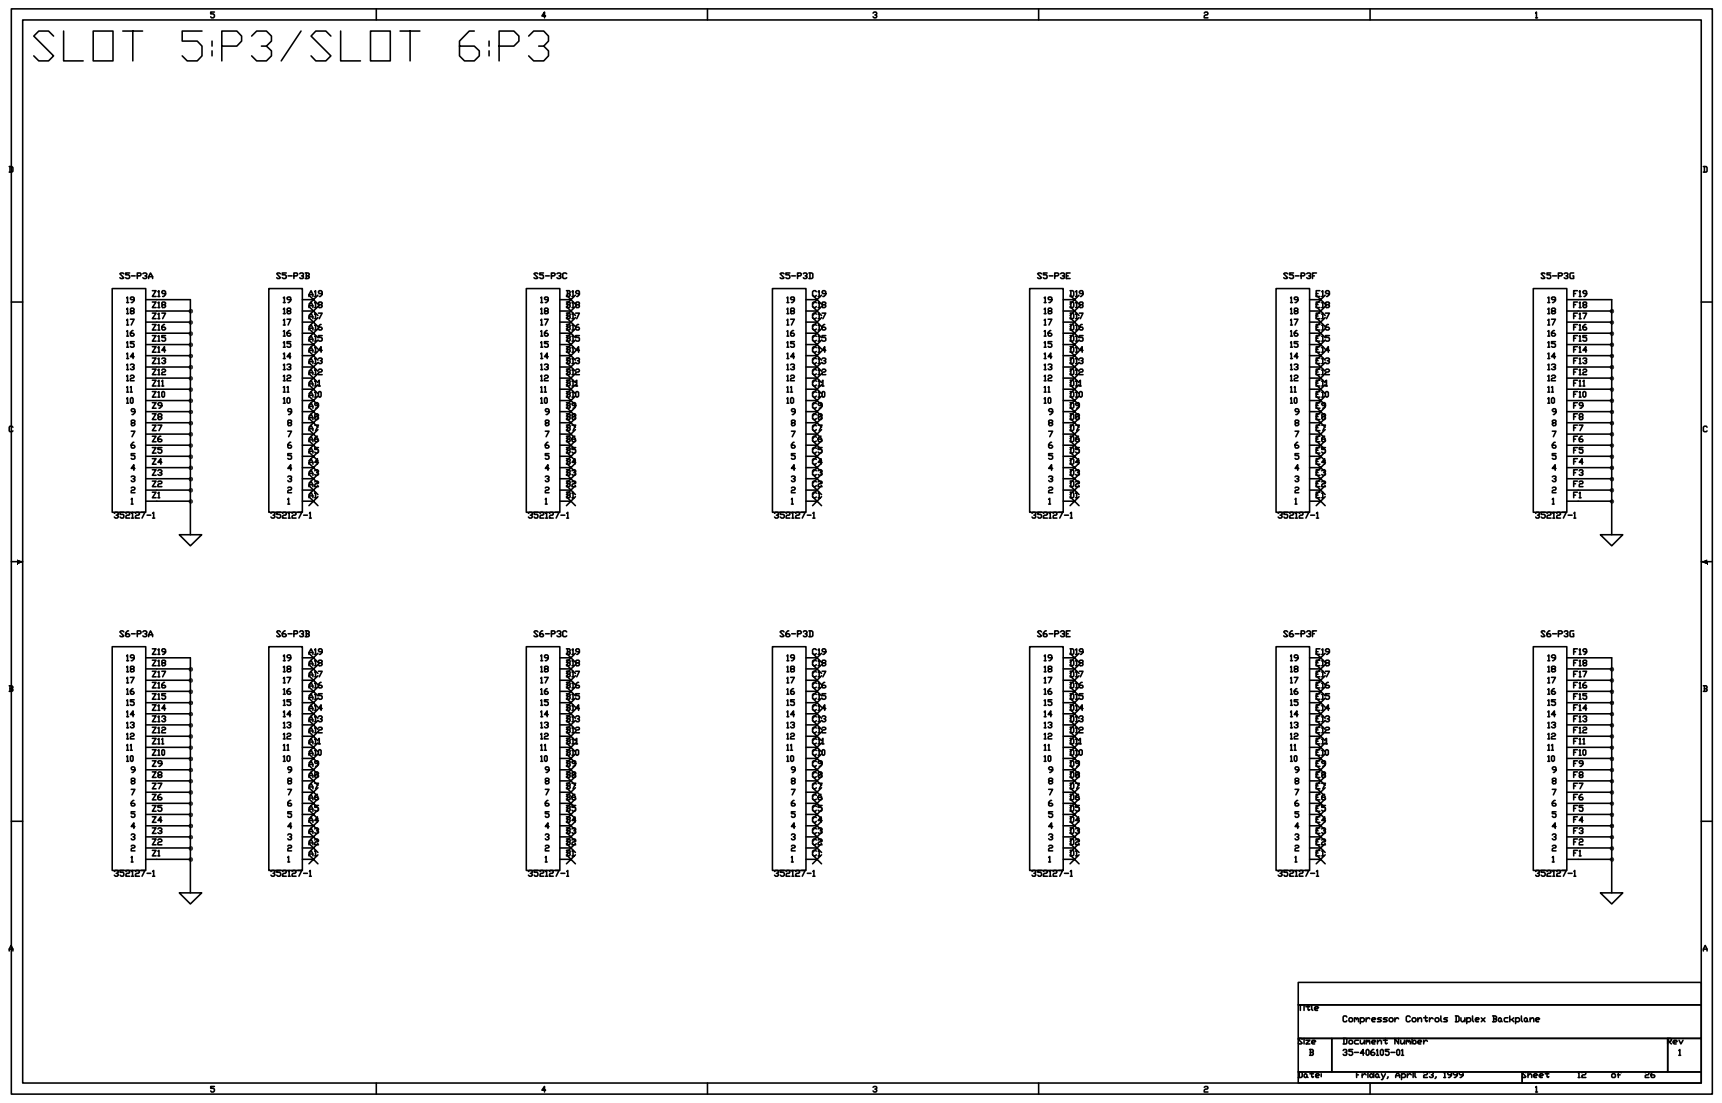
[picture p240: page 12]

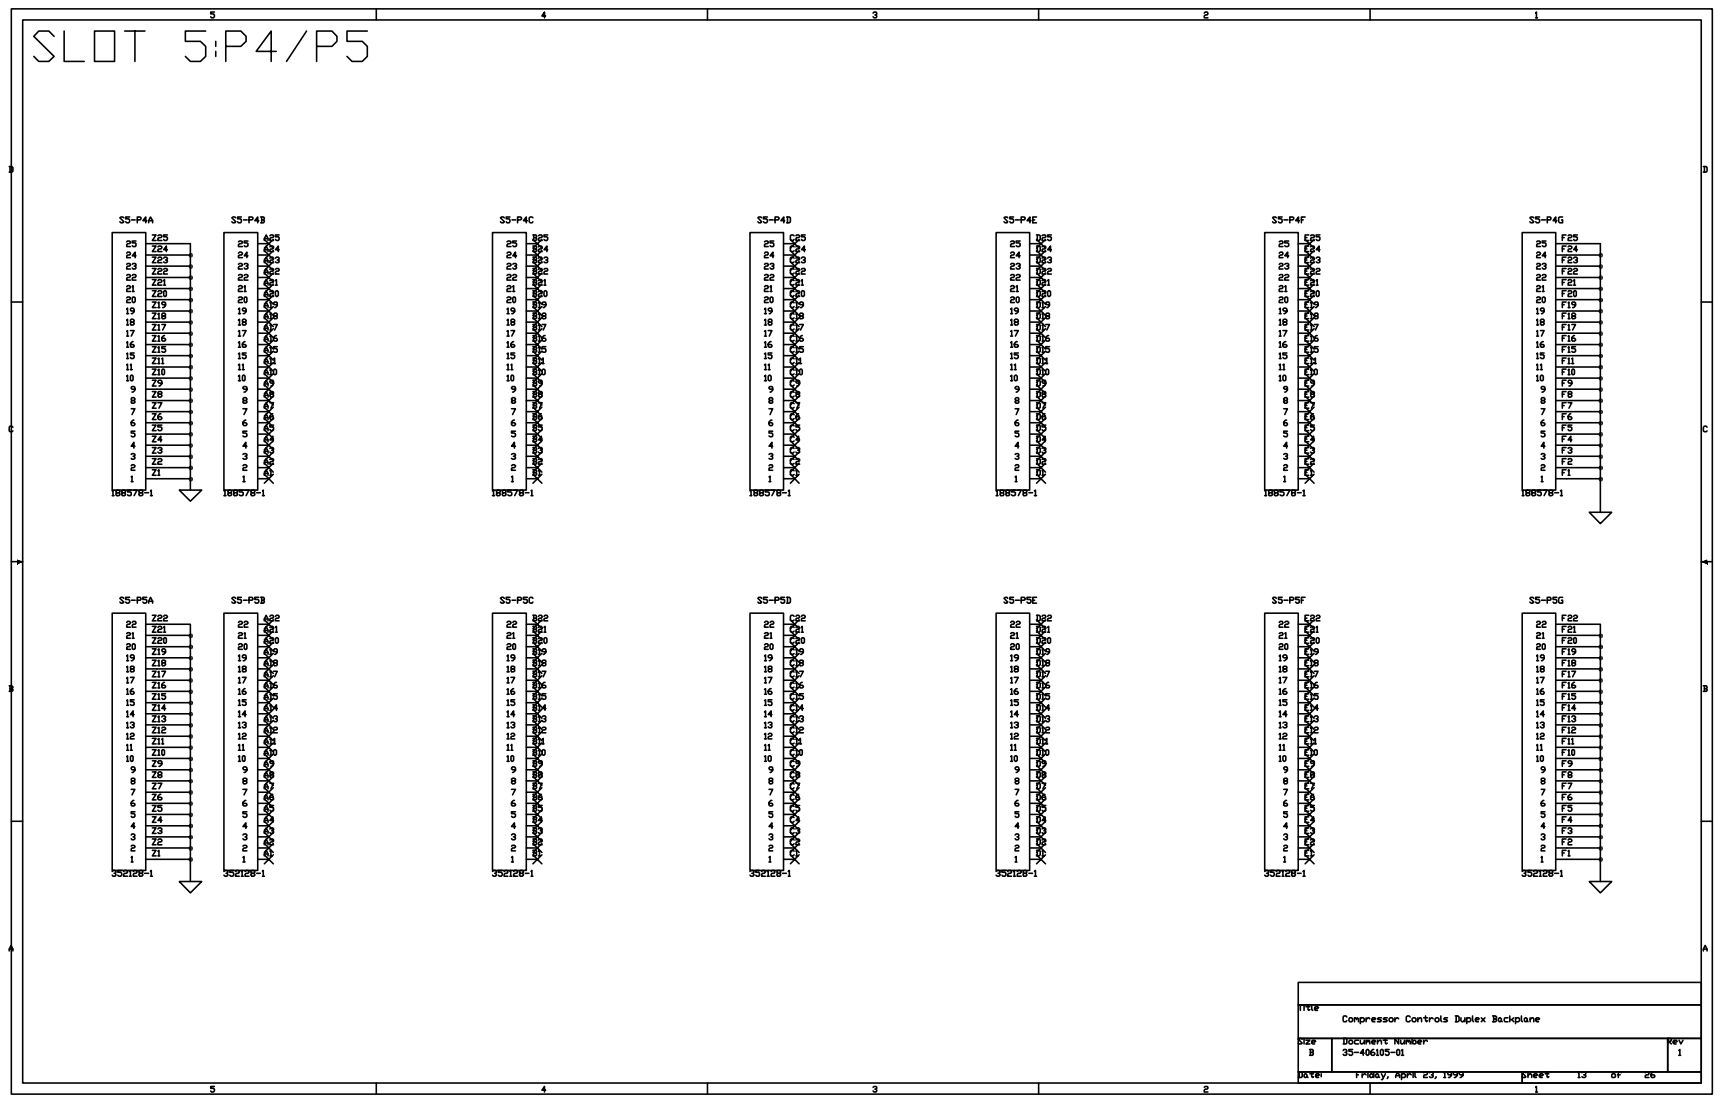
[picture p241: page 13]

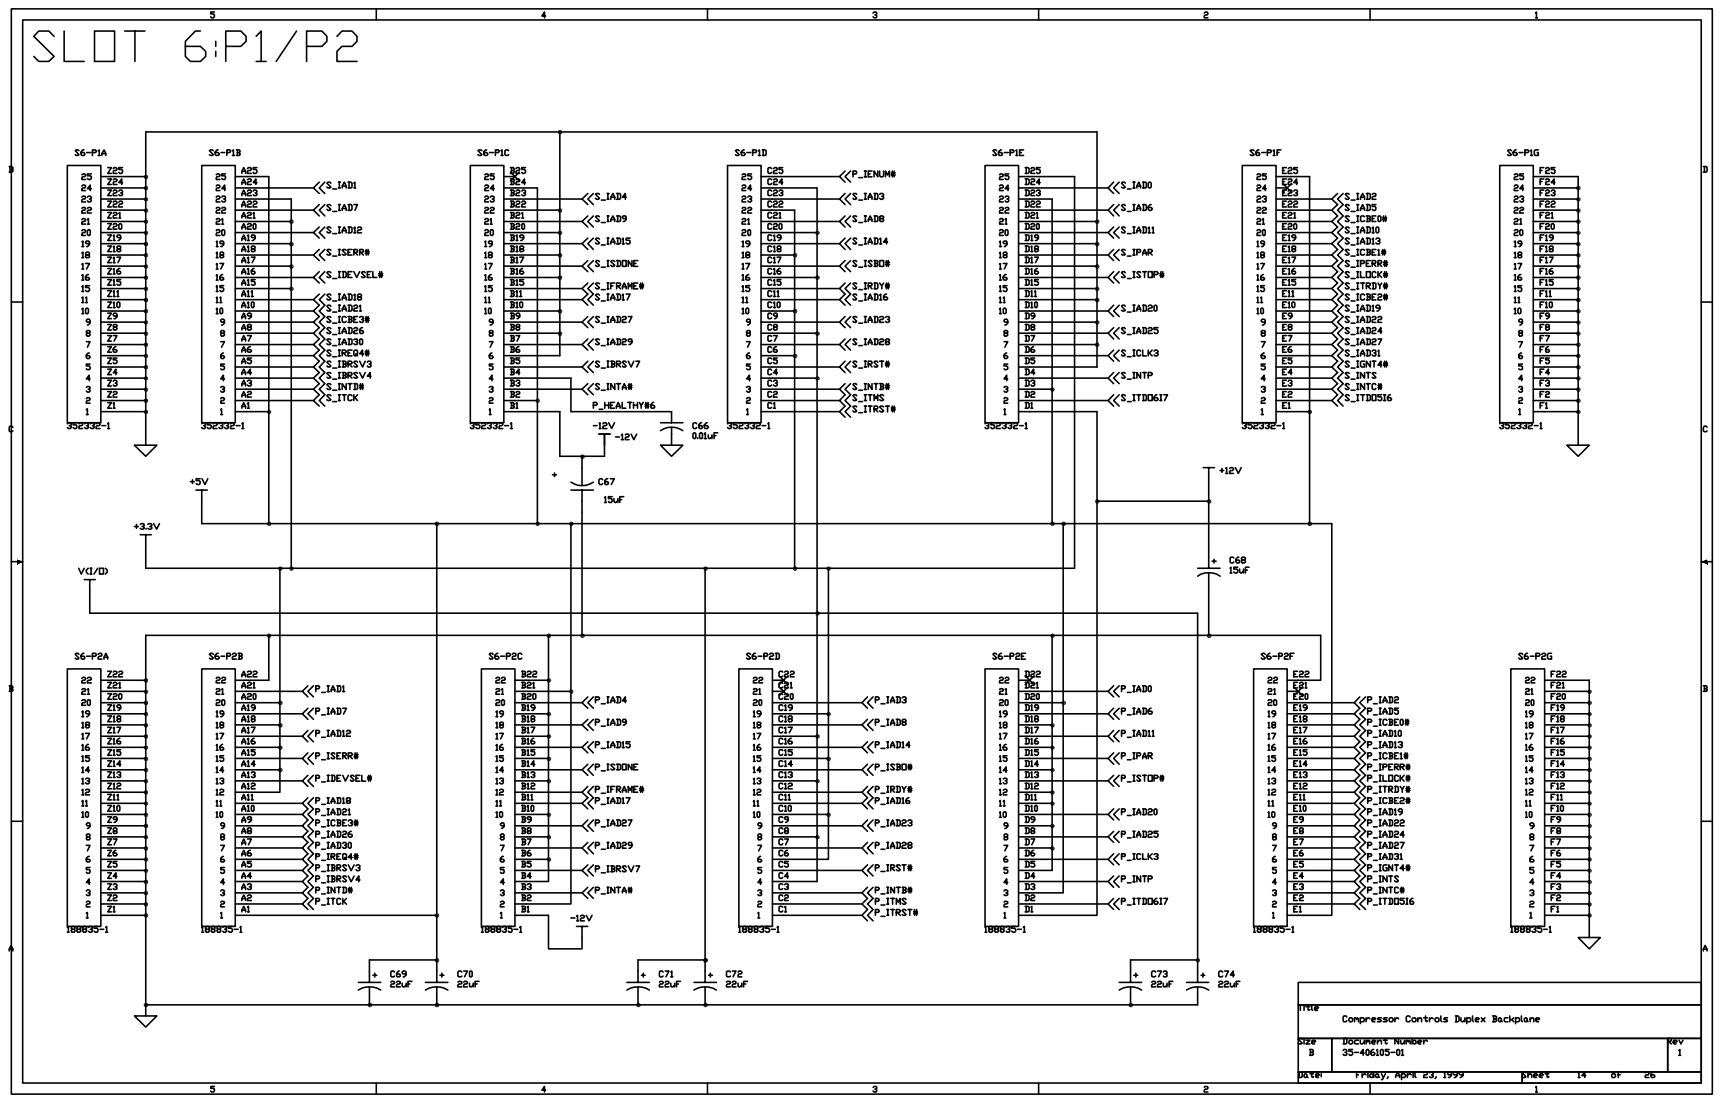
[picture p242: page 14]

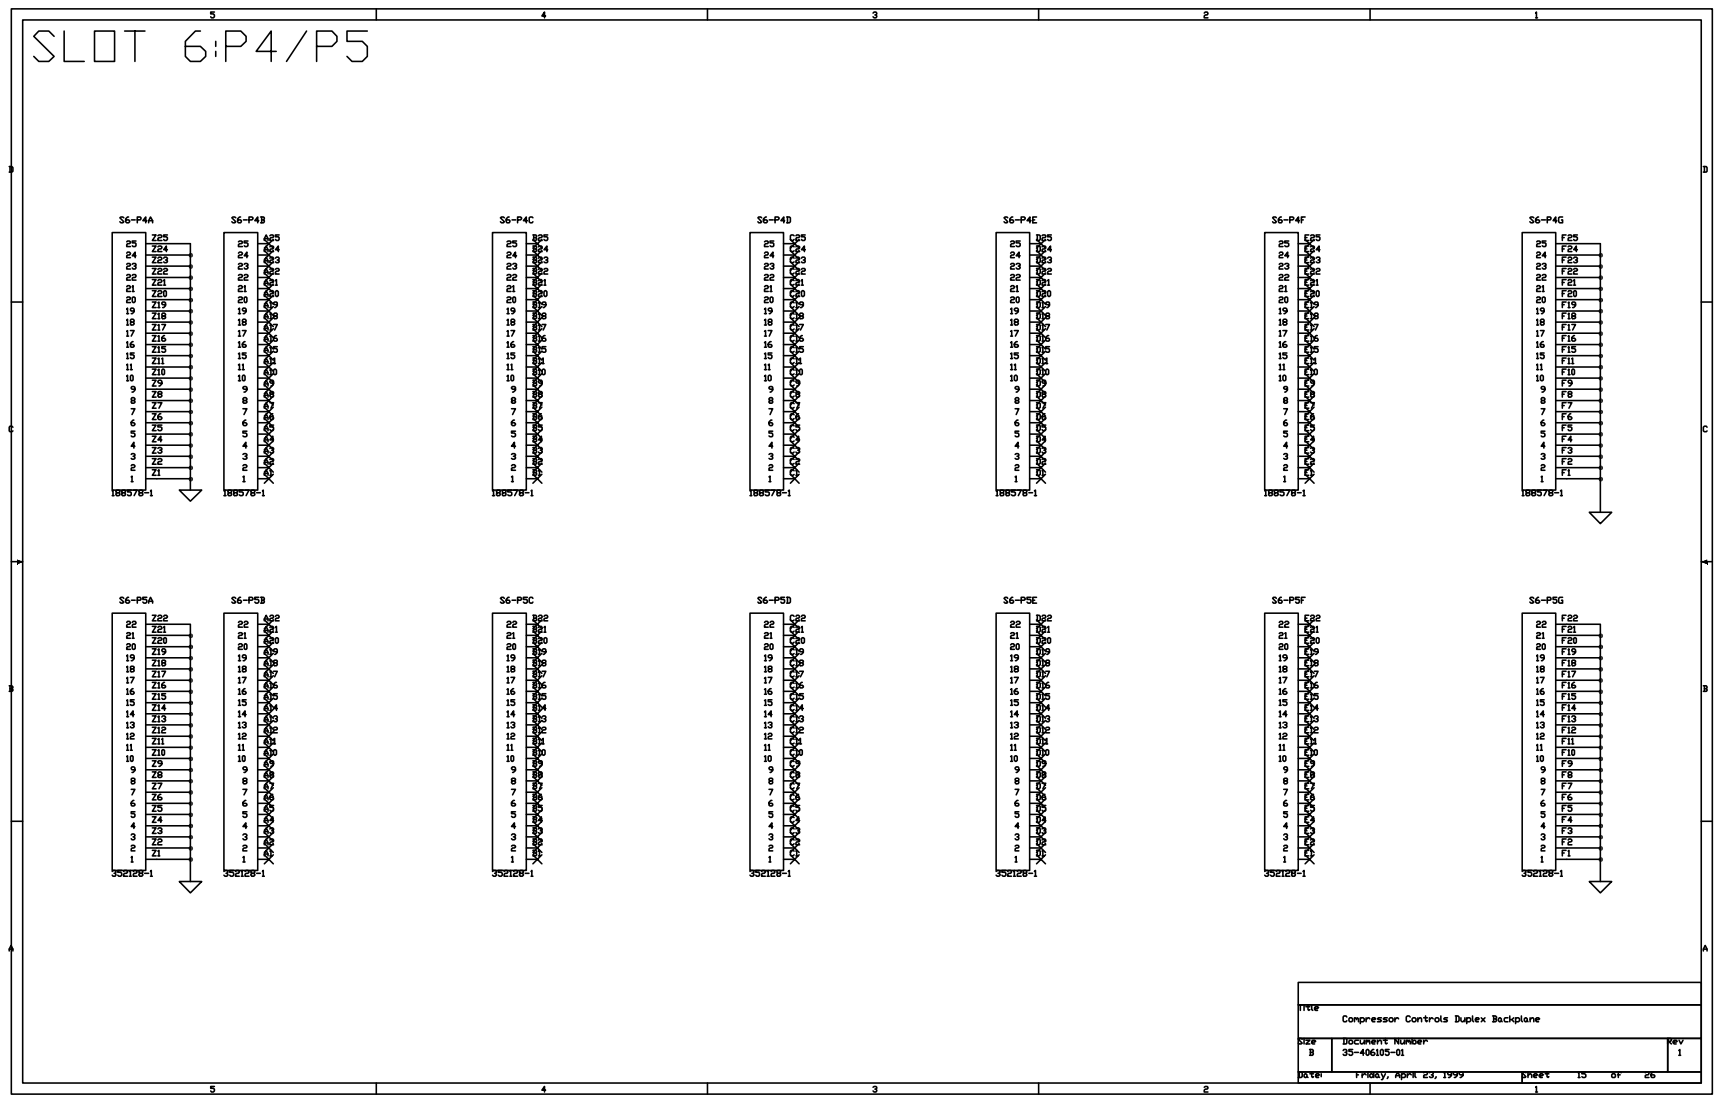
[picture p243: page 15]

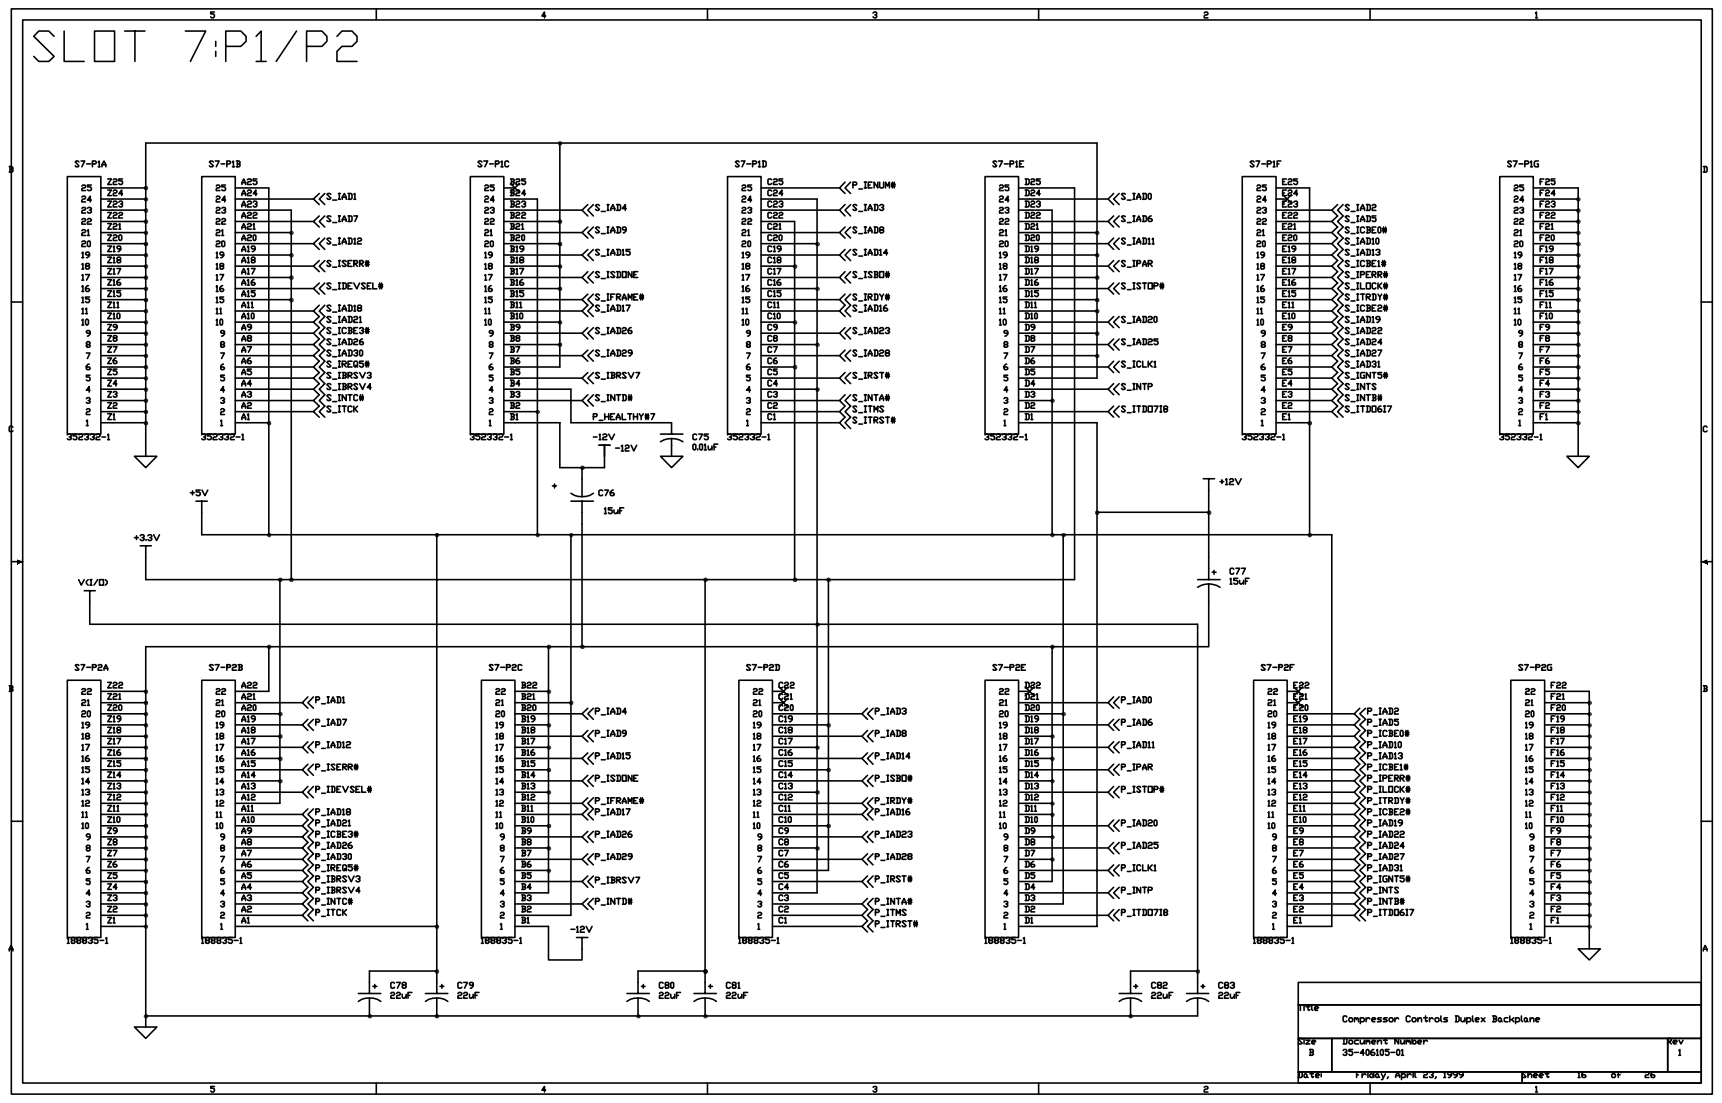
[picture p244: page 16]

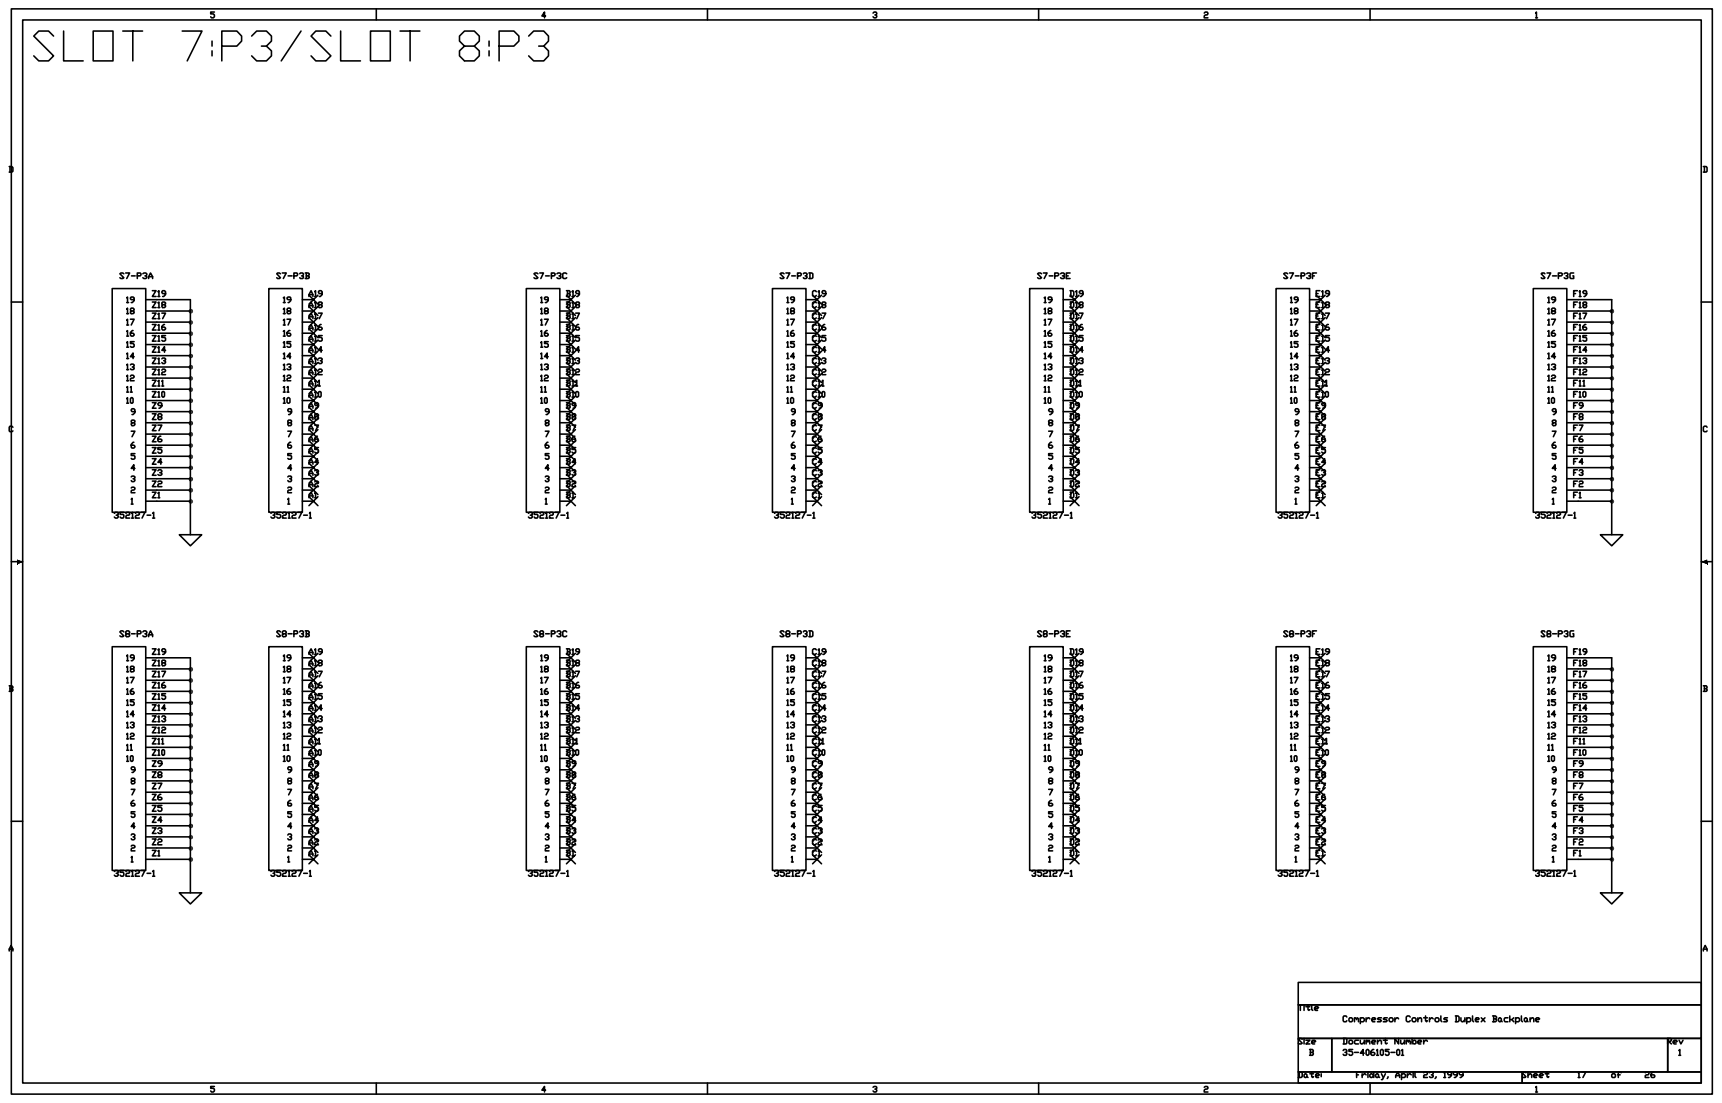
[picture p245: page 17]

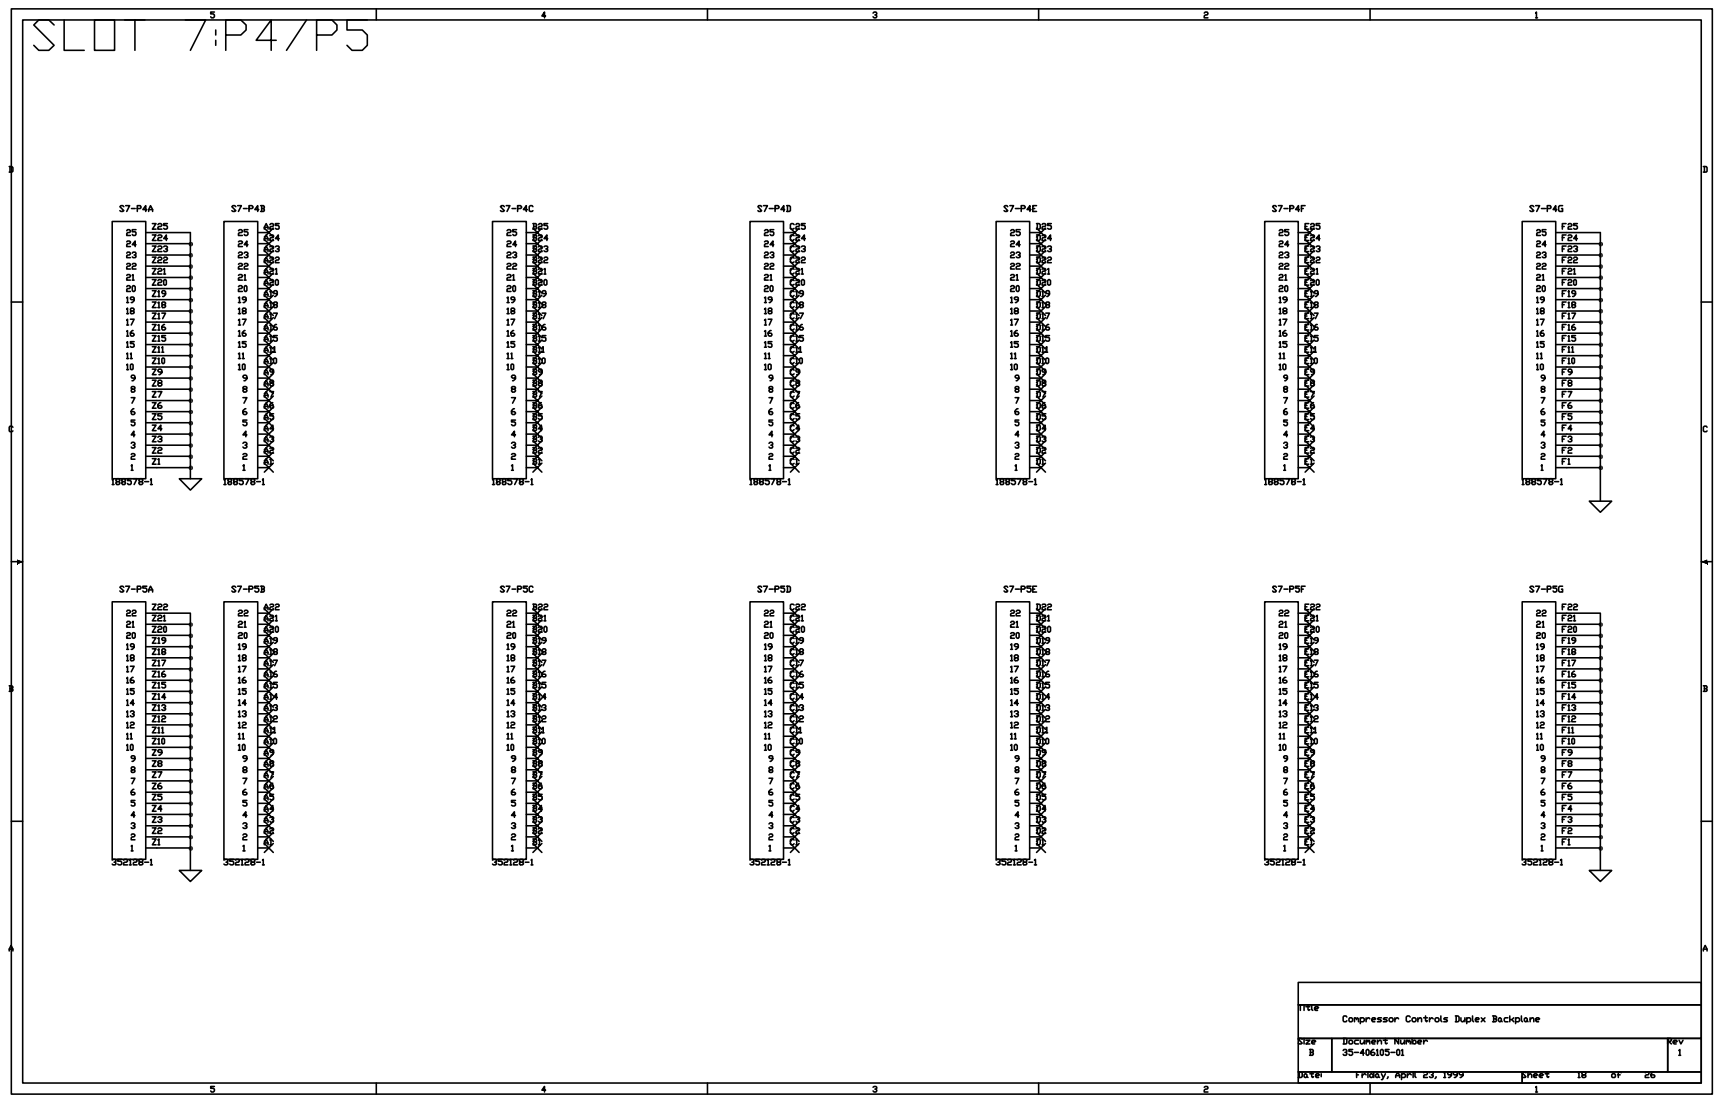
[picture p246: page 18]

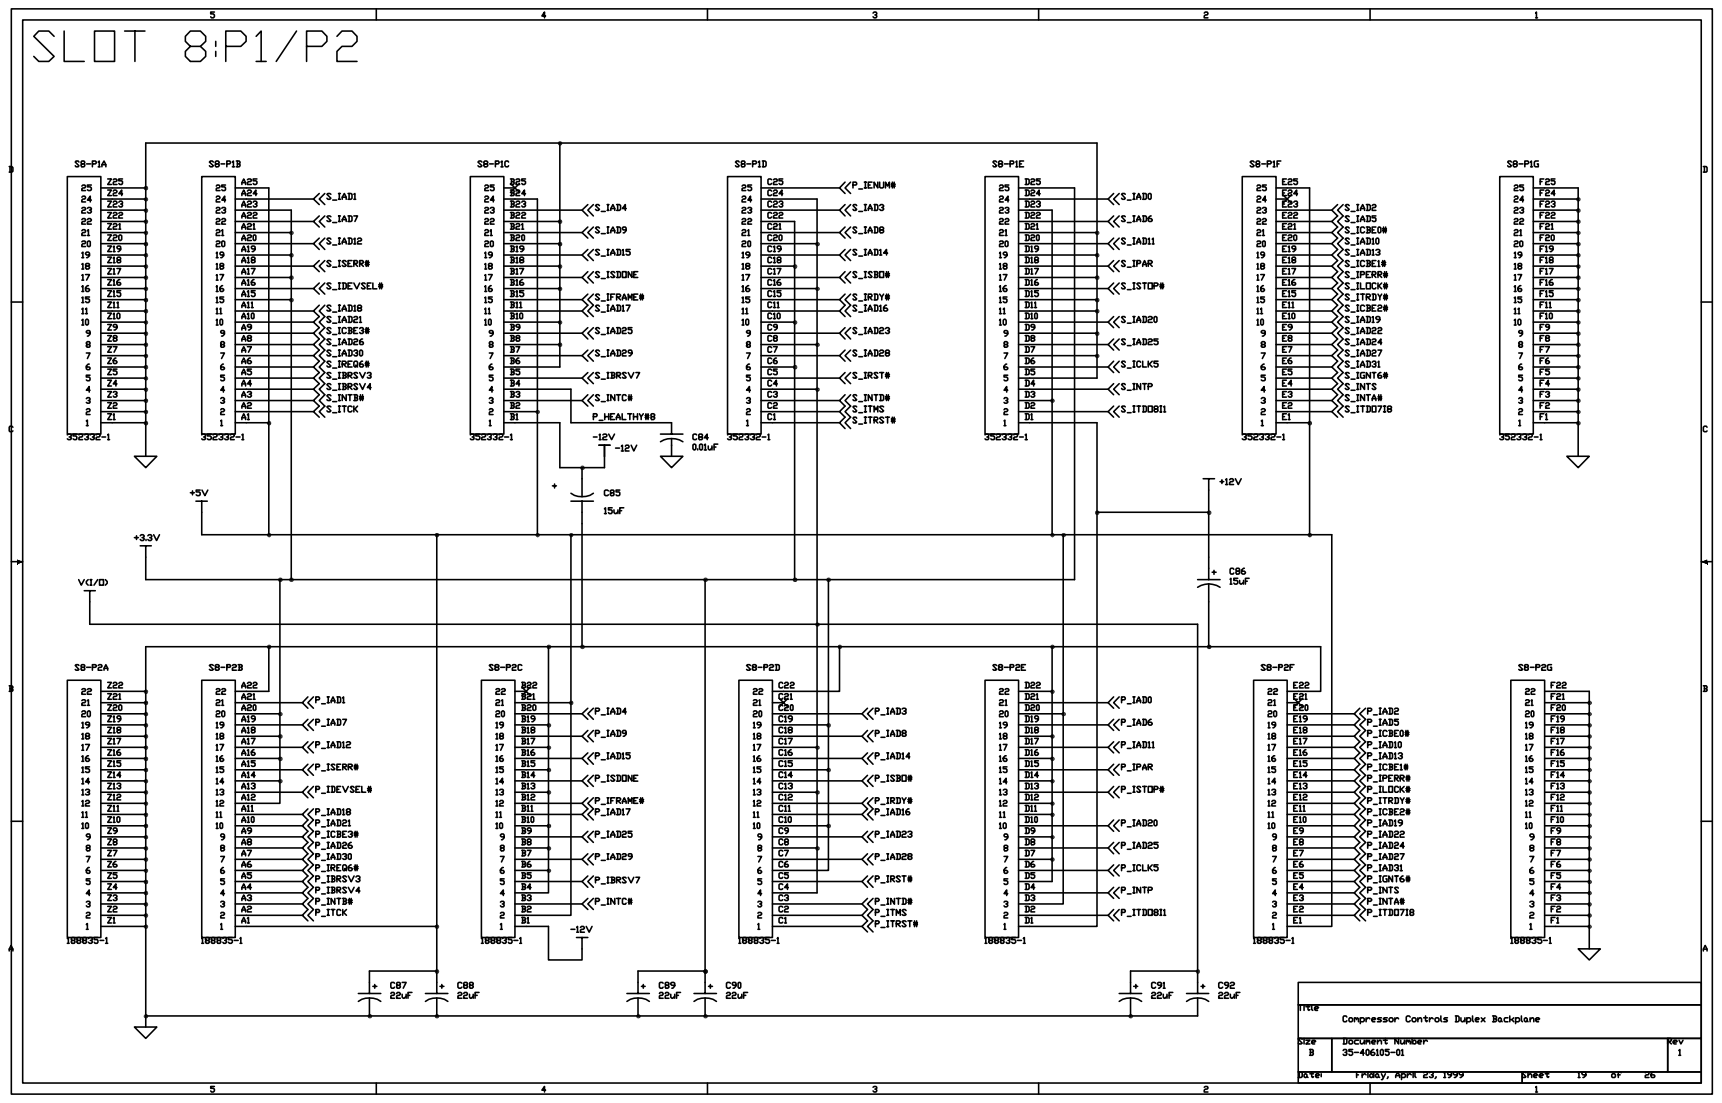
[picture p247: page 19]

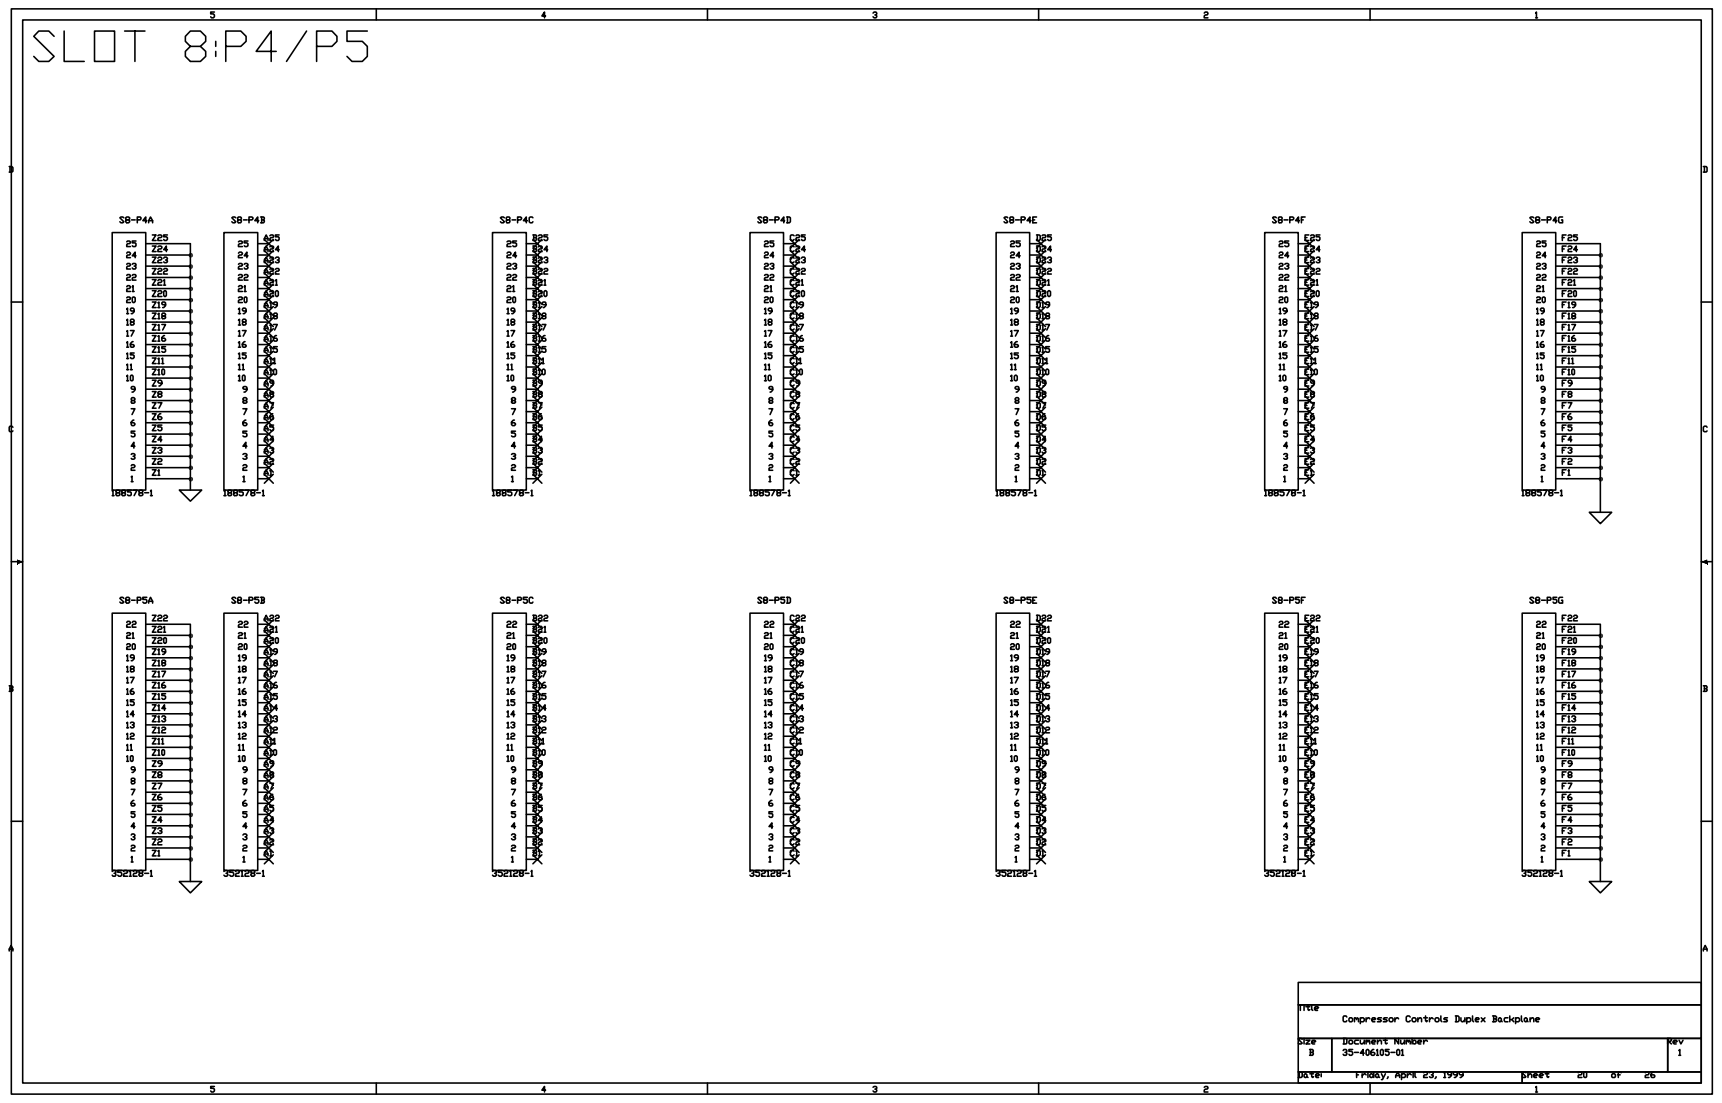
[picture p248: page 20]

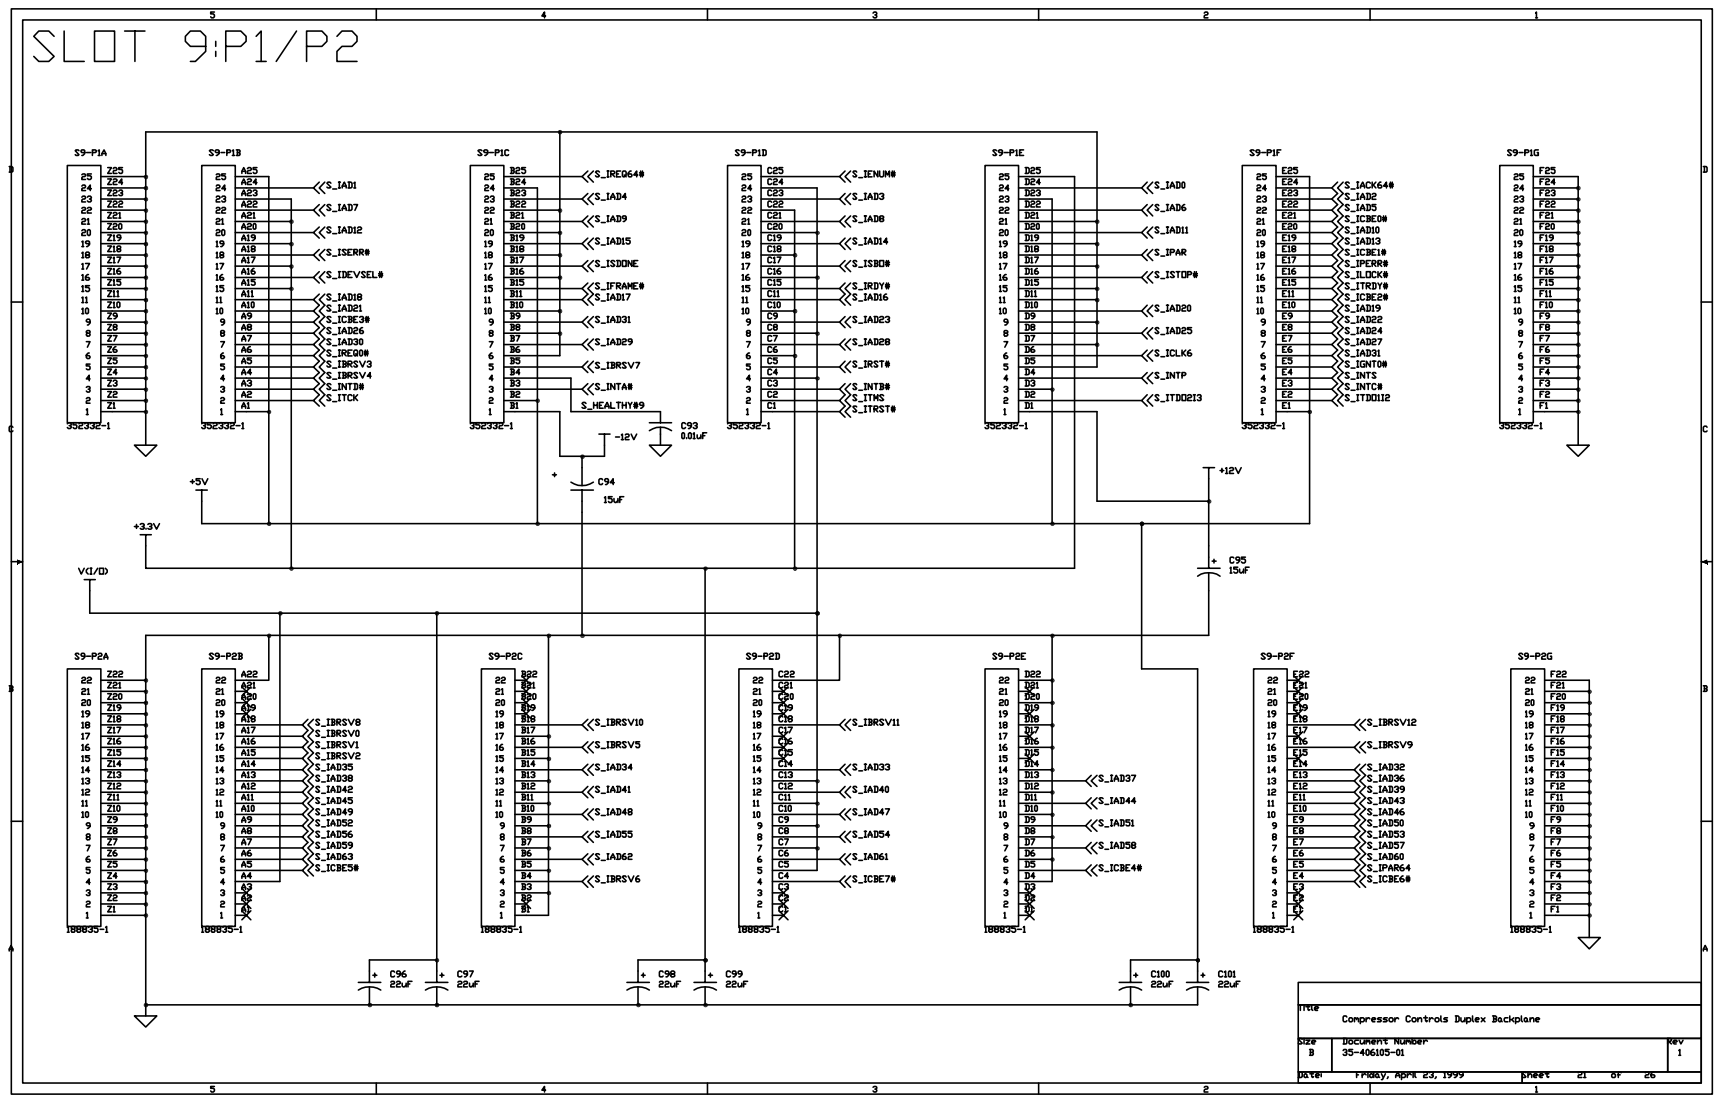
[picture p249: page 21]

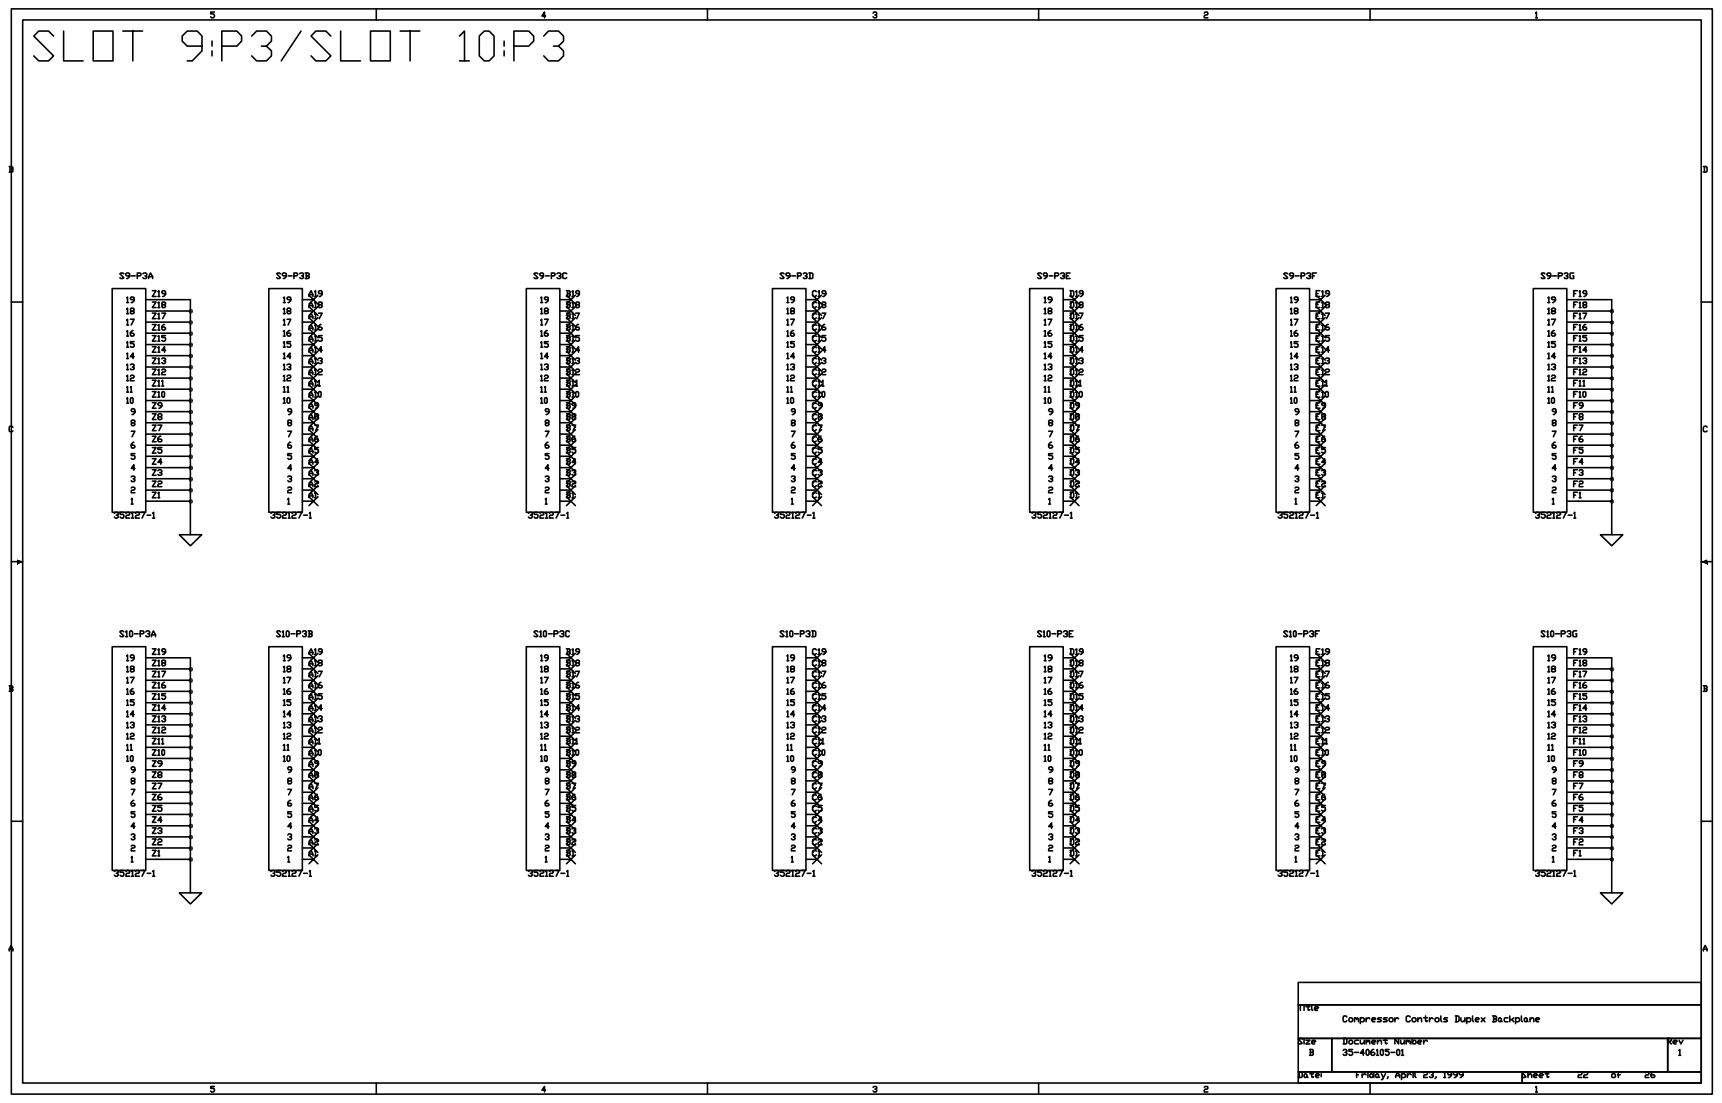
[picture p250: page 22]

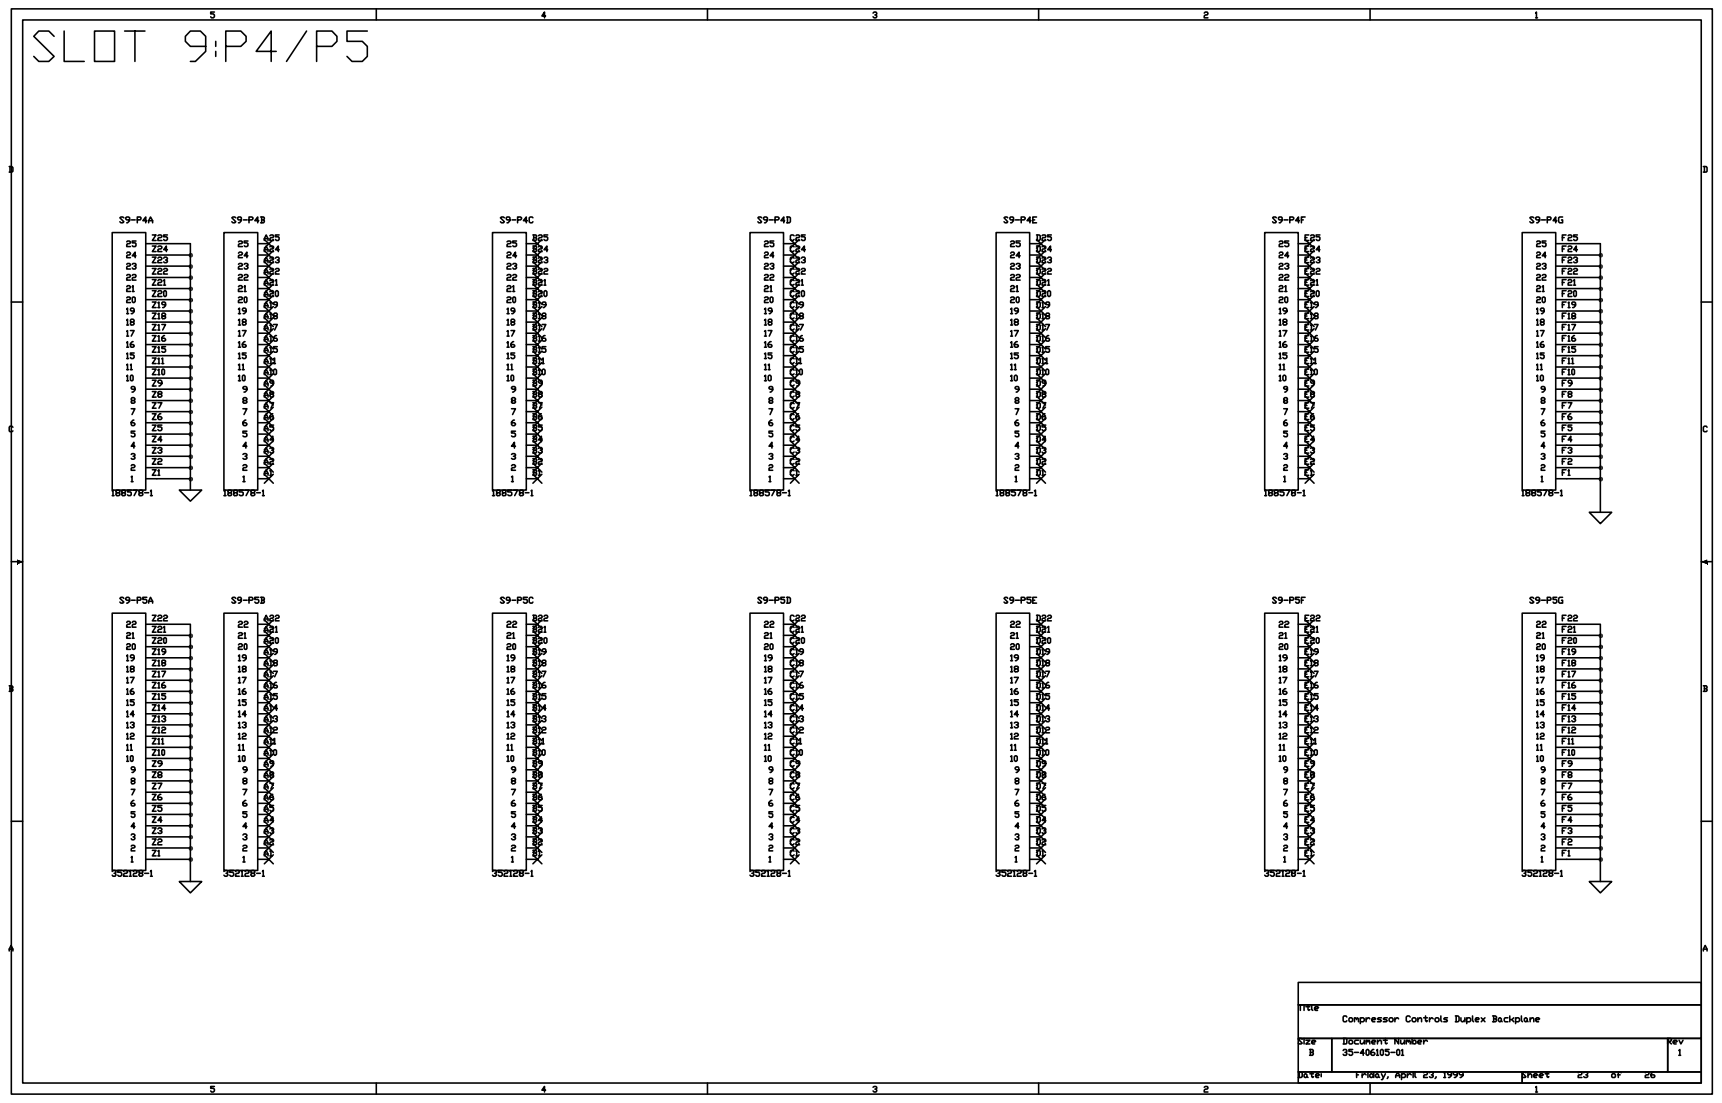
[picture p251: page 23]

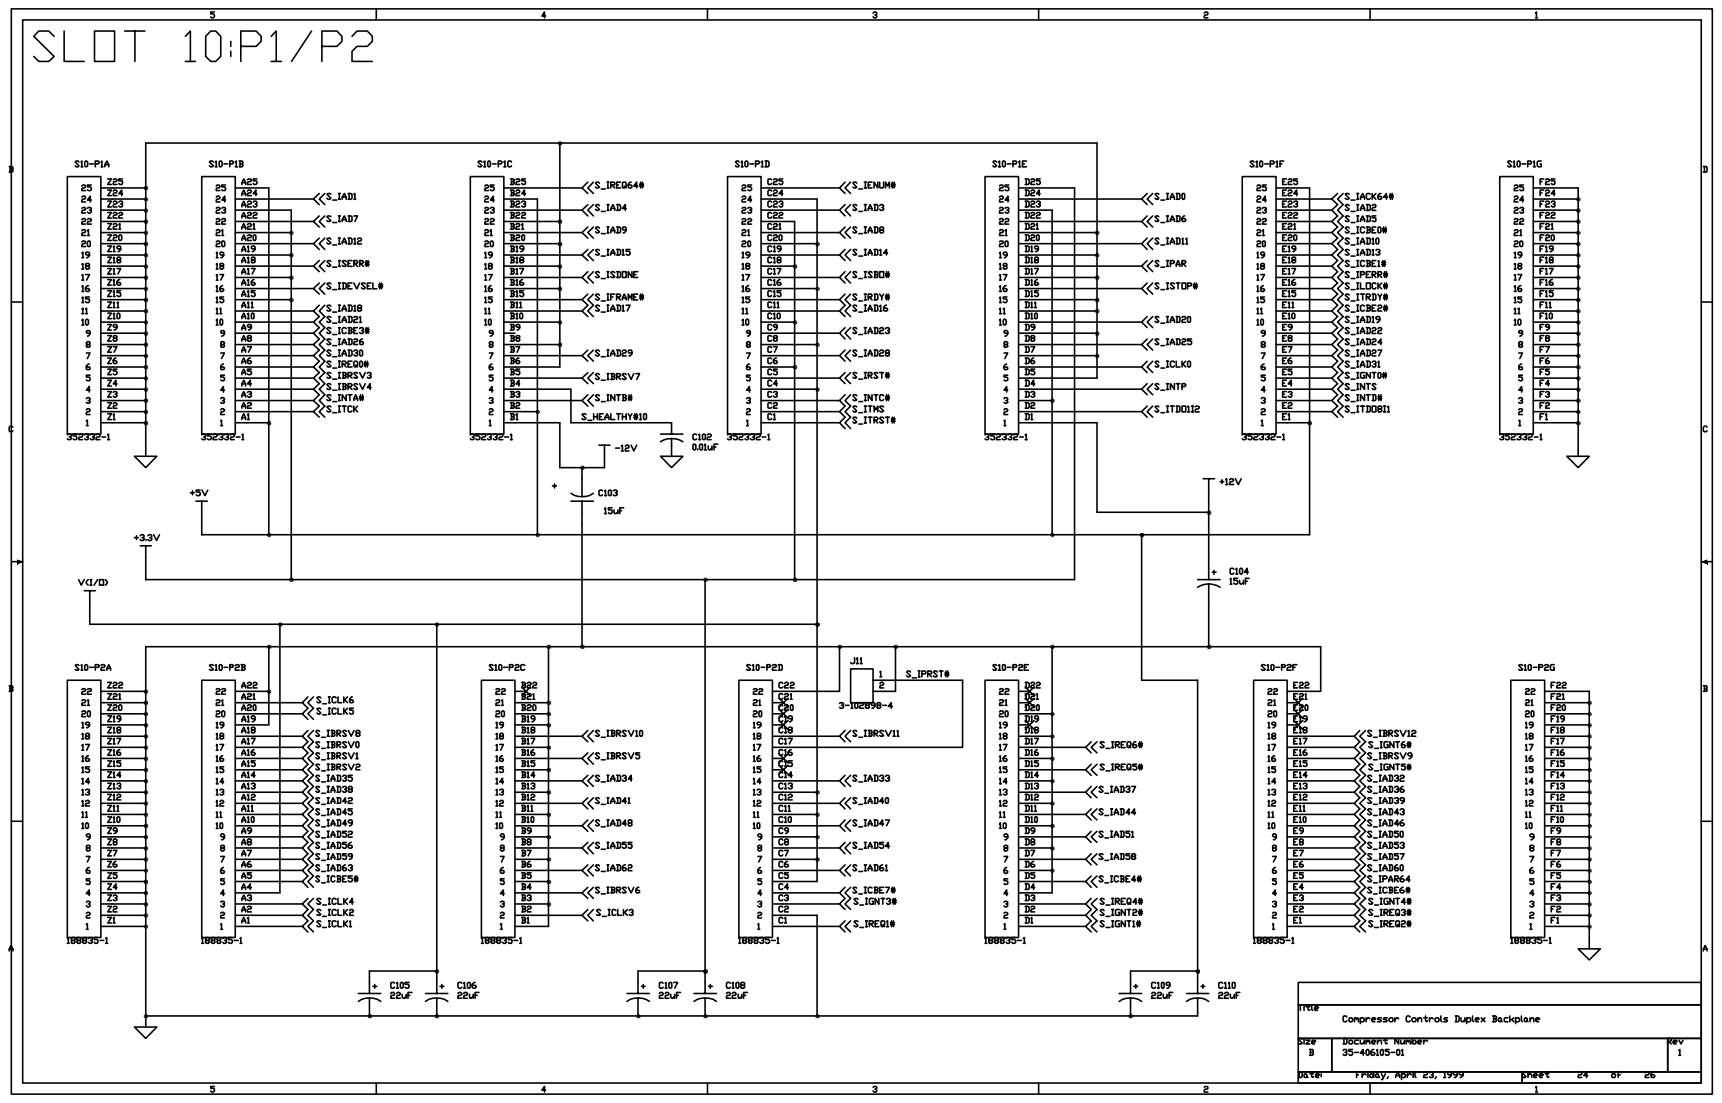
[picture p252: page 24]

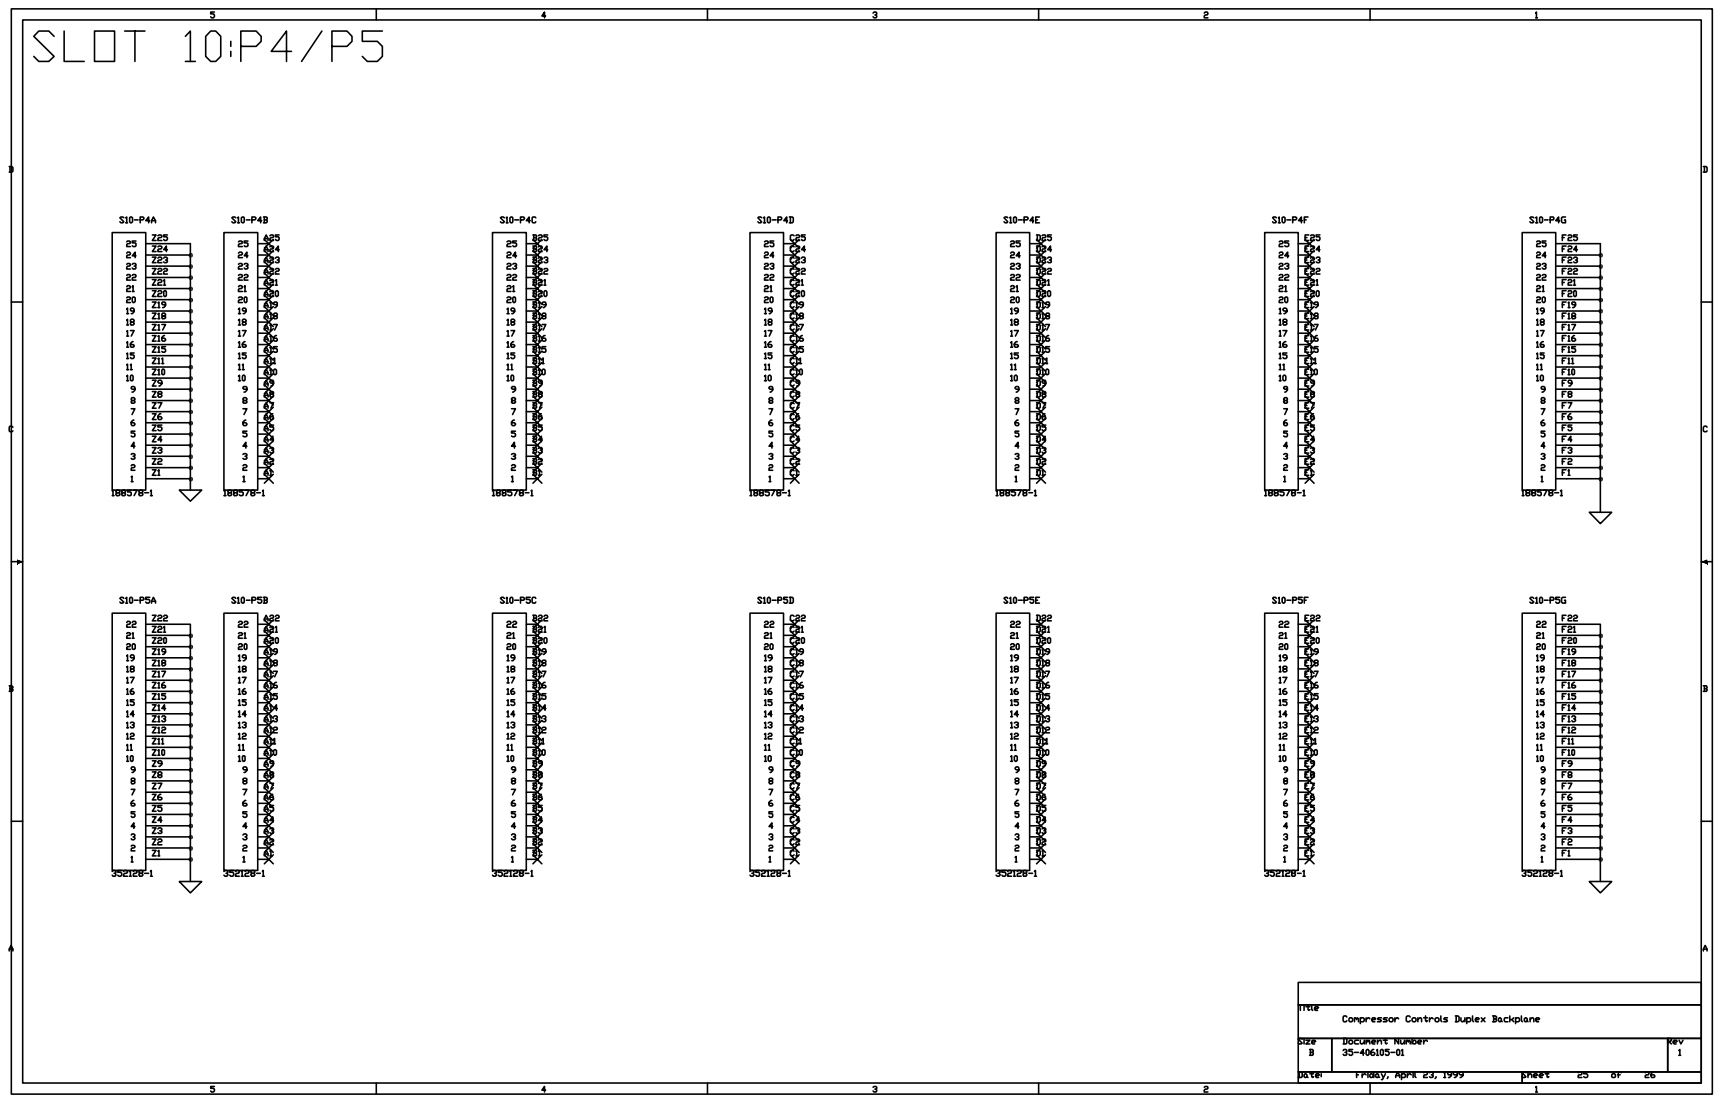
[picture p253: page 25]

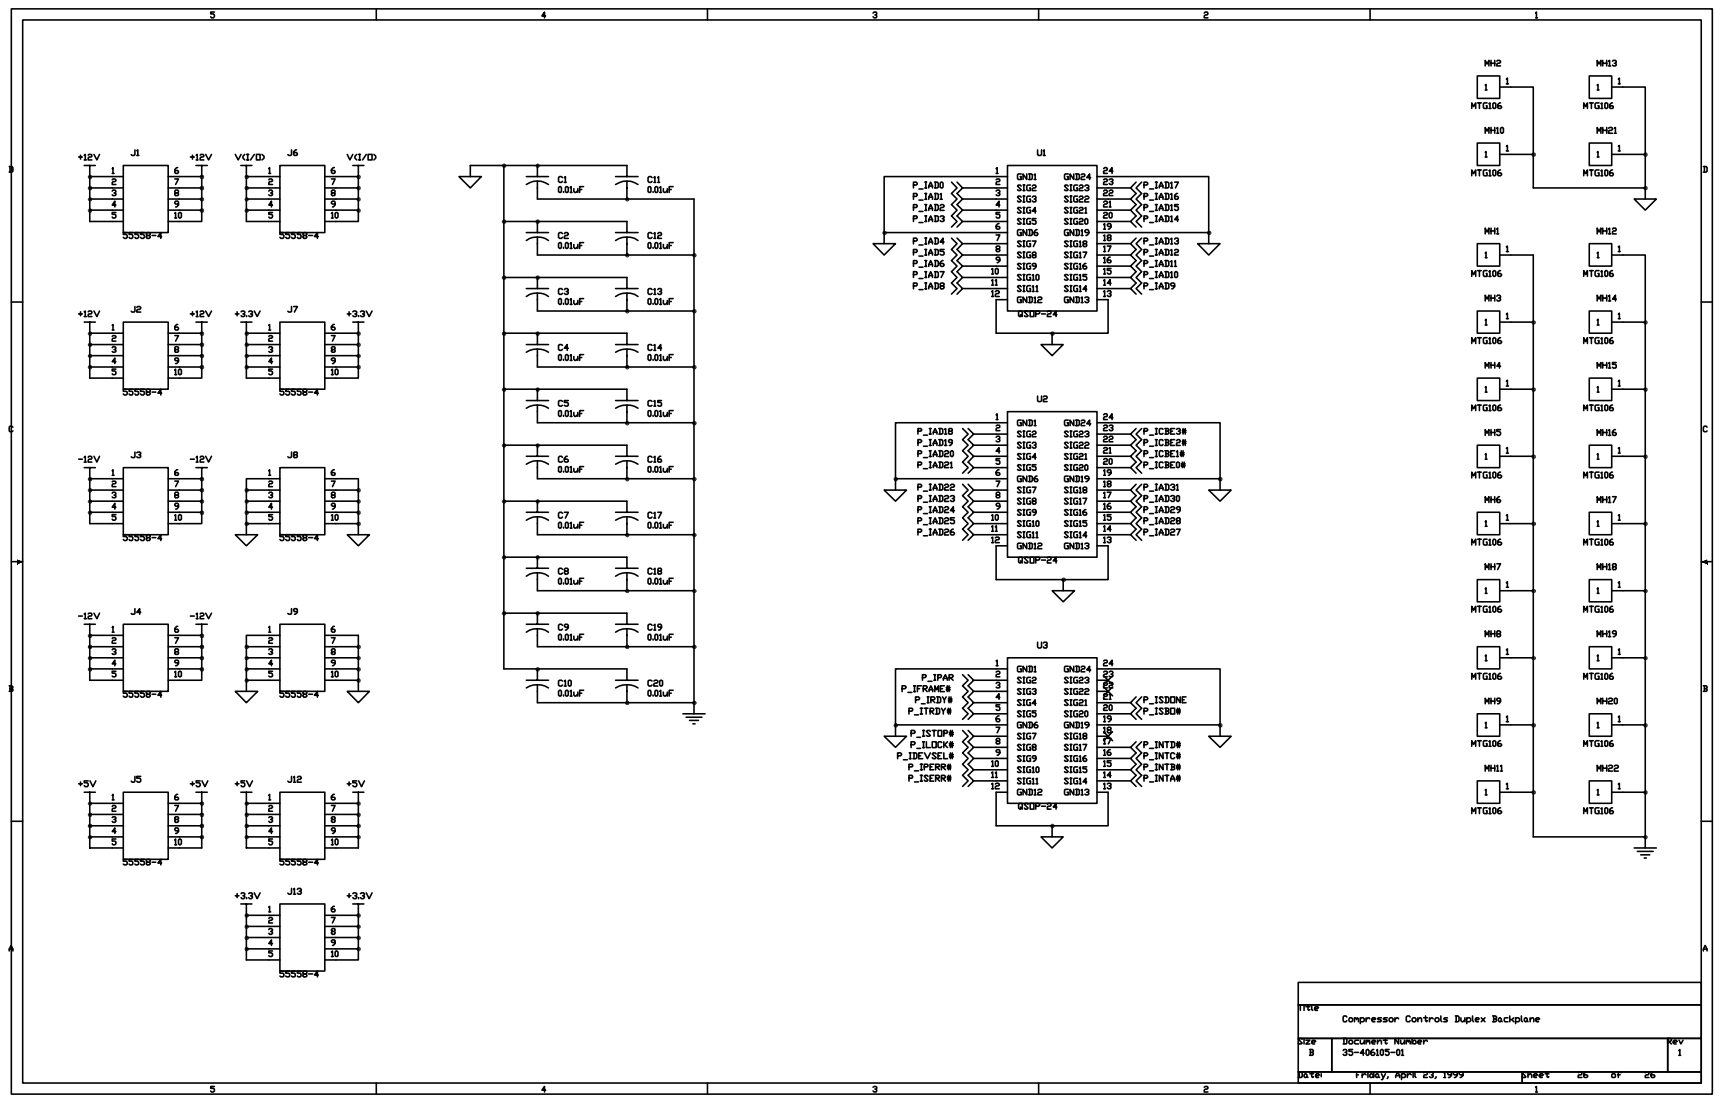
[picture p254: page 26]
