Sayidathahaseen/CCC_NGP_ODC/NGP_ODC_Main/PDLC/design/PCB Layout/APP/APP_Placement_20May.pdf

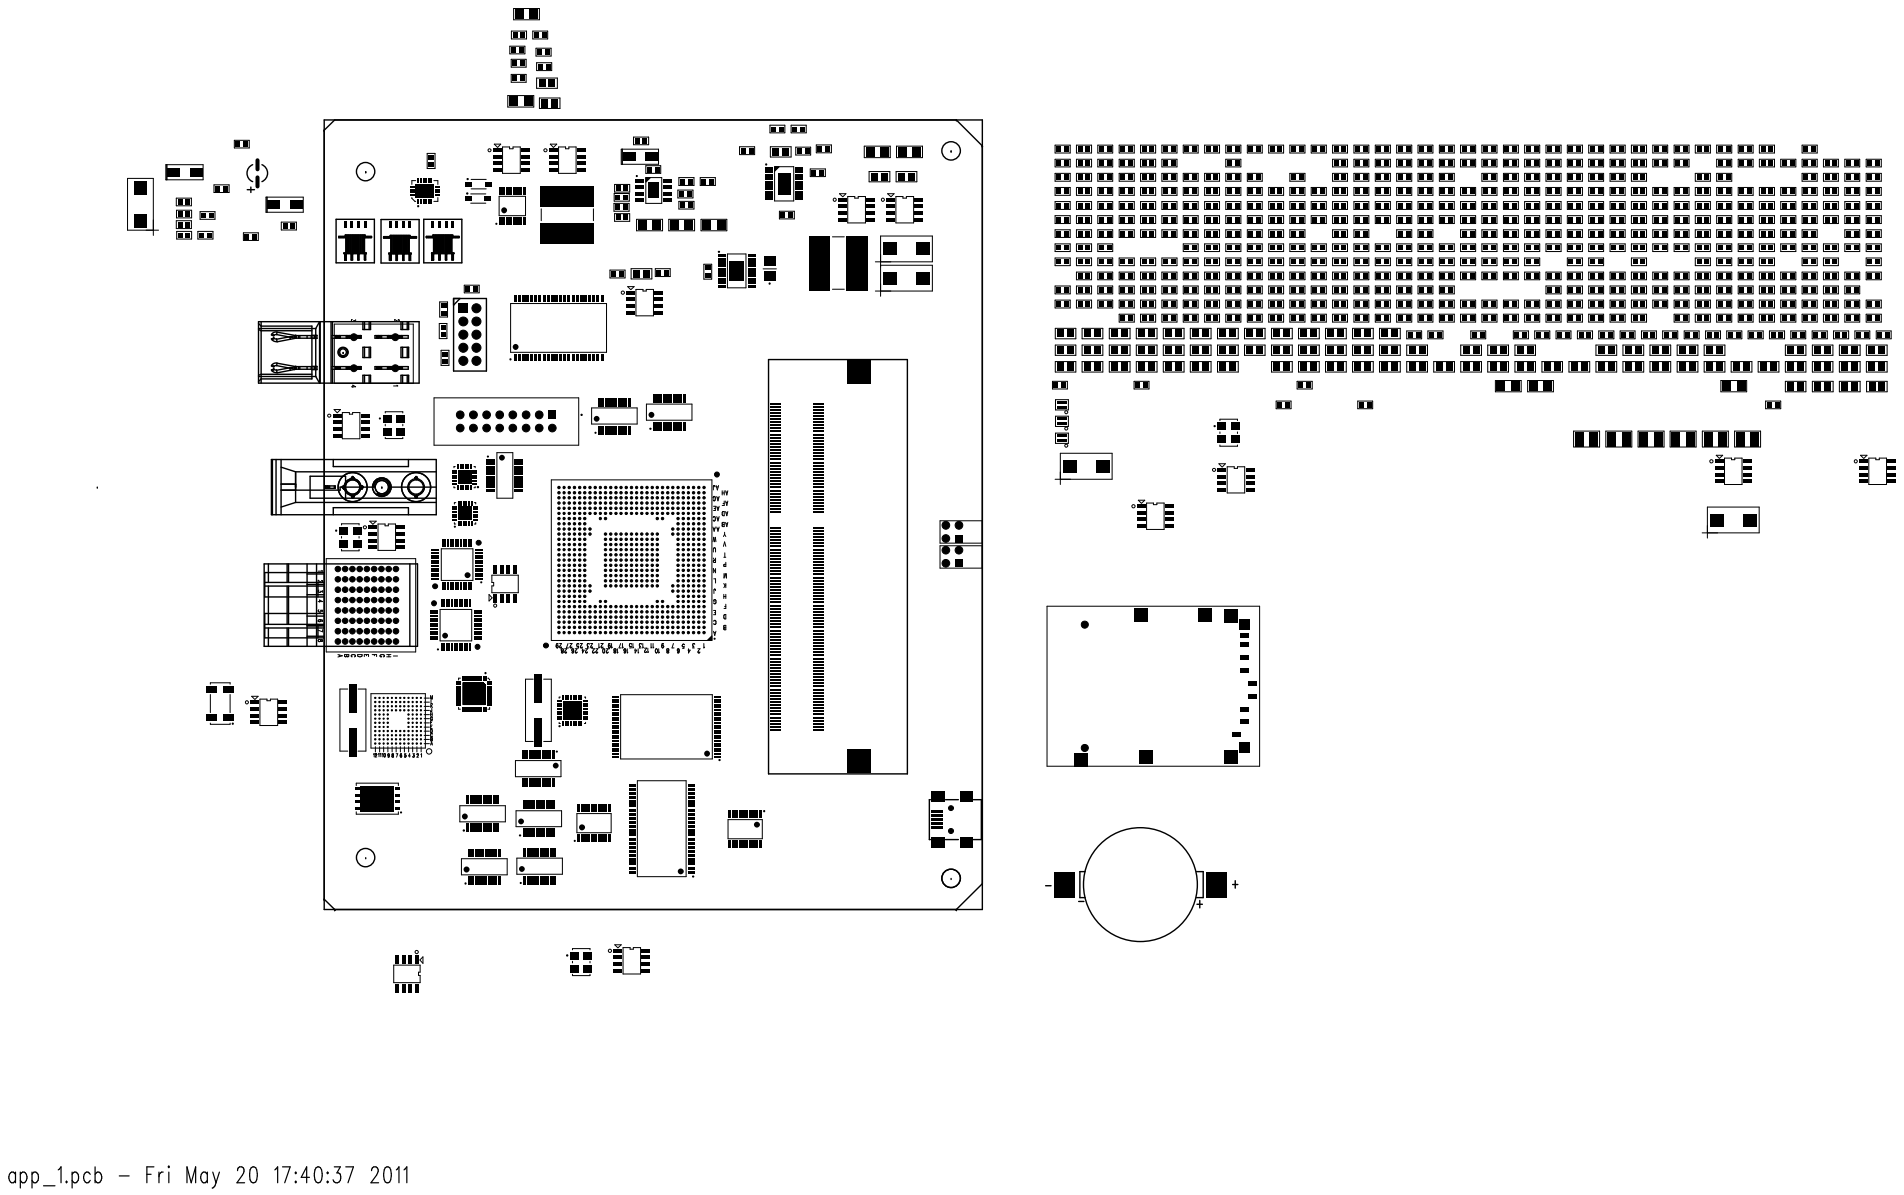
[picture p255: page 1]
