Sayidathahaseen/CCC_NGP_ODC/NGP_ODC_Main/PDLC/design/PCB Layout/MPC5534_daughter_board/BOTTOM PLACEMENT.pdf

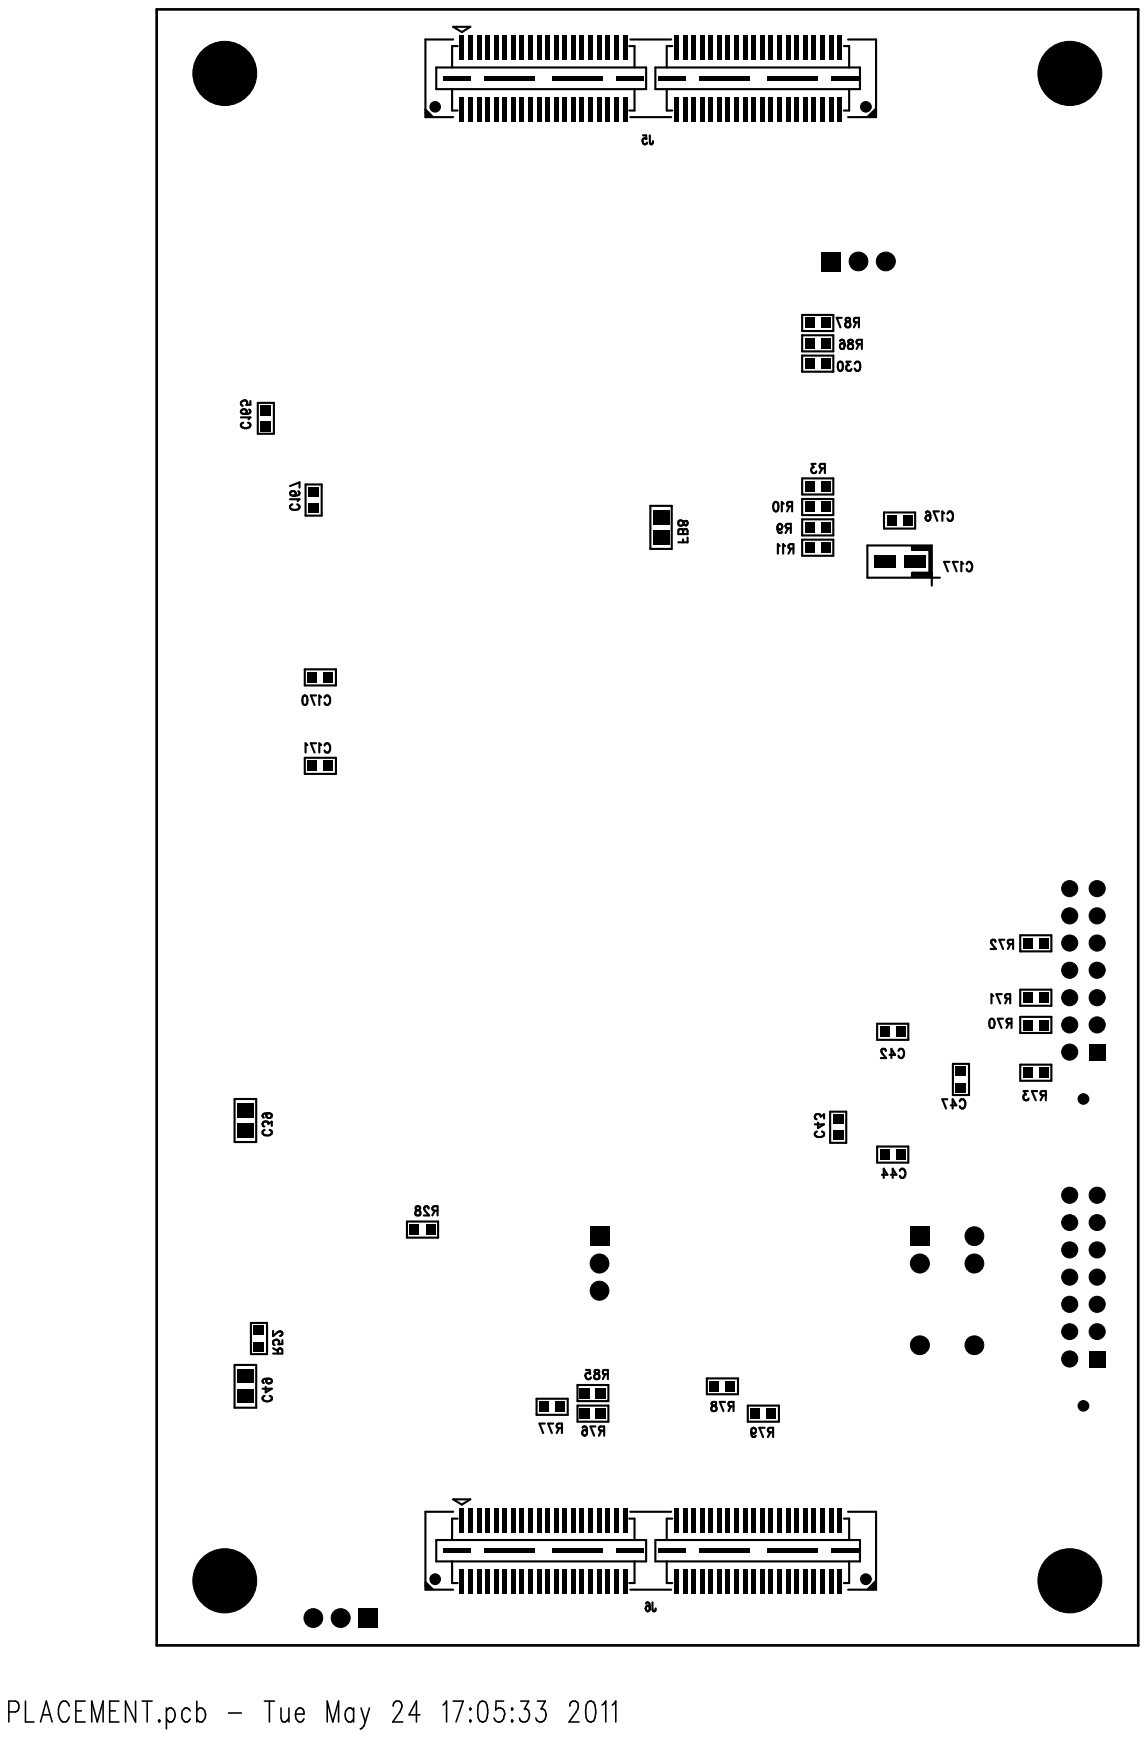
[picture p256: page 1]
