Sayidathahaseen/CCC_NGP_ODC/NGP_ODC_Main/PDLC/design/PCB Layout/MPC5534_daughter_board/TOP PLACEMENT.pdf

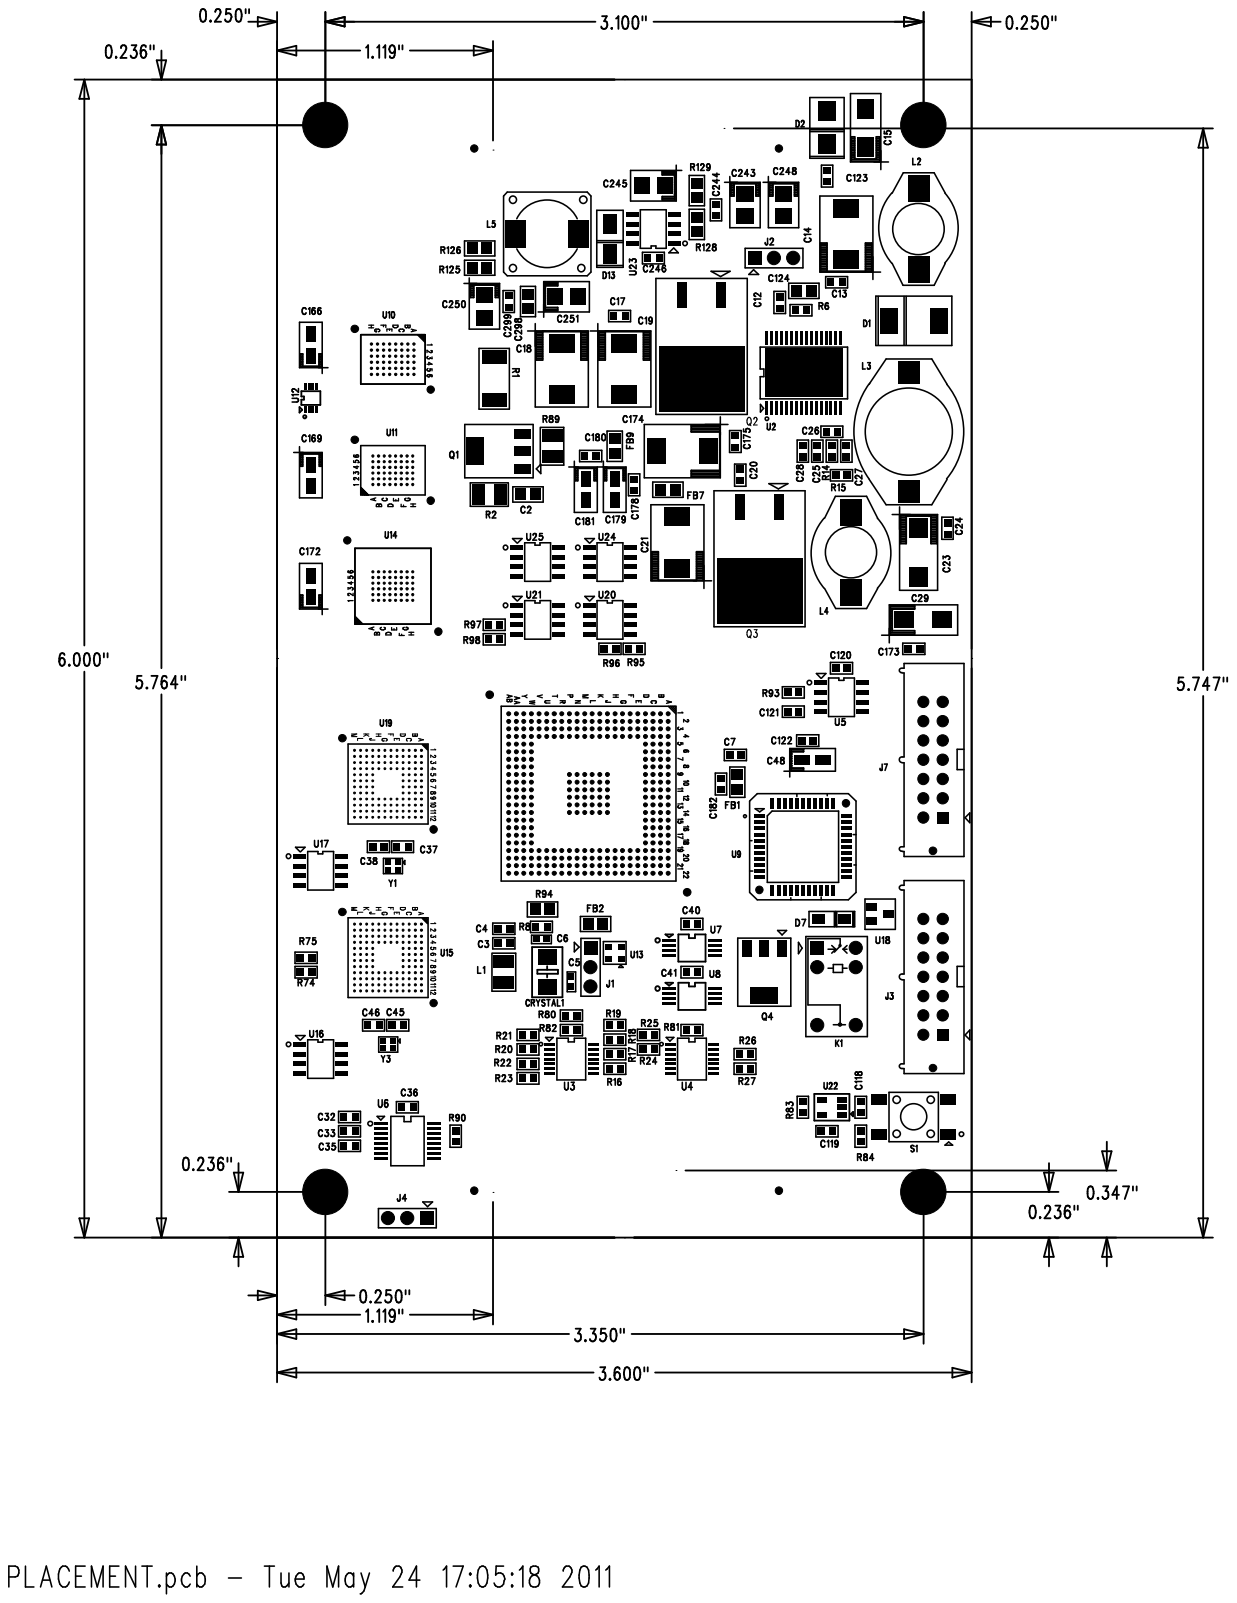
[picture p257: page 1]
