Sayidathahaseen/CCC_NGP_ODC/NGP_ODC_Main/PDLC/VanGuard/Client Docs/Vanguard/Analog Input/Schematic_S3++ AI.pdf

D

1 | 2 | 3 | 4 | 5 | 6

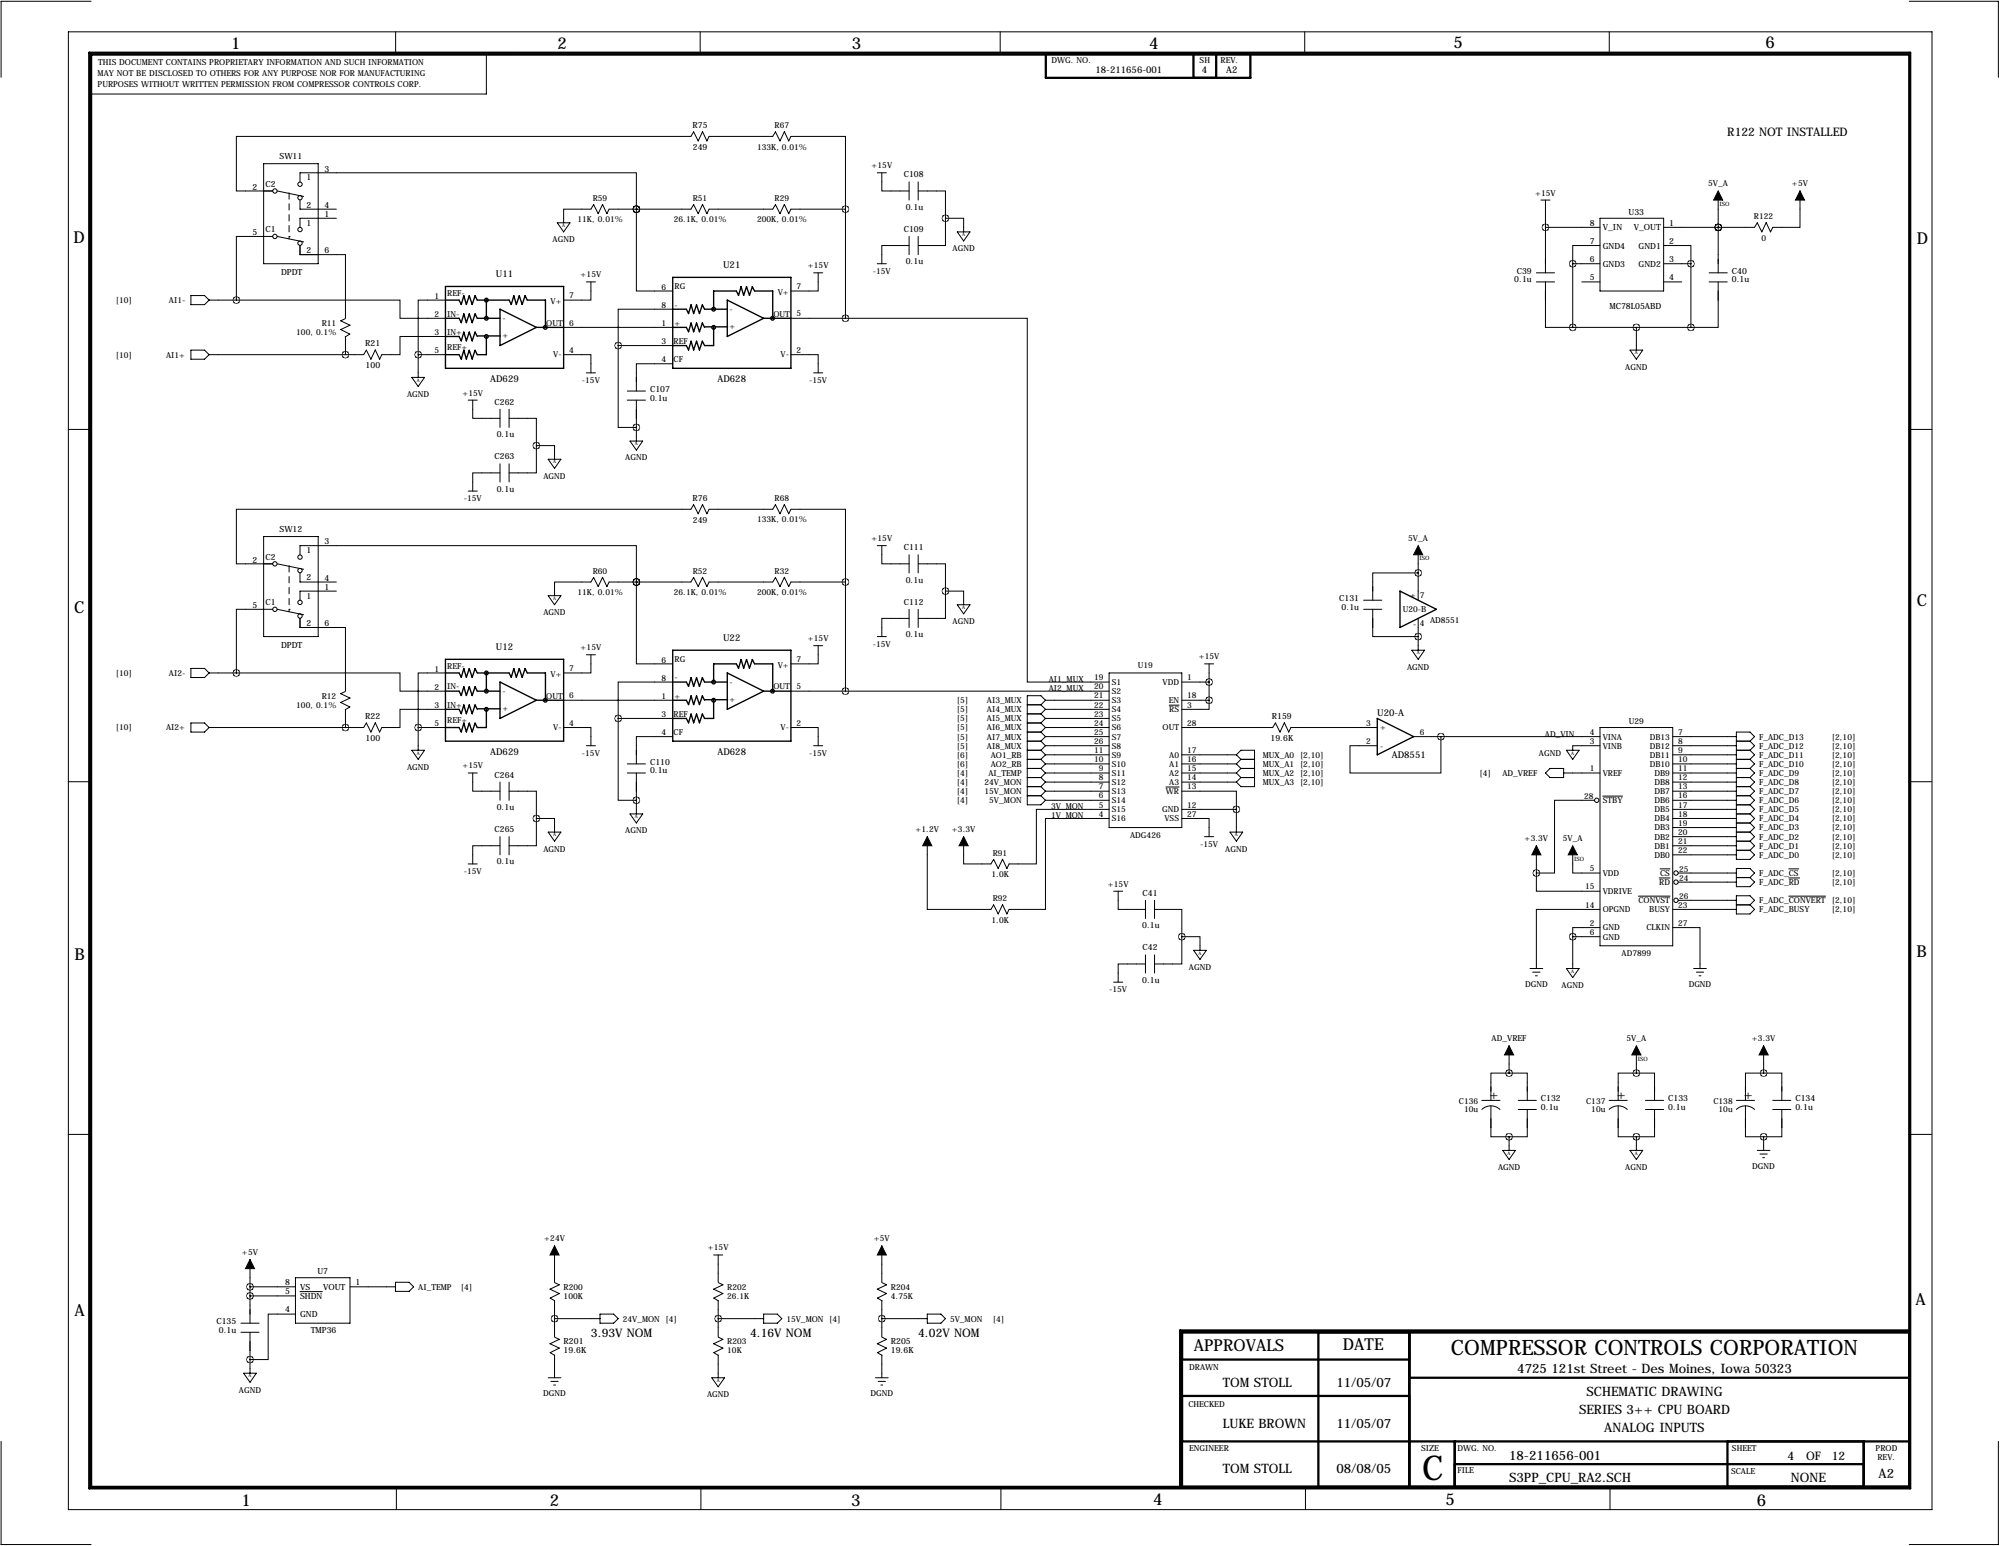
[picture p258: page 1]

THIS DOCUMENT CONTAINS PROPRIETARY INFORMATION AND SUCH INFORMATION MAY NOT BE DISCLOSED TO OTHERS FOR ANY PURPOSE NOR FOR MANUFACTURING PURPOSES WITHOUT WRITTEN PERMISSION FROM COMPRESSOR CONTROLS CORP. | R75 R67 | DWG. NO. 18-211656-001 | SH 4 | REV. A2

2 | 27
6 | DGND

4725 121st Street - Des Moines, Iowa 50323

CHECKED LUKE BROWN | 11/05/07

ENGINEER TOM STOLL | 08/08/05 | SIZE C | DWG. NO. 18-211656-001 | SHEET | PROD REV.

FILE | SCALE NONE | A2 S3PP_CPU_RA2.SCH

D

1 | 2 | 3 | 4 | 5 | 6

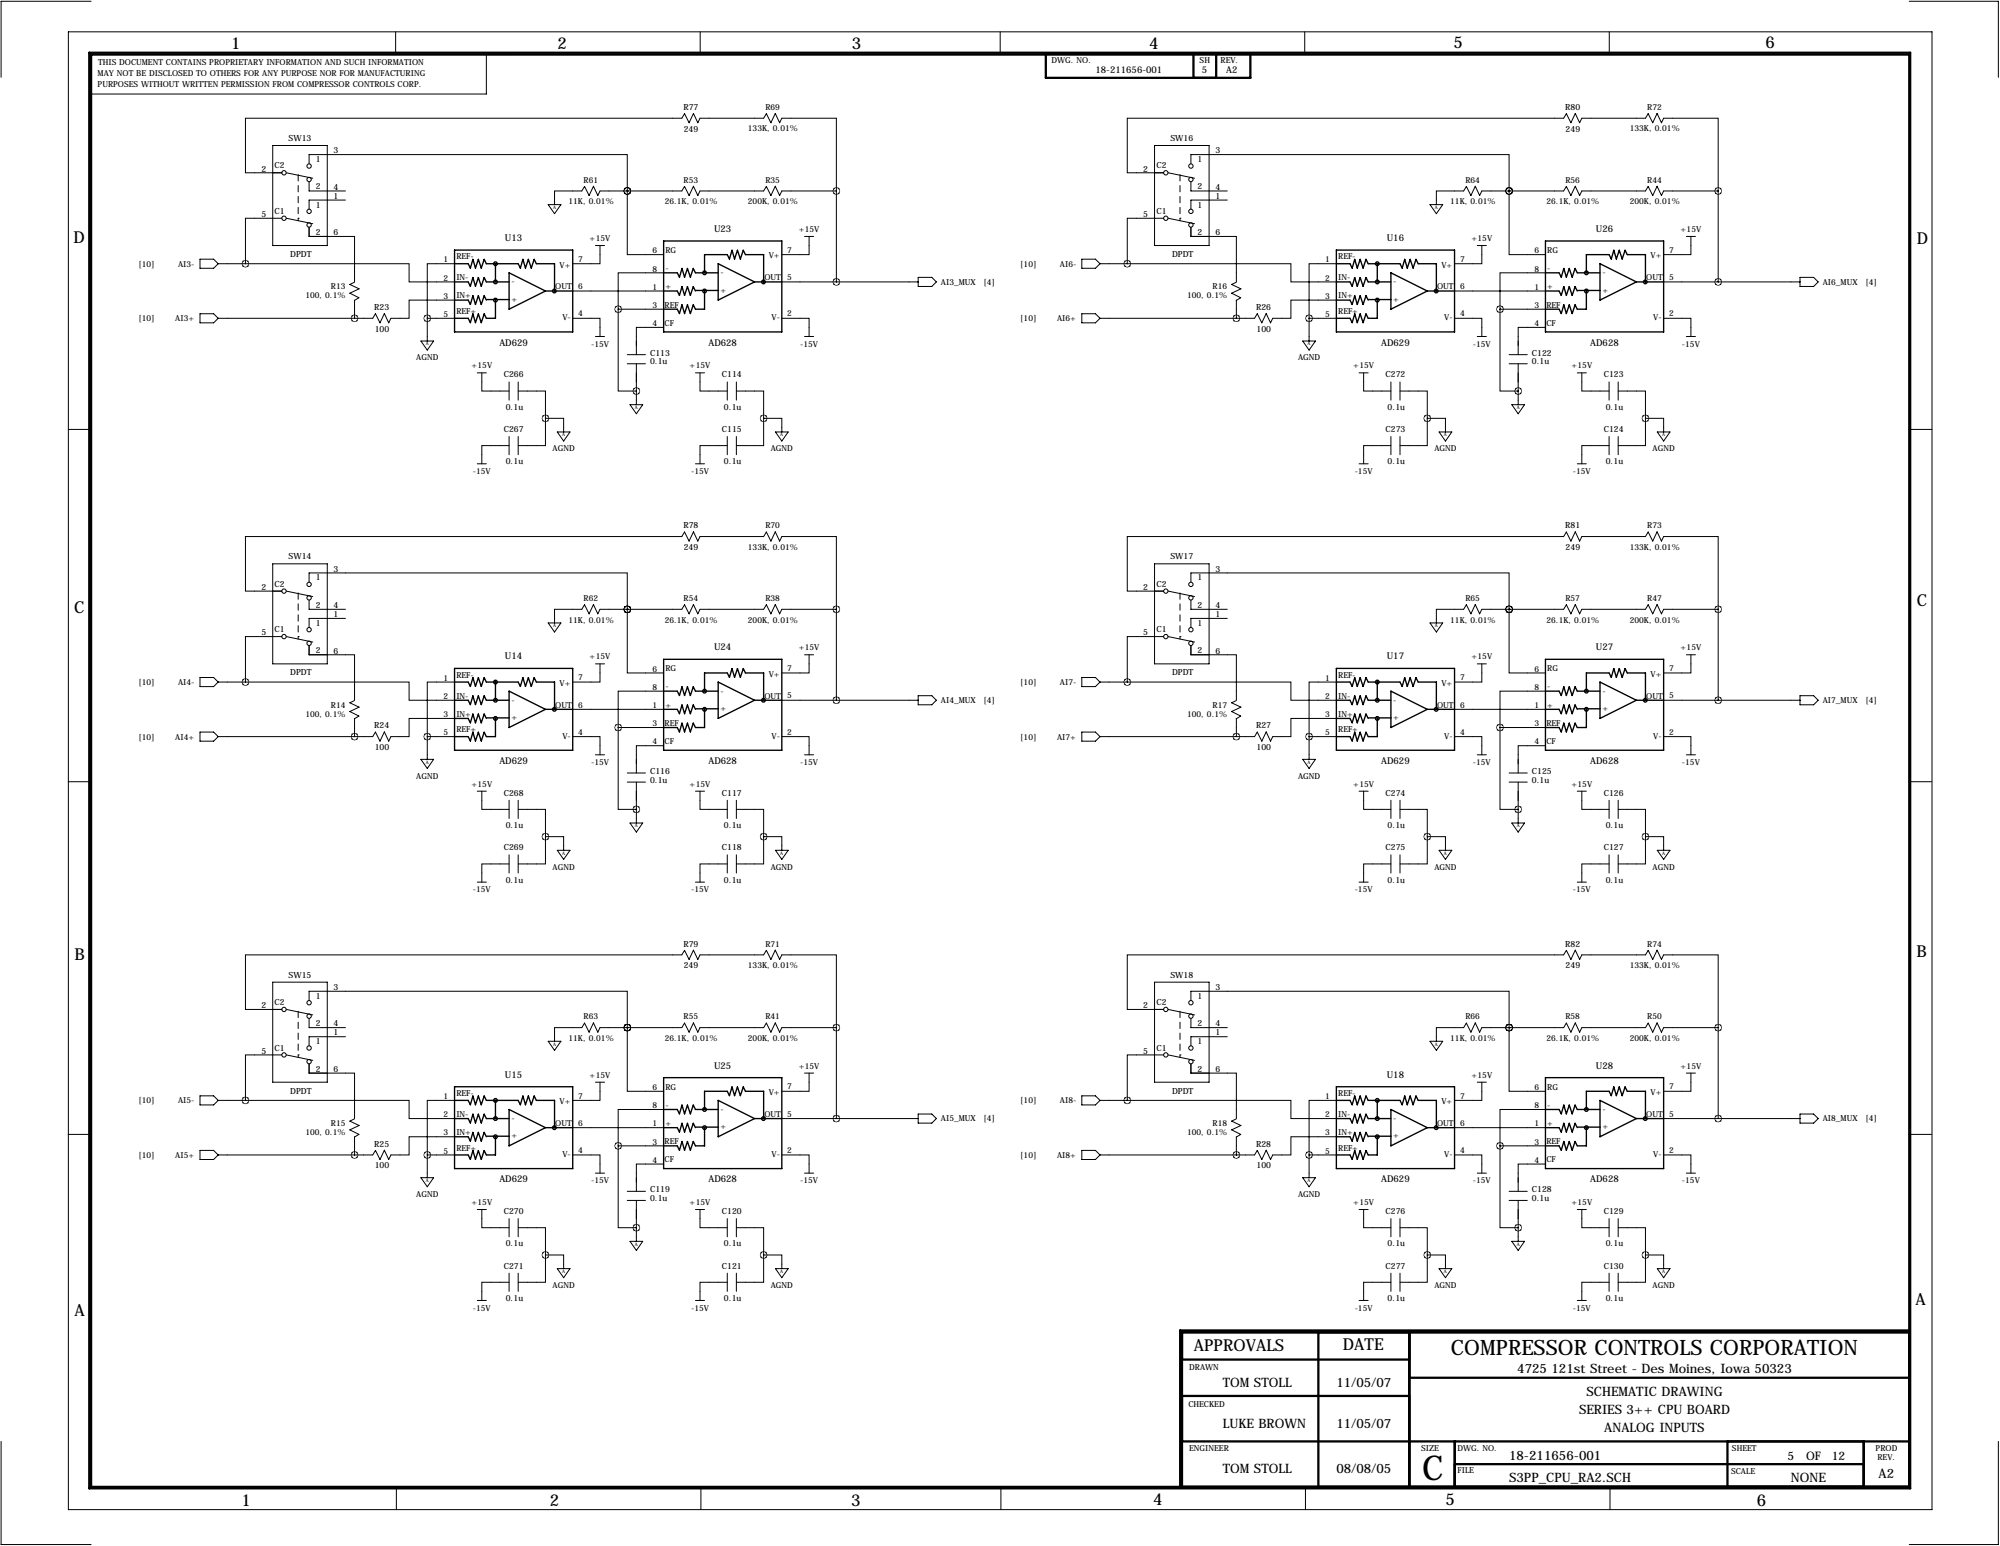
[picture p259: page 2]

THIS DOCUMENT CONTAINS PROPRIETARY INFORMATION AND SUCH INFORMATION MAY NOT BE DISCLOSED TO OTHERS FOR ANY PURPOSE NOR FOR MANUFACTURING PURPOSES WITHOUT WRITTEN PERMISSION FROM COMPRESSOR CONTROLS CORP. | R77 R69 249 133K, 0.01% | DWG. NO. 18-211656-001 | SH 5 | REV. A2 | R80 R72 249 133K, 0.01%

APPROVALS | DATE | COMPRESSOR CONTROLS CORPORATION 4725 121st Street - Des Moines, Iowa 50323

DRAWN TOM STOLL | 11/05/07

CHECKED LUKE BROWN | 11/05/07

ENGINEER TOM STOLL | 08/08/05 | SIZE C | DWG. NO. 18-211656-001 | SHEET 5 OF 12 | PROD REV. A2

FILE S3PP_CPU_RA2.SCH | SCALE NONE
