Sayidathahaseen/CCC_NGP_ODC/NGP_ODC_Main/PDLC/VanGuard/Client Docs/Vanguard/Analog Input/Schematic_Vanguard AI.pdf

D

1 | 2 | 3 | 4 | 5 | 6

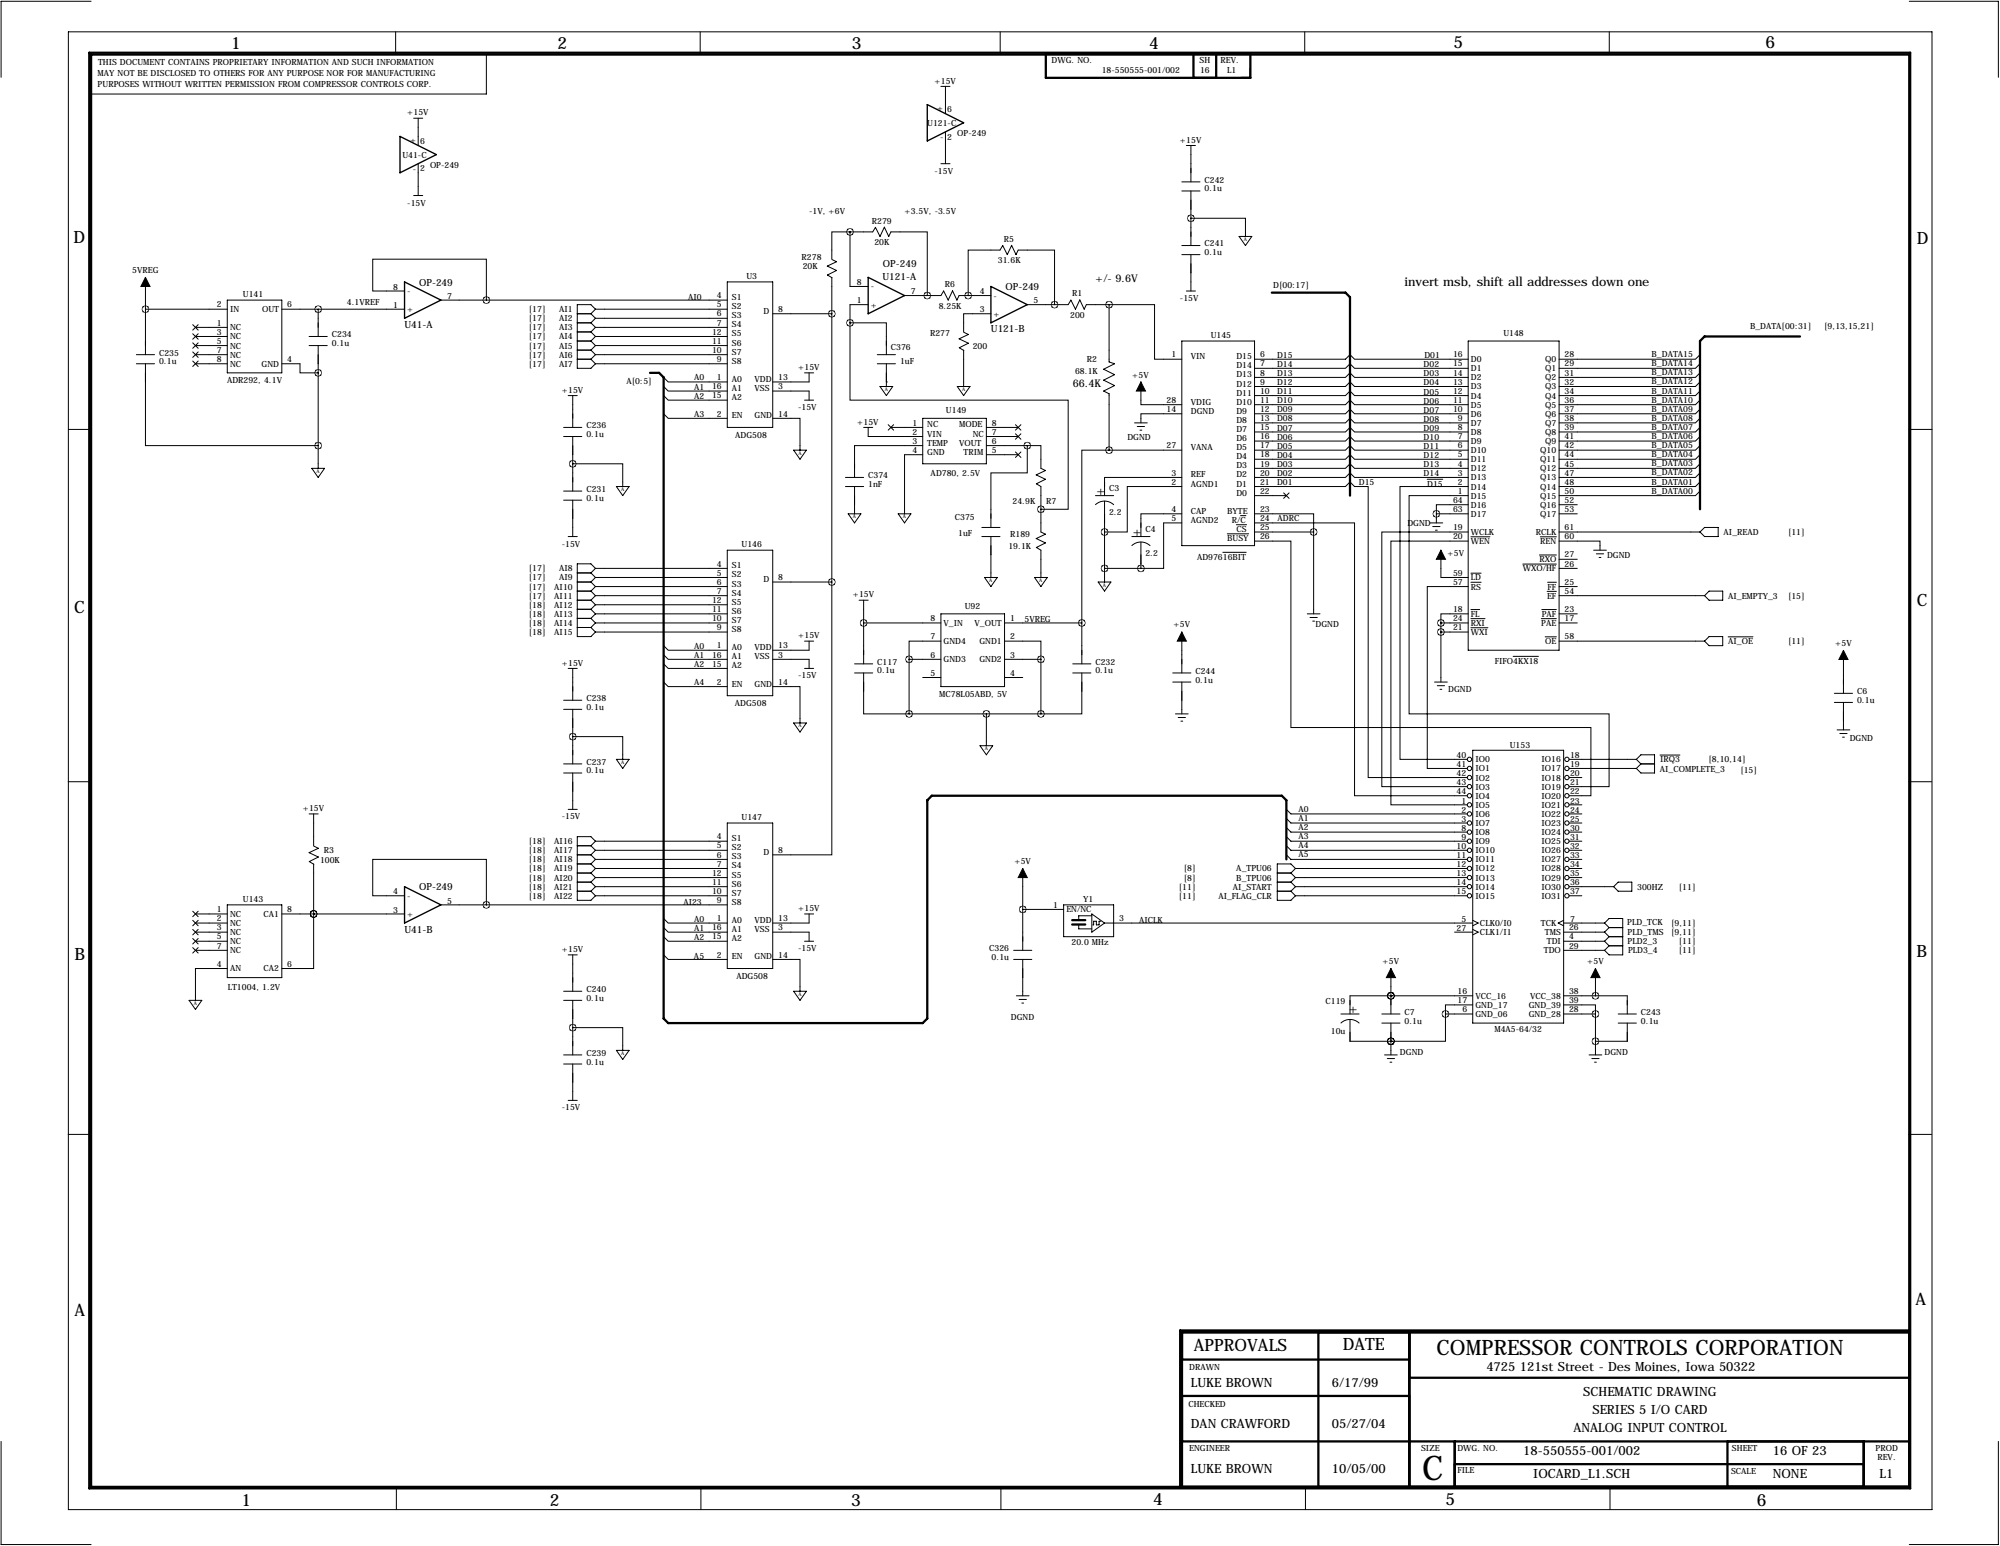
[picture p260: page 1]

THIS DOCUMENT CONTAINS PROPRIETARY INFORMATION AND SUCH INFORMATION MAY NOT BE DISCLOSED TO OTHERS FOR ANY PURPOSE NOR FOR MANUFACTURING PURPOSES WITHOUT WRITTEN PERMISSION FROM COMPRESSOR CONTROLS CORP. | | DWG. NO. 18-550555-001/002 | SH | REV. L1

invert msb, shift all addresses down one

APPROVALS | DATE | COMPRESSOR CONTROLS CORPORATION 4725 121st Street - Des Moines, Iowa 50322

DRAWN LUKE BROWN | 6/17/99

CHECKED DAN CRAWFORD

ENGINEER LUKE BROWN | 10/05/00 | SIZE C | DWG. NO. 18-550555-001/002 | SHEET | PROD REV. L1

FILE IOCARD_L1.SCH | SCALE NONE

D

1 | 2 | 3 | 4 | 5 | 6

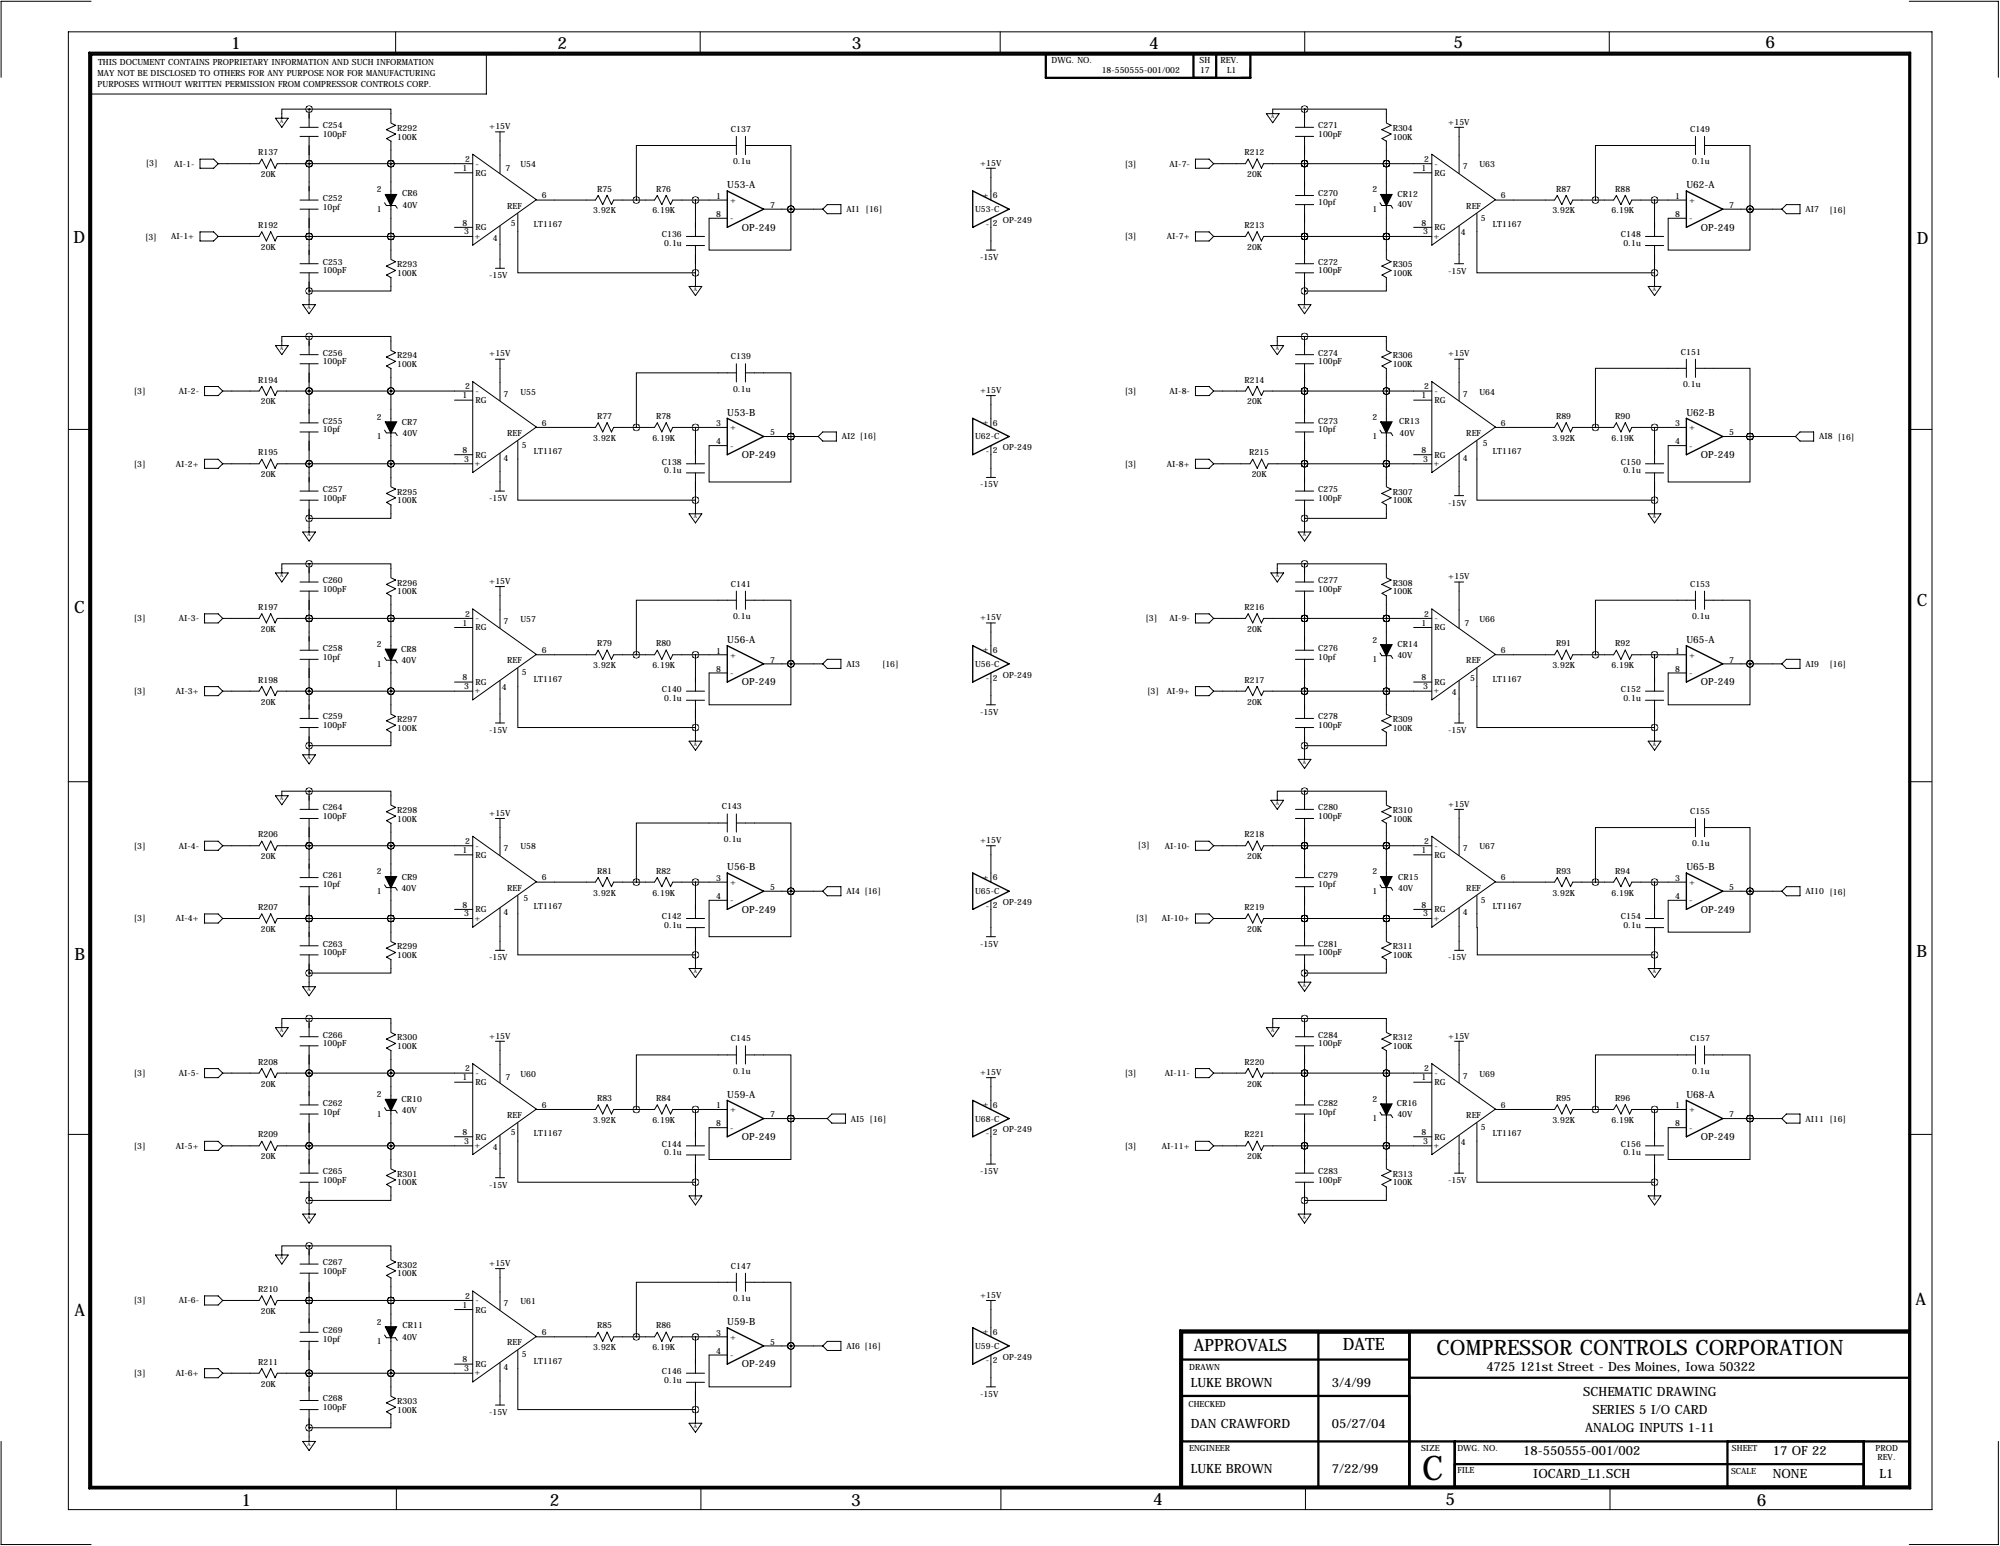
[picture p261: page 2]

APPROVALS | DATE | COMPRESSOR CONTROLS CORPORATION 4725 121st Street - Des Moines, Iowa 50322

DRAWN LUKE BROWN | 3/4/99

CHECKED

LUKE BROWN | 7/22/99

# ABCD

# DCBA

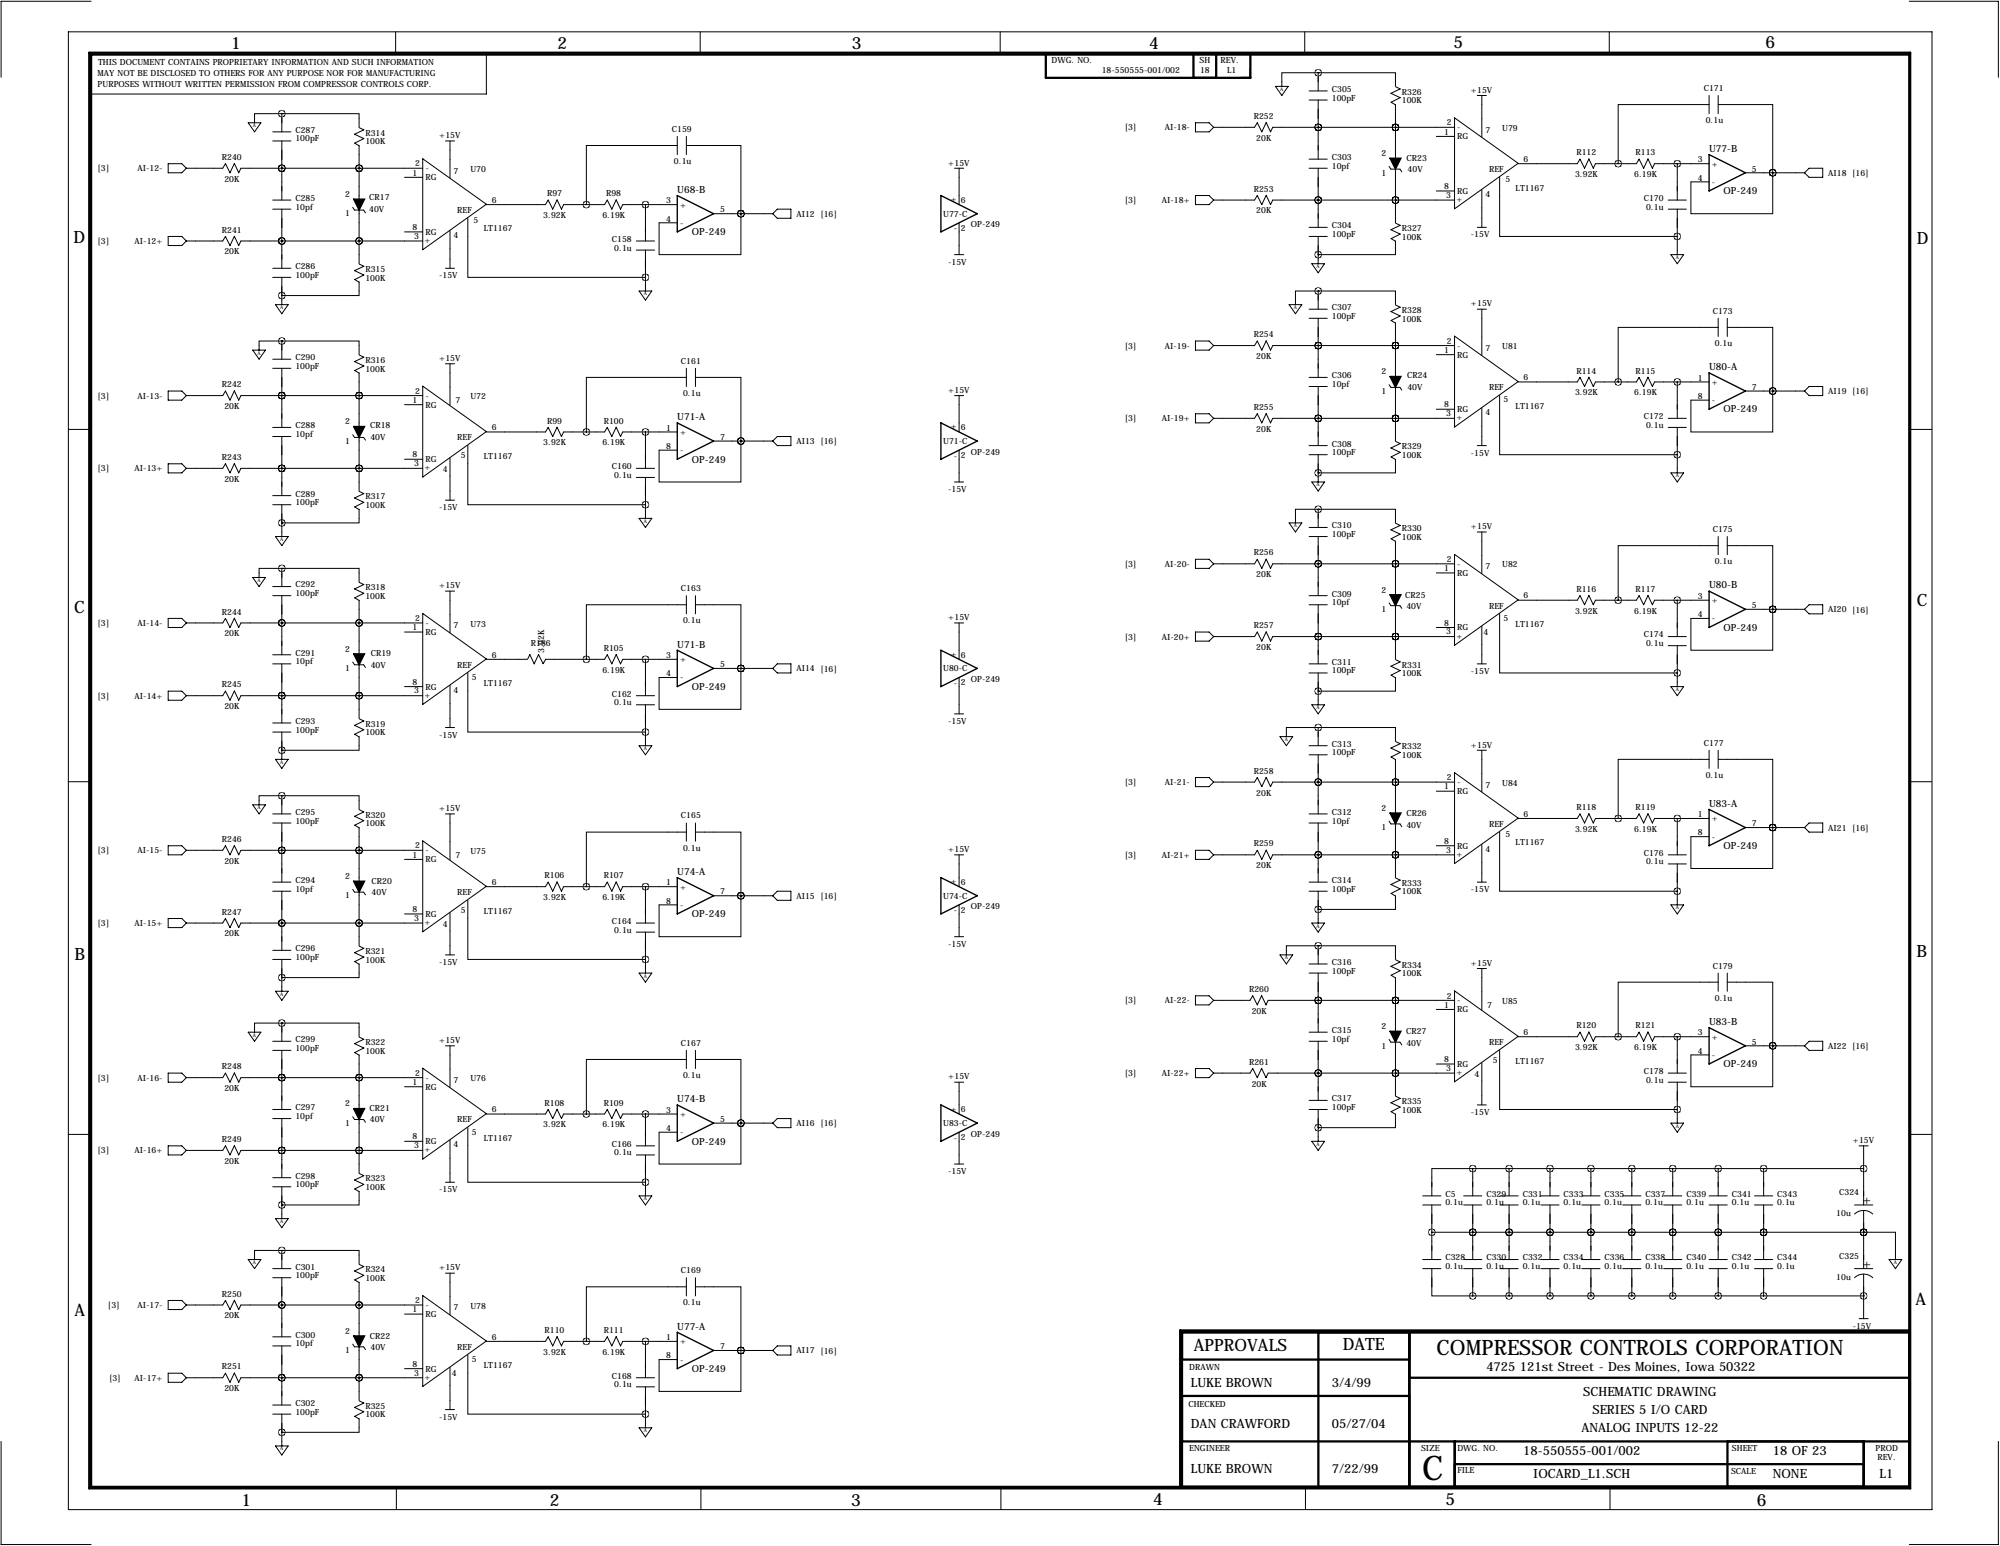
[picture p262: page 3]

APPROVALS | DATE | COMPRESSOR CONTROLS CORPORATION 4725 121st Street - Des Moines, Iowa 50322

DRAWN LUKE BROWN | 3/4/99

CHECKED

LUKE BROWN | 7/22/99
