Sayidathahaseen/CCC_NGP_ODC/NGP_ODC_Main/PDLC/VanGuard/Client Docs/Vanguard/Analog Output/Schematic_Vanguard AO.pdf

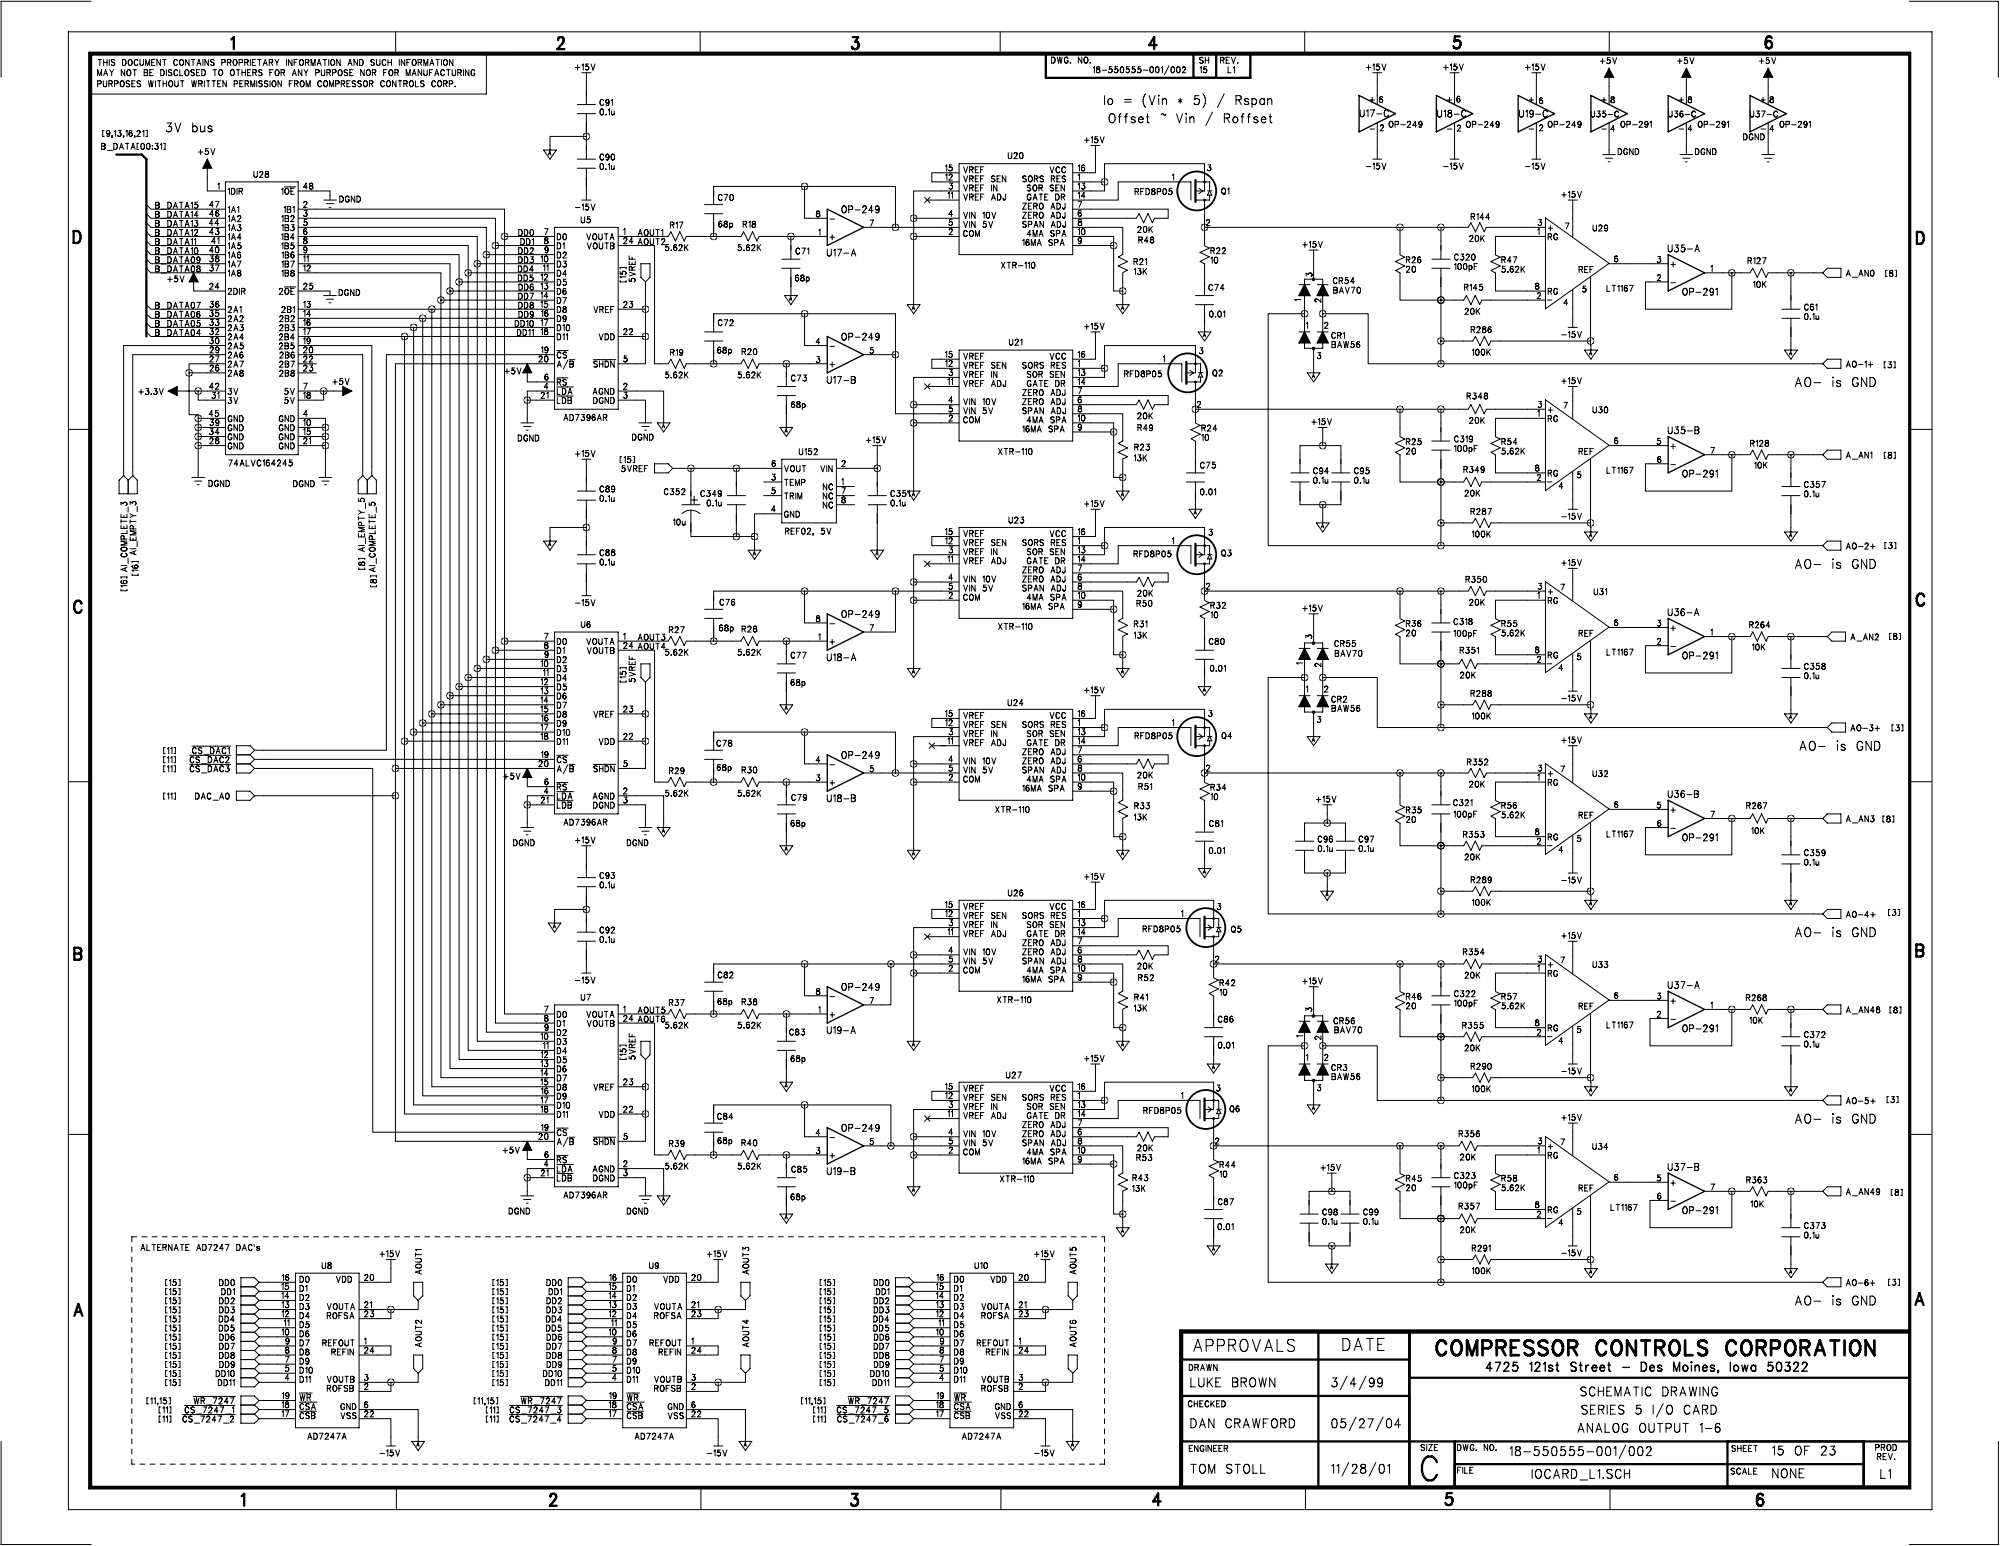
[picture p263: page 1]
