Sayidathahaseen/CCC_NGP_ODC/NGP_ODC_Main/PDLC/VanGuard/Client Docs/Vanguard/Digital Input/Schematic_Vanguard DI.pdf

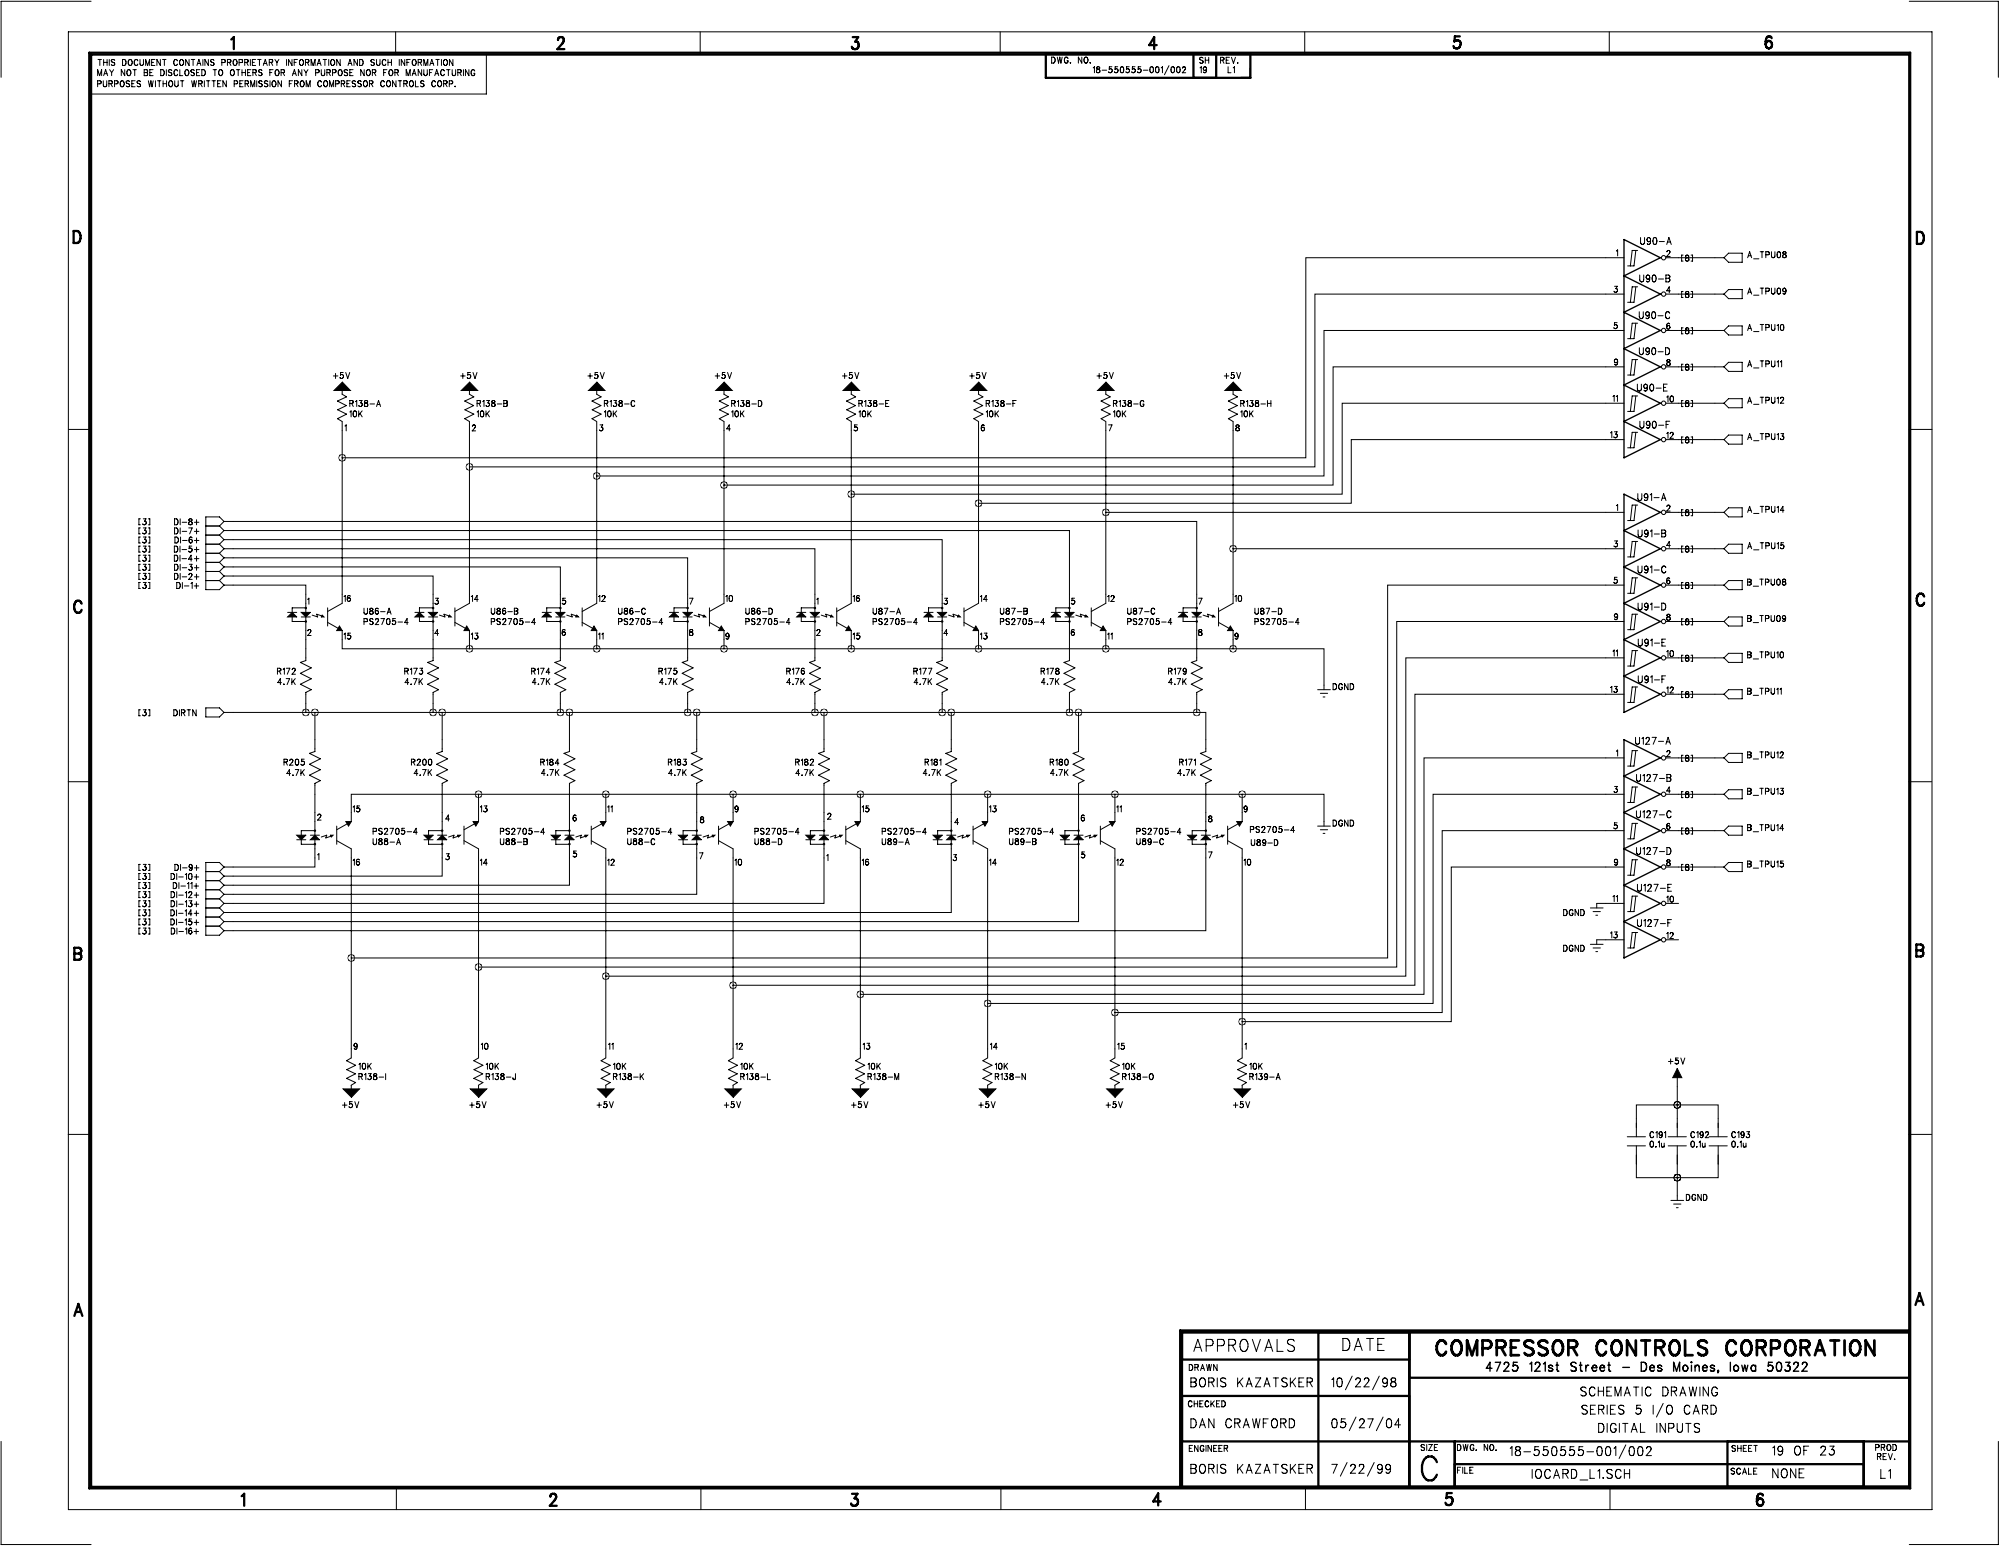
[picture p264: page 1]
