Sayidathahaseen/CCC_NGP_ODC/NGP_ODC_Main/PDLC/VanGuard/Client Docs/Vanguard/Digital Output/Schematic_Vanguard DO.pdf

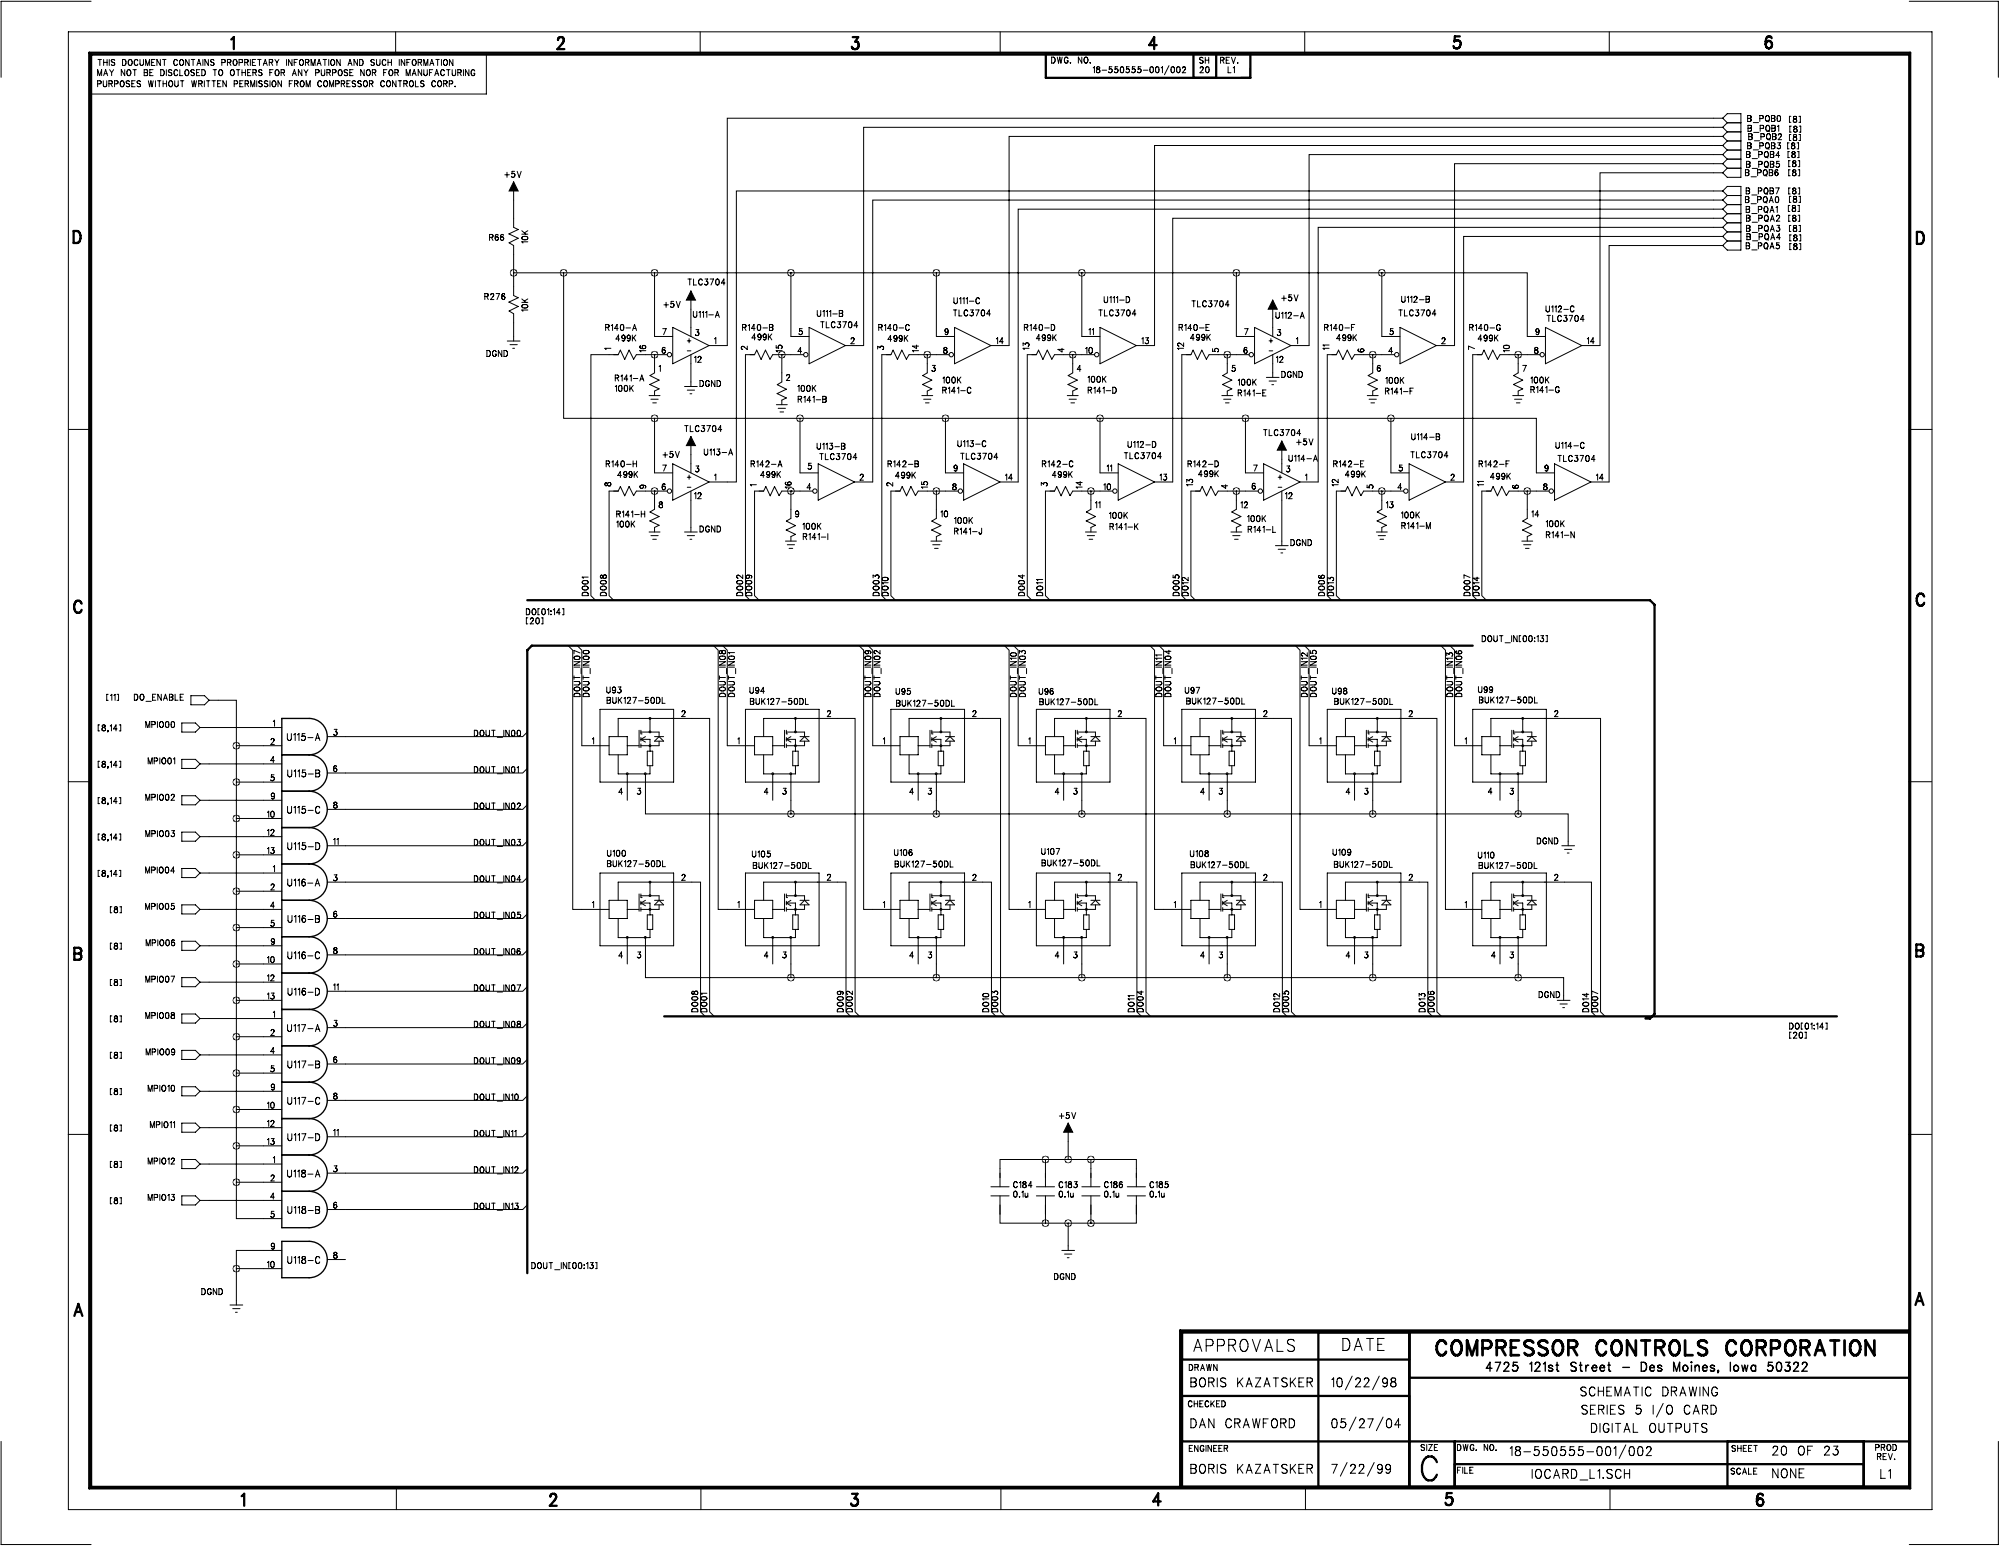
[picture p265: page 1]
