Sayidathahaseen/CCC_NGP_ODC/NGP_ODC_Main/PDLC/VanGuard/Client Docs/Vanguard/Frequency Input/Schematic_Vanguard FI.pdf

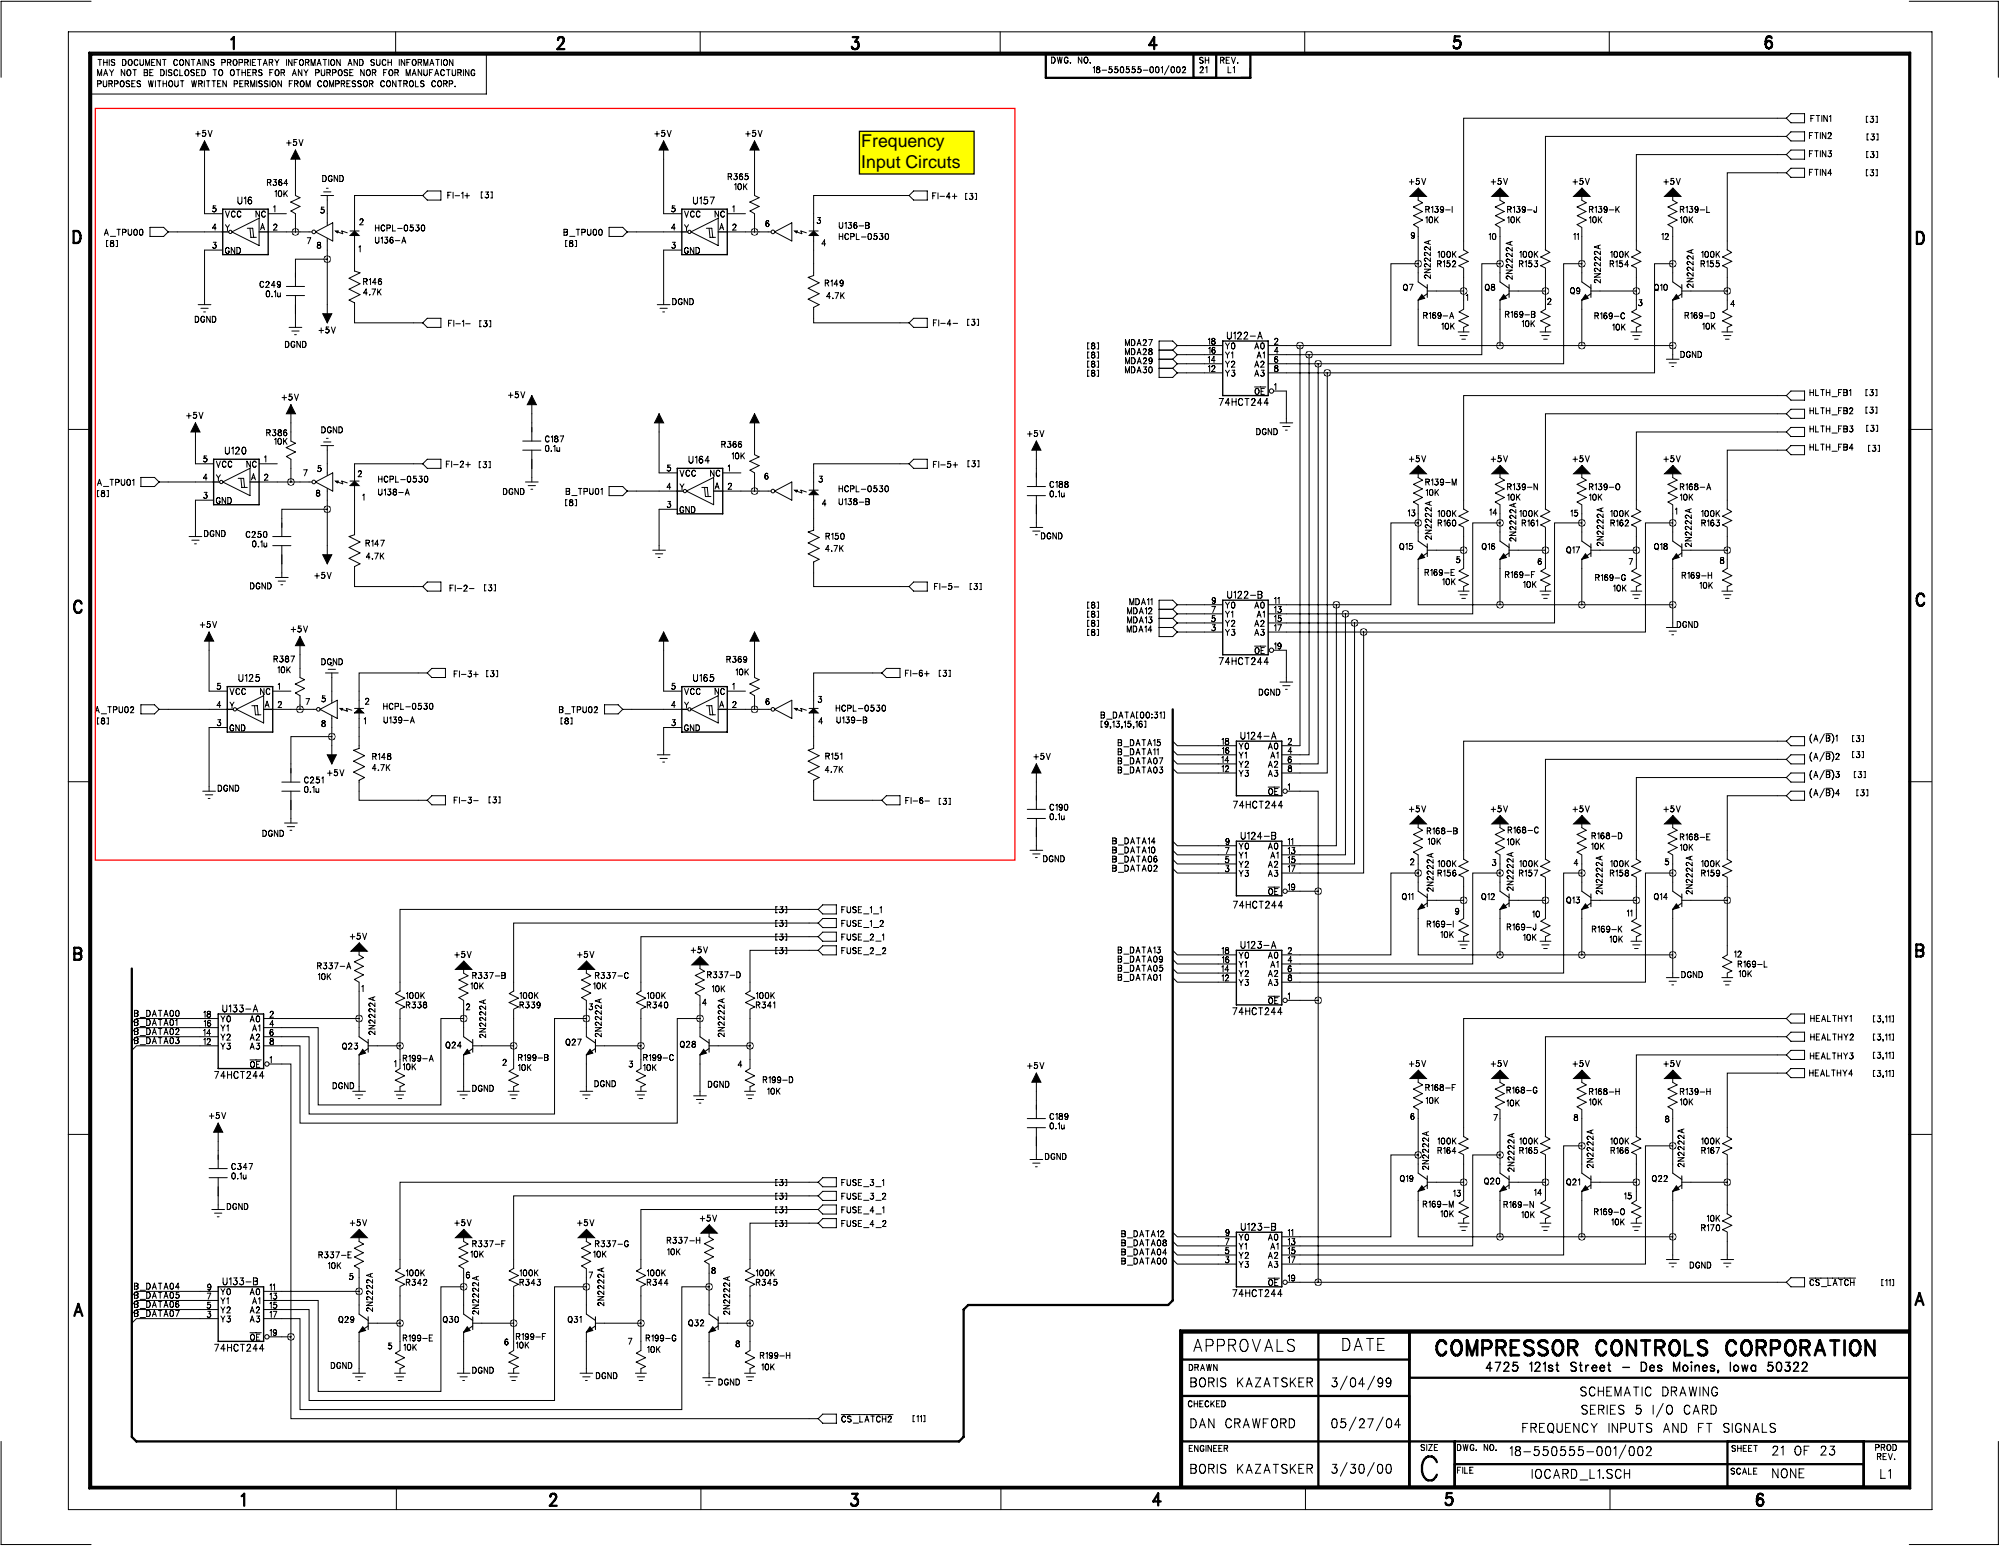
[picture p266: page 1]
