Sayidathahaseen/CCC_NGP_ODC/NGP_ODC_Main/PDLC/Prodigy HW files/IOP-AM1/REV3/SCHEMATIC/CCCNGP_IOP_AM_REV3.pdf

APPROVALS | DATE | COMPRESSOR CONTROLS CORPORATION 4725 121st Street - Des Moines, Iowa 50323
DRAWN Amith Thomas | 15.02.12
CHECKED Muthuvelu D | 15.02.12
ENGINEER | | SIZE C | DWG. NO. | SHEET 1 of 19 | PROD REV. 3.0
| | | FILE | SCALE

A

B

C

D

1 | 2 | 3 | 4 | 5 | 6
THIS DOCUMENT CONTAINS PROPRIETARY INFORMATION AND SUCH INFORMATION MAY NOT BE DISCLOSED TO OTHERS FOR ANY PURPOSE NOR FOR MANUFACTURING PURPOSES WITHOUT WRITTEN PERMISSION FROM COMPRESSOR CONTROLS CORP. | | DWG. NO. | SH | REV.

D

C

B

A

REV | DATE | AUTHOR | DESCRIPTION/MODIFICATIONS
1.0 1.1 3.0 | 29.07.11 11.10.11 23.02.12 | Amith Thomas Muthuvelu.D Muthuvelu.D Muthuvelu.D | Preliminary release

# REVISION HISTORY

# NEXT GENERATION PLATFORM

# IOP_AM1 ANALOG BOARD R3P0

D

D

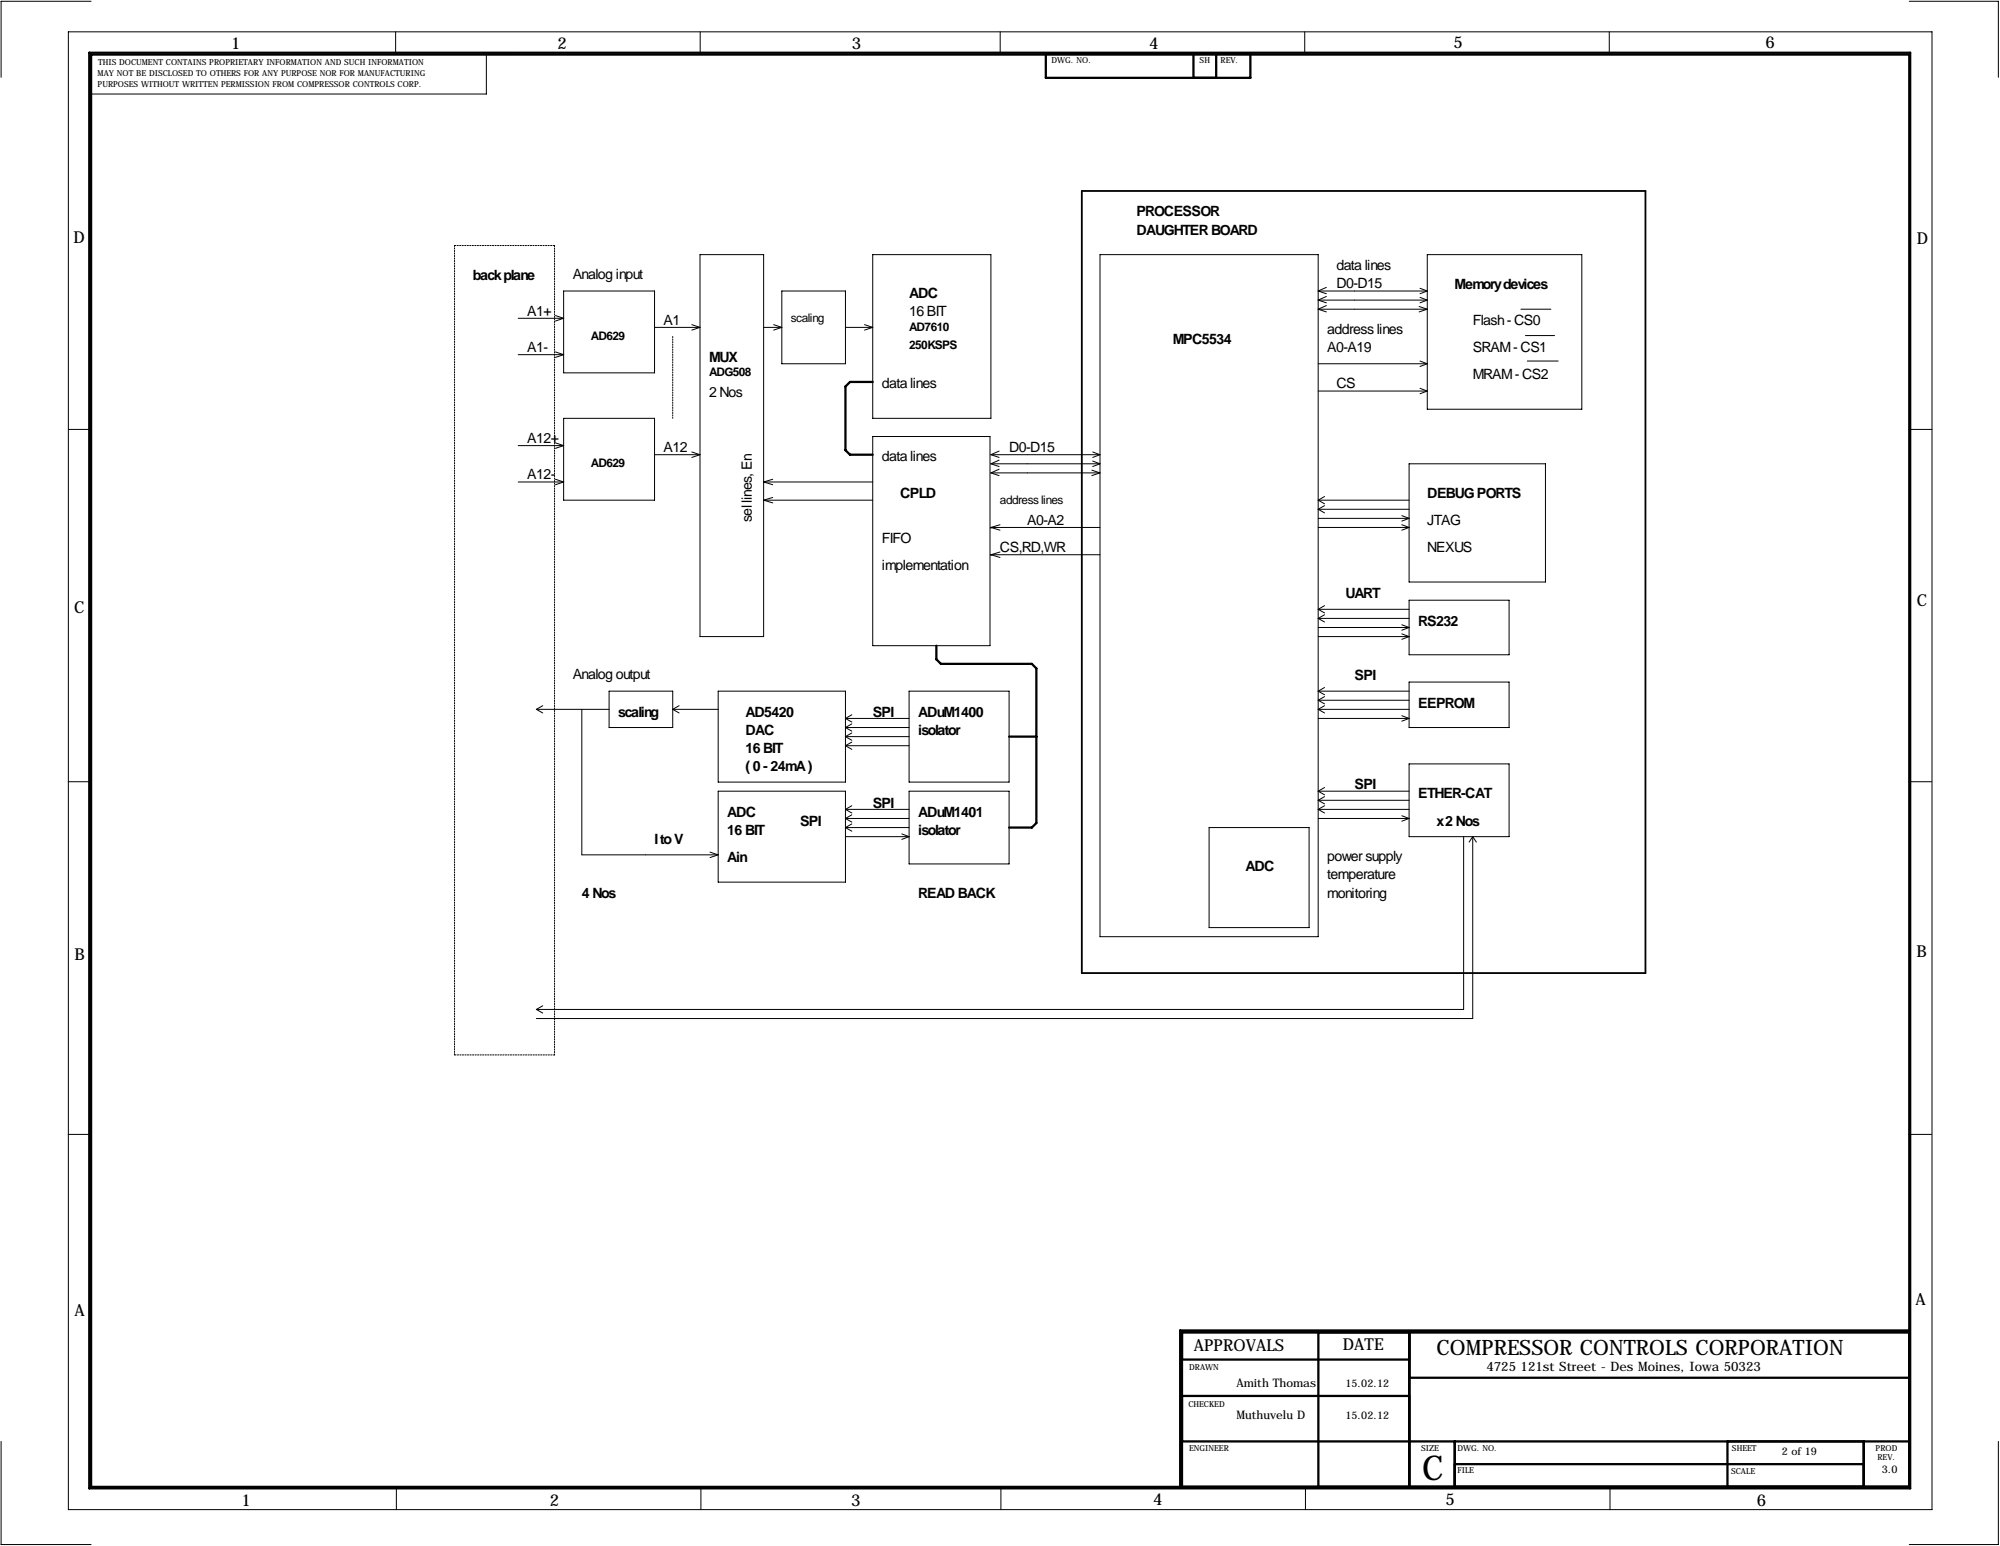
[picture p267: page 2]
power supply; monitoring; data lines D0-D15; address lines A0-A19; READ BACK; 16 BIT; SPI; Ain; ADC; ADuM1400; isolator; DAC 16 BIT ( 0 - 24mA ); 4 Nos; Analog input; Analog output; scaling; data lines; PROCESSOR DAUGHTER BOARD; ADuM1401; back plane; temperature; DEBUG PORTS; JTAG; NEXUS; EEPROM; MPC5534; Memory devices; Flash - CS0; SRAM - CS1; MRAM - CS2; FIFO; implementation; ADG508; 2 Nos; MUX; 250KSPS; CPLD; ETHER-CAT; x 2 Nos

sel lines, En

address lines A0-A2

CS,RD,WR | UART

APPROVALS | DATE | COMPRESSOR CONTROLS CORPORATION 4725 121st Street - Des Moines, Iowa 50323

DRAWN Amith Thomas | 15.02.12

CHECKED

D

D

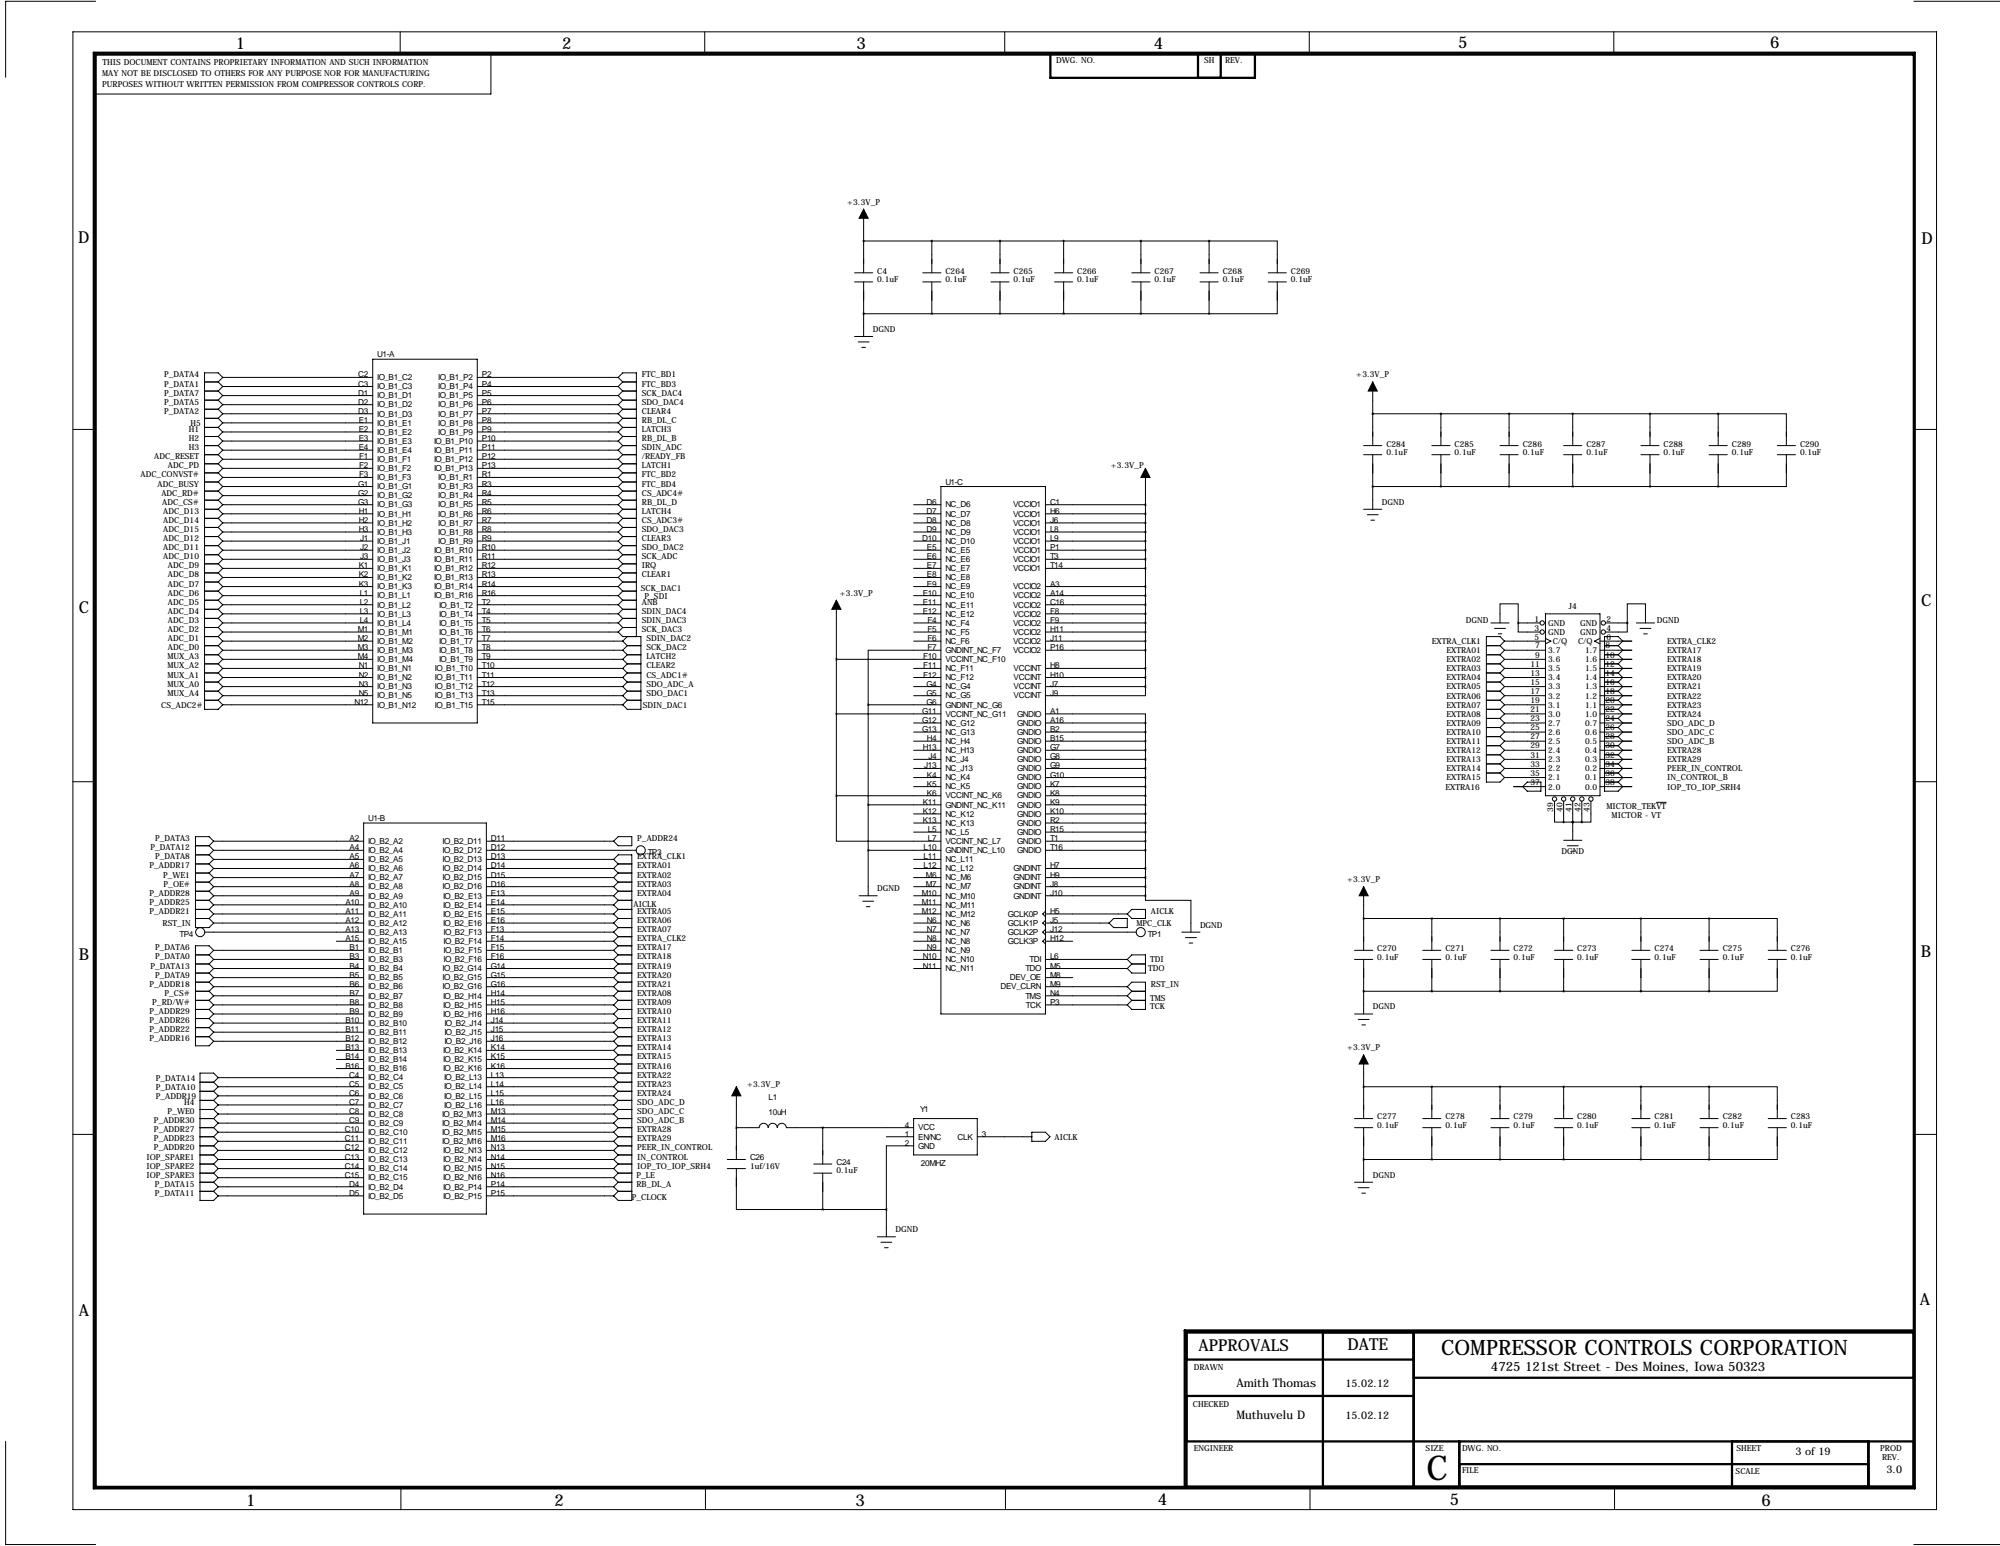
[picture p268: page 3]

APPROVALS | DATE | COMPRESSOR CONTROLS CORPORATION 4725 121st Street - Des Moines, Iowa 50323

DRAWN Amith Thomas | 15.02.12

CHECKED

D
D

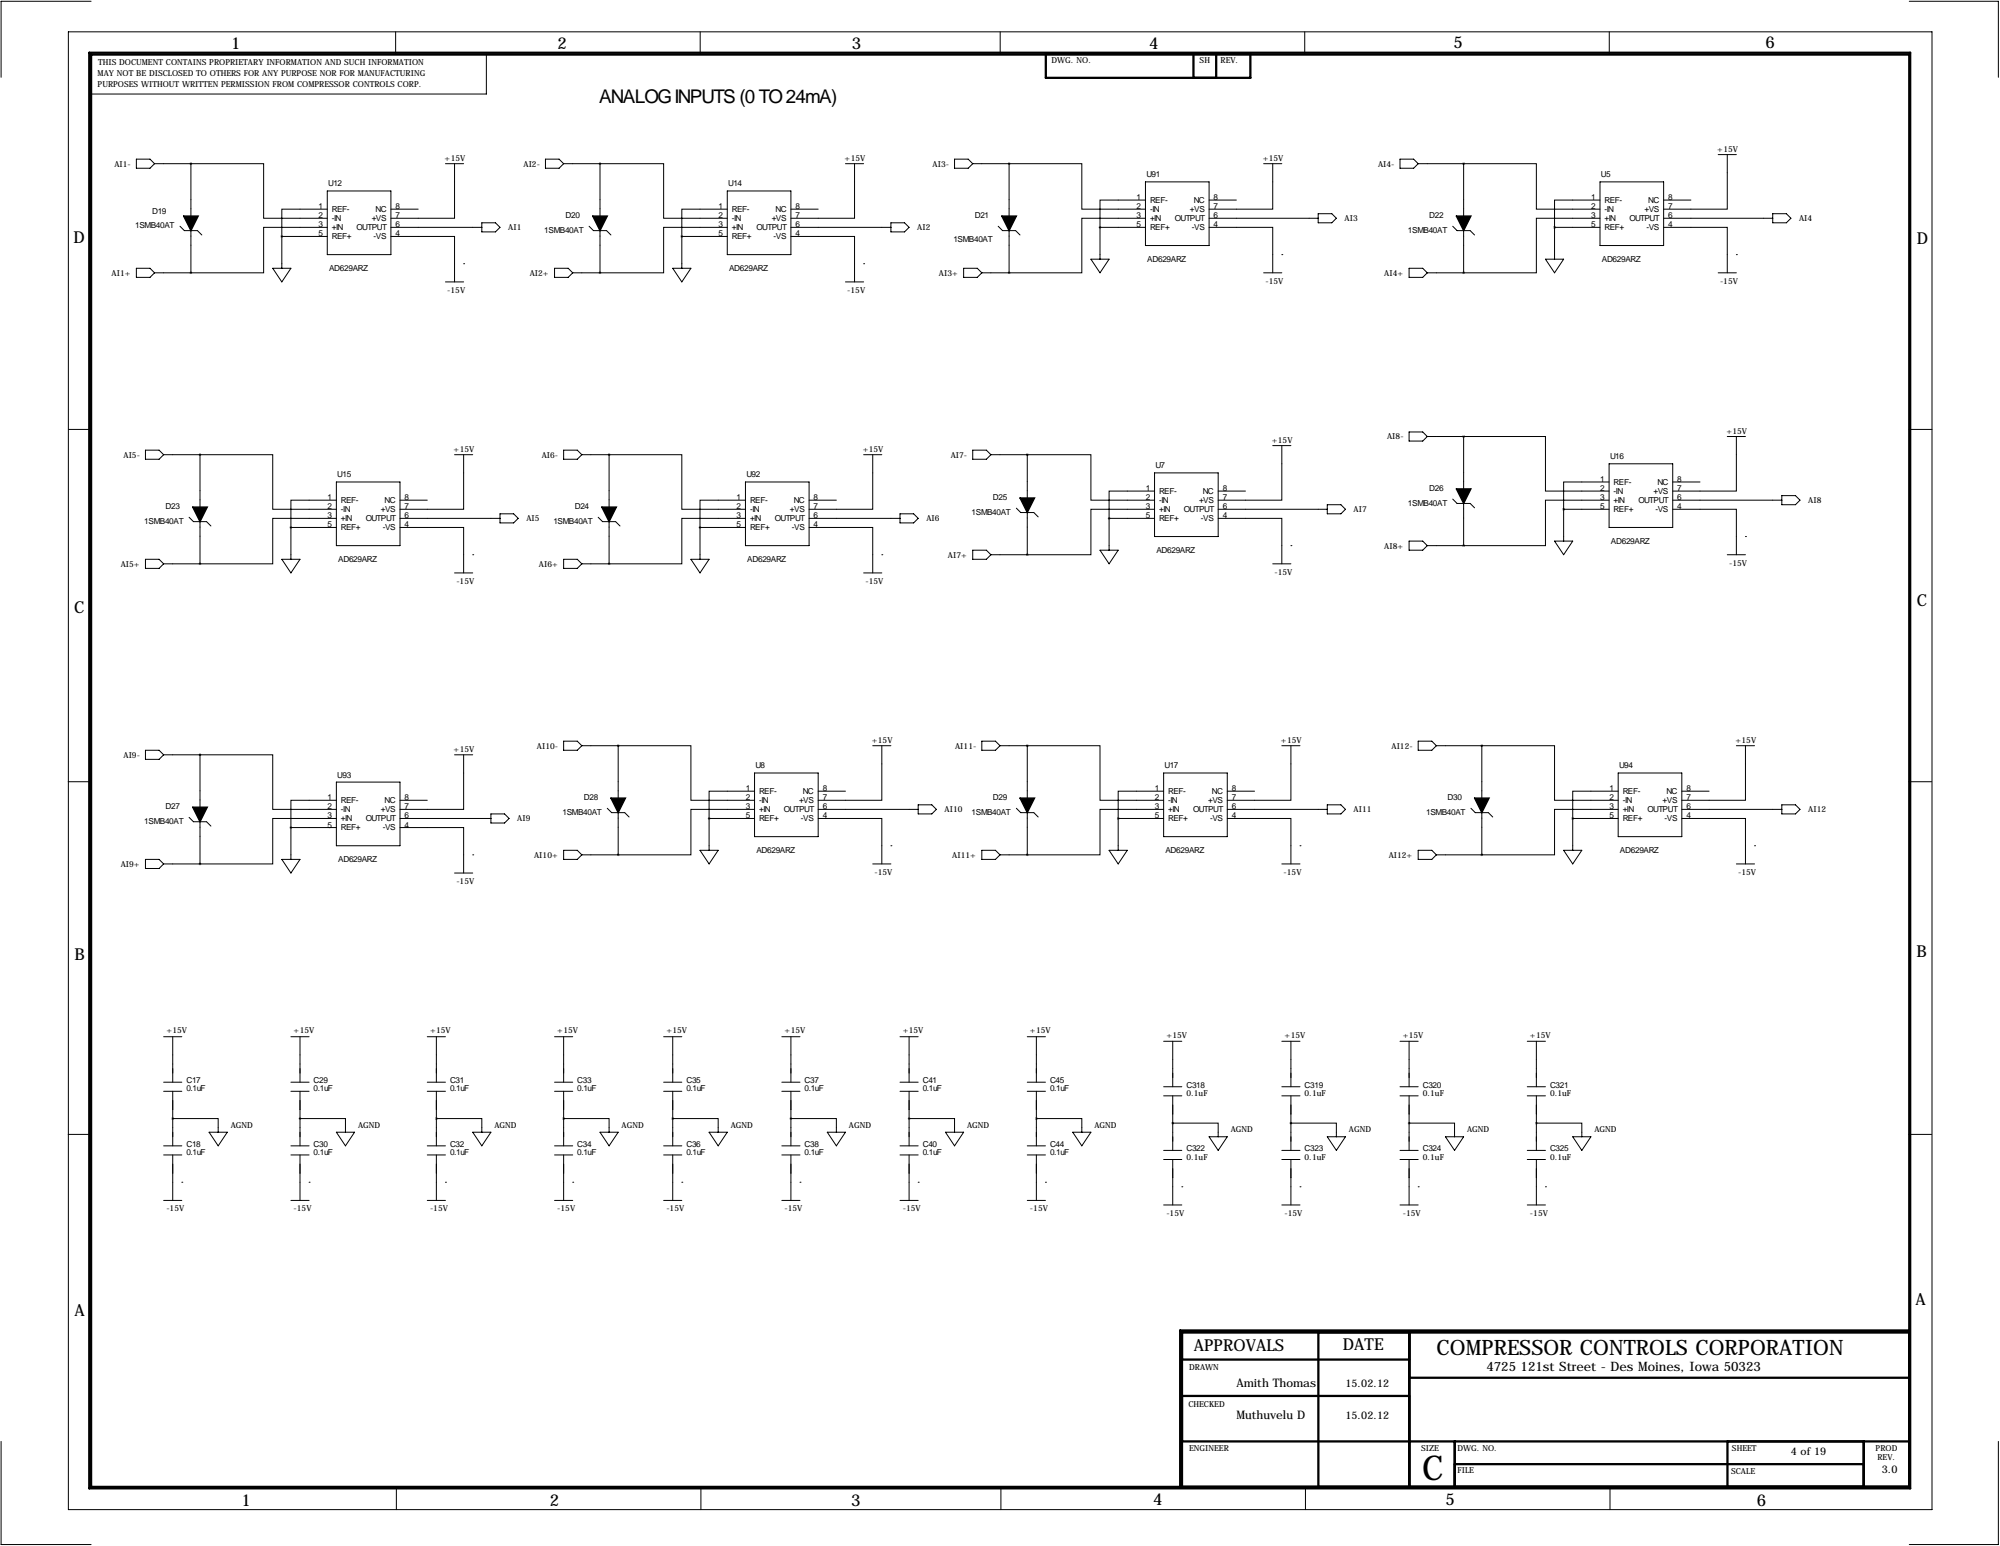
[picture p269: page 4]

APPROVALS | DATE | COMPRESSOR CONTROLS CORPORATION 4725 121st Street - Des Moines, Iowa 50323

DRAWN Amith Thomas | 15.02.12

CHECKED

D
D

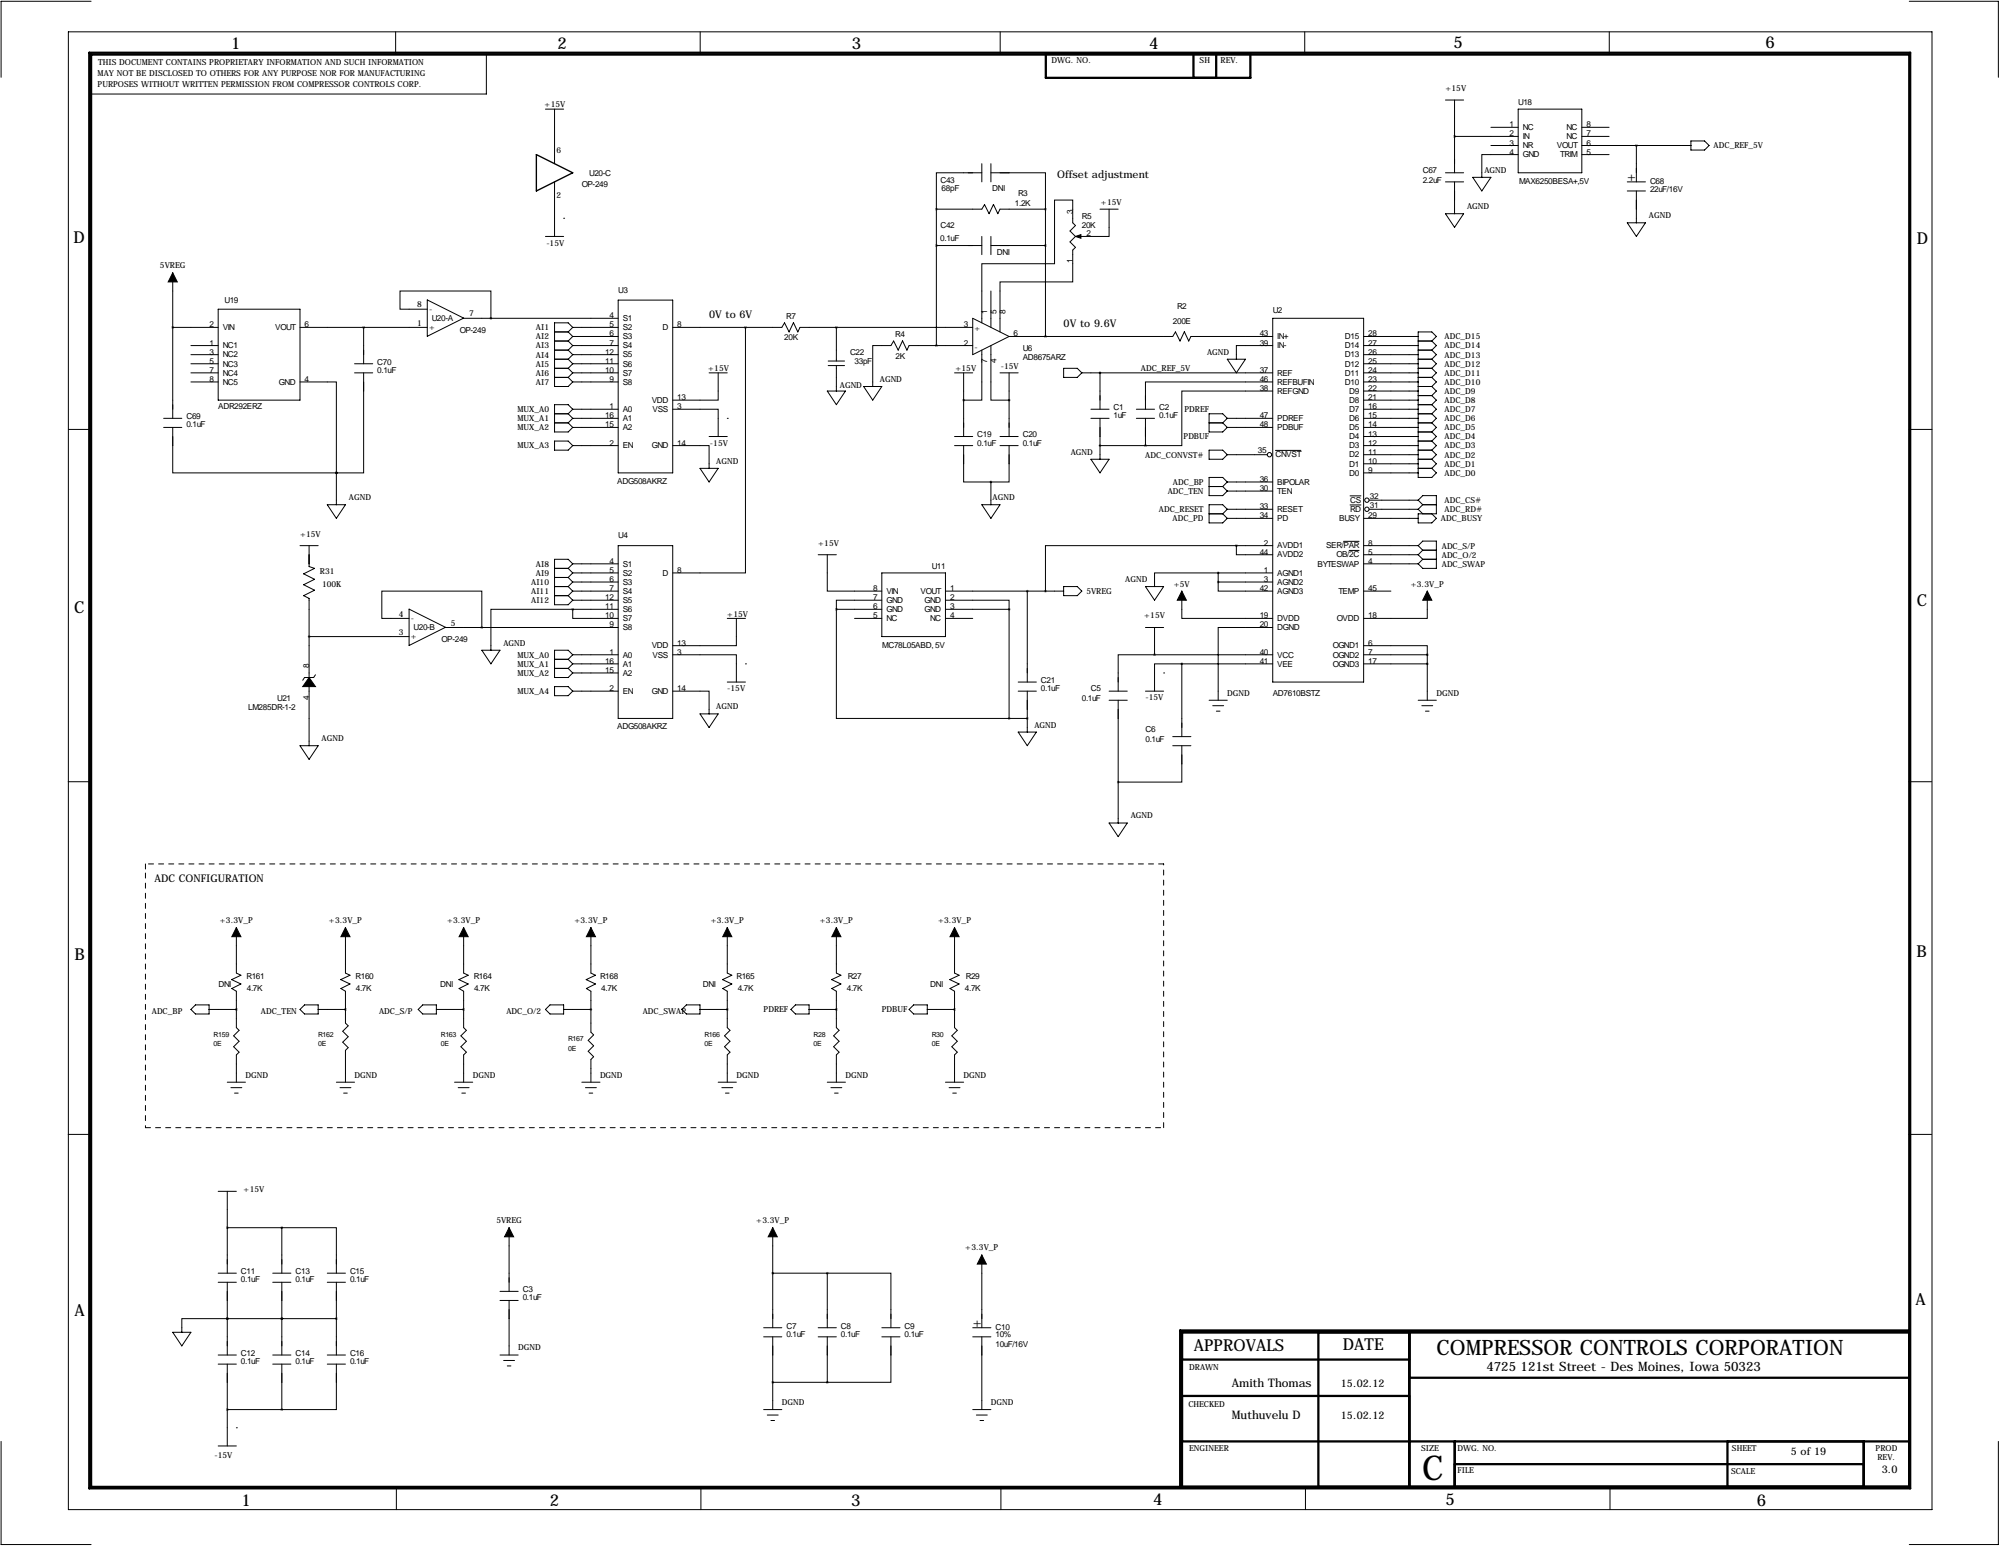
[picture p270: page 5]

APPROVALS | DATE | COMPRESSOR CONTROLS CORPORATION 4725 121st Street - Des Moines, Iowa 50323

DRAWN Amith Thomas | 15.02.12

CHECKED

D

D

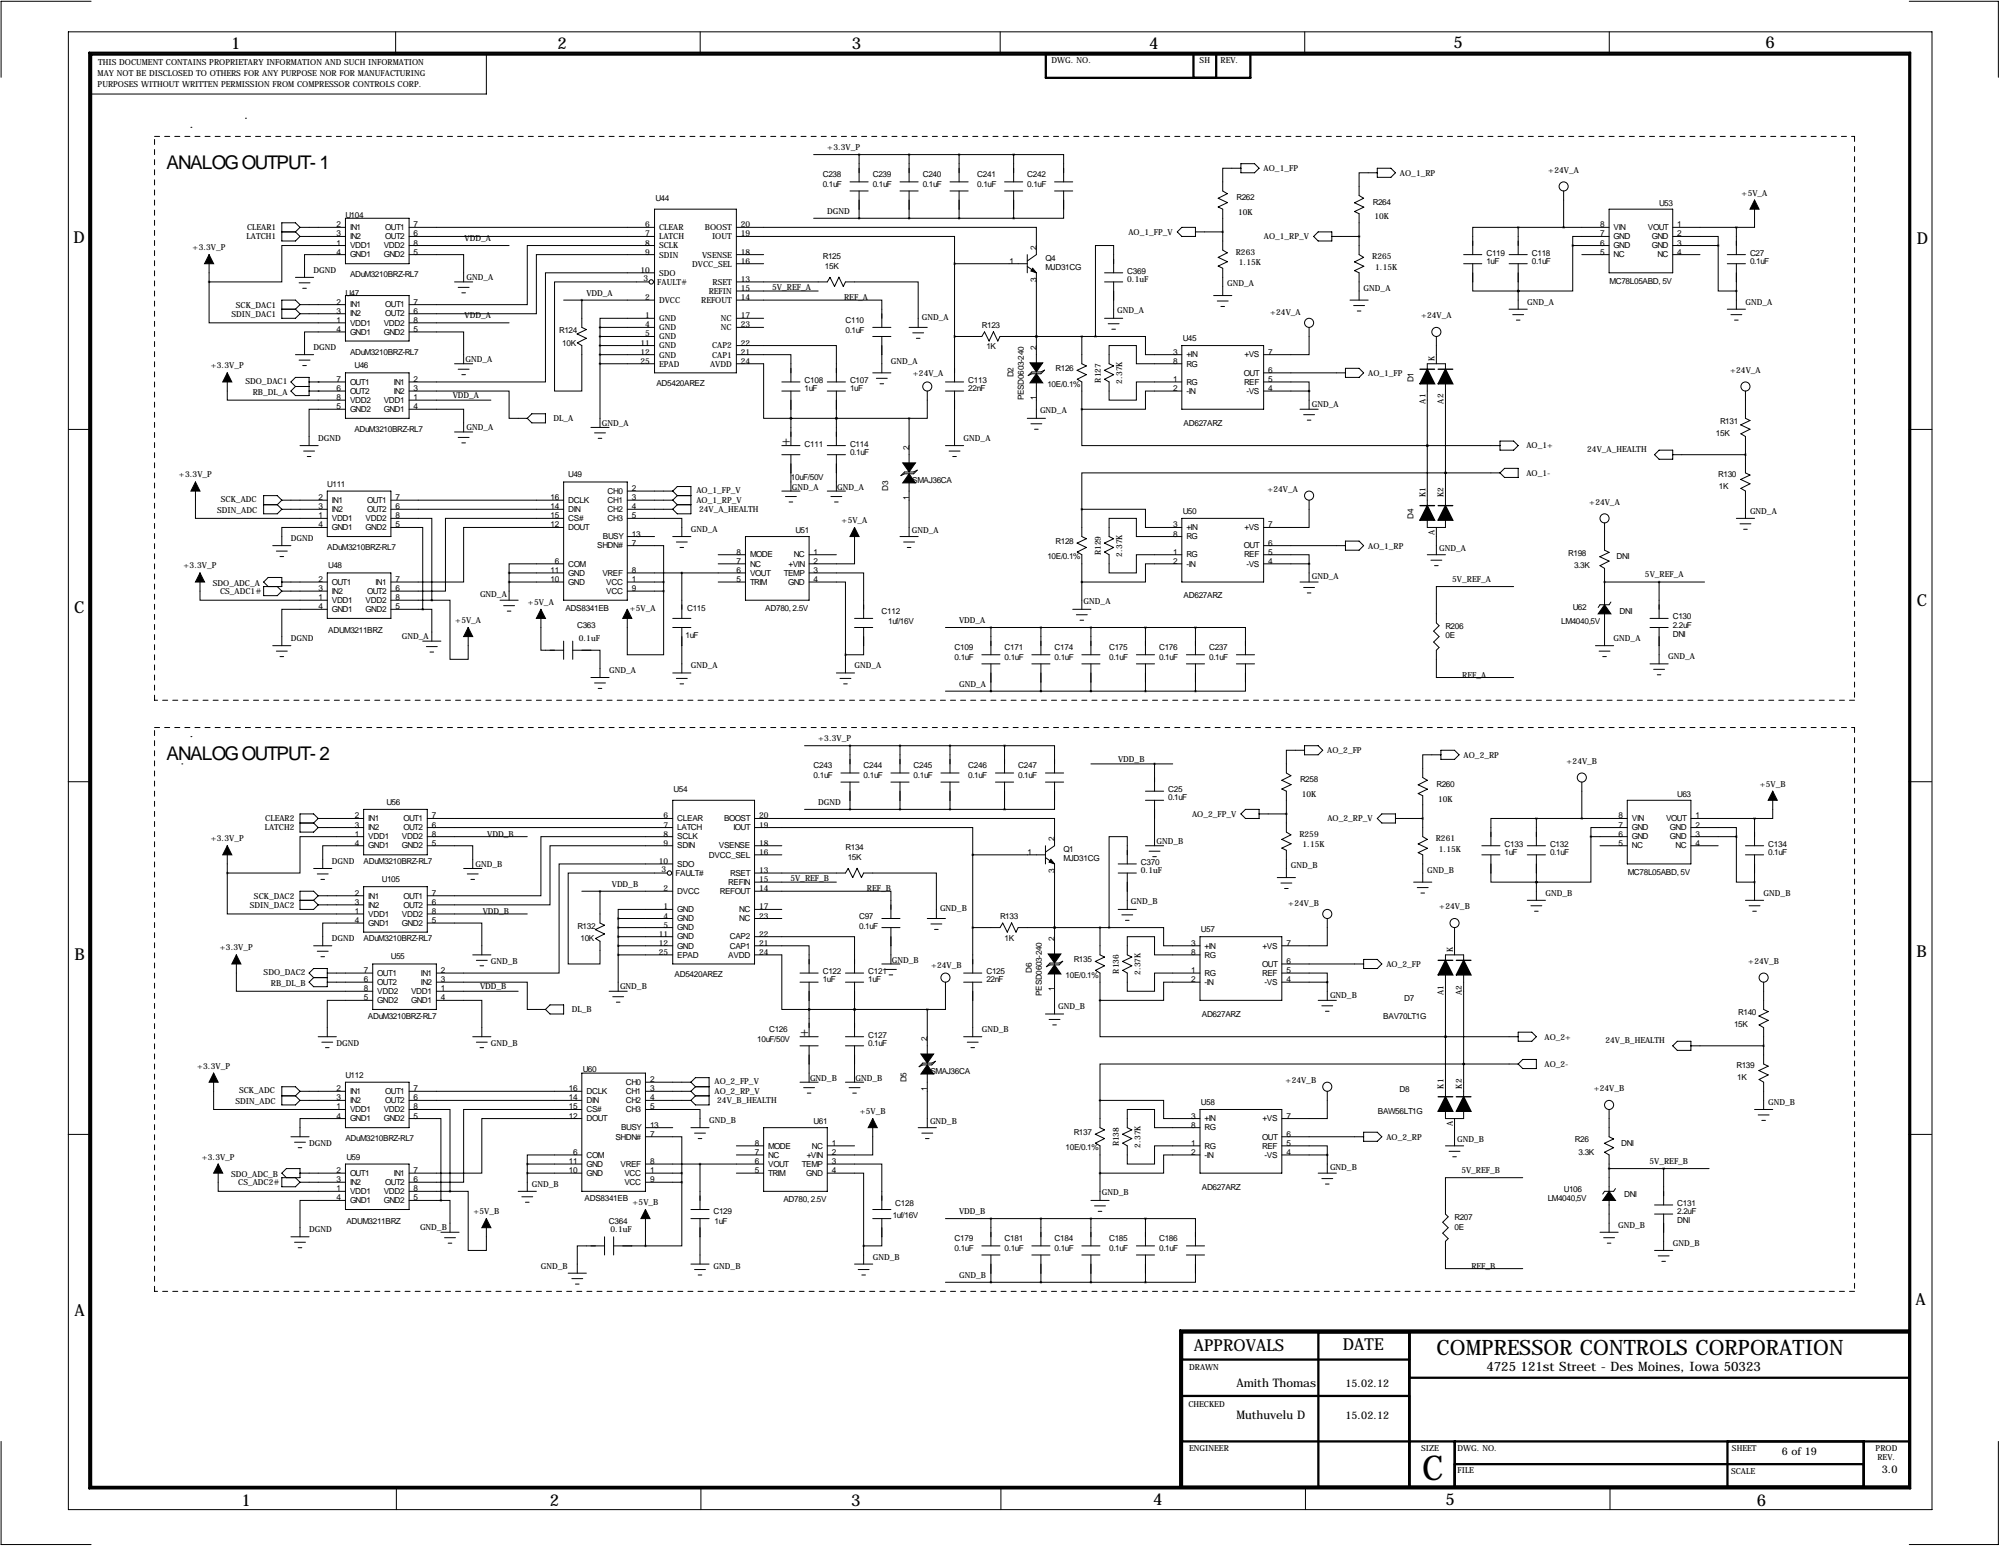
[picture p271: page 6]

APPROVALS | DATE | COMPRESSOR CONTROLS CORPORATION 4725 121st Street - Des Moines, Iowa 50323

DRAWN Amith Thomas | 15.02.12

CHECKED

D

D

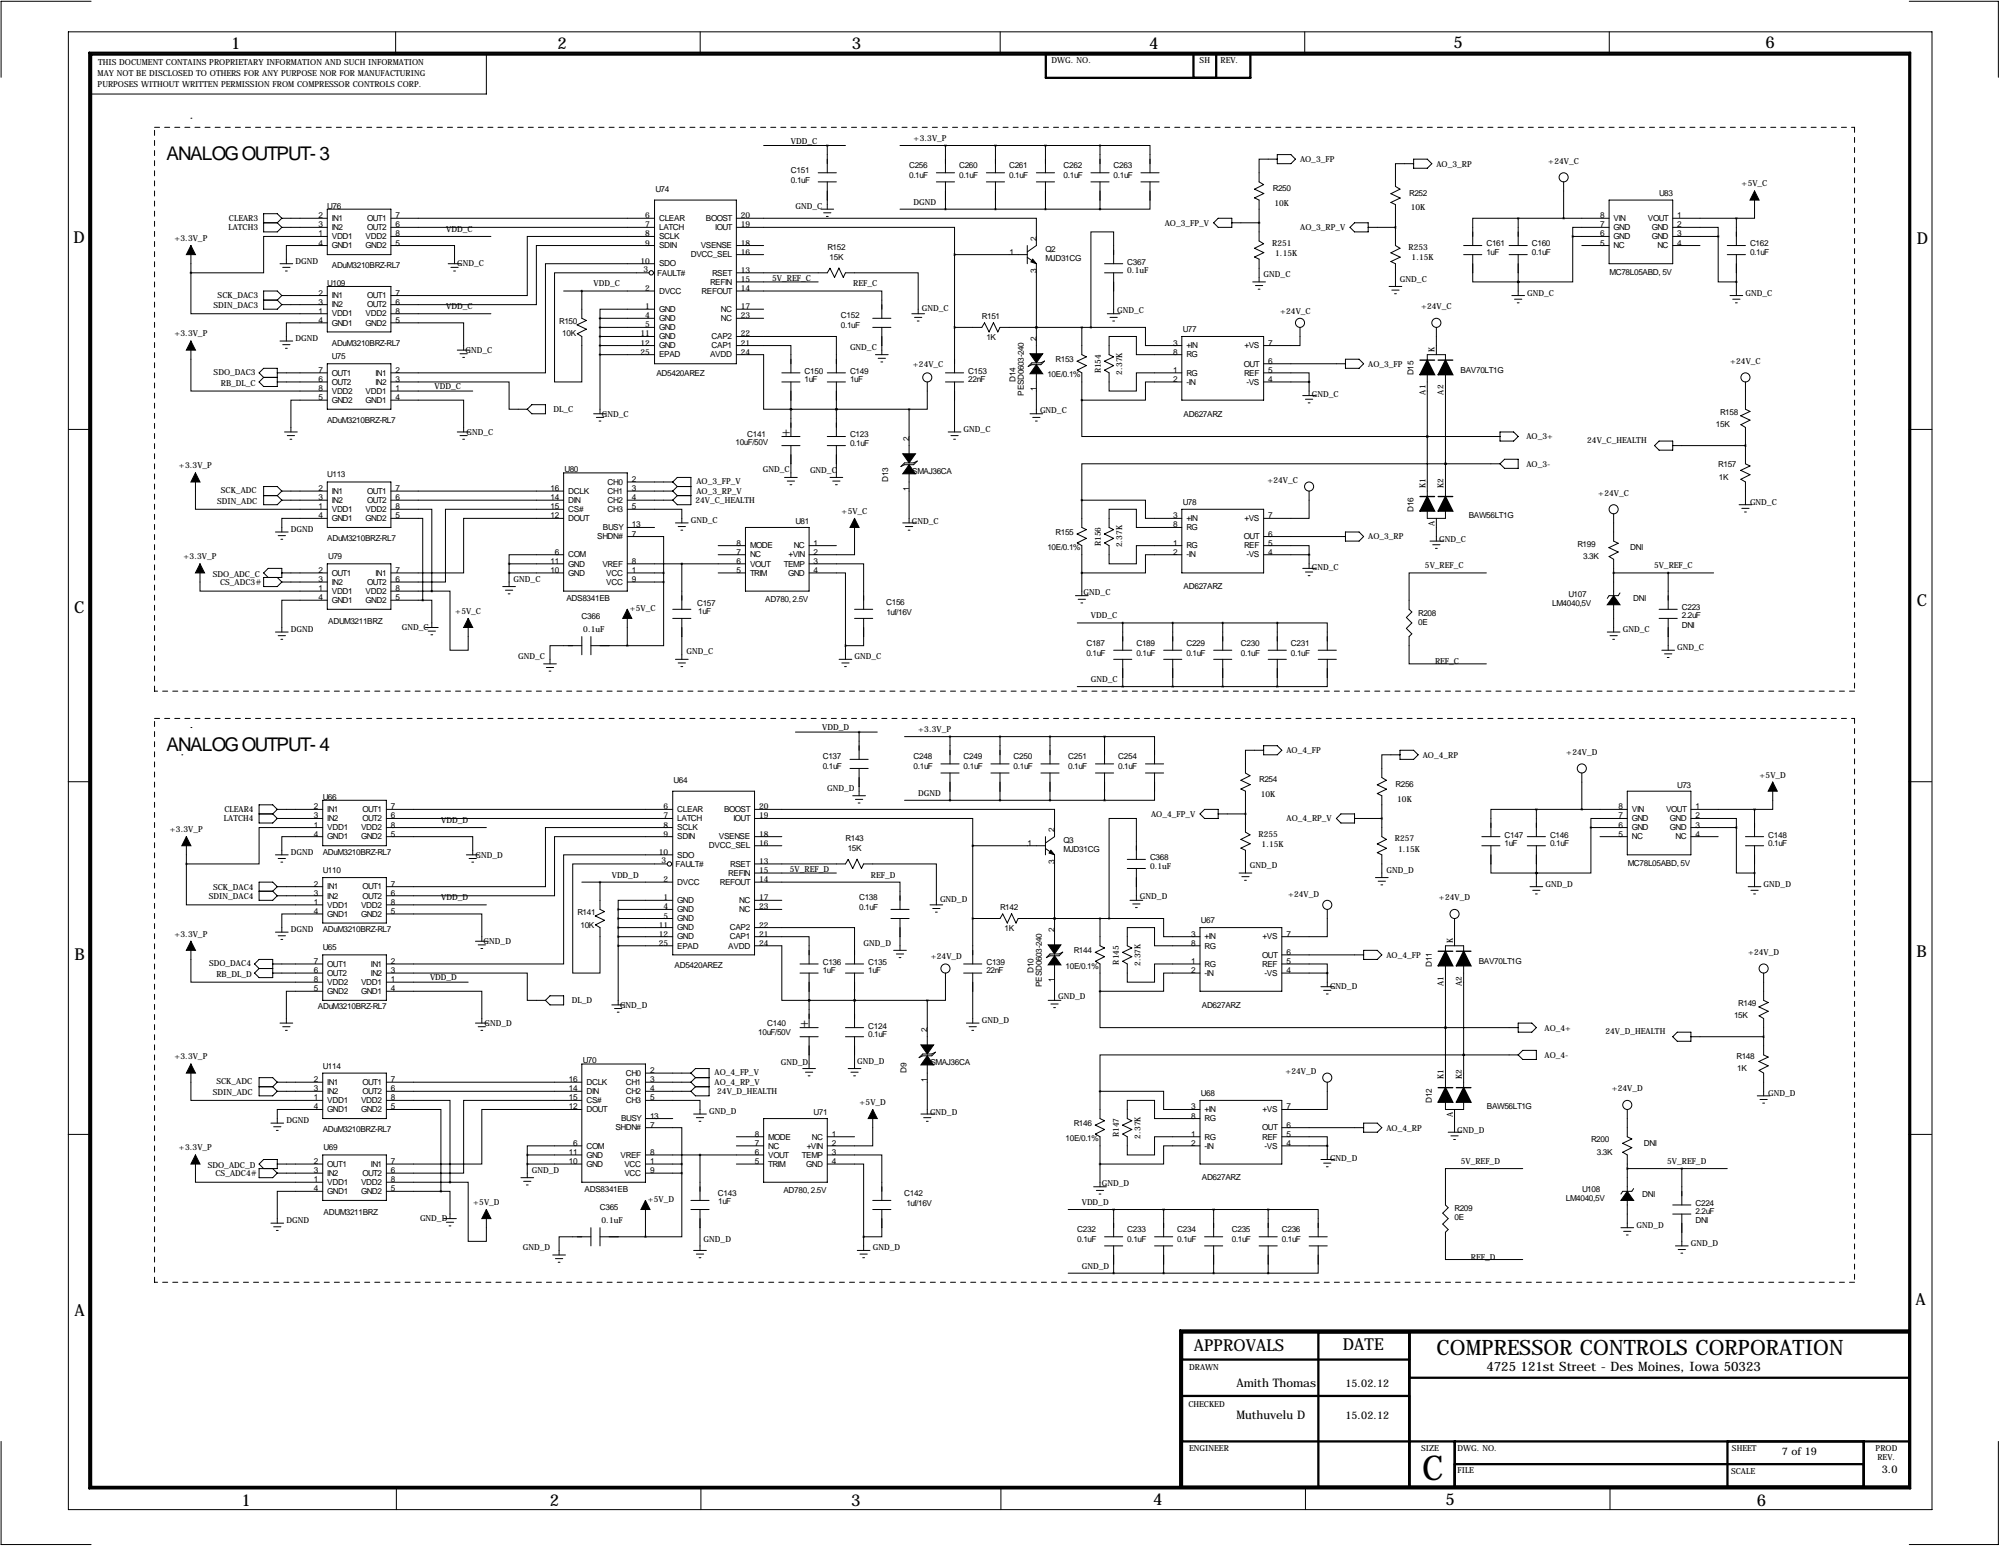
[picture p272: page 7]

APPROVALS | DATE | COMPRESSOR CONTROLS CORPORATION 4725 121st Street - Des Moines, Iowa 50323

DRAWN Amith Thomas | 15.02.12

CHECKED

D
D

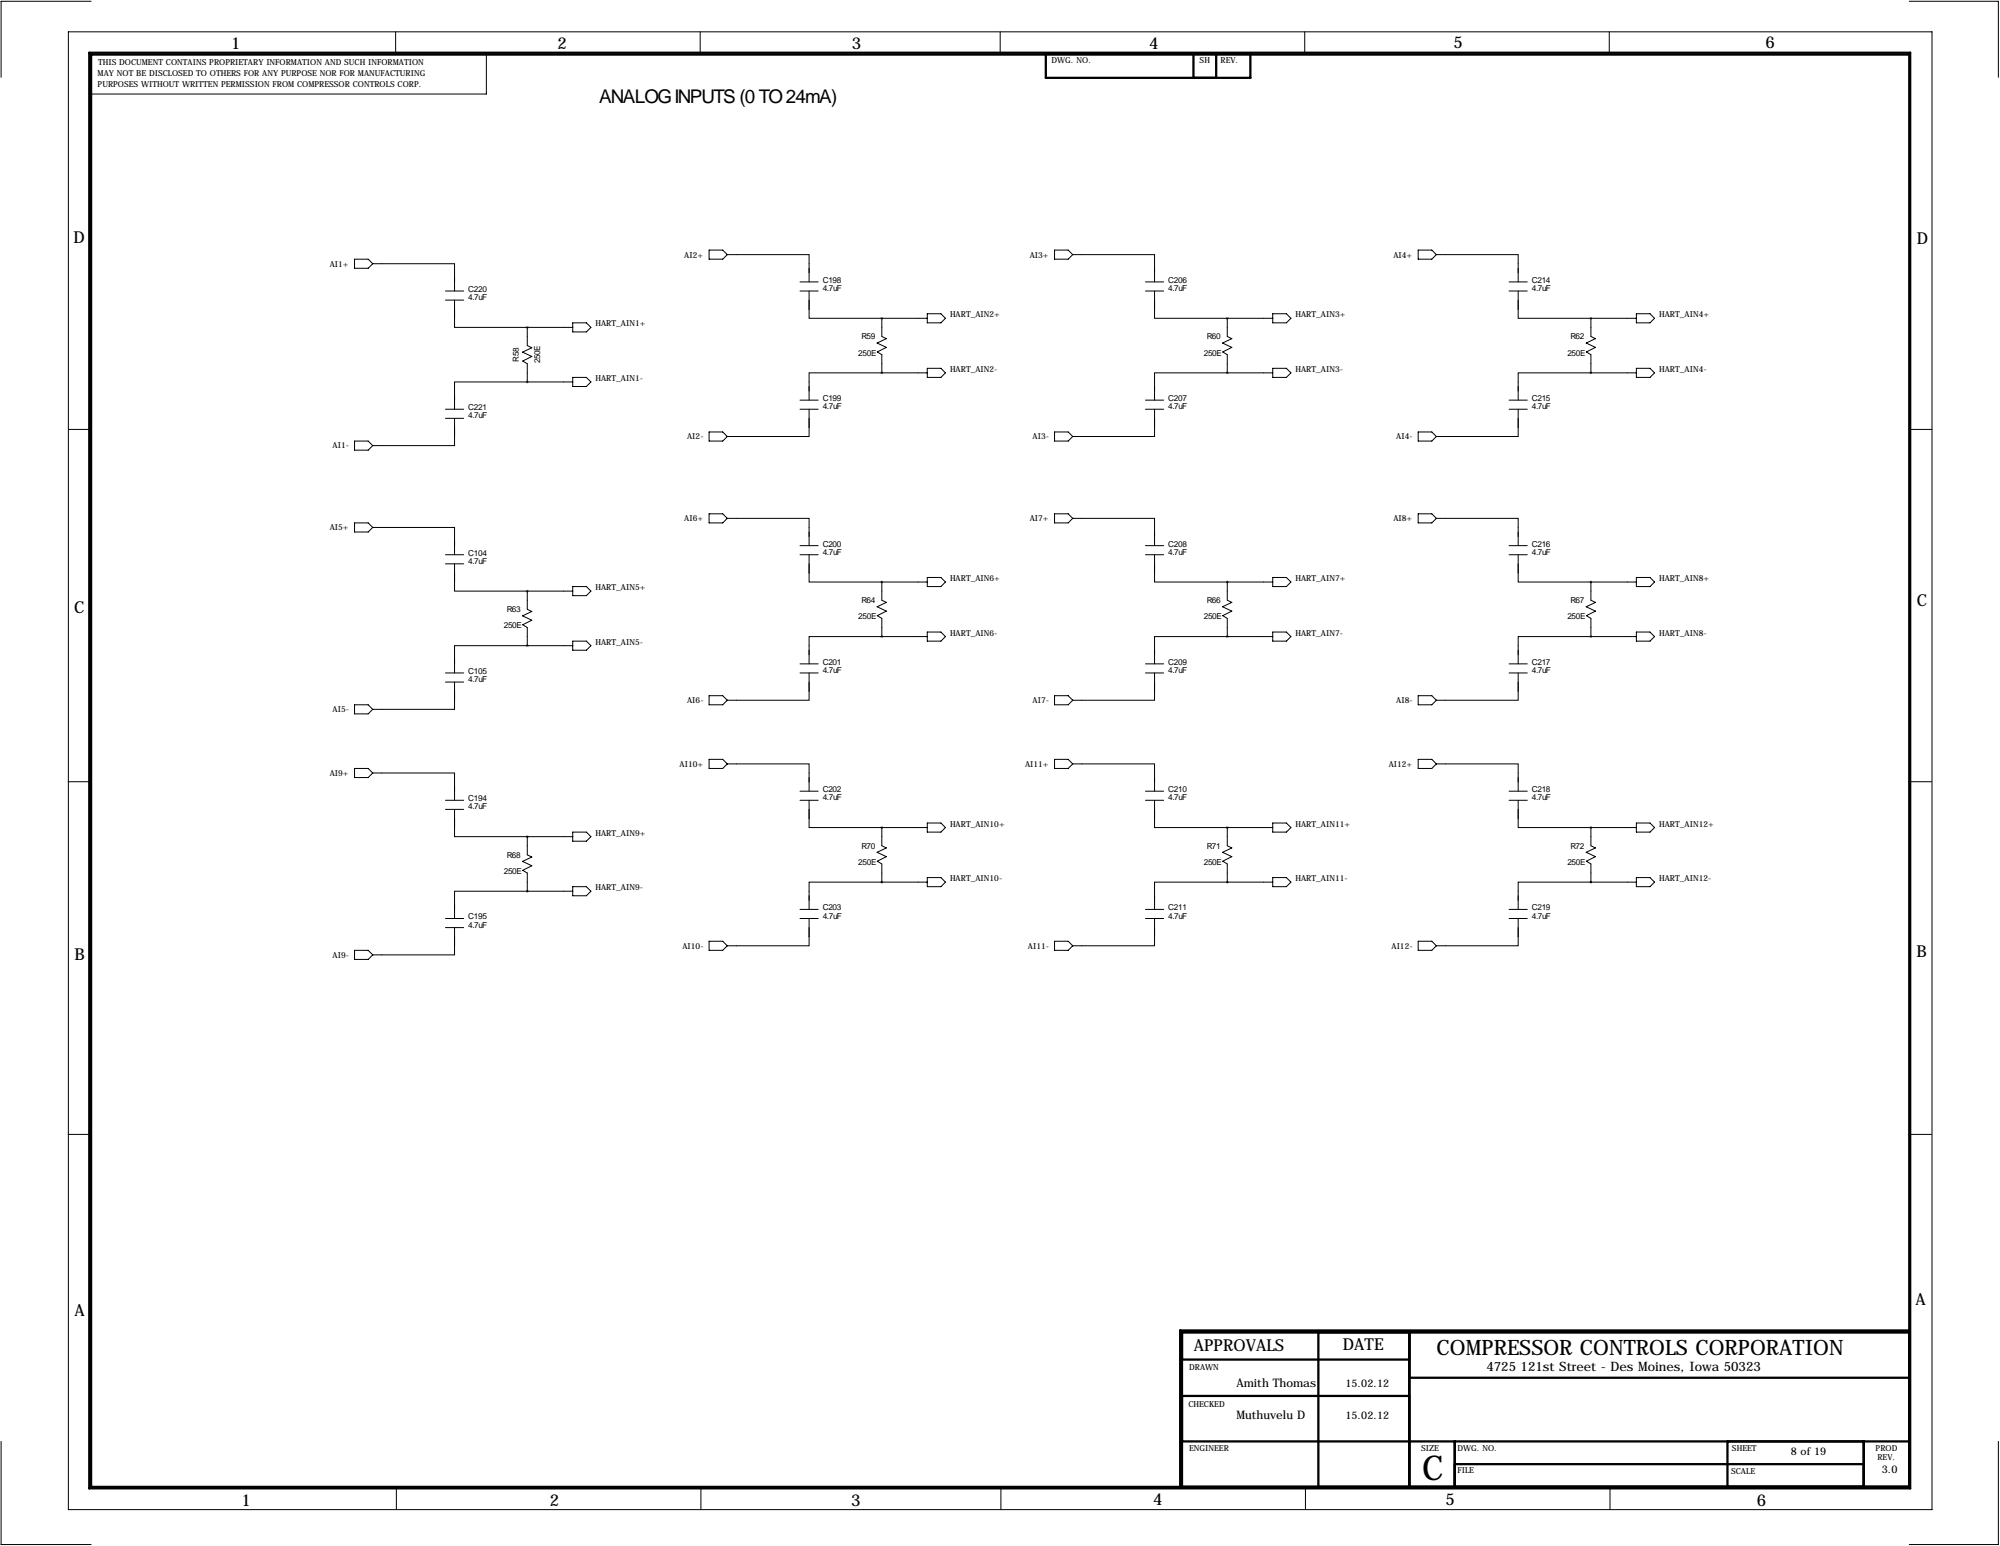
[picture p273: page 8]

APPROVALS | DATE | COMPRESSOR CONTROLS CORPORATION 4725 121st Street - Des Moines, Iowa 50323

DRAWN Amith Thomas | 15.02.12

CHECKED

D

D

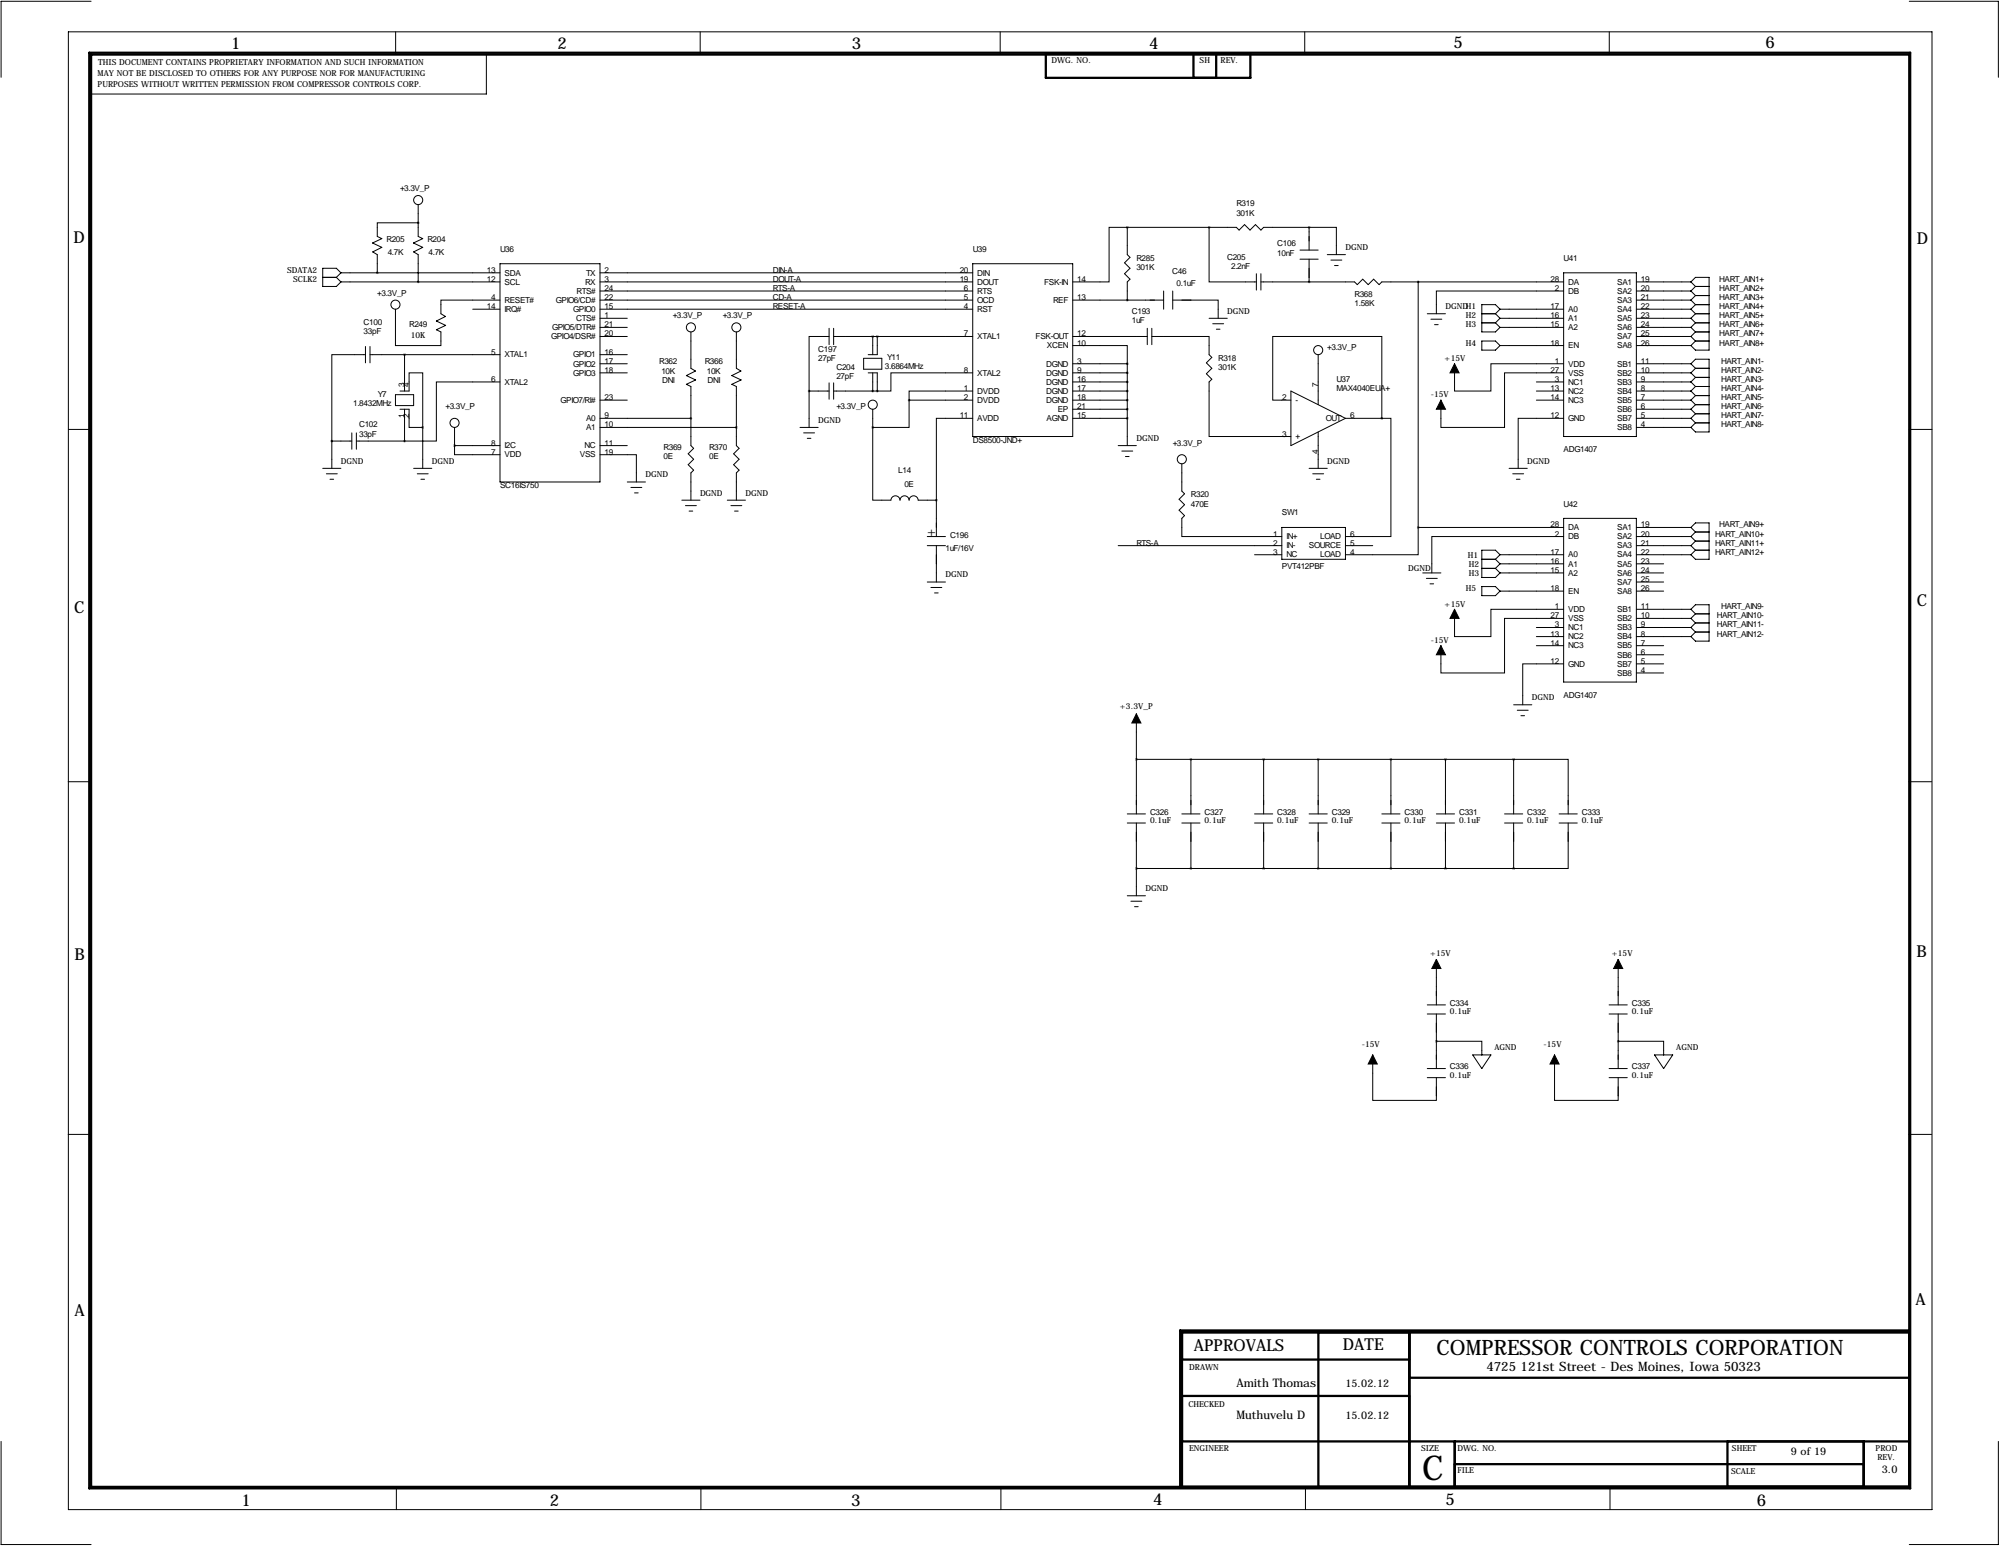
[picture p274: page 9]

APPROVALS | DATE | COMPRESSOR CONTROLS CORPORATION 4725 121st Street - Des Moines, Iowa 50323

DRAWN Amith Thomas | 15.02.12

CHECKED

D

D

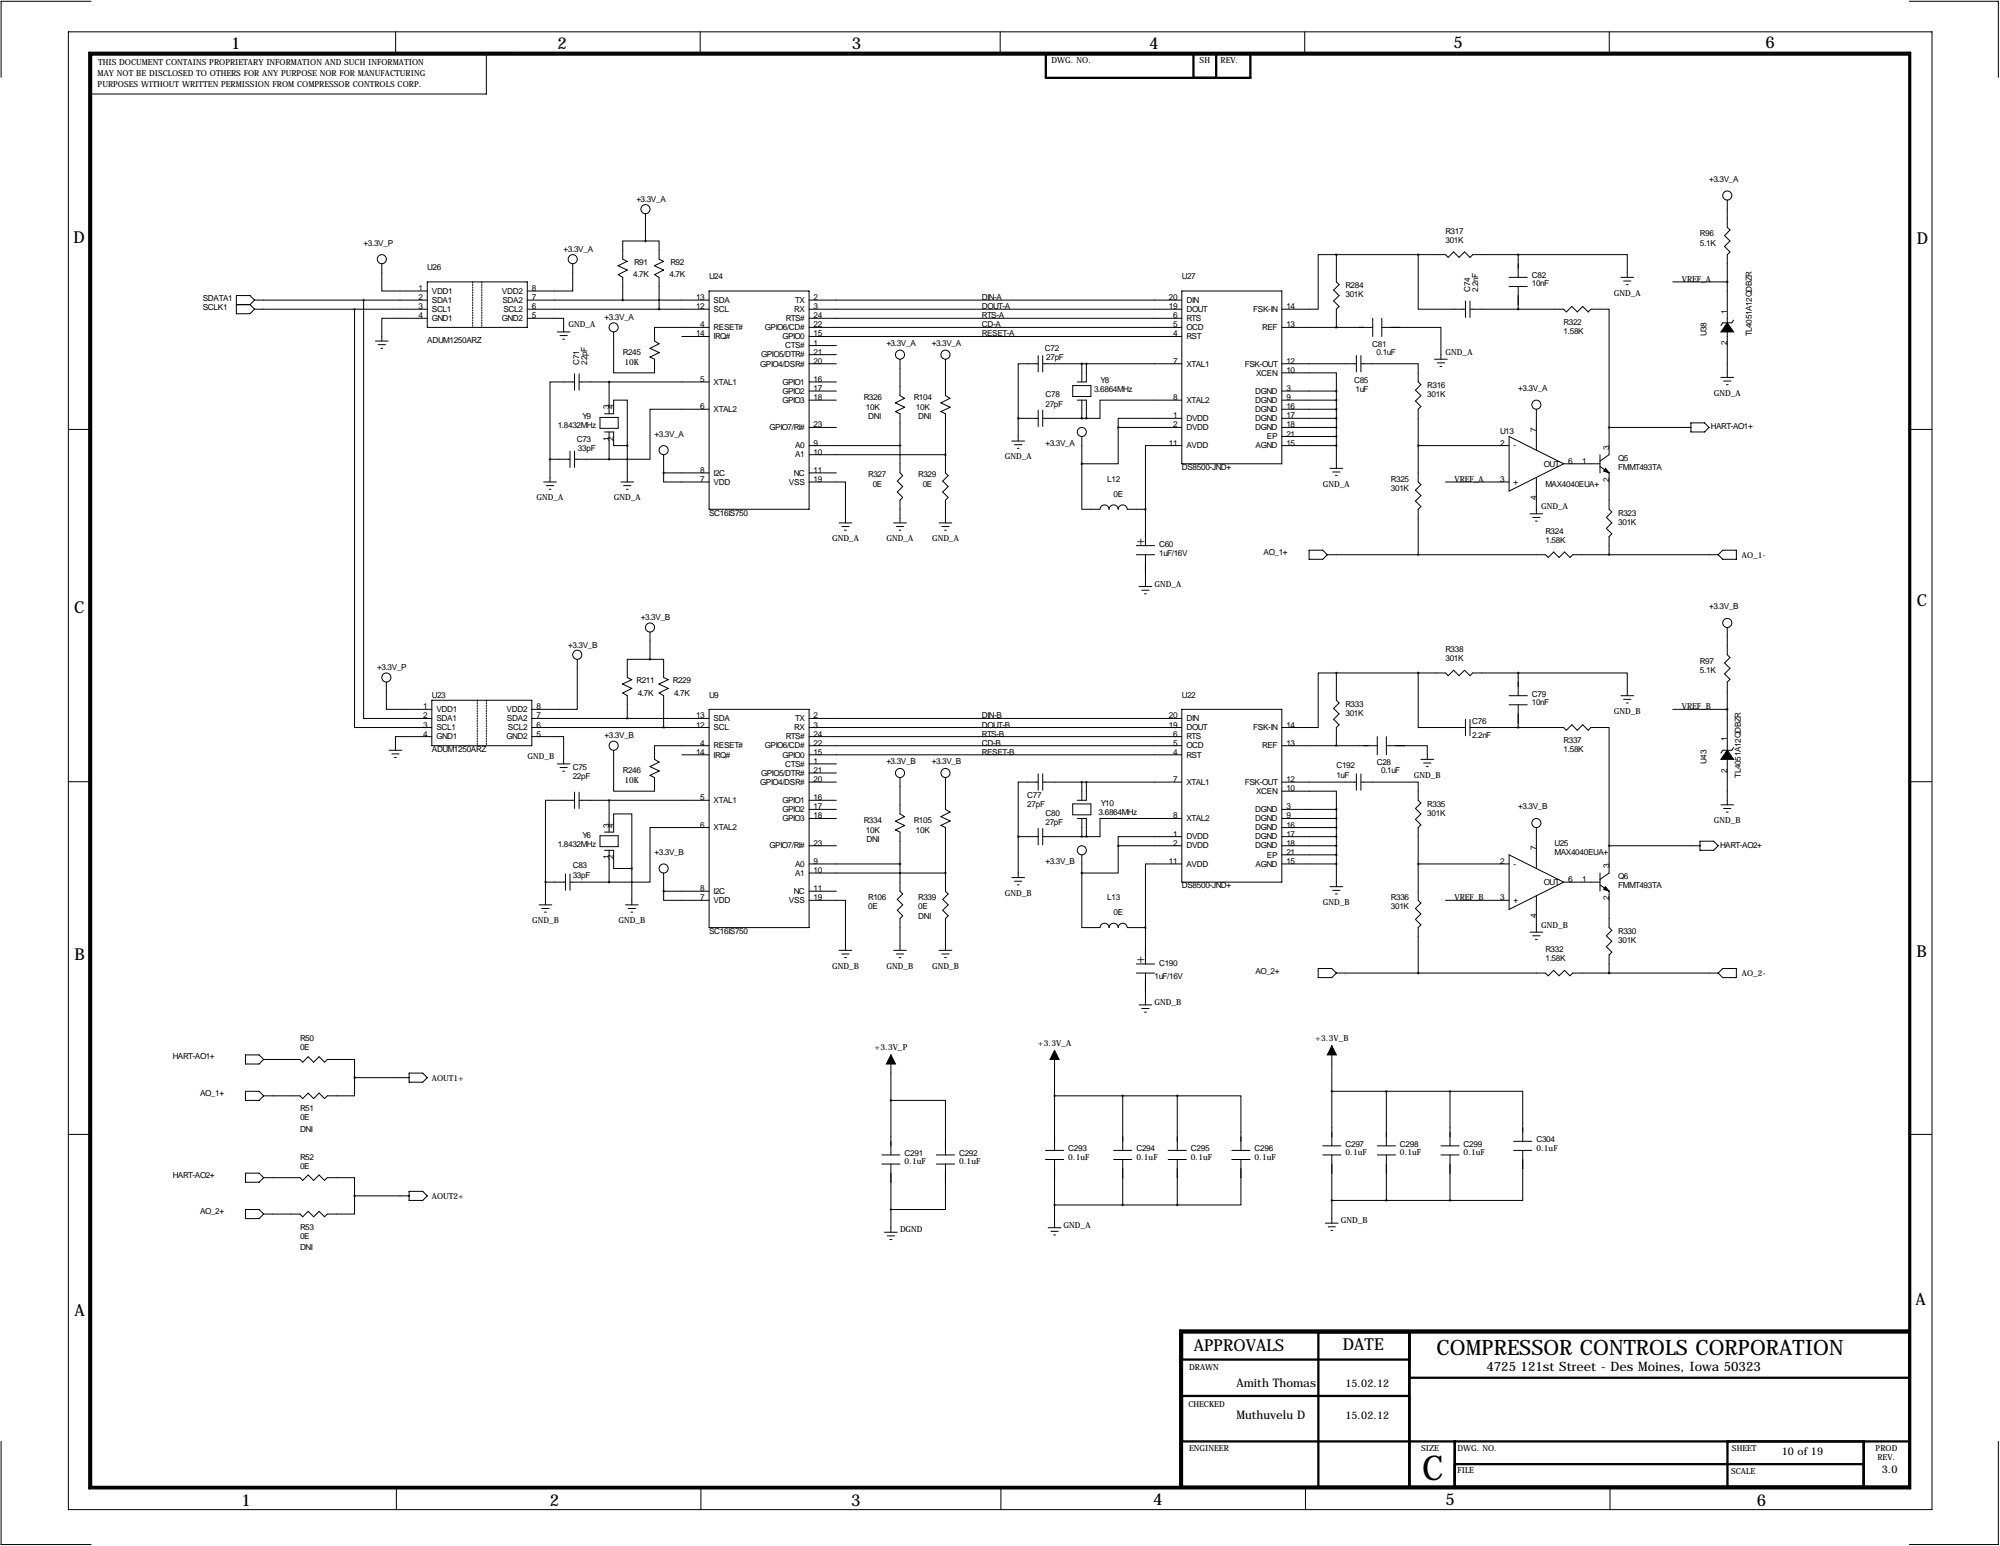
[picture p275: page 10]

APPROVALS | DATE | COMPRESSOR CONTROLS CORPORATION 4725 121st Street - Des Moines, Iowa 50323

DRAWN Amith Thomas | 15.02.12

CHECKED

D
D

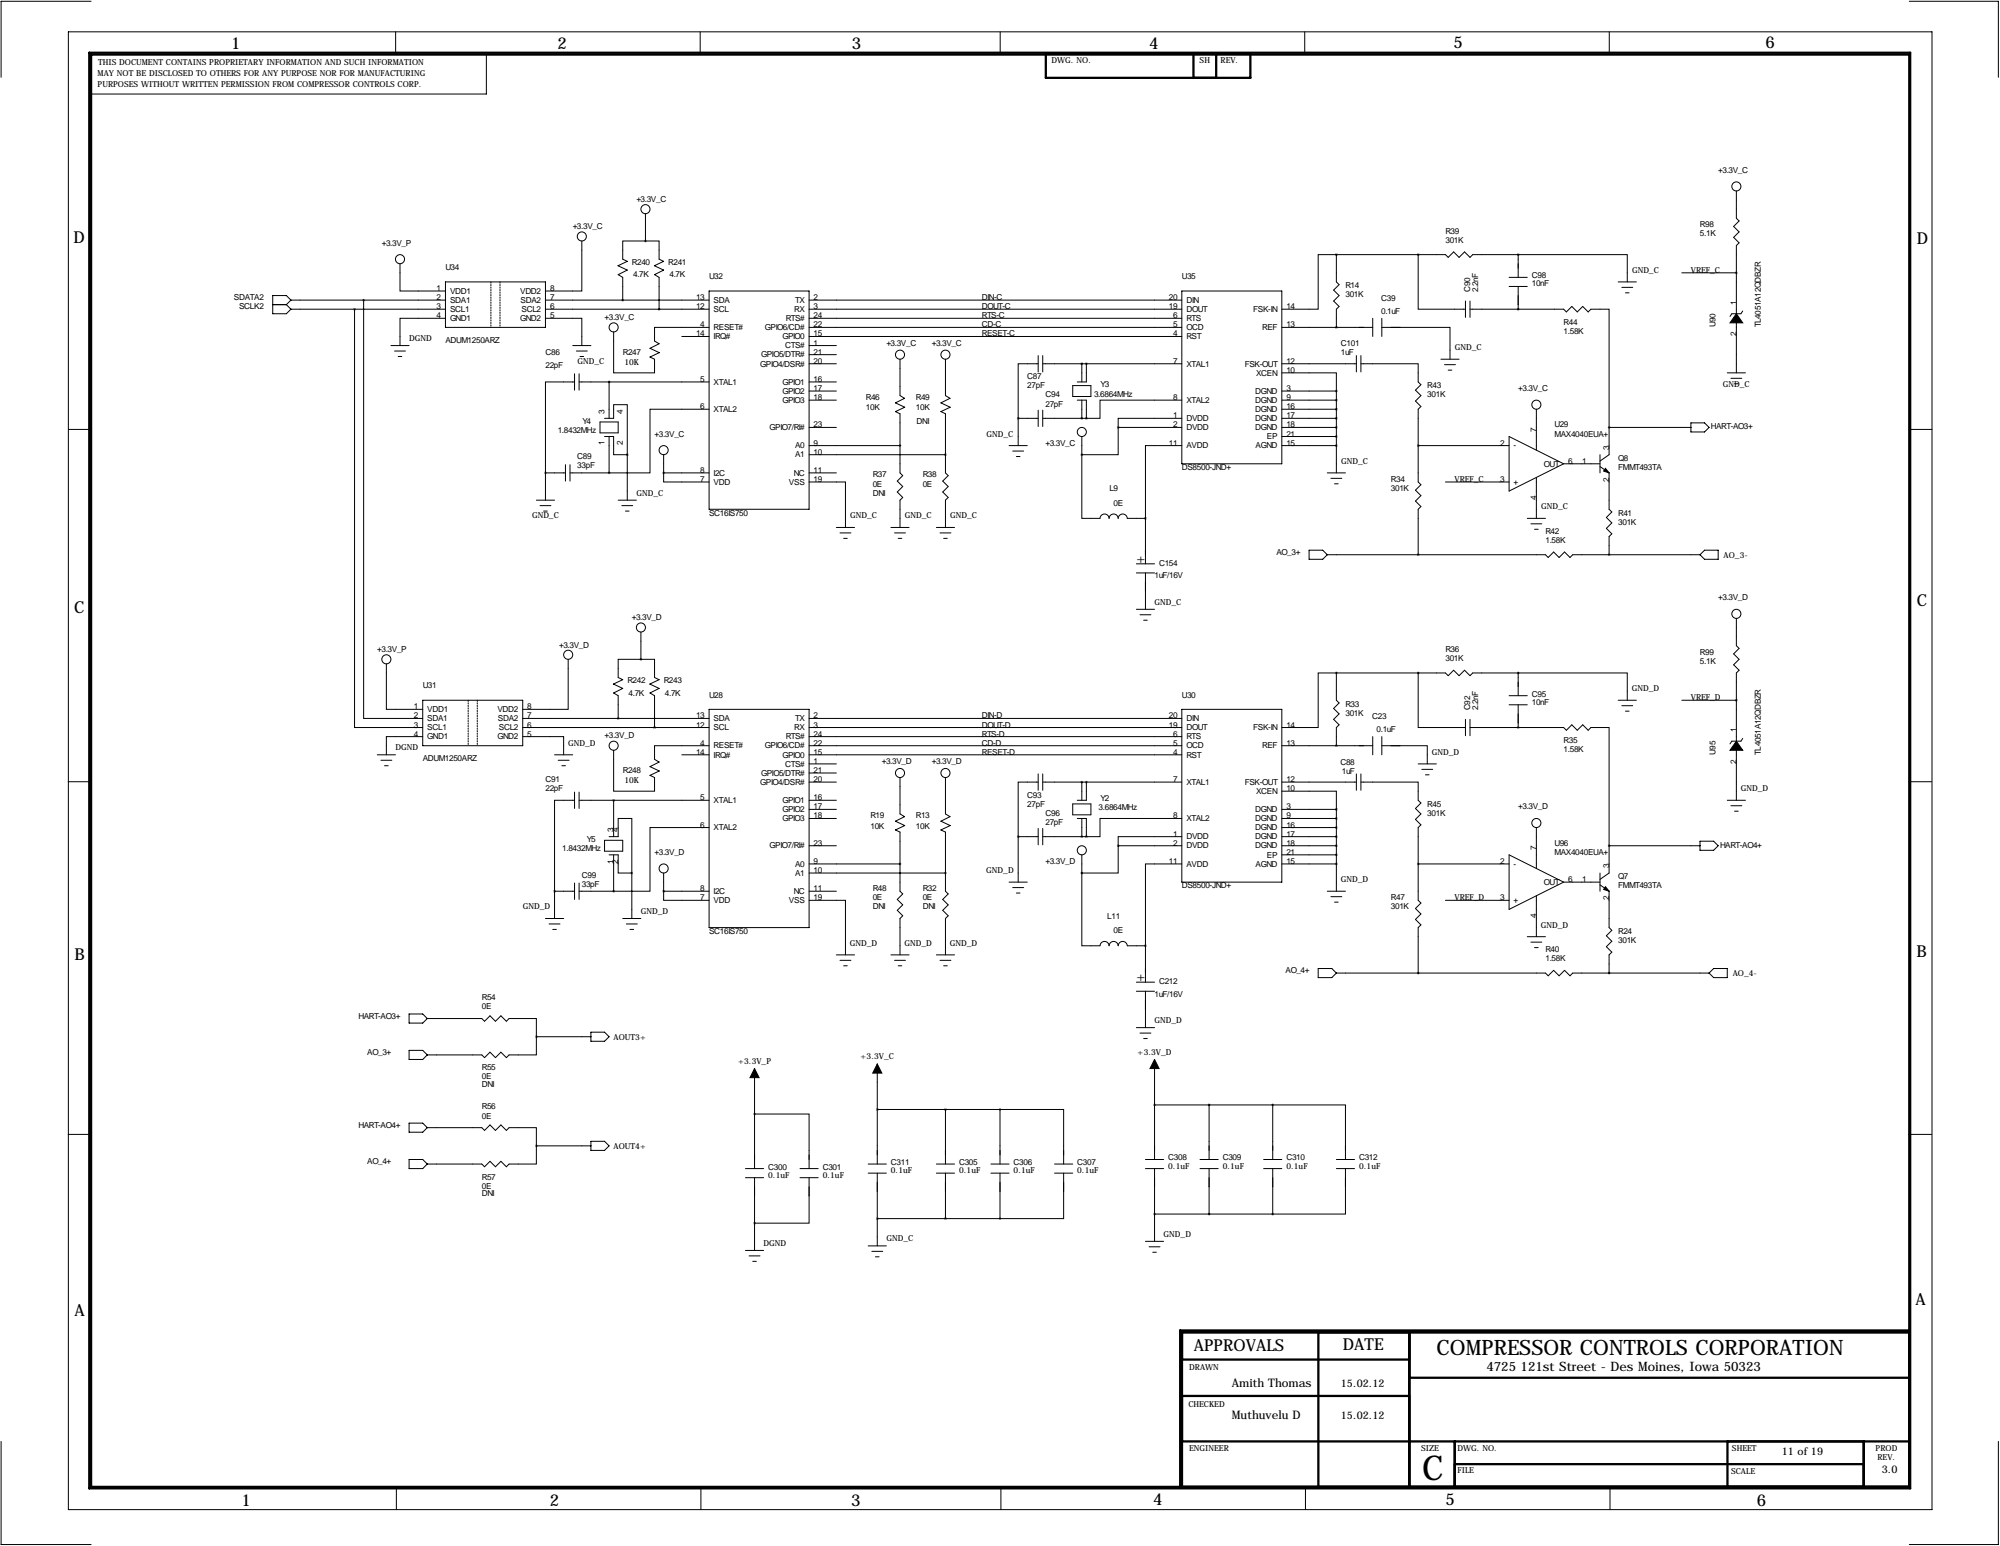
[picture p276: page 11]

APPROVALS | DATE | COMPRESSOR CONTROLS CORPORATION 4725 121st Street - Des Moines, Iowa 50323

DRAWN Amith Thomas | 15.02.12

CHECKED

D
D

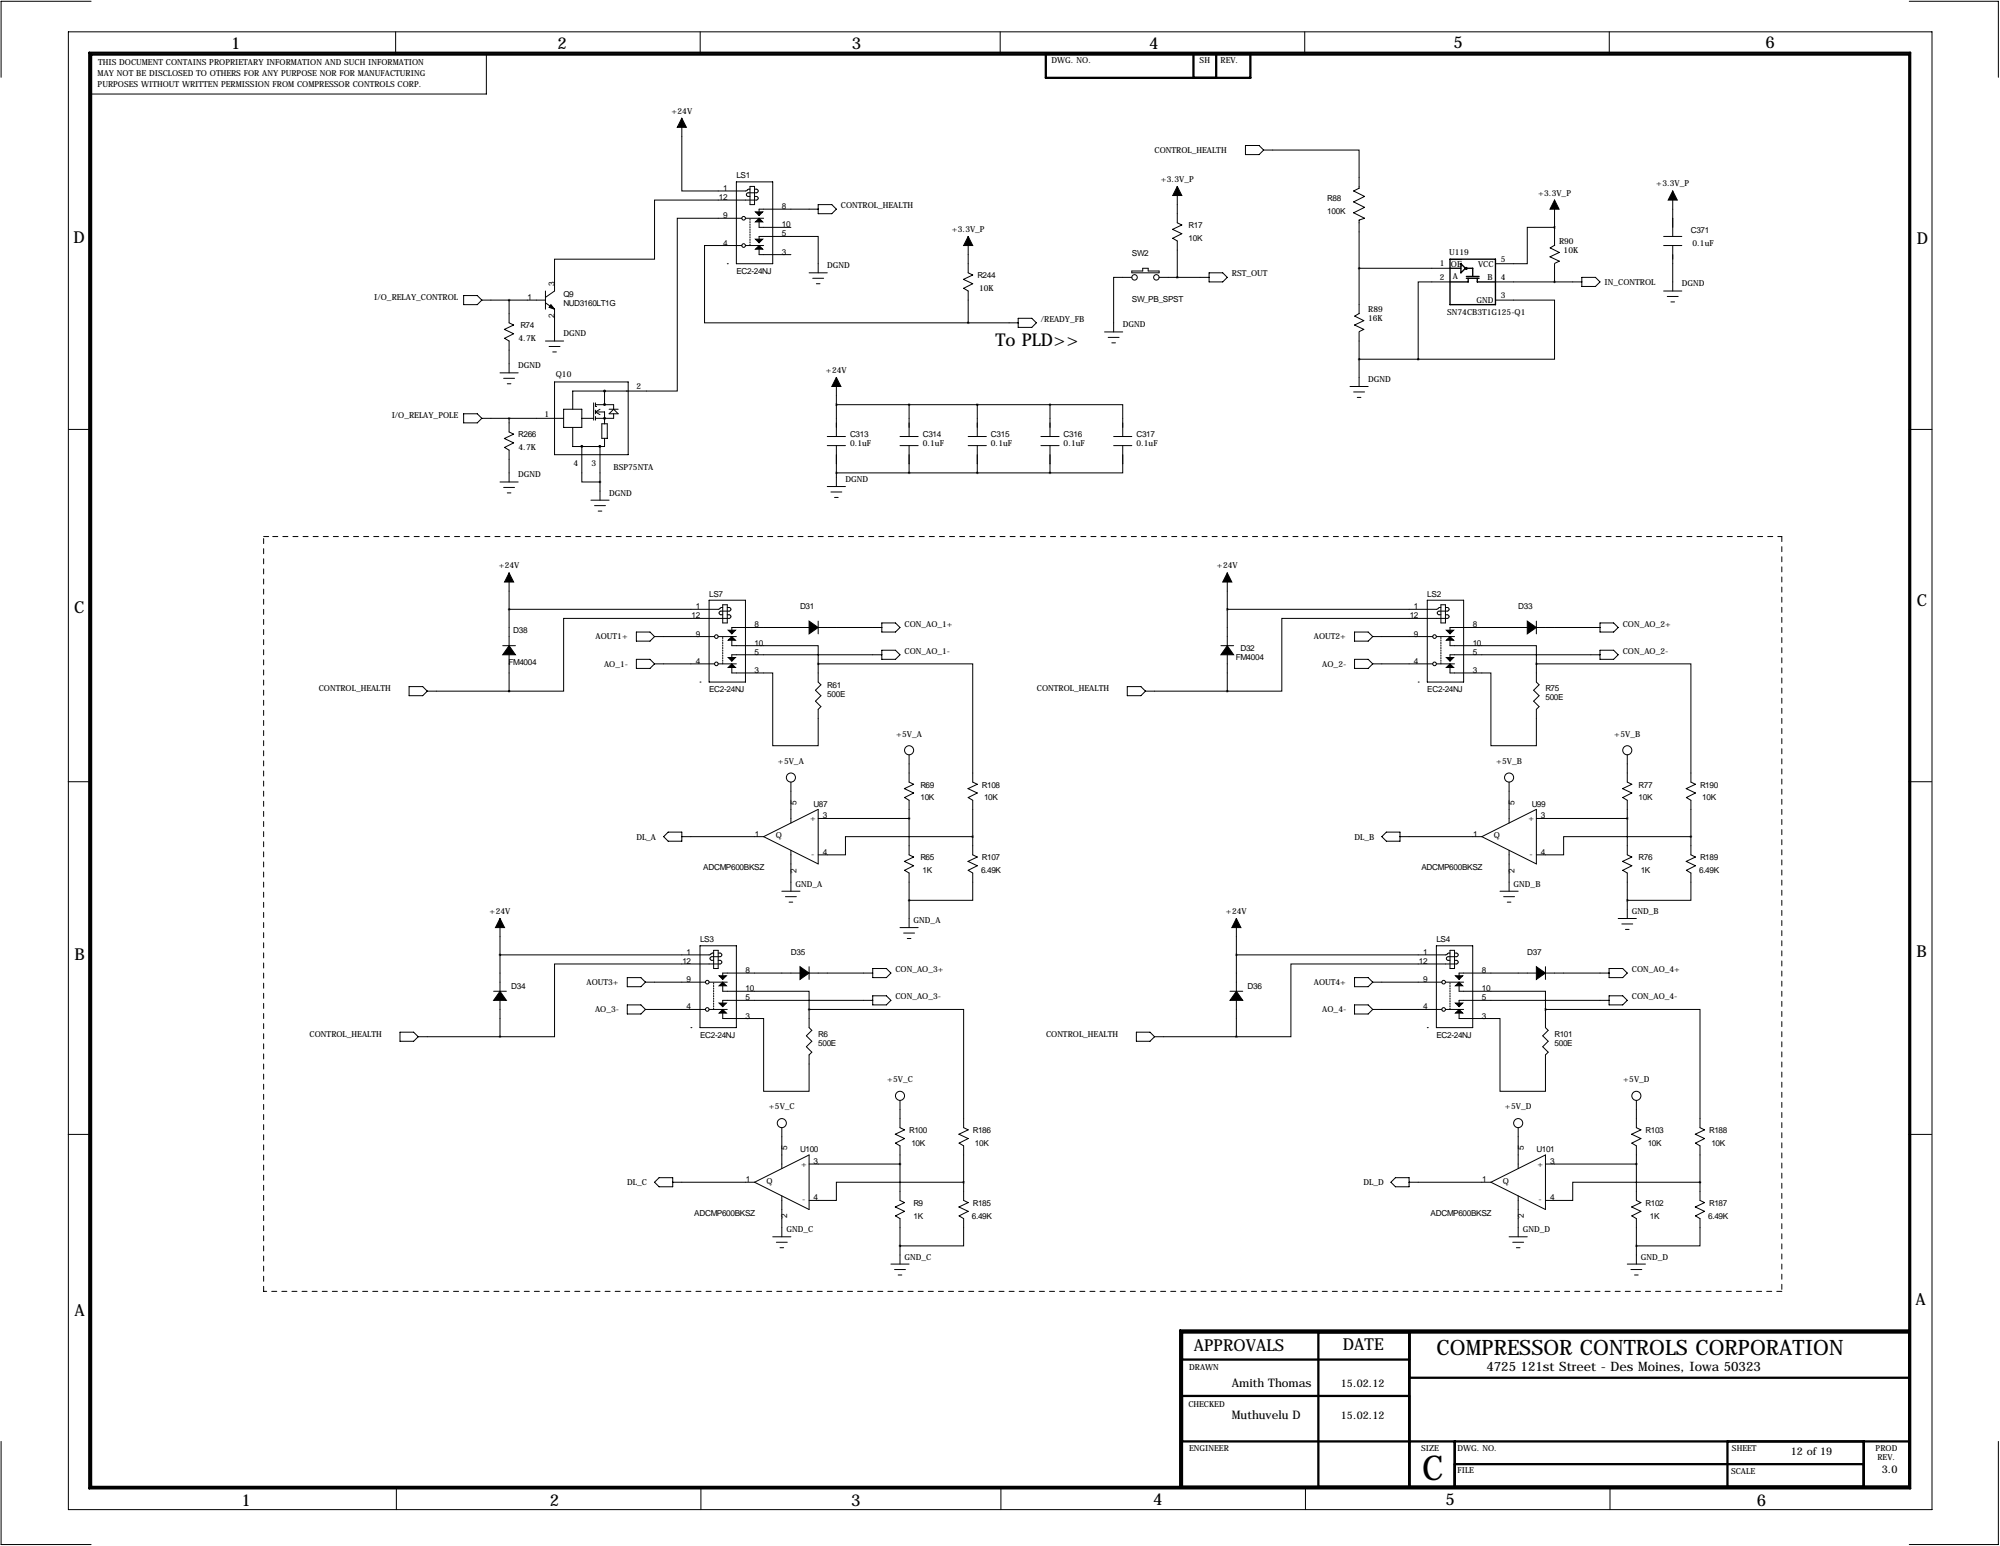
[picture p277: page 12]

APPROVALS | DATE | COMPRESSOR CONTROLS CORPORATION 4725 121st Street - Des Moines, Iowa 50323

DRAWN Amith Thomas | 15.02.12

CHECKED

D

D

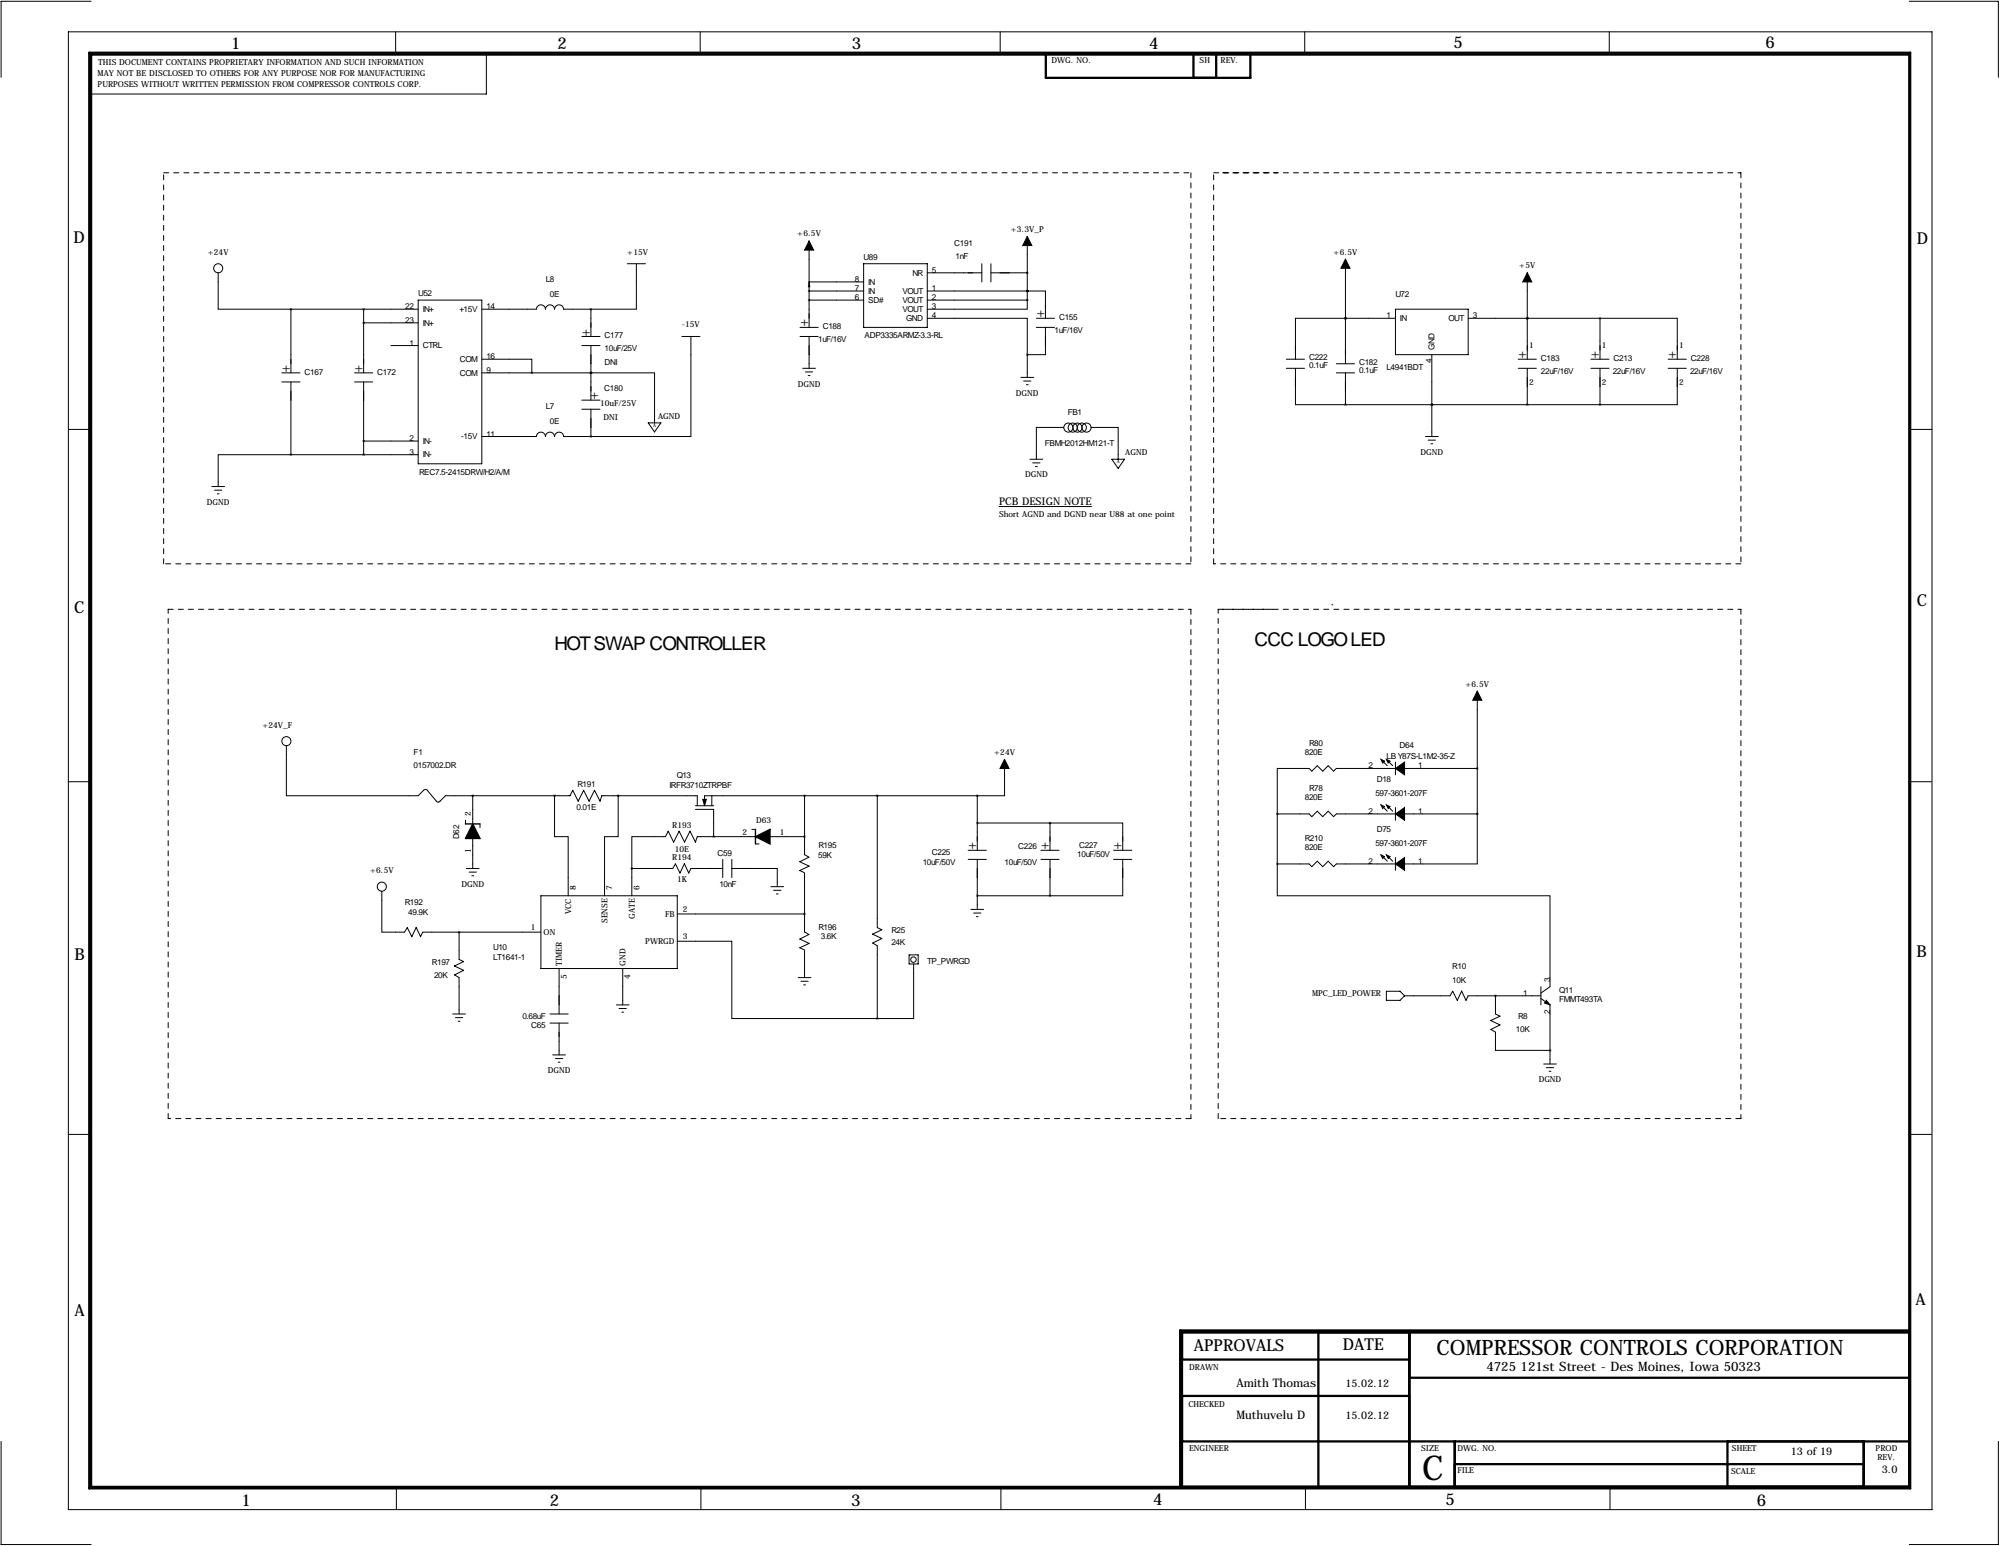
[picture p278: page 13]

Short AGND and DGND near U88 at one point

APPROVALS | DATE | COMPRESSOR CONTROLS CORPORATION 4725 121st Street - Des Moines, Iowa 50323

DRAWN Amith Thomas | 15.02.12

CHECKED

D

D

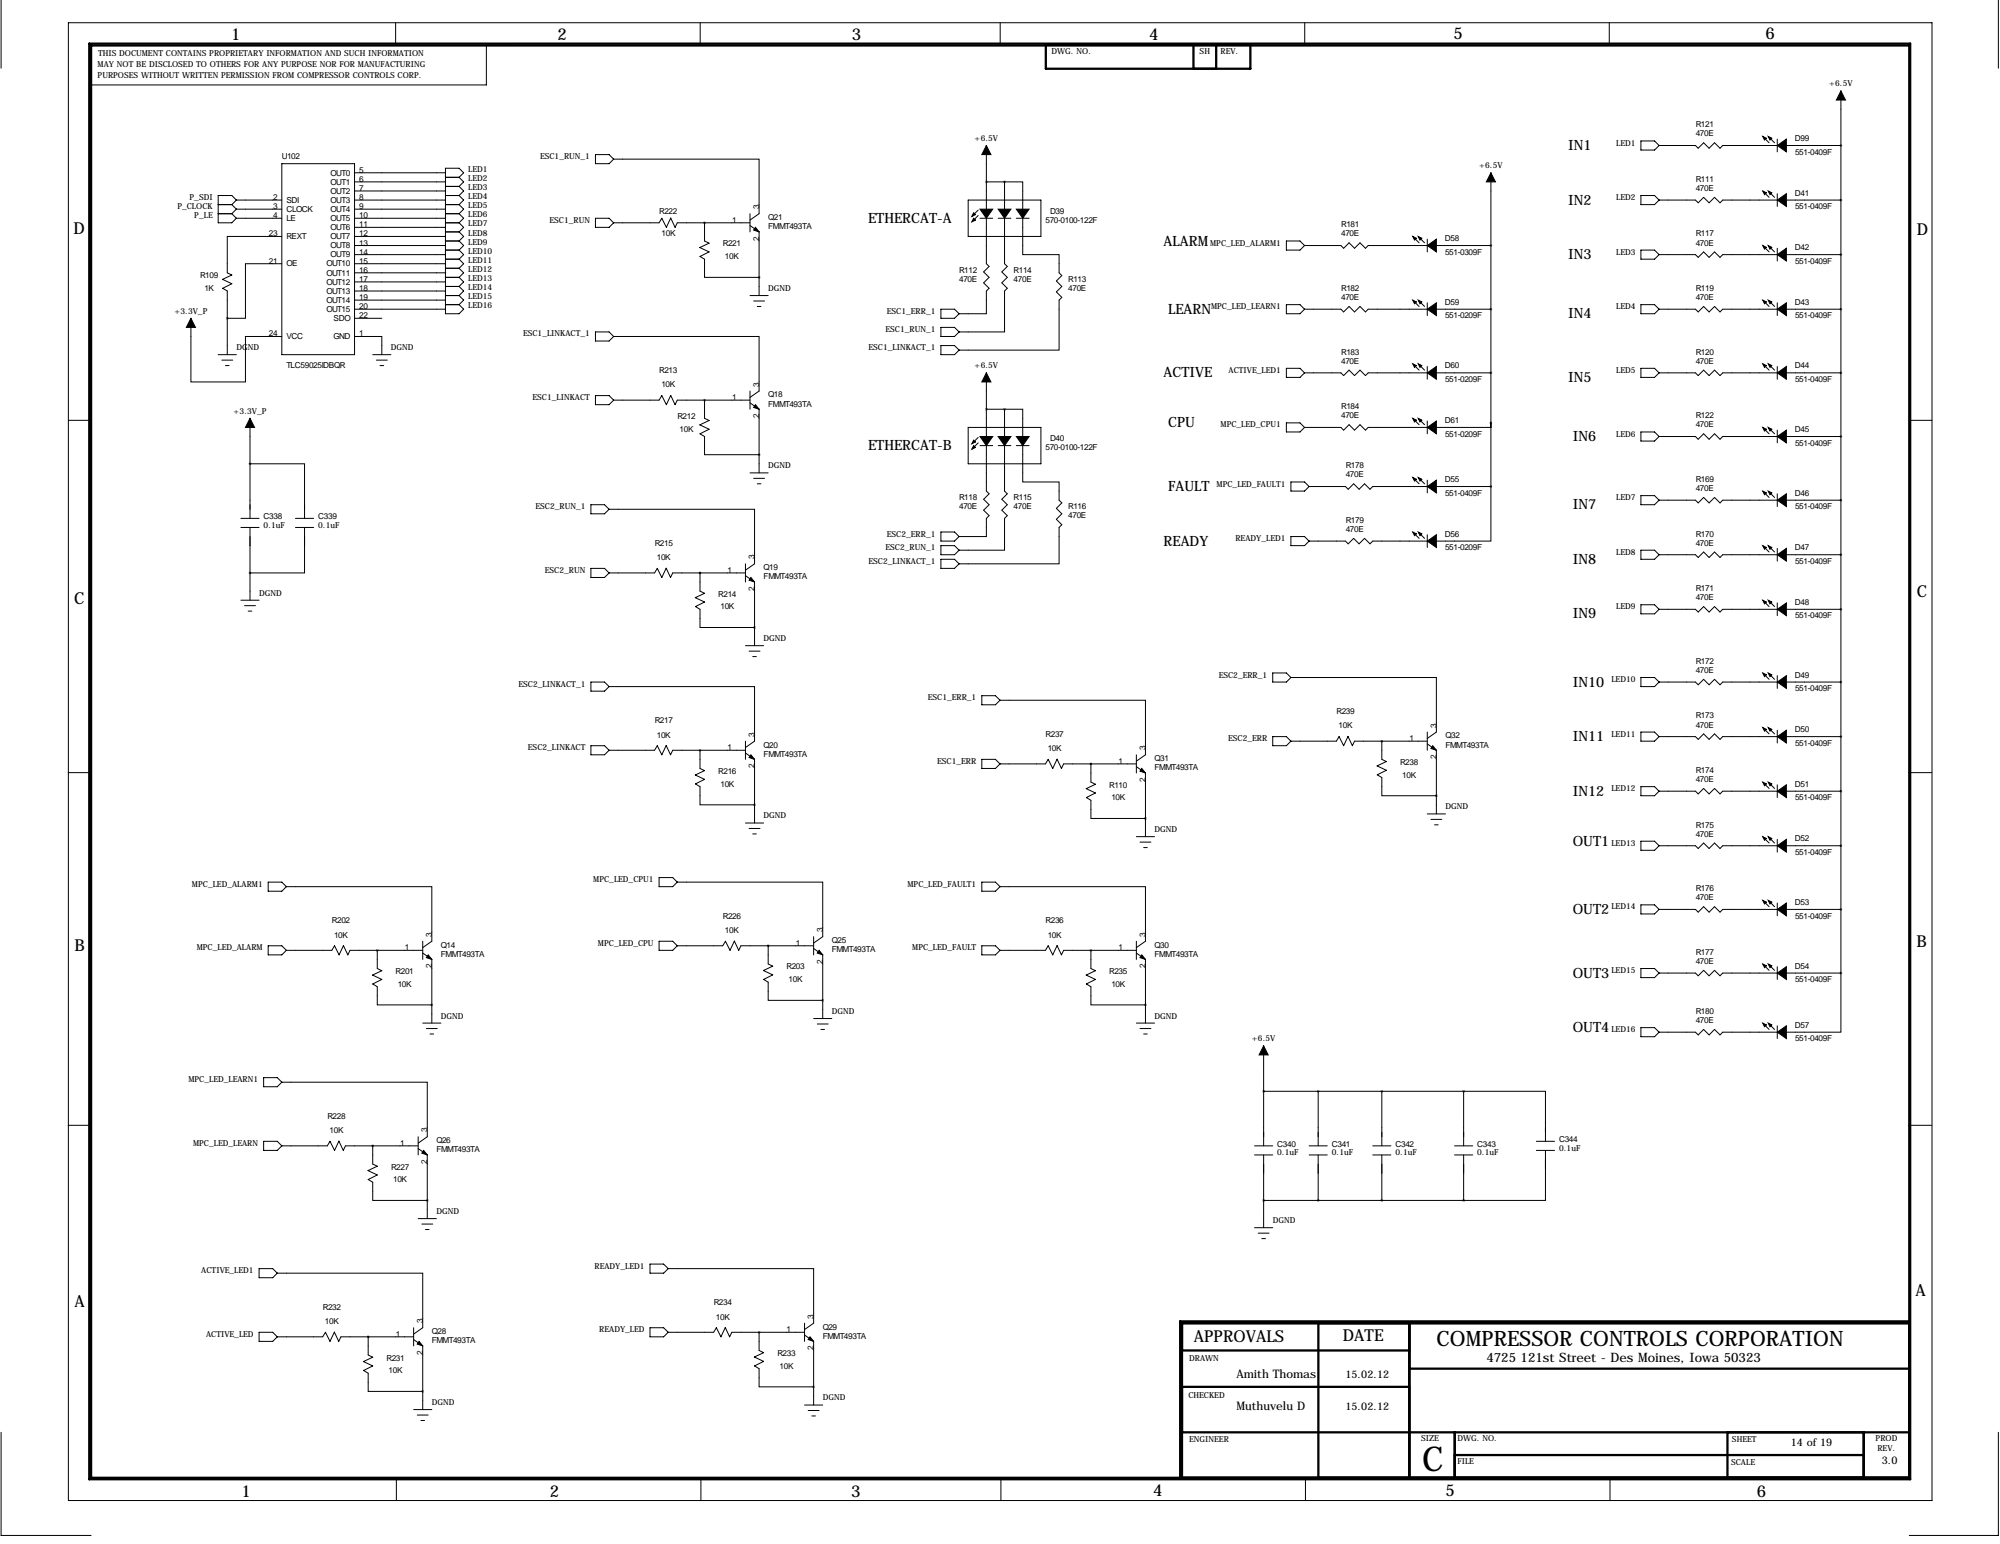
[picture p279: page 14]

APPROVALS | DATE | COMPRESSOR CONTROLS CORPORATION 4725 121st Street - Des Moines, Iowa 50323

DRAWN Amith Thomas | 15.02.12

CHECKED Muthuvelu D | 15.02.12

D

D

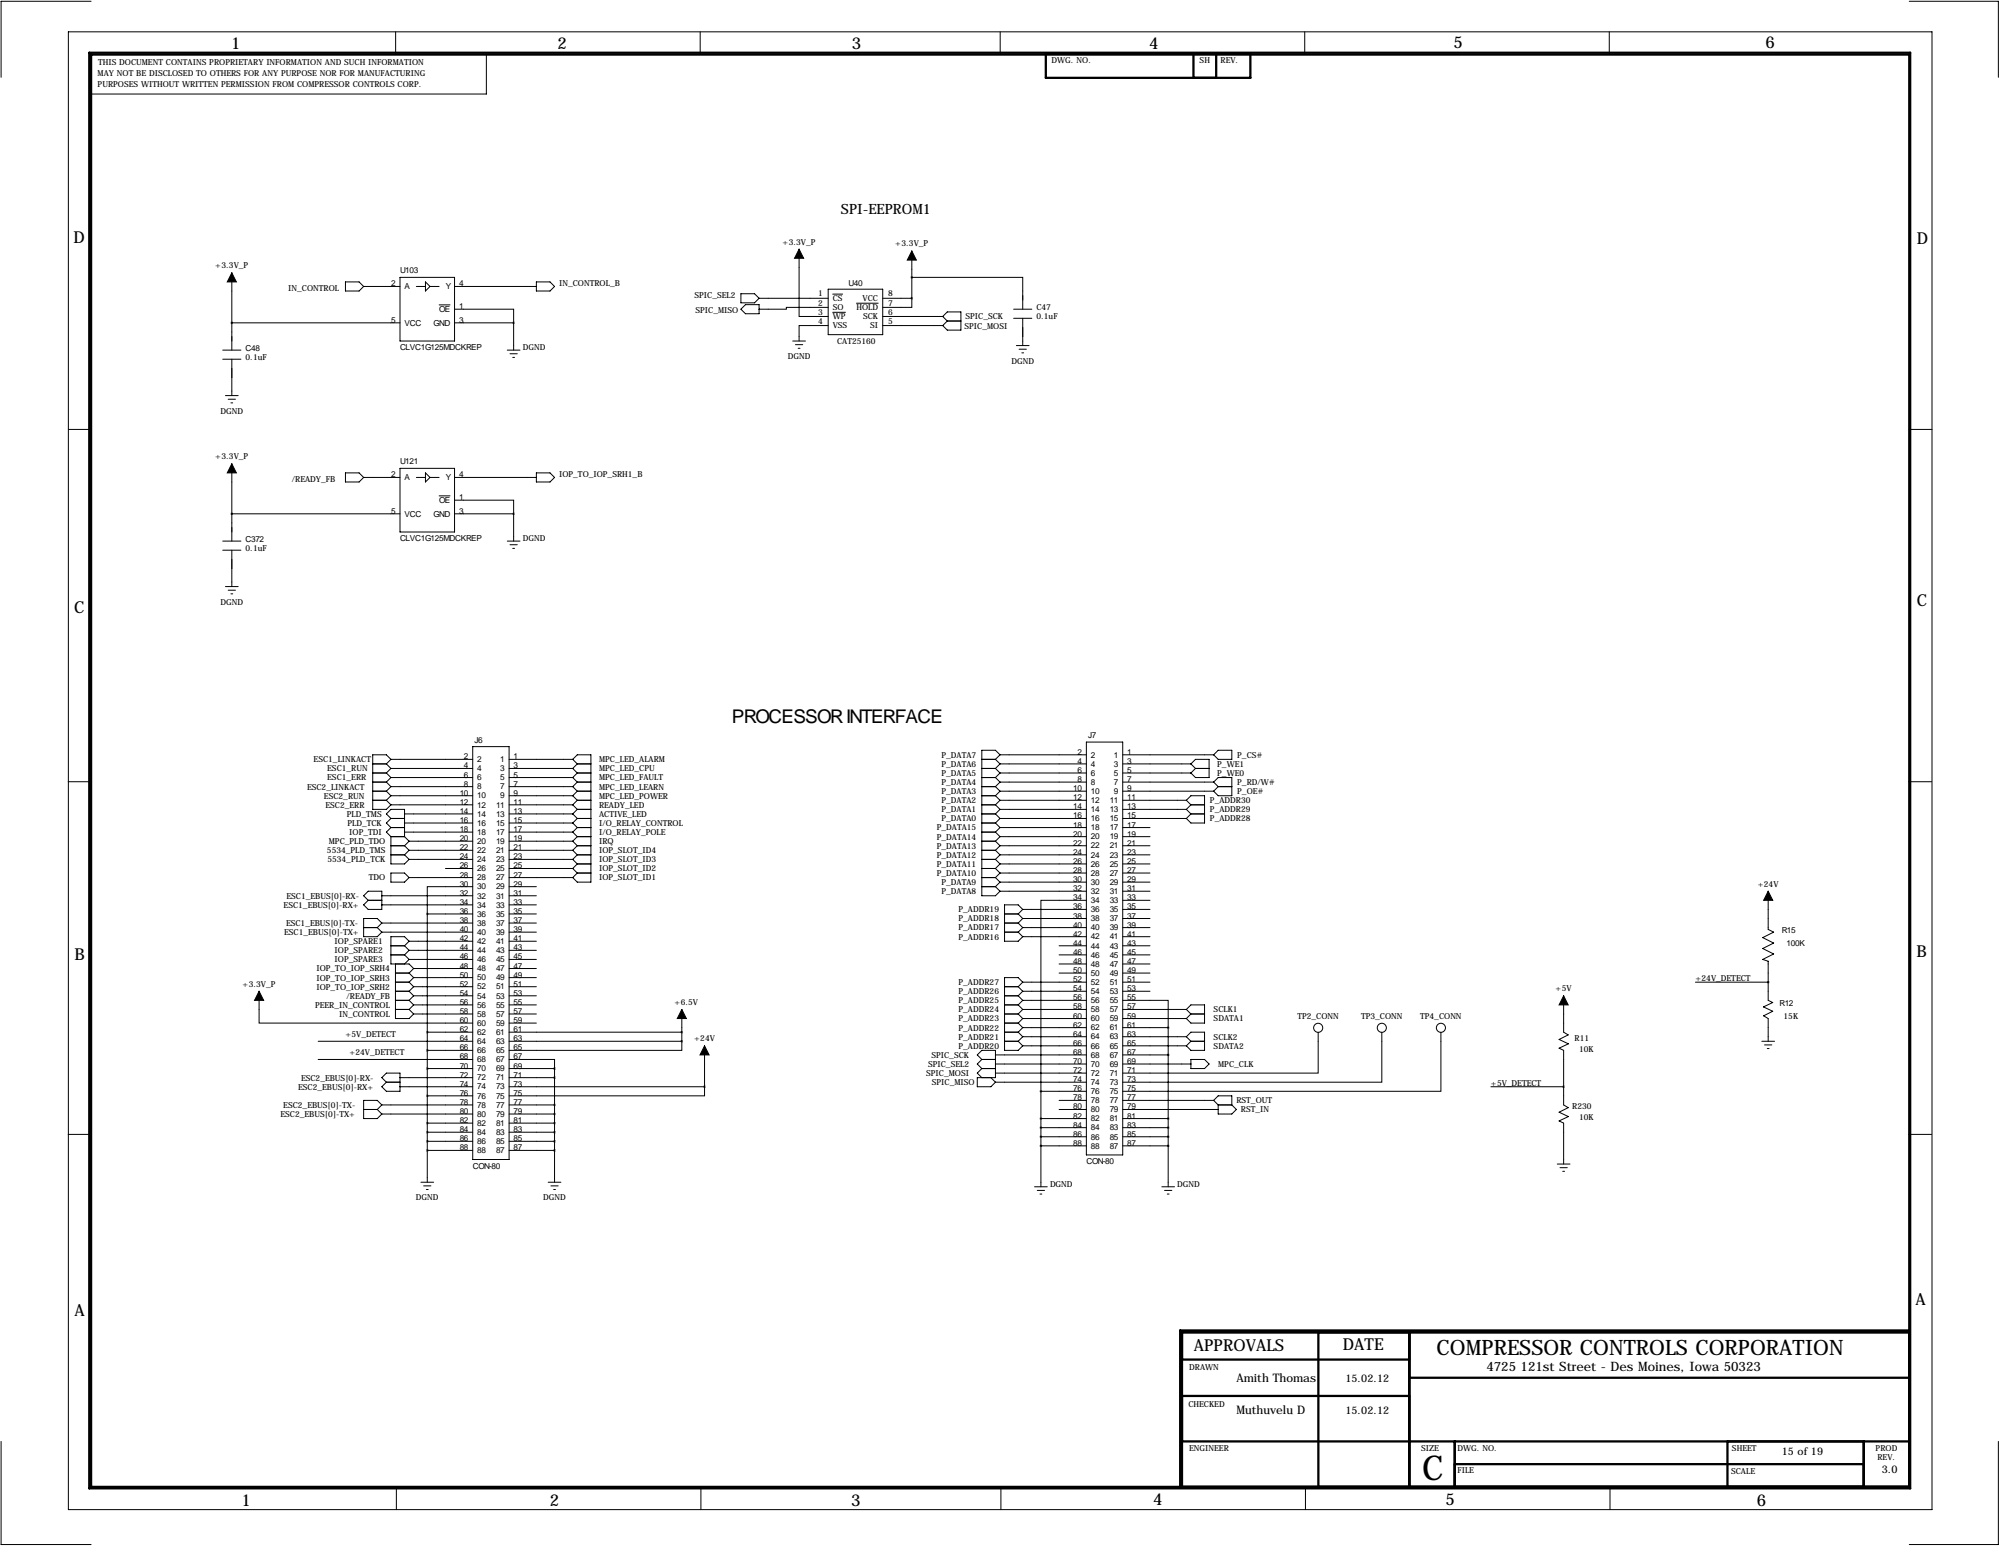
[picture p280: page 15]

APPROVALS | DATE | COMPRESSOR CONTROLS CORPORATION 4725 121st Street - Des Moines, Iowa 50323

DRAWN Amith Thomas | 15.02.12

CHECKED Muthuvelu D | 15.02.12

D
D

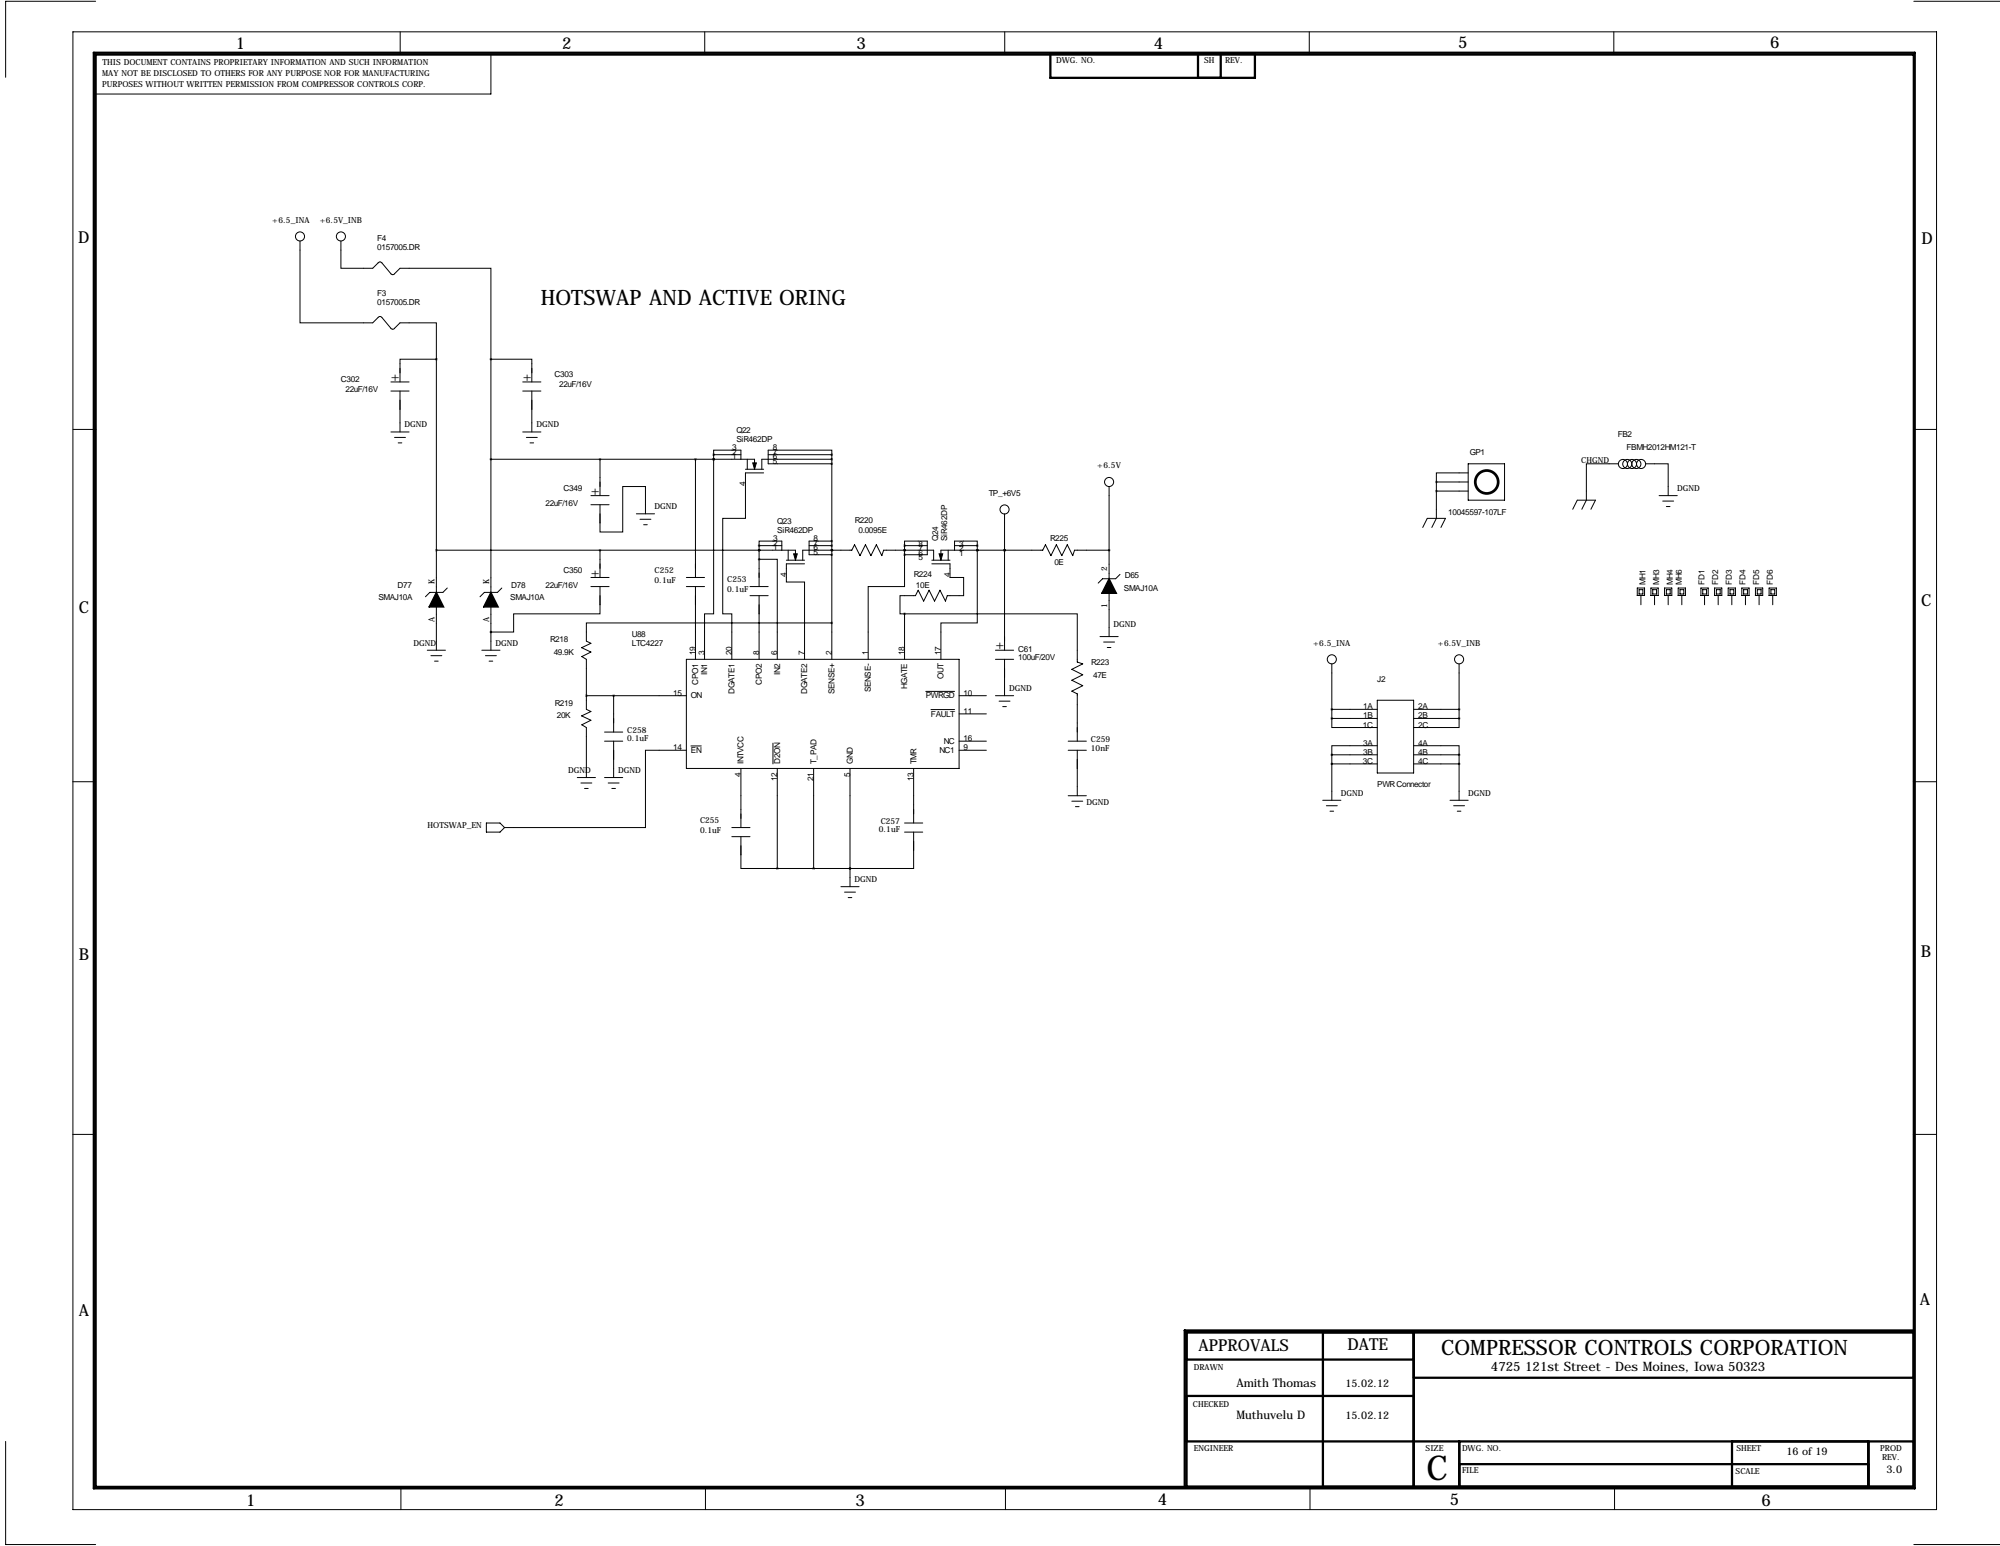
[picture p281: page 16]

HOTSWAP AND ACTIVE ORING

1B | 2B
1C | 2C

3B | 4B
3C | 4C

APPROVALS | DATE | COMPRESSOR CONTROLS CORPORATION 4725 121st Street - Des Moines, Iowa 50323

DRAWN Amith Thomas | 15.02.12

CHECKED

D

D

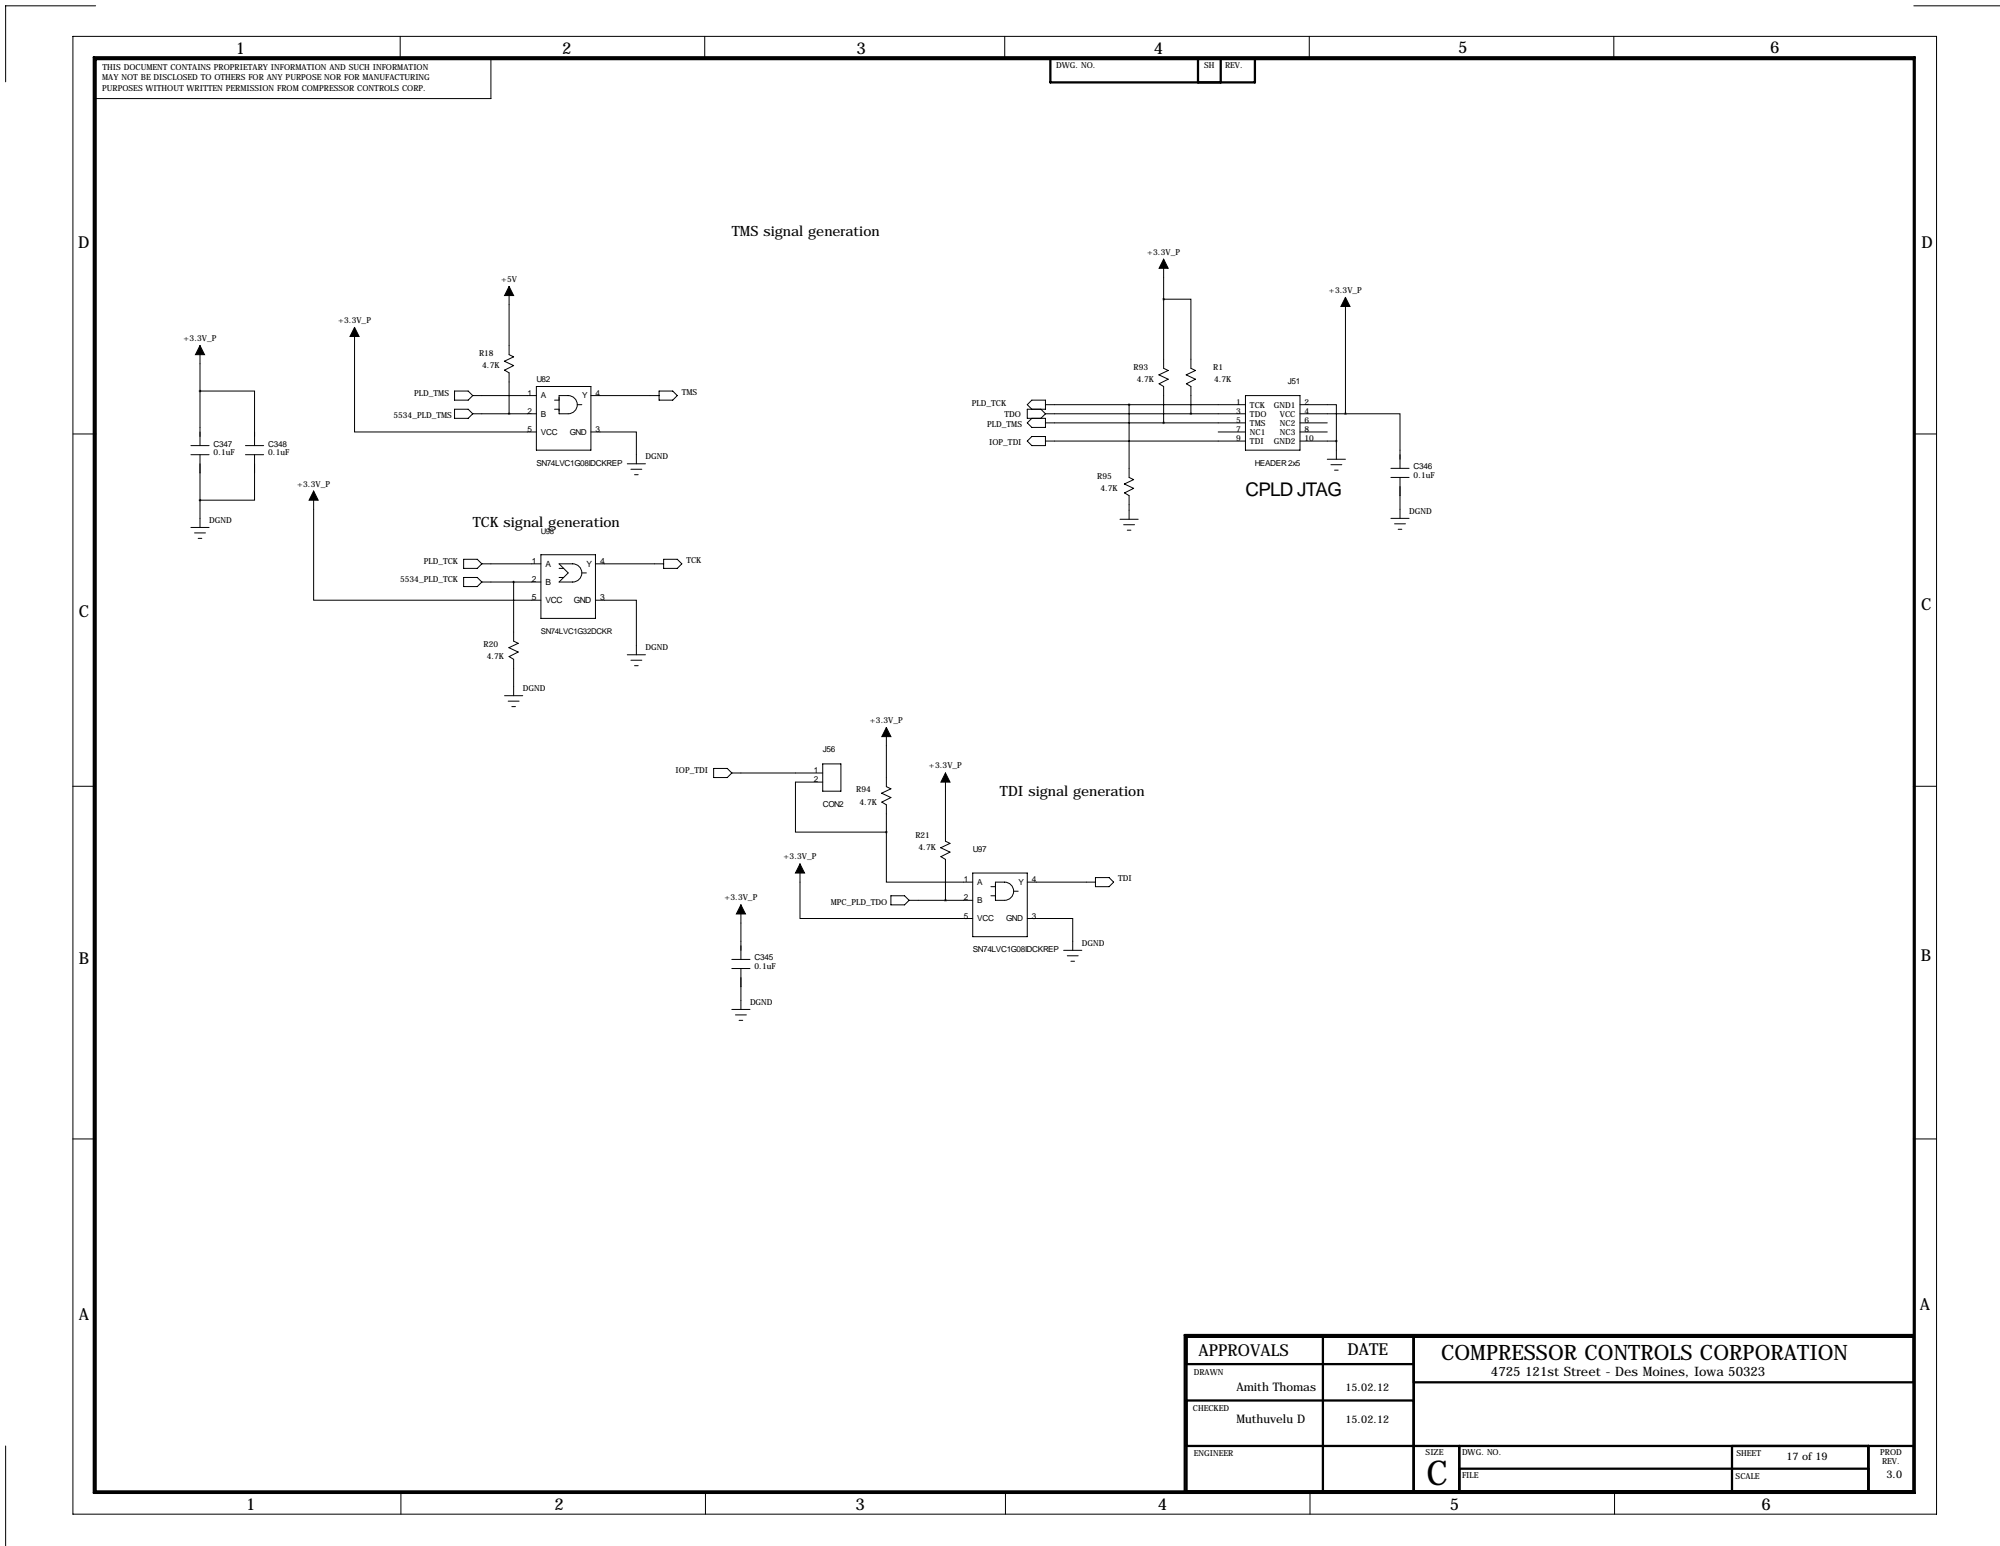
[picture p282: page 17]

APPROVALS | DATE | COMPRESSOR CONTROLS CORPORATION 4725 121st Street - Des Moines, Iowa 50323

DRAWN Amith Thomas | 15.02.12

CHECKED

D

D

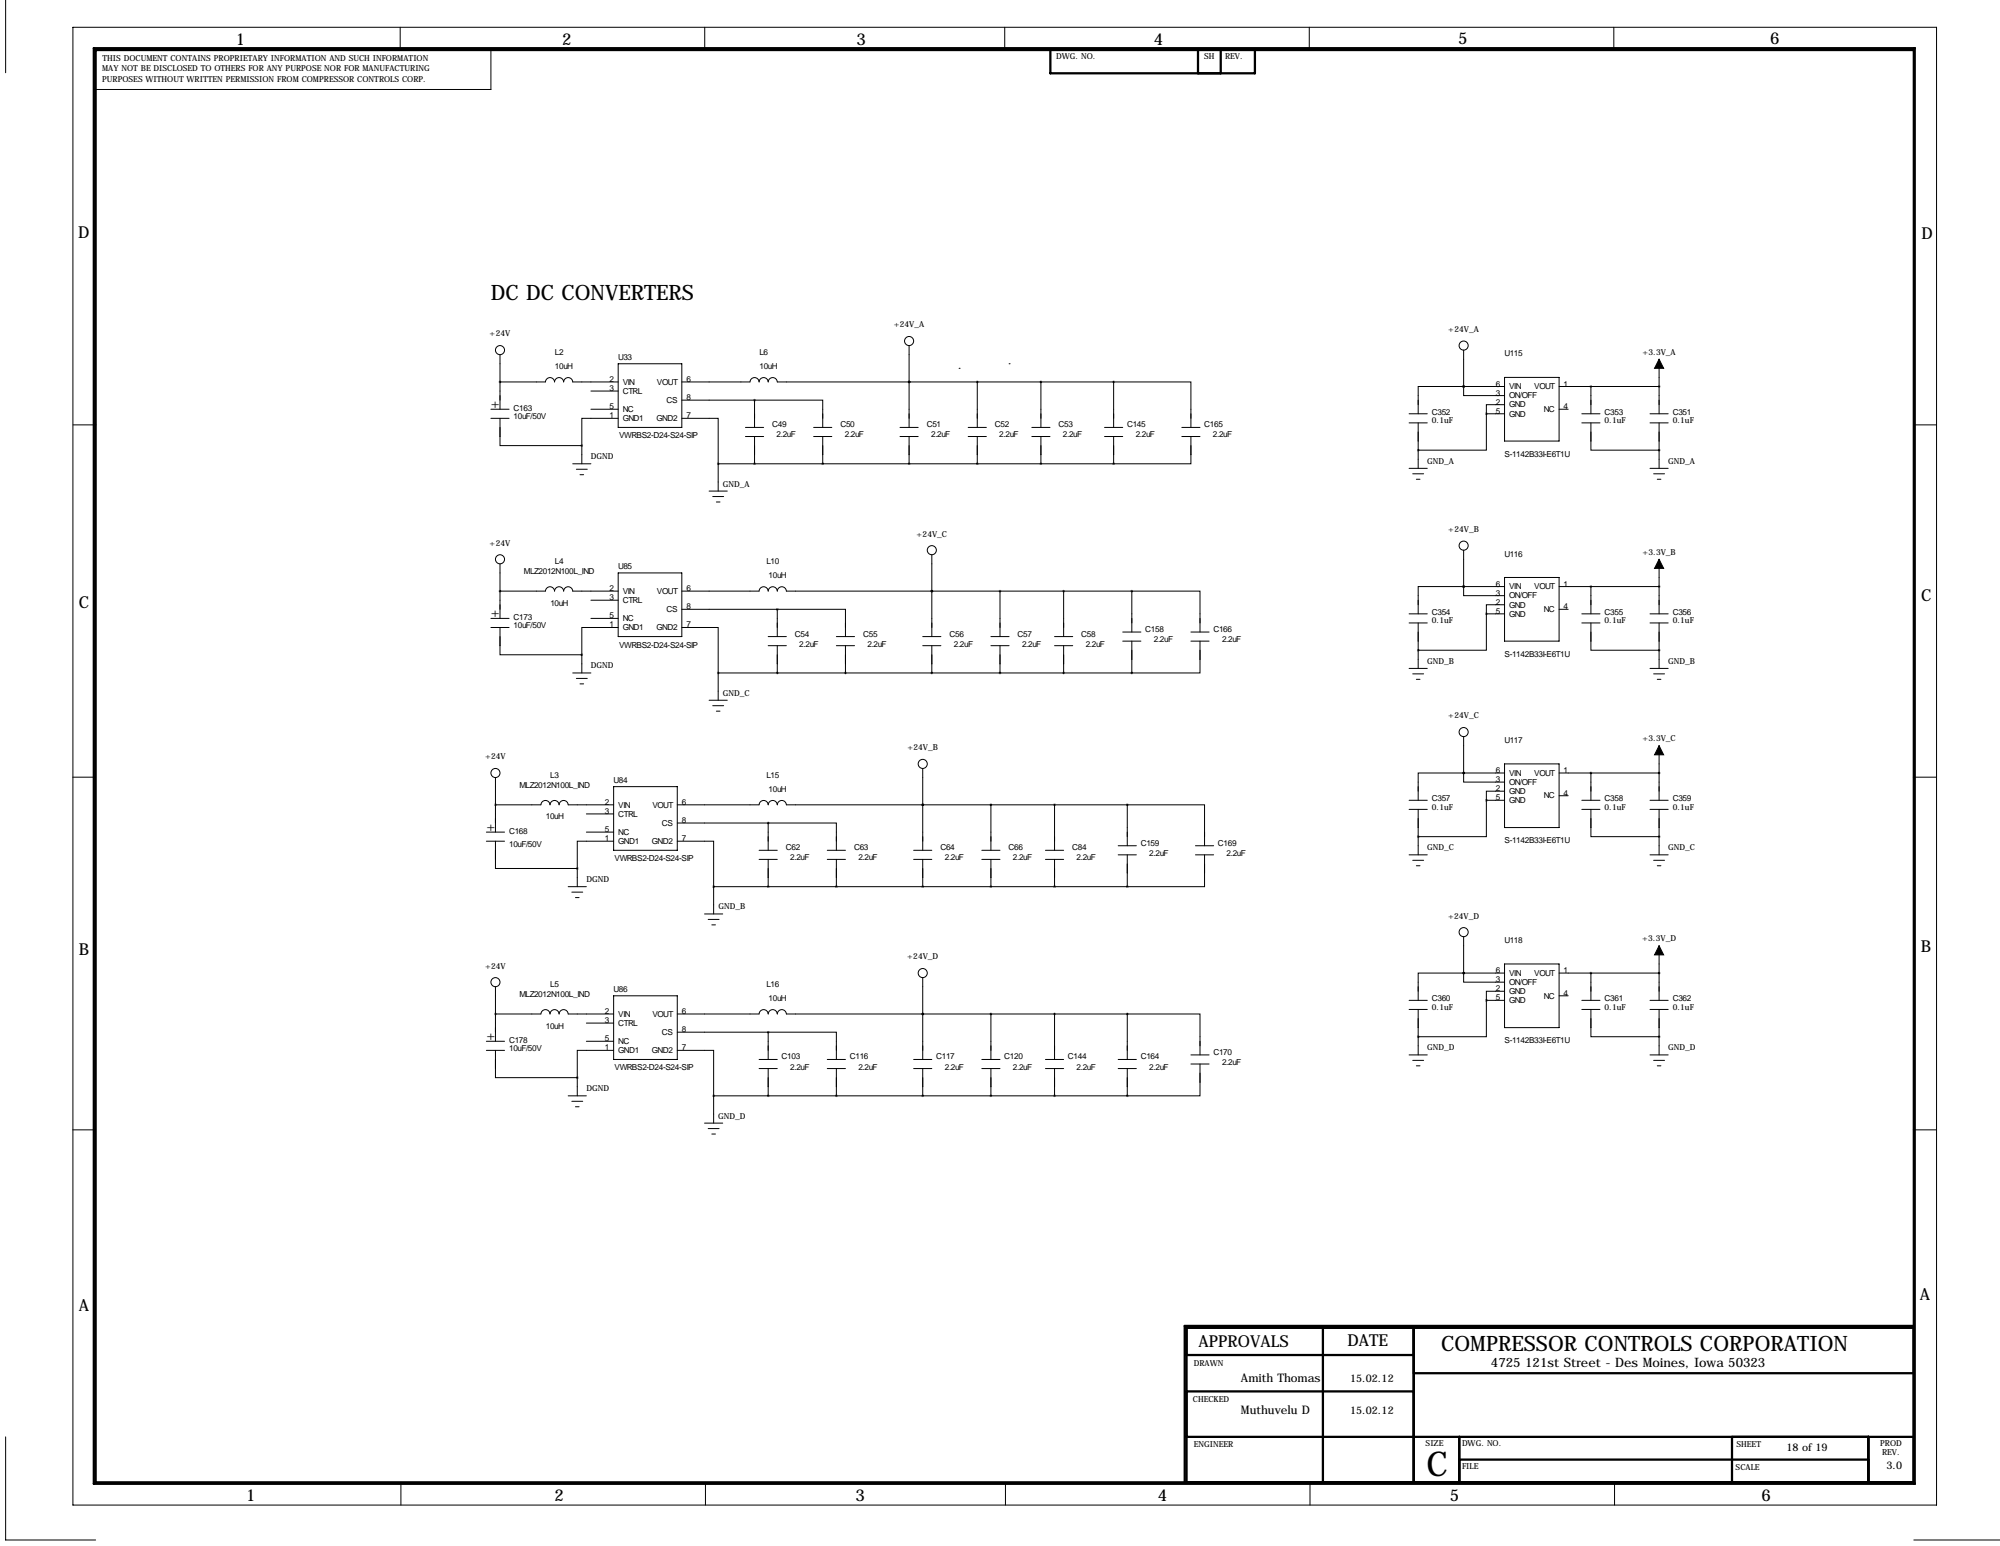
[picture p283: page 18]

APPROVALS | DATE | COMPRESSOR CONTROLS CORPORATION 4725 121st Street - Des Moines, Iowa 50323

DRAWN Amith Thomas | 15.02.12

CHECKED Muthuvelu D | 15.02.12

D

D

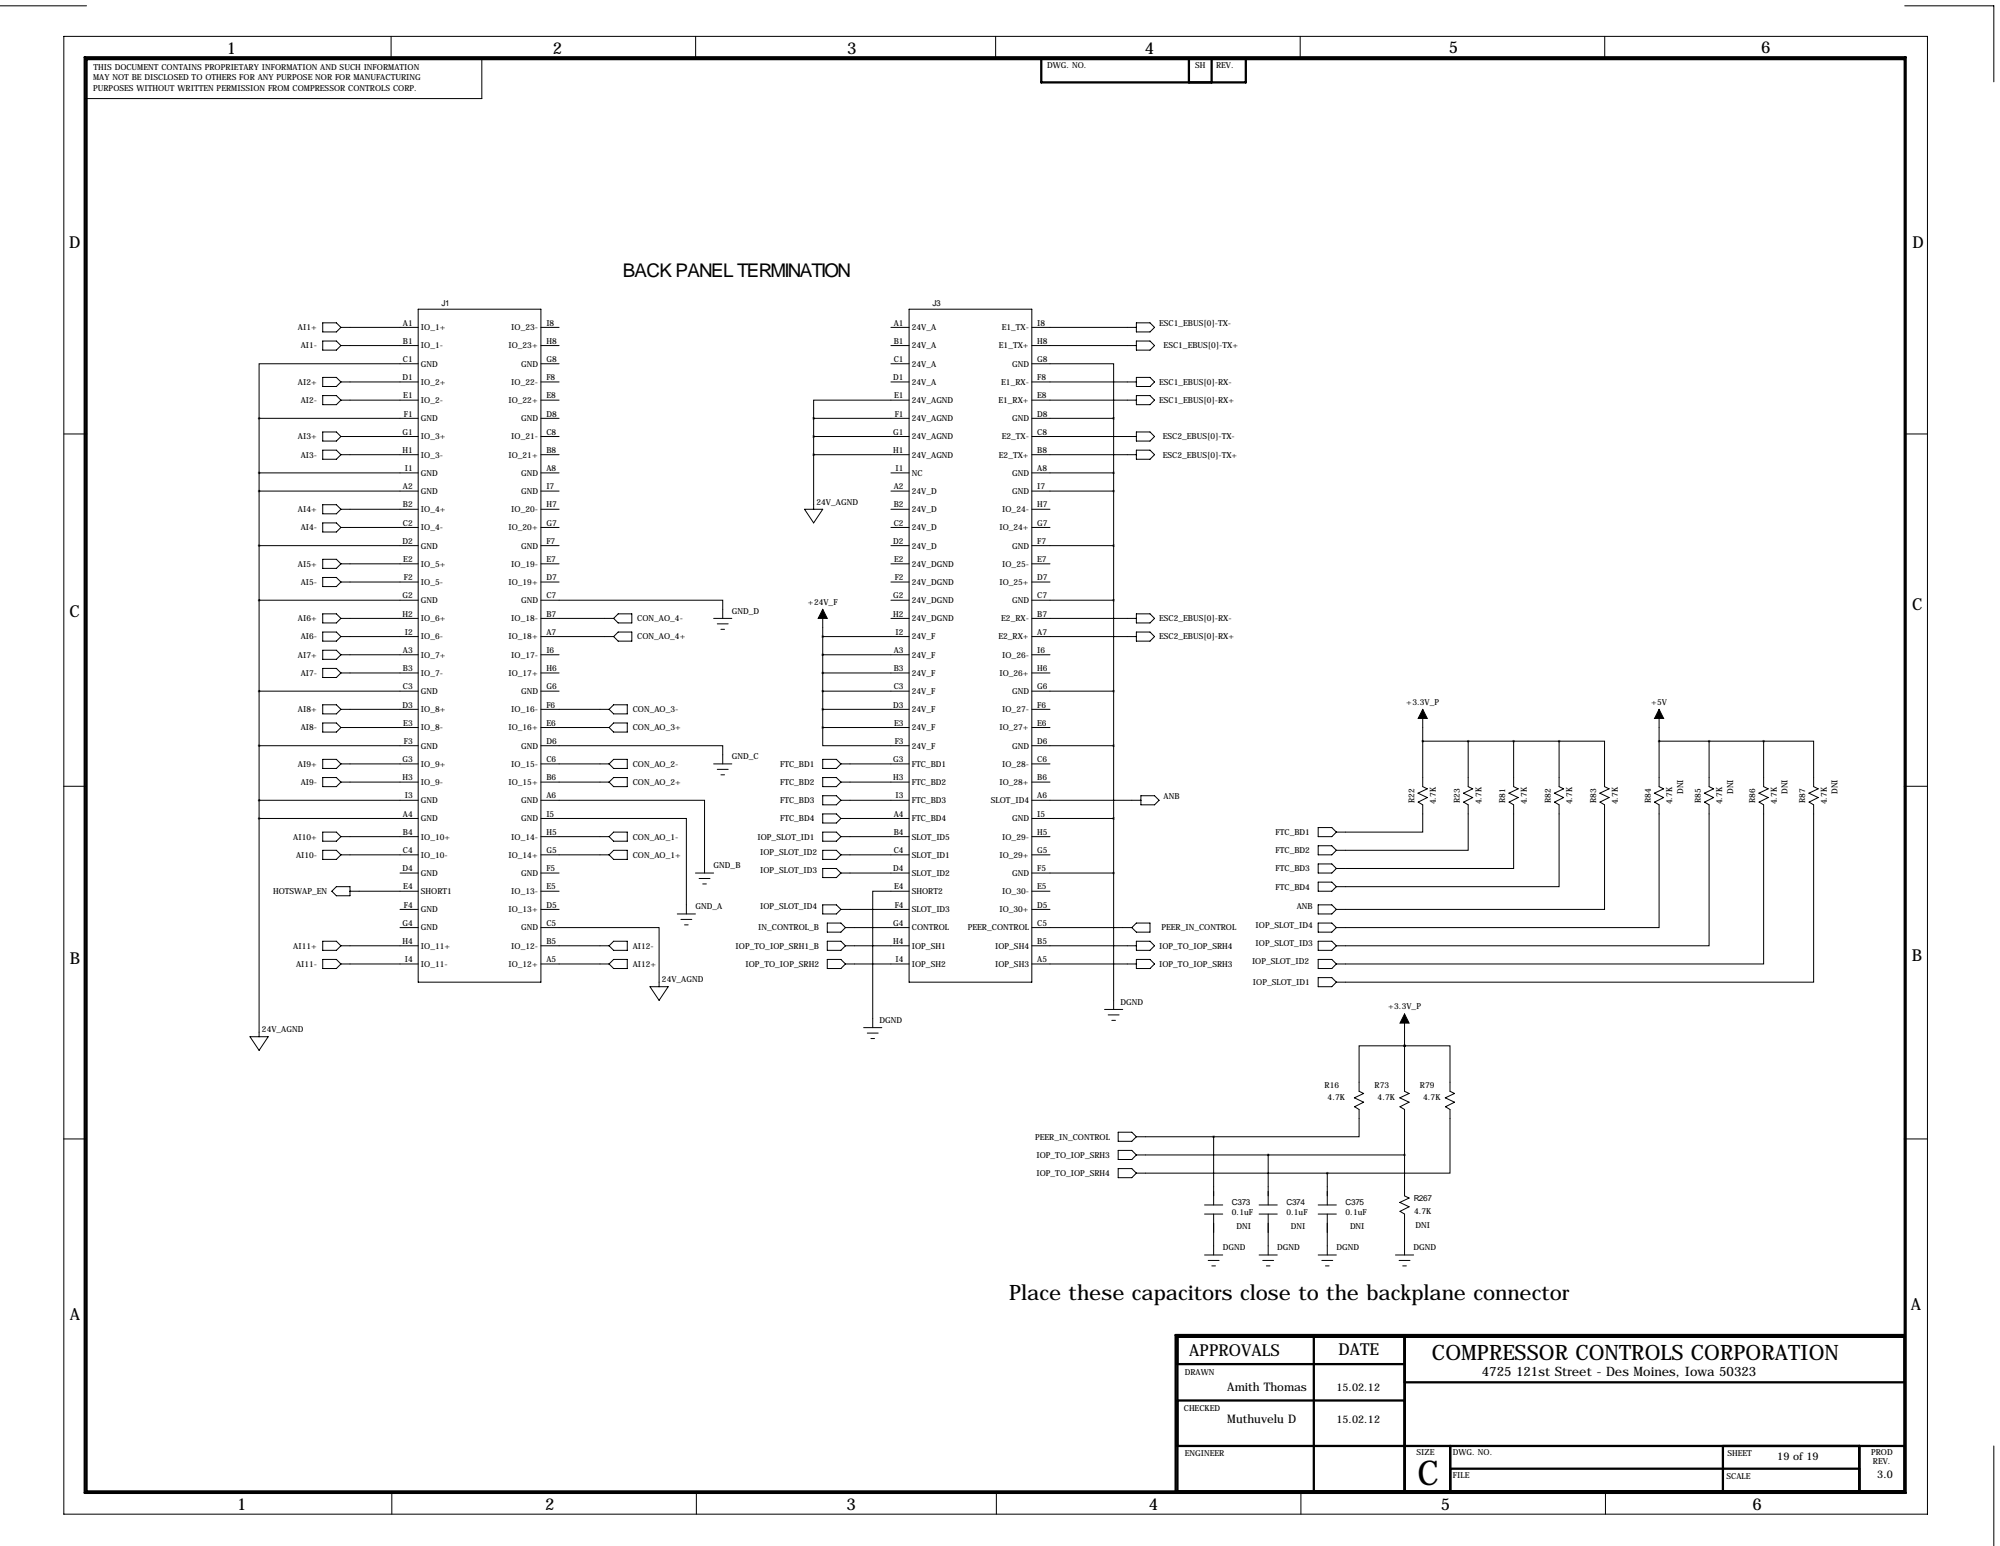
[picture p284: page 19]

Place these capacitors close to the backplane connector

APPROVALS | DATE | COMPRESSOR CONTROLS CORPORATION 4725 121st Street - Des Moines, Iowa 50323

DRAWN Amith Thomas | 15.02.12

CHECKED
