Sayidathahaseen/CCC_NGP_ODC/NGP_ODC_Main/PDLC/Mechanical/NGP_CCC Final files on dt-lohiths/Solidworks _Final files/Labels 21-07-2011/All labels 17-08-2011.pdf

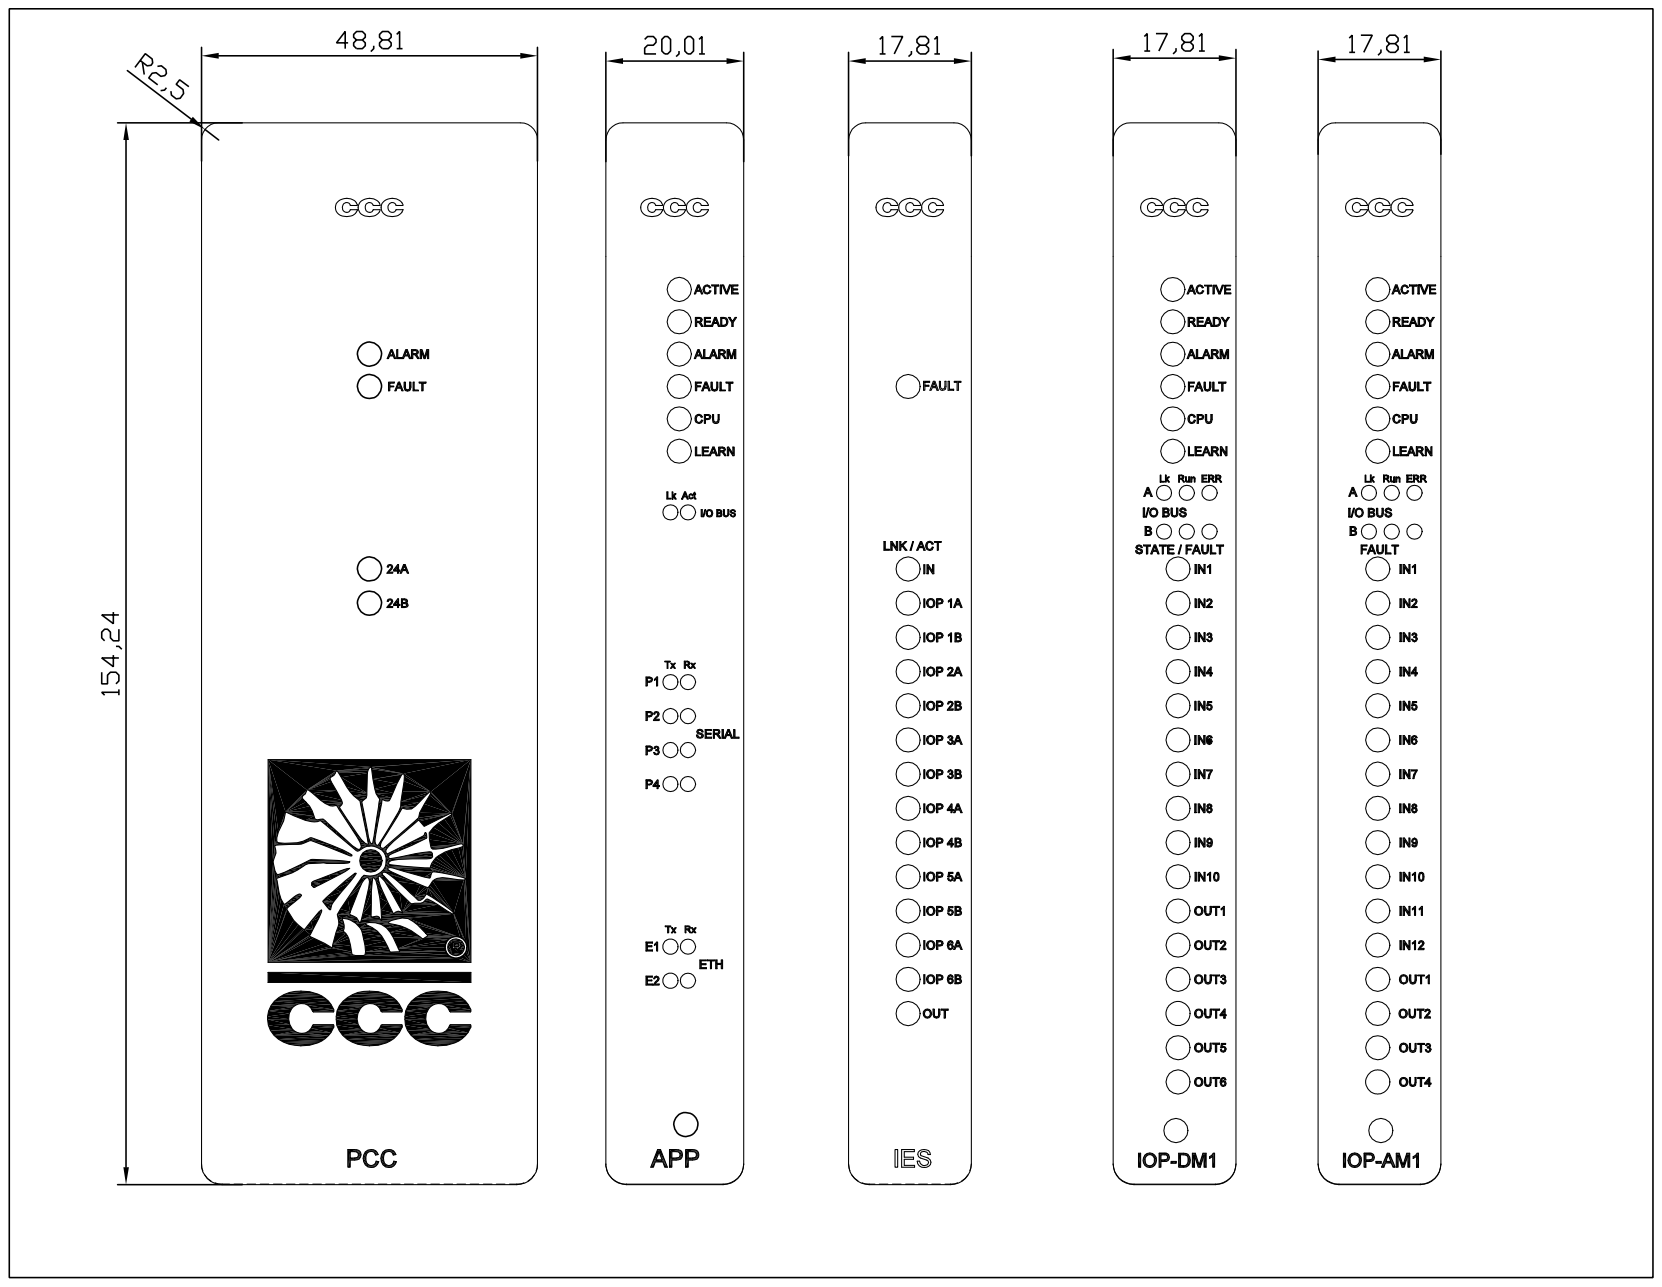
[picture p286: page 1]
