Sayidathahaseen/CCC_NGP_ODC/NGP_ODC_Main/PDLC/Mechanical/NGP_CCC Final files on dt-lohiths/Solidworks _Final files/PCC MOD/Vijay -Heat sink/Heatsink_HS1.pdf

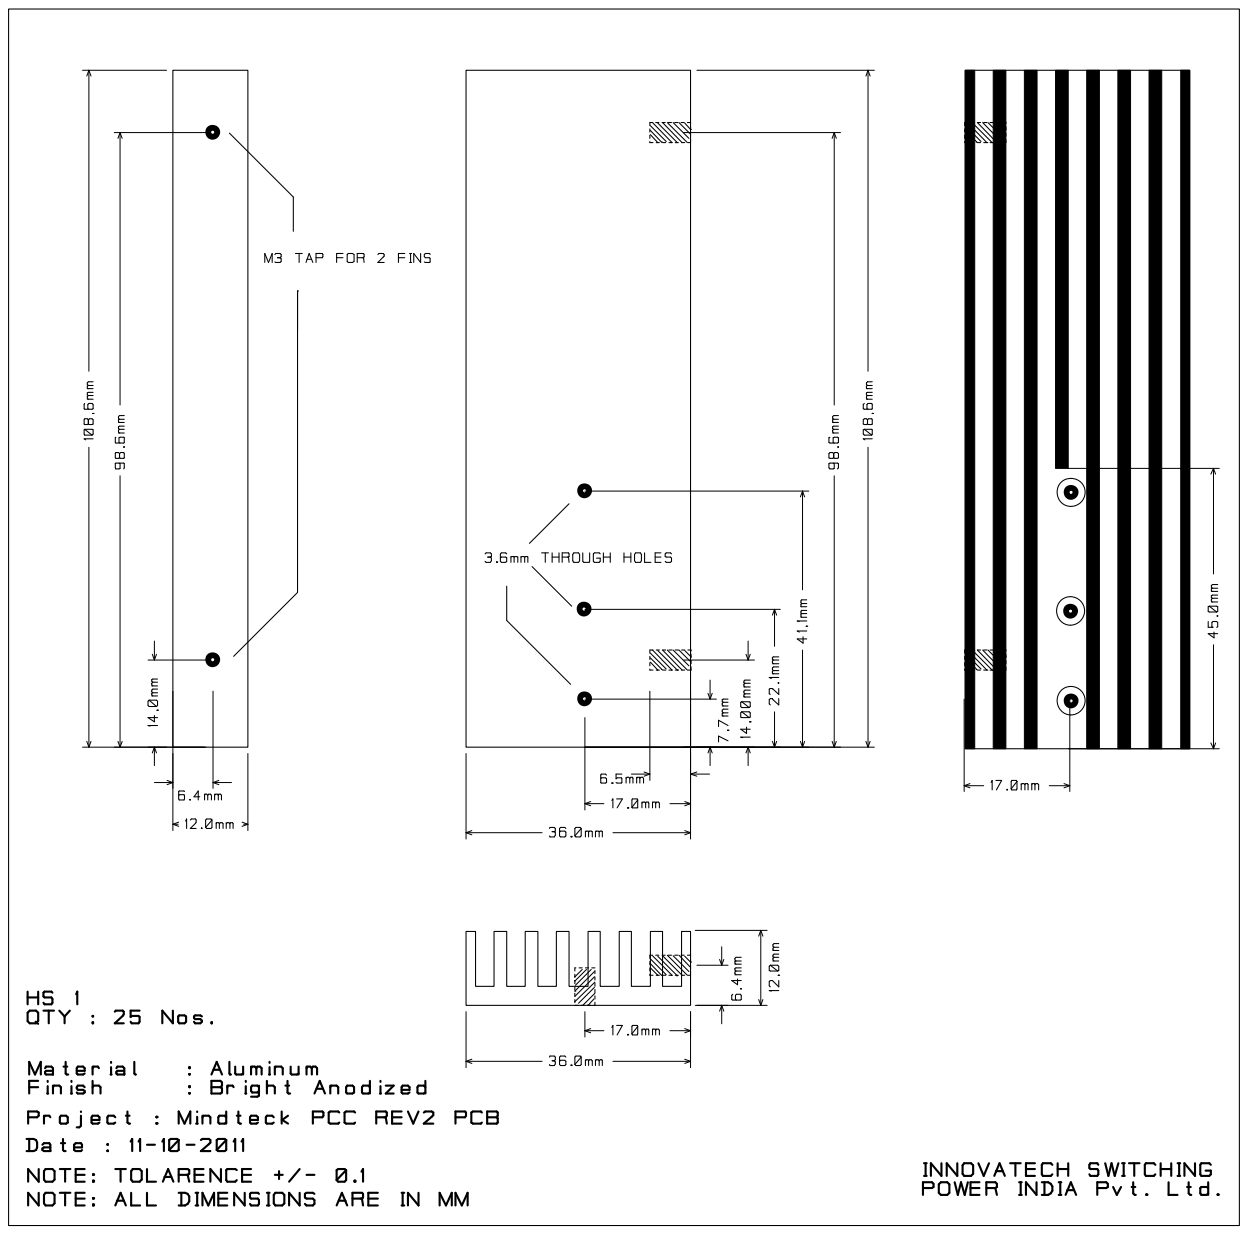
[picture p289: page 1]
