Sayidathahaseen/CCC_NGP_ODC/NGP_ODC_Main/PDLC/Mechanical/NGP_CCC Final files on dt-lohiths/Solidworks _Final files/PCC MOD/Vijay -Heat sink/Heatsink_HS2.pdf

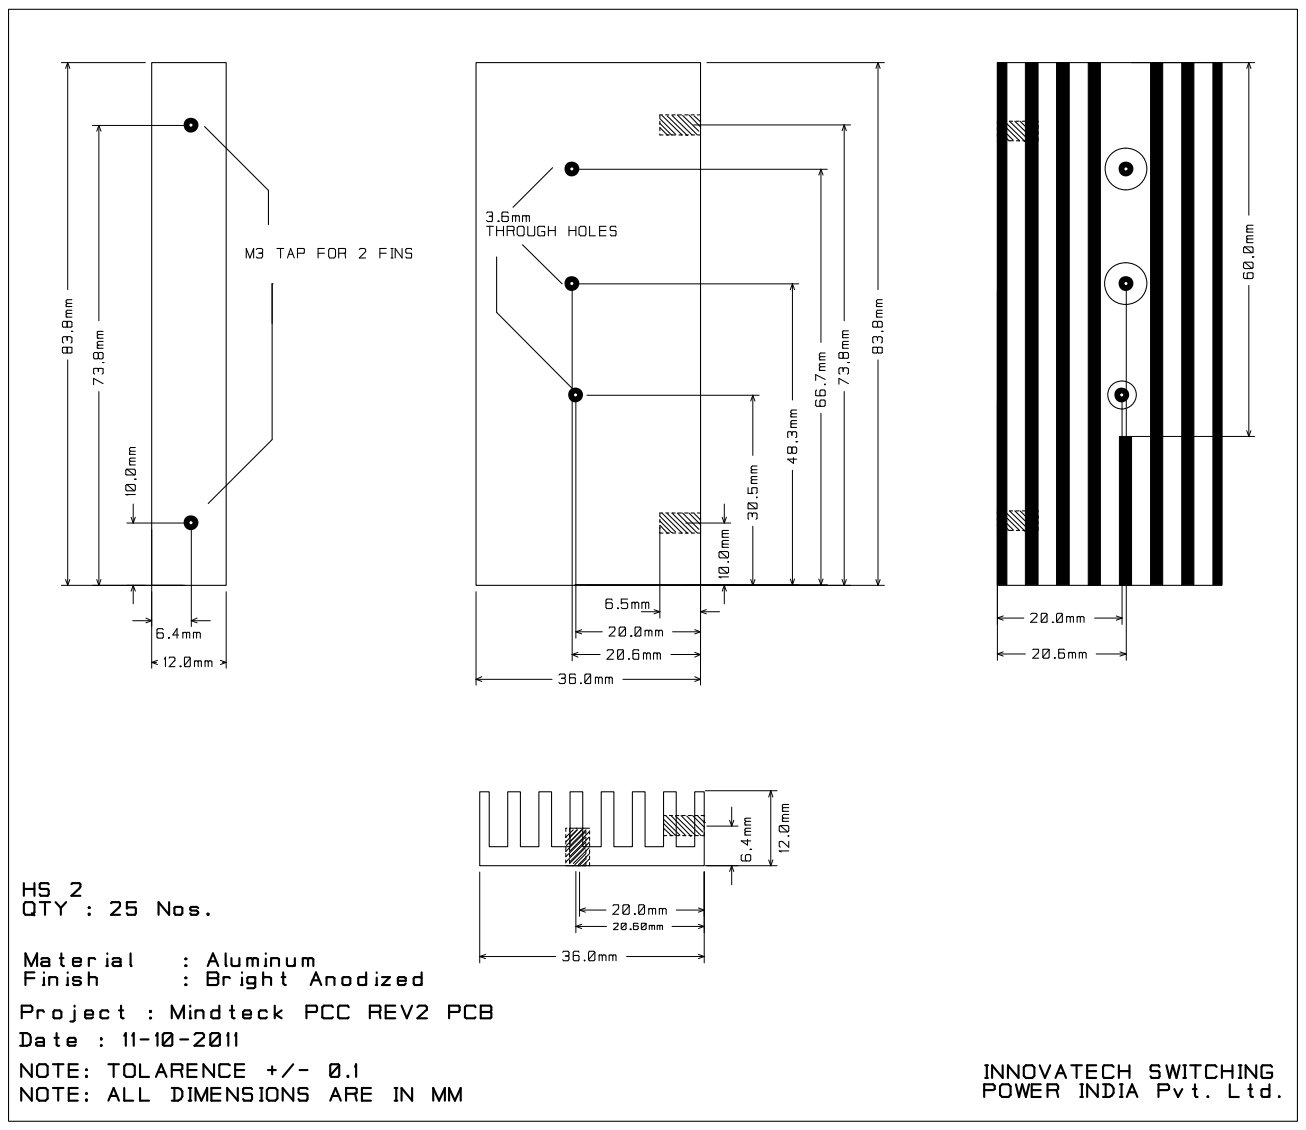
[picture p290: page 1]
