Sayidathahaseen/CCC_NGP_ODC/NGP_ODC_Main/PDLC/VanGuard/TMPU1002AS_RB2.pdf

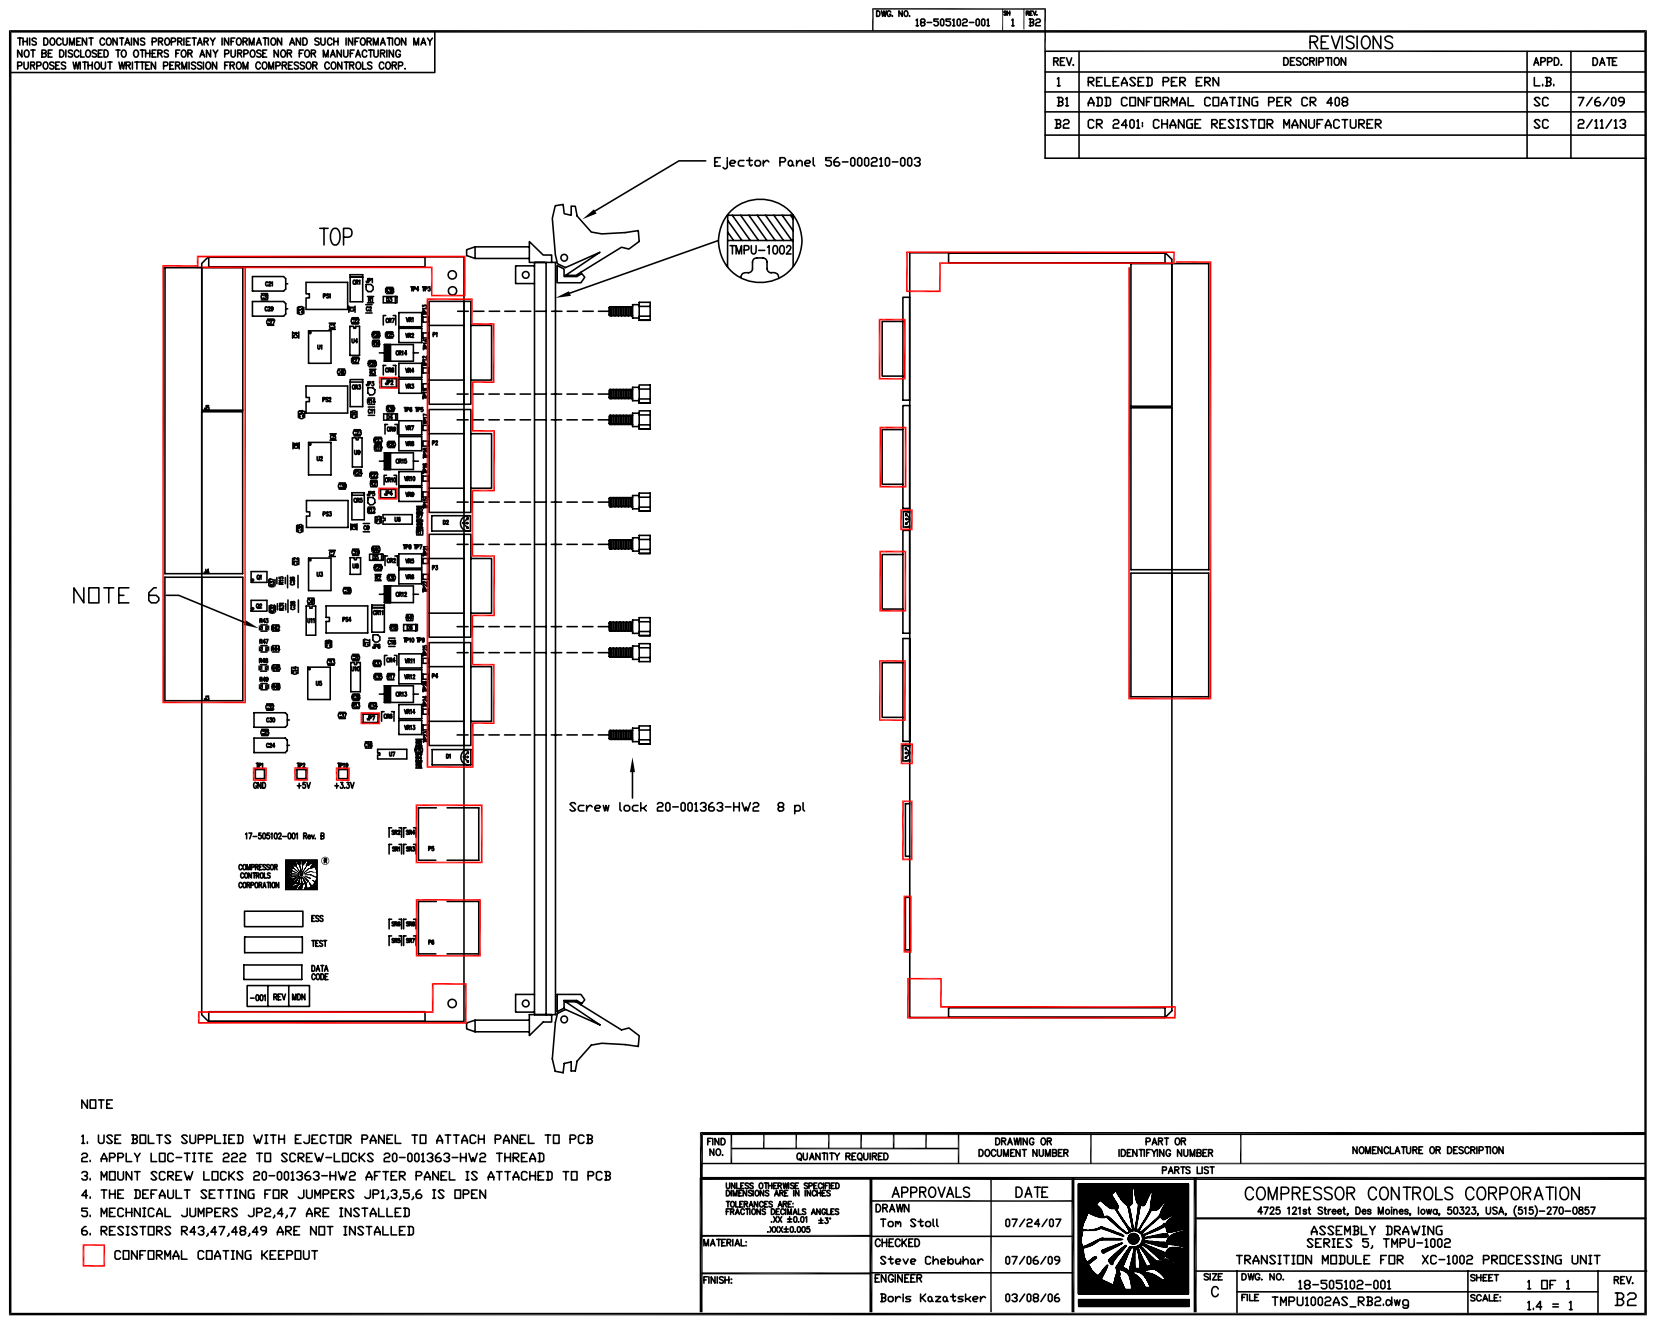
[picture p293: page 1]
