Sayidathahaseen/CCC_NGP_ODC/NGP_ODC_Main/PDLC/VanGuard/TMPU_XC1002_RevB2_SCH.pdf

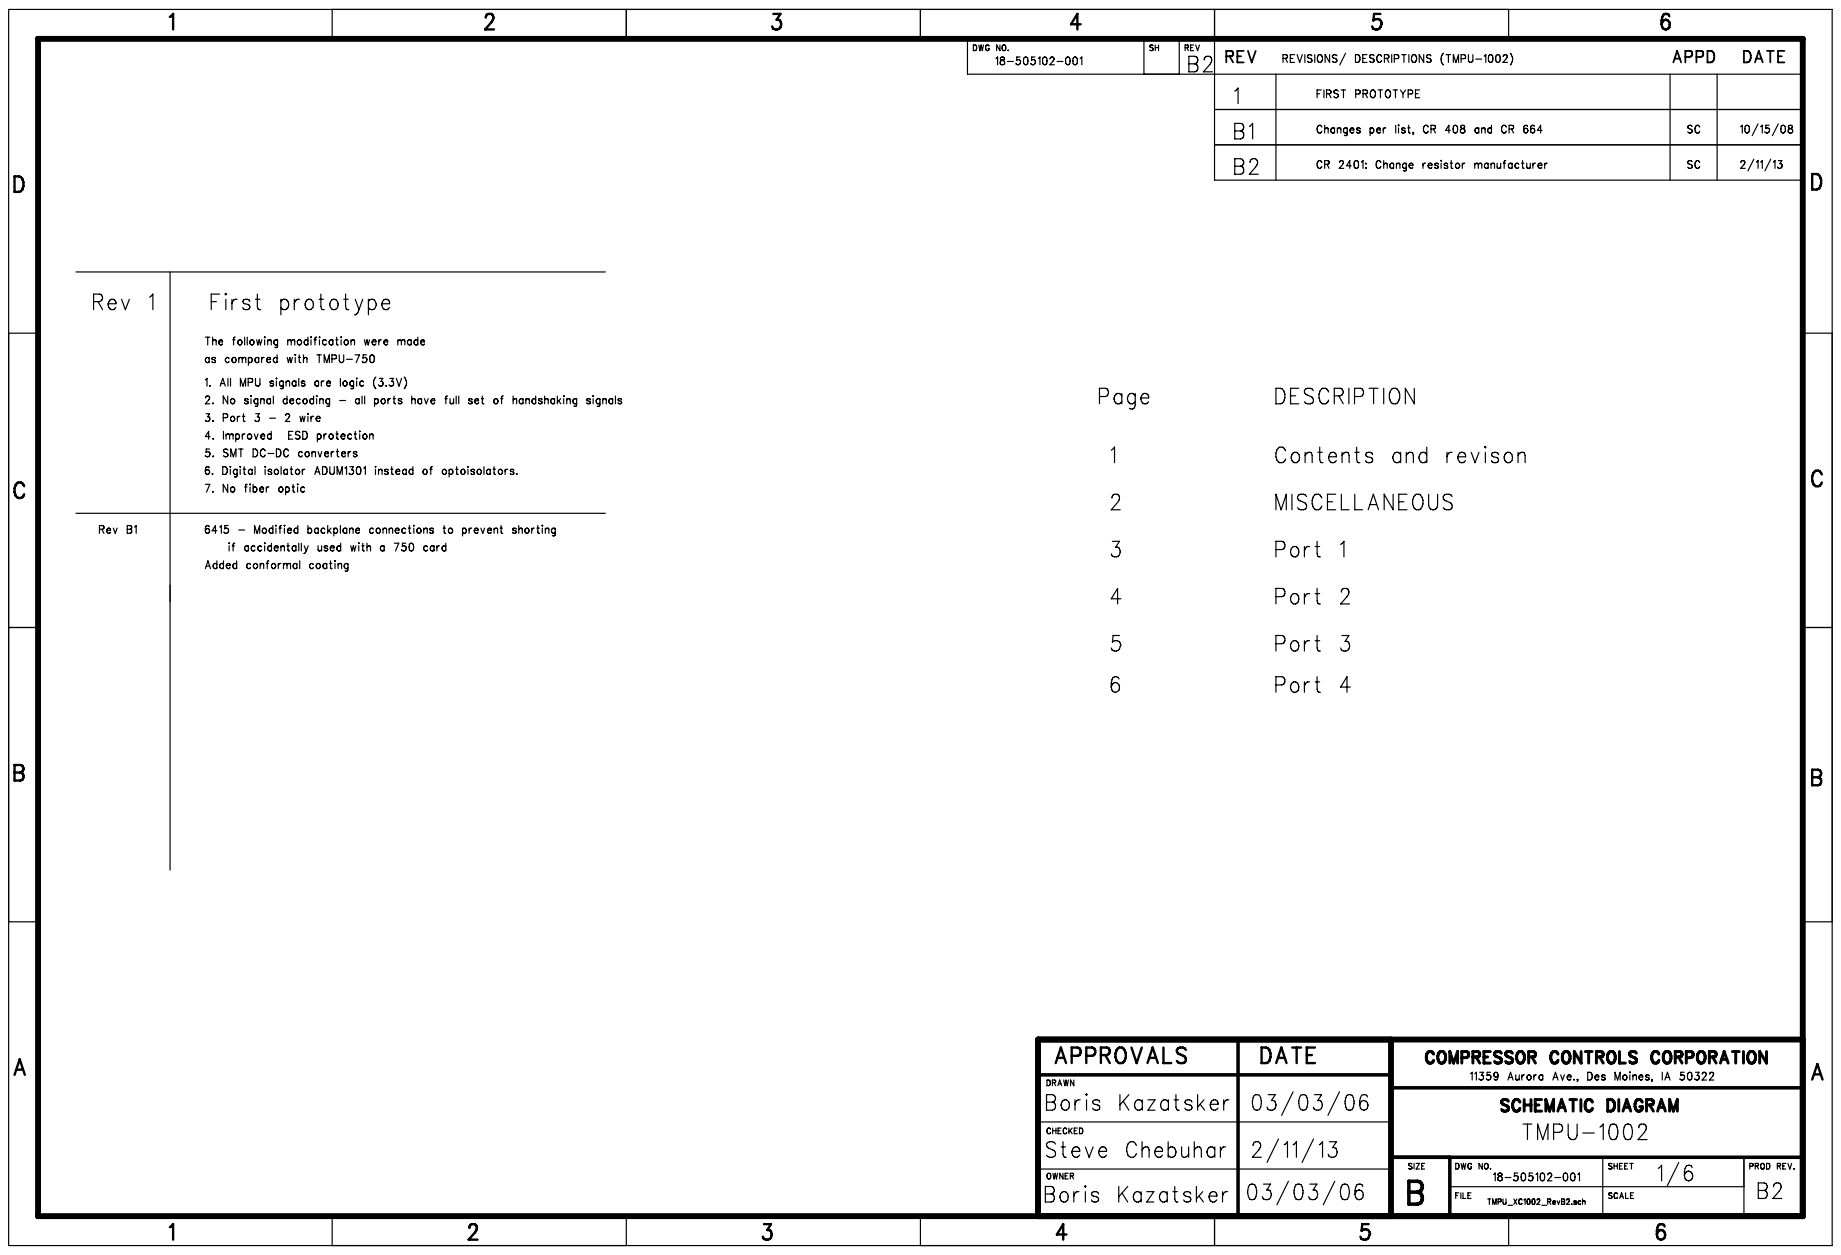
[picture p294: page 1]

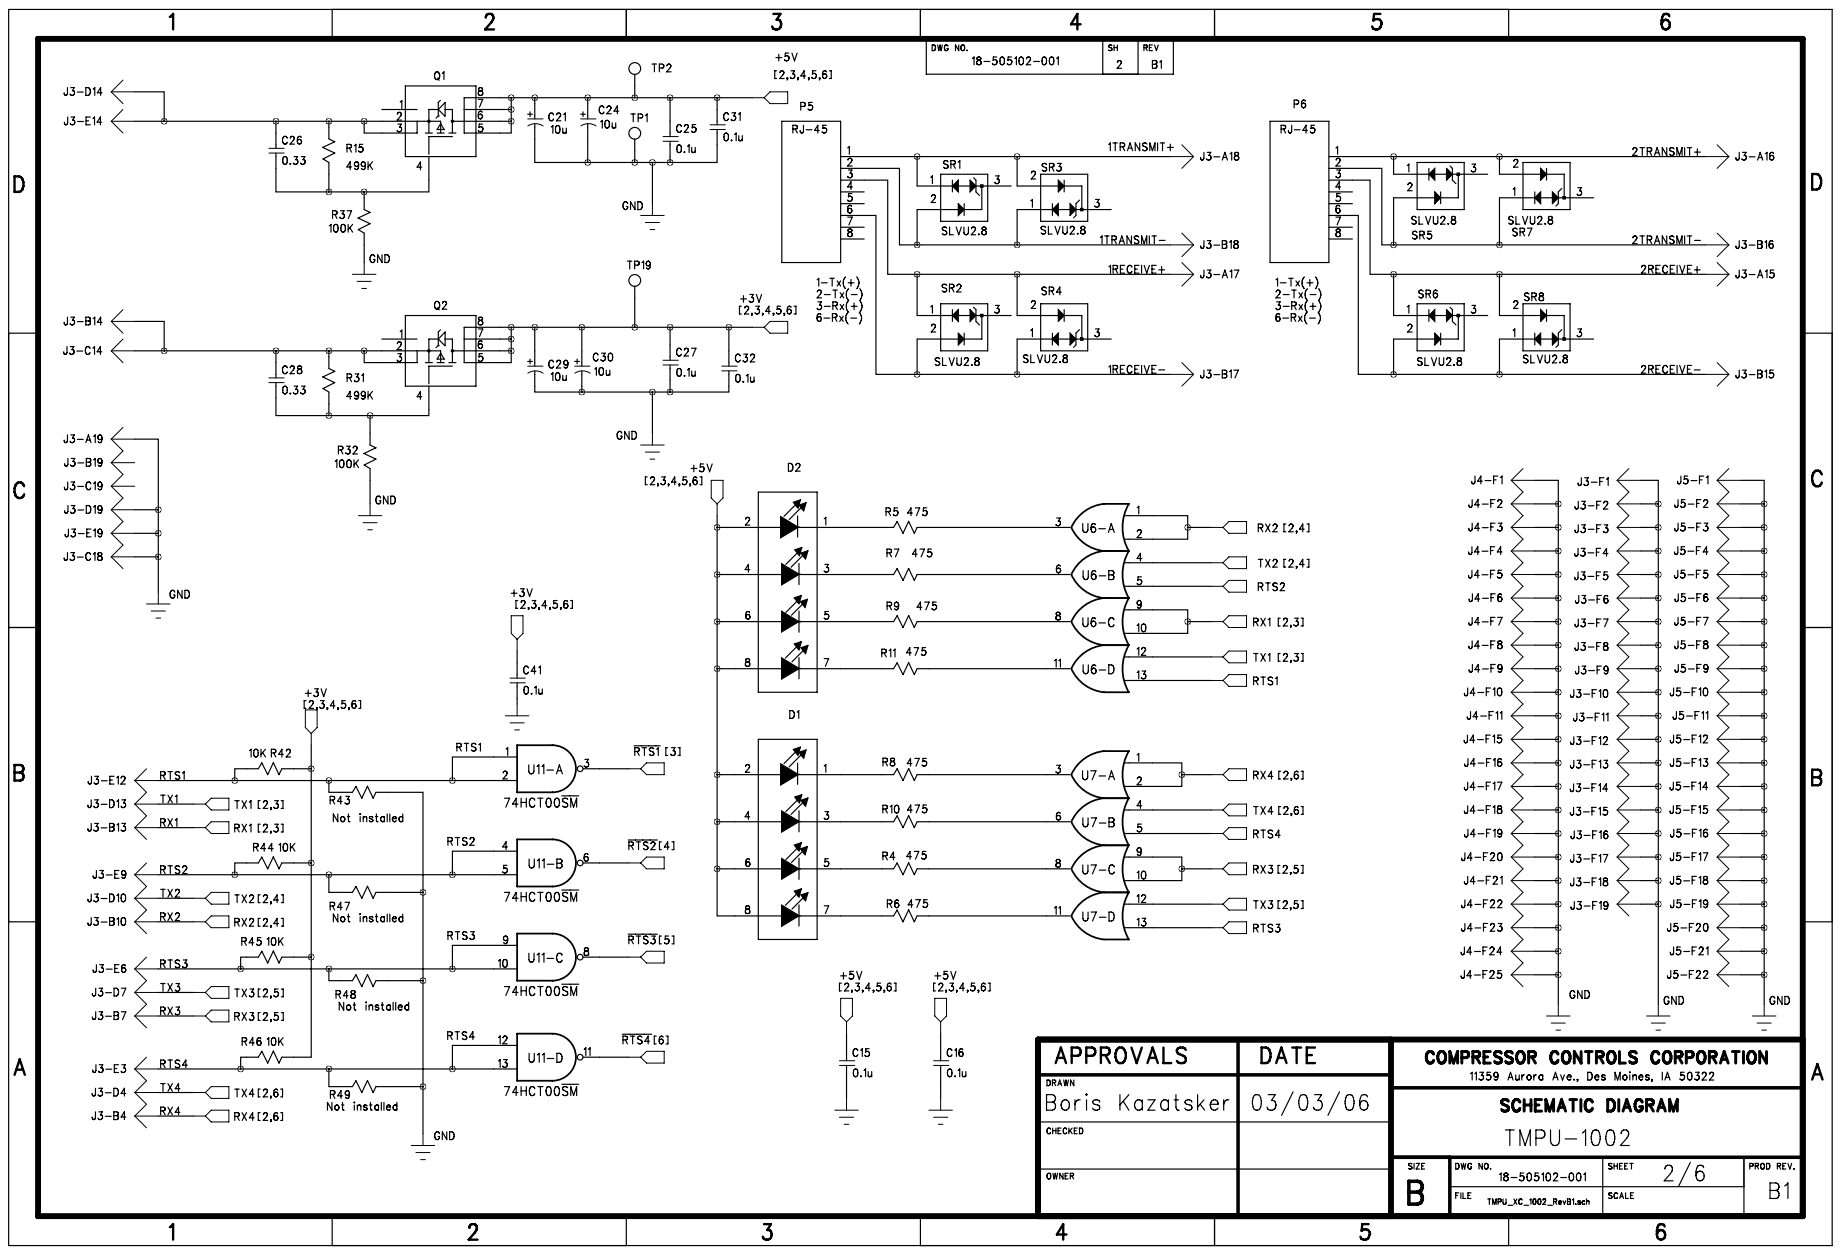
[picture p295: page 2]

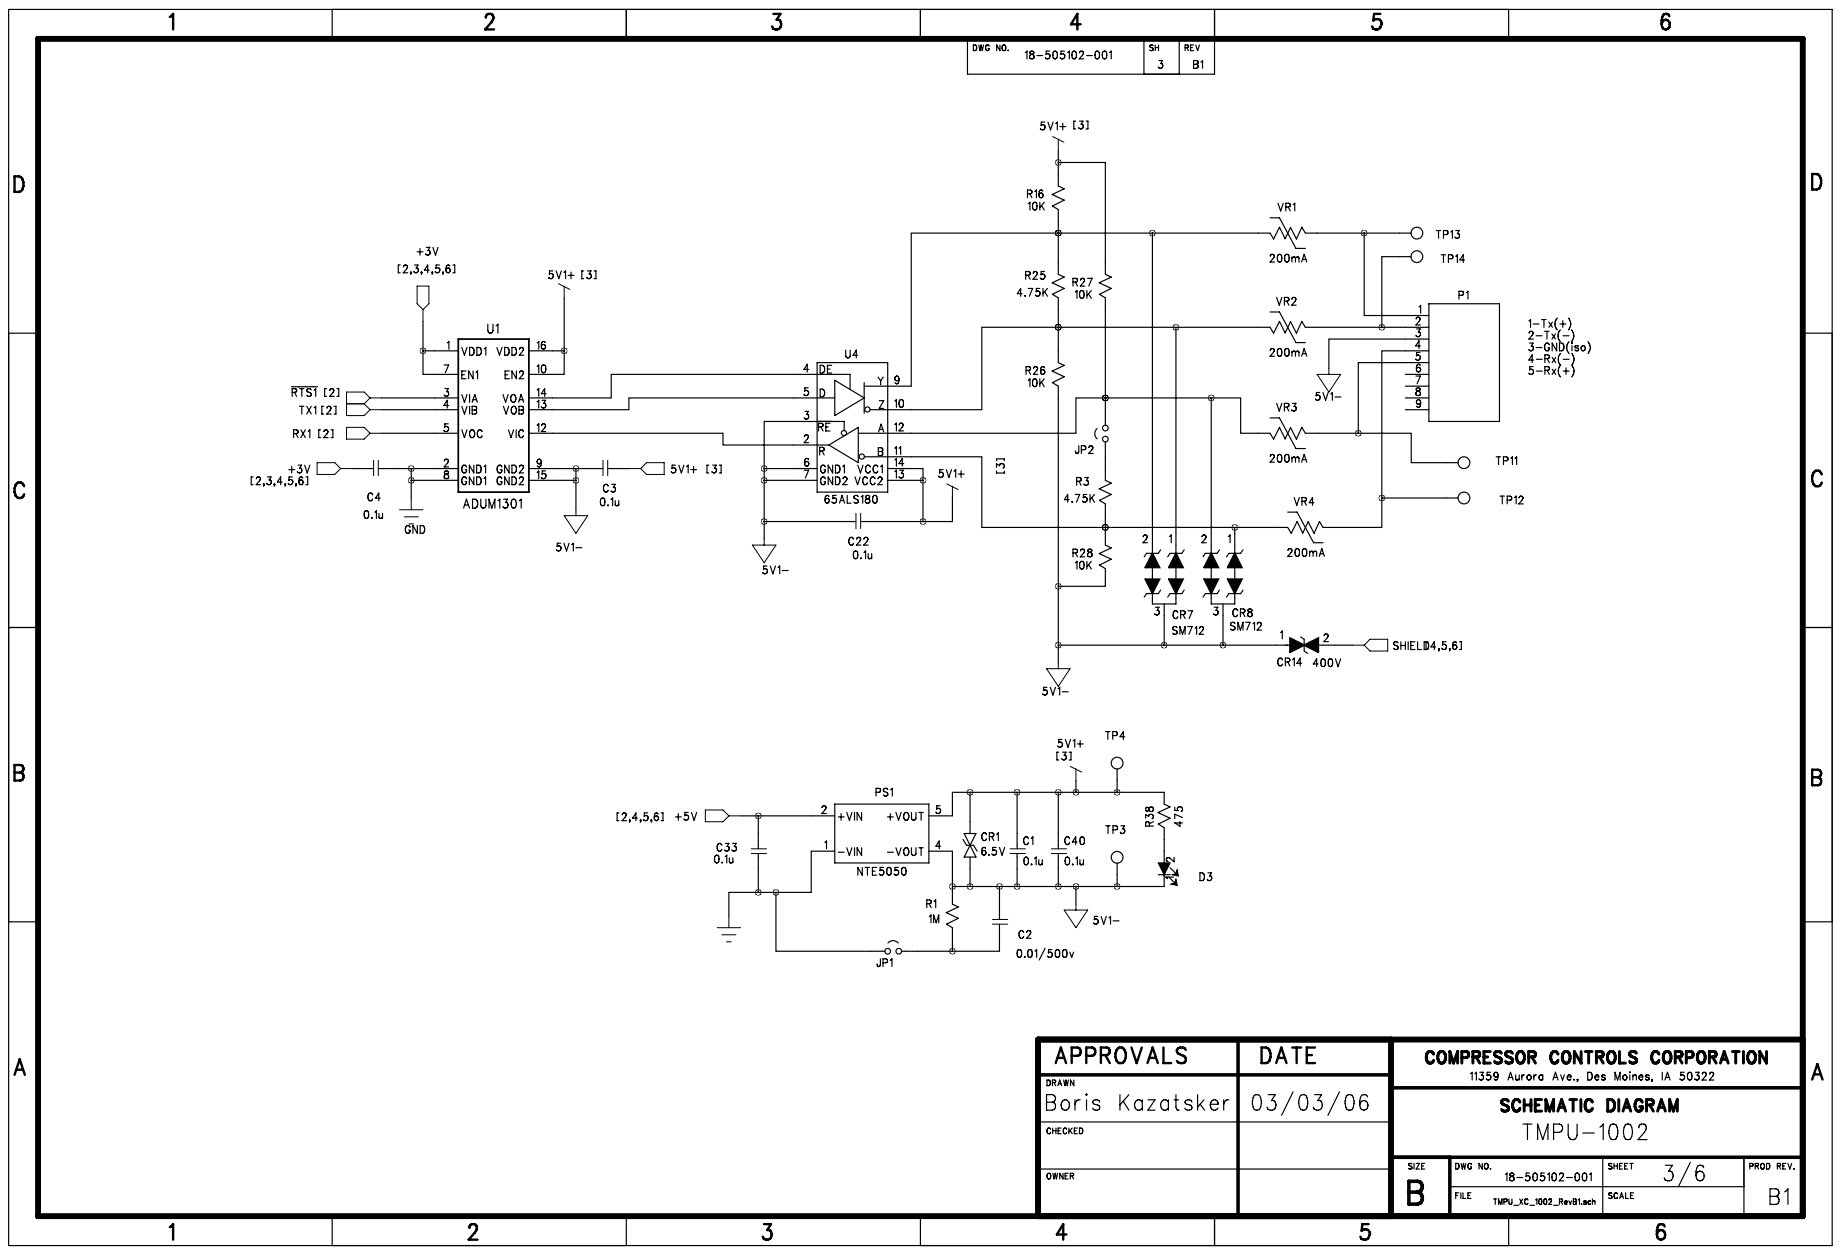
[picture p296: page 3]

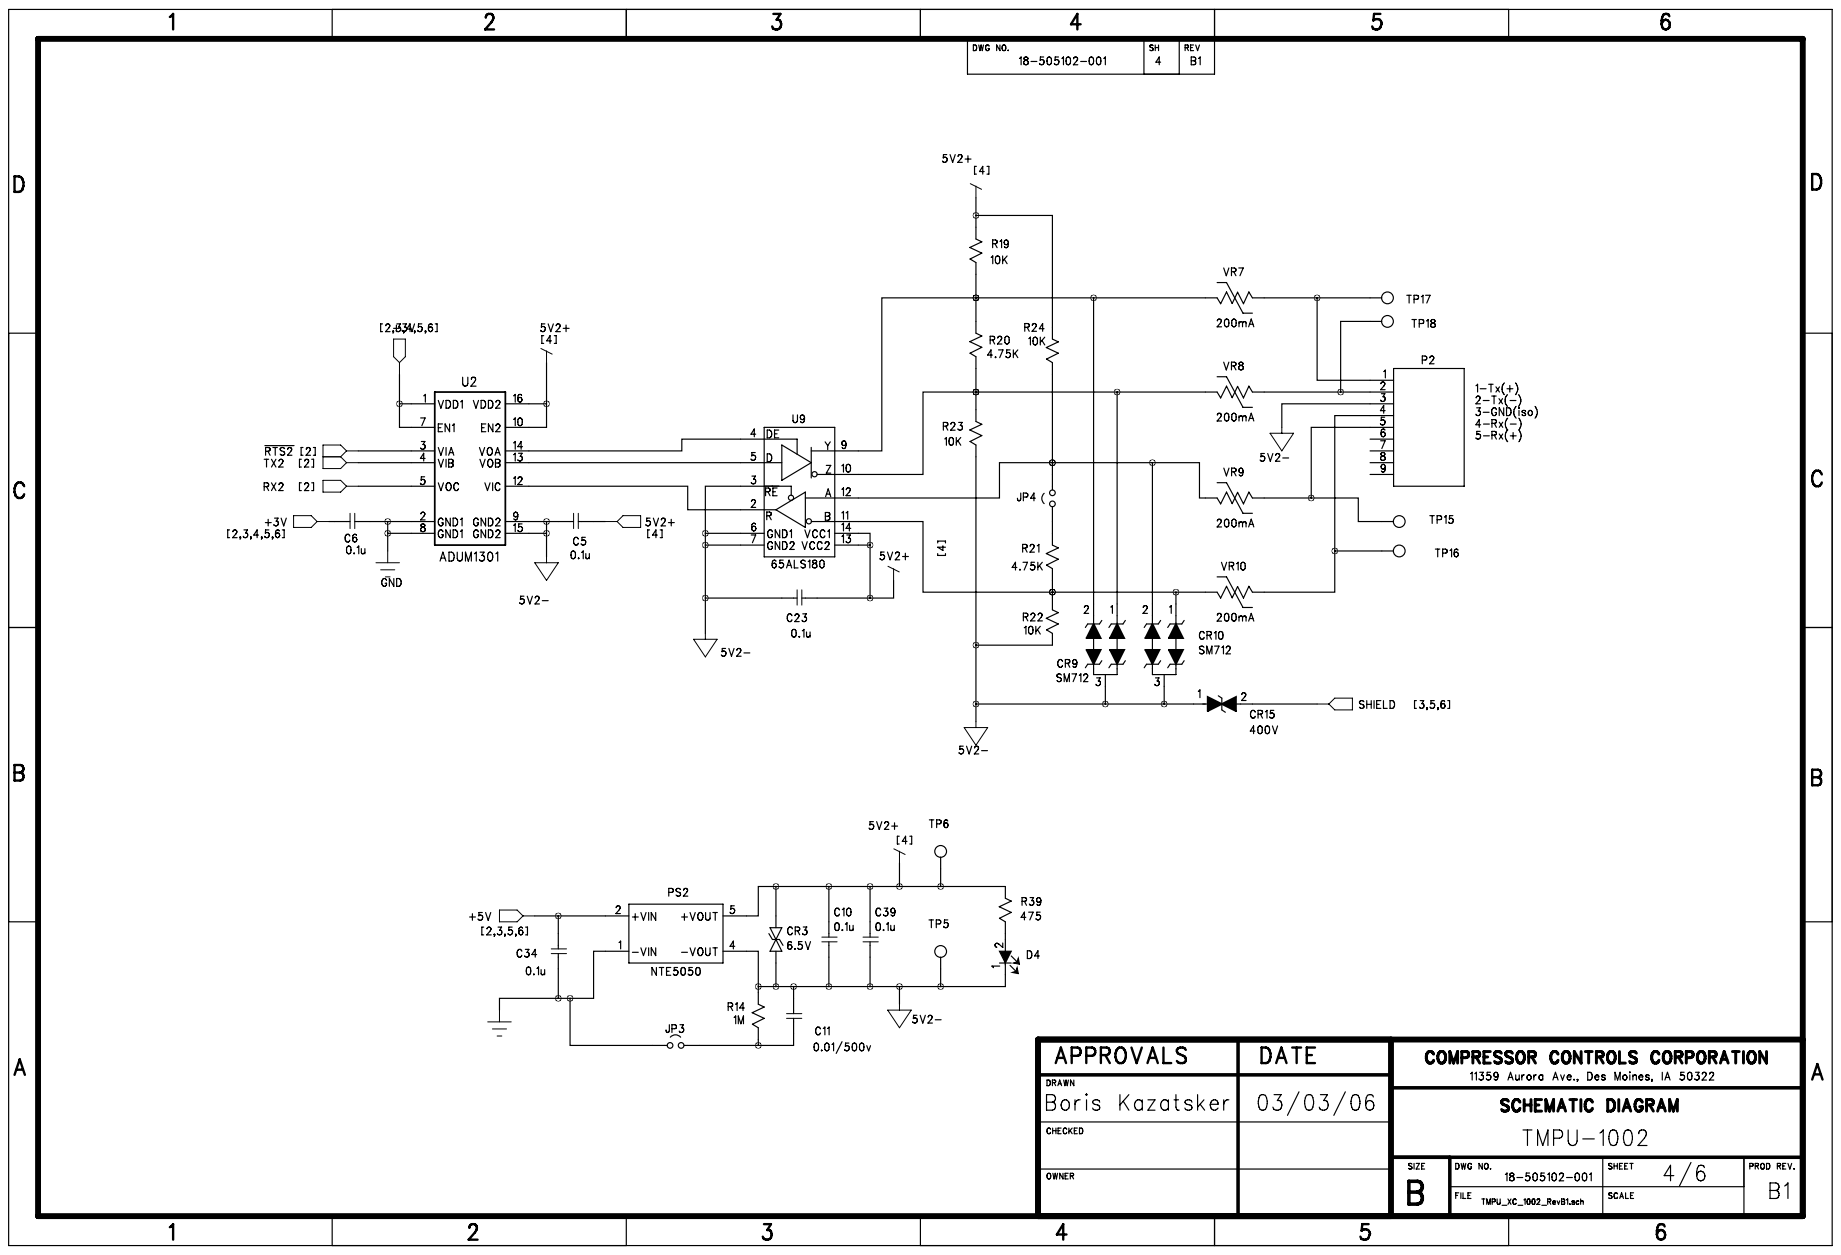
[picture p297: page 4]

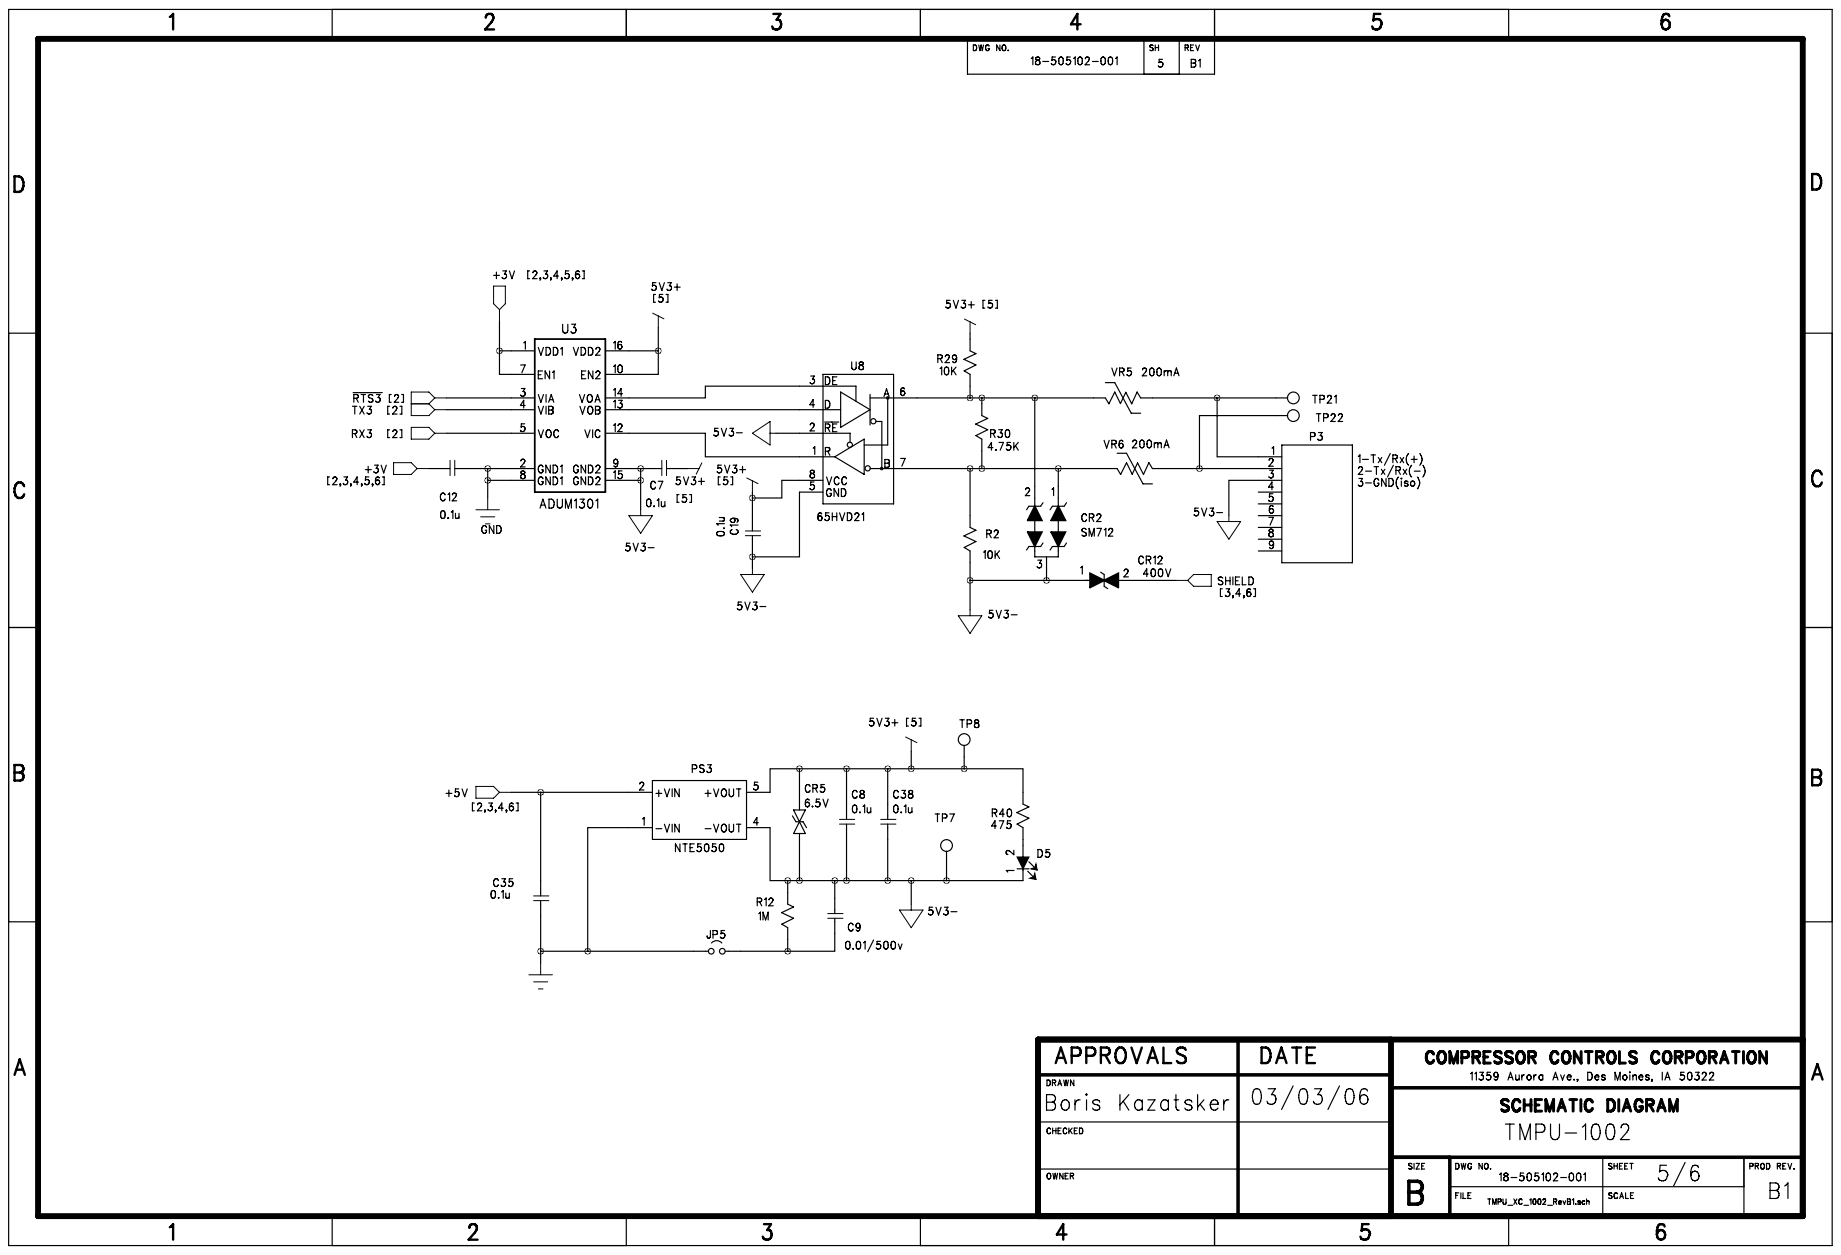
[picture p298: page 5]

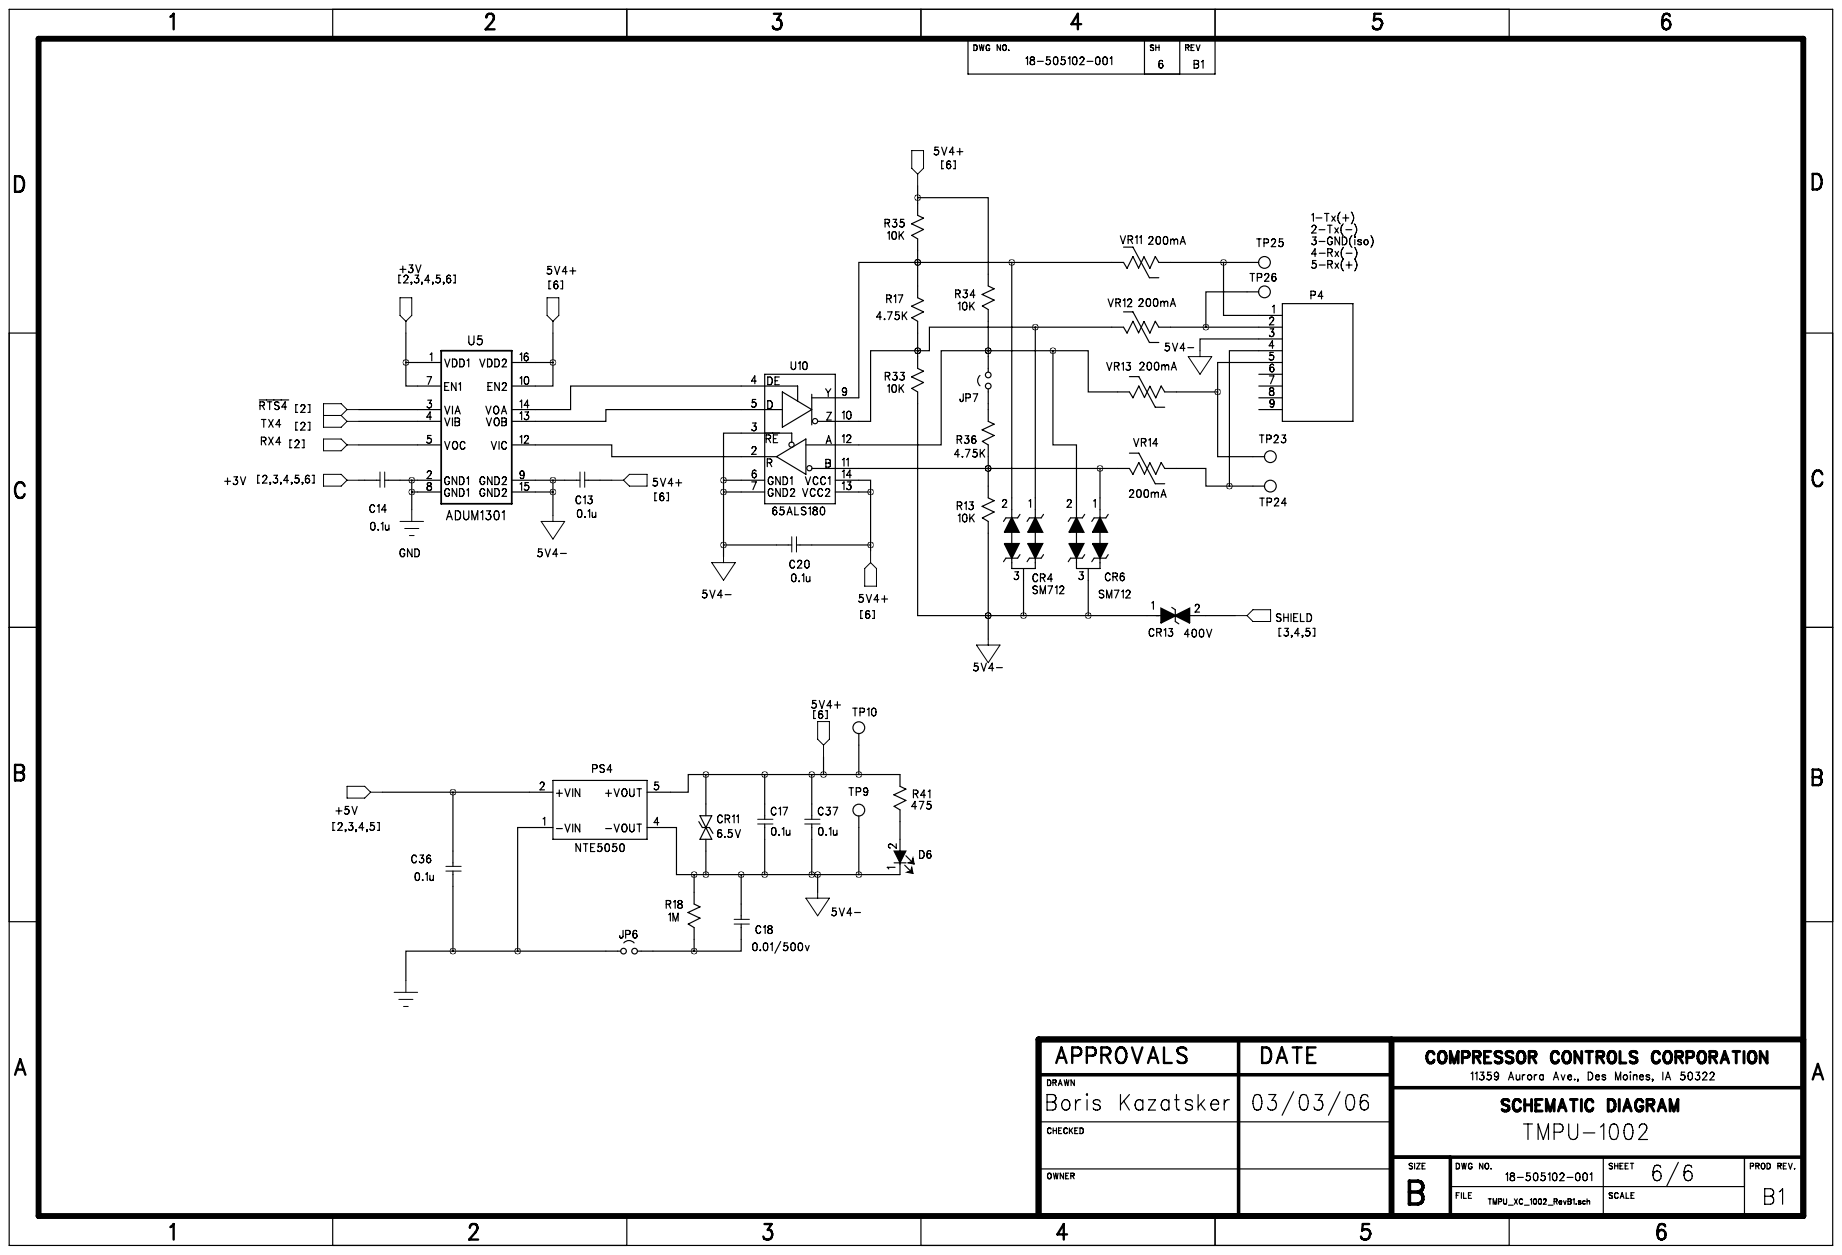
[picture p299: page 6]
