Sayidathahaseen/CCC_NGP_ODC/NGP_ODC_Main/PDLC/IES-S4M/Client Input/NS4FTMC Model (1).pdf

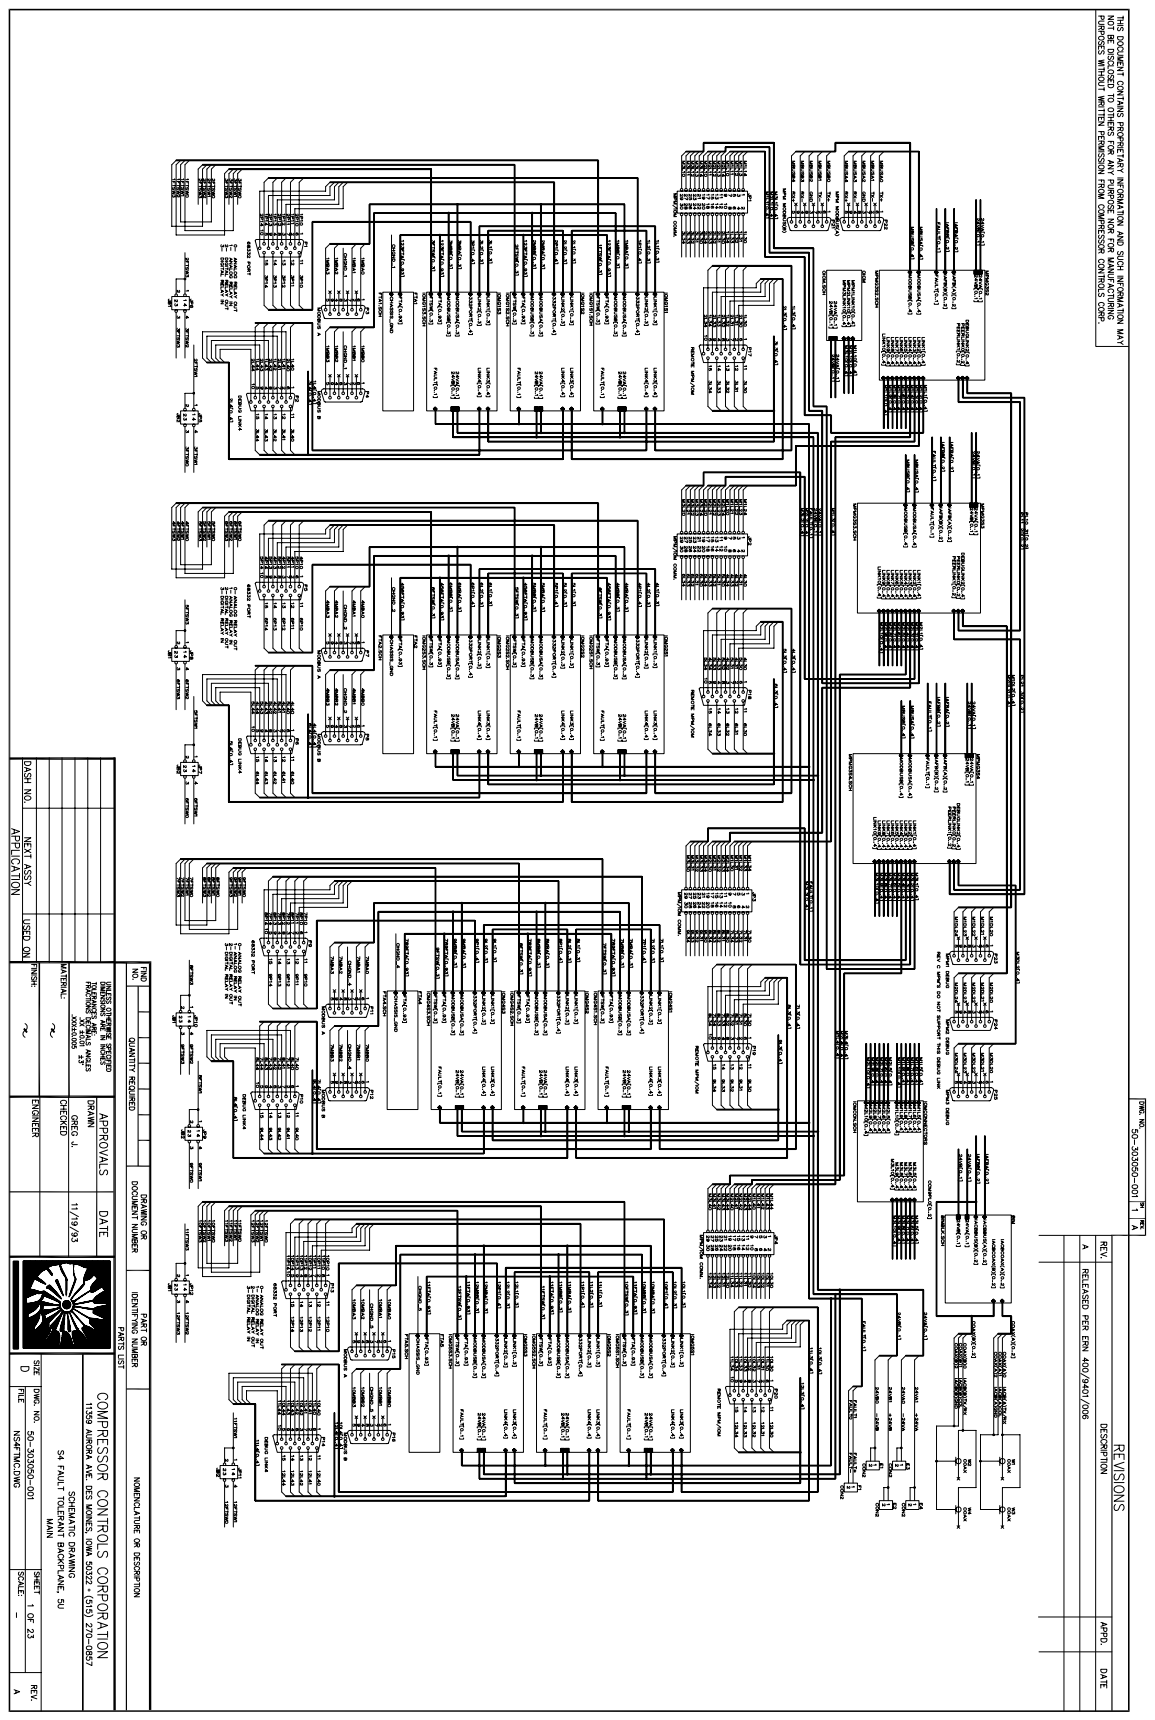
[picture p300: page 1]

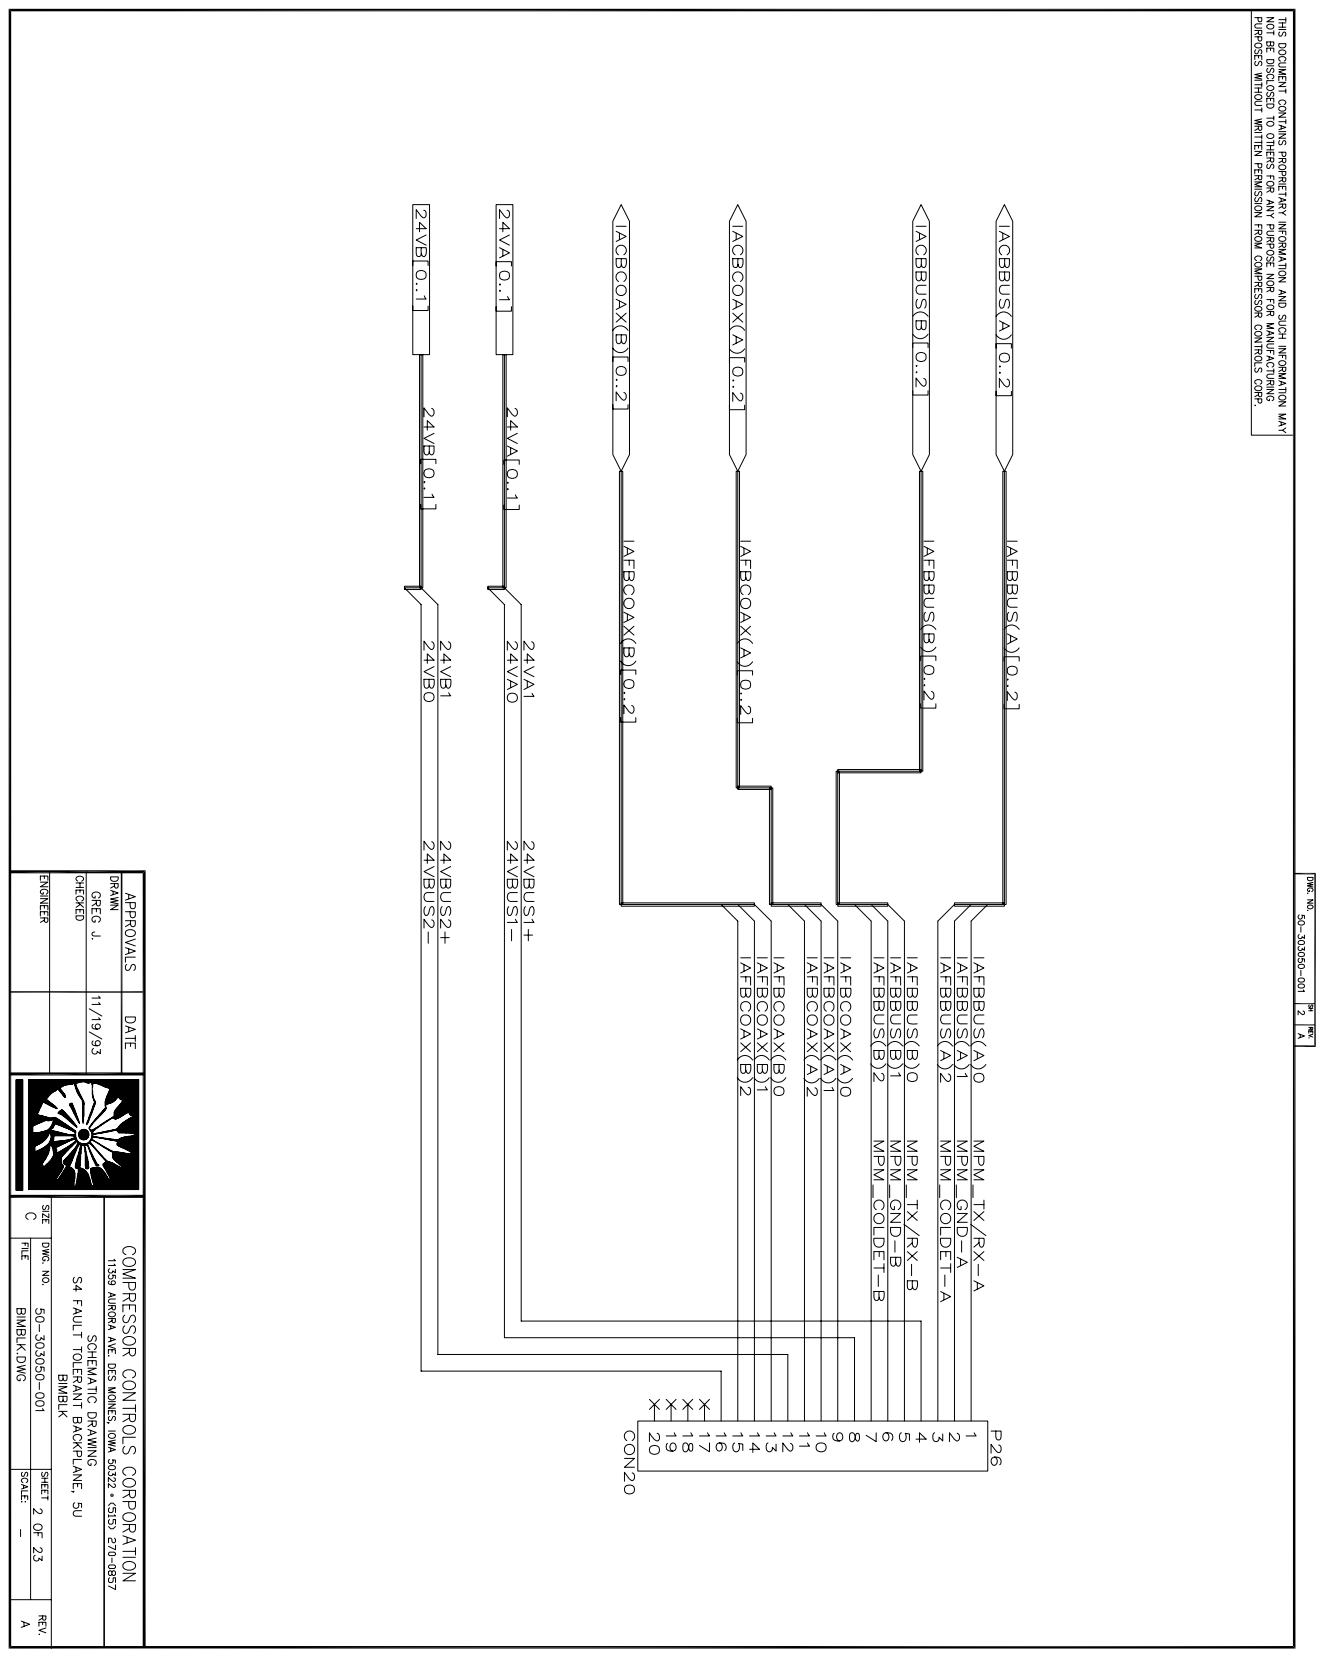
[picture p301: page 2]

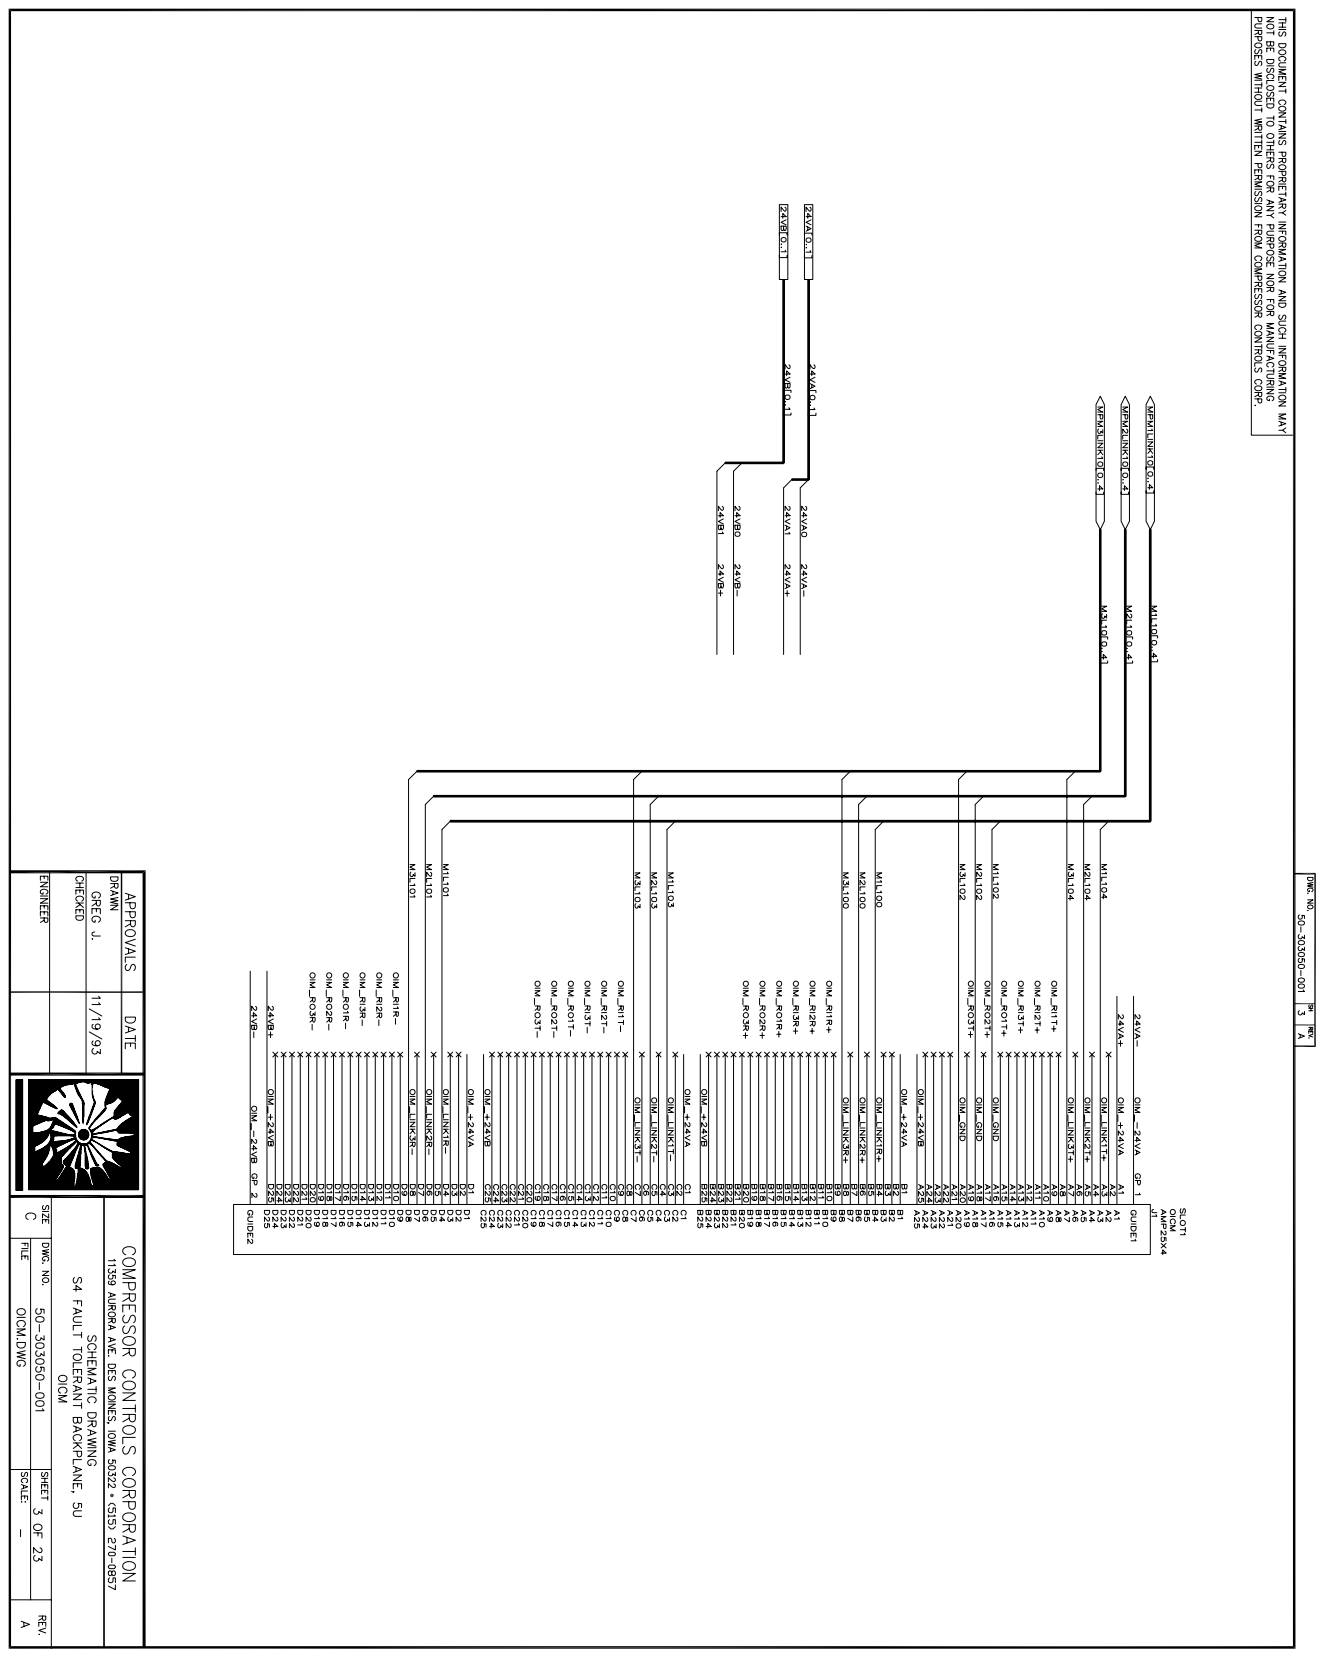
[picture p302: page 3]

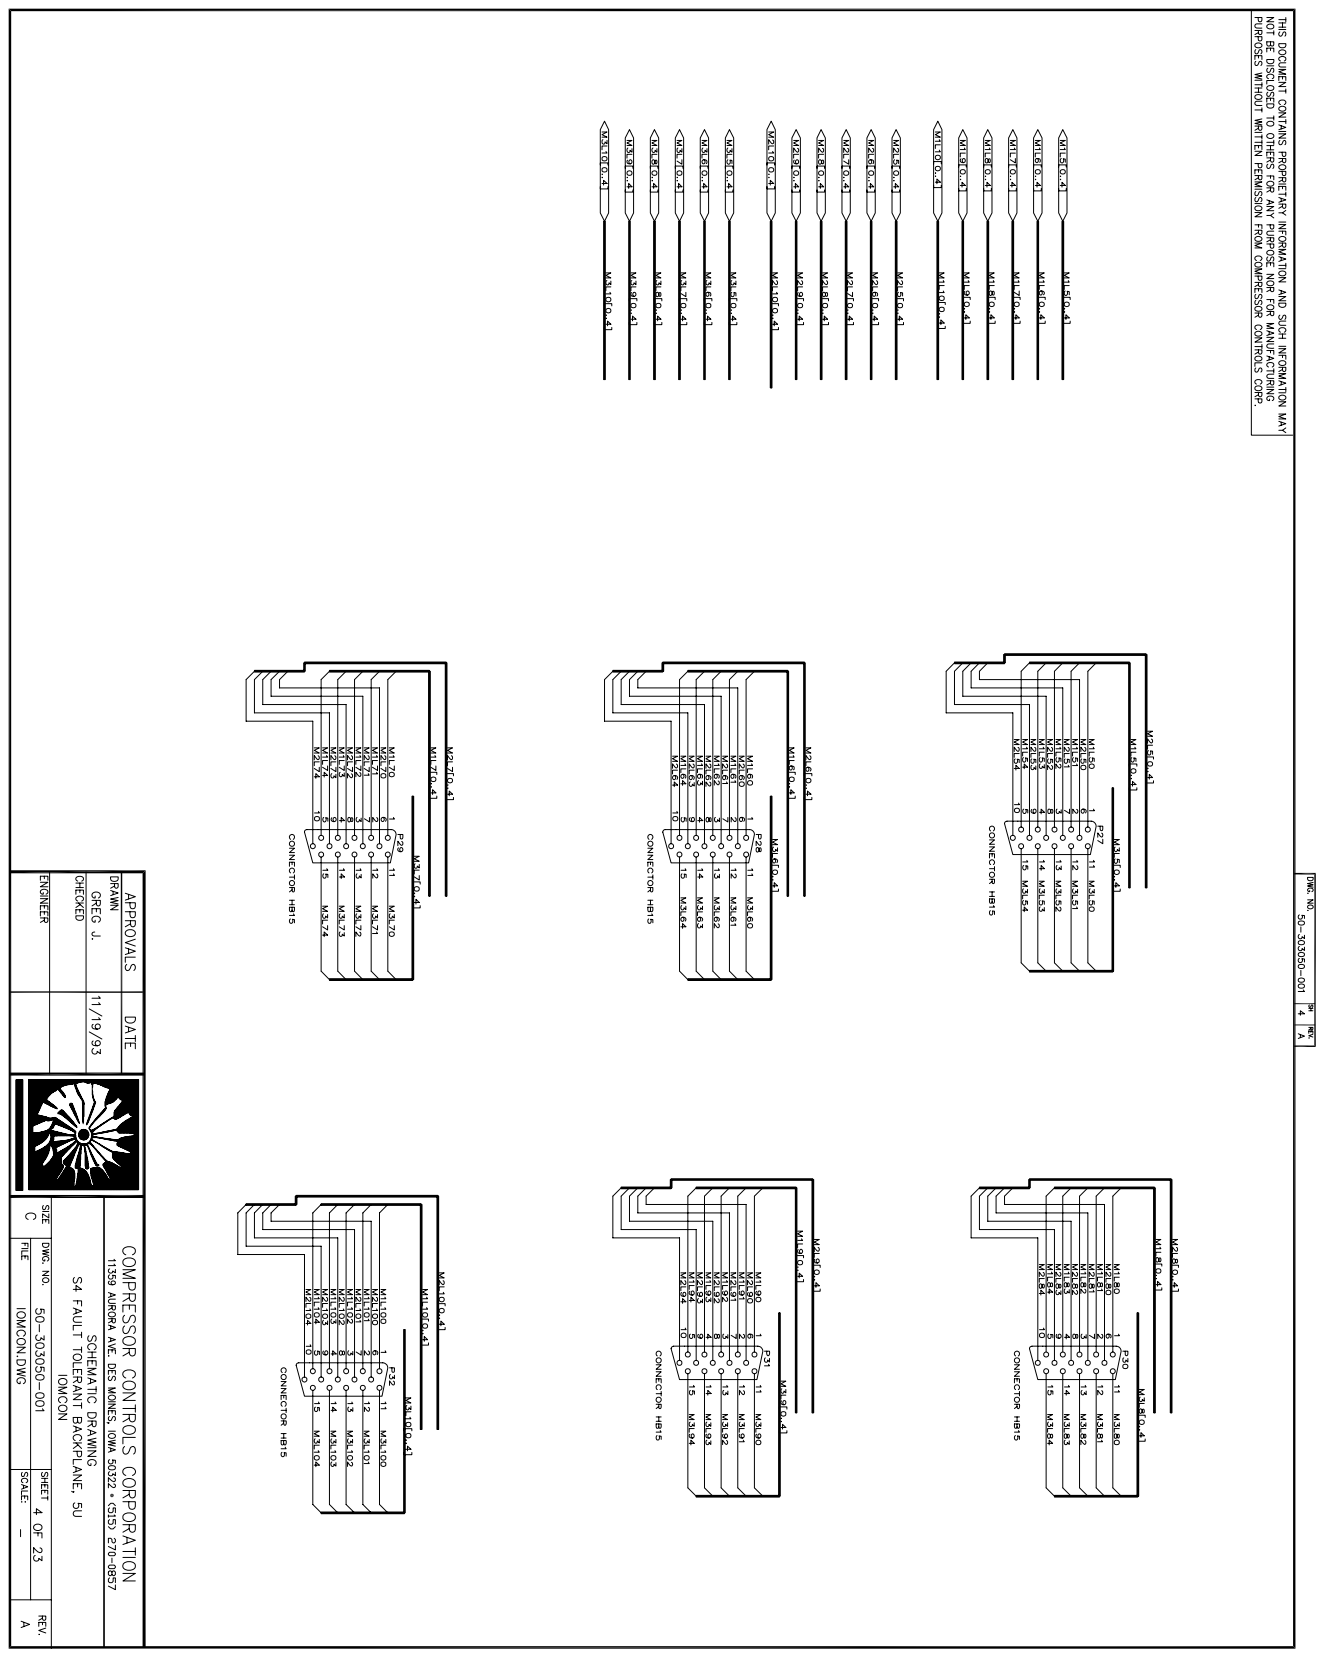
[picture p303: page 4]

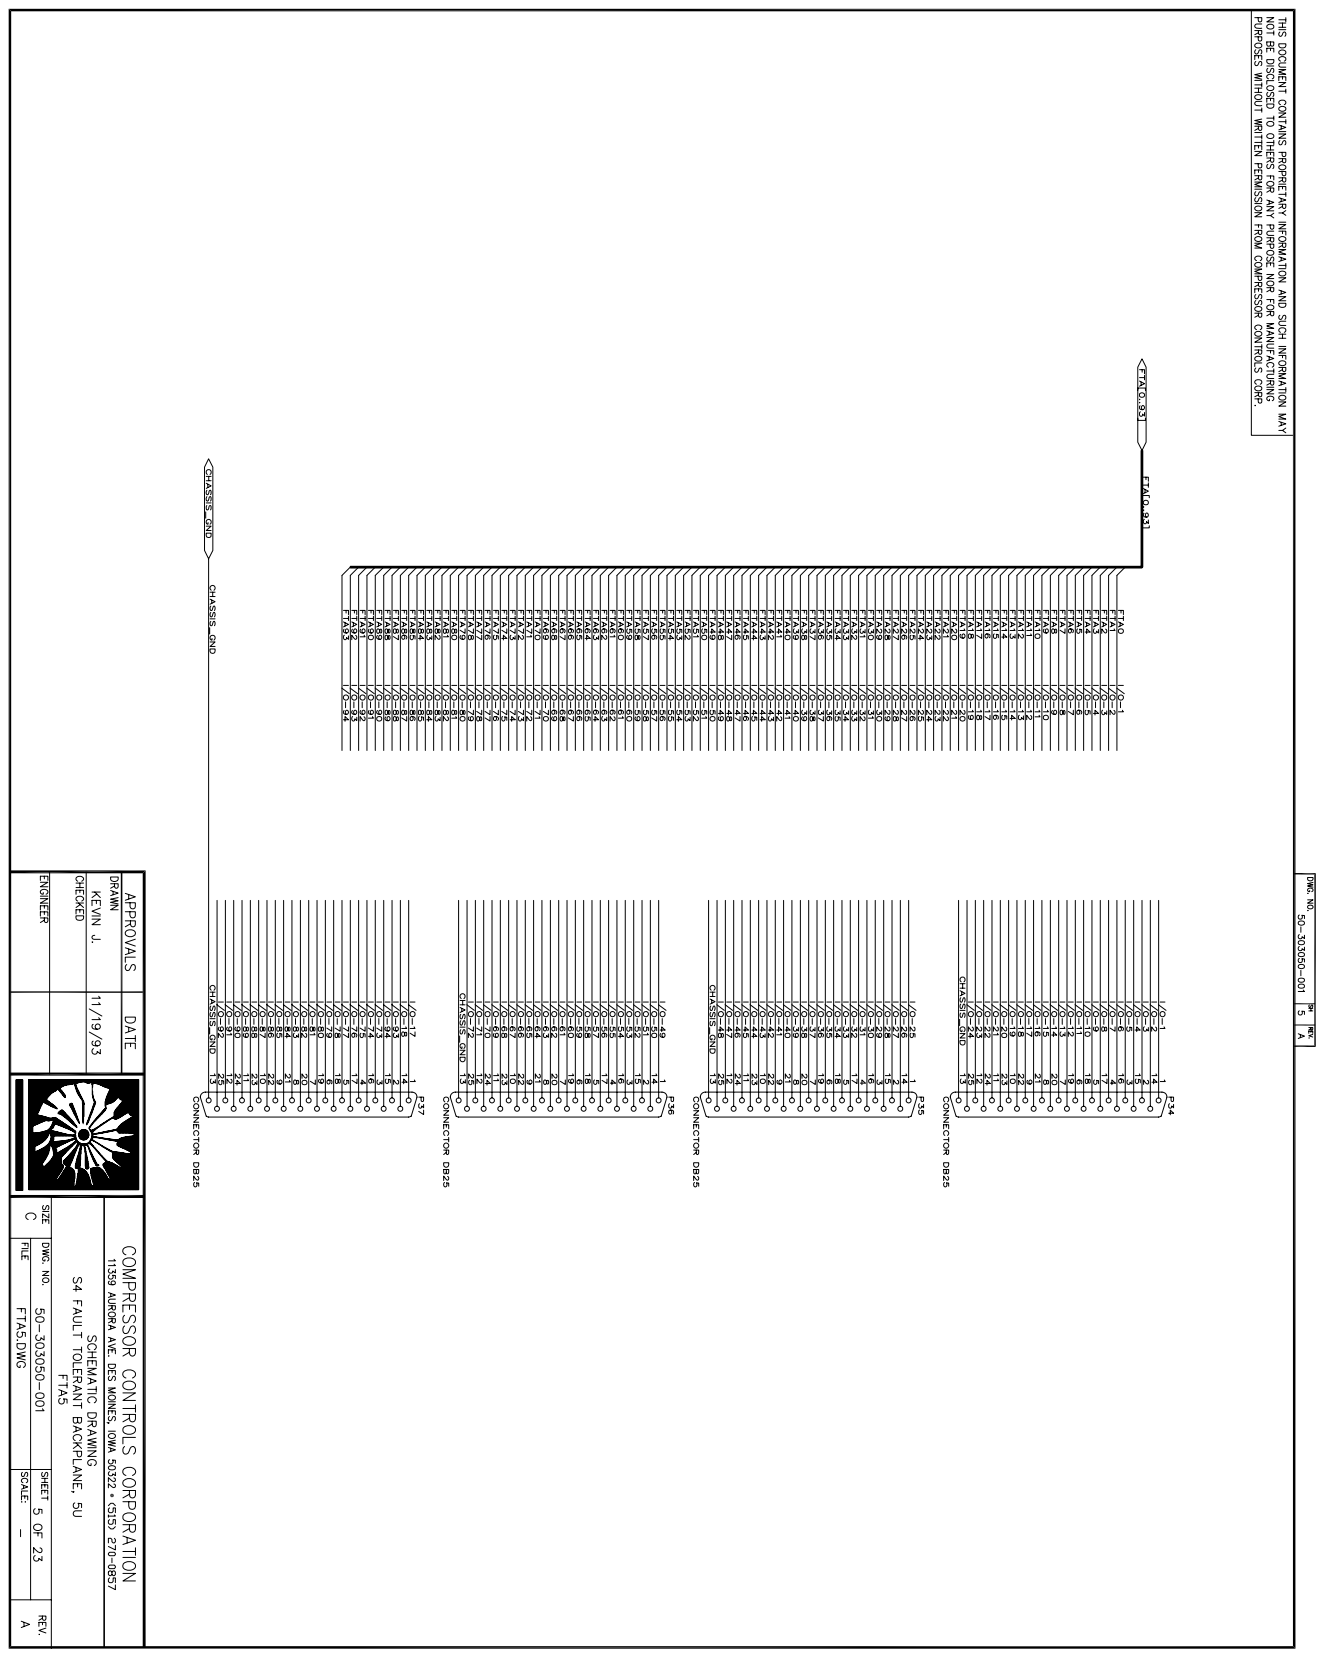
[picture p304: page 5]

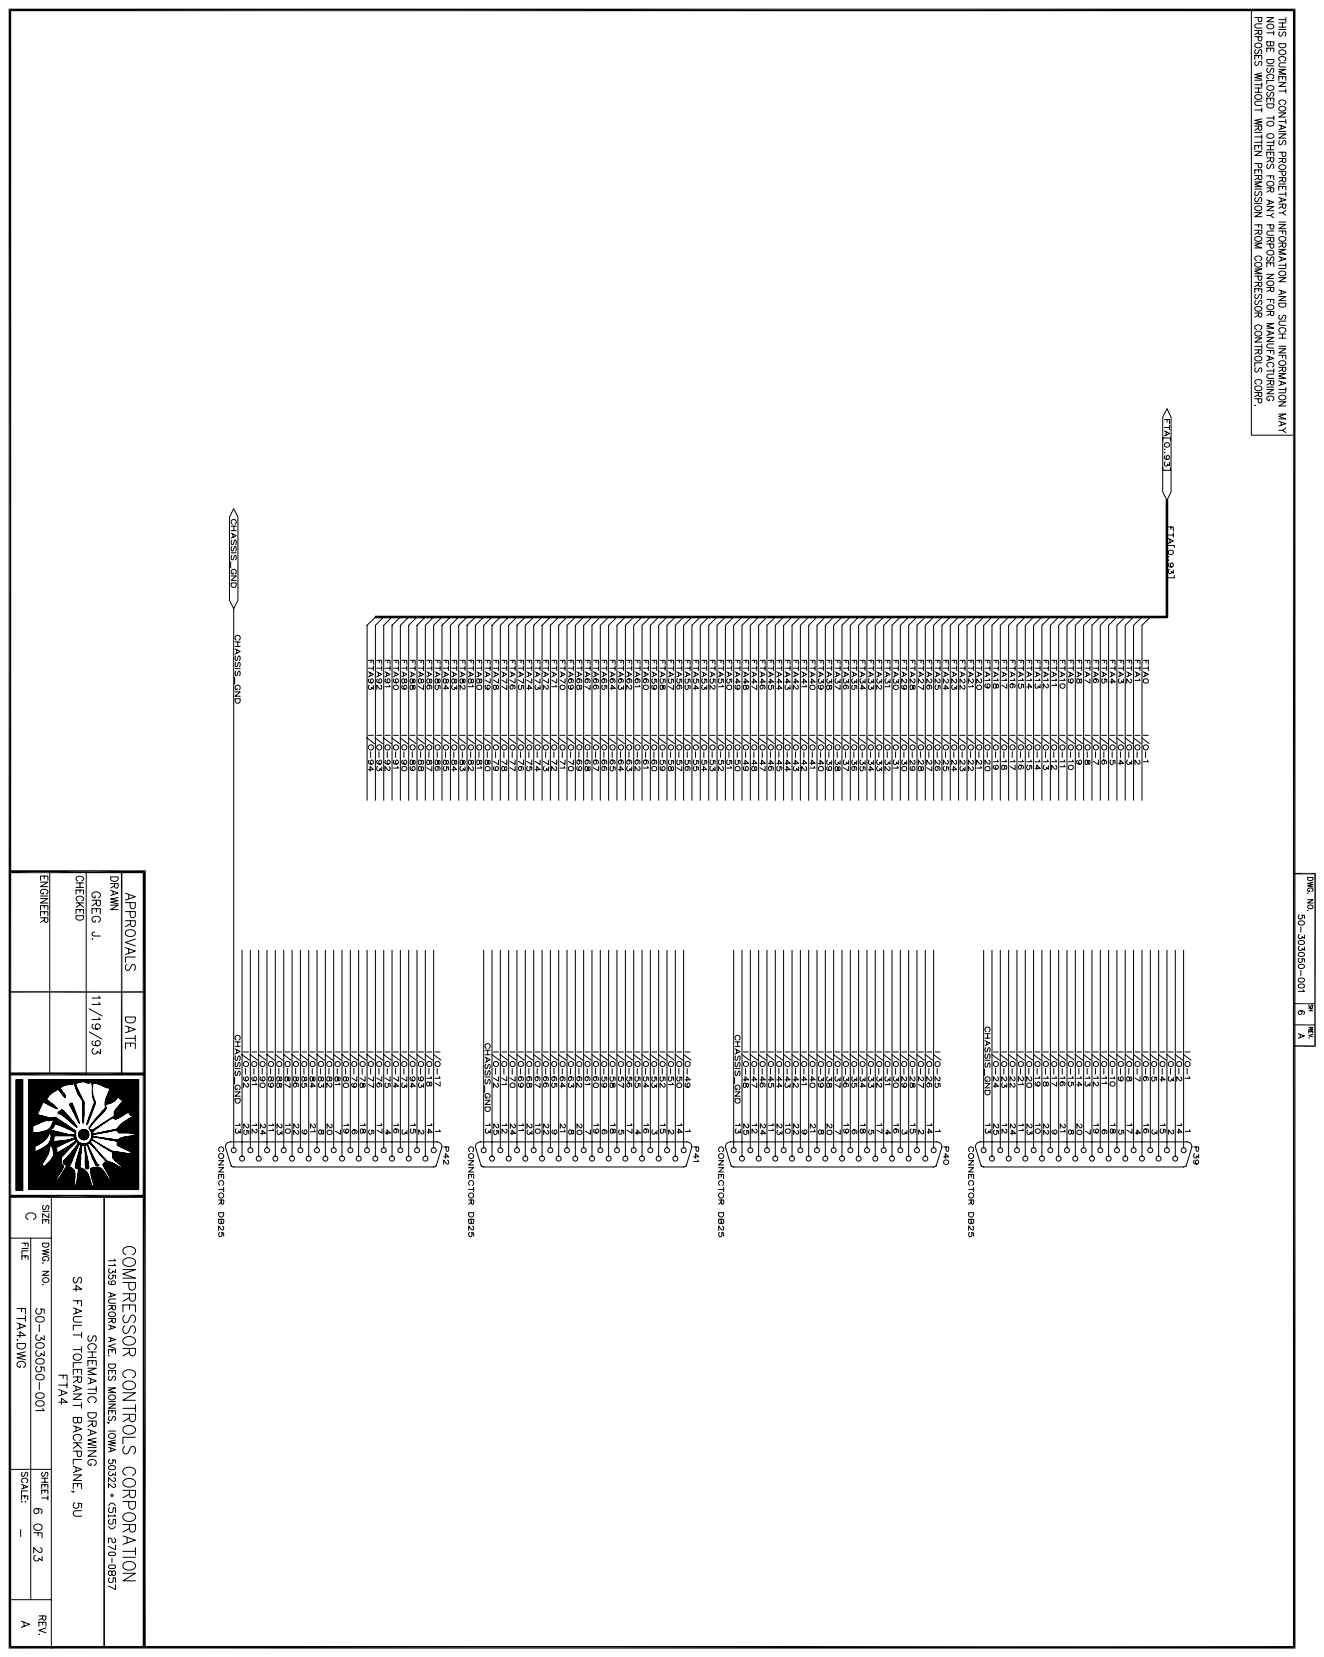
[picture p305: page 6]

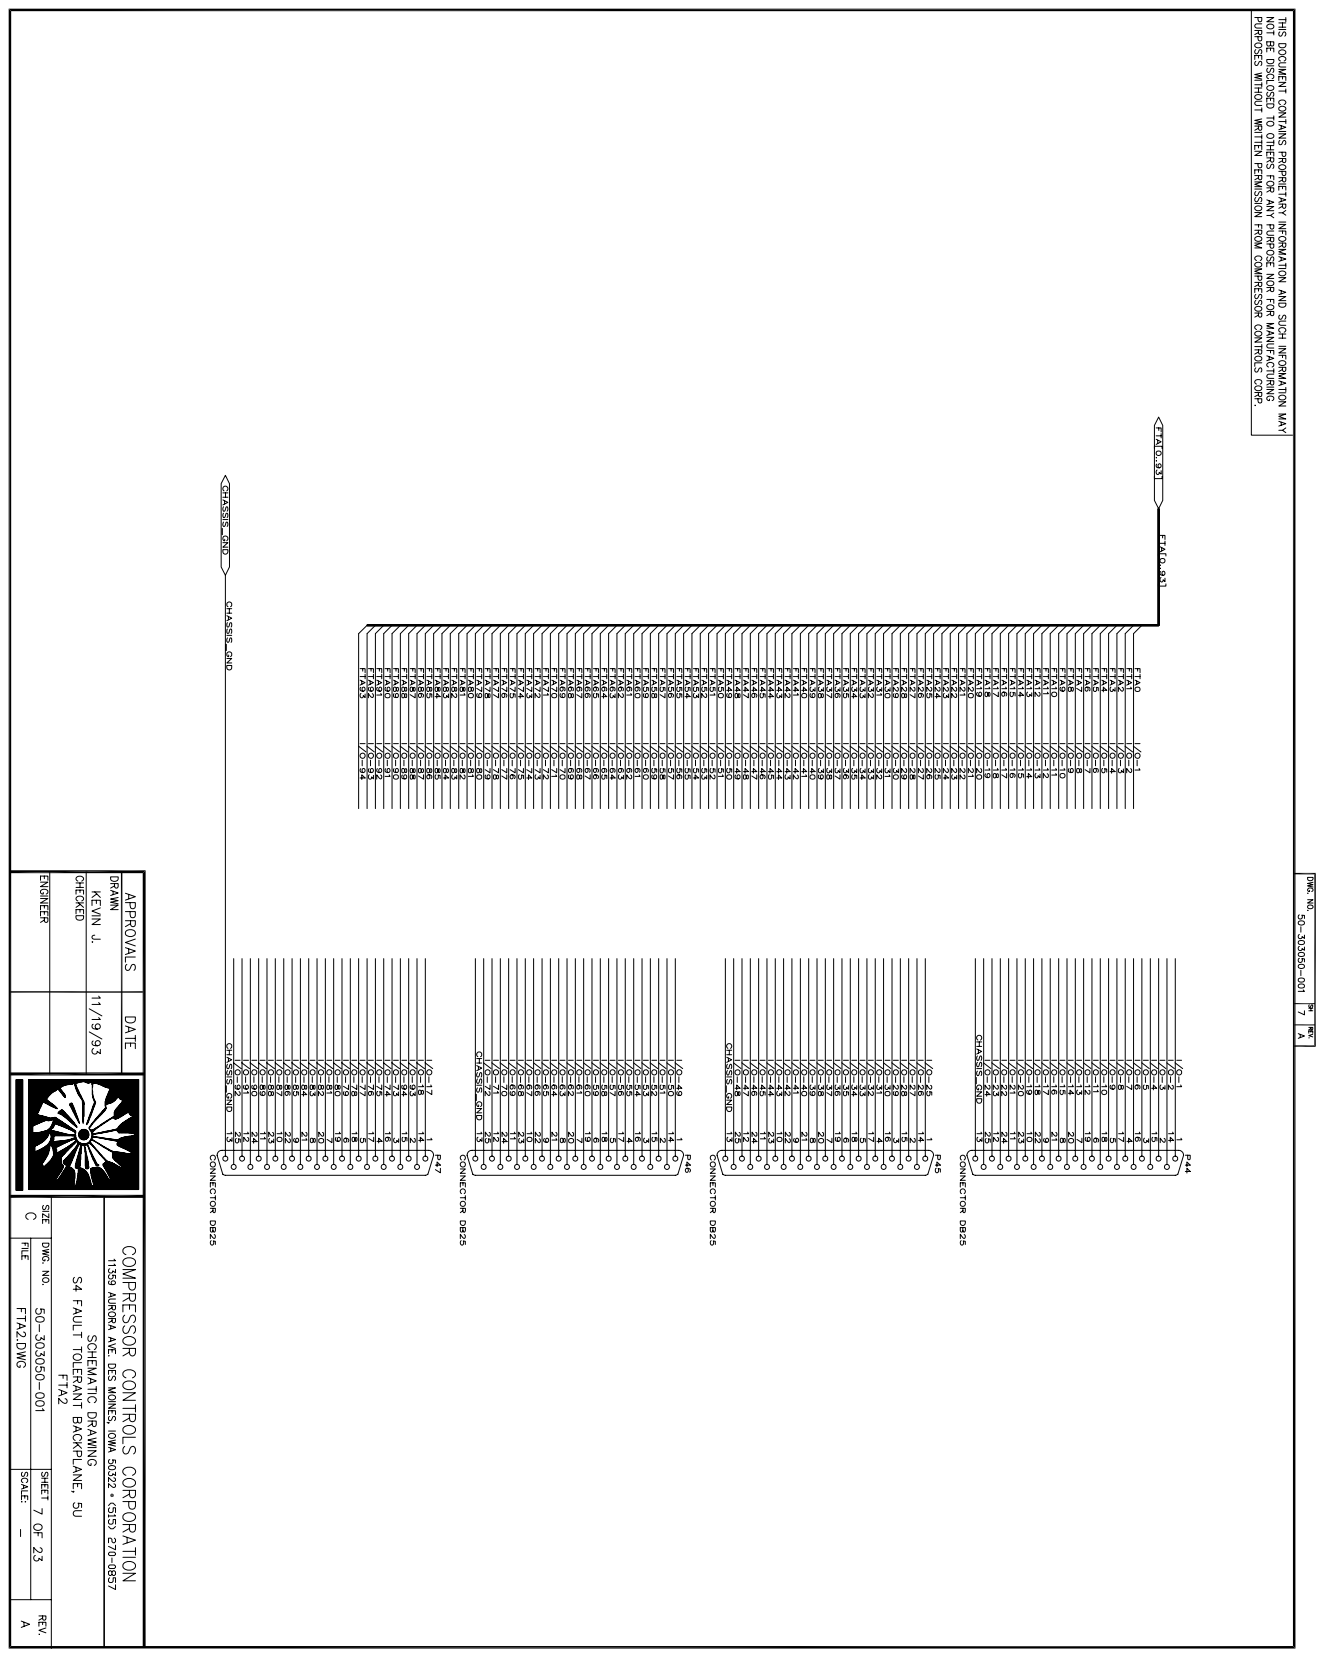
[picture p306: page 7]

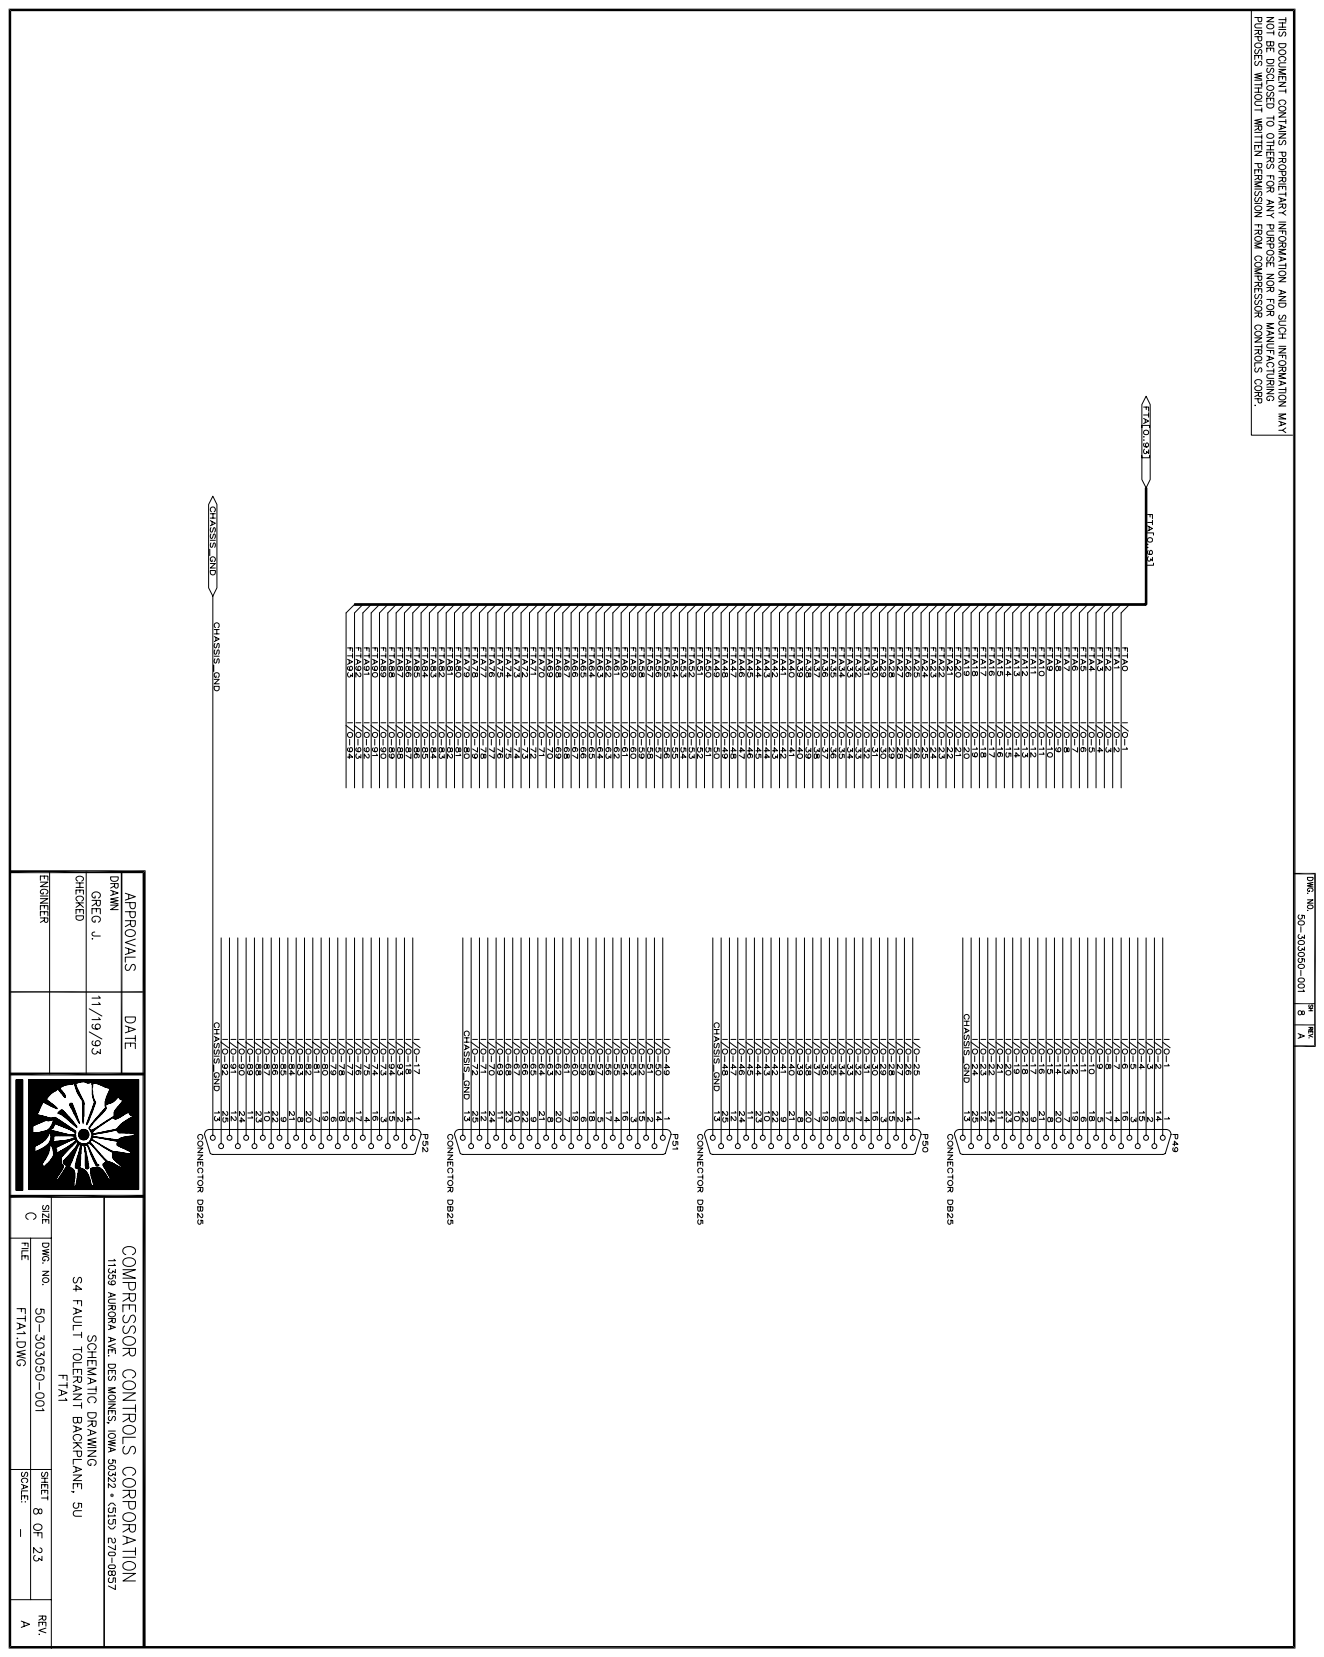
[picture p307: page 8]

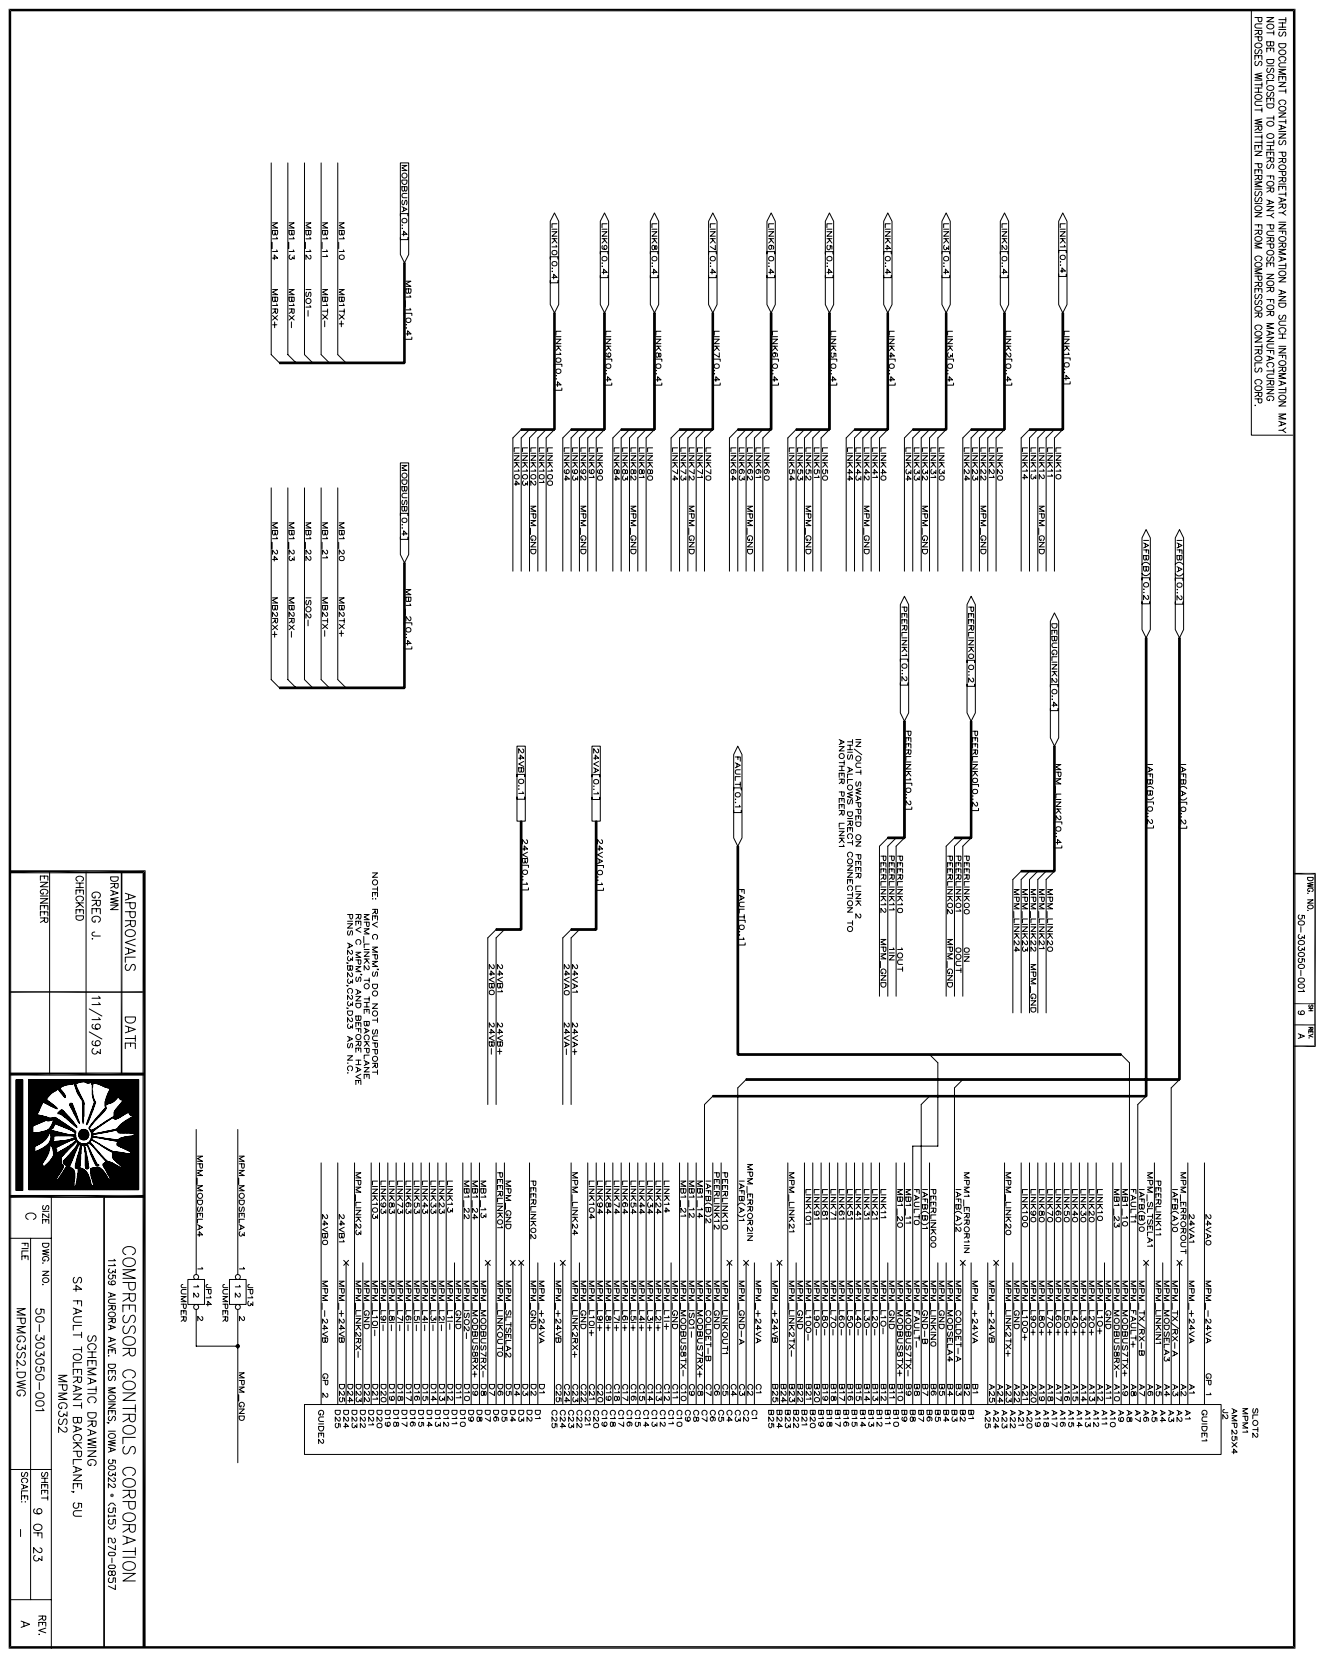
[picture p308: page 9]

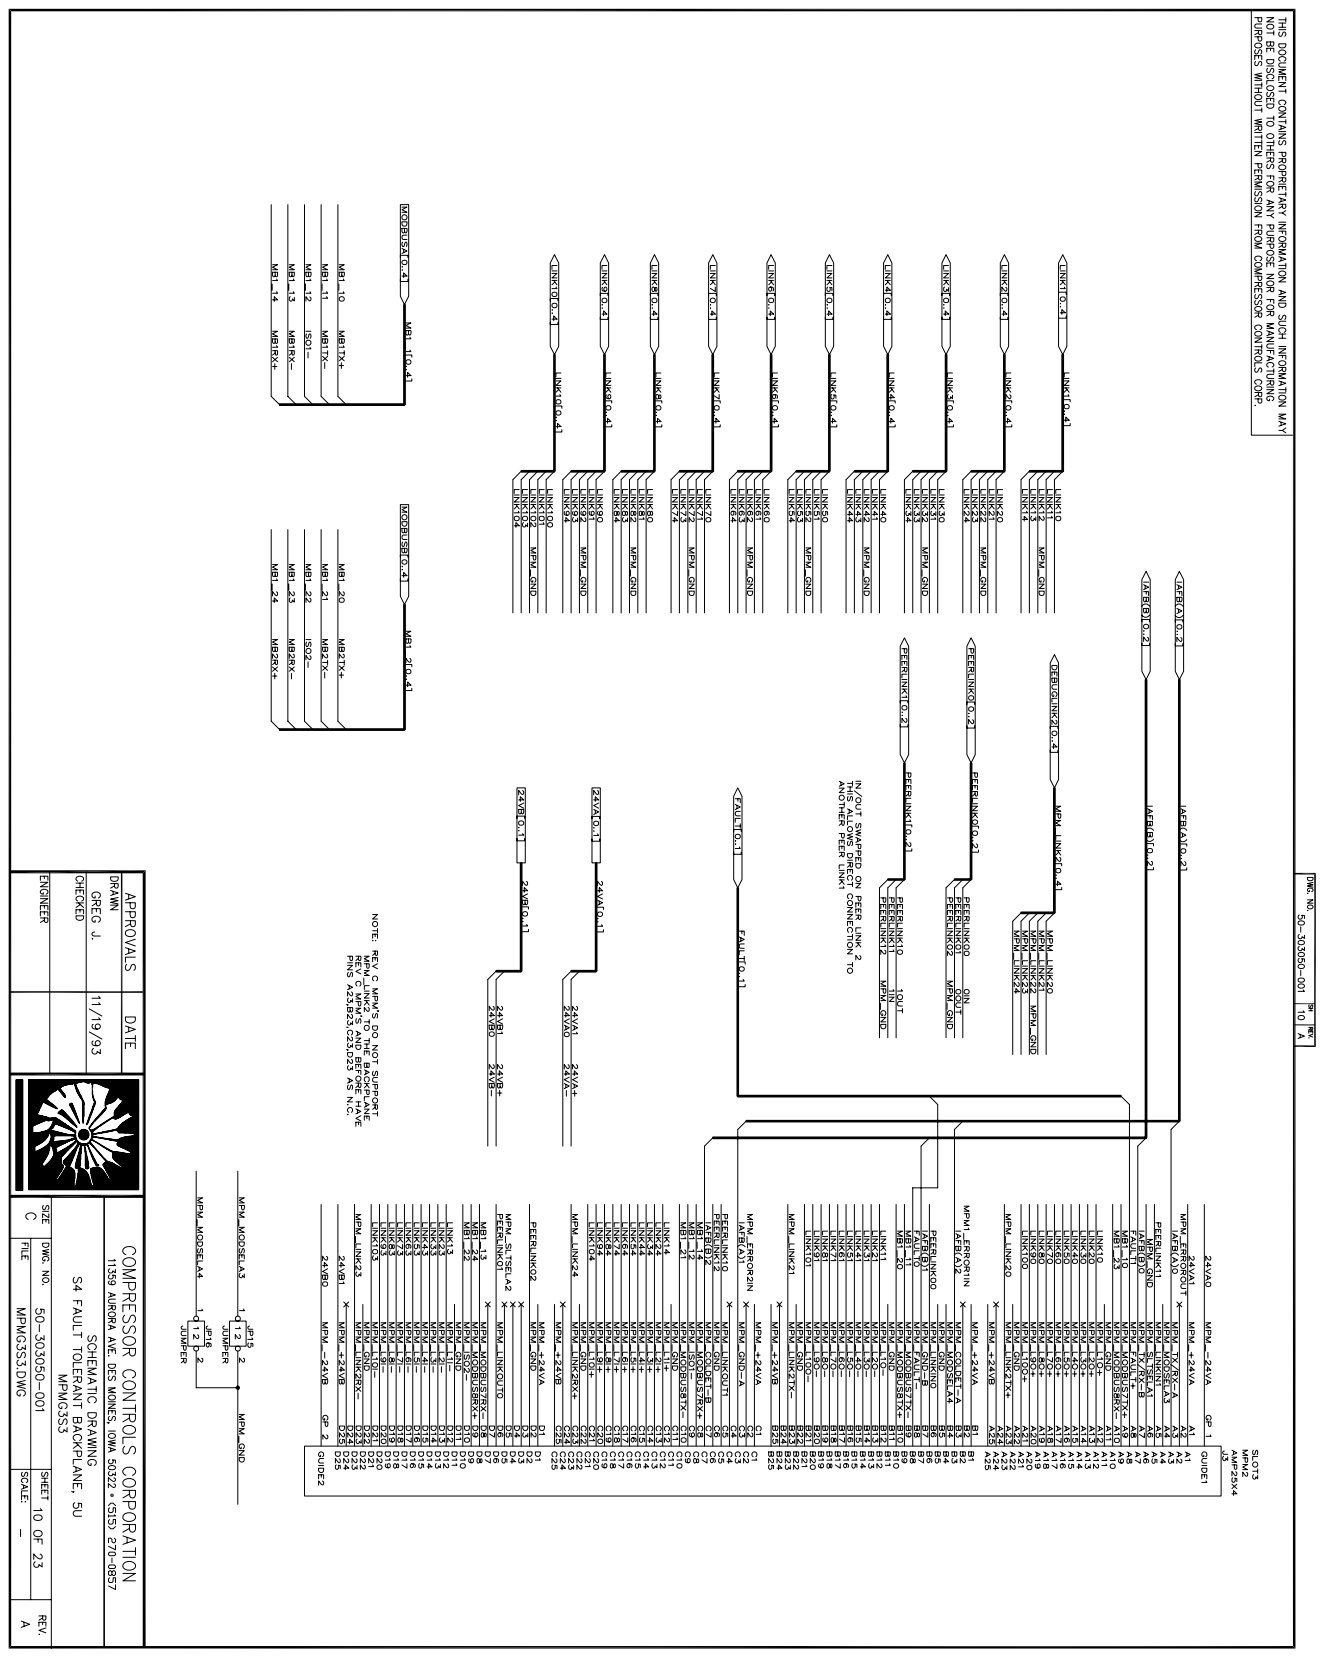
[picture p309: page 10]

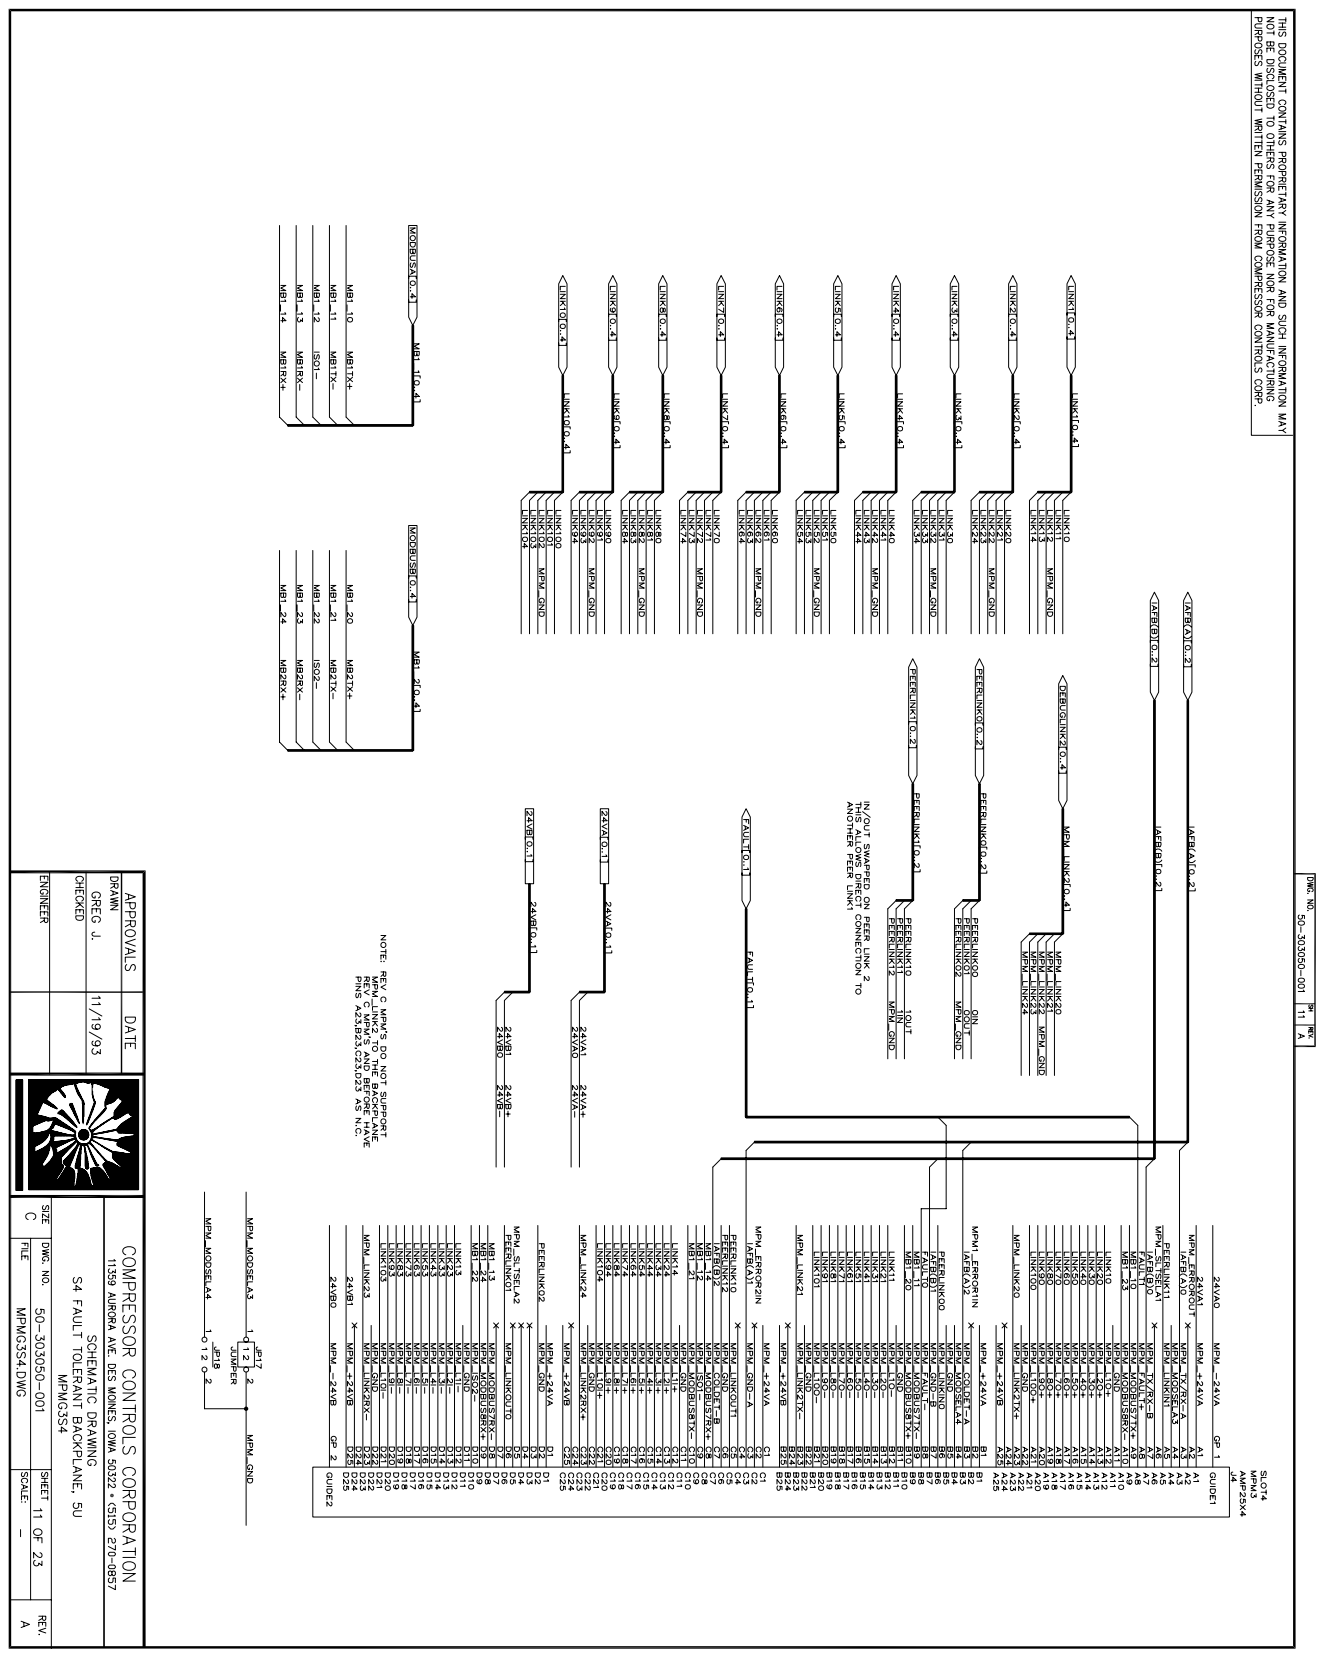
[picture p310: page 11]

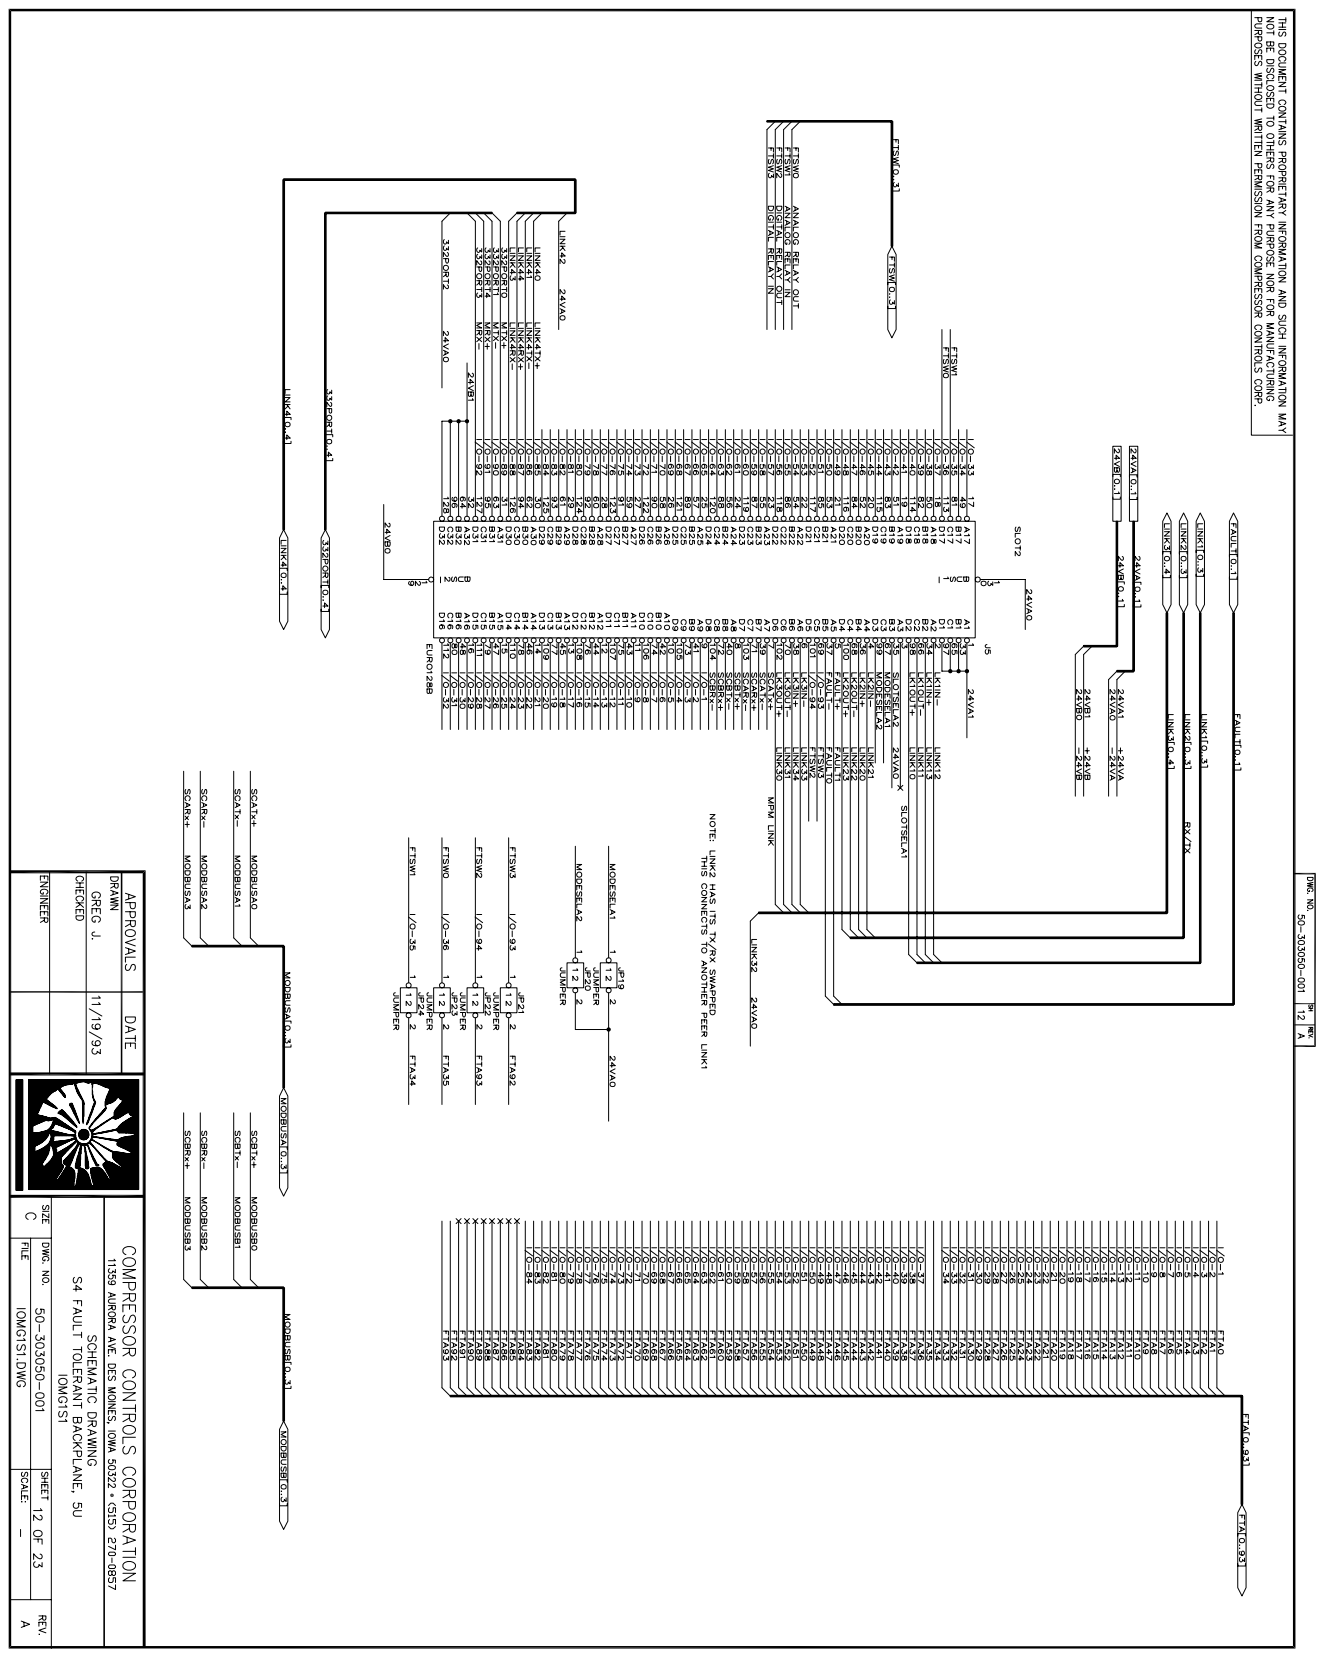
[picture p311: page 12]

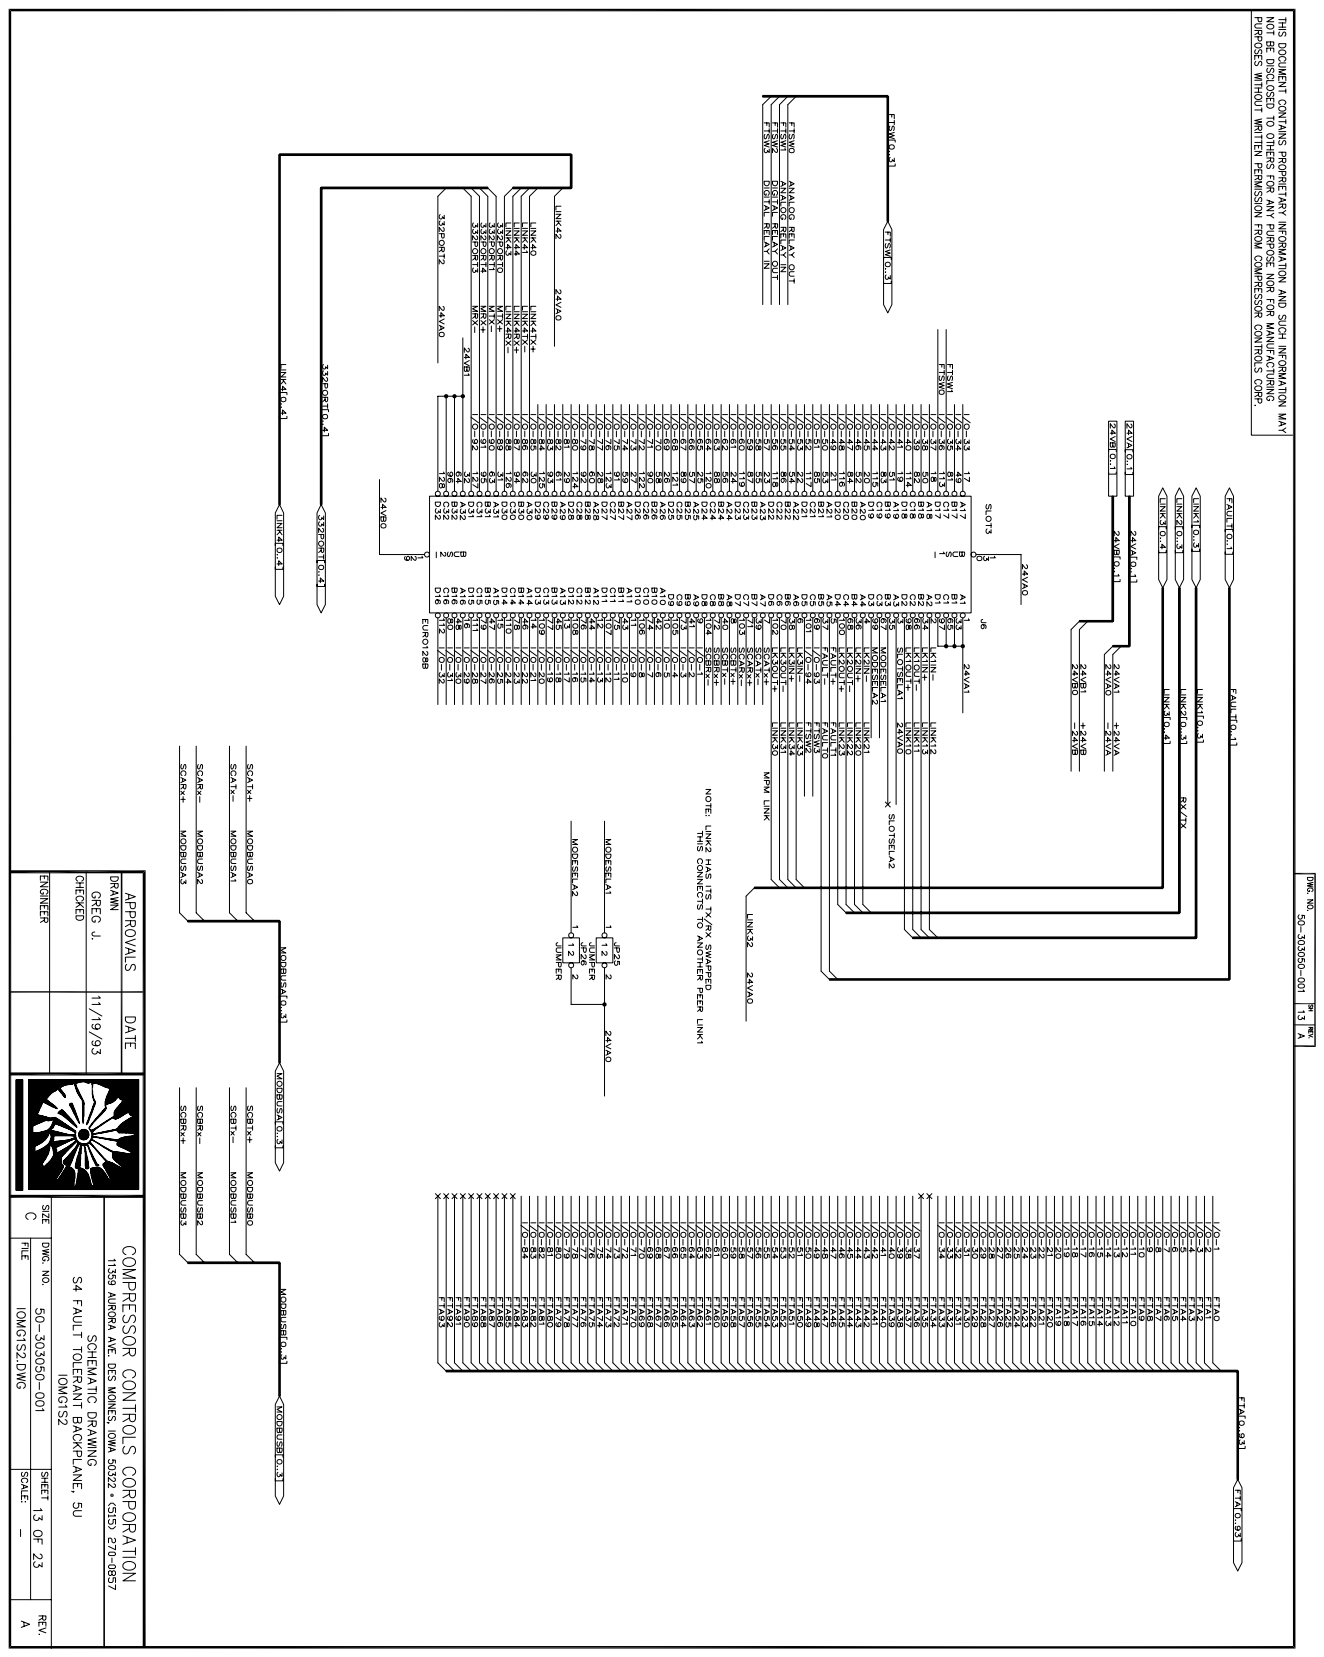
[picture p312: page 13]

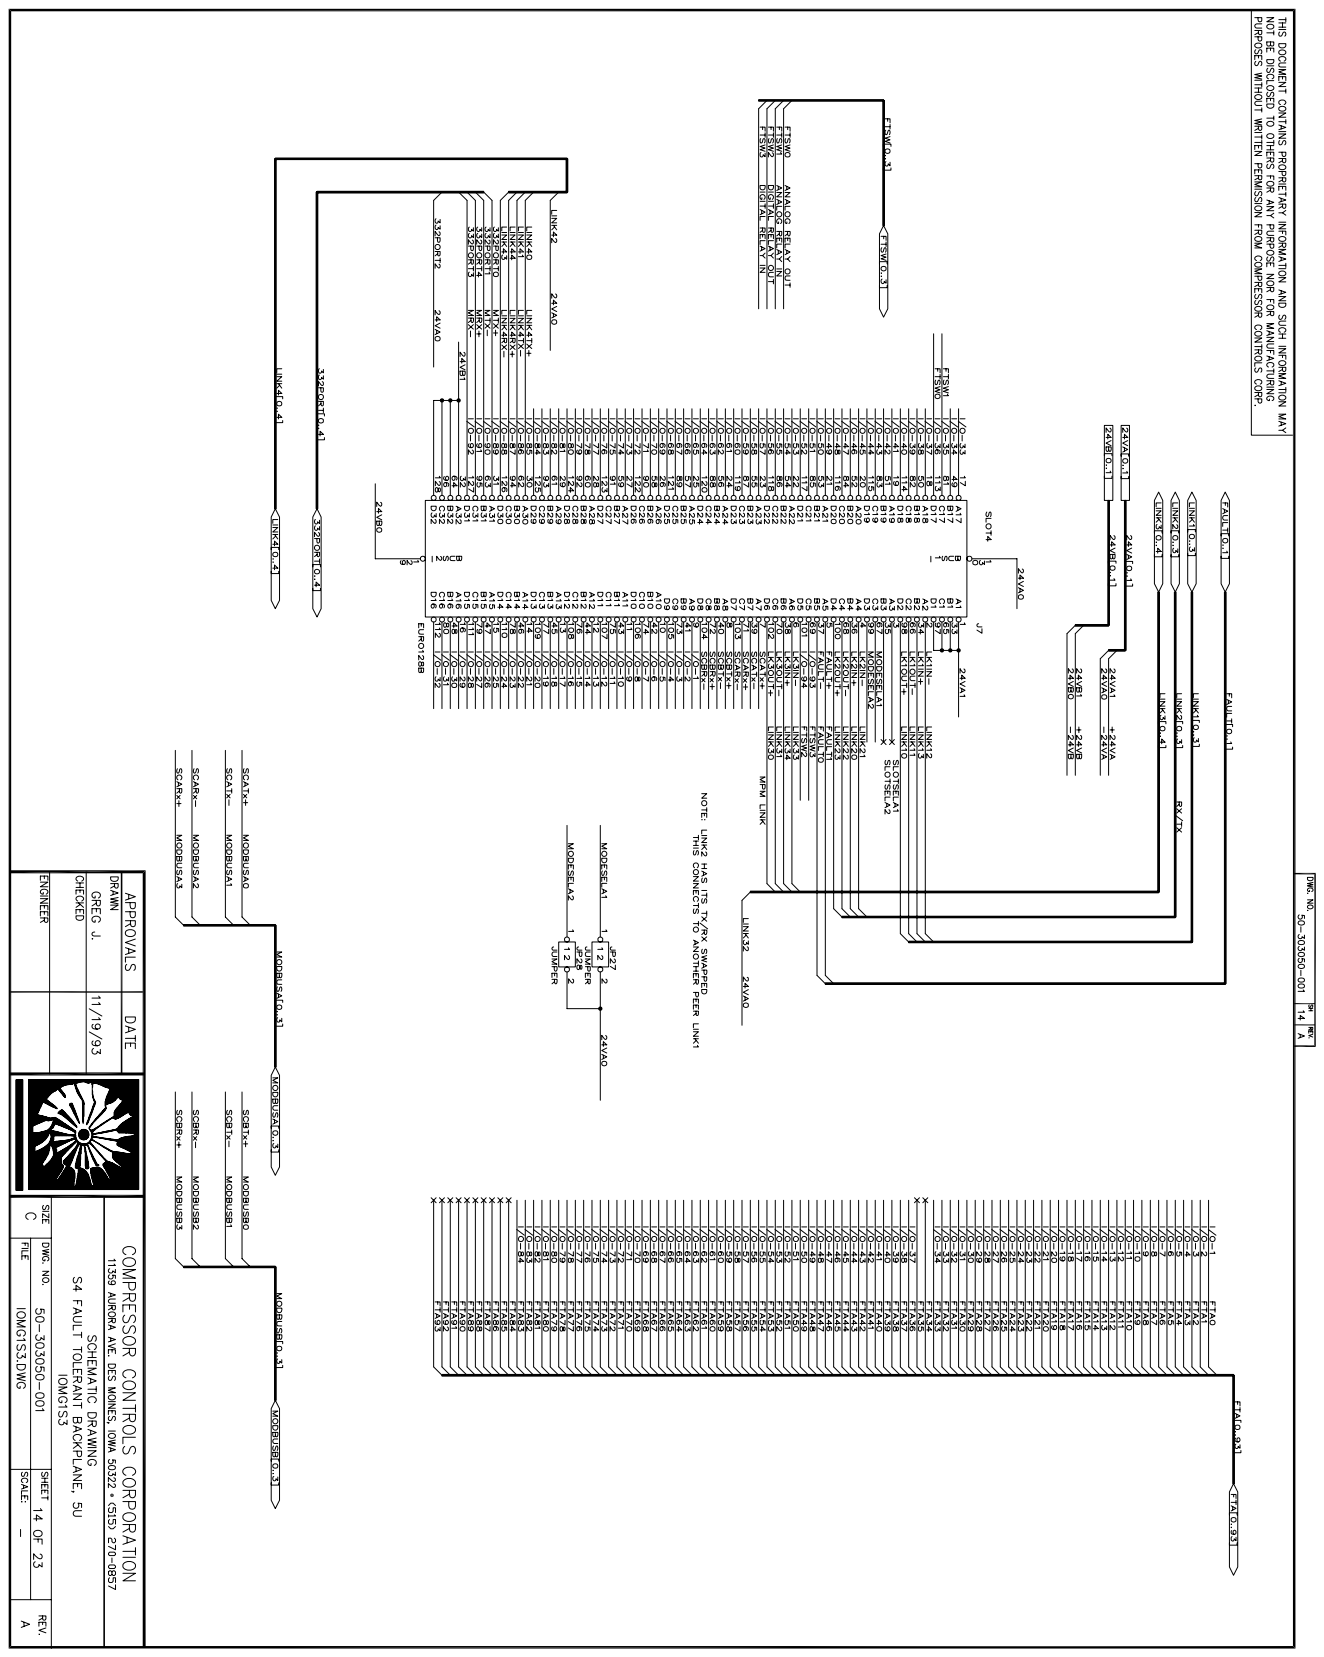
[picture p313: page 14]

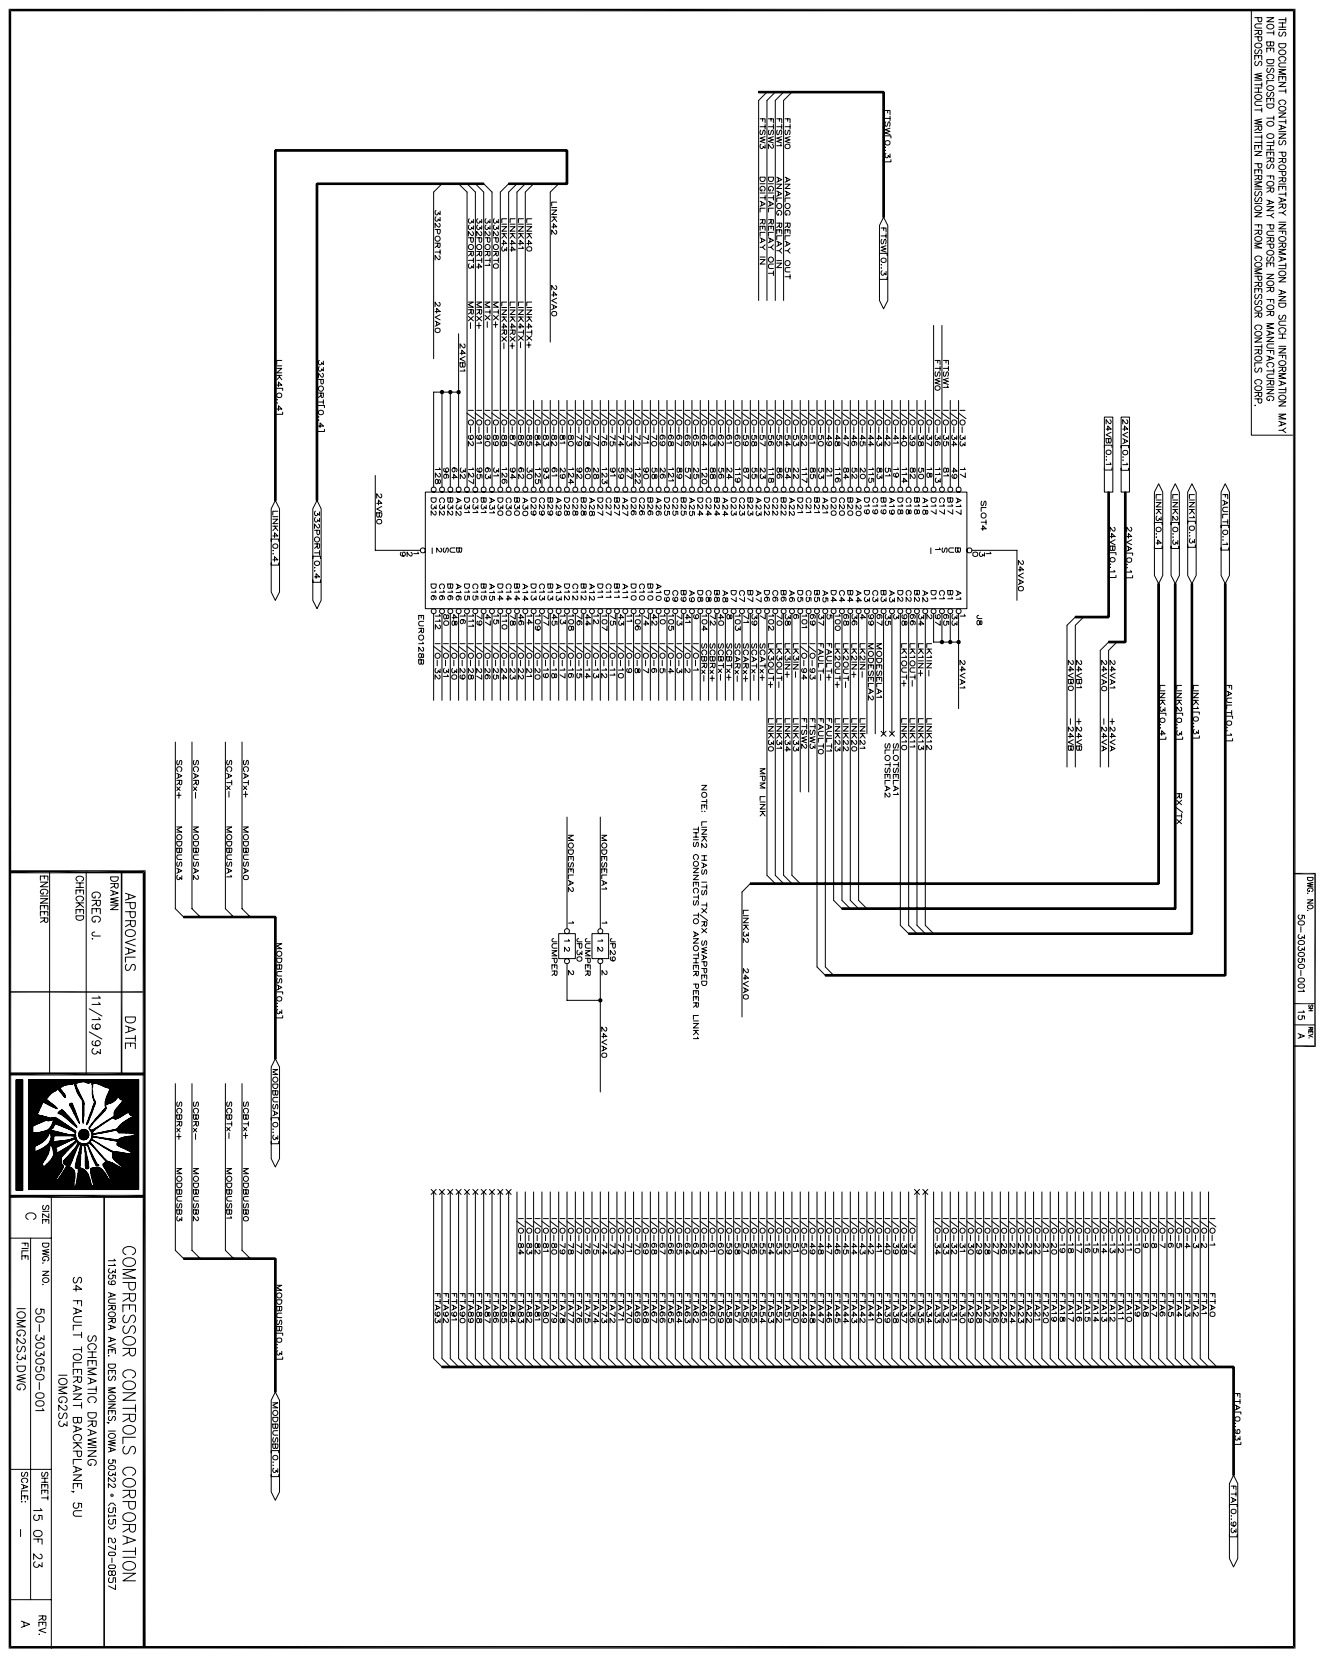
[picture p314: page 15]

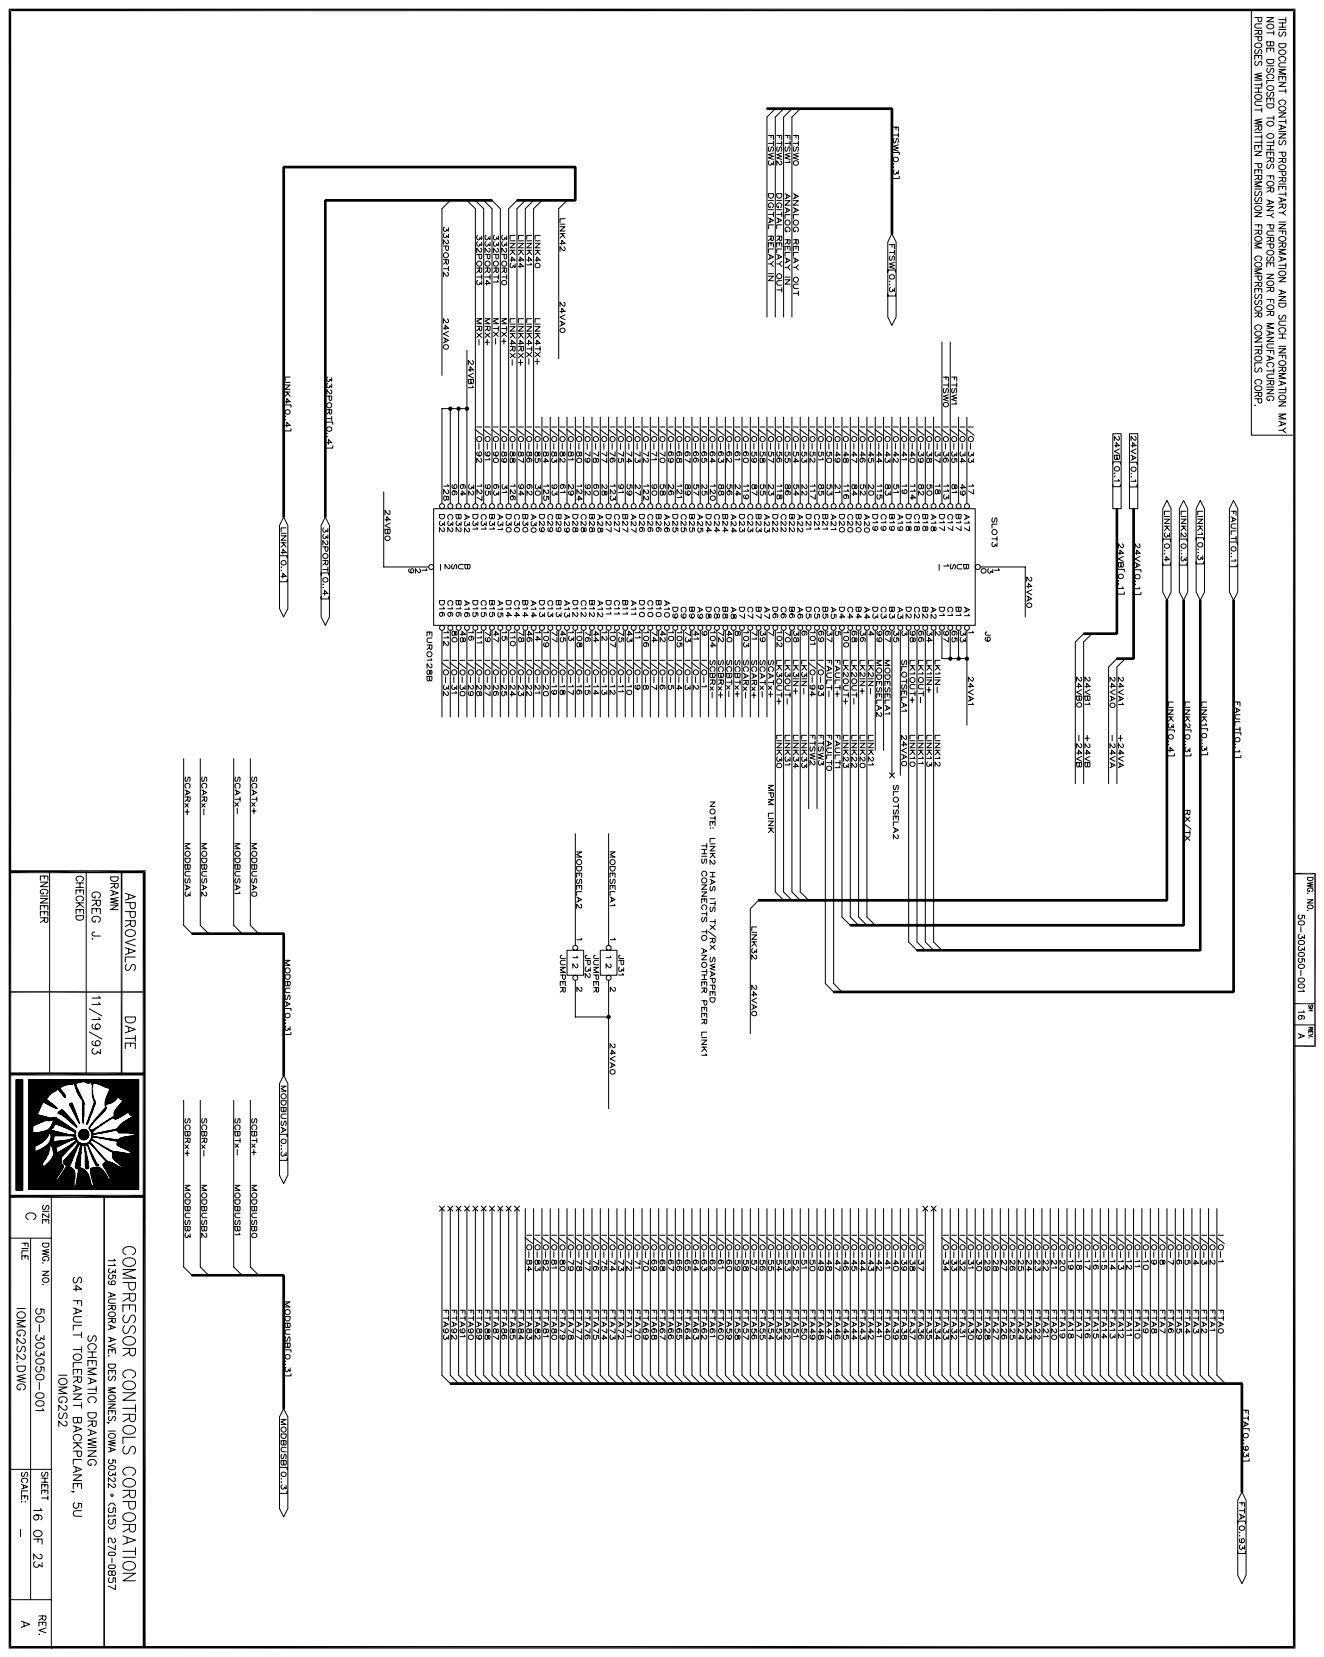
[picture p315: page 16]

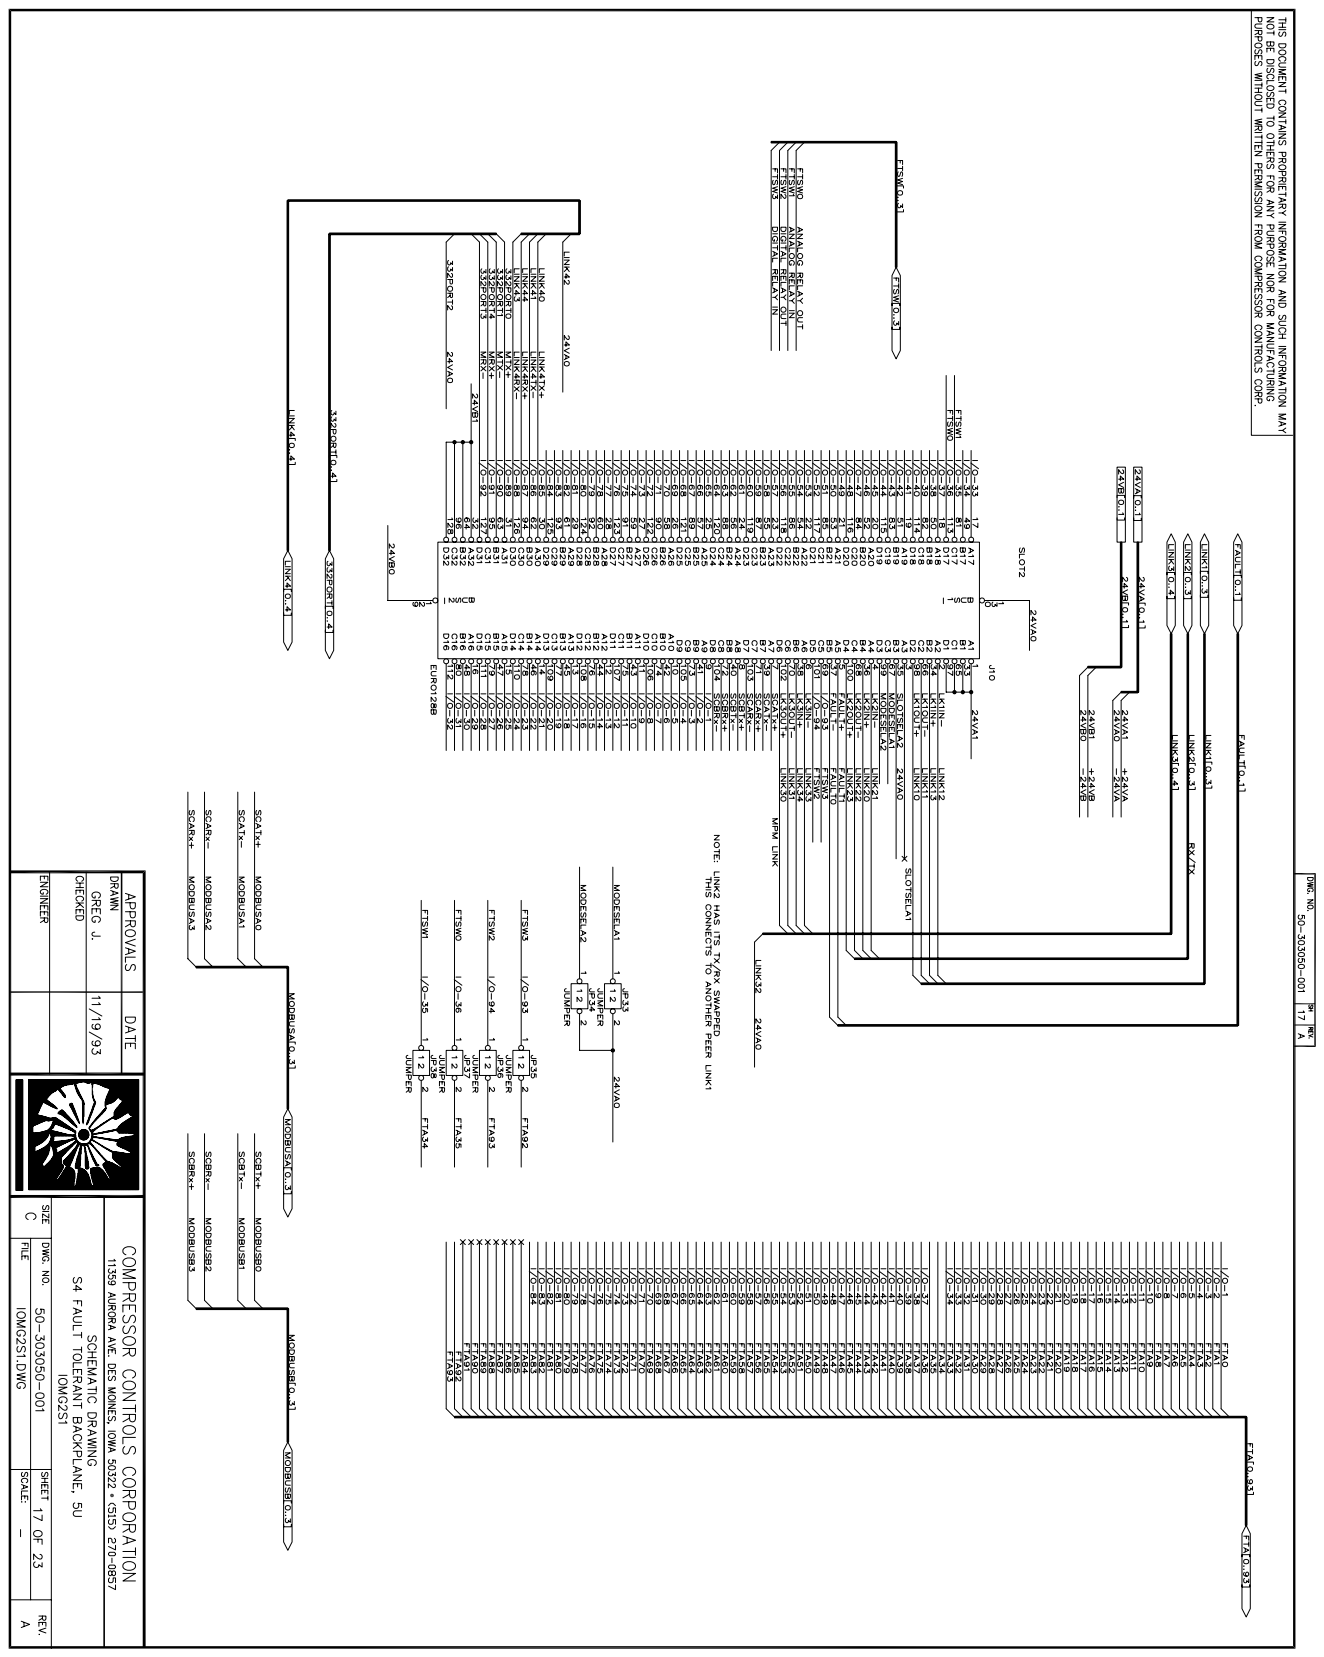
[picture p316: page 17]

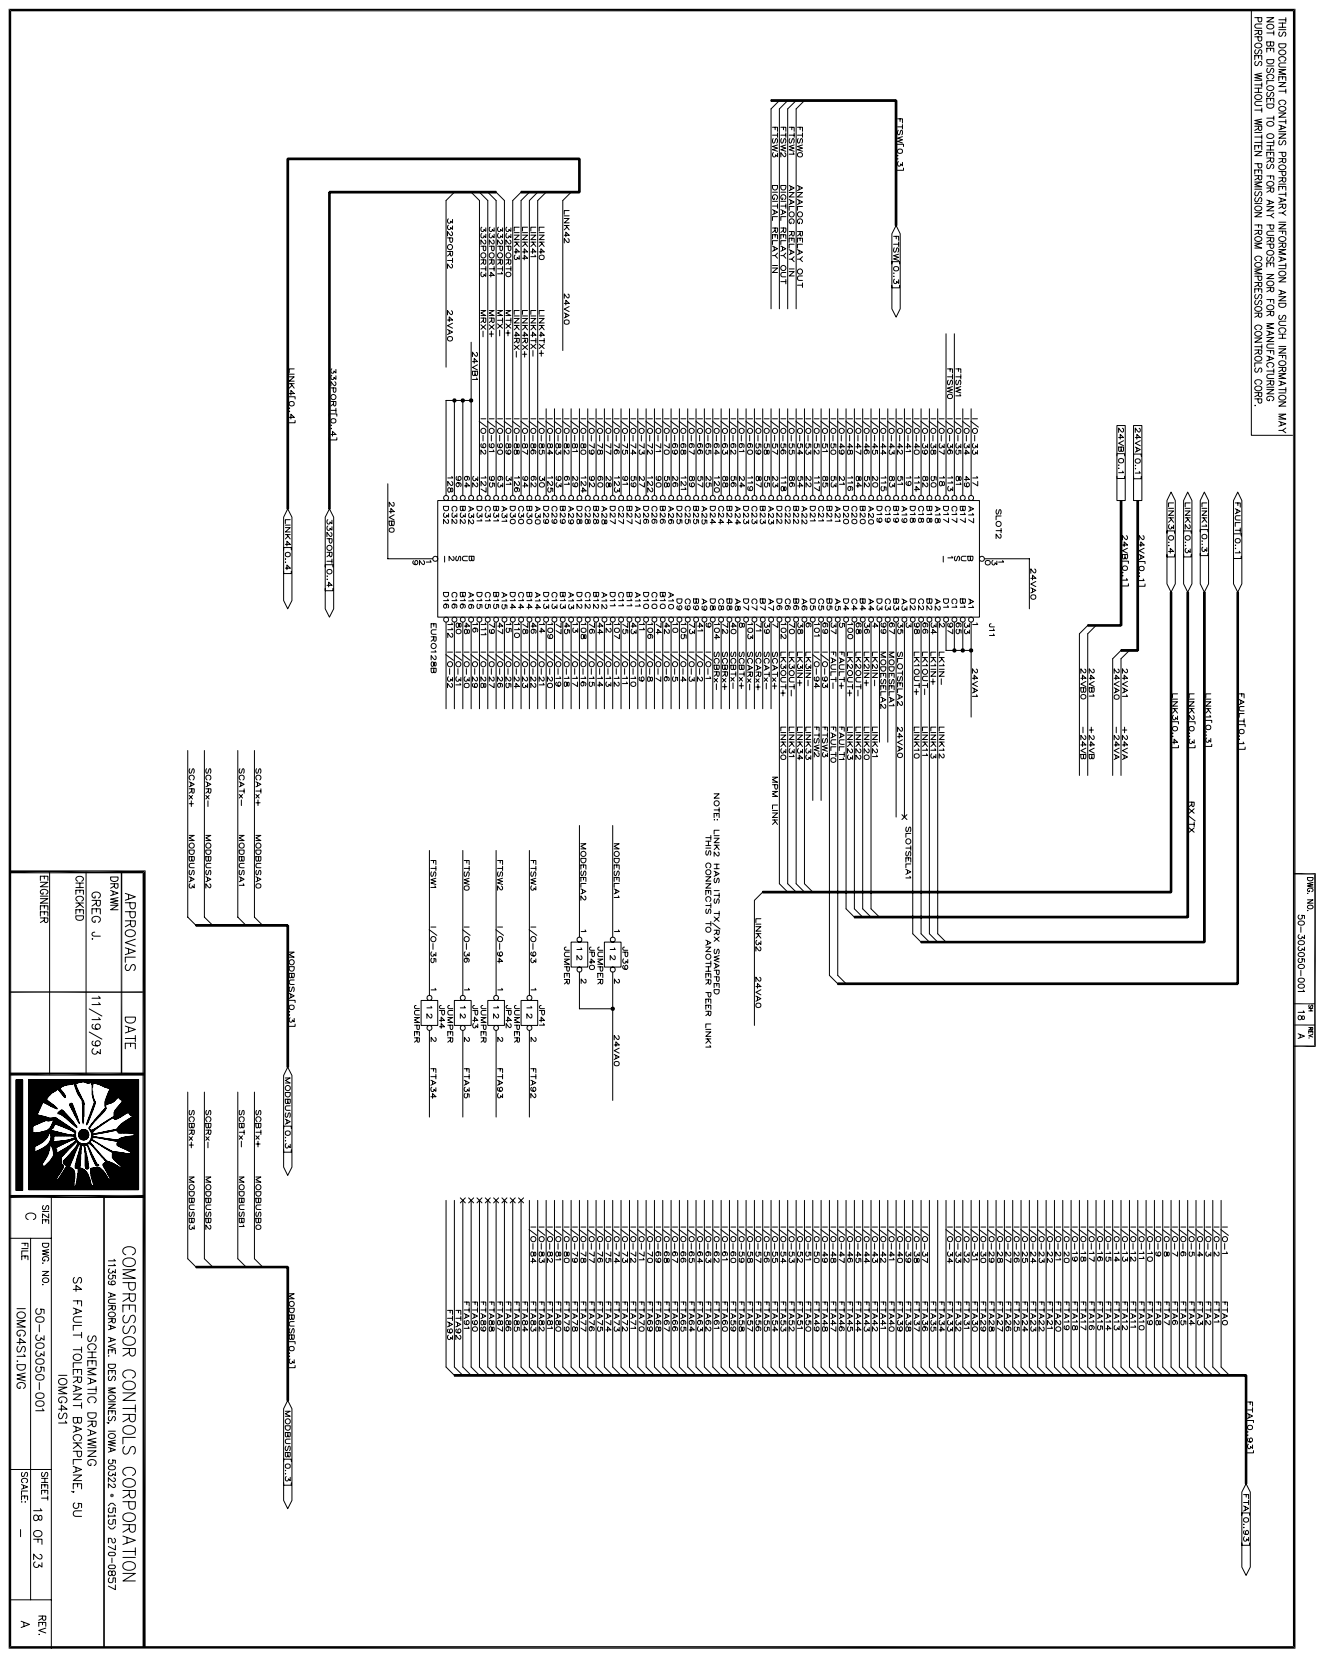
[picture p317: page 18]

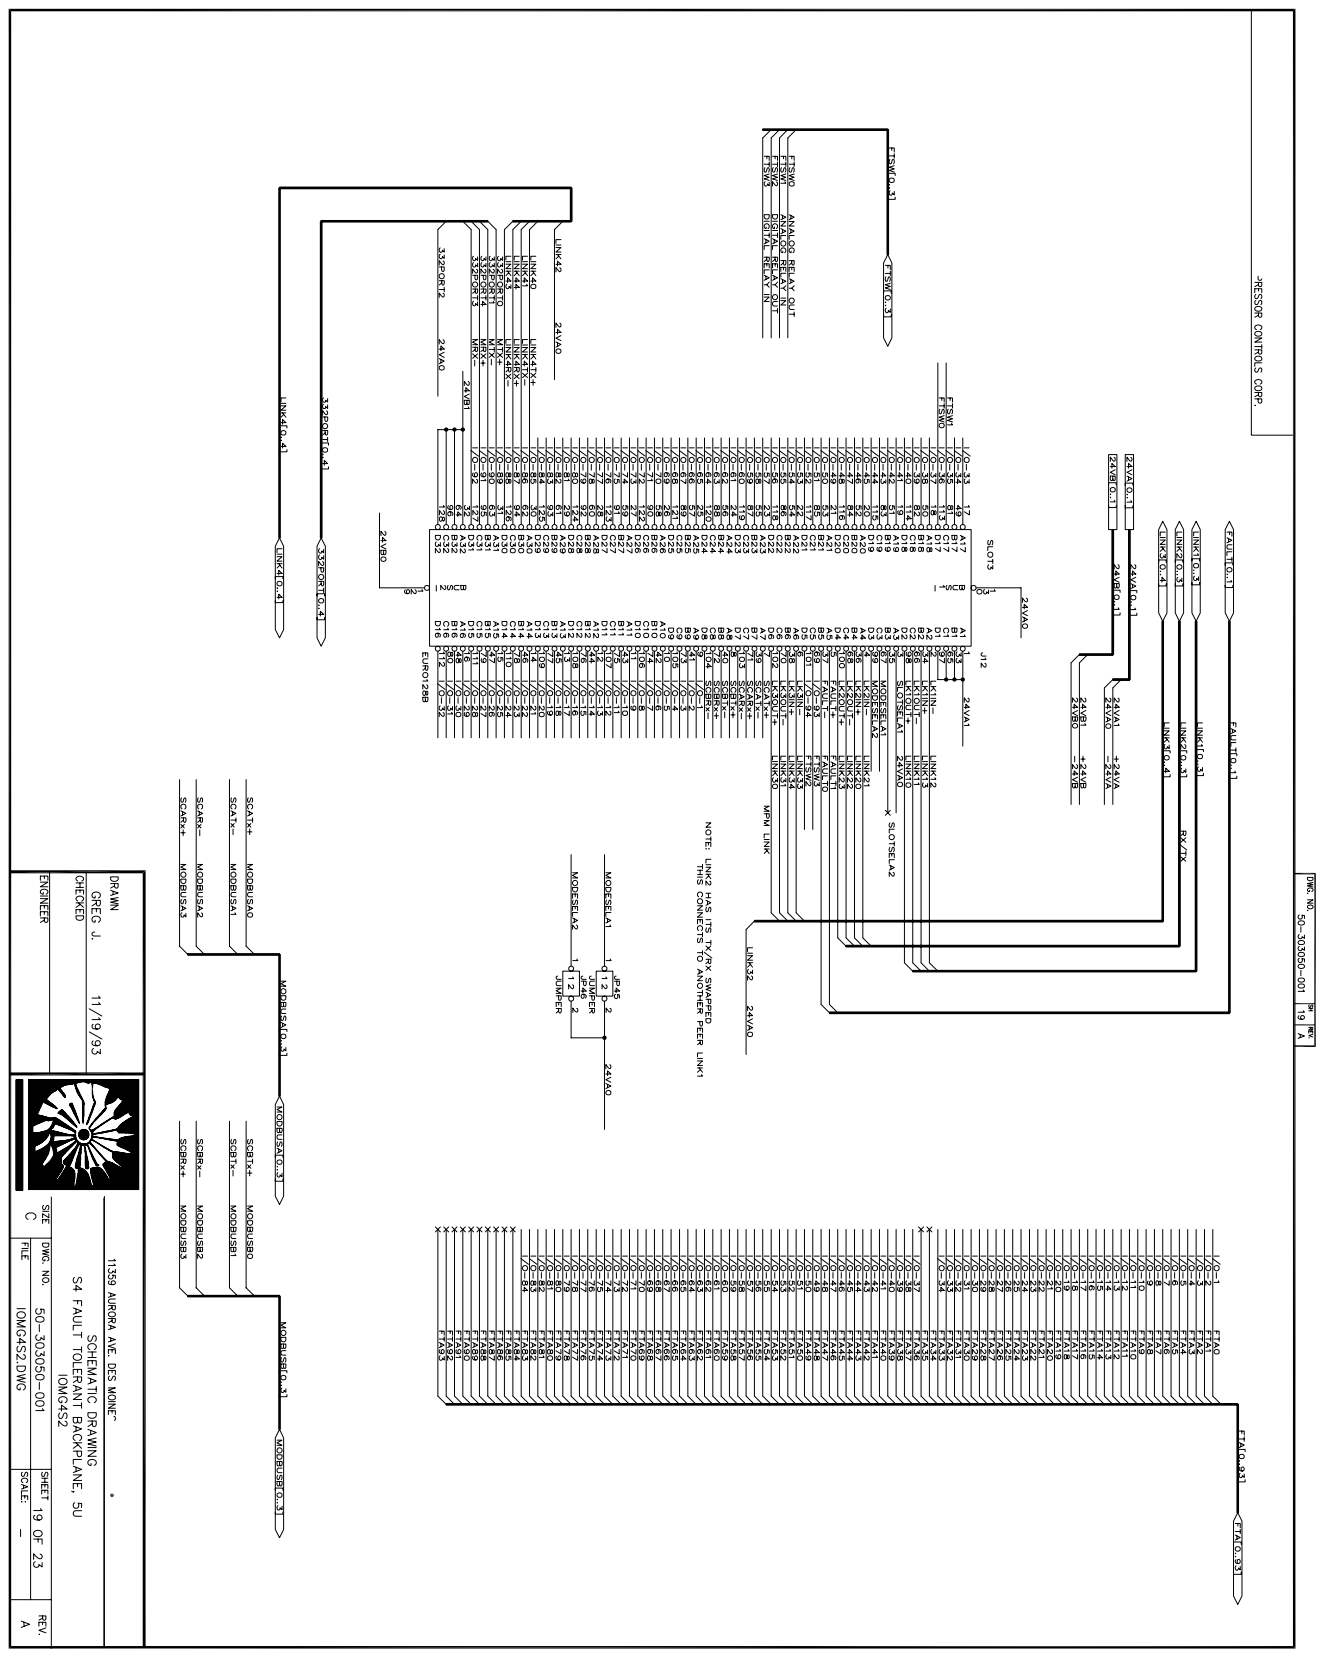
[picture p318: page 19]

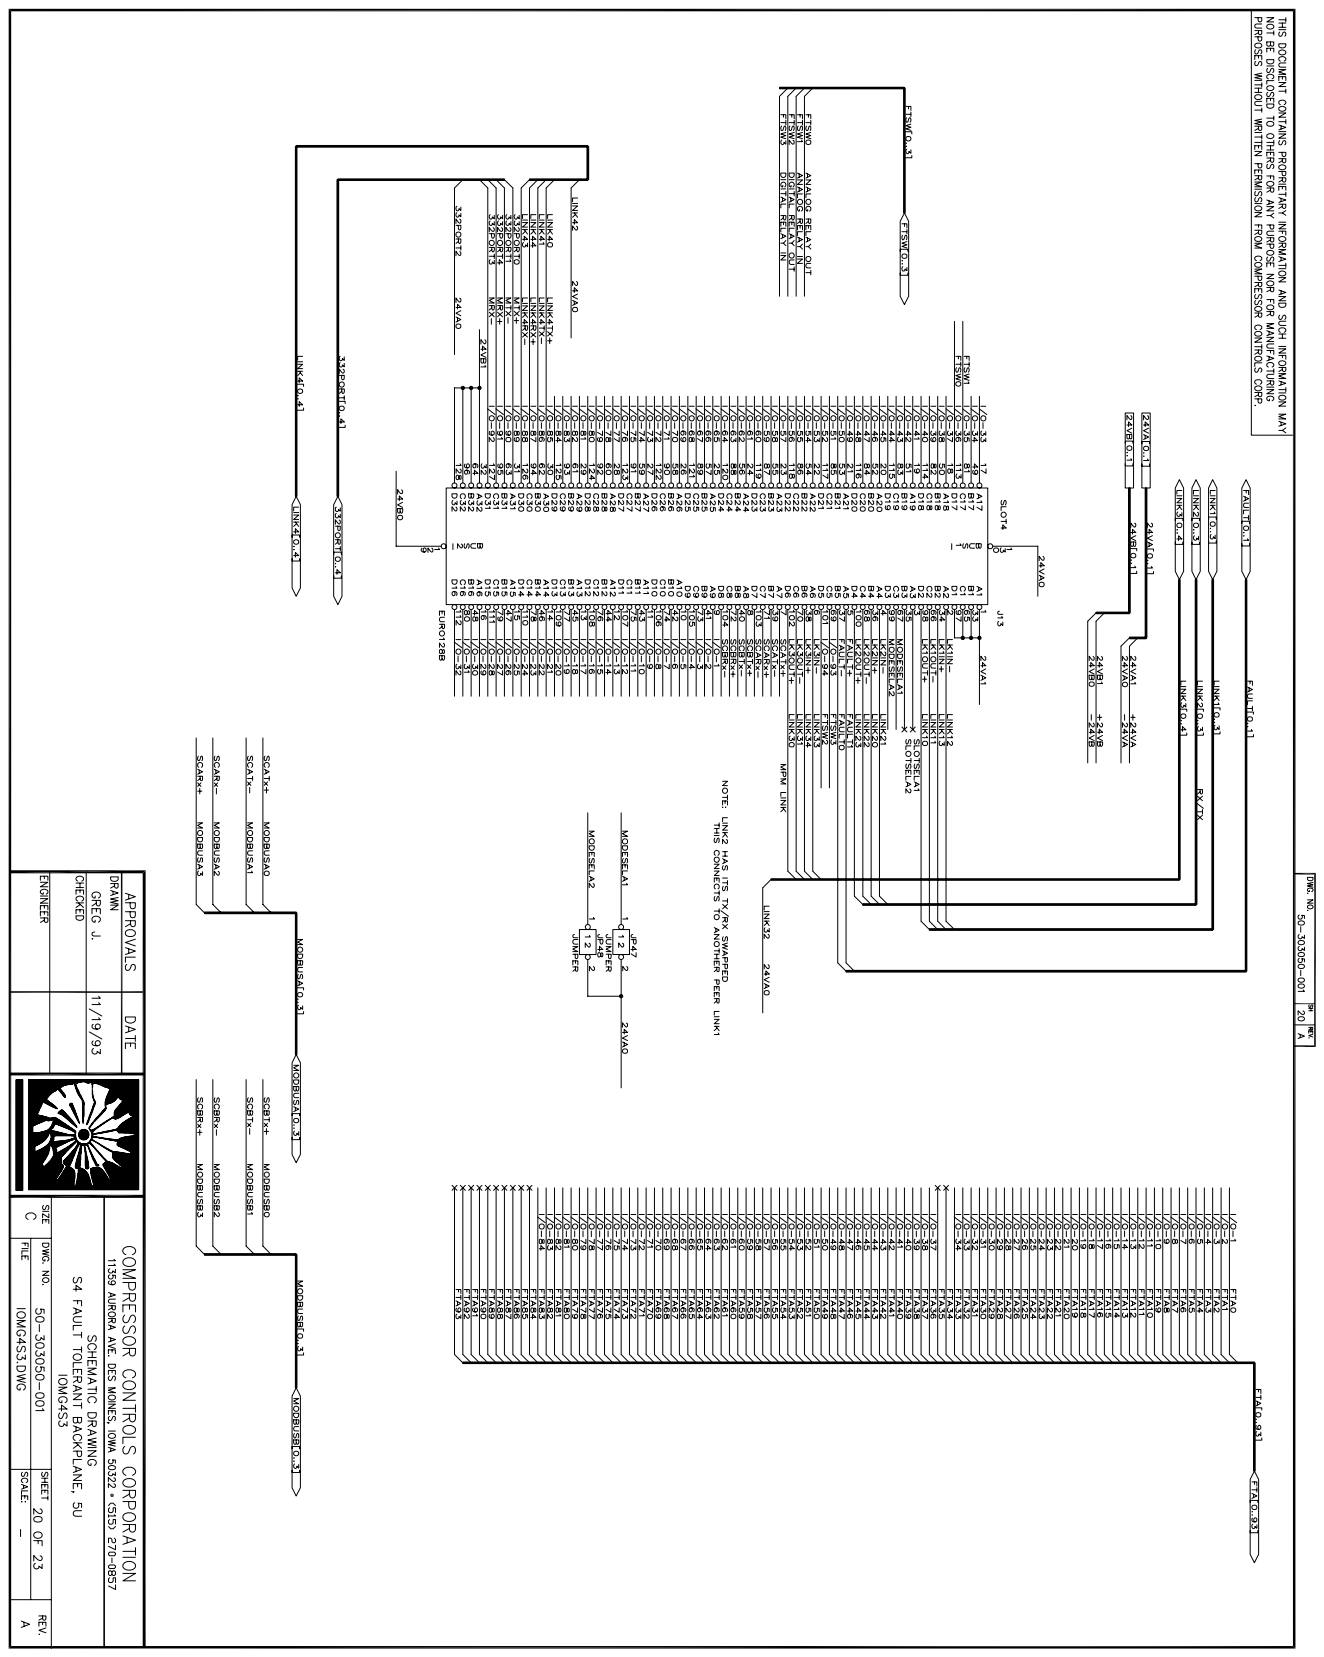
[picture p319: page 20]

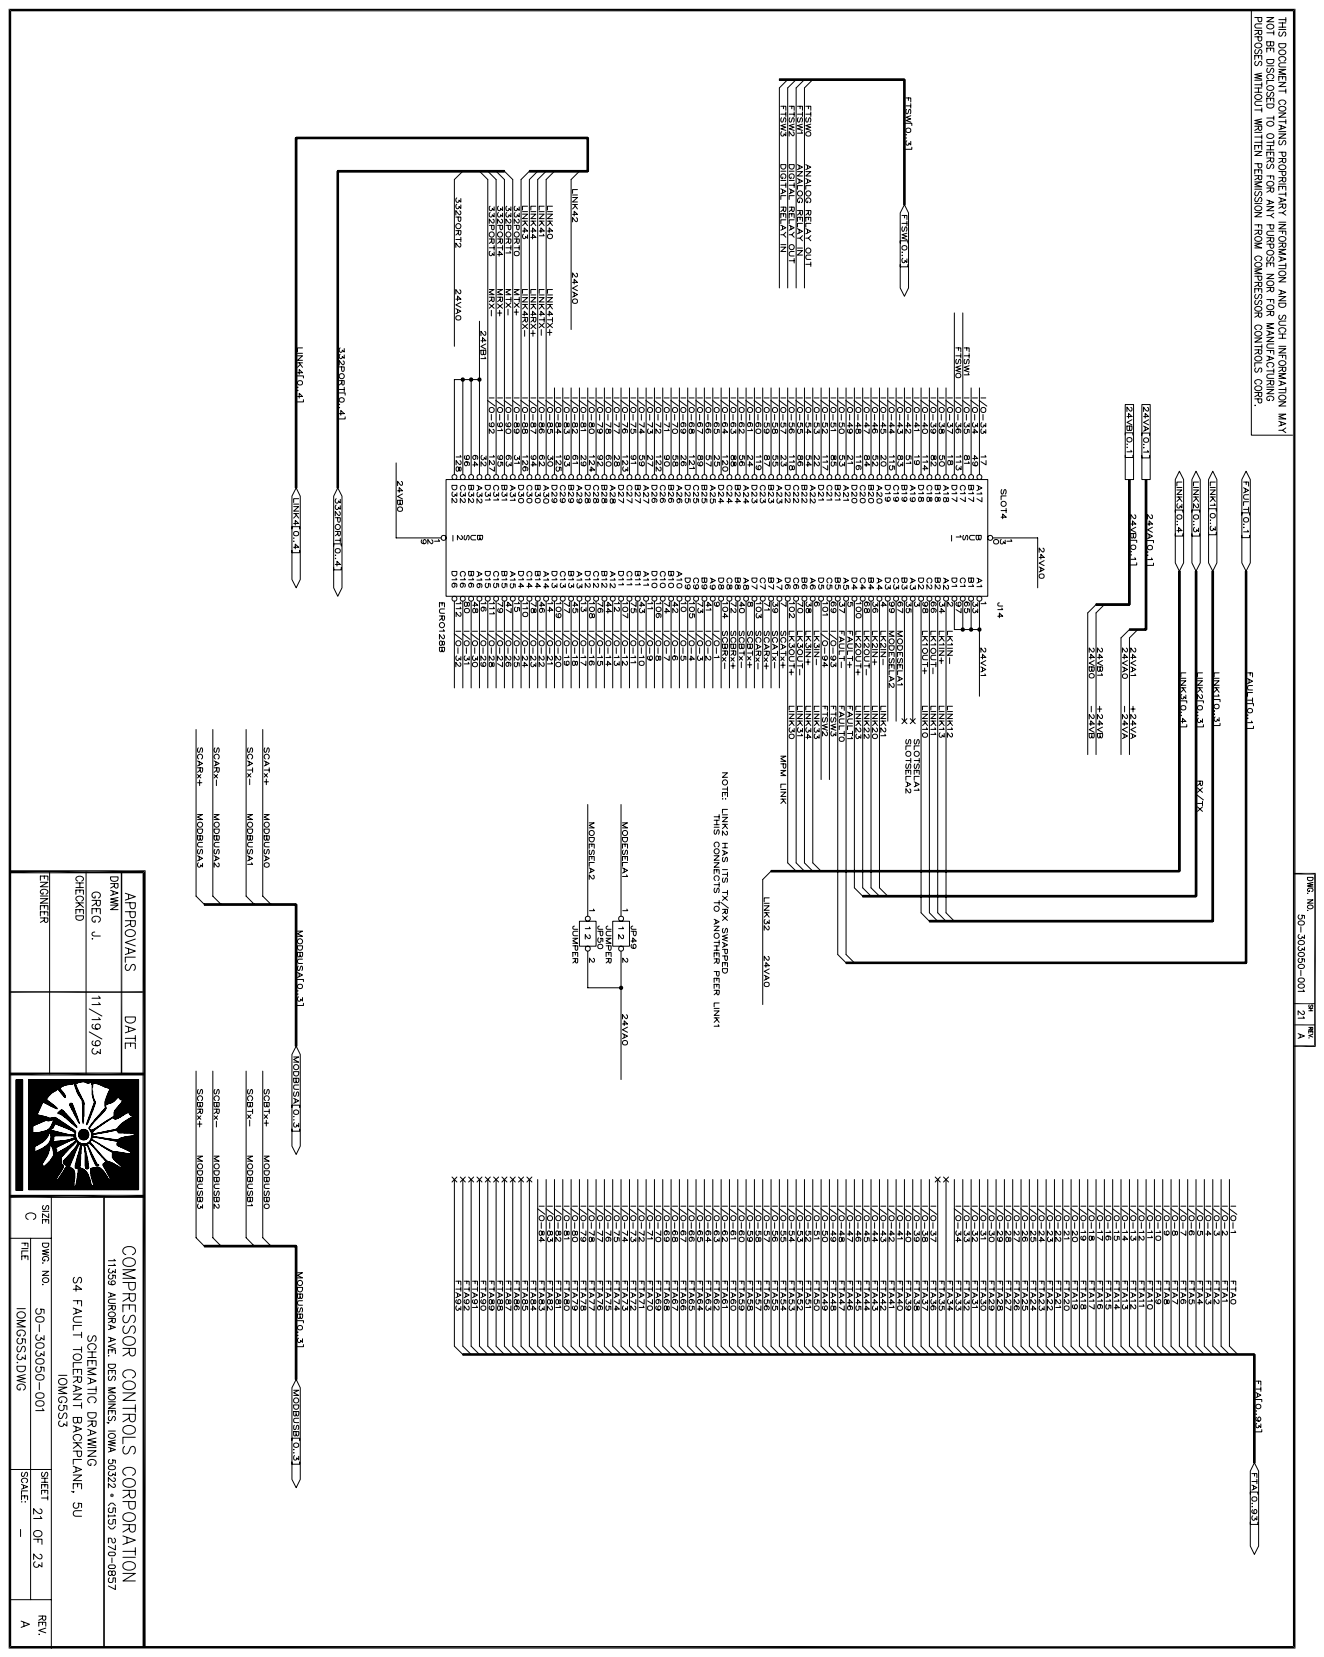
[picture p320: page 21]

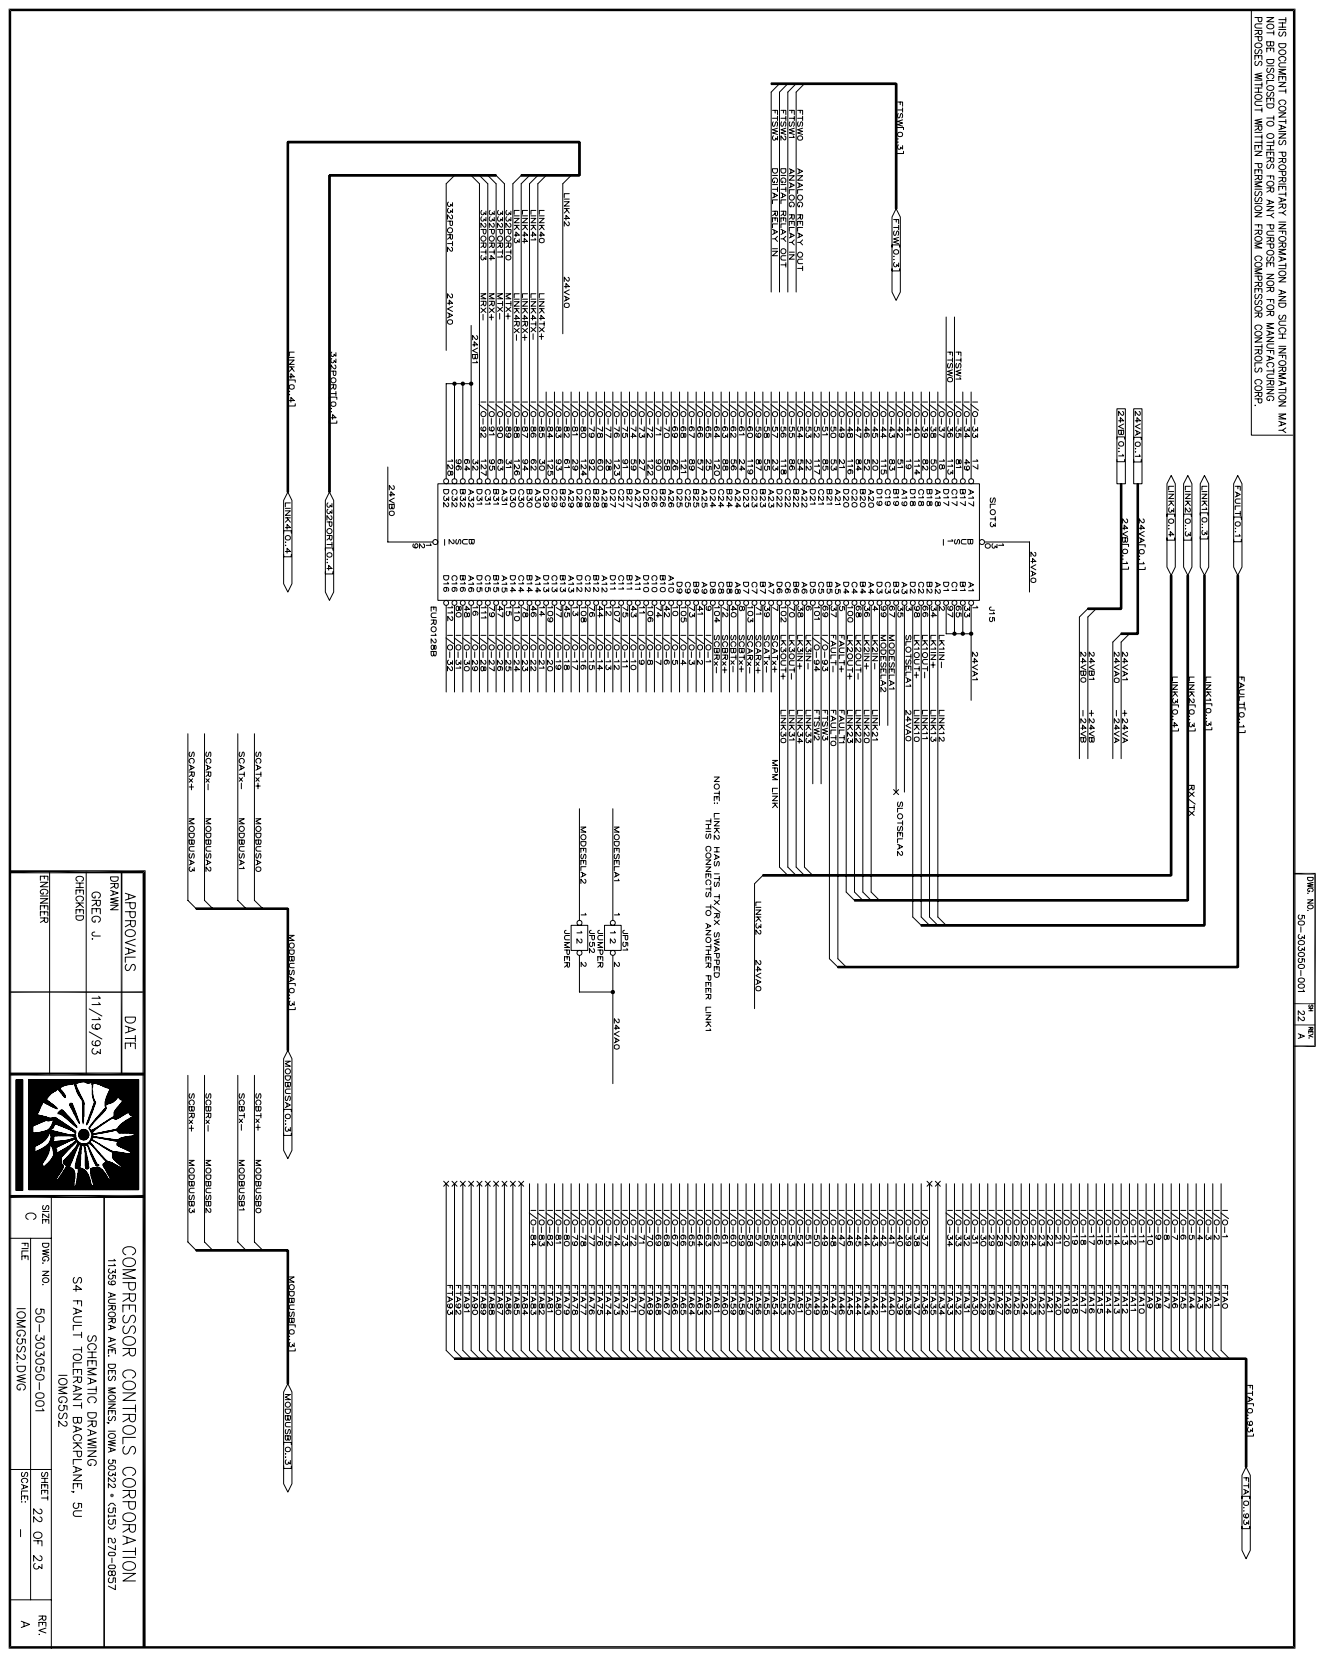
[picture p321: page 22]

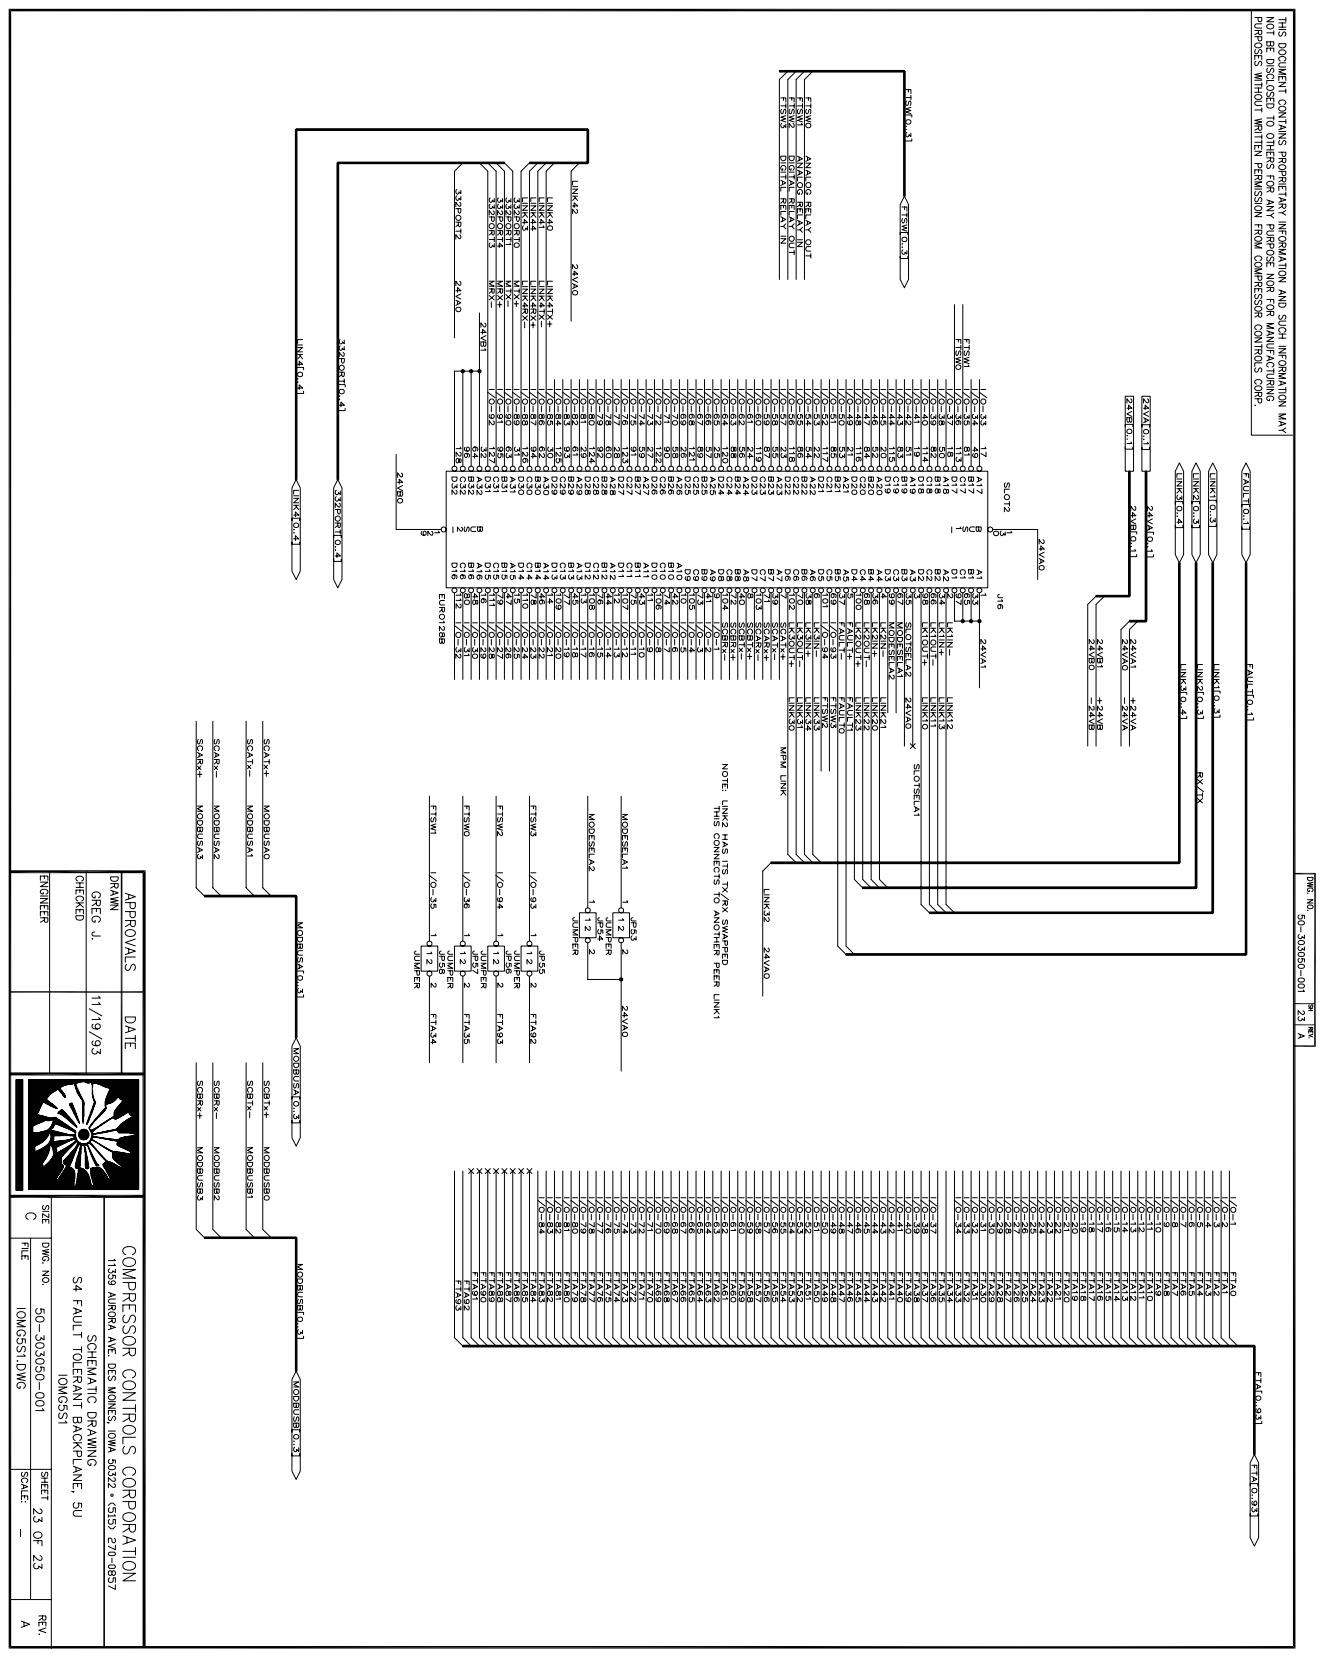
[picture p322: page 23]

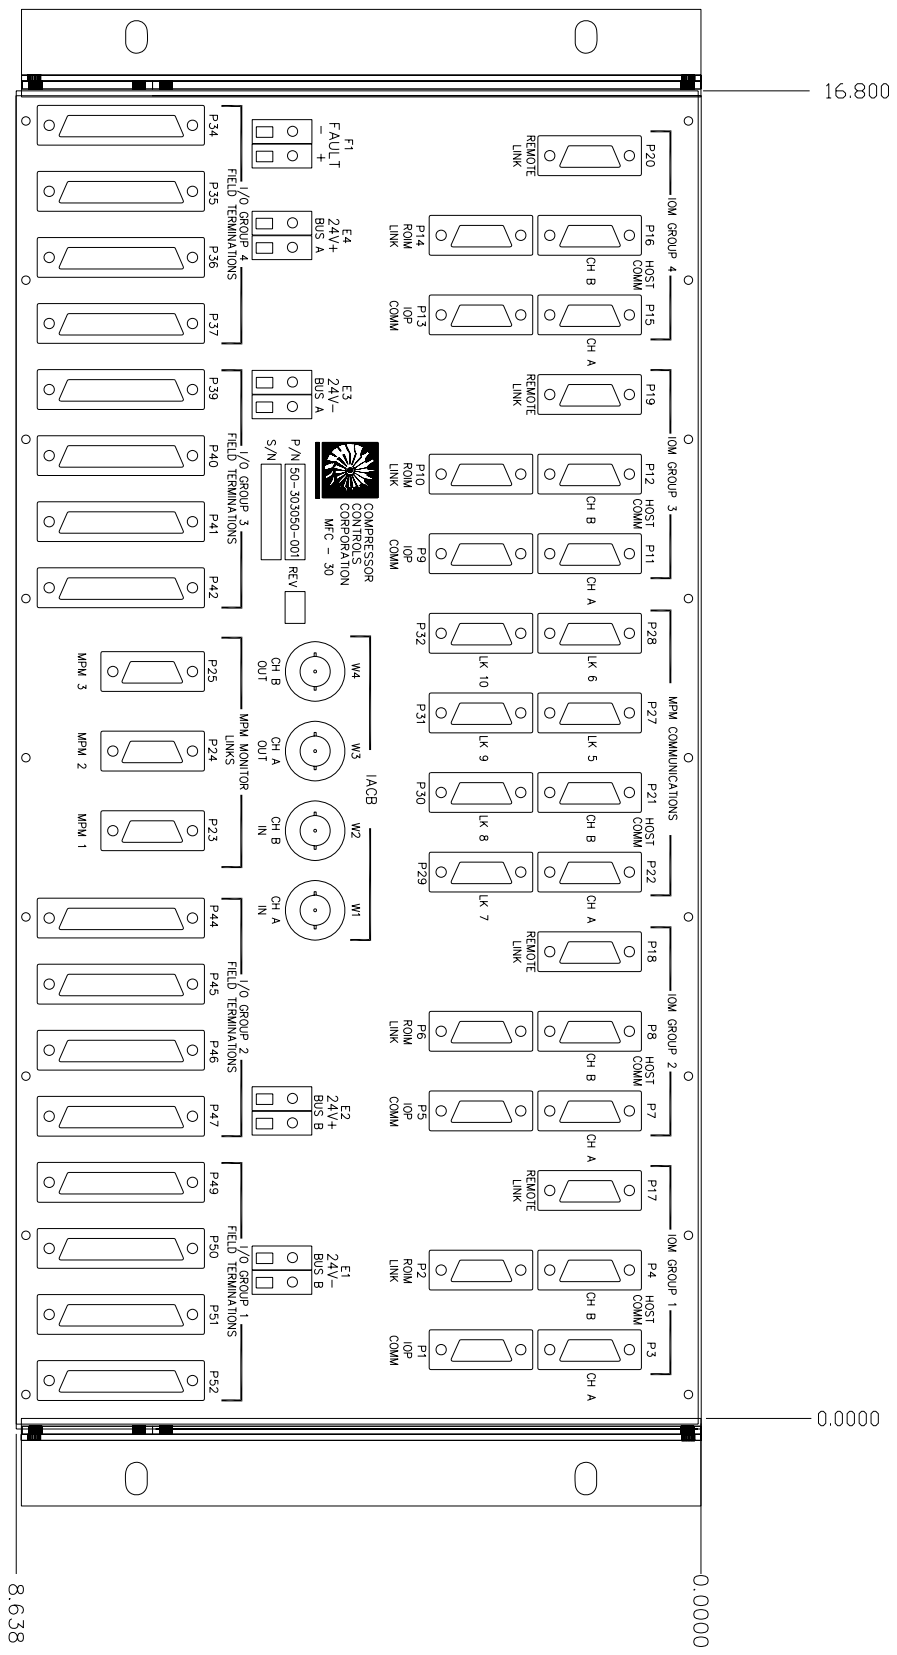
[picture p323: page 24]
