Sayidathahaseen/CCC_NGP_ODC/NGP_ODC_Main/PDLC/VanGuard/Client Docs/Vanguard/Block Diagrams_Vanguard IO.pdf

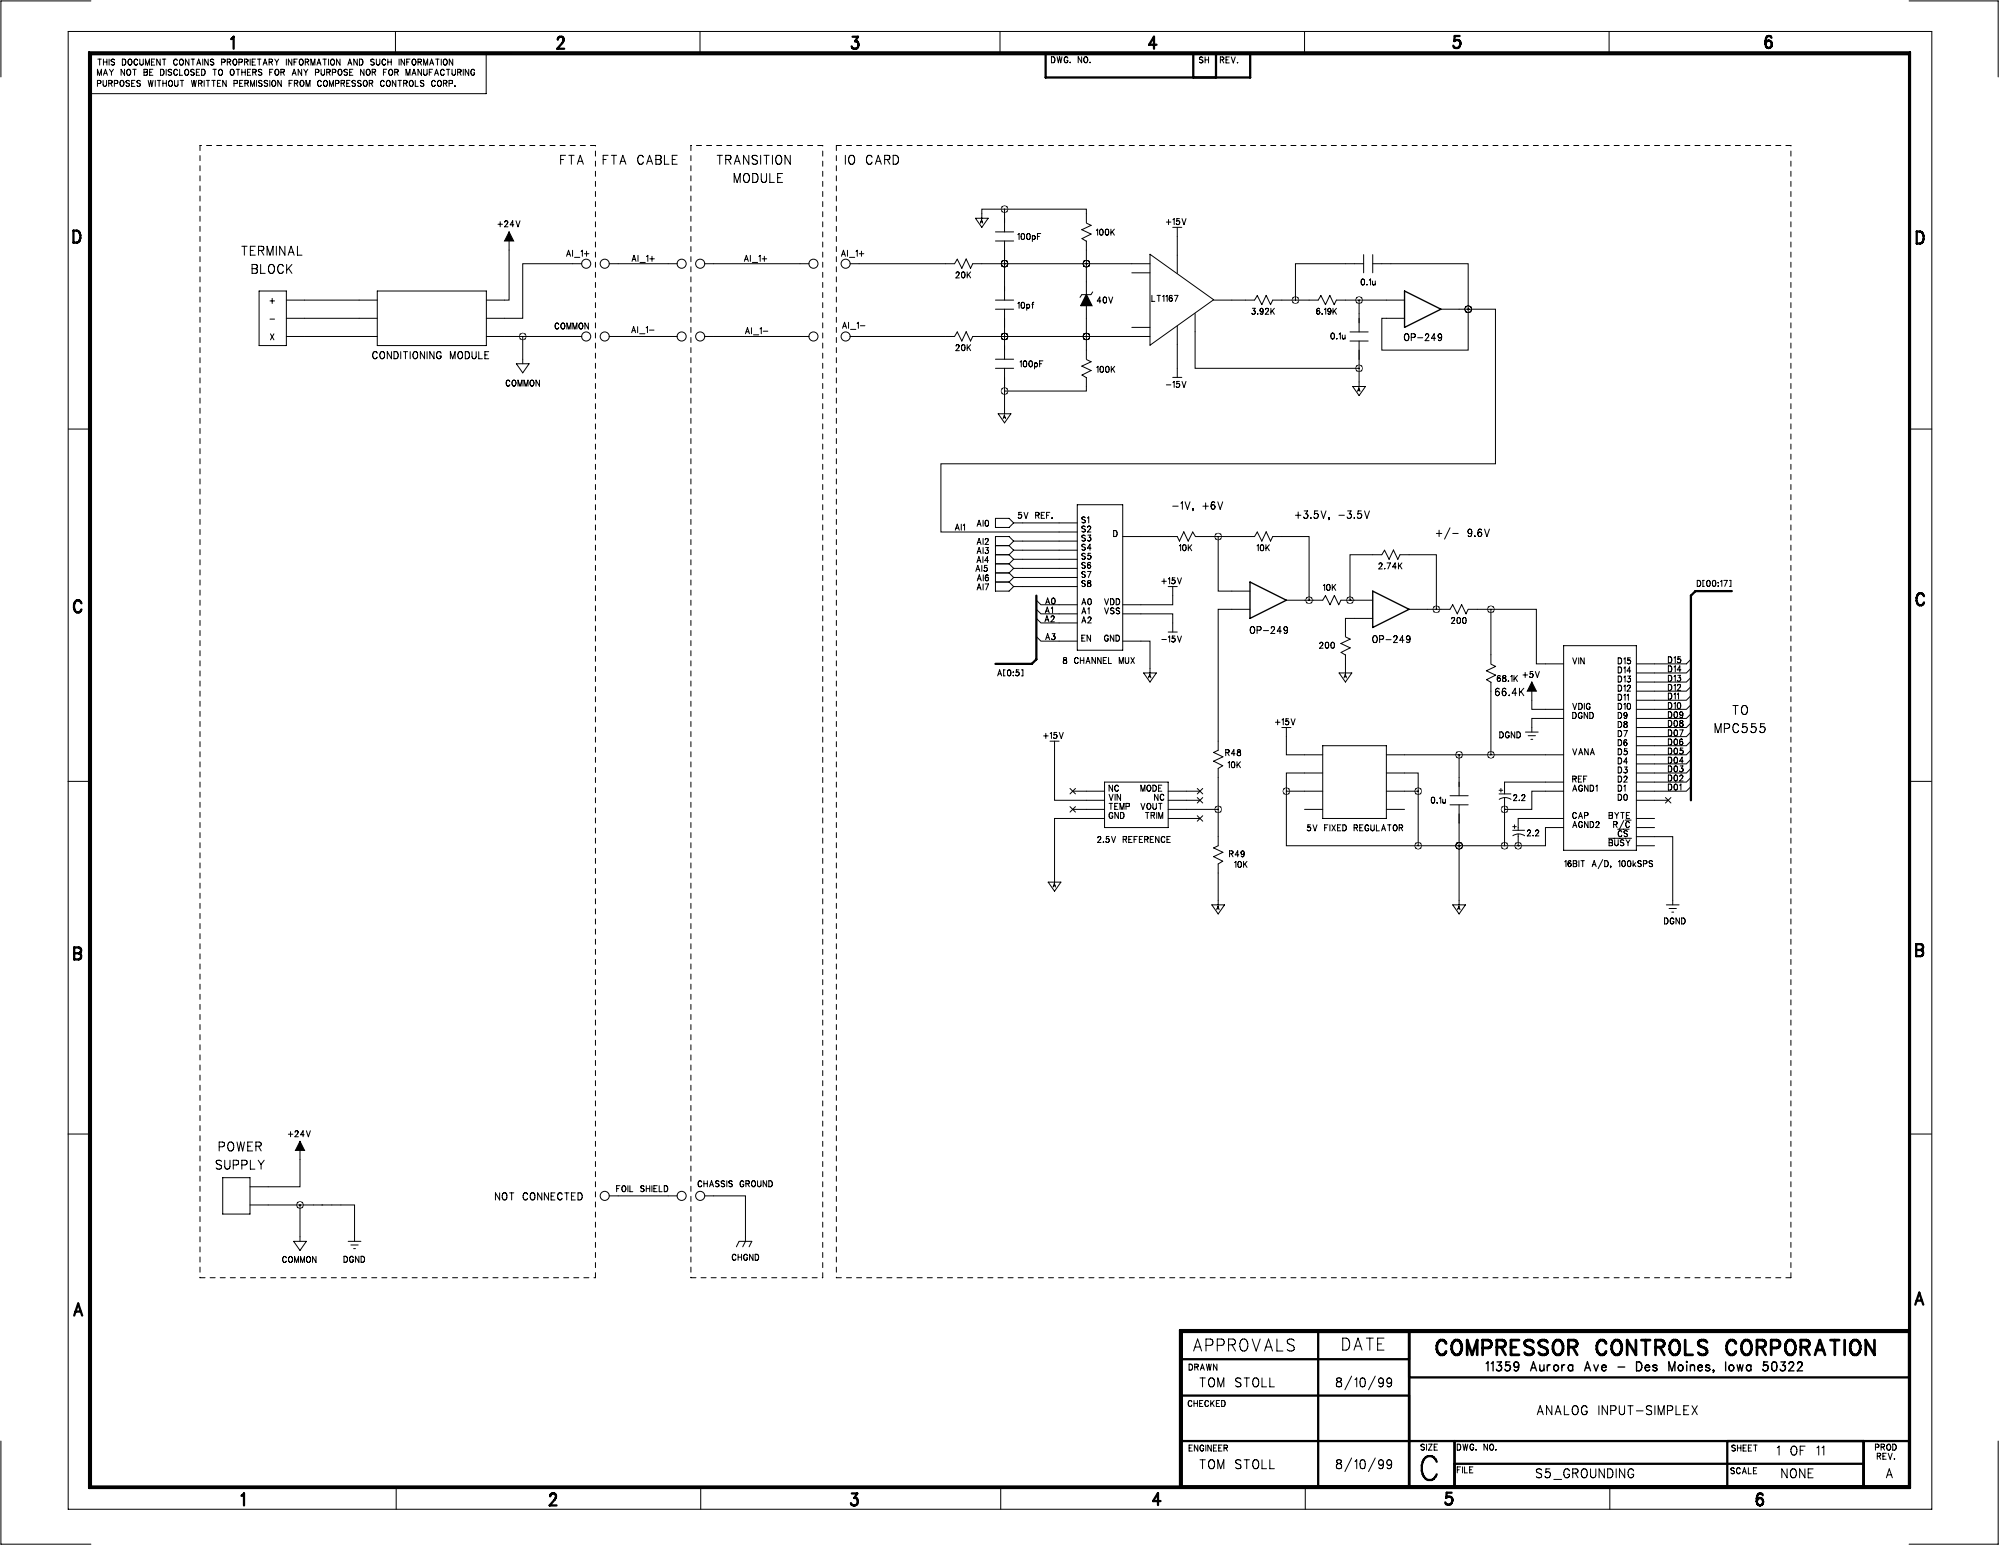
[picture p324: page 1]

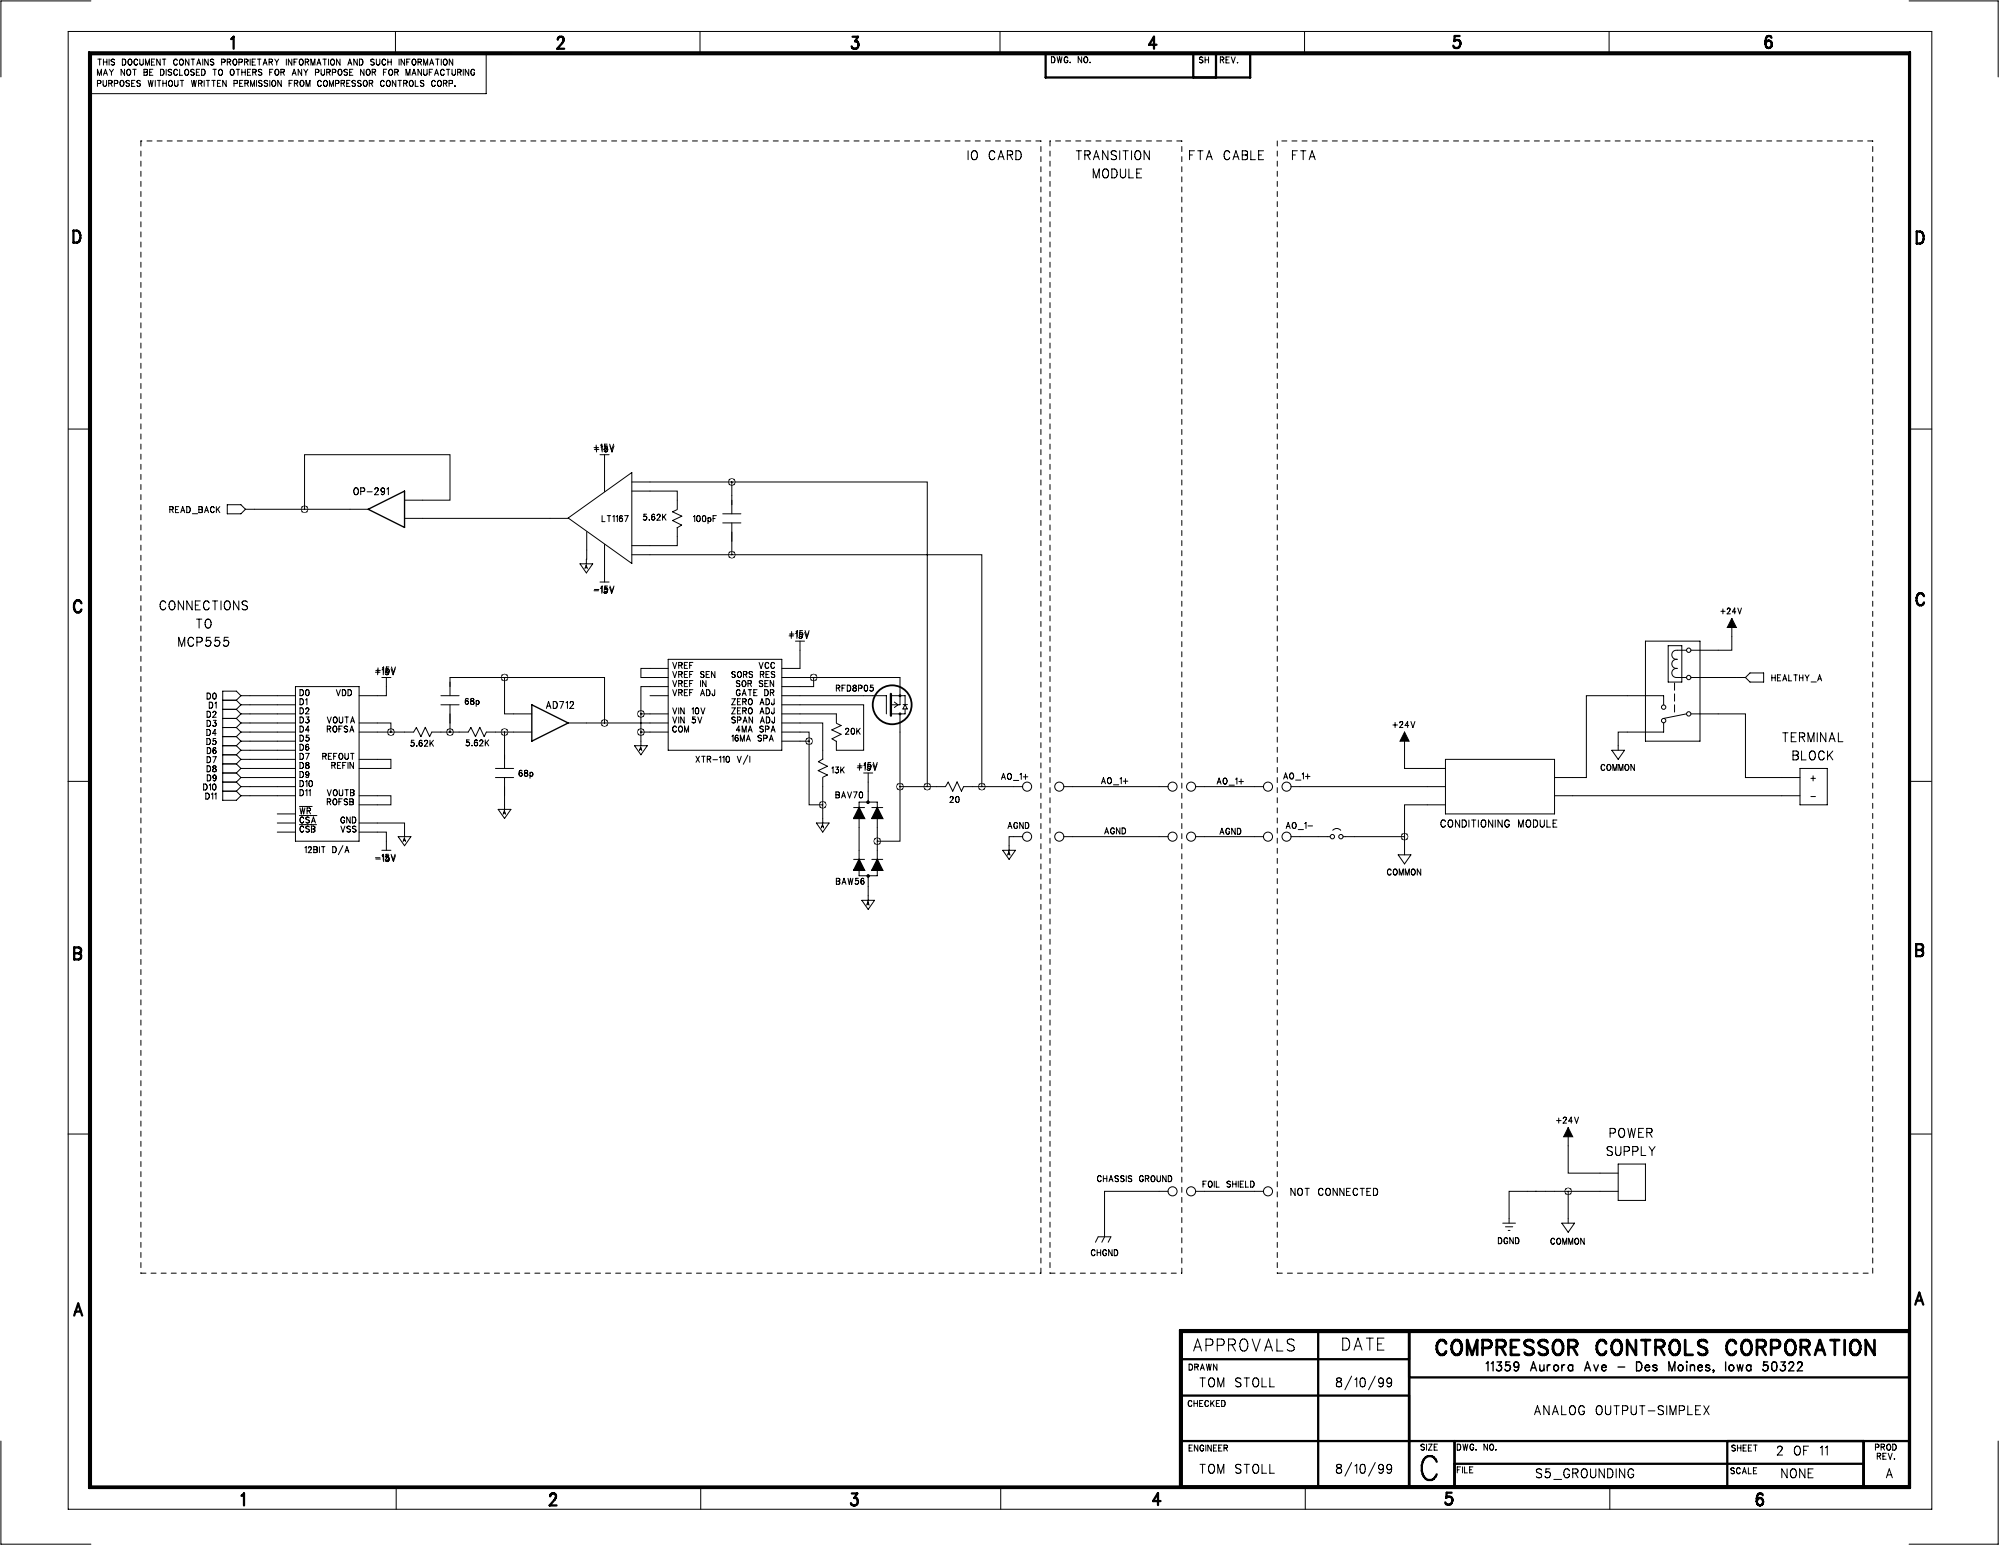
[picture p325: page 2]

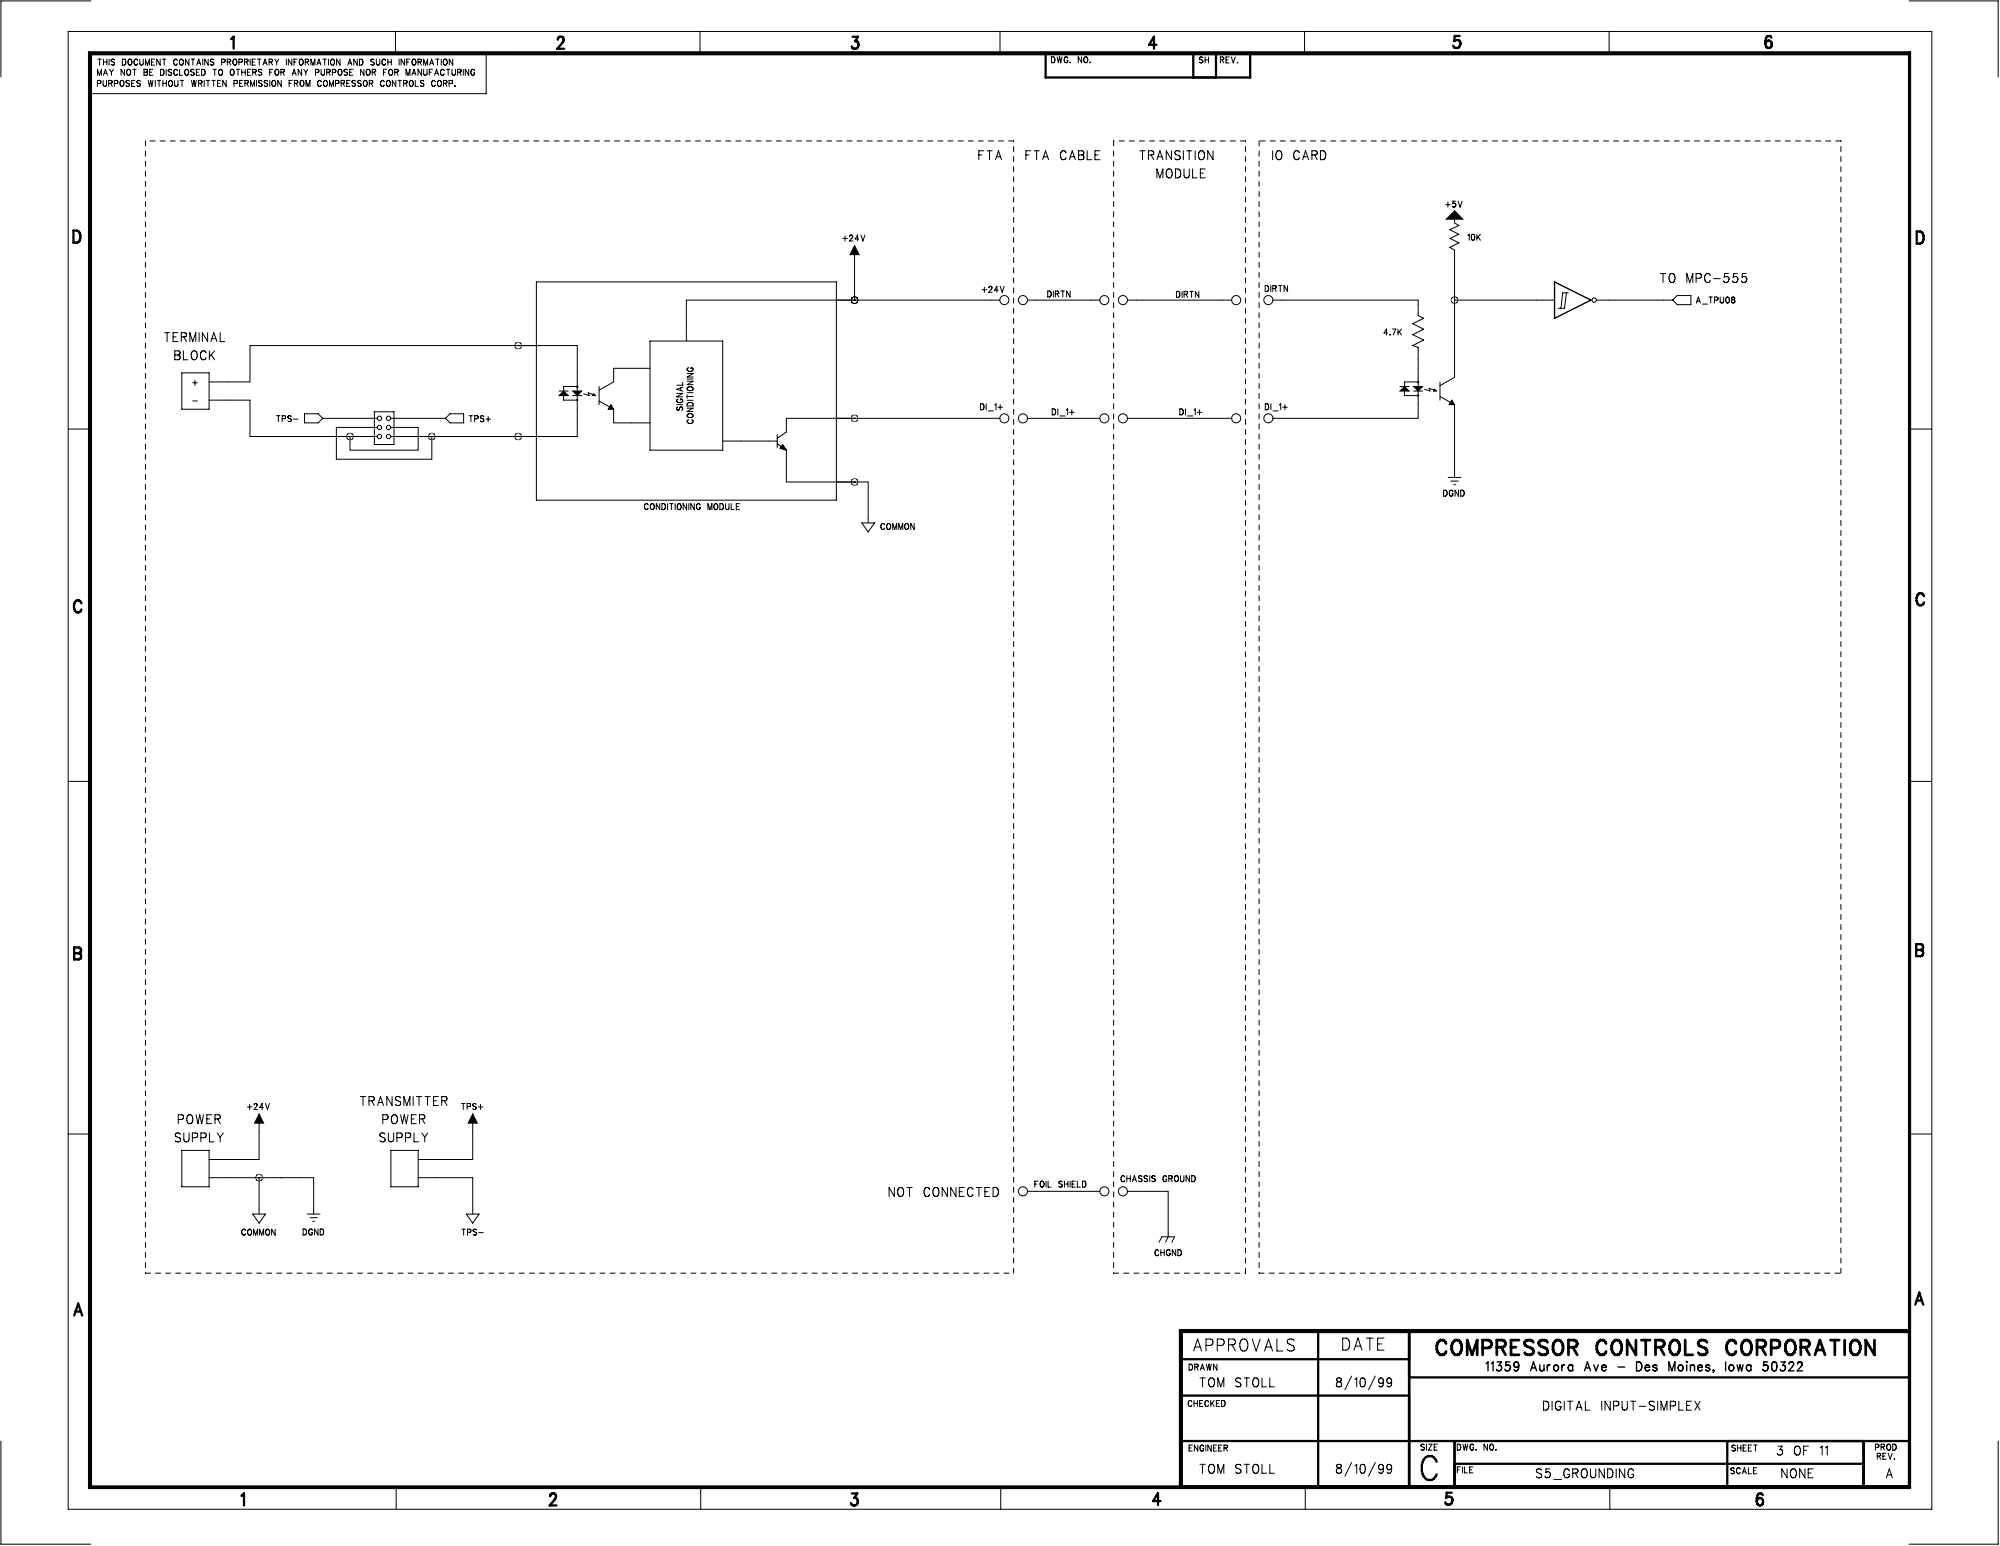
[picture p326: page 3]

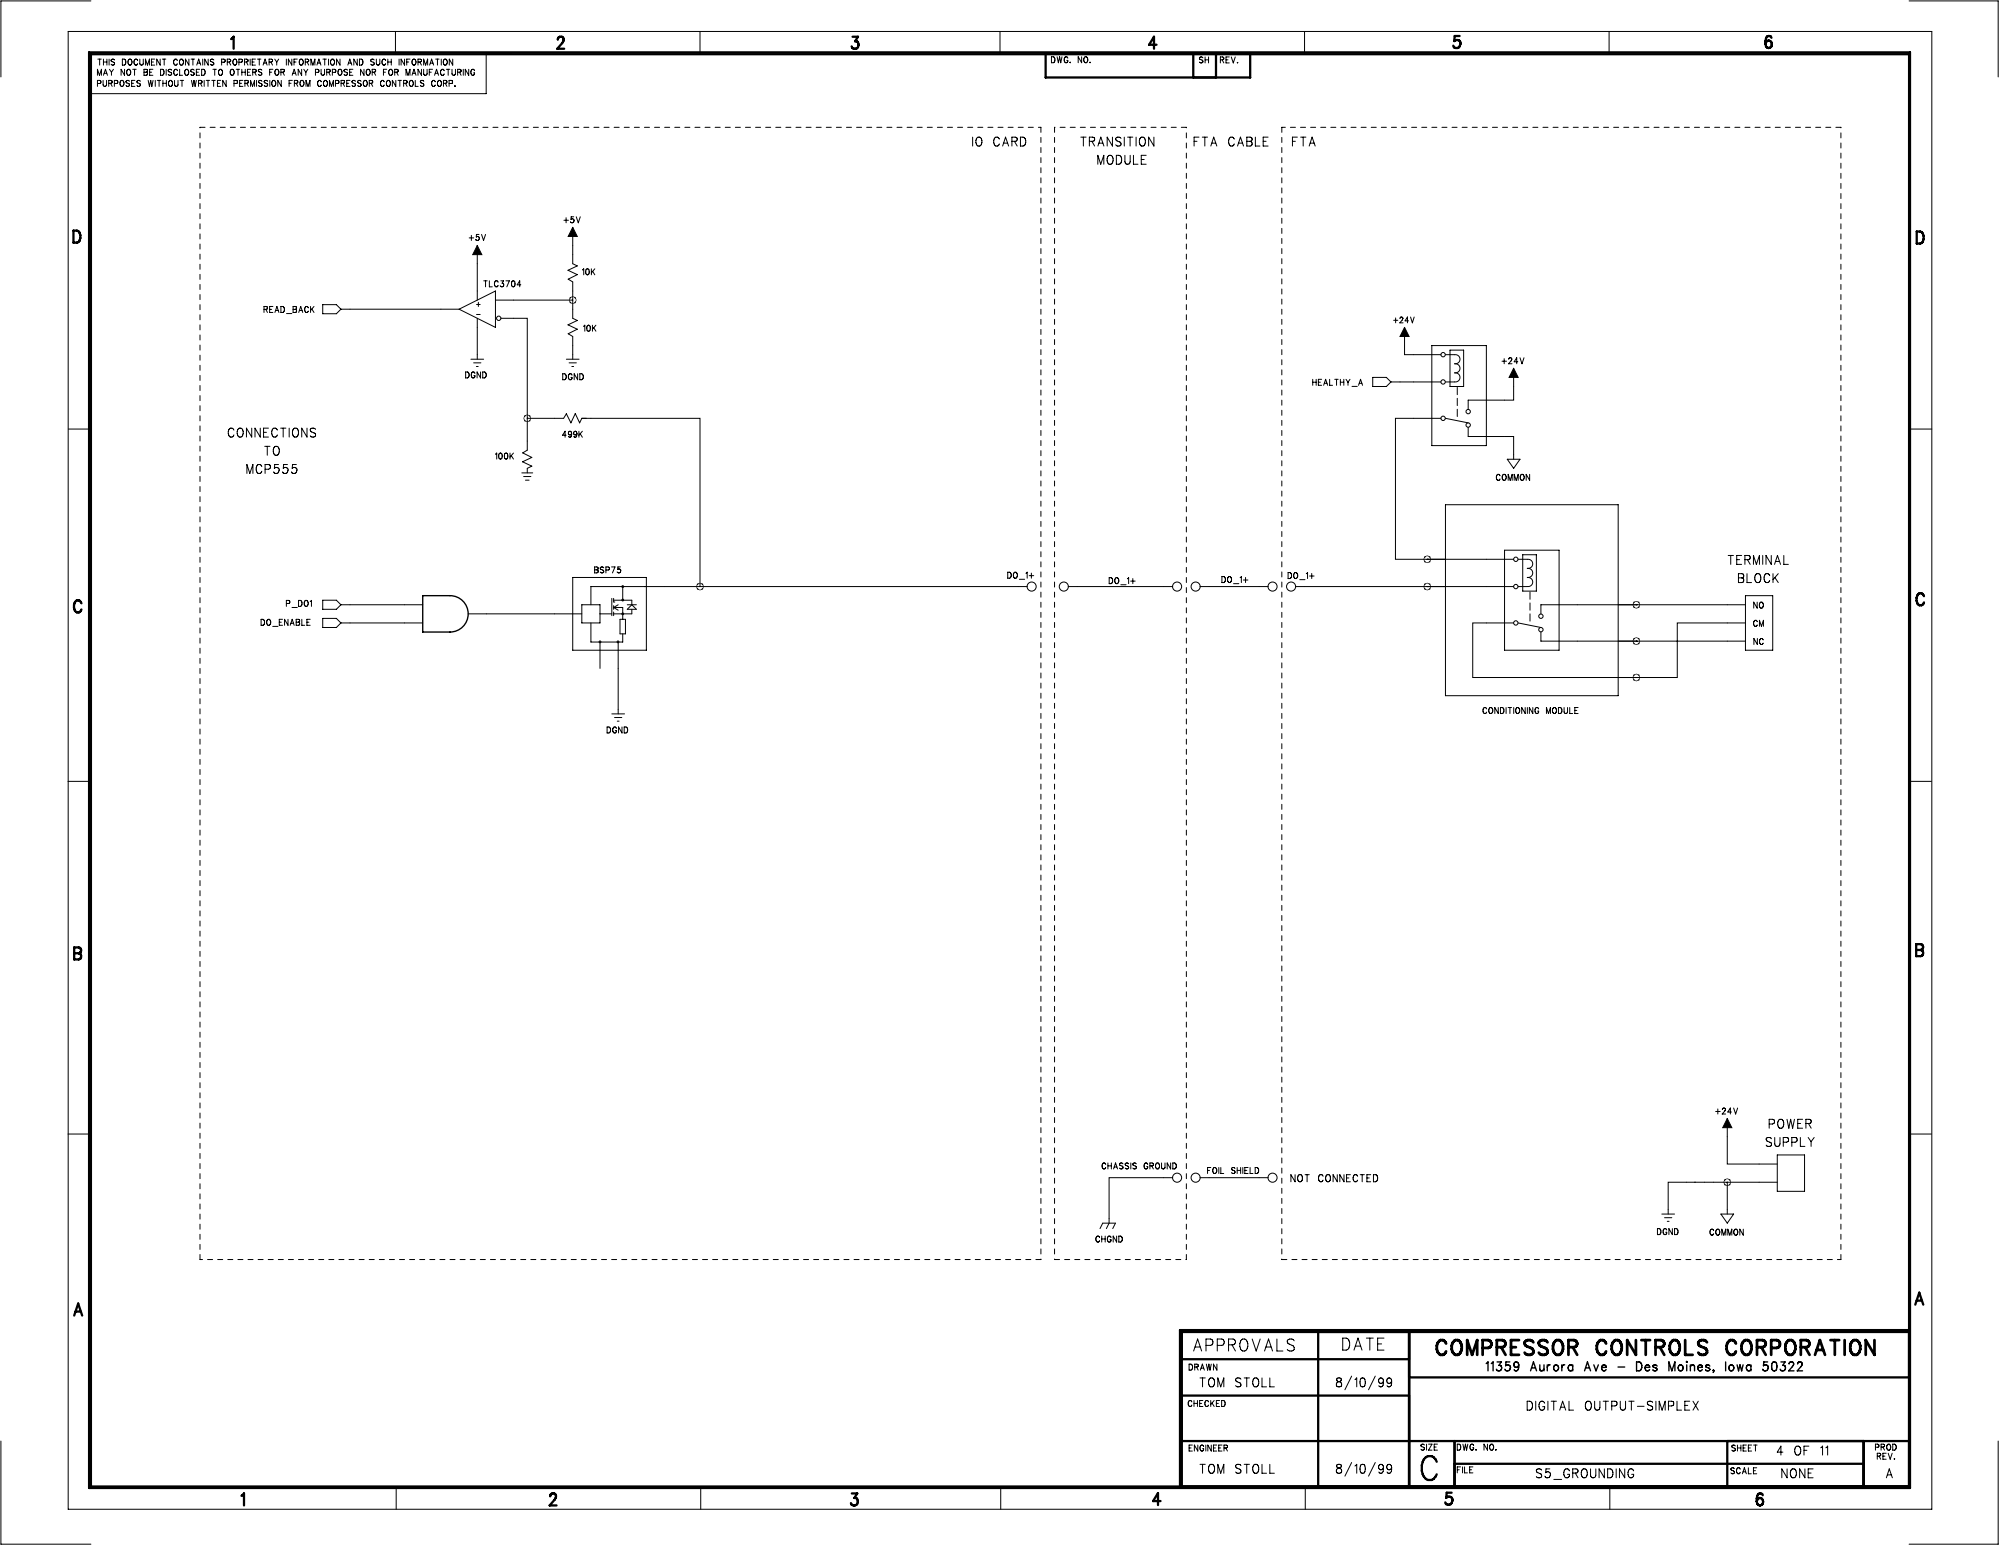
[picture p327: page 4]

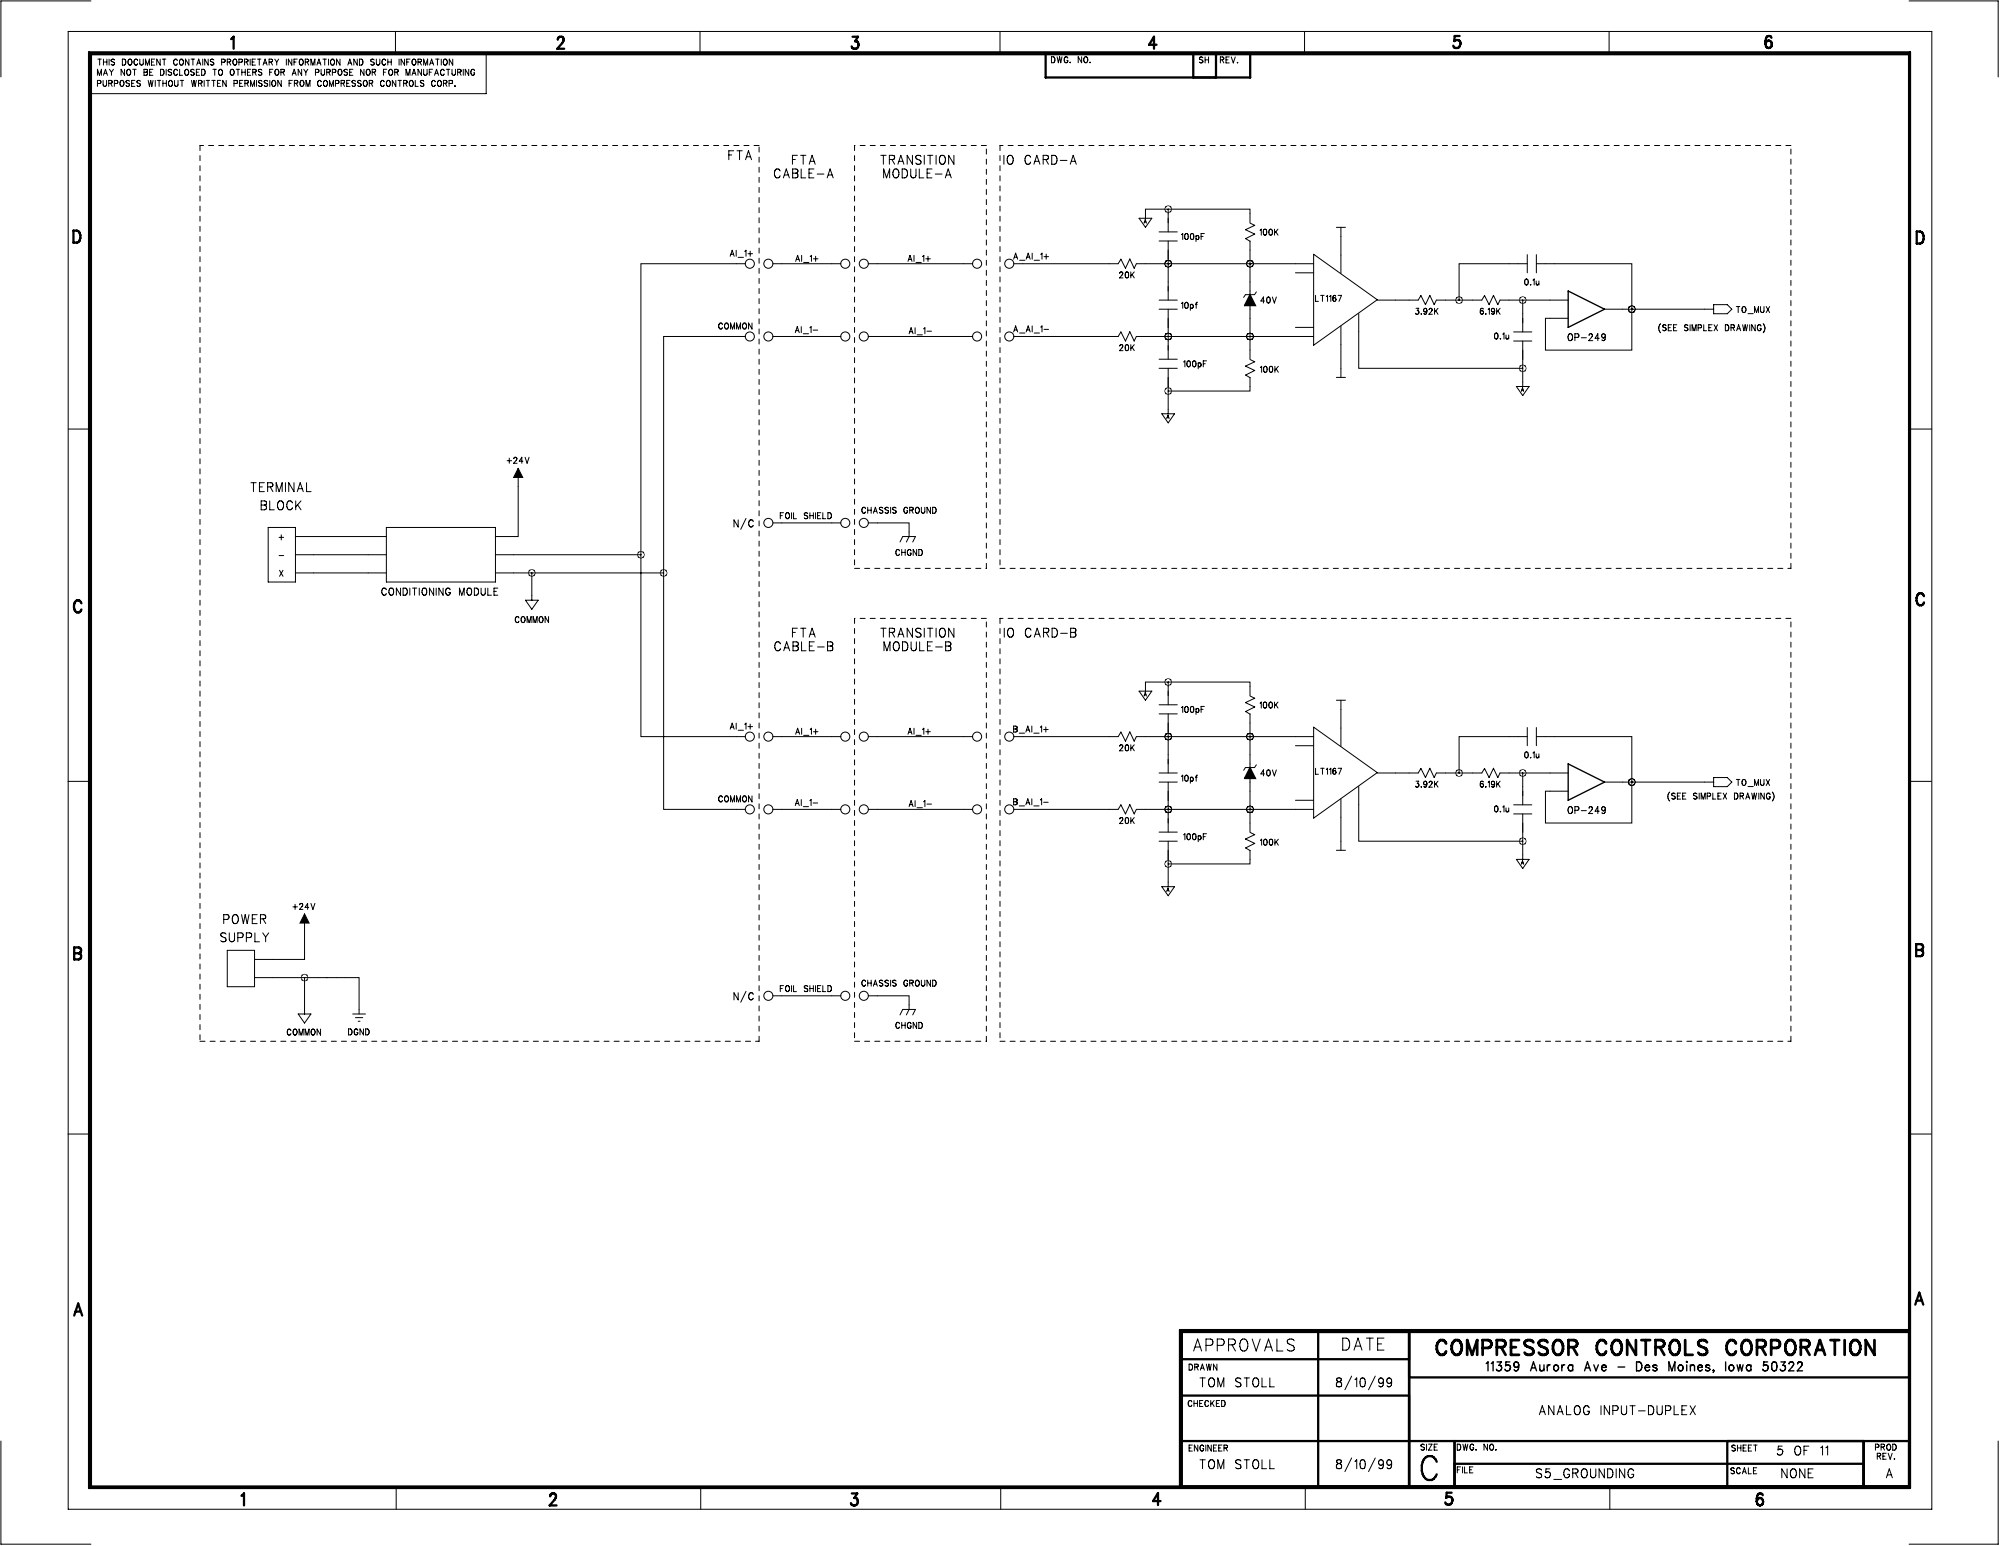
[picture p328: page 5]

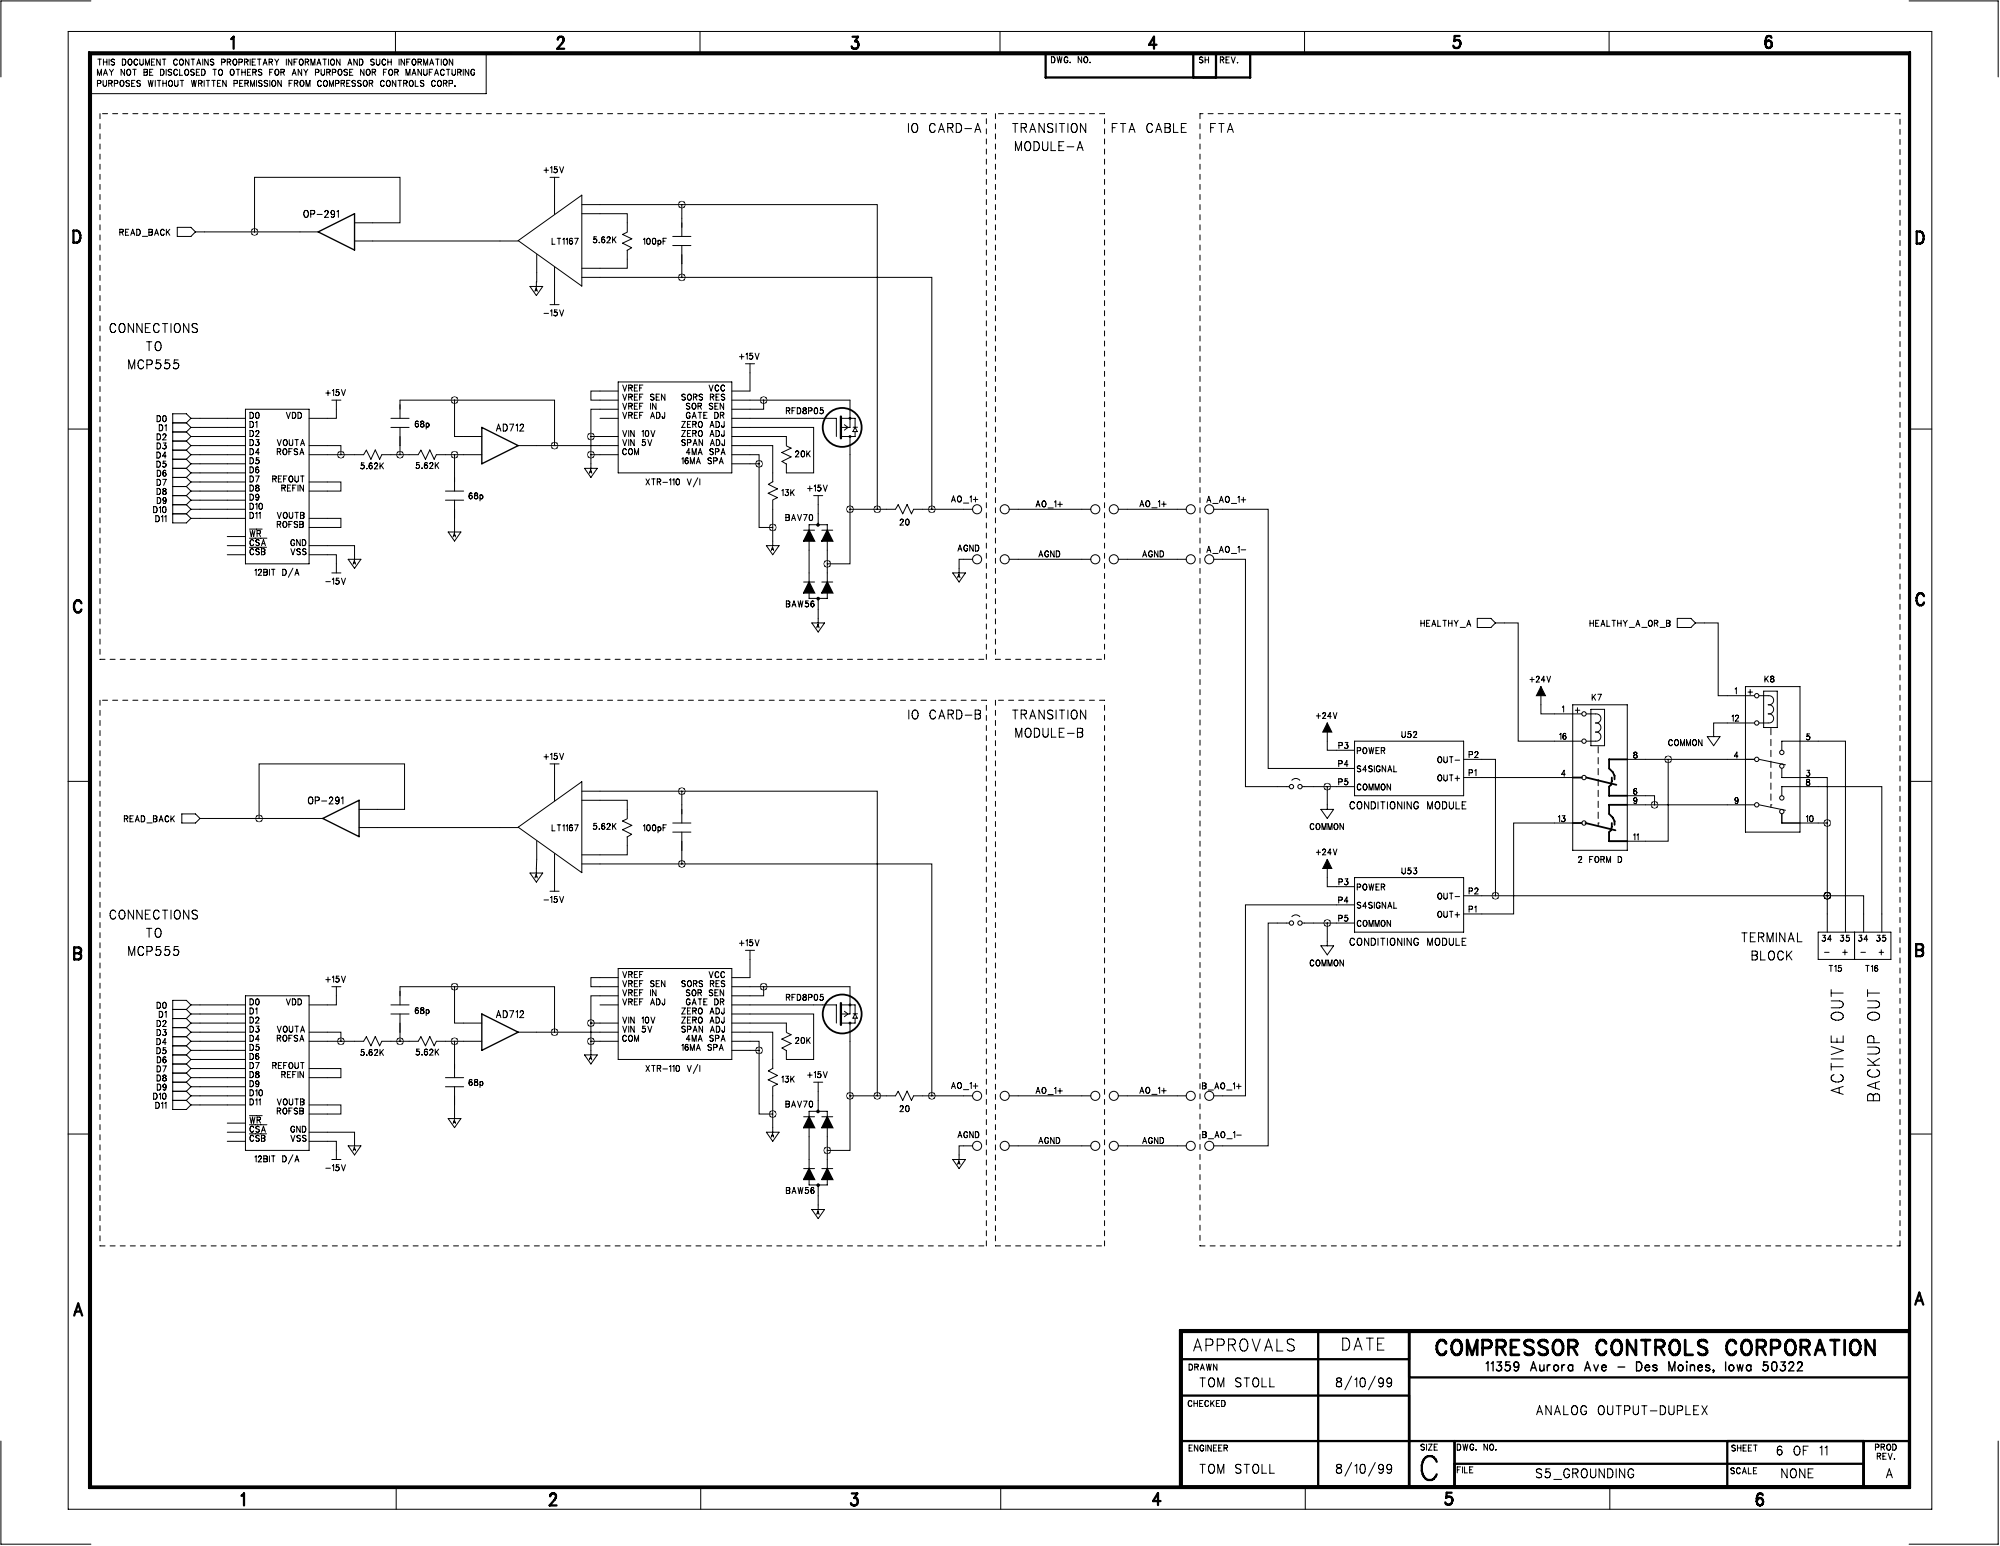
[picture p329: page 6]

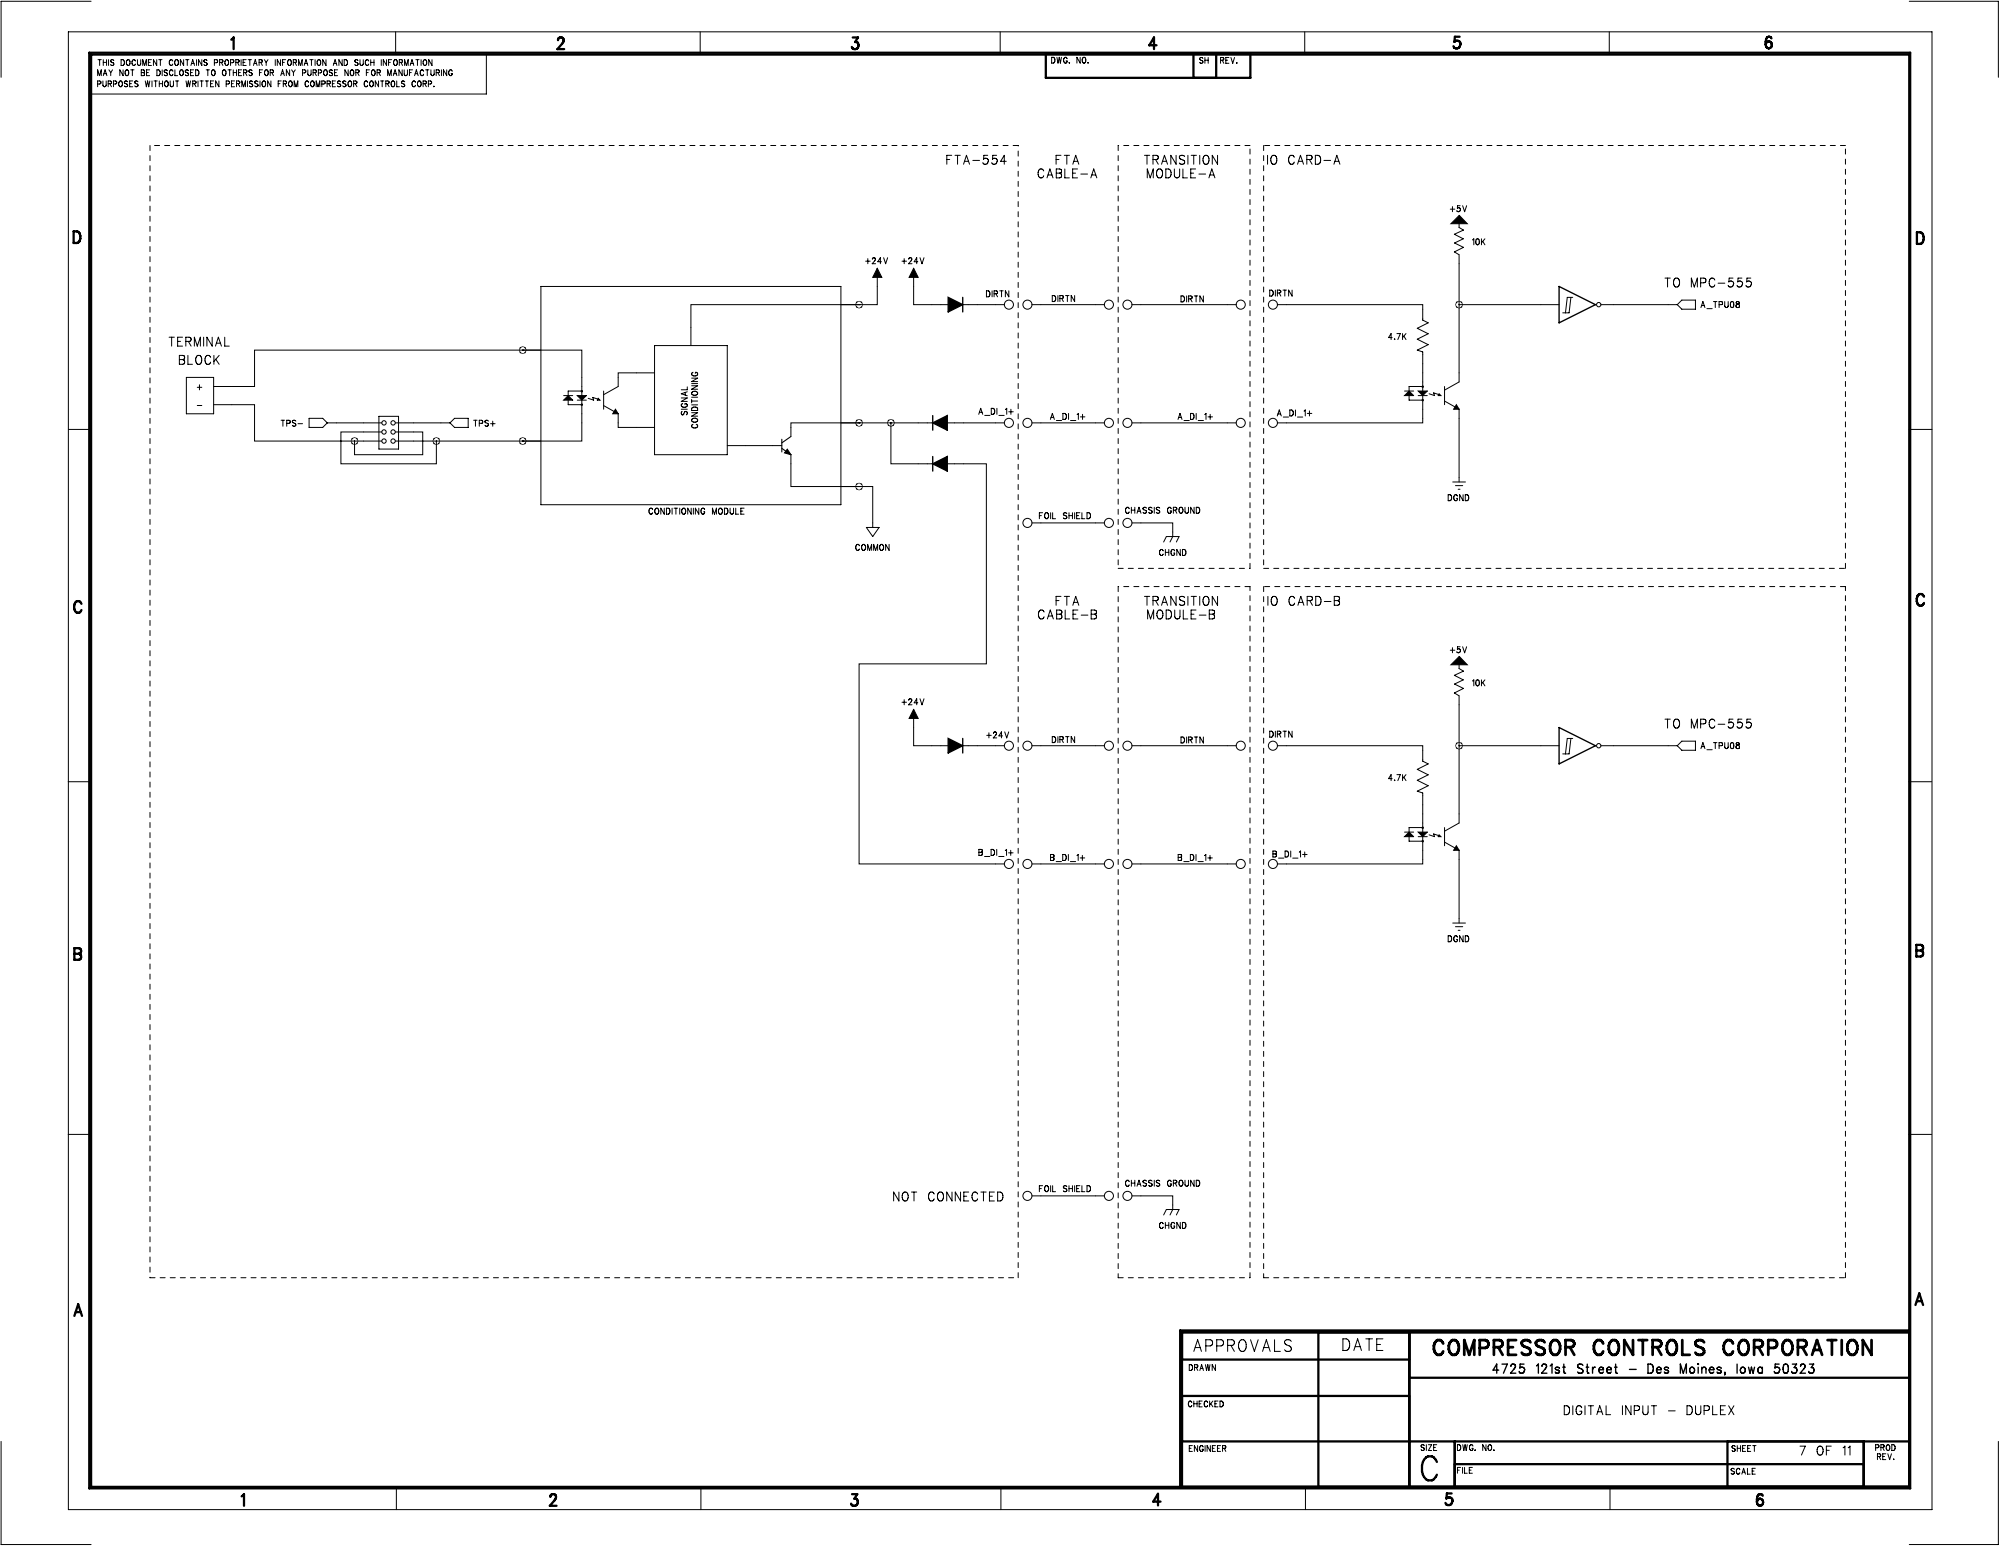
[picture p330: page 7]

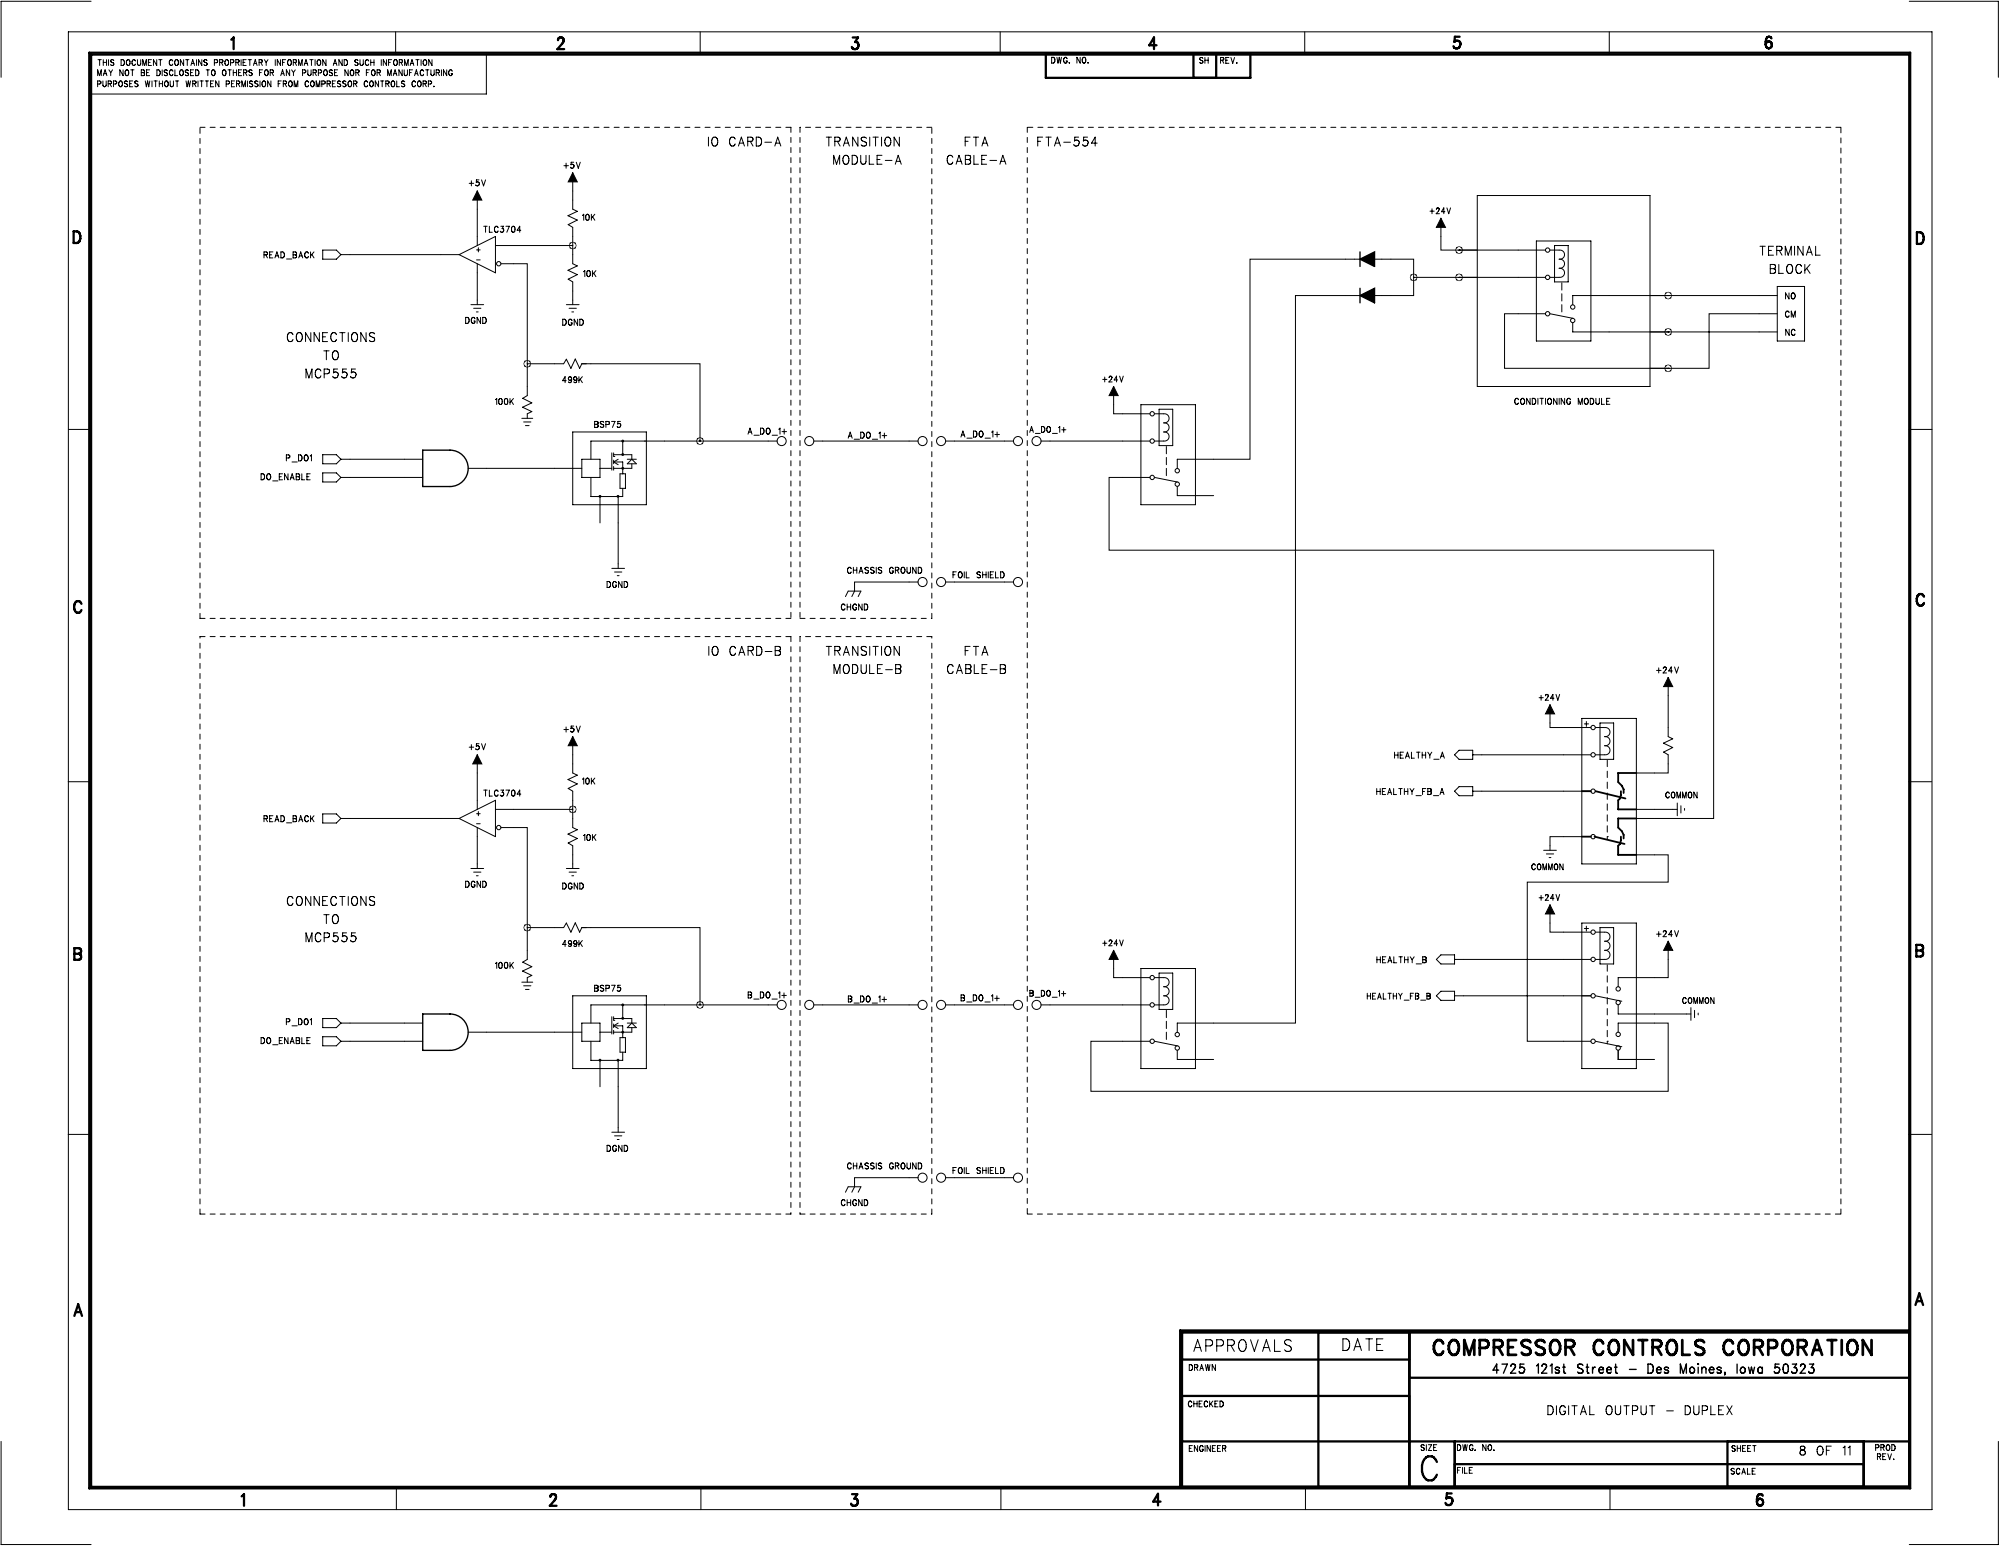
[picture p331: page 8]

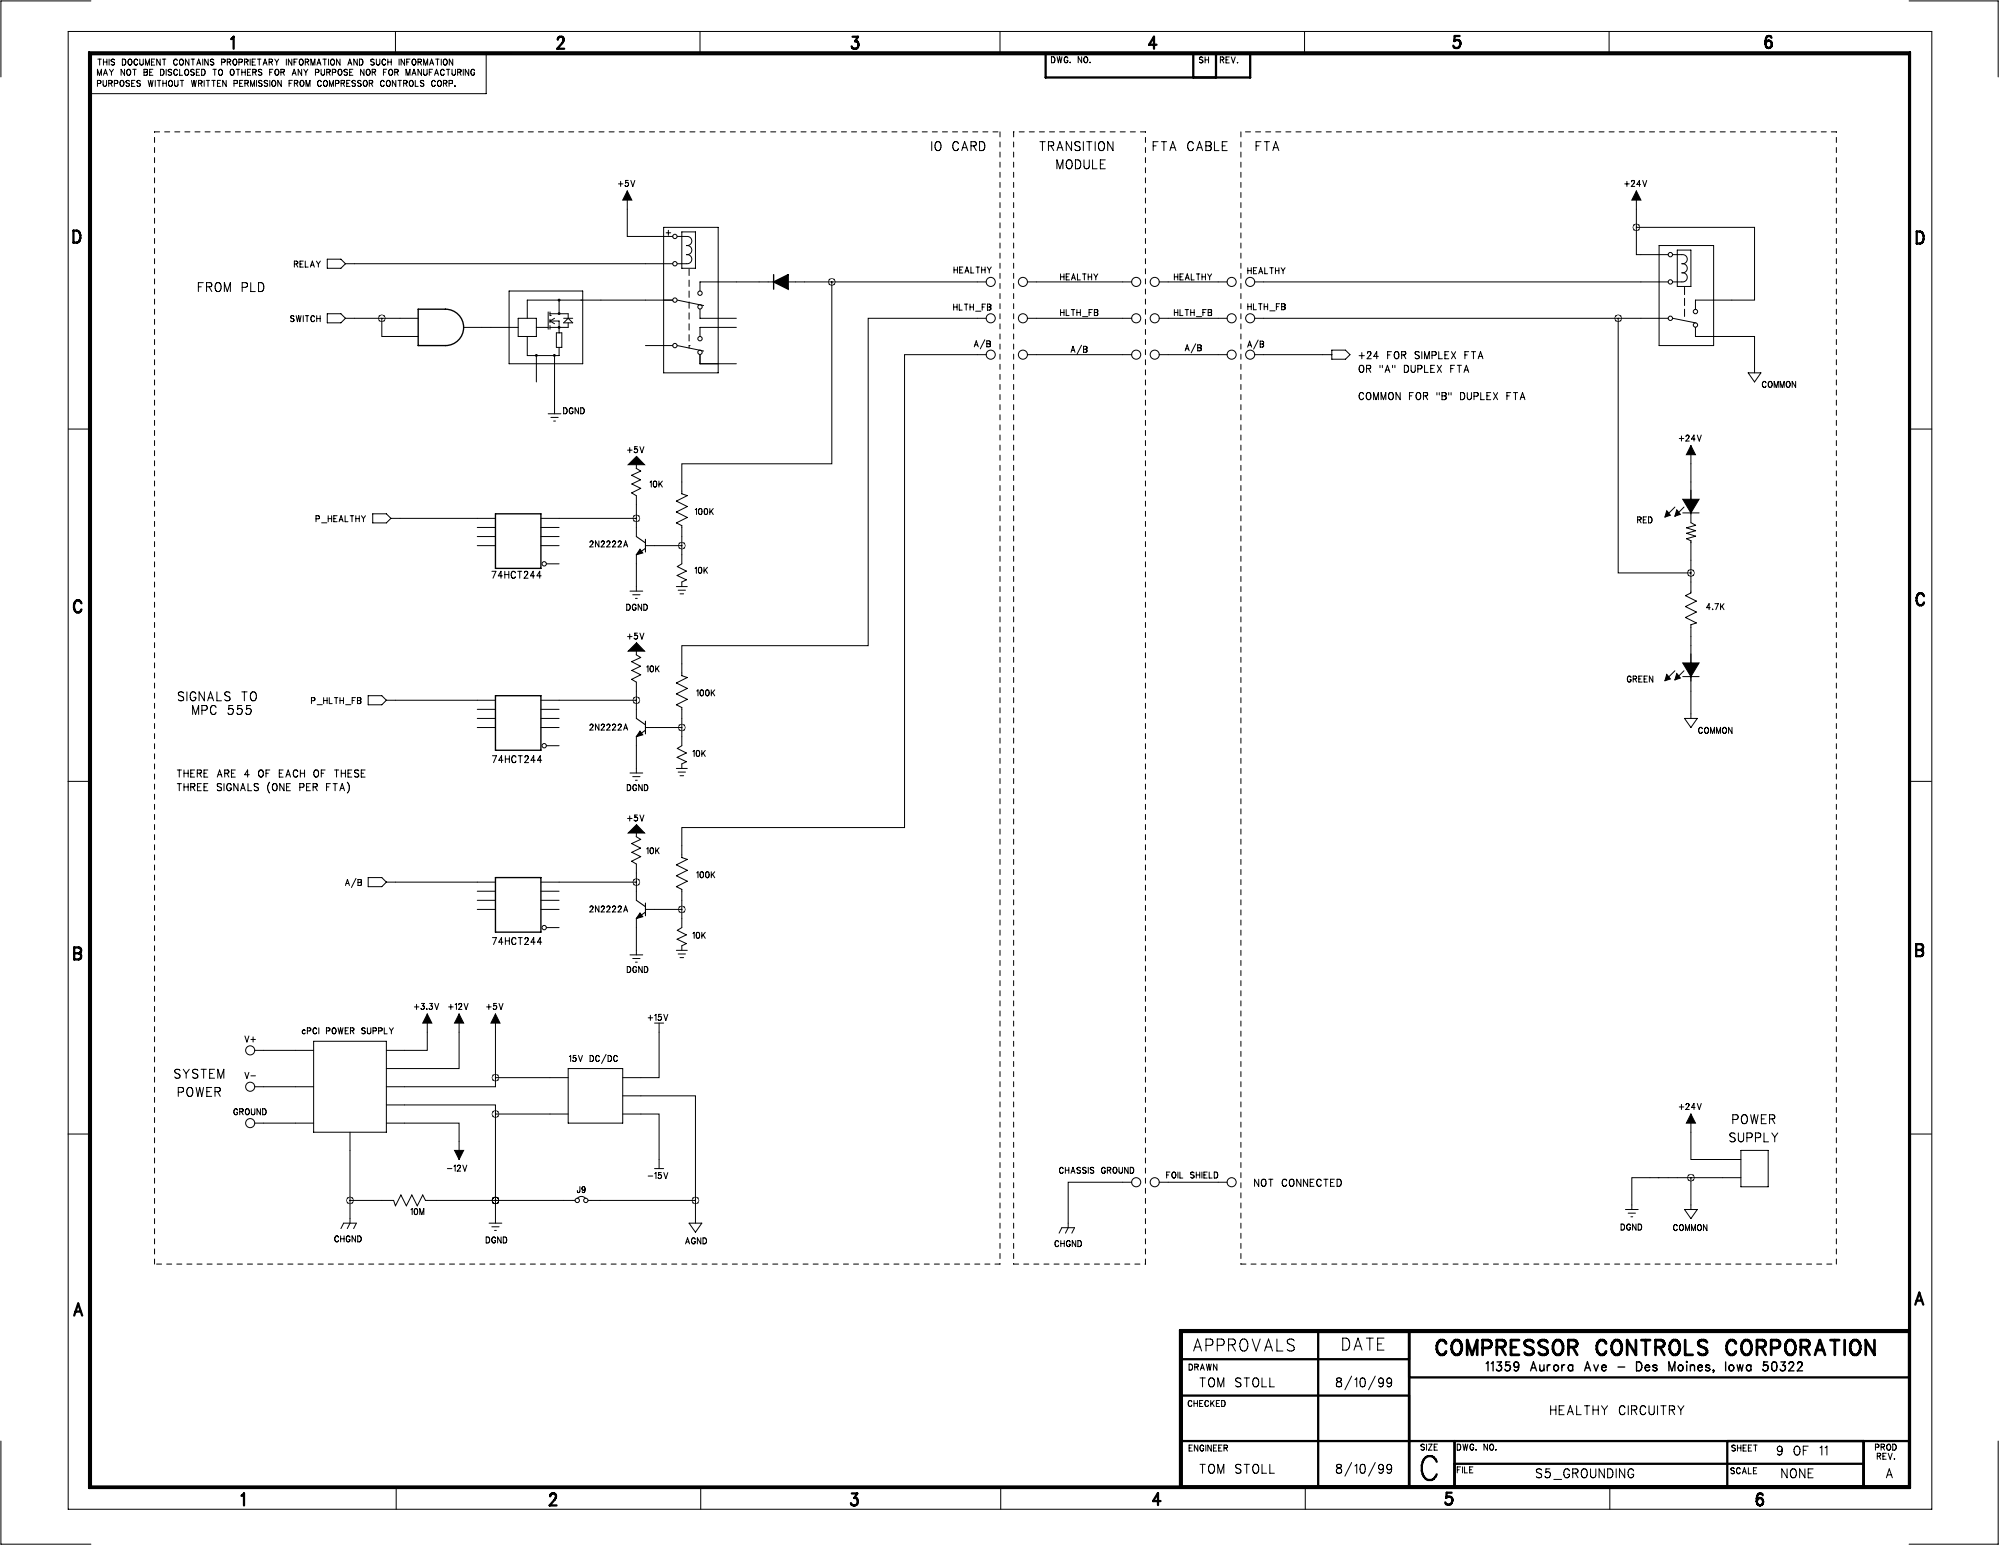
[picture p332: page 9]

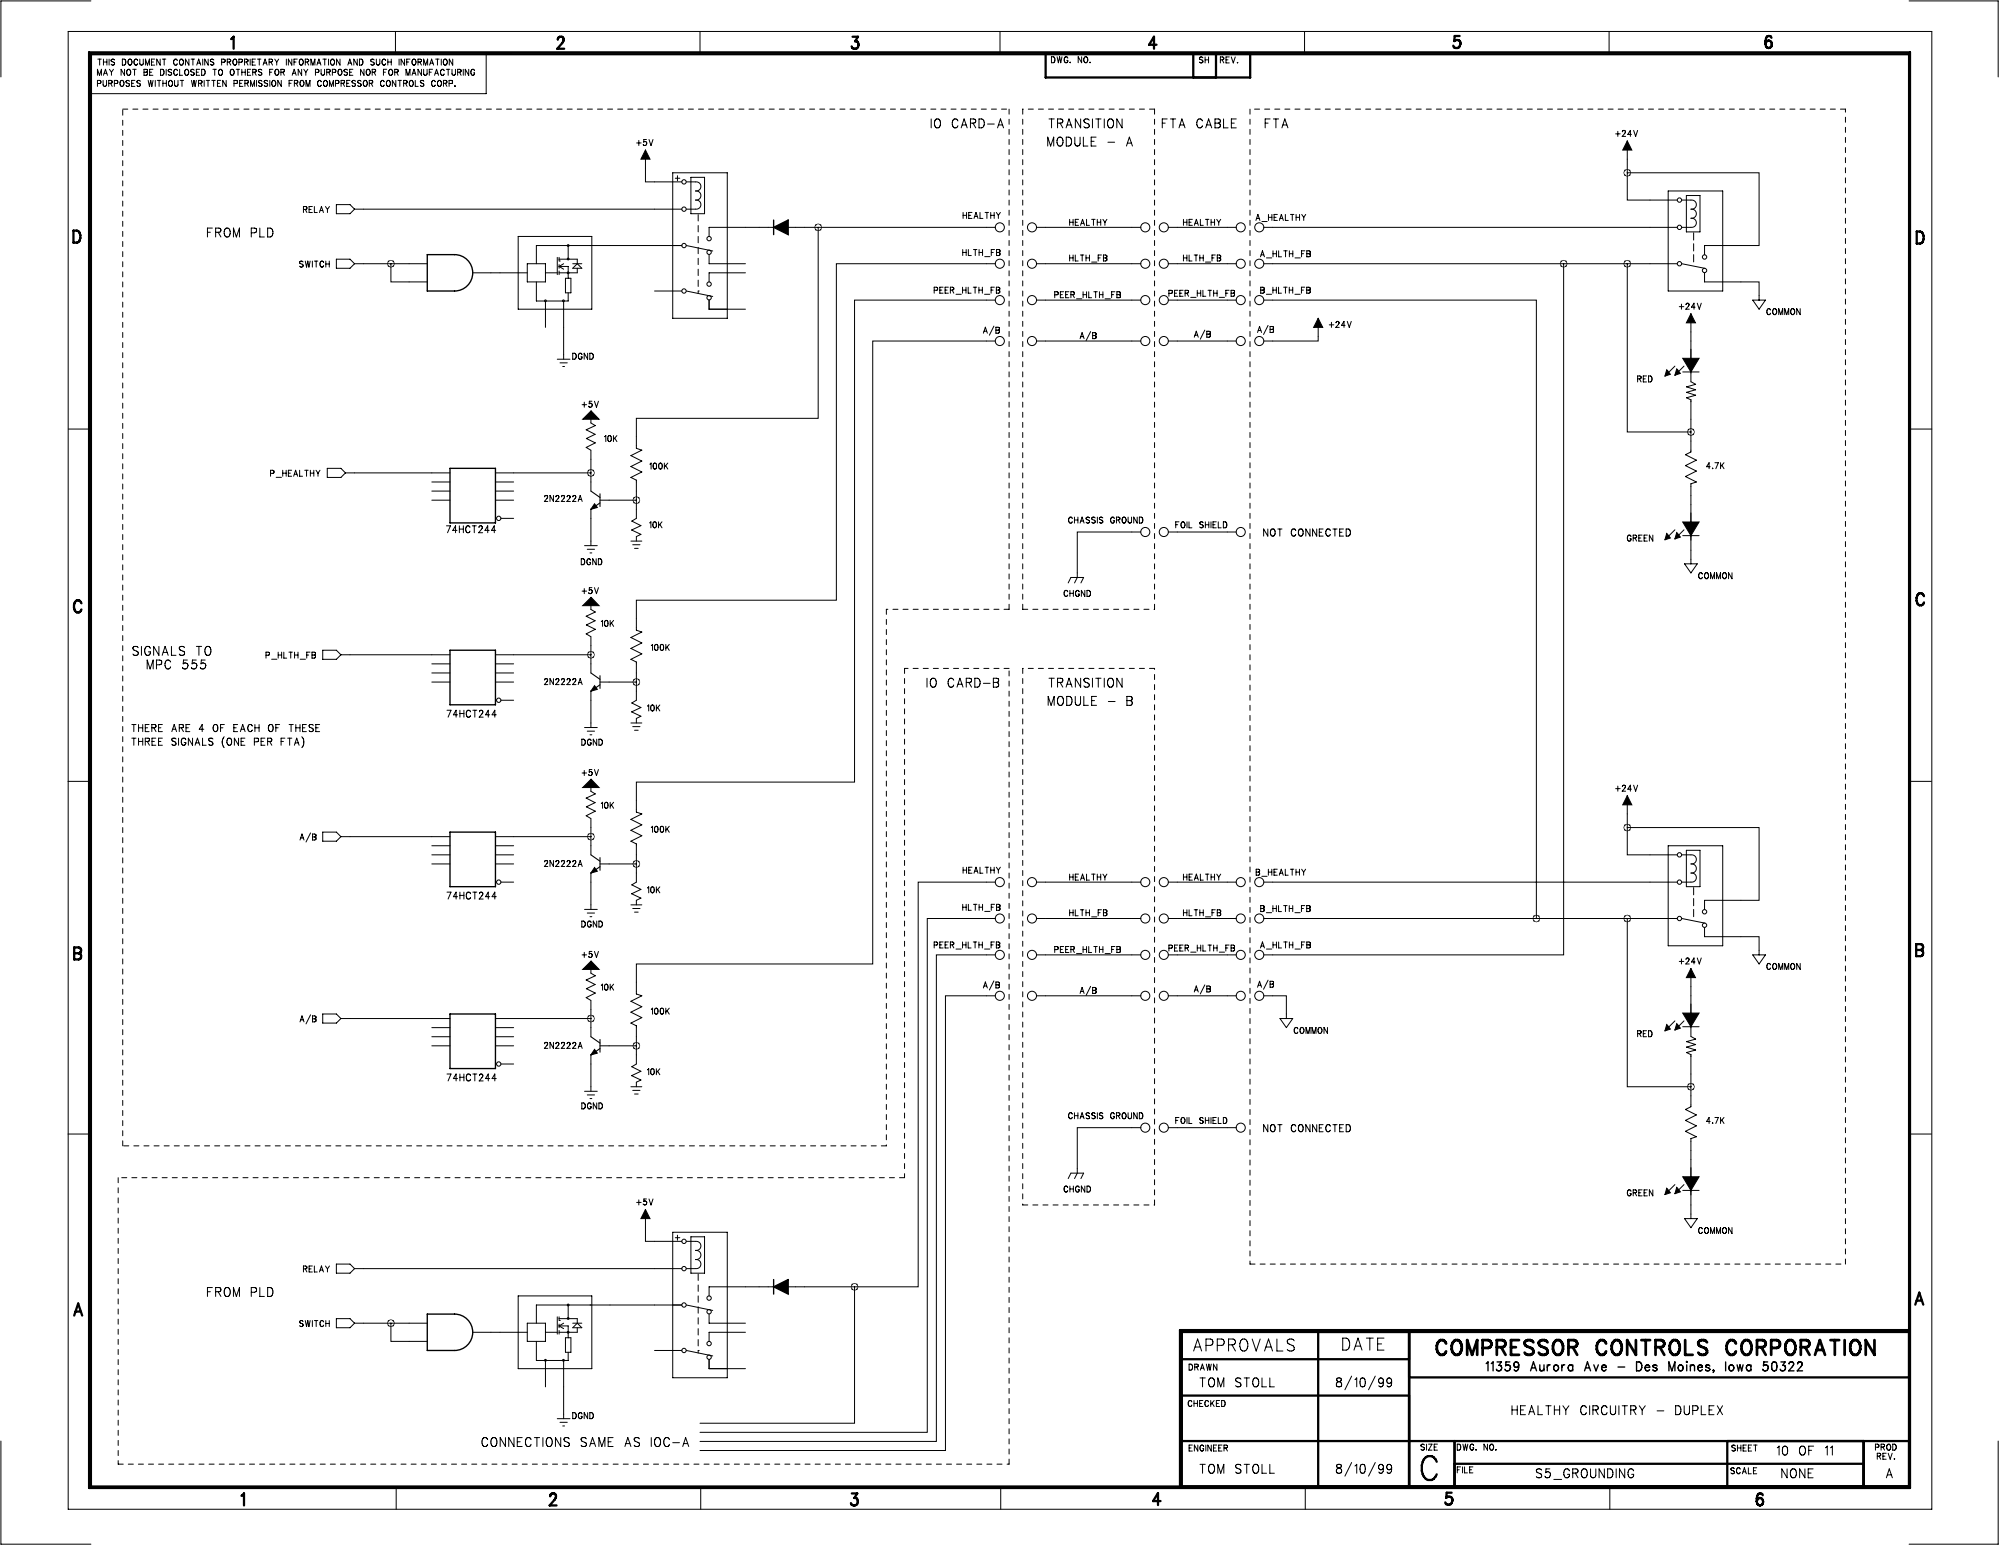
[picture p333: page 10]

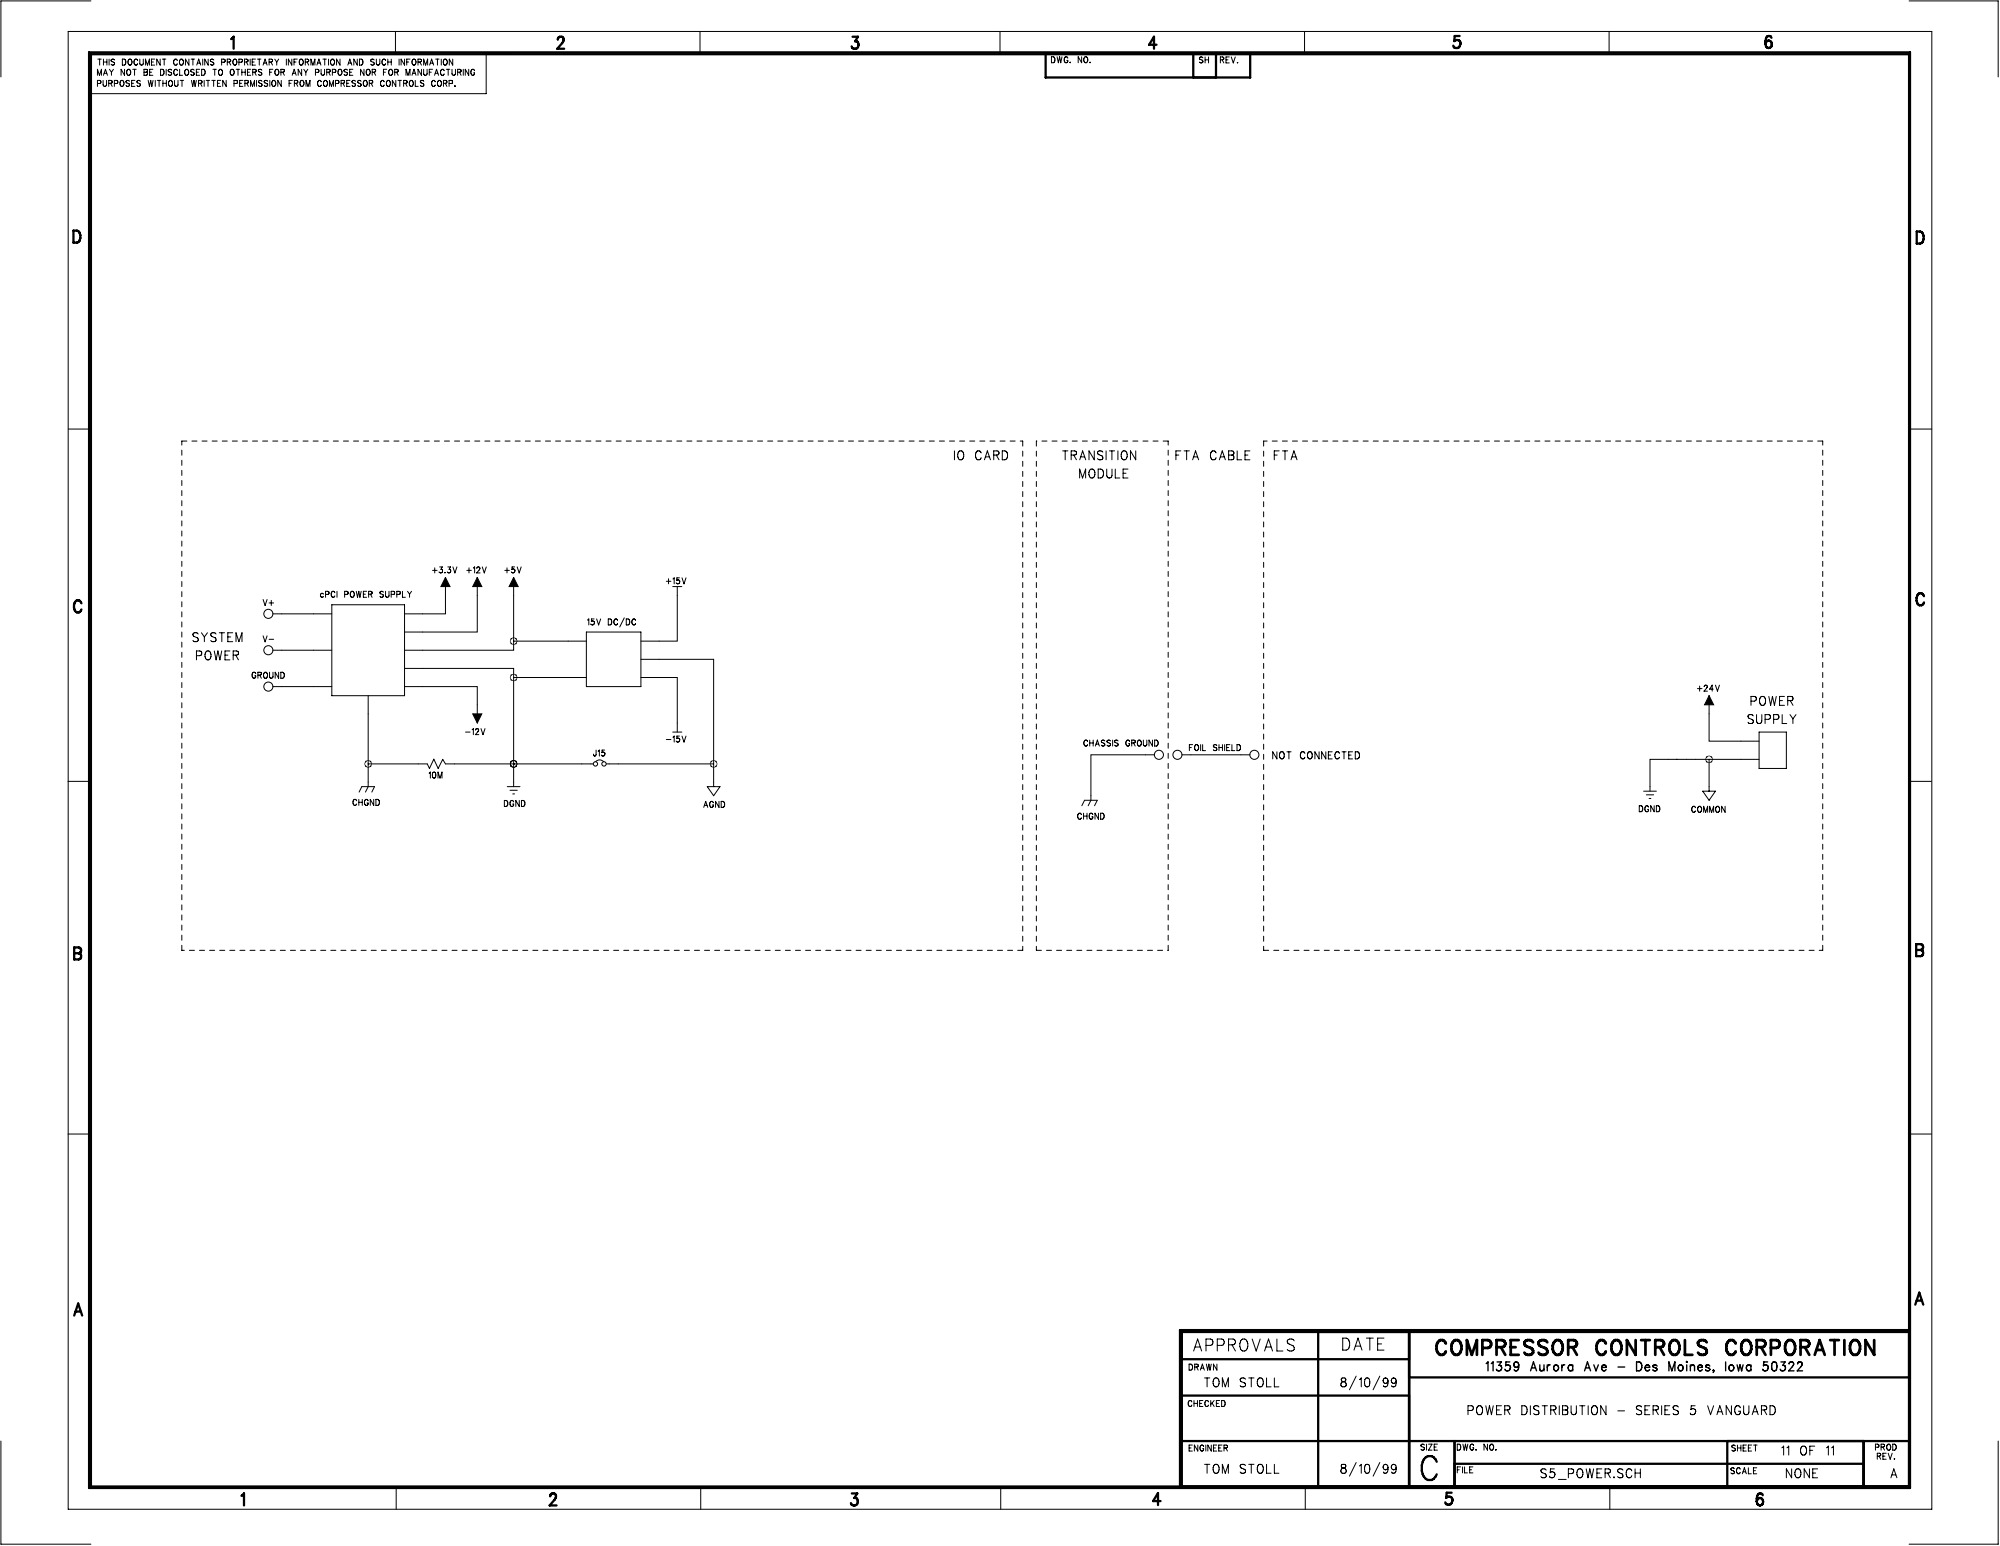
[picture p334: page 11]
