Sayidathahaseen/CCC_NGP_ODC/(list of files, drawings)

Other design files:
NGP_ODC_Main/PDLC/design/PCB Layout/MPC5534_daughter_board/CCCNGP_MPC5534_BOARD_REV1.0.pcb
NGP_ODC_Main/PDLC/design/PCB Layout/PCC/Rev1/17-PCC-NGP_rev1.pcb
NGP_ODC_Main/PDLC/IES-S4M/Client Input/MPMREVE.PCB
NGP_ODC_Main/PDLC/IES-S4M/Datasheet/Ethernet Switch/MICREL/KS8999_V1.2_DP/Reference Schematcis/KSZ8999 DEMO_SCH V3_5.DSN
NGP_ODC_Main/PDLC/IES-S4M/Datasheet/Ethernet Switch/MICREL/KS8999_V1.2_DP/Reference Schematcis/ksz8999 demo_sch v3_5.opj
NGP_ODC_Main/PDLC/IES-S4M/REV1/Layout/IES.pcb
NGP_ODC_Main/PDLC/Prodigy HW files/APP Extender Board/Layout/Rev1/CCC_NGP_APP_Extender_Board_REV1.pcb
NGP_ODC_Main/PDLC/Prodigy HW files/APP Extender Board/Layout/REVB/CCC_NGP_APP_Extender_Board_REVB-22May.pcb
NGP_ODC_Main/PDLC/Prodigy HW files/APP/Datasheets/Ethenet PHY/LAN8720_SMSC/EVAL Board/evb8720sch.dsn
NGP_ODC_Main/PDLC/Prodigy HW files/APP/Datasheets/Ethenet PHY/Micrel/KS8721BL-SL_v1.1_DP/Schematic/KS8721BL-SL Demo_sch V1.1.DSN
NGP_ODC_Main/PDLC/Prodigy HW files/APP/Datasheets/Ethenet PHY/SGMII/ETB-000155-210 AR8031(8033) PHY DEMO BOARD20100910.DSN
NGP_ODC_Main/PDLC/Prodigy HW files/Backplane/Rev C/17-600100-001_revC.pcb
NGP_ODC_Main/PDLC/Prodigy HW files/CAC/ECAT/REV 1/Layout/17-ECAT-NGP_rev1.1.pcb
NGP_ODC_Main/PDLC/Prodigy HW files/CAC/ECAT/REV 2/Layout/17-ECAT-NGP_rev2.pcb
NGP_ODC_Main/PDLC/Prodigy HW files/CAC/ECAT/REV-A/Layout/ECAT-NGP-REV-A.pcb
NGP_ODC_Main/PDLC/Prodigy HW files/CAC/ECAT/REV-B/Layout/ECAT-NGP-REV-B.pcb
NGP_ODC_Main/PDLC/Prodigy HW files/CAC/EEC/REV 1/Layout/17-EEC-NGP_rev1.1.pcb
NGP_ODC_Main/PDLC/Prodigy HW files/CAC/EEC/REV 2/Layout/17-EEC-NGP_rev2.pcb
NGP_ODC_Main/PDLC/Prodigy HW files/CAC/EEC/REV A/Layout/EEC-NGP_Rev_A.pcb
NGP_ODC_Main/PDLC/Prodigy HW files/CAC/EEC/REV B/Layout/EEC-NGP_Rev_B.pcb
NGP_ODC_Main/PDLC/Prodigy HW files/CAC/SAC/REV 1/Layout/17-SAC-NGP_rev1.1.pcb
NGP_ODC_Main/PDLC/Prodigy HW files/CAC/SAC/REV 2/Layout/17-SAC-NGP_rev2.pcb
NGP_ODC_Main/PDLC/Prodigy HW files/CAC/SAC/REV-A/Layout/17-600420-001_revA.pcb
NGP_ODC_Main/PDLC/Prodigy HW files/FTA-AI11/PCB/FTA-AI11_REV_A_BOARD1.pcb
NGP_ODC_Main/PDLC/Prodigy HW files/FTA-AI12/PCB/FTA-AI12_REV_A_BOARD1.pcb
NGP_ODC_Main/PDLC/Prodigy HW files/FTC-AM1/REV1/BOARD1/PCB/CCCNGP_FTC_AM-BOARD1.pcb
NGP_ODC_Main/PDLC/Prodigy HW files/FTC-AM1/REV1/BOARD2/PCB/CCCNGP_FTC_AM-BOARD2.pcb
NGP_ODC_Main/PDLC/Prodigy HW files/FTC-AM1/REV1/BOARD3/PCB/CCCNGP_FTC_AM-BOARD3.pcb
NGP_ODC_Main/PDLC/Prodigy HW files/FTC-AM1/REV2/BOARD1/PCB/CCCNGP_FTC_AM-BOARD1_05Mar12_Final.pcb
NGP_ODC_Main/PDLC/Prodigy HW files/FTC-AM1/REV2/BOARD2/PCB/CCCNGP_FTC_AM-BOARD2_05Mar12_Final.pcb
NGP_ODC_Main/PDLC/Prodigy HW files/FTC-AM1/REV2/BOARD3/PCB/CCCNGP_FTC_AM-BOARD3_05Mar12_Final.pcb
NGP_ODC_Main/PDLC/Prodigy HW files/FTC-AM1/REV_A/FTC-AM1_REV_A_BOARD1/FTC-AM1_REV_A_BOARD1.pcb
NGP_ODC_Main/PDLC/Prodigy HW files/FTC-AM1/REV_A/FTC-AM1_REV_A_BOARD2/FTC-AM1_REV_A_BOARD2.pcb
NGP_ODC_Main/PDLC/Prodigy HW files/FTC-AM1/REV_B/FTC-AM1_REV_B_BOARD1/CCC_FINAL/FTC-AM1_REV_B_BOARD1.pcb
NGP_ODC_Main/PDLC/Prodigy HW files/FTC-AM1/REV_B/FTC-AM1_REV_B_BOARD2/CCC_FINAL/FTC-AM1_REV_B_BOARD2.pcb
NGP_ODC_Main/PDLC/Prodigy HW files/FTC-AM1/REV_C/PCB/FTC-AM1_REV_B_BOARD1.pcb
NGP_ODC_Main/PDLC/Prodigy HW files/FTC-AM1/REV_C/PCB/FTC-AM1_REV_B_BOARD2.pcb
NGP_ODC_Main/PDLC/Prodigy HW files/FTC-DI/PCB/17-600551-111_REVA.pcb
NGP_ODC_Main/PDLC/Prodigy HW files/FTC-DI/PCB/17-600551-112_REVA.pcb
NGP_ODC_Main/PDLC/Prodigy HW files/FTC-DM-1/rev 1/layout/17-600551-001_BRD1_rev1.pcb
NGP_ODC_Main/PDLC/Prodigy HW files/FTC-DM-1/rev 1/layout/17-600551-001_BRD2_rev1.pcb
NGP_ODC_Main/PDLC/Prodigy HW files/FTC-DM-1/rev 1/layout/17-600551-001_BRD3_rev1.pcb
NGP_ODC_Main/PDLC/Prodigy HW files/FTC-DM-1/rev A/LAYOUT/17-600550-111_REVA.pcb
NGP_ODC_Main/PDLC/Prodigy HW files/FTC-DM-1/rev A/LAYOUT/17-600550-112_REVA.pcb
NGP_ODC_Main/PDLC/Prodigy HW files/FTC-DM-1/rev B/CCC FINAL/17-600550-111_REVB.pcb
NGP_ODC_Main/PDLC/Prodigy HW files/FTC-DM-1/rev B/CCC FINAL/17-600550-112_REVB.pcb
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
