Sayidathahaseen/CCC_NGP_ODC/(commit log)

2022-06-23 file 1 adding
    [17-600551-001_BRD1_rev1.pcb, 17-600551-001_BRD2_rev1.pcb, 17-600551-001_BRD3_rev1.pcb, 17-ECAT-NGP_rev1.1.pcb, 17-ECAT-NGP_rev2.pcb, 17-EEC-NGP_rev1.1.pcb, 17-EEC-NGP_rev2.pcb, 17-PCC-NGP_rev1.pcb]
2022-06-23 adding 3
    [18-425300-001r1.1.sch, 24V5Vsch.sch, Board Status_29Aug.xls, CCC_SERIES_4M_IES_Review_Log.xls, CCC_SERIES_4M_IES_Review_Log_Ajay.xls, Ethernet_switch_DAR.xls, IES-Assembly-BoM-REV1.1-3-June-11.xls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]
2022-06-23 adding 5
    [10039851_S.SLDPRT, 10043546_S.sldprt, 10045267_S.sldprt, 10045271_S.sldprt, 10045597.SLDPRT, 10052838C.SLDPRT, 10052842C.SLDPRT, 10073383.SLDPRT]
2022-06-23 adding 7
    [CCCNGP_APP_PCB_REVIEW_LOG.xls, CCCNGP_APP_SCHEMATIC_REVIEW_LOG.xls, CCCNGP_Backplane_Test_Case_Test_Reports_REV_C.xls, CCCNGP_CAC_Test_Case_REV_B.xls, CCCNGP_IBS_Test_Case_REV_C.xls, CCCNGP_IOP-AI1 AND FTA-AI1x_Test_Case_REV_A.xls, CCCNGP_IOP-DI AND FTC-DI_TEST_PLAN_REV_A.xls, CCCNGP_IOP-DI1_PCB_REVIEW_LOG.xls]
2022-06-23 adding 8
    [17-600100-001_revC.pcb, 17-600420-001_revA.pcb, 17-600550-100_REVC.sch, 17-600550-100_REVC_DI_DIAG.sch, 17-600550-111_REVA.pcb, 17-600550-111_REVA.sch, 17-600550-111_REVB.pcb, 17-600550-111_REVB.sch]
2022-06-23 adding 9
    [BOM-S5M IES Rev C2.xls, S5MIESrC.sch, iesrC_bom.xls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]
2022-06-23 adding 10
    [18-600540-141_RevA.sch, 18-600540-142_RevA.sch, 18-600550-141_RevA.sch, 18-600550-142_RevA.sch, BOM_AML_Vanguard IOC_RevL4.xls, Blk_Diagram_Prodigy_S5.sch, Blk_Diagram_S5.sch, FTA543_RD4.sch]
